OrelMag/marine-chronometer-model/README.md

# The Marine Chronometer

Browser-based working models of two marine chronometers, and an essay on how a
chronometer keeps time at sea:

- **The Hamilton Model 21**, a two-day fusee chronometer with a spring detent
  escapement, made for the U.S. Navy from 1941. It is built from the 1948
  overhaul manual (NAVSHIPS 250-624) and from photographs and videos of real
  ones. **Work in progress since 3.63.01 (31 October 2026):** Hamilton's own
  factory drawings (from the NAWCC) and the British Museum's measurements show
  the model was about 12 % too small throughout. Since 3.65.00 (1 November
  2026) it is rescaled by 1.117 (the plate 97.8 mm), the balance and escapement
  kept at their measured sizes, and its drawn parts are being rebuilt from the
  drawings (`PLAN-hamilton-drawings.md`) with the help of the NAWCC (special
  thanks to Thomas Stocker); its page says so.
- **The Wempe Einheits-Chronometer**, the German standard chronometer (spring
  detent, fusee, three pillars), built from Wempe's works drawings. It comes in
  several versions: as first drawn, the escapement of 1943, Wempe No. 3955 as
  photographed, and the Soviet 6MX (audited again against its photographs in
  3.82.03; its case, bezel, transit lock and smaller gimbal ring, which Wind
  turns over with the case, reviewed in 3.84.00; the bezel's white sight
  cone, measured on two 6MXs, added in 3.85.01).
- **The Marine Chronometer**, a long-form interactive essay shared by both
  models. Its text follows the Model 21; its 3D figures and dial are drawn
  from the Wempe's model.
- **The Beat Error Meter** (`/beat/`, since 3.78.00), a side tool for the phone:
  hold a mechanical wristwatch against the microphone and tap Listen; it finds
  the beat and gives the beat error, the rate and both intervals
  (`beat-error/`, its README).

The live site is <https://www.marinechronometermodel.com>. Since 21 October 2026
the Wempe has been the home page, with the Hamilton at `/hamilton/` and the
essay at `/essay/`.

Orel Magidish (assisted by Claude Opus 5.5) – September 2026  
[orelmag@gmail.com](mailto:orelmag@gmail.com). On every page, **Report a bug or
inaccuracy** (under About, on every part's card and at the essay's end) writes
the report into an email to this address. The email includes the version, the
model's settings, the browser and the page's last errors.

| File | What it is |
|---|---|
| [`chronometer-working-model.html`](chronometer-working-model.html) | The Hamilton's model as one file: the Model 21 running in real time in its gimballed case and mounting box. It has views (Exploded, Laid out and Contacts among them), an eight-step walkthrough, cross-sections, parts to fade, hide or isolate one at a time or as a selection (Ctrl-click, or a lasso by Alt-drag, or through to the parts behind by Shift+Alt-drag; Select, Lasso and Through on touch; Reset opacity brings every faded part back), winding, setting the hands, stopping and starting, the rate and timing weights, variants (dials, finishes, balances, and the balance stop: none by default, the manual's locking arm, or the Navy's Y-arm brake with its seal, plunger and lever), and the manual's overhaul operation by operation. Each part's card gives its Hamilton part numbers, its maker's sheet, its drawing and its STL. Its **Essay** tab links to the essay's page |
| [`marine-chronometer-source/wempe/dist/wempe-einheitschronometer.html`](marine-chronometer-source/wempe/dist/wempe-einheitschronometer.html) | The Wempe's model as one file: the same kind of page, with its own views (Train, Fusee, Balance, Laid out), its versions and variants (dials, cases, and the closing plate: the drawings' with its knob, or a slot on a stop peg as a Wempe's is photographed in *The Mariner's Chronometer*, Fig. 2.32; the key in brass, as that book's Fig. 2.35 has one taken apart, or black, as its drawing gives it), the 35-day trial, a banking screw to turn (Swing and isochronism: the depth of lock it sets, with the swing and whether the escapement still works shown live), Making it (maker's sheets; a CAD file (STEP) and an operation sheet on the card of each part made so far as a recipe: the frame, the train's arbors and wheels, the escape wheel, the bushes and studs, the fusee's wheels and ratchets, the barrel, the detent and its block, the balance and its settings, the motion work, the hands and the dial, the case, the fusee body with its groove, the hairspring's collet and stud, the keys, the transit lock and every version's detent block and the 6MX's contact, 187 in all, with 106 bought parts as lines saying what to buy (the chain among them): every line of the parts list; its build book of drawings was withdrawn on 29 October 2026) and Download (STL, Blender). It also has an essay of its own on its drawings (the **Its drawings** tab) |
| [`marine-chronometer-source/essay/dist/the-marine-chronometer.html`](marine-chronometer-source/essay/dist/the-marine-chronometer.html) | The essay: longitude, the balance and its spring, heat, the fusee, winding, the train, the detent, the gimbals, keeping the rate, navigating without radio and making the chronometer. The models' own code computes its live figures |
| [`marine-chronometer-source/hamilton-parts/index.html`](marine-chronometer-source/hamilton-parts/index.html) | The Hamilton's parts as Hamilton Watch Co. drew them (since 3.72.00, on the site at `/hamilton/parts/`): 23 parts from the NAWCC's factory drawings, built as exact solids apart from the model (`tools/hamilton_parts.py`), each in 3D with its drawn sizes, the readings still unsure, an operation sheet and a STEP file, and (since 3.73.00) audited against the sheets (`HAMILTON-PARTS-LEDGER.md`) and put together into subassemblies placed by the drawings' own numbers (the fourth wheel and pinion, the barrel, 42009 complete with pawls, the fusee with its maintaining work, a run of chain), taken apart by a slider; and the detent (since 3.74.00): its finished form reconstructed from Hamilton's blank and operation sheets, and the whole detent assembly with the 3D model's block, screws and trip spring as placeholders (since 3.74.01 sound solids, holed for their screws). Since 3.75.01 the finished detent stands the way the video shows it (its blade at the escape wheel's level), its cross-piece and jewel block cut to the sizes measured on video (the blank a ceiling; the foot keeps the blank's length), holed for its steady pins, wedge pin and bracket screw, with a notch for the adjusting screw (`tools/hamilton_detent_compare.py` draws it over the model's detent; `HAMILTON-PARTS-LEDGER.md`, "The detent assembly measured"). Since 3.74.01 `hamilton_parts.py --check` also fails a part that cuts itself, whose mesh on the page isn't closed or whose STEP file doesn't read back as the same solid (the second pass, `HAMILTON-PARTS-LEDGER.md`). Since 3.75.00 every part with a drawing and every subassembly of drawn parts only (a sixth: the barrel with the set-up ratchet on its arbor's square) has a still render from Blender's Cycles on its card and in a Renders gallery (`#renders`), made by `tools/hamilton_render.py` into `hamilton-parts/renders/` (not run by the build: rerun it after changing a recipe). Not yet in the model |

Both models' pages share one layout (since 3.52.00). The title, the model
switcher, the page tabs and a light/dark switch sit in one line over the model.
On the model are the tools as icons (Select, Lasso, Through, help, save a picture, copy a
link, reset the view, full screen), a row of views, and a play bar: stop and go
on, the speed (1/20×, ¼×, 1×, 60×, 3600× or any speed), the time, the power left
and Wind. The panel beside it (under it on a phone) has four tabs: **Explore**
(the walkthrough, the overhaul (the Hamilton's in its manual's order, the Wempe's in
the 1958 Soviet repair book's order for the MX), Take it apart: Exploded and Laid out,
the Wempe's Assembled with its assembled sheet (the movement photographed from three
sides and cut open, lettered) and its Laid out with its lettered sheet (each a thumbnail
of the sheet's top inside the panel that opens it large; the Laid out sheet: the
train in elevation, plan and isometric with numbered close-ups of the mainspring and
fusee, maintaining power, escapement and balance, lettered as a textbook's developed
drawing), the Wempe's Exploded view taking its fusee, barrel, balance, detent and motion
work apart beside the movement with Subassemblies (all, or each on its own, the
chain coiled, a Pieces slider for their spread), and Parts (the Wempe's under frame,
going train, balance, escapement, fusee and barrel, motion work and dial, and case and
box), where the Wempe's
Isolate row shows one subassembly alone, as right-clicking a part does), **Run** (time, winding, the rate and timing weights, and the
Hamilton's stopping and starting and rate book), **Look** (Metal, Tinted or Ink,
Colour by, the display's switches and ship motion) and **Advanced** (Contacts,
swing, the trial, the escapement's plan or bench, cross-sections, variants,
Making it, Download and Performance). A link that opens a section opens its tab.

Each is a single self-contained HTML file: download it and open it in any
modern browser. It works offline and needs no server, because three.js and the
fonts are built into the file. The pages link to each other, both on the site
and in the repository.

**In Blender:** each model's panel has **Blender (.glb)** (under Advanced: the Hamilton's in
Making it, the Wempe's in Download). It saves the whole instrument as a
glTF 2.0 file. Every part is a named object in its hierarchy, with its
materials, and every motion the model has is an action: running, a beat in
slow motion, run down, winding, setting the hands, stopping and starting,
exploded, laid out, lifting out, the lids, the latch, at sea. **Blender rig
(.py)** saves a script. Import the file in Blender 5 (File, Import, glTF 2.0),
then open the script in the Text Editor and run it. The chronometer then runs
on the timeline at its own ratios, with controls for the wind, the hands,
explode, laid out, lift, lids, latch, roll and pitch. The Hamilton's README,
"The model in Blender", has the details.

**Links keep the camera** (since 3.77.00): turn, zoom or pan the model and the
page's address gains `cam=` (where the camera looks from, how far, and at
what), so a copied link opens on exactly that view, on either model. A view
button, a walkthrough step or zooming to a part takes it out again.

**Drawn as an illustration:** `tools/penrender.py` draws any of the page's
views, links or cameras as an ink-and-watercolour illustration in Blender 5:
pen lines (Blender's Freestyle and Line Art) over a light wash on cream paper,
the parts the page shows see-through drawn as a faint cutaway. It opens the
page headless to read the camera, so each still is framed as the page frames
it. [Making illustrations](#making-illustrations) says how.

Contents:
[Repository layout](#repository-layout) ·
[Setting up](#setting-up) ·
[Building](#building) ·
[Changing things](#changing-things) ·
[Checking your changes](#checking-your-changes) ·
[Publishing the website](#publishing-the-website) ·
[Making illustrations](#making-illustrations) ·
[Licence](#licence)

## Repository layout

    build.py                     builds everything (see Building)
    inline.py                    inlines scripts, stylesheets, fonts and images into one HTML file (used by the builds)
    CHANGELOG.md                 the site's versions and what changed in each, newest first (read by the build; see Versions)
    changelog.py                 reads and checks CHANGELOG.md, puts the version and the list into the pages, adds a release
    deploy.py                    puts site/ live, only as a new version (wrangler.jsonc runs its check before every deploy)
    worker.js, wrangler.jsonc    the Cloudflare Worker that serves site/: its domains, and the redirects from old and other addresses
    ci.py, citrace/              the checks, run on this machine (no GitHub workflows), with their results cache and the machine's shared slots
    chronometer-working-model.html   the Hamilton's page as one file (generated by build.py: do not edit by hand)
    site-assets/                 files only the website needs: the link previews (social.png, social-wempe.png), social-movement.png (an image for posting the essay), _headers (host settings)
    site/                        the website, ready to upload (generated by build.py, committed)
    vendor/                      three.js r128 and the fonts, with their licences
    beat-error/                  the Beat Error Meter (site's /beat/): page.html, beatcore.js (the analysis), build.js (one file, run by build.py), test.js; its README
    docs/motion-3d/              the method behind the moving parts' 3D viewers (kinematics, the transmission in time, stress by finite elements)
    marine-chronometer-source/
      chronometer-working-model/ the Hamilton Model 21: index.html, css/, js/, tools/ (the verification and measuring tools, for both models),
                                 verification/ (its two reports and reference renders), blender/ (the rig), dist/ (its built file); its README has the details
      wempe/                     the Wempe Einheits-Chronometer: index.html, js/, css/, checks.py (its tables for the shared tools), bom.json, dials/ (its
                                 dials as SVG), verification/ (its report), dist/; its README has the details
      essay/                     the essay shared by both models: index.html (its text and figures' markup), js/essay.js (its figures),
                                 js/hamdata.js (the Model 21's figures it quotes, from tools/essay_hamdata.py), dist/
      shared/                    scripts both models use: escapement.js (the detent escapement's solver, makeEsc), escplan.js (its plan
                                 drawing), almanac.js (the essay's nautical almanac and sight reduction), hairspring.js (the hairspring's design),
                                 contacts.js (the Contacts view), select.js (selecting parts: Ctrl-click, the lasso), kit.js (the Wempe's part and screw builders), viewer.js (the Wempe's viewer),
                                 essaykit.js (the essays' machinery)
    References/                  source material: the 1948 manual, photographs, drawings (References/wempe/: the Wempe's works drawings and
                                 their transcriptions); its README lists each file; VIDEOS.md catalogues videos of real chronometers
    CLAUDE.md                    instructions for Claude Code: how the repository works, its rules, every tool and how long it takes
    RESOLVED.md                  bugs already found and fixed, from the commit history; check it before changing a part
    OPEN-QUESTIONS.md            readings no source has settled; REQUESTS.md is the post to send owners and the NAWCC for them
    PROVENANCE.md                the Hamilton's ledger: what each part's outline, sizes and place rest on
    WEMPE-PROVENANCE.md, WEMPE-DRAWING-LEDGER.md   the Wempe's: each part against its photographs and against its drawing
    WEMPE-PARTS-LEDGER.md        the Wempe's third, blind parts audit against its drawings (marine-chronometer-source/wempe/parts-audit/,
                                 FINDINGS-EXPLAINED.md): every difference, and the five corrected in 3.81.00 with why
    marine-chronometer-source/wempe/6mx-audit/   the Soviet 6MX audited again against its photographs (7 November 2026, 3.82.03):
                                 beta.md (frame, escapement), gamma.md (case, dial, contact), delta.md (its physics:
                                 gimbals, the escapement in time, the detent as a frame, the contact's drag), README.md the outcome
                                 case/: everything outside the 6MX's movement reviewed (8-9 November 2026, 3.84.00):
                                 README.md the ledger and what was fixed, blind-*.md the blind readings, caserender.py
    IDEAS.md, Review-results.md, PERFORMANCE.md    ideas, open review findings, frame-time measurements
    PLAN-*.md                    plans of work, each with what is done and what is left
    BOM.md                       the manual's parts list against the model, part by part (generated by the model's tools/bom.py --md)

## Setting up

You need:

- **Git**, to clone the repository.
- **Python 3.9 or later**, for the build. It uses only the standard library.
- **A browser.** Any current Chrome, Edge, Firefox or Safari works.

Clone and build:

    git clone git@github.com:OrelMag/marine-chronometer-model.git
    cd marine-chronometer-model
    python build.py --site-url https://www.marinechronometermodel.com

On macOS and Linux, use `python3` wherever these instructions say `python`.

The verification tools are optional; you need them only when you change a
model. They need more software:

- **Node.js**, for the physics tools (`escapement.js`, `dynamics.js` and the
  rest), the type check (`npx`) and deploying (`wrangler`).
- **Python packages**, and a Chromium for Playwright to drive:

      python -m pip install numpy scipy playwright opencv-python matplotlib pillow shapely manifold3d
      python -m playwright install chromium

  A few tools need more: torch for the mainspring's solve, pyamg for `fea.py`,
  skyfield for the almanac's references, yt-dlp and imageio-ffmpeg for videos,
  and trimesh and its helpers for the drawings. Each tool's docstring says what
  it needs.
- **Blender 5** (optional), for `blender_check.py`, which is skipped without it.

## Building

    python build.py --site-url https://www.marinechronometermodel.com

This one command:

1. Builds the Hamilton's model into `marine-chronometer-source/chronometer-working-model/dist/chronometer-working-model.html`, the Wempe's into `marine-chronometer-source/wempe/dist/wempe-einheitschronometer.html` and the essay into `marine-chronometer-source/essay/dist/the-marine-chronometer.html`.
2. Copies the Hamilton's to the repository root.
3. Assembles `site/`, the folder you upload to a web host:
   - `index.html` is the Wempe's model, so the site opens straight into it. `hamilton/index.html` is the Hamilton's, and `essay/index.html` the essay (`/essay/#detent` opens it at a section).
   - `social-wempe.png` is the home page's link-preview image and `social.png` the Hamilton's (the dial in its box). `social-movement.png` is an image of the mechanism titled for the essay, for posting and as the essay's preview.
   - `_headers` holds security and caching headers.
   - `navships-250-624-1948.pdf` is the 1948 manual itself, from `References/`, which the pages link to.
   - `hamilton/parts/` is the Hamilton's drawn parts page (`marine-chronometer-source/hamilton-parts/`, its three.js and font copied beside it); rerun `tools/hamilton_parts.py` before the build after changing `js/hdims.js` or a recipe.
   - `verification/build-verification/` and `verification/real-chronometers/` are the Hamilton's two reports (each check's method, results and what they mean). `wempe/verification/` is the Wempe's: *The Wempe Einheits-Chronometer: does the model hold to its drawings, and would it keep time?* (since 3.82.00 the 3D viewer beside its section 13 colours each part by its load against its load in running, with buttons to each run's moments and a table of every joint's load at the moment shown; since 3.43.00 its section 9 also takes the frame, train and escapement through heat and cold, `tools/wempe_thermal_frame.js`) Each is copied as its own `build_report.py` last wrote it, with its links into the repository pointed at GitHub. The pages' About and the essays link to them.
   - `sitemap.xml` (the pages and the reports) and `robots.txt`, for search engines, when `--site-url` is given (below).

`build.py` doesn't rebuild the reports. After changing what a report reports,
rebuild it with its `build_report.py`, then build. For the Wempe's, run
`node reportdata.js`, `python geometry.py` and `python build_report.py` in its
folder.

The build fails if a page still loads a script, stylesheet, font or image from
another server. That keeps the published files working offline and in
countries where common CDNs are blocked.

The build prints where each page's bytes go (three.js, fonts, images and the
rest) and how much a visitor downloads compressed. It sets no size limit.

`--site-url` gives the site's address. With it, the pages show a picture when
the link is shared, and search engines see the canonical address. A build
without it leaves out `robots.txt` and `sitemap.xml`, so always commit builds
made with the address.

Page addresses are written without `.html`, because Cloudflare redirects
`/page.html` to `/page`. On a host that serves the `.html` address directly
(Netlify, GitHub Pages, most plain web servers), add `--keep-html`.

The addresses changed on 21 October 2026: the Wempe moved from `/wempe/` to the home
page, the Hamilton from the home page to `/hamilton/`, and the essay from the
Hamilton's Essay tab (`/#essay`) to `/essay/` (it was once a page of its own too,
`/marine-chronometer`). On the live site, `worker.js` sends `/wempe/` to
`/?from=wempe` and `/marine-chronometer` to `/essay/`. A hash never reaches the
server, so the Wempe's page itself sends the Hamilton's old links on: `/#essay=detent`
to `/essay/#detent`, and `/#part=det` and the Hamilton's own settings to `/hamilton/`.
The reports and the manual keep their addresses. `tools/sitecheck.py` serves `site/`
through `worker.js` and follows every address, old and new. On another host, add
redirects of your own if old links matter.

### Versions

The site has a version, `M.mm.pp` (3.38.00, for example). The panel's last
section, Version … · what's new, shows it with the list of changes, and
About's byline shows it too. Both come from `CHANGELOG.md` at the root, newest
first. A plain build only reads the file, so building twice gives the same
files. To make a release, name the kind of change and what changed:

    python build.py --release patch -m "The camera turns further below the model" --site-url https://www.marinechronometermodel.com

`patch` is for fixes and small changes, `minor` for new features or parts (or
a merged branch), and `major` for a milestone. The build adds the next version,
dated today, with one line for each `-m` (written for visitors), then builds as
usual. Commit `CHANGELOG.md` with the built files, and bring this README up to date
with what the release changed. The build fails if the file
is malformed: a heading that isn't `## M.mm.pp · YYYY-MM-DD`, versions out of
order, or a version with no lines.

Rebuild after every change. Commit the regenerated root copy, the `dist/`
files and `site/` with your source changes, so that they stay identical.

## Changing things

### The models

Work on the unbuilt source. It loads the files directly, so a browser reload
shows each edit:

1. Open `marine-chronometer-source/chronometer-working-model/index.html` (the
   Hamilton) or `marine-chronometer-source/wempe/index.html` (the Wempe) in a
   browser. Double-clicking the file works.
2. Edit the files in `css/` and `js/`, then reload the page.
3. Keep the browser's developer console open (F12). Errors appear there, and so
   do warnings from the geometry builders, for example a hole that crosses a
   plate's outline.
4. When it looks right, run `python build.py` from the repository root.

Useful URL flags:

- `?snap` turns off camera and state easing, so views settle at once.
- `?qa` exposes the movement and camera helpers to the verification tools.

For example: `index.html?snap&qa`.

If you open a page from a local web server instead of the file, start the
server at the repository root. The pages read `../../vendor/`, so the server
must be able to reach it:

    python -m http.server 8000
    # then open http://localhost:8000/marine-chronometer-source/chronometer-working-model/

The Hamilton's [README](marine-chronometer-source/chronometer-working-model/README.md)
explains how its code is organised. Its "Modifying the model" section walks
through common changes: a part's shape, a new part, gear ratios, the dial, the
walkthrough, views and materials. The Wempe's
[README](marine-chronometer-source/wempe/README.md) says how each of its parts
was read off its drawings. Its dimensions are in `wempe/js/dims.js`, each with
its drawing's number. It loads the Hamilton's `core.js` and the shared
`kit.js` and `viewer.js`. Its section "The page's capabilities against the
Hamilton's" lists what was ported and what was left out.

Every outline, size and place is measured first, on a photograph, a video
frame, a manual figure or a works drawing, never drawn by eye. The code comment
beside it names its source. Each model's README has an "Estimated" section
listing what no source shows.

Some scripts in `marine-chronometer-source/shared/` are used by both models
and the tools, so a change to one reaches all of them:

- `escapement.js` holds the escapement's solver, `makeEsc`. The Wempe's is
  `makeEsc(settings, base)` against the Hamilton's settings. After changing it,
  `tools/escgolden.js` must still match: it holds the Hamilton's results bit
  for bit.
- `escplan.js` holds its plan drawing, `drawEscPlan`, used by the walkthrough's
  inset, the adjuster's bench and the essay.

The essay's sky sections (rating the chronometer by the Sun, longitude by
chronometer, the lunar distance, an almanac to print) compute with `ALM` in
`shared/almanac.js`. `tools/almanac.js` checks it against JPL Horizons and
skyfield; the Hamilton's README, "The almanac", says how and how well.

### The essay

The essay is shared by both models and has a page of its own,
`marine-chronometer-source/essay/`:

- Its text and figure markup are in its `index.html`, and its styles in the
  Hamilton's `css/essay.css`.
- Its figures are in `js/essay.js`. It builds the Wempe's movement from the
  Wempe's own scripts and lends it to each 3D figure as it draws: the dial, the
  balance and hairspring, the fusee, the maintaining work, the train, the
  escapement and the box. The figures use the models' Edges, off with
  `?edges=0`; the models' Essay tabs pass that on when their Edges are off.

Open `essay/index.html` to work on it; a reload shows each edit. Numbers come
from two places:

- The Wempe's numbers that a figure shows are `data-live` spans, filled in live.
- The Model 21's numbers that the text quotes are `data-ham` spans, from
  `js/hamdata.js`. `tools/essay_hamdata.py --write` works them out on the
  Hamilton's page. Run it after changing the Hamilton's escapement, train,
  balance or hairspring; `ci.py` checks it.

The Hamilton's README, "The essay", explains the rest. The Wempe's own essay
(its **Its drawings** tab) is `wempe/js/essay.js` and the `<article id="essay">`
in `wempe/index.html`. Its data that only Node can work out is in
`wempe/js/essaydata.js`, written by `tools/wempe_essaydata.js --write`.

### Tracing by hand

Outlines the model is built from can be traced by hand on a photograph or a
video frame, with the Edge Tracer:

- **On a computer**: open
  `marine-chronometer-source/chronometer-working-model/tools/tracer.html` in
  Chrome or Edge. Open the image, click along an edge, and press **?** for the
  keys. **Save** writes `NAME.trace.json`; keep it in `tools/traces/`.
- **On a phone or tablet**: open the private copy on claude.ai,
  <https://claude.ai/artifact/Ju3PQ8QErkH3fdRWZcSLjq> (only its owner can open
  it). Claude measures parts itself (below), so tracing is optional: when you
  offer to trace, Claude puts the frames there with a note on what to trace. To
  open one, choose **Panel**, then **From Claude**, then **Open**.
  - Tap to add a point.
  - To place one precisely, hold, then slide (a ring and the magnifier show
    where it goes), then lift.
  - Drag a point to move it. Pan with one finger and pinch with two.
  - **Fine** makes drags and aiming move a quarter as far as the finger.
  - The bar at the bottom has the keyboard's actions (Done, Insert, Delete
    point, Corner, Close curve).

  When done, tap **Send to Claude**. Claude reads the trace from there and
  saves it in `tools/traces/`.

The same file runs in both places. After changing `tracer.html`, Claude
rebuilds the phone copy with `tools/tracer_artifact.py` and publishes it to the
same link.

Claude measures parts itself with the `measure-trace` skill
(`.claude/skills/measure-trace/`), whose engine is `tools/mfgfit.py`. The skill
snaps a trace onto the image's edge and fits it as machined lines, arcs and
drilled holes.

## Checking your changes

The tools are in `marine-chronometer-source/chronometer-working-model/tools/`,
for both models: most take `--model wempe` for the Wempe. Run them from that
folder; they write their output files into it. [CLAUDE.md](CLAUDE.md) lists
every tool, what it checks and how long it takes. Before committing a change:

1. **Past fixes.** Look up the part, control or build step in
   [RESOLVED.md](RESOLVED.md), so an old bug doesn't come back.
2. **Build.** `python build.py --site-url https://www.marinechronometermodel.com`
   at the root must finish without errors. When a file the Wempe's page loads has
   changed, it first renders the Laid out sheet again (`laidout.py --model wempe
   --write`, a few minutes in a browser) into `wempe/renders/`; commit what it writes.
3. **Console and arithmetic.** Run these two; both print `ok`:
   - `python smoke.py` clicks through every control of the model, then opens
     the essay's page, scrolls it and works every control in it. It fails on
     any console error or warning.
   - `python invariants.py` checks the hands against the time, the wind
     indicator, and the fusee's and the balance's figures.
4. **Geometry**, if you changed any part:

       python isolate.py PART --ref IMAGE   # the part alone beside a photograph or frame of a real one: compare them before going on
       python fine.py       # collisions at 0.05 mm, through the escapement, round the train and over the wind, plus the barrel's margins (exit code 1 on anything new)
       python fine.py --hold    # the same with the balance locking arm locked and the train-blocking screw down
       python maintaining.py    # the fusee's maintaining work over run and wind cycles (exit code 1 on a failure)
       python views.py before   # (before the change) renders every view; after it: python views.py after, then python views.py --diff before after
       python beforeafter.py --model wempe --before OTHER/index.html SPEC.json   # each changed part alone, before (another worktree's page) and after, from the angle where they differ most, the change boxed and close up (tools/beforeafter/)
       python solids.py     # every part a closed solid, facing out (exit code 1 on a failure)
       python exploded.py   # no two parts meet in the Exploded view, at any spread (exit code 1 on a failure)
       python overhaul.py   # every operation of the manual's overhaul takes its parts off, or puts them on, clear of the rest
       python assembly.py --model wempe   # the Wempe's order of taking apart, clear of the rest, and its page's overhaul in the same order
       python holecheck.py  # every hole has something in it, or a reason it is empty on the real movement
       python seatcheck.py --model wempe  # every pin, screw, stud and pipe held in a hole of another part, not lying in a slot or buried in solid metal
       python wempe_fusee_check.py        # the Wempe fusee body as built against every written figure of its sheet 05 06 04-2 (no browser; after wempe_fusee_body.py)
       python placements.py dump before   # (before the change) every mesh's place in seven states; after it: dump after, then --diff before after
       python audit.py      # screws, pivots, loose parts in the movement (exit code 1 on anything not expected; --update after an intended change of coplanar faces)
       python audit.py box  # the same for the box and gimbals
       python bom.py        # every part against the parts list: counts, how each is held and runs, the gears, the jewels (--md rewrites BOM.md)
       python contacts.py --write   # after changing fine.py's tables: the Contacts view's data
       python gltf_check.py     # the export to Blender, written and read back
       python blender_check.py  # that file in Blender 5 headless (skipped without one): the rig against the export's own clips
       python penrender.py      # stills as an ink-and-watercolour illustration (any view, link or camera; not a check)
       npx -p typescript@5.9.3 tsc -p ../jsconfig.json   # the types of the files that start with // @ts-check

   What each should print:
   - `fine.py` prints `ok` on every line. Its table `EXPECTED` gives the
     reason for each intended contact.
   - The `views.py` diff shows changed pixels only on the parts you changed.
     The `placements.py` diff lists only the parts you rebuilt.
   - `solids.py` prints `0 not solid` twice. `exploded.py` and `overhaul.py`
     print `0 failing`.
   - `audit.py` ends with `OK: nothing new`. It compares its findings with the
     expected ones: the loose ends in its `LOOSE` table, each with its reason,
     and the coplanar faces, mostly faces in contact, in `audit-expected.json`.
   - `seatcheck.py` ends with `0 failing`; a piece held another way on the real
     chronometer too is printed `~~` with its reason (`SEAT_EXPECTED`).
   - `bom.py` prints `ok` (a press fit at most 0.02 mm open, a tapped hole 0.1;
     `MC_BOM_IN` tries other limits); a known deviation, with its reason, is printed with
     `~~`. After changing a part, run `python bom.py --md` and commit the
     regenerated `BOM.md`.
5. **Timing and physics**, if you changed the escapement, balance, springs,
   fusee or train. These are Node.js tools: `node escapement.js` (the
   escapement against the manual's figures), `node escgolden.js`,
   `node physics.js`, `node dynamics.js`, `node tripping.js` and
   `node gearing.js`. For the Wempe, run `node wempe_escapement.js` and the
   other `wempe_*.js` tools. Several write a golden JSON file with `--write`;
   without it, they fail if that file is stale. The reports then need
   rebuilding (see Building).
6. **Preview images.** If a model's appearance changed, re-render them with
   `python social.py` (`social.py wempe` for the Wempe's), then rebuild. If the
   Wempe's box, gimbals, fusee, escapement, train or balance changed, look over
   the essay's figures too: they are built from its model's code.
7. **Frame time**, if you changed the render loop, a rebuilt part, or what is
   drawn. `python perf.py` prints each view's frame cost, draw calls and
   triangles with the page's settings, with Shadows and without Edges, and how
   often the page draws when left alone. It runs on your GPU with vsync off;
   `--throttle 4` slows the CPU to about a phone's. Compare it with a run from
   before the change.
8. **All the checks at once.** `python ci.py` at the root runs them here and
   prints each step `ok` or `FAIL`, with its logs in `ci-logs/`. It runs about
   a hundred steps for both models, side by side (up to 12 at once, 3 with a
   browser), in about 20 minutes. Among them is the build with the live
   address, which fails if building changes a built copy (commit what it
   writes). The options:
   - `--quick` runs the steps without a browser.
   - `--full` adds the slow ones (`fine.py`, the Wempe's on each version and
     with the band, `bom.py`, the full physics runs, `fea.py`, the Blender
     export).
   - `--views` renders every view before and after the branch and prints the
     changed pixels.
   - `--only a,b` runs those steps.
   - `--plan` lists what would run, and the changed input behind each step.
   - `--no-cache` runs everything.
   - `--changed` runs only the steps that read a file the branch changed since
     `main`.
   - `--fail-fast` stops at the first failure.

   A step that passed is skipped (`cached`) while every file it read is
   unchanged, in this worktree or any other. `citrace/` traces each step's
   reads, and `.git/ci-cache/` keeps its pass. Runs in several worktrees share
   the machine's cores through `.git/ci-slots/` (`MC_CI_CPU`,
   `MC_CI_BROWSERS`), so a second run queues instead of slowing the first.
   Nothing runs on GitHub.

   Choose the checks by what the change can break:
   - Text no check reads (ledgers, plans, READMEs, comments) needs only the
     build.
   - A page's strings or controls need the build, the type check and
     `smoke.py` (and `sitecheck.py` if `site/` changed). A change to the
     layout or the CSS also needs `tools/uiprobe.py` (about 2 minutes), which
     opens the three pages at a desktop's, a phone's and a tablet's sizes, upright
     and sideways, light and dark, and fails on a control past the panel or the
     window, text cut off or under WCAG's contrast, a nameless button, a small
     touch target or a squeezed hint; `--jitter` fails on what moves by itself,
     a pressed choice shifting its neighbours, or the selection bar moving under
     its own slider. `--dialogs` opens a part's card, Help, About,
     Report and the right-click menu at each size and fails on one past the
     window, cut off without a scroll, without a reachable close, not closed
     by Escape, or not taking and giving back focus.
   - Timing or physics needs the tools that compute it and their golden files.
   - Geometry needs `python ci.py --full` (with `--views` if anything drawn
     changed).
   - A change to `ci.py`, the shared scripts or several areas needs
     `python ci.py`.
9. **Record fixes.** If the change fixes a bug, add it to
   [RESOLVED.md](RESOLVED.md) under the right heading, with the commit hash.
10. **Commit** the source and the regenerated built copies together. Work on a
    branch. Merge it into `main` with `git merge --no-ff` once its checks pass,
    and push every branch to GitHub.

## Publishing the website

The website is a folder of static files (`site/`): no server code, no
database. Any static host can serve it. The files are self-contained, so a
visitor's browser fetches only these few files, from the host alone.

### The live site

The site is live at https://www.marinechronometermodel.com, a Cloudflare Worker
that serves `site/` as static files. `wrangler.jsonc` at the root describes it,
with its custom domains; `worker.js` redirects every other address
(https://marinechronometermodel.com, https://marinechronometer.orelmac.workers.dev
and plain `http://`) to the main one, keeping the path, and marks every 404 `no-store`, so a file
asked for before a release finished going up isn't kept missing. To update it (Node.js provides `npx`; the first run opens a
browser window to log in to Cloudflare):

    python build.py --release patch -m "what changed" --site-url https://www.marinechronometermodel.com
    git commit -am "Release ..."      # CHANGELOG.md and the built files
    python deploy.py

Each deploy is a release with its own version (see [Versions](#versions)), and
this is enforced. `deploy.py` (and `wrangler.jsonc`, which runs `deploy.py
--check` before any `npx wrangler deploy`) rebuilds with the live address and
refuses when:

- the rebuild changes anything, or anything that goes live is uncommitted;
- the live page has the same version but different contents (make a release first), or a newer one;
- the version's git tag already marks another commit;
- the live page can't be read to compare.

The same version with the same page passes, so the Worker alone can be
redeployed. After a deploy, `deploy.py` tags the commit `vM.mm.pp`; push it
with `git push origin main --follow-tags`. Pushing to GitHub doesn't deploy it. The steps below are for setting up a new
site elsewhere.

### A new site: Cloudflare Pages

It's free, has unlimited bandwidth on the free plan, serves from hundreds of
cities worldwide, and works with a private GitHub repository. Cloudflare
occasionally renames dashboard items; the steps below describe what to look for.

**First upload (about ten minutes):**

1. Create a free account at https://dash.cloudflare.com/sign-up.
2. Choose a project name, for example `marine-chronometer`. The site's address
   will be `https://marine-chronometer.pages.dev` (if the name is taken, pick
   another and use it in the next step).
3. Build with that address:

       python build.py --site-url https://marine-chronometer.pages.dev

4. In the dashboard, open **Workers & Pages**, choose **Create**, then the
   **Pages** tab, then **Upload assets** (Direct Upload). If you're offered a
   Worker first, look for the Pages option.
5. Enter the project name from step 2 and create the project.
6. Drag the **`site` folder** (the folder itself, not the files inside it, and
   not the whole repository) onto the upload area, and click **Deploy site**.
7. Open `https://marine-chronometer.pages.dev`. The Wempe's model loads as the home
   page; the Hamilton's is at `/hamilton/` and the essay at `/essay/`.

**Later updates:** rebuild with the same `--site-url`, open the project in the
dashboard, choose **Create deployment**, and drag `site/` in again. Each
deployment is kept, so you can roll back from the project's Deployments list.

**Updating from the command line instead** (needs Node.js, which provides
`npx`):

    python build.py --site-url https://marine-chronometer.pages.dev
    npx wrangler pages deploy site --project-name marine-chronometer

The first run opens a browser window to log in to Cloudflare.

**Automatic deploys on every push (optional):**
1. In the project, choose to connect it to GitHub and authorise access to the
   repository.
2. Set the build command to
   `python build.py --site-url https://marine-chronometer.pages.dev`.
3. Set the build output directory to `site`.

If the build log says Python can't be found, add an environment variable
`PYTHON_VERSION` with the value `3.11`.

**Your own domain (optional):** buy one (Cloudflare Registrar sells them at
cost, from about US$10 a year), then add it under the project's **Custom
domains**. Rebuild with `--site-url https://your-domain` and upload again, so
link previews use the new address.

**Check the link preview:** paste the address into https://www.opengraph.xyz.
It should show the Wempe in its box, with the page's title and description.

### Alternatives

- **Netlify Drop:** open https://app.netlify.com/drop and drag the `site`
  folder onto the page. You get an address immediately; create a free account
  to keep it and to rename it (`https://<name>.netlify.app`). Then rebuild with
  that `--site-url` and drag the folder in again. The free plan includes
  100 GB of traffic a month.
- **GitHub Pages:** free only for public repositories (this one is private).
  If you make it public:
  1. Commit a copy of `site/` in a `docs/` folder.
  2. Under **Settings → Pages**, choose **Deploy from a branch**, then `main`,
     then `/docs`.
  3. The address will be `https://orelmag.github.io/marine-chronometer-model/`.
- **Anywhere else:** upload the contents of `site/` to the web root of any
  hosting that serves plain files, such as a university or museum web server,
  or Amazon S3 with CloudFront.

The single `chronometer-working-model.html` file also works on its own. You can
email it, put it on a USB stick or attach it to a course page; it runs from the
file with no connection.

## Making illustrations

The models can be drawn as pictures for their own sake: ink-and-watercolour
stills, a series of them compiled into a gallery, and the lettered Laid out
sheet. None of this is part of the build or the checks, and the pictures stay
out of the repository (`tools/r_*/` is ignored) unless you put them somewhere
on purpose.

### What you need

- Python with the packages in [Setting up](#setting-up) (Playwright with Chromium, numpy, scipy, Pillow).
- **Blender 5**, installed in the usual place (`C:\Program Files\Blender Foundation\Blender 5.x\blender.exe`),
  or its path in the `MC_BLENDER` environment variable.
- About 2 GB free for a model's export (`r_model21.glb` about 150 MB, `r_wempe.glb` about 180 MB) and the stills.

### Ink-and-watercolour stills (`penrender.py`)

Run it in `marine-chronometer-source/chronometer-working-model/tools`:

    python penrender.py --list                                   # the Hamilton's views
    python penrender.py --model wempe --list                     # the Wempe's
    python penrender.py --view dial,movement,exploded            # the default set, the Hamilton
    python penrender.py --model wempe --view plan,side,case      # any views, comma-separated
    python penrender.py --link "https://www.marinechronometermodel.com/hamilton/#view=train&cam=0.4,1.1,240,0,-13,9"
    python penrender.py --view escapement --cam 1.9,-0.75,80     # a view's camera turned: yaw, pitch (radians), distance (mm)[, target x,y,z]
    python penrender.py --model wempe --glb r_pen/r_wempe.glb    # reuse an export made earlier (saves about 3 minutes)

The first run without `--glb` exports the model through the page
(`gltf_check.py`, about 2½ minutes, 3½ for the Wempe) into the output folder;
pass that file to `--glb` next time, and export again after the model's
geometry changes. Each still then takes about 1-5 minutes (the Wempe's eleven
views took 10½ minutes together). Stills are written as
`pen_MODEL_VIEW.png` (`pen_MODEL_link.png` for a link) into `tools/r_pen/`,
or `--out DIR`; `--size 1600x1150` sets their size.

**Choosing the view on the page.** The easiest way to get a particular picture
is to set it up on the page: pick a view, turn, zoom and pan the model, pick a
part if you want the others faded, set the Exploded spread. Then use **copy a
link** (or the address bar) and pass that to `--link`. The link carries the
view, the explode spread, the picked part and, since 3.77.00, the camera
(`cam=`). The tool opens the page on that link in a headless browser at the
still's size, reads its camera, and draws the same camera in Blender, so the
still is framed as the page shows it (on a wider frame, the page's pull-back
for narrow screens is taken out).

**What the drawing is.**

- Lines: a heavy outer contour round each part and fine crease lines
  (Blender's Freestyle), and the contours where surfaces turn away (Line Art,
  which works out hidden lines exactly; Freestyle broke them into dashes on
  curved walls). `--lines freestyle` uses Freestyle alone: faster, but expect
  those dashes.
- Colour: each material painted as a wash, its own colour in the light and a
  warm or cool shade of itself in the shadow (brass into amber, steel into
  blue-grey), darker where a surface turns away, a white glint on metal, under
  a key and a rim light, on cream paper with a faint grain.
- See-through: the parts the page shows see-through (the plates in the train,
  fusee and escapement views, every part but the picked one) are drawn as a
  second layer alone and laid over at a third, a cutaway's ghost, so they hide
  no line behind them.
- Every line is the model's. Nothing is simplified or left out the way an
  illustrator would, which is the main difference from a hand-drawn picture.

**Limits.** The walkthrough's steps and the essay's sections aren't views and can't be drawn.
The model's parts are drawn as built; a part the page builds only when shown
(the mainspring, the hairspring) is drawn when the view shows it.

**If a still looks wrong.** Lines across flat plates or rings drawn as dashes
were both fixed in the tool (re-triangulated faces; Line Art contours); if they
come back, `penrender.py`'s comments say what caused them. A box drawn in dark
photographic wood means a wood material the tool didn't recognise (`PAL`,
`texwood` in the tool). A still framed wrongly usually means the export is
older than the page: export again.

### A series as a gallery

To compile a set of stills into one page to look through or share, as was done
for the Wempe's eleven plates (2 November 2026):

1. Draw the views into one folder:
   `python penrender.py --model wempe --view box,case,dial,movement,plan,side,exploded,train,fusee,escapement,balance --glb r_pen/r_wempe.glb --out r_pen/wempe_series`
2. Look at them together before going on (a contact sheet: Pillow, a few lines).
3. Convert them to WebP (Pillow, quality about 86: eleven plates came to 1.3 MB).
4. Make a page that shows them in order with each view's own one-line
   description (the page's `VIEW_DESC` in each model's `app.js`), each opening
   full size. Ask Claude for it: it publishes such a page as a private
   claude.ai artifact, which you share from its Share menu.

### The assembled sheet, photographed (`assembled.py`)

The Wempe put together, not laid out, rendered photographically in Blender's
Cycles and lettered: the train side, the dial side with the dial and hands
off, the side between the plates, and three sections cut through the arbors
(the barrel and fusee, the centre and seconds, the balance and escape wheel),
then eight close-ups of the mechanisms, some cut open, and the key. Every
element of the textbook's drawing keeps its letter, as on the Laid out sheet,
and the parts the drawing doesn't letter are numbered on from 10, each with
what it does (condensed from its card). Each cut face is hatched and outlined
in a thin line of its own, so parts cut side by side read apart. The Wempe page
shows it under Take it apart while neither Exploded nor Laid out is on.

    python assembled.py --only-checks          # the page's half alone: every letter placed and clicked (about 3 minutes)
    python assembled.py --scale 0.5 --samples 64   # a draft: the stills at half size (about 15 minutes)
    python assembled.py --scale 0.75 --samples 96 --write   # into the page: renders/assembled_sheet.webp and its stamp (about 15 minutes)
    python assembled.py --relayout             # the sheet again from the last stills, no browser or Blender
    python assembled.py --check                # exit 1 if the page changed since the sheet was written

Each letter is placed by the page's own pick on the page's camera: every mesh
drawn once in a colour of its own (in a section under the same clipping plane,
both sides, so a cut solid's inside counts as its cut face) and read back; the
anchor is the point deepest inside the part where the page's own ray names it.
Every element is then clicked on the page in a view that isn't cut. The stills
are `penrender.py --photo` (the export's own materials, a studio light; a
shot's `cut` plane cuts the solids crossing it with exact booleans). Being a
GPU render, the root build never renders it again: it only notes when the sheet
is older than the page. The image (about 2 MB) is served beside the page
(`site/renders/`), not inlined into it (`inline.py`'s `data-noinline`), so the
home page stays its size. Not run by `ci.py`.

### The lettered Laid out sheet (`laidout.py`)

The Laid out view, the train in one line as the textbooks draw it, rendered on
one sheet against a textbook's developed drawing ("Modern chronometer
movement", Figs. 83 and 84): elevation, plan and an isometric view with
close-ups, every element lettered as the drawing letters it, and a key saying
what each part does. It checks every lettered element is shown and opens its
own card when clicked.

    python laidout.py                          # the Hamilton: r_laidout_sheet.png in the current folder
    python laidout.py --model wempe            # the Wempe
    python laidout.py --model wempe --write    # into the Wempe's page (renders/laidout_sheet.webp), if its checks pass

The sheet is rendered by the page itself (not by Blender), so it has the page's
look, not the ink-and-wash one. About a minute.

**In ink and wash** (the Wempe; `--pen`): the same sheet with every view and
close-up drawn by `penrender.py`, lettered from the same anchors and checked the
same way.

    python laidout.py --model wempe --pen --glb r_wempe.glb r_lo_pen                    # r_lo_pen/r_laidout_sheet_pen.png
    python laidout.py --model wempe --pen --pen-scale 0.5 --glb r_wempe.glb r_lo_pen    # drawn at half size first, for a quicker look

The page is frozen as the export's rig stands at rest, each view's and
close-up's camera is read off it, and Blender draws that camera at the page
canvas's size (3600 x 2000), so each letter falls on its part as in the page's
sheet. The close-ups draw their own parts alone (the barrel faded so the
mainspring shows). The sheet goes on the drawings' paper with its grain laid
over the whole. Export the model first (`gltf_check.py --model wempe`) and again
after its geometry changes. At half size it took about 25 minutes, mostly
Blender.

`penrender.py --shots FILE` is how the sheet drives it: a JSON list of shots,
each a page camera (`page`), the rig's controls (`ctl`), and which parts to
draw (`show`), fade (`ghost`) or leave out (`hide`), by part key, parts-list
line (`hns`) or the stand-in plate's part (`devOf`). `--flat` leaves out the
paper's grain.

### The poster (`penposter.py`)

*What makes a marine chronometer precise*: the Wempe drawn in ink and wash and
lettered by hand (Caveat, `vendor/fonts`), A2 landscape at 300 dpi, for print.
In the middle the box open, the case in its gimbals and the movement raised dial
up above its bowl, its dial, plates, lower cock and ring drawn faded so what lies
under them shows; round it four callouts, each a heading, a few sentences and a
lettered drawing of the parts alone: the mainspring, chain and fusee; the spring
detent escapement; the balance and hairspring; the box rolled each way with the
case level.

    python penposter.py --glb r_wempe.glb --preview      # the layout with the page's own renders, a few minutes
    python penposter.py --glb r_wempe.glb --scale 0.5    # the drawings at half size first (about 25 minutes)
    python penposter.py --glb r_wempe.glb                # the poster: r_poster/penposter.png (about an hour, mostly Blender)
    python penposter.py --recompose                      # the last drawings laid out again after a change of text or layout

Each piece is set up on the page (the view, the parts alone or faded, the
movement raised, the box rolled), its camera read off the page's canvas and
drawn by `penrender.py` with that camera at the canvas's size. Every label and
leader ends on a point the page's own pick finds on the part it names, through
the faded parts only, and each drawing must lie on the page's own outline within
a pen stroke; the tool fails otherwise. The sentences and their sources are in
its `TEXT` table (the Wempe README, its drawings, and the essay where it speaks
of the Wempe). The finished poster is in `illustrations/`.

### The film (`wempe_movie.py`)

*How a marine chronometer keeps time at sea*: a film of just under three minutes
of the Wempe at work, for YouTube. Each shot plays the page's own clips (Running,
Beat (slow motion), Winding, Exploded, Run down, Lid, At sea) from the export to
Blender, through cameras fitted to what the shot frames, with the frame drawn
see-through where the parts inside matter. Over it go captions, the page's tick
on each tooth's fall and an English narration (Kokoro, offline; `pip install
kokoro soundfile`). The shots, captions and narration are tables in the tool,
each line with its source (the Wempe README, the essay).

    python wempe_movie.py export          # the glb with its clips (about 4 min)
    python wempe_movie.py plan            # each shot's cameras and ticks (Blender, about 5 min)
    python wempe_movie.py stills          # one frame a shot, to check framing
    python wempe_movie.py say             # the narration spoken, each line's length against its room
    python wempe_movie.py render --engine eevee --size 960x540 --tag draft                       # about 2 s a frame
    python wempe_movie.py render --engine cycles --size 1920x1080 --fps 24 --samples 64 --tag final   # 13-18 s a frame, about 16 h
    python wempe_movie.py compose --tag final --out E:/mc-video/movie/wempe_movie.mp4         # a few minutes

Rendering is resumable: frames already written are kept. The film, its frames and
its work folder stay outside the repository (`E:\mc-video\movie`).

## Licence

- **Code:** MIT; see [`LICENSE`](LICENSE).
- **Text, drawings, diagrams and the model's design:**
  [CC BY 4.0](https://creativecommons.org/licenses/by/4.0/). Anyone may share
  and adapt them with credit.
- **Third-party files in `vendor/`** keep their own licences: three.js is MIT,
  and the fonts are under the SIL Open Font License. See
  [`vendor/README.md`](vendor/README.md).
- **Source material:** the 1948 NAVSHIPS 250-624 manual is a U.S. government
  publication. The photographs and drawings in `References/` belong to their
  owners and are kept for reference; they are not covered by the licences above.
