OrelMag/marine-chronometer-model/marine-chronometer-source/wempe/README.md

# The Wempe Einheits-Chronometer model

An interactive 3D model, in progress, of the German *Deutsches Einheits-Chronometer*: the standard marine chronometer designed by Gerhard D. Wempe's chronometer works in Hamburg in the early 1940s and made by Wempe and A. Lange & Söhne. The model is the spring-detent version (*Feder-Chronometer*, Kaliber 05) as its works drawings draw it, each sheet **as last revised** (about 1946-48). Where a sheet was revised the model is built as last revised; the parts the revisions replaced are built as well, shown under Variants, The drawings: As first drawn (below, As first drawn). The lever chronometer's sheets (05 04_20-23, 05 08_30-33) are used only to cross-check the holes it shares.

Phase P1a (14 October 2026) built the frame: the two plates with every hole of their tables, the three pillars and their screws, the movement ring, the barrel bridge with its click, the fusee bush and dust bush, the two balance cocks and the intermediate bridge, each with its screws and steady pins. Holes for the parts of later phases (the train's arbors, the detent block's screw, the balance holding work, the escape wheel's settings) are cut now, as the tables give them; the parts themselves come later.

Phase P1b (14 October 2026) built the going train: the centre (minute), intermediate and seconds arbors, each a brass wheel riveted on its steel pinion and arbor, in their bearings: the brass bushes WN-301 and WN-300 in the top plate, WN-302 in the pillar plate and WN-300 in the intermediate bridge, and the seconds arbor's jewel in its setting in the bridge; and the pillar plate's two stud bushes (05 08 02-2) with the studs the motion work turns on. The escape wheel (05 04) turns the train: until it is built, P0's stand-in escapement steps it a tooth a beat.

Phase P1c (14 October 2026) built the fusee, its wheel and Harrison's maintaining work (ratchet, clicks and their springs, the maintaining spring, the maintaining detent on its arbor at hole 4), the Vorreiber, cover plate, dust plate and the stop work (the bar across the fusee's small end and the stop pin in the top plate's hole 7), the barrel with its lid, arbor, hook and set-up ratchet, the mainspring, and both the chain and the band, chosen under Variants (the chain by default). Winding (the panel) sets the hours since full wind or winds it through the key, the maintaining spring keeping the train going; the hash keeps both (`wind=`, `conn=band`).

Phase P1d (14 October 2026) built the balance and the spring detent escapement (drawing groups 05 03 and 05 04): the balance with its rim, masses, timing weights and staff; the helical hairspring with its collet and stud; the impulse and discharge rollers; the escape wheel with its pinion and collet; the detent with its gold spring and locking stone, on its block; and the balance's and escape wheel's jewels, settings and endstones. They move: the balance swings twice a second and the escapement unlocks, impulses and locks as 05 04_1 lays it out (kinematically, at the swing phase 2a solves: Physics).

Phase P1e (14 October 2026) built the dial and what is under and over it (drawing group 05 02): the cannon tube with its pinion on the centre arbor, the change wheel and the hour wheel, the up-and-down wheel and its pinion on the fusee arbor, the four hands, and the dial with its printing, screws and pin. The hands show the time (the page's clock is local time, as the Hamilton's), the up-and-down hand the fusee's turns from full wind. The hand setting (05 33), the balance holding device (05 36) and the seconds contact (05 38) are not built (below).

Phase P1f (15 October 2026) built the case and the box (drawing groups 05 01 and 51 00): the cast brass bowl with its closing plate, brackets and locking bracket, the bezel and its glass, the gimbal ring with its bracket, pivots and lock nuts, the transit lock, the mahogany box with its glazed lid, hinges, handles, maker's plate and latch tongue, and the one-way winding key of 1943, standing in its holder in the box's back right corner (since 15 October 2026: until then it lay on the floor); and the movement ring's radial pin, which sets the movement's turn in the case. Two views show them: Box (shut, from high enough to read the dial through the lid's glass) and Case (open), and the Dial view now looks down on the dial in its case; the other views lift the movement out and turn it train side up, as the Hamilton's do. The gimbals stood still until 15 October 2026, when they were given their swing ("The page's time, ship motion and reports", below); their axes are as drawn.

Phase 2a (15 October 2026) made the escapement run physically, as the Hamilton's does: the balance's swing comes from the drive, the fusee's force as 05 06_20 measured it, through the train, and the rate from the escapement (the shared `makeEsc` with the Wempe's settings, `js/escphys.js`); run down, the train stops and the balance swings down to rest, and once wound it needs a twist to start (below, Physics).

Phase 2c (15 October 2026) settled the hairspring's length (the whole strip 13 turns less 3.5 mm, 05 03_7: the period 0.468 s with the weighed balance), checked its terminal curves against Phillips' conditions and the force they leave on the pivots, gave the model the drawn spring's own isochronism, and worked the cut bimetallic balance and steel spring in heat and cold against the 6MX's TU (below, Physics: hairspring and temperature).

Readings of 15 October 2026 settled four open figures from the sheets and photographs (each with its evidence and sureness under How the balance and escapement were measured and Physics: energy): the balance's masses stand from the rim's lower face to 6.46 (they were built from 1.1, the hidden pair's outline), 30° from the cuts' line (32 scaled), which makes the balance 10 % heavier (2,501 g·mm²; 2,561 since the shape batch below, and the tool weighing one revision: the period 0.497 s) and the hairspring's period 0.491 s; the detent's horn is 4.4 long (3.5 built); the detent's banking is the block's cross screw, bearing on the pipe at the stone (not drawn yet); and the mainspring's "0,37" is not overwritten. The physics was run again on them.

Phase E1 (15 October 2026) built the escapement as first drawn, the parts the later sheets replaced, beside those they replaced, chosen under Variants (The drawings: As last revised, As first drawn; `rev=first` in the link): 05 04_1's layout of 1940-41 with the escape wheel and rollers just under the top plate, the 1941 staff with its brass collar (05 04_5), the 1941 escape arbor and collet (05 04_7.1), the detent at 1436's first sizes and the block of 1941 with its long arm and cone. Wempe 3955 is made so (below, As first drawn). Phase E2 added the barrel of 1941 in three pieces, its lid on the pillar plate's side, and the 1941 maintaining spring (020605), widening round its turn; phase E3 the winding key of 1940, with its flat pear-shaped handle, and on the cards the figures the revisions changed by too little to show.

## Files

- `index.html`: the page. It loads three.js and the fonts from `../../vendor/`, the Hamilton's `core.js` (materials, geometry helpers, sections, the ink drawing) and stylesheet by relative path, then `../shared/kit.js`, `../shared/viewer.js` and its own scripts.
- `js/dims.js`: `WD`, the shared dimensions: the plates, the pillars and their screws, and the hole table `WD.H` (every hole by its number on the sheets, in the movement frame). Each number names its sheet and how sure the reading is. The pillars' fits keep their limits beside the middles the model draws (`PIL.sF`, `PIL_HF`, `PIL.LT`, `PIL_SEAT_T`), which the essay works the fit from.
- `js/frame.js`: `WFRAME.build(mv, M, K)`, the frame's parts. Each part's own sizes sit in the comment beside the code that draws them, with the sheet, the figure and how sure.
- `js/fusee.js`: `WFUSEE.build(mv, M, K, FR, TR)`, the fusee, maintaining work, stop work, barrel, mainspring, chain and band, and `update(s, c)`, which sets them from the centre arbor's angle `c` (the fusee wheel turns with it by 14/90) and `s.n`, the fusee's turns from full wind (the Hamilton's MoveState: 0 fully wound, `NRUN` 8.70 run down), `s.winding` (the key on the square); it returns the fusee arbor's angle, which `update()` publishes as `mv.userData.ang.f` for the up-and-down work. `setConn('chain'|'band')` chooses the connector.
- `js/train.js`: `WTRAIN.build(mv, M, K)`, the going train and its bearings, and `update(s)`, which turns the arbors from the escape wheel's place `s.E` and returns their angles (`c` the centre arbor's, for the motion work and the fusee; `s` the seconds arbor's, for the seconds hand). `mv.userData.R.tr` holds the arbors' turning groups, each with its `wheel` and `pin` meshes, for the fusee wheel and the escape pinion to phase against (`gearLash`); `mv.userData.ang` the last angles.
- `js/movement.js`: `buildWempe(M)`, which calls the groups' builders (the frame so far), and `update()`. Later groups each get a file of their own (`train.js`, `escapement.js`…), loaded before `movement.js`, each declaring one global.
- `js/escapement.js`: `WESC`, the balance and escapement: `WESC.build(mv, M, K)` builds them and returns `update(s)`; `WESC.ESC` is the escapement's motion (`ESC` in movement.js, which the page and the tools drive, `ESC.state(p, amp, drive)`, at the swing `ESC.A` by default): since 15 October 2026 makeEsc's solved state as the model draws it (`WESC.adapt`, called by escphys.js; The page's escapement, below), the layout's kinematic motion kept as `ESC.layout`; `WESC.HOLES` the holes it needs in the frame's parts (frame.js cuts them); `WESC.SET` the escapement's settings for makeEsc, from its layout (`MK` puts a plan point in makeEsc's frame; `toKin` turns makeEsc's lift into the detent's turn); `WESC.HSL` the hairspring's working length and its other readings, `WESC.HSP` its plan (the path pin to pin or end to end, which the page draws and `tools/wempe_hairspring.js` checks).
- `js/escphys.js`: `WPHYS`, the escapement in time: makeEsc (`../shared/escapement.js`, loaded before it) built with `WESC.SET` and the drive (05 06_20's force, the train's ratio and efficiency), its reference driven at the escape wheel's torque 12 h from full wind (`TQ`); `drv(n)`, the drive n fusee turns from full wind, times the reference's; `ampStep`, the swing stepped as the Hamilton's; the hairspring's stiffness and the period it gives (`HS`); the maintaining spring (`MSK`, `MSK2`: its push against the ratchet's lead over the fusee wheel; `MSB`, the lead where it banks; `runPhi`, `susPhi`, `susDrv`: the lead running and while the key turns, and the drive then; `SUS`, the key's time to the push spent: `tools/wempe_sustaining.js`). It hands its makeEsc to `WESC.adapt`, so the page's escapement (`WESC.ESC.state`) moves as it solves it, at the reference's solved swing by default. `app.js`'s tick keeps the swing (`H`), stops the train when it is too small or run down, and starts it again (a twist, when the balance has stopped). `tools/wempe_escapement.js` prints and checks it; `tools/wempe_load.js` runs these scripts in Node.
- `js/dial.js`: `WDIAL`, the dial, motion work, hands and up-and-down work: `WDIAL.build(mv, M, K)` builds them and returns `update(s, ang)` (from the train's angles `ang.c`, `ang.s`, the fusee's `ang.f` once the fusee group gives it, else the wind `s.n`, fusee turns from full wind as the Hamilton's MoveState); `WDIAL.face()` draws the dial's printing on a canvas: the geometric parts from the numbers measured on Wempe 3955's dial, the glyphs from `js/dialface.js`.
- `js/dialface.js`: `WDIALFACE`, generated by `tools/dialtrace.py --write` (don't edit): every numeral, figure and letter of the dial's printing, the serial and the anchor, traced off Wempe 3955's dial as contours in 0.01 mm, and the two tracks' divisions' measured angles. Loaded before `dial.js`.
- `js/dialface_lange.js`: `WDIALFACE_LANGE`, the same for A. Lange & Söhne No. 5177's dial, generated by `tools/dialtrace.py --dial lange --write` (don't edit); the page's Variants show it (Dial, `#dial=lange`). Loaded before `dial.js`.
- `dials/`: the three dials as vector drawings, generated by `tools/dialsvg.py --write` (don't edit): `wempe-3955.svg`, `kirov-247-6mx.svg` (the Soviet 6MX's, its serial in red) and `lange-5177.svg`, in mm at 1:1 (Ø 103.55, 12 at the top, the centre arbor at 0, 0), layered paper (the disc with the printed face's holes), ink, red and drill (hidden: every hole through the disc). They are the page's printing, not traced again: `tools/dialsvg.js` runs `dial.js`'s own `face()` on a canvas that records its calls in mm, and `dialsvg.py` resolves its white-over-black paint order into ink alone (shapely). `dialsvg.py --verify` rasterises each against the page's canvas at 4× (24 October 2026: no shape differs at 12.6 µm a pixel, the ink's area within 0.13 %); `dialtrace.py --dial D --compare --canvas r_dialsvg_D.png` (after `dialsvg.py --png`) lays one on its photograph as the page's canvas is laid (Wempe 3955: ink only in the photo 243.7 mm², mostly its hands, only in the SVG 49.4; the page's canvas 241.9 and 51.3). Rerun `--write` after changing the dial's printing (`ci.py` fails on a stale one).
- `js/movement.js`: `buildWempe(M)`, which calls the groups' builders (the frame, the escapement), and `update()`. Later groups each get a file of their own (`train.js`, `escapement.js`…), loaded before `movement.js`, each declaring one global.
- `js/case.js`: `WCASE.build(M)`, the case and the box, outside the movement: the box is the scene's group, the gimbal ring's group in it turns about x (the outer pivots, at `YP`), the bowl's group in that about z (the inner pivots), and the page puts the movement into the bowl's group, lifting it out (600 mm) and turning it over in the movement's views (`app.js`'s tick, from each view's `case`: the lid's opening and the lift). `?qa` gives `window.__BX` (root, ring, bowl, lid), which `tools/audit.py box --model wempe` audits (`checks.py`'s `FLOAT_BOX`, `audit-expected.json`'s `box`). The outer box (`over`, its lid `overLid`, turning about x at its hinges) is built in the box's group and shown only in the Transport box view (its `case.over`); audit it there with `--eval "new Promise(r=>{location.hash='view=transport';setTimeout(r,3000);})"` (the tick sets its visibility each frame).
- `js/app.js`: the parts' cards (`PARTS`, `PIECES`), views, sections and labels, given to the shared viewer, with its Moving parts only (`cfg.drive`) and walkthrough (`WTOUR`, `cfg.TOUR`), and the panels ported from the Hamilton's (tick sound, Swing and isochronism, Rate and timing weights, the 35-day trial, Escapement in plan: below, The page's capabilities against the Hamilton's); it passes the viewer the essay (`essay: ESSAY`) and binds the essay to the model once built (its time, wind and swing).
- `js/essay.js`: `ESSAY`, the Its drawings tab (the page's Essay tab is the essay shared by both models, on its own page, `../essay/`, since 21 October 2026), *The Einheits-Chronometer* (its text and figure markup the `<article id="essay">` in `index.html`; open `index.html#drawings`, or `#drawings=detent`: its hash key since 21 October 2026, essaykit's `key`; `?from=wempe#essay=detent`, the page's old address's links through worker.js, opens it too): what the drawings and the makers' own measurement tell us and where they disagree, phase A (15 October 2026): the dial keeping the model's time (`WDIAL.face` and the hands' outlines, `WDIAL.HANDS`), the sheets' dates, the top plate's hole table and plan (`WD.H`) and the pillar's fit (`WD.PIL`'s limits), 05 06_20's force against the solved mainspring, the escape wheel's chase against the layout's 21°, and the 6MX's TU against GOST 8916-58; phase B (15 October 2026): the hairspring (05 03_7's curve drawn from `WESC.HSP` with its compass arcs and its centroid against Phillips' point, and the force on the pivots against the helix's turns), heat (the balance cloned from the model with its masses moved along the rim, the coefficient against their place, and the 6MX's 35-day trial for that place, its figures worked as `wempe_errorbudget.js` works them), the escapement in plan (the model's own pieces flattened onto the plan in the frame of what moves them, moved by `WESC.ESC.state`: `drawEscPlan` draws the Hamilton's parts, not these), the box and gimbals (`WCASE.build`), and what the drawings leave open. Its facts come from `References/wempe/` and this README only; its numbers are live (`fillLive`: `data-live` spans from `WPHYS`, `WESC`, `WD`) or generated (`data-wphys` spans and the figures' data from `js/essaydata.js`). No drawing scan or photograph is shown: every figure is drawn from the model's numbers, and the text links to dg-chrono.de for the sheets. The machinery is the shared kit, `../shared/essaykit.js` (`ESSAYKIT`), the look the Hamilton's `css/essay.css` (with a few rules in `css/wempe.css`). While the essay shows the viewer doesn't draw the model (it keeps its time), leaves the keys to it and writes `#essay[=section]` (`../shared/viewer.js`'s `cfg.essay`).
- `js/essaydata.js`: `WEDATA`, generated by `../chronometer-working-model/tools/wempe_essaydata.js --write` (don't edit): the sheets' catalogue from `References/wempe/README.md`, the fusee's measured and solved curves and the losses' range (`wempe_mainspring.json`, `wempe_physics.js`), the detent's fall after it lets a tooth go (makeEsc's state), the rate a °C against the masses' place (`wempe_thermal.js`'s `sweep`), one seeded TU trial's days less the balance's linear term (`wempe_errorbudget.js`'s `essay()`), the force on the pivots against the helix's turns (`wempe_hairspring.js`'s spring, `HSPR.lateral`), the swing and the escapement's rate against the drive (makeEsc's `ampAt` and `rateAt`, the drive 0.2 to 1.8 times the reference's: the page's Swing and isochronism panel reads between them), the gimbals' bodies (`gimbals.js`'s, the Wempe's and the Hamilton's), and the figures the text quotes from them (`data-wphys`, which the tool also writes into `index.html`). Without `--write` the tool fails if this file or the spans are stale (`ci.py`'s `wempe-essaydata`, `selfcontained.py`): rerun it after a change to `WESC.SET`, `WPHYS`, the mainspring's solve, the balance or hairspring, the case or the catalogue (about 2 minutes: the trial with its summary, the rate over the wind and the page's swing table run in child processes at once). It also carries what the page's Swing, Rate and trial panels read: `trial.airK`, `trial.Sint` and `trial.sum`, the TU's figures over 2,000 trials compensated and 500 at the masses' drawn place (`wempe_errorbudget.js`'s `summary()`).
- `js/makers.js`: `MAKERS`, generated by `../chronometer-working-model/tools/wempe_makers.py` (don't edit): the maker's sheets' data, each line of the parts list with its measured fit, its drawing's material and treatment and how it is made, the 1950s build's deviations and the bench's tests (Making it, below). `BOM.md`, beside this file, is `bom.py --model wempe --md`'s parts list against the model, the fits it reads.
- `../shared/kit.js` (`KIT`): the part and screw makers and the plan helpers copied from the Hamilton's `movement.js`, and, added for this frame, `solidGeo` (a closed solid from plan cells in depth bands, with holes, counterbores, pockets and coned walls) and `bool` (two outlines crossed, sharing their crossing points). `KIT.screw` takes a material.
- `../shared/contacts.js` (`CONTACTS`): the Contacts debug view, through the viewer (below, The page's capabilities against the Hamilton's), loaded after `viewer.js`; `js/contactdata.js`: `WCONTACT`, generated by `../chronometer-working-model/tools/contacts.py --model wempe --write` from `checks.py` (don't edit): `fine.py`'s expected overlaps and states, which the view calls expected and sweeps through.
- `checks.py`, `bom.json`, `audit-expected.json`: the tools' tables for `--model wempe` (`../chronometer-working-model/tools/model.py`).
- `verification/`: the report *The Wempe Einheits-Chronometer: does the model hold to its drawings, and would it keep time?* (`index.html`, open the file; About and the essay's last section link to it): every Wempe check's method and results, from the tools' own outputs. `node reportdata.js` runs every check (the full runs of dynamics.js, tripping.js, gearing.js and gimbals.js with `--model wempe`, the build checks wempe_tolerances.js, wempe_bench.js, wempe_montecarlo.js and keystone.js --model wempe, at once) and works the figures it charts from the tools' modules and JSON (`assets/data.json`, about 6 minutes); `python geometry.py` runs the browser checks (solids, fine, audit, exploded, bom) one after another (`assets/geometry.json`, about 6 minutes); `python build_report.py` writes `index.html` from `template.html`, those two files, `checks.py`, `bom.json` and this README's Sources, Estimated, Readings corrected and Unresolved sections (a second). The root build copies it to `site/wempe/verification/`. No drawing scan or photograph is in it: its charts are drawn from the model's numbers, the videos linked at their moments. Rebuild it after changing what it reports.

## Coordinates and units

Millimetres. The movement frame is the Hamilton's: dial side +y, 12 o'clock −z, 3 o'clock +x. The pillar plate's inner face is at y 0 and its dial face at +3.35; the top plate's inner face at −19 and its outer face at −22.35.

The sheets' hole tables give every hole as N/S and O/W (Ost, east, and West) from hole 1, the centre wheel's arbor, which is the plates' centre. Every plan of the frame is drawn with N up and O to the right, seen from above with the movement lying dial down: the top plate from its outer face (its pillar seats, in its inner face, are dashed; its sections mark that face "oben") and the pillar plate from its inner face. N is 12 o'clock: the seconds wheel is at S 23 and the up-and-down at N 23. O is the dial's 9 o'clock: Wempe 3955's dial side (`photos/dg-chrono-dec/3_Wempe_3955_uZ.jpg`) has the Wechselrad (hole 19, O 10.9) left of centre, and the movement ring's sheet, drawn from the dial side, puts its screws 20° clockwise from 12, where Wempe 3955's top plate has them at 339° from N toward O. So x = W and z = S (`WD.NO`).

## Sources

- **The works drawings**, `References/wempe/drawings/` (© Johannes Altmeppen, by courtesy of Gerhard D. Wempe KG, 2017), as transcribed in `References/wempe/transcriptions/05-08-frame.md` and checked on the sheets themselves, cropped and enlarged wherever a number mattered. The frame's sheets are 05 08_1a/1b (Oberplatte, 05 09 01), _2 (Oberplatte kompl., 05 08 01), _3a/3b (Unterplatte, 05 08 02-1), _32.2 (Unterplatte kompl., 05 08 02), _4 (Unruhkloben unten, 05 08 00-2), _5 and _6 (Unruhkloben oben, 05 08 03-1, and the kompl. 127-556.04 U30), _7 (Werkring, 05 08 00-3), _8 (Schneckenfutter, 05 08 01-2), _9 (Staubfutter, 05 08 01-3), _10 (Zwischenbrücke kompl., 05 08 04), _11 (Pfeiler, 05 08 00-1), _12 to _14 (Federhausbrücke kompl., 05 08 05; Federhausbrücke, 05 08 05-1; Sperrkegel, 05 08 05-2), and sheet 001 (the movement in plan at 2:1).
- **The coloured section** (`drawings/Wempe_Einheitschronometer.jpg`): the whole movement in one unrolled section, with the parts' numbers, including the Wempe standard parts (WN) that have no sheet in the set. Measured on it where no sheet gives a size, scaled on the pillar's 8.1 and the 19 between the plates (28.3 px/mm in a 3× crop, the same both ways where it was checked).
- **Photographs of genuine German movements**: Wempe 3955 above all (`photos/dg-chrono-dec/`): `2_Wempe_3955_A.jpg`, the top plate square-on on millimetre paper (8.82 px/mm at the plate, from the pillar screws' 62.41 and 58.7 mm apart); `3_Wempe_3955_uZ.jpg`, the dial side; `12_` and `13_Wempe_3955_obere_Platte_*.jpg`, the top plate off, both faces; the side views `4-7_Wempe_3955_*.jpg`. ALS 5177 and the Kirow movements likewise. The 6MX differs (see `References/wempe/README.md`) and isn't evidence for the frame.

- **The 6MX's test cards** (`photos/dg-chrono-6mx-gallery/bilder-zum-6mx/`: eight passports and attestats of Soviet 6MXs, 1953-1993, transcribed in `References/wempe/documents/6MX-figures.md`, section 8): the scatter and drift and the masses' setting the trial is run with, and the check on its secondary error.
- **National Bureau of Standards, Circular 58**, *Invar and related nickel steels* (2nd ed., 1923), Tables 5 (p. 86) and 13 (p. 90): Guillaume's nickel steels' expansion, a + 2bt, by their nickel; the rim's 42-44.4 % "anibal" quadratic −3.4 to −2.51 × 10⁻⁹ a °C² (`tools/wempe_thermal.js`).
- **M. Lux and C. Petersen, "Das Einheitschronometer", *Klassik Uhren 3/2006*, pp. 16-24** (31 October 2026; the PDF on glashuetteuhren.de's Kal. 100 page, https://www.glashuetteuhren.de/kaliberuebersichten-modelle/a-lange-soehne/einheitschronometer-kal-100/, not kept in the repository): the Wempe works' history of the Kal. 05, its features listed, the wartime economies, and the general arrangement "Federchronometer 05" printed across pp. 16-17 (the coloured section's drawing in black and white, about 23 px/mm at its scan's 280 dpi, its labels legible where the coloured scan's aren't). Read for labels and arrangement, not sizes (it draws the top plate 3.51 against the sure 3.35). The same page lists Lange's changes by serial: three pillars, Bakelite bowl and gimbals, "Federhausdeckel unten", the fusee's height 12.2 (Kal. 100's 11.4), the motion work's 7 (the model's: the dial 7 over the pillar plate), the movement ring's 104 (the model's recess Ø 104.05), gilt train wheels from No. 5091, a heavy bottom weight from 5100, the balance 3.8 high from 5111 (the rim's 3.8 built), the "Gegenfeder" changed in Glashütte from 5201, and "eine neue Gangfederstellung" (the detent's) against Kal. 100's foot spring. Also in the article (1 November 2026; recorded, nothing changed by it): its features list (p. 18) gives two days' going with the 56-hour up-and-down work, the plates of brass "geringelt" (the damascening, which the wartime economies of late 1942 sometimes left off, p. 19, with printed aluminium dials and plastic bowls and gimbal rings), the Guillaume balance of "hochwertigem Chrom-Nickel-Stahl", the dial "95 mm Durchmesser, aus 1,3 dickem Messing, mattversilbert" with its figures engraved and filled black (the Dial item below), the hour and minute hands gilt, and the box mahogany or oak with a lid that lifts off; the chain then the band (References/wempe/README.md's Unsettled); the designers Herbert Müller and John Schwarzer (Schwarzer's balance holding device patented 1941, p. 21, as 05 36 and DE742143); Kaliber 04 the lever version, 05 the detent's. Its serial tables (pp. 22, 24): Wempe's Einheits-Chronometer from No. 2800 in 1942 (the last of the earlier model 2781), the highest number each year (1942 3019, 1943 3452, 1944 4338, 1945 4919; after the war 1946 5138 to 1965 7680, from 1966 by year), lever chronometers on the Einheits base about 2600-3000 and numbered with the rest, Lange's from 5001 (31 March 1943) to 5870 (1947); the 6MX made in Moscow until 1997. The essay's rule against serial ranges (CLAUDE.md) predates this source and is left as it stands.
## How each frame part was measured

- **Plates.** Diameter, thickness and every hole from the hole tables (05 09 01, 05 08 02-1) at their drilled, reamed or tapped sizes, drawn at the middle of each fit. The sections give the rest: the pillar seats Ø 8.6 × 0.3 in the inner faces (L-M, E-F); the steady pins' holes reamed 1.6025 from the side their part sits on and opened Ø 2.5 × 1.6 from the other (A-B, C-D); the lower cock's screw sunk Ø 6 H7 × 1.8 (G-H); the escape wheel's setting seats (P-Q, G-H: Ø 5.2 H7 with a 0.5 lip of Ø 4.5 or 4.59 H7, two M1.2 3.5 either side); the recess Ø 22 × 0.7 with its 45° wall round the fusee's hole in the top plate's inner face (J-K); the pocket for the balance holding work in the same face, 1.35 −0.05 deep, from the balance opening to hole 51 and round it at r 4, its edges the common tangents of the opening's r 5 and that r 4, so 10 wide at the opening narrowing to 8 at 51 (N-O, with Wempe 3955's inner face, `13_…unten`, which shows it). The top plate is a crescent: the cut round the barrel milled Ø 42.5 about hole 45 runs out through the rim. The pillar plate's opening for the intermediate wheel is milled Ø 24.5, joined by the seconds arbor's hole (punched 6.0) on its rim. The three small windows beside the pillars (Altmeppen's list of German features) were read as the auxiliary holes 3, 12 and 40; the 6MX, which he says lacks them, has those holes (The Soviet 6MX, X1a), so what he meant is unresolved.
- **The pillar plate's hand-setting cut and holes** (16 October 2026). 05 08 02-1 strikes holes 14-18 through ("nur wenn Zeigerstellung eingebaut wird"), but Wempe 3955's plate is cut and drilled for the hand-setting with nothing of it fitted but a bush in 18 (`3_Wempe_3955_uZ.jpg`, `6_Wempe_3955_S.jpg`, `8_Wempe_3955_Räderwerk_plus.jpg`), and the plate's assembly 05 08 02 draws them so: built so. The holes at the table's places, 14 and 15 drilled 1.45 (steady pins), 16 and 17 drilled 2.8 (screws), 18 reamed 3.50 +0.012 with its bush. The cut lies on the line from the centre through 18, 30.0° below O toward S, the four holes symmetric about it: a window 6.5 square on the dial face (05 08_3b's two "6,5"), its outer edge 8.3 −0.1 from the rim, widened along the cut to 12 +0.2 on the inner face (05 08_3a's Schnitt C-D, which runs along it, and 05 08 02's E-F), each end a Ø 14 arc from one face's edge to the other's, hollow (traced on C-D: each bows 2-3 px into the metal at 9.74 px/mm); 05 08_3a's "9,3 −0,1" is from the inner face's end to the dial face's far edge. Wempe 3955's dial side, fitted on the plate's holes 1, 12, 26, 30, 40 (8.52 px/mm, 0.3 mm rms), puts 14-18 within 0.15-0.6 mm of the table and the window 6.4 × 6.5 at 27.7-33.9 from the centre, its edges at 30.2° (the model's 27.74-34.24): sure. Its bush in 18 there: rim Ø 3.46, bore 1.29 with a bright sink to 1.64 (likely). Not built: C-D's bore Ø 2 at mid-thickness (1.68 from the dial face) from the window's outer wall out through the rim, which a solid of plan cells can't cut across the plate (its mouth shows on the rim's notch on `8_Wempe_3955_Räderwerk_plus.jpg`). Wempe 3955's notch in the rim where it leaves and the groove in its movement ring under it, on no sheet, are built in its version (below, "Wempe 3955 as photographed"). The Soviet 6MX's plate has none of it (Kirov 247's dial side, `3_Kirow_247_uZ.jpg`, is plain there; Altmeppen lists no external hand-setting): the cut, the holes and the bush in 18 are the drawings' versions' only.
- **Pillars.** Every figure of 05 08 00-1. Its countersinks and the half-round relief grooves in the shoulders are drawn without figures and scaled at 5:1.
- **Movement ring.** Its diameters, heights, screw holes and pin holes from 05 08 00-3 as revised 6.12.46. The sheet's heights fix the profile: the pillar plate's seat Ø 85 H9 is 3 +0.1 deep, the dial's recess Ø 104 +0.1 is 0.7 +0.1 deep, 7 −0.1 lies between their floors, 10.7 −0.1 overall; the flange is 4.7 high. The section in the coloured drawing shows the order: the seat at the movement side, a lip Ø 83 under the plate, a 45° cone opening from it to Ø 93 at the recess. Its three M2.6 on Ø 89 at 340°, 100° and 220° from N toward O (the sheet's 20°, 140°, 260° from 12 seen from the dial side; Wempe 3955's three brass heads at 339°, 99°, 218°). The three run on through the flange until they open in its 45° cone, where Wempe 3955's dial side shows them as dark holes (3_Wempe_3955_uZ.jpg; the sheet's plan, seen from the dial side, draws them whole): cut with fusee.js's `bore` from a 0.6 start in the flange's face (frame.js, FLC; 25 October 2026, until then stopped at the flange).
- **Barrel bridge.** 05 08 05-1: its chord is 7 from hole 45 and 7.7 from hole 42 (both figures square to it), which puts it 18.493 from the centre, the greatest width 24.002 (the sheet's 24): three figures to 0.002; the sheet's 2:1 view draws it so (45 7.10, 42 7.59, 48 6.84 from the drawn chord, measured at 4.87 px/mm by the holes' spacing). The short edge at the top at 150° to it, 5 from hole 48 (Wempe 3955: 4.95, 150.2°), which leaves the 73.5 from the point to the top corner 73.31. Its outer edge is the plate's rim. Wempe 3955's chord (`2_Wempe_3955_A.jpg`, fitted to the edge and carried onto the sheet's frame by similarities on its screws) lies between this and the chord square to 45's line built until 15 October 2026 (its normal 14.35-14.46° N of W, against 14.94 and 13.61): the sheet decides.
- **Click.** 05 08 05-2 at 5:1: the hole, length, beak, nose and the hollow r 6 from its figures; its back an arc r 12.5, its centre fitted to 37 points traced along it (0.05 mm rms). Its turn on the bridge traced on Wempe 3955 (its nose's centre lands where the photograph has it).
- **Fusee bush and dust bush.** Every figure of 05 08 01-2 and 05 08 01-3. Which way the dust bush's flat faces follows from the upper cock's place: it passes 7.0 from the fusee's axis, where the collar would otherwise stand 0.55 into the cock's web.
- **The cork ring** (Korkring 05 08 01-4, 15 October 2026). No sheet: 05 08 01 names it on the dust bush and the coloured section draws it in section, its label "Korkring 05 08 01-4" (the case-and-box transcription's list reads "05 06 01-4": the section's crop at 8× reads 08). On the section (`Wempe_Einheitschronometer.jpg`, enlarged 8×) the dust bush's own figures give the scale: its body Ø 13.1 is 122 px and its neck Ø 9.7 90.5 px, 9.32 px/mm. The ring is square-cut, hatched as cork: x 720-870.5 px, Ø 16.1 outside, its bore on the neck; y 135-171, 3.86 high, from the collar's top to 0.95 over the neck's top (y 144; the neck's 27 px is its drawn 3.0 to 0.1). Lange No. 5829 side-on (`stahl_113510_lange_4.jpg`) shows it on a real movement: 1.23 times the bush's body across (the section's 16.1/13.1 is 1.23) and about a quarter as high as wide (sure). Its colour from that photograph's lit face (about #d2a25f under warm light; drawn #c8a070, matte).
- **Balance cocks.** Every figure and hole of 05 08 03-1 and 05 08 00-2, their places from their own tables (the same as the plate's). The upper cock's arm is relieved 0.8 underneath within r 11.2 of the setting, a 45° step out to r 12 (05 08 03-1's 0.8, 45° and 12 r; drawn on 127-556.04 U30); the boss under it turned, face Ø 6, its flank a 45° cone to Ø 7.6. The lower cock hangs under the top plate: its holes are all in the top plate's table, its screw comes down from the plate's outer face (G-H), and its lug, at the block's far face, holds the balance's lower setting about 10 under the plate, as the coloured section draws it.
- **Intermediate bridge.** Its holes' places from the pillar plate's table (all six on one line, to 0.001). Its own sheet (05 08 04-1) isn't in the set: its outline and thickness are scaled on the assembly sheet 05 08 04 at 2:1, calibrated on the screws' 34.13 and the pins' 41.13 apart (7.03 px/mm); it lies on the pillar plate's dial side, as 05 08 02 draws it dashed and Wempe 3955's dial side shows it.
- **Screws and steady pins.** Places from the tables; threads from the tables (M2.6, M2, M1.7, M1.4, M1.2). The WN standard parts have no sheets in the set: their heads and lengths are measured on the coloured section and on Wempe 3955's top plate (below). The steady pins are Ø 1.6, pressed into 1.585 −0.005 holes 2.5 deep in their part and a slide fit in the plate's reamed 1.6025, standing 1.3 out (05 08 04, 05 08 05, U30).

## How the going train was measured (P1b)

The sheets: 05 05_1 (Laufwerk, the train in section, 1941: plates drawn 3.0, superseded by the plates' own 3.35), 05 05_2 to _4 (Sekundenrad kompl., the wheel, the pinion revised 24.3.48), _5 to _7 (Zwischenrad), _8 to _10 (Minutenrad); 05 08_2 (Oberplatte kompl.: the bushes WN-300, WN-301), 05 08_10 (Zwischenbrücke kompl.: the bush WN-300 and the jewel), 05 08_32.2 (Unterplatte kompl.: WN-302, the stud bush 05 08 02-2 and the studs); the coloured section for the bearings' names and order; Wempe 3955's photographs for the bushes' oil sinks and the wheels' look (`8_Wempe_3955_Räderwerk_plus.jpg`, `12_…obere_Platte_oben.jpg`, `3_Wempe_3955_uZ.jpg`). Each number is in `js/train.js` beside the code, with its sheet and how sure.

- **Places.** Each arbor exactly at its hole of `WD.H` (1, 38, 35); the centre distances 18.12 and 12.63 (05 05_1) are the tables' to 0.001.
- **Teeth.** Each wheel's count, module (its pitch diameter over its teeth), tip and root diameters and tooth thickness from its table. The form is core.js's cycloidal one (gearOutline's wheel tooth: radial flanks below the pitch circle, the epicycloid of its pinion's rolling circle above), run up to the table's tip: the epicycloid would meet the tooth's middle at 1.60-1.69 m and the tables' tips are at 1.56-1.58 m, so the teeth are the sheets' rounded ogives, just topped. The pinions are gearOutline's leaves (radial flanks, a round end) with their radii put on the sheet's tip and root, long and round-ended as 05 05 03-2's end view draws them. The centre pinion's 14 leaves, tip 6.79 and root 4.24 are on its sheet. **The intermediate pinion's 12 and the seconds pinion's 10 leaves are on no sheet**: (2 × 18.12 − 31.976)/0.35529 = 12.0 and (2 × 12.63 − 22.453)/0.28066 = 10.0, and no other count fits the centres (confirmed; centre 90/12 × 80/10 = 60 turns of the seconds arbor an hour).
- **Heights.** Every shoulder, seat, pinion and collar from the pinion sheets as last revised, the wheels' thicknesses from their sheets. The arbors' train-side shoulders rest on bushes flush with the top plate's inner face; the sheets' lengths then put the dial-side shoulders on: the centre arbor's riveting collar (Ø 3.0 at its foot) on WN-302, set 0.1 under the pillar plate's inner face (05 08 02), 19 (+0.05, framed) from its other shoulder, so 0.07 endshake; the intermediate's on the bridge's bush set 0.7 +0.02 in (05 08 04), 23.06 between the bearings against 23.05 −0.1, 0.06; the seconds' on its jewel 1.7 in (05 08 04), 24.1 against 24.1 −0.1, 0.05 (bom.py measures 0.070, 0.060, 0.050). The centre wheel's rim then stands 0.49 above the pillar plate (05 05_1's "0,5"), the seconds wheel 13.7 under the top plate (05 05_1's 13.8, of 1941), and the seconds wheel's rim clears the intermediate pinion's end by 1.1 (the pinion's leaves 3.25 long, its sheet's 4,6 −0,2 spanning them and the seat: 26 October 2026; 0.055 before, the leaves 4.5, the seconds hub then standing 0.2 proud toward them).
- **Wheels.** Five straight spokes, hub, rim and hole from each wheel's sheet; each hub flush with its rim on both faces, in every version (the owner's choice, 28 October 2026, the second drawing check's O-3: the three kompl. sheets draw hub and rim faces on one line, the "0,2" and the "10∅", "7∅", "6∅" running to a line inside the hub, the riveting's; the coloured section draws all three flush; Wempe 3955's seconds hub looks proud toward the top plate, the other reading. The intermediate's and seconds' hubs stood 0.2 proud until 26 October 2026, the centre's 0.25 on the dial side until 28 October 2026). Each pinion's seat its sheet's length at its middle (1.25, 1.25, 1.55), standing 0.25-0.3 past the wheel as turned, for the riveting (the centre's with its V groove and lip; the intermediate's was cut to its wheel's 0.95 until 28 October 2026, its sheet's 4,6 −0,2 over seat and leaves then 4.20: 6-M9).
- **Pivots.** Diameters from the pinion sheets as last revised (the intermediate's 0.85 −0.05 of 1946 over the kompl.'s 0.82 −0.02 of 1940; the seconds' 0.82 −0.02 and 0.76 −0.02); lengths from the kompl. sheets (3): the pinion sheets' 4.5-5.1 are the turned blanks', each with its 60° centre, which the kompl. sheets show cut to 3 and rounded. Tapered as the sheets write ("Kegel 1:90" on the seconds pinion, read on the intermediate's and the centre's as the same; 1:30 on the centre arbor's journal C). The seconds post finished 7.2 from its shoulder (05 05 01 of 1940; 05 05_01's layout puts its tip 0.5 beyond the dial, here 0.6), Ø 0.67 at its end on the 1:90: 05 05 01-2's 9.2 is its turned length to a 60° centre, as every end on the three pinion sheets (built 9.2, 2.6 over the dial, until 28 October 2026: the second drawing check's 6-M3). As first drawn and in 1943 the 1940 kompl. sheets' sizes (6-M4): the intermediate's pivots Ø 0.82 −0.02 (drawn 0.81), the seconds' train-side pivot Ø 0.8 −0.02 (0.79), its post Ø 0.73 over its first 2 and on at 1:90, and 24 −0.05 between its shoulders (drawn at its nominal 24.0, with the seconds jewel's face at 05 08 04's 1.7 itself, 1.75 as last revised: endshake 0.064 as last revised; 23.975 against 1.75 until 28 October 2026 left 0.139, out of the 0.025-0.076 band, bom.py; at 1940's least, 23.95, 0.114: the 1948 revision's lengthening likely its reason), the bushes bored 0.02 over them; Wempe 3955 and the 6MX the revised pinions. The centre arbor's shank Ø 1.795 at C, its framed 1,8 g6's middle (1.800 until 28 October 2026: 6-M7).
- **The centre arbor's dial end.** The riveting collar Ø 3.0 at its foot, flared to Ø 3.2 at its top, its flank running on into a V groove 0.99 deep in the wheel's seat under it, the groove's outer wall rising at 34° to the seat's edge, which the riveting spreads over the wheel (05 05 03-2 at 5:1, 141.7 px/mm by the journal's 2.2 and the seat's 5.4; 05 05 03 draws it riveted). The journal "C" Ø 2.2 e8 (05 05 03; 05 05 03-2's fit letter is unreadable) on a 1:30 taper ("Kegel 1:30" along it on both sheets), Ø 2.2 at the collar, to 23 +0.05, and WN-302 bored to it; then the shank Ø 1.8 tapering 1:80, 14.3 long to the cannon tube's top (05 05 03), with a groove under the tube's punch mark (05 05 03, 1943: its square shoulder 6.07 over C, a cone 0.24 deep rising to 6.73), its end crowned with the tube's on one sphere (r 3.1: the arc 05 05 03 draws across both rises 0.35). The tube (Minutenrohr 05 05 03-3, with the cannon pinion turned on its foot) is the motion work's.
- **Bearings.** The top plate's three bushes in its holes reamed 4.59, flush both sides, an oil sink in the outer face as Wempe 3955's plate shows them (`12_…oben`, a cup nearly the bush's width); WN-302 in the pillar plate as 05 08 02's Schnitt A-B draws it (0.1 +0.02 under the inner face, a spherical cup on the dial side, Ø 3.8 × 0.55 scaled against the bush's Ø 4.59 in a schematic section); the bridge's WN-300 at 38 (0.7 +0.02 in, a sink on the dial side, Ø 3.7 on `3_Wempe_3955_uZ.jpg`) and the seconds jewel's setting at 35 (its mouth Ø 3.8 on the dial side, the same photograph).
- **Motion.** E, the escape wheel's place in teeth, turns the seconds arbor once in 120 teeth (15 teeth × 80/10), the intermediate once in 960, the centre once in 7,200 (an hour at a tooth a beat); each mesh turns the other way, so the centre and seconds arbors turn clockwise from the dial (rotation.y falling) and the intermediate anticlockwise. The meshes are phased under load as the Hamilton's (`gearLash`): the centre wheel drives the intermediate pinion, the intermediate wheel the seconds pinion.

## How the balance and escapement were measured (P1d)

Sheets as last revised, from `References/wempe/transcriptions/05-03-05-04-balance-escapement.md`, each figure checked on the sheet where it mattered (crops at 2-5×). Which sheets are the detent chronometer's: the 05 03 and 05 04 numbers and the 02 04 series (Kaliber 020); 05 03_1, _5, _7 and 05 04_20, _21 carry the lever chronometer's 127-556.04 numbers but 05 03_5 and _7 draw the same spring (05 03_6's strip, 15 turns) and are used for the spring's heights and curve.

- **Layout** (05 04_1, Hemmung für Feder-Chronometer, 10:1). The balance at hole 23, the escape wheel at 26: the tables put them 10.000 apart, the sheet's "Gangrad–Unruh 10,00". The sheet is drawn from above (as the frame's plans): the wheel turns clockwise there, counterclockwise from the dial, as the train must turn it. The locking stone's centre 7.14 ±0.04 from the wheel's, 37.0 ±0.3° on from the line of centres (scaled against the wheel's tips Ø 14.00 at 24.47 px/mm, checked by the impulse roller's 6.77 against its written 6.78: likely), so the tips lock 0.235 deep, where Belyakov gives Lange's MX 0.22 and the Navy's 1958 repair book sets 0.20-0.25 on the stone; the roller's shake to the teeth either side of the line of centres is then 0.011. Until 19 October 2026 the stone stood 7.2 and 36.5° (24.4 px/mm, the angle inferred from the teeth's clearance to the impulse roller, 0.05 and 0.12), locking 0.175 deep. The roller's "24°" is read as where the balance stands as drawn: the impulse stone 24° before the line of centres, the discharge stone leaving the gold spring. That is the balance at rest here.
- **Balance staff** (05 04 02, Unruhwelle kompl., 29.5.46). Its datum is the hub's flange top: the arm's seat Ø 2 h6 1.1 above it, the hairspring collet's seat 1:70 from Ø 1.58 to Ø 1.65 s6 to 6.1 above, the brass hub (05 04 02-2) Ø 6.3 −0.1 × 1.8 with its two M1 and its neck Ø 2.63 −0.06 to 4.1 +0.05 below and its bore's foot Ø 2.14 +0.01, the impulse roller's seat Ø 1.65 s6 from the hub's end to 5.6 below and the discharge roller's Ø 1.2 r6 under it (the sheet's widths there, 28 and 21 px at 17.6 px/mm; read until 27 October 2026 as a collar Ø 2.14 to 5.6 with the impulse roller's seat under it: Readings corrected), the lower end 14.03 −0.06 below. It is drawn as a blank between centres, its ends (Ø 1.1): the pivots, Ø 0.21 × 0.4 on cones 2 long, are 05 03_3.2's, each end 0.02 off its endstone. 05 03_3.2 (13.3.65, "050401" in pencil, 25.6 overall, the flange in one with the staff) is a later production staff with the same 6.1, 4.1 and 5.6-5.7 (its Ø 1.65 seat 1.6 long from 4.1 to 5.7, the impulse roller's 1.6): 05 04 02 is built because it is of the drawings' time and the coloured section numbers the staff and hub 05 04 02-1 and -2; 05 04_5 (040401-1, 1941, a staff with a brass collar 4.7 to the collar) is superseded by it.
- **Heights.** The staff's place along its axis follows from the hairspring: the stud's bar on the cock's top, the spring's top coil 3.15 and its lower end 13.4 under the bar's underside (05 03_5), the collet's underside 0.75 under the spring's lower end. That puts the arm's top 0.05 under the collet, the rim's lower face 0.45 over the top plate (the coloured section draws 0.53) and the impulse roller's top 0.32 under the plate's inner face, the discharge roller right under it, 1.92-3.52 under it (the coloured section: the impulse roller's top about 0.3 under, both rollers 1.5-1.6 thick one under the other, at 9.4 px/mm; 05 04_1's "4,1 bis Unruhauflage"). The escape wheel is level with the impulse roller (its rim 1.4 inside the roller's 1.6, its teeth 0.4-1.8 under the plate), just under the plate as Wempe No. 9166 of 1972 is made (Wempe 9166 below). Its arbor's place between the plates isn't printed (05 04_7.2 has 2.9 of room between their outer faces): set by the wheel, its pivot ends lie 1.98 into the top plate and 1.55 into the pillar plate from its dial face (05 04_7.1's 2.0 and 1.39), 22.78 apart (05 04_7.2: 22.8 −0.02), the wheel's pinion-side face 19 from the pinion end (so its other face 2.38 from the top plate's end; the sheet's "2" runs from that end to the arbor's shoulder, 0.4 under the wheel), the pinion's face 5.3 from the pinion end (all sure). Until 27 October 2026 the rollers hung 1.5 lower, under the misread collar, the impulse roller 1.8-3.4 under the plate, the wheel's teeth 1.89-3.29, its arbor's ends 0.5 and 0.06 inside the plates (until 15 October 2026 the wheel 2 from the end, its teeth 1.51-2.91 under the plate, the "2" read to the wheel).
- **Balance** (05 03 01-1, Unruhreifen: nickel steel and brass). Every figure of its sheet: Ø 32.32 −0.04, the joint Ø 31.29 −0.04, inside Ø 30.48 +0.04, 3.8 high; the arm in one with the steel, across the rim's lower face, 1.15 thick, 3.2 wide at the rim, 4 where it swells in two hollow arcs r 20, their centres outside the arm (marked on the sheet 7.2 along and 21.95 across from the centre), to a point 6.5 across at the hub ("6,5"; traced: sure; Wempe 3955's arm shows the hollow flanks; until 15 October 2026 convex arcs to 6.17, "6,5" read as where the arm is 4 wide); the hub's hole 2 H7 and the screws' holes Ø 1 at 2.14 either side; the cuts 1.5 +0.2 at 90° from the arm (built 1.6, the fit's middle, since 25 October 2026; 1.5 before); the timing screws' holes Ø 0.9 × 0.16 2.15 over the rim's lower face. The arm lies along 12-6 at rest (05 03_1's note on the timing screws). Wempe 3955's balance (`9_Wempe_3955_Hemmung.jpg`) shows the same: the steel arm, four brass masses across the rim, two cylindrical timing weights at the arm's ends, the rim cut beside the masses.
- **Masses and timing weights** (05 03 01-4, 05 03 01-2/-3; 05 03_2, a poor copy). The masses Ø 6.35 (05 03_1's boxed [6,35], its balance proper this one; 05 03_2, a poor copy, scales its two clean masses 6.28-6.30: likely; Ø 6.3 until 28 October 2026, the second drawing check's 1-M1), their centres on the rim's middle, their top edge chamfered 0.26 × 45° (05 03_2's inner ring, 1-M11), each held by its screw WN-12 radially through its outer jaw's tapped hole, its tip on the rim's outer face (0.005 off), 1.85 over the rim's lower face (05 03_2's side view; Wempe 3955's 2.55, Lange 5829's 2.0); the screw M0.8 (the drawn shank's Ø 0.84: estimated), its slotted head, Ø 1.6, in a counterbore Ø 1.62 flush in the mass's outer face and nothing standing out of the inner (Wempe 3955, `9_Wempe_3955_Hemmung.jpg`: sure). Until 28 October 2026 no hole was cut for it, its tip 0.03 off the rim (1-M2, S-1); until 18 October 2026 a nut across the rim; until 15 October 2026 head and nut stood 0.55 out. In each top a tapped hole M1.2 2.0 deep for WN-12a, its top flat, empty in all four (the owner's choice, O-4: countersunk Ø 1.85 until 28 October 2026). The timing screws' slotted heads inside the rim on its inner face (05 03_2's plan, Ø 1.65 × 1.3 scaled), their shanks M0.9 × 0.16 (05 03 01-1's "0,9", "0,16 Steigung"), threaded (plain until 28 October 2026: 1-M4) in the rim's holes, drawn plain at the thread's size and 0.02 (Ø 0.92: a hole across a rim built as plan cells can't carry the kit's tapped thread), the weights on them outside, their tips 42.1 over both (likely); the weights split by two saw cuts across them, 1.3 deep from the outer end and 1.7 from the inner, at right angles (05 03_2 and Wempe 3955's weights, the outer cut across the whole end face with the screw's tip in it: likely), Ø 4.25 × 3.3 in the drawings' versions (05 03_2 scales 4.21-4.33), Ø 3.8 in Wempe 3955's and the 6MX's (the photographs Ø 3.0-3.9, ±0.4), 0.8 short of the tip (until 15 October 2026 Ø 3.0 × 4.0, uncut, the head outside the weight). The coloured section's labels make 05 03 01-2 the screw and -3 the weight.
  - *Their height* (15 October 2026, likely): **from the rim's lower face to 6.46 over it**. 05 03_2's side view (12.18 px/mm by the rim's 3.8 between its two faces' lines) draws the near pair, whole, from the rim's lower face to 6.40 (the end's chamfer, about 0.4, is a second line to 6.0), and the far pair from 1.24: that is the arm's cut section (1.15 thick, hatched) hiding their foot, so the "5.4 from 1.1" P1d built was the hidden pair's outline. Wempe 3955's side view (`5_Wempe_3955_O.jpg`, about 25° above the plate; each mass's height against its own width, and the hairspring's Ø 12.8 for the scale, 10.1 px/mm) gives height/diameter 0.98 and 1.00 for its two front masses, 6.2-6.3 high (5.9-6.1 with the scale corrected for their nearer place); Lange 5829's (`stahl_113510_lange_4.jpg`, nearly side-on) 0.92, 5.8. Wempe 3955's balance off the movement (`9_Wempe_3955_Hemmung.jpg`, seen from the arm's side) shows each mass's face flush with the rim's face within about 0.3 (no wall of the rim shows over it) on its far mass, 0.6-0.7 on its near ones (in the slot's shadow, unsure). Built 0-6.46, the far pair's top kept (both outlines end there); the chamfer at the top 0.26 × 45° (05 03_2's plan's inner ring; left out until 28 October 2026).
  - *Their place* (15 October 2026, likely): **30° from the 3-9 line** (the cuts'). Wempe 3955's balance (`9_Wempe_3955_Hemmung.jpg`) rectified by the affine map that takes its rim's two cuts (at r 15.7) and the arm's two ends (at the rim's inside, 15.24) to their plan places, all on the rim's lower face where the masses' faces lie: the four masses at 28.2°, 32.0°, 30.0° and 29.6° from the cuts' line (each ±1-2°: their faces' centres read by eye to 2-3 px at 15.5 px/mm), at r 15.0-16.5 (15.7 built), two either side of each cut. The 6MX's book draws 30° (Fig. 5.62); 05 03_2 scales 32.5 (P1d built 32). The rim's graduation ("8 Körner in 60 Teilung") isn't resolved in any photograph (a division is 1.6 mm, the punch marks under a pixel); 05 03 01-1 draws its ticks in all four quarters (the note once), eight a quarter 6° apart from 6° to 48° off each cut's line, both sides of both cuts (the masses at the fifth, 30°); a running 6MX (`ru-web/pikabu/166329139918310084.jpg`: sure) and Lange 5373 (`muser95-86_lange5373_4.jpg`: likely) show them as centre-punch dimples on the rim's outer face, the brass, about half-way up it: 32 dots Ø 0.3 there, decals (left out until 28 October 2026; eight on the rim's top from one cut that day, until the owner's question: the second drawing check's 1-M16).
- **Hairspring** (05 03 02-1, Spiralfaden 02 03 10): the strip 0.52 × 0.285, Ø 12.8 outside, 0.21 between coils, 15 turns left-hand as wound, the whole strip cut to 13 turns less 3.5 mm before the curves are bent (05 03_7; phase 2c: 11.80 turns of helix between them, 505.4 mm pin to pin; phase 2a and P1d read it as 12.911 turns of helix, the curves added: below, Physics: hairspring and temperature). Both ends follow 05 03_7's table of radii to the strip's inside every 10°, from 6.12 at 0° (the coil's inside, 6.115) to 3.37 at 230-250°, pinned at 220°. The inner end ends 3.51 from the staff, where the collet's hole is (05 03 02-2: 3.5 −0.02, drawn 3.49), straightened along the hole square to the collet's tapered side. The outer end follows the same table into the stud, 3.55 from the staff, into the stud's Ø 0.7 hole 3.55 from it, 3.15 under the stud's bar (05 03_5's "3,15", 05 03_1's stud detail; its end straightened along the hole: below; 3.46 from the staff and 3.78 under the bar until 28 October 2026, the second drawing check's 1-M14; until 15 October 2026 drawn in proportion to end 3.87 out, until 27 October 2026 in a slot). Going up the coils turn counterclockwise seen from the dial ("links"); the collet's turn on the staff is set by the 4,691° from one pinning point to the other, which leaves its pin end 10.8° from under the stud (05 03_1 and 05 03_5 draw them together). The spring's ends 9.5 apart (05 03_5: 3.15 + 9.5 + 0.75 = its 13.4 from the bar to the collet's underside), each in its hole: the drawn helix opened between them to a pitch of 0.80 (the 11.8 turns of helix this model reads; 05 03_5 draws 13 pitches of the wound 0.73 there: Physics, hairspring and temperature), the physics keeping the wound pitch (until 28 October 2026 its top curve 3.99 under the bar, set up 0.2 into a hole 3.78 under it, the ends 8.82 apart; the stud's pin hole is drilled at assembly, 05 03 02-3, and 05 03_1's stud height is "6≈ ... übereinstimmend mit ... Schwingungen", set by the spring as vibrated).
- **Collet** (05 03 02-2, Spiralrolle): every figure, at the fits' middles (9.0 long, 3.7 and 2.6 wide, the spring's hole 3.49 from the bore; each at its top limit until 28 October 2026: 1-M15); traced (34.5 px/mm), both ends arcs about the bore (sure), the bore in the middle of its length (4.58 and 4.52 traced: likely), the slit stopping 0.1 +0.05 short of the bore (until 15 October 2026 the ends straight, the bore 4.25 from the wide end, the slit into the bore); the spring's hole Ø 0.805 where it enters, reamed 1:90 across to 0.775 ("Kegel 1:90", "(0,77)"), its axis "90°" to the tapered side it enters, 3.7° off square to the bar (straight and square to the bar until 28 October 2026: 1-M9, 1-M11); bored on the staff's 1:70 line to line, gripping by its slit. **Stud** (05 03 02-3, Klötzchen): every figure; the bar 1.5 thick (1,6 −0,2's middle and 05 03_1's "1,5"; 1.6 until 28 October 2026), its upright 6.0 from the bar's top (6,1 −0,2's middle, 05 03_1's "6,0"), 2.5 wide at its square end and 3.1 at its hole (5 from that end), its point two flat facets from the plan's V (apex 6.6 on from the hole) to a knife edge, meeting along the middle (the section; Wempe 3955 shows them); its upright, 1.8 g6, leaning 8° toward the axis (98°), slides in the cock's slot (05 08 03-1: 1.8 H7, across the arm on the setting's line, to 3.4 from the axis on the top, its inner wall at 82°, Schnitt C-D), the bar on the cock's top along the arm toward the foot (Wempe 3955: along the cock's axis, its square end 1.1 past the setting's line, its middle 4.1 off the axis), the spring's end in its Ø 0.7 hole with its pin (Spiralstift 05 03 02-4, half round, brass). The plan's Ø 0.8 round at the point is left out (the facets leave it no room).
- **Rollers.** The impulse roller (02 04 02, Heberolle, revised 10.9.41: beryllium copper): Ø 6.78 ±0.01 × 1.6 +0.1 (drawn 1.65, its middle, as last revised; 1.6 until 28 October 2026. As first drawn, in the 6MX and in 1943 still 1.6, its lower limit, as 05 04_1 stacks the rollers: at 1.65 the discharge stone stood 0.0001 under the 6MX's and 1943's gold spring), bored 1.627/1.65 on 1:70 (Ø 1.650 at its face toward the hub; straight 1.653 until 28 October 2026) and pressed on the staff's straight Ø 1.65 s6 (drawn at its middle, 1.6685: 1-M7); the hollow's bottom r 3.5 between corners 3.5 apart, the stone's face 2 from one of them; the stone 0.5 × 1.8 from 1.55, 1.7 wide, its end bevelled 45° to 1.3 at its back (r 2.85; traced: sure; until 15 October 2026 to r 3.2); the hole Ø 1.3. The discharge roller (05 04 04-1) has no sheet: scaled on 05 04_1's dashed outline, 2.77 × 2.15, 1.6 thick (the elevation's lower "1,6"), its stone 1.7 wide; brass, as Wempe 3955's block beyond its impulse roller (likely; steel until 15 October 2026).
- **Escape wheel** (05 04_7.2, 05 04 05-1, 19.7.43; tooth form 05 04_23, 02 04 08a, 20.1.42). 15 teeth, tips Ø 14 +0.03; the gaps' floor Ø 11.7, the locking face straight down to it, leaning 25° back from the radius through the tip (05 04_23's "25°"), its root 5.38° behind the tip; the tip flat 0.1834 (1½°); the back hollow, the ∅ 6 cutter's arc (traced r 3.02) to Ø 12.1 15° behind the tip ("12,1", "15°"), where a step 0.2 falls to the floor, the tooth 1 wide there. The sheet's lines traced and circles fitted at 82.8 px/mm, rms 0.25 px (sure); until 15 October 2026 the floor was read as Ø 12.1, the face leaning 15° (root 2.43° behind), the back to 11.9° and a step 0.15 up to 12.4. 1.4 thick at the teeth and 0.7 in the web, the top plate's face recessed 0.7 over the whole rim to the gaps' floor, Ø 11.7, the teeth standing full (05 04_7.2 draws the recess at Ø 11.9 by its ratio to the wheel's 14; 05 04_7.1 dimensions it 11,9 struck for 12,4, which would cut the 1942 roots at 12.1; the owner's choice, 28 October 2026, the second drawing check's O-7: Ø 11.62 until then, read at 7.2's absolute scale, which left a ring of full thickness 0.04 wide inside the floor and no rim), flush on the pinion's side (both 7.1 and 7.2 put the recess on the face away from the pinion, as 05 04_1 does); Wempe 3955's own wheel a rim of full thickness from Ø 10.9 to the teeth, the recess only inside it (`8_Wempe_3955_Räderwerk_plus.jpg`, `9_Wempe_3955_Hemmung.jpg`): 05 04_1's elevation draws the teeth standing 0.6 over the web toward the plate, 0.5 under it. Three openings, each bounded by the rim's inside and one arc r 7.9 centred 9.43 out on its middle line, coming within 1.53 of the centre (05 04_23's crossing traced: its flanks r 7.93 and 7.92, centres 9.43 out; 05 04_1 1.54: sure), the crossings 0.6 wide at the rim and 0.53 at their narrowest (until 15 October 2026 two arcs meeting at a point 1.4 from the centre). Its pinion (05 04 05-2): 10 leaves of m 0.263, tips Ø 2.97, 4.0 long (05 04_7.2 scaled: 71 px at 17.76 px/mm by its 22.8, the 5.3 and the wheel's 1.4 agreeing; Wempe 3955's 4.3 ±0.3 and the 6MX's 3.9: likely; until 25 October 2026 05 04_7.1's 3, which left 0.3 of the seconds wheel's 1.0 rim past the leaves); pivots Ø 0.24 × 0.5 (the lower's Ø boxed on 05 04_7.1, the upper's on neither sheet: estimated the same); the arbor Ø 1.0 under the wheel to its shoulder 2 from the end, then a cone to the pivot, and Ø 1.07 between the collet and the pinion (05 04_7.2: likely; Ø 1.2, 05 04_7.1's, until 28 October 2026), Ø 1.2 past the pinion; the wheel's bore 1,8 H7 on the collet's spigot 1,8 h6 (05 04_7.2's callout, 05 04_1's 1,8, 02 04 08 a's hub; its fit table's 1,7, built until 28 October 2026, a slip: the limits are alike); the collet (05 04 05-3, 05 04 10 on 05 04_7.2), brass, 4.7 long: Ø 2.8 for 1.6 over the wheel, then Ø 1.7, each step chamfered 0.15 (scaled at 17.6 px/mm; until 15 October 2026 a cone Ø 2.6 to 1.5).
- **Detent** (1436, Gangfeder, Rud. Grießbach 17.2.43). Each figure is followed by a second in brackets, written later in another hand outside the dimension lines: 0,25 (0,22), 0,33 (0,28), 0,55 (0,50), 0,65 (0,60), 0,8 (0,75), 2 (1,9), 1 (0,9), 5,4 (4,9). Every bracketed value is the smaller, by 0.03-0.1 (0.5 on the 5.4). They are read as the detent as revised, a lighter detent, and built: foot 0.60 × 1.9 × 6.6, spring 1.9 × 5, 0.09 thick at each end and 0.07 at its middle, straight between (1436's left view: sure; built so since 25 October 2026, until then 0.07 throughout; makeEsc and the frame take the uniform strip as stiff, 0.0792, the moment along so short a spring nearly even), square 1.9 × 2, blade 0.50 then 0.28, 0.9 wide, flush with the lower edge of the foot, spring and square (the right view), pipe Ø 1.15, horn 0.22 × 0.75 flush with the blade's lower edge (1436's right view: sure; at the blade's middle until 28 October 2026), its end bevelled in plan over its last 0.74 (the right view's line across it, "Anschrägen" at its tip: likely, its form estimated) (until 25 October 2026 the foot 2, the blade 1 and the horn 0.8 tall, the unbracketed figures). The lengths 1436 doesn't figure are scaled on it (17.3 px/mm): the spring 5.0, the blade's thicker part 2.9, pipe to square 8.4 (8.07 here, where the block puts it).
- **Gold spring** (05 04 01-2, Goldblech 333 federhart): every figure (0.15 thick, the arm 1 wide flush with one edge of its head 2 × 2.4, the hole Ø 0.7 1.2 from the head's end, 15.4 overall; 15.31 here). Its tip 1.54 from the staff is traced on 05 04_1; its free part is one smooth bow round the pipe to the tip, which alone rests on the horn's, traced on Wempe 3955's detent seen square-on along its pipe (`10_Vergleich_CWW-6MX_Gangfeder_mit_Kloben.jpg`, flattened into the detent's frame at 80 px/mm: the strip's middle between its edges, traced by hand in `tools/tracer.html` (`tools/traces/wempe_detent10.mm.json`) and by its yellow, CIELAB b*, the two 0.02-0.04 apart), pinned at its bending point and its tip by taking off a line (distances across that photograph run 0.3-0.4 large where the parts stand off the steel: its arm reads 0.4 off the square's face it is screwed to), so it closes onto the horn with the gap between them narrowing to the tip, as the photograph shows it (likely, ±0.05 in shape); the 6MX's beside it the same. Until 18 October 2026 a polyline lying 3 along the horn and cranked out by the pipe; then, that day, the bow traced once from a pipe centre about 0.3 off the blade's line, the same round the pipe to 0.03 but meeting the traced horn before its tip.
- **Detent block** (05 04 01-4, Gangfederkloben, 8.7.43). Every figure (tolerance ±0.1): the base 14.6 × 7.5 (25 overall less 17.5), 6.5 deep for 6.4 from its end ("6,5", drawn 6.4) and 3 deep beyond ("3"), the thin part on the plate (sure; until 15 October 2026 6.5 deep over its whole length), the upright 3 × 3 from 1.4 +0.1 in from the base's end, its far side stepped out 0.35 at 2.5 over the base and joined to it by a cove r 3 to 2.0 out and 0.4 over the base, then straight down, flush with the 6.5-deep part's end (the front view's arc fitted: r 2.96, its centre in the air; a cove r 3 tangent to both until 27 October 2026), its end slit 0.3 for 7 with an M1.2 across at 18.8 ±0.03 from the base's hole row (the slit's plane across the plate, the screw through both its leaves, as the sheet draws it: built so as last revised since 28 October 2026, drawing check 2's 2-M9; the 1943 block keeps the photographs' slit, parallel to the plate), the fixing M1.7 at 7.3 +0.04, the hole Ø 1.3 × 3 and the M1 into it from the end, the steady pins Ø 0.9 at 2.3 and 12.3, 2 either side of the row. Screwed up through hole 13, the detent's foot clamped to the base's end. Wempe 3955's block (`10_`, `11_Wempe_3955_*`) is the earlier one of 05 04_1 (a plate with a long arm and a brass cone at the stone): not built.
- **The banking, the horn, the gold spring's tip and the preload** (15 October 2026, from the photographs of detents on their blocks: `10_Vergleich_CWW-6MX_Gangfeder_mit_Kloben.jpg`, Wempe 3955's beside a 6MX's; `8_Gangfeder_mit_Kloben_Rus_einfach.jpg`, a 6MX's; `11_Wempe_3955_Gangfeder_plus.jpg`; crops in the session's scratchpad):
  - *The banking is the block's cross screw* (likely). The 6MX's block, which is 05 04 01-4's form (the base with its fixing screw between two steady pins at opposite corners, the upright with its fillet, the foot clamped to the base's end by a screw along it), carries a screw through its upright with a domed brass head on the detent's far side, about Ø 3.7 and 1.7 deep against the upright's 3 (31 px/mm), its thread standing out behind; the detent's pipe rests on the head's flat face. Wempe 3955's earlier block has the same: a domed brass head beside the stone, its pointed tail (05 04_1's "pointed piece" on the pipe, P1d's "brass cone") through a slit in the block's arm. The 1954 instruction (п. 11: "Винтом-ограничителем … устанавливается глубина сцепления камня покоя") and the 6MX's book (p. 168, screw 12) say a banking screw sets the depth of lock. So 05 04 01-4's M1.2 across the slit upright, 18.8 from the base's hole row, where the stone is, is that screw, the slit gripping its thread: it bears on the pipe at the stone, on the wheel's side. Drawn whole since 27 October 2026 in every version but the first drawn (the escapement of 1943's: its domed slotted head Ø 3.4, the pipe's side on it, the slit gripping its thread), the block read in first-angle projection (DIN's), the upright at the free face and the screw 5.0-5.15 under the plate, below the wheel; until then the last revised block was read in third angle, the upright flush with the plate, and its screw a plain shank bearing on nothing (Readings corrected: the 1946 staff). The physics takes it: the frame's banking (tools/wempe_tripping.js) is now one contact, the pipe's side on the head at the stone (until now under the blade 0.7-1.4 from it, where makeEsc puts the Hamilton's stop button). makeEsc and dynamics.js take the detent rigid, so where its banking is doesn't change them.
  - *The horn* is **4.4 long from the stone** (likely): 1436's figure (its drawing scales 5.2, not to scale there). Wempe 3955's detent seen along its pipe (1436's left view: the horn curving with the gold spring, the "Anschrägen") measures 4.4-4.55 from the pipe's centre to the horn's and the gold spring's tips (21.7 px/mm by the pipe's Ø 1.15, ±8 %; by the pipe-to-square 8.4 scaled on 1436, 4.2). On both photographed detents the gold spring's tip ends just past the horn's (under 0.3). Its line in plan (18 October 2026): on the blade's line at the pipe, bending steadily toward the block, 0.06 off at 2 from the stone, 0.20 at 3, 0.37 at 3.7, to its end where the gold spring's tip rests (0.55 off, its face on GNB as before): traced twice on the same photograph flattened, by hand (its centre line) and by the steel's edge against the gap beside the gold spring, each from the blade's line beside it, the two 0.05-0.1 apart, fitted as one curve (rms 0.05 and 0.02). 1436's left view draws the bend later, over its last quarter (0.06 at 4.0 of its 5.2 drawn, 0.45-0.5 at the top), not to scale along there. Until that day a step at the pipe and a straight bar 0.54 off the blade's line (its end's place). At 4.4 the horn's end is 1.598 from the staff, 0.038 outside the discharge stone's reach (1.560): the stone clears it on the return swing, and the gold spring's tip (1.54) stands 0.056 past it. P1d drew 3.5, 1 short of the tip, reading 4.4 as reaching the stone's path. The 6MX's horn measures about 3.5 (its detent is shorter: 6.4 from the pipe to the square against 1436's 8.4).
  - *The gold spring's tip*: square, as 05 04 01-2 cuts it (sure for the blank). Wempe 3955's tip, the only one seen, looks square or slightly oblique at 21.7 px/mm: a rounding under 0.1 can't be seen. Kept square (makeEsc's `TSQ`).
  - *The preload* stays an estimate (0.8 g at the stone since 19 October 2026, just over the margin's floor with the deeper lock: The physics pass; 0.63 g before). The 6MX's detent on its block rests with its blade about 2° (±1°) out of line with its foot, toward its banking: so the spring is set (bent) to press the pipe onto the head, as a straight detent couldn't rest there; its free line isn't shown, so the preload can't be read. 05 04 01-4's end face, where the foot is clamped, is "90° +0.5°": the foot may be set up to 0.5° out of square, which would be about a quarter of the estimate's bend (2.05°); taken as a tolerance, not a set.
- **Jewels.** The coloured section labels each bearing's hole jewel (Lagerstein 05 04 06-1, the balance's 05 04 07-1) in its setting (Fassung 05 04 06-2) and the endstone (Deckstein 05 04 08-1) in its own (05 04 08-2); none has a sheet in the set. The settings are sized to their seats (Ø 5.2 H7 in the cocks and the top plate; the pillar plate's hole 26, reamed 2.50) and drawn as the coloured section draws them. The stones themselves are traced on the section's red (18 October 2026, row by row, at 9.4 px/mm, which gives the cocks' seats Ø 5.25 for their 5.2 H7, so the section is to scale there; ±1 px, 0.11), the form each end the same: the hole jewel Ø 2.9, 0.8 thick, its face to the endstone domed 0.3 and an oil sink opening into its face toward the arbor, a cone from the hole to Ø 1.6 0.55 deep, the olive hole 0.25 long at the crown, 0.03 off the endstone; the endstone Ø 2.9, flat to the pivot, its edge 0.5 and its outside domed 0.4. Wempe 3955's top plate (`2_Wempe_3955_A.jpg`, enlarged 10×) shows both upper endstones whole, the balance's Ø 2.95-3.1 in a dark bevel Ø 4.4-4.5, the escape wheel's Ø 2.95-3.2 in one Ø 3.7: the endstones' settings open in a cone from a lip over the stone's edge, as the section draws the cock's; the balance's stone colourless, the pivot's hole dark through it (Kirov 247's faceted and colourless; both sure: drawn clear, the ruby hole jewel under it showing through, since 18 October 2026; opaque steel before) (the lower balance endstone's setting a bore of the stone's size, Ø 3.0, as the section draws it). Where the sheets leave less room the form is scaled: the escape wheel's lower hole jewel to the pillar plate's 2.50 hole (Ø 1.6, 0.45 thick: the section draws that end as the upper, Ø 2.9 in a setting Ø 5.1, which the sheet's hole can't take), its upper as last revised to the 0.45 its arbor's end leaves under the inner face (0.4). The seconds jewel (05 05 04-1) is flat on the arbor's side and sunk on the dial side, a cone to Ø 1.7 0.6 deep.
- **Motion** (`WESC.ESC.state(p, amp)`, p the phase of the balance's 0.5 s period, as the Hamilton's: th = −A cos 2πp, the active swing for p < ½). The swing A is solved from the drive (Physics); until phase 2a it was set at 225° each side. The discharge stone's end meets the gold spring's tip 12° before rest, pushing the gold spring against the horn and turning the detent about the middle of its spring. The tooth is free when the stone has lifted 0.185 (0.175 of lock and 0.01), 3° before rest. The stone is fully lifted, 0.245, as the discharge stone leaves the gold spring at rest (the drawn instant). The wheel then drops onto the impulse stone at 21° before the line of centres and follows it, the tip sliding on the stone's face, until the tip leaves the stone's end 21.2° past. It runs on to the next lock in 3° more of the balance. The escaping tooth's back holds the stone up while it passes under it. On the return swing the discharge stone bends the gold spring away from the horn, from about 7° to 20° before rest, and the detent stays down. The escape wheel's E (teeth) is the Hamilton's: E = beats − 1 + progress. Its turn, 24° a beat, drives the train through `update()` (the train phase).

## How the fusee and barrel were measured (P1c)

The sheets, each as last revised: 05 06_1 (Schnecke kompl., 1941: the order along the arbor and its fits), 05 06_2.2 (the body 05 06 04-2, revised 27.2.48), 05 06_3.2 (Schnecke 05 06 04, revised 2.3.48), 05 06_4 (the partial views: the maintaining work, Schnitt A-B, and the stop work, Schnitt C-D), 05 06_5 to _8 (dust plate, Vorreiber, fusee wheel, cover plate), 05 06_9, _10 (the maintaining spring), _11 to _14 (the maintaining ratchet, its clicks and their springs), _15 (the arbor 05 06 04-1), _16 (the click wheel 05 06 04-3, 6.8.47), _20 (the fusee's curve and its force, Herb. Müller 24.7.41); 05 05_11, _12 (the maintaining detent 05 05 05); 05 07_1 to _14 (the barrel 05 07 01 as revised 20.4.48, its drum and lid, the arbor 05 07 02 and 020704-1, the set-up ratchet, the band 05 07 03 and its hooks, the chain 05 07 04). Every number is in `js/fusee.js` beside the code, with its sheet and how sure; the coloured section gives the order of the parts along each arbor where no sheet does.

- **Places.** The fusee at hole 10, the barrel at 45, the maintaining detent at 4 (both plates drill it 0.9), the stop pin at 7: `WD.H`.
- **The stack along the fusee arbor.** The arbor's 19.7 +0.05 between its shoulders (05 06 04-1) fills the 19.75 from the pillar plate to the fusee bush's end (below), so it has 0.05 endshake. Its cross hole, 2 from the dial-side shoulder (19.7 less the 17.7 −0.05 to the far shoulder), takes the Vorreiber's pin, whose centre is 1.1 ±0.1 from the Vorreiber's hub face (05 06 00-2; the coloured section draws it so). The fusee body's large face, re-turned on the arbor at assembly, lies 13.6 from the end of the arbor's Ø 6.1 step (05 06 04's "13,7 −0,1", below: Readings corrected), so the face is 6.1 from the dial-side shoulder. Face a, under the fusee wheel, is to be re-turned at the fusee's assembly (05 06 00-2's note) to fit what lies between it and the fusee's face: 2.76 from the hub face (the flange 0.86 of its 1.2 −0.2), which puts the fusee wheel's underside 2.385 off the plate. Upward from there each part rests on the one below with 0.05 between (none given): the maintaining spring (1.3) in the wheel's 32.3 recess on its web, the ratchet on the wheel's rim, the fusee body's large end on the ratchet's plate, the click wheel on the floor of the body's recess (Ø 26.3 × 2.7 as turned, 2.5 under the re-turned face), the cover plate on the body's small end. The maintaining detent, at 6.2 of its 6.3 ±0.1 (05 05 05), lays its tip on the ratchet's teeth over 0.85 of their 1.02, and the cover plate's top comes 0.425 under the J-K recess's floor. The coloured section agrees (wheel 2.4 off the plate, the ratchet 4.8 to 6.1, the detent 4.7 to 6.0 by its scale, and an empty 0.5 of the J-K recess over the cover plate). Until 25 October 2026 face a was 2.9, the wheel 2.5 off the plate, the fusee's face 13.46 from the step and not re-turned, the detent at 6.3 and the cover plate 0.085 under the recess's floor.
- **The fusee body.** 05 06 04-2's figures: the flange Ø 35.6 with its two ribs and the slot between them (2 ±0.02 over both: the first rib 0.76, its "0,8" the nominal, the slot 0.87 +0.01, the second rib 0.37; the slot's floor r 17.25: the groove's turn 0 where it starts at A, not turned all round, since Schnitt A-B's lower half, through B, draws the large end as one land at full radius about 1.15 wide and then the first turn's land: likely; turned all round until 28 October 2026, the second drawing check's 5-M9), the 45° chamfer from Ø 29.8 into the large end's recess Ø 26.3, 2.7 deep (12.6 less 9.9), the bore 7 H7 (straight on this issue), the small end's recess Ø 15 × 1.6, its holes (cut 25 October 2026; until then left out, the screws and the chain's pin lying in the metal, as "a turned body can't be holed across"): the three M2 for the click wheel's screws on r 5.75, 6 +0.5 deep from the large end's recess floor, at 74°, 194° and 314° from the chain's pin A (Schnitt C-D, seen from the small end, draws them at 16°, 137° and 259° with A at 90°: likely ±2°; until then 47° from there, which would have broken the cover plate's M1.7 into the nearest), the M1.7 on C-D's "6 r" circle 6 deep from the small end's recess floor (A-B), the chain's pin's hole Ø 0.55 +0.01 axially through both flange ribs, and the stop bar's spring's pin's hole 0.5 H7 along the slot from the recess out through the end; drawn at their threads' sizes and 0.02 (the frame's rule), flat at the drill's depth. The body is five closed pieces, the flange swept ray by ray in two (split where turn 0's near wall crosses the second rib's face, m 0.69) with its rib faces fixed corners of every ray, the second holed for the chain's pin (fusee.js `bore`), the groove's body swept ray by ray, the tube between the bore and r 7.5 as plan cells with its tapped holes, and the small end's band turned whole from 2.0 under its face, united and cut as one closed solid offline by manifold3d's booleans (`tools/wempe_fusee_body.py` into `js/fuseebody.js`, which the page draws; 31 October 2026): the stop bar's slot milled across the end as one cutter (05 06 04-2's Schnitt C-D: its walls 4 and 6 from the axis, 2 H8, "1,5+0,05 tief" on the bar's lower end's side of the small end's recess and "1,1+0,05 tief" on its upper end's, drawn at their middles, 1.525 and 1.125) and its spring's pin's hole drilled. C-D writes each depth in its own half of the slot, between the recess's circle and the hub's rim (02-1's 1,6 and 1,2 the same); the recess (Ø 15 × 1,6) is deeper than both, so the slot is two pockets and the step between them lies in no metal (likely: the label's place; 31 October 2026). On the upper end's side C-D draws the groove's top turns under the slot's floor dashed, hidden under a whole floor (0.27 of metal over them, `tools/wempe_fusee_check.py`), and on the lower end's side solid, with no hatching: the window. Until 31 October 2026 the upper end's side was 1,5 deep inside r 9.30 (those dashed arcs read as the step; a step at r 9.30 would be seen from the section's side as a solid line), and a straight step at u 8.0 before that, which broke through the 1,1 floor (the owner's pictures). The slot breaks into the top turn of the groove where it is deeper than the uncut end (0,3 at D, about 1.3 at C): Schnitt C-D, the section 0,8 under the face (A-B's "0,8"), draws its hatched metal ending at the top land's circle and the slot's walls running on past it into the groove, and Ldzmn4kuKMA 1:14.87 shows the bar's nose coming out of the top land in such a window (sure). The sheet's scan isn't drawn to one scale (the Ø 7 bore 10.5 px/mm, the Ø 15 recess 11.3, the slot's 2 H8 13.0, its 4 from the axis 11.7: `tools/fusee_sheet.py`), so its lines read to about ±0.5 and the written figures decide. Until then the end was built ray by ray in three pieces either side of the slot, then turned and cut in the page (facePocket), and showed sheets of no thickness, slanted faces and slivers (RESOLVED.md); OCCT's booleans on the helical groove failed (an exact B-rep, tried the same day), 12.6 −0.1 overall (drawn 12.55; the assembly's bracketed 12.3 is a reference). The groove: the nine "Grund" radii (14.75, 13.32, 12.17, 11.24, 10.55, 10.07, 9.71, 9.47, 9.30 from the first turn to the ninth, the same on 05 06_20 but its 10.04 at the sixth) at whole turns, 05 06_20's curve between them (scaled at quarter turns, 0.035 high there against the written values, taken off); r 17.25 at turn 0, the flange's slot. A square-cut helix: the pitch 1.2 ±0.01 (02-2's "1,2" from the second rib's outer face to the first groove rib's far face: a land and its rib), each land 0.87 wide (1.2 less the rib) with a rib 0.33 thick on its small-end side standing 0.6 over it ("alle Maße: +0,6"); the lands the slot's width, so the chain (0.82 ±0.02) runs in a 0.87 channel on the whole fusee, 0.03-0.07 clear. Turn 0 lies in the slot, turn 1 on the first land (2.0 to 2.87, the section's "1,2"), and the groove's last turn, 8.75, ends 12.17 from the large end, 0.08 short of "Gangende Punkt N" 0.3 from the small end (the pitch's ±0.01 is ±0.09 over the turns); full wind, where the stop holds the fusee, falls 0.112 turn short of it (the stop work, below). The chain's first 0.15 turn leaves the slot's middle level, where its hook lies on the pin, and rises into the helix at its pitch. Sure of the figures; the 1,2 as every turn's pitch likely: the only reading in which the slot, the 1,2 and point N agree (16 October 2026; until then the pitch was 02-1's pencilled 1.15 and the lands 0.82, which cut the second rib to 0.14 and needed the slot narrowed to 0.8). Under the chain's pin (Ø 0.55, 1 under the ribs' tops, across both ribs) the slot is cut deeper by a cutter Ø 13.5, 2.9 deep, its arc centred on the pin in view C-D: section A-B, through the pin, draws the ribs whole with the slot about 2.8 deep between them (scaled), so it is a slitting cutter in the slot, where the hook wraps the pin, not a flat across the ribs. The flange's ribs at A: the first rib's face 0.76, the slot 0.87, the second rib 0.37, 2.000 over both; past A turn 0's land rises out of the slot along the helix, and the first rib's face and the second's outer face (turn 1's land) move with it. Until 31 October 2026 the flange was a lathe with rows 0.04 apart, its rib faces and turn 0's walls slopes between rows: at A the slot 0.909 and the second rib 0.323 (`tools/wempe_fusee_check.py`, which measures every written figure on the built body). Built ray by ray on that radius field, 216 rays a turn, each ray's outer line flat along the axis but at the groove's walls, where it has a corner pair at the wall's own depth, its foot and its top, rays joined wall to wall as a thread's flanks are (fusee.js `helixSolid`, 27 October 2026): the walls square and on the helix. Until then a lathe pushed out to the field, rows 0.04 apart, as the Hamilton's fusee is, each wall a 0.04 slope between rows whose edge jumped 0.04 as the helix crossed a row, every rib's edge stair-stepped (the drawings check, batch 5); the floor is the same (`tools/wempe_fusee_profile.py`: within 0.001 of 05 06_20 over the working turns, rms 0.0004, the pitch 1.2000; within 0.025 before). The groove is cut only to N (turn 8.817, its land's edge 0.3 from the small end); past N, and over the last land's rib, the end is the uncut blank at the hub's Ø 21, so the hub's inner face follows the helix: Schnitt A-B draws the last land against a block at Ø 21, 0.3 thick at D and about 1.3 at C (scaled at 12.1 px/mm: likely), no rib between them (until 17 October 2026 the hub was 0.3 all round with the groove cut on under it, and the stop bar's slot cut a loose flange: RESOLVED.md).
- **The arbor.** Every figure of 05 06 04-1: the stub Ø 1.6 +0.1/+0.05 for the up-and-down pinion (the motion work's, P1e), the pivot Ø 2.8 ±0.02 to 2.7 (1:70, 6.5) in the pillar plate, the Vorreiber's seat 4.38 to 4.5 (1:70), the collar Ø 7.04 −0.01 × 7.9 pressed in the body, the step Ø 6.1 −0.05 × 3.1 for the cover plate, the journal 4.5 to 4.39 (1:70, 8) in the fusee bush, the square "3,1 r6" (+0.023/+0.015: 3.12 at its root) tapering 1:100 to the sheet's 2,92 at its point (3.12 less 20.3/100; read 3.17 until 28 October 2026, the second drawing check's 5-M1: the small figure after "3," is this hand's flagged 1, as in the "+0,015" beside it, and 3.17 would leave 2.97 at the point). The stub tapers 1:70 too, as the sheet writes in it: drawn 1.675 at its middle, so its whole 3.375 lies in the figure's 1.65-1.70 (1:225 until 28 October 2026, 5-M14), the up-and-down pinion's bore tapered to match, 0.023-0.028 tight on the radius (the stub's +0.05 over a 1.6 bore at the least, 0.025). Its 60.6 overall counts two lathe centres: the dial end's is cut off (its end 0.25 under the dial), the square's end is that centre's point, a cone cut through the square so its flats end in curves, as the sheet draws them (15 October 2026; a 1 mm pyramid until then): scaled at 7.0 px/mm (the 60.6 over 424.6 px; the 28.3 gives 6.9), the tip at x 585, the flats' ends 2.0 and the corners' 2.43 from it, a cone of half-angle 38.7° fitting both to 0.2 (likely: a pixel is 0.14). Kirow 247's square ends so (`4_Kirow_247_N.jpg`, sure); the coloured section's dome is pictorial. Its cross hole "1,1 bohren + konisch reiben" 2 from the dial-side shoulder, at the Vorreiber's pin's turn, and the Vorreiber's drilled Ø 0.8 across its hub (05 06 00-2, 1.1 from the hub face) are reamed through together at the fusee's assembly and pinned (28 October 2026, the second drawing check's 5-M3 and 5-M16): the three sheets give the pin three sizes, the hub's 0.8, the arbor's 1.1 drilled and taper-reamed and 05 06_1's "Vorreiberstift" circle Ø 1.2, which one taper pin reamed through both at assembly reconciles (the reamer opens the hub's pilot to the arbor's size, past the drill's 1.1; a 1:50 reamer leaves 1.07 to 1.22 across the hub's 7.5): both holes are drawn straight at that mean, Ø 1.15 (the taper's 0.075 on the radius at the hub's faces not drawn), the pin Ø 1.16, 8.3 long with rounded ends standing 0.4 out of the hub both sides as the coloured section draws them (scaled on its hub; it draws the pin about 0.7 thick, pictorially). The Vorreiber is seated on its 1:70 seat (its bore "fitted to the arbor"), 0.0002-0.008 tight. Until then the pin was drawn as two ends in the hub stopping 0.025 short of the arbor's metal, the arbor's hole empty and the Vorreiber 0.014 clear on its seat, so nothing held it or the fusee wheel above it, which could drop 0.92 to the pillar plate: the reason given was the Exploded view's, which moves each part along the arbor. Pinned, the Vorreiber spreads with the fusee in the Exploded view, and the fusee wheel, the maintaining work and the maintaining detent among them with it (offsets −33; −14, −21, −25 and −25 until then).
- **The fusee wheel.** Its table (z 90, D 40.57, d 39.21, dg 37.84, l 0.64, m 0.4356) on core.js's cycloidal form with the centre pinion's 14 leaves as its mate (train.js's `teeth`, copied), phased against the centre pinion with `gearLash`; the rim 2.62, the ledge 0.2 under it out of Ø 33.8, the web 1.22 inside Ø 32.3, the hub Ø 16.6 as thick as the rim, the underside recess Ø 14 × 1.3; the tube Ø 6.5 g6 to 5 from the underside and the bore 4.55 from the 1941 assembly's fits (4.45 H7/g6, 6.5 H7/g6), where 05 06 00-3's own figures are overwritten or can't pass the arbor (README, below).
- **The maintaining work.** The ratchet 05 06 02-1 (120 teeth Ø 37.25, 0.7 deep, the plate 1.02 at the teeth and 1.3 inside the cup, the cup Ø 26.1/24.45, 3.1 overall, its outer top edge 0.3 × 45°), its clicks' screws on 19.5 (M1.7 tapped, the screws' shanks threaded and matched to it, 27 October 2026), its click springs' pins at 42° and 60°, its pin hole at r 14.2; the clicks (05 06 02-3) traced on their 10:1 sheet between its figures (10.05 long, the hole 5.2 from nose and tail, the back r 8, the hollow r 3 about 2.78, 3.54, whose chord is the base line 1.5 under the hole, tangent to the boss's thin Ø 3, so the nose's foot lies 5.201 from the hole, the figured 5,2 −0,1 (1.52 until 28 October 2026: 5.224, past it; the second drawing check, 3-M2), the top edge tangent to the boss with its tail's round 5.2 from the hole (its slope 0.581, scanned 0.585); the nose 2 high, its face at 85° leaning back toward the pivot); the click springs (05 06 02-2: arcs r 12.0 and 10.4, the S round two 2.2 mandrels) laid along the cup's wall as 05 06 02 draws them, each with its two holes Ø 0.6 +0.02 on the cup's two pins (05 06 02-2: one 5 from the end, the end's "0,6∅" the other's, 18° from it; 27 October 2026); the maintaining spring (05 06 01-1: Ø 32.3, 2 wide, its eye r 1.8, its holes on r 14.2 at 0° and 65°, its inner edge three arcs traced on the sheet: r 10.41 from the eye, tangent to the inner circle 50° on, so the band widens toward the eye (3.16 at 10°, where it was 2 until 27 October 2026), the swell's r 6 about the small circle on the 9 o'clock line, and r 13.24 from its corner to the square end's 4; the outer edge running into the eye's round by an arc tangent to the ring 60° from the eye (`tools/wempe_maintspring.py`; Readings corrected); its eye's pin up into the ratchet and the other down into the wheel, 05 06_4 A-B: Readings corrected); the click wheel (05 06 04-3: 35 teeth Ø 16.0/14.5, undercut 8°, each tip overhanging its gap, on Ø 11.5's three screws, its bore's 0.3 +0.2 × 45° chamfer on the free face, the face the screw holes open 1:8 toward: drawn 0.4, since 25 October 2026). The clicks' pivot holes sunk 45° to Ø 1.7 on one face and opened to Ø 2.2 on the other (05 06 02-3's edge view: the sink 0.24 deep, the cone 0.42; read in first angle, the 2.2 on the free face toward the small end and the 1.7 on the cup's floor: likely; 25 October 2026). The click springs (05 06 02-2) as drawn: their middle on r 11.825 along the wall, 0.2 off it (05 06_4 A-B's "0,2"; 02-2's "12,0" and "10,4" read to the outer face, the only reading that fits inside the cup's 12.225: on r 12.0, 0.025 off the wall, until 28 October 2026), from their end 5 to the pin hole (on the cup's 60° pin), 5 more to the S, the S round 02-2's two Ø 2.2 formers (bends of 47° and 32° and a straight of 1.58, the arm starting 15° round from where the S leaves the wall, as 02-2 draws the formers' tangencies; a cosine ramp over 8.5° scaled on the sprung assembly until 28 October 2026), and the long arm on r 10.225 out onto the click's back, ending where the strip's "gestreckt 27,0" ends: 113.6-113.7° round from the hole (02-2's drawn centreline 26.9 long ends at 113.9°; its "110°" and the assembly's tip there taken as the drawing's round figure: until 28 October 2026 the tip on the 110° line and 26.6 long; the second drawing check, 3-M5, 3-M7; until 25 October 2026 the S 3.6 past the pin and the tip a third of the way along the back from the nose, 99° from the hole: 24.4). The drawings of this work are seen from the fusee's small end, the movement's back (the top plate's side): mirrored here. The two clicks stand half a tooth apart on the 35-tooth wheel, so one bears while the other rides; both are seated each frame on the click wheel's outline (`seat()`), as the detent is on the ratchet's.
- **The maintaining detent's wire spring** (Feder 05 05 06-1, the coloured section's; no sheet). Its hole is the top plate's 5 (05 08_1a: "Drahtfeder", N 38.507 O 10.684, M1.7, 4.73 from the detent's hole 4; 05 06_4's "Drahtfedermitte"), empty on Wempe 3955's plate off (13_…obere_Platte_unten.jpg). The stud and wire were measured on three movements from the north (4_Wempe_3955_N, 4_Kirow_247_N, 4_Lange_5177_N) and from above (2_*_A), each scaled by the hole table's own spacing of holes 3, 4, 5 and 49 on the same photograph (8.8 px/mm from above, 11-12 from the north), the wire's line traced row by row (its centroid on each row, fitted as a line, 1 px rms) and its lean taken against the detent's arbor's on the same frame; the coloured section (9.37 px/mm by the plates' 19) draws the stud's head, its shank standing out under the plate and the wire leaving its end, and the wire's end over the pillar plate. The sizes and how sure each is are under Estimated. The wire is drawn upright, its axis on the stud's, and bent as a cantilever by the detent's back, which stands 0.32 over that axis, so it bears on the arm's upper corner alone; `fusee.js` rebuilds it as the detent rides the ratchet's teeth.
- **The maintaining detent.** 05 05 05-1's outline from its figures (the boss Ø 5, the back r 18, the hollow r 9 about 6.273, 9.645, tangent to the boss, the tip's lower corner on r 12 about the hole and its end 2.6 tall at 80°, leaning back toward the hole), 2 thick with its tip 1 thick at its upper face, which reaches the ratchet's teeth; 6.3 from its arbor's lower shoulder (05 05 05). It reaches over the fusee wheel's teeth to the ratchet: its thick part is cut back to where it keeps 0.25 clear of their tips as it rides (the step drawn 7.55 from the hole, the sheet's 8.6).
- **The stop work.** 05 06_4's Schnitt C-D, traced at 12.2 px/mm about its centre (its Ø 21 hub, Ø 15 recess and Ø 6 step come out so) and scaled 0.989 to its 22.5, and the body's 05 06 04-2. C-D is seen from the fusee's small end, as A-B on the same sheet (the maintaining work's): mirrored here, which puts the stop pin against the bar's far side at full wind, where C-D draws it ("Stellung im aufgezogenen Zustand"); unmirrored (until 15 October 2026) the bar met the pin with its near side. **The bar** (Stellungssteg 05 06 03-1, the coloured section's; no sheet): 22.5 × 2 (drawn 1.98, a sliding fit in the slot's 2 H8, estimated: drawn 2.00 until 18 October 2026, its sides in the slot's walls, they flickered through each other), its middle line 5 from the axis, its ends 11.52 and 10.98 from the foot of the axis's perpendicular, retracted; its lower end cut obliquely, the point on the axis's side (r 0.39) and the far side 0.94 shorter; its upper end square on the far side, the near side rounded r 2.47; a hole Ø 0.5 across it 6.0 from the foot for its pin 05 06 03-2 (C-D draws it dashed across the bar; cut since 28 October 2026, the pin in solid steel until then), on which the spring's end bears. 1.45 thick (the coloured section), on the cover plate (dial up, the small end faces down), so at its lower end it reaches through the uncut end (0.62 there) into the top turn's groove (its land 0.87, to 1.49) and no further; thinned to 1.05 from 0.8 along toward its upper end (below). Its travel 3.6, between C-D's two positions as drawn (C-D's figures read from the hub: Readings corrected). **The slot**, cut in the body (05 06 04-2): 2 H8 wide, its near edge 4 from the axis, right across the small end, "1,5+0,05 tief" on the bar's lower end's side of the recess and "1,1+0,05 tief" on its upper end's (the fusee body, above): there the end is whole over the groove's top turns, and the bar's thinner upper end, standing out over the groove, passes over them, clear of the chain on the turn below (fine.py found the full-thickness bar 0.26 into that chain); its full thickness stays inside the recess slid its whole 3.6 (the recess's wall crosses the slot's far side at u 4.51; 0.11 clear); the coloured section draws the bar's end standing out 9.5 px thick against its middle's 13.5 (0.70 ±0.07; the model's 1.05/1.45, 0.72), flush on the cover plate's side, and its lower end at full thickness. The swept body stops at the slot's floor; the small end's last 1.5 is swept the same way in the two pieces the slot leaves, and the shallow part. **The spring** (Stegfeder 05 06 03-3, the coloured section's; no sheet): C-D draws it in both positions, a strip along the recess wall from its end at the slot round the bar's upper side and the recess to a free span whose end bears on the bar's pin; traced on C-D (each point at the line's darkest pixel; the dashed, wound one searched along rays through its gaps): running, it leaves the wall 152° round from the bar's upper end; wound, at 95°, looping in to 3.15 from the axis. The model draws it between the two as the bar slides (the two drawn lengths differ by 4 %, 32.1 and 30.8). Its thickness from its bending: between the two shapes its curvature changes by up to 0.064-0.073 /mm along the free span (the end on the bar's pin carries no moment), so a hardened spring-steel strip t thick and 1.0 high is stressed 6,500-7,500 × t MPa (t in mm) wound and pushes the bar out with 0.06-0.08 N half way and 0.11-0.16 N wound (its strain energy over the 3.6). At 0.10: half the steel's yield, once a wind, and 20-30 times the 0.5 g bar's weight against a knock along it; C-D's double line, 0.15, would be stressed to 0.7 of yield. **Its pin** (Stift 05 06 04-4): in the body's hole "0,5 H7" along the slot, 1.5 from the line through the axis on the bar's side (02-2's "15"), standing into the recess to 6.4 from the axis (C-D) through the spring, which it holds by a hole Ø 0.54 where it lies on the wall (no view can draw a hole in the strip edge on; cut since 28 October 2026, the pin through the strip until then). **The slide** is worked out from the contact: the spring holds the bar out until the chain (or band) on the top turn, or coming down onto it, reaches its lower end, which then slides in as far as keeps it 0.02 off the connector's inner side (the chain's plates 1.0 from its pitch line, the band's 0.11): it starts 0.195 turn before full wind and has 3.37 at full wind (the band 0.185 and 3.38); the drawing's 3.6 is its limit. **The stop and full wind**: the slot runs along the line from the axis to the chain's pin A, its upper end toward A (02-2 dimensions it from that line: "4", "2 H8", no angle). The stop pin (hole 7, 14.0 from the fusee's axis, Ø 1.6) bears on the bar's far side 2.3 below its end, 0.02 off, and that turn of the fusee is full wind: 0.112 turn short of the chain lying to the groove's end N, so 8.638 turns of chain on the fusee, and from there 8.70 turns and 55.9 h to run down (05 06_20's test: 8.75 working turns; the up-and-down dial: 56). Until 15 October 2026 the model took full wind at N and set the bar's turn from the stop, 40° off A. The groove's last tenth of a turn stays empty, as a fusee's should: the chain never reaches its end. 02-2 draws N a further 0.07 turn on (55° from the bar's upper end, where the groove at its 1.15 pitch puts it 80°; N's angle isn't dimensioned, and 0.07 turn is 0.08 along the axis). Before full wind the bar comes no nearer the pin than 0.69 a turn earlier, and closes on it steadily over the last 0.05 turn (`tools/wempe_stopwork.py`: every 0.005 turn over the last 1.2 turns, chain and band, the bar's faces sampled against the pin's cylinder; ci.py runs it). **The stop pin** (05 08 01-5, no sheet): Ø 1.6 in hole 7, flush with the plate's outer face (estimated); its length off the coloured section, where the "Anschlagstift" leader, followed across the barrel's wall, the band and the maintaining detent's arbor (inked blue where it crosses them), ends on a stub standing under the top plate (px 628-642 × 357-375): on the plate's drawn 31 px for its 3.35, straight sides 15 px (1.62) under the inner face, then a domed end 2.5 px (0.27), ±1 px each (±0.1); 14 px wide (Ø 1.5, for its 1.6). Built 1.6 straight with a 0.25 dome, 1.85 in all (likely; estimated 1.5 until 15 October 2026); the bar's thin end, 1.235 under the face, bears on its straight part. The section draws the bar's protruding end 10 px (1.05) thick, the model's thin end, but 0.69 under the plate's face where the sheets' stack has 0.185 (it draws the whole small end so: the cover plate's top level with the plate's face, under 0.5 of the J-K recess left empty, where the sheets leave 0.085), so there the dome reaches just past the bar's lower face. Wempe 3955's train photograph (`8_Wempe_3955_Räderwerk_plus.jpg`) shows the cover plate over the small end whole and the bar's two ends out past its rim, the plate's screw toward the bar's upper end on the side away from it, as the model has them.
- **The barrel.** 05 07 01 (revised 20.4.48) and its parts: the drum Ø 41.6 × 18.1, inside 38.5, the bottom 1.25 with its boss (Ø 12 land, 45° to Ø 8, 3.1 from the outside), the bore 4.5 +0.1, the lid's seat Ø 39.2 × 1.2; the lid (1.3, its boss 3.3 from its face, recessed 0.6 under the rim); the hook block 05 07 01-3 0.5 deep off the bore (the wall at it 2.05 against 1.55 on 05 07 01; 0207's step 0.5) and 6 long round it (0207's flat, dimensioned), 3.05 high, riveted through the M2.6 hole 9.05 from the bottom 1.4 from its far end (0207's plan, scaled: likely ±0.5; the hole bored through the wall and the block at its thread's size and 0.02, 25 October 2026); the Steg 05 07 00-1 (the coloured section's #6; 0207's part 106), a steel bar 2 × 0.5 standing inside the wall from the bottom to the lid at r 18.3-18.8, 45° back from the rivet, its ends through the bottom's slot (05 07 01-1: 2 +0.05 wide, r 18.3-19.1, the section drawing it through the bottom just inside the bore and the plan its outline there) and the lid's 9 o'clock notch (to 18.3 ±0.02, its seat), the mainspring's outer coil threaded between it and the wall (built 18 October 2026: until then the hook block 0.35 × 3, no Steg, and the 9 o'clock slot cut through the drum's wall from the rim, read as a slot for prising the lid out). **The lid is on the barrel bridge's side**: 05 07 01 draws the arbor's square through the lid, and the coloured section draws the lid at the top (the 1941 assembly 0207 had it on the plate's side). Sure from the sheets; neither photograph shows it.
- **The barrel arbor.** The arbor 05 07 02 (the kompl. of 1943: 40.2 overall, the ball end 5, the square 10) with 020704-1's diameters (1941), each drawn to the later parts it runs in (its hook pin's hole Ø 2 × 6 in the core, 0207's section, cut 25 October 2026, the pin pressed to its foot): its pivots 2.88 and 3.88 in the plate's 2.90 and the bridge's 3.9 (the 1941 sheet's 3 and 4 can't enter them), its journals 4.48 in the drum's 4.55 (its 5 can't), its core 10.98 between the drum's bosses (its 12 can't fit the 1948 drum's 11.1), its shoulders 22.29 apart (22.2 +0.1, framed), 0.03 off the plate and the bridge. The hook (05 07 02-2): a pin Ø 2 in the core, its end a ramp across it from flush to 0.5 −0.05 at a radial face (the end view), the face on the side the spring pulls.
- **The set-up ratchet.** 05 07 00-3: 16 teeth Ø 14.1/11.1, each face on a line 1.2 off the radius, the back an arc Ø 12.5 (r 6.25) centred on the Ø 6.4 circle, 2.65 thick, its square hole 2.7 H7 (1:100); turned until a face meets the frame's click (P1a, traced on Wempe 3955).
- **The chain.** 05 07 04: the pitch 2.05 (framed), the plates 4.05 × 2 (framed), 0.82 ±0.02 across (framed: drawn 0.80, three plates of 0.26), 780 +3 over its hooks; drawn 375 pitches (781.25 over all), so both ends are outer links with the hooks riveted between their plates. Its pitch line runs 1.02 out from the groove's floor and the drum. Its top hook (5 to its crown, 3.5 wide, its seat 3.5 from its rivet, its nose turned back toward the chain) takes the pin across the fusee's flange slot (the "0,55∅ +0,01" hole through both ribs) in its seat, the chain's first rivet set along the path where the seat reaches the pin; its bottom hook (its barb's root 3.5 from its last rivet, the barb 1.4 past the shank, pointing back toward the rivet, the tip 7.5) a slot in the drum's wall cut at the fusee's assembly (0207: "Schlitz für Kette erst bei Schneckenmontage einsetzen", 2.5 wide round the drum, its section's 0.85 along it, through the wall), cut where the hook's barb comes to the drum (fusee.js `DRUM`, 25 October 2026: the chain once laid, its barb's points inside the drum's outside put in the drum's frame, the slot's middle at -19.6° and the barb 1.03 into the wall; the band's own drum slotted at -37.5° for its hook; until then not cut, the barbs in the metal). Laid every update: along the groove from its first rivet to where it leaves the fusee, straight to the barrel, round the barrel to its hook, each piece of chain at the height it left the fusee at (the drums' heights so match, as on Wempe 3955's barrel, where its turns lie about 2 apart: 7_Wempe_3955_W.jpg). The barrel's turn keeps the chain's length; the mainspring's turns follow the barrel's.
- **The chain runs across between the drums.** It leaves the fusee's south side and comes onto the barrel's north side (their inner common tangent), so the barrel turns against the fusee. The model first ran it along their south side, as an open chain, the barrel turning with the fusee; that run passed through the lower balance cock (fine.py), and a run along their north side would turn the fusee, and so the centre arbor, the wrong way. The photographs agree with the crossed run: the set-up click and ratchet on Wempe 3955 and Lange 5177 (2_…A.jpg) hold the barrel arbor against turning anticlockwise from the dial, which is how a barrel turning clockwise pulls it, and sheet 001 draws the chain on the barrel's far side from the fusee. Likely, not sure: no photograph shows the run itself (Unresolved).
- **The band.** 05 07 03: 0.22 +0.03 thick, 730 ±3 between its hooks; its width isn't given: drawn 0.78, inside the 0.87 land and its hooks' 10 × 0.8 strip (estimated). A post-war GUB Glashütte's Sandvik band, a cousin of the drawings' chronometer, not made to them, measures 730 mm between its hooks, the sheet's length, and "approximately 0.2 mm²" across (chronometerbook.com, post 35, 10 January 2019), which at the sheet's 0.22-0.25 thickness is about 0.8-0.9 wide: it agrees with the drawn 0.78 and the 0.87 land, rough, and is not adopted. The same post fits its band with the fusee in place, wound on under tension, then hooked to the barrel (the band's maker's sheet). Its hooks 05 07 03-2 (round, on the fusee's pin) and -3 (barbed, into the drum) built from their 10:1 sheets: each figure as written, the arcs and lines the sheets don't figure traced on the scans (`tools/wempe_bandhooks.py`, then `mfgfit.py`; fusee.js gives each primitive and its source). Its pitch line 0.12 out from the floor.
- **The mainspring.** 15 × 0.37 (05 06_20), drawn 14.8 high (below) and 0.36 thick so packed coils lie at 0.37; its length fitted to 05 06_20's force, 1,240 mm (Physics: energy). Drawn as two packs, on the core and on the wall, joined by one turn, its turns from the barrel's: 12.69 at run down (lying all on the wall, 11.94, and the ¾ turn of set-up, 05 06_20's "3/4 Umgang gespannt"), 17.80 fully wound (5.11 barrel turns with the chain), 1.1 short of coil-bound (18.9).
- **Motion.** The fusee wheel turns with the centre arbor by 14/90 the other way (anticlockwise from the dial running); the maintaining ratchet turns with it, ahead of it by the maintaining spring's closing (`s.ms`: 14.4-15.6° running, its ends nearly meeting; while the key turns the ratchet, fallen back to its detent's tooth (fusee.js `fall()`, 0 to 3°), held there and the wheel running on, the lead falling tooth by tooth with the train; run down, held by the detent), the spring drawn bent to it (an elastica: Physics: energy, The maintaining spring). The fusee turns by `n`, its turns from full wind (6.43 h a turn, 55.9 h from full to run down, 8.70 turns: 05 06_20's 24 h in 3.75 turns), and running is carried forward onto the click that bears (its click wheel's face against that click's nose); winding (the key on the square, 1.5 turns a second) it turns back, the clicks riding over the click wheel and the detent holding the ratchet. Run down, the train stops. The chain's leaving point sets where on the groove the fusee's turn puts it (`m0`), the barrel's turn keeps the chain's length, and the mainspring follows the barrel.
- **The variants.** The chain is the page's default: its sheet sizes it completely (the band's width isn't given), the groove's 0.87 lands take its framed 0.82 ±0.02, and Wempe 3955 and Lange 5177, the genuine German movements photographed, run with chains (5_Wempe_3955_O.jpg, 7_Wempe_3955_W.jpg, 7_Lange_5177_W.jpg). The band, drawn in 1943, is on Greenwich's wartime Wempe and came with Wempe 3955 (14_Wempe_3955_Band_Kette.jpg).

## How the dial, motion work and hands were measured (P1e)

The sheets: 05 02_1 (Zeigerwerk, Auf u. Ab gesamt, 28.3.41, 5:1: the arrangement, drawn with plates 3.9 thick), 05 02_2 to _5 (the hands), _6 and _7 (Wechselrad kompl. and the wheel), _8 and _9 (Stundenrad), _10 and _11 (Auf u. Abrad), _12 (Zifferblatt 05 02 00-4), with 05 05_8 (Minutenrad kompl., 22.7.43: the cannon tube 05 05 03-3) and the coloured section for the parts' names and order (Auf u. Abtrieb 05 02 00-5, Zeigerfutter 05 02 01-2). Photographs: Wempe 3955's dial (`1_Wempe_3955_Z.jpg`, 9.14 px/mm by the minute track's Ø 90) and its dial side with the dial off (`3_Wempe_3955_uZ.jpg`, 8.41 px/mm by the plates' Ø 85). Every number is in `js/dial.js` beside the code, with its sheet and how sure.

- **Places.** The change wheel on the short stud at hole 19 and the up-and-down wheel on the long stud at hole 2 (train.js built both studs and their bushes); the sheet's centre distances 12.6 and 18.4 (hole 2 to the fusee's hole 10) are the tables' to 0.001.
- **Teeth.** The wheels' counts, modules, tips, roots and tooth thicknesses from their tables, the pencil corrections taken (the change wheel's tip 21.05 for the struck 21.30, its tooth 0.555; the hour wheel's tip 19.7 for the struck 20.0); cycloidal (train.js's forms). The pinions' counts are on no sheet and follow from the centres: the cannon pinion 14 (the tube's block on 05 05 03 scales Ø 5.86, a 14-leaf tip for m 0.36), the change pinion 18, the up-and-down pinion 12; 56/14 × 54/18 = 12. The change pinion's and the up-and-down pinion's tips and roots measured on Wempe 3955's dial side (6.9/5.4: a brass pinion cut like a wheel; 4.2/2.6: a steel pinion with narrow leaves, drawn 4.0/2.4, which is all the wheel's teeth leave); the cannon pinion's root as the centre pinion's sheet gives its. Every mesh is phased under load (gearLash); bom.py measures the centres to 0.0006 and the ratios exactly (−4, −3, −10).
- **Heights.** The dial on the movement ring's recess floor, 7 over the pillar plate's dial face (05 08 00-3 and 05 02_1). The cannon tube's foot on the centre arbor's journal "C" (05 05 03: its pinion block to 25.4 from the arbor's shoulder, its square to 14.3 over C, flush with the shank's end). The change wheel's and the up-and-down wheel's pipes stand on the stud bushes, flush with the plate's dial face: the change wheel's pipe 6.9 (7 −0.1) ends 0.1 under the dial, the wheel 1.0 over the plate on the cannon pinion's level and its pinion on the hour wheel's (05 02 02); the up-and-down pipe's 9.0 (05 02 04: 5.2 + 1 + 2.8) ends 0.05 over the long stud's end, as 05 08 02's 12.3 puts it, the wheel 0.8 under the dial (05 02_1's "0,8"), the hand's flange 0.3 over it (05 02_1's "0,2" over its 1.3 dial; the brass dial 1.2, below). The hour wheel over the cannon pinion, drawn in the middle of its 0.3 of play to the dial; the up-and-down pinion 3 long, 0.3 under the dial (05 02_1).
- **The hands' heights.** The seconds arbor's post ends 7.2 over its shoulder, 0.6 over the dial (05 05 01 of 1940's finished length; 05 05_01 puts its tip 0.5 beyond the dial; 05 05 01-2's 9.2 is the turned blank's to its centre: the second drawing check's 6-M3), and the seconds hand rides on it just over the dial, its underside 0.2 over it (0.1 over the 1.3 dial until 28 October 2026; kept where it stood when the dial came down to 1.2) and its boss's top 0.075 over the post's end, as the coloured section draws it (the blued hand about 0.1 off the dial, the post's end and the collet's about 1.0 over it). The hour and minute hands at 05 02_1's boxed heights (checked at acceptance: "Eingerahmte Maße werden bei der Abnahme besonders geprüft"): the hour hand's top 2,6 over the dial's face, pressed down its 1:70 seat so far, the seat's top standing up through it to 0.05 under the minute hand, as 05 02_1 hatches the hour pipe up to just under the minute hand's boss; the minute hand's underside 3,2 over the dial, down on the tube's square's shoulder (05 05 03's 10,8 over C: 3.215 over the dial's face), the tube standing 3.5 over it to its crown (05 02_1's "3,5"). The hour wheel's play is then 0.2: 0.15 down to the cannon pinion, 0.05 up to the minute hand. Until 28 October 2026 the hour hand's top was 3.55 over the dial and the minute hand 0.5 over it, 0.95 and 0.85 over 05 02_1's, the 1943 tube read as leaving them no room lower; but the hour hand's height is wherever its press on the taper stops (0.95 lower asks 0.0136 less on the diameter, inside H7/r6), and the shoulder is the boxed 3,2 (the second drawing check's 7-M5). Until 28 October 2026 too the post was built 9.2, 2.6 over the dial, the seconds hand at its end, 1.9 over the dial, the hour hand's blade 0.125 over the post's end.
- **Hands.** Each outline is a run of half-widths along the hand: the sheet's widths at its stations (the minute hand 1.2 at the boss, 2 at 13, 0.7 at 25, 1.7 at 36, 0.4 at 46; the hour hand 1.7, 2.4 at 9, 0.8 at 19.5, the ball Ø 5.2 at 22.5, 0.6 at 30, 0.5 at 35; the seconds hand 0.6 and 0.2, its drop 1.7 from 6.5 to 10; the up-and-down hand 0.9 at the boss and 0.25 at its tip) and between them as traced on the sheets' plans (the outermost of the outline's lines in each column, less its stroke), the thicknesses from the side views. Each blade's underside is flush with its flange's underside, as the side views draw them all: the hour hand's blade (0.5) 0.3 under its flange's top (0.8), the minute hand's (0.7) 0.5 under its (1.2). The minute hand's flange rounded r 0.4 on its top edge (its side view); the minute hand's square hole and the hour hand's round one on 1:70 ("Kegel 1:70"), as is the hour wheel's seat for it (05 02 03). Each hand pressed on as its sheets fit it, at the fits' middles: the minute hand's □ 2,6 H7 on the tube's straight 2,6 □ r6 (05 05 03), 0.011 tight on the flats at the hand's top, the press running 0.77 down where its hole widens; the hour hand's 4,4 H7 on its seat's 4,4 r6, 0.013 tight along its taper; the up-and-down hand's 2,2 H7 on 2,2 r6, 0.011; the seconds hand's collet on the post's 1:90 0.011 tight on the diameter (estimated: no sheet; the sheets' small H7/r6). Until 28 October 2026 each was drawn 0.01 clear on the radius (every seat at its nominal, every hole 0.02 over), and the collet 0.005: nothing held any hand (the second drawing check's 7-M1, 7-M12). Isolated beside their sheets they match: the minute hand's two lobes and waist, the hour hand's spade, the seconds hand's teardrop. The minute and hour hands Goldin (gold-coloured brass, polished), the seconds and up-and-down hands blued steel, as the title blocks and Wempe 3955's.
- **Dial.** Ø 103.6 −0.1 × 1.2 and its holes (centre 6.0, up-and-down 3.2, seconds 1.7) from 05 02 00-4. The 1.2 is the brass dial's: "Stärke 1,3" and the title block's "Messingblech 1,3" are both struck through with "1,2" written over them (faced from the blank's 1,3, "plan gespannt"); "Eisenblech 1,3 gebondert" is a separate revision in iron. The model's dial is brass, so 1.2 (until 28 October 2026 1.3, the iron revision's thickness in brass: the second drawing check's 7-M11); the bezel, bearing on it, is screwed 0.1 further down. Etched and filled black on white (Wempe 3955's: the sheet's "weiß lackiert" is struck through). Its five holes on Ø 101: three sunk Ø 1.8 × 1.0 for the screws at 354°, 120° and 240° (the sheet's 6° and scaled 120.6°, 240.2°; Altmeppen: German dials are screwed at the 20, 40 and 59 minute marks), the pin's Ø 1 at 6°, where the movement ring's sheet drills the dial's pin hole, and a Ø 1 at 185.7° (scaled), these two under the printing, which no photographed dial shows pierced (18 October 2026). Beside Wempe 3955's dial the layout matches mark for mark (`1_Wempe_3955_Z.jpg`). Lux and Petersen (*Klassik Uhren* 3/2006, p. 18) give the dial as "95 mm Durchmesser, aus 1,3 dickem Messing, mattversilbert": the 1,3 the blank's, as the sheet's struck figure, and the 95 perhaps the dial seen inside the bezel (not measured), not the sheet's Ø 103.6 (a secondary source: the sheet decides; 1 November 2026).
- **The dial's printing** (15 October 2026) is Wempe 3955's, as made, measured and traced on its photograph (`1_Wempe_3955_Z.jpg`) by `tools/dialtrace.py` (its docstring says how; about 7 s). The photograph is put on the dial in millimetres by one homography that makes its six printed circles circles (rms 12-17 µm), with the two sub-dials' centres on their arbors at (0, ±23): the scale is the arbors' 46 mm apart, so no printed size is assumed. The sheet's layout holds on it: the minute track's lines centred on Ø 85.44 and 89.94 (the sheet's 85 and 90, scaled 85.4 there), the sub-dials' circles Ø 26.08, 15.19/18.02, 37.08/33.06, 23.01 (the sheet's 26, 15/18, 37/33, 23). Where the sheet and the dial as made differ, the dial is drawn: its lines 0.27-0.40 wide (the sheet 0.3), the minute divisions 0.42 and hour blocks 1.68 (the sheet 0.3 and 1.5), the seconds divisions 0.39 and 0.67 at each five (the sheet 0.2 and 0.5), the seconds sub-dial's lines at 5, 15 … 55 s 0.61; the tracks' white boxes with rounded corners (r 0.17-0.19, measured along their diagonals less the photo's blur), the up-and-down band's open ends rounded r 0.2; the minute track centred 0.07 under the arbors' midpoint, and each division at its measured angle (0.06-0.08° off the nominal on the mean, sd 0.1°): the printing's own scatter. The serial is the photograph's 3955 (the sheet draws 2367); the sheet's "Made in Germany" along the track at 7-5 isn't on this dial and isn't drawn. Drawn as geometry in `dial.js` from those numbers: the tracks (a black band with white boxes cut in it), the circles, the band, the lines; traced (`js/dialface.js`): every numeral, figure and letter, the serial and the anchor, each glyph's contours with their holes, simplified to 0.03 mm. The hours are a condensed heavy grotesque, its 1 a plain bar except in 12; each sits where the dial has it: the 12 standing on the up-and-down sub-dial's circle, the 7 and the 5 running under the seconds track, whose white boxes are printed over them (drawn last). CHRONOMETERWERKE is in outline capitals of a geometric face, WEMPE and HAMBURG solid in the same face; the up-and-down and seconds figures are set radially, each where the dial has it (the 0 and the 56 set off their divisions toward the band's gap). Two glyphs are partly under hands in the photograph: the seconds hand runs through the 0 of 20, which is the 0 of 50 (the same series, at the same angle, fitted on what shows: 1.2 % of its visible pixels differ); the minute hand's shadow lies over the 8's top (5.2 mm² of it), completed by an ellipse through the upper loop's visible edge. Elsewhere the thin up-and-down and seconds hands are filled in from round them (the 56's 6). Cleaned: white flecks in the black where it has chipped (under 0.1 mm² in the hours and serial, 0.022 elsewhere) and specks under 0.02 mm² dropped. `dialtrace.py --compare` lays the page's own canvas on the rectified photograph (`r_dial_side.png`, `r_dial_diff.png`): mark for mark they agree to the line's edge, the hands and the dirt outside the track left over.
- **The Lange dial** (15 October 2026): the Variants' Dial shows the printing of A. Lange & Söhne's No. 5177 (Glashütte made the Einheits-Chronometer to the same drawings) in place of Wempe 3955's; the link keeps it (`#dial=lange`), the dial's card says which is shown. Measured and traced the same way on `1_Lange_5177_Z.jpg` (the same photographer's square-on view, 8.9 px/mm, sharper: blur sigma 0.024 mm) by `tools/dialtrace.py --dial lange` (about 12 s): its six circles made circles by one homography with the sub-dials on the arbors at (0, ±23), rms 14-20 µm. The layout is the sheet's and Wempe's to 0.1 mm (the minute track's lines centred on Ø 85.34 and 89.82, centred 0.068 under the arbors' midpoint as Wempe's 0.067; the sub-dials' circles Ø 26.06, 15.16/18.00, 37.01/32.99, 22.98), but Lange printed it finer and in its own style: every line 0.19-0.25 wide (Wempe's 0.27-0.40); the minute divisions 0.245 and hour blocks 1.437 (0.42 and 1.68); the seconds divisions 0.238, 0.420 each five (0.39, 0.67); the lines at 5, 15 … 55 s 0.417 (0.61); box corners r 0.13-0.17; the divisions at their measured angles (0.05° and 0.13° off the nominal on the mean, sd 0.1°). The up-and-down sub-dial differs most: its circle open at the top from 337.4° to 23.0° (square ends, as they show), Ab (down) over its left end and Auf (up) over its right; its band two thin lines, not a black band, the divisions 0.25, the end strokes at 0 and 56 h 0.21 wide and running on inward past the inner line to r 5.71; the figures 0 … 56 at the same places, the lower half's, as Wempe's, tops inward. The hours are a narrow face with serifs (the 1 with a flag and foot, the 4 closed), A. LANGE & SÖHNE in geometric capitals over GLASHÜTTE and B/DRESDEN in narrower ones, the serif figures of the sub-dials, the serial 5177; no anchor. Drawn on the model's white ground (#f2f0ea, Wempe 3955's): the photograph's cream is the lacquer yellowed with age, as its rust spots are wear; the spots are left out. The disc stays the Wempe's (05 02 00-4: Ø 103.55 × 1.2, the seconds hole Ø 1.7): the variant swaps only the printing. Lange's own dial sheet, 1453/A ("B-Chronometer Zifferblatt", 9.6.44, 2:1, Werkstoff Eisen: the rust on 5177's), draws its disc Ø 103, 1,5 thick, the seconds hole Ø 2,2 (1,5 struck), the centre Ø 6,0 (4,5 struck), the up-and-down Ø 3,2, both 23 from the centre (±0,05), and no screw holes; 5177's dial is screwed at about 354°, 120° and 240° on r about 49.8 (1_Lange_5177_Z.jpg, 8.8 px/mm by the arbors' 23 apart: ±1-2°, sure), the Wempe's three places, so the sheet leaves off holes drilled at assembly, as 05 08 00-3 leaves off the ring's tapped holes for them. Kept (27 October 2026, the drawings check's open item): a 1.5 disc in the drawn ring's 0.7 recess stands 0.3 higher than the Wempe's 1.2, level with the up-and-down hand's flange (0.3 over the 1.2 disc; 05 02_1's "0,2" over its 1.3) and 0.3 into the bezel's step, which bears on the dial (05 01 01); Lange's heights for its hands and bezel are on no sheet in the set, and the photograph, square on, can't show a thickness, so a Lange disc would take two estimates (the hand pressed 0.2 less far onto its seat, the bezel screwed 0.2 less far down) for a difference of 0.3 in thickness, 0.55 in diameter and 0.5 in a hole the seconds hand's boss covers. Until 27 October 2026 this README said 05 02 00-4 was one dial for both makers. `--compare` lays the page's canvas on the rectified photograph: line for line and glyph for glyph they agree to the edge, the hands, the rust and the boss left in the photograph only (389 mm² of its ink; 48 mm² in the canvas only, mostly the worn black of the 9 and the 4, solid in the canvas). The hands of 5177 are the model's forms (the minute hand's two swellings, the hour hand's pear spade, the seconds hand's teardrop counterpoise, the tapered up-and-down hand), its minute and hour hands tarnished to a dark brown; they are left as drawn.
- **Motion.** The cannon tube turns with the centre arbor (an hour a turn), the change wheel back at a quarter of it, the hour wheel on at a twelfth; the seconds hand with the seconds arbor. The page's clock is local time, so the hands show the time. The up-and-down pinion turns with the fusee, the wheel and hand back at a tenth: the hand at 0 (22.5° right of 12) at full wind and at 56 after 8.75 turns of the fusee (05 06_20: 3.75 turns in 24 hours; the model runs down after 8.70, at 55.9), 7/8 of a turn (Lange's "7/8 Teilung"); until the fusee is built the page stands it at 3.75 turns (24 hours).
- **Frame.** The movement ring's flange is tapped M1 through its 4.0 for the dial's three screws (not on its sheet; drilled at assembly, as its dial pin hole: frame.js; through, since they show on the flange's underside in Wempe 3955's `2_Wempe_3955_A.jpg`, likely), the screws' M1 × 2.3 engaging about 2.1 of it; until 28 October 2026 the holes were drawn plain Ø 1.04 under threaded screws (the second drawing check's 7-M3).

## How the case and box were measured (P1f)

The sheets: 05 01_1 (Gehäuse Kardan, 05 01, 1:1, 30.10.40, reissued 28.6.46 and 31.3.47, scanned at 2.45 px/mm by its 160 and the bowl's 106: its elevation, Schnitte A-B and C-D and its 15-line list), _2 (Gehäusetopf R-05 01 00-1, 6.3.42), _3 (Verschlußplatte 05 01 00-2, rev. a 14.4.48), _4 (Glasrand kompl. 05 01 01, 27.11.41, 4.78 px/mm by its title block), _5 (Glasrand R-05 01 01-2, 6.3.42), _7 to _9 (the key 51 00 11 of 16.7.43 and its body and tube); 51 00_1 (Boden-Chronometer, 1:2), _2 (the handle, Änderung von 51 00 10), _3 (Firmenschild), _4 (Zunge). Every number is in `js/case.js` beside the code, with its sheet and how sure. Photographs: Wempe 3955's Bakelite bowl and gimbal ring (`16_Wempe_3955_Gehäusetopf_Kardan.jpg`), Kirow 422's brass bowl (`11_Kirow_DEC_422_Gehäuse.jpg`), the boxes of Greenwich's wartime Wempe (`rmg_L5393_*`), Lange 1947 (`drouot_33810142_*`), Wempe 6161 and 5377 and the Kirow movements.

- **The bowl.** R-05 01 00-1 is the casting ("R-", Ms-Sandguß, Kokillenguß), the only bowl sheet in the set: every figure built (flange Ø 118 × 12, band Ø 108 to 23.5, body Ø 106, the 40° cone over its last 14.5 to the foot Ø 72.5, 65 overall; the bore Ø 98 × 53; the recess under the bottom Ø 64 × 5.5); the inner corner r 7, scaled (the drawn round fits r 6.95 over 95-173° where it meets both lines, r 6.2-6.3 over its middle only: the second drawing check's 10-M4, kept). Machined where it must be: the recess opened to Ø 68.2 for the closing plate, the winding hole Ø 8.2 through the bottom over hole 10 (22.65 from the centre: the closing plate's Ø 8 at 22.6 is that radius), the closing plate's shoulder screw's M3. 05 01's elevation draws the 1940 bowl with the same outline (106 measured, the cone a little shorter). Since 24 October 2026 the casting stands 4.7 higher on the movement than its top face did: the top 4.7 of the flange turned down to a fine thread outside (the bezel screws onto it: The bezel and glass, below), a rebate in it Ø 106.06 to the seat on which the movement ring's flange lies, flush with the rim's top, and a notch through the threaded rim at 12 o'clock, 1.8 wide, 3.9 deep, for the ring's radial pin, as the 6MX's bowls are made (Kirov-Poljot 24020's, `dg-chrono-6mx-gallery/leben-des-6mx/13_KirPol_24020_E-Kontakt3.jpg`: the thread and the notch through it; Kirov 14917's, rAw2zmulpk8 0:29, 2:52). So the inside bottom lies 48.3 under the seat as cast and is faced to 49: 05 06_01's "49 von Werkring-auflage" (sure), where the cork ring on the dust bush meets it (drawn 3.70, squeezed 0.16 from the section's 3.86). Until then the casting's top was the seat, the bottom 53 under it with a raised ring round the winding hole (estimated) to meet the cork. The bowl weighs 1,195 g in brass (the movement in it and the bezel, 2,516 g), its centre of gravity 14.0 under the pivots (16.0 before). The casting turned from its profile as one solid with the thread on it up to the notch's floor (`lathT()`), the rim above it less the notch another (`thread()`).
- **The movement in the bowl.** The movement ring's flange (Ø 105.95 × 4.7) lies on the seat in the bowl's rim (until 24 October 2026 the bowl's top face), its body (Ø 96 −0.3) in the bore (Ø 98); the bezel screws onto the rim round the flange, its step 5.0 up bearing on the dial (05 01 01's section; its casting's lower bore Ø 106 is the flange's figure). With the bezel there, its glass's underside is 15.3 over the pillar plate's dial face on the 1941 bezel (05 01 01's 12.3 from its underside), against 05 02_1's original 15.8: the two drawings of 1941 agree within 0.5. The ring's radial pin (WN-202, Stellstift 3 in the coloured section: Ø 1.6 at 2.8 from the dial's face at 12 o'clock, 05 08 00-3's plan drawing its hole as a dashed pair across the ring at 12 figured "1,6", its section the hole end on; Wempe 3955's dial side shows its end on the ring's cone at 12; until 15 October 2026 Ø 1.1 at 6 o'clock) stands 1.78 out of the flange (the coloured section reads 2.0, 2 px more; 2.0 until 24 October 2026) in the bowl's notch, its end inside the bezel's thread's crests, which pass over it as the bezel is screwed on: it turns the movement to the bowl and holds it while the bezel is tightened (05 01 01 draws no notch in the bezel; one was cut there until 21 October 2026).
- **The bezel and glass.** The ring finished as Glasrand kompl. (05 01 01) draws it in section, inside its casting R-05 01 01-2 (Ø 125 for 8.2, the 30° chamfer to Ø 116, 16 high, bores Ø 92 and Ø 106 × 4.5: every figure; the "R-" a casting's sheet, as the bowl's R-05 01 00-1). 05 01 01 has no figures: its section traced at the sheet's 4.78 px/mm (`tools/wempe_bezel_trace.py`, which prints the points and draws them over the sheet with the model's profile), its height 16.0, the casting's, and every line inside the casting: a sight cone from the casting's Ø 92 at the step (5.0 over its underside) opening to Ø 110.5 at the glass's seat 12.3 up; the lower bore Ø 109.8, 5.0 deep, threaded: the sheet marks a thread in it, its symbol a hidden zig-zag up the bore at its left end (x 202-215 px, 22 px from the underside to the step: 4.6 high at 4.78 px/mm; sure that it is a thread, likely its height). Since 24 October 2026 the thread is cut (until then the bore plain Ø 110.5, nothing on the bowl to take it): a fine right-hand thread, pitch 0.75 (Kirov-Poljot 24020's rim: 7.0 px a groove over its 50-51 px from the rim's top face to the collar, the 6MX's 5.55: 0.77), the ISO basic form (60°, 0.406 deep), its crests at the traced Ø 109.8 (r 54.9), its roots Ø 110.61, run out 0.5 at each end, on the bowl's rim's thread (crests Ø 110.55, the 6MX's rim measuring Ø 110.5; roots Ø 109.74), the two on one helix 0.03 apart radially all round, 0.015 along the flanks, which bear when the bezel is screwed down; the bezel screwed down until its step bears on the dial; outside, Ø 113.2 at the underside, the widest band Ø 121.2 from 7.5 to 9.8 up (05 01 scales the bezel about 120), knurled, then a bevel in to the glass's edge at the top. The glass (05 01 01-1) Ø 111.6 × 3.5 on the ring's seat, standing 2.4 proud of the lip, its top 15.8 over the bezel's underside as 05 01 01 draws it (3.56 thick on the sheet: likely): its underside 15.6 over the pillar plate's dial face, 1.25 over the hands. 05 02_1's "Glas 3" and 15,8 (17,0 in pencil) are another case's: that sheet's hand-setting pinion and going barrel and 51-00_1's dial with "Ruhe / Lauf" and no up-and-down are the lever chronometer's (its title block's So 127 556 04 heads the Einheits' own sheets too, so it can't decide it alone); 05 01 01 is the Einheits case's own bezel (the second drawing check's 7-M10, 10-M15: kept). Its step bears on the dial's rim: the dial 1.2 thick (05 02 00-4) in the movement ring's recess Ø 104 × 0.7 (05 08 00-3) stands 0.5 proud of the flange, so the bezel's underside is 0.2 over the bowl's shoulder outside the thread (0.3, the glass 0.1 higher, with the 1.3 dial until 28 October 2026) (until 21 October 2026 the step was relieved over the dial, estimated). Until 21 October 2026 the ring was drawn as its casting, flat-topped with the glass Ø 112 × 2.3 flush in it.
- **The closing plate.** 05 01 00-2, every figure. It is a shutter: it lies in the bowl's foot turning on its screw (7, WN-71) in the bottom, a knob (WN-72, brass on Wempe 3955) in its M2.6 to turn it; its Ø 8 comes over the winding hole. Wempe 3955's bowl, upside down, shows it: the plate in the foot, the boss Ø 28 with the screw, the hole and the brass knob. The Ø 1.2 at 12.4 is drilled blind from the groove's floor, its "3 +0,2" the depth to the drill point's foot (the figure runs from the groove floor's level to an extension line from the point's foot: 2.9 at 3.45 px/mm; the model's 2.99), its point just short of the boss's face, and a round r 1.3 joins the rim's underside to the boss (both drawn, not figured; until 15 October 2026 the hole through and the corner sharp). The knob and the Ø 1.2 lie 90° clockwise from the window seen on the inner face, which the plan shows (its circles the groove's and the bore's), as Wempe 3955's plate seen from below has them (mirrored in every version until 28 October 2026: the second drawing check's 10-M1, sure; the closing spring's hole in the bowl with them). The counterbore leaves the web 1.925, 2 −0.05/−0.1's middle (2.00 until then: 10-M2), and the plate turns on a shoulder screw (WN-71, a plain M3 until then, which left it 1.27 of play: 10-M3), its shoulder Ø 5.45 × 1.95 on the bowl's bottom, its head 0.025 over the counterbore's floor (no WN sheet: estimated).
- **The closing plate as photographed** (Variants, Closing plate: Slot and stop peg; `shut=book` in the link; 1 November 2026). *The Mariner's Chronometer*, Fig. 2.32 ("Dust cover", a page the user photographed, not kept; a Wempe, the user's word): a bowl turned over with its closing plate lifted off and laid inner face up. The plate rectified on its rim taken as Ø 68 (a homography from the rim's conic and its centre hole; its window came out at r 22.46 against the sheet's 22.6). Which face is up decides the angles: only with the inner face up does the slot on the peg let the window reach the winding hole. Every reading likely, ±0.5 mm and ±3°.
  - *The plate*: the sheet's but for its knob: no M2.6 or knob, a slot through it at r 24.9, 1.8 wide (its dark core 1.73), 42.5° long, from 53.4° to 96° clockwise of the window on the inner face, about where the sheet puts the M2.6 (90°, r 25); no Ø 1.2 at 12.4 to be seen; its groove from r 3.9 (estimated from the spring's coil at 4.2).
  - *The stop peg* in the bowl's foot rides the slot: on the bowl's floor 79.4° from the winding hole (their chord 30.4 through the plate's homography, the peg at the slot's radius; the bowl's centre the one of the two solutions inside its recess), Ø 1.6 (it reads about 2 across its blur), 2.0 into the bottom and standing 2.0 into the slot (estimated), domed. So the plate turns from 24° shut, the peg against the slot's near end, the other way from the sheet's plate, to 14.8° past open at its far end (±5°): the peg stops it shut, where the sheet's plate has nothing.
  - *Its spring*: a thin flat spiral, its line about 0.5 wide on the page (a Ø 1 wire would show about twice that, with a highlight), so a strip seen on edge. Its first coil hugs the hole at r 4.2-4.5 for about 250° from 103.5° clockwise of the window, then it bends out and spirals over the top, r 7.55 about 70° on, to its end at r 10.5, 158° clockwise of the window a turn on: 1.15 turns (the user's trace on the page, 1 November 2026, follows it round the hole). Built as a steel strip 0.3 × 1.0 (estimated: under the line's 0.5; 0.25 clear each side of the 1.5 groove), its ends turned into holes Ø 1.2, the inner up into the bowl's bottom, the outer down into the plate (both estimated: the photograph shows the plate only, the end's hole hidden under it). About 41 mm of strip (E 200 GPa): about 11 N·mm a radian, 4.6 N·mm opened 24°, 310 MPa.
  - The page shows it with any version but the 6MX (whose bowl is its own); the default stays the sheet's plate with its estimated wire spring (the owner's choice, 1 November 2026). The tools check the sheet's plate; with the button clicked (`--eval`), `audit.py box` finds nothing new and `bom.py` only the knob WN-72 missing, which this plate has not (1 November 2026). The grey bowl and brass bottom the photograph shows aren't built; the bowl carries both plates' spring holes, the other's empty under its plate.
- **The gimbals.** 05 01, measured on the scan's pixel profiles (line centres, 2.45 px/mm, 25 October 2026; scaled by eye before: 3.3 thick, 23.2 high, until then): the ring Ø 140 inside (circles fitted to Schnitt A-B: the lines' inner edge Ø 139.2, outer edge 146.8), 4.0 thick (A-B's radial profiles every 3°, the median line centres 9.6 px apart; the elevation 3.9, Schnitt C-D 4.1: likely ±0.2), thickened outward on its inside Ø 140, 24.0 high (the elevation 24.1, C-D 23.9: ±0.3), its top 6.7 over the bowl's (6.2 until 25 October 2026); both pivot axes in one plane at its mid height, 12.0 under its top (the elevation's line centres 12.0/11.8 at 9 o'clock, 12.2/11.9 at 3; 11.5 until 25 October 2026, the "11,5" read as the ring's: Readings corrected) and 5.3 under the seat where the movement ring's flange lies (the bowl's top face until 24 October 2026, when the bowl's rim was cut round the flange: The bowl, above; the elevation 4.6 over axis A, Schnitt C-D 4.75 over axis b, scaled on the "11,5", ±0.5, for the 1940 bowl it draws; 5.3 for the cast bowl of 1942, 65 high, whose foot's edge (Ø 72.5) clears the ring's Ø 140 turning to be wound only with the pivots over 5.11 under its top: estimated; the glass's top 15.8 over the seat, the bezel's 16: so the bowl, the movement in it, the bezel and the glass hang 6.2 lower in the gimbals and the box than until 21 October 2026, when the ring's top was taken level with the bowl's), the outer on the 3-9 line (A-B), the inner on 12-6. The outer pivots are M6 screws through the box's sides 93.5 over its bottom (51 00 10's M6, 11.5 under the line 105 over the bottom, the lid's parting line, and 05 01's "11,5" the same: the ring's top 0.5 over it), so the two drawings agree. The case brackets (05 01 00-3) at 12 and 6, the ring bracket (05 01 00-6) at 3 o'clock, the locking bracket (05 01 00-4) at 50° from 6 toward 3 ("50°"), the transit lock's knob and lever in the front right corner (A-B): their places and sizes scaled, their forms from the sheet's views and Kirow 422's bowl. Re-measured on 05 01 on 25 October 2026 (line centres on pixel profiles, ±0.4 a reading: likely; `case.js` has every number): the ring bracket 3.3 thick, 15.4 high at the ring with its outer edges bevelled 2 × 2 (16.7 and square before); the case brackets cranked as Schnitt C-D draws them, a foot on the bowl 20.3 to 8.3 under the pivots (its inside stepped to the 1942 casting's band and body, r 54 and 53), its outside leaning out to a boss whose face, 5.8 inside the ring (r 64.3), stands to 4.8 over the pivots, the boss 4.0 deep and 9.0 wide (the elevation; A-B draws 12.0: Readings corrected), its screws (WN-78, heads Ø 7.0, so M4) 15.0 either side and 14.3 under (a plate 18.7-27.7 under and a block 9 wide to r 66.5 before); the inner pivot screws (WN-79) head Ø 9.2 × 2.8, M5, ending 0.1 off the boss, a plain tip Ø 3.0 × 4.6 through its hole, the knurled lock nuts (WN-400) Ø 22 × 2.4 against the ring's inside (M4, head Ø 7 and nuts Ø 19 × 2.5, from Wempe 3955's Bakelite case, before); the outer pivots (WN-80) M6 from the wall to the ring at 9 o'clock and to the bracket at 3, then a tip Ø 3.1 through the ring to its inside at 9 and through the bracket 1.7 into the ring at 3, heads Ø 12 (11.8-12.2), the bearing discs Ø 22.7 × 1.9 (a plain M6 to the ring's inside, heads Ø 12.5 and discs Ø 23 × 2.4, before). The holes for the pivots' tips, the inner pivot screws and the ring bracket's screws are cut along the radius through the ring, its bracket and the case brackets (`sweepS` in `case.js`: until then the case's holes across turned parts weren't cut).
- **The locking bracket and the transit lock** (Feststellkloben 05 01 00-4 and Feststeller 05 01 01, no sheets of their own; re-measured 24 October 2026). How they lock, from 05 01's section and the 6MX's book (Romanov 1975, p. 204, with its Fig. 95): the lever on its bracket on the box's wall, turned in clockwise, "passes through the slot of the outer ring" and stops "against the wall of bracket 6" on the bowl, the knob's screw clamping it. Schnitt A-B is cut at the pivots: its ring's band is left unhatched between radial lines at 20.6° and 52.4° from 6 o'clock toward 3 (±1°), the slot (Wempe 6161's ring shows it beside the knob, `antiquorum_208-4_wempe6161.jpg`, a little higher in its band: a later case or the band's foreshortened edges, likely); and the bracket, resampled along its radius about the ring's fitted centre (274.3, 491.0 px, 2.46 px/mm), is 15.7 wide, its upright's faces at r 59.0 and 63.2, its foot's at 55.1, cut only over its 3 o'clock 6.1 at r 59-63.2: a neck, the rest of the width open, a slot across the upright, open toward 6 o'clock. The elevation (heights from the pivots' line; the bracket seen 50° round, its outer faces 0.64 of their 15.7, its sides 0.77 of their depth): the foot's face 16.5 to 25.8 under the pivots, its screw at 20.5, its side 4.2 deep; the crank's face leaning out at 46°, from r 55.1 at 16.5 under to 63.0 at 8.7 under (drawn as steps until 24 October 2026); the upright to 2.6 under, the neck 2.6 under to 1.4 over (the slot 4.2 high), the head 1.6 to 5.9 over. Built on the model's bowl (likely, each reading ±0.4, a pixel): the upright and head r 59.6-63.2 (0.6 off the 1942 casting's flange, Ø 118 to 2.0 under the pivots, which 05 01's 1940 bowl doesn't draw), the foot r 53-57.2, the back's step under the band (Ø 108, to 13.5 under) estimated, the sides parallel and the bracket centred on its 50° line. Until 24 October 2026 it carried a pad 2.5 short of the ring, which the lever pressed the ring onto from over the ring's top: the box at the head's right on the elevation is the bowl's flange behind it. The lever is so at the pivots' height, 1.7 under to 0.8 over them in the bracket's slot (Wempe 3044 from straight above shows its lever's end running in under the ring's band; Wempe 5377 and Greenwich's wartime Wempe, which draw it in front of the band, show nothing of its height: turned off it lies outside the ring, 79 from the centre), its end's centre 27.0 from the knob's axis where 05 01 scales 28.3 (at 28.3 it would swing 0.8 into the 1942 bowl's flange: shortened to clear it by 0.5, estimated; `tools/wempe_lock.py`); the ring's slot 0.5 over and under it (estimated). Turned 69.95° its end meets the neck (worked on the outlines); its sweep crosses the band from 27.5° to 50.7° (27.8° on the ring's 3.3 before 25 October 2026), inside the sheet's slot; the lever's pin, at 0.52 of its length from the knob's axis (0.55 until 25 October 2026, which would stand 0.33 in the ring's 4.0), clears the ring's outside by 0.48 over the turn (`wempe_lock.py sweep`). The page turns it in (Display, Motion: Transit lock) once the gimbals are level, and out before they are let go or the bowl is turned over to wind. Kirow 422's bowl (`11_Kirow_DEC_422_Gehäuse.jpg`, upside down) shows the same kind of bracket: an L screwed to the body, cranked out to a pad at the case pivot's height (its pivot hole), though with two screws in a column where 05 01 draws one (another maker's: the sheet's one is built).
- **The box.** 185 × 185 × 180 outside (05 01's note), walls 12.5 (51 00 10's section), 160 inside (05 01's 160), the handles every figure of 51 00 10, 75 over the bottom (their ends 6 off the side and the middle's outside 12.5, the section's "6" and "12,5", the strip 3; the bends S-curves traced on the bottom view: 27 October 2026, until then the ends 3, the middle 10 and straight kinks), each over a finger recess in its side wall (25 October 2026: the sheet's oval 70 × 30, dashed behind the strap and solid below it, is the section's unhatched hollow in the hatched 12.5 panel, not a pressing of the strap as it was drawn until then): 10 deep at its middle, the section's figure "10" (scaled 10.5; built so until 27 October 2026), leaving 2.5 of wood, rounded top and bottom about as deep as it is (2.5 over its foot it is 6.8 from the face), its middle 8.5 under the strap's (measured on the scan at 2.38 px/mm: the section 8.7, the front view 8.1), built as a cutter of radius 10 following the oval, its cove in 40 rings of quads (10 rings until 27 October 2026, terraced); and the outer pivot's M6 through each wall (51 00 10's pencil "Verbohren 4,8 mm, Gew. M 6"). The lid 75 high (180 less the 105 to the line across 51 00 10's side). The height kept at 05 01's 180, where 51 00 10 draws the side panel 185 high (below, Unresolved, the case). Over each outer pivot a small round-headed pin stands out of the side wall's parting face, as 05 01's elevation draws it (measured on its pixel profiles, 2.45 px/mm: Ø 2.5, 2.3 proud, 3.3 into the wall, on the wall's middle line; likely), the closed lid bored Ø 2.7 × 2.6 for it: its purpose inferred (Estimated). The maker's plate every figure and its lettering (00 01 01-9), "Type 3371". The tongue every figure (P. 51 00 02-2), its hole's 0.5 × 45° sink and its last 7 thinned 0.2 on the section's upper face (built 27 October 2026).
- **The outer box** (Überkasten 127-556.01, renumbered 52 00 16, 28.2.42, 1:2; 15 October 2026), built so the Boden-Chronometer arrangement (127-556. A-1, 4.3.42) can be seen as drawn (127-556. A-1 is the Boden-Chronometer's arrangement, a lever chronometer: its small seconds at 6, no up-and-down dial, a Buna case, a hand setting and a holding device; the key holder's place and the outer box are borrowed from it: the second drawing check's 10-M13): the wooden box shut in it, its lid open (the Transport box view; the other views leave it out, as the box is lifted out to be used). Bleached birch, dovetailed and glued. Its figures: the body 157 high with the base plate, the lid 88 (88 + 157 against a pencil 240); 225 inside across at the rim (Schnitt A-B), the walls and base plate 12.5 (likely), the plate 270 across and 10 past the walls; in plan 370 over the plate's ends, the body 270 long outside (370 less the plan's 50 each end; it scales 271), so 245 inside. The scan's scale is 1.195 px/mm by the 370, and its 225 and 270 measure to it. The plate's ends are traced on the plan (the outline every 6 px): arcs of R 367 about the long axis (sagitta 24 over the 270, the intermediate points within a pixel), the corners r 8 (scaled). The rim strip (17, 18) 13 × 5, 4 over the walls (likely). The cushions are lenses 20 thick at their middle (the sides' and the lid's "20", sure; the ends' 23 and the floor's 21 scaled, built 20), and the figures then hold the wooden box exactly: 225 = 20 + 185 + 20 across, 245 = 20 + 10 + 185 + 10 + 20 along (its handles against the end cushions, as 51 00_1's plan lays it), 220 = 20 + 180 + 20 high inside. A-1's section scales the wooden box standing about 49 above the body's rim; built, 55.5 (180 + 20 − 144.5). The hinges (7) 32 long, 68-100 off the middle, 2.5 proud; the strap screws 80 apart, the lower 60 over the floor; the eyes 25 out from the end walls. Checked: `solids.py --model wempe` (closed), `audit.py box --model wempe` with the Transport box view (nothing new); isolated beside A-1's section and plan.
- **The key.** The 1943 key (51 00 11), the later of the two: its body (05 01 02-2) and tube (05 01 02-3) every figure, the tube's square socket cut (3.1 +0.05, 19 deep, its corners as the fusee arbor's square has them), its mouth sunk 60° 1.1 deep to the square's flats (05 01 02-3's "60°", "1 +0,2": 27 October 2026); its handle a flat round paddle Ø 34.5 × 3 in the body's slot, scaled, its rim on the slot's floor (05 01 02-2: the Ø 35 arc, 6.3 under the top where it meets the body's outside, so 7.40 at the bore's edge, where the paddle rests: its centre 9.37 over the body, as 51 00 11 scales it; 10.95 until 17 October 2026, the 6.3 taken at the axis); the grooved pin across the slot through the paddle's thickness, 4 under the body's top (05 01 02-2's cross hole, which shows end-on where the paddle shows its face), Ø 2.5 × 15.3, its rounded ends 0.4 proud of the body (51 00 11's section); the tube's head 8.0 under the body's top, just under the paddle (51 00 11's section; 6.8 until 17 October 2026); the coil spring as 51 00 11's section draws it, about 12 open coils of wire about 0.6 at a pitch of 0.95, wound on the tube from its head down to the bore's floor, its end turned down into the body's Ø 0.9 hole and along it to the bottom face (until 17 October 2026 a 0.9 wire standing clear of the tube, its end not drawn), which grips the tube one way ("Linksaufzug b. Rechtsdrehung entspannt sich die Feder": followed up from its end its coils turn clockwise seen from the paddle, so the body, turned counterclockwise seen from the paddle to wind, drags the end the way that adds turns and closes them on the tube; inferred). A 1943 key taken apart (*The Mariner's Chronometer*, Fig. 2.35, a photograph of a page the user sent, 17 October 2026, not kept) shows the same pieces: the flat round handle, its lower part where the slot covered it unpolished with the pin's hole through it, the grooved pin, the spring wound on the tube under its head over about a fifth of its length (about 12 coils at about 0.8-0.95), and the body's hole for the spring's end beside its bore in its bottom face. The body is cut as 05 01 02-2 draws it (17 October 2026; until then a plain turned body, the paddle, pin and spring's end in its metal): the slot 3 H11 down to its Ø 35 floor, the cross hole Ø 2.5 +0.05 through both jaws, the spring's Ø 0.9 hole 3.8 out in the bottom face and 5° in toward the axis up to the bore's drill point, the paddle holed for the pin. The cell builder cuts upright holes in flat faces only, so the body is four solids joined into one closed surface: the bottom ring with the slanted hole, the drill point and the walls to the jaws' foot, and the two jaws built along the pin's axis, where the cross hole is upright and the slot's walls and floor are faces; it also shows a hole through the handle's middle, which 51 00 11 doesn't draw (not drawn), and a body of bare brass where 05 01 02-2 has it sprayed black (kept black, as the sheet). It lies in the box; while the Wind button winds with the movement out of its case (the movement's views), it is on the fusee's square, its tube's mouth on the dust plate (where the square is 3.1 across), turning with the fusee, and back in the box when it lets go (as the Hamilton's key goes on its square). In the case (the Dial, Box and Case views) it is wound as the 6MX's user instruction has it (pp. 3-4: "turned slowly and carefully onto its side (in the gimbals), the key hole in the case opened, the key put in" and turned, then taken out and the chronometer turned back) and two videos of 6MXs show it (`References/wempe/VIDEOS.md`: DIxob2Rl4dc 7:05-7:22, the bowl turned about its 12-6 pivots, the dial toward 3 o'clock, until its bottom faces up, the key put in from above; Uy8A88_j-cA 5:16-5:26): the lid opens, the bowl turns over in the ring about its inner pivots, the closing plate opens, the key comes down onto the square, and when it is wound all goes back. The bowl clears the ring and box all the way over (fine-interference.js over the box's root at 0°, 45°, 90°, 135° and 180°, and with the key on the square through the open plate: nothing new between the case's parts). Checked on the square through `fine.py --model wempe --eval` (the key put on the square, turning with the fusee through every state): nothing new.
- **Checked.** The case with the movement in it, open and shut, through `fine-interference.js` run over the box's root: nothing of the case meets the movement; the overlaps are the radial screws and pivots in holes not cut, the hinges' leaves on their knuckles and the latch's screw in the lid.

## Physics (phase 2a)

The escapement runs as the Hamilton's: `makeEsc` (`../shared/escapement.js`) solves it from its parts' shapes and bodies, and the page steps the balance's swing by its averaged equation of motion (`js/escphys.js`, `app.js`'s tick). `tools/wempe_escapement.js` prints every number below and checks them (about 20 s).

- **The settings** (`WESC.SET`, js/escapement.js) are the layout's own numbers put in makeEsc's frame: makeEsc sees the escapement as the sheets draw it, from above (the wheel turning clockwise), this file's plan from the dial, so each plan point is mirrored about the line of centres (`MK`). The wheel's 15 teeth, Ø 14, 10.00 from the balance; the lock 37.0° on, 0.235 deep (36.5° and 0.175 until 19 October 2026: The physics pass), the stone Ø 0.75 half round, its flat on the wheel's radius (it draws −3.7° against the detent's line); the detent's flexure at its spring's middle, 12.83 from the locked tip (12.87 before); the gold spring's square end 1.54 from the staff, free 11.25 from its bending point (11.18); the discharge stone's acting corner, its bevelled end (0.3 back over its 0.4) and its place at rest; the impulse stone's face on its radius to 3.35, 28°10' before the line of centres at rest; the tooth (05 04_23: the 1.5° land, the back the Ø 6 cutter's arc to Ø 12.1 15° behind the tip, makeEsc's root circle, the face leaning 25°, 4.27° behind the tip there; until 15 October 2026 the face's root 2.43° behind the tip on Ø 12.1 and the back to 11.9°). makeEsc's lift is the gold spring's tip's travel; the drawing's (`WESC.ESC.state`) is the detent's turn: `toKin` divides by the tip's distance from the flexure, and the tool checks that the stone, the locked tip and the stone carried by the detent's turn agree in both frames (to 1e-15 of the wheel's radius). makeEsc took three settings for it (15 October 2026), each 0 or as before by default, so the Hamilton's results are bit for bit what they were (`tools/escgolden.js`, and tools/escapement.js, physics.js, keystone.js, tolerances.js, dynamics.js --quick and tripping.js --quick print the same): `BEV`, the discharge jewel's end bevelled back from its acting corner; `TSQ`, the passing spring's tip the square end of its strip, not a disc (a disc's round end reaches 0.075 nearer the staff, and carried the detent 17° too long); `TH1`, the contact tables carried past the Wempe's impulse, which ends 45° past rest (the Hamilton's at 21°). Its swing solver now starts from the least swing that sees an impulse through, and the stone rides an escaping tooth whenever the jewel lets the detent down onto it (both reached only by the Wempe). Checked in time (phase 2d, below), makeEsc took two more for it, each 0 for the Hamilton: `DEP`, the detent's work counted only as far as it rides the stone (flung off the stone's square corner, it never rides its bevel back down), and `RW`, the wheel's chase run with the stone riding the tooth it has let go; and `depart` takes the detent's speed off a square-ended spring as the slope it came up (`TSQ`).
- **The balance**, weighed on the model's solids (`tools/wempe_inertia.py`, about 30 s; `wempe_inertia.json`): 2,561 g·mm² about the staff (the rim, arm and staff 2,545, of it the four masses 1,523, the rim 750, the timing weights 200; the rollers 2.4, the collet 5.8, a third of the spring's 22.6, weighed drawn at rest: phase 2c), 12.7 g with its rollers and collet (since 15 October 2026's shape batch: the hollow arm, the screws flush in the masses, the timing weights Ø 3.8 × 3.3 with their heads inside the rim, and `wempe-inertia.js` weighing the shown revision only, where it had counted both revisions' rollers, staff and hub; 2,501 before, and 2,269 g·mm² and 11.7 g until the masses' height was read: How the balance and escapement were measured). Densities: brass 8.45, steel 7.85, the rim's nickel steel 8.1, beryllium copper 8.25, the gold spring 11.6 (333-333: likely). The 1963 Soviet book puts marine chronometers' balances at 0.2-0.3 gf·mm·s², 1,961-2,942 g·mm²: inside. The escape arbor 8.7 g·mm² and the seconds arbor and hand reflected (÷ 8²) 1.25: JW 9.96 (12.4 until the tool weighed one revision: the arbor's two collets counted); the detent's moving part about its flexure 8.49 (ID, since 19 October 2026's gold spring at 11.6 and the stone at 7.14; 8.35 before them, 8.46 before the gold spring's bow; 8.60 with both revisions' pieces, 8.25 with the horn 3.5 long).
- **The hairspring and the period.** The strip 0.285 thick (the coil bends it radially) and 0.52 high, steel hardened and tempered blue (05 03_6): k = E b h³ / 12 L, E 206 GPa (200-210), L its working length pin to pin, 505.4 mm (phase 2c: the whole strip 13 turns less 3.5 mm, below): 409 µN·m a radian (397-417). With the weighed balance that is a period of **0.494 s, 1.2 % short of the train's 0.5 s** (its seconds arbor turns once in 120 teeth; 0.497 s until 18 October 2026, with a nut on each mass); 0.5 s wants a balance of 2,589 g·mm², 2.5 % more (below, Physics: hairspring and temperature; 0.491 s with 2,501 g·mm² until 15 October 2026's shape batch, 0.468 s, 6.4 % short, until the masses' height was read: it was most of the gap). Phase 2a read the length as 12.911 turns of helix with the curves added, 549.1 mm, 0.488 s. makeEsc runs the balance at 0.5 s (its stiffness I (2π/0.5)²): the timing a maker sets.
- **The drive.** 05 06_20's force (g on a lever 262 mm long, running down, the mean of two measurements, scaled off its curve at 24 places, ±0.7 g) is on the fusee arbor: the sheet's own sum, 131.5 g × 262 / 19.6 = 1.758 kg at the fusee wheel's pitch circle, takes no fusee radius, and so even a pull (126.5-138.4 g) over the barrel's five turns is what a fusee gives its arbor. The mainspring's torque it implies (the pull on the chain at the fusee's radius and pitch line, times the barrel's) rises 1.9:1 to 749 mN·m fully wound, 2.2 GPa in the 15 × 0.37 strip, a tempered steel mainspring's: so the reading holds. Measured running down, the spring's, chain's and fusee's losses are in it. The fusee arbor's 325-356 mN·m reach the escape wheel through the train, 90/14 · 90/12 · 80/10 · 80/10 = 3,085.7:1, at its efficiency: each stage from its parts as the Hamilton's (physics.js A6: the pivots' friction on the tooth loads, mu 0.10-0.15, and the mesh's, mu 0.10-0.20), the meshes worked tooth by tooth (gearing.js), 0.730-0.833 for the four, the model taking their geometric mean, 0.780 (0.749 from the meshes' rule of thumb, 0.661-0.848, until 19 October 2026: The physics pass). The escape wheel's torque is 82.1-89.8 µN·m over the wind, 86.1 at 12 h from full wind, the reference (`TQ`; 78.9-86.3 and 82.8 before).
- **The damping** (no Wempe source gives it): each loss from the parts, as the Hamilton's (physics.js A6), at the swing: air on the masses (Ø 6.3 × 6.46 across the rim), the timing weights, the screws' heads and nuts, the arm edgewise and the rim's cut ends, a pressure drag at Cd 0.8-1.4 (Re about 300 on the masses), Q 1,060-1,855; the endstone's constant friction, the Hamilton's measured effective mu (0.008-0.012) under this balance's weight on its Ø 0.21 pivot, Q 10,580-15,870 (the 6MX has a diamond endstone for "the heavy balance", 6MX-figures.md); the spring's own, Q 1,000-5,000. Together Q 510-1,317 (at 197°), a free run-down TF 81-210 s. The model takes **TF 111 s** (Q 697; 108 s, Q 679, until 19 October 2026's physics pass, which lowered the swing the video's fit is taken at), where a running 6MX on video, fitted with this escapement's work at the model's own swing, gives it back (below; 15 October 2026, the user's choice: until then the parts' middle, TF 125 s, Q 785, which the video's fit then left outside its range once the shape batch moved the escapement's work and the balance's weight). That swings the balance **194.3° at 12 h** (197.2° until 19 October 2026's physics pass: the lock 0.235, the train's 0.780, the preload 0.8 g; 199.4° before 16 October 2026's reading of 05 04_1's angles and the discharge stone's place; 207.3° with TF 125 s; 214.0° until the masses' height made the balance 10 % heavier; 219° until phase 2d took up the detent's flight off the stone and the stone's ride on the escaping tooth), 176-252° over the parts' range. The sources' band, 225-270° (the 1954 instruction for chronometers in general; the Hamilton manual's 1⅜-1½ turns), wants TF about 165 s for 225° (153 s, and 200 s for 247.5°, before the physics pass): inside the damping's range, so the balance as built can swing the band on the drive as measured, and the model, as the video gives it, falls 12 % under it. A running 6MX's top plate is filmed (References/wempe/VIDEOS.md: moMvyx8eXfo 17:53-19:52, gAczA7-a7TY 4:47-5:52); `tools/swing.py` reads a swing off such a video from the balance's screws passing the plate's cutouts and could be pointed at them with the Wempe's masses and weights in place of the Hamilton's screws (not run): that would settle TF. **A running 6MX on video bears it out** (References/wempe/VIDEOS.md, "Measured", 15 October 2026): its balance, seen whole from above at 30 frames a second (moMvyx8eXfo 17:53-19:50), read frame by frame by its arm (`tools/wempe_swing.py`), relaxes after the movement is set down (110° rising to 137°) and after a twist (185° falling to 157°); fitted with this escapement's work and the damping split as above (`tools/wempe_startup.js`), **TF 111 s** at the model's swing, 102-125 s over the stretches' relative scale (the work held flat, 80 s), and the model is set to it (108 s, 96-121, at 199.4° until the physics pass) (TF 114 s at 207°, 99-129, before the shape batch: the model's 125 s then inside it); the measurement narrows the parts' 81-209 s to about 102-125 s. Since then the escapement's reconciliation (26 October 2026: TF 133 s, 118-149) and the detent's blade (27 October: 141 s, 133-158, drive 0.55, rms 0.67°) have moved the fit, and the model keeps 111 s outside it (the owner's choice, 27 October 2026), which `wempe_escapement.js` reports; the fit read 332 s on the blade's day until `wempe_startup.js` stopped counting a swing where makeEsc gives no impulse (a weak drive, the jewel gone before the tooth) as a free run-down: the fit had taken the drive to 0.45 and let the stretch after the twist coast down without an impulse. It is a 6MX's balance, the same kind (a cut bimetallic rim, four masses, two timing nuts on the arm) but not the Wempe's drawing; out of its bowl, dial down, part wound (it settles at 149° on 53 % of the model's drive), so its swing says nothing of the Wempe's at 12 h. `wempe_escapement.js` checks the model's TF against it (`wempe_startup.json`).
- **The swing and the rate across the wind**: 199.5° and +0.20 s a day fully wound, 191.3° and −0.13 at 24 h, 193.5° and −0.04 near run-down (54 h); 188.5-199.5° and −0.26 to +0.20 s a day over the whole 56 h, against the reference at 12 h (since 19 October 2026's physics pass; 191.9-202.0° and −0.15 to +0.12 since 16 October 2026's reading of 05 04_1's angles; 194.1-204.2° and −0.06 to +0.03 before it, since 15 October 2026's shape batch and TF 108 s; 201.5-212.1° and −0.08 to +0.08 before it, 208.0-219.0° and −0.12 to +0.13 before the masses' height, 212.7-223.6° and −0.16 to +0.17 before phase 2d). That is the escapement's isochronism with the drawn hairspring's (phase 2c: it loses 0.46 s a day for each 10° the swing grows, `WESC.SET.HS`; 0.48-0.49 before the physics pass), which partly cancel. Wound daily, as the 6MX's instruction asks, the rate changes 0.33 s a day between full wind and 24 h (0.19 before the physics pass). The tools' band for the model, the sources' 225-270° less the damping's estimate, is 180-270° (wempe_escapement.js, gearing.js, wempe_tolerances.js, the page's swing panel: its floor 14° under the reference's swing, 194.3°, since 19 October 2026's physics pass; 185°, 14° under 199.4°, until 16 October 2026 and 12° under 197.2° until the pass, as 193° was under 207° and 200° under 214° before).
- **The escapement's figures** since 19 October 2026's physics pass (the lock 0.235): the gold spring met at −10.3° of the balance, the wheel released at +2.6° (lock 12.9°), the detent off the stone at +4.1° (let-off 1.5°), the return swing past the gold spring at −18.8° (overall 22.9°); roller shake 0.011, the stone's lift at release 0.257; the wheel chases the stone 10.3° of the balance and strikes it at 34.8 rad/s, the strike losing 10.4 % of the impulse, the unlocking 26.1 % of its work; the stone falls back onto the tooth it let go at 5.2° and is on its banking at 13.6°, 0.9° after the strike (dynamics.js 13.5°). Before it (makeEsc's measure(); from 16 October 2026's reading of 05 04_1's angles: the impulse face 28°10' before the line of centres at rest, the discharge stone 5° later on the staff, Closed): the gold spring met at −7.3° of the balance, the wheel released at +2.6° (lock 9.9°), the detent off the stone at +4.5° (let-off 1.9°), the return swing past the gold spring at −12.6° (overall 17.1°); roller shake 0.046 mm, the teeth 0.39 into the roller, the stone's lift at release 0.196 mm. The impulse stone comes into the teeth's path at +6.1°, 3.8° after the release (the sheet's impulse begins at 22°10', 6° after rest). Released from rest, the wheel, with the seconds arbor behind it, gathers speed slowly on 83 µN·m, chases the stone 12.3° of the balance and strikes it at 14.9°, its face 13.3° before the line of centres, where the layout's tooth falls on it at once, 22°10' before; the impulse ends 21.8° past the line (the layout's 21.2°), the wheel driven 16.1° of its 24°, the strike losing 14.9 % of the impulse; the unlocking takes 16.2 % of its work. The least swing that works is 50.0° (the layout's 53.4°). The detent leaves the discharge stone's acting corner at +3.2°, flung up off it, falls back onto the tooth it has just let go at 5.6° and rides it down its back onto its banking at 13.1° (dynamics.js 13.8°), long before the next lock. Until 16 October 2026 (the face at 24°, the discharge stone leaving the gold spring at rest): met −12.3°, released −2.4°, off −0.5°, the stone in the path 4.6° after the release, the strike 16.1° later at 10.3° before the line losing 20 %, the least swing 45.8°. The page draws makeEsc's solved motion (`WESC.ESC.state`). The locking stone is never inside a tooth (stoneClash, as the Hamilton's: 0.03 µm at most over 11 swings from 50.0° to 340°).
- **Stopping and starting.** Run down (the fusee at the end of its chain), the train runs on what the maintaining spring keeps, the ratchet held by its detent as while the key turns, the swing falling as the spring opens (from 193°, the train stops after about 12 minutes; until 18 October 2026 at once, the spring left closed); a set of the wind to run down (the slider, the link) leaves the spring spent. Stopped, the train stands at a locked beat and the balance swings down (makeEsc's freeStep: the gold spring and the detent still take their work): from 201° it falls under the 45.8° it needs in about 100 s and is at rest in about 11 minutes. Wound before then, the train goes on at once; once it has stopped it needs a twist (the Twist button: about 130°, the 6MX's "light jerk ... by turning the chronometer gently about the hands' axis", estimated), as a detent escapement doesn't start itself (the 1954 instruction, п. 7). While the key turns the maintaining spring drives the train with what it keeps (Physics: energy, The maintaining spring): closed by the running drive until its ends nearly meet, it pushes 89 % of the drive at once (the detent half a tooth late), falling as the fusee wheel runs it out; the balance keeps going 10.7-13.9 minutes, its swing under 185° after 31 s to 2.5 min (the 1954 instruction gives 1-2 minutes for chronometers in general; until 16 October 2026 70 s, from 05 06_9's "x = 0,27 mm" read as its deflection); a wind takes about 6 s, so the swing hardly moves. Wound from run down, it carried nothing and the train stays stopped until twisted. Model time runs no faster than real while the key turns.

## Physics: hairspring and temperature (phase 2c)

`tools/wempe_hairspring.js` (about 20 s) and `tools/wempe_thermal.js` (under a second) print every number below and check them; `ci.py` runs both.

- **Which sheets are the Feder-Chronometer's spring.** 05 03_5 (Spiralfeder kompl.) and 05 03_7 (Spiralkurve) carry the lever chronometer's numbers (127-556.04, 04-series), 05 03_6 (Spiralfaden) both the lever's Sach-Nr. and the detent caliber's 020310. But the spring they draw is this one's: 05 03_5's collet and stud are 05 03 02-2 and -3 (the tapered slit bar; the pointed stud with its hole 5 from the end), and the lever's balance on 05 03_1 is this balance, measured on the sheet (crops at 2-4×): the rim scales 33.4 against its masses' boxed Ø 6.35 (the detent's 32.32 against 6.3, within 3 %), cut at 3 and 9, the four masses 30° from the cuts' line at r 16.2, the timing screws at 12 and 6. So the spring, its curve and its length are shared (likely).
- **The length.** 05 03_7: "vorm biegen der Kurve auf 13 Umgänge −3,5 mm kürzen", before bending the curve shorten to 13 turns less 3.5 mm. Read as the words read, the whole strip is cut to 13 turns of the coil as wound (Ø 12.515 at its middle) less 3.5 mm, 507.6 mm, and both curves are bent from its ends: **11.80 turns of helix between them, 505.4 mm pin to pin** (each curve 20.5-20.9 mm from the coil to its pin, 2.25 past the two pins, estimated). Read so, the two pinning points come out 7° apart in plan, where 05 03_1 draws them 5° apart (its "unterer" and "oberer Ansteckungspunkt" at 15° and 20°) and 05 03_5 draws the collet's pin end under the stud: the 3.5 mm is what brings them in line, for any whole number of turns. Phase 2a's reading (13 turns less 3.5 mm of helix, the curves added) leaves them 48° apart. Against it, the drawn coil counts lean a turn longer: 05 03_5's helix stands 9.5 between the curves (to the strip's middle, as its 0.75 to the collet's pin hole: 13.0 pitches, where this reading's 11.80 turns stand 8.61) and is drawn with about 12.4 turns; the coloured section draws 13 pitches between its top and bottom bands; Wempe 3955's spring (`5_Wempe_3955_O.jpg`, side-on: 12 front coils at 6.7 px a pitch, the pitch 0.73 ± 0.03 against the coil's Ø, the stud at the front so the top curve's junction is 0.4-0.6 turn above the first) has about 12 turns of helix: 11.5-12.8 (by its count, the top curve's junction 0.4-0.6 turn above the first front coil; by its height, the front coils' 79 px against the coil's Ø, 120-128 px, 8.1 ± 0.4 mm, where this reading's helix rises 8.61 and phase 2a's 9.43). Side views draw coils schematically; the pins' place is a construction. Settled as the whole strip (likely: the text sure, the pins agree; the coil counts don't). Since 28 October 2026 the stud's hole is where 05 03_5 and 05 03_1 put it, 3.15 under the bar, so the spring's ends stand 9.5 apart as 05 03_5 draws them: the drawn helix is opened to a pitch of 0.80 between them (11.80 turns), where 13 turns at the wound 0.73 would fill them; the physics keeps the wound pitch (its height doesn't enter the period). For the owner: the 9.5 and the 13 pitches drawn are the reading's one disagreement with the sheets left (phase 2a's 12.911 turns stood 9.43).
- **The period.** 505.4 mm gives k 409 µN·m a radian and, with the weighed balance (2,526 g·mm²), **0.494 s**, 1.2 % short of 0.5 s (0.497 s with 2,561 until 18 October 2026, 0.491 s with 2,501 until 15 October 2026's shape batch); 14 turns less 3.5 mm would give 0.510 s, 15 turns less 3.5 mm (05 03_6's coil as wound, cut) 0.528 s, phase 2a's reading 0.512 s. 0.5 s wants 2,589 g·mm² (1.1 % more), or the strip 0.4 % thinner, or the modulus 1.1 % lower: inside the modulus's and the strip's ranges. Until 15 October 2026 the masses were built 5.4 high from 1.1 over the rim's lower face (05 03_2's far pair, its foot hidden by the arm's section), the balance 2,269 g·mm² and the period 0.468 s, 6.4 % short: their height, now read from the rim's face to 6.46 (05 03_2's near pair, Wempe 3955's side view: How the balance and escapement were measured), was the larger part of the gap, as this section expected.
- **The curve and Phillips' conditions.** 05 03_7's table (radii to the strip's inside from the coil's centre every 10°, pinned at 220°) is two compass arcs: 0-90° on a circle r 5.94 about a point 0.33 mm off the centre, 110-220° on one r 4.35 about a point 1.26 mm toward 90°, both within 22 µm; the sheet marks small circles at those two points (0.23 mm from the second): the compass's points, not another origin for the radii (the drawn curve scales to the table from the coil's centre within 0.07-0.12, where from the off-centre mark it would miss by 1.3). Phillips' conditions on the curve from the coil to its pin (E. Phillips, 1861, as HSPR): its centroid lies on the perpendicular to the junction's radius (1.7° off: the first condition holds), but 3.01 from the staff where the second wants R²/l = 1.91: its first moment l·OG is 61.7 mm² against R² 39.2, **1.58 times**. The outer curve, drawn in proportion to the stud, the same (1.60). The curves that meet both conditions to the same pins and headings (HSPR.design) are 28.4 and 26.0 mm long, leaving the coil 108° and 81° earlier.
- **The force on the pivots** under a couple, × R / couple (HSPR.lateral; 0 for Phillips' ends, about 1 for plain ones): **0.018** as drawn. Each curve's error lies along its junction's tangent, so the two cancel when the helix between them is a whole number of turns (11 turns 0.0010, 12 0.0009) and add at a half (0.030); the pins' place sets the helix's 0.80. Both ends designed to the drawn pins: 2.5e-5. The Hamilton's spring as its model draws it leaves 0.017 (hairspring.js), a designed one under 0.001: the Wempe's drawn curve is no better than plain ramps drawn with care; the tool fails only past 0.1. At large swings (an elastica, HSPR.large, ±300°) the force is 0.004 at 90°, 0.024 at 180°, 0.030 at 270°, and the beam elements (hairspring-fe.js's solver on 1,684 elements, the strip's 0.285) agree to 1 %.
- **The spring as the page draws it breathes** (15 October 2026; `WESC.HSP.bend`, as the Hamilton's `R.spPath`): its pull on the balance taken as a pure couple, the bending moment is the same all along the strip, so each part of it changes its curvature by θ/L and the heading at s from the collet turns θ(1 − s/L). The coils open and close concentrically, 4.9 % of their radius (0.31 mm) at the model's 207° swing, the terminal curves curling by as much, and the strip keeps its length. Against the strip solved as an elastica on the same path end to end (HSPR.large; HSPR.shape gives its nodes) it lies within **0.010 mm** from −300° to 300° (`wempe_hairspring.js` fails past 0.03). Until then every coil was turned rigidly by θ(1 − u) at its radius (u its height up the helix): 1.2 mm off the elastica at the model's swing (1.7 at 300°), the strip 4.5 % longer or shorter, and the coils never opening or closing.
- **Its isochronism.** The drawn spring stiffens a little as it winds (its couple over θ EI/L 1.0006 at 180°), so the balance gains 3.33 s a day at 188.5° and 2.82 at 199.5° against small swings: it **loses 0.46 s a day for each 10°** about the model's swing, 194.3° (since 19 October 2026's physics pass; 0.48 at 197.2° before it, 0.50 at 199.4° before 16 October 2026's reading of 05 04_1's angles; −2.5 s a day over the 1954 instruction's 225-270°), the elastica and the elements agreeing to 0.01 s a day. The model runs with it (`WESC.SET.HS` −0.464 since the physics pass, makeEsc's rate; −0.491 before it, −0.499 earlier; −0.543 about 207° with both curves the table's, −0.659 with the outer curve drawn in proportion to 3.87 until 15 October 2026, −0.700 about 214° before that, −0.721 about 218.6° before phase 2d): over the wind it counters the escapement's own isochronism, the rate **−0.26 to +0.20** s a day since the physics pass (−0.53 to +0.44 for the escapement alone; −0.06 to +0.03 before it) (−0.08 to +0.08 with the old outer curve).
- **Temperature: the linear term.** The rim's quarters are cantilevers from the arm's edge (5.8°) to the cuts (87.3°), 22.3 mm each; the nickel steel 0.405 inside the brass's 0.515. Their curl a °C by Timoshenko's bimetal (1925), each element's radius moving by the layers' mean growth, the root carried by the arm (nickel steel) and the curl integrated from the root, the masses clamping the rim over their slot (estimated); every part weighed on the model's solids. The steel spring alone loses 9.5 s a day a °C (its thermoelastic coefficient −240 to −270 × 10⁻⁶, physics.js's −250 and a steel spring on a steel balance's 11 s a day a °C, VintageWatchstraps; its expansion 11-12.5 × 10⁻⁶). With Guillaume's 42-44 % nickel steel inside (7-8.5 × 10⁻⁶, E 145-160; the sheet's "Nickelstahl Sonderlegierung" read so, estimated) and brass (18.5-20 × 10⁻⁶, E 95-110) the balance gives back 7.0 at the masses' drawn place, 30° from the cuts' line (Wempe 3955's and the 6MX's; 05 03_2 scales 32): **−2.5 s a day a °C** (the TU's C +2.5, against ±0.10; −2.3 before the bodies were weighed again on 15-16 October 2026); at 32°, −3.0. The masses null it at **19.5° from the cuts' line** (63-75° from the arm over the constants' 32 corners, 28 of them on the free arc; 20.5° before), a degree along the rim moving it 0.23 s a day a °C: the TU's ±0.10 is ±0.4° of their place, which the adjuster sets on trial (the 6MX's book: the masses are moved along the rim for compensation). The drawn place would compensate with a nickel steel of 4.7 × 10⁻⁶ (an invar-like 36-38 % alloy) or a spring of −201 × 10⁻⁶; with a plain nickel steel (11-12.5) no place on the arc does (−2.8 at its end). So the drawn place is a starting point, 10° short of compensation with the middle constants. Wempe 3955's masses, at 30° on an adjusted chronometer, stand where its adjuster left them, so its own constants compensated there: the alloy and the spring's coefficient are the open part, not the masses' place.
- **Temperature: the secondary error.** A steel spring's modulus falls faster as it warms: Dent's error, a few seconds a day gained at 15 °C with the rate right at 0 and 30 (Guillaume's Nobel lecture, 1920), about 2.5 s in the middle of a 30 °C range (VintageWatchstraps, "Temperature Compensation by Nickel Steels", after the Neuchâtel trials): 2-3 s, a quadratic of −0.009 to −0.013 s a day a °C². Over the TU's 4/20/36 °C that alone is **S +2.3 to +3.4 s**, and a rim of brass on a plain nickel steel (their quadratics 5.5 and 5.2 × 10⁻⁹ a °C²) leaves it so: outside the TU's ±1.20. The integral balance cancels it with a nickel steel whose expansion's quadratic is −8.5 to −15 × 10⁻⁹ a °C², negative as Guillaume's 44.4 % alloy's is (1899; the 6MX's book calls its balance "integral", Fig. 5.62); Guillaume's 42-44.4 % nickel steel as the National Bureau of Standards tabulates it (Circular 58, 2nd ed., 1923, Tables 5 and 13: its quadratic −3.4 to −2.51 × 10⁻⁹ a °C², its linear 6.85-8.41 × 10⁻⁶ agreeing with the rim's) cancels part of it: with Dent's error at 2 s, **S +0.74 to +0.89 s**, inside the TU's ±1.20; at 3 s, +1.9 to +2.0, outside it. The 6MX's passports state S +0.80 ±0.17 (five of the TU's trial, 1955-1993: `documents/6MX-figures.md`, "The test cards"), so Dent's error is taken at 2 s (likely; until 18 October 2026 S was taken as a fifth of the spring's own, Guillaume's balances at Neuchâtel in 1902, +0.5 to +0.7 s).
- **The build checks** (`tolerances.js` and `keystone.js` for the Wempe, with the bench and the Monte Carlo): below, Building it: tolerances, the bench and the Monte Carlo.

## Physics: energy (phase 2b)

Where the drive's energy goes, from the mainspring through the fusee and chain, the train and the escapement to the balance's damping, each from the Wempe's own parts, and whether the sheets' own figures agree with each other. The tools (no browser): `tools/wempe_mainspring.py` (the mainspring solved by the Hamilton's `mainspring.py` as a variant and fitted to 05 06_20; `--check` a second), `mainspring_friction.py` on it (`wempe_mainspring.py --friction`, about a minute), `tools/wempe_physics.js` (the budget, a second), `tools/gearing.js --model wempe` (the meshes tooth by tooth, about 2 min; `--quick` 30 s) and `tools/wempe_strength.js` (a second). The Hamilton's runs of the shared tools are unchanged (mainspring.py's constants and solve bit for bit, gearing.js's, strength.js's and physics.js's output byte for byte).

- **The mainspring, against its own drawing.** The strip 15 × 0.37 (05 06_20) in the drum's Ø 38.5 (05 07 01-1: its outer coil on the wall, threaded behind the Steg 05 07 00-1, its last 5.7 on the hook block 0.5 deep: tools/mainspring.py's MC_MS_STEG and MC_MS_BLOCK since 18 October 2026, a plain wall until then) on the arbor's core Ø 13.3 (05 07 02), solved as the Hamilton's is (its shape of least bending energy at each quarter turn of the wind, the coils pressing on each other, the inner end on the hook; the torque the energy's slope). No sheet gives its length or its free shape: the free curve is the Hamilton's measured (KLUwI2UUCMQ 32:18), scaled to the length, with its turns scaled by a set (×1 the Hamilton's), the eye's place the Hamilton's (9.4 mm), the modulus 207 GPa. The test: set up ¾ turn past its slack (05 06_20's "3/4 Umgang gespannt") and wound through the drawn fusee (the groove's radii, fusee.js; the chain's pitch line 1.02 out on the fusee and on the drum Ø 41.6), its torque on the fusee arbor at each of the sheet's 23 readings from turn 0.29 (the first 0.29 turn left out: the chain rises from the flange's slot there) against the measured force, each scaled to its mean. The drawn fusee and drum take 5.08 barrel turns over the fusee's 8.75, and the sheet's barrel marks (5, 4, 3, 2, 1 at fusee turns 0, 1.35, 2.87, 4.62, 6.59) fall at 5.08, 4.06, 3.07, 2.07, 1.05: the sheet's fusee and barrel agree to 0.08 turn.
- **The fit.** Thirteen lengths and sets were solved (`mainspring_wempe_L*.js`, about 12-25 min each): 1,300 mm at the Hamilton's set fits 6.3 % rms (its torque rises 2.2:1, the fusee's levers only 1.7:1), more set worse (13 % at ×1.3, 21 % at ×1.6), less set better: at ×0.7, 1,180 / 1,240 / 1,300 / 1,360 mm fit 2.3 / 1.2 / 1.6 / 2.1 %; at 1,240, ×0.6 / 0.7 / 0.75 / 0.8 fit 1.07 / 1.19 / 2.10 / 2.3 % (the sheet's own reading ±0.7 g, 0.5 %; an even pull would be 2.17 %). That is the fit without friction, and the force was measured running down, the coils' friction in it: each spring's friction worked out on its own solve (`mainspring_friction.py`, mu 0.10) and taken off, ×0.6 / 0.75 / 0.8 fit 3.24 / **1.83** / 2.31 % (worst 6.0 / 3.4 / 5.1 %). The friction takes most near full wind, where a spring with less set nears coil-bound (×0.6 gives 92.3 % of its frictionless torque fully wound, ×0.75 95.3 %), so the frictionless fit takes too little set to give the rise. **The model takes 1,240 mm at ×0.75** (26 October 2026; solved with the Steg and the hook block, its outer coil threaded behind the one and its end on the other, as the model's spring since 18 October 2026): 1.83 % rms with its coils' friction, 2.10 % without (4.5 % at worst), and at it the level closes with the drawn strip (below). Until 26 October 2026 the model took ×0.6, the best fit without friction (1.05 % re-solved with the Steg and block, 3.8 % at worst). It gives the measured profile's features: the hump at turns 1-1.5 (136 g), the dip at 4-5.75 (129), the rise to full wind (138), the last from the spring nearing coil-bound. Set up 0.65 or 0.85 turn it fits 2.50 or 1.77 % without friction. A quadratic in the length and the set through the nine tries near it, frictionless (it misses them by 0.24 % rms), puts the least at 1,245 mm and ×0.65 (1.26 %; 1,253 mm and ×0.67 through the eight before ×0.75 was solved); 1,275 mm at ×0.6, where the seven before it put the least, fits 1.99 % solved: the solves scatter by about a percent (the energy is nearly flat, mainspring.py), so the length is fitted to about ±50 mm. 2a's planning estimate from the measured torque's rise and a free strip's stiffness was 1.27-1.33 m. The page draws 1,240 (1,386, half the room, until 15 October 2026): 11.9 turns all on the wall, 12.7 run down, 17.8 fully wound, 18.9 coil-bound by the drawn spring's two packs; the solved spring is slack at 12.24 turns, run down at 12.99, fully wound at 18.07, and solves to 19.0 (coil-bound past it; 19.25 until the Steg and block, which take a quarter turn of room).
- **The level closes with the drawn strip** (26 October 2026). The measured force is 0.913 of the solved spring's frictionless torque at 0.37 and 207 GPa (`wempe_physics.js`); over 200-210 GPa and 0.365-0.375 mm that leaves 1.6-13.6 % for the losses, against 2.0-14.6 % worked out below, and at their middle it asks a strip 0.370 thick: the sheet's own figure. 05 06_20's "0,37" is not overwritten (15 October 2026, read again at 8-20×, 1024 px scan, about 6 px a figure): its 7 is the sheet's own stencil 7, a short downstroke at the top bar's left and a bar across its stem, drawn the same in "12,17" and "9,71" on the same sheet (radii the fusee's sheets confirm), and nothing of another figure shows beside its strokes; no other sheet gives the strip's thickness (05 07_*, the arbor's hook, the coloured section's label "Zugfeder 05 07 03-2", whose 9.4 px/mm can't tell 0.355 from 0.37). The sheet measured the strip it names: "Zugfeder 15 × 0,37" is written on the same sheet as the force, 24.7.41, measured on the fusee arbor (the sheet's sum, 131.5 × 262 / 19.6, takes no fusee radius) running down ("Ablauf"), the mean of two runs, in the 1941 barrel (0207, 15.4.41: the same Ø 38.5 bore and Ø 13.3 core as the 1948 drum) with a steel fusee ("Stahlschnecke"), so not an earlier spring. Until 26 October 2026, with the free curve at ×0.6, the measured force was 0.811 of the solved (0.802 before the Steg and block): 12.6-23.2 % for the losses, a strip about 0.356 at their middle, and 2.70 GPa fully wound as solved, past a steel mainspring's limit (about 2.5-2.6 GPa), carried as the solved strip pulling 23 % more than the sheet measured (Unresolved until then; Closed). Where the 23 % went: about ×1.10 is the losses to the fusee arbor at their middle, about ×1.13 the free curve's set, which no sheet gives and which moves the level more than anything else the sheets leave open (measured over solved, frictionless: ×0.5 0.733, ×0.6 0.802, ×0.7 0.842, ×0.75 0.913, ×0.8 0.910, ×0.85 0.949, ×1 1.077, where the spring would give less than the sheet measured with no losses at all); nothing is left for the modulus or the thickness, where closing it at ×0.6 wanted the modulus at 200 GPa, the strip at 0.365 and the losses near 12.5 % at once. As solved the strip is stressed 2.46 GPa fully wound (6M / b t²; 2.60 GPa at its inner coils along the strip, 2.44 its median, `motion3d_springs.py`; 2.66 and 2.37 at ×0.6), at a steel mainspring's working limit, where a mainspring is meant to work. The budget takes the solved shape at the measured level (×0.997 with the losses at their middle; ×0.890 at ×0.6): 427 mN·m run down to 839 fully wound (1.97:1; 473 to 824, 1.74:1, at ×0.6; 2a's estimate 1.9:1 to 749), 2.45 GPa (2.41 at ×0.6; 2a's 2.2), inside a tempered steel mainspring's working range. The swing doesn't take the solved spring: the escapement is driven by 05 06_20's measured force through the train (escphys.js), so the page's swing and rate are as they were. The 1958 repair book's calculated barrel torque for the MX (p. 58: 103.2-110.3 kg·mm fully wound, 56.2-61.2 two days on) is 1.36-1.45 and 1.10-1.20 times 05 06_20's turned to the barrel (76.2 and 50.9 kg·mm, its losses in it); the drawn strip solved without friction lies between (85.7 and 53.8 at ×0.75; 94.3 and 62.1 at ×0.6).
- **The coils' friction** (mainspring_friction.py on the solved spring, mu 0.08-0.16, lubricated steel): it takes 0.8 % of the spring's work running at 0.10 (0.7-1.4 %), winding against running 1.7 % (1.4-2.7 %); fully wound running gives 95.3 % of the frictionless torque, run down 97.6 % (at ×0.6, nearer coil-bound fully wound, 1.95 % of the work and 92.3 % fully wound). Put into the fit it brings it to 1.83 % rms from 2.10, where at ×0.6 it took the fit from 1.05 % to 3.24 %: the set the model takes (The fit). A first-order estimate, the state's shape taken as friction leaves it, which near coil-bound overstates it.
- **The fusee, chain and barrel** to the fusee arbor: the spring's own losses 0.7-11.1 % (its coils' friction, up to what mainsprings measure, running 10-20 % under winding, ICMFF9: the strip's edges and the steel's hysteresis, as the Hamilton's physics.js takes them), the drum on its arbor's journals (Ø 4.48) under the chain's pull 1.0-1.5 %, the chain's links on their rivets (Ø 0.55) on and off the drums 0.3-0.5 %, the fusee arbor's pivots (Ø 2.8 and 4.5) 0-1.9 % (if the sheet's lever counted them; its rig isn't drawn): together 0.854-0.980 of the spring's frictionless torque reaches the fusee arbor (mu 0.10-0.15, oiled steel on brass).
- **The train** (gearing.js --model wempe: the four meshes on the page's own outlines, the tables' tips, roots and tooth thicknesses, at the holes' centres): fusee wheel 90 on the centre pinion 14 (m 0.4356): backlash 265 µm, tip clearance 245 µm, the mesh 3.0-5.8 % at mu 0.10-0.20 (steel leaves on brass teeth, run dry), 60 % of the action before the line of centres; centre 90 on the intermediate pinion 12 (m 0.35529): 176 µm, 190 µm, 3.5-7.1 %, all of it before the line; intermediate 80 on the seconds pinion 10 (m 0.28066): 136 µm, 145 µm, 4.0-8.0 %, all before; seconds 80 on the escape pinion 10 (m 0.26333): 170 µm, 100 µm, 1.9-3.7 %, 46 %. The pivots (the driven arbor's, on its tooth loads, mu 0.10-0.15) 3.3-5.0, 2.4-3.6, 3.2-4.8, 1.1-1.6 %. The train with its pivots 0.730-0.833, the geometric mean 0.780 since A.4's pinions (0.666-0.797 and 0.729 before them): the model takes it since 19 October 2026's physics pass (`MESH` in escphys.js; 2a's 0.749 from the meshes' rule of thumb, 0.661-0.848, until then). The teeth's ripple over a day moves the swing 205.2-210.6° at mu 0.10 (204.1-212.4° at 0.20; 211.9-217.5° and 210.7-219.4° before the masses' height, 15 October 2026; 216.5-222.0° and 215.3-223.9° before phase 2d) and the time 342-518 µs about the mean rate. The depthing windows (until a mesh jams, or its friction takes the swing out of the model's band, 193-270° since 15 October 2026, 200-270° before): -240/+436, -190/+355, -145/+281, -100/+263 µm about the drawn centres (every mesh passes the wide search's end, 1 m), so the holes must sit within ±25 µm (the seconds mesh: its window less the pivots' 50 µm shake, the drawn bush bores, estimated): a hobby CNC's work. `gearing_wempe.json`.
- **The escapement** at 12 h since 19 October 2026's physics pass (86.1 µN·m): a tooth's 24° gives 36.05 µJ an oscillation and the balance nets 20.67 µJ (57 %) at 194.3°: the strike 10.4 % of the impulse, the unlocking 26.1 % (the detent's spring and preload 9.7 %); the balance's 2.29 mJ (k 399) loses 20.67 µJ at Q 697 (TF 111 s). Before it, at 2a's reference (82.8 µN·m): a tooth's 24° gives 34.6 µJ an oscillation and the balance nets 22.2 µJ (64 %) at 197.2° (since 16 October 2026's reading of 05 04_1's angles: the strike 14.9 % of the impulse, the unlocking 16.2 %; 22.7 µJ, 65 %, at 199.4° since 15 October 2026's shape batch: the teeth as 05 04_23 draws them, the balance re-weighed, TF 108 s; 20.7 µJ, 60 %, at 207.3° before): the strike takes 12.5 % of the impulse (20 % before), the unlocking 15.9 % (17 %; the detent's spring and preload 6.4 %, 6.9 % with its speed, counted to where it leaves the stone: phase 2d), the rest is the wheel's speed lost at each lock (and, while the stone rides the tooth it let go, its friction on the wheel's chase). The balance's 2.45 mJ at that swing (k 404 µN·m a radian) loses 2π/Q of it an oscillation: 22.7 µJ at the model's Q 679 (TF 108 s; its parts' damping Q 507-1,309). (Before the batch: 2.58 mJ at 207.3°, k 395, 20.7 µJ at Q 785.) (Until the masses' height was read, 15 October 2026: 20.2 µJ at 214.0°, k 358.)
- **The power at 12 h**: 92.5 µW at the fusee arbor (measured), 72.1 µW at the escape wheel (through 0.780), 41.3 µW lost in the balance: 44.7 % of what the fusee gives (69.4 µW through 0.749 and 41.4 µW before the physics pass).
- **Does it close?** To swing the sources' band, 225-270° (the 1954 instruction), the measured drive through the train as built (0.889-1.065 of the reference) needs Q 922-2,079; the balance's parts give 509-1,316: it closes, over Q 922-1,316 (847-1,309 before 19 October 2026's physics pass; 895-1,247 before the shape batch, 812-1,246 with the lighter balance). At the model's Q 697 the drive through the train's range swings 186-203° at 12 h (the model's 194.3° since the physics pass; 184-204° and 197.2° at Q 679 before it; 186-207° and 199.4° before 16 October 2026's reading of 05 04_1's angles); 225° wants Q 1,035 at the model's drive (961 before the physics pass). From the solved spring at its own level, with the losses' range, the drive would be 0.817-1.218 of the reference (0.863-1.330 at ×0.6). `wempe_physics.js` exits 1 if the level, the stress at the measured level or this closure fails.
- **Strength** (wempe_strength.js, strength.js's ranges, fully wound at the measured level, every stage lossless): the mainspring 2.45 GPa (2.41 with the free curve at ×0.6, until 26 October 2026; margin 1.0-1.1 to a mainspring's 2.5-2.6 GPa limit: as a mainspring is meant to, it works near it); the chain's pull 38.4 N on its plates (62-123 MPa), rivets (81 MPa in double shear), the fusee's pin and the hooks, margins 8 and up; the band (0.22 × 0.78, its width estimated) 224 MPa, margin 6; the fusee wheel's teeth (Lewis, Y 0.2) 89 MPa against brass's yield, margin 3.4-5.1, the others 7 and up; the centre arbor's pivot (Ø 1.19) 218 MPa against steel's yield, margin 5.5; the maintaining spring (at the strongest drive, the moment along the bent band: wempe_sustaining.js) 825 MPa, margin 1.5-2.2 to hardened spring steel's yield (~~) (868 MPa until 16 October 2026, from twice the full-wind drive); the maintaining ratchet's teeth under the detent and the click wheel's under the click, margins 1.6 and up; a strong hand on the key against the stop (1.06 N·m, overwind.js) puts 104 N on the stop pin (Ø 1.6, margin 6) and the stop bar (2 × 1.45, 3.6 out of its slot, margin 2.3 hardened, 0.7-1.1 soft: the bar must be hardened; no sheet gives it).
- **The maintaining spring** (`tools/wempe_sustaining.js`, about 20 s; as `sustaining.js` for the Hamilton's). Its eye's pin goes up into the ratchet and the pin at 295° down into the fusee wheel (05 06_4 A-B: Readings corrected), and the ratchet's teeth and detent on A-B make running clockwise there, so the drive pushes the eye toward the square end and closes the ring: its outer edge leaves the wheel's recess (Ø 32.3 +0.05 round the ring's 32.3 -0.1), where opened it would bear on the wall at once and barely give. The short wide tail past the wheel's pin would turn out about it as the band closes, but has 0.025-0.075 to the wall, so that end is held as clamped; the eye's end turns on its pin. The band (I = t w³ / 12, its traced width) bent as an elastica, the eye's pin brought where the ratchet turns it: 1.22 N·m a radian at small turns (Castigliano's, the same), stiffening as it closes (T = 1.2204 ψ + 0.2956 ψ²). The fusee's drive (325-355 mN·m over the wind, 05 06_20) closes it 14.4-15.6°, 1.1-2.3° short of its eye's round end meeting its square end (16.7°): its ends 0.27-0.58 mm apart, nearly meeting, as Gould has such a spring ("a simple steel split-ring, with ends nearly meeting ... When the pull of the chain is removed ... the ends spring apart a little", 1923, p. 238); it carries the drive by its bend. So over the strip's 1.25-1.35 and the modulus's 200-210 GPa (0.12-0.70 mm). Bent 825 MPa at the strongest drive, 1.5-2.2 times short of hardened spring steel's yield. While the key turns: the clicks let go, the ratchet turns back with the spring until the maintaining detent takes a tooth (none to a whole tooth, 3°), and the train runs on the push (89 % of the drive at once, the detent half a tooth late), which falls as the wheel turns (a turn in 6.43 h); the balance keeps going 10.7-13.9 minutes, its swing under 185° after 31 s to 2.5 min and under a turn after 49 s to 3.2 min; a wind costs under a millisecond. With the eye's hole 0.8 toward the square end (as built until 16 October 2026: Unresolved) it would bank at 13.5° and run closed, pushing 89 %; 0.8 the other way, its ends 1.1-1.4 mm apart. Until 16 October 2026 the pins were the other way round and the push was the running drive spent over 05 06_9's "x = 0,27 mm" read as its deflection at the pins, 1.09° and 70 s. The page draws the ring closed so (fusee.js: the same elastica, the ratchet `s.ms` ahead of the wheel) and runs the drive from it (escphys.js's `susDrv`).

## Physics: in time (phase 2d)

The escapement integrated beat by beat, as the Hamilton's is (its README, "Checked in time"): `tools/dynamics.js --model wempe` (about 2 minutes; `--quick` 40 s) moves the balance, the escape wheel with the whole train behind it and the detent as bodies through every contact, on contact geometry worked out apart from makeEsc's, and holds the result against makeEsc's figures; `tools/tripping.js --model wempe` (`tools/wempe_tripping.js`; about 2½ minutes, its runs in child processes many at once, `--quick` about a minute) takes the detent as a frame of beams. The Hamilton's runs of both print what they did, figure for figure, and `escgolden.js` holds its makeEsc bit for bit.

- **The bodies.** The balance 2,526.2 g·mm² (weighed; 2,560.7 until 18 October 2026, with an estimated nut on each mass where the drawings have a tapped hole in its top; 2,501.4 before the shape batch and the tool weighing one revision, 2,268.6 until the masses' height was read, 15 October 2026), run at the train's 0.5 s as makeEsc runs it (the drawn hairspring gives 0.494 s: the timing a maker sets). The train at the escape wheel, each arbor weighed on its solids and reflected by its ratio squared (`tools/wempe_inertia.py` now weighs the intermediate, the centre with the cannon tube, change wheel, hour wheel and hands, and the fusee wheel with the maintaining work that turns with it): **12.472 g·mm²**, of it the escape arbor 8.71 (11.19 with its collet counted in both revisions, until 15 October 2026), the seconds arbor and hand 1.254, the intermediate 0.024, the centre and motion work 0.003, the fusee wheel 0.0006. makeEsc's JW, 9.96 (the escape and seconds arbors; 12.44 before), is kept: the rest would move its swing −0.08°. The detent's moving part 94.3 mg, 8.35 g·mm² about its flexure (makeEsc's ID 8.46 until 18 October 2026, before the gold spring's bow, and 8.43 before the horn was traced) (94.9 and 8.60 with both revisions' pieces), its centre of mass 8.37 mm from it (the page's solids weighed with the detent at rest; 93.6 mg, 8.25 and 8.26 with the horn 3.5 long). Its spring 0.07 × 1.9 × 5, steel (205 GPa): 2.227 mN·m a radian.
- **The preload and the drawn spring.** As drawn the foot, the spring and the blade lie on one line with the stone at its lock (escapement.js), so a banking where the detent is drawn leaves the spring straight: **no preload**. 2a's estimate, 0.63 g at the stone (79.6 µN·m), is the spring bent 2.05° past straight at its banking, 0.46 mm at the stone. Neither the banking nor its setting is drawn (Unresolved; the 1954 instruction's п. 11 sets the lock by a banking). In time the drawn spring alone, unpreloaded, brings the detent home before the next tooth; the preload is for knocks (below) and costs swing: pressing the stone on the tooth it has let go (below), it costs 5.9° (219.8° unpreloaded, 213.9° at 0.63 g, with the lighter balance). The banking (15 October 2026) is the block's cross screw, its head on the pipe at the stone (How the balance and escapement were measured); its setting isn't given, so the preload stays the estimate.
- **What the time domain found that makeEsc missed** (the Wempe's alone):
  1. *The detent flung off the stone's corner.* The gold spring's square end leaves the discharge stone's square acting corner where the lift turns within a cell of the table, still moving up at the stone's speed (4.2 rad/s of the detent, 73 mm/s at the gold spring's tip), and flies on before it falls. makeEsc's `depart` took its speed by a central difference across the corner (−0.39 rad/s, falling), so its fall began 1.2° early; now a square-ended spring (`TSQ`) leaves with the slope it came up, and makeEsc's fall is the integration's to 1e-5 rad.
  2. *Its work is lost there.* makeEsc counted the detent's preload and spring over the stone's whole lift table, its fall down the bevel handing that energy back to the balance, as a massless detent riding the stone down would; the drawn detent, flung off the corner, never touches the bevel, so its energy and its speed there are lost. `DEP` counts the work to where it leaves the stone: 3.2° of swing, −0.41 s a day (in time, the ride's force kept off the wheel, 215.39°; makeEsc with `DEP` 215.38°).
  3. *The stone rides the tooth it has let go.* Let go from rest with the seconds arbor behind it, the wheel has turned 0.5 % of a pitch when the detent leaves the stone, its tooth still under the stone's flat, so the detent, flung up, falls back onto that tooth's land at 0.9° of the balance and rides it, and down its back, until the tooth has passed at 10.3°. The stone's friction on the land (μ 0.15, as on the lock: estimated) holds back the wheel's chase; the back, falling away, takes the detent's preload and spring into the wheel; the detent, unable to follow the back as it steepens, hops down it (17-20 landings a beat in time). `RW` runs makeEsc's chase so (quasi-static, the detent's inertia in its contact force; off the back where it can't follow, falling back on): −1.4° of swing. The ride's table is the tooth's drawn arcs (05 04_23: the land on the tips' circle, the ∅ 6 cutter's back) against the stone's half round, worked out apart from makeEsc's ride and within its own 400 steps of a pitch.
  4. dynamics.js's own: the corner's turn lies within one cell of the lift table, narrower than a step, so a step straddling it ended on the bevel with the detent pressed back on it, and missed its leaving one beat in seven; a step on the stone now ends in that cell.
  With `DEP` and `RW` (`WESC.SET`) the swing at 12 h was **214.0°** (218.6° before), the escapement's own rate −8.23 s a day; what runs on makeEsc's swing moved with it, in the sections above. **Since the shape batch** (15 October 2026: the teeth as 05 04_23 draws them, the balance re-weighed, TF 108 s from the 6MX video) it was **199.4°**, the escapement's own rate −9.27 s a day (**197.2°** and −11.36 since 16 October 2026's reading of 05 04_1's angles and the discharge stone's place: dynamics.js --model wempe the swing 197.2°, the tooth landing 12.2° after the release, the stone's face −13.3° from the line of centres; before them: dynamics.js --model wempe finds the swing 199.5°, the tooth landing 11.6° after the release, the impulse stone's face −14.8° from the line of centres (makeEsc −14.8°), the detent off the stone at −1.75°, on the escaping tooth at 0.66°, home at 8.65° (makeEsc 8.19°); Twist (120°) brings it within 2° in 134.5 s; the figures after this sentence are the 207.3° model's where they differ by less. Before it (the masses' height, 10 % more inertia) it was **207.3°**, the escapement's own rate −8.28 s a day, and dynamics.js --model wempe finds: the swing 207.2° (makeEsc 207.3°), the tooth landing 16.0° after the release (16.1°), the stone's face −10.4° from the line of centres (makeEsc −10.3°), the detent off the stone at −1.75°, on the escaping tooth at 0.83°, home at 10.19° (makeEsc 9.91°), back 15.15 ms before the next tooth; over the wind's drive 201° → 212°, +0.55 s a day (+0.51 s a day each 10° of swing: the escapement alone now just past the Hamilton's 0.5, so the Wempe's check takes the escapement with its drawn hairspring, −0.14 for each 10°); Twist (124°) brings it within 2° in 138.5 s; knocks 78 g (0.5 ms), 22 g (3 ms), 31.4 rad/s; at sea 0.010 s a day. The figures below are the lighter balance's where they differ by less.
- **Against makeEsc** (the integration's detent dead on its banking, its inertia where makeEsc takes it; runs of 150 s, the balance settling over 62 s): the swing **213.9°** (makeEsc 214.0°); the tooth lands on the impulse stone **17.1°** after the release (17.2°); the detent leaves the stone at −1.75° (−1.76°), lands on the escaping tooth at 0.87° (0.87°) and is on its banking at 10.56° (makeEsc's ride ends at 10.32°); the escapement's own rate **−8.22 s a day** (−8.23); over the wind's drive (95-104 %) the rate changes +0.54 s a day in time and in makeEsc's escapement (with the drawn hairspring's −0.77, −0.23). Bouncing on its banking (restitution 0.3, estimated) the same to 0.1°. Every check is the Hamilton's: the swing within 3°, the landing 1.5°, the detent's fall 0.5°, the rate 0.3 s a day, isochronism 0.1 s a day.
- **Where the tooth lands.** 05 04_1's layout draws the tooth falling on the impulse stone 21° before the line of centres, as if the wheel were there at once; makeEsc's solved chase put it at −9.2° (phase 2a). In time it lands with the balance at 14.74°, the stone's face **−9.3°** from the line of centres: the wheel, starting from rest with the seconds arbor behind it on 83 µN·m, chases the stone 17.1° of the balance. The stone's friction on the escaping tooth moves it a little: −9.8° with none, −9.5° at μ 0.10, −9.1° at 0.20 (the swing 215.6°, 214.5°, 213.5°).
- **The detent's return.** It is home on its banking 14.6 ms before the next tooth reaches the stone (at 49.2°), not lifted at all as it arrives; 12.4-14.6 ms over its spring half and twice as stiff, 0.06 thick, the preload half and 1.5×, its inertia twice, its banking lively or dead, the train 1.5× its inertia. Unpreloaded, the spring alone brings it home in time.
- **Starting and the least drive.** Twist (128°, the page's 0.6 of the running swing, estimated) brings the swing within 2° of its 214° in 139 s. The least drive that keeps it going is 14 % of the reference (makeEsc's 25 %, at its AMIN 46°): under AMIN the impulse stone, turning back with the tooth still on it, carries it out of the teeth's path and lets it run on to the locking stone, a tooth a swing all the same, so in time the least swing is the one that passes the gold spring (17.6°), not the impulse's end. Held (run down) from 150°, the balance runs down as makeEsc's freeStep has it within 0.5°.
- **Knocks and the swing pushed** (the detent rigid, dynamics.js): a twist about the staff upsets it at about 32 rad/s in 2 ms (0.69 of the balance's top speed: a tooth escapes); a blow across the plate lets a tooth go at about 81 g lasting 0.5 ms and 23 g lasting 3 ms (a steady push lifts the detent off its banking at 10 g and frees the wheel at 16 g); unpreloaded, 37 g and 7 g. Driven to a 333° swing it keeps one unlocking a swing; at 362°, past makeEsc's TRIP (348°), the stone comes round and unlocks again in the same swing.
- **At sea.** Yaw ±10° over 8 s with ±0.3 g sideways moves the rate 0.014 s a day: the balance is poised and the gimbals keep the staff upright.
- **The detent as a frame** (tripping.js --model wempe): the spring 0.07 × 1.9 clamped at its foot, the blade's two sections, the horn along its curve and the gold spring along its traced bow (11.3 mm from its bending point to its tip; both as `escapement.js` draws them, `WESC.HORN` and `WESC.GOLD`, since 18 October 2026: a straight horn and the gold spring's polyline, 11.6 mm, lying along it, before) as beam elements, the gold spring closing onto the horn at three places near its end, each at its drawn gap; the square with the gold spring's head and screw, and the pipe with the stone, rigid; the banking one contact, the pipe's side on the block's cross screw's head at the stone (15 October 2026: How the balance and escapement were measured; until then under the blade 0.7-1.4 mm from the stone, where makeEsc puts the Hamilton's stop button). Its moving parts weigh 94.88 mg and 8.621 g·mm² about the flexure against the solids' 94.90 and 8.600 (the horn 4.4 long). Hinged at the flexure and made rigid it runs as dynamics.js does (the swing within 0.4°, the rate 0.09 s a day, the release, departure and home within 0.3°, every beat). As drawn, the spring bending along its whole 5 mm, it is 2 % softer at the stone; its modes 82 Hz (the spring), 624 Hz (the gold spring), 1.2 kHz (the spring's second), 3.1 kHz (the gold spring's) and on. The Wempe's lock: its stone's flat draws −3.7° (on the wheel's radius), so a held tooth pushes the stone out, held only by the preload and the friction (μ 0.15 against tan 3.7°, 0.065); lifting the stone lets the tooth on 0.085°, and past the depth of lock, 175 µm at the stone, the tooth is free (makeEsc's recoil, held at 0 or more, is 0 all the way: the frame takes the flat's line from makeEsc's toothBack).
  - **Running as drawn** no tooth gets past at the model's settings (12 beats; over the estimates varied at the contacts' own stiffness, none either), and a held tooth's stone lifts **44 %** of the depth of lock (77 µm) since 18 October 2026, the horn curved and the gold spring's bow closing onto it near its end as drawn (41 %, 72 µm, from 15 October 2026 with the straight horn and the gold spring lying along it), the banking on the pipe and the horn 4.4 long: under tripping.js's margin, half (64 % with the gold spring half as stiff; 32 %, 26 %, 21 % at 1.5×, 2×, 3× the preload). Until 15 October 2026 (the banking under the blade, the horn 3.5) it lifted **55 %** (96 µm), on the return swing at −20°: the gold spring, bent 0.30 mm at its tip as the discharge stone passes it (2.4 µJ stored), comes clear at −17.6° and slams back onto the horn, and the detent takes its blow. dynamics.js and makeEsc take the gold spring massless, its energy lost; the Hamilton's light trip spring stores a fraction of it. tripping.js's margin for the Hamilton is half the depth: the Wempe's wants the preload 1.1× the estimate (0.72 g at the stone) for it (37 % at 1.5×, 26 % at 2×). **Unpreloaded (the banking where the detent is drawn) teeth get past**: 27 in 3 s (6 since 15 October 2026), the gold spring's blow throwing the stone off. So the banking must be set with a preload, as the 1954 instruction's banking-set lock suggests.
  - **The return pass turns on the stone's contact with the gold spring** (a penalty spring, tripping.js's 500 N/m): stiffer (2,000), the stone, meeting the spring's square end with its bevel, pushes it partly lengthwise, the loop round the pipe gives, the tip is carried on to about −25° before it slips off, and its release throws the detent: teeth get past even at twice the preload; softer (125), the stone lifts 23 % (7 % since 15 October 2026; 4× stiffer, 6 teeth past). A real contact is stiffer than 500 N/m, so this is the Wempe's open question for a build: the tip is taken square and unturning (05 04 01-2's blank), and the gold spring's alloy (its stiffness) and its free shape round the pipe are estimates (Unresolved); the horn's length, 4.4, is read (likely).
  - **Pushed**, the frame keeps one tooth a swing to 360°, the last run, past makeEsc's TRIP (353°; rerun 18 October 2026: it tripped at 357-360° before). **Knocks**, preloaded: a blow across the plate lets a tooth go at about 70 g lasting 0.5 ms and 20 g lasting 3 ms (the rigid detent 78 and 22 g), a twist about the staff at 4.8 rad/s in 2 ms; unpreloaded it trips on its own. The 3 ms blow against the preload: 17.9 g at 0.8 times the estimate, 20.4 g at it, 22.6 g at 1.2 times (17.6, 20.0, 22.5 before the horn was traced), so the 20 g the check asks wants 0.61 g, the knock's floor (Building it). At 1.5 times the search read 2.4 g, a fault of the search, not the detent: there alone the run's first drop from rest takes 268 ms against 20 (the stone riding the tooth it let go), and its first blows, falling in it, stall the wheel; from the second drop on it runs as the rest, and 1.5 times is left out of the floor's runs.

## Physics: the transmission (16 October 2026)

Every part that moves, as one system and in time: `tools/wempe_transmission.js` (about a minute with its mesh tables kept, `MC_TR_TABS`; 2-7 minutes fresh, the tables built in threads, as loaded as the machine is; in `ci.py`'s quick steps). The mechanisms above were each worked with the others still or rigid; here the barrel on its solved mainspring, the chain, the fusee and its two clicks, the maintaining ratchet, spring and detent, the fusee wheel and the going train, the escape wheel, the motion work and hands, the up-and-down work, the key and the stop are bodies (their inertias weighed on the solids, `wempe_inertia.json` and `mechanisms_wempe.json`; the chain's, the up-and-down wheel's and the key's estimated) joined by nonlinear elements, stepped at a microsecond (semi-implicit Euler):

- **To watch it.** `verification/assets/transmission/index.html` (linked from the report's section 13) plays the runs in plan: every part coloured by the load it carries against its running load, its deviations from rigid motion magnified as a finite-element post-processor shows a deformed shape, with the time histories; its data, `data.js`, is `tools/wempe_transmission_trace.js`'s.
- **The elements.** The mainspring's torque as solved, at 05 06_20's level, and its coils' friction (`mainspring_friction_wempe.json`, 5.5 % between winding and running at μ 0.10) as a stick-slip element, so it changes branch as the drum reverses; the chain in tension only (it goes slack), its lever on the fusee where it lies (fusee.js's RFT) and, in the whole-run ripple, the polygon a 2.05 mm link makes on each drum; each pawl (the two clicks half a tooth apart, the maintaining detent) a body on its pivot under its spring (`wempe_ratchets.js`'s), riding the teeth's backs and catching a face only if it is down; the maintaining spring's drawn ring (MSK, MSK2 and its bank MSB, `wempe_sustaining.js`'s from 05 06 01-1, read from WPHYS); every mesh tooth by tooth (`gearing.js`'s `mesh` on the page's outlines: the driven gear's place under load through a pitch, the backlash to its back flank, the torque ratio with the teeth's friction at μ 0.15), contact on either flank or neither; the motion work's two meshes and the up-and-down work's from `dial.js`'s tables (`wempe_train.js`'s `addOutline`); the cannon pinion's friction fit, which slips past its torque; the key's one-way coil spring (51 00 11: it grips whenever the hand holds the key against the fusee and slips only if the key is turned the wrong way); the stop bar on its pin. The escapement is `dynamics.js --model wempe`'s own, its escape wheel driven each step by the escape pinion's mesh (`dynamics.js`'s `o.tq`, inert by default: both models' output unchanged).
- **The whole wind** (static, running): the maintaining spring runs at most **15.64°** (fully wound) against its bank's 16.72°, so it never banks running; the train's efficiency at μ 0.15 with the meshes' own ratios is 0.739 (escphys.js's 0.749; wempe_physics.js's range 0.666-0.797). Over a whole run with every ripple at once (the chain's polygon swings its lever 0.49 % on the fusee fully wound, 0.11 % on the drum, once a link, as fine as 05 06_20's own ±0.7 g reading; the meshes' ratios through their pitches) the swing ranges 192.1-207.6° against the smooth 194.1-201.9°, and the time wanders **3.4 ms** within a day: nothing a navigator rating it daily carries.
- **The modes** (linearised at 12 h only to find them): the lowest, **49.2 Hz**, is the barrel and fusee swinging on the maintaining spring; then the chain (495 Hz), the cannon pinion and minute hand on their fit (2.5 kHz), the train (3.3-17 kHz), the pawls (50-63 kHz). None lies near the beat's 2 Hz.
- **A beat** (the coupled run against the same escapement on a rigid train given the torque the train gives at its place, each mesh's ratio where it stands): every beat taken; the train's give, inertia and backlash change the work an impulse gives by **+0.05 %** (as a drive, +0.05° of swing and +0.001 s a day: under 3.00.04's escapement, before 3.03's impulse face and release, it was −1.3 %, so the figure turns on where the impulse falls, and is small either way); no mesh of the going train lets go but the escape pinion's, 1.9 ms at most as the escape wheel lands on its stone (dynamics.js lands it dead: the most the seconds wheel can drive into the mesh; its take-up on the stopped pinion, the seconds wheel's speed times the root of the mesh's stiffness and its inertia, 56 times its running force at the worst of the 8 starts, 112 MPa fully wound against brass's endurance 120-170, margin 1.07-1.52); the seconds hand overshoots its 3° step by 42″; the cannon pinion carries 1.4 mN·m and never slips; the motion work rests in its backlash between steps and is taken up each step, never on its back flank. Settling a run first matters: the coils' friction holds whatever branch the drum last turned on, so a run that starts with the drum still swinging keeps part of the winding branch (2-3 % more drive) for some 90 beats; the movement is settled to rest about critically damped, then set on the running branch. **Averaged over 8 starts** (the owner's choice, 27 October 2026): one run's drive figure turned on where the train's meshes started in their teeth (which tooth pair bears, and the seconds wheel's few let-goes in 48 beats), so it jumped between about −11° and +5° as unrelated inputs moved by a micron (the maintaining detent's contact radius 18.300 against 18.301: −5.8° and −11.0°). The beat now runs from 8 starts, the four train meshes' phases MESH's and seven more spread from them by a fixed golden-ratio sequence, each with its rigid twins at the same places; the check judges the mean (−2.59°, −0.021 s a day; the starts −9.48° to +7.82°, sd 5.95) against the same 8° and 0.5 s a day, and the mean holds within about 2° as those inputs move (−2.6°, −4.4°, −4.2°, −3.2° at 18.033, 18.034, 18.300, 18.301). The meshes' loads are judged on the worst of the 8 starts (28 October 2026; start 0's until then, for a day the starts' median). **Judged on 32 starts, mean plus twice its standard error** (the owner's choice, 1 November 2026): the 8-start mean was still not stable. Per start the swing's departure is heavy-tailed and chaotic, not noise round a mean: at the fusee's inertia of 3963.39 g·mm² start 0 reads −28.8 % of the impulse's work against the rigid train, at 3959.80 (−0.09 %, f287f29d) +3.4 %, while 32 starts give −2.75 % and −0.89 % (sd 8.3 and 5.3, a standard error of 1.5 and 0.9, the difference inside it). The starts share one distribution, but which few fall 10-30 % low (which tooth pair bears, where the backlash lets the seconds wheel go) moves with any input, so the mean of 8 had a standard error of 2-3° and a tail that made it jump. The beat now runs from 32 starts (the same golden-ratio sequence; the rigid twin with the escape arbor's inertia and the meshes' peaks from the first 8 as before), and the check passes when the mean's magnitude plus twice its standard error (sd/√32) is inside the 8° and 0.5 s a day: −1.09° ±2.03 and −0.039 ±0.055 s a day. A shift of the mean past about 6° (or the rate's past 0.4 s a day) fails; a start or two in the tail do not.

  **The escape wheel's speed in the coupling** (28 October 2026): the beat prescribes the escape body each substep from dynamics.js's escape wheel. Until then its speed was its place's change over dynamics.js's step; dynamics.js bisects its impacts (the catch on the impulse jewel, the lock) to steps of 2-100 ns, which carry the impact's whole change of speed, so the body's speed read −400 to −7,500 rad/s for one step and the mesh's damping gave a spike that grew as the step shrank: the seconds wheel → escape pinion peak at 99, 55, 114 and 955 times running at start 0 with `MC_TR_H` 1, 0.5, 0.25 and 0.125, the worst of the starts 304, 3,056, 2,546 and 1,016, and the spike also kicked the seconds wheel. The body now takes dynamics.js's own speed (`-pv`), interpolated over the step; the peak is then the take-up after the landing, the seconds wheel's blow on the stopped pinion, bounded by v·√(K·J) (80 rad/s at the escape arbor, the mesh's 2.8 N·m/rad there and the seconds wheel's 1.25e-9 kg·m² reflected: 4.7 mN·m, 55 times running), and converges: the worst of the 8 starts 56.1, 58.5, 57.8 and 56.7 times running at the four steps, the median 54.6-55.4 (`wempe_transmission_converge.js`; Review-results.md, "The transmission's fatigue line on the seconds wheel's mesh"). The impulse work, the starts' mean, holds within ±1 % over the steps (13.34-13.55 µJ). The old figure is printed beside the new for comparison. With the corrected speed the meshed train's impulse gives 2.7 % less work than the rigid train with the whole train's inertia at the escape wheel (−0.3 % before), and as a drive −3.74° of swing (−17.6 to +7.2 over the starts), −0.170 s a day.
- **Winding.** Put on at 24 h, the maintaining ratchet falls back 1.5° onto its detent (18 N on its face); the hand needs 370 mN·m. **Let go**, the fusee and barrel run up to half a click tooth free to the nearer click. Eased back (the hand's hold relaxed over 0.15 s) the click catches with **68 N** at most (138 MPa in the click wheel's tooth). Let go outright (the fingers off the paddle) it strikes with **297 N** (608 MPa: past brass's yield, as is the fusee wheel's teeth's 359 MPa), the maintaining spring is thrown 1.2° onto its bank and the blow reaches the locking stone (0.1 N against 0.011 running: the tooth's pressure draws the detent in), and the chain goes slack and snatches at 126 N (3.2 times under its rivets' strength). Over every estimate the blow rests on (the click's face 0.25-2 times, the contacts' damping 2-20 %, the bank 0.25-4 times, the chain 120-700 N/mm) it lies at 201-488 N: at or past the tooth's yield. The blows at the strokes' ends are few on each tooth (about 2,300 in 30 years: a wind's 3.7 turns in half-turn strokes over 35 teeth), so they are judged against yield (low-cycle), not against the endurance the running load is (`wempe_strength.js`). The tool reports the outright let-go as a warning (`~~`): a key is let back, not let go.
- **The stop.** Wound into it at a turn a second, the bar meets its pin with 35 N; held there by a strong hand (1.06 N·m), 49 N, the hand's torque less the spring's on the fusee. `wempe_strength.js` adds the two (104 N), on the safe side.
- **The motion work and up-and-down work.** The hour hand's play against the minute hand 1.1-1.3 minutes; the up-and-down hand's 0.46-0.51°, about 5 minutes of its 56-hour scale. The cannon pinion's fit must lie between 3.0 mN·m (a 45 g knock turning the hands on it: the minute hand's unbalance, 0.56 g 11.4 mm off its axis) and 94 mN·m (setting the hands forward fully wound until the balance swings to makeEsc's TRIP); the model takes the middle, 16.9.

## The physics pass (19 October 2026)

PLAN-wempe-estimates.md's "one physics pass", built in one go after the hook block and the mainspring's re-solve (3.17.00), each change the user's choice; every figure in the sections above that moved with it is updated, the old one kept beside it.

- **The lock re-laid (D).** 05 04_1 scaled again against the wheel's tips Ø 14.00 (24.47 px/mm, the impulse roller's 6.77 against its written 6.78) puts the locking stone 7.14 ±0.04 from the wheel's centre and 37.0 ±0.3° on from the line of centres (7.2 and 36.5° before, 24.4 px/mm): the tips lock **0.235 deep** (0.175), where Belyakov gives Lange's MX 0.22 and the Navy's 1958 repair book sets 0.20-0.25. The lock 12.9° of the balance (9.9°), let-off 1.5° (1.9°), overall 22.9° (17.1°), roller shake 0.011 mm (0.046); the discharge stone's reach follows (1.563 from the staff, lifting the stone 0.305: 0.07 past the lock). The deeper lock costs about 8° of swing. Isolated beside 05 04_1 the locked tip reaches about a third of the stone's width into it on both (moderately sure). The drawn detent's turn against makeEsc's lift is now judged as a lead in the balance's angle, under 0.25° (0.19° here, 0.10° at 0.175): where makeEsc meets the gold spring is 3° earlier, and the lead is largest there.
- **The train's efficiency (B.5): 0.780** (0.730-0.833), the pivots by the rule as before and each mesh's tooth-by-tooth torque ratio from gearing.js at mu 0.10 and 0.20 (`MESH` in escphys.js; `wempe_physics.js` fails if it is stale), against the rule of thumb's 0.749 (0.661-0.848): about +2° of swing.
- **The gold spring (B.4): 98 GPa and 11.6 g/cm³**, Au/Ag/Cu 333-333, the alloy Poljot 20027's passport gives the 6MX's (05 04 01-2 says only "Goldblech 333": likely; 90 GPa and 11.0 estimated before). The detent about its flexure weighs 8.49 g·mm² (8.35), the 6MX's 8.28 (8.13).
- **The preload: 0.8 g at the stone** (0.63 g, the Hamilton's after Op. 78, before). With the deeper lock the discharge stone's longer reach bends the gold spring 0.39 mm on the return, and at 0.63 g a held tooth's stone rang 132 µm, 56 % of the depth of lock, past the margin of half; it falls under half from 0.78 g (`wempe_tripping.js`). At 0.9 g (tried first) the stone, falling home, catches the escaping tooth's back during the impulse in 7 beats of 12 (from about 0.85 g), and dynamics.js's plastic landing passes that blow through the wheel into the balance (+0.47 µJ a beat), where makeEsc has no such term and the tripping frame's elastic stone, hopping on the tooth, never catches it: the three parted by 1.4° of swing. At 0.8 g it never happens and they agree (the swing within 0.1°). A held tooth's stone rings 116 µm, 49.3 % of the lock; a 3 ms blow of 25.6 g lets a tooth go; teeth get past at 0.2 times and under.
- **TF 111 s** (108 s): the deeper lock and the preload lowered the swing, and the 6MX video's fit (`wempe_startup.js`) at the model's own swing moved to 114 s; refitted to where they agree, as on 15 October 2026: 111 s (108-114) at 194.3°.
- **The result**: the swing **194.3° at 12 h**, **188.5-199.5° over the wind** (197.2° and 191.9-202.0° before), the rate −0.26 to +0.20 s a day against 12 h; the guard band 180-270°, 14° under the reference (185° under 199.4° before); the 6MX's own escapement 186.7-197.5° (`wempe_6mx.js`). The balance nets 20.67 µJ of the escape wheel's 36.05 an oscillation (57 %): the strike 10.4 % of the impulse, the unlocking 26.1 % (the detent's spring and preload 9.7 %). The sources' 225° wants Q 1,035 (TF 165 s) at the model's drive.
- **The lock's window, 0.232-0.247 mm** (0.154-0.188 before): it unlocks only to 0.247, and the margin's floor is twice the held tooth's 116 µm. The drawn 0.235 lies 3 µm over the floor, so the bench aims the banking at the window's middle, 0.239 (the drawn depth before), and sets it again until it reads inside (`wempe_bench.js`, `wempe_montecarlo.js`: 100 % work after the bench, 2.4 % as made). The preload's window 0.78-1.56 g (the margin's floor over the knock's 0.64 g).
- **Checks between the models, each widened by the user** (19 October 2026), with why: the tripping frame's detent home within 0.6° of dynamics.js's (0.5°; the frame's gold spring, flexible even as the check's rigid detent, slaps the horn as the stone lands and it hops 6.8 times on the tooth a beat, coming home 0.54° after dynamics.js's plastic, once-landed stone); dynamics.js's isochronism within 0.2 s a day of makeEsc's (0.1; 0.14 apart at TF 108 s, 0.00 at 111 s, from the last degree of the stone's ride overlapping the impulse); `wempe_transmission.js`'s coupled beat within 8° and 0.5 s a day as a drive (3° and 0.3): with the stone pressed harder on the tooth it let go through the chase, the train's meshes give back more than a rigid train would, an impulse's work +3.8 % (+2.1 % before), as a drive +4.6°, so **the rigid train makeEsc, dynamics.js and the page take reads the swing low by about that** (open: Unresolved). Two more, the owner's choice, 27 October 2026, when the detent's blade was built flush toward its block (Readings corrected): `dynamics.js --model wempe`'s isochronism within 0.3 s a day of makeEsc's (0.2; +0.29 since: makeEsc's swing at full wind held on a step of the stone's hops, 201° where in time 204°) and `wempe_tripping.js`'s frame's swing within 1.25° of dynamics.js's (1°; 1.07-1.22° over the estimates tried, 0.87° with the blade centred): the stone hops along the escaping tooth's back through the impulse, and whether a hop lands again flips with the swing, the work rough by about 3 % (`tools/wempe_cliff.js`).

## The build: a Wempe to navigate by (19 October 2026)

The user's objective: a working Wempe, made from the model, that a navigator could rely on: about 2 miles of longitude a month (8 s at 30 days). Each choice below was the user's, after a consultation on what it implies (PLAN-wempe-navigation.md). There are two builds, and the maker chooses: **the 1940s build** (`js/escapement.js`'s `BUILD40`; `MC_WREV=build40` for every Wempe tool) keeps to the Einheits-Chronometer's own decade, and **the 1950s build** (`BUILD`; `MC_WREV=build`) takes a mainspring alloy patented in 1948, as the Hamilton's build does (deviations.js). The drawn versions are unchanged.

- **What was wrong for a navigator, as drawn.** The balance swings 191-200° over the wind (Physics), under the sources' 225-270°: little margin as the oil ages. The depth of lock has a window of 15 µm (Building it), too fine to set and to keep as the stone and teeth wear. Set as the 6MX passports show adjusters set the masses (±0.45°), the chronometer carries 17 s (4.3 miles) after 30 days at sea, most of it the temperature's residual.
- **The gold spring, both builds: thinned to 0.06 over its first 3 mm from its bending point.** Belyakov (1957, Table 3) gives Lange's MX 0.06 at its bend; 05 04 01-2's 0.15 is taken as the blank (no photograph resolves the strip's thickness: every view of Wempe 3955's and the 6MX's detents shows part of its 1.0 height, at 21-31 px/mm). `tools/wempe_detent_study.js` worked the window against the gold spring, the preload (0.8, 1.0, 1.2 g) and the discharge stone's reach (as drawn, +0.03, +0.06) at both drives: the stiff strip, sprung back onto the horn after the discharge stone passes on the return, sets the held tooth's stone ringing (113-116 µm); thinned at its root it rings 44 µm and the window opens to 196 µm at the 1950s build's drive (0.089-0.285), 151 µm thinned over 1 mm, 219 µm over 4. A longer reach always narrows it (the spring bent further); more preload widens it a little, but past about 0.85 g the stone catches the escaping tooth's back (the physics pass), so the preload stays 0.8 g. makeEsc takes the thinned strip as the uniform one of the same tip stiffness, 0.0702; the tripping frame draws it thinned (`tsBend`, `WESC.GBEND`). The one detent seen being made on video (a GUB's, Ldzmn4kuKMA 3:09-3:29, "Grinding the spring of the detent") thins the detent spring just past the foot, not the gold spring, so no video measures this thinning: it stays an estimate (the video review, 27 October 2026).
- **The drive.** The 1950s build: 1.26 times 05 06_20's (the Soviet Navy's 1958 MX repair book's mainspring, 1.01-1.08 N·m fully wound against the model's 0.83), from **Nivaflex 45/5, 0.393 × 15 × 1,240 mm, its free curve set ×0.8** (`wempe_mainspring.py --t 0.393 --set 0.8`: 536-1,074 mN·m, 1.257 times the drawn strip's solved at the fusee arbor, where 1.26 times the measured asks 1.256: the measured level is 0.997 of the drawn strip's solved since 26 October 2026, its free curve at ×0.75; 1.119 against 1.122 with it at ×0.6 until then). Its inner coils carry 2.88-2.96 GPa fully wound on its 3.0 (along the strip: `motion3d_springs.py`, the 3D viewer's reading, and `wempe_build_spring.py`, which smooth and take full wind a little differently). Until 19 October 2026 the build took 0.377 at set ×0.6, which gave the same drive and an even one (7.6 % over the wind against the drawn 7.4 %), but the 3D analysis found its inner coils at 3.25 GPa, past the alloy: its 2.94 GPa had been the strip's mean, 6M / b t² (`docs/motion-3d/`). No set of the 0.377 strip gives both the drive and the stress (×0.8: 0.99 of the drive; ×1.0: 0.84), so the strip is thicker. Its drive is less even than the drawn strip's frictionless solve (12.2 %): strong fully wound, weaker run down. The escapement takes it turn by turn against 05 06_20's measured drive (`tools/wempe_build_drive.json`, `wempe_load.js`: the strip over the drawn strip's solved at the measured level, 1.253-1.281 since 26 October 2026, the two solved at nearly the same set, against 1.13-1.31 with the drawn at ×0.6), and the swing runs 226.0-237.2° over the wind (214.8-239.5° until 26 October 2026; 227-236° with the even 0.377 strip), with the 30-day error unchanged (5.8 s). Fully wound it gives 1.6 % over the drive (3.5 % until 26 October 2026), inside the ±3.8 % its own thickness tolerance (±0.005 mm) moves its torque; `wempe_physics.js` allows 4 %. Its room past full wind to coil-bound is 0.48 turn (the even strip's 0.93). No carbon strip gives the drive: 0.385 gives the torque at 2.89 GPa, past steel's 2.5-2.6, and the drawn 0.37 as solved is at it already, 2.46 GPa (Physics: energy). The 1940s build keeps the drawings' drive and strip. At 12 h the 1950s build swings 230.3° (231.6° until 26 October 2026), the 1940s build 202.9° (the gold spring's lost work on the return mostly saved).
- **The maintaining spring, banked** (the 1950s build): from 1.07 times the drawings' drive its ring closes onto its banking while running, as the Hamilton's does by design; while the key turns it pushes 381 mN·m and keeps the train going 11.4 min (`wempe_sustaining.js`), stressed 884 MPa (margin 1.4-2.0).
- **Winding: let the key back**, both builds (the user's choice, 19 October 2026). Let go outright at the end of a stroke, the fusee runs forward onto its click; the blow dents the click's nose and the click wheel's tooth where they meet, and the maintaining detent's blow on the maintaining ratchet bends the ratchet's brass teeth (about 500 MPa by `wempe_ratchets.js`'s beam, past brass's 300-450). Let back, as a key is meant to be, every part stays within its limit (the 3D analysis, `docs/motion-3d/`; the Wempe report's section 13). No fix a maker could make keeps every part within its material let go outright (`wempe_letgo_fix.js`: more clicks, a brake, a cushioned face), so the builds keep the drawn brass ratchet and the instruction: turn the key to the end of each stroke, hold it, and let it back.
- **Endshake**, both builds and the bench: the 1958 repair book's figures (Building it).
- **The temperature adjustment**, both builds: the masses set to ±0.1° on further rounds of the trial (27 µm along the rim): 6.2 s (1.5 miles) after 30 days (`wempe_errorbudget.js`).
- **Checked** (`tools/wempe_build.js`, both builds: the swing over the wind, the lock's window, running in time, pushed, knocked, the energy, strength, the maintaining spring and the voyage). makeEsc, `dynamics.js` and the tripping frame agree on every build's swing within 0.3°. Three of the drawn version's cross-checks fail on the thinned gold spring, each on detail of the detent's motion they calibrate on the drawn detent: makeEsc's turn leads the drawn layout's by 1.49° of the balance (`wempe_escapement.js`), the detent's ride down the tooth's back is home 1.4° earlier in time than makeEsc has it (`dynamics.js`), and the hinged frame's first mode is 78.4 Hz against 81.8 (`tripping.js`, the floppy gold spring left flexible); the builds are judged by `wempe_build.js` instead.

## Navigating by it (25 October 2026)

`tools/wempe_navigation.js` follows the whole chain from a made chronometer to the ship's position: the verification report's section 21.

- **The made chronometer.** 2,000 a version, as `wempe_montecarlo.js` makes them after the bench: each one's swing is drawn from its file's 5-50-95 % after the bench, and it sets how much the oil's thickening moves that chronometer's rate (makeEsc's rate at its own swing). Each version is adjusted as the trial would adjust it. As last revised, the masses are set within ±0.45° of their compensating place (`wempe_errorbudget.js`: the 6MX passports' spread of C). The two builds are set within ±0.1° on further rounds of the trial (`wempe_bench.js`).
- **The voyage and the navigator.** Each one is rated over ten days in port and carried sixty days to sea, through `wempe_errorbudget.js`'s own voyage. The voyage runs from a winter port into the tropics over twenty days, with the scatter and drift calibrated on the 6MX's test cards, the barometer, the oil, and heavy weather one day in five. The navigator carries the rated rate, as `rating.py`'s backtest does. `wempe_errorbudget.js` exports that voyage (`nav()`), and its own output is unchanged.
- **The position.** 4 s of time are 1′ of longitude, cos(latitude) nautical miles. The route is estimated, from 45° N to 15° N by day 20. The fix's own error is Bowditch's probable error of a celestial fix, ±2 miles (*The American Practical Navigator*, Pub. No. 9, 2019, Vol. 2, Ch. 3, "Navigational Errors"), taken as a circular normal.
- **The criterion,** stated before the results: after 30 days, the chronometer's longitude error at the equator is under 2 miles in the median (the fix's probable error, and the user's aim of about two miles a month) and under the fix's own 95 % radius, 4.16 miles, in 19 voyages of 20. Each figure is a sample of 2,000 voyages, so each half is judged with its sampling error (the user's choice, 25 October 2026): 1,000 bootstrap resamples of the voyages (seeded) give each figure's 95 % interval, and a half fails only if that whole interval is over its limit; a figure over its limit whose interval still reaches it passes within sampling, and one whose interval misses it by under 1 % of the limit is on the line (`~~`, reported, not failed: the owner's choice, 26 October 2026). The limits are unchanged. The 1950s build must not fail; the tool exits 1 if it does, or if `tools/navigation_wempe.json` is stale.
- **An independent pass** (26 October 2026, the report's section 22): every build and navigation analysis read again against the per-part audit's changes, its criteria against their sources and what it assumes of a maker. Stale copies fixed: the bench's detent ring test and the Monte Carlo took the tapered detent spring as 0.07 mm, not its uniform equivalent 0.0792 (the bench's band 69-137 Hz, not 83-164); `wempe_train.js`'s escape pinion face 3, now 4.0; the video's damping refitted on today's escapement, TF 114.4 s (111-118), the model keeping 111 s (the owner's choice), its check then within the fit's range (the fit has since moved to 141 s: above, "A running 6MX on video"). The TU trial's limits and the 1958 book's endshake bands match their sources; the swing's guard band (180°) is looser than the sources' 225°, and says so; Bowditch's 2 miles is read as the fix's median radius, the lenient reading: read as its 95 % radius or along the parallel alone, every version fails (reported beside the verdict, the owner's choice). **Verdict:** every version can be made and put together; as drawn it fails as a navigator's clock (4.2 miles a month), mostly on its masses' setting; the 1950s build passes within sampling and the 1940s build is on the line at 95 % (since the error budget's calibration was steadied and makeEsc counts the stone's blow, 26 October 2026), both resting on the masses holding ±0.1° and on drift that a ten-day rating can't see.
- **Results** (2,000 voyages, the tool's seed; since 26 October 2026 the error budget's scatter and drift calibrated on common random numbers, 4,000 trials, the drift 11.6-11.95 ms a day over seeds: before, each bisection step drew fresh trials and the drift landed anywhere in 10.7-12.3, the 10.85 the figures below replaced being near its bottom), the longitude error at the equator after 30 days, median and 95 %:
  - as last revised: 4.12 (interval 3.96-4.33) and 8.91 (8.69-9.11) miles. It fails: the masses' setting on the trial leaves too much temperature error.
  - the 1940s build: 1.53 (1.47-1.61) and 4.330 (4.162-4.424) miles: on the line, its interval missing the limit by 0.004 mile.
  - the 1950s build: 1.55 (1.48-1.63) and 4.325 (4.155-4.441) miles: passes within sampling (on the line at 4.343, 4.160-4.447, before makeEsc counted the stone's blow on the escaping tooth's back, RWD, 26 October 2026; it passed at 4.150 and 4.159 on the error budget's old calibration's luckier draws; the drawings check's heavier balance itself moved neither figure).
  - as last revised with the builds' setting of the masses (±0.1°; reported, 26 October 2026): 1.56 (1.48-1.63) and 4.33 (4.17-4.49) miles, on the line: the median passes, the 95 % fails. So the drawn version fails mostly on its masses' setting, not its swing; the swing (193°) leaves the last 0.3 mile at 95 %.

  Both builds are well inside the median and on the line at 95 %: the 1950s build's interval reaches the limit (4.155 against 4.158), the 1940s build's misses it by 0.004 mile, under the 1 % the owner allows as on the line; neither has a margin there, both resting on the masses holding ±0.1° and on drift a ten-day rating can't see.
  With the fix's error added, the 1950s build's position a month out is within 2.54 miles in the median and 5.69 in 19 of 20; after 60 days the clock alone is 4.70 and 13.06.
  The two builds' figures nearly coincide: they differ in the drive and the swing, which the rating takes out, not in what moves the rate at sea (temperature, scatter, drift).

## The page's escapement (15 October 2026)

Until 15 October 2026 the 3D model moved its escapement as the layout draws it (`ESC.layout`, kinematic, timed from 05 04_1: the tooth on the impulse stone at once, 21° before the line of centres, the detent let fall the moment the gold spring slipped off). Now the page moves it as makeEsc solves it (`WPHYS.ESC`, the Physics sections above), as the Hamilton's page moves its own: `app.js` asks `ESC.state(phase, swing, drive)` each frame with the live swing (`H.amp`) and drive (`drv`: the fusee's torque at that wind, or the maintaining spring's while the key turns), and `WESC.adapt` (js/escapement.js) turns makeEsc's state into the drawing's terms:

- **The escape wheel** follows makeEsc's progress: locked until the release (+2.6° of the balance at 12 h; −2.4° before 16 October 2026's reading of 05 04_1's angles), let go from rest and chasing the impulse stone (12.3° of swing), striking it at 14.9° (the stone's face 13.3° before the line of centres, not the layout's 22°10'), driving it to 50.0°, then running on to the next tooth's lock at 49.2°.
- **The detent** turns about its spring's bending point, 05 04_1's mark 12.52 from the stone (the spring's middle, 12.88, until 28 October 2026), by makeEsc's lift (`toKin`: its gold spring's tip's travel over its length from the flexure; `tools/wempe_escapement.js` checks the frames to 1e-9): lifted by the discharge stone from −12.3°, flung up off the stone's square corner at −1.8°, falling back onto the tooth it has just let go at 0.8° and riding its land and back (the stone's least lift over the tooth, makeEsc's `ride`) until it is home on its banking at 9.9°.
- **The gold spring** is bent on the return swing by makeEsc's travel at its tip, turned about its bending point (its square end 11.2 from it; the stone reaches 0.02 past its tip, so it meets it there), from −5.9° to −17.6°.
- **The balance** swings through the beat as the solved work drives it: each push makeEsc solves (`pushes`: the strike and the drive, the stone's draw, the detent's springs and blows, the gold spring on the return) changes its energy where it acts, the air's and pivots' loss spread as a viscous one, scaled so the beat closes on itself. That scale comes out 1.003 times the free run-down's (makeEsc's swing is where its work and its losses balance, which it solves), the swing at the turn before the impulse 206.76° and after it 207.27°: the impulse raises the swing about 0.5 % (about 1°), its speed with it, and the balance departs from a sine by 0.5° at most. Every state is makeEsc's at the balance's angle (the sine's phase that gives it), so the parts stand exactly where makeEsc puts them for the balance as drawn; the chase's and the detent's fall's time is counted on that sine, 0.01 % from the beat's own length (0.50005 s).
- **Held** (run down, or a swing under makeEsc's AMIN, 45.8°): the wheel stays locked, the balance swings as a sine, the discharge stone still lifts the detent (which falls as makeEsc's) and bends the gold spring on the return.

Drawn, makeEsc's contacts are kept 0.01 apart as the layout kept them, for the tools: the wheel stands 0.01 behind makeEsc's at the tooth's tip (its locked tooth 0.01 short of the stone's flat, as built), the detent 0.01 higher (at the gold spring's tip) while the discharge stone carries it or the stone rides a tooth, the gold spring 0.01 further bent. The ride is taken where the tooth is drawn: makeEsc's own ride, with the wheel 0.01 behind, would put the stone 6.6 µm into the escaping tooth's back. `tools/wempe_escapement.js` checks all of it (the beat, the frames, the drawn detent against the layout's own geometry within 2 µm at the stone, the drawn stone never inside the drawn tooth over eight swings and drives, the train held); `fine.py --model wempe` checks the parts in 3D at the solved phases (`checks.py`'s `PH`: the unlocking, the release, the detent's fall and ride, the chase, the strike, the drive, the run on, the lock, the return pass) and, with `--dense`, at 101 more.

The case and its gimbals weighed and run in a seaway, and the chronometer as the model's numbers make it run through the 6MX's TU trial and carried to sea. The tools: `massprops.py --model wempe` (the browser, about 15 s; `--write` writes `tools/gimbals_wempe.json`), `gimbals.js --model wempe` (about 4 minutes; `--quick` 12 s: its report is `tools/wempe_gimbals.js`'s) and `tools/wempe_errorbudget.js` (about 10 s). The Hamilton's runs are unchanged (massprops.py finds its `gimbals.json` up to date, which isn't rewritten; gimbals.js --quick prints the same).

- **The bodies**, every closed solid at its material's density (as `wempe_inertia.py`'s: brass Ms 58 8.45, steel 7.85, the rim's nickel steel 8.1, the impulse roller's beryllium copper 8.25, the gold spring 11.6; the dial Messingblech, 05 02 00-4), with the movement in the bowl (the Case view): the bowl with the movement in it **2,516 g** (the bowl, brass as R-05 01 00-1's "Ms-Sandguß", 1,195 g; the bezel and glass 327; the closing plate 79; the movement with its ring and dial 916), the gimbal ring with its bracket, pivot screws and nuts **334 g**: 2.85 kg in the gimbals (the 6MX's TU allows its chronometer 2.2 kg). Figures of 24 October 2026, the bowl's rim threaded and cut round the movement ring's flange (How the case and box were measured, The bowl).
- **The sheet's "Gewicht 350 gr."** The bowl's drawn solid is 141.5 cm³: 1,195 g in brass; 350 g is 2.47 g/cm³, no brass (aluminium would weigh 382 g, Bakelite 194, hard Buna rubber 167). The drawn pivots don't decide the material: a light bowl hangs on them too, the case's centre of gravity 6.82 mm under the pivots with a Bakelite bowl (1,514 g, a period of 0.86 s), 6.49 with Buna (1,488 g, 0.87 s), 8.81 with aluminium (1,703 g, 0.78 s), 8.50 at the sheet's 350 g (1,671 g, 0.79 s). The model's bowl is brass, as the sheet's material says. (Until 21 October 2026, the pivots 11.5 under the bowl's top, a light bowl's centre of gravity came over them and it turned over.)
- **Levelled as 05 01 says.** As drawn the case's centre of gravity lies 13.99 mm under the gimbal centre and 0.93 mm across its pivots' line (it would hang 3.8° out of level), the ring and case together 0.49 mm along the ring's (2.3°). 05 01: "Kloben verstellen bis Gleichgewicht erreicht ist": the brackets are moved in their slots by those amounts until it hangs level, and the tool does so (the Hamilton's drawn pivots are 7.8 mm off theirs, levelled the same way by its manual).
- **The periods.** Levelled, the case swings on its pivots (12-6) with a period of **0.67 s** and the ring, carrying it, on its own (3-9) **0.75 s** (the Hamilton's 0.58 and 0.65, its centre of gravity 14.7 mm under its pivots against the Wempe's 14.0; 0.65, 0.75 and 10.4 until its pivots were raised, 25 October 2026); the case's radius of gyration about its pivots 40 mm. Both far below a ship's roll (10-30 s) and 34 % clear of the balance's beat. Driven by a regular roll the case leans from the apparent vertical 0.003 of the roll at 20 s, 0.008 at 8 s, 0.02 at 4 s, 0.6 at its own period, 0.10 at 0.5 s; the balance's beat, out of poise by 2 µm (estimated), swings the case 0.24 seconds of arc.
- **The stops.** The box stops neither gimbal within 60° either way: the ring and case reach 76.9 mm from the ring's axis in the box's 160 inside (76.2 until the ring was thickened to 05 01's 4.0, 25 October 2026), and the transit lock's lever, drawn turned off along the front wall, is clear (the stops' test confirms a point in an obstacle's bounding box inside the solid itself, `__mpExact`: the lever lies diagonally in its box, which the bounding box alone took for a stop at 3.5°). In its ring the case turns to any angle: no point of the bowl's own parts comes within the ring's band (the 1942 casting's foot passes 0.16 inside it, the case brackets' bosses end at r 64.3; the slot through the band isn't counted). From 24 to 25 October 2026 it met the band at 55.5° either way: the case brackets' blocks, scaled by eye to 27.7 under the pivots at r 66.5, swung into it, so the bowl couldn't be turned over to be wound (the locking bracket's pad, 2.5 short of the ring, until 24 October 2026). Until the locking bracket was measured (above, How the case and box were measured) its estimated pad, hanging 12.5 under the pivots' line, met the ring at 8.5° one way, which a moderate sea reached.
- **At sea** (gimbals.js's seas, periods and NORDFORSK's 0.12 g limit; in its installation, the case's pivots fore and aft so the case takes the roll, and turned a quarter): in the seas a ship works the case keeps within 0.40° of the apparent vertical (9.8° of the true) and meets neither its ring nor the box (at the NORDFORSK limit it turns up to 24.6° in its ring, 13.1° with the box turned); the escapement feels at most 9.4 mg across its staff (169 mg in a small vessel's rough sea). In a storm (rolls to 35-45°) the case turns to 57.4° in its ring and swings onto the locking bracket's pad once in the ten minutes (23.6° with the box turned a quarter); a case swung onto the pad passes nothing measurable to the balance. Every gimbals.js criterion holds, and ci.py runs the full run with --full.
- **What reaches the escapement**, through makeEsc's rate response alone (the Wempe has no escapement in time yet: phase 2d part 1, claude/wempe-dynamics, isn't merged): the specific force across the staff loads the balance's pivots (Ø 0.21, mu 0.15: estimated), 0.05 g steadily costing 5.1° of swing and 0.24 s a day; the case's turn about the staff sets the balance's centre of swing off its spring's rest by −a/ω² (a beat error: +0.32 s a day a degree, makeEsc with the rollers turned), averaging out to the first order. In the working seas the rate moves at most 0.006 s a day. The detent's trip: its preload (0.63 g at the stone, 12.87 mm from the flexure: the Hamilton's, estimated) against its own weight (94.9 mg, 8.37 mm from the flexure since 15 October 2026; 93.6 mg, 8.26 before) wants 10.5 g across it (static, the draw left out: a lower bound), 24 times what the roughest sea passes on.
- **The TU's trial** (wempe_errorbudget.js: 35 days at 36/20/4/20/36 °C, the first two days of each period not counted, wound daily to "8" and to "0" at each period's end, rates read to 0.01 s; the TU's E, R, D, C, S, each period's mean and N = 42E + 4.5R + 60C + 2.4S). Each day's rate: the temperature curve (wempe_thermal.js: the masses set by the adjuster at their compensating place, 20.5° from the cuts' line, to ±0.45°, so C within ±0.10, its spread the 6MX passports' adjusted C, sd 0.060; the integral balance's S +0.74 to +0.89 s), the air's density with temperature (it takes 57 % of the damping: 5.8 % denser at 4 °C, −0.12 s a day; the masses null its linear part with the rest), the swing over the wind (wound to "8" the spring runs 8 to 32 h down, 208.6-204.7°, −0.02 to +0.03 s a day: the same every day, and the full winds fall on uncounted days), the scatter and drift (calibrated on eight 6MX test cards, 1953-1993, `documents/6MX-figures.md`: the trial's median E made theirs, 0.225, and its median |R|, 0.26: 0.31 s a day and ±12 ms a day each day; the Hamilton's No. 3390 card's 0.042 and ±2.7 until 18 October 2026; the trial's median D 0.92, N 16 and largest period mean 1.79 then fall within the cards', 0.58-1.29, 12-25 and 0.81-1.90), the barometer and the oil (the Hamilton's estimates through makeEsc: −0.020 s a day for 1 % denser air, +0.035 for 1 % of the drive lost), the regulation at 20 °C ±0.5 s a day (estimated). **As adjusted it passes 95.3 % of its trials** (18 October 2026, with the 6MX cards' scatter: median E 0.224, R +0.01, D 0.92, C −0.003 (0.099 at 95 %), S +0.83, the largest period mean 1.79 s, N 16.0 (20.5 at 95 %), against ±0.35, ±2.00, ±2.30, ±0.10, ±1.20, ±3.50 and 30, as the cards' figures fall; its scatter and drift could be 1.5 times the cards' before it passed only half its trials. With the Hamilton's card it passed every trial, N 4.8: a fifth of the 6MX passports' 12-16). **At the masses' drawn place** (30° from the cuts' line, Wempe 3955's) it loses 2.3 s a day a °C: C +2.33, N 143, every trial failed (32° and 3.0 until 15 October 2026); the adjuster moves them 10° along the rim toward the cuts, about one and a half of the rim's 6° divisions ("8 Körner in 60 Teilung", read as eight punch marks of a 60-division).
- **At sea** (errorbudget.js's voyage: 60 days from a port at 12.8 °C into the tropics at 29.4 °C, rated over 10 days in port; heavy weather one day in five as the gimbals pass it on, a sea beyond NORDFORSK's limit: 2.3 mg across the staff, −0.011 s a day): as adjusted it carries **2.2 s after 10 days, 17.2 s (4.3 miles of longitude) after 30, 44.5 s (11.1 miles) after 60** (median; 95 % 6.0, 37.8, 101.7 s; 1.1, 9.5, 24.5 s with the Hamilton's scatter and the masses to ±0.25°, before 18 October 2026). Most of it is the masses' setting (±0.45°: the residual C over the voyage's 17 °C); ±0.1° would leave two fifths of it. The masses at their drawn place would carry 13 minutes in a month. **The build** (the user's aim, 19 October 2026: about 2 miles of longitude a month) sets the masses to ±0.1° on further 4 °C and 36 °C rounds after the trial (`wempe_bench.js`'s trial test: 27 µm along the rim at r 15.70, both of a pair alike; a round measures C to about ±0.005 s a day a °C, ±0.02° of the masses): it carries **6.2 s (1.5 miles) after 30 days, 19.4 s (4.9 miles) after 60** (median; 95 % 17.8 and 55.0 s), the temperature curve's share falling from 15.8 to 3.7 s at 30 days; drift (5.0 s) and scatter (2.3 s), the 6MX cards', are then the larger part, and only workmanship moves them. `wempe_errorbudget.js` fails if the build carries more than 8 s at 30 days.

## The page's time, ship motion and reports (15 October 2026)

For the full release (3.00.00) the page gained what the Hamilton's has for keeping and showing time at sea, each reusing the Hamilton's code where it applies:

- **Time** (`js/app.js`): Set the hands, Now, and Keep GMT or local time. GMT is the default, as a ship's chronometers are kept for navigation (until now the page kept local time). Setting never turns the train (RESOLVED.md, "Setting the time turned the train"): the hour and minute hands go to the minute by the cannon pinion's slip on the centre arbor (`slip`, seconds of time; `dial.js`'s `update` turns the motion work and both hands by it, not the centre arbor, the fusee or the train), leaving the dial fast by under a minute; the balance is then stopped and the train held until the time the hands should read comes round to the dial's, and a twist (the Twist button's) starts it. Run down, only the minutes are set. The link keeps `tz=local` and `t=HH:MM:SS` (a time in the link puts the train there before the model shows, as the Hamilton's does: the fusee and dial are stateless in the centre's angle). The Hamilton's With the key and Stop to set follow its manual's Sec. III; no Wempe source in the set gives its procedure, so the Wempe has the simpler setting alone.
- **Ship motion** (Display, Motion: Ship motion, Transit lock, Roll period): the ship rolls and pitches, the case hanging in its gimbals leans toward the apparent vertical. Drawn with the apparent vertical up (18 October 2026, as the Hamilton's), as a plumb line hung beside the box would show down (`gwStep`'s `ap`, `ar`): the bowl, hanging along it, stays put and the box rolls and pitches round it; locked, the bowl goes with the box. The export's At sea clip is drawn the same way. Until 16 October the box rolled in the true vertical's frame and the bowl leaned in it, so both seemed to move; then until 18 October the box stood still, the camera riding with the ship, and the movement swung in it. The equations are box.js's `GIM.sea` and `gimStep`, copied into app.js (`GW`, `gwStep`) with the Wempe's own figures from `tools/gimbals.js --model wempe` (the weighed bowl and ring, levelled): the bowl on its 12-6 pivots 0.654 s, the ring on its 3-9 pivots 0.721 s (0.958 and 1.046 until 21 October 2026, when the bowl hung 6.2 higher), and no stop within 60°. The transit lock turned in holds both gimbals level with the box, its lever turning in through the ring's slot into the bowl's bracket once they are level (since 24 October 2026; not turned until then); turned over to wind, the bowl is held the same way, the lever first turned out. The Hamilton's Jolt the box, which shows its detent setting or tripping, has no counterpart: `tripping.js --model wempe` gives the Wempe's figures in the report, not on the page.
- **Report a bug or inaccuracy**: the Hamilton's `report.js` and dialog, its subject and its Inaccuracy hint given by `REPORT.bind({name, inacc})` (the drawings first, then photographs and videos of real ones); from the panel, a part's card and the essay's end.
- **Link preview**: `site-assets/social-wempe.png` (`tools/social.py wempe`: the Case view at 10:09:36), the Wempe page's `og:image` (build.py).

## The page's capabilities against the Hamilton's (16 October 2026)

The Hamilton's page has controls the Wempe's lacked; these were ported, each from the Hamilton's `app.js`, the generic parts into `../shared/viewer.js` (which only the Wempe's page uses: the Hamilton keeps its own copy) and the Wempe's own figures into `js/app.js`:

- **Moving parts only** (View; `drive=1` in the link): the viewer's `cfg.drive` hides the frame (the plates, pillars, ring, cocks, bridges and bushes, the jewels' settings and endstones), the dial and the case, draws the barrel see-through so the mainspring shows, and shows the motion work and hands only with **Include motion work and hands**; the views in the case (Dial, Box, Case, Transport box) give way to Movement, as the Hamilton's Box and Dial do. See-through now ghosts the pillars, cocks, bridges and ring with the plates, as the Hamilton's ghosts its bridges and cock.
- **The Train, Fusee and Balance views**, the Hamilton's, aimed at the Wempe's arbors (`WD.H`, `WESC.B`).
- **Winding as the Hamilton's** (26 October 2026; the owner's request, both pages winding alike, the Hamilton's Wind now turning its case over as this page's does): under Winding, **Wind with the key** lifts the movement out (the Movement view), its plates see-through and the parts that wind picked out, and turns the key half a turn at a time (0.7 s, a 0.3 s pause to change grip), 17½ half turns from run down (**From run down**, on), the camera closing in on the fusee's small end as the stop bar meets its pin, the key kept on 3 s; **Load path in colour** tints the parts carrying the train's load while winding (the maintaining spring driving, rose; the maintaining ratchet and its detent holding, teal) and for 2 s after the key lets go (the mainspring's path: barrel, chain, fusee, click wheel, clicks, ratchet, spring, fusee wheel), through the viewer's `cfg.tint`; **Close-up of the maintaining spring** (the Hamilton's sustaining spring's close-up, `#cu`, drawn after each frame through the viewer's `cfg.overlay` on its own camera): the fusee wheel's maintaining work seen from the top plate's side, the ratchet see-through, with the time the spring has left (the ratchet's lead `H.ms` at the wheel's turn, `WPHYS.WFW`; about 16 minutes from the running lead), zoom, pan, enlarge, slow motion, keep open (**Open the close-up**) and how the spring takes the load in its three phases (`?`). The Hamilton's ×20 exaggeration of the spring is left out: the Wempe's opens 16.7° at most, drawn as it is.
- **Tick sound** (Time, Sound; on by default, as the Hamilton's): a click each time the escape wheel's place passes a half tooth, its tooth on the impulse stone, so once a beat, 0.5 s, at up to real time and none while the train is held; the audio starts with the first click, tap or key, as browsers ask.
- **Exploded: Movement or All** (25 October 2026; `exp=all` in the link): the Hamilton's Take apart switch, in `../shared/viewer.js` (`st.all`, its eased share `st.allK` for `cfg.tick`, a view's `all` camera): All takes the case apart too under the movement, up the bowl's axis (`case.js`'s `explode(e)`: the gimbal ring, the closing plate, the bowl with its brackets, the bezel with its glass; the transit lock and the key out to the right, the lid open and back off its hinges), the movement brought down to just over it. The outer transport box stays out (its own view). Its offsets are a view's layout, not measurements.
- **Exploded: Subassemblies, Together, Apart or each on its own, Pieces, and Isolate subassembly** (31 October 2026, the owner's; `subs=apart` or `subs=fusee,detent` in the link, `pcs=150` the Pieces slider; not the Hamilton's): the units the 1958 Soviet repair book takes out whole (`checks.py`'s `ASSEMBLY`, pp. 59-60: the fusee with its wheel, maintaining work, Vorreiber, stop work and cover plate; the barrel with its arbor, mainspring and set-up ratchet; the balance with its hairspring, stud and rollers; the detent with its block; the motion work), `movement.js`'s `ASM` (`mv.userData.asm`). Each chosen (or all, Apart) is taken apart beside the movement (the motion work and barrel to the left, the fusee, balance and detent to the right, the view standing back to its `sub` camera), its pieces spread along its arbor about 15 mm apart at the Pieces slider's 100 % (0-200 %) in the order they come off (`asmx(S, e, P)`, run by the viewer after `explode` and `develop`; the tools never run it, so the checks see the movement as before). With the fusee or the barrel apart, the chain comes off too, coiled flat on edge under the barrel, its turns 2.6 apart from r 8 (`fusee.js`'s `lay(s)`: each joint eased from where `update()` last laid it, the hooks kept on their end links). Isolate subassembly: the right-click (long-press) menu's *Isolate the fusee* on any of its parts or pieces, or the Parts list's Isolate row, shows one alone and closes the camera in on it. The places and spreads are a view's layout, not measurements.
- **Swing and isochronism** (its own panel; `mset=` in the link): the Hamilton's three charts, the swing over the last minute, the escapement's rate against the swing at a steady drive and the swing over a wind, from makeEsc with the Wempe's settings: a solve takes about 0.3 s in the page, so `tools/wempe_essaydata.js` solves 81 drives in Node (`WEDATA.swing`) and the page reads between them; the drive over the wind is 05 06_20's measured force through the train (`WPHYS.drv`), less the mainspring's set (the Hamilton's slider: the model's drive scaled). Its band is the sources' 225-270° (the 1954 instruction for chronometers in general), the tools' guard band's floor 185° dashed; it gives the swing's and the rate's range over the wind (194.1-204.2°, −0.06 to +0.03 s a day) and the rate's change between full wind and 24 h, the daily wind the 6MX's instruction asks for. Left out of it: the Hamilton's going-barrel comparison (a what-if: it would need the solved spring's torque taken through a train the Wempe hasn't, left for later), its isochronism check (the U.S. Navy's, Sec. IX: the TU has no such figure) and its sustaining spring's minutes (here 05 06_9's maintaining spring, about 70 s, which a 6 s wind hardly feels). **The banking screw** (27 October 2026, `bank=239` in the link, µm): a slider turns the screw that sets the depth of lock (the M1.2 across the block's upright, 0.25 mm a turn, its head where the detent's pipe rests), 0.150 to 0.250 mm, and the screw turns on the model in every version (the detent itself isn't moved: the depth changes by microns). The escapement is rebuilt at each depth by `tools/wempe_banking.js` (makeEsc with `dL`, the drawings' and the 6MX's, 33 depths at 11 drives, into `js/bankdata.js`, WBANK; about a minute), and the page reads between them as an offset on the drawn escapement's swing, least swing and rate: the swing the balance settles at follows it live (and the chart over a wind, the drawn banking dashed), the lock and let-off are measure()'s, and the readout judges the depth against the bench's window (`tolerances_wempe.json`: 0.2317 to 0.2437, its middle the bench's aim): shallower, a held tooth's stone rings over half the depth; deeper, the swing falls away over the wind; from 0.247 it won't unlock and the train stops.
- **Rate and timing weights** (`bal=tw:8,pl:19.5,T:4` in the link): the timing weights, in eighths of a turn in (a turn of both 44.2 s a day; as drawn against their screws' heads, so only in, to 1.875 turns: Building it), drawn moving along their screws (0.16 a turn); the masses' place along the rim (as drawn, 30°, or Compensated, where their coefficient nulls the air's linear part, as `wempe_errorbudget.js`'s adjusted chronometer has it), which isn't drawn (the rim is drilled for them at their drawn place only); and the temperature, 0-40 °C. The rate against temperature is the tool's day's rate without its scatter: the cut bimetallic balance's coefficient at that place (`WEDATA.heat`, `wempe_thermal.js`), the integral balance's secondary error at the middle of its range (estimated) and the air's density against 20 °C (`WEDATA.trial.airK`), with the TU's C and S for the curve. The model's clock runs at the escapement's rate and these, as the Hamilton's runs at its weights' and screws'. The Hamilton's balance screws and washers, verniers and Table IV have no Wempe counterpart (its masses are moved along the rim instead).
- **35-day trial** (the Hamilton's 30-day performance test): the 6MX's TU's trial, 36/20/4/20/36 °C, as `wempe_errorbudget.js` runs it, on its seeded trial's days (`WEDATA.trial.days`) with the masses' place and the weights' regulation put back, each period's daily rates and mean and the TU's E, R, D, C, S, largest period mean and N against its limits; beside them the tool's medians over 2,000 trials compensated and 500 at the drawn place (`WEDATA.trial.sum`, `summary()`), and how many pass. The page opens with the masses at their drawn place, where the trial fails on C (and so on the period means and N); under the result it says so and why (the model's estimated materials compensate at 19.5°, where an adjuster would move them on this trial), with a button that moves the masses to their compensating place and the timing weights back as drawn, so that it passes, and one back to the drawn place.
- **Escapement in plan** (the Hamilton's adjuster's bench's plan): `shared/escplan.js`'s `drawEscPlan` draws the Hamilton's parts (its detent, trip spring and rollers' shapes), not the Wempe's, so the panel draws the Wempe's as the essay's escapement figure does: the model's own pieces flattened onto the plan in the frame of what moves them, moved by the state the model shows (running, held or stepping fast), seen as 05 04_1 draws it, with a caption of what the escapement is doing; under it makeEsc's measure() at the model's settings (`tools/wempe_escapement.js`'s figures) beside 05 04_1's where the README gives them. Left out: the **adjuster's bench** itself. Its sliders rebuild the Hamilton's detent, jewels and roller from makeEsc's settings; the Wempe's parts are built from 05 04_1's layout and the parts' sheets (`js/escapement.js`), and `WESC.SET` is taken from them, so a setting moved would leave the drawn parts where the sheets put them, and the model would no longer be the drawings'.
- **The walkthrough** (How it works; `tour=N` in the link): the viewer's `cfg.TOUR` (the Hamilton's tour, lifted into `../shared/viewer.js` as the drive mode was), eight steps from the case to the dial: the case and gimbals (the ship's motion on), the frame, the going train (its ratios' table), the fusee and chain (05 06_20's pull over the fusee's turns, the chain's place marked), winding without stopping (a Wind button), the balance and hairspring, the spring detent escapement (the plan above, moving with the model) and the motion work and dial; each a view, a camera, the parts it singles out (the rest see-through), Moving parts only or not and a speed. Its text is from this README and the essay. The Hamilton's overhaul is the next item.
- **Overhaul** (3 November 2026; its own card under How it works; `ovh=d5` or `ovh=r12` in the link): the Hamilton's overhaul (its `js/overhaul.js`) on this page, `js/overhaul.js`, in the order the Soviet Navy's 1958 repair book gives for the MX (*Эксплуатация и ремонт измерителей времени*, pp. 59-60, "Порядок разборки и сборки": `References/wempe/documents/Ekspluatatsiya-i-remont-izmeritelei-vremeni-1958/p059.png`, `p060.png`), 20 steps taking it down and 18 putting it back, each part coming off or going on in its turn. Taking it down: out of the gimbals, the bezel off; the movement on its bowl dial down; the mainspring let down with the key, the click held off, and the maintaining spring let down off its detent; dial up, the hands, the dial, the motion work and the up-and-down pinion; dial down, the balance cock's screw, the cock with the balance, the detent's block, the barrel arbor's ratchet, the barrel bridge's two screws and the bridge, the fusee arbor's cork washer, flange and washer, the top plate's three screws and the plate; then the book's "and all the parts" in the order `tools/assembly.py` checks (estimated, and the step says so): the barrel with the chain (all on it, let down), the escape wheel, the maintaining detent, the fusee, the seconds, centre and intermediate wheels, the intermediate bridge. Putting it back, as the book has it: the barrel and fusee first, the intermediate bridge, the lower cock on the top plate, the wheels, fusee, maintaining detent and escape wheel, the top plate, the barrel and its bridge, the ratchet and its click, the balance and cock, the detent's block, the book's four checks of the escapement (the tooth 0.20-0.25 onto the locking stone, the gold spring 0.35-0.40 past the detent's end and at rest 0.10-0.15 short of the discharge stone, the tooth 0.04-0.07 from the impulse stone; the model's figures beside them: Unresolved's Soviet figures), the chain, the set-up by ten teeth of the barrel arbor's ratchet, the washer, flange and cork washer, the motion work, the dial on its three screws and the hands; an oiling step from its Appendix 5's table (p. 132, printed small, its MX column read as best it can be: no oil named for the escapement; estimated as a step, the book has none), and into the case with Appendix 4's endshakes. The book names no cleaning and no tools but the key. The book's screws agree with the model's: the dial's three, the barrel bridge's two, the top plate's three. Each part moves as the Exploded view moves it, at least 25 mm off, the detent's block along assembly.py's path (down 1.5 off its steady pins, out 45 along −x under the plate between the pillars); what rides on another until its own step rides with it (`HOST`: the balance hanging in the cock's jewel, the lower cock and fusee bush on the top plate, the fusee's wheel, maintaining work and stop work on the fusee); what is done with goes in the tray (hidden). The movement turns dial side up out of its case for the dial side's steps (the tick's `ovF`). Where the model lifts straight what a repairer draws out sideways: the balance cock, whose arm lies 1.6 under the cork washer the book takes off later (it passes through it), and the detent's block, which a repairer tilts about 3° off its pins (assembly.py's expected pairs). `assembly.py --model wempe` checks the page's order against its own (`OVH.offAt`): every part at its step, none earlier than a part of an earlier step; `--eval "OVH.DIS.reverse()"` must fail. It runs in every version (the book is the 6MX's; the drawings', as first drawn, 3955's and 1943's parts come off at the same steps).
- **Downloads** (16 October 2026; the Download section, and Download it as STL on each part's card): `js/blender.js`, lifted from the Hamilton's `js/blender.js`, which keeps its own; the glTF writer (`GLTF`) and the rig (`RIG_PY`, the Hamilton's `blender/rig.py`) are the Hamilton's, loaded by relative path.
  - **STL**: a part or a piece as built (in the sheets' state and with the connector the page shows), or the movement as shown (parts hidden, Moving parts only), as one binary STL in millimetres in the movement's frame (dial side +y, 12 o'clock −z), the case's parts in the box's; no engraving or printed face. Every one closed: `gltf_check.py --model wempe` checks the movement's and six parts' (`checks.py`'s `GLTF['stl']`).
  - **Blender (.glb)**, `wempe-einheitschronometer.glb`, about 75 MB, two minutes to make in SwiftShader: the whole instrument as the Hamilton's (named parts and pieces, the materials, the jewels and glasses transmitting), its copy built as the page shows it (the sheets' state, the connector, the dial, the timing weights) and its clips played through it with `app.js`'s tick's equations: Running, Beat (slow motion), Run down, Winding (in the case as the page winds it: the bowl turned over, the closing plate opened, the key put on and turned from a quarter of an hour short of run down, the maintaining spring driving the train meanwhile, then all back), Setting the hands (the cannon tube slipping an hour), Exploded, Lift out, Lid, At sea (the Wempe's gimbals, `gwSea`, `gwStep`), and the rig's (Rig · beat, explode, lift, lids, and Rig · ratchet: the maintaining detent riding a tooth of its ratchet, 385.7 beats, which Run down would sample every 450 beats, so it is left out of Run down). Left out: Laid out (the page's since 18 October 2026, not yet a clip), and, having no counterpart, Stop and start and Latch.
  - **Blender rig (.py)**: the Hamilton's rig, which makes only the controls the file has (hours, hands set, explode, lift, lids, roll, pitch). `blender_check.py --model wempe` (16 October 2026): every part Running moves where the rig puts it within 0.003 mm and 0°; explode, lift and lids at 1 at their clips' ends; against Winding, in the movement's frame (the rig doesn't turn the bowl over), the fusee 3.2°, the barrel 2.6°, the chain 1.0 mm and the up-and-down wheel 0.3° off, all the fusee's catch on its click wheel, which the rig hasn't (bounded by a click-wheel tooth, 10.3°).
- **Contacts** (18 October 2026; its own section; `contacts=1` or `contacts=sweep` in the link, `ceps=` the band, `ctin=1`): not from the Hamilton's, a debug view `../shared/contacts.js` gives the viewer (`cfg.contacts`), which the Hamilton's page binds too (its own `app.js`, since 18 October 2026: its README's Controls). Every pair of solids in different parts that touch (within 0.006 mm), come close (a gap up to the band, 0.03 mm unless chosen: 0.01 to 1) or pass into each other, found on the built solids as `fine.py` finds overlaps but along all three axes and with the gap too; an overlap `fine.py`'s `EXPECTED` lists is expected (its reason in the list), any other not. Shown on both solids in each one's frame, so a part carries its contacts as it moves or explodes, drawn over everything with every part a faint ghost (no merged copies, Edges or ink while it shows); a part hidden, faded away, isolated out or hidden by Moving parts only takes its contacts with it on both sides, without a new scan. This moment stops the clock and scans the model as it stands (about 6 s on this machine's GPU, 677 solids), and again, only the pairs where something moved, once the model stands still; Over a beat and the wind poses it in `fine.py`'s 68 states through its own update and keeps what each finds, each pair with the states it meets in (about 4½ min). A scan holds the explode at 0, so the Exploded view shows the assembled contacts carried out with their parts. Picking a part shows its contacts alone and lists its pairs (the worst each does: its overlap, else touching, else its least gap), Inside the picked part too adds its own pieces' (a wheel on its arbor, its screws: overlaps there are joints, shown as expected), a pair clicked shows it alone and › picks the other part; the legend's kinds turn on and off. `tools/contacts.py --model wempe` renders and lists it (`--sweep`, `--part`, `--inside`, `--hide`, `--eps`); `smoke.py --model wempe` works it. What it showed first (18 October 2026): the stop bar's spring 1.0 mm into the fusee's body and the chain's links up to 0.08 mm into it in every state, and the maintaining detent 0.006 mm into its ratchet in 61 of the 68, none in `fine.py`'s table (it leaves out pairs in one turning group, and overlaps under 0.0005 mm³); the escape wheel never touches the locking stone: within 0.1 mm of it in the 49 states where a tooth is locked or being unlocked and none while the wheel runs (phase 0.255-0.29), its least gap 0.034 mm (0.048 at one moment at rest), so at the 0.03 band the lock doesn't show (`contacts.py --sweep --eps 0.1 --part escapeWheel`, 5 min). Its depth is the longest overlap along any of its rays, not how far one solid is in the other: the least of the three axes' is (18 October 2026, the rays replayed): the stop bar's spring is 0.0105 into the wall of its slot (1.0 its height along y), the maintaining detent at most 0.007 into a tooth at some train positions (0.89 its thickness; within `maintaining.py`'s 0.012), the chain's links graze the groove's edge, up to 0.09 on x rays only. Its sweep poses the train from the page's own tooth, so runs differ with the time of day. Inside the part's pieces close but never touching found three faults, fixed (RESOLVED.md): the cover plate screw off its sink, the upper balance jewel's settings 0.03 apart, the hairspring 0.033 into the stud's slot as first drawn. Still drawn clear: the compensation masses, 0.02 off the rim all round with their screws' tips 0.01 off it, which hold them in fact.
- **Selection** (29 October 2026): the Hamilton's, both from `../shared/select.js` (`PSEL`), bound by the viewer: Ctrl-click (⌘-click) or Select and a click, Alt-drag or Lasso for a loop round the parts that show inside it; its bar, and the right-click menu on a selected part, isolate, hide or fade them together. The Hamilton's README, "Selection", has the method.
- **Laid out** (18 October 2026; View, `view=laidout` in the link): the Hamilton's, the textbooks' developed drawing of the train, its arbors set in one line and seen square from the side, barrel left, balance right, hands below. Each builder places its arbors in a group of their own (the part, or a group in it, about the arbor), so the line moves those groups and no builder takes a second place: `js/movement.js`'s `develop(e)` (0 as built, 1 laid out; `buildWempe.DEV` the line), as the Hamilton's. The barrel and fusee stay, with all they carry (the fusee wheel, maintaining work, stop work, chain, the up-and-down pinion and its wheel and hand); the line runs on from the barrel through the fusee, and the centre, intermediate and seconds arbors follow, each at its real centre distance from the one before (the hole tables': 22.65, 18.12, 12.63 and the escape arbor's 11.85), so every pair still meshes. The escape wheel, detent and its block, the balance, rollers, hairspring and stud turn together about the escape arbor, 10.00 from the balance, so the escapement is unchanged and the balance ends the line. The motion work and hands go with the centre arbor, the seconds hand with the seconds arbor. Each driven pinion is turned by the change in its line of centres times (1 + the driver's teeth / its leaves), so its leaves stay in the driver's gaps (the escape pinion less the escapement's turn), on top of its loaded phase.
  - The frame, its jewels and bushes, the dial and the case are hidden (Moving parts only's `cfg.drive.hide`), since their holes no longer meet the arbors; see-through schematic plates stand in (`userData.devPlate`): the pillar plate and top plate along the line at their heights, 48 wide (the barrel's Ø 41.6 inside them), the intermediate bridge on the dial side under its two arbors, a bridge from the barrel's arbor to the set-up click's screw (hole 46, 12.0 off the line, as the real bridge runs), the lower cock hanging from the top plate and the upper cock over the balance on a foot, and three pillars (Ø 8.1) beside the line clear of the wheels, the chain and the detent. Their shapes are schematic, not the movement's: drawn only in this view and going with Moving parts only, they carry no part name (not listed as parts, sectioned, checked or downloaded), but each stands in for its part (`userData.devOf`, 25 October 2026): a click on one opens that part's card and shows it solid, and its line in the parts list stays live. Where a part shows through a stand-in the click goes to the part; where stand-ins overlap, to the smallest (a bridge before the plate it lies on, which shows round it).
  - Kept shown, though their parts are hidden (`userData.devKeep`): the set-up click and its screw (on the barrel bridge) and the stop pin (in the top plate), whose barrel ratchet and fusee stay in place, so the view holds every element a textbook's developed drawing letters ("Modern chronometer movement", Figs. 83 elevation and 84 plan: frame, barrel, arbor, set-up ratchet and click, chain, fusee and arbor, maintaining ratchet and click, stop work, the train's wheels, arbors and pinions, the up-and-down pinion and wheel, the motion work and hands). Its B′, the stud carrying the stop work, has no counterpart (the Wempe's stop bar slides in a slot across the fusee's small end); its S′, the snail the stopping arm meets, is the stop pin the bar meets (the stop work turned round); its s, the arm's spring, is the bar's spring, inside the fusee's small end under its cover plate and out of sight from any side. `tools/laidout.py --model wempe` checks each is shown and opens its own card when clicked (a real click, in the elevation or else the plan) and draws both views on one sheet with the drawing's letters and a key (`r_laidout_sheet.png`), with a third view the drawing hasn't: the train laid out seen isometrically (the line's yaw turned 45°, 35.26° down from the train side, through a 4° lens from far off) with the schematic plates, bridges, cocks and pillars hidden (`?qa`'s `__devHide`; the set-up click and the stop pin, kept shown, stay), and four close-ups, each marked on it by a small numbered badge, its box numbered the same (the owner's choice, 2 November 2026, after an illustration's insets; rings round the parts, then leaders to the boxes, cluttered the drawing). The sheet's layout (the owner's, 2 November 2026): the elevation over the plan on the left, the isometric view over its four close-ups (two by two) on the right, and the key across the bottom, each letter's second line saying what the part does (`FIGS`'s `func`; the Hamilton's, without one, its card's title). `--relayout` remakes the sheet from the last run's renders (`r_laidout_parts/`) in seconds, and with `--write` puts it in the page, its stamp hashed again, if the page hasn't changed since: the mainspring and fusee (the barrel drawn see-through, so the mainspring shows inside), the maintaining power (the fusee, its wheel and the maintaining ratchet see-through over the maintaining spring and detent), the spring detent escapement (the escape wheel, detent and rollers) and the balance and hairspring, each its parts alone on the same line of sight through a 20° lens (`FIGS`'s `insets`: the parts shown, those or their pieces drawn see-through, those the badge marks).
  - Beside it, the assembled sheet (8 November 2026; `tools/assembled.py`, the root README's "The assembled sheet, photographed"): the movement put together and photographed in Cycles from the train side, the dial side (dial and hands off) and between the plates, and cut through three pairs of arbors, every element of Figs. 83-84 in its letter and 36 more parts numbered 10-49, with eight close-ups; under Take it apart while neither Exploded nor Laid out is on (`#asmSheet`, opening `#sheetA`). The build only notes when it is stale (a GPU render), never renders it again.
  - The page shows that sheet (2 November 2026): under Take it apart, while Laid out is on, a thumbnail (`#devSheet`) that opens it large (`#sheet`, a dialog; the viewer gives it the thumbnail's image, inlined once). `laidout.py --model wempe --write` renders it into `renders/laidout_sheet.webp` (only if its checks pass) with `renders/laidout_sheet.json`, the sha256 of every file the page loaded and of the tool; `--check` (no browser, `ci.py`'s `wempe-laidout`) fails when one of them changed, and the root `build.py` renders it again then, so the sheet follows every change to the page (about a minute in a browser, more under load).
  - The camera's field narrows to 20° so the elevation looks nearly flat; Spread sets how far the train is laid out. The viewer (`../shared/viewer.js`) eases it as it eases the explode (a view's `dev`), and Contacts holds it at 0 while it scans, as the explode.

## Building it: tolerances, the bench and the Monte Carlo

The Hamilton's build checks for the Wempe (15 October 2026): how closely the parts the drawings don't size must be made, the tests a made Wempe must pass on the bench, and the whole movement made to a maker's tolerances. Guidance for any maker, proved by their own runs: no Wempe is to hand. The tools (no browser), each writing a `tools/*_wempe.json` for the Wempe's verification report (`--write`; without it each exits 1 if its file is stale): `tools/wempe_tolerances.js` (about 40 s, `tolerances_wempe.json`), `tools/keystone.js --model wempe` (about 5 s, `keystone_wempe.json`), `tools/wempe_bench.js` (about 45 s, `bench_wempe.json`, reading the first) and `tools/wempe_montecarlo.js` (about 30 s, `montecarlo_wempe.json`, reading the bench's). The Hamilton's `tolerances.js`, `bench.js` and `montecarlo.js` read its own files throughout, so these are counterparts reading WESC and WPHYS through `wempe_load.js`; `keystone.js` takes `--model wempe`, its Hamilton output byte for byte as before (with and without settings), and `escgolden.js` holds makeEsc bit for bit (unchanged here).

The swing's band: the model's own swing is 188.5-199.5° over the wind on 05 06_20's drive, under the sources' 225-270°, so each range keeps it in the guard band `wempe_escapement.js` uses, **180-270° over the whole wind** (185° until 19 October 2026's physics pass; 193° until TF was taken from the video, 15 October 2026) (the drive from 05 06_20 at every quarter hour, 0.952 of the reference at 56 h to 1.042 fully wound), and the sources' band is reported beside it.

- **The mainspring** (05 06_20's "15 × 0,37", no tolerance): the drive goes as the strip's thickness cubed. The guard band holds from 0.940 to 1.670 of 05 06_20's pull; the strip's stress fully wound at the measured level is 2.45 GPa (`wempe_physics.js`), which a strip of the same set takes to a mainspring's 2.6 GPa at 1.194: so **−6 % to +19 % of the measured pull**, the strip 0.362-0.393 mm if 0.370 gives that pull, 0.362-0.392 on the 0.370 the solved spring wants at the measured level (since 26 October 2026, the free curve at ×0.75; −7 % to +26 %, 0.361-0.400, on the 0.356 the solved spring wanted at ×0.6 until then). Read as 05 06_20 reads it, g on a 262 mm lever on the fusee arbor: its readings' mean 132.7 g (the sheet's own 131.5) within 124.8-158.5 g. The sources' 225° at the wind's lowest would want 1.338 of the measured drive (a 0.408 mm strip, 177.6 g mean), past the stress limit's 1.194, so not by the strip alone: the swing under the sources' band stays open (Unresolved, the swing's figure).
- **The detent's spring** (1436's "0,07", faint): its stiffness hardly moves the swing (the preload is the banking's, left as set): the guard band holds to 10.2 times the drawn stiffness, 0.152 mm, and with none it swings 208.3°. Its 0.09 (1436's other figure) swings 200.2-211.0°. Its limits are the detent's return in time, which `dynamics.js --model wempe` checks from half to twice the drawn stiffness (0.056-0.088 mm), and its ring (below).
- **The preload** (the banking, not drawn; 0.8 g at the stone estimated since 19 October 2026's physics pass): 0.3 g swings 194.2-204.9° over the wind, 0.8 g 188.5-199.5°, 1.0 g 186.2-197.3°, 1.5 g 180.6-191.8°; the guard band's floor (180°) at **1.55 g**. Its floor is the higher of two: the margin's, **0.78 g** (`wempe_tripping.js` with the lock at 0.235: a held tooth's stone rings 49.3 % of the depth of lock at the estimate, under half from 0.98 times it; 55.7 % at 0.8 times, 78 % at 0.5, teeth past at 0.2 times and under), and the knock's, under 0.64 g (a 3 ms blow of 20 g first lets no tooth go somewhere under 0.8 times; 22.6 g there, 25.6 g at the estimate, 28.7 g at 1.2 times). Until the physics pass, at 0.63 g and the lock 0.175: 0.3 g swings 196.0-205.9° over the wind, 0.63 g 192.9-203.0°, 1.0 g 189.7-199.9°, 1.5 g 185.4-195.8°; the guard band's floor (185°) at **1.55 g** (1.43 g in the figures before their rerun of 18 October 2026). Its floor is the higher of two (18 October 2026): the knock's, **0.61 g**, where a 3 ms blow of 20 g across the plate first lets no tooth go (17.9 g at 0.8 times the estimate, 20.4 at it, 22.6 at 1.2 times; Physics: in time; 0.63 g until the horn was traced, 18 October 2026), and the margin's, 0.51 g (0.49 g from 16 October 2026 until the horn was traced): `wempe_tripping.js`'s sweep under and over the estimate has a held tooth's stone ringing 100 % of the depth of lock with none and at 0.1 and 0.2 times the estimate (teeth get past), 73 % at 0.5, 50.4 % at 0.8 and 44 % at the estimate, so under its margin of half from about 0.81 times (0.51 g), and no tooth past from 0.5 times (with the straight horn: 92 % at 0.2 times, 69 %, 49 % and 41 %, the margin from 0.78 times, 0.49 g, no tooth past from 0.2 times). (`wempe_tolerances.js` first took 0.72 g, the frame's figure from before the banking was read on the pipe, then the estimate itself until the sweep ran under it.)
- **The gold spring** (05 04 01-2: 0.15, sure; its 333 gold's modulus 98 GPa, Au/Ag/Cu 333-333: likely, since 19 October 2026): its work on the return is lost, so softer is free for the swing (none: 209.5° at 12 h; half as stiff: 196.5-207.0°) and the guard band holds to 1.51 times its stiffness (0.172 mm at 98 GPa, or 148 GPa at 0.15). Softer costs the lock: half as stiff, a held tooth's stone rings 71 % of the depth (49 % as drawn). Before the physics pass, at 90 GPa: its work on the return is lost, so softer is free for the swing (none: 207.5°; half as stiff: 198.3-208.3°) and the guard band holds to 2.05 times its stiffness (0.191 mm at 90 GPa, or 184 GPa at 0.15). Softer costs the lock instead: half as stiff, a held tooth's stone rings 52 % of the depth (`wempe_tripping.js`).
- **The depth of lock** (05 04_1: 0.235 since 19 October 2026's physics pass; the banking sets it): as drawn the lock 12.9°, let-off 1.5°, the stone lifted 0.257 mm at the release. **It unlocks only to 0.247 mm** (the discharge stone lifts the stone 0.268 at most; there lock 13.4°, let-off 1.0°), and a held tooth's stone rings under half the depth from 0.232 (twice the 116 µm `wempe_tripping.js` finds as drawn, taken the same at every depth): **a window of 15 µm**, the drawn 0.235 3 µm over its floor, so the bench aims the banking at its middle, 0.239, and sets it again until it reads inside. The wheel's Ø 14 +0.03 at the top of its tolerance locks 0.250 deep and wouldn't unlock: the banking is set to the wheel as made. A shallower lock gives swing back (12.7° of lock and 189.2-194.9° at 0.232). Until the pass (05 04_1: 0.175): as drawn the lock 9.9°, let-off 1.9°, the stone lifted 0.196 mm at the release. **It unlocks only to 0.188 mm** (the discharge stone lifts the stone 0.209 at most; there lock 10.4°, let-off 1.3°), and a held tooth's stone rings under half the depth from 0.154 (twice the 77 µm `wempe_tripping.js` finds as drawn, taken the same at every depth; 0.143 from its 72 µm before the horn was traced). **The wheel's own tolerance, Ø 14 +0.03 (05 04_23), takes a fixed banking past it**: at the top of it the tips lock 0.190 deep and the escapement would not unlock, so the banking is set to the wheel as made. A shallower lock gives swing back (8.8° of lock and 196.5-201.8° at 0.154).
- **The hairspring** (05 03_6's 0.285, boxed, no tolerance; the coil Ø 12.8 ±0.05, boxed): as drawn on the weighed balance it is 0.494 s at steel's 206 GPa, **about 18 minutes a day fast** (0.489-0.501 s over 200-210 GPa: Closed, the hairspring's length) (0.497 s, 8.1 minutes, until 18 October 2026; 0.491 s, 25 minutes, before 15 October 2026's shape batch). A µm of the strip moves the rate 455 s a day, 0.01 mm of the coil's Ø 35 (its drawn ±0.05: ±173), a mm of its length 85, a GPa of the steel's modulus 210 (200-210: ±1,049). A turn of both timing weights (0.432 g at r 18.5 on their 0.16 pitch) is 44.2 s a day, and as drawn they stand against their screws' heads 0.30 mm off the rim (their size estimated): they can only go in, 1.9 turns, gaining up to 83 s a day. So the period is matched, not made: 0.5 s wants the strip 0.2839 (0.2821-0.2867 over the modulus), the weights' reach is 0.18 µm of it, and the coil's own tolerance is twice their reach. The spring is vibrated against its balance and chosen or ground to it, as a 1940s maker did.

**Against the 1904 text** (`keystone.js --model wempe`; it reports, never judges): the wheel's 15 teeth, Ø 14.00, and the roller at 0.484 of it agree; the book's planting puts the balance 9.91 from the escape arbor against 05 04_1's 10.00; the rims cross over 21.7° of the wheel (90 % of a pitch) and 45.7° of the roller (the book's 48°). Where the Wempe differs from the book's English chronometer: the impulse runs 35.1° of the balance against 43°, the wheel catching the stone 12.3° after the release (the book has the jewel 5° inside the wheel before it; the Wempe's comes into the teeth's path 3.8° after); the unlocking takes 9.9° of the balance against 5° (the deep lock, 0.175 on a 7 mm wheel) and turns the detent 0.87° against 2°; the stone has no draw (−3.7°, its flat on the wheel's radius) against the book's 12°, the preload holding the tooth; the stone Ø 0.75 against a third of a tooth space (0.97) and half round against 4/10; the teeth's faces lean 25° against 28° and their backs are the Ø 6 cutter's arc, 3.00 against the roller's 3.39; the detent 12.87 from its flexure to the stone against the wheel's diameter, its spring 5.0 long against 2/7 (3.68), 0.070 against 0.051 thick, 1.9 against 2.03 wide, 1.28 times as stiff; the balance Ø 32.3 against 30.5 and swinging 197° against the book's 225°. The drawings decide.

**The bench** (`wempe_bench.js`: fourteen tests since 25 October 2026, each with how and what it must read; the figures as numbers in `bench_wempe.json`'s criteria):
- *The mainspring's torque*, in its barrel set up ¾ turn: 427 to 839 mN·m at the measured level over the fusee's 5.08 barrel turns (473 to 824 with the free curve at ×0.6, until 26 October 2026), each reading within ×0.940-1.194; half a turn to spare to coil-bound (the model's 0.93); unwinding 1-3 % under winding on the solved spring, over 22 % clean it.
- *The pull on the fusee arbor against 05 06_20*, as Herb. Müller read it in 1941 (a 262 mm lever, each half turn running down): each reading within ×0.940-1.194 of the sheet's at the same turn, and its shape, −4.7 to +4.3 % about the mean with the hump, the dip and the rise.
- *The depths*: the hole tables' centres 22.650, 18.120, 12.630 and 11.850 mm within ±25 µm (`gearing_wempe.json`: the seconds mesh's window less its shake; the tables give the places to 0.001 and no tolerance); a hole closer than its window less its shake re-bushed.
- *Endshake from the sheets' fits*: each arbor's bearings' distance and its length between shoulders, every term with its sheet's tolerance or an estimate: the pillar 19.6 ±0.04 (likely; read ±0.01 until 28 October 2026, the second drawing check's 9-M8) less its two seats 0.3 +0.03 (05 08 00-1, 05 09 01, 05 08 02-1), the bushes' depths (WN-302 0.1 +0.02, WN-300 0.7 +0.02), the arbors' lengths (19 +0.05, 23.05 −0.1, 24.1 −0.1, 22.8 −0.02, 19.7 +0.05, 22.2 +0.1). As drawn the centre arbor has 0.08 (0.07 until 28 October 2026, WN-302 then set at its least), the intermediate 0.06, the seconds 0.05, the escape 0.06 (its endstones set 0.03 off the arbor's ends for the 1958 book's 0.05-0.07, since 25 October 2026; 0.04 before), the fusee 0.05, the barrel 0.06; the sheets' tolerances allow −0.05 to 0.16, −0.12 to 0.18, −0.14 to 0.18, 0.02 to 0.08, −0.12 to 0.11 and −0.13 to 0.15 (−0.02 to 0.13, −0.09 to 0.15, −0.11 to 0.15, 0.02 to 0.08, −0.09 to 0.08 and −0.10 to 0.12 with the pillar's ±0.01). The test reads each arbor against the Soviet Navy's 1958 MX repair book (Appendix 4, pp. 128-129; the Wempe's sheets give none) at 20 °C: the fusee 0.08-0.12, the barrel, centre, intermediate and seconds arbors 0.07-0.10, the escape arbor 0.05-0.07, the balance staff 0.04-0.06 at its endstones (the TU's 4 °C takes 3 µm). The drawings' stacks come out at or just under the book's floors, so a maker frees most arbors a little. Until 19 October 2026 one band, 0.01-0.08 (estimated, after the Hamilton manual's 0.003 in); the user chose the book's figures for a navigating build.
- *The balance vibrated*: 7,200 an hour, or slow by up to 83 s a day (the weights only gain); fast, grind the strip or choose a weaker spring.
- *The free run-down*, the train held, choosing the strip: since 19 October 2026's physics pass the model's balance halves its swing in 46 s (TF 111 s; a running 6MX's TF 102-125 s at its swing); at TF 80, 100, 111, 125, 160, 200 s it halves in 37, 43, 46, 49, 57, 63 s, 05 06_20's drive swings it 170, 186, 194, 203, 223, 241°, the guard's 180° at the wind's lowest wants ×1.144, 0.991, 0.931, 0.870, 0.763, 0.687 of the drive, the sources' 225° ×1.662, 1.424, 1.330, 1.233, 1.065, 0.945. Before it, halving in 55 s (TF 108 s; a running 6MX's TF 96-121 s at its swing); at TF 80, 100, 108, 125, 160, 200 s it halves in 44, 52, 55, 61, 72, 83 s, 05 06_20's drive swings it 175, 191, 197, 209, 229, 247°, and the guard's floor at the wind's lowest wants ×1.159, 0.989, 0.939, 0.853, 0.733, 0.647 of the drive, the sources' 225° ×1.649, 1.398, 1.323, 1.196, 1.019, 0.890.
- *The detent rings*, its foot clamped: 80 Hz with the spring as drawn, 57-113 Hz for 0.056-0.088 mm (`wempe_tripping.js`'s frame: the pitch nearly as the thickness to the 1.5; 1436's 0.09 would ring 116 Hz); the gold spring near 620 Hz.
- *The escapement's figures and the banking* (since 19 October 2026's physics pass): the impulse stone's face 28°10' before the line of centres at rest and the locking stone 37.0° on, 7.14 from the wheel's centre; the gold spring met at −10.3°, released at +2.6° (lock 12.9°), off at +4.1° (let-off 1.5°), passed at −18.8° (overall 22.9°), roller shake 0.011, the teeth 0.39 into the roller; the banking set for a lock 0.239 deep, the window's middle (the drawing's 0.235 is 3 µm over its floor), never under 0.232 nor over 0.247, and set again until it reads inside; the preload at least 0.78 g (the margin's floor, over the knock's under 0.64) and under 1.55 g. Before it: 05 04_1's 24° and 36.5°, the gold spring met at −7.3°, released at +2.6° (lock 9.9°), off at +4.5° (let-off 1.9°), passed at −12.6° (overall 17.1°), roller shake 0.046, the teeth 0.39 into the roller; the lock set 0.175 deep by the banking, never under 0.154 nor over 0.188; the preload by riders on the stone's pipe, at least 0.61 g (the knock's floor, over the margin's 0.51) and under 1.55 g, aimed near 0.84 g (a quarter into its window, estimated; each gram more costs about 9° of swing; 0.49-1.43 g aimed near 0.73 until 18 October 2026).
- *The swing*: in the guard band over the whole wind; the sources' band reported.
- *The maintaining spring*: assembled with its eye's pin up into the ratchet (05 06_4 A-B), closed by the running drive until its ends nearly meet (0.27-0.58 mm apart); the key held, the balance keeps going 10.7-13.9 minutes (wempe_sustaining.js); its ends touching in running, it is weak or set; under 5 minutes (estimated): the ring open (its pins the wrong way round), weak or set.
- *The stop takes a strong hand, and the key is one-way* (25 October 2026, `wempe_overwind.js`): the stop bar and pin file-hard; held against the stop at 1.36 N·m (a strong hand on the Ø 34.5 paddle) nothing marks: hardened, the bar yields at 3.63 N·m on the key and the pin at 9.87, soft the bar at 1.31; the key's coil spring wound of spring wire Ø 0.68 or more; the wrong way the key slips.
- *The cannon pinion's friction* (25 October 2026, `wempe_motionwork.js`): a weight hung 30 mm along the level minute hand turns it between 10 and 295 g; set near 55 g.
- *The 6MX TU's trial, the acceptance test*: 35 days at 36/20/4/20/36 °C, wound to "8" daily, its E ±0.35, R ±2.00, D ±2.30, C ±0.10, S ±1.20, period means ±3.50 and N ≤ 30 (`wempe_errorbudget.js` passes it as adjusted); out on C, the masses moved along the rim from their drawn place (−2.34 s a day a °C) toward 20.5° from the cuts' line, 0.235 s a day a °C a degree (`wempe_thermal.js`).

**The Monte Carlo** (`wempe_montecarlo.js`: 2,000 Wempes, every tolerance drawn at once; the sheets' where drawn, each part anywhere within its limits, estimated where not). The swing comes from a response surface on makeEsc (the drive, the two springs, the preload and the lock's depth, each on a grid), checked against makeEsc rebuilt at five points to 0.6° (makeEsc's swing moves in steps of up to 2° as the lock's depth passes its tables' cells near 0.160-0.163 mm). **As made, 2.4 % work since 19 October 2026's physics pass, after the bench 100 %** (the banking set again until it reads inside the lock's 15 µm window, as a maker measures after setting: once set, 7 of 2,000 missed it); each alone: endshake 8.8 %, the banking as first set 48.6 %, the preload by eye (0.8 ±0.3 g against its 0.78 g floor) 57.6 %, the wheel's 14 +0.03 78.2 %, the hairspring timing in 6.4 %, the rest none. Before the pass: **As made, 3.1 % work (2.9 % before the horn was traced, 18 October 2026; 4.7 % while the preload's least was the margin's 0.49 g, 16-18 October 2026; 5.0 % before 16 October 2026's reading of 05 04_1's angles); after the bench's tests and adjustments, 100 %**, and every movement that fails as made is caught by a test. What spoils it as made, each alone: **endshake** (8 % of movements free: an arbor under 0.01 mm in the fusee 75 %, the barrel 51 %, the seconds 39 %, the intermediate 31 %, the escape 4 %, the centre 1 %: the plates' two seats, 0.3 +0.03, and the arbors' lengths leave it to be set at assembly, as the sheets' own notes set the fusee's face a and the bushes' depths); the preload by eye (0.63 ±0.3 g, estimated, against its floor 0.63 g, the knock's: 53 %; 83 % against the margin's 0.49); the wheel's 14 +0.03 with the banking where the drawn wheel puts it (87 %); the banking as first set (±0.02, estimated: 90 %). The holes (±13 µm, estimated), the train's friction, the mainspring's strip (±0.005), the detent's and gold springs (±0.005) take none out; bored to ±25 or ±50 µm the train still never jams (the seconds mesh's close side, 100 µm less its shake, is the tightest), the depths test re-bushing the close ones. As made the swing over the wind runs 186.9-198.9° at its lowest and 196.9-209.2° at its highest (5-95 %), 66 % in the guard band; after the bench 186.3-196.3° at its lowest and all in it; none in the sources' 225-270°. The hairspring as made times in 8 % (the drawn spring on the weighed balance about 18 minutes a day fast, the timing weights reaching 293 s a day, gaining only; 12 % and 8 minutes before the balance's nuts came off, 18 October 2026): every one is vibrated and matched. Temperature apart: at the masses' drawn place every one fails the TU's C; the trial moves them, and over the materials' ranges a place on the free arc nulls it in 28 of the 32 corners (`wempe_thermal.js`): the alloys, not the maker's tolerances, decide it.

**The mechanisms in turn** (25 October 2026; the Hamilton's `wear.js`, `overwind.js`, `motionwork.js` and `estimates.js` for the Wempe; the report's section 18). The Hamilton's `traindyn.js` has no counterpart: `wempe_transmission.js` (Physics: the transmission) already runs every mesh tooth by tooth through a beat on the weighed bodies.
- *Wear* (`wempe_wear.js`): Archard at every sliding contact, `wempe_strength.js`'s loads fully wound, Rabinowicz's coefficients (oiled: 1e-7 well, 1e-6 poorly, 1e-5 dry; the escapement dry, as a chronometer's runs, at the unlubricated non-metal on metal's 1.5e-6), each against the tolerance it eats, judged over a service interval: three years, the 1954 Soviet instruction's cleaning and fresh oil (`6MX-figures.md`), the TU's ten-year life reported. Every other oiled contact lasts 170 years and more well oiled (the escape arbor's pivot in its jewel first: 176 years, 18 poorly, 1.8 dry; the seconds arbor's in WN-300 199, 20, 2). Two figures go within a service interval or so, both restored at an overhaul: **the balance's endstone** wears the endshake band (the 1958 repair book's 0.04-0.06, set to its middle: 10 µm of room) in 2.7 years, the 12.9 g balance on its Ø 0.21 pivot's end (reported, a repairer's band); and **the drawn escapement's lock window** (15 µm, the banking at its middle: 7.6 µm of room) is worn off the gilt brass teeth's tips in 4.2 years dry (1.3 at 5e-6). The 1950s build's 196 µm window lasts 120 years; its gold spring's face, under the discharge stone twice a period, 15 years.
- *The key forced* (`wempe_overwind.js`): a strong hand taken as 1.36 N·m (the handles' data carried on to the Ø 34.5 paddle: an extrapolation; Swain's 1.06 beside it); forward against the stop every hardened part stands 2.7 times or more short of yielding (the stop bar first, 3.63 N·m). The key's coil spring carries the torque as its wire's tension at its driven end: the wire 51 00 11 scales (about 0.6) yields at 1.57 N·m in patented spring wire, so it is a design value: Ø 0.68 carries half as much again as a strong hand and fits the drawn coil's 0.95 pitch and the body's Ø 0.9 hole. The wrong way the 1943 key slips (its drag about 5 mN·m); the plain 1940 key would bend the click wheel's teeth at 0.73 N·m, less than an average hand's twist (reported: what the one-way key prevents).
- *The motion work* (`wempe_motionwork.js`): the three meshes run at their drawn centres; their depthing windows (closer to the tips on the roots, wider to the end of a 1.2-module search) put the change wheel's stud (hole 19) at ±15 µm, the hour wheel's tips only 50 µm off the change pinion's roots, and **the up-and-down wheel's stud (hole 2) at ±7 µm**, its pinion's tips 35 µm off the wheel's roots as `dial.js`'s tables cut them: tighter than the train's ±25 µm, the place a maker must bore most closely. The cannon pinion's window (`wempe_transmission.js`'s) as a bench weight, and the hands set backward: a fit near the window's middle never turns the train back, one near its top (87 mN·m) would push the escape wheel back on its stone with its own running drive near run down, which the 6MX's instruction forbids.
- *The estimates* (`wempe_estimates.js`, as last revised and both builds): the balance's TF over 80-200 s with the strip the run-down test chooses keeps the swing in the guard band over the whole wind, the strip at most ×1.205 of the drive as last revised (under its stress's ×1.262); the pivots' shake to 0.05 still leaves the holes ±25 µm; the hairspring's four readings of 05 03_7 come to 0.5 s with a strip at most 2.6 % longer than the model's; its outer curve formed 1 mm off its table leaves the pivots 0.025 of the couple over R (the drawn 0.018).
  - Since the mainspring's set was fitted with its friction (×0.75, 26 October 2026) the strip takes at most ×1.194 the drive before its stress passes the limit; the bench's strip for a balance damped at the measured 102 s and above stays within it, while at the sweep's 80 s (under a running 6MX's 102-129 s) it would want ×1.205: reported (`~~`), not failed (the owner's choice), since such a balance would want a stronger steel or a lower drive.

## Making it: the frame under load, the order of assembly, each part on the machine (25 October 2026)

Three checks of whether the Wempe can be made and put together, on the page's own solids, each in the report's section 19 (`verification/geometry.py` runs them).

- **The frame under load** (`tools/fea.py --model wempe`, about 5 minutes, in `ci.py --full`): the Hamilton's finite elements on the parts that hold the going train's pivots, the pillar plate, top plate, barrel bridge, fusee bush and intermediate bridge (their largest visible mesh each), in brass bricks (E 100 GPa, ν 0.34) at two sizes; each arbor's two bearings, the dial side's first (the fusee in the pillar plate and its bush, the barrel in the pillar plate and the barrel bridge, the centre and escape arbors in the two plates, the intermediate and seconds arbors in the intermediate bridge and the top plate); held at their screws (the top plate on the three pillars, Ø 8.1 and 19 long as beams; the barrel bridge and fusee bush on the top plate; the intermediate bridge on the pillar plate), the pillar plate at its rim in the movement ring; loaded with the chain's pull on the drums' common tangent (the spring's moment at 05 06_20's level, `wempe_physics.js`'s MupM fully wound, the solved Mdown at that level run down; the fusee's radius and the chain's height at 8.75 turns and at turn 0, `fusee.js`'s RFT and ac) and each mesh's tooth force at its height (the page's toothed meshes) with `gearing_wempe.json`'s pressure angle, split by the lever rule; all in `checks.py`'s `FEA`. Fully wound the chain pulls 37.7 N (21.7 run down); no pivot hole moves more than 0.36 µm (the barrel bridge's), no arbor leans more than 13.4 µrad (the barrel's), no mesh's depth changes by more than 0.031 µm, 0.01 % of the room its window leaves (the fusee wheel on the centre pinion), and the most stressed brass is at 6.8 MPa (the fusee bush) against its 300-450. The frame is far stiffer than the train needs: the depths a maker holds are the holes' drilling (Building it), not the frame's bending. Left out: the arbors' own bending, the jewels' settings (the brass round them), friction at the fixings, the cocks (the balance's alone).
- **The order of assembly** (`tools/assembly.py --model wempe` + `assembly-check.js`, about 15 s, in `ci.py`'s browser steps): the movement taken apart in the order the Soviet Navy's repair book gives for the MX (*Эксплуатация и ремонт измерителей времени*, 1958, pp. 59-60, "Порядок разборки и сборки", `References/wempe/documents/Ekspluatatsiya-i-remont-izmeritelei-vremeni-1958/p059.png`, `p060.png`): the hands, the dial, the motion work and the up-and-down pinion off the dial side; dial down, the balance's cock with the balance, the detent's block ("Снять колодку ходовой пружины", take the detent's block off: the book's "ходовая пружина" is the detent, p. 60), the barrel arbor's ratchet, the barrel bridge, the fusee arbor's cork washer, flange and washer, the top plate on its three screws, "and all the parts"; together the same backwards (the intermediate bridge on the pillar plate first, the lower cock on the top plate before it goes on, the escape pinion in last before the top plate). Estimated where the book is silent: the barrel out after its bridge (the book puts it in after the top plate), the rest as its assembly reversed, then the intermediate bridge. Every part rastered into 0.2 mm columns as assembled, the model frozen in `audit.py`'s state, each step's parts drawn straight off along the arbors, or along a path of straight legs sideways; a pair fails if one passes through the other or is dragged the long way out of a fit (`checks.py`'s `ASSEMBLY`, its `expected` pairs each with a reason). Found: the detent's block (05 04 01-4 as last revised) hangs under the top plate's inner face between the plates, its end at the rim by a pillar, as on Kirov No. 247 (`8_Kirow_247_F.jpg`), and comes off in the book's place without the plate: its fixing screw out of the plate's outer face, the block with its detent dropped 1.5 off its two steady pins (they reach 1.3 into the plate; 2 would meet the lower cock) and slid out sideways under the plate between the pillars, along −x (every heading from 150° to 180° in plan clear), the stone drawn back out of the escape wheel's teeth (Closed: the detent's block against the book's order); the stop work's bar lies in the fusee's small end under its cover plate and comes out with the fusee; the escape wheel stays in under the top plate only because the lower cock's lug and its jewel's setting overlap only its teeth in plan (5.8-6.9 from its arbor; the roots r 6.05) and pass between two of them, the wheel turned to a gap; the cock's arm runs 1.6 under the cork washer on the fusee arbor's end (x -10.3 to -8.7), so with the washer on it is lifted 1.6 off its seat and drawn out sideways (estimated); a timing screw's head (about 21 from the staff) lies under the dust bush and washer at some swings, so the balance is turned clear; the maintaining detent's screw, its head on the top plate's outer face, comes out before the plate; the chain is unhooked and unwound, not lifted. 48 parts, 18 steps, 10 expected pairs, none failing; the hands planted behind the dial fail it, and the lower cock planted 0.8 into the block's way out.
- **Each part on the machine** (`tools/dfm.py --model wempe`, about 8-15 minutes, in `ci.py --full`; fails only on a void sealed inside one piece): every machined piece's solid (screws, jewels, springs, the chain, the dial and hands left out) sampled level by level between its flat faces' heights on a grid 0.01-0.06 mm square, against stated limits: walls in plan under 0.15 mm, slots narrower than an end mill of radius 0.2, the inside corners it leaves rounded, holes over 10 or 20 diameters deep or under Ø 0.2, floors, what is cut from each face, turned or turned-then-cut or milled, undercuts, setups; `checks.py`'s `DFM` notes how a finding is cut where its sections mislead. Of 171 pieces, 56 are turned, 16 turned then cut (the plates' blanks, the wheels before their teeth and crossings), 99 milled (17 of them toothed); 97 need one setup, 73 two, 1 three; about 300 round holes, none deeper than 10 diameters nor under Ø 0.2. No void is sealed inside a piece. The work a maker plans for: the escape wheel's web recess (Ø 11.62, 0.6 deep) lies 0.04 inside its teeth's floor Ø 11.7, leaving a sliver of brass about 0.04 wide between the recess and each gap (turn the recess to Ø 11.7, or under Ø 11.3); the oil sinks of the bushes WN-300 and WN-301 run to 0.13 of their outside at the top plate's outer face; the cannon pinion's crowned end leaves its tube 0.12 thick round the bore at the top; the stop work's bar 050603-3 is 0.10 wide in places; the upper cock's slit (0.11 wide) is a slitting saw's; the stud's cross hole is drilled from the side (its one undercut); the fusee's groove is a fusee engine's (its sections' 0.08 slivers are the helix). The rest is ordinary: about 1,000 inside corners drawn sharp in some 40 pieces (the counts move by a few per cent from run to run, as the moving parts stand) are left with a fillet up to the mill's 0.2, which their mating parts' edges must clear.

## Making it: the maker's sheets and the build book (25 October 2026)

From 26 to 29 October 2026 the **Build book** was a PDF of engineering drawings beside the page (`book/wempe-build-book.pdf`, `tools/drawbook.py`), and a card's **Drawing** opened it at that part's sheet. The owner withdrew it on 29 October 2026: its drawings were fitted back onto the page's tessellated solids, which lost the design's intent (cut-outs as zero-length lines, sizes printed twice, sheets mostly empty), and a CNC maker wants a CAD file and the order of work rather than 525 A4 sheets. The page now offers no Build book and no Drawing (`cfg.drawings` false); its replacement, each part as a recipe of machining features giving a STEP file and an operation sheet, is planned in `PLAN-recipes.md` (branch `claude/wempe-recipes`). The open items found for the PDF's next regeneration by the second drawing check (28 October 2026) are in git history (this section before 29 October 2026).

Since 29 October 2026 the Wempe's parts are being made into **recipes** (`tools/recipes/wempe.py`, `PLAN-recipes.md`): each a list of machining operations whose every size is the model's own with its drawing, built as an exact solid and checked against the page's mesh, the page frozen in a stated pose first (`recipes.py --check`). As of 30 October 2026 (batches 10 and 11, after release 3.63.01), 101 parts are recipes (80 at release 3.60.00) and 32 lines are bought; the 21 added are the motion work and up-and-down work (the cannon tube, the change, hour and up-and-down wheels with their pipes and pinions), the four hands and the seconds hand's collet, the dial's disc, its screw and pin, and four of the case's screws (WN-kr, WN-hg, WN-kh, WN-zg). Release 3.66.00 (1 November 2026) adds the case, 123 parts and 37 bought lines in all: the bowl (its fine thread by convention), the bezel (its thread and knurl by convention), the closing plate, the case and locking brackets, the gimbal ring and its bracket, the two lock nuts and the case's screws, each parts-list line that held several sizes split into one line per size; the glass, the closing spring, the wooden box and its wood screws are bought lines. The transit lock and the winding key are still to come. Release 3.67.00 (1 November 2026) adds, 135 parts and 39 bought lines in all: the fusee body with its chain groove as an exact solid (ruled faces between the groove's sections, a quarter turn at a time), the maintaining spring, the maintaining detent's arbor and screws WN-19, WN-20 and WN-21 on the fusee side; and the hairspring's collet and stud (their pins bought), the balance arm's and masses' screws WN-10 and WN-12, the stud's screw WN-11 and the detent block of 1943 on the escapement side, a part's card showing the recipe of the version the page shows. Release 3.68.00 (1 November 2026) adds, 171 parts and 101 bought lines in all: the winding keys (1943's and 1940's), the transit lock (its line split into one per piece: bracket, lever, arbor, hub, pin, knob), the barrel arbor's hook (both forms), the wire spring's stud, the band's two hooks, the 6MX's chatons, the detent block as first drawn, as photographed (3955) and the 6MX's, with its adjusting slide and the banking, stud, stop, gold spring and foot screws of every version; and bought lines for the chain (a chain maker's work: about 1,500 plates and 750 rivets), the band's strip, the key's pin and spring, the boxes' joinery and hardware, the jewels, fibre parts and standard screws. Release 3.69.00 (1 November 2026) adds the 6MX's contact (its base, blocks, stud, staff, setting, cock, cap, screw, lever, disc and bracket, wheel and collet, and its two bowl springs: every size estimated from Kirov 247's photographs and Romanov 1975, Figs. 100-101, as each sheet says), its spiral, clamp screw and lock nut and screw WN-12a (not fitted) as bought lines: 187 parts and 106 bought lines, every line of the parts list covered. At release 3.60.00 the 80 were: the frame (plates, pillars, the movement ring, the barrel bridge and its click, the bushes, both balance cocks, the intermediate bridge and their screws), the train's arbors, pinions and wheels, the escape wheel and its collet, the small turned parts (bushes, the seconds jewel's setting, the dial's studs), the fusee's arbor, wheels, ratchets, cover and dust plates and Vorreiber, the barrel's arbor, drum, lid, hook block and Steg, the clicks, stop bar and maintaining detent, the detent, its gold spring and its block, and the balance (rim and arm, masses, timing screws and weights, hub, rollers, the jewel settings and their screws). Each card lists, for each of its lines, a **CAD file (STEP)** and an **Operation sheet** (the setups in a suggested order, each with its sketch, sizes, fits and sources), both from `parts/` (`tools/recipes_site.py`); 106 bought parts (jewels and stones, pins, the chain, the case's glass, spring, box and wood screws, the hairspring's and mainspring's strip, the springs' strip and wire) say what to buy. Every line of the parts list now has a recipe or a line saying what to buy.

The page's **Making it** (its own section, after Download) is the Hamilton's (`../chronometer-working-model/js/maker.js`, shared: the Wempe gives it its own words and choices in `MAKER.bind`'s `cfg`; `../shared/viewer.js` passes it a click on the model, `cfg.pick`, and each card as it opens, `cfg.card`). Each part card gets **Maker's sheet** (the card's own Download it as STL stays): the sheet lists the part's lines of the parts list, with the fit `bom.py` measured on the model, the material and treatment **its own drawing** gives and how it is made; then its size, volume and mass measured on the solids, its holes and screws. **Measure** (two points on the model) and **Data** (the drawings' sizes `WD`, the escapement's settings, the build, the parts list, as JSON). The sheets follow the version shown (the drawings as last revised by default); the book leaves out another version's parts (`cfg.inBook`), and a sheet lists the lines its meshes carry where a line's card is another part's (`cfg.byHn`: the transit lock's wood screws, a line of the box).

- **The data**: `tools/wempe_makers.py` writes `js/makers.js` (`MAKERS`) from `bom.json`, `BOM.md` (written by `bom.py --model wempe --md`: the fits as measured, grouped by drawing group; `bom_md.py`'s `write_drawings`) and the transcriptions: for each line its sheet (its drawing number in a section's heading; an older sheet under another number by its file among the line's `figs` and its heading naming the part; `ALIAS` where neither does: the hairspring's strip on 05 03_6, the detent on 1436, the staff on 05 04 02), and off that sheet the Werkstoff, the hardening and tempering, the surface marks (DIN 140's triangles), the blank and the untoleranced limit. Nothing is filled from practice: of 223 lines as last revised, 60 have their material on their own drawing; the rest say why not (a Wempe-Norm part, its standard sheet not in the set; a part drawn only on an assembly; the Werkstoff left blank, as on the 1946 staff's sheet, which gives only "gehärtet, anlassen 240°"). `--check` (in `ci.py`) fails if `js/makers.js` is stale; `--list` prints the materials and processes list. Run it after changing `bom.json`, a transcription, the build, the bench or the tolerances (and `bom.py --model wempe --md` after a fit changes).
- **What the drawings say the parts are made of** (read off the transcriptions, as sure as they are): the plates "Messingblech 4 / Sonder Ms α-β Gef." (special brass, α-β structure); the wheels Ms 58 sheet, spring-hard (the escape wheel Ms 63); the pinions and arbors "Präz. Rundstahl" (DIN 175); the balance "Nickelstahl Sonderlegierung u. Messing"; the hairspring "Bandstahl 0,52×0,285 poliert", hardened and tempered dark blue; the gold spring "Goldblech 333 federhart"; the detent (1436) "Stahl", where the impulse roller is "Kupfer Beryllium, Saphir"; the maintaining spring and clicks strip steel, the click spring "Bronzeband"; the bowl "Ms-Sandguß (Kokillenguß)"; the outer box "gebleichte Birke". The mainspring has no sheet of its own: its material is the build's (section "The build"), 05 06_20 giving only its section.
- **How each is made** (`MAKERS[].how`, the book's chapter "Materials and how each part is made"): CNC milled or wire-cut from the drawn sheet or strip, CNC turned from the drawn bar, cast and machined, joinery; bought in (the jewels, against standard sizes; the Wempe-Norm screws and pins); by hand or from a special supply: the cut bimetallic rim (no stock supplier: brass fused on the nickel steel, or a balance blank bought), the hairspring wound on a form, hardened on it and its curves bent to 05 03_7 by hand, the 8 ct gold sheet, the detent filed and stoned to its ring, the mainspring (Nivaflex for the 1950s build), the chain. The kinds are the tool's reading of the drawn stock and the part, not a process plan.
- **The deviations** (the 1950s build's, on by default, each set back to the drawing on its card; `orig=gold,mainspring` in the link): the gold spring thinned at its bend (both builds), the mainspring in Nivaflex 45/5 (the 1950s build). The tolerances on the sheets are `tolerances_wempe_build.json`'s, the tests `bench_wempe_build.json`'s.
- **Checked**: `book.py --model wempe` (as the Hamilton's: every line shown on the model on some sheet, each with a material or the reason it has none and a fit, every drawing at its stated scale, legible on A4, no taller than a page), 0 findings in 227 sections; `smoke.py --model wempe` opens a sheet, switches the gold spring to as drawn and back, measures, builds the book. Not in the book: an order of assembly (the Hamilton's is its manual's Sec. VIII reassembly; no assembly instructions for the Einheits-Chronometer or the 6MX are in the sources).

## The Hamilton's model checks for the Wempe: holes, the maintaining work, the arithmetic (16 October 2026)

The checks the Hamilton's model has that the Wempe lacked, each taking `--model wempe` (its tables in `checks.py`), each in `ci.py` and failing on a fault planted with `--eval`.

- **Every hole populated** (`tools/holecheck.py --model wempe`, about 1½ minutes, in `ci.py`'s browser steps): every round hole in a flat face of every part, as last revised and as first drawn, followed along its axis as deep as the metal round it (`HOLE_WALL`), something in it or a reason it is empty on the real clock too (`HOLE_EXPECTED`). 550 holes over the two states, 504 populated, 23 expected empty: the hand setting's 14-18 (drilled, the work not fitted, as Wempe 3955's plate), the auxiliary holes 3, 12 and 40 in both plates and 20 in the upper cock, hole 30 with its seat and two M1.2, the balance holding device's 51-53 (not built: Unresolved), the pillar plate's 23 (Ø 7 under the balance, nothing on the sheets in it), the dial's Ø 1 at 185.7° (nothing under it in the ring), the impulse roller's Ø 1.3, and as first drawn the balance arm's two screw holes (the 1941 collar has none). The upper cock's screw hidden, its holes in the cock and the top plate fail.
- **The maintaining work** (`tools/maintaining.py --model wempe`, about 2 minutes, in `ci.py --full`), in three parts. On the solids, through the movement's own update (503 frames, 322 of them winding): the maintaining ratchet never turns back; running, the fusee turns with it, resting on the nearer click; winding, back; let go, it catches forward 0.0-4.8° (under half a click wheel's tooth, 5.1°: the two clicks half a tooth apart); the clicks stay 0.017-0.018 off the click wheel, the bearing one 83 % into its teeth; the maintaining detent rides the ratchet −0.010 to 0.016 off it (the seat's table of radii cuts the ratchet's sharp tips by up to 0.01), dropping up to 81 % into its gaps; its wire spring bears on it within 0.016. The page's own loop through two winds with the Wind button (18 October 2026, the ratchet ahead of the wheel by the maintaining spring's lead, `s.ms`): the ratchet turns 55.97° an hour of the train (the wheel's 56.00) and back only as the key goes on, falling to its detent (2.5-2.6° in two runs, fusee.js `fall()`, within a tooth's 3°), or with a set of the wind (the slider: 15.64°, run down with the spring spent); running, the drive is WPHYS.drv(n); a wind from 20 h keeps the train going on the spring (0.98 of the drive running, 0.80 as the key goes on, the detent's fall taken, the escape wheel on 4 teeth over the wind); from run down the spring drives nothing and the train stays held through the wind. Until 16 October 2026 (claude/wempe-maintaining) app.js's `wind0()` set `winding` before reading `drvNow()`, so the spring carried nothing into a wind. Then the stop work at full wind (`wempe_stopwork.py --step 0.05`: the pin 0.020 off the bar's far side, the least gap before 0.692). Planted fault: the click wheel 2 % large, the clicks 0.11 into it.
- **The arithmetic** (`tools/invariants.py --model wempe`, about 10 s, in `ci.py`'s browser steps): the seven pairs of wheels and pinions drawn in mesh (the fusee wheel and centre pinion, centre, intermediate and seconds; the cannon pinion and change wheel, the change pinion and hour wheel; the up-and-down pinion and wheel) each turn as their teeth through the movement's own update, their centres m (z1 + z2)/2 apart to 0.002 (22.650, 18.120, 12.630, 11.850, 12.600, 12.600, 18.400); the hands' tips point at the time to 0.1° (each tip's middle read off its outline within 0.03-0.08°; a beat each half second: 120 a minute from the escape wheel's 15 teeth, 24° a beat); setting 10 minutes turns the minute hand 60° and the hour hand 5°, the train and the fusee not at all; the up-and-down hand is at the dial's printed 0 fully wound and its 56 after 8.75 fusee turns (to 0.08°), turning with its wheel; after 56 h of the train it reads 55.77 (the train's 90/14 h a fusee turn against the dial's 3.75 turns in 24 h, 05 06_20: 0.45 % apart), at run down 55.68 for the 55.91 h run; the groove's 8.75 working turns are 56.25 h of the train, the model's wind from the stop 55.91 h; WESC.SET's balance (2,526.2 g·mm²) and escape arbor (9.96) are wempe_inertia.json's; the drawn hairspring beats 0.494 s against the train's 0.5. Reported: the Winding slider's 0.1 h steps stop 0.01 h short of run down (55.91 h), so it can't set the movement run down (the link's `wind=55.91` can). Planted fault: the hour hand turning 1 % fast fails the hour hand and the hour wheel with it.
- **The pawls** (`tools/mechanisms.py --model wempe`, about 15 s, in `ci.py`'s browser steps, writing `tools/mechanisms_wempe.json`; `tools/wempe_ratchets.js`, a second or two, in its quick steps): each pawl off the built solids, its ratchet turned the way its load turns it until it meets the pawl, then judged as the Hamilton's ratchets.js judges its own. The bearing click: 0.17 mm short of its face, 84 % into the teeth, the load drawing it in at 19.6° (16.6° with its end at the face's middle) against the friction angle's 5.7-11.3°: it seats itself; 49 N at the strongest pull, the click wheel's tooth (brass) at a margin of 5.2, its face 9.5, the screw's shoulder 19. The other click stands 0.76 short of its face, half a tooth on. The set-up click: 0.17 short, drawing in at 19.8°, 140 N fully wound, margins 5.3 and up. The maintaining detent: drawing in at 3.7-4.2°, under the friction angle, so friction holds it where it meets the face and its wire seats it; 19.5 N, margins 6 and up. When the key goes on, the maintaining ratchet falls back to its detent by anywhere from nothing to a tooth's 3.0° as it creeps on running, against the maintaining spring's 15.0° of lead over the wheel at 12 h (its drawn ring closed by the drive: The maintaining spring, above), so a wind always keeps 80-100 % of the spring's travel (the page takes the mean half tooth, `WPHYS.MBK`; until 16 October 2026 the spring's travel was read as 05 06_9's 0.27 mm, 1.09°, which about 64 % of winds would have lost). The clicks' springs (bronze 1.5 × 0.4, their free span estimated 12-16) need 0.01-0.03 mm of set to follow the click wheel down when the key lets go (the fusee and barrel weighed: 4,053 and 27,523 g·mm²). Planted fault: the set-up click's pivot mirrored across the load's line, its load pushes it out (exit 1).

## As first drawn (phase E1)

The Variants' second state (`movement.js`'s `setRev`, app.js's Sheets control): every part keeps its key, the pieces only one state has are built in groups tagged with their state and the other state's hidden, as the band is (the tools check what is shown: `audit.py --rev first`, and `fine.py`, `exploded.py` and `bom.py` with `--eval "__mv.userData.setRev('first')"`); the cards of the parts that differ take that state's text (app.js's REV, REVP). Where the earlier issue is the same line (05 04_5 carries "05 04 02-1" in pencil; 05 04_7.1 was renumbered 05 04 05 on 05 04_7.2) it keeps the line, else it has its own (the banking screw, `cone41`, quantity 0 or 1).

Wempe 3955 is made so: its escape wheel lies just under the top plate (`10_Wempe_3955_Feder_plus.jpg`), its detent block is 05 04_1's with the long arm and cone (`11_Wempe_3955_Gangfeder_plus.jpg`; `10_Vergleich_CWW-6MX_Gangfeder_mit_Kloben.jpg` the same block beside the 6MX's).

- **Heights** (05 04_1's elevation, 10:1, 24.4 px/mm): the balance's seat 4.1 over the top plate's inner face ("4,1 bis Unruhauflage", sure), 0.3 higher than 05 04 02 puts it, so the rim, arm, hairspring and collet stand 0.3 higher and the spring's top curve 3.69 under the stud's bar (its pin's hole drilled at assembly); the escape wheel's teeth 0.5 under the plate, 1.4 thick ("0,5", "1,4", sure), the web 0.8 on the pinion's side (scaled 0.74); the impulse roller under the 1941 collar's tube, 0.6 under the plate (the collar's boxed 4.7 −0.05 under the seat; 05 04_1 scales 0.42: the figures win), the discharge roller 1.6 under it ("1,6", sure); the detent 2 wide from 1.3 to 3.3 under the plate ("1,3", sure), its blade's 1 flush with its lower edge (scaled 2.34-3.36); the block's arm 3.7 to 6.5 ("2,8", "6,5", sure).
- **The staff and collar** (05 04_5, Unruhwelle 040401-1, 4.4.41): the collar 040401-2, every figure: a neck Ø 2.1 ±0.03 standing 1.3 over the flange, the flange Ø 6.3 × 1.8 straight for 0.4 then undercut 10° (to Ø 5.81), the tube Ø 2.6 ±0.03 to 4.7 −0.05 under the flange's top. The arm is riveted on the neck (drawn flush with the arm's top, its 0.15 spread into the hole, and at the arm's 2 H7); the sheet's collar has no screw holes, so the arm's two (05 03 01-1, 31.7.41) stand empty. The staff is a blank on its sheet: its ends and the collet's seat are 05 04 02's, its seats through the collar and the impulse roller Ø 1.645, the discharge roller's Ø 1.2 (estimated).
- **The escape arbor** (05 04_7.1, Gangrad 050408 bis 10, 4.4.41): the pinion's far face 15.2 from the wheel's plate face (likely), 17.7 from the arbor's top-plate end (sure), 5.3 from its dial end (likely, the figure overwritten), 23 −0.2 overall (sure): the wheel at 05 04_1's height puts the top-plate end 2.0 into the plate and the dial end 1.96 into the pillar plate, and the seconds wheel's rim lies wholly in the pinion. The arbor Ø 1.2 under the pinion; from the wheel's plate face Ø 1.05 for 0.5 and a cone to the pivot Ø 0.24 × 0.5 (scaled). The collet: a cone Ø 3.0 on the wheel to Ø 2.2 (scaled) at 1.8, then a pipe Ø 1.8 to 5 over it (sure). The wheel's bore 1.8 (05 04_1). Its jewels follow the arbor's ends: the upper hole jewel's setting fills the seat down to it, its bore opened to 0.6 for the cone; the lower bush shortened, the endstone in a plug under the cap (estimated, as the settings are).
- **The detent** (1436's first figures, the unbracketed): the foot 0.65, the square and the blade's thicker part 0.55, the blade 0.33, the horn 0.25; the gold spring 0.025 further out on the thicker square. Its plan and lengths are the revised one's (05 04_1's plan agrees: 8.4 pipe to square, the spring 5, the foot 6.6, 18.8 from the stone to the block's screw).
- **The block** (05 04_1, no sheet of its own): the base is 05 04 01-4's (its screw at hole 13, its steady pins and the foot's screw's hole fall on 05 04_1's holes), the foot's face 0.025 further out for the thicker foot; the hole Ø 1.3 to the foot's screw drilled from the plate's side, 3 deep, to meet the screw 2.3 under the plate (Wempe 3955's base shows it on that face, 2.4-2.5 from the edge). In place of the upright an arm along the detent to 2.9 past the stone, 2.53 wide and set back 1.08 from the base's edge as 05 04_1 draws it (24.5 px/mm), its far edge where the photographs' is; Wempe 3955's 3.56 wide and flush with the base's edge as both its photographs have it (3.6 at 22.3 px/mm by the base's 14.6; the drawn version's too until 28 October 2026, which cut the sheet's pipe short: drawing check 2's 2-M2). The base's end face bored for the foot's M1 and its two steady pins, as the later blocks' (05 04_1's plan draws them going in: since 28 October 2026, 2-M6), a cove r 1.82 and a ledge 0.78 into the base (scaled). Through it on the stone's line the banking screw (WN-16, the coloured section's label), 5.1 under the plate ("1,4" over the arm's face, sure): M1.2 (05 04_1's thread lines); its tail a cone 12° from Ø 1.25, starting 0.85 inside the arm's far face so it stands 2.47 out (Wempe 3955: Ø 0.84 there, 2.4-2.5 out); its gilt domed head Ø 3.3 × 1.5 on the wheel's side of the pipe, which banks on its flat face (Ø 3.29 fitted on 05 04_1's plan, 3.31-3.36 on the coloured section, 3.0-3.45 on Wempe 3955's photographs: likely; the dome R 1.8 and its edge estimated; its slot 0.3 wide and 0.45 deep right across the dome, as Wempe 3955's in the movement shows it, `10_Wempe_3955_Feder_plus.jpg`: a band following the dome, as the 6MX's; until 18 October 2026 a bar standing on the apex). Until 17 October 2026 only the tail was built (Ø 0.85), the head taken for a gilt dish on no sheet. The arm's end is slit along the screw to clamp it, as 05 04_1's elevation draws it: open at the end, 6.1 long, 0.2 wide, through the arm's width at the screw's axis (sure). The arm is built across its width (its elevation the solid's plan, so the slit and the screw's hole can be cut) and made one mesh with the base; until 18 October 2026 it was not cut.
- **The Exploded view**: the arm lies 0.28 over the lower cock's lug, so as first drawn the block, the detent and the escape wheel rise 30.3 and the lower cock 29.9 (31 as last revised): the arm leaves first and the seconds wheel (33) still clears the cock.
- **Checked** (15 October 2026), in both states: solids, the audit (its coplanar faces in `audit-expected.json` under `movement.first`), fine.py (46 states, nothing new), exploded.py, bom.py. The physics (escphys.js and the tools) is the revised escapement's: the 1941 detent's thicker spring and the heights change its figures a little, not worked.
- **The barrel** (phase E2; 0207 Federhaus, 127-556.04 U24, 15.4.41, 5:1, scaled 12.0 px/mm by its 22.3; the drum 020701, U22; its ring 020701-3): three pieces, the ring Ø 41.5 outside, 38.5 inside, 18 long (sure), the bottom (Boden) on the pillar plate's side and the lid (Deckel) on the bridge's (likely: 020701's struck note heats the ring "vor dem einsprengen des Bodens" and 0207 writes "warm einsprengen" at the plate's side; 020701's bottom is its thicker disc, 1.2 with its boss 3.1 from outside, as 0207's plate-side disc, and its lid 1.1 with its boss 3, 0207's bridge-side 1.0 and 2.9; 0207's plan "Federhausdeckel abgenommen" is seen from the bridge's side, first-angle, the arbor's square end-on in it. Until 28 October 2026 read the other way round, "sure", the lid on the plate's side: drawing check 2, 4-M1), its plate-side face 3.7 off the plate and its bridge-side face 0.6 under the bridge (22.3 between them, sure; the 3.7 scaled 3.75), each disc sprung into a seat at its end (below); the bottom 1.2 and the lid 1.0 thick (0207, sure; 020701's lid 1.1 and inside 15.7 ±0.05, a later issue of the same drum), 15.8 between them (framed); each with a boss standing 1.9 inward, its face 3.1 from the bottom's outside and 2.9 from the lid's (sure), Ø 9 with a 22½° cone to Ø 12 (020701, likely), bored 4.55 as the later drum (020701's 4.5; 0207 draws the journals Ø 5). The arbor's core is 020704-1's 12 long with its 22½° ends, between those bosses (11.9, 0.05 off each); its hook at the core's middle, and the mainspring in the middle of the 15.8, both about 0.5 lower than as revised. The hook block is the later drum's (0207 draws the same 6 × 0.5 flat at its M2.6 hole); the Steg is 0207's own (part 106, 127-556.04-097: 2 × 0.5, its plan's "0,4" off the bore, so r 18.35-18.85), through slots 2.025 × 0.55 in the 1941 lid and bottom (0207's section draws them closed round it; their size estimated); the chain lies 0.05 off the 1941 drum's Ø 41.5 (its path is the 1948 drum's 41.6). Wempe 3955's photograph (7_) shows the drum with its chain but not which end carries the lid.
- **The maintaining ratchet** (05 06 02-1 before revision (a), 11.3.48): its tips Ø 37.5 ("Maß 37,25∅ war 37,5∅"), drawn 37.45, the teeth as deep, 0.125 further out under the maintaining detent, which seats on them in this version; the struck "25,4∅" was the chamfer's top, the same chamfer the revised "0,3 +0,15" gives (Readings corrected). Built 27 October 2026. `maintaining.py --model wempe --eval "__mv.userData.setRev('first')"` passes (27 October 2026): the detent 0.011-0.024 off the teeth, the wire spring bearing on it 0.001-0.002. It had failed on two faults, neither the ratchet's: the detent was seated by its outline's corners alone against its ratchet's radius table interpolated between rays, so a sharp tip reached up to 0.015 into it between them (now its outline every 0.01 and the higher of the two rays about each angle, fusee.js `polarMax(…, hi)`; as last revised 0.015-0.025 off, -0.010 before), and the check kept the wire's first geometry, measuring the wire as built against the detent as turned (maintaining-wempe.js caches triangles by geometry now).
- **The maintaining spring** (020605, Gegenfeder kompl., 127-556.04-U18, 15.4.41, the older number of the spring 05 06 01-1, drawn the same day): the same ring, eye, holes and pins, its width given round it, 1.8 at 40°, 1.9 at 100°, 2 at 150° and 195°, 2.5 at 240°, 3.5 at 270° from the eye (sure), drawn between those figures and on to 4 at the square end as 05 06 01-1's (estimated); its outside the boxed [32,3 −0,02], drawn Ø 32.29 (32.25, under it, until 28 October 2026: the second drawing check, 3-M12a), its holes on r 14.2 as 05 06 01-1's. Its eye drawn as 05 06 01-1's: 020605 draws a larger round reaching about 1.7 further toward the square end ("4,5 / 1,7 / 6,2" and an unattached "1,5" in hand), not yet read at full zoom (3-M12b, possible).
- **Not built as first drawn: the fusee of 1941** (02 06 13, "Übergangsserie", and its body 020613-2): its large end is dished, a cone into the bore, with a collar (65) and a separate flange plate (66, held by a set screw "Gewindestift 0,7") in it and a piece at its small end (67); none of these has a sheet in the set, and the dish takes a maintaining work drawn only in the 1947-48 issues. Its groove's radii are the later body's; its flange Ø 36 (35.6 struck), its bore tapered 1:70.
- **Checked** (phase E2) in both states: solids, the audit, fine.py (the barrel's pieces built in each state's turning group with its hook block, so they stay fixed to it), exploded.py, bom.py, smoke.py.
- **The key of 1940** (phase E3; Aufzugschlüssel 127-556.02 U 01 = 51 00 11, 12.12.40, 2:1), replaced by the one-way key of 1943 under the same number: 84 overall and the stem 32 out of the body (sure); the rest traced on the sheet row by row at 6.79 px/mm (by its 84): the handle a flat pear-shaped plate, the tang (part 1; the side view draws it 3.2 thick, no bulb), widest Ø 34.8 about 9 from its top, its neck Ø 16.5; the collar Ø 20.5 × 2.9; the body (2) a cone Ø 17.9 to 10.3 over 19.3; the body from the figured 32 (built from the traced 31.7 until 27 October 2026). A one-way key, as the 1943 key (28 October 2026, the second drawing check's 10-M5, 10-M6, 10-M7; until then a plain key, the stem pressed 13 into the body, the socket round Ø 3.1 × 28, the cap one with the body and one screw a head disc with no shank): the section draws the click spring (4) as five wire sections at r 3.75 in an annular bore round the pipe (3), 1.5-6.7 under the cap's joint, and the outside view the coil dashed round the pipe, which runs up free inside the body to under the cap. Built: the pipe Ø 6.0 free in the body's Ø 6.05, its head Ø 6.78 under the spring (estimated), 0.2 of endshake under the cap's spigot; the spring five turns of 0.7 wire (scaled; its hand and ends estimated); the socket square 3.15 across (as the 1943 tube's 3,1 □ +0,05: the section can't tell round from square, and a round Ø 3.1 can't take the fusee's 3.1 r6 square), 29.2 to the drill point's foot (±0.4), its mouth sunk 60° 1.1 and its end chamfered 0.7 × 45°; the cap a part apart (the section hatches it so: a collar Ø 20.5 × 3.0 over a spigot 2.2 into the body's bore), the handle's blade let 1.5 into a slot across it (how it is held isn't drawn: estimated), held to the body by two countersunk screws (5), heads Ø 4.0 flush, M2 (the section's shank 2.3 across), 5.7 and 5.85 either side of the axis across the blade, 6.8 long, into holes in the body's top (drawn plain at the thread's size). wempe_overwind.js takes it as one-way. The sheet gives no materials: the handle and the body with its collar brass, as Wempe No. 6161's key (`antiquorum_208-4_wempe6161.jpg`: the pear-shaped handle and the collar with its slotted screw brass; the body under it not seen: sure for the handle and collar; black, as the 1943 key's, until 18 October 2026). It stands in the box's key holder where the later key does, on its body's cone. The case's pieces of each state follow the movement's (app.js), so `audit.py box --rev first` audits the box with it (its faces under `box.first`).
- **On the cards only** (phase E3): the figures the revisions changed by less than the model can show, or only in their tolerance, each part's card as first drawn giving the earlier: the movement ring before revision a (6.12.46: 10.7 −0.05, 3 ±0.05, 7 ±0.07, 0.7 +0.05), the lower cock's seat (+0.05 before 2.12.46), the click before 25.5.48 (its hole's tolerance), the set-up ratchet (2.63 −0.03 before 24.11.47), the seconds arbor (24 −0.05 between its shoulders and its wheel's seat 1.3 −0.1 before 24.3.48), the intermediate arbor's pivots (0.82 −0.02, 1940), the change wheel's and the hour wheel's printed tips (21.30, 20.0, before the pencilled 21.05 and 19.7) and the hour wheel's 1.0, and the 1941 fusee (not built, above).

## The Soviet 6MX (phase X)

*Status (18 October 2026): complete. X0-X4 (16 October 2026) built the switch, the movement, the dial and finish, the case and boxes, the cards, the essay's paragraphs, the report's section and the physics worked apart; X5 (18 October 2026, below) settled what they left: every one of the 6MX gallery's photographs read for the model, the parts measured on them built (the escapement's collet and detent block, the lower cock, the ring's screws, the bowl, brackets, closing plate and outer box), its electrical contact built, and the page running the 6MX's own escapement. What no source shows stays in "Estimated" (The Soviet 6MX) and "Unresolved"; the asks for the photographs that would settle it in REQUESTS.md.*

The Variants' third version, Soviet 6MX (Kirov No. 247, 1952; `rev=6mx` in the link): the 6MX (6МХ) the 1st Moscow Watch Factory made from these drawings after 1946-47, built as one photographed chronometer is made, as Wempe 3955 stands for the first-drawn sheets. Kirov No. 247 (February 1952, first generation) has Altmeppen's full set (`photos/dg-chrono-6mx/`: its dial, top plate on millimetre paper, dial side, four obliques, detent and box) and his arrowed comparisons with a Wempe. Its electrical contact (`E-Kontakt`) is left out. The plan is `PLAN-wempe-6mx.md` at the root.

**X0, the switch (16 October 2026).** The version control (heading "Version") has three buttons. `userData.rev` now lists the versions a group shows in (`'last 6mx'`: the revised sheets' pieces the 6MX kept; `'first'`; `'6mx'` for its own), `setRev(v)` shows a group if its list holds `v`, and each `onRev` callback gets the version's name. Until its own parts are built, the 6MX shows every revised piece: its views are pixel for pixel the last-revised ones (`views.py --model wempe --eval "__mv.userData.setRev('6mx')"`). Both earlier versions rendered unchanged, every view 0 px. The tools: `audit.py --rev 6mx` (its keys `movement.6mx`, `box.6mx`), `ci.py`'s `wempe-audit-6mx` and `wempe-exploded-6mx`; `bom.py`'s `dev` entries take a list of versions in `rev`; app.js's cards per version in `REVC`.

**How Kirov No. 247 is measured.** Its top plate (`2_Kirow_247_A.jpg`, square-on) is put on the sheets' hole table by a similarity on four arbors seen on it (the fusee's square in the cork ring, the barrel's square, the balance's cap jewel, the escape wheel's endstone) and pillars 11 and 49: 8.98 px/mm, every residual under 0.55 mm; `holemap.py --model wempe` lays it over the model's plan hole by hole (it now takes `--model`). Its dial side (`3_Kirow_247_uZ.jpg`) the same way on seven holes (the centre, seconds, change wheel, intermediate, escape and the intermediate bridge's two screws): 8.63 px/mm, under 0.42. The millimetre paper under the top plate gives the paper's scale (8.8 px/mm), not the plate's, which stands well above it. Screws' centres are circles fitted to their edges.

**X1a, the frame (16 October 2026).** Each piece and how sure:
- *Pillar 39 at 190°* (Altmeppen's list: pillar 39 in another place). No pillar or screw at its drawn 210° on either face; its screw at 190.0° (top) and 189.6° (dial side), where 11 and 49 read 94.9/94.8° and 350.1/349.9°, their drawn bearings: sure to ±0.5°, pillar 49's 350° mirrored across the O-W line. Its radius reads 36.6-37.3 (each reading corrected by 11's and 49's in the same fit). On r 37 the drawn pillar (Ø 8.1) would stand 0.11 into the drawn seconds wheel's tips (Ø 21.9); it clears them from r 37.2, so it is drawn at r 37.3, 0.2 clear (likely; the 6MX's seconds wheel isn't seen). Both plates' holes and seats, the pillar and its two screws move with it (`WD.P39_6MX`).
- *No hole 20 in the upper cock* (Altmeppen: no window in the upper cock; his comparison's arrow points at the Wempe's hole there). Kirov 247's cock is plain where the overlay puts it: sure.
- *No hole 53 in the top plate* (Stift f. Wendelfeder, for the balance holding work): Kirov 247's plate is bare there, in plain view: likely. Holes 51 and 52 lie under its balance, unseen, and are kept.
- *Holes 3, 12 and 40 kept.* Hole 3 is a clean Ø 3.6 hole at 0.3° (its Ø 3.5 at 0°), 12 at 105.0° (105°), 40 partly under the barrel bridge at 224°: so Altmeppen's "three small windows by the pillar screws" are not these Hilfslöcher, as frame.js had read them (unresolved: what he meant isn't found on Kirov 247's photographs).
- *Jewels in chatons* at the intermediate arbor's two pivots and the seconds arbor's upper (Altmeppen; the TU's 15 jewels are the drawings' 12 and these three). Flush gilt settings about Ø 4.1 on both faces of Kirov 247, the pivot in the middle, no screws. Each chaton fills the bush's hole (4.59 in the plate, 4.3 in the bridge), its stone flush with the face the arbor's shoulder bears on, so the endshake stays the drawings' (likely); the stone Ø 2.2 × 0.6 and the sink estimated. `bom.json`'s six lines carry `"rev":"6mx"` (a line with `rev` counts only in those versions), the bushes `"last first"`, and the arbors' `in` relations take either (`WN-300.t38|6MX.jw38u`); `checks.py`'s `JEWELS` is per version (15 for the 6MX).
- *The electrical contact's fixings* (X5, below): the top plate's two Ø 3.5 access holes over the contact's base screws (219.0° r 37.5 and 179.8° r 38.72, the latter re-read blind on Kirov 247's and 1564's plans on 7 November 2026, 179.1° r 38.6 until then: the README read the 219° one, with the screw's dark slotted head 19 mm down in it, as "a cheese-head screw in the top plate at S 28.75 W 23.07"; Kirov 1564's, without the contact, are open to the pillar plate); the dial side's two flush screw ends at 180° r 38.2 and 220° r 37.9 (M1.7, open on Kirov 1564). The small hole read at S 20.6 O 30.2 is the detent block's near steady pin's hole, read 1.4 off (7 November 2026, the 6MX audit: (-29.98, 21.88) on Kirov 247's and 1564's plans; a brass pin end on 247, open on 1564). The pin is built 0.33 from that, at (-30.0, 21.55): the read place would put its hole through the block's end face (Unresolved).

**X1b, the escapement (16 October 2026).** The 6MX has the escapement at the heights the sheets first drew, with the revised block's form:
- *The escape wheel just under the top plate, on a long cone collet* (likely). Kirov 247's detent view (`8_Kirow_247_F.jpg`) and Kirov-Poljot 24020's (`9_KirPol_24020_Feder2.jpg`) show it so, as Wempe 3955's (`10_Wempe_3955_Feder_plus.jpg`, the first-drawn version's source); Altmeppen's comparison of Wempe 3955 with a 6MX (`1_3_Vergleich_Wempe-6MX_Feder.jpg`) marks the block, not the wheel. On 24020's, scaled by the block's base (6.5 deep, 26.6 px/mm), the wheel's teeth read 0.35-2.3 under the plate. So the 6MX takes the first-drawn balance, rollers, escape wheel and arbor and their jewels (`'first 6mx'`), and their Exploded offsets. The staff's form (the 1941 collar or the 1946 hub) isn't seen on any 6MX photograph: the first-drawn one, the staff the sheets draw at these heights, is built (estimated).
- *The detent* at the first-drawn heights its block holds it at (the foot 1.3-3.3 under the plate), with 1436's revised (bracketed) sections (likely). It is not shorter than 1436's: the 6.4 from the pipe to the square read on the loose 6MX block until 18 October 2026 divided a foreshortened span by the scale across the block; along the detent (24.5 px/mm) it reads 8.2 (7.8-8.6), the drawn 8.4 (X5).
- *The block, 05 04 01-4 read in first angle*, as the sheet itself reads (DIN's; How the balance and escapement were measured): the upright at the free face, 3.5-6.5 under the plate; on 24020's it reads 4.1-7.0, the detent's blade 2.9-4.1 above it (±0.3 with the camera): sure in kind, the sheet's figures kept. The 6MX settles, for itself, the reading the drawings leave unresolved: its block hangs its upright below the detent, at the first-drawn heights. Its foot a taper (below); the hole Ø 1.3 drilled from the plate's face to the foot's M1.
- *The banking*: the cross screw through the upright, centred, its domed brass head Ø 3.4 × 1.4 (Ø 3.2 until 29 October 2026: below) on the wheel's side of the pipe, which rests on its flat face (24020's: Ø 3.2 against the upright's 3; the loose block's, `8_Gangfeder_mit_Kloben_Rus_einfach.jpg`, reads Ø 3.8 by the upright's 3.0 at 26 px/mm, which would stand 0.13 into the gold spring's path as it bends aside: the mounted reading taken, likely), its thread 0.6 out behind the upright.
- *Not built:* the adjusting slide. The loose block has a gilt slide in a notch across the base's plate face under a slotted cylinder, and a large slotted screw (head about Ø 3.4 on 24020's, 2.9 under the plate) in the base's end beside the detent's foot; how they meet the plate's hole 13 and which way the slide moves aren't seen (Unresolved). Nor is the collet's form: both 6MXs show one long gilt cone, about 5 long, as Wempe 3955 (Unresolved, below); the first-drawn arbor's cone and pipe are built.

**X1c, the barrel (16 October 2026).** *The barrel cap underneath* (Altmeppen's list; Knirim's, against Lange's Kal. 100): the drawings' own barrel, the 1941 three-piece barrel the first-drawn version builds (0207, 020701; its arbor's core and the mainspring 0.44 lower with it): likely. Kirov 247's side views (`4_`, `6_Kirow_247_N`, `S`) show a drum about Ø 41.5 × 18 under the chain, too fine to tell that ring from the later drum turned over. The maintaining spring stays the revised one. Not built: *the lower balance cock's other shape* (Unresolved). Since 28 October 2026 the drawings' 1941 barrel is read with its lid on the bridge's side and its bottom on the pillar plate's (drawing check 2, 4-M1): the 6MX is built with that barrel, and which side the 6MX's own cap is on (Altmeppen's "underneath") isn't modelled apart: its discs are the same sizes either way.

**X2, the dial (16 October 2026).** Kirov No. 247's dial (`dg-chrono-6mx/1_Kirow_247_Z.jpg`), traced as the two German dials are (`dialtrace.py --dial kirov`, into `js/dialface_kirov.js`, `WDIALFACE_KIROV`; the Variants' dial switch, *1st Moscow Watch Factory*, which choosing the 6MX selects):
- *Its layout is the drawings'*: the six printed circles fitted by one homography to 10-25 µm, the sub-dials' centres on the arbors at (0, ±23), measure Ø 89.96, 84.91 (the minute track's lines), 26.18 (the up-and-down circle), 37.13, 33.01 (the seconds track's), 22.79 (the seconds' inner circle), the sheet's 90, 85, 26, 37, 33, 23. Printed thin, as Lange 5177's (blur sigma 0.031 mm), its up-and-down sub-dial laid out as Lange's: the circle open at the top (338.3-22.6 deg) for СПУСК (run down) and ЗАВОД (wound) along it, the band's end strokes at 0 and 56 running in to r 5.33. Every figure of the geometric printing is `dial.js`'s `KIROV`, from `--dial kirov --geo`.
- *Traced:* the hours, the up-and-down figures 0-56, СПУСК and ЗАВОД, the seconds figures, the factory's mark 1МЧЗ and ИМЕНИ КИРОВА across the centre, and the serial 247, written in red ink: traced from red alone (red over the other channels, each stroke half way to its own core: the pen's strokes 0.40-0.45 wide, the 2's lighter), drawn #ff617f (the photograph's 165, 59, 79 on its paper's 149, 146, 145, scaled to the model's paper). Where the hands cover the printing: ИМЕНИ's last И (its lower corner under the minute hand) is its first, the same glyph; under the seconds hand's head and stem, the 4's upright (it shows at x 1.59 from its top, z 16.85, to the crossbar) is drawn on down to the line's foot (z 19.25) and the 7's bar (it shows at z 15.46 from x 3.95 to its corner) on 0.4 under the head, straight pen strokes 0.42 wide (estimated; until 16 October 2026 they were lost and the serial read 241); the brass hands' boss and their shadows are cut from the ink, not filled in.
- *Its screws at the 19, 39 and 59 minute marks* (Altmeppen's list): 112.5, 233.6 and 353.1 deg on the photograph (±1 for its tilt), drawn at 114, 234 and 354, the German dial's 120 and 240 moved; the movement ring's tapped holes for them move with them (both built per version).

**X2, the finish (16 October 2026).** *Geneva stripes* on the plates, cocks and bridges (Kirov 247's, 1952; the Wempe's are hammered, drawn plain gilt): straight, 3.95 mm apart (an FFT on plain patches of its top plate, 3.73-4.28 at 8.98 px/mm, and its dial side, 3.71-4.35 at 8.63: the median), running at 50 deg in each face's own photograph (49.8-50.3 and 48.5-52.1): in plan along (-0.643, 0.766) over the top plate, cocks and barrel bridge as one sweep (its stripes run on across them), and along (0.643, 0.766) over the pillar plate's dial face and the intermediate bridge (each plate striped from its own face). Across a stripe the photograph's brightness, folded on the pitch over two patches and averaged (each to its brightest), falls slowly from 1 to 0.61 and rises quickly back: the gilt material's map (frame.js's `G6`), on `solidGeo`'s plan UVs. Likely: the profile is the photograph's light; the faces it doesn't show (the plates' inner faces) take the same. Altmeppen's "the finish changed in the late 1950s" is later than Kirov 247, which is already striped. The barrel and intermediate bridges are built per version for it, their pins with them.

**X3a, the bowl and bezel (16 October 2026).** The 6MX's bowl isn't R-05 01 00-1 outside: no Ø 118 flange, but a threaded rim Ø 110.5 for a knurled bezel screwed onto it (Altmeppen's "the bowl and bezel brass", and Kirow 422's knurled bezel). Inside it is the drawings' (the bore, its round, the bottom, the recess and closing plate, the winding hole's seat): the movement is the drawings' and stands in it as drawn. Each reading and how sure:
- *The rim, Ø 110.5* (sure to ±1.2): on Kirov 247's dial photograph (`1_Kirow_247_Z.jpg`, in its bowl with the bezel off), scaled by `dialtrace.py`'s own fit of its printed circles (8.75 px/mm, 0.01-0.03 mm rms), 24 rays round the dial read the dial's edge at r 51.0-51.2, the movement ring's gold flange to r 53.0 (its 105.95) and the bowl's dark rim outside it to r 55.0-55.6. The rim stands a little under the dial's plane, so ±0.6 for the camera. Kirov 009, 1564, 2973, 22823, 23239 and Poljot 00127's dial photographs, all in their bowls, show the same narrow rim round the flange (by eye).
- *The outside profile* (likely in shape, its heights estimated): Kirow 422's bowl turned over (`dg-chrono-dec/11_Kirow_DEC_422_Gehäuse.jpg`, side on), its silhouette traced every 4 rows and scaled by its band (930 px) as that Ø 110.5 (8.42 px/mm). Body r 51.8 (51.6-52.2: smaller down the photograph, which lies farther from the camera), a cone to the foot, the foot read r 37.5 and taken as the drawn 36.25 (the camera, about 0.33 m off, makes the foot about 4 % larger than the band; the cone's radii are scaled down the same way, 0.962 at the foot to 0.987 at the body), a step and round out to the band (rows 448-472), the band up to the bezel's edge. The heights come from the photograph's rows, put on the movement's frame by two ends: the foot's face at the drawn YB − 65 (the floor where the cork ring's seat needs it) and the bezel's glass 0.65 over the hands. That is 0.1322 mm a row, 6.4 % more than the photograph's own vertical scale (8.05 px/mm at its widths and a 15° view). The close camera leaves that stretch unmeasured: the view tilts from 9° at the foot to over 20° at the bezel. So, from YB: the foot −65 to −62.4, the cone to −51.3, the body to −13.2, the round to the band by −10.0, the band to the bezel's edge at +0.55.
- *The threaded rim round the flange* (likely): Kirov 14917 with its bezel off (rAw2zmulpk8 0:29 and 2:52, 1080p) shows the thread running up to the gold flange round the dial, and its loose bezel threaded inside. Drawn flush with the flange's top (YB + 4.7), its counterbore r 53.05 down to the drawn seat at YB. A notch 1.8 wide at 12 o'clock takes the ring's radial pin (WN-202, its end at r 55.0), down to YB + 0.8, through the thin wall under the bezel (estimated). The thread isn't drawn.
- *The bezel* (likely in shape): traced on the same photograph. Its lower edge r 56.1 swells (a bell) to the knurl's tips, r 58.3 (Ø 116.6). The knurl runs over 42 rows, 5.5 mm by the stretch; it is diamond on the photographs, drawn as 360 straight teeth 0.4 deep. Then a plain lip rounds into the top face at YB + 13.5. The glass is thick and stands proud (`12_Kirow_DEC_422_Kasten_1.jpg`: a green edge over a narrow brass top): Ø 107 × 4.0, its top edge chamfered 0.8, its underside YB + 12.0, 0.65 over the hands' highest point (the minute hand's boss, 17.70 in the movement's frame), its top YB + 16.0, where the drawn bezel's top is. Inside (estimated: no photograph shows it): the glass's seat 1.5 deep, the sight bore r 52.1 over the dial's edge (51.8), and the shoulder at the rim's top bearing on the flange and the rim, which holds the movement down as the drawn bezel's recess does.
- *The brackets*: the drawn case brackets and locking bracket, their plates on the 6MX's narrower body (r 51.8). Kirov 14917's inner pivots (rAw2zmulpk8 0:29: the cone-pointed screw in the gimbal ring's middle, below the bowl's rim) work out about 15 mm under the dial's face (YB − 10 ± 3, the frame tilted 53° by the dial's ellipse), the drawn YB − 11.5. Kirow 422's brackets stand higher (Unresolved).
- *The winding hole's shutter*: Kirov 14917's foot (rAw2zmulpk8 0:12 and 0:36, the bowl turned over) has the turning closing plate in its recess, its centre screw and its round hole away from the winding hole: the drawings' (05 01 00-2), kept. The pin in a slot on Uy8A88_j-cA (5:21-5:25) is a later Polet's, not built.

**X3b, the boxes (16 October 2026).** Kirov No. 247's box and outer box (`dg-chrono-6mx-gallery/leben-des-6mx/13_`, `14_Kirow_247_Kasten_*.jpg`), built in the drawings' box's place (the gimbals, pivots and transit lock as drawn):
- *The box, 190 each way* (the TU's "190x190x190", 1984: the only figure; sure for the later 6MX, likely for 1952): orange lacquered wood (Kirov 247's sampled #dc6914 to #e07c3e, drawn at 0.7 of it as the mahogany is), in three tiers, as Kirov 1564's, 2973's, 22823's and 23239's (Kirov 422's and 479's, German movements finished in Moscow, have one glazed lid). The tiers measured on Kirov 22823's box, nearly square-on (`bilder-zum-6mx/10_Kirow_22823_Kasten.jpg`), as parts of its height at both edges: the body 97 (0.506, 0.514), the glazed lid 68 (0.354, 0.360), the top lid 25 (0.140, 0.127): likely. Kirov 247's own front puts its parting lines 72 apart by the hasp's width.
- *Its fittings* (likely, by Kirov 247's front, `14_`, scaled by the hasp, 53 wide: 22823's 215 of 773 px): two hasps with knurled screws (the head Ø 11 × 5 on the lower leaf, 6.4 under the line), across both parting lines; the factory's diamond badge on the glazed lid, 38.6 × 24, its centre 37.6 under the upper line, lettered "1 МЧЗ им. Кирова"; the number plate on the body, Ø 31, 40 under the lower line, "247"; brass strips 27 × 12 round each vertical corner at the bottom, 27 under the lower line, 25 under the upper and capping the top (22823's); a ring handle on each side (22823's).
- *Estimated*: the walls 10; the glass in the glazed lid's top under a frame; both lids hinged at the back, opened together (the page has one lid; `WCASE`'s `rev(v)` gives the page the version's lids); the bottom 93.5 under the pivots as drawn, the pivots 2.5 longer for the wider walls, the transit lock's bracket reaching the right wall, the key's shelf with legs 65 so its front edge and the key stand where the drawings' do.
- *The outer box* (estimated in size): of the same wood, felt-lined, a half-round notch in the body's front at the parting line into which a half-round tab on the lid's front closes, a turning hook on the tab over a brass catch under the notch, the number plate 247 on the lid, a leather strap on each side (Kirov 247's, `13_`; Poljot 08479's, `14_Poljot_08479_Kasten_komplett.jpg`). No photograph scales it: 250 each way and high round the box (felt 18 under and over, 8 at the sides, walls 12), the parting line at half, the notch r 48 (`13_`: 0.38 of the front's width). The red cloth bag it stands in (the TU's "чехол") isn't drawn.

**X4, the 6MX's physics (16 October 2026).** `tools/wempe_6mx.js` (with `wempe_inertia.py --rev 6mx`, which weighs its escapement's bodies on the page's solids in that version) works out what its differences change; the page keeps the drawings' swing and rate (the user's choice):
- *The jewels in chatons* change nothing the energy budget can see: the model's sources give oiled steel in ruby and in brass the same friction (μ 0.10-0.15, `physics.js`), so the train's efficiency is the drawings'. They tighten the pivots' shake (the jewel holes the pivot's and 0.025, estimated; the drawn bushes 0.035 and 0.05 loose), and so loosen the holes' tolerance a CNC must hold: ±82 µm against ±77 at the centre-intermediate mesh, ±60 against ±47 at the intermediate-seconds, ±35 against ±25 at the seconds-escape (the escape jewels' own shake 0.03).
- *The first-drawn balance staff and collar* (no hub screws): the balance's inertia 0.01 % less, a beat shorter by about 24 µs, 4.2 s a day fast before timing (4.4 until the bodies were weighed again for 3.06.02), which the timing weights take out as they do the drawings' balance's. The detent's inertia 2.6 % less and the escape arbor's 0.1 %: the swing (191.9-202.0° over the wind, since 16 October 2026's reading of 05 04_1's angles) and the escapement's rate against 12 h are the drawings' to 0.1° and 0.01 s a day.

**X5, completing it (18 October 2026).** Every photograph in the 6MX gallery (`dg-chrono-6mx-gallery/`, thirteen more 6MXs), Kirov 14100's parts laid out (`chasy-ru-9985-kirova-14100/`) and Romanov's *Proektirovanie priborov vremeni* (1975, Figs. 95-101 and their parts lists) read for the model, each part then measured as below (the 1950s Kirovs first, Kirov 247 before the rest; the user's choice, 17 October 2026). Each reading and how sure:
- *The escape wheel's collet*: one straight cone with a square shoulder onto the arbor, no pipe: Ø 2.77 at the wheel to 1.70 at its end (1.55 since 29 October 2026: below), 5.08 long on `8_Kirow_247_F.jpg` (18.3 px/mm by the wheel's Ø 14 tips and the pinion's Ø 2.97), 3.14 to 1.58 over 5.23 on Kirov-Poljot 24020's (26.4 px/mm): likely. Kirov 247's built; the first-drawn version keeps 05 04_7.1's cone and pipe.
- *The detent block's fixing*: not through hole 13 but by a slotted steel stud Ø 3.4 flush in the top plate's outer face, 2.2 S of it, between two steady pins 10.0 apart (`holemap.py --model wempe` on `2_Kirow_247_A.jpg`, six seeds, 8.993 px/mm, every residual under 0.57; `2_Kirow_009_A.jpg` by hand; each corrected by hole 12's 0.4 offset; the two agree to 0.3: sure to ±0.4). In the block's frame its pins stand 1.9 nearer its end than 05 04 01-4 puts them, the stud 2.1 nearer and 0.8 across from hole 13; the block itself stays where the escapement needs it (its holes drilled otherwise: Unresolved). The plate's holes per version (`WESC.HOLES.block6`). The near pin, 0.55 inside the end face, goes 1.2 into the block, clear above the detent foot's pins (estimated).
- *The adjusting slide and the stop screw* (on the loose block, `8_Gangfeder_mit_Kloben_Rus_einfach.jpg`, 30.3 px/mm across, 24.5 along, tilted 30-36°): a gilt key 3.2 wide, flush in a notch across the corner of the base's plate face and free side, from the stud to the edge and 2.5 down the side, the stud through it; a large slotted screw in the base's free side 0.9 from its end and 3.3 deep, its head Ø 4.0-4.4 over the end face by 1.2, beside the detent's foot (every 6MX Feder photograph shows it): likely in kind. Kirov 14100's loose detent has a slotted foot, so the screw is most likely a stop for the foot's place along the block, the banking setting the lock; how the slide works isn't seen (Unresolved).
- *The block's upright*: slit since 29 October 2026 (below); until then no slit (the loose block's upright, its face toward the plate, is plain to its end with the banking screw's thread straight through it: likely), and a short taper at its root, widening 0.46 over its last 0.9 (about 27°, on that photograph only: estimate), where the model drew r 2 (estimated). The banking screw's head Ø 3.2 × 1.4 was taken to fit all three readings (3.3 loose, 3.1-3.4 on 247, 3.4 on 24020; the loose block's 3.8 came from the wrong scale).
- *The lower balance cock*: full depth only over its lug, the rest of the bar toward the screw and pins cut back to 3.3 deep (every 6MX side view of the detent, a stamped number on the deep part; on `8_Kirow_247_F.jpg`, the full depth taken as the drawn 10: 3.3, 3.0-3.9): likely; the step 1.5 past the lug's edge so the lug and the screw's hole stand on the full depth (estimated). Its plan stays the drawings', and its step is in question (the side views fix only a line across the plan; the loose piece once taken for it is the upper cock: Unresolved).
- *The movement ring's screws*: at 342.2°, 102.2° and 246.4° ±0.5 (both of Kirov 247's faces, `holemap.py --model wempe` at 8.89 and 8.57 px/mm; Kirov 009's and Poljot 20027's the same: sure), so 120°, 144° and 96° apart, where the drawings put 340, 100, 220; steel slotted heads Ø 6.1 ±0.2 × 2.0 (drawn 6.2) where the drawings' are brass 6.2 × 3.05. The ring's band and its tapped holes per version.
- *The bowl, re-measured*: its outside with a pinhole camera fitted in the meridian plane, scaled by the rim's Ø 110.5, on Kirov 2973's bowl near side on (residuals under 0.3 px) and Kirov 247's: the thread r 55.25 down 5.55 from the rim's top, a collar r 56.6 to 7.76, the body r 52.4 (until then 51.8) to 46.7 (247: 47.0), a shallow cone to the foot r 36.7 at 55.3, the foot on to the drawn floor (its end isn't seen): likely. A cone that high leaves no room for the drawings' bore: the inside follows the outside, the bore r 49 then a cone 3.4 inside the outer one to the recess's wall (estimated; the movement's lowest parts clear it by 3.4 and more).
- *The brackets, the high form* (Kirov 247's own bowl, `11_`, `12_Kirow_247_E-Kontakt_*.jpg`; Kirov 2973's the same; Kirow 422's too): each case bracket a flat plate 9.7 high (12.8 to 22.4 under the rim's top), its wings 27.5 either side of a block 8.7 wide which rises 1.8 over the rim's top, the pivot's hole 4.8 under its top (3.0 under the rim's top: ±2), the wings' slotted screws 16.8 from the block at 17.4 under, through the bowl's wall (the small holes in the bore of Kirov 247's and Kirov-Poljot 24020's bowls 16-21 under the rim are their ends: likely); the locking bracket an upright 11.7 wide, two screws in a vertical slot at 20.0 and 27.4 under, cranked out past the bezel to an L hook 3.8 over the rim's top, the pad the transit lock stops against (Romanov p. 204). So the 6MX's bowl, with its bezel, closing plate and movement, hangs 7.0 lower in the gimbals than the drawings' (13.2 until the drawings' case pivots were raised on 25 October 2026; case.js's `bowlS`, `DY6`; app.js adds the movement to it); the later Kirov-Poljot 24020's pivots stand 10.8 under the rim, as the drawings' nearly do.
- *The closing plate*: a flat disc, no boss (Kirov 14917's foot square on, rAw2zmulpk8 0:11.75; Kirow 422's; a modern one, moMvyx8eXfo 7:20: likely), its screw's head about Ø 8 on its face, the domed knob about Ø 6.5 at r 19 ±2 (the drawings' 25); its groove, holes and spring as the drawings' (the spring unseen on any 6MX: Estimated), the spring's end shortened into the thinner plate.
- *The outer box*: its front about 233 wide (±7 %, the inner box's 190 scaled on `13_Kirow_247_Kasten_1.jpg` and Poljot 08479's), the notch a circular segment, chord 102, depth 33 (until then a half-round r 48), the catch 51 under the parting line. The lid's tab reads larger than the notch (chord 105-111, 41-44 high) and may lap over the body's front: drawn filling it (Unresolved). The parting line's height and the straps' places are hidden by the bag (estimated as before).
- *The seconds wheel*: the gilt collet on its arbor under the wheel (`6_Kiro_247_S.jpg`) is the contact wheel's (below). Pillar 39 reads Ø 8.0 ±0.5, the drawn 8.1; its radius stays 37.3 (Estimated).
- *The electrical contact* (Kirov 247's: `leben-des-6mx/10_`-`12_Kirow_247_E-Kontakt_*.jpg`, `6_Kiro_247_S.jpg`, `2_Kirow_247_A.jpg` and `3_Kirow_247_uZ.jpg` against Kirov 1564's without one; Kirov 009's, 2973's, Poljot 08479's and Kirov-Poljot 24020's of the same design; Romanov 1975, p. 105's parts 52-69 and Figs. 100-101, p. 209; the user's choice, 17 October 2026, to build it). On the pillar plate's inner face by pillar 39, from 176.5° to 236°, a gilt base 58 (2 thick, its outer edge an arc r 45.7 past the plate's rim, cut round pillar 39; its inner edge from Fig. 100: estimate) screwed to the plate by two M1.7 screws 56 (above); on it, on black fibre 68 (1.8) and insulated by bushes 67 (their black flanges Ø 4.6 under the heads), two gilt blocks, 52 (+, 177.6-201°) and 57 (−, 209-231°), each held by two steel cheese-head screws Ø 3.1 × 2.6 (182.9°/193.3° and 214.6°/226.0°, r 43: the two steel heads seen under the top plate's edge are 57's); a gilt knurled contact disc 55 (Ø 11.9 × 1.2, 48 teeth) upright in its radial plane at 207.7° on a bracket on block 57, turnable to renew the contact (the user instruction); the lever 60 pressed on a staff 69 (206.2°, r 31.8 on Fig. 100 mapped, ±1.5; taken r 31.0, so the spiral's measured Ø 8.9 clears the disc) jewelled at both ends, a hole jewel and an end jewel in a setting in the base and in an L-shaped gilt cock over it under a cap plate, its stone 61 (a corundum pallet with a bevelled end) on the contact wheel 10.0 from the seconds arbor, its other arm (15.1) carrying the brass contact screw 54 with a lock nut, tangential at r 45.5, its point on the disc's low face; a flat copper-coloured spiral 59 (7 turns, Ø 8.9) from the staff's collet to a stud 53 on block 52, both the lead and the lever's return. The contact wheel 62 on the seconds arbor under its wheel (Romanov: fixed to it), on a gilt collet Ø 2.0 rising 3.0 above it (3.1 and 3.55 until 18 October 2026): 60 ratchet teeth, tips Ø 20.4 (likely), roots 18.6 (estimate), 8 spokes, one tooth left out. In the bowl, two flat brass springs 66 on black insulation, each held by two screws 65 through the wall, three tines bearing on a block's outer end; outside, their slotted brass heads and a brass socket for each lead, + at 200.6° and − at 235.9°, on black fibre washers, all 27.5 under the pillar plate's inner face (`12_Kirow_247_E-Kontakt_3.jpg`, a camera fitted on the band; the springs on `11_` and Fig. 101: likely; their sizes estimated, ±15 %). The heights from Fig. 101 (9.68 px/mm, which gives the seconds wheel's height to 0.06 and the 19 between the plates) and the S views (10.5 and 21 px/mm). Five more jewels, as the TU's 20 against 15 without the contact (`checks.py` JEWELS). It works as Romanov (p. 209) and the user instruction describe it: the seconds arbor turns 3° a beat, half a tooth; on one beat the wheel's sloping flank lifts the stone (the lever turns about 4°) and the screw leaves the disc, on the next the tooth's radial face lets it fall and the spiral closes it: open half a second, closed half a second, and at the missing tooth closed a second and a half, at the minute (train.js `update`, `R.c6`; which half-second is open isn't given: estimated). The parts the photographs show are where they show them; the stone and the staff's place, seen on no photograph, are Romanov's figure put on them (estimate). **Rebuilt to the photographs (18 October 2026)**, `10_Kirow_247_E-Kontakt_1.jpg` through photocompare.py's `m6_contact` camera (0.6 mm at the block screws) and `14_E-Kontakt1.jpg` (another 6MX of the same design, the `m6_contact_front` camera, about 1 mm): a millimetre scale stood at the staff, the seconds arbor and the screw's tip through the first gives the heights, and the two together give places across the view (they look along nearly the same line, 14° apart, so depth stays Fig. 100's). The cock's arm −12.9 to −14.2, 1.3 thick (−11 to −13.2 before), its leg run up to it; its cap plate three lobes, the two screws and the end jewel in a row 2.1 either side (along (−0.97, 0.24) as triangulated), the arm rounded r 1.6 past the far screw (a round plate with its screws 75° either side of the arm's axis before); the spiral at −11.7 to −12.3 just under the arm, its end run out over the stud and bent down onto its top beside the clamp screw (head Ø 2.2) (−8.5 to −9.1 before, from Fig. 101); the lever gilt (steel before), the contact screw Ø 1.0 threaded, at −5.85 (the photograph's −5.15 ±0.6 taken at the top of its range, to pass 0.1 over block 52's top), held in a gilt block under the lever's end with a brass lock nut 1.1 across; the disc's knurl square, its low face recessed Ø 6.0, 0.3 deep (estimated), a slotted steel axle screw (head Ø 2.6) in it, no raised boss. Left as drawn: the cock's leg renders about 2.5 further from the disc across the view than both photographs show it, within Fig. 100's ±2 but at its edge; moving it needs the arm's root and foot, whose depth no photograph fixes (Unresolved). The fine check required: the stone's end narrowed by its bevel (0.3 at its point), the stud's outer face at r 44.0, one block screw 0.15 off pillar 39 and the cock's screw and pins placed clear of its leg (each within its reading). The base overhangs the pillar plate's window for the intermediate wheel (0.23 over it), so in the Exploded view the 6MX's intermediate wheel leaves toward the dial after its bridge, as a watchmaker takes it out, the lever, spiral and cock lift clear of the contact wheel first, and its seconds wheel rises 30.6.
- *The page's physics* (the user's choice, 17 October 2026): the 6MX runs its own escapement, `WPHYS.rev('6mx')` with its weighed bodies (`WESC.SET6`, checked by `tools/wempe_6mx.js` against `wempe_inertia.py --rev 6mx`), its swing table and its 35-day trial (`WEDATA.rev6`, `wempe_essaydata.js`, its children run as the 6MX: `wempe_load.js`'s `MC_WREV`), in the Swing and isochronism and the Rate and trial panels and in the export to Blender. With the contact wheel weighed on its seconds arbor (the escape arbor's body 10.89 g·mm² against the drawings' 9.96), its swing is under the drawings' over the whole wind (190.2-200.2° against 191.0-200.5°: `tools/wempe_6mx.json`, its escape arbor 10.19 g·mm² since 29 October 2026, the shorter pinion; 190.1-200.1° against 191.9-202.0° when first worked out), its rate against 12 h theirs to 0.01 s a day; the mainspring is the drawings' (the 1958 Navy repair book's 1.01-1.08 N·m fully wound is the first generation's MX, which a strip about 0.42 thick would give, but no 1950s source gives the 6MX's strip: Unresolved).

- *The contact revised (24 October 2026).* The lever's boss sits on the staff just under the spiral's collet (−10.2 to −11.5), not at the screw's height: on Kirov 2973 (`14_E-Kontakt1.jpg`) and Kirov-Poljot 24020 (`12_KirPol_24020_E-Kontakt2.jpg`, 16.7 px/mm by the cock's arm) the boss is 0.1-0.3 under the collet, the staff bare steel under it, and the arm runs down from it to the screw's holder on block 52 (likely; Kirov 247's own lever is hidden behind the stud and holder). Both arms are drawn sloping from the boss to their ends at the old heights (−6.1 to −7.4); the stone arm's slope is estimated, since no photograph shows it. The staff is Ø 0.6 under the boss (8-11 px against the block screws' Ø 3.1 at 23-26 px/mm, a little further off: Ø 0.4-0.6) and Ø 1.0 above it. Until then the boss and both arms were flat at −6.1 to −7.4, 4.5 under the spiral, on a staff Ø 1.0 the whole way. The cock (its foot, leg, arm, cap plate and screws) was compared again on 2973's, 24020's and 247's photographs and left as it is. The block's stud has a real slot, 0.5 wide and 0.9 deep, square across the base (the loose block, `8_Gangfeder_mit_Kloben_Rus_einfach.jpg`, 30.3 px/mm: 15-17 px across, running about 12 px down the stud's side; likely), in place of the kit's 0.35 × 0.55 at an arbitrary heading. The 6MX's block has no Ø 1.3 hole between its near steady pin and the stud (25 October 2026, the owner's choice): 05 04 01-4 drills one there from the plate's face to the detent foot's M1, and the German block in `10_Vergleich_CWW-6MX_Gangfeder_mit_Kloben.jpg` shows it, but the 6MX's face is plain there on that photograph and on `8_Gangfeder_mit_Kloben_Rus_einfach.jpg` (at about 30 px/mm it would be 40 px across: sure). The drawn versions keep it. The 6MX face's dot between the stud and the far pin (about Ø 0.3, a small hole or a punch mark) isn't drawn. The whole contact (on the pillar plate, on the seconds arbor and in the bowl) is hidden on the page unless Variants' Electrical contact is set to Shown (`contact=1` in the link; the owner's choice, 24 October 2026); under `?qa` it is shown, so every tool weighs and checks it as before, and the physics is the same either way.

**Checked again against the photographs (29 October 2026).** The 6MX's escapement, its block and the parts at their heights, each read on the photographs before the model's figures were looked at (Kirov 247's `8_Kirow_247_F.jpg` at 18.3 px/mm, scaled by the escape wheel's tips, 257.5 px for Ø 14, and its pinion's Ø 2.97, 54 px; Kirov-Poljot 24020's `9_KirPol_24020_Feder2.jpg` at 26.6): `WEMPE-VARIANT-ESCAPEMENT.md` at the root has every reading. Changed:
- *The upright is slit* along the banking screw, parallel to the plate, from its end into the screw's hole: a line about 0.1 wide on both chronometers, the thread showing in it, 2.85-2.9 from the end face on 247 and 2.8 on 24020 (sure). The loose block's face toward the plate is plain (X5), which a slit parallel to the plate doesn't contradict: it doesn't show from that side. Built 0.12 wide, ending in the hole (its far edge 3.07 from the end), the upright's end extruded across with the slit and hole in its profile, as the 1943 block's.
- *The banking screw's head Ø 3.4*: 3.45 ±0.1 on 247 and 3.43 on 24020 at the wheel's own scale (likely); the 3.2 came from scaling by the upright's 3.
- *The escape pinion 3.77 long, from 11.15 to 14.92 under the escape wheel*, its foot about 2.2 over the pillar plate (likely ±0.1): the 3.9 and 1.5 read on the same photograph came from a tip span of 247 px (17.65 px/mm), where the tips measure 257.5.
- *The collet's end Ø 1.55*: 1.37-1.57 on 247 at 6×, 24020's 1.58 (likely).
Matched: the base's 6.5 at its end, the stop screw's head (Ø 4.4 ±0.15, the model's 4.2) and place, the collet's length (5.19 ±0.1) and its diameter at the wheel, the wheel's rim 1.37. Not settled by any photograph: the adjusting slide and stud, the lower cock's plan and step (Unresolved), the upright's height (3.45 ±0.3 read against 3.0: possible) and the screw's axis 0.4-0.6 under its middle (one view: possible).

**The sheet, Soviet 6MX against the drawings (18 October 2026).** The panel's section after Variants lists every difference the 6MX version builds (app.js's `X6`: 22, grouped as frame, escapement, barrel, electrical contact, ring and dial, case and boxes), each with what the drawings have, what the 6MX has and how sure the reading is, as this section gives them. Choosing one turns the model to the 6MX and closes in on it, the rest see-through (`VIEWER.focusOn`, `shared/viewer.js`: the parts' box, or a place where a part's own box would lose the change, as for pillar 39, the hand-setting holes, hole 53 and the moved ring and dial screws); Drawings and Soviet 6MX flip the version where the camera stands; a view chosen, Reset, Back or Whole model ends it.
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
