OrelMag/marine-chronometer-model/marine-chronometer-source/chronometer-working-model/README.md

# The Marine Chronometer, working

**Work in progress (31 October 2026).** The Hamilton model is built about 12 % too small: every millimetre measured on photographs and videos came from one sale listing's pillar plate (87.57 mm), where the British Museum's example measures 97.8 and Hamilton's factory drawings (`References/Hamilton-original-drawings/`) agree. It is being rescaled and its drawn parts rebuilt from the drawings (`PLAN-hamilton-drawings.md`, `RESCALE-CLASSIFICATION.md`); until Hamilton's drawings of every part are in hand, its sizes and the figures worked from them are provisional. The page says so in its header and About.

Interactive 3D model of a two-day fusee marine chronometer with a spring detent
escapement, running in real time inside its gimballed case and mounting box.
Built with three.js r128. There is no bundler and no package manager: the page
is plain HTML, CSS and JavaScript.

## Run

Open `index.html` in a browser. It loads `css/`, `js/`, and three.js and the
fonts from `../../vendor/`, all from local files, so it works offline.

`dist/chronometer-working-model.html` is the same thing as one self-contained
file. `python build.py` here regenerates it. Normally you run `python build.py`
at the repository root instead: it also refreshes the root copy and assembles
the website (see the root README).

## Files

| File | Contents |
|---|---|
| `index.html` | Page markup: the stage with its 3D model / Essay tabs, walkthrough card, controls (View, Time, Winding and Display, open by default, and Parts, Rate and timing weights, Stopping and starting, Cross-section and Variants, closed; every section folds, and each viewer's open ones are remembered in `localStorage` as `cm-open`), the About dialog with sources and method, and the essay (`<article id="essay">`: its text and its figures' markup) |
| `css/style.css` | Layout, theme tokens (light and dark), controls, labels |
| `css/essay.css` | The essay's styles (its page, `../essay/`; this page's Essay tab until 21 October 2026): a reading page in the model's tokens; its classes start `e-` |
| `js/core.js` | Math helpers, materials and procedural textures (plate striping, wood grain, engraving), gear / hairspring / hand / mainspring geometry, dial artwork, cross-section shader patch, the tinted and ink drawings (`drawOf`, `makeInk`) |
| `js/mainspring.js`, `tools/mainspring.py` | The mainspring's shape in its barrel over the wind, `MSHAPE`: the strip's equilibrium from its measured free curve, solved by `tools/mainspring.py` (torch, about 30 min; `--write` from its last solution) and drawn by `mainspringGeo` in `core.js` ("The mainspring, solved" below) |
| `jsconfig.json`, `js/globals.d.ts` | Type checking without npm: the scripts in load order, and the globals TypeScript can't see; `core.js`, `movement.js`, `box.js` and the shared scripts start with `// @ts-check` (`ci.py` runs `tsc`) |
| `../shared/escapement.js` | The detent escapement's solver, `makeEsc(settings)`, shared with the essay's detent figure and `tools/escapement.js`; `makeEsc(settings, base)` solves another chronometer's (its teeth, radius, lock, detent, tooth form, drive), counted from its own reference |
| `../shared/escplan.js` | Its plan, `drawEscPlan(ctx, w, h, state, E, o)`, drawn from the solver's outlines, as Fig. 90 has it: the walkthrough's inset and the adjuster's bench (three names, the stage written under it) and the essay's detent figure (every part named, a dial for the balance's angle); `escStage(state)` names what the escapement is doing |
| `../shared/almanac.js` | A nautical almanac and the navigator's arithmetic, `ALM`: the Sun, Moon and 58 stars, sidereal time, the altitude corrections, sight reduction, the time sight, equal altitudes, clearing a lunar distance, and sights made from the almanac for the essay's worked examples (see "The almanac" below); shared with `tools/almanac.js` |
| `../shared/hairspring.js` | The hairspring's design, `HSPR`: terminal curves solved to Phillips' conditions, the whole spring's path, the force it leaves on the pivots, the strip's section from the stiffness ("The hairspring, designed"); shared with `tools/hairspring.js` |
| `js/makers.js`, `js/maker.js` | The maker's tools ("What the model gives a maker" below): `MAKERS`, each parts-list line's measured fit, material and treatment (written by `tools/makers.py`); `MAKER`, each card's maker's sheet, drawing (SVG) and STL, Measure, the build book, the model's data as JSON, the movement as STL |
| `js/overhaul.js` | The overhaul ("The overhaul" below): `OVH`, the manual's 58 operations to take the movement down (Sec. V) and 105 to put it back (Sec. VIII), each with its tools (Sec. XIII's numbers), figures, oil and the parts it moves by their parts-list lines; the parts moved one operation at a time, as the Exploded view moves them. One IIFE; app.js calls `OVH.bind()` |
| `js/gltf.js`, `js/blender.js` | The export to Blender ("The model in Blender" below): `GLTF`, a binary glTF 2.0 writer (nodes, meshes, materials, textures, morph targets, animations; one IIFE); `BLENDER`, the export itself: its own copy of the model, every motion played through it and read back |
| `blender/rig.py`, `js/rigpy.js` | The rig, run in Blender's Text Editor after the import (Blender 5.x); `js/rigpy.js` is its text for the panel's Blender rig button, written by `tools/rigpy.py` (`--check`: up to date) |
| `js/movement.js` | The movement: layout constants, the escapement (`ESC=makeEsc(...)`, with the centre distance from `L`), screw positions and holes, pillar plate and bridges, going train with tooth phasing, fusee wheel and maintaining work, fusee, chain (instanced links) and barrel, balance, hairspring, detent, train-blocking screw and balance locking arm, motion work, and the per-frame `update()` |
| `js/box.js` | Mounting box, lids, gimbal ring, chronometer case (bowl, bezel, crystal, shield plate that turns to admit the winding key), winding key |
| `js/report.js` | Report a bug or inaccuracy (under Controls below): the dialog, and a log of the page's last 30 errors and warnings, kept from the first script on. Loaded first; one IIFE that declares only `REPORT` |
| `../essay/js/essay.js` | The essay (see "The essay" below), on its own page since 21 October 2026: its figures, drawn from the Wempe's model, its sections and hash. One IIFE that declares only `ESSAY` |
| `js/app.js` | The parts registry (`PARTS`: every part's name, description, part numbers, group, colour and flags; `PIECES`: the pieces of the parts that are several things), renderer and shadows, camera and gestures, visibility/focus system, cross-sections, part picking and descriptions, labels, the eight-step walkthrough with its live diagrams, stopping and starting (the balance's amplitude, the locking arm, the train-blocking screw, the twist), and the animation loop |
| `build.py` | Inlines the CSS, JS, three.js and fonts into `dist/` (through `inline.py` at the repository root), with the version and the list of changes from the root `CHANGELOG.md` (`changelog.py`) |
| `dist/chronometer-working-model.html` | The built single file (committed) |
| `tools/bundle.py`, `tools/fit.py`, `tools/unproj.py` | Photo fitting: camera fits to the Fig. 2 and top-view photographs, triangulation of the balance, fusee and barrel axes, photo points projected onto the movement (see "How the layout was measured") |
| `tools/almanac.js`, `tools/almanac-ref.json`, `tools/almanac_ref.py` | The almanac's check (Node, about 1 s): Meeus's worked examples, the Sun, Moon, stars and sidereal time against JPL Horizons and skyfield (`almanac-ref.json`, made by `almanac_ref.py` with the network: SIMBAD's catalogue, Horizons' DE441 places, skyfield 1.55 with de440s), and round trips of every reduction; the essay's stated accuracy (`data-bound` spans) must cover the worst found |
| `tools/physics.js` | Phase A's physics derived (Node, under a second): the energy budget from the mainspring to the balance, the escape wheel's chase onto the impulse jewel (its inertia measured on the solid), the balance's Q the budget needs (which sets `TF`), the detent spring's preload from Op. 78 and its share of the work, temperature from the materials; the essay's `data-phys` figures must be what it finds |
| `tools/makers.py`, `tools/selfcontained.py` | `js/makers.js` from `bom.json` and `BOM.md` (`--check`: up to date); the check that the page alone is enough to make the chronometer and navigate with it (no network, the manual shipped, every card's sheet, the essay's checked figures, the tools in the page) |
| `tools/solve.py` | Reads `L` and `TRAIN` from `movement.js`: solves the escape arbor against `L.E`, gives the modules and wheel tips, checks the arbors clear the wheels in plan (no browser) |
| `tools/p3map.json`, `tools/cock_outline.json`, `tools/engr.json` | Traced from the top-view photograph: its mapping into the model, the balance cock's outline, the engraving columns |
| `tools/dyn.py`, `tools/interference-check.js` | Voxel collision check through a full escapement cycle |
| `tools/views.py` | Before/after renders of every view (frozen, labels hidden), a pixel diff between two runs (`--md` as a table), and close-ups of chosen parts; `--page` renders another copy of the page, as `ci.py --views` does for where a branch left `main` |
| `tools/isolate.py` | Renders chosen parts alone, everything else hidden, each view beside a reference image (a photograph, a video frame, a figure): the check after any change to a part's geometry |
| `tools/maintaining.py` | The maintaining work over run and wind cycles: the sustaining ratchet never turns back, the sustaining spring is loaded in running and only relaxes while winding, the fusee catches forward when the key lets go, the pawls sit on their teeth, the stop-bar meets the winding stop at full wind, and, the fusee swept from full wind to run down, it passes the stop more than the fusee's widest endshake clear (0.1 mm) |
| `tools/fine.py`, `tools/fine-interference.js`, `tools/barrel-clearance.js` | Fine (0.05 mm) collision check through the escapement cycle, round the train and over the wind, against a table of expected contacts; the barrel's margins and the mainspring |
| `tools/audit.py`, `tools/geometry-audit.js`, `tools/geometry-audit-box.js` | Geometry audit of the movement (and, with `audit.py box`, the box and gimbals): overlapping or unsupported screws, loose arbor ends, coplanar faces, isolated parts, among the parts shown, in one frozen state; anything not expected (the loose ends in its `LOOSE` table, the coplanar faces in `tools/audit-expected.json`) fails, `--update` rewrites the coplanar faces (`--eval JS` after loading, e.g. to fit a variant or plant a fault) |
| `tools/exploded.py`, `tools/exploded-check.js` | Exploded-view clearance: every part and screw, taken as it stands assembled, against every other, at every spread from 0 to 100 % (none may meet at full spread, or pass through another on the way), over escapement phases, train positions and the wind |
| `tools/overhaul.py`, `tools/overhaul-check.js` | The overhaul's clearance (about 12 s): every operation of both sequences followed as the page moves its parts, every pair of bodies against each other (exploded.py's columns); none may pass through another, but those in its `EXPECTED` table, each with its reason (a part a real movement takes out sideways or tilted, or a reading still open) |
| `tools/solids.py`, `tools/solids-check.js` | Solid geometry check: every mesh closed (no open edge), consistently wound and not inside out, but the decals and surfaces flagged as such; loaded as it is and with Moving parts only and a section on |
| `tools/placements.py` | Every mesh's position and bounding box in seven model states (escapement phases, train and wind positions), and a diff between two runs or two copies of the page: proves a change moved only the parts it meant to, and that the mechanism moves as before |
| `tools/escapement.js` | Measures the escapement against the manual's adjustment figures (Node.js, no browser) |
| `tools/escgolden.js` | The escapement's fingerprint: every result `makeEsc` gives the Hamilton hashed bit for bit against `tools/escgolden.json` (Node.js, no browser) |
| `tools/keystone.js` | Measures the escapement against a period text's rules for the chronometer escapement (*Watch and Clock Escapements*, 1904); reports, never fails (Node.js, no browser) |
| `tools/invariants.py` | Checks the model's arithmetic: hands against the time, the wind indicator's scale, the fusee's 56¼ h and 17½ half turns, the balance's moment of inertia and the rate for a turn of the weights (exit code 1 on a failure) |
| `tools/smoke.py` | Loads the model and clicks through every control (views, walkthrough, the overhaul, variants, sections, time zone, keys, a URL-hash link), then opens the essay's own page (`../essay/`), scrolls it and works every control in it (the model not drawn under it, at most two WebGL contexts, a link into the model and Back, `#essay=detent`); fails on any console error or warning (`--model`, `--essay`: one half) |
| `tools/p3fit.py` | Renders the model from the top-view photograph's camera |
| `tools/gltf_check.py`, `tools/blender_check.py` | The export to Blender checked: the page's own export written to `r_model21.glb` and read back (structure, accessors, the tree, names, every clip), then that file imported into Blender headless (`MC_BLENDER`, else the usual install; skipped without one), the rig run and set against the export's own clips, and two renders (`r_blender_*.png`) |
| `verification/lower-bridge-comparison.png` | The balance lower bridge against its sources: the restoration video's face-on frame (13:49.5) beside the model seen from the same camera (`tools/framecam.py`), the model's outline drawn on the frame, the measured and model plans (`tools/lower_bridge.py`), the two levels side-on (36:45), Figs. 110, 29 and 30, and the model from below, in place and from above |
| `tools/lower_bridge.py` | Lays out the balance lower bridge after the restoration video's (13:49.5, measured with `tools/framecam.py`; formerly 36:01, measured through a camera fitted to the train bridge's rim; Figs. 29, 30, 110) round the model's arbors and what it must clear, reports the clearances, prints `LB_UP`, `LB_WALL` and `LB_LO` for `movement.js` and draws the plan beside the video's outline (no browser) |
| `tools/rimfit.py`, `tools/rimfit_36-01.json` | A plate or bridge lying on the blue mat in a video frame, put in millimetres through a perspective camera fitted to its rim (and to round settings traced on it, made to come out circular): picked points at their heights above the face, turned onto the model by named arbors (no browser). The specs: the restoration video's upturned train bridge with the balance lower bridge (36:01), the dial side (40:08) and the bare plate from the train side (34:30, its rim traced beforehand: `rim_pts`) |
| `tools/framecam.py`, `tools/anchors/lower_bridge_13-49.5.json`, `photo_lower_bridge.json`, `photo_lower_bridge_cam.json` | A video frame's (or a photograph's) camera recovered from the homography `video.py anchor` fitted on it (the focal length where the face's axes come out orthonormal): picks put back on planes at their heights off the anchored face, the `--look` for `isolate.py` that sees the model from that camera, and a render warped onto the frame beside it (no browser for the picks). The specs: the balance lower bridge on the train bridge's underside at 13:49.5, and on a phone photograph (`References/photo-lower-bridge-underside.jpg`, f about 970) |
| `tools/train_bridge.py` | Builds the upper train bridge's notch, horn and mouth from their edges measured on two frames of a restoration video (`tools/anchors/`), prints `TB_NOTCH` and `TB_EDGE` for `movement.js` and the metal left round each hole; with the frames, draws the outline back on them (no browser) |
| `tools/video.py` | Teeth and parts from videos of real Model 21s (`References/README.md`, "Videos consulted"): fetches a video (yt-dlp) and takes contact sheets and frames from it, into a folder outside the repository; counts a wheel's teeth one by one on a frame, unrolling its rim along a fitted ellipse, and writes strips for checking the count by eye (no browser) |
| `tools/topview.py` | Renders the model from above and warps it onto `References/photo-top-view.jpg` through five screws on the barrel bridge: `verification/topview-comparison.png` (photo, model, the two blended); `--hide PARTS` or `--eval JS` (a variant fitted: `"__mv.userData.stop('navy')"`) write `r_topview.png` instead |
| `tools/social.py` | Renders the 1200 × 630 link-preview images into `site-assets/`, the model on a dark background beside a title column: `social.png` (the page's preview: the dial in its box, hands at 10:10) and `social-movement.png` (the moving parts, titled for the essay, for posting) |
| `verification/` | Reference results: the top-view comparison, the Fig. 2 overlay and its camera fit |

## Controls

Speed: the presets, or any value from 0.01× to 10,000× on the Custom slider or typed in; the space bar stops and restarts. Up to 5× (`REAL_X` in `app.js`) the balance is drawn swinging as it really does; faster, a real swing would be a blur, so it is drawn swinging at 0.9 Hz with the detent and trip spring still, and the HUD adds "balance swing shown slowed". At every speed the train goes by the balance's real phase, so the escape wheel steps a tooth a beat, stops and starts on whole beats, and a change of speed moves nothing. While winding, model time runs at most 10× (`WIND_X`), so a wind takes at most about 3 minutes of it, inside the 5 to 10 minutes the sustaining spring drives the train (Sec. IV); the HUD says so. Right-click a part to fade, hide or isolate it (Isolate shows that part alone, box and floor shadow gone; picking a part from the parts list, or ticking its box, adds it to the isolated ones); right-click empty space to bring hidden parts back or leave isolation. On touch screens a long press (half a second, barely moving) does the same; Android's own long-press `contextmenu` and the page's timer open the menu once between them, and the press never picks.

- The **?** button on the model (or the **?** key) opens a card listing every control, for a mouse and for touch, with this device's first; the header and the hint word the gestures for the device too (`.m-only` / `.t-only`, switched by `@media (hover:none)`). A tap in the model, × or Esc closes it; dragging doesn't, so the gestures can be tried with it open.
- Keys 1–9 pick the views, in the order of their buttons. Exploded has a Spread slider and a Take apart switch (25 October 2026; `exp=all` in the link): Movement, the movement alone as before, or All, the box and case taken apart too under it, up the bowl's axis (`box.js`'s `explode(e)`: the gimbal ring with its pivot screws, the case, its shield plate, the bezel and the crystal; the latch and the key out to the right, the lids back off their hinges), the camera stood back to see it all. Its offsets are a view's layout, not measurements; Spread sets both.
- **Overhaul** (the card under the walkthrough's): **Take it down** and **Put it back** step through the manual's operations ("The overhaul" below); Back and Next move one operation's parts, the slider goes straight to any operation, Play goes on by itself, End overhaul gives back the view, speed and balance stop it found. The model stands still meanwhile.
- Double-click a part (double-tap on touch) to zoom to it: the camera closes in to fit the part's shown meshes (centring without backing away when the part is larger than the view) and then turns about it, following it as the movement lifts or spreads (`focusPart` in `app.js`); double-click empty space, 0 or Reset for the whole view again. A second click within 0.4 s and 24 px of the first makes the double, on any pointer (`lastTap`).
- Back and Forward (↶ ↷ under the tabs, Backspace and Shift-Backspace): the places the view has been, up to 30. Each jump made with a view button or key, Reset or 0, a double-click, a panel's Show button or winding keeps the place it left (`jump(f)`), unless it didn't move the camera; the walkthrough keeps its own steps, and links and the opening view aren't kept. The buttons show once there is somewhere to go back to.
- The panel's width (wider than 960 px): drag the line in the gap between the model and the panel, or the arrow keys on it (Home and End for the narrowest and widest); double-click it for 350 px. 320 to 640 px, leaving the model at least 600 px; on a wide screen the page grows with the panel, so the model keeps its width. Remembered in `cm-set` (`pw`) with Remember settings.
- Hide panel: the tab on the stage's right edge (or the **P** key) hides the panel and gives the stage its width, remembered in `cm-set` (`nopanel`) with Remember settings; the walkthrough and a link opening a panel section (`open=`) bring it back. It is offered only where the panel sits beside the stage (wider than 960 px, or a landscape phone) and not in full screen; with the panel below the stage (portrait) the tab is hidden and the class does nothing.
- Fusee (`#view=fusee`) looks across the line from the barrel to the fusee, plates see-through, so the chain runs from one to the other. Balance (`#view=balance`) is the balance close up under its cock, with the timing weights; Rate and timing weights' Show the balance goes there too.
- Laid out in a line (`#view=laidout`) is the textbooks' developed drawing of the train: the arbors set in one
  line and seen square from the side, hands below. The barrel and fusee stay where they are, and the line runs
  on from the barrel through the fusee; the centre, third, fourth and escape arbors follow, each at its real
  centre distance from the one before, so every pair still meshes. The escape wheel, detent and balance turn
  together about the escape arbor, so the escapement is unchanged and the balance ends the line.
  - Each driven pinion is turned by the change in its line of centres times (1 + driver teeth / pinion teeth), so its leaves stay in the driver's gaps.
  - The real plates and bridges are hidden, since their holes no longer meet the arbors, and so are the box and case.
  - See-through schematic plates stand in for them: pillar plate, train bridge, barrel bridge, a cock over the balance, and pillars. They are drawn only in this view and go with Moving parts only; they carry no part name (not listed as parts, sectioned, checked or exported as the movement's), but each stands in for its part (`userData.devOf`, 25 October 2026): a click on one opens that part's card and shows it solid. Where a part shows through a stand-in the click goes to the part; where stand-ins overlap, to the smallest. Until then they took the case's part name (`bowl`, the group the movement hangs in), so a click on one would have opened the case's card had it not passed through.
  - Kept shown, though its part is hidden (`userData.devKeep`): the winding stop (42099) in the barrel bridge's underside, which the fusee's stop-bar meets at full wind (the export's laid-out state keeps it too). With it the view holds every element a textbook's developed drawing letters ("Modern chronometer movement", Figs. 83 elevation and 84 plan). Its top plate (A′) is the Model 21's two bridges, the upper train bridge and the barrel bridge; its B′, the stud carrying the stop work, has no counterpart (the stop-bar slides in a slot across the fusee's top); its S′, the snail the stopping arm meets, is the winding stop (the stop work turned round); its s, the arm's spring, is the stop-bar's spring (42025), in the recess round the hub under the fusee's top plate and out of sight from any side. `tools/laidout.py` checks each is shown and opens its own card when clicked (`--model wempe` the Wempe's) and draws both views on one sheet with the drawing's letters and a key (`r_laidout_sheet.png`).
  - The camera's field of view narrows from 32° to 20° so the elevation looks nearly flat.
  - The Spread slider sets how far the train is laid out (`mv.userData.develop(e)` in `movement.js`, 0 as built, 1 laid out).
- Time: set the hands to any time of day, or to now. The model keeps Greenwich Mean Time by default, as U.S. Navy chronometers were kept (the HUD says GMT); Keep: Local time switches to the viewer's time zone, moving the hands by the difference. The HUD shows the time the hands show and, once it is a quarter second or more, the dial error against the master time (below): `+` fast, `−` slow, to the half second as a navigator records it. Now sets the master time to the viewer's clock and the hands to it; Set the hands moves the hands only, so it makes a dial error. Neither turns the train: the hour and minute hands go round by the cannon pinion's slip, as the key turns them, and the second hand, which is on the train, is put right as Stop to set does it (the locking arm stops the balance, then a twist starts it as the time comes round to the hands), so the dial is never more than a minute fast while it waits (`setHands` in `app.js`; until 11 October 2026 they moved the model's clock and the whole train, backward as often as forward). A time in the page's address is set directly as it loads. Local time moves the master and the hands by the zone's difference through the slip alone. Tick sound is under Time too.
- Setting, With the key: sets the hour and minute hands as the manual does while the chronometer runs (Sec. III, "Setting While Running"). The gimbals are latched, the bezel and crystal come off, and the winding key goes on the hand-setting square, turned by its shank, forward only: the minute hand goes on its marker half a minute behind the master, and to the next marker as the master's second hand passes 60. The second hand is never touched, so the dial can still be up to 30 s out, as the manual says; the Time section reports it. A dial that is fast has its hands turned nearly round the dial. The hands turn on the centre arbor as the cannon pinion slips (`slip`, passed to `update()`), which leaves the train and the second hand alone. How fast the key turns is illustrative. Another view, or the walkthrough, ends the setting.
- Adjuster's bench (its own section): the escapement's six settings on sliders (trip-spring tip `rT`, discharge-jewel reach `rd`, depth of lock `dL`, locking-jewel draw `DRAW`, and the discharge and impulse jewels' angles `aD`, `aI`). Each change rebuilds `ESC` with `makeEsc` and takes it over in place (`Object.assign`, so everything reading `ESC` follows), rebuilds the detent pieces, trip spring screw, roller and jewels (`mv.userData.escSet()`), and measures lock, let-off, overall, drop, roller shake, the teeth's dip, horn clearance and the jewels' angle against the manual (`ESC.checks()`, as `tools/escapement.js`), with the plan view live beside them. The model runs with the settings: they set the balance's running amplitude `ESC.A` (which the balance eases to) and the escapement's rate `ESC.run.rate`, s a day against the model's settings, which multiplies into the model's rate as `escK` ("The escapement's amplitude and rate", below); the Rate panel says how much of the rate is the escapement's, and the rate book notes "escapement adjusted". A setting at which the escapement would not run (`ESC.measure().runs`), or at which the balance would swing too little to keep it going (`ESC.A` under `ESC.AMIN`), is refused, with the reason, and the last working one kept. The least amplitude that runs (`ESC.AMIN`) follows the settings: past it the train stops, and a twist starts it again. The hash carries the changed settings (`esc=rT:0.29,aI:185`). The model's settings are one button away; the geometry checks (`fine.py` and the rest) cover only those.
- Rate book (its own section): the navigator's record of Sec. IX, Table I. The dial is compared with the master at noon each day, master time, and on Compare now; the error is read to the nearest half second, as the hands step. The daily rate is the change in error per day, taken against the latest comparison at least half a day back with no break (started, stopped, set, not wound) since, since over a shorter time the half-second reading swamps it. Below the table, the mean daily rate and mean deviation over the last ten rates since a break, and live for the current dial error, what it does to a position: 4 s of time is 1′ of longitude, that many nautical miles times cos(latitude) (Latitude input), uncorrected and after the navigator's correction with the last error and the mean rate. The remarks are recorded automatically. The rate is steady in the model (only the weights, screws and escapement's settings change it), so the mean deviation shows the reading's half-second steps.
- Setting, Stop to set: the manual's other way (Sec. III, "Setting When Stopped"), to the second. The button is the next step: Stop to set locks the balance with the locking arm (the manual stops the balance by hand, the movement out of its case), Unlock arm takes the arm off with the balance at rest, and Twist to start gives the twist. Meanwhile the Time section counts down: to the moment the master overtakes a fast dial, or to when the second hands agree on a slow one, after which the minutes are set forward with the key. The wheel stands locked, so the second hand is on a half second, and what is left after the start is the moment of the twist (and the fraction of a second the balance takes to pick up).
- Winding: Since winding and Wind, and Wind with the key. Wind with the movement in its case (the Box and Dial views) winds it as the Wempe's page does and the manual has it (Sec. III, Winding; 26 October 2026): both lids open and the latch's lever comes out, the case turns over in the gimbal ring about its 6-12 pivots, the shield plate turns to uncover the key hole, the key leaves its corner block and comes 60 mm along the square onto it, the fusee is wound, and it all goes back (`cw` in `app.js`, 0.8 s a stage, estimated, the Wempe's); with the movement out of its case, or Moving parts only, the key goes straight onto the square as before. Wind with the key which turns the fusee half a turn at a time, 17½ half turns from run down (the fusee's 8¾ turns, 56¼ h of chain), with the plates see-through and the winding stop kept solid. For the last turn the camera closes in on the fusee's top: the chain winds over the stop-bar's nose, and the bar's far end comes round to the winding stop.
  Three options under it act whenever the model winds (the key, Wind, or the walkthrough's Wind it now). **Load path in colour** (on) tints the parts carrying the train's load (`lpCol`, `tintOf` in `app.js`, from the `lp` tags `movement.js` sets): while winding the sustaining spring, which drives (rose), and the sustaining ratchet and pawl, which hold (teal); for 2 s after the key lets go, the mainspring's whole path in rose (barrel, chain, fusee, winding ratchet and pawls, sustaining ratchet, spring, fusee wheel). **Close-up of the sustaining spring** (on) draws the fusee wheel's maintaining work again in a box at the stage's lower left (`cuDraw`): the same renderer and canvas (a scissored viewport, layer 1 for its parts and the lights, so the page keeps to two WebGL contexts), seen from the train bridge's side in the movement's own frame, the sustaining ratchet drawn at 45% so the spring under it shows; under it, the spring's drive left, 10 min less `R.ssD` of `R.SMAX`. **Exaggerate the spring's motion** (off) draws the spring relaxing 20 times as far (`ssX` in `update()`, up to `SMAX`) and eases it back over 0.4 s at the catch; the working end's pin moves round the ratchet with it, while the ratchet, the pawls and the time left stay the real ones. At 1× a wind from run down takes about 17 s of model time, about 3% of the spring's travel, too little to see without it. The close-up has its own tools in a row under its title (`cuBind`): the mouse wheel, a pinch or + and − zoom about the pointer (to 16×), a drag moves the view, a double-click resets it; ⤢ enlarges the box (to 600 × 470 px); the speed button gives slow motion, ¼×, ⅒× and 1/25×, which acts only while the close-up shows and slows the key, the model's time, the 2 s after the key lets go and the spring's easing together (`mClk`, the clock `kwStep` and the load path's phase run on; the HUD says Slow motion); ⊙ keeps it open after the key lets go, as **Open the close-up** under Winding does, to watch the spring under load in running (tinted as the mainspring's path, its gauge then how hard the spring pushes); and ? opens **How the sustaining spring takes the load** beside it (`cuHelpBuild`, `cuHelpSet`): the band, its two pins and why the whole drive passes through it, then running, winding and the key let go, the phase under way opened and picked out with its figures of the moment (the fusee's drive and the spring's push as shares of the 12-hour drive, the spring's gap from `R.SSG`, the swing, the drive left, and what letting go now would cost, from `R.release()`), its links zooming the close-up onto the spring's working end and gap, the sustaining pawl or a winding pawl and following it. Under `?qa`, `__lp()` gives the phase (`ph` 'w' winding, 'r' the 2 s after, '' otherwise; `now`, its clock `mClk`) and whether the close-up shows, and `__cu()` the close-up's zoom, pan, part followed, enlarged, kept open, explanation and slow motion.
- Rate and timing weights: turn the timing or vernier weight pair in or out by eighth turns, up to 3 turns either way from mid-travel. `R.timing(nt, nv)` in `movement.js` moves them and returns the balance's moment of inertia, computed from the balance's geometry and the parts list's masses (1,140 g·mm², Table II's). The weights' thread pitch (`R.pitch`) is set so that a full turn gives the manual's figures (p. 70): about 40 s a day for the timing pair and 2.8 s for the vernier pair, which makes the pitches 0.178 and 0.142 mm. Below them, a screw pair stands in a hole (3–12, numbered round each half from the arm's end as the numbered balance block of Fig. 99 numbers them) and takes any of Table II's five head heights (0.040–0.100 in) and the washers of Table III (0.002–0.010 in) under its heads, as Op. 3 changes them; it can be moved to another empty hole (Op. 8), taken out, or another pair put in (up to all ten holes): `R.screws(pairs)` sets them and `R.timing` counts their masses. The panel puts the manual's figure for the change (Tables II and III, for pairs) beside the model's, and for a pair moved along the rim Table IV's change in the rate at 90 °F against 55 °F (`R.T4`); a temperature slider (40–100 °F) runs the clock with that change, linear about 72.5 °F, the standard set taken as compensated, and the balance's own curvature on top (`MTE` in `core.js`: the Model 21's from the factory test card of No. 3390, the split balance's illustrative); a chart below it plots the rate from 40 to 100 °F for the balance shown, the other dashed, and gives the Navy test's three temperature compensation figures against their limits. With the split balance shown, its rim curls with the temperature, drawn 20 times as far (`R.balCurl`). Zero puts back the weights' mid-travel, the standard screws and 72.5 °F. The panel's state is kept in the link (`bal=`, as `esc=` keeps the bench's). The model clock `tSim` then runs `rateW`·`escK` as fast as real time (`rateW`: √(I₀/I) and the temperature; `escK`, the escapement's share at the balance's swing now and the drive's torque, `ESC.rateAt`: 1 at the model's settings and 255°), so the hands gain or lose; the panel shows the daily rate, the escapement's share of it when there is one, and what the hands have gained since the weights, screws or escapement were changed or the hands set.
- Mainspring, Let down and set up (under Winding): the manual's let-down and set-up, on the wall clock (`ldStart` in `app.js`, about 25 s). From run down, the let-down key on the barrel arbor's square: the set-up click held out of its ratchet (Op. 8), the arbor let back slowly by the set-up's 1.26 turns (`R.fs.MS.setup`; the manual's "wind barrel about one turn", Op. 53) until the spring is slack, its inner end going round with the arbor's hook while the barrel holds its outer end; then the click let go and the arbor turned forward again, the click riding up each tooth's back and dropping in (`seatPawl` on the ratchet's profile), 53 teeth. `update()` takes `ld` (turns let down) and `clk` (the click held out, 0 to 1); the set-up cover is faded meanwhile and the barrel drawn see-through round the spring. The chronometer is left run down. The let-down key itself (Tool No. 18) isn't drawn.
- Stopping and starting (and Twist to start under Winding): the balance locking arm (Fig. 9) and the train-blocking screw (Sec. II), and the twist that starts a stopped chronometer. See "Stopping and starting" under How the timing works. Jolt the box knocks it about the balance staff: depending on where the balance is in its swing it sets (stops), trips (the hands jump half a second) or is upset and settles (illustrative; "The balance's dynamics").
- 30-day performance test: the Navy's test (Sec. IX) run on the model as it stands: six periods of five days at 90, 72½, 55, 55, 72½ and 90 °F, wound at each daily reading, read to 0.01 s; the daily rates per period, and regulation, rating, largest difference, the three temperature compensation figures, recovery and isochronism against the Bureau of Ships' limits, beside the factory card of No. 3390. It is computed again whenever a setting changes (`testCalc` in `app.js`; `__test` with `?qa`).
- Swing and isochronism: a Mainspring set slider (0–30%, Op. 13, kept in the link as `mset=`) weakens the spring's pull all through its run; and a chart of the balance's swing over the last minute, the rate against the swing at a steady torque, or the swing over a wind with the fusee and, ticked, a going barrel; the swing and the escapement's rate now, the rate's spread over a wind and the manual's isochronism check (Sec. IX). See "The balance's dynamics".
- Parts: every named part by group, to single out (as a tap does) or hide. A part that is several things (the balance, the fusee, the barrel, the detent, the cock, the setup ratchet, the plates and bridges with their jewels and screws, the motion work, the hands…) lists its pieces under it, folded until it or one of them is picked. A tap on the model picks the piece: its card says what it is part of, with a link up, and the part's card lists its pieces. A piece hides, fades and isolates on its own (the right-click menu, or its box), its part's box half ticked meanwhile; with a part or piece picked, the ghosted rest still takes a tap. Display adds a slow turn and an Auto/Light/Dark theme, and Reset display puts every Display box back to its default (See-through to the view's own) and shows faded and hidden parts again, leaving the theme. Save writes the view as a PNG; Link copies the page's address with the state in its hash (without clipboard access it is put in the address bar instead).
- Selection (29 October 2026; `../shared/select.js`, `PSEL`, which the Wempe's viewer binds too): parts or pieces gathered to fade, hide or isolate together. Ctrl-click (⌘-click on a Mac) adds the part or piece a click picks, or takes it away; with **Select** on (beside the tools) a plain click or tap does, and opens no card. Alt-drag draws a lasso (Ctrl+Alt-drag adds to the selection, Alt-drag alone replaces it), and **Lasso** arms one loop for touch, added: it takes every part or piece that shows inside the loop, found by drawing what a click could pick (not what is faded under half, glass or see-through) once off screen, each in a flat colour of its own on layer 5 (the merged copies left out, the pieces they stand for drawn), and reading the colours inside the loop. **Through** (Shift+Alt-drag, or the button after Lasso) lassos through: every part shown, faded ones too, with a vertex inside the loop (in front of the camera and not cut away by a section), or, with none there but its box over the loop, drawn alone in its colour (a plate the loop lies inside). The selected parts are tinted blue (`tintOf`'s `s`); the bar over the tools isolates, hides (the hidden leave the selection) or fades them, or clears it, as Esc does, and whenever any part is faded shows **Reset opacity**, which brings every part back to full opacity (the right-click menu's Reset all also shows the hidden ones); the right-click menu opened on a selected part acts on the whole selection. The selection isn't kept in the link, as hidden and faded parts aren't. `?qa`: `__sel` (`keys()`, `set(keys, add)`, `idsIn(points, through)`).
- Ship motion (Display) is drawn with the apparent vertical up (18 October 2026), as a plumb line hung beside the box would show down (`gimStep`'s `ap`, `ar`): the case, hanging along it in its gimbals, stays put, and the box rolls and pitches round it (about 20° each way at the 7 s roll: the ship's 14° and the apparent vertical's 5.4° the other way); latched, the case goes with the box. The export's At sea clip is drawn the same way. Until 16 October the box rolled in the true vertical's frame and the case leaned in it toward the apparent vertical, so both seemed to move; then until 18 October the camera rode with the ship, the box standing still and the movement swinging in it. The jolt and the twist that starts it move the box, being done by hand.
- Roll period (Display, under Ship motion): how long the ship takes to roll, 0.4–12 s (7 s by default). The case hangs in the gimbals as a pendulum with its own period of about 0.7 s (estimated), so at a ship's period it hangs along the apparent vertical (leaning a few degrees against the roll at its ends, the ship's axes being 5 m below, estimated) and near its own it swings with the box ("The balance's dynamics").
- Gimbals latched (Display) swings the latch lever in through the slot in the gimbal ring to the keeper on the case, bringing ring and case level with the box first; latched, they go with the box and stand still with it, as Ship motion then shows. Unticked, the lever swings back along the wall and the gimbals are free. A walkthrough step with ship motion releases them.
- Tick sound (Time) is on by default: a click at each beat, while the model runs at up to 1×. Browsers start audio only from a user gesture, so the page makes or resumes its audio context on the first click, tap or key press, and it is silent until then.
- Tinted drawing and Ink drawing (Display; `draw=1` and `draw=ink` in the hash; one at a time) draw the live model as a pen-and-wash drawing, tinted or in ink alone; the tint is laid light (pigment density `INK.wash` 0.75), so the live model reads through it. (The numbers were first those of an overview drawing rendered from the model, the Illustration tab, which the Essay tab replaced.)
  - `drawOf(m)` in `core.js` gives each shown material a Phong copy whose output is the tint. It is the albedo lifted toward the paper, the lit value in soft bands, white where metal catches the light. `look()` applies it to whatever a part shows, so it combines with Colour by part, fading and sections. In ink (`INK.ink`) the copy is paper, inked only where its albedo falls under 55 % of the material's median (`inkRef`: the colour times a 48 × 48 sample of the map), which is the printing: the dial's figures. The engravings (`userData.inkDecal`) are ink under their own alpha; a faded part is paper at its opacity.
  - `makeInk(r)` draws the frame. Three scene passes: normals, part ids and 24-bit depth for the solids, then the same for the ghosts, then the tint (with the shadows when Shadows is on). Two full-screen passes follow: the lines, then the sheet. The sheet lays the tint on paper, true to the lines, and inks with a varying pressure.
  - The tint was once a pen-and-wash wash, laid up to 1.4 px off the lines by a noise field, mottled, pooled at edges, with hatching in deep shade. The offset read as the parts being distorted, so both drawings now keep to the lines and none of these effects is left.
  - Lines fall where depth jumps (0.6 mm + 1.2 % of the distance) or the drawing ends, with lighter ones at creases and between parts.
  - Parts under half opaque (see-through plates, the glass, faded parts) are ghosts, drawn in outline only and lighter.
  - The stage is paper in either theme, the floor shadow is left out, and the plates' damascening is muted.
  - A moving model costs three scene renders a frame instead of one. The shadow map, with Shadows on, is still drawn once. With the option off, nothing is drawn differently.
  - Known limits:
    - Cost: frames with nothing moving are still skipped, as in the normal rendering. It was measured only in headless Chromium's software renderer (SwiftShader), not on a phone's GPU. The tint's render target is sized when a drawing is turned on and dropped when it is turned off (the others serve Edges too); the pen-pressure noise texture is made the first time it draws.
    - The plates' damascening is kept at 30 % in the tint (`uTex` in `drawOf`). At full strength it read as hatching. The shade is taken before that mix, so a darker stripe never changes a band.
    - The lines are found in screen space, one or two device pixels apart depending on the pixel ratio. Very thin parts far away (screws, pins in the Box view) can be only a line or two wide.
- Edges (Display; on by default, phones included; `edges=0` in the hash when it is off) outlines the movement's parts over the normal rendering, so that parts of one finish lying on each other stay apart: the steel winding pawls on the steel sustaining ratchet, for one. It is the drawings' line pass (`makeInk(r).lines()` in `core.js`) laid over the ordinary frame instead of the wash.
  - The thresholds are the drawings': depth jumps, creases, and ghosts in lighter lines. Two things differ. The ids are per mesh, not per part, because a pawl is the same part as the wheel it lies on and less than the depth threshold above it. And the box, case, gimbals and glass (id 0) draw no lines, including where they meet the movement or stand in front of it. The engravings and the floor shadow are left out of the id passes, so an engraving doesn't outline itself on its plate.
  - Cost: the two id passes plus the normal render, three scene renders for a moving frame, as with the drawings; the id passes' shader is trivial. Measured with `tools/perf.py` (1440 × 900, Shadows off): on a desktop GPU a frame takes 0.7–2 ms longer (Dial 1.5 → 2.5 ms, Movement 1.9 → 2.6 ms), mostly the JavaScript of the extra draw calls (470 → 940 in the Dial view); with the CPU throttled 4× (about a phone's) the Dial view went from 6.9 to 12.2 ms. It stays on for phones, where Shadows being off pays for it.
  - Memory: `makeInk`'s render targets are the drawing's size only while in use, else 1 px. Edges keeps the normals and ids (4 bytes a pixel, plus 4 of depth) and the lines (4): 12 bytes a pixel, about 23 MB for a 1600 × 1200 drawing. See-through parts add the ghosts' 8, and a drawing the tint's 8 (dropped again when it goes off).
  - With the option off, nothing is drawn differently.
  - The drawings ink their own lines. While one is on, Edges is greyed out and kept, and it comes back when the drawing goes off.
- Remember settings (Display, off by default; `cm-remember`): only with it on does this browser keep anything (`localStorage`, each in a `try`): the theme (`cm-theme`), the open panel sections (`cm-open`), in `cm-set` the plate finish, dial style, balance, the last view, the cards' units, whether the panel is hidden and its width, and in `cm-state` the hash's settings without what belongs to a moment (`tour`, `part`, `t`, `open`, `arm`, `block`), written with the hash. A page opened without a hash takes `cm-state` as its hash; the remembered view opens the page when its link names no view or walkthrough step. Off, nothing is stored, and the keys are removed when it is turned off and at every load without it, so each visit opens as new.
- Parts: a search box above the list finds parts and pieces by name, Hamilton part number (`42087` finds the detent, `42263` the impulse roller, shown under its part) or words in the source note, every word; `fig 90` finds the parts the manual's Fig. 90 shows (from `figs`, ranges included). Sizes in: mm or inches, the manual's unit, for the sizes on the part cards (remembered in `cm-set`).
- Colour by source (Display) colours each part by where its shape and size mainly come from (`src` in `PARTS`, `SRC`): the manual (green: its figures, parts list or specifications), measured (blue: on photographs, or a real part), solved (amber: placed or sized to fit the rest) or estimated (grey: the manual shows it, not its size or shape). A key under the tabs names the colours; the part's card says what came from where (a piece's card gives its part's, said so, unless the piece has its own). It and Colour by part exclude each other; `colr=part` or `colr=src` in the hash.
- Labels are off by default (Display turns them on, and the choice isn't remembered). The walkthrough shows the labels of each step's parts regardless.
- The walkthrough sets its own view, speed, Moving parts only, ship motion and gimbal latch for each step. Ending it (Finish, Exit, or anything that leaves it) gives back the viewer's own: the view, See-through, Ship motion, Gimbals latched, the speed, Moving parts only and the motion work, as they were when it started.
- Shadows (Display; off by default; `shadows=1` in the hash when on): the key light casts shadows through a shadow map (`PCFSoftShadowMap`, 2048 px, 1024 on phones). With it off, the light casts none: no shadow pass, simpler shaders to compile (two programs fewer at start), and the map is freed. The floor's soft shadow under the box is a texture (`shadowTex`) and is always drawn. The tinted and ink drawings follow the switch. Cost with it on, measured with `tools/perf.py`: about 230–380 more draw calls and every caster's triangles again; 0.4–1.1 ms a frame on a desktop GPU, 22 % (Edges on) to 47 % (Edges off) on the Dial view with the CPU throttled 4×, 14–22 % in the software renderer. `social.py`, `topview.py` and `p3fit.py` turn it on, as their images were made.
- Performance mode (Display; on by default; `merge=0` in the hash when off): the parts that don't move against each other are drawn merged, about 40% fewer draw calls with the same picture ("Static pieces drawn merged", under Modifying the model). Off, every piece draws itself, as before the merge: the way out if a display mode ever shows something wrong with it on. Reset display turns it back on.
- **Contacts** (its own section; `contacts=1` or `contacts=sweep` in the link, `ceps=` the band, `ctin=1`; 18 October 2026, the Wempe's view from `../shared/contacts.js`, which `app.js` binds as the Wempe's viewer does): a debug view of where the parts touch (within 0.006 mm), come close (a gap up to the band, 0.03 mm unless chosen) or pass into each other, found on the built solids as `fine.py` finds overlaps but along all three axes and with the gap too (the barrel's wall tested as the drum it encloses, as `fine.py` tests it); an overlap `fine.py`'s `EXPECTED` lists is expected (its reason in the list; `js/contactdata.js`, written from `fine.py` by `tools/contacts.py --write`), any other not. Drawn on both solids in each one's frame over every part (and the box) as a faint ghost, plainly (no merged copies, Edges or ink); a scan holds the explode and the laid-out train at 0, so Exploded and Laid out carry the assembled contacts out with their parts. This moment stops the clock and scans the model as it stands (under 2 s), again where something moved once it stands still; Over a beat and the wind poses it in `fine.py`'s 42 states through its update. A part picked shows its contacts alone and lists its pairs, with its own pieces' (Inside the picked part too); a part hidden, faded away, isolated out, hidden by Moving parts only or taken off by the overhaul takes its contacts with it on both sides (`userData.ctOff`, set in `look()`). `tools/contacts.py` renders and lists it; `smoke.py` works it. What it showed first (18 October 2026, the sweep in 35 s): 64 pairs, no overlap `fine.py` doesn't expect; the trip spring on the unlocking jewel in 1 of the 42 states and the escape wheel at the impulse jewel (0.014 mm) in 3; the locked tooth never within 0.03 mm of the locking stone (the lock drawn with more room), so the lock shows only with a wider band.
- Screen readers: the model's `aria-label` says what the stage shows, the view (`VIEW_DESC` in `app.js`) or the walkthrough step, and Moving parts only, and is updated with it.
- Keyboard and reduced motion: Space stops and restarts, 1 to 9 pick the views (the key for a view that is off, Box or Dial with Moving parts only, flashes its button and says why in the HUD); with the model focused (click it or Tab to it) the arrow keys turn the view, + and − zoom and 0 resets it. With reduced motion set in the system, camera and state moves are instant (as with `?snap`), the walkthrough leaves ship motion off and scrolls without animation, and the page's fades are off.
- Report a bug or inaccuracy (`js/report.js`): the panel's button under About, a link on every part's card (about that part, as an inaccuracy), one in About's byline and one at the essay's end (about the section being read). The dialog asks what kind (broken, inaccurate, something else), where, what's wrong and, for an inaccuracy, what shows it (a photograph, a video's time, the manual's page or figure). Ticked by default, technical details go with it: the version, the page's address (the model's state is its hash; a local copy gives the file's name, never its folders), the tab, the balance's swing, whether the train is held or winding, the hours since winding, the speed, the frames drawn, the browser, screen and pointer, the WebGL renderer, and the page's last 30 errors and warnings (`console.error`, `console.warn`, uncaught errors and rejections, failed loads, the WebGL context lost or restored, each at its second since load, URLs cut to their file). Nothing is sent from the page (no `fetch`: `tools/selfcontained.py`): "Write it in my email" is a `mailto:` link to the author with the report filled in, "In Gmail" Gmail's compose page, and "Copy it" the clipboard (or, without one, the report selected under "What will be sent", which shows every word that goes). A `mailto:` longer than 1,900 characters, which some mail programs cut short, is shortened from its end, the log first, and the whole report put on the clipboard as it opens. `smoke.py` reads the links it writes without following them.
- Phones: below 600 px wide the part card is a sheet along the bottom of the stage; on touch screens buttons and checkboxes are finger-sized; in landscape with the height under 560 px the stage fills the height and the panel scrolls beside it. On a phone (coarse pointer, screen under 600 px on its short side) the pixel ratio is capped at 1.5 and the shadow map at 1024 px, against 2 and 2048 px elsewhere. A part casts a shadow only when its radius spans 6 texels of the shadow map, which follows the view: far views drop the screws and pins, close-ups keep them. The knurled nuts and the balance rim's holes are each one merged mesh (`mergeGeo` in `core.js`).

## The essay

*The Marine Chronometer*, an essay on how the chronometer keeps time at sea, in the manner of Bartosz Ciechanowski's *Mechanical Watch*, was this
page's second tab until 21 October 2026. It is now shared by both models and has a page of its own, `../essay/` (`/essay/` on the site), and its 3D
figures and dial are the Wempe Einheits-Chronometer's (the owner's choice, 21 October 2026). It replaced, before that, a separate essay page
(`marine-chronometer.html`, which predated the manual and had drifted from the model) and the Illustration tab, an overview drawing.

- **Where it is.** Its text and figure markup are `../essay/index.html` (the `<article id="essay">`), its styles this folder's `css/essay.css` (classes
  `e-…`), its code `../essay/js/essay.js`. The page loads the Wempe's model's scripts (`../wempe/js/`, `../shared/kit.js`, this folder's `core.js`) and
  builds the Wempe's movement once after its first frame; the Hamilton's `movement.js` can't load beside them (both declare `ESC`). This page's Essay
  tab is a link to it (`?edges=0` added when Edges are off here), and `#essay` or `#essay=detent` here goes there (`../essay/index.html#detent`).
- **Sections** (each heading's id is its link: `#detent`; the old `#essay=detent` works too): time is a position, an oscillator that ignores the sea, the
  spring that breathes, heat, constant force, winding, counting, the detent, level on a moving ship, keeping the rate, Greenwich time from the sky (equal
  altitudes ashore), longitude by chronometer (the time sight), the lunar distance, an almanac to print (with the hand rules and the workbook), what the
  model gives a maker (the Hamilton's, with the manual's tolerances), oil and where it goes, adjusting the escapement, the order of work, materials,
  hardening and tools, and the Hamilton Model 21.
- **Figures, and what each takes from the Wempe's model** (the movement lent to each 3D figure as it draws: `lend()` puts it in the figure's scene, shows
  the parts it names, poses it by its own `update(s)`, swaps colours, then puts everything back):

  | Figure | Drawn with |
  |---|---|
  | The dial at the top | `WDIAL.face(1)` and `WDIAL.HANDS` at Greenwich time, wound daily at 08:00 GMT |
  | Longitude, clock error | 2D; 4 s of time is 1′ of longitude |
  | Balance and hairspring | The Wempe's balance, hairspring, rollers and stud, swinging `WPHYS.ESC.A`; the masses swollen and the strip thickened (`R.spPath`, `ribbonGeo`) by the sliders |
  | Terminal curves | The Wempe's hairspring (05 03_7's curves) and, for plain ends, a coil of its size led straight in (essay-only, its drift exaggerated) |
  | Heat | A copy of the Wempe's cut bimetallic balance, its quarters curled in by bending the rim's vertices (exaggerated), a plain brass rim its size, and the Model 21's simplified (`HAMDATA.BAL_R`); the curves illustrative, the Model 21's its Navy test card's |
  | Constant force | The Wempe's fusee, chain and barrel posed at each hour (`n`); the lever from `R.fu.rf`; the force on the train 05 06_20's measured (`WPHYS.fusT`), the spring's pull its solved torque (`WEDATA.fusee.tq`) over the lever |
  | Maintaining power | The Wempe's maintaining ratchet, spring and detent, and the fusee wheel, posed by `update()` with the spring's lead (`WPHYS.runPhi`, `susPhi`) |
  | Winding | The Wempe's up-and-down sub-dial and hand; 3.21 h a half turn (`WPHYS.HPT`) |
  | Counting | The Wempe's centre, intermediate, seconds and escape wheels, turned by the train from the escape wheel's teeth |
  | The detent | The Wempe's escapement flattened into the wheel's plane (as its own essay draws it), moved by `WESC.ESC.state` |
  | Gimbals | `WCASE.build` with the Wempe's dial at Greenwich time |
  | Keeping the rate | 2D; a simulated chronometer's rate book in the form of Table I |
  | Equal altitudes, the time sight, the lunar distance | 2D, `ALM` (`shared/almanac.js`): fixed days and places, each sight made by `ALM.sextant` / `sextantLunar` at the true time and place and worked from the readings alone |
  | The almanac's pages, the workbook | HTML tables from `ALM` for any days (Print lays them out alone); the workbook reduces one's own sights |

- **Numbers in the text.** What a Wempe figure shows is a `data-live` span, filled by `fillLive()` from `WESC`, `WPHYS` and the built movement. What the
  text quotes of the Model 21 is a `data-ham` span, from `../essay/js/hamdata.js` (`HAMDATA`), which `tools/essay_hamdata.py --write` works out on this
  page by the expressions the Essay tab's `fillLive()` used (`ESC.measure()`, `TRAIN`, `ESC_PER`, `RUN_H`, `R.timing`, `R.hsDesign`, `ESC.ampAt`/`rateAt`);
  without `--write` it fails if the file is stale (`ci.py`'s essay-hamdata step). The Model 21's facts come from the manual and this README; the Wempe's
  only from `References/wempe/` and the Wempe's README. The sky sections also use published literature (PLAN-self-contained.md, decision D1); their stated
  accuracy is in `data-bound` spans, which `tools/almanac.js` checks; `data-phys` and `data-hs` spans are checked by `tools/physics.js` and
  `tools/hairspring.js` (all three read `../essay/index.html`).
- **Building and drawing.** A figure is built the first time it comes within 300 px of the view, once the fonts are loaded and, for those that show the
  movement, once it is built. A figure is drawn only when something in it changed. The 3D figures share one `WebGLRenderer` on a canvas off the page:
  each renders into the bottom-left corner of that canvas and is copied onto its own 2D canvas, so the page has one WebGL context. They are drawn with the
  models' Edges (`makeInk(r).lines`, `core.js`, told the corner's size and pixel ratio by `r.inkBS` and `r.inkPR`), unless `?edges=0`.
- **Hash and history.** `#detent`, the section in view as the reader scrolls (a heading within 150 px of the top). Links to the models are ordinary links
  (`../wempe/index.html#view=train`, `../chronometer-working-model/index.html#tour=3`), so Back returns to the essay where it was left; `sessionStorage`
  (`cm-essay-y`) keeps the place. On the site, `worker.js` sends the essay's first address (`/marine-chronometer`) to `/essay/`, and the Wempe's page at
  `/` sends the Hamilton's old `/#essay=…` there.

## The hairspring, designed

`HSPR` (`shared/hairspring.js`, checked by `tools/hairspring.js` and `invariants.py`) designs the spring a maker would wind, and the model draws it
(`R.hsDesign`, `R.spPath`, `ribbonGeo` in `core.js`), from what the model measures: the coil (r 5.1, 12 turns, 6.4 tall: the stud bar and its clamp measured at 6:50.0), the stud's clamp (its step
3.03 from the staff, the stud's bar 54.8° off the clamp's radius) and the collet's end (3.2).

- **The stiffness** the balance needs: k = I (2π/T)², with Table II's I (578.5 g·mm²) and T 0.5 s: 91.4 µN·m a radian.
- **The strip.** Its width along the axis measured on the restoration video side-on (6:49.5): each turn's section at the coil's edge 9–11 px at 45 px/mm,
  and its share of the 0.56 mm pitch down the stack 0.38–0.50: 0.20–0.28 mm, 0.23 drawn (`HS_B`). From k = E b t³ / 12 L over the spring's free length,
  414 mm, its thickness 0.221 mm for an Elinvar-type alloy at 180 GPa (`HS_T`; 0.213–0.226 over 165–195 GPa and the width's range), 0.211 for spring
  steel (207 GPa): the section about square, a wire more than a ribbon. Its bending stress at the 255° swing about 217 MPa. Hamilton's patent
  US 2,379,780 ("a change in length of five one-hundred-thousandths of an inch in the usual chronometer hairspring will cause a change of rate of
  one-tenth second per day") implies 549 mm for its usual spring, 25 % more: a general figure, not the Model 21's. Here 1 µm of length is 0.104 s a day.
- **Phillips' conditions** (Phillips, 1861): each terminal curve's centroid on the perpendicular through the staff to the radius at its junction with the
  coil, at R²/l from the staff, on the side the curve goes; with both, the spring's centroid stays on the staff as the coil winds and unwinds, and its
  pull on the balance is a pure couple. Each curve is solved from its curvature (the coil's at the junction, a cubic after) for its end's place and
  heading and the two conditions, at build time from a stored first guess (searched afresh if a re-measured end defeats it). The check
  (`HSPR.lateral`, Castigliano's theorem on the whole spring as a slender beam): the force the pivots carry under a couple, over couple / R.
- **The outer curve** runs from the coil to the stud's clamp at its step, along the bar toward its end (along it the other way no curve meets the
  conditions inside the coil): 14.6 mm, an S that swings in to r 1.46 (0.7 mm clear of the staff) and back out into the clamp, its ends' tangents 87° apart, and on
  along the bar into the clamp to 0.2 short of its end. Since 14 October 2026 the clamp is 4.34 mm from the staff, where the stud's holes measure (6:29 through the camera
  fitted on 6:49.0); there four curves meet the conditions, and this is much the smoothest (its tightest bend r 1.24 mm, the others' 0.30-0.39), so it is drawn: the
  curve's path is a design, no frame showing it (6:52.5 looks down the coil at the collet's end). With the clamp at 2.65 (the holes read through the old scale) it was a
  14.8 mm curve turning 330°.
- **The inner curve** runs from the coil to the collet's end, held there along the collet's end face: 21.8 mm, turning 308°, and `HS_LEAD` on into the
  collet's clamp. Where the collet takes it: KLUwI2UUCMQ 6:53.25 and 6:53.5, the balance held with the arm to the camera, show the collet's block and its
  brass wedge pin by the hub's cap, the pin 2.8–3.9 mm from the staff against the coil's near end (Hough circles, 229–235 px for its 5.26 mm outer edge).
  A short curve meets the conditions only for an end at 2.9–3.3 (at 2.8 and from 3.4 to 3.62 the shortest is a 1.9-turn spiral, 49–54 mm), so the end is
  drawn at 3.2 (`HS_RI`) and the collet scaled from it (`CKC`, Fig. 6's proportions kept; until 4 October 2026 it was scaled by the coil, its end at 3.62).
- **The force on the pivots:** as designed, 1.7e-5 of couple / R; with the ends the model drew before (`springGeo`'s ramps, round wire), 0.017.
- **At large swings** (`HSPR.large`, `HSPR.period`): small-deflection theory, Phillips' and Castigliano's, holds only near the rest. Solved as a planar elastica (an
  inextensible strip with its designed curvature unstressed, the stud's end clamped, the collet's end turned with the balance; the end loads by Newton's method, to
  4e-13 mm at the stud, the couple from them and dU/dθ agreeing to 2e-8), the couple stiffens by one part in 129,000 at 270° and the force on the pivots grows to
  1.1e-3 of couple / R at 90° and 1.5e-3 at 270°. The balance's period at each swing from the energy (the integration checked on a linear and a Duffing spring): the
  spring gains 0.182 s a day at 247.5° and 0.298 at 270° against small swings, **0.12 s a day over the manual's 1⅜ to 1½ turns, +0.05 for each 10°**, the same
  way as the escapement's error, so the adjuster's setting (`HS`, the bench) is about -0.18 for the designed spring where the model's -0.13 assumes an isochronous one.
  The model keeps `HS` 0 (the spring as adjusted, as the performance card shows it); the essay quotes the figures (`data-hs`, checked by `tools/hairspring.js`).
- **It breathes** (`R.spPath`, since 11 October 2026; before, each point turned rigidly by θ(1 − s/L) about the staff, the coils
  keeping their radii). With the ends meeting Phillips' conditions the collet's pull is a pure couple, so the bending moment is the
  same all along the strip and every part of the free length changes its curvature by θ/L: the heading at s turns θ(1 − s/L). The
  coils close as the balance turns one way and open the other, each by θ/(2πN) of its radius (r 4.83 to 5.40 over the 255° swing,
  5.10 at rest; 4.74 to 5.51 at 347°, the most a jolt gives), concentric to 0.04 mm, the terminal curves curling by as much, the
  length kept. Drawn from the stud's end back, each 0.3 mm segment turned at its middle; the second-order miss at the collet's end
  (0.024 mm at 255°) is taken out along the free length. Against the elastica (`HSPR.large`, the strip as drawn compared point
  for point with its solved shape) it is within 0.025 mm at 255° and 0.039 at 345°; the rigid turn was 0.28-0.46 off. The turns
  stay 0.2 mm or more apart (a helix: each turn 0.56 above the last). No photograph or video shows a Model 21's spring breathing.
  **Against the collet:** curling inward by θs²/2L near its clamp (0.39 mm 7 mm from it at 347°), the inner curve ran into the corner of
  the collet's body, whose hidden side was taken back to the plate's corner (0.02 mm off the strip at rest). No inner curve meeting Phillips'
  conditions from the collet's end clears that corner (the farthest out passes it at r 3.64; it would need 4.0), so the body's hidden side,
  which no source shows, now stops short of it: the strip clears the collet by 0.063 mm at the widest swing the model allows (347° wound),
  0.14 at 255° and 0.35 at rest, beyond the clamp's edge (the "Estimated" section, the collet).
- **Isochronism.** In small-deflection theory, with the force on the pivots gone, the spring's own isochronism error is what its curves' departure from the
  conditions leaves (residuals under 1e-11 mm) and the material's; the escapement's is `tools/escapement.js`'s. At the balance's real swing the strip's large
  deflection adds +0.05 s a day for each 10° (above). The model keeps the hairspring term at 0 (`HS`): the spring as an adjuster leaves it, set against the
  escapement, which the performance card shows.

## The mainspring, solved

The mainspring's shape in its barrel is the strip's equilibrium, not a drawing (`tools/mainspring.py` writes `js/mainspring.js`, `MSHAPE`; `mainspringGeo` in
`core.js` draws it). A spring in a barrel lies where its bending energy is least: each free stretch is bent from its natural curve by the moment it carries
(k - k0 = M / EI), and where the strip would want to pass through itself the coils press on each other instead.

- **The strip and the core** (12 October 2026, the owner's decision: follow the videos). The strip 0.394 mm thick by 1,064 long and 13.55 wide: the coils'
  pitch on KLUwI2UUCMQ's let-down spring, read round the whole turn, is 1/41.0-1/41.8 of the measured barrel's inside radius (15:54, 33:06), at most 0.394 mm
  inside r 16.3, and the length over the thickness, the pack's area over the pitch squared, about 2,700 with no scale needed (`References/VIDEOS.md`,
  Measurements). On the arbor's core r 4.9, the low end of three readings on two 1941 movements (r 4.8-5.7). The parts list's 0.0165 in (0.419) and the British
  Museum's late example's 0.44 disagree with it (OPEN-QUESTIONS.md 1: on this core in this barrel neither winds the fusee's turns). Until then the parts list's
  strip on an estimated core of r 1.8.
- **Its natural curve.** Out of the barrel (KLUwI2UUCMQ 32:18 and 32:30) the spring is a spiral of about 7½ turns, all bent one way (a spiral set, not the
  reverse curve of a modern alloy spring): its turns' radii, read along the line through its centre and scaled so the turns add up to the 1,064 mm strip,
  about 5, 10, 13, 18, 22, 27, 34 and 40 mm (two frames within 3 % of each other; oblique, so about 15 %; `References/VIDEOS.md`).
- **The solve.** The strip as r(θ) about the arbor, 48 samples a turn: least  ∫ (k − k0(s))² ds  for its length, its coils at least the strip apart (no film:
  the videos' pitch is the strip at most; 0.01 of grease until 12 October 2026), between the core and the brace, its inner end on the core over the eye where the hook holds it, its outer end along the brace. An augmented
  Lagrangian over L-BFGS (torch), each state from an even spiral and again from its neighbours' solutions, the least energy kept: states every quarter turn
  from 12.75 to 19.25 turns (about 20 minutes on 14 processes; 68 KB in the page), the states past coil-bound on the core (19.5 on) left out. Below its slack the energy climbs steeply (the coils on the wall can't open, so the inner ones
  must unbend), so no state is carried up from one below it alone.
- **In the page.** `msShape(T)` blends the two states either side, each piece of steel (the same distance along the strip) moving between its places in
  them, so the shape changes smoothly as the barrel turns. A blend a quarter turn from both has the energy of the state solved there to 0.4 % and its coils
  at least the strip's thickness apart (the energy is nearly flat, so shapes of about equal energy may lie up to 4 mm apart in places; states half a turn
  apart blend 3 mm out and let the coils touch). θ is rebuilt from r, to 0.04 mm along the coil.
- **What it shows.** Fully wound, the coils draw in round the arbor and fill the middle of the barrel, a gap at the wall; as it runs they spread out toward
  the wall, still half a turn past the slack at run down. Let right down, most lie packed against the wall with loose turns inside. Let down with the arbor out (`--letdown`), as C Spinner's 15:54 shows it, it
  gives 13.4 turns, 11.2 packed on the wall along a ray (11-12) and the rest loose (mean radii 5.1, 9.4, 11.6), where the frame
  shows 12 ± 1 packed (10.4, up to 11, with the coils 0.01 apart packed, until 12 October 2026: below) and one loose turn of about r 8 (the parts list's strip on r 1.8 until 12 October 2026: 13.6 turns, about 10½ packed). In the r 17.6 barrel it gave 14.3 turns, 11.9 packed (with the wall 0.2 thick, until 5 October 2026,
  9½ packed and 2½ loose); in the measured r 18.3 the pack is a turn or so thinner than the frame's, which the grease's friction, left out, may hold.
- **Its pull** (`MSHAPE.pull`, the energy's slope, smoothed by a quartic from half a turn past the slack, against its most, `MSHAPE.M1`, 1.01 N·m: EI/2 times
  the slope a radian; `physics.js` takes the torque from it, 0.96 N·m fully wound): nothing at the slack (13.25 turns), rising
  steeply over the first turn, then about evenly. **The set-up comes from it:** a fusee is cut for its spring, so the spring is set up where its pull falls
  over the 4.62 barrel turns the chain takes to leave the fusee as the chain's lever there grows, 8.03 to 15.25 mm on its pitch line (0.526; `fs.MS` in
  `movement.js`, read off the page by `tools/fusee_table.py`): 1.14 turns past the slack (run down at 14.39 turns, fully wound at 19.11, 0.24 turn short of coil-bound on the core, past 19.35,
  `mainspring.py --bound`): Op. 53's "wind barrel about one turn". Until the chain was drawn at its measured size (20 October 2026) the chain took 4.51 turns on a lever of 7.51 to 14.72 (0.510), set up 0.89 turn, run down at 14.14, fully wound at 18.75, 0.60 turn short of coil-bound. **The coils pack at the pitch the videos measure** (the strip 0.394, no film between
  them: the pitch is the strip at most, and no source gives a film); until 12 October 2026 the solver kept them 0.01 apart, so the model packed at 1/40.3 of
  the inside radius, coarser than every source (1/41.0-1/43.7), and was set up 1.01 turns, fully wound at 18.87, 0.33 turn short of coil-bound (19.20). The parts list's strip on the r 1.8 core, until 12 October 2026, 1.26; 0.99 on the groove's floor's
  0.473 until 11 October 2026, 0.47 in the r 17.6 barrel before 5 October, 1.62 in the thin-walled one, and 0.37 estimated before that). **The drive is
  taken from it** too ("How the timing works", the drive): until 11 October 2026 the timing had an illustrative pull of its own.
  **The arbor against the strip** (14 October 2026): the core is 9.8 mm across, 24.9 times the strip, where Daniels (*Watchmaking*, 1981, p. 254) wants 28 or
  more for a carbon-steel spring's life. No carbon-steel strip at 28:1 gives the fusee's turns in the measured barrel at this torque: kept as stiff, 0.36 × 812 mm
  on r 5.04 has 3.4 turns from slack to coil-bound where the set-up and the fusee want about 5.9; 0.385 × 1,064 mm and 14.3 wide (the barrel's 14.5 inside) on
  r 5.39 (`mainspring.py`'s variant `d28w`) leaves 0.10 turn past full wind, its coils' friction 8 % and the fusee's pull uneven past the bench's band. So the
  arbor stays the videos' and the build's spring is Nivaflex (`deviations.js`), which doesn't take a set; a carbon-steel spring is tested again after a month
  (the bench's mainspring test).

## What the model gives a maker

Phases B–D of `PLAN-self-contained.md`, in the page:

- **Tolerances for what the sources don't size** (`tools/tolerances.js`, `tools/tolerances.json`; OPEN-QUESTIONS.md): the mainspring's, the detent spring's and the trip spring's sections are known to no source, so their sheets say how closely each must be made, from the model's escapement (`ESC.atK`: the swing and rate with the drive and the two springs' stiffness scaled). The balance keeps the manual's 1⅜–1½ turns (247.5–270°) for a mainspring within −5 % to +11 % of the drawn stiffness (0.387–0.408 mm thick at the drawn width and length, 0.74–0.86 N·m fully wound), a detent spring up to 5.27 times the drawn stiffness (0.137 mm), where Op. 78's 0.005 in leaves it no preload (set up by the test, a stiffer spring takes a little less of the impulse, so the swing doesn't bound it: 6.9 times and 0.150 mm until 14 October 2026, the whole 0.770 g then taken as the preload), a trip spring up to about 2.4 times (0.081 mm). The parts list's 0.0165 in (0.419 mm), the same length, would swing it 282°; the other movement's pitch, 0.374, 234°.
- **The maker's sheet** of each part card (`MAKER.card`): its lines of the parts list (`js/makers.js`, from `bom.json`), each with the fit `bom.py` measured
  on the model (from `BOM.md`), its material, finish and heat treatment (the manual's where it names them: the Elinvar hairspring and trip spring, the
  beryllium-copper detent, the stainless rim on its Invar arm, the mahogany box; else watchmaking practice, marked as such), and the part's size, volume and
  mass measured on its closed solids (densities by the model's material), and its **holes** (`MAKER.holes`, as `tools/holes.py` reads them: the round inner
  loops of each mesh's faces square to the arbors, both faces, so a counterbore or countersink shows as two diameters; centres from the movement's centre).
  Its **drawing**: the solids' creases over 30° projected to a plan (from the dial side, 12 o'clock up) and an elevation, in millimetres, with the overall
  sizes and every hole marked and numbered as the sheet's table lists them (centres and diameters there), printed at a standard scale its title states
  (20:1 to 1:4, the largest that fits A4's column and page), its lines and text sized for paper. A line no relation measures shows what other parts it
  takes (the other side of their fits), or says it isn't measured. `tools/book.py` checks the book as printed. The screws on a card are listed
  with their heads, threads and lengths as drawn and, since Hamilton's threads are in none of the sources, the ISO 261 coarse metric thread nearest each (M1 × 0.25
  and so on) for a maker to cut. Its **STL**: its triangles in the movement's frame, mm.
- **Making it** (the panel): **Measure** (two points on the model, their distance and its components), **Oil** (each part coloured by the oil or grease it takes, after Ops. 18–71: red oil the jewelled pivots, argon oil the bushed ones, grease the mainspring and maintaining work), **Build book** (every card's sheet and drawing,
  printed alone: `#bookPrint`, `html.book-print`; the box and gimbals' parts with the movement's; a part with pieces as an assembly, its card and its drawing as assembled, then each piece to make on its own sheet, so each parts-list line is on one sheet; the split balance and the key on the hands' square, a variant and a copy, left out), **Data** (the train, `MOD`, `L`, the fusee's profile, the escapement's settings, figures and cycle,
  the hairspring's design and centreline, the balance's moment and pitches, the parts list), **STL** (every part shown), **Blender (.glb)** and **Blender rig (.py)** ("The model in Blender" below).
- **The essay's workshop**: the tolerances the manual gives (end-shakes, roller fit and shake, horn and stop-button clearances, the detent spring's 0.770 g,
  the escapement's angles, the wedge pins, the mainspring's let-down, the rate before the weights); the oiling chart (Ops. 43–71, the three lubricants);
  adjusting the escapement (Ops. 77–97 beside the model's live figures); the order of work (Sec. VIII's reassembly, the mainspring made safe first);
  materials, hardening and tools, and the chronometer that can be made without Elinvar and Invar (a steel spring on a split bimetallic balance).
- **Phase A's physics** (`tools/physics.js`): the fusee asks the mainspring (0.394 mm, the videos' coils' pitch; 13.55 wide, KLUwI2UUCMQ 15:54; 1,064 long, their L/t) for 0.96 N·m fully wound,
  solved coil by coil (`mainspring.py`'s `M1`: its packed coils don't bend, so it is stiffer than the linear strip's E b t³/12 L, which gave 0.78 until 16 October 2026;
  0.93 with the parts list's 0.419 until 12 October 2026), 2.75 GPa reckoned from its set curve: under a set strip's limit, 1.5 times hardened carbon steel's elastic
  limit, about 2.55–2.85 GPa (a rectangle's plastic moment over its elastic one; the strip is formed past its elastic limit, ICMFF9, so its free curve is a set one).
  Any strip at the measured proportions works at 2.60–2.77 GPa (0.365–0.394 mm solved, 16 October 2026): the thickness sets the torque, not the stress.
  Through the train (2,893:1, each stage 0.85–0.95) 66–103 µN·m at the escape wheel. Released from rest, the wheel (4.80e-9 kg·m², measured on its
  solid; `invariants.py` checks the two agree) and the fourth wheel behind it chase the impulse jewel, already running away from them, and catch it about 19° of the
  balance after the release, striking it at more than twice its speed (the escapement, `makeEsc`, counts the chase and the strike; `tools/dynamics.js` checks it beat by
  beat). The balance holds 255° if its Q is 212–390. **From the parts** (A6): each stage's efficiency from its measured pivots (μ 0.10–0.15 on the tooth loads) and its teeth's friction (μ 0.10–0.20,
  run dry), 0.91–0.97, at the top of the range assumed; the balance's damping from the air on its screws, nuts and arm (Cd 0.8–1.4 at Re about 180, Q 761–909, the timing nuts at mid-travel), the
  constant friction of its staff on the endstone, **measured** (12 October 2026: BunnSpecial's No. 2182, `Jd2c3x8VKsE` 14:04.3–14:12.5 and 16:10.4–16:17.1, the balance
  swinging freely from 2.2° and 2.0°, too little to meet the trip spring, its swing falling in a straight line at 0.238 and 0.231° a second, 0.16–0.22 with a viscous
  term free beside it, period 0.498 s: a constant torque Mc = k c T / 4, k from Table II's balance, 32–47 nN·m, Q 6,760–10,050 at 255°, 4–6 % of the model's loss
  there; the flat end worked out before, μ 0.10–0.15 across its whole face, gave Q 378–793, ten to twenty times the friction measured, which is that of μ
  0.008–0.012 on it; a domed end would give Q 22,000), the spring's residual side force and its own internal damping (Q 1,000–5,000): Q 405–710, a free decay of
  64–113 s (202–390, 32–62 s, with the flat end worked out). With the train's efficiency from its parts the budget needs 195–266, 199–313 with the mainspring's
  own coil friction and set (1.6–11 %): **the two don't meet** (16 October 2026, the solved spring's torque; with the linear strip's 0.78 they met, 262–423). At the
  model's `TF` the budget swings the balance about 312° (265–359°), above the manual's 1½ turns, as the one running Model 21 measured on video swings about 300°
  (We1dLNXiBj0: `startup.js`, `acoustic.py`). The page keeps the manual's 255° (the owner's decision, 16 October 2026): `physics.js` reports the gap (`~~`, not a
  failure) and OPEN-QUESTIONS.md records it; a made chronometer's spring is sized to its balance by the bench's run-down test. `TF` (the free swing's decay) is
  67 s (Q 421), inside the parts' range: the torque the model is calibrated at, 62.4 µN·m, is within 0.4 % of the linear strip's through the same train and losses as the old calibration took (0.611 of the fusee's torque reaching the escape
  wheel: 75.0 µN·m of the parts list's spring with `TF` 52 s, Q 327, until 12 October 2026; 68 s, Q 427, until 14 October 2026, when Op. 78's preload lost its
  0.005 in bend: the escapement then takes less work unlocking, and at 68 s the calibrated torque fell 1.3 % under the spring's and Q past the budget's 423). It was 34 s (Q 214) until 11 October 2026, when the escapement still left out the chase and the detent's whole lift.
  A real start (`tools/startup.js`, "Checked against real chronometers") wants 120 s or more. Op. 78 sets the detent
  spring's preload: a 0.770 g weight on the locking jewel should part it from its stop button by approximately 0.005 in (pp. 60-61, Fig. 88's "(.005 in. clearance)"),
  so the preload is the weight's moment less the spring's stiffness over that bend (`W78`, `G78`): 0.63 g at the jewel with the drawn spring (0.079 mm), and none
  left at 0.139 mm, an upper bound on the spring's thickness from the manual alone (until 14 October 2026 the whole 0.770 g, p. 61's clause missed). The discharge
  jewel carries the detent on past the release to 1.55 times the release lift, so the detent takes about 8 % of the impulse
  (`fD`, 5.7 %, was fitted to the lift at release until 11 October 2026). The escapement's own error is −3.0 s a day, absorbed by the timing, and the
  hairspring isochronism term that cancels its isochronism at 90 % of the torque −0.20 (`invariants.py`; −0.22 until 12 October 2026). Temperature: a steel spring on a steel balance
  loses 10.3 s a day a °C; the Model 21's Elinvar spring must be treated to -22 to 10 × 10⁻⁶ a °C to cancel its balance; the split variant's rim gives back
  7.0 s a day a °C.
- **Still estimated** (README "Estimated"): pivot and jewel-hole diameters (the balance staff's lower end, the escape jewel's hole and the third's and fourth's lower jewels now measured) and the screws' threads (the videos don't resolve them; the model's are its own,
  each fit's clearance on the sheets, with the ISO thread to cut beside each), the train's efficiencies (0.85–0.95 a stage), the trip spring's section, the materials where the manual names none.

## The overhaul

The manual is an overhaul manual, and its order is how a Model 21 comes apart and goes back together: Sec. V's 58 operations take the movement down,
Sec. VIII's 105 put it back (Ops. 16-34, the fusee, and 35-39, the barrel, usually done first, set where those parts go in, as the manual sets them),
read from the manual's text and transcribed in `js/overhaul.js` (`DIS`, `RE`). Each operation has the manual's instruction, cautions and notes; its
tools by Sec. XIII's numbers and names (`TOOLS`); its figures; its oil (red oil, argon oil, grease, and the points it goes on); and the parts it takes
off, puts on or loosens, named by their lines of the parts list (`bom.json`'s ids, which every piece of the model carries as `userData.hn`), or by a
part of the page (`@name`) where the line is a whole part. The card shows them with each line's number and name (`MAKERS`), and the build book's
"Putting it together" chapter prints the reassembly from the same data.

**How the parts move.** Only along the arbors, as the Exploded view moves them: a part comes off to where that view puts it (its rise measured on
the page: `explode(1)` against `explode(0)`, so a part turned over inside another goes the right way), a screw out of its hole by its own lift. A part
rides on what carries it until its own operation (`HOST`): the fusee wheel, the sustaining ratchet and spring and the chain on the fusee until Ops.
39-41, the setup pawl's spring and pivot screw on the barrel bridge until Op. 32, the balance lower bridge on the upper train bridge until Op. 50. Each
comes off its host by its offset in the Exploded view, so a part and its host moving in one operation go in straight lines. A piece the Exploded view
doesn't move from what carries it (a cap on its bridge, a post in its plate) comes off away from the side facing up, by half the least lift of the
screws coming out with it (so it never rises past their heads), else 6 mm; where the sources say otherwise, `UP` gives the way and the distance: the
winding stop unscrews from under the barrel bridge (KLUwI2UUCMQ 12:58-13:04); the barrel's cap is on its dial side, and its screws, arbor, mainspring
and brace come out that way (Ops. 34-37); the winding ratchet wheel comes off the fusee arbor's lower end, past the pinion, its two screws ahead of it
(Op. 43); the seal ring and its spring stand on the barrel bridge, which carries them as the dust seal lifts (KLUwI2UUCMQ 12:34-12:38.5); the balance
lower endstone cap comes off the lower bridge's underside; the fusee goes 90 mm clear, so what comes off it on the bench (Ops. 39-45) lands above the movement. A part done with goes in the
cleaning tray: once its operation is over it is hidden, unless a later operation works on it or on what it rides on. Every part in one operation moves
by the same share, the path `tools/overhaul.py` checks; Back and Next move one operation's parts, the slider goes straight to another operation.

**What it shows as the manual has it.** The manual's balance locking arm (Fig. 9), which rides on the upper train bridge: the Navy's Y-arm balance stop
(a variant, as on 2E11795) isn't in its operations. On the restoration video's 2E8489 it comes off before the cock, unscrewed at its seal's
flange and lifted off with the seal (6:15-6:24), which Op. 10's text says. The train-blocking screw goes down at Op. 5 and up at Op. 46 (and in the
reassembly at Ops. 45 and 75); Op. 7 and the reassembly's Op. 54 wind the fusee. The bezel is off from the first operation until the reassembly's Op.
103; the box is hidden while the movement is on the work ring or in the dialing ring.

**The check** (`tools/overhaul.py`, `overhaul-check.js`, about 12 s; `ci.py` runs it). Every body (each part, screw and loose piece the operations
move, and what they leave of their parts) is rastered as assembled into vertical columns 0.2 mm apart, as `exploded.py` does, giving for every pair the
relative rises at which they meet. Each operation is followed along its path (41 points); a pair fails if it passes into a meeting it didn't start or end
in, or leaves (or enters) an overlap as assembled the long way round. What the operation leaves in the tray is out of the way. It found the movement's
order sound and the model's own placement rules wrong in a dozen places, all fixed; what remains is in its `EXPECTED` table, each with its reason:

- what a real movement does other than straight along the arbors: the detent is drawn out sideways from under the upper train bridge (KLUwI2UUCMQ
  10:51-11:06); the fusee comes out tilted, its wheel's edge from under the upper train bridge, the wheel's teeth reaching under it to the centre pinion
  (the video lifts it out with the bridge still on, 13:06-13:33, as the manual's order has it), the sustaining pawl held aside; the chain is unwound from
  the fusee's groove and unhooked from the barrel (Op. 8); the taper pin goes in across the arbor; the brace slides along the barrel's wall; the second
  hand goes on with the minute hand at 12 (Op. 64), where the model's hands show the time.

Three readings the check found the model drawing wrong were fixed on 15 October 2026 (Review-results.md, "The overhaul's order against the model"): the
fusee's and barrel's bushings and the arbors in them, the winding ratchet's way off the fusee, and the dust seal's ring and spring.

## The model in Blender

**Blender (.glb)** in Making it writes the whole instrument as a glTF 2.0 file (`model21.glb`, about 95 MB, a minute or so to make), and **Blender rig
(.py)** the script that drives it. In Blender (5.x): File, Import, glTF 2.0; then open the rig in the Text Editor and press Run Script. Set the scene's
frame rate before importing: the clips come in at it.

- **What comes across.** Every part a named object in the model's own hierarchy: the root (millimetres scaled to metres), the box, ring, case, movement,
  each part (named as its card, with its key: "Escape wheel (escW)"), each arbor and pivot group (by its name in the code: `esc`, `staff`, `fz`), each
  piece (by its line of the parts list: "42173 Screw - Balance, 200-205 mg, …", else its part and material). Custom properties keep the part key, the
  parts-list line (`hn`) and, for the rig, the rest pose and the drives. The materials as the page has them (colour, metal, roughness, the damascening's
  stripes and normal map through `KHR_texture_transform`, the wood, the engravings and the dial as textures, drawn again for the file finer than the page's: twice as fine, the engravings' lettering four
  times (each texture's `redraw` in `core.js`, the same drawing at a size)), but the jewels and the crystal as what they
  are, not the page's stand-ins: transmitting, with the published refractive indices of ruby (1.77) and glass (1.52). Only the variants chosen on the page
  (dial, balance, stop, plate finish, the timing weights' places and the screws) are in it. The page's own lighting is not: give Blender a world (an HDRI).
- **The clips**, each an action: Running (a minute, the second hand once round), Beat (slow motion, one beat 20 times slower), Run down (56¼ hours in 30 s;
  the escape, fourth and third wheels and the seconds hand left out, as a blur), Winding (from a quarter of an hour short of run down to the stop, the
  sustaining spring driving the train), Setting the hands, Stop and start (the locking arm, a twist, the train-blocking screw), Exploded, Laid out, Lift
  out, Lids, Latch and At sea (the box rolling, the case swinging in its gimbals; six rolls, which loop, the case's swing settled first); and the rig's own, one parameter each (Rig · beat, Rig · explode, …).
  They are played through the export's own copy of the model with the equations of `app.js`'s loop (the stopping and starting, the balance's amplitude,
  the gimbals' pendulum), each from the rest pose (the page's state of wind, the escape wheel at the start of a beat, the lids open), and read back off its
  nodes: a node that moves gets keys where it changes, as few as put it back within 0.0005 mm and about 0.006°.
- **What deforms.** The hairspring is keyed by the balance's angle: shape keys 0.15 rad apart over the widest swing, each moment a blend of the two either
  side (within about 0.015 mm). The mainspring, whose vertices change with its wind, is a flipbook of 24 shapes over the whole wind, the nearest shown; the
  trip spring a flipbook of its shapes through a beat (the first 128, then the nearest); the stop-bar spring, the sustaining spring and the winding pawls'
  springs shape keys; the chain one object a link, a link the chain doesn't reach at scale 0. Hidden is scale 0 throughout (glTF has no visibility).
- **The rig** (`blender/rig.py`) runs the chronometer on the timeline for as long as it plays: the escape wheel, train, hands, motion work and fusee by
  drivers in step with the escape wheel's place (the beats run, plus how far the wheel is ahead of that even run, read off the export's helper "Rig ·
  escape wheel teeth", 0 at each end of a beat so its loop has no seam; each such part was found turning about one axis in step with it, `extras.rig`), the balance, detent, trip spring and hairspring by Rig · beat on a loop, and the
  rest by Action constraints whose time its controls drive ("Chronometer controls": hours since full wind, the hands set on, explode, laid out, lift, lids,
  latch, roll and pitch). The constraints' actions are made over into changes from each part's rest, so two can move one part, and in Euler: Blender 5.2's
  Action constraint reads an object's rotation channels only so. No Python runs in the drivers. `PLAY = 'Winding'` (any clip) at its top plays that clip
  on every part instead. Against the clips (`tools/blender_check.py`), the rig puts every part where Running has it within 0.02 mm and 0.1°, but the chain's
  links (0.05 mm: Run down's moments are 1.9 hours of wind apart), and explode, laid out, lift and lids at 1 where their clips end.
  The rig is shared with the Wempe's export (`wempe/js/blender.js`, the Wempe README's "Downloads"): it makes only the controls whose rig clip the file has,
  and drives a part that repeats with the escape wheel's place by a clip whose `rig.p` is `E`, over its `b − a` beats (the Wempe's maintaining detent riding
  its ratchet). The export takes its start hours in single precision (`Math.fround`), as Blender's driver variables hold them: until 16 October 2026 an
  export made between round hours left the rig's hours up to 2e-6 h off its own, the escape wheel up to 0.3° off its clips at 30 h.
- **Checked against the page** (`tools/blender_check.py --looks`): close-ups of the engraving, the serial, the damascening, the dial and the box, rendered by
  the page and by Blender (Cycles) from the same cameras, agree in place, orientation and scale: the engraving reads as on the page, the stripes run the same
  way at the same pitch and the bridges' undersides are plain, the dial is the page's. Blender's plates look more mirror-like: the same nickel (metal,
  roughness 0.2), but path-traced, reflecting the parts round them; give it an HDRI, or raise the plates' roughness, for the page's satin look.
- **Not carried across**: the escapement's settings as a bench to adjust (the export is at the page's), the jolt, the oiling and drawing modes, sections.

## The almanac

The essay's sky sections carry their own almanac, `ALM` in `shared/almanac.js`, so the page alone (or its single-file copy, offline) is enough to rate
the chronometer by the Sun, find longitude with it, and check it at sea by the Moon, with no radio signal. Angles are degrees, the corrections arcminutes,
times JavaScript's milliseconds of UT.

- **The places.** The Sun: the abridged VSOP87 series (Meeus, Appendix III) with the FK5 correction, nutation and aberration. The Moon: Meeus ch. 47 (the
  main ELP-2000/82 terms) with nutation. The stars: the Nautical Almanac's 57 and Polaris, SIMBAD's ICRS J2000 places and proper motions, carried by
  precession (ch. 21), nutation (23.1) and annual aberration (23.3). Sidereal time: Meeus 12.4 and the equation of the equinoxes. Nutation: the short
  series (0.5″). `tools/almanac.js` finds, against JPL Horizons (DE441) over 1950–2149: the Sun within 0.5″, the Moon within 6.5″ (its distance to
  42 km, 0.4″ of parallax); against skyfield, the stars within 2.1″ to 2120. Left out: the annual parallax (under 0.8″), light's bending, proper motion's
  second order (α Cen's 3.7″ a year carried linearly gives the 2.1″).
- **ΔT** (TT − UT1): Espenak and Meeus's polynomials to 2000, the IERS's measured values (each 1 January) from 2000 to October 2026 (69.09 s), then a
  forecast: that value held to 2050, then growing as their long-term parabola. It only matters to the Moon against the stars: a second of ΔT moves a
  lunar distance's Greenwich time by a second. The almanac's pages take a value instead.
- **The sight.** Dip 1.76′ √h; refraction by Bennett's formula with temperature and pressure (run backwards, by iteration, to make a sight); the
  semi-diameter (the Moon's augmented by 1 + sin HP sin h) and parallax HP cos h (the Moon's HP reduced for the latitude). The time sight, the intercept,
  a least-squares fix, the latitude by a meridian altitude (the noon sight) or by the pole star (the triangle solved for the latitude, at any hour angle), the daily rate from two errors, and equal altitudes (the chronometer's error that makes the two altitudes equal; the old rule, the middle of the readings, and the
  equation of equal altitudes for the difference). Round trips from sights the almanac makes give the longitude back within 0.001 nm, the error by
  equal altitudes within 0.01 s, the latitude by noon sights within 0.001′ and by the pole star within 0.33′ (with the DR longitude 30′ out).
- **The lunar distance** is cleared exactly on a sphere (the angle at the zenith from the apparent altitudes and distance, then the true distance from the
  true altitudes); the Earth's figure (up to 0.2′, 24 s of time) is taken off by clearing a sight the almanac makes from the place by dead reckoning, which
  brings the Greenwich time back within 1 s with the DR 30′ out. A distance changing under 15′ an hour is reported too slow. Refraction's flattening of the
  discs is left out (under 0.3′ above 10°, and the same in the almanac's own sight).
- **Venus and Mars** (`ALM.planet`): JPL's approximate Keplerian elements (Standish, Table 1, 1800–2050), the Earth from the Earth–Moon barycentre less
  the Moon's share, light-time, then precession, nutation and aberration: within 36″ and 102″ of Horizons from 1950 to 2049 (the essay states 1′ and 2′),
  for sights, not lunars.
- **Jupiter and Saturn** (`ALM.planet`, `PF` in `shared/almanac.js`): those elements err 400″ and 600″ for them (the two pull on each other), so their
  heliocentric longitude, latitude and radius are short series fitted by least squares to JPL's DE440 (`tools/planets_fit.py`, from DE440s through skyfield,
  every 4 days over 1850-2150): polynomials in T and 35-56 sine and cosine terms each in k1 λJ + k2 λS + k3 λU, chosen one at a time (the strongest left,
  none within one cycle a span of another's frequency, so no two cancel), a factor T on the strongest. Within 8.1″ and 4.0″ of DE440 seen from the Earth at
  worst, on the fit's dates and between them; against Horizons' apparent places at the 90 reference epochs, 6.6″ and 2.6″ (`tools/almanac.js`; the essay
  states 10″ and 5″). Good for lunars, but only from 1850 to 2150: fitted to 1850-2100 alone, the series errs 108″ and 183″ by 2149. Semi-diameters at 1 au
  98.44″ and 82.73″ (Meeus, Ch. 55; Saturn's globe).
- **By hand.** `sunHand` is the Astronomical Almanac's short formulas, as the essay prints them: within 0.6′ of the full series from 1950 to 2049, enough
  for a time sight, not for a lunar (the Moon needs the series, so its pages print).

## Testing

The page's state is kept in the URL hash, so a link opens the model as it
was: `#view=escapement&speed=0.05&part=det` (a view, speed and picked part, or piece: `part=bal.staff`; `view=laidout` is the laid-out train), `arm=1` (the balance locked, at rest), `block=1` (the train-blocking screw down), `cam=yaw,pitch,dist,x,y,z` (a camera turned, zoomed or panned by hand: where it was going, its distance without the narrow screen's pull-back and its target in the movement's frame, so the link frames the same on any screen; a view button, a walkthrough step or a zoom to a part drops it; both pages, 2 November 2026, so that `tools/penrender.py --link` can draw any view the page shows),
`#tour=6` (a walkthrough step), `#ovh=d12` or `#ovh=r46` (the overhaul at Op. 12 of the disassembly, Op. 46 of the reassembly), `#essay` or `#essay=detent` (the essay, sent on to its own page at that section, `../essay/index.html#detent`), `open=bookDet` (in a link: open that panel section), `drive=1` (Moving parts only), `draw=1` / `draw=ink` (Tinted / Ink drawing), `edges=0` (Edges off), `shadows=1` (Shadows on), `merge=0` (Performance mode off), `sec=x:-3.5`, `esc=rT:0.29,aI:185` (the adjuster's bench, where it differs)
(a cross-section; `:f` shows the other half, `:o` draws the Edges of the faces inside the cut parts across their cut faces: the panel's Outlines through the cut ticked; plain, unticked, is the default since 3.26.04, and `:p` from 3.26.03's links still reads as it), `tz=local`, and `t=10:09:30`
once the hands have been set. It is read at load and when edited, and
rewritten (without adding to the history) 0.3 s after any change.

Two URL flags help with testing:

- `?snap` switches off camera and state easing, so views settle immediately
  (useful for screenshots), and draws every frame (see below).
- `?qa` exposes the movement (`__mv`), the photo-projection helpers (`__proj`,
  `__unproj`) and camera controls (`__cam`, `__look`, `__camInfo()`) for the
  tools, plus the parts registry (`__parts`), the renderer (`__r`), a count
  of frames drawn (`__renders()`) and the stopping-and-starting state
  (`__H()`: amplitude, whether the train is held, the arm and screw), and the export to Blender (`__glb(clips)`: the file saved as a download,
  the named clips only if given; `tools/gltf_check.py`).

The stage is drawn only when something shown has changed: the camera, the
lids and lift, the wheels and balance, the wind, ship motion or a section, or
any input in the last 0.6 s. Otherwise it is redrawn once a second, and not at
all while scrolled off screen. A stopped model with a still camera draws once a
second instead of every frame. The balance's swing counts only while the
balance can be seen: with the movement in its case under the dial (the Dial and
Box views, nothing see-through, hidden, faded or cut), the hands' steps alone
draw a frame, about 4 a second at 1×, unless the walkthrough's inset or the
adjuster's bench shows the escapement. Without input a frame comes at most
every 10 ms, so a 120 or 144 Hz display draws the running model at 60 or 72 Hz;
input draws at the display's rate. Each frame is compared with the last one
drawn. Code that changes the scene without input or a `look()` call should call
`wake()`.

Every piece of the model is tagged with its line in the manual's parts list
(`userData.hn`, set by `hn()` in `core.js`; `bom.json` is the list, `tools/bom.py`
checks the model against it and writes `BOM.md` at the repository root).

The browser tools in `tools/` open `index.html?snap&qa` themselves. They need
Python with numpy, scipy and Playwright's Chromium, and write their output into
the folder they're run from. `escapement.js`, `almanac.js`, `solve.py` and the checks of the physics (`physics.js`, `dynamics.js`, `strength.js`, `errorbudget.js`: "Checked in time" below) need no browser. The
root README's "Checking your changes" lists which to run and what they should
report.

## Coordinates and units

Millimetres. Movement frame: dial side is +y, 12 o’clock is −z, 3 o’clock is +x.
Arbor positions are in `L` at the top of `movement.js`. The main levels are the
constants beside it:

| Constant | Level | Height above the pillar plate |
|---|---|---|
| `TB_U`, `TB_T` | Train bridge underside and top | 16.8 and 19.9 mm |
| `BB_T` | Barrel bridge top | 23.3 mm |
| `CK_T` | Cock top | 34.1 mm |
| `EY` | Escape wheel | 15.1 mm |
| `LB_T` | Balance lower bridge's top face | 10.9 mm |
| `BAL_Y` | Balance rim | 22.4 mm |

Below the plate (+y, on its dial side): the mounting ring's flange from `MR_FL` (2.14 mm) to `MR_Y` (6.54 mm), the dial's seat. The dial and all above it (`DD`, 3.24 mm) stand that much higher than when the dial stood on 3.3 mm feet on the plate.

## How the timing works

Everything is driven from one model clock `tSim`, in seconds of the time kept (GMT by default, or local time).

Beside it runs the master time `tM`: a perfect clock, standing for the time signal the chronometer is compared with. It runs at the model's speed, also while the chronometer stands, and doesn't follow the weights. The dial error is what the hands show (`dialRead()` in `app.js`: the second hand's time, continuous as a comparator reads it, with the minutes from the minute hand) less `tM`; it grows with the rate, with the time the chronometer stood, and with setting the hands.

- The balance's phase is `y = tSim / 0.5 + bOff + PL`, one oscillation per half-second, counted
  from its far turn before the unlocking; `p = frac(y)`.
- `ESC.state(p)` returns the balance angle, detent lift, trip-spring deflection
  and the escape wheel’s progress through its current tooth. `p` 0 is the active
  swing's start, the wheel locked (progress 0). The progress dips a little under
  0 while the stone is drawn out against the locked tooth (the recoil, at most
  0.18° of the wheel, from −27.8° to −22.6° of the balance), and after the impulse
  the tooth runs on from where the jewel lets it go (0.96 of a pitch, +20.7°) to
  the stone at the speed it had and more, locking at +22.1° (at 255°).
- Escape wheel position is `E = floor(y) − 1 + progress + eOff`, counted in
  teeth (`eOff` whole). Every other arbor is a fixed ratio of `E`. The hands therefore advance
  in half-second steps, as the manual states (Sec. IX, p. 66). `PL` (0.263 of an
  oscillation at 255°) is where the next tooth locks and the second hand comes to rest, so
  with `bOff` and `eOff` 0 the hand lands on the mark k/2 s at `tSim` = k/2, as on a
  chronometer set to a time signal; `dialRead()` gives the time the hands show,
  `tSim + (bOff + eOff)/2` (with `slip`, the hour and minute hands' turn on the cannon pinion). The train goes by this phase
  at every speed (above `REAL_X` only the drawn balance is slowed), and the wheel never turns
  back (the progress at a phase changes with the swing).
- The fusee and chain follow the hours since winding (`hrs`, which runs with the
  train's own time, `tSim`, so a fast chronometer runs down sooner by the master's
  clock): one fusee turn per 90/14 = 6.43 hours. The model runs down after 56¼ h (`RUN_H`, the fusee's 8¾ turns,
  the manual's 17½ half turns from completely run down); the dial's UP–DOWN scale
  covers the rated 56 h. The run down is the chain's own: its last turn leaves the
  fusee at 55.1 h, and its end pin (`ME`, 8.54 turns down the groove, 0.21 turn
  short of the groove's end) then swings on past the tangent toward the barrel, the
  chain running straight from it, so the chain's lever on the fusee (the arbor's
  distance from that line, `fs.lever`) falls from 14.7 mm to nothing over 1.2 h,
  where the line passes through the arbor (`geo` in `makeFusee`). The pin is placed
  so that is at `RUN_H`: the chain's end on the fusee isn't seen in any source, and
  the manual's 17½ half turns are the fusee's turns from that rest. The drive falls
  with the lever, and the train stops about 5 minutes before `RUN_H`, its drive
  under the 0.14 that keeps the balance above `ESC.AMIN`. Until 11 October 2026
  the chain ran to the groove's end and the drive stopped at `RUN_H` from full,
  with 0.03 turn of chain still on the fusee.
- The chain lies in the fusee's helical groove, locked to it: `setWind(n, eps)`
  places its joints 1.7 mm apart along a pitch line wound on the fusee from its
  end pin (`ME`) to where it leaves (`md`, the fusee's turn plus the common
  tangent's drift), then along the drums' common tangent and round the barrel
  (the barrel taking up what that straight run gains, so the chain keeps its length)
  to its hook. The stop-bar's travel comes from the same place: the bar's
  chain end, which stands out over the groove's top turn 0.14 turn from where
  the chain leaves at full wind and reaches down into the links' upper plates,
  is kept just outside the drawn chain (`barTravel`: each corner of its end
  inside the incoming run's inner face, then inside the wound turn's), so the
  links press it in as they arrive, until the end's outer corner is at the
  chain's inner face, 1.98 mm, so the stop end stands out past the rim for the last
  0.4 turn of a wind and meets the winding stop at full wind. Full wind is
  where the stop end's leading corner first touches the stud (the bar's turn
  `al` is solved for it from the stud's measured place), 0.47 mm into the
  stud's path; on every earlier turn both ends pass it 0.6 mm or more clear
  (`tools/maintaining.py`).
- Maintaining work (`update()` in `movement.js`): when running, the fusee's
  winding ratchet drives the sustaining ratchet through the two winding pawls,
  and a pin on that ratchet drives the fusee wheel through the sustaining
  spring, which carries the whole drive (the manual: "through the sustaining
  spring, under load during the entire running cycle"). It is a split ring
  weaker than the drive (Gould, 1923; Glasgow, 1885), so in running the drive
  closes it on its banking (`SSB`, its lobes 0.5° apart). `R.ssD` is how far it
  has relaxed from banked; it pushes with `SPU` (0.28, what its section traced on the
  video gives: `tools/sustaining.js`; 0.33 from the automated trace and 0.22 with the 12.5° gap first read, 18 October 2026; 0.82 designed until 17 October 2026) times 1 − `R.ssD`/`SMAX` of the 12-hour drive (`R.ssF`,
  `SMAX` 16.9°, its 17.4° gap measured less the banking; 12° until 18 October 2026, 19.5° until 17 October), so running it stays
  banked while the fusee's drive is over its push (`R.drvN`, the mainspring's
  set included), all the run but its last taper, then relaxes as the drive
  tapers to run down (a taper of 1.2 h, far slower than the spring, so it
  follows it and the sustaining pawl never holds). Until 14 October 2026 it
  was an unbanked spring carrying the whole drive, `SMAX` 9.3°, the fusee
  wheel's turn in 10 minutes. The fusee turns with the sustaining ratchet, its faces on
  the winding pawls, so it sits `eps` (`R.eps`, within a tooth) past its `n`
  turns. Should the fusee's drive fall faster than the train relaxes the spring
  (the slider set to run down, a set taken), the spring turns the ratchet back
  until the sustaining pawl holds it (`holdBack`: the next place a face meets
  it, every tooth from `phaseAgainst`'s) and drives the train alone, the fusee
  standing. When winding starts, the spring pushes the ratchet back with the
  fusee, the winding pawls still on their faces, until the sustaining pawl
  catches it; only then do the winding pawls ride over the winding ratchet's
  teeth, and the spring relaxes as it drives the train; `eps` runs down with
  `n`, so the stop-bar meets the winding stop at full wind. When the key lets
  go (`catchAt`), the fusee turns forward to the first place its ratchet meets
  the pawls (none if it is on them), then on with the ratchet until the spring
  is loaded to the drive again; `R.release` gives those turns and `app.js`
  (`windEnd`) takes their hours off the mainspring, so `eps` stays within a
  tooth over any number of partial winds. A set of the hands moves the ratchet
  with the train (the spring as it was; the loop can say so with `reset`), a
  jump of the slider the fusee to its new turns on the nearest tooth. Nothing
  turns back but as said; `tools/maintaining.py` checks it all. Every pawl is rested on its ratchet's teeth each frame
  (`seatPawl`: turned in from outside to its first touch, the teeth's tips kept out of its outline too), so it rides over them or bears on a steep face. The winding
  pawls' flat springs are rebuilt with them (`wpsGeo`), their ends kept on the
  arm as the pawls swing out over the teeth while winding.
- The mainspring (`mainspringGeo` in `core.js`) is rebuilt from the barrel's turns `Ib(n, eps)`: its turns from the inner end to the outer fall from `Tup` at full wind by the barrel's turns (`fs.MS`), and its shape at each is the solved one ("The mainspring, solved" below): wound, its coils drawn in round the arbor, a gap at the wall; running, they open out toward the wall (let right down, as for service, most would lie in a pack against it with loose turns inside). Its inner end is held by the arbor's hook in an eye, and its outer end turns with the barrel, its anchor pin on the brace. The arbor never turns, and the setup click faces the spring's pull.
- What turns while winding: the fusee wheel follows the train (`gA`), not the
  fusee, so it keeps turning forward, driven by the sustaining spring, while
  the key turns the fusee and its winding ratchet back and the sustaining
  pawl holds the sustaining ratchet. The setup ratchet never turns in running
  or winding: its angle is set once when the movement is built (`srw.rotation.y`,
  a steep face on the click), and `update()` turns it only by `ld`, when the
  page lets the mainspring down and sets it up (Mainspring, under Winding). The barrel arbor turns only when
  the watchmaker lets the mainspring down or sets it up with a let-down key
  (Sec. II, p. 4: "the only time that the mainspring arbor turns is when
  manipulated during assembly, disassembly or adjustment"; Ops. 8, 53).

### Stopping and starting

A detent chronometer does not start by itself (Sec. III), so the balance's
amplitude is kept as state (`H.amp` in `app.js`; running, it comes to `ESC.A`, 255° each way at the model's settings)
and `ESC.state(p, amp)` gives the escapement at that amplitude.

- **What keeps it going.** A swing must carry the discharge jewel past the trip
  spring on the return (it comes clear of the jewel's end at −40.2°), unlock the wheel (−21.3°) and
  see the impulse through (the tooth leaves the jewel at +20.7°). `makeEsc` works out that least amplitude
  from its own tables: `ESC.AMIN`, 40.6°, the trip spring's the one that binds. Exactly so: the 2° it
  was given to spare until 11 October 2026 had the train held between 40.2° and 42.3° while
  `ESC.state` drew the detent unlocking it.
- **When the train stops.** It stops at a locked beat when there is no power
  (run down: a frame runs the train no further than the chain has left, and only the
  beat under way then finishes), when the swing falls below `AMIN`, or when the locking arm brakes
  the balance. With the train-blocking screw's dog point down between the fourth
  wheel's spokes it goes on until the next unlocking lets the escape wheel go and a
  spoke meets the point (`R.blockRoom(E)`, the beats left), a fraction of a tooth past
  the lock, as the manual's Op. 6 has it ("allow the escapement to function until the
  train is stopped by the blocking screw bearing against one of the arms of the fourth
  wheel"). The detent is back on its stop with no tooth on it, and the tooth the spoke
  holds stands in the impulse jewel's path (unless it stopped within 0.04 of a tooth of
  either lock): the jewel strikes it on each return swing (`bankAt`, `bankState` in
  `box.js`, the angle where `ESC.PA` meets the wheel's place), so the balance swings
  only on its own side of the tooth and is stopped as quickly as by the arm (`TAU_ARM`,
  estimated). Raised, the screw lets the wheel run on to the next tooth's lock, a
  whole beat again.
- **While it is stopped** `tSim` and the hands stand, so they lose the time it
  stood, as a real one does. The balance keeps its own phase (`H.bph`) and runs
  down. With the train held it runs down free of the impulse (the air and pivots, 1/e in 67 s, `TAU_FREE`, from
  `ESC.settings.TF`, derived from the energy budget: "What the model gives a maker"), but while the swing still carries the discharge jewel back
  past the trip spring's tip (above 40.6°) the jewel still bends the trip spring on the return and lifts the
  detent on the next swing, and the wheel can't turn: the springs take `ESC.EHd`, 0.027 of k
  an oscillation (19 % of the air and pivots' loss at 255°, more than theirs below about 109°: the drawn detent leaves the jewel still
  moving and loses its springs' and its own kinetic energy there, about 9 % more than a massless one's 0.025, `ESC.EH`), so from
  255° it comes down to 40.6° in 59 s, not 125 (`ESC.freeStep`, in closed form a second at a time; `tools/dynamics.js`
  integrates the same run-down within 0.7°). Against the locking arm it stops at once, within a swing or two
  (`TAU_ARM`, 0.2 s). A smaller swing leaves the jewel on the near side of the tip: the
  trip spring stays bent against it and follows it back, and the detent stays on
  its stop (`ESC.state`).
- **When it goes again.** The train runs again when there is power, the arm is
  off, the screw is up (or leaves a spoke's room) and the swing is above `AMIN`, the
  wheel on its stone and the balance where its swing doesn't unlock it. That happens at once if
  the balance is still swinging: the screw raised before a spoke stopped the train (or
  after, if the tooth it held was clear of the jewel), or the chronometer wound,
  before the balance has run down. Otherwise it takes Twist to start. The twist
  turns the box sharply 35° about the vertical and back a quarter of a second
  later (`TWIST` in `box.js`, illustrative); the balance, free on its pivots but for
  the hairspring, stays where it is in space while the box turns under it, so
  relative to the movement θ″ = −ω²θ − α″, and turning back half its period later
  doubles what the first turn gave: from rest it is left swinging about 67° (a real
  start by hand, `We1dLNXiBj0` 0:55, was 62-66°), worked out from where the balance is
  (`TWIST.path`, which the page also draws the balance along while the box turns, then
  leaves it with the swing and phase it ends with; with reduced motion the box doesn't
  turn and the end state is eased in over 0.15 s; with the train going, a twist is a
  knock, as a jolt is), and the
  impulses bring it up to the swing the train's torque gives (`ESC.ampAt`, 255°
  at the calibrated torque), settling over a minute or so (A² relaxes as exp(−2t/TF), 34 s; below, The balance's
  dynamics).
- **Nothing jumps on restarting.** `H.bOff` and `H.eOff` carry the balance's
  phase and the beat count across, so neither the balance nor the hands jump.
- **Moving the controls.** The arm and screw move on frame time, not model
  time, whatever the speed: the arm turns in 0.8 s, and the screw takes 2.5 s
  over its 32 turns. The screw can't
  come down on a spoke (`R.blockClear(E)`), so it waits just above the wheel
  until a gap comes round.

### The rate panel

`R.timing(nt, nv)` returns the balance's moment of inertia `I` with the timing
and vernier pairs turned `nt` and `nv` turns out, and `tSim` runs √(I₀/I) as
fast as real time. The rate for a turn is the manual's; the moment of inertia
and the thread pitches are the model's. Things to know before changing it:

- **"One full turn" is read as the pair.** The manual says "One full turn of
  timing weight equals about 40 seconds. One full turn of vernier timing
  weight equals about 2.8 seconds" (p. 70, under Table II, which is for pairs
  of screws). The model takes this as both weights of a pair turned a turn
  each, as they are in practice to keep the balance in poise. If it means one
  weight, the pitches double, to 0.29 and 0.18 mm. The rates the panel shows
  would not change, because the pitches are fitted to the manual's figures.
- **The moment of inertia is Table II's.** Table II (p. 70) gives the rate a
  pair of screws of one head height makes against another: 0.100 in to 0.080
  in, about 16 minutes a day; 0.100 to 0.050, about 43; and eight more. The
  parts list's masses (the screws' 125–130 mg and so on, the timing weights'
  93 mg, the verniers' 10.5 mg, the washers') are read as a matched pair's, half
  each (`PM` in `movement.js`; inferred, likely: "Estimated" below). With them at
  their heads' radii, those changes fit a balance of 578 g·mm² (least squares
  over the ten, `I_T2`; each within 2.6 minutes a day of the table). The balance
  is drawn as the restoration video measures it: the rim 3.5 mm tall and 0.6
  thick, the screw heads 3.1 mm across, each screw through the rim to a point
  inside it. Drawn so, it makes 534 g·mm²; `I_REST` (44 g·mm², 8 %) adds the
  difference, so a screw change makes Table II's rate. Read as each one's mass,
  the same table would need 1,157 against a drawing of 731: 37 % that nothing
  measured carries (it was `I_REST`'s 410 until 4 October 2026).
  The hairspring's stiffness follows: I (4π)², about 91 µN·m a radian.
- **Changing the balance changes the pitches, not the rates.** A heavier rim
  or larger screws raise `I₀`; `R.pitch` follows, and a turn stays 40 s and
  2.8 s a day.
- **Check clearances after any change to the balance.** The balance runs in
  the barrel bridge's 17.7 mm cutout, at the bridge's own level. The weights'
  screw tips reach 17.35 mm from the balance axis, and the 0.101 in screws
  17.07 mm. `dyn.py` tests only mid-travel, so also run it with the weights at
  both ends of their travel: call `__mv.userData.R.timing(3,3)`, then
  `(-3,-3)`, after the page loads (`python fine.py --eval "__mv.userData.R.timing(3,3)"` does this). `dyn.py` ignores balance–cock overlaps
  (`IGN`). The cock's body is 22.6 mm from the balance axis (`CK_RP`, measured on 44:02; 17.7, the barrel bridge's circle, until 15 October 2026).
- **`audit.py` lists the weights' screw tips as loose ends.** They stand
  beyond the nuts, as in Fig. 3, and are expected (its `LOOSE` table).
- **The holes.** The rim has 24 tapped holes, 15° apart, numbered 1–13 round
  each half from an arm's end (Fig. 99's numbered block; Table IV): hole 1 is
  the arm's end, where the timing weight's screw goes through the rim into the
  arm, 2 the vernier weight's, inside the rim, 7 the quarter, and 3–12 take the
  balance screws, a pair in the same hole of each half (`R.holeA(h, n)`). Table IV's moves are
  symmetric about hole 7 (3 to 4 as 11 to 10), which puts it at 90° from the
  arm's end; the restoration video (KLUwI2UUCMQ 6:47.5, 6:52.5, the rim fitted
  as an ellipse) shows every hole and screw within 1.5° of a 15° place. Its
  balance carries four pairs, in holes 3, 5, 9 and 12, the model's standard set.
- **Table IV, as data.** `R.T4(hh, n)` gives the change in the temperature
  compensation for a pair at hole n against hole 7, hh its head's height and
  washer in inches, from Table IV's "7 to n" figures, each column fitted to its
  30 printed rows (`invariants.py` checks them to 0.04 s a day; two printed
  figures disagree with their rows, see the comment in `movement.js`). Moving a
  pair keeps the moment of inertia, so only the rate in heat changes. The table
  has no figure for a pair taken out or put in, nor for a head changed where it
  stands, and the panel says so.

### The escapement's amplitude and rate

`makeEsc` works out how far the balance swings and what the escapement does to
the rate from its own geometry, so the Adjuster's bench changes both (`ESC.A`,
`ESC.run`).

- **Amplitude, from the work done each oscillation.** Work is counted in units
  of the hairspring's stiffness k. Released from rest, the escape wheel and the
  train behind it (`JW`, 6.05 g·mm²: every arbor weighed on its drawn solids,
  mechanisms.json, the escape wheel with its pinion and arbor 5.22 and the
  fourth wheel's 0.81 reflected through its pinion; 5.9 until 14 October 2026,
  the fourth wheel estimated) gather speed under the torque w k and chase the
  impulse jewel, already running away from them: at the model's settings the
  tooth lands on it at −2.1°, 19.2° of the balance after the release, running
  at 2.6 times the jewel's speed. The
  strike gives the balance J v_j (v_w − v_j) (29 % of the impulse); then the
  tooth drives the jewel through 12.1° of the wheel, w times that turn less what
  speeding the wheel up with the jewel takes (lost when the next tooth locks).
  Unlocking takes back three things: the locking jewel drawn back against the
  tooth and rubbing on it, dL(tan DRAW + μ)/(1 − μ tan DRAW) of the wheel's
  turn; the detent, lifted against Op. 78's preload and its spring's stiffness
  (`W78`, `hD`, `EB`) all the way the discharge jewel carries it, 1.5 times the
  lift at release (lost as it falls back); and the trip spring (`tsH`, `ET`),
  bent on the return round the jewel's end, its radiused back and then its square acting corner (lost as it flies back). The swing
  loses πA²/Q, Q = πTF/T from the balance's free run-down, so πA²/Q = Wn(A).
  Only w is fitted, so the model's settings give 255°; unlocking then takes
  14 % of the impulse's work, the detent 8 %. Until 11 October 2026 the wheel
  moved as a kinematic gear (`G`, landing 0.6° after release) and the
  springs' shares were fitted (`fD`, `fP`); `tools/dynamics.js`, integrating
  the escapement beat by beat, found both wrong, and now agrees with it.
- **Rate, by Airy's result.** A push at balance angle θ moves the phase by
  −(τ|dθ|/k)·θ/(A²√(A²−θ²)) an oscillation: a push before the dead point gains
  and one after it loses, a resistance the reverse. Summed over the impulse
  and the unlocking, and taken against the model's settings, this is the rate
  in s a day. The escapement's own error at the model's settings (−3.0 s a day:
  impulse −2.5, draw −0.3, detent spring −0.9, trip spring +0.6) is taken up in
  the timing, so it shows as 0.
- **What the settings do.**

  | Setting | Amplitude | Rate | Why |
  |---|---|---|---|
  | Impulse jewel at 184° | 246° | +0.5 s a day | The impulse ends sooner after the dead point (18.0°) |
  | Impulse jewel at 178° | 266° | −0.5 s a day | |
  | Depth of lock 0.17 mm (0.025) | 244° | −1.5 s a day | More resistance before the dead point |
  | Depth of lock 0.20 mm (0.03) | 237° | −2.7 s a day | |
  | Discharge jewel at 262° | 225° | −4.2 s a day | |

  One slider alone keeps the balance above `AMIN`. Several together can bring
  it under, and the bench then refuses the setting.
- **The model's settings are the reference.** There `ESC.A` is exactly 255°
  and the rate exactly 0. Every tool that calls `ESC.state(p)` with the default
  amplitude sees no change. The reference's constants are cached on
  `makeEsc.refs`, by the calibration settings (`EX`, `A`, `TF`, `MU` and the
  bodies' and springs' `I`, `JW`, `W78`, `hD`, `EB`, `ET`, `tsH`).
- **While the train is held,** the balance swings free: it has no escapement
  error and keeps the weights' rate alone.
- **Isochronism** is the escapement's, its rate at another swing
  (`ESC.rateAt`, below), plus the hairspring's own, `HS` s a day for each 10°
  more swing: 0 by default (the spring taken as isochronous), set on the
  Adjuster's bench's last slider. At −0.20 the spring all but cancels the
  escapement's loss at a smaller swing (0.003 s a day at 90% of the torque).
  `tools/escapement.js HS=-0.20` prints it.
- **Not modelled:** friction at the impulse and, in the work, the detent's own
  inertia and bounce (`tools/dynamics.js`: they change the swing by about 1° and the
  rate by about 0.1 s a day). The recoil is drawn (`ESC.state`, since 11 October
  2026) and counts in the work as before.

### The balance's dynamics

The balance's equation of motion, averaged over a swing. The model's clock
still sets the phase (`frac(tSim/0.5)`, so the hands step in half seconds at
every speed); the equation gives the amplitude and the rate.

- **Amplitude.** The escape wheel's torque is `s` times the one the escapement
  is calibrated at. The impulse's work and the locking jewel's draw scale with
  it; the detent and trip springs' work doesn't. In ½A², in units of the
  hairspring's stiffness, a swing gains that work and loses πA²/Q. So A²
  relaxes to `ESC.ampAt(s)²` as exp(−2t/TF), exactly for a steady torque.
  `ampStep` steps it so, at any speed. A² settles as exp(−2t/TF), 34 s.
  Free, with no impulse (the train held), d(A²)/dt = −2A²/TF − 2·EHd(A)/T while the swing still
  passes the trip spring (the detent's and trip spring's work, `ESC.EHd`, lost as each flies
  back: the detent's from where it leaves the jewel, `depart`, its springs' energy and its own kinetic energy), −2A²/TF below it:
  `ESC.freeStep`, in closed form a second at a time. Until 11 October 2026 it fell as
  exp(−t/TF) at every swing.
- **The drive** (`driveNow` in `app.js`). Running, the mainspring through the
  fusee: `R.fs.torque`, 1 at 12 h from full wind, the middle of a day's
  running, falling to nothing over the last 1.2 h as the chain's end pin swings
  round (the train stops about 5 minutes before `RUN_H`, under 0.14 of it).
  The sustaining spring carries it, closed on its banking, so while the key
  turns it drives alone with its banked push, 0.28 of the 12-hour drive,
  falling linearly to nothing as it relaxes over its 16.9° (`R.ssF`; about 18
  minutes at the train's pace, but the swing falls with the push: it falls under
  a turn within the first minute and the train stops after about 6, `tools/sustaining.js`): a wind of half a minute takes the swing from 255° to about 180°
  and it comes back when the key lets go. The
  same push drives the train when the fusee's drive falls faster than the
  spring relaxes (`canDrive` holds the train only when neither drives). Until
  11 October 2026 the drive dropped to 0.8 the moment the key turned, as if
  the spring were weaker than the drive it had been carrying.
- **The spring's pull** (`makeFusee`'s `pull`, `lever`, `torque`). The solved
  spring's pull (`msPull`) at the barrel's turns, times the chain's lever on
  the fusee (its pitch line where it leaves the fusee): with the set-up the
  profile asks for, the torque on the fusee wheel keeps within about 2 % of its
  mean (0.986–1.021) while the chain leaves the fusee, the residual of the solved
  spring's curve against the profile. A going barrel with the same spring
  (`pullB`, its pull falling evenly with time, geared to match at 28 h) would
  vary about 2:1. Until 11 October 2026 the drive took an illustrative pull,
  the profile's even fall made 3 % steeper at each end, on the groove's floor.
- **Rate against swing** (`ESC.rateAt(a, s)`): Airy's sum over the impulse,
  the unlocking and the springs at amplitude a, against the reference.
  A smaller swing feels the escapement's pushes more:

  | Swing | Torque | Rate |
  |---|---|---|
  | 247.5° (1⅜ turns) | 95% | −0.15 s a day |
  | 255° | 100% | 0 |
  | 270° (1½ turns) | 111% | +0.28 s a day |

  Each frame, `escK = 1 + ESC.rateAt(H.amp, drive)/86400` while the train
  runs, so the dip while winding and a jolt show in the rate book.
- **Over a wind.** With the fusee the rate stays within −0.01 to +0.08 s a day
  while the chain leaves the fusee (to 55.1 h; then it falls with the drive);
  with a going barrel, −1.47 to +0.71. The manual's
  isochronism check (Sec. IX: the 12-hour rate against half the 24-hour rate
  at 72½ °F, wound at the start; tolerance 0.50 s, the factory test card of
  No. 3390 reads 0.00) comes to +0.01 s with the fusee and +0.07 s with a
  going barrel. `tools/escapement.js` prints the rate at 1⅜ and 1½ turns.
- **The mainspring's set** (`MSET`; Op. 13, "Check condition and set of
  mainspring"). A spring that has taken a set pulls less all through its run;
  the drive is scaled by 1 − set, so the fusee keeps it level but lower. At
  20% the balance swings 224° and the chronometer loses about 0.7 s a day.
- **The 30-day performance test** (`testCalc`). Each day's rate is the
  model's at the period's temperature: √(I₀/I) from the weights and screws,
  the balance's temperature curve, and the escapement's and hairspring's rate
  averaged over the 24 hours after winding (wound at each daily reading). The
  errors are rounded to the comparator's 0.01 s and the rates read from them,
  as on the card. At the model's settings it passes: regulation 0.06,
  temperature 0.07, 0.07 and 0.00 (the card of No. 3390: 0.08, 0.06, 0.02),
  isochronism 0.01; the split balance fails 90 against 72½ °F (1.46, limit
  0.75), and an eighth of a turn on the timing weights fails regulation. The
  model has no day-to-day scatter, so rating and recovery come out 0.00 (the
  card's real chronometer: 0.03 and 0.06).
- **A jolt** (`jolt` in `app.js`; illustrative). A knock about the staff jerks
  the balance's speed by 0.6 to 1 of its running top speed, either way at
  random. From θ and θ′ the balance goes on at A = √(θ² + (θ′/ω)²). Checked
  under `AMIN`, it sets (stops). Carried past `ESC.TRIP` (a full turn plus the
  angle where the discharge jewel meets the trip spring, 333.2°), the jewel
  comes round and unlocks a second time, so the wheel trips: one extra tooth,
  and the hands jump half a second. The knock also moves the balance's phase,
  to the one θ and θ′/ω give (`knock` in `app.js`): the escape wheel stays on its
  stone, so the next unlocking comes sooner or later, and the dial error shows the
  knock's time error (a few hundredths of a second, more when it nearly sets).
- **Gimbals with inertia** (`gimStep` and `GIM` in `box.js`, the page's and the
  export's; illustrative). The case, with the ring about the ring's pivots, hangs as
  a pendulum below each axis: ψ″ = −ω0²((1 + av/g) sin ψ − (ah/g) cos ψ) − 2ζω0(ψ′ − φ′),
  φ the box's angle. At sea the box rolls and pitches about the ship's axes, taken
  5 m below it (`GIM.RD`, estimated: a chart room above the centre of roll; the U.S. Naval
  Institute's rules of 1882 have the case screwed down amidships, and no source found gives its
  height above the roll axis), so the
  pivots move with it, ah = RD(φ″ cos φ − φ′² sin φ) and av = −RD(φ″ sin φ + φ′² cos φ),
  and the case hangs along the apparent vertical, gravity less the pivots'
  acceleration, not the true one: at the default 7 s and 14° it leans 5.4° against the
  roll at its ends (1.9° at 12 s), within 0.2° of the apparent vertical. A box rolled
  faster than a ship rolls (under 4 s, the distance falling to 0 at 2 s) stands for one
  rocked about its own pivots. The case's own period is 0.7 s (estimated: its weight
  some 15 mm below the pivots, radius of gyration about 45 mm) and ζ is 0.05; near
  0.7 s (the Roll period slider) it swings with the box, stopping 25° off it against
  the ring. A jolt kicks it. `?snap` and reduced motion keep it exactly level, as
  before.
- **Temperature** (`MTE` in `core.js`). The balance's own curvature, on top of
  Table IV's line. The Model 21's balance: the second difference of the
  factory test card of No. 3390 (Sec. IX, p. 68; period means 90 °F −0.02,
  72½ +0.06, 55 0.00 s a day), a gain in the middle of 0.07 s a day against
  both ends. A second card, No. 5580's (Bennett, *NAWCC Bulletin* 356, 2005, Fig. 5:
  90 °F −0.015, 72½ +0.01, 55 −0.18), gains 0.11 in the middle: the same sign
  and size (not used to change `MTE`). The split balance: the essay's illustrative middle temperature
  error, compensated near 45 and 90 °F and gaining up to 1.5 s a day between.
  The rate panel's chart gives the Navy test's three temperature compensation
  figures against their limits (0.75, 0.75, 1.20 s a day). The split rim curls
  (`R.balCurl`): a two-layer strip's curvature changes by 1.5 Δα ΔT / h,
  about 3.9 × 10⁻⁶ /mm a °F for brass on steel 1.6 mm thick. A point φ from the
  fixed end then comes in by R²Δκ(1 − cos φ), 0.05 mm at the free end for
  27½ °F, drawn 20 times as far (`R.CURLX`).

### Checked in time: the escapement, strength and an error budget

Three Node tools (no browser) check the averaged physics above against a model
that doesn't average, and ask the questions it can't: would it work, would it
fall apart, would it keep time. They fail on a disagreement with the model and
on what would stop the chronometer.

- **`tools/dynamics.js`, the escapement in time.** The balance, the escape
  wheel (the fourth wheel's inertia reflected onto it) and the detent as
  bodies, integrated through every contact (RK4, each contact found by
  bisection), on the contact geometry worked out apart from makeEsc's (the two
  agree to 0.01 µm). The integrator is checked against a damped oscillator kicked
  at its dead point (−ζ²/2). Against makeEsc, with its springs and a massless
  detent: the swing 255.5° (255°), the tooth landing 18.7° after the release
  (18.9°; 16.2° and 16.3° at the old spring's torque, until 12 October 2026), the detent falling back at −12.6° (−12.6°), the escapement's own rate
  within 0.1 s a day, its isochronism within 0.01 s a day over the manual's
  swing. With the detent's own inertia (2.609 g·mm², from the drawn pieces) and
  its bounce on the stop button, the swing 1.3° less and the rate 0.1 s a day.
  - *What it found* (11 October 2026), now in makeEsc: the wheel, released from
    rest, catches the impulse jewel well after the release (it was taken as a
    kinematic gear landing 0.6° after it), and strikes it; the discharge jewel's
    square end held both springs' tips across its whole width (overall about
    38°, past Op. 87: the end was then stoned to a half round and the jewel's
    settings re-chosen to the manual's figures; since 12 October 2026 only its
    back is radiused, as the British Museum's Model 21 is described, `rB`); the detent's work is Op. 78's preload (the weight less the spring's bend over 0.005 in, since 14 October 2026)
    over its whole lift, not a fitted share; and 255° with those wants a balance
    running down in 52 s (Q 327), as the energy budget and the balance's parts
    allowed (`TF` was 34); 68 s (Q 427) from 12 October 2026, with the videos' thinner mainspring and the endstone's friction measured; 67 s (Q 421) since 14 October 2026, with Op. 78's preload less the spring's bend.
  - *The detent's return* (OPEN-QUESTIONS.md 2): makeEsc draws its fall as dynamics.js
    integrates it (off the square acting corner at about −18°, falling back onto the
    jewel's end and carried on it; leaving it for the last time at −13.06°, first on its stop
    at −10.26°; dynamics.js the same). The detent is back on its stop
    about 10 ms before the next tooth reaches the stone, from half to twice the
    drawn spring's stiffness, at half or 1.5 times Op. 78's preload, with a dead
    or a bouncy stop, and even with no preload at all.
  - *Starting and stopping.* Twisted to 67° (the page's twist from rest, box.js `TWIST`), the balance comes within 2° of its
    swing in about a minute and a half (93.5 s; the averaged model 124 s); the least drive that keeps it going is about 12 % of
    the calibrated torque, the balance swinging about 41° (makeEsc: 13 %, at its `AMIN`, 40.6°).
  - *Run down with the train held* (no torque): from 150°, 117.4° after 10 s and 85.0° after 20
    (makeEsc's `freeStep` 117.1° and 84.7°; the air and pivots alone would leave 129.5° and 111.8°), 48.8° after 30 s (48.4°): within 0.7° at 5, 10, 20, 30 and 45 s
    (dynamics.js's check, within 2°). Until 12 October 2026 `freeStep` took a massless detent's loss (`ESC.EH`, the springs' energy where the jewel releases it), and ran
    2.8° behind the integration at 30 s: the drawn detent (then 2.67 g·mm²) leaves the jewel earlier, still moving, and loses about 9 % more (`ESC.EHd`).
  - *Knocks and the sea.* A twist about the staff upsets the beat at about
    29 rad/s in 2 ms (it gains a beat); a blow across the plate frees the wheel
    at about 40 g over 3 ms, 112 g over 0.5 ms (the detent isn't poised about
    its flexure: a steady 18 g lifts it off its stop and 34 g frees the wheel; 55 g, 140 g and 47 g
    before the detent was rebuilt to its measured lengths, 20 October 2026: shorter and lighter, and Op. 78's
    preload, 0.56 g at the jewel, less). Yaw of ±10° and ±0.3 g
    sideways at the period of a roll move the rate by under 0.01 s a day.
- **`tools/strength.js`, would it fall apart.** Every loaded part fully wound,
  against its material's published range (the margin at both ends): the train's
  teeth by Lewis (each stage lossless), the escape wheel's tooth struck at the
  jewel's speed, the pivots and the fusee's bushing, the chain and its end
  fittings at the chain's 48 N, the mainspring, hairspring, detent spring (by
  Goodman, preload and whole lift) and trip spring, and the knocks that bend a
  pivot (the balance staff's at about 700–1,400 g). Nothing fails. The thinnest
  margins: the fusee wheel's teeth (1.5–2.2), the fusee bushing's pressure
  (1.0–3.6) and the mainspring, which works near its limit, as a mainspring does
  (it fails by taking a set).
- **`tools/errorbudget.js`, would it keep time.** As made: makeEsc with a
  maker's tolerances on every escapement setting (Monte Carlo, estimated
  tolerances): about 81 % run as made and 64 % swing inside the manual's band (70 % with the parts list's spring and `TF` 52 s),
  about a fifth meet every adjustment figure before adjusting (overall, drop
  and let-off are the usual misses: the adjuster's work, Ops. 84–97). At sea:
  60 days from a winter port into the tropics, rated over 10 days in port, each
  day's rate the sum of the test card's temperature curve, scatter and drift
  (calibrated so the simulated Navy test reads as No. 3390's card), the
  barometer through the air's share of the damping and the time-domain
  isochronism, the oil thickening (estimated) and heavy weather from
  dynamics.js. A chronometer like No. 3390 carries about 1.4 s after a month (a
  third of a mile of longitude on the equator), 4 s after two; one that passes
  the Navy's test only half the time, about 15 s and 38 s. Drift and the
  temperature curve dominate. The empirical terms are the card's, not physics:
  the model has no other source for a chronometer's day-to-day scatter.
- **`tools/gearing.js`, would the train run, made on a CNC.** The four meshes of
  the going train worked tooth by tooth on the outlines the model draws (core.js
  `gearOutline`, BS 978's cycloidal teeth, sampled finer): the wheel turned
  through a pitch, the pinion turned back against its load until the outlines
  touch (found to well under a micrometre), and from the contact's normal and
  slip the torque the pinion receives, with the teeth's friction at 0.10 and
  0.20. At the drawn centres every mesh runs without a drop, about a fifth of
  the action before the line of centres, 95–98 % on average and 89–91 % at the
  worst instant at 0.20. Then the train in time: the four stages' ratios
  multiplied as their wheels turn, the swing following them through the
  escapement's own equation (A² towards `ampAt(drive)²`, `TF`): 250–259° at
  0.20, inside the manual's band, and the time wanders under 0.1 ms about the
  mean rate (the ripple repeats daily, so a navigator's rate takes it in).
  Last, each mesh's depthing window (it jams on the close side when the wheel's
  tips reach the pinion's root, 37–58 µm; on the wide side the ripple takes the
  swing out of the band, or nothing does to a module wider), and from it the
  hole positions a CNC must hold aimed at the drawn centres: ±13 µm (the
  fourth wheel's mesh, the pivots' 10 µm shake taken off), bored, not drilled.
  `--write` writes `tools/gearing.json`, which `thermal.js` reads.
- **`tools/thermal.js`, does it still fit at 40 and 100 °F.** Brass holds
  (plates, bridges, pillars, wheels), steel turns and locks (pinions, arbors,
  escape wheel, roller, detent), and brass grows 6–10 × 10⁻⁶ a °C more. The
  depths change by the pinion's radius times that (under 0.5 µm: the wheels and
  their holes are both brass); the endshake over the train's 16.8 mm span
  −2.6 and +3.0 µm (set it at 28–73 µm at 20 °C to stay in Ops. 15, 69 and
  74's 25–76 µm); the escapement's centre distance and depth of lock under
  2 µm, which moves lock and drop a tenth of a degree and its rate a few
  hundredths of a second a day. The temperature error is the balance's and its
  spring's alone, which is measured on the bench, not worked out.
- **`tools/fea.py`, do the plates and bridges hold the arbors.** Finite
  elements on the six parts that hold pivots (the pillar plate, the train,
  barrel, escape and lower bridges, and the bridge on the plate's dial side
  that carries the third's and fourth's lower jewels): each part's solid cut
  into voxel bricks (trilinear, about 0.25–0.55 mm), brass at 100 GPa, solved
  by multigrid; the solver comes within 1.4 % of a cantilever's textbook
  deflection. Loaded fully wound (the chain's 41 N along its drums' tangent at
  the fusee's top turn, three quarters of it on the barrel bridge) and run down
  (21 N on its bottom turn), with every mesh's tooth force; each part held at
  its screws, the parts put together by superposition. No pivot hole moves
  more than 0.4 µm, no arbor leans more than 13 µrad, and no mesh's depth
  changes by more than 0.02 µm, a thousandth of the ±13 µm the holes are given;
  the most stress is 13 MPa, at a voxel's corner on the barrel bridge, against
  brass's 300. The plates and bridges are many times stiffer than they need to
  be: the hole positions and the depthing are what the maker must hold.
- **`tools/hairspring-fe.js`, the hairspring by another method.** The designed
  spring (hairspring.js) solved again as 1,359 co-rotational beam elements
  (Crisfield; the strip extensible, 0.221 mm thick), the stud clamped and the
  collet turned to ±300° in steps by Newton's method, against the shooting
  elastica it was designed with: the couple's departure from linear agrees to
  4 in 10⁷, the force on the pivots at 270° (1.5 × 10⁻³ of couple / R) to two
  figures, and the spring's own isochronism, 0.12 s a day over the manual's
  band, to 0.003 s a day.
- **`tools/estimates.js`, the estimates swept** (14 October 2026). The design
  values no source settles, each over the range its sources allow, the bench's
  correction applied: with the strip the run-down test chooses, a balance
  running down in 40-200 s swings 255° and stays isochronous to 0.35 s a day
  over the band (unadjusted, the drawn strip would swing it 232-401°); every
  detent spring the ring test passes (0.072-0.110 mm, mapped every 0.005 mm:
  outside it a held tooth's stone rings past half the lock, and at 0.15 a
  tooth gets past) runs in the band with the set-up turned; every back radius
  of the discharge jewel from 0.066 to 0.158 mm is brought to the manual's
  figures by the screws and the trip spring's tip; the sustaining spring's band
  ±0.02, lobes ±15° and gap 18-22° keep the balance over a turn 6-11 minutes;
  and the hairspring's upper curve formed 0.3 mm off its drawing leaves the
  pivots less force than plain ramps did. The report's section 12.
- **`tools/bench.js` and `tools/rating.py`, a made chronometer tested.** The
  analysis can't say a chronometer made to the model keeps time; the bench
  can. bench.js writes the tests (the build book's last chapter, and each on
  its part's sheet) with what each must read from the model's own figures: the
  balance's free run-down, the train held (since 14 October 2026: the time its
  swing takes to halve, 35 s for the model's `TF` 67 s, chooses the strip from a
  table makeEsc works out, 23-71 s wanting 1.06-0.78 times the drawn, since the
  swing goes as drive times damping and no source gives the damping within a
  factor of two; benchcheck.py scales the strip's and torque's bands with it), the
  mainspring 0.74–0.86 N·m fully wound for the model's balance (tolerances.js), the fusee's torque
  within −5 to +11 % at every half turn (the swing's band through `ampAt`), the
  centres to ±13 µm (gearing.js), endshake 28–73 µm at 20 °C (thermal.js), the
  balance 7,200 an hour, the escapement's and the swing's figures (the
  manual's), and the Navy's test. rating.py works the maker's log of daily
  comparisons with a time signal as the test card does, fits its rate against
  time and temperature, backtests a ten-day rate carried on, and projects what
  a navigator would be out after 10, 30 and 60 days; acoustic.py takes a
  recording of the made movement for its swing.
  benchcheck.py judges the measurements themselves (a JSON file it makes to
  fill in): each against bench.js's figures, and where one fails, what to do:
  the set-up turns that bring the mainspring into its band or even the fusee
  (from the curve's slope and the fusee's 1.96:1 profile), the timing weights
  or the millimetres to take at the stud, the manual's operation that sets an
  escapement figure.

- **`tools/deviations.js`, the build's two changes.** Nothing the checks
  found needs changing for the chronometer to work; two changes, with 1950s
  materials, make it easier to make and steadier to keep, each on its part's
  card as the build's with the Model 21's original beside it and a button back
  (the link keeps `orig=mainspring,hairspring` for those set back; the 3D model
  stays the Model 21). The mainspring in Nivaflex 45/5 (Straumann, patented
  1948): the same torque from a strip 0.386 mm thick (E 220 GPa against carbon
  steel's 207), stressed 2,309 MPa fully wound, a margin of 1.30 on its
  3,000 N/mm² against carbon steel's 1.13–1.17, and it doesn't set, rust or
  magnetize. The hairspring in Nivarox (Straumann, 1933), graded for a
  monometallic balance, in place of Elinvar heat-treated to the balance; the
  balance kept as the Model 21's, a stainless rim on an Invar arm, so Table
  IV's screw moves (Op. 8) still trim the temperature error.
- **The balance's temperature compensation, from Table IV.** Table IV's forty
  figures (a pair moved from the quarter, hole 7, to holes 8–12 under each
  head) read as the rim's bending: the rim grows as stainless, the arm's ends
  hold it to Invar's growth, so it is pulled in at the arm and bulges at the
  quarter, as a thin ring under two opposite forces does (its Fourier series,
  which gives Roark's 0.1366/0.1488 for its two diameters). One constant
  fitted reproduces all forty within 0.20 s a day rms, the quarter bulging
  0.48 µm a °C past the arm's ends: the rim growing 17.4 × 10⁻⁶ a °C more
  than the arm, against 14.4–16.3 for austenitic stainless on Invar. The
  manual's table, made on real balances, so agrees with the model's stainless
  rim and Invar arm. Read so, the balance with its standard screws expands as
  a 15.1–17.0 × 10⁻⁶ a °C metal would, and the spring's thermoelastic
  coefficient must be +0.1 to +13.0 × 10⁻⁶ a °C (Nivarox's own expansion,
  7–10, estimated, makes most of the spread); a beryllium-bronze balance needs
  +4 to +14, so Nivarox's grade for monometallic balances suits it. Moving the
  standard pairs among holes 3–12 reaches −6.45 to +4.61 s a day between 55
  and 90 °F, in steps of 0.42 s or less, taking up a spring −5.5 to
  +7.7 × 10⁻⁶ a °C off its mark. A one-piece Glucydur balance (the build's
  until 13 October 2026) has nothing to trim and would need the spring held to
  ±1.43, a seventh of the ±10 a bought spring holds (EP3502288A1); the bench's
  temperature test (`bench.js`, the rate) says which pairs to move.
- **Every mechanism, each in turn (13 October 2026).** Seven analyses take the
  rest of the movement (the build-verification report's section 11), on the
  geometry `tools/mechanisms.py` reads off the built model (each pawl's contact
  on its ratchet, the arbors' inertias from their solids). `overwind.js`: a
  strong hand on the key's paddle (1.06 N·m, from finger-torque studies) wound
  against the stop breaks nothing once the stop-bar and stud are hardened (soft,
  the bar bends at 1.59 N·m, about half as much again as a strong hand's: a gloved
  hand or a longer bow); turned the wrong way, its torque goes into
  the train the escapement holds still, and 0.20 N·m bends the fusee wheel's
  teeth (their face where they overlap the centre pinion's leaves, 1.40 mm; 0.11 on
  the 1.2 mm teeth drawn until 18 October 2026): so the build's winding key has a ratchet in its pipe (deviation 3).
  `ratchets.js`: the winding pawls are drawn in by their load (12.5°, past the
  friction angle), the setup click at 4.5° (friction and its spring hold it;
  its ratchet's faces drawn undercut 4.5°, as measured, since 14 October 2026: 8.7°),
  the sustaining pawl as traced meets a tooth's tip corner with its side and is
  drawn in at 32.8° once its end is fitted to the face; every part at least 1.9
  times short of its material's weak end; the winding pawls' springs need at
  least 0.07 mm of set to follow the fusee down when the key lets go (0.08 until
  15 October 2026, when the springs' feet moved to the screws' measured places
  and the longer spring came out 17.9 mm long, not 18.4).
  `sustaining.js`: the split ring, weaker than the drive and banked in running
  (since 14 October 2026), pushes 0.28 of the drive from its band as traced on the
  video, 0.96 mm high and 1.3-1.9 wide, over its 17.4° gap (0.33 from the automated trace, 0.22 over the 12.5° first read, 18 October 2026; 0.82 from a designed 1.45 mm band until 17 October 2026, 0.88 from 1.25 until 16 October), keeps the
  chronometer running 10.5 minutes (the manual's five to ten read as the least it gives: over ten is reported), its swing under a turn within the first, and a wind costs microseconds. `motionwork.js`: the motion
  work and wind indicator meshes run, the hour hand stands up to 3.8 minutes
  off in their backlash, and the cannon pinion's friction belongs between 1.4
  and 37 mN·m (about 18 g hung 40 mm out on the minute hand). `wear.js`: well
  oiled every contact keeps its tolerance 26 years and more; the balance
  staff's pivot ends and the escape arbor's pivots go first, a few years poorly
  oiled, so the oil's life sets the overhaul. `traindyn.js`: the train's inertia
  at the escape wheel from the solids is 6.05 g·mm², which dynamics.js and
  makeEsc take since 14 October 2026 (5.88 before, the fourth wheel estimated;
  the escape wheel's calibrated torque 62.4 → 62.8 µN·m), its
  modes lie in the kilohertz, and the strike on the jewel rebounds the escape
  mesh inside its backlash. `montecarlo.js`: made to a maker's tolerances, all
  at once, 98.8 % work as made (1.1 % swing out of the band, 0.1 % have a
  winding pawl's spring under its 0.07 mm); the bench's tests, applied as a
  maker would by bench.json's figures, catch them all: the swing test has the
  set-up turned (Op. 13), the pawls' test bends a short spring back to the aim
  (it catches 5 of 2,000, 2 of which would have failed), the depths test
  re-bushes a mesh too close (5, none of which would have jammed), and every
  movement works after the bench. A movement still failing that no test
  catches fails the check. `bench.js` carries four tests from them.
- **`tools/tripping.js`, does a tooth ever get past the stone.** The classic
  failure of a detent escapement at sea is tripping: the wheel lets a tooth go
  that the balance didn't unlock, and the chronometer gains. dynamics.js takes
  the detent as one rigid body on a hinge; this takes it as a plane frame of
  37 beam elements from the drawn pieces (the two-strip spring, the blade, the
  arm to the horn and the trip spring bending and stretching, the cross-piece,
  block and horn rigid; mass and inertia within 1 % of dynamics.js's), its
  modes carried in time with the balance and the wheel through elastic
  contacts (the jewel's own outline on the trip spring's tip, the trip spring
  on the horn, the blade on its button, the tooth on the stone and on the
  impulse jewel), Op. 78's preload (the weight lifting the button's middle
  0.005 in, since 14 October 2026). Made rigid and hinged at Ft it runs as
  dynamics.js does (swing 0.4°, rate 0.1 s a day, release, fall and landing
  within 0.1°). As drawn: the spring bends about its middle, so the detent is
  38 % stiffer at the stone than the hinge (first mode 148 Hz, not 122, with
  the spring at its measured 3.30 mm; 137 and 112 at 3.82); a held
  tooth's stone lifts at most 14.5 % of the depth of lock (127 µm at the stone,
  where makeEsc's recoil peaks: past it the tooth's pressure on the stone's
  rounded edge throws the stone off; the tip is free at 131 µm, makeEsc's
  release keeping 157 as room to spare), at most 47 % over the estimates varied (every contact four times stiffer)
  (the detent's damping, every contact's restitution and stiffness, the blade
  half as stiff); no tooth gets past until the swing reaches 337°, where the
  discharge jewel comes round and unlocks again in the same swing (makeEsc's
  TRIP, 333°, is where it first touches); a blow across the plate of 42 g over
  3 ms or 113 g over 0.5 ms, or a twist of 19 rad/s, lets a tooth go, within
  7 % of the rigid detent's (50 g and 125 g with the detent as drawn before 20 October 2026, its lighter measured
  detent less preloaded; 61 g and 138 g until 14 October 2026, with the
  whole 0.770 g as the preload). The estimates are the contacts' restitution
  (0.3, 0 at the jewels) and the detent's damping (Q 100). For the bench
  (`--write`, `tools/tripping.json`): run at shallower locks, the stone's
  largest lift while held stays at 25-50 µm whatever the depth, so the lock's
  floor is 5.58° (the margin under two below it; the drop gone at 3.95°, a tooth
  past at 3.5°; 5°, 3.4° and 2.9° before 20 October 2026), and the blow that trips it hardly changes with
  the lock: against knocks it is Op. 78's preload that holds. Clamped by its
  foot and flicked, the detent rings at 148 Hz as drawn, the pitch rising
  nearly as its spring's thickness to the 1.5 (75-194 Hz for 0.05-0.095 mm;
  131 Hz and 120-222 Hz for 0.072-0.110 at the 3.82 mm drawn before 20 October 2026;
  thinner springs ring more after each lock, and from 0.12 mm, Op. 78's
  0.005 in leaving little preload, the stone's ringing uses over half the
  depth of lock), which makes a phone's recording
  a measure of the spring's section no source gives: bench.js's test
  "The detent rings", benchcheck.py `--ring`. dynamics.js now counts a second
  unlocking in one swing as a trip (it was booked as a beat).
- **`tools/gimbals.js` and `tools/massprops.py`, the box and gimbals in a
  seaway.** The case with the movement weighs 1,250 g on the model (every solid
  at its material's density) and the gimbal ring 151 g; as drawn the case's
  centre of gravity lies 9.9 mm under its pivots and 0.1 mm to one side, so
  the drawn pivots are nearly level (it would hang 1° out of level), and the
  manual levels a chronometer by its case brackets and straps (p. 13), as the
  analysis does. Levelled, the case swings in 0.67 s on its pivots and 0.77 s
  with the ring (the page's estimate, 0.7 s, holds), far from a ship's roll
  (10-30 s) and 34 % clear of the balance's 0.5 s beat, which can't set it
  swinging (a balance 2 µm out of poise moves it a fraction of a second of
  arc). In a merchant ship's seas, up to NORDFORSK's operability limit (0.12 g
  athwartships), the case leans up to 10° from the true vertical but stays
  within 0.4° of the apparent, and the rate moves 0.006 s a day. Since the
  gimbal pivots were measured (20 October 2026: 92.9 over the box's bottom,
  12.9 higher than drawn before) nothing in the drawn box stops the case, which
  the manual has turned over in the ring to wind a run-down chronometer (Sec.
  III, "Slowly invert the instrument"), and the ring meets the box only at 63.5°
  and 73.5°: in none of the seas, a small vessel's quick roll and a storm among
  them, does the case reach a stop (the rate moves 0.17 s a day at most while
  the small vessel's roll lasts). Before then the case's bottom met the felt at
  29.5°, and beyond NORDFORSK's limit each blow nudged the balance's phase by
  0.04-0.16 ms; the ring weighed 140 g, with smaller nuts. Until 18
  October 2026 the case was weighed with the Laid out view's schematic plates
  in it (1,662 g, its centre of gravity 7.8 mm off the pivots' line: 0.72 and
  0.68 s, 35° out of level as drawn); `massprops-check.js` leaves them out.
- **`tools/mainspring_friction.py`, the mainspring's coil friction.** On the
  solved spring, the coils' slip followed from state to state and the packed
  coils' pressure by the ring equations of a packed spiral: over the fusee's
  turns (14.39 to 19.11) the coils take 2.6 % of the spring's work running (2.1-4.2 % at
  friction 0.08-0.16), winding 5.2 % more than running gives (2.0 % and 4.0 % until the chain
  was drawn at its measured size, 20 October 2026); under 1 % in
  the middle of the wind, steep in the last half turn before coil-bound.
  Mainsprings measure running 10-20 % under winding (ICMFF9; the strip's edges
  and its steel too): physics.js now takes the spring's losses between the two
  (it had a published 5-15 %). The model's spring, fully wound, is 0.24 turn
  from coil-bound (0.60 until the chain was drawn at its measured size, 20 October 2026) (`mainspring.py --bound` solves it to 0.05 turn), so
  running the fusee wheel gets 83.1 % of its frictionless torque at full wind, and set up as
  the page sets it 6 % of the wind (about 3.2 of its 56 hours) drives outside the bench's band
  (`mainspring_friction.py`, 25 October 2026); with 0.60 turn of room, until 20 October 2026,
  it got 95.3 % and the swing started at 248°, in the manual's band all through the wind.
  Packed 0.01 apart (until 12 October 2026) it had 0.33 turn (0.13 by the
  quarter-turn table), 78.5 %, the swing from 225° and under the band for
  about 6 hours after winding, which no set-up mended. A spring wants half a
  turn of room (Britten; bench.js's mainspring test counts it). The build's
  Nivaflex strip, 0.386 mm (`--nivaflex`: solved by mainspring.py beside the
  model's spring, set up by the page's fusee rule), has 0.79 turn: 97.1 %
  fully wound, the swing from 251° (the report's section 10). The
  sources' proportions solved in the model's barrel (variants:
  `MC_MS_T`/`_L`/`_RA`/`_GAP`/`_TAG`, `mainspring_friction.py --variants`):
  the model packed its coils at 1/40.3 of the inside radius, coarser than the
  videos' 1/41.0-1/43.7 (their pitch taken as the bare strip and a 0.01 film
  added: corrected 12 October 2026); at the videos' pitch it has 0.60 turn,
  but on the core's mean reading (r 5.2) 0.20, and in the British Museum's
  proportions 0.30 (OPEN-QUESTIONS.md 1).
- **The report**, `verification/build-verification/index.html` (open the
  file; `build_report.py` rebuilds it): the process, figures, sources and
  scripts of these checks, the earlier ones' output beside them. The site
  carries it at `/verification/build-verification/` (the root `build.py` copies
  it), linked from About and the essay.

### The whole transmission in time

`tools/hamilton_transmission.js` (19 October 2026) runs every part that moves,
from the mainspring to the escape wheel and the hands, as one system in time:
the Wempe's `wempe_transmission.js` (its README's "Physics: the transmission")
on the Model 21's own parts. Each part is a body, its inertia weighed on the
model's solids (`mechanisms.json`), joined by the element a real movement has,
none linearised: the mainspring through the fusee (`mainspring_friction.json`'s
fusee table: the drum's turns and the torque on the fusee arbor, frictionless
and running, every quarter turn; the chain's lever on the fusee is the drum's
radius times the drum's turn for the fusee's, 7.50 mm fully wound to 14.53 at
8.5 turns), its coils' friction a stick-slip element (winding takes as much
more as running gives less); the chain in tension only, going slack, its
polygon on both drums; the two winding pawls and the sustaining pawl as bodies
on their pivots under their springs (`ratchets.js`), riding the teeth and
catching a face only when down; the sustaining spring (`sustaining.js`'s
stiffness, 0.36 N·m a radian over 16.9°) **banked in running**, where the
Wempe's maintaining spring runs open; every mesh tooth by tooth on the model's
own outlines (`gearing.js`'s `mesh`: the train, the motion work and the wind
indicator); the cannon pinion's friction fit (`motionwork.js`'s window); the
Model 21's plain key on the fusee's square (no one-way key: that is the
build's deviation); the stop-bar on its stud (`overwind.js`). The escapement is
`dynamics.js`'s own, its escape wheel driven by the train's last mesh each step.

The drive: makeEsc is calibrated at 255° on the page's 12-hour drive, and the
solved spring through the train gives the escape wheel 1.62 times that
(`physics.js`'s budget gap, kept open by the owner's choice). The runs that
drive the escapement take the mainspring at the page's level (×0.607); the
winds and the stop take its own torque, and a beat's peaks are judged as their
factor over running times `strength.js`'s fully wound load.

What it finds:

- **Statically** the spring stays on its bank from full wind to run down (at
  least 1.04° closed past it), and the train passes 0.80 of the fusee's torque
  to the escape wheel (`physics.js`'s parts give 0.69-0.87). The chain's
  polygon and the meshes' ripple move the swing over a run between 249° and
  269° (smooth 253-265°), and the time wanders 0.2 ms within a day.
- **The modes**: the lowest, 192 Hz, is the barrel and fusee on the chain; the
  train's run from 2.9 to 21 kHz: nothing near the beat.
- **A beat** at 12 h, the train on its meshes against the same escapement on a
  rigid train: every beat taken; an impulse gives the balance 2.6 % more work
  (the meshes give back some of the wheel's landing and start), worth +3.6° of
  swing and +0.05 s a day: the rigid train `dynamics.js` and makeEsc take reads
  the swing low by about that (the check holds it within 8° and 0.5 s a day,
  the Wempe's tolerance). The escape pinion's mesh takes 27 times its running
  load as the wheel lands on its stone (1.4 N; 2.9 N on the fully wound drive,
  margin 2.2 on brass's endurance) and lets go 1.4 % of the time; the other
  meshes never let go. The seconds hand overshoots 19″ of arc; the cannon
  pinion doesn't slip; the sustaining spring never leaves its bank.
- **Winding**: the key put on, the sustaining ratchet falls 1.5° back onto its
  pawl; the hand needs 0.41 N·m. Eased back, the pawls catch with at most
  73 N each (margin 4.4 on the hardened ratchet), the chain at most 59 N. **Let
  go outright** (the fingers off the plain key, the fusee and barrel flung
  forward up to a tooth, 10°) the blow closes the sustaining spring 5° past its
  bank: the pawls catch with 273 N, the fusee wheel's teeth take 80 N (728 MPa:
  past brass's yield), the chain snatches to 107 N (past its weakest part, the
  hook's bearing on the barrel's brass wall, 76-113 N), the sustaining ratchet
  is thrown back onto its pawl with 60 N. Judged as a misuse, as the Wempe's
  outright let-go is: the key should be eased back to the pawls. The result
  rests on the estimated bank stiffness (×0.25 to ×4: the fusee wheel's teeth
  55-137 N) and the chain's (37-253 N/mm: 66-83 N).
- **The stop**: wound into it at a turn a second and forced by a strong hand
  (1.06 N·m), 57 N on the stud (the stop-bar's end 193 MPa), the chain 54 N.
- **The motion work**: the hour hand's play 3.9 minutes of time; the wind
  indicator's 0.66° (7 minutes of its 56 hours).

Estimated (no source gives them): the sustaining spring's bank stiffness (40
times its own), the chain's stiffness (from its plates' sections and rivets
over its span and lead-in), the pawls' faces (10 and 5 kN/mm), the winding
pawls' springs' set (0.2 mm), the cannon pinion's grip, the key's inertia and
its square's stiffness, the wind indicator's inertia, the motion work's faces
and bores, the contacts' damping. `hamilton_transmission_trace.js` traces the
beat, the two let-gos and the stop in the Wempe trace's format for the
motion-3d pipeline (`tools/r_motion3d/hamilton/trace_last.js`, ignored).
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
