OrelMag/marine-chronometer-model/References/wempe/README.md

# The Wempe Einheits-Chronometer: source material

Sources for the second model: the German *Deutsches Einheits-Chronometer*, the standard marine chronometer designed by Gerhard D. Wempe's chronometer works in Hamburg in the early 1940s. It was built by Wempe and A. Lange & Söhne in the war, by Wempe after it, and, from the same drawings, by the 1st Moscow Watch Factory as the Soviet 6MX. The model is the spring-detent version (*Feder-Chronometer*, Kaliber 05; the escapement sheet calls it Kaliber 020) as drawn. The 6MX and the post-war Wempes are supporting evidence only: where they differ from the drawings, the drawings decide.

## The works drawings (`drawings/`)

124 scans of Wempe's works drawings, about 1024 px each (the coloured overall section 2048 px), as published on dg-chrono.de (the Deutsche Gesellschaft für Chronometrie's site, its section on Russian watches) at
<https://www.dg-chrono.de/uhrenwissen/russische-uhren/schiffe-und-uhren/1945-2000/wempe-einheitschronometer/>
(downloaded 14 October 2026). Each carries the notice **"© Johannes Altmeppen (by courtesy of Gerhard D. Wempe KG) 2017"**. They're kept here at the user's decision, knowing that notice; they're other people's work, cited and not ours to relicense.

What the page says about them:
- The *geistige Väter* (intellectual fathers) were Ernst William Meier and Friedrich Leutert. The chief designers were John Schwarzer and Herbert Müller, whose names are in the title blocks. Several hundred drawings were made, and the wartime ones were revised from experience in series production (the balance staff and escape wheel among them; the revision dates run to 1948, and one balance staff sheet is dated 1965).
- The set comes from Wempe and private sources, and from the Deutsches Uhrenmuseum Glashütte: copies stamped "KOPIE" of the drawings Wempe supplied to A. Lange & Söhne in the war.
- The page shows 116 components, each by one of the several drawings that exist for it, with five exceptions.
- The escapement sheet, "Hemmung für Feder-Chronometer, Kaliber 020" (05 04_1), is dated 03.02.40, which the page takes for 03.02.41, since Wempe had no spring chronometer in 1940.
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
