OrelMag/marine-chronometer-model/docs/motion-3d/img/contact_hamilton.png

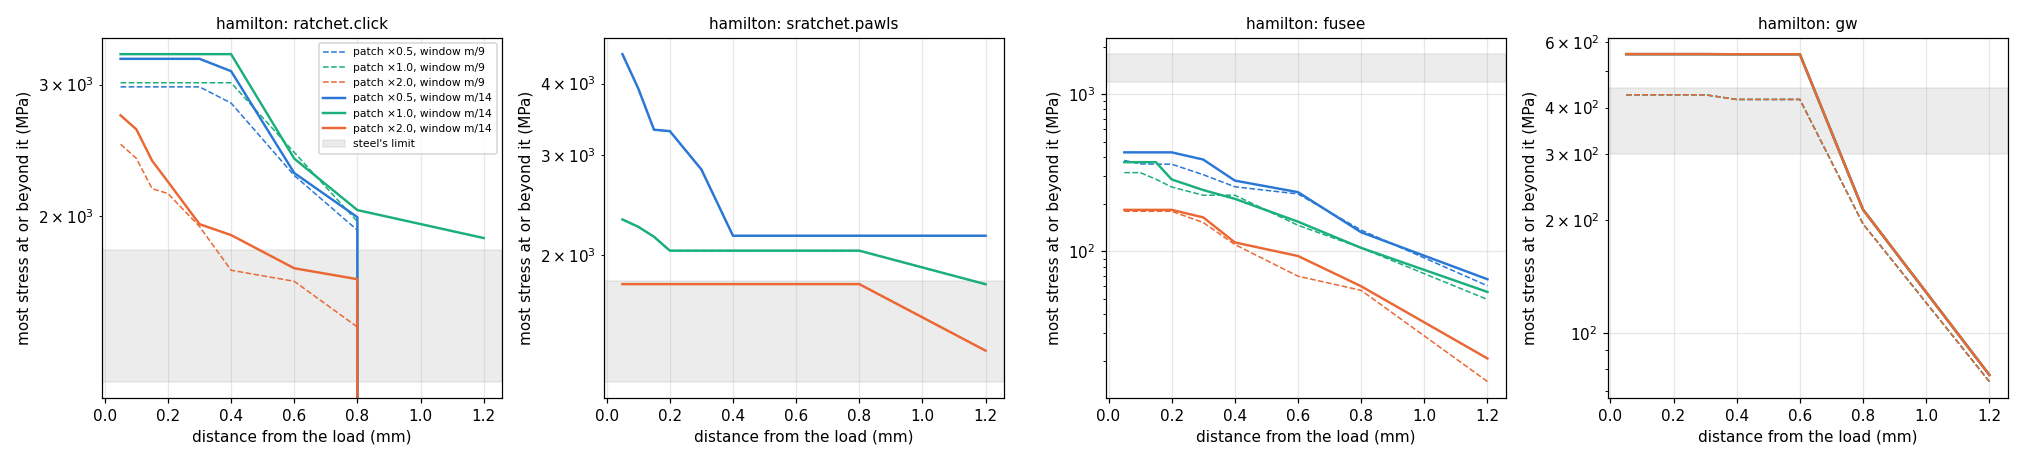
docs/motion-3d/img/contact_hamilton.png
