OrelMag/marine-chronometer-model/docs/motion-3d/img/fe_hamilton_barrel.png

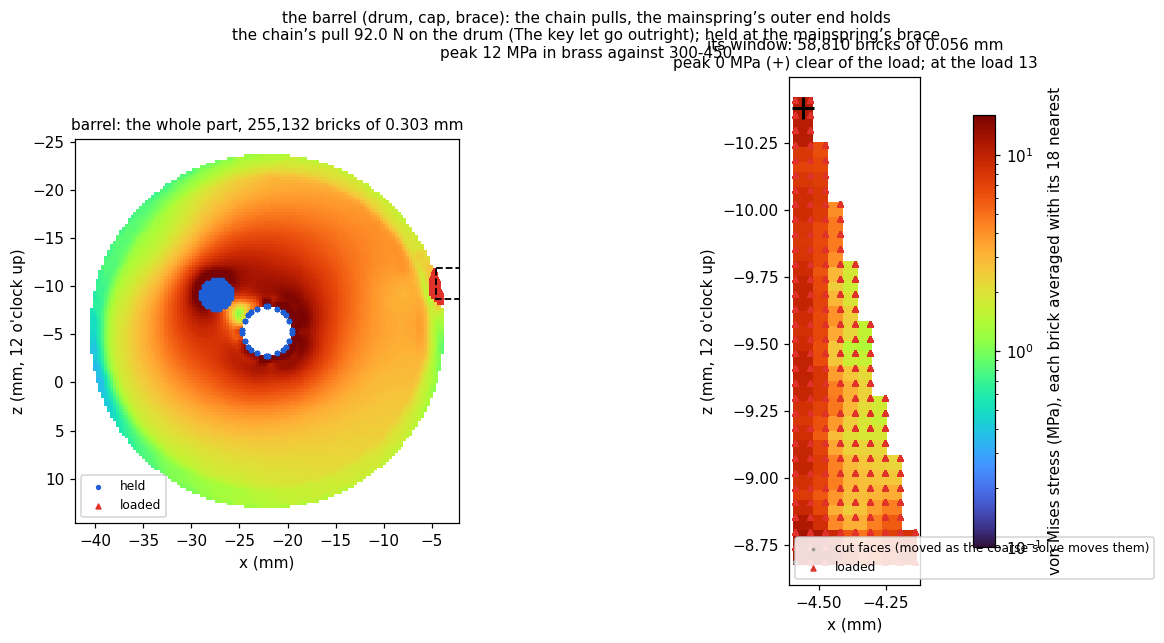
docs/motion-3d/img/fe_hamilton_barrel.png
