OrelMag/marine-chronometer-model/docs/motion-3d/img/fe_hamilton_gw.png

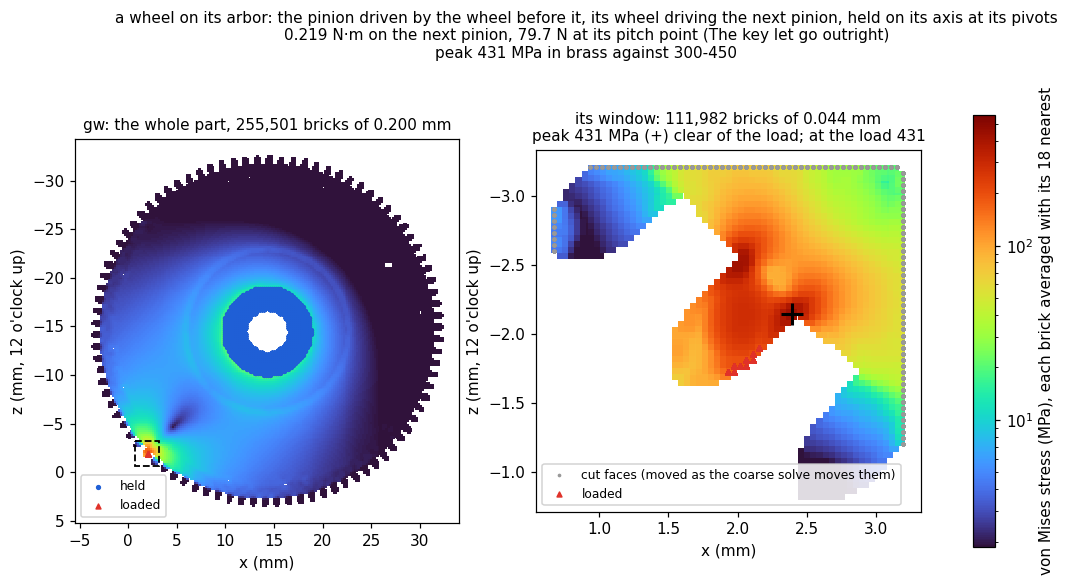
docs/motion-3d/img/fe_hamilton_gw.png
