OrelMag/marine-chronometer-model/docs/motion-3d/img/fe_hamilton_sratchet_pawls.png

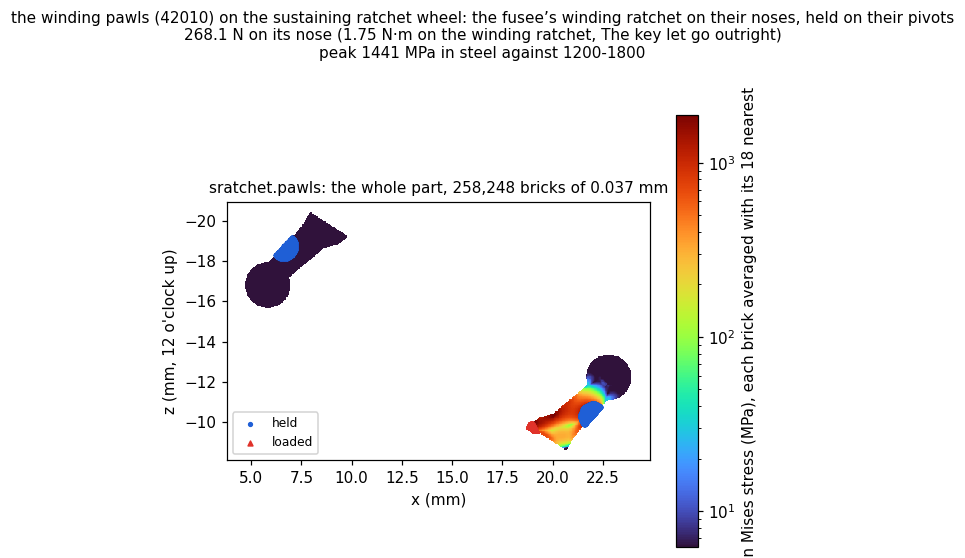
docs/motion-3d/img/fe_hamilton_sratchet_pawls.png
