OrelMag/marine-chronometer-model/docs/motion-3d/img/fe_wempe_fuseeWheel.png

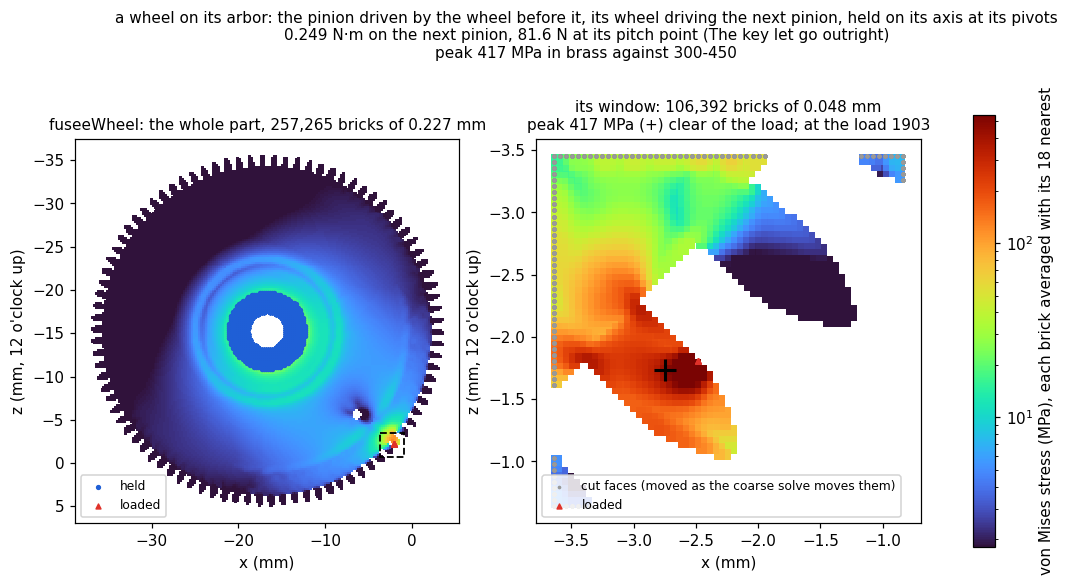
docs/motion-3d/img/fe_wempe_fuseeWheel.png
