OrelMag/marine-chronometer-model/docs/motion-3d/img/hamilton/2_letgo_winding.png

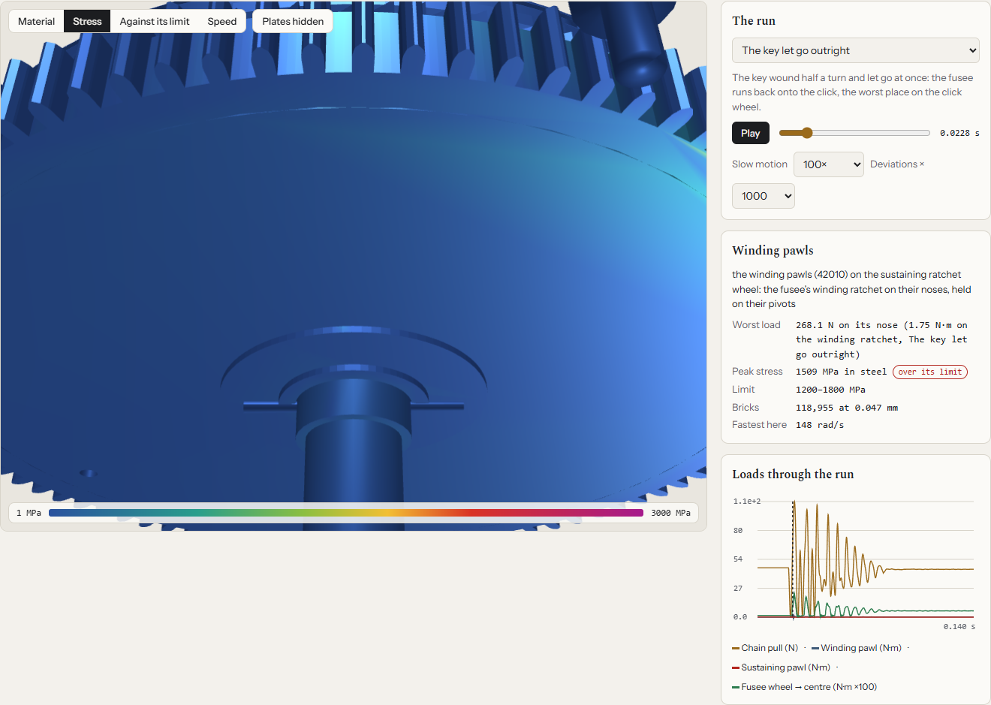
docs/motion-3d/img/hamilton/2_letgo_winding.png
