OrelMag/marine-chronometer-model/docs/motion-3d/img/hamilton/report_section14.png

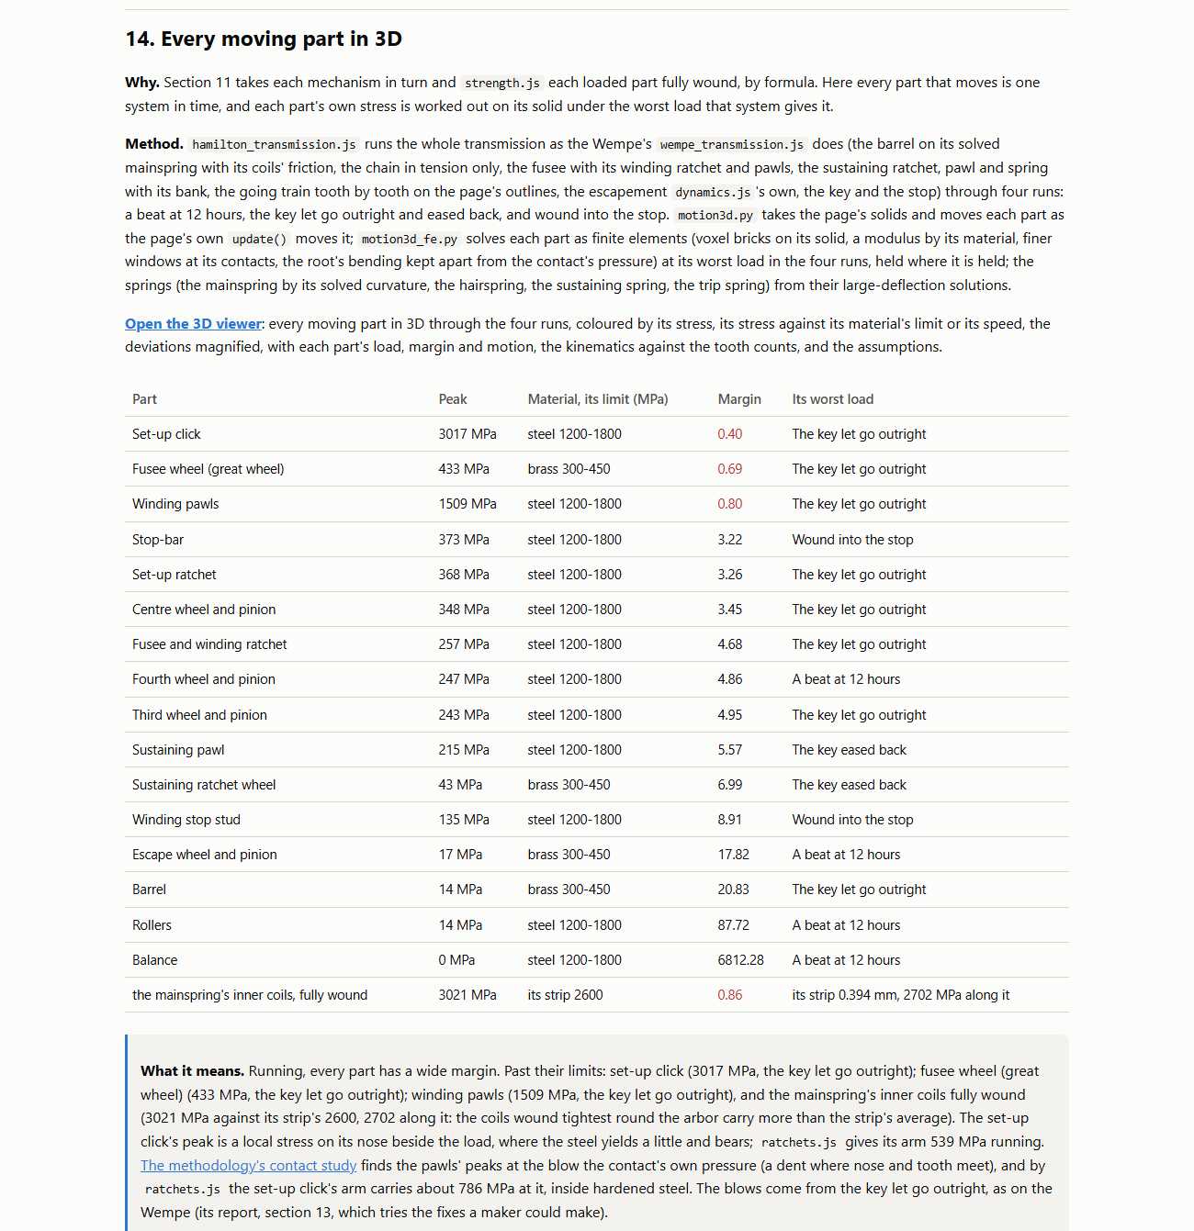
docs/motion-3d/img/hamilton/report_section14.png
