OrelMag/marine-chronometer-model/docs/motion-3d/img/wempe/1_whole_letgo.png

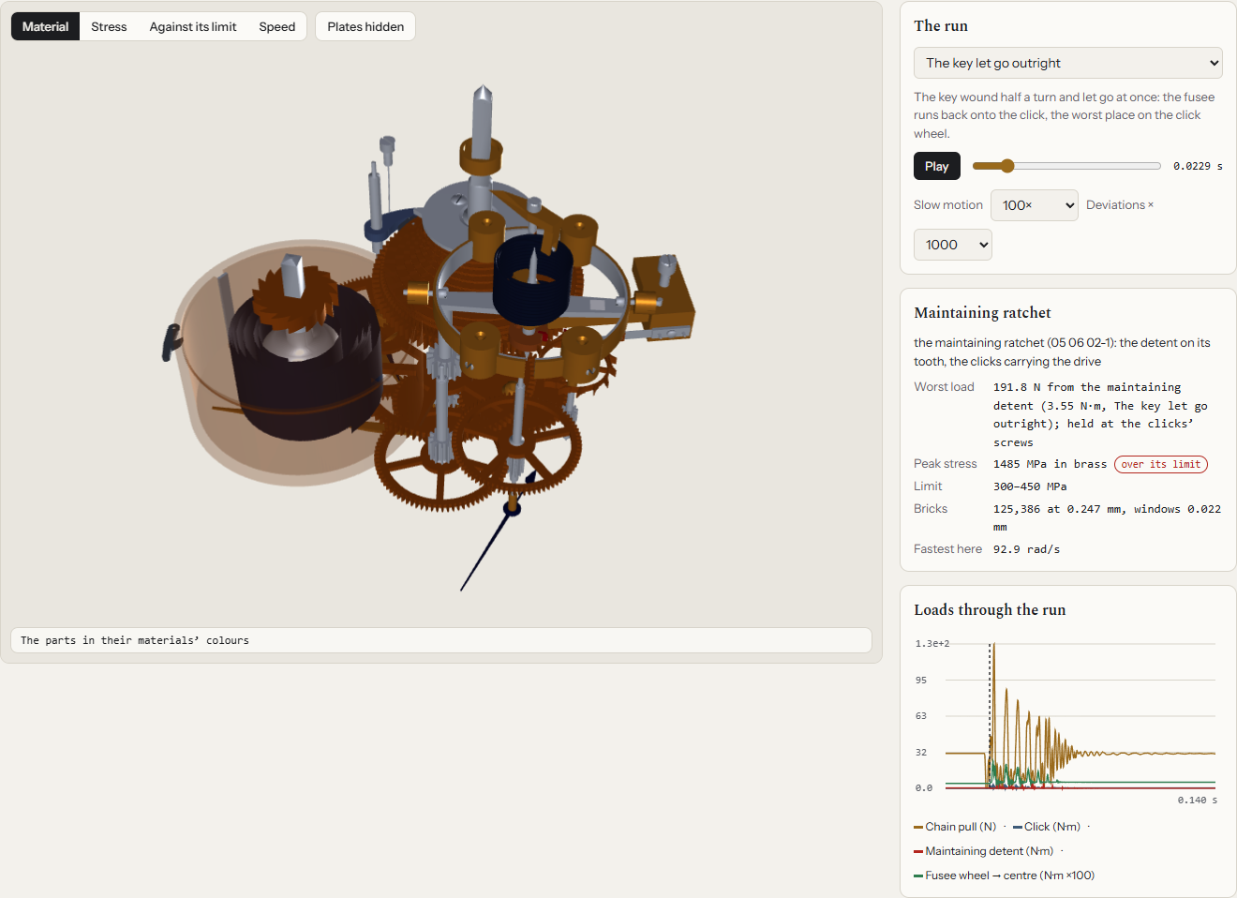
docs/motion-3d/img/wempe/1_whole_letgo.png
