OrelMag/marine-chronometer-model/docs/motion-3d/img/wempe/4_beat_drawn_speed.png

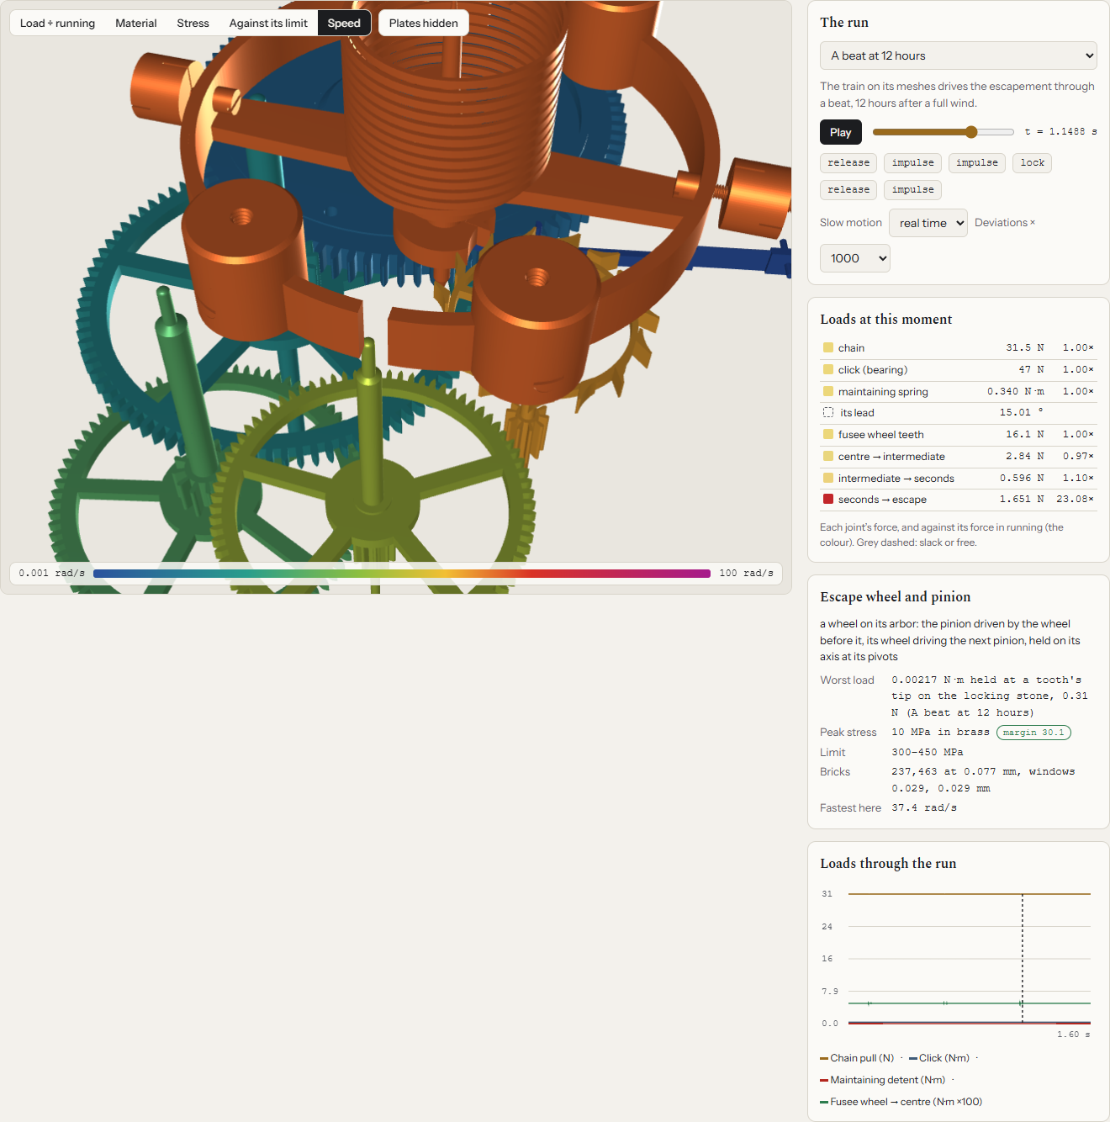
docs/motion-3d/img/wempe/4_beat_drawn_speed.png
