OrelMag/marine-chronometer-model/docs/motion-3d/img/wempe/6_letgo_drawn_train.png

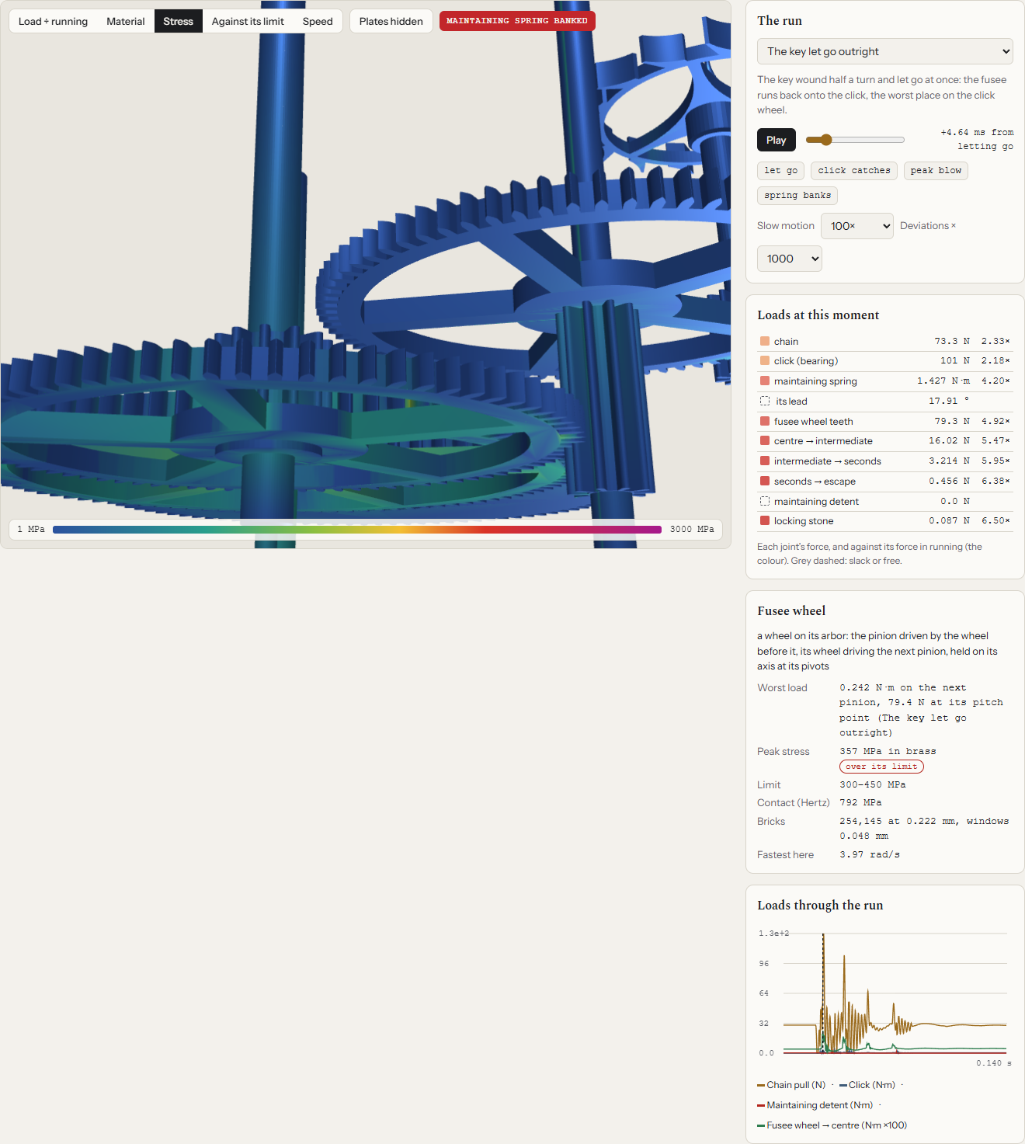
docs/motion-3d/img/wempe/6_letgo_drawn_train.png
