OrelMag/marine-chronometer-model/docs/motion-3d/img/wempe/7_letgo_drawn_limit.png

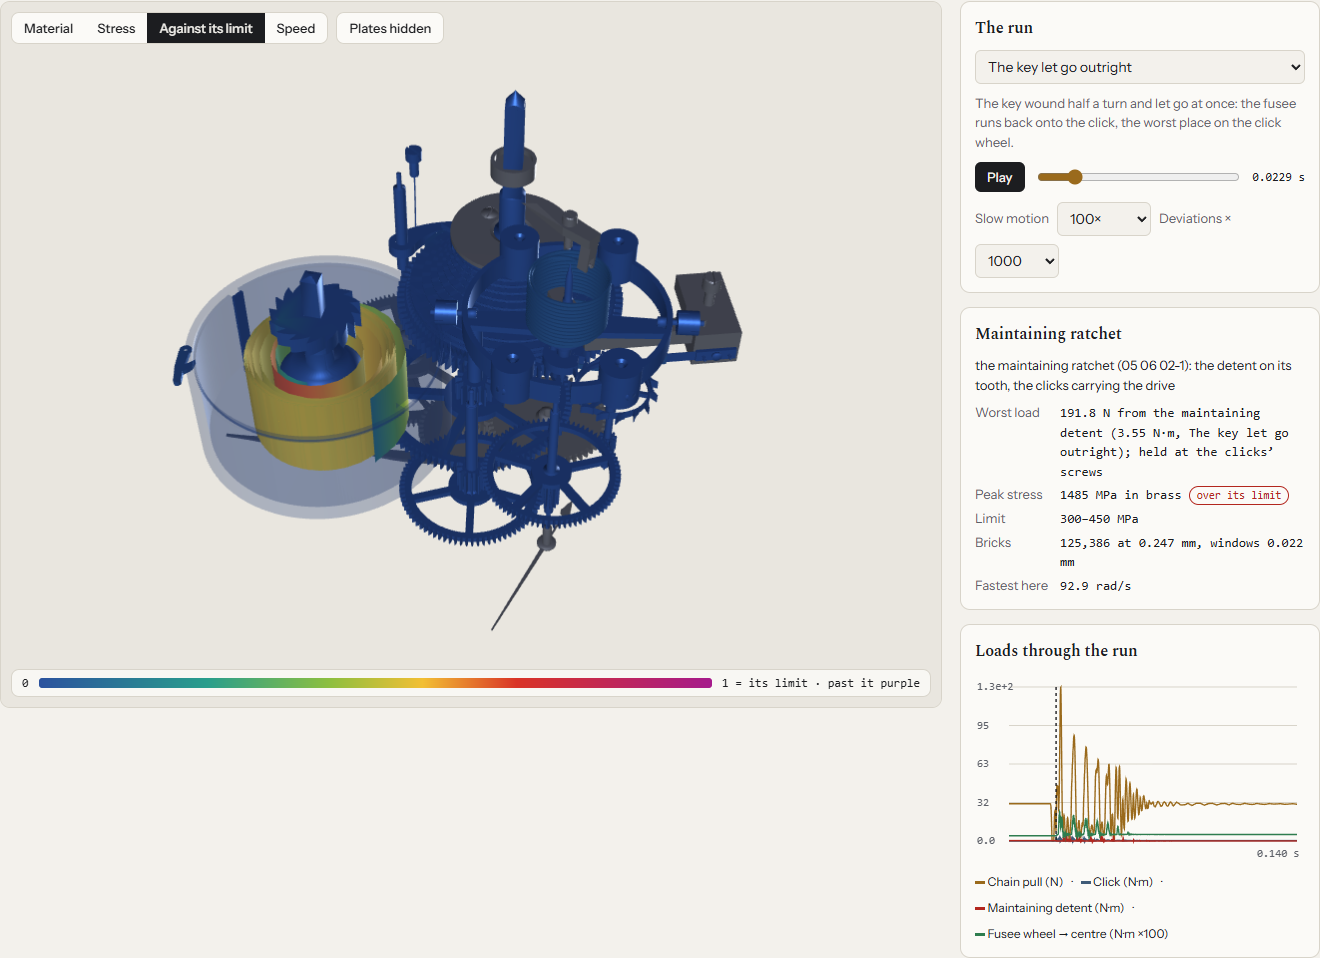
docs/motion-3d/img/wempe/7_letgo_drawn_limit.png
