OrelMag/marine-chronometer-model/docs/motion-3d/img/wempe/8_letgo_drawn_load.png

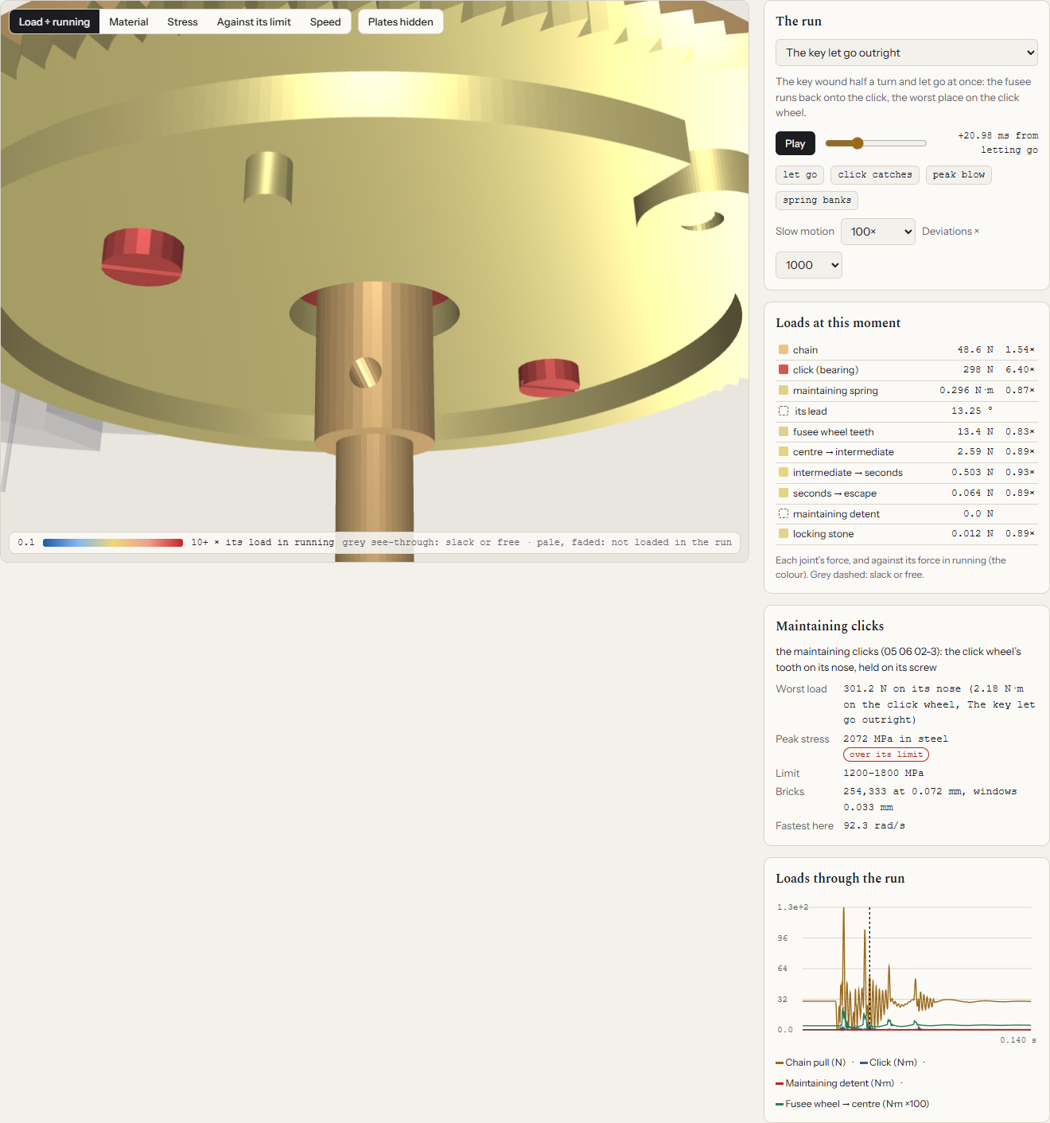
docs/motion-3d/img/wempe/8_letgo_drawn_load.png
