OrelMag/marine-chronometer-model/docs/motion-3d/img/wempe/findings_last.png

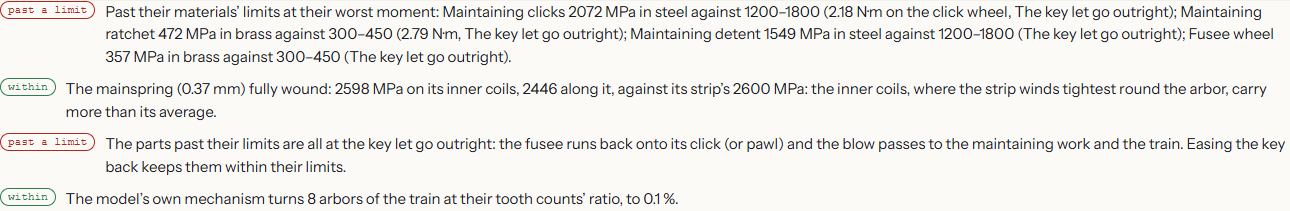
docs/motion-3d/img/wempe/findings_last.png
