OrelMag/marine-chronometer-model/docs/motion-3d/img/wempe/report_section13.png

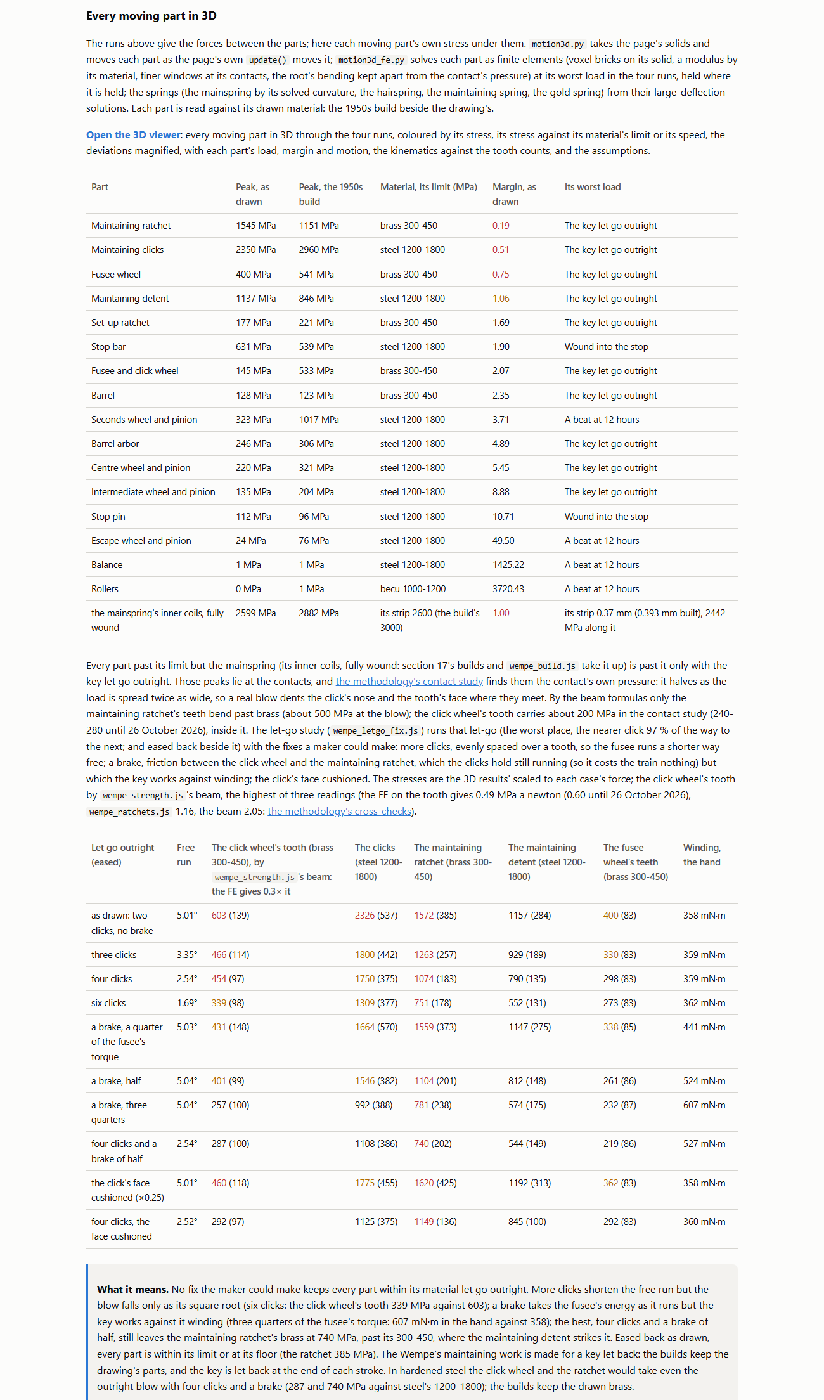
docs/motion-3d/img/wempe/report_section13.png
