OrelMag/marine-chronometer-model/marine-chronometer-source/wempe/renders/bowl_high.webp

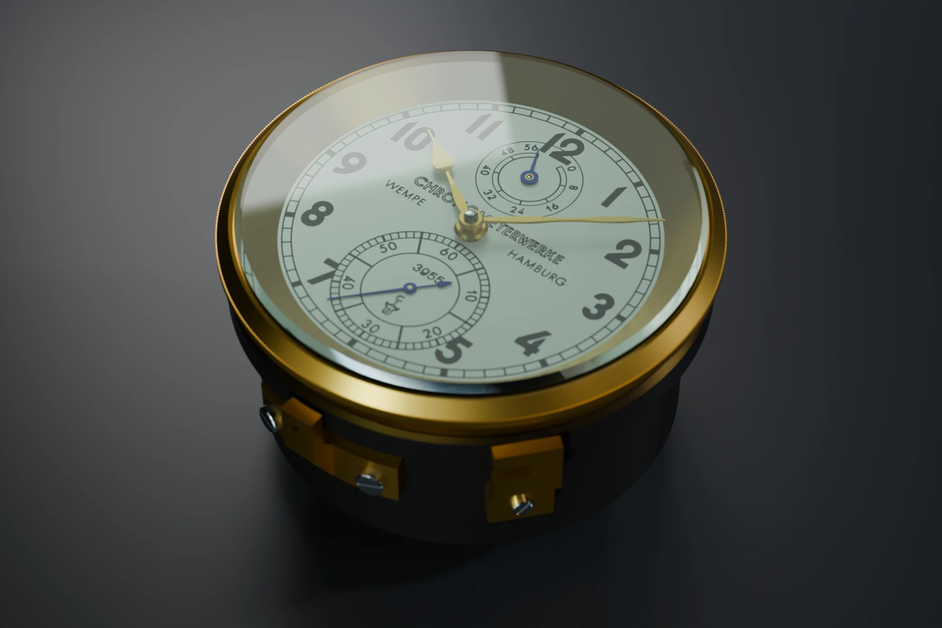
marine-chronometer-source/wempe/renders/bowl_high.webp
