OrelMag/marine-chronometer-model/marine-chronometer-source/wempe/renders/bowl_three_quarter.webp

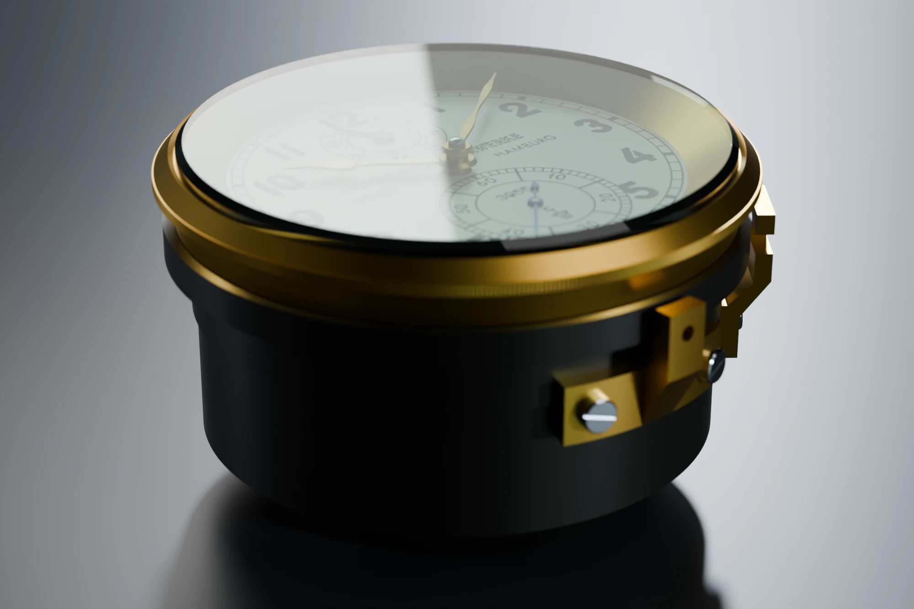
marine-chronometer-source/wempe/renders/bowl_three_quarter.webp
