OrelMag/marine-chronometer-model/marine-chronometer-source/wempe/renders/box_front.webp

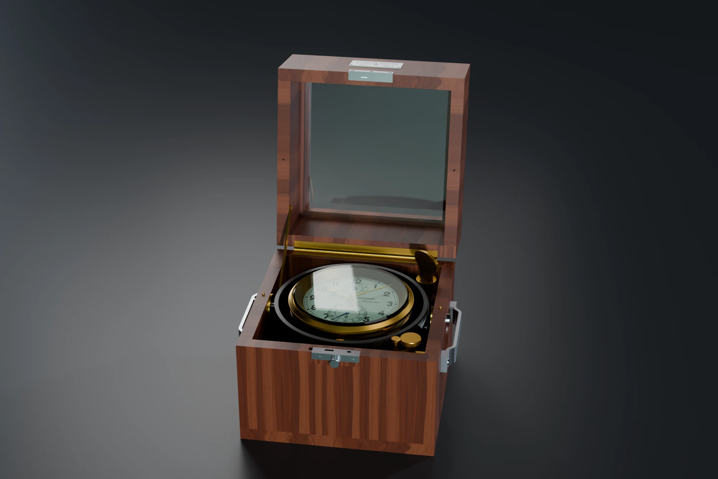
marine-chronometer-source/wempe/renders/box_front.webp
