OrelMag/marine-chronometer-model/marine-chronometer-source/wempe/renders/laidout_sheet.webp

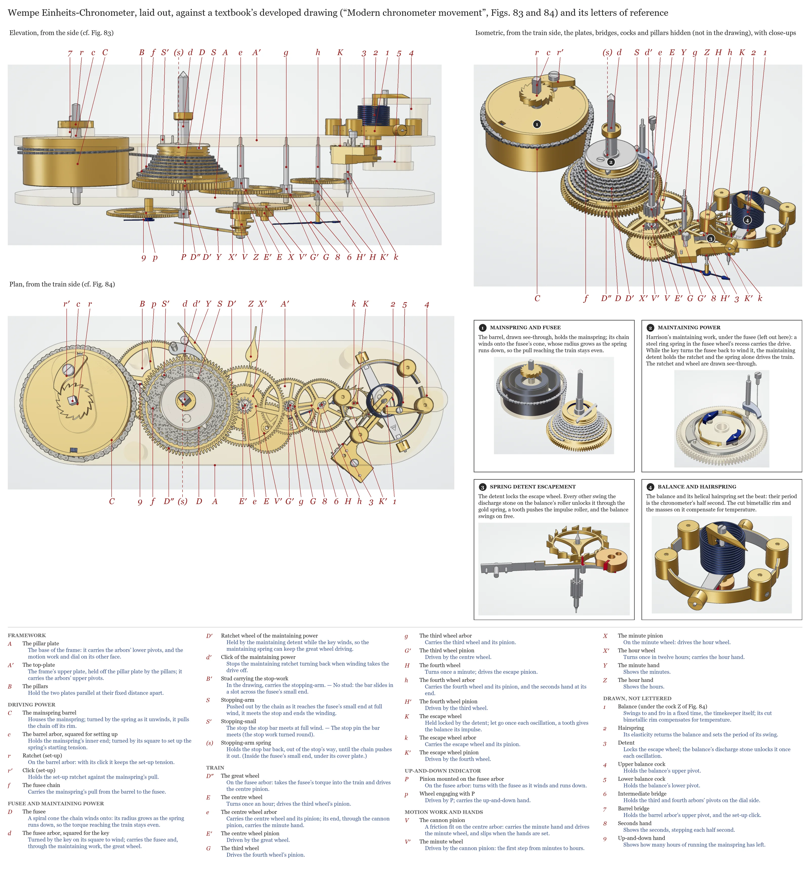
marine-chronometer-source/wempe/renders/laidout_sheet.webp
