OrelMag/marine-chronometer-model/marine-chronometer-source/wempe/renders/low_1_0deg.webp

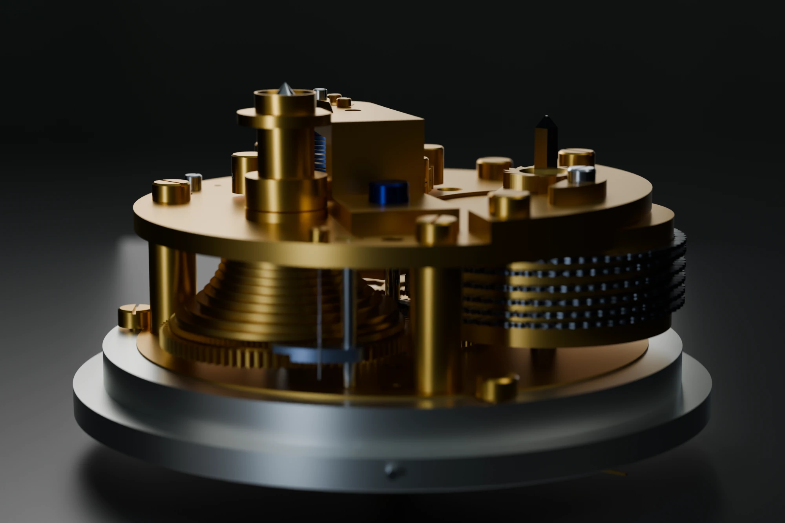
marine-chronometer-source/wempe/renders/low_1_0deg.webp
