OrelMag/marine-chronometer-model/marine-chronometer-source/wempe/renders/low_2_51deg.webp

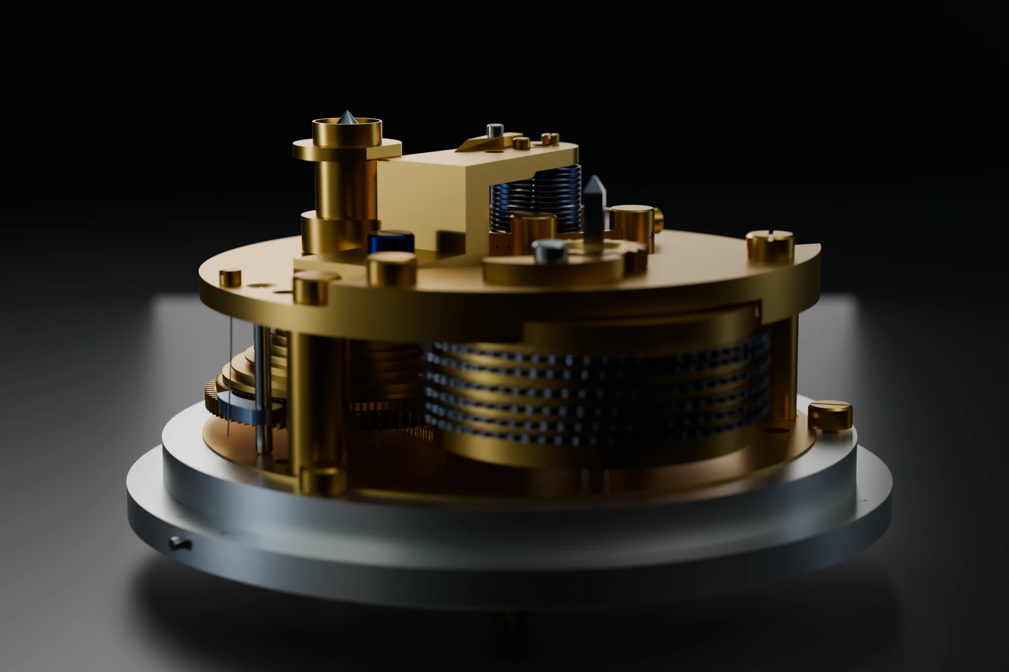
marine-chronometer-source/wempe/renders/low_2_51deg.webp
