OrelMag/marine-chronometer-model/marine-chronometer-source/wempe/renders/low_4_154deg.webp

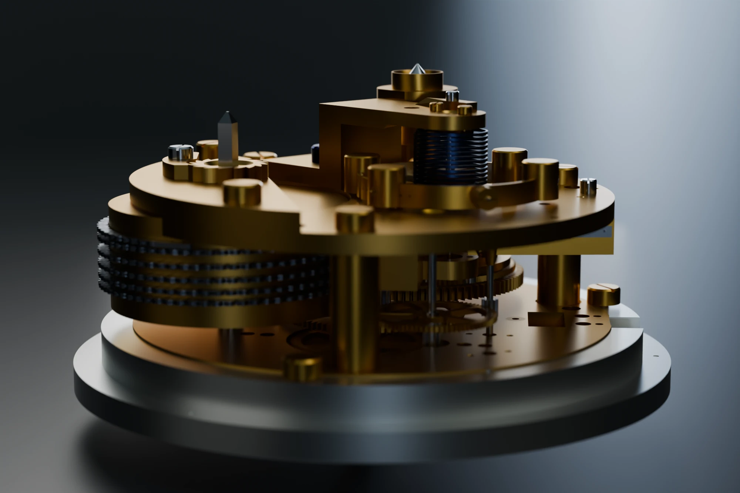
marine-chronometer-source/wempe/renders/low_4_154deg.webp
