OrelMag/marine-chronometer-model/marine-chronometer-source/wempe/renders/low_7_309deg.webp

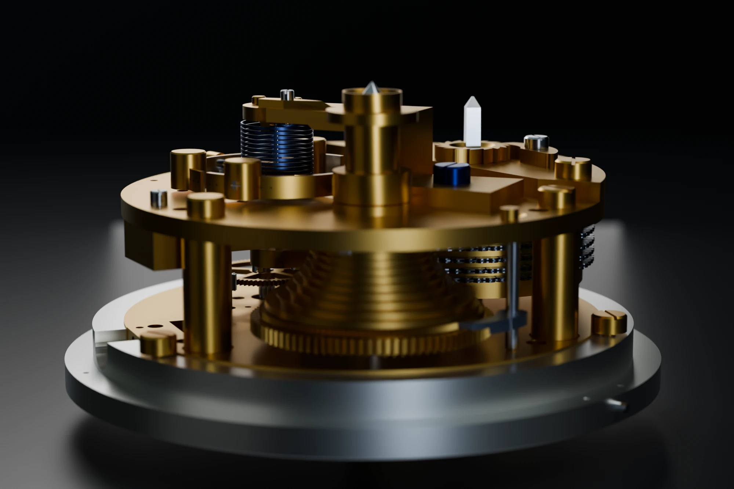
marine-chronometer-source/wempe/renders/low_7_309deg.webp
