OrelMag/marine-chronometer-model/marine-chronometer-source/wempe/renders/movement_side_3.webp

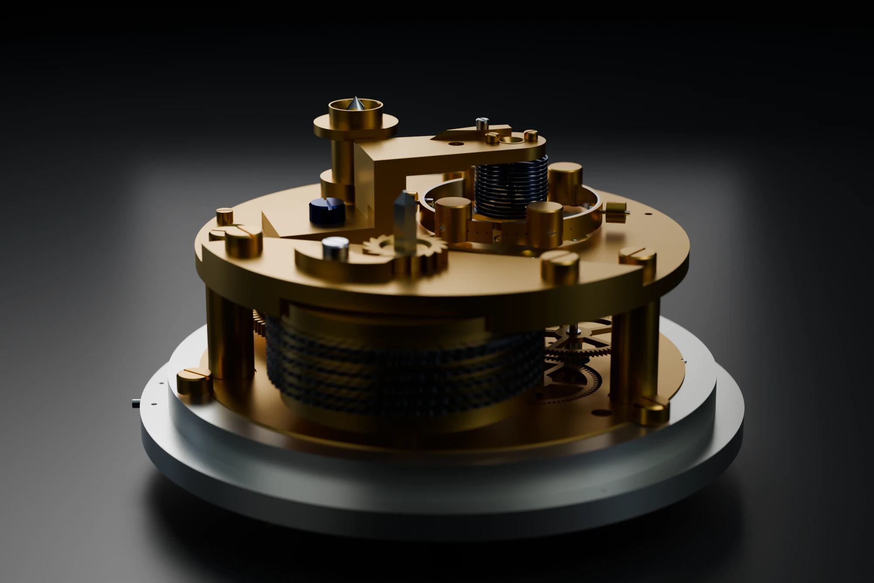
marine-chronometer-source/wempe/renders/movement_side_3.webp
