OrelMag/marine-chronometer-model/marine-chronometer-source/wempe/renders/movement_side_6.webp

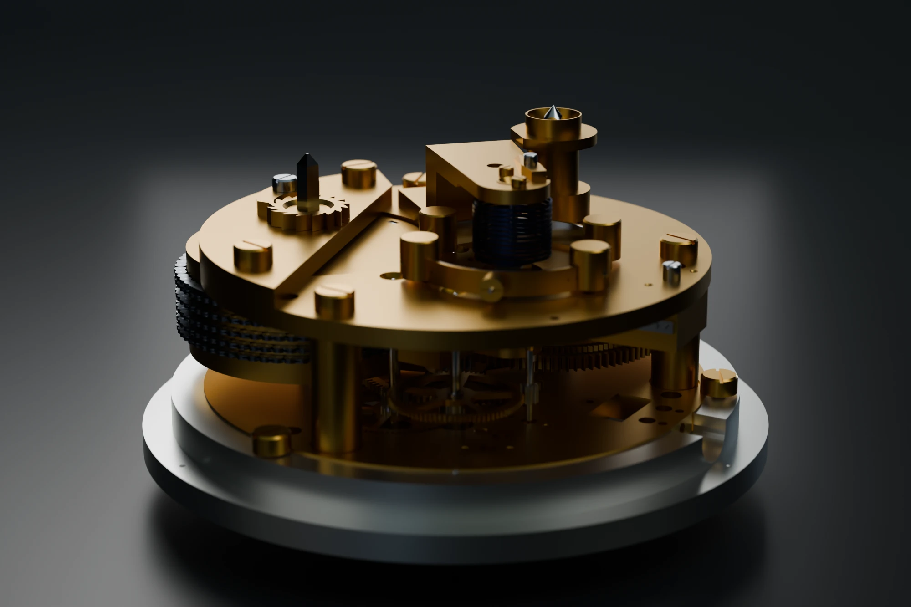
marine-chronometer-source/wempe/renders/movement_side_6.webp
