OrelMag/marine-chronometer-model/marine-chronometer-source/wempe/renders/movement_side_9.webp

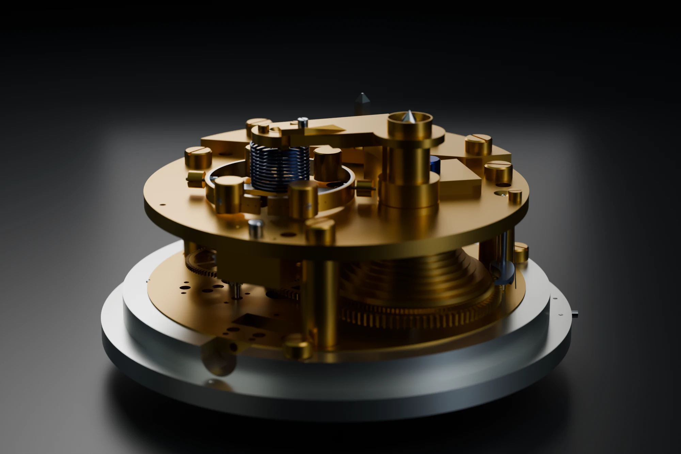
marine-chronometer-source/wempe/renders/movement_side_9.webp
