OrelMag/marine-chronometer-model/marine-chronometer-source/wempe/renders/movement_three_quarter.webp

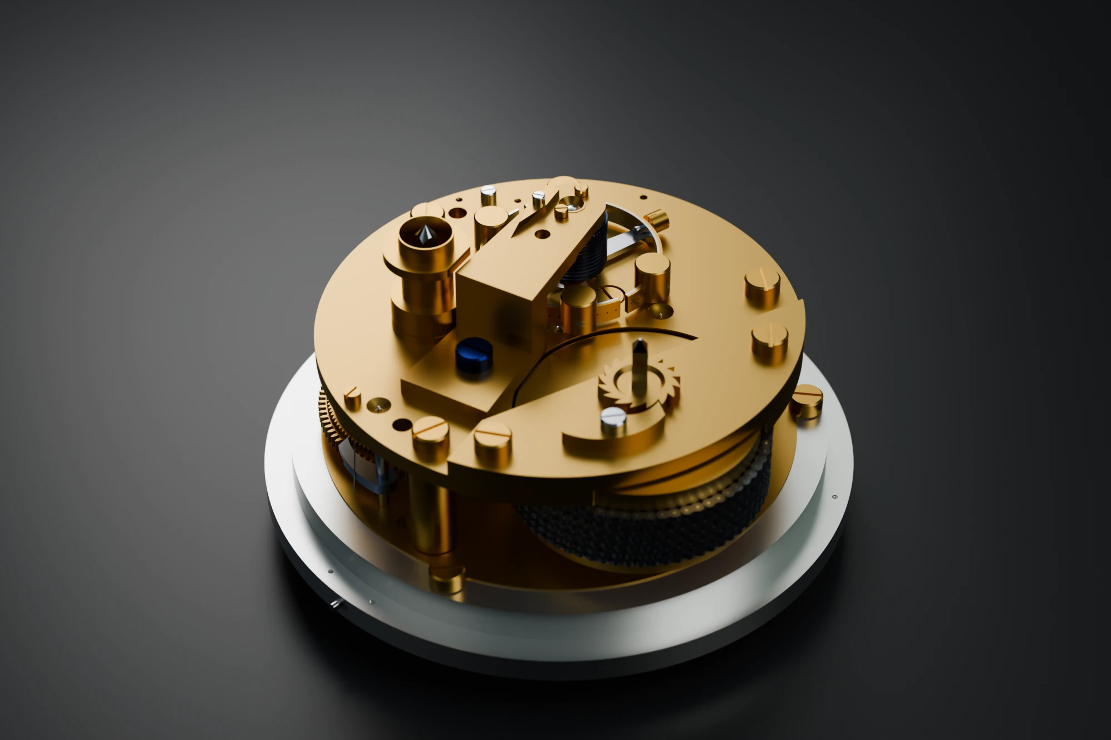
marine-chronometer-source/wempe/renders/movement_three_quarter.webp
