OrelMag/marine-chronometer-model/marine-chronometer-source/wempe/renders/movement_top.webp

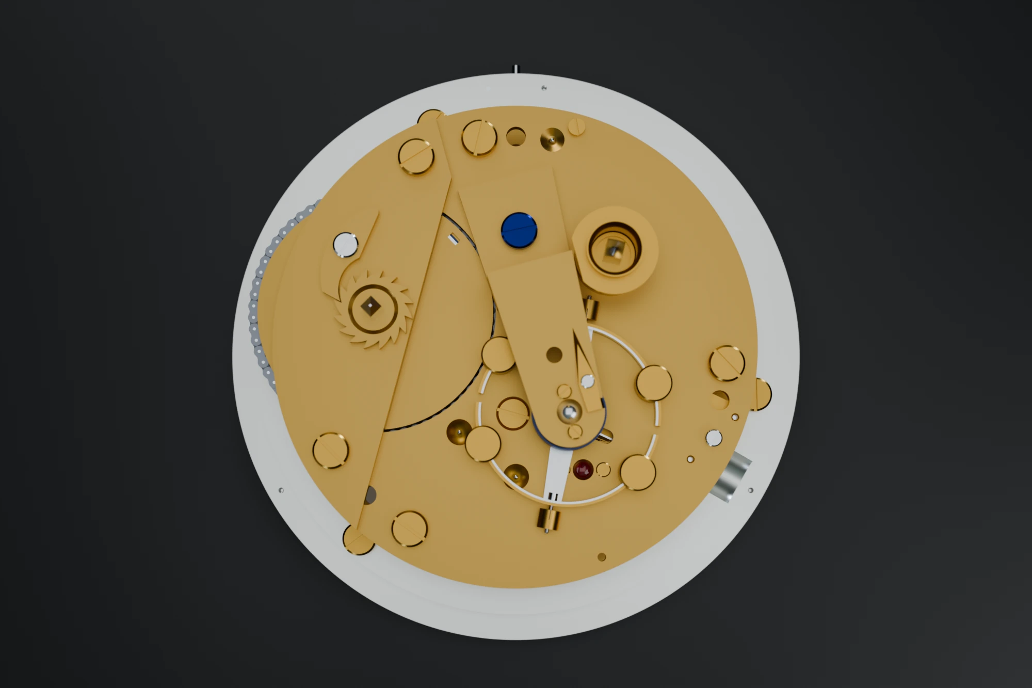
marine-chronometer-source/wempe/renders/movement_top.webp
