OrelMag/marine-chronometer-model/marine-chronometer-source/wempe/renders/showcase_balance.webp

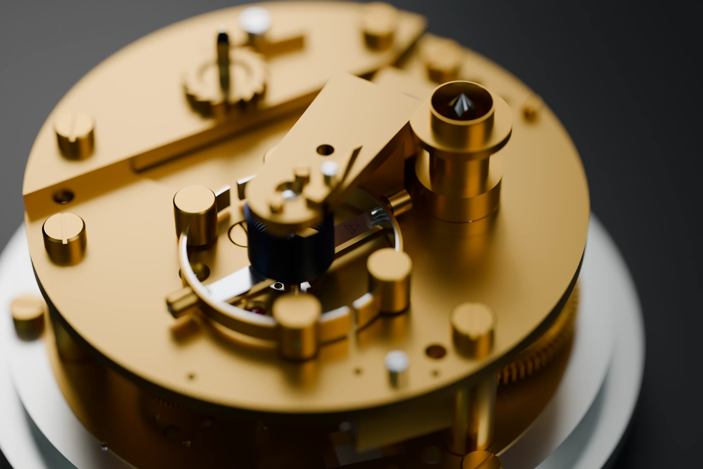
marine-chronometer-source/wempe/renders/showcase_balance.webp
