OrelMag/marine-chronometer-model/marine-chronometer-source/wempe/renders/showcase_box.webp

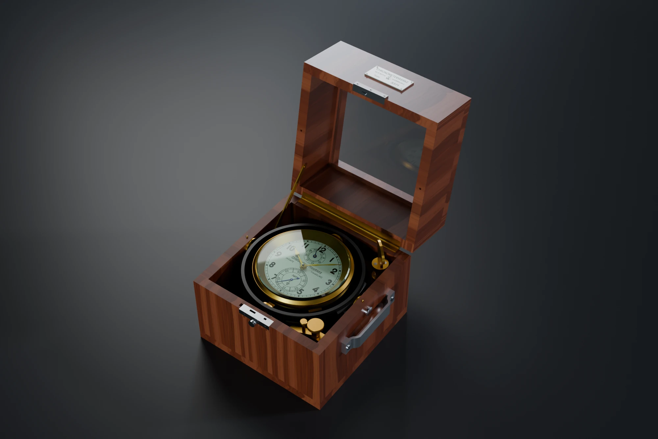
marine-chronometer-source/wempe/renders/showcase_box.webp
