OrelMag/marine-chronometer-model/marine-chronometer-source/wempe/renders/w3955_A.webp

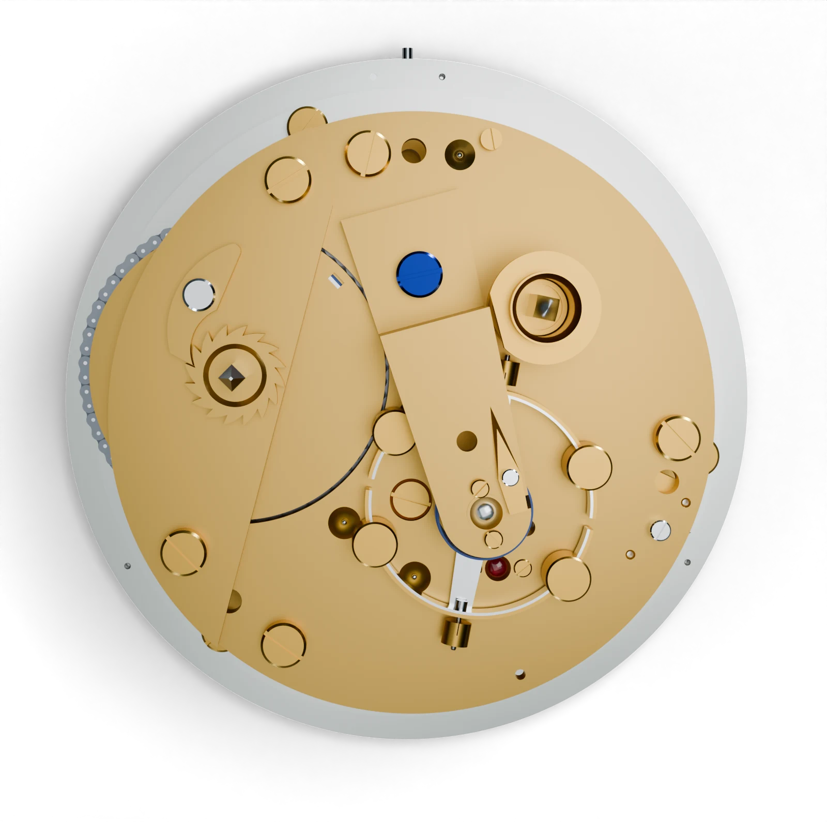
marine-chronometer-source/wempe/renders/w3955_A.webp
