OrelMag/marine-chronometer-model/marine-chronometer-source/wempe/renders/w3955_uZ.webp

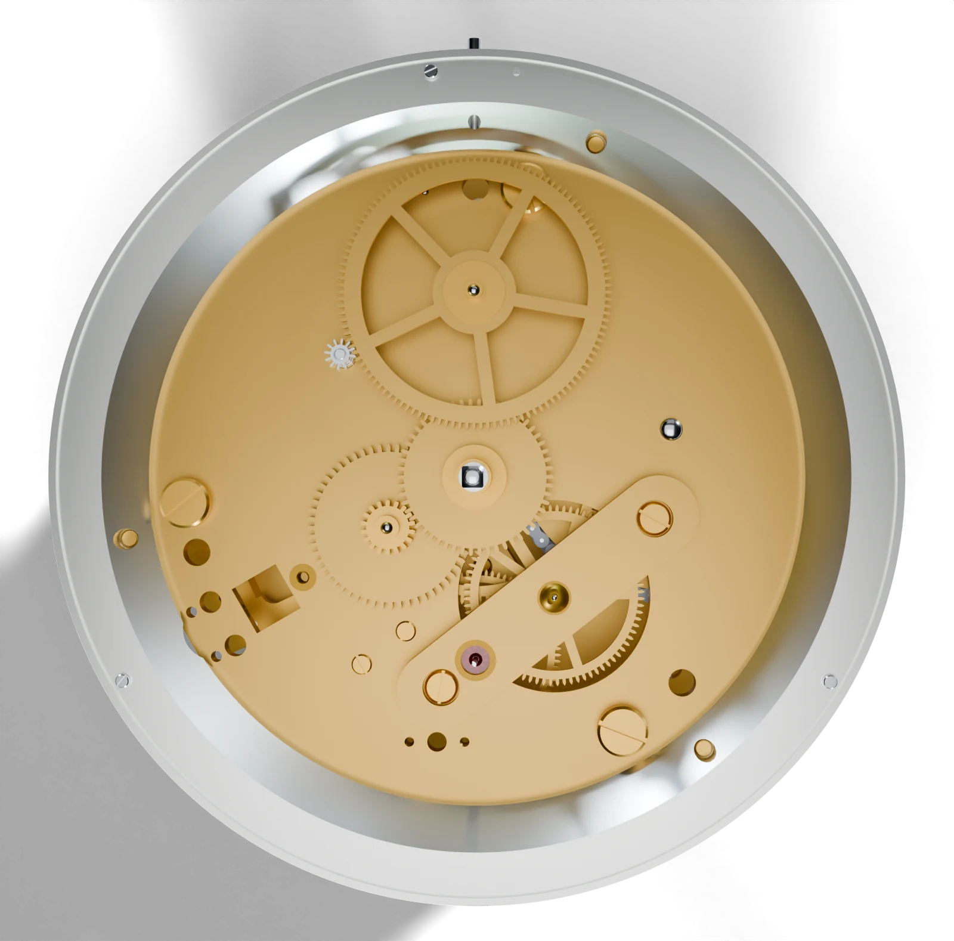
marine-chronometer-source/wempe/renders/w3955_uZ.webp
