OrelMag/marine-chronometer-model/marine-chronometer-source/wempe/renders/w3955_W.webp

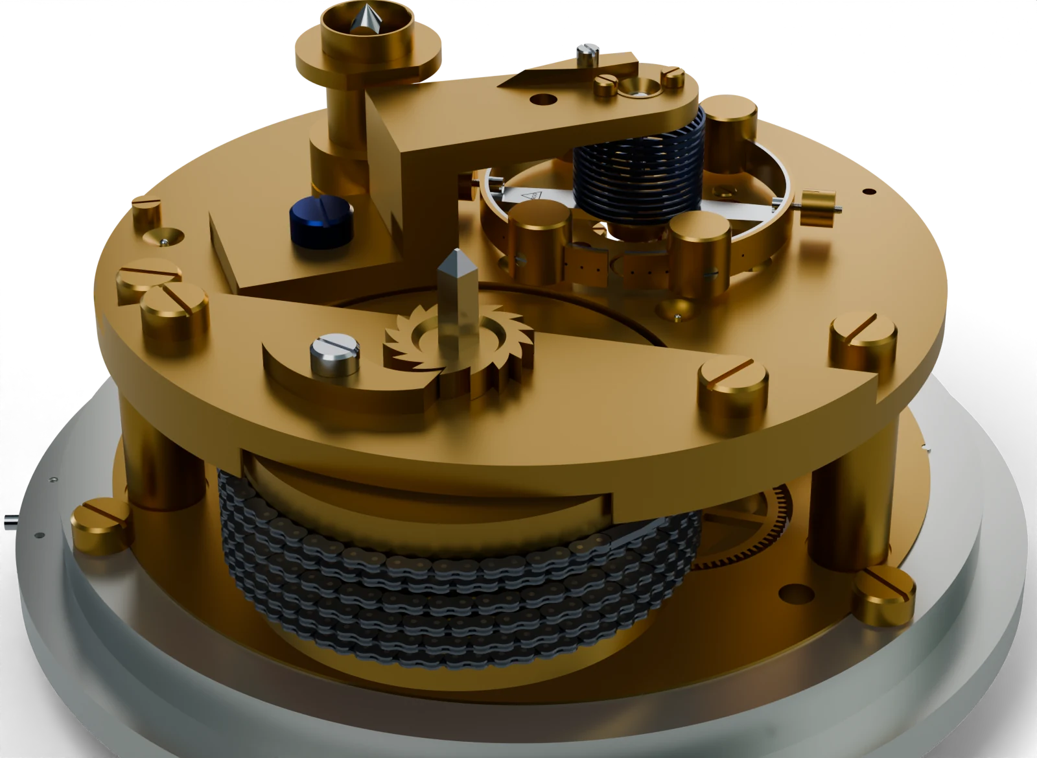
marine-chronometer-source/wempe/renders/w3955_W.webp
