OrelMag/marine-chronometer-model/References/patent-US2356911-balance-wheel-sheet1.png

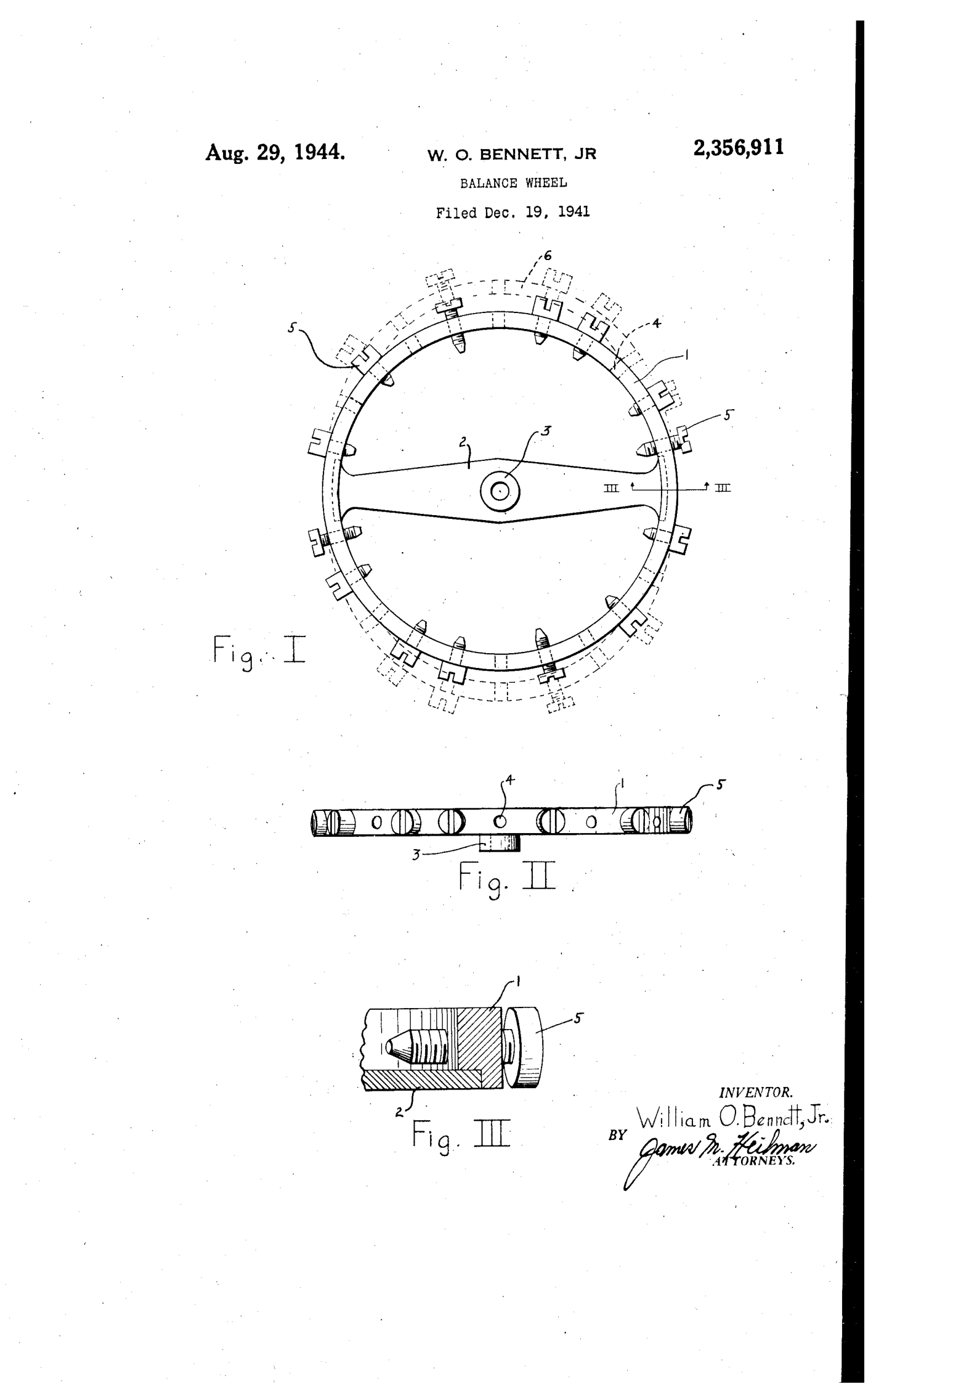
References/patent-US2356911-balance-wheel-sheet1.png
