OrelMag/marine-chronometer-model/References/patent-US2379780-hairspring-mounting-sheet1.png

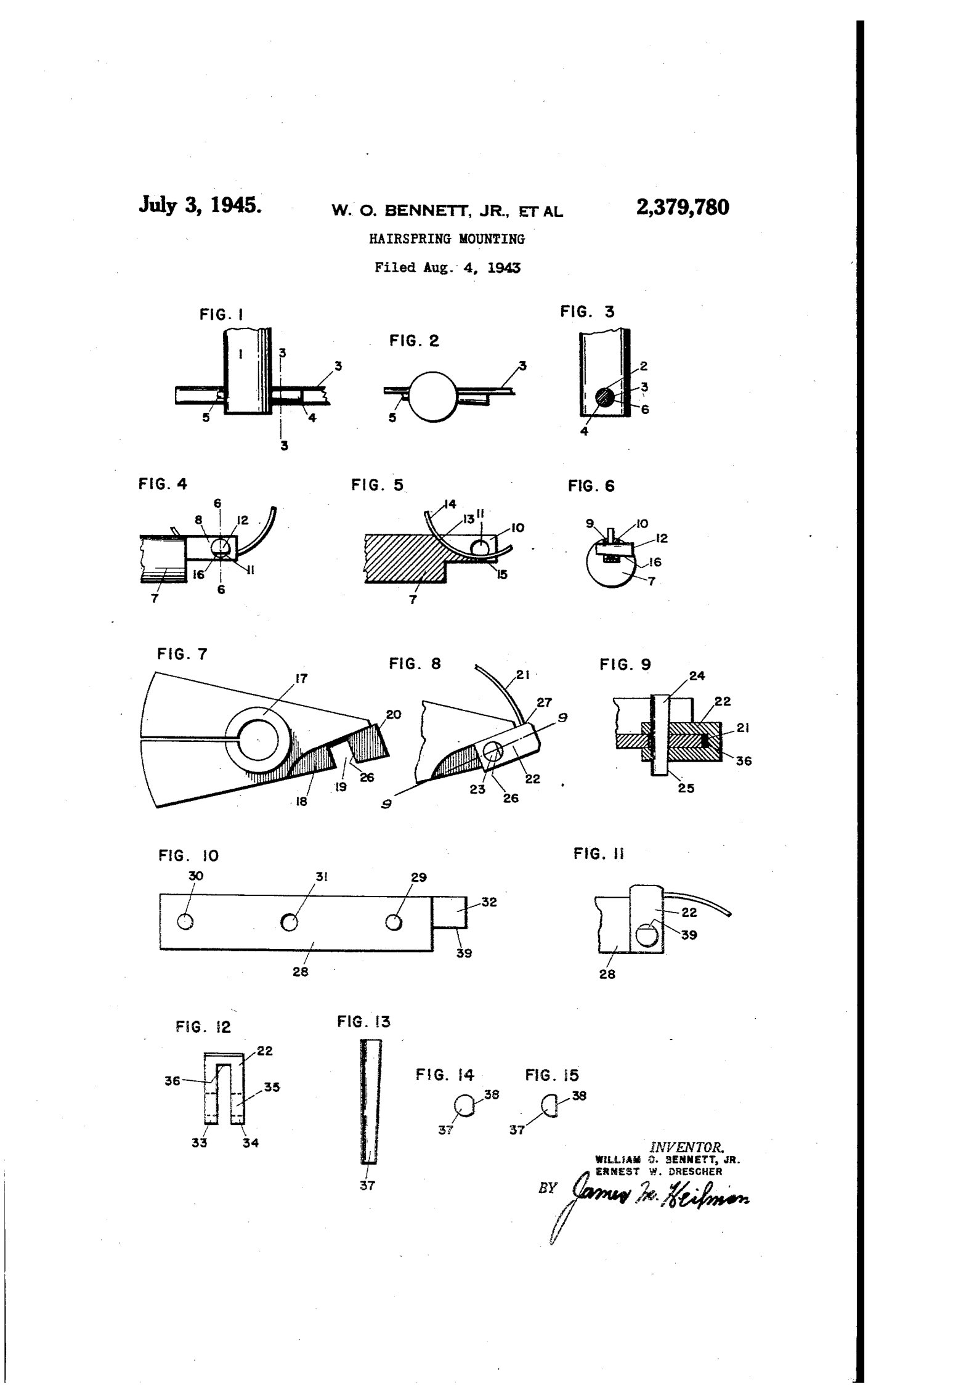
References/patent-US2379780-hairspring-mounting-sheet1.png
