OrelMag/marine-chronometer-model/References/patent-US2391816-hairspring-collet-sheet1.png

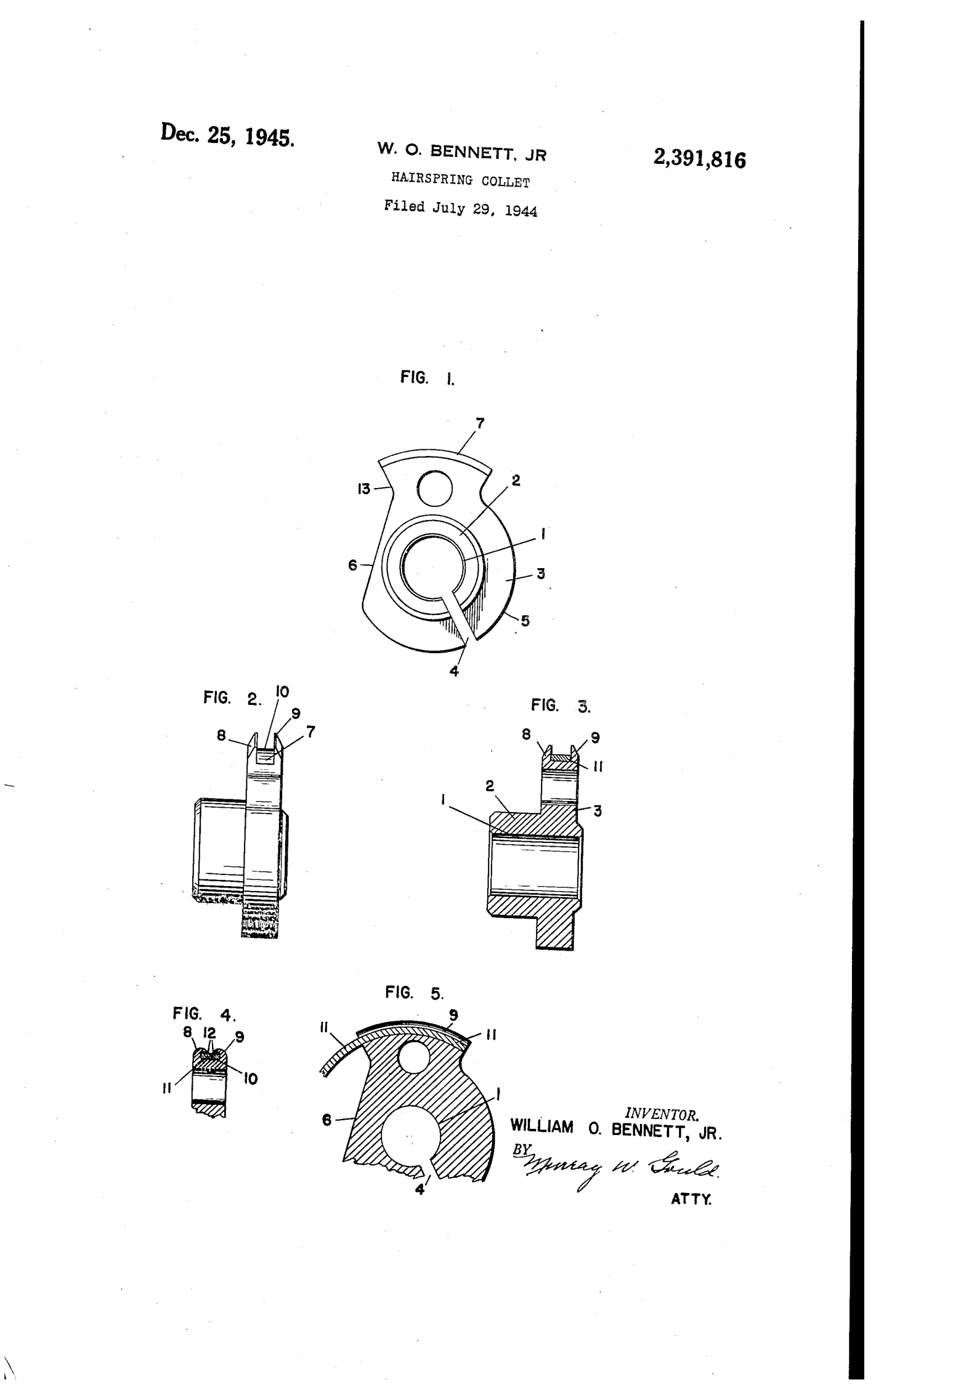
References/patent-US2391816-hairspring-collet-sheet1.png
