OrelMag/marine-chronometer-model/References/patent-US2457631-cylindrical-hairspring-form-sheet1.png

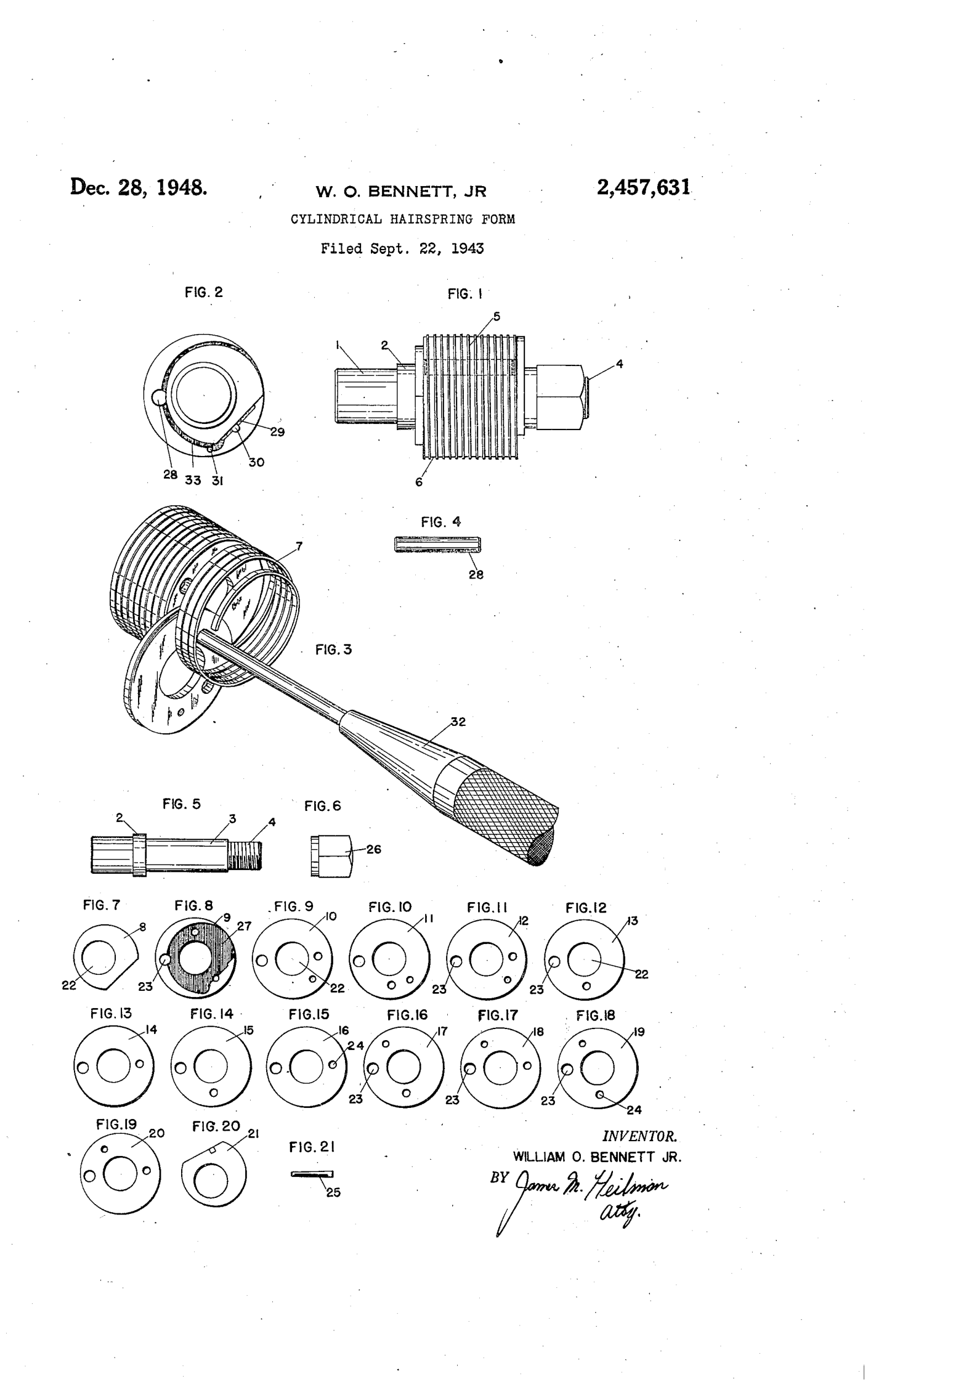
References/patent-US2457631-cylindrical-hairspring-form-sheet1.png
