OrelMag/marine-chronometer-model/References/photo-cock-top.png

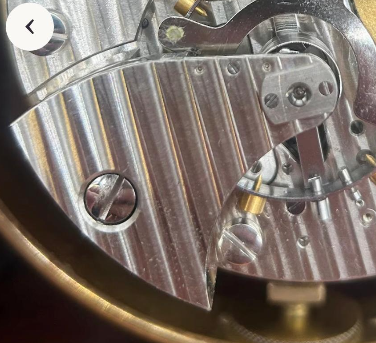
References/photo-cock-top.png
