OrelMag/marine-chronometer-model/References/photo-dial-side-lower-train-bridge.png

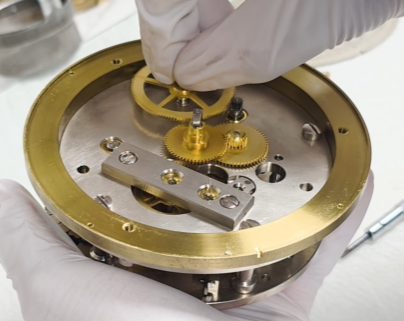
References/photo-dial-side-lower-train-bridge.png
