OrelMag/marine-chronometer-model/References/photo-dial-soviet-kirov.png

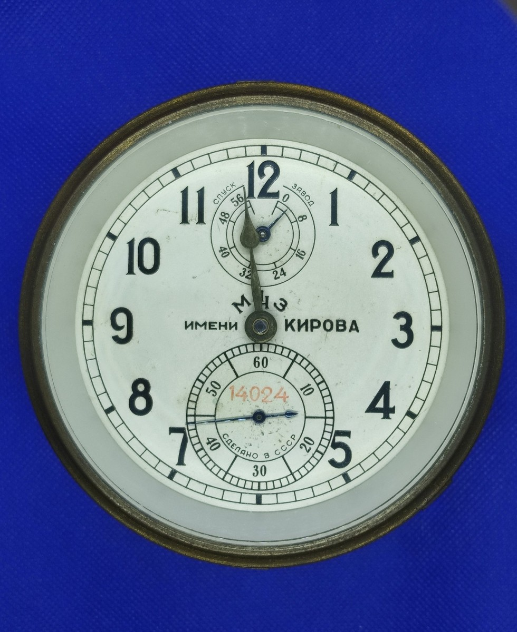
References/photo-dial-soviet-kirov.png
