OrelMag/marine-chronometer-model/References/photo-dial-ulysse-nardin-noaa.jpg

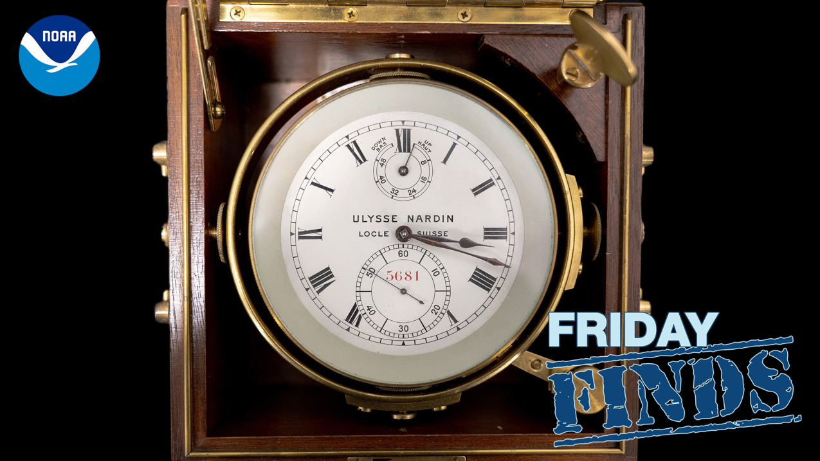
References/photo-dial-ulysse-nardin-noaa.jpg
