OrelMag/marine-chronometer-model/References/photo-lower-bridge-underside.jpg

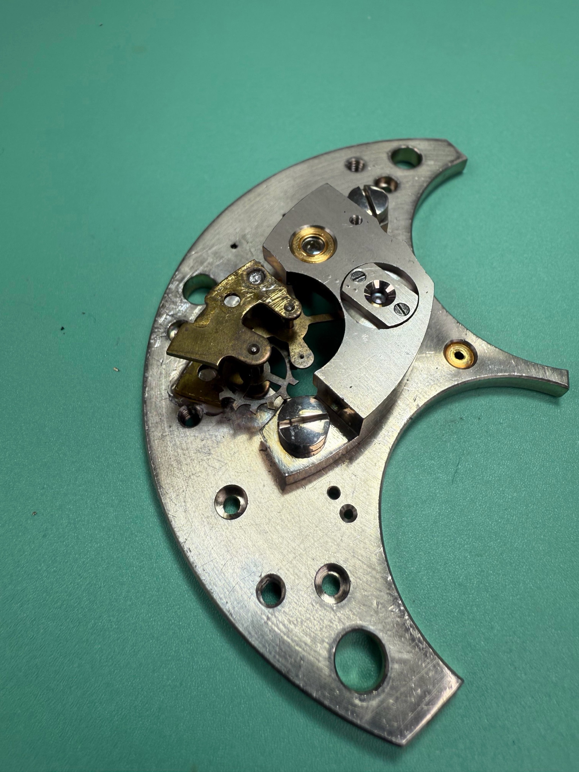
References/photo-lower-bridge-underside.jpg
