OrelMag/marine-chronometer-model/References/photo-movement-2E12055.jpg

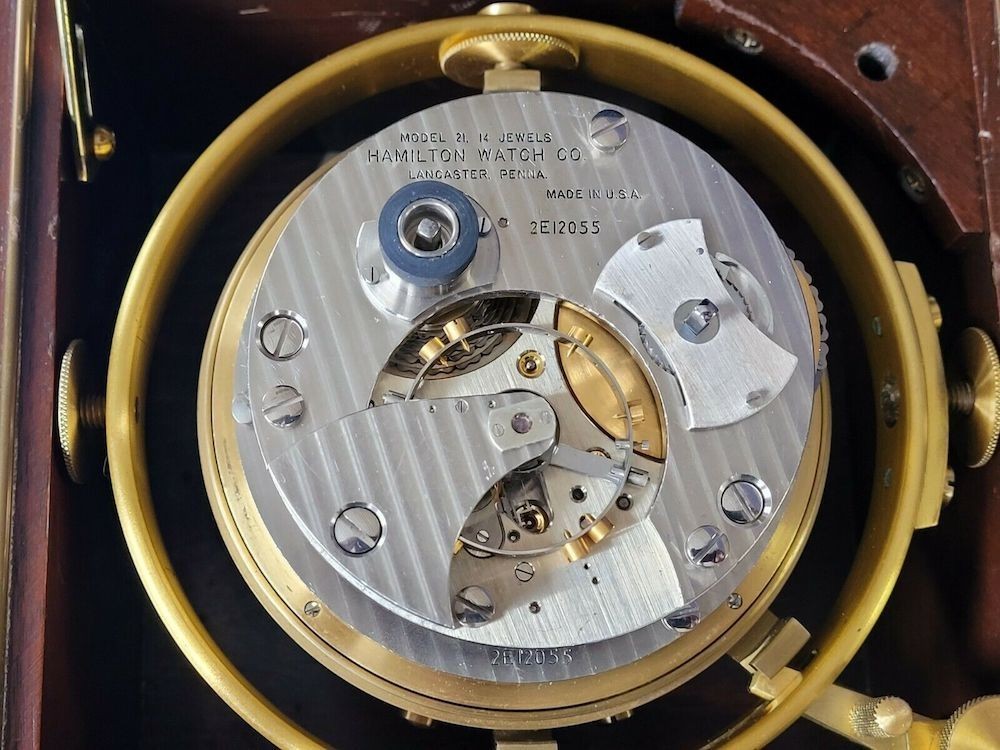
References/photo-movement-2E12055.jpg
