OrelMag/marine-chronometer-model/References/photo-oblique-balance-side.jpg

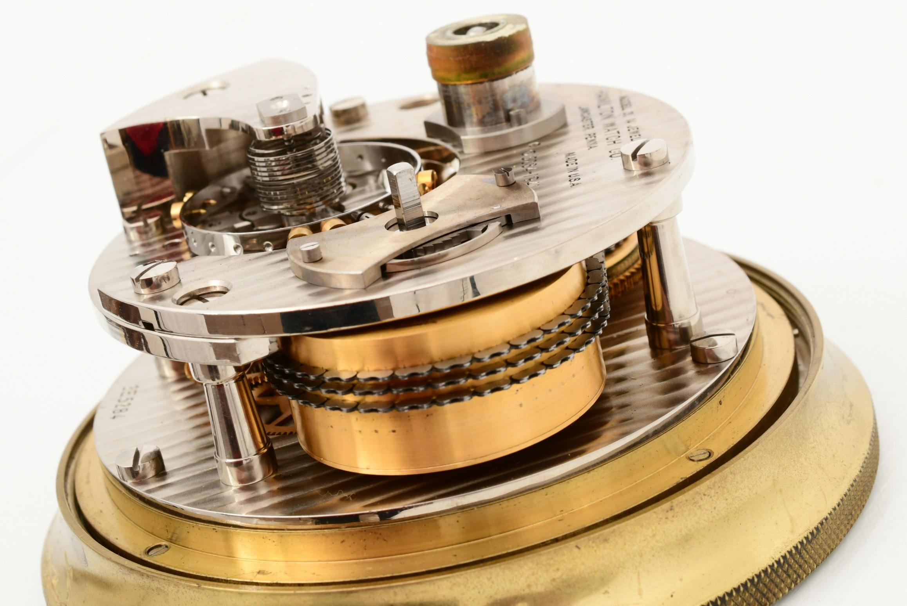
References/photo-oblique-balance-side.jpg
