OrelMag/marine-chronometer-model/References/photo-plate-cork-as-shown.jpg

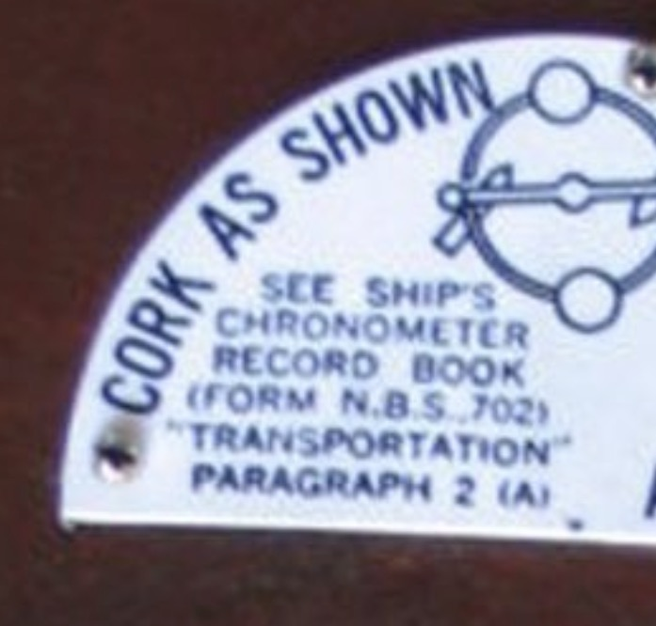
References/photo-plate-cork-as-shown.jpg
