OrelMag/marine-chronometer-model/References/photo-side-view.jpg

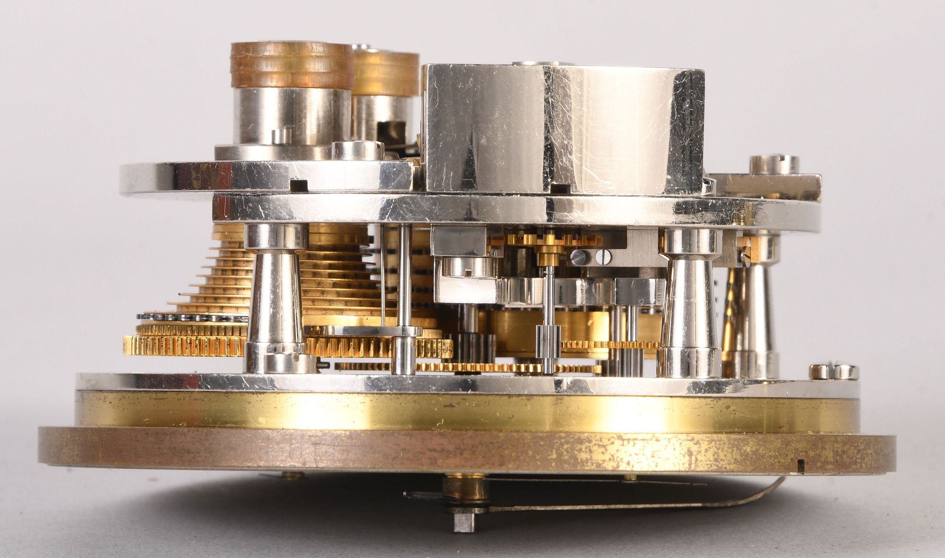
References/photo-side-view.jpg
