OrelMag/marine-chronometer-model/References/photo-top-view.jpg

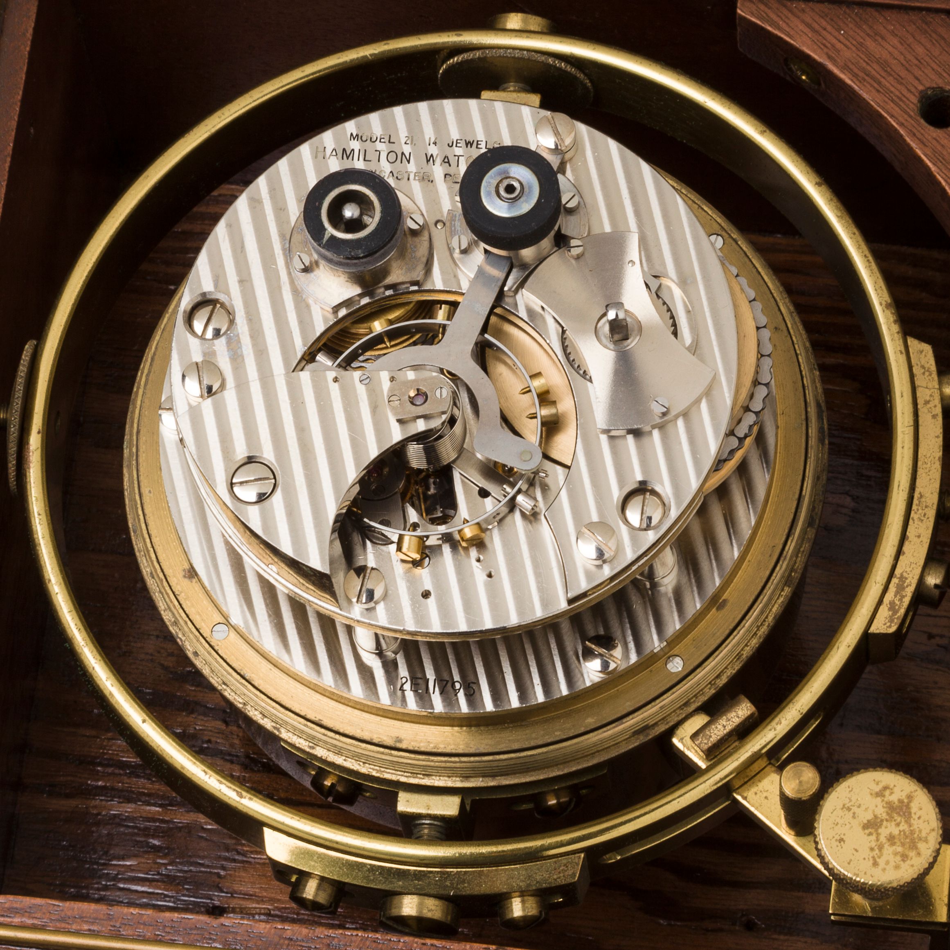
References/photo-top-view.jpg
