OrelMag/marine-chronometer-model/References/screenshot-model-exploded-view.jpg

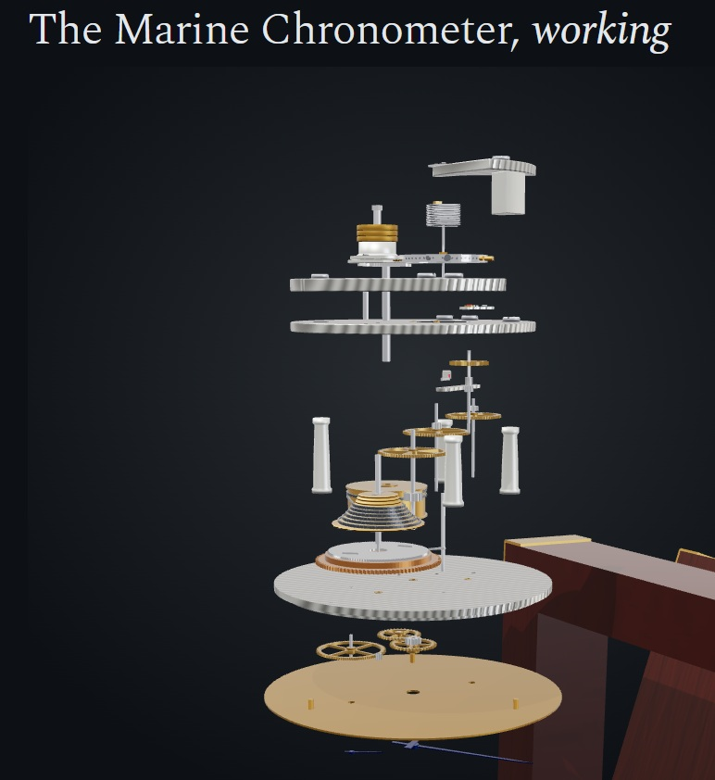
References/screenshot-model-exploded-view.jpg
