OrelMag/marine-chronometer-model/References/third-model/photos/seikosha-No1001-seiko-museum-tnw/Seiko_Museum_TNW_73.jpg

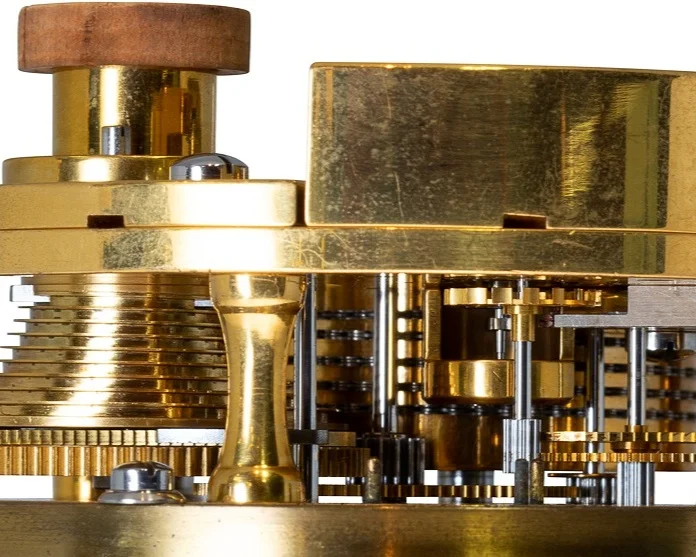
References/third-model/photos/seikosha-No1001-seiko-museum-tnw/Seiko_Museum_TNW_73.jpg
