OrelMag/marine-chronometer-model/References/third-model/photos/seikosha-V031-sundialfarm/g157h.jpg

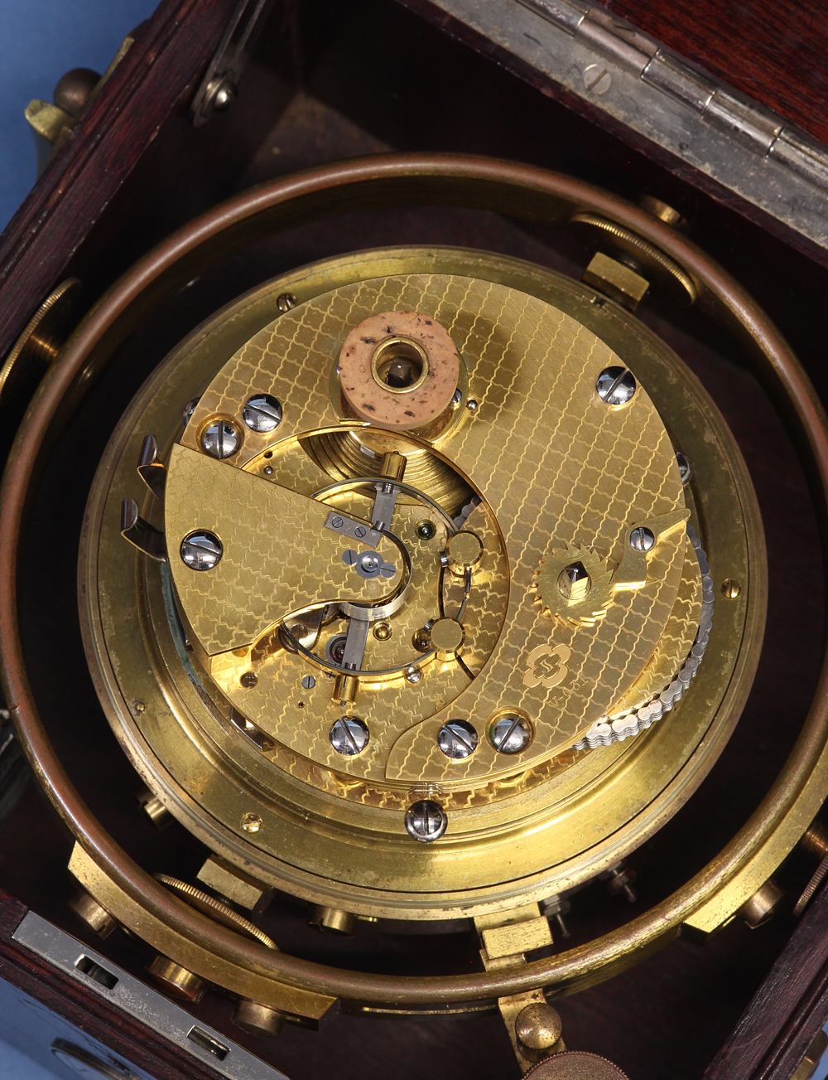
References/third-model/photos/seikosha-V031-sundialfarm/g157h.jpg
