OrelMag/marine-chronometer-model/References/third-model/photos/seikosha-V844-yahoo-s1228688298/2.jpg

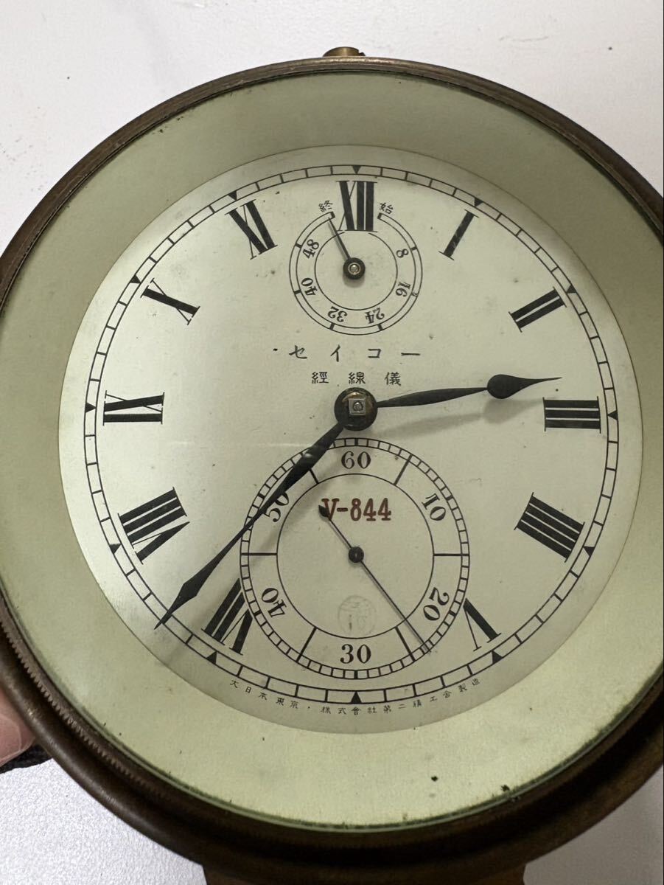
References/third-model/photos/seikosha-V844-yahoo-s1228688298/2.jpg
