OrelMag/marine-chronometer-model/References/third-model/photos/yokosuka-navy-yahoo-u1231304991/1.jpg

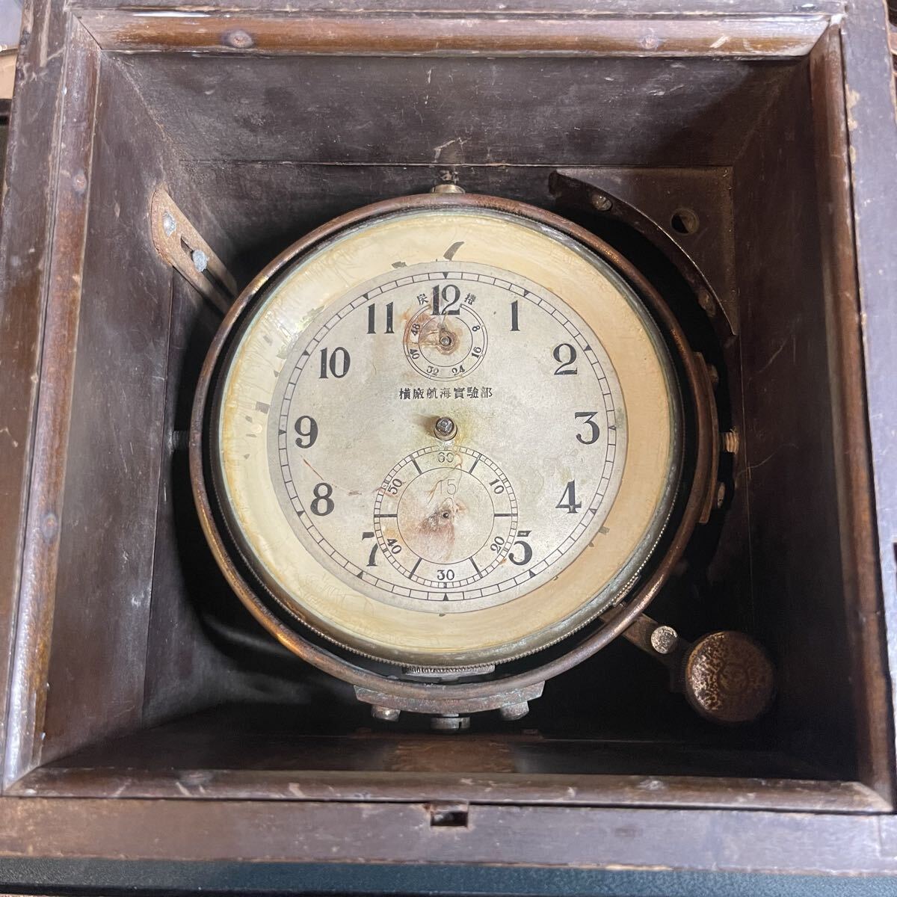
References/third-model/photos/yokosuka-navy-yahoo-u1231304991/1.jpg
