OrelMag/marine-chronometer-model/References/ulysse-nardin-7400/un7400-03-box-closed.jpg

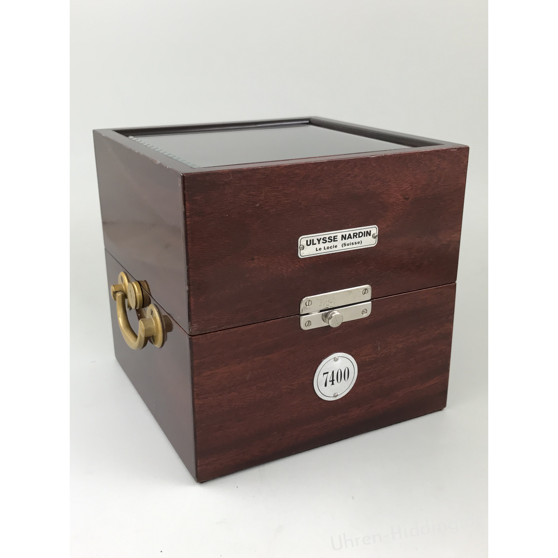
References/ulysse-nardin-7400/un7400-03-box-closed.jpg
