OrelMag/marine-chronometer-model/References/ulysse-nardin-7400/un7400-07-movement-in-box.jpg

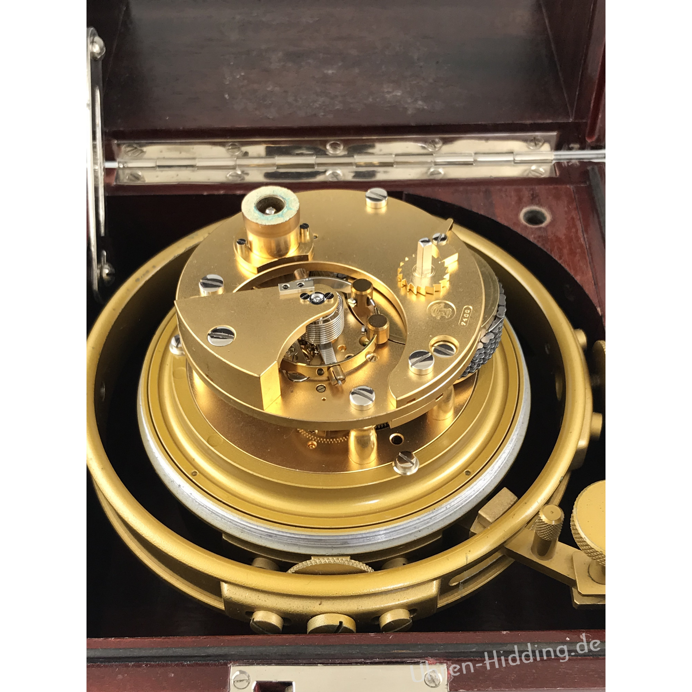
References/ulysse-nardin-7400/un7400-07-movement-in-box.jpg
