OrelMag/marine-chronometer-model/References/wempe/documents/6MX-Hemmung_4.jpg

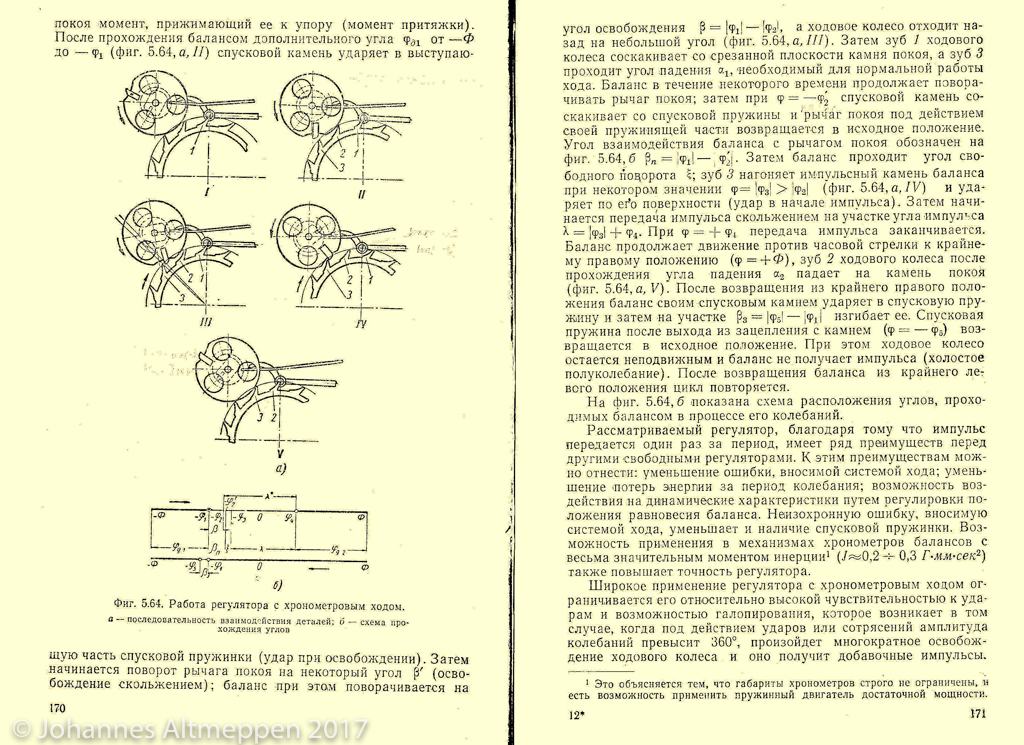
References/wempe/documents/6MX-Hemmung_4.jpg
