OrelMag/marine-chronometer-model/References/wempe/documents/Ekspluatatsiya-i-remont-izmeritelei-vremeni-1958/p063.png

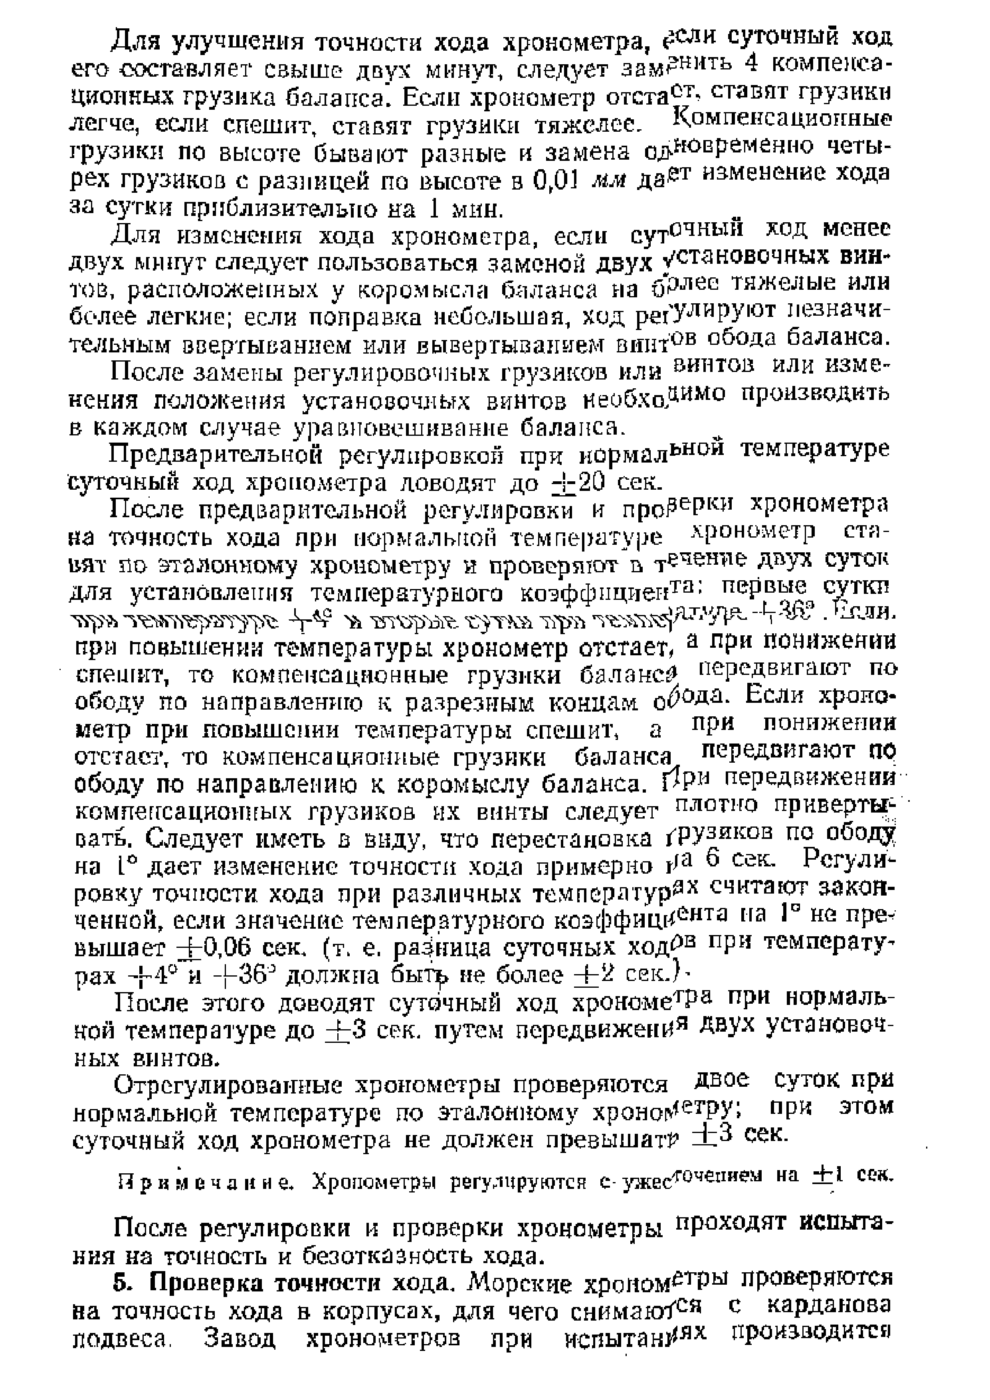
References/wempe/documents/Ekspluatatsiya-i-remont-izmeritelei-vremeni-1958/p063.png
