OrelMag/marine-chronometer-model/References/wempe/documents/Romanov-1975-Proektirovanie-priborov-vremeni/p104.jpg

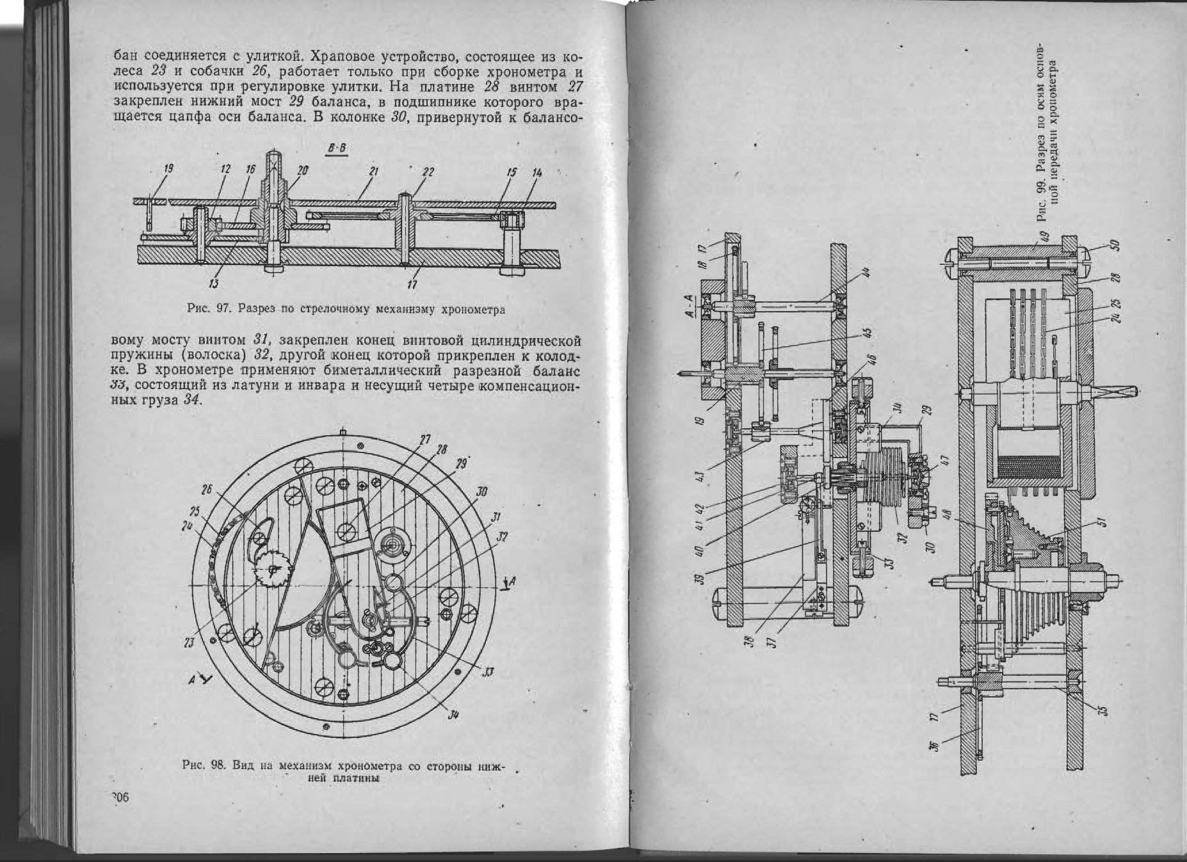
References/wempe/documents/Romanov-1975-Proektirovanie-priborov-vremeni/p104.jpg
