OrelMag/marine-chronometer-model/References/wempe/documents/Tarasov-1976-Pribory-vremeni/p129.png

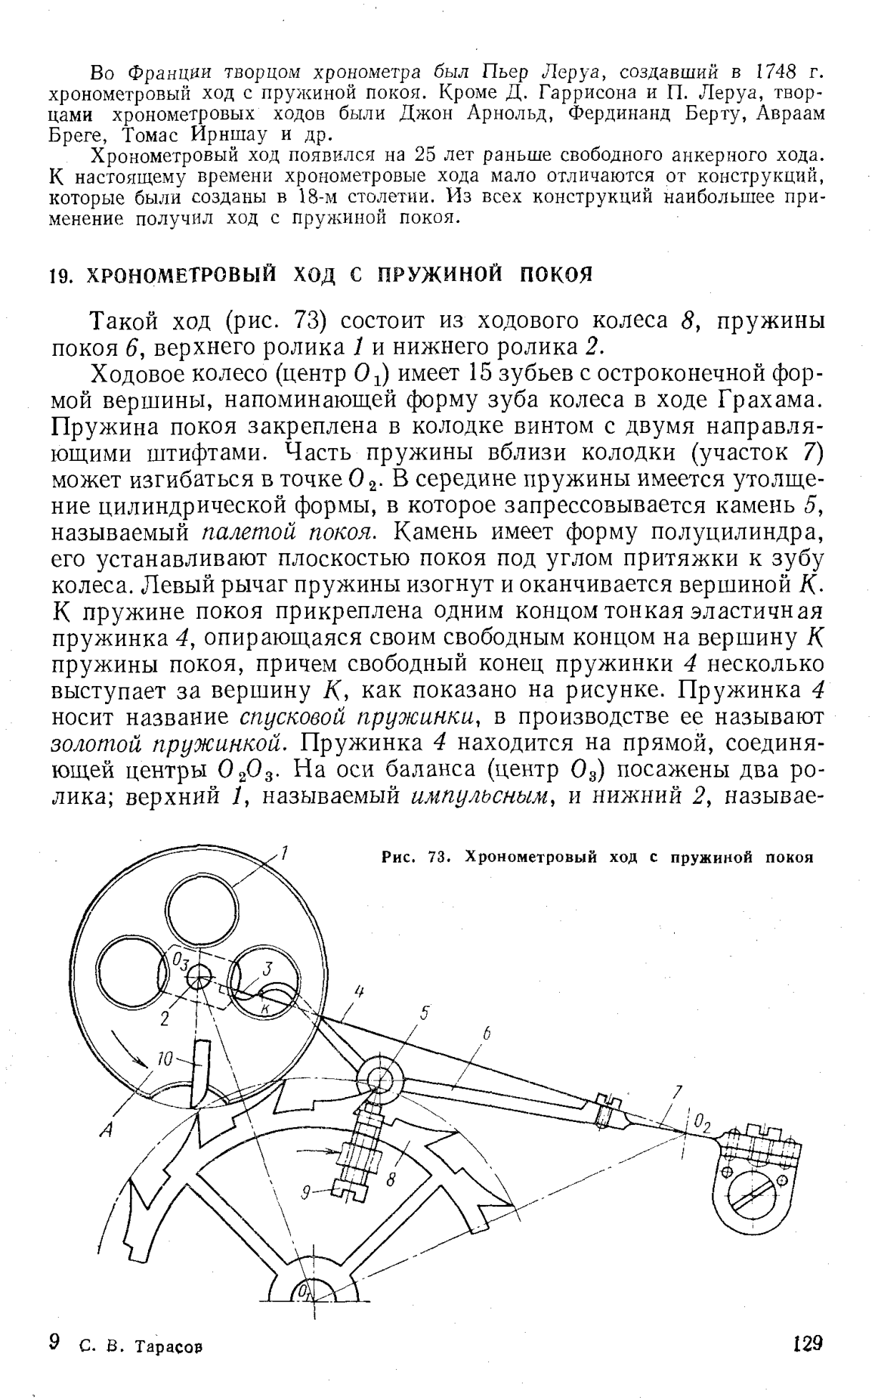
References/wempe/documents/Tarasov-1976-Pribory-vremeni/p129.png
