OrelMag/marine-chronometer-model/References/wempe/drawings/001-002/Wempe_001.jpg

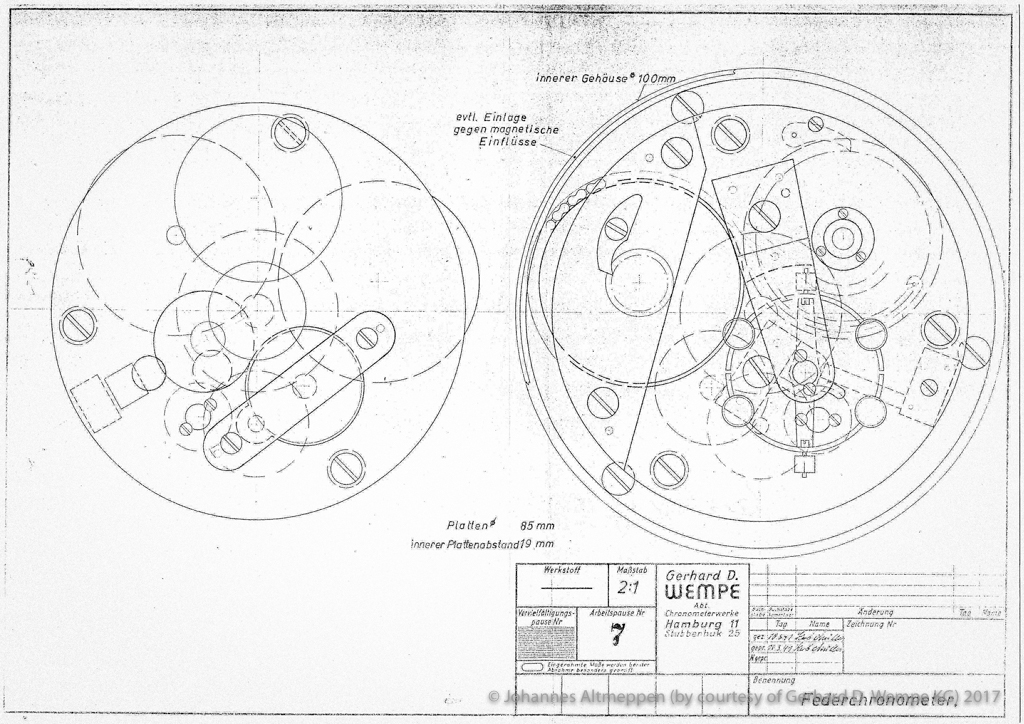
References/wempe/drawings/001-002/Wempe_001.jpg
