OrelMag/marine-chronometer-model/References/wempe/drawings/05-01/Wempe_05-01_4.jpg

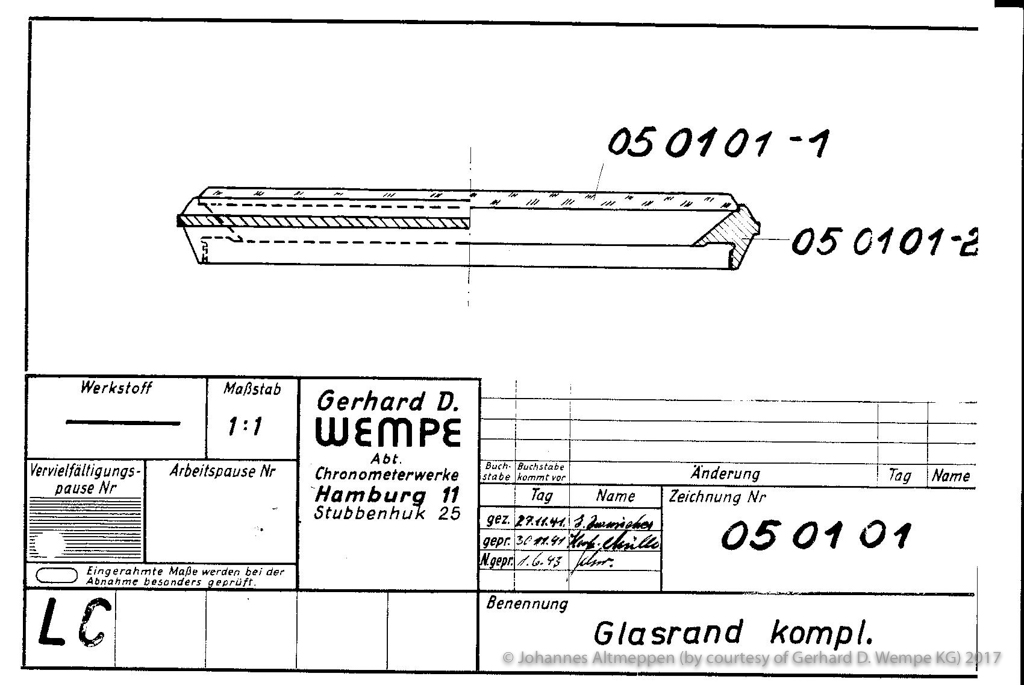
References/wempe/drawings/05-01/Wempe_05-01_4.jpg
