OrelMag/marine-chronometer-model/References/wempe/drawings/05-01/Wempe_05-01_7.jpg

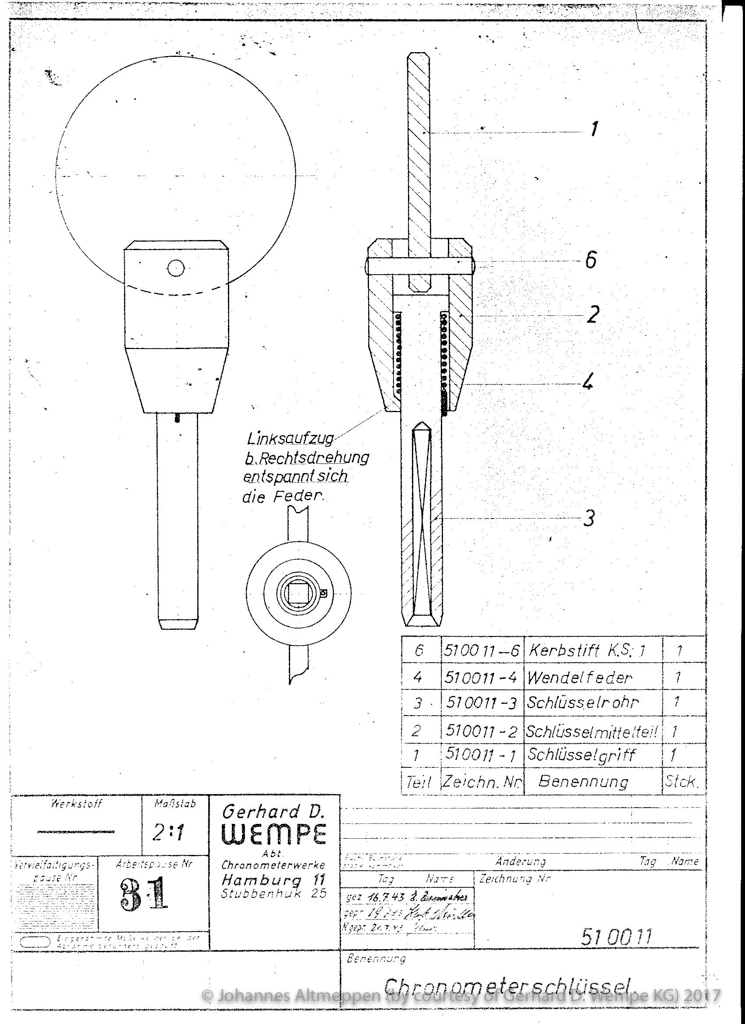
References/wempe/drawings/05-01/Wempe_05-01_7.jpg
