OrelMag/marine-chronometer-model/References/wempe/drawings/05-02/Wempe_05-02_05.jpg

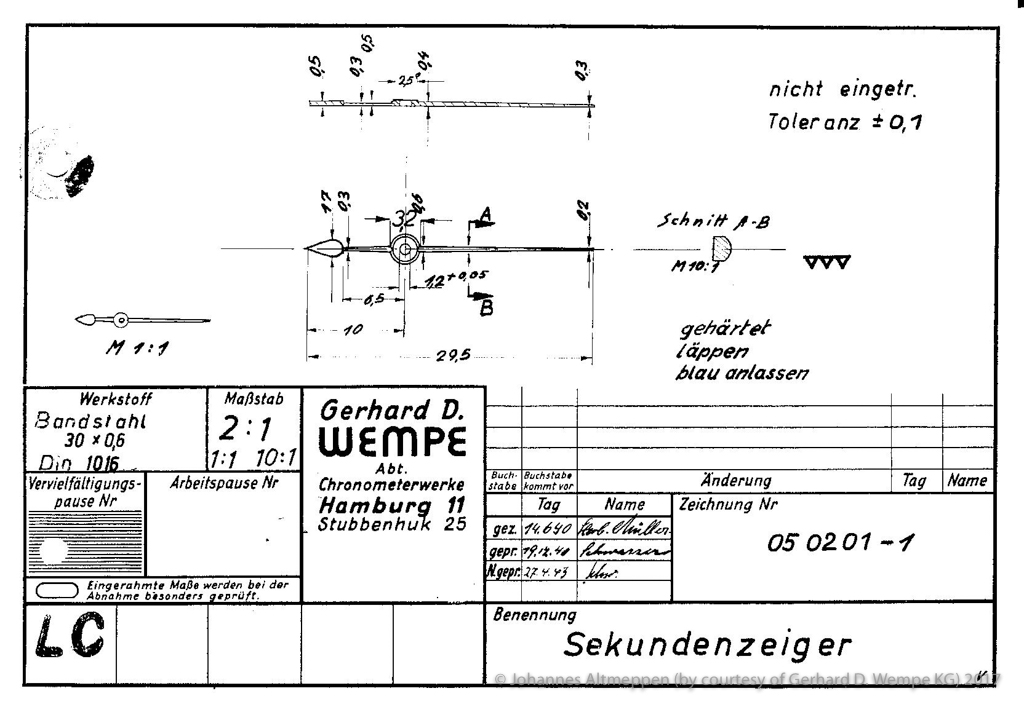
References/wempe/drawings/05-02/Wempe_05-02_05.jpg
