OrelMag/marine-chronometer-model/References/wempe/drawings/05-03/Wempe_05-03_7.jpg

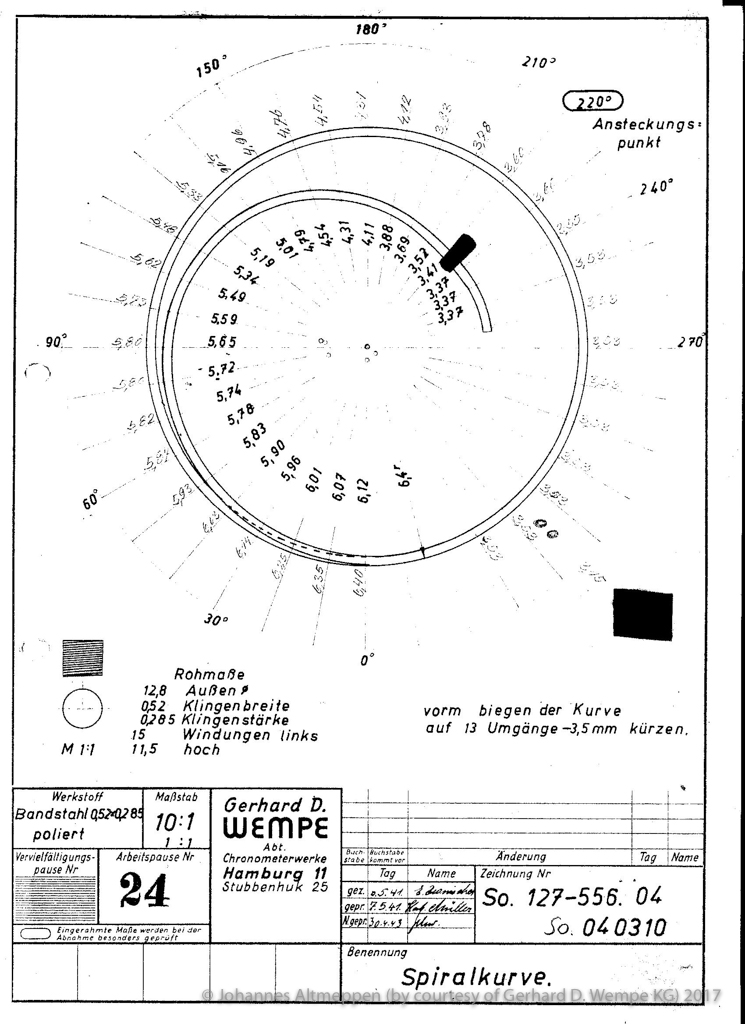
References/wempe/drawings/05-03/Wempe_05-03_7.jpg
