OrelMag/marine-chronometer-model/References/wempe/drawings/05-03/Wempe_05-03_9.jpg

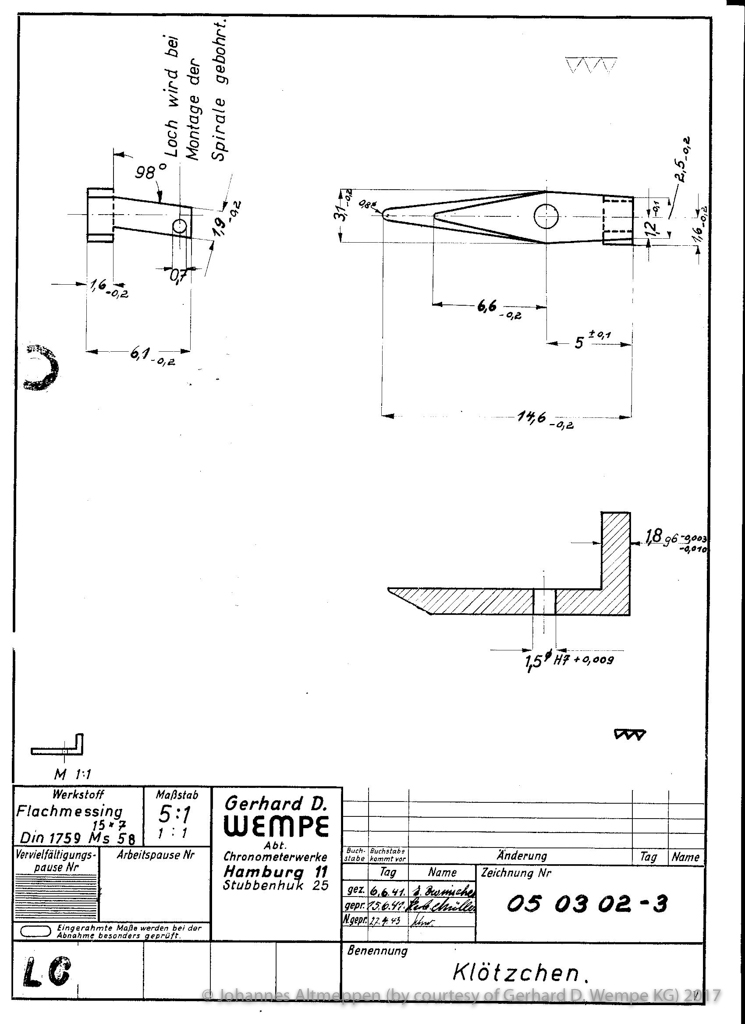
References/wempe/drawings/05-03/Wempe_05-03_9.jpg
