OrelMag/marine-chronometer-model/References/wempe/drawings/05-04/Wempe_05-04_03.jpg

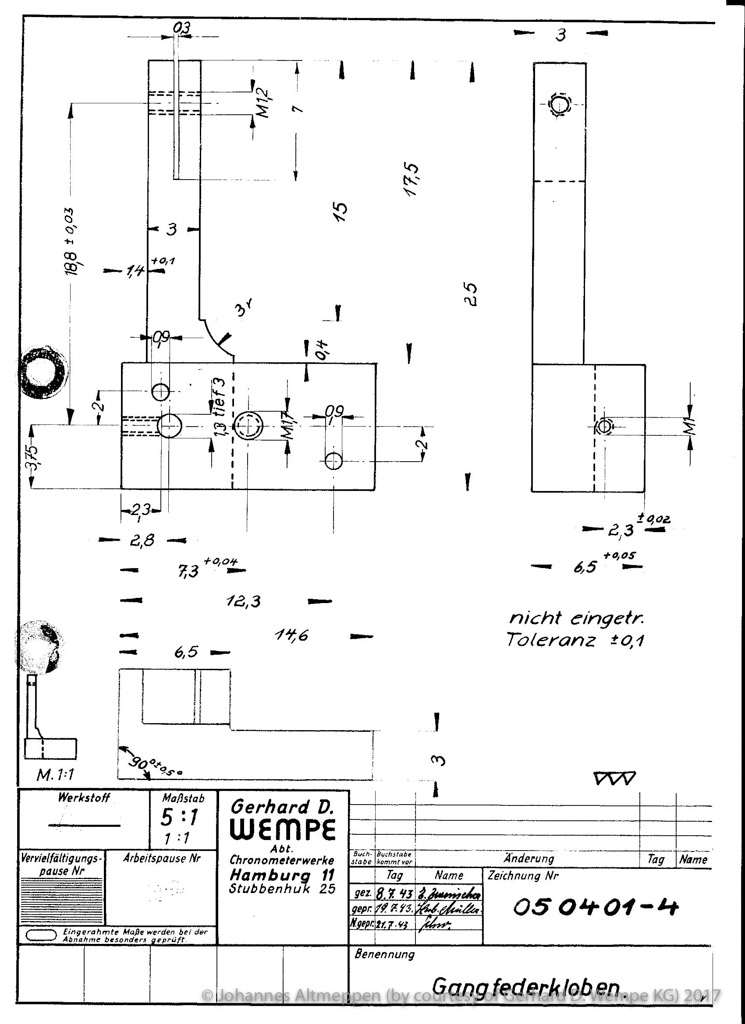
References/wempe/drawings/05-04/Wempe_05-04_03.jpg
