OrelMag/marine-chronometer-model/References/wempe/drawings/05-05/Wempe_05-05_10.jpg

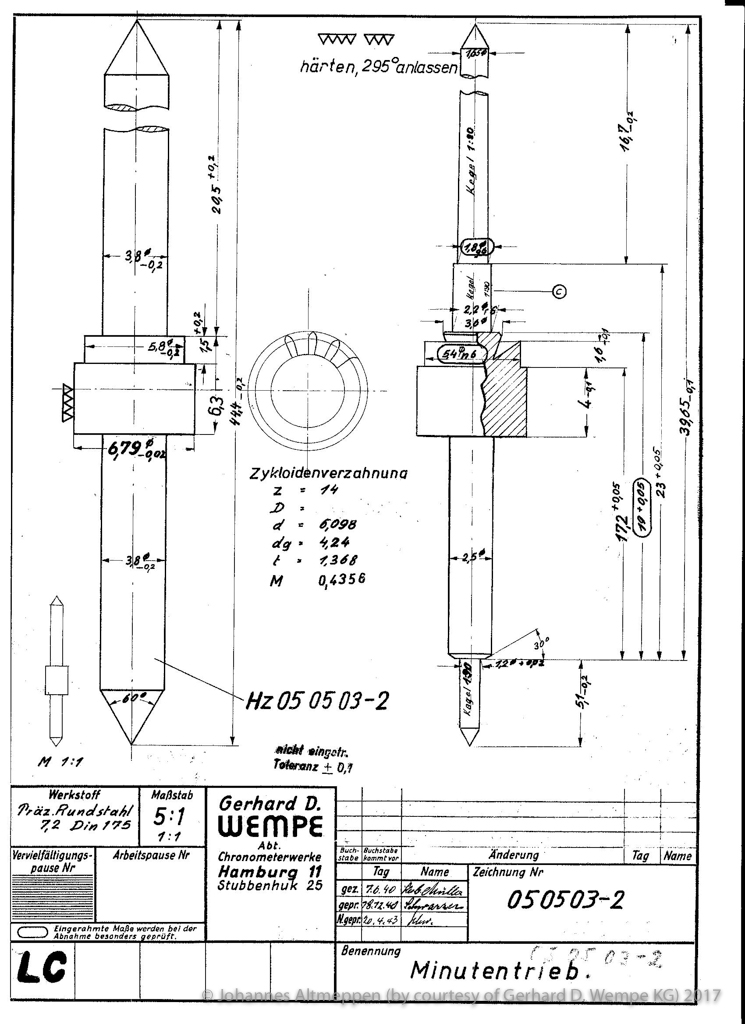
References/wempe/drawings/05-05/Wempe_05-05_10.jpg
