OrelMag/marine-chronometer-model/References/wempe/drawings/05-06/Wempe_05-06_04.jpg

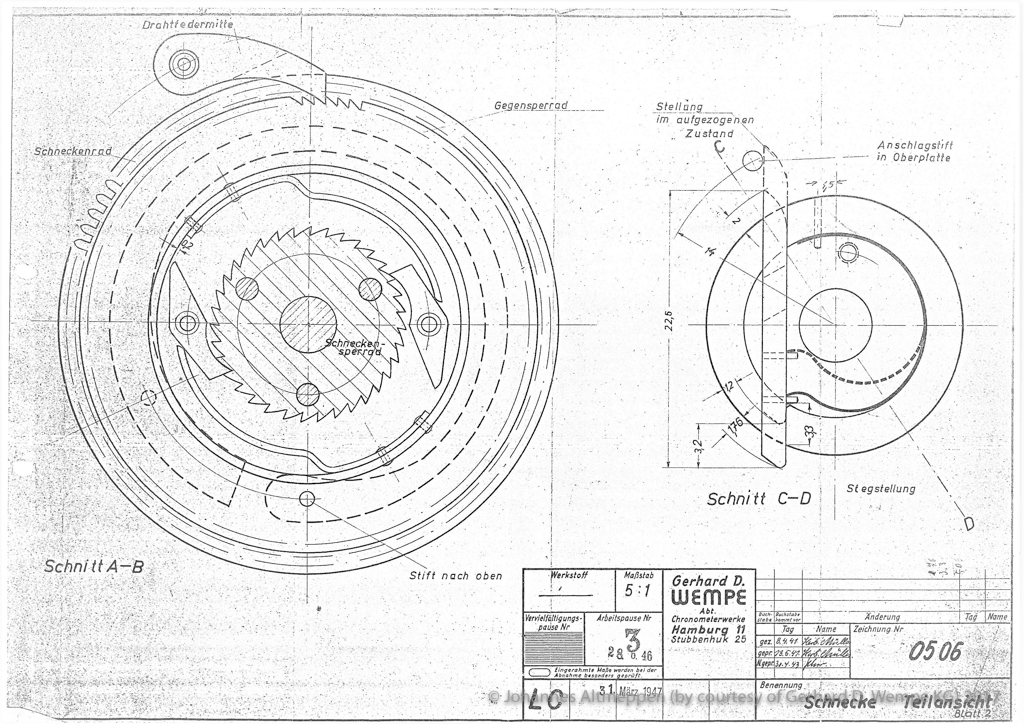
References/wempe/drawings/05-06/Wempe_05-06_04.jpg
