OrelMag/marine-chronometer-model/References/wempe/drawings/05-07/Wempe_05-07_04.jpg

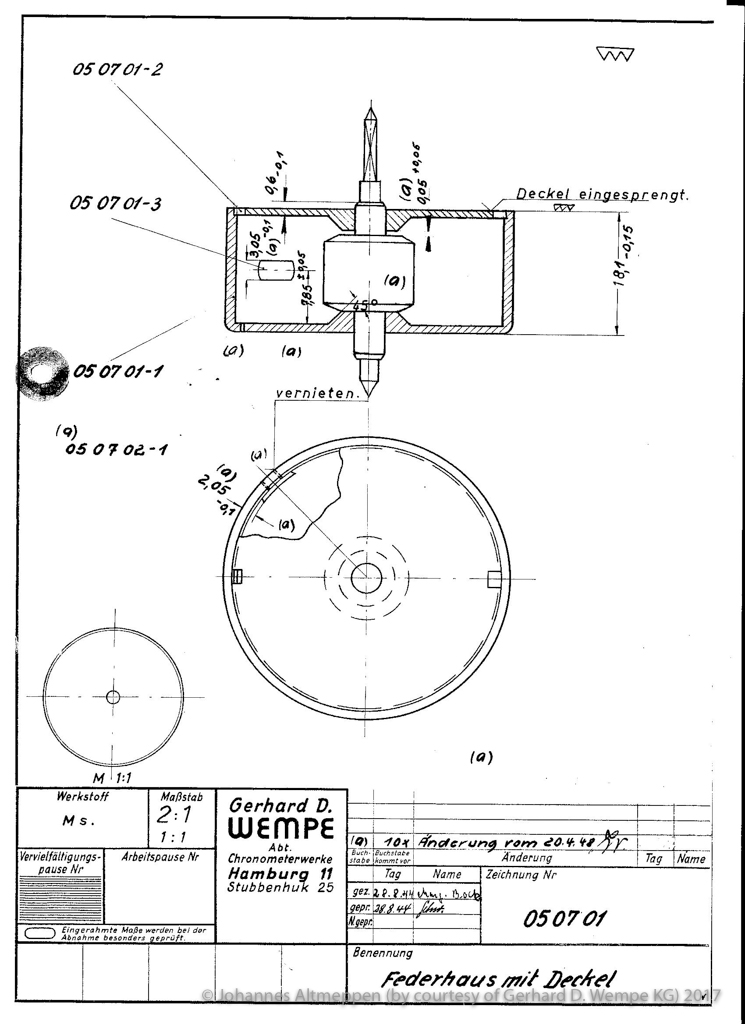
References/wempe/drawings/05-07/Wempe_05-07_04.jpg
