OrelMag/marine-chronometer-model/References/wempe/drawings/05-07/Wempe_05-07_05.jpg

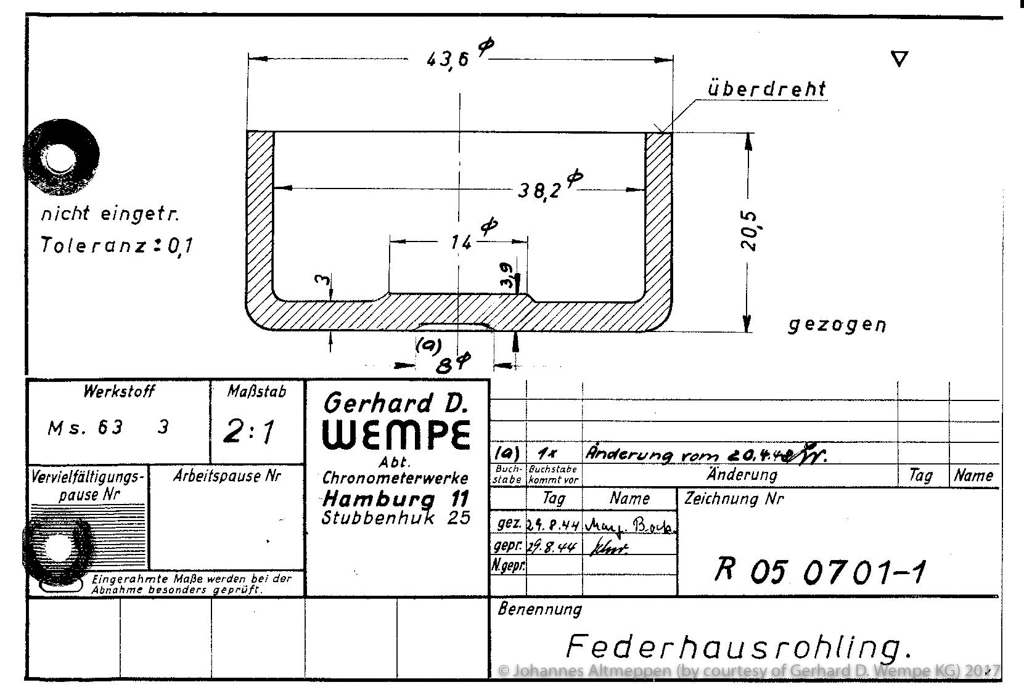
References/wempe/drawings/05-07/Wempe_05-07_05.jpg
