OrelMag/marine-chronometer-model/References/wempe/drawings/05-08/Wempe_05-08_30.jpg

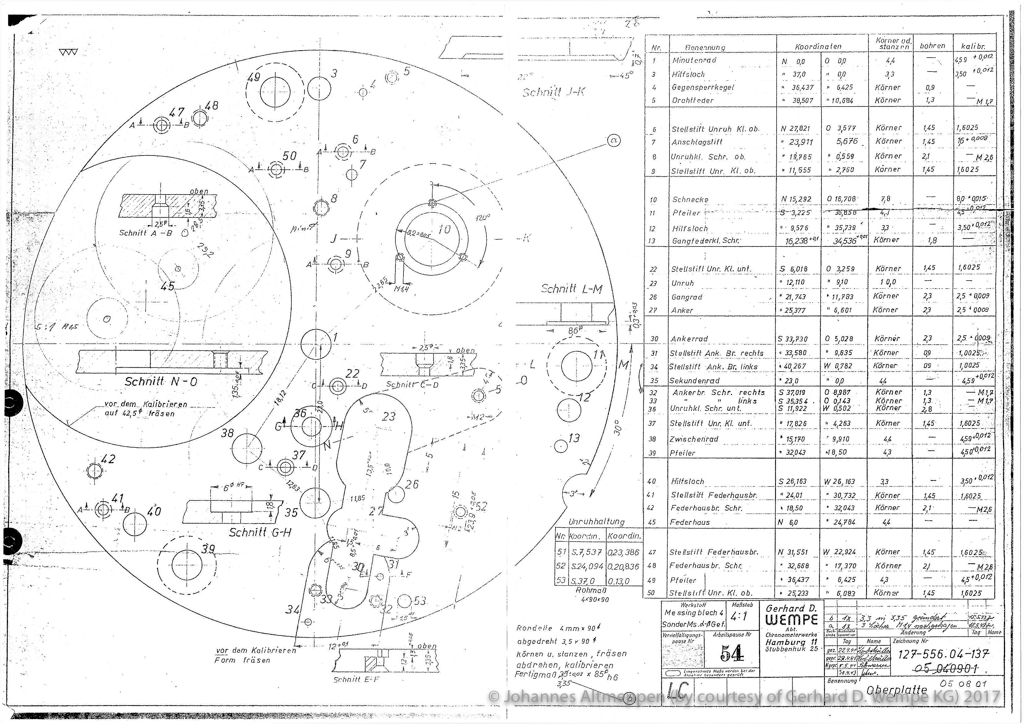
References/wempe/drawings/05-08/Wempe_05-08_30.jpg
