OrelMag/marine-chronometer-model/References/wempe/drawings/05-36/Wempe_05-36.jpg

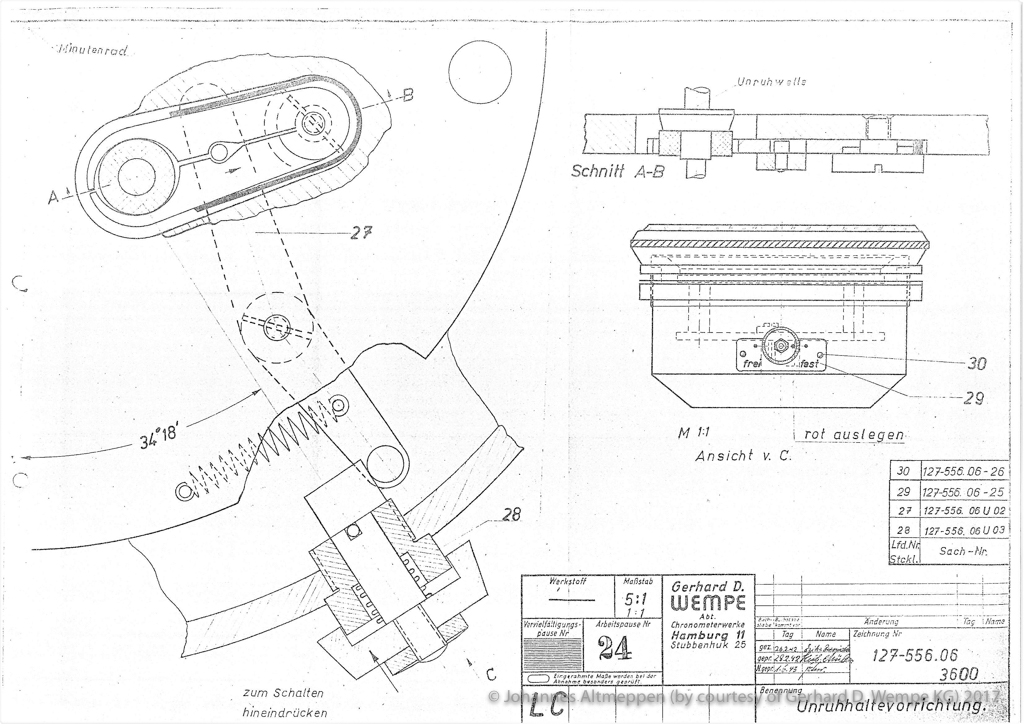
References/wempe/drawings/05-36/Wempe_05-36.jpg
