OrelMag/marine-chronometer-model/References/wempe/drawings/05-36/Wempe_05-36_2.jpg

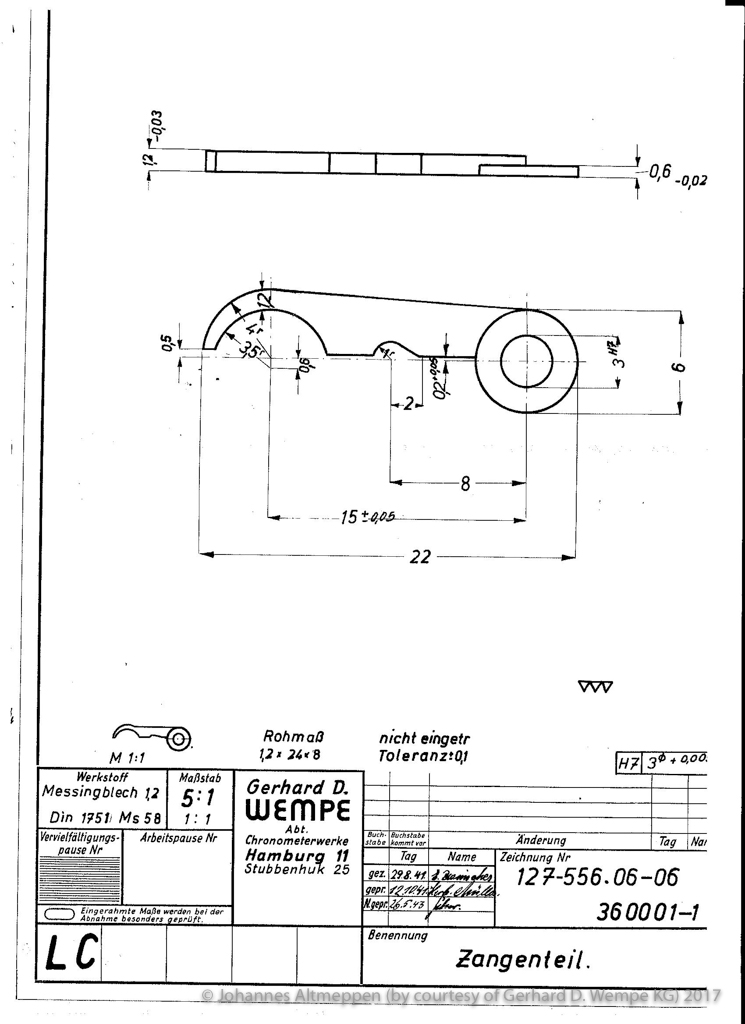
References/wempe/drawings/05-36/Wempe_05-36_2.jpg
