OrelMag/marine-chronometer-model/References/wempe/drawings/51-00/Wempe_51-00_3.jpg

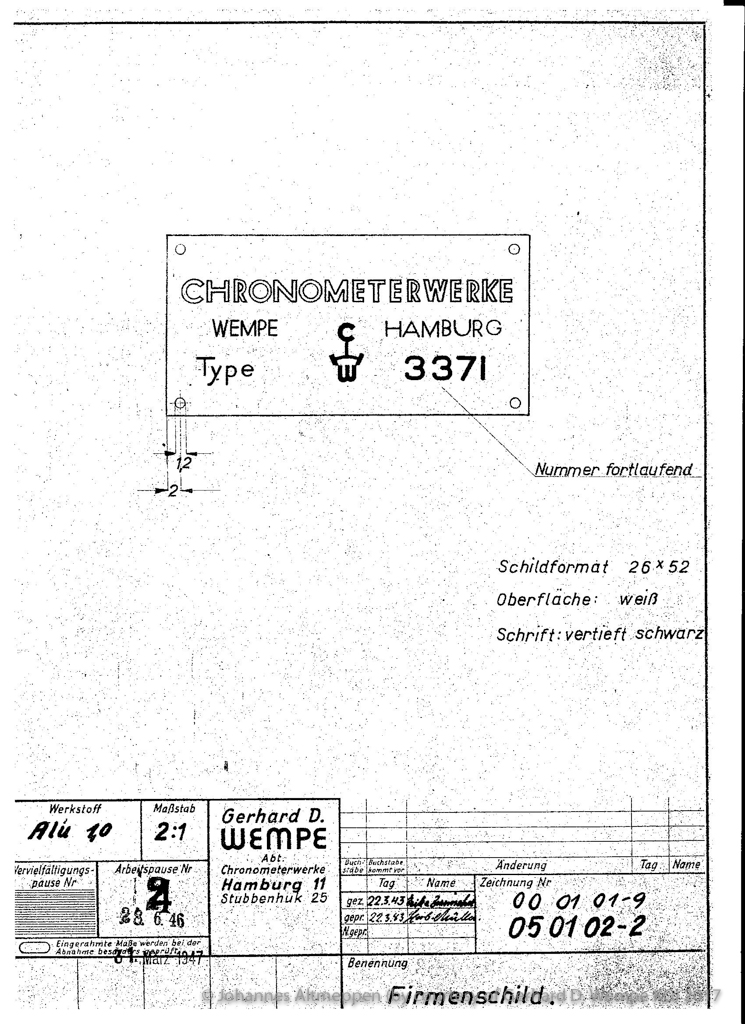
References/wempe/drawings/51-00/Wempe_51-00_3.jpg
