OrelMag/marine-chronometer-model/References/wempe/photos/auctions-museums/angerland_576_lange5591.jpg

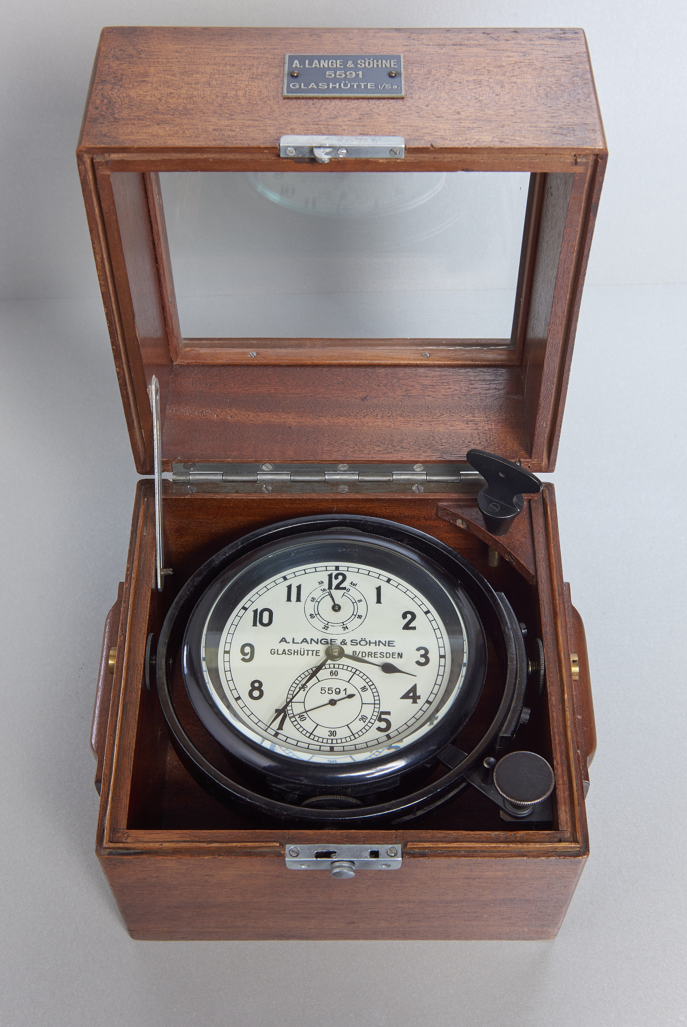
References/wempe/photos/auctions-museums/angerland_576_lange5591.jpg
