OrelMag/marine-chronometer-model/References/wempe/photos/auctions-museums/breker_306_lange5395_1.jpg

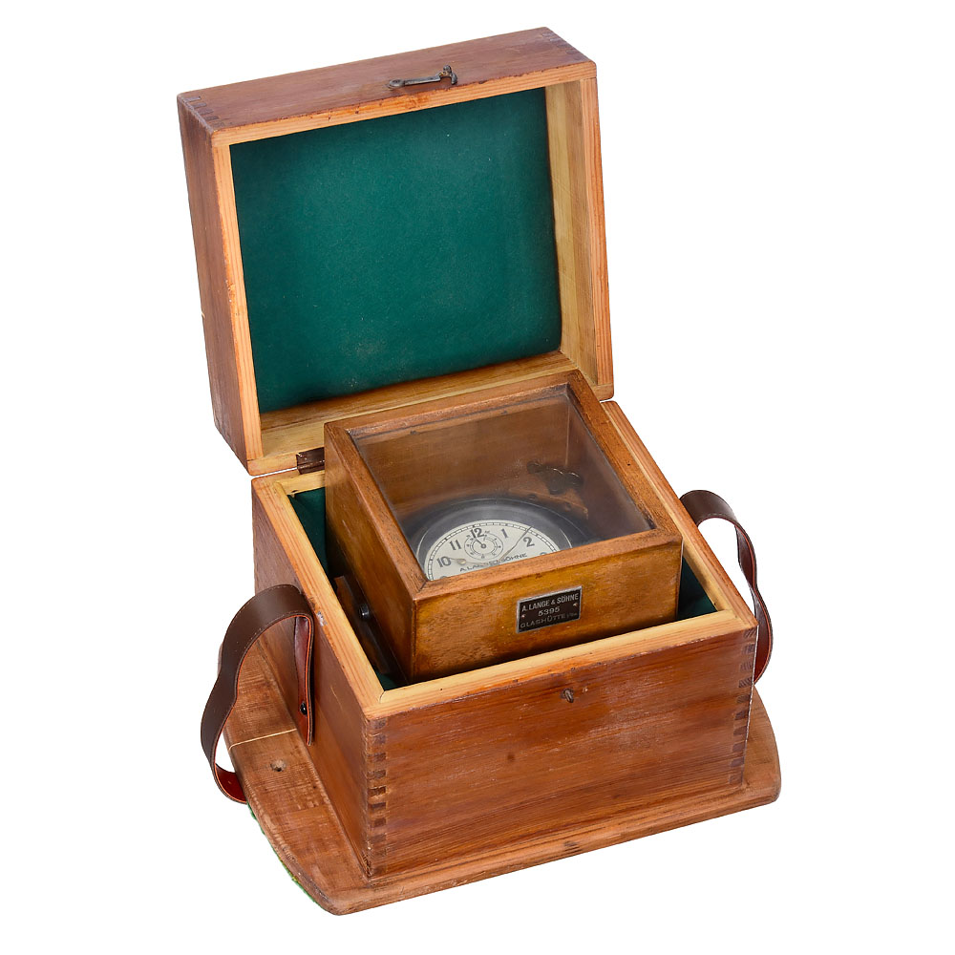
References/wempe/photos/auctions-museums/breker_306_lange5395_1.jpg
