OrelMag/marine-chronometer-model/References/wempe/photos/auctions-museums/drouot_33246921_langeVEB2285_5.jpg

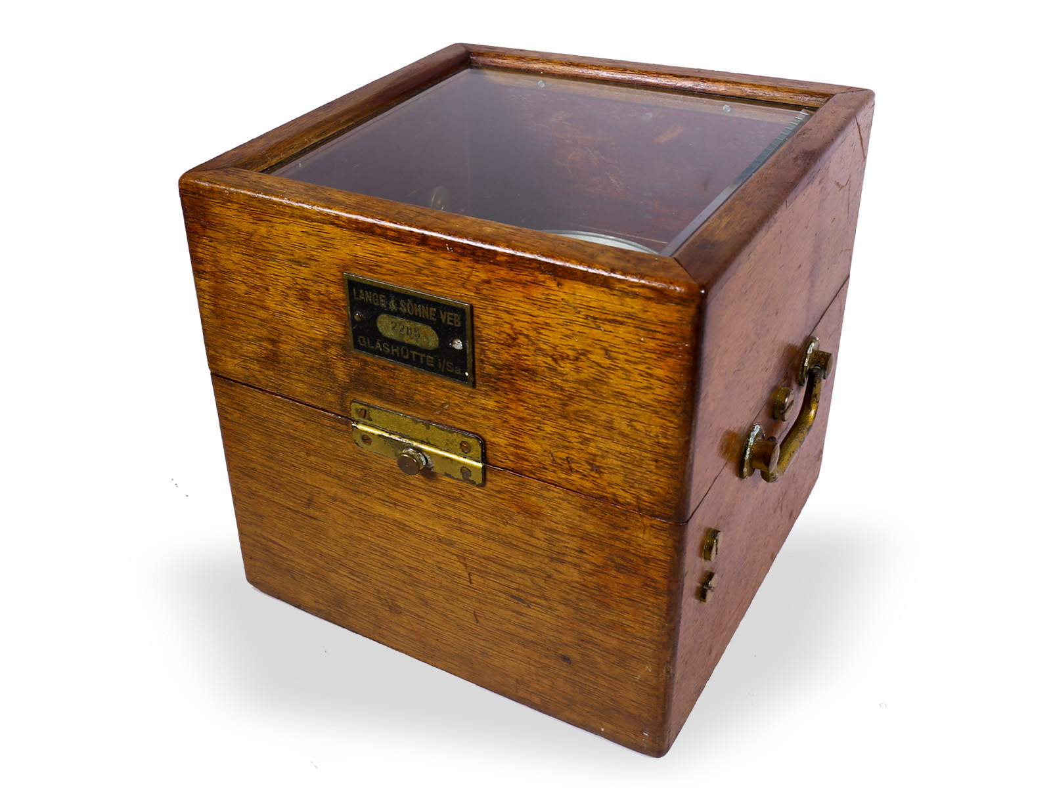
References/wempe/photos/auctions-museums/drouot_33246921_langeVEB2285_5.jpg
