OrelMag/marine-chronometer-model/References/wempe/photos/auctions-museums/drouot_33810142_lange1947_3.jpg

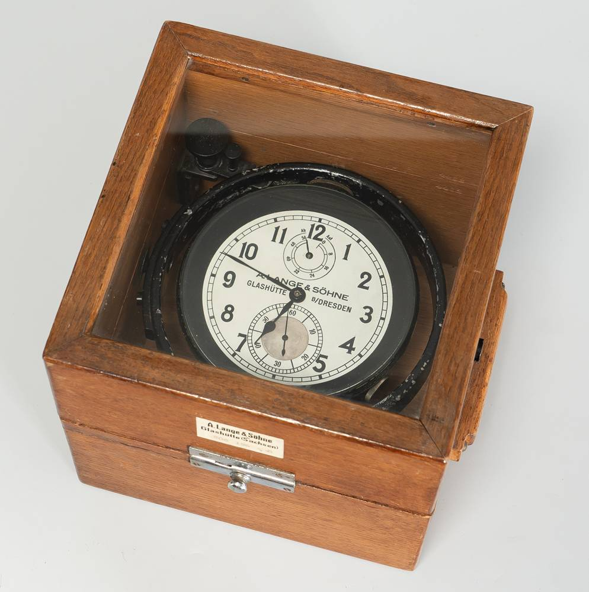
References/wempe/photos/auctions-museums/drouot_33810142_lange1947_3.jpg
