OrelMag/marine-chronometer-model/References/wempe/photos/auctions-museums/muser95-86_lange5373_2.jpg

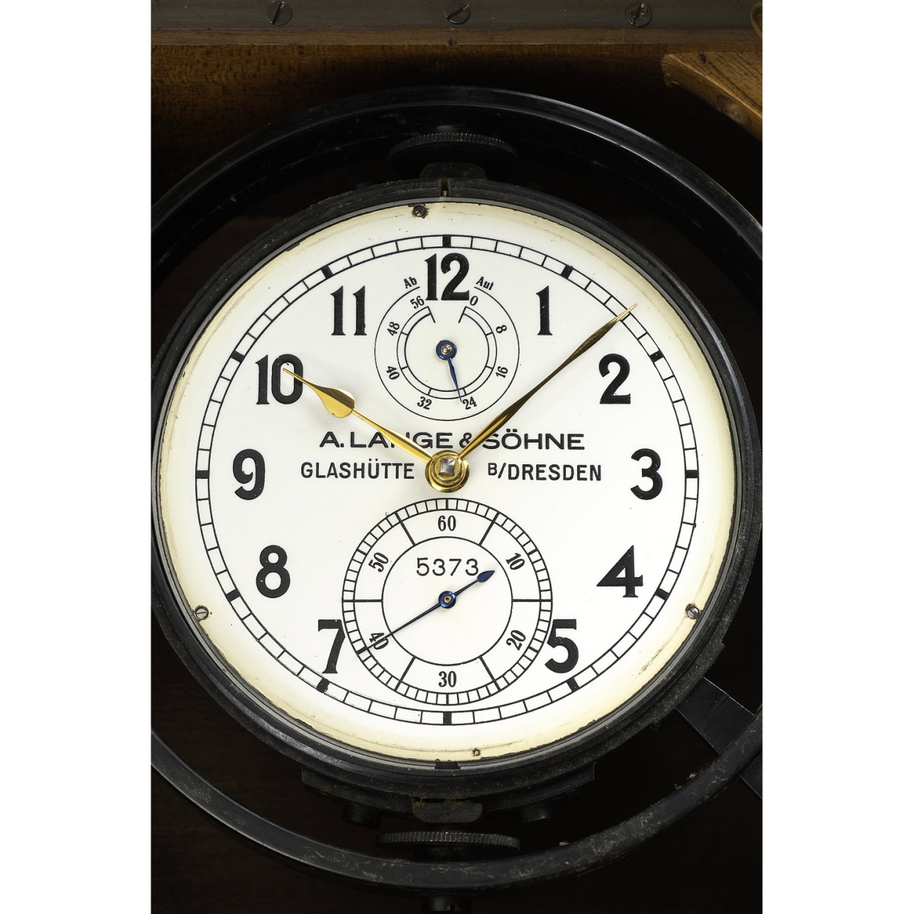
References/wempe/photos/auctions-museums/muser95-86_lange5373_2.jpg
