OrelMag/marine-chronometer-model/References/wempe/photos/auctions-museums/muser95-375_wempe2493_4.jpg

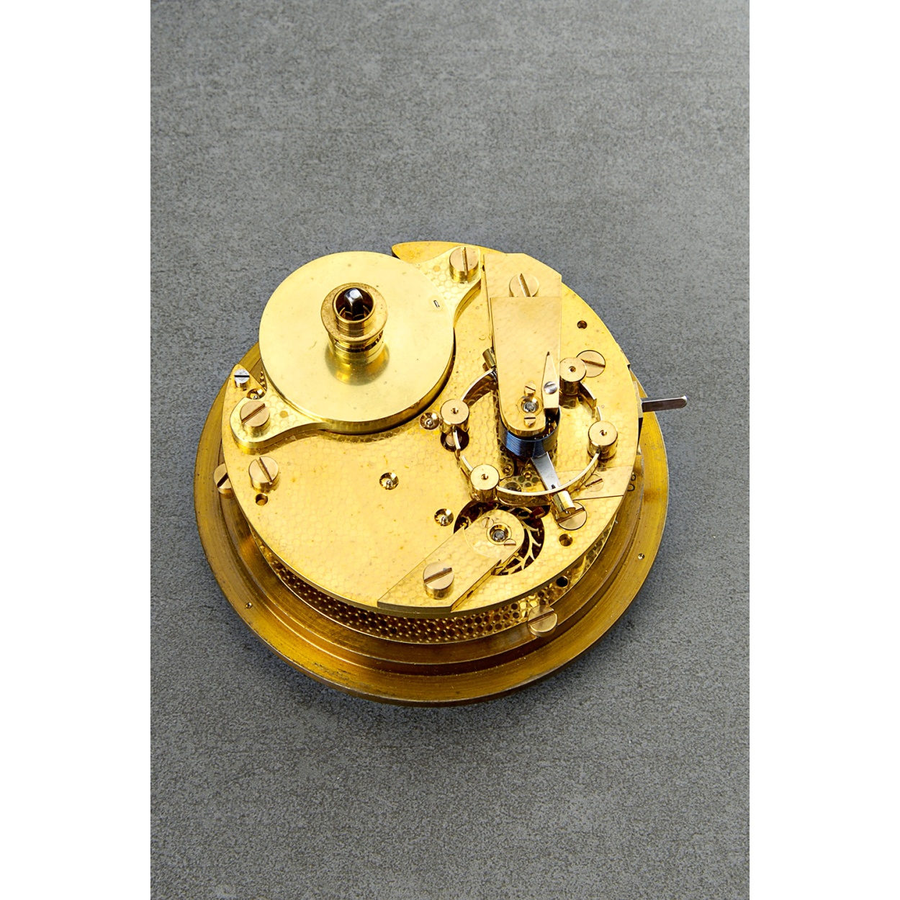
References/wempe/photos/auctions-museums/muser95-375_wempe2493_4.jpg
