OrelMag/marine-chronometer-model/References/wempe/photos/auctions-museums/muser96-250_lange5499_1.jpg

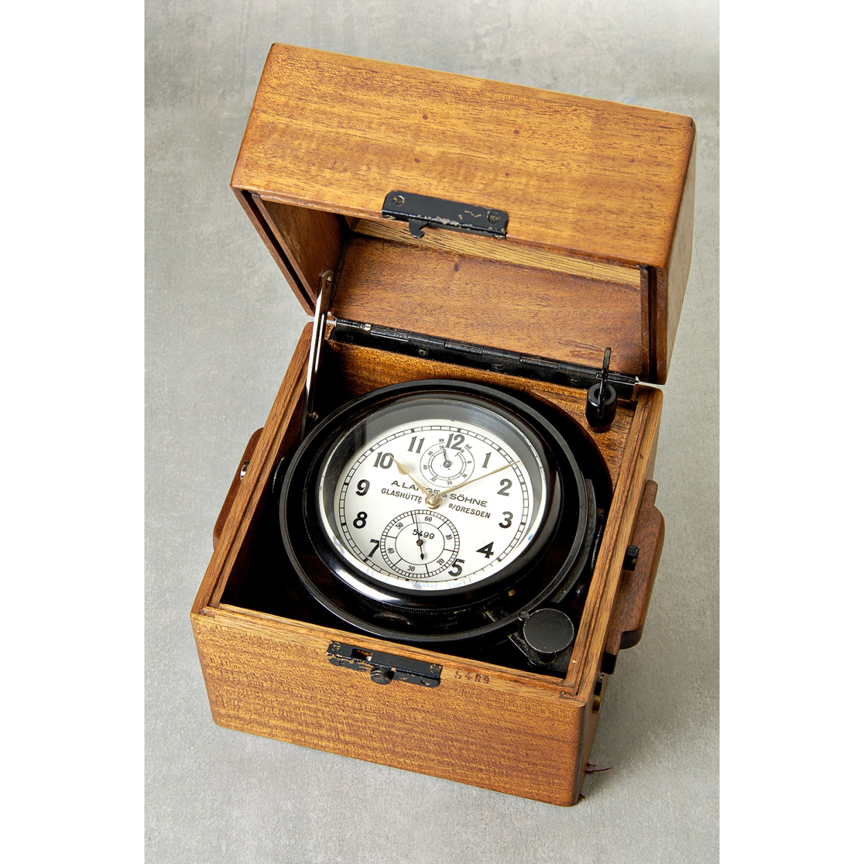
References/wempe/photos/auctions-museums/muser96-250_lange5499_1.jpg
