OrelMag/marine-chronometer-model/References/wempe/photos/auctions-museums/stahl_113507_lange_3.jpg

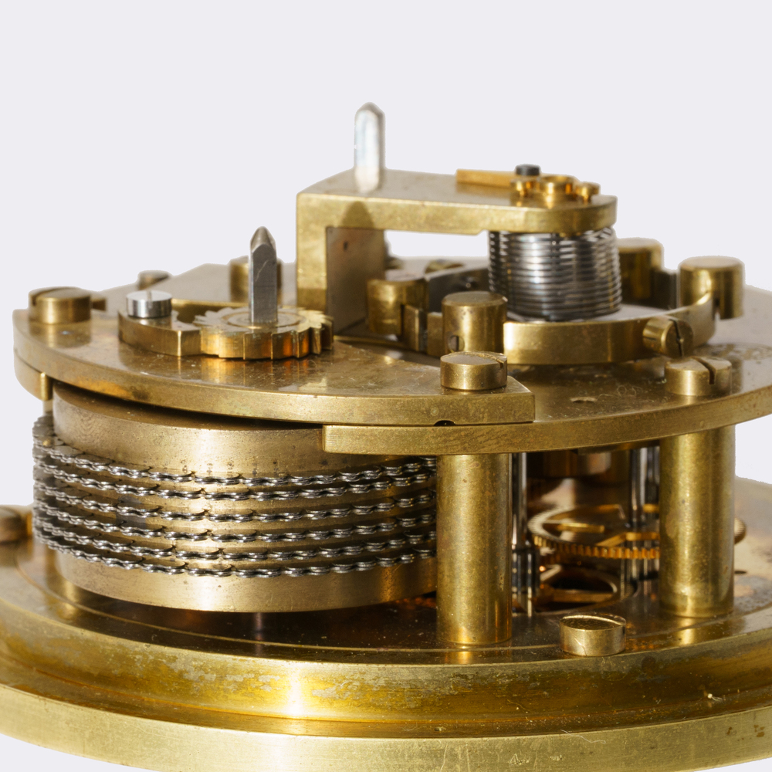
References/wempe/photos/auctions-museums/stahl_113507_lange_3.jpg
