OrelMag/marine-chronometer-model/References/wempe/photos/auctions-museums/uhrforum48468_lange5510.jpg

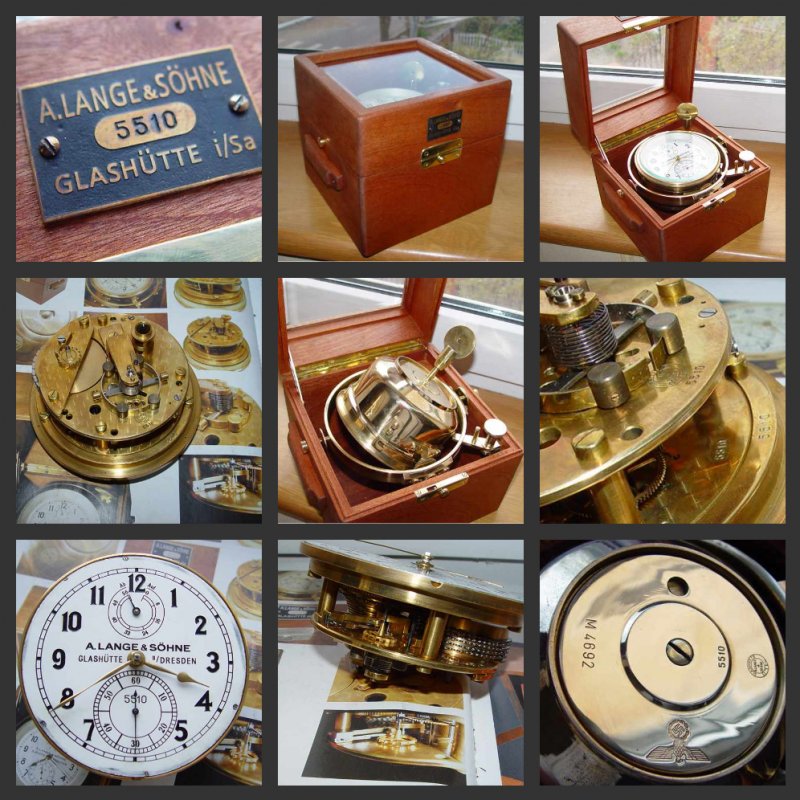
References/wempe/photos/auctions-museums/uhrforum48468_lange5510.jpg
