OrelMag/marine-chronometer-model/References/wempe/photos/auctions-museums/yahoo-c1247014958_lange567_1.jpg

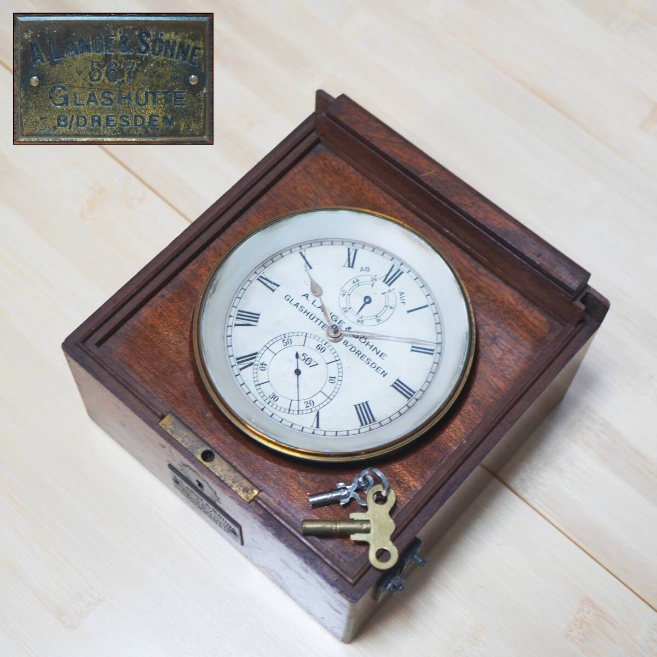
References/wempe/photos/auctions-museums/yahoo-c1247014958_lange567_1.jpg
