OrelMag/marine-chronometer-model/References/wempe/photos/auctions-museums/yahoo-n1232456864_wempe3053_3.jpg

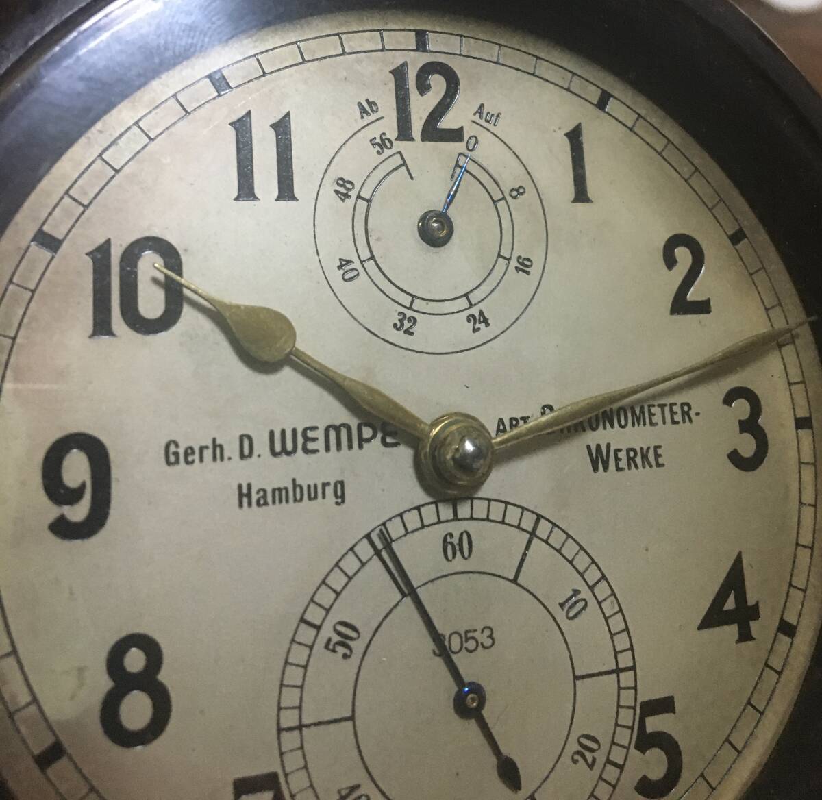
References/wempe/photos/auctions-museums/yahoo-n1232456864_wempe3053_3.jpg
