OrelMag/marine-chronometer-model/References/wempe/photos/chasy-ru-9985-kirova-14100/9D7A58D6-993E-4550-A561-86DF62ECFBD3.jpeg

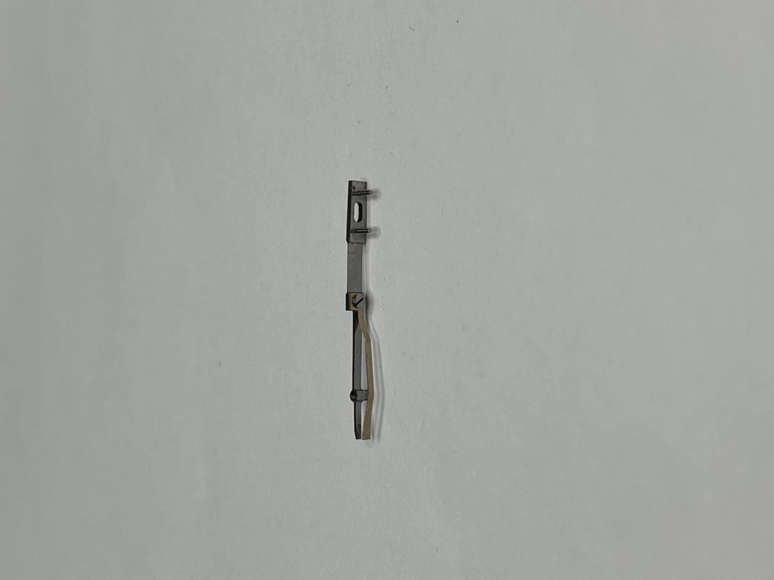
References/wempe/photos/chasy-ru-9985-kirova-14100/9D7A58D6-993E-4550-A561-86DF62ECFBD3.jpeg
