OrelMag/marine-chronometer-model/References/wempe/photos/chasy-ru-9985-kirova-14100/56956DF5-2DB4-4D37-8064-04B1474BEE1C.jpeg

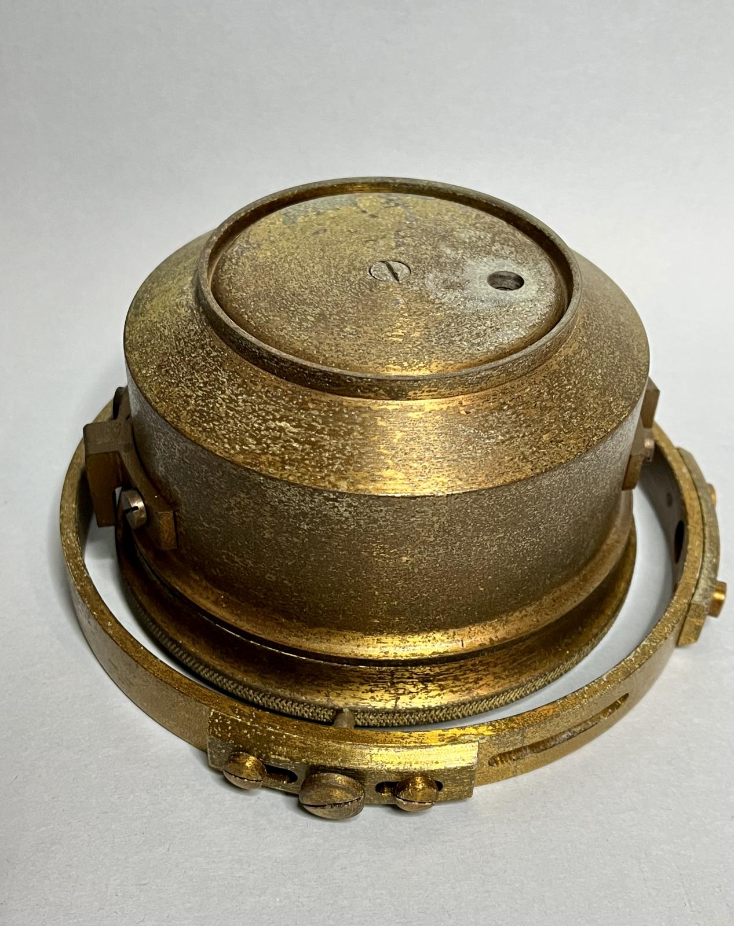
References/wempe/photos/chasy-ru-9985-kirova-14100/56956DF5-2DB4-4D37-8064-04B1474BEE1C.jpeg
