OrelMag/marine-chronometer-model/References/wempe/photos/chasy-ru-9985-kirova-14100/96890BF4-8EE4-45CE-B24B-BEBDDEC8872A.jpeg

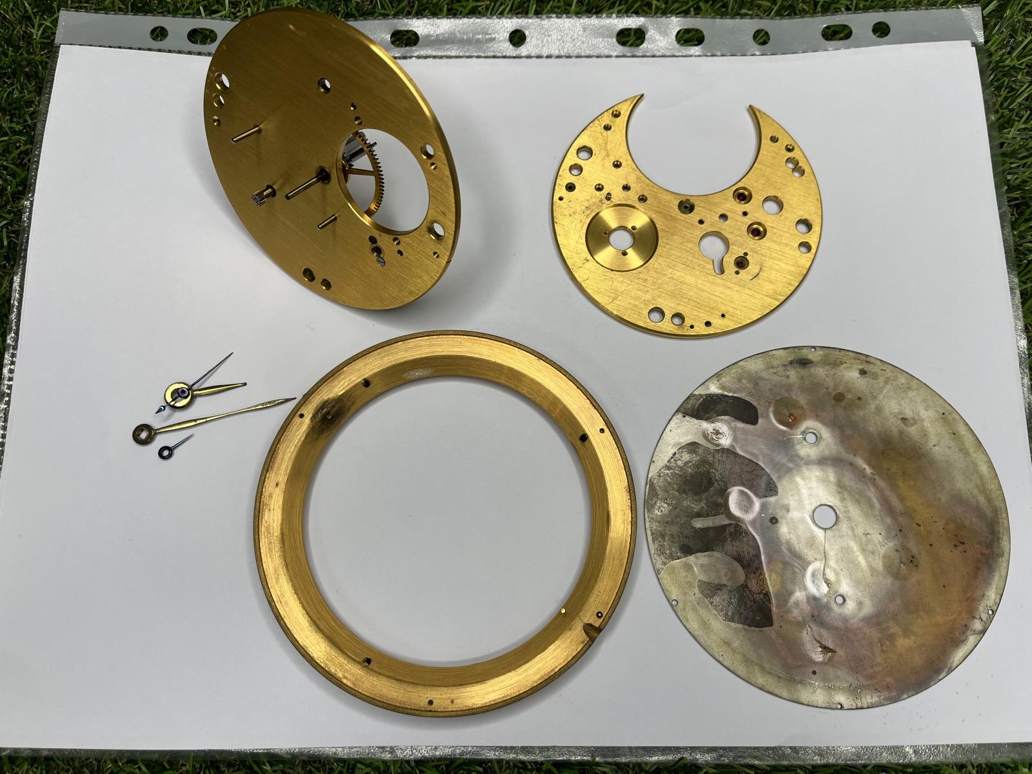
References/wempe/photos/chasy-ru-9985-kirova-14100/96890BF4-8EE4-45CE-B24B-BEBDDEC8872A.jpeg
