OrelMag/marine-chronometer-model/References/wempe/photos/dg-chrono-6mx-gallery/bilder-zum-6mx/1_Kirow_009_Z.jpg

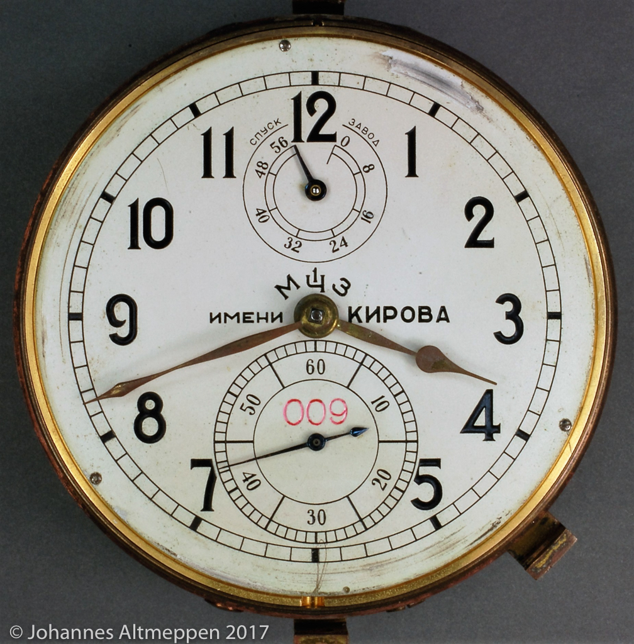
References/wempe/photos/dg-chrono-6mx-gallery/bilder-zum-6mx/1_Kirow_009_Z.jpg
