OrelMag/marine-chronometer-model/References/wempe/photos/dg-chrono-6mx-gallery/bilder-zum-6mx/1_Poljot_20027_Z.jpg

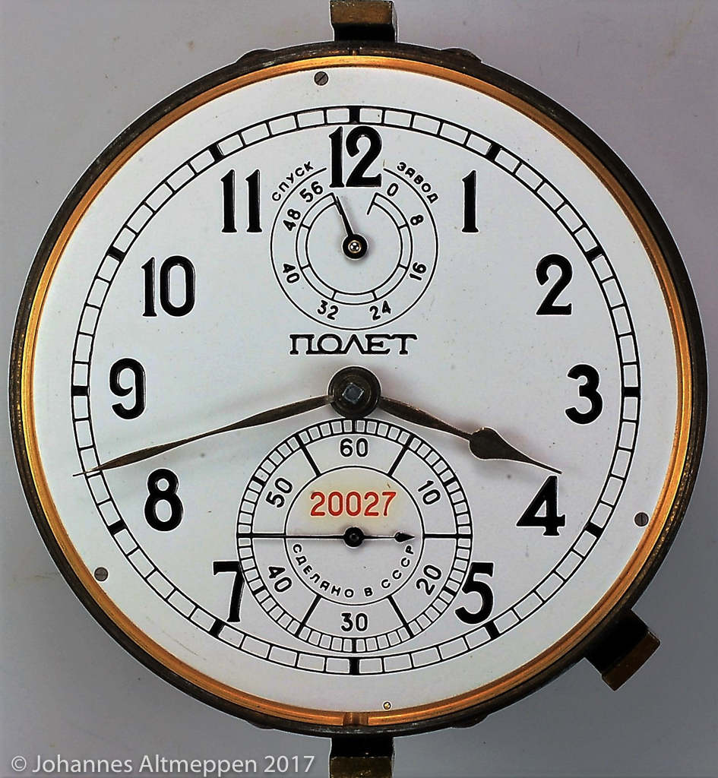
References/wempe/photos/dg-chrono-6mx-gallery/bilder-zum-6mx/1_Poljot_20027_Z.jpg
