OrelMag/marine-chronometer-model/References/wempe/photos/dg-chrono-6mx-gallery/bilder-zum-6mx/2_3_Kirow_707.jpg

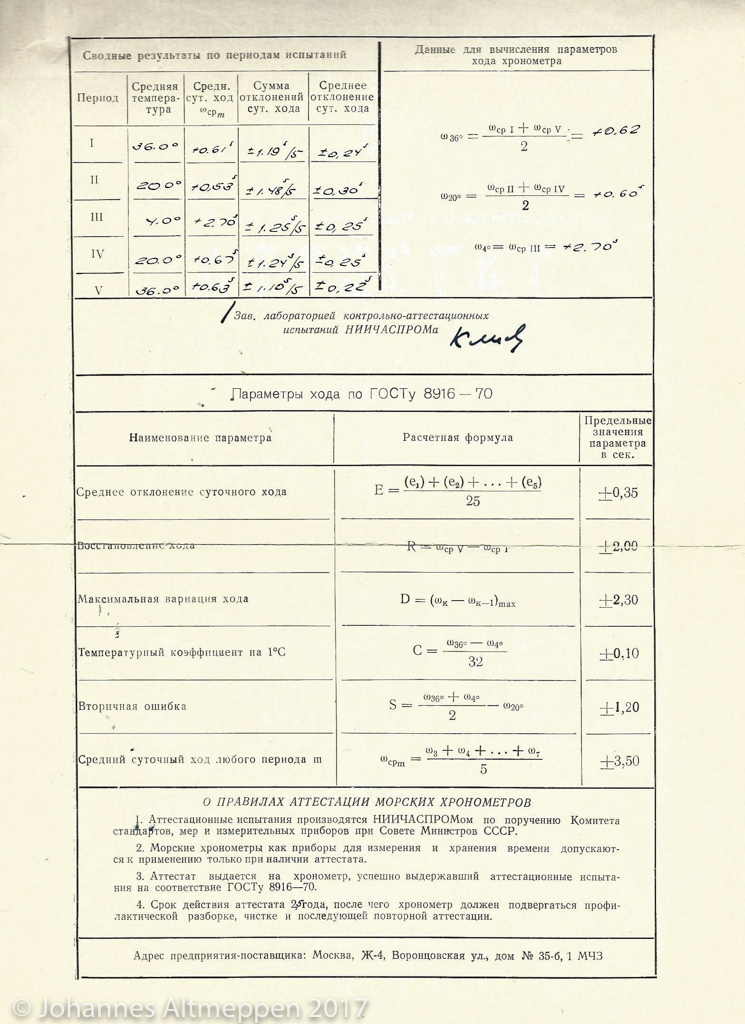
References/wempe/photos/dg-chrono-6mx-gallery/bilder-zum-6mx/2_3_Kirow_707.jpg
