OrelMag/marine-chronometer-model/References/wempe/photos/dg-chrono-6mx-gallery/bilder-zum-6mx/2_Kirow_91_Z_2.jpg

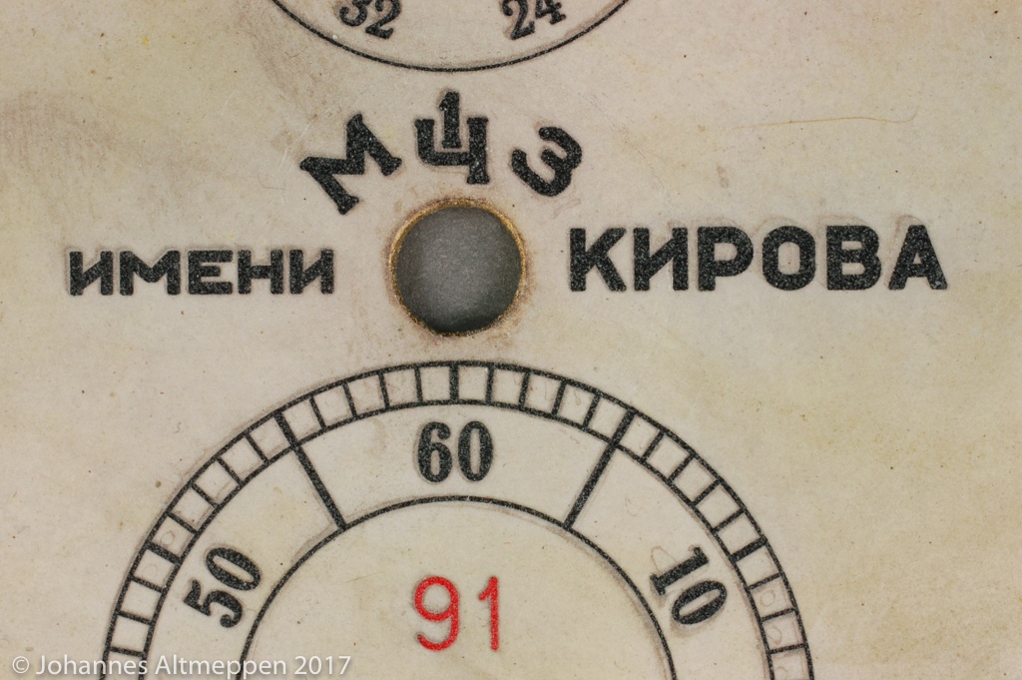
References/wempe/photos/dg-chrono-6mx-gallery/bilder-zum-6mx/2_Kirow_91_Z_2.jpg
