OrelMag/marine-chronometer-model/References/wempe/photos/dg-chrono-6mx-gallery/bilder-zum-6mx/2_Poljot_09218_A.jpg

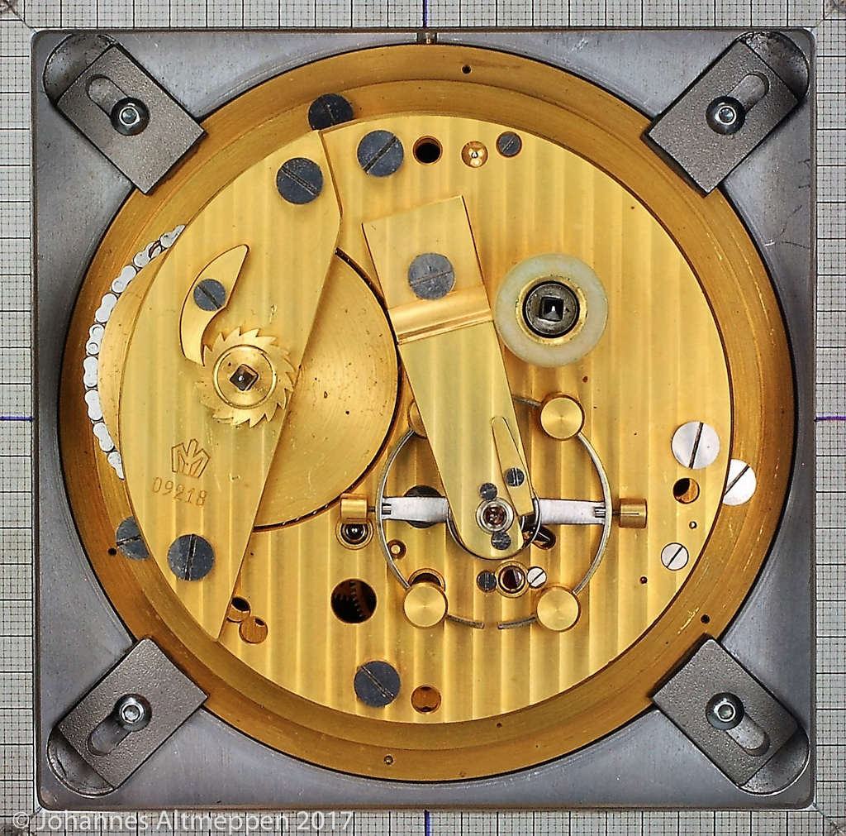
References/wempe/photos/dg-chrono-6mx-gallery/bilder-zum-6mx/2_Poljot_09218_A.jpg
