OrelMag/marine-chronometer-model/References/wempe/photos/dg-chrono-6mx-gallery/bilder-zum-6mx/2_Poljot_20027_A.jpg

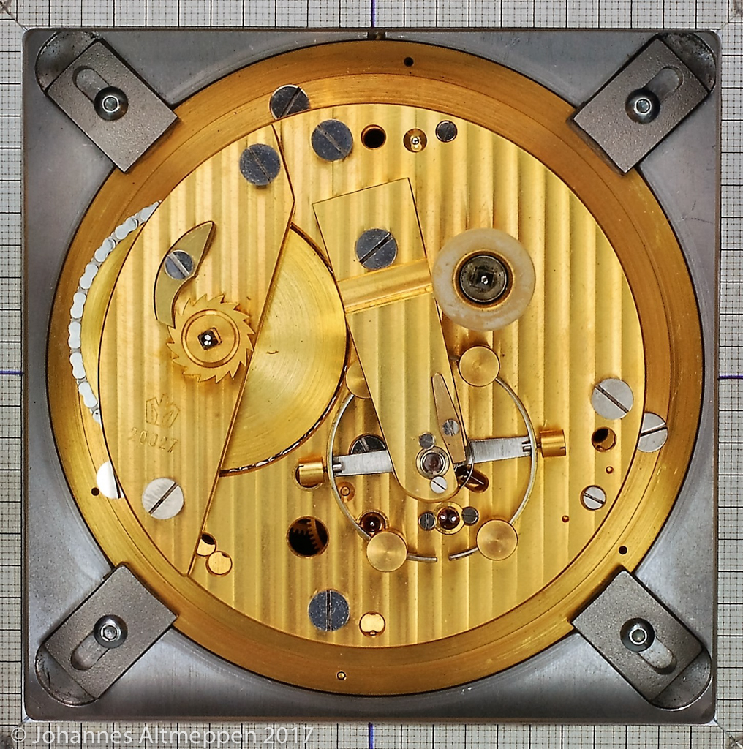
References/wempe/photos/dg-chrono-6mx-gallery/bilder-zum-6mx/2_Poljot_20027_A.jpg
