OrelMag/marine-chronometer-model/References/wempe/photos/dg-chrono-6mx-gallery/bilder-zum-6mx/3_3_Kirow_1564.jpg

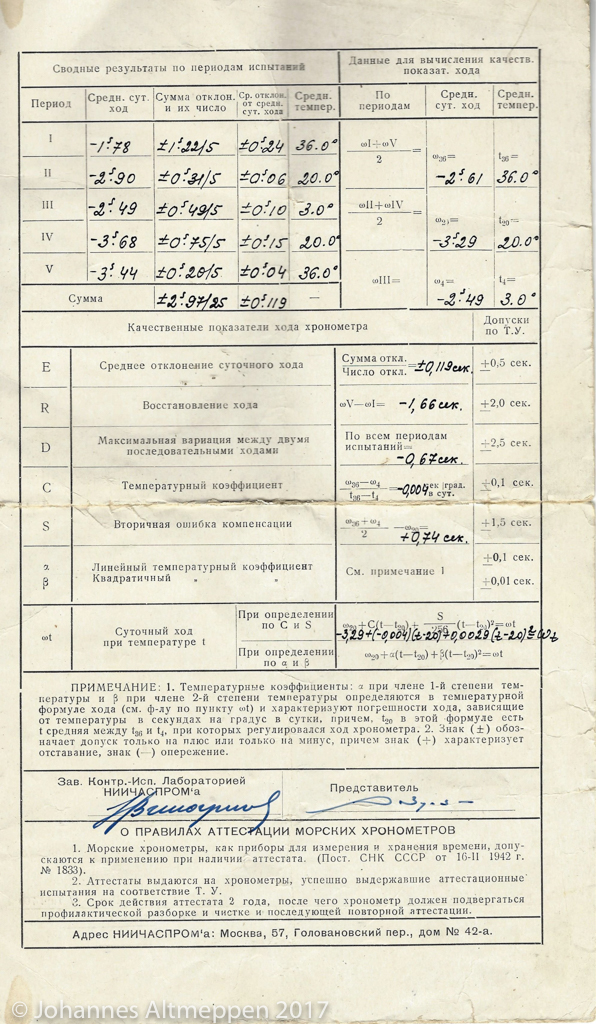
References/wempe/photos/dg-chrono-6mx-gallery/bilder-zum-6mx/3_3_Kirow_1564.jpg
