OrelMag/marine-chronometer-model/References/wempe/photos/dg-chrono-6mx-gallery/bilder-zum-6mx/3_Kirow_23239_uZ.jpg

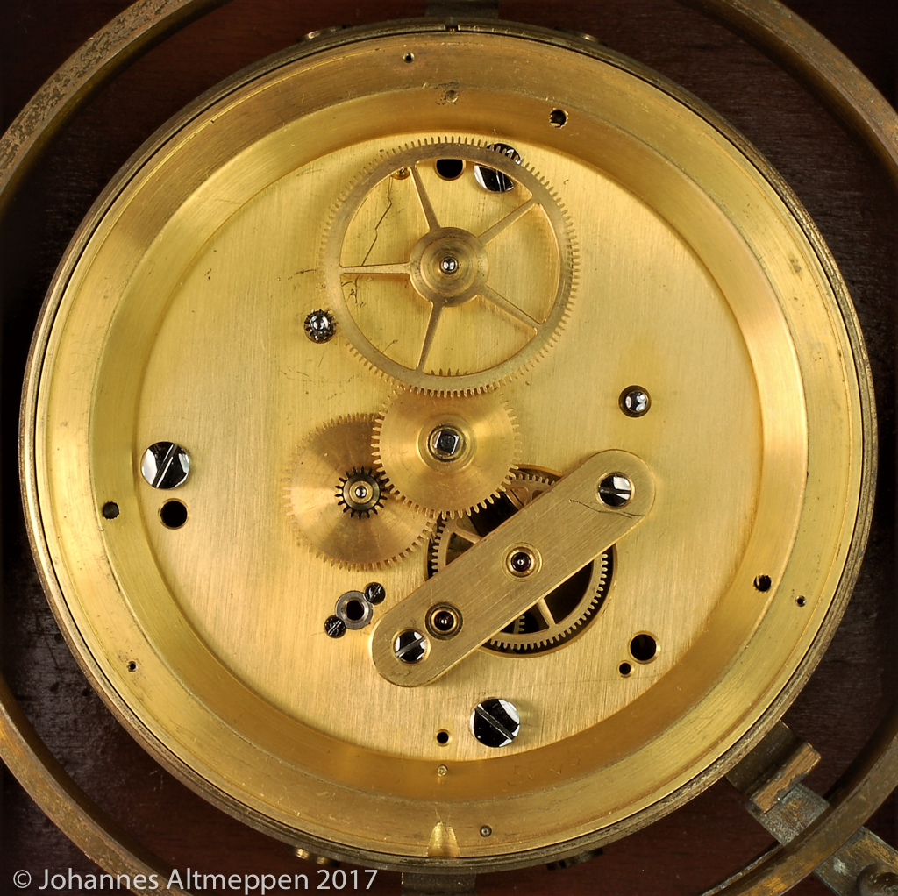
References/wempe/photos/dg-chrono-6mx-gallery/bilder-zum-6mx/3_Kirow_23239_uZ.jpg
