OrelMag/marine-chronometer-model/References/wempe/photos/dg-chrono-6mx-gallery/bilder-zum-6mx/3_Plojot_20027_uZ.jpg

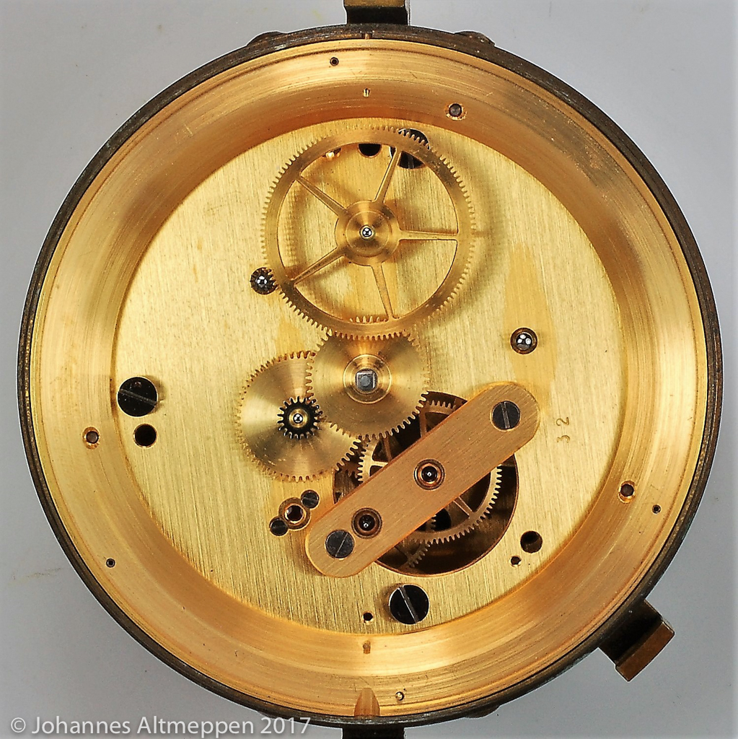
References/wempe/photos/dg-chrono-6mx-gallery/bilder-zum-6mx/3_Plojot_20027_uZ.jpg
