OrelMag/marine-chronometer-model/References/wempe/photos/dg-chrono-6mx-gallery/bilder-zum-6mx/3_Poljot_09218_uZ.jpg

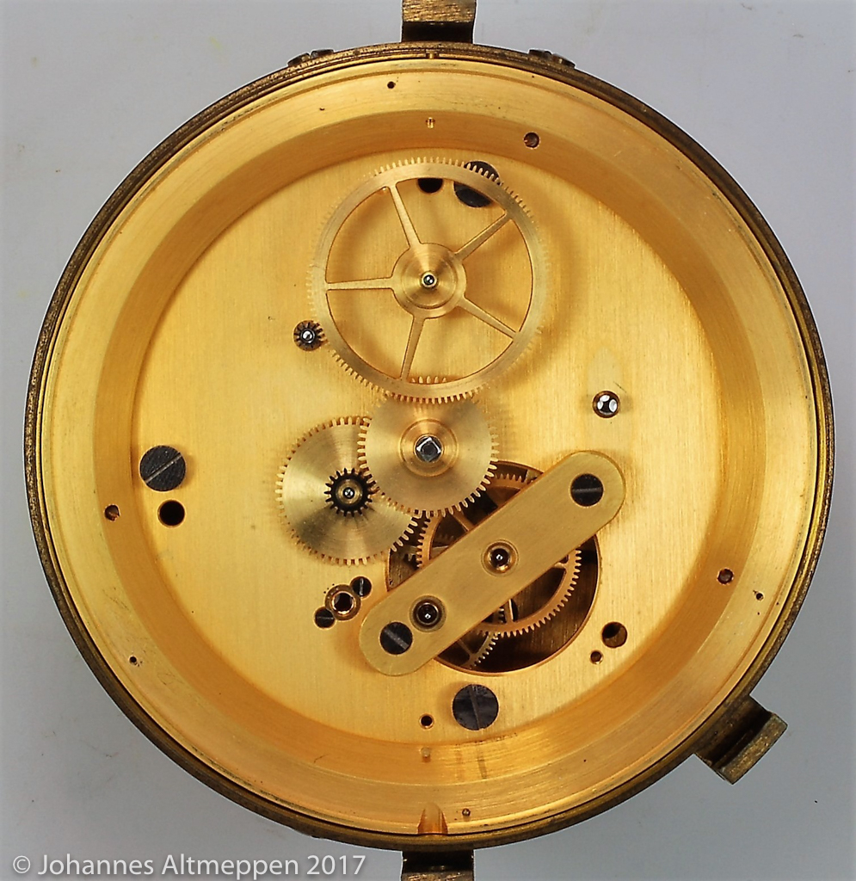
References/wempe/photos/dg-chrono-6mx-gallery/bilder-zum-6mx/3_Poljot_09218_uZ.jpg
