OrelMag/marine-chronometer-model/References/wempe/photos/dg-chrono-6mx-gallery/bilder-zum-6mx/4_2_Kirow_22823.jpg

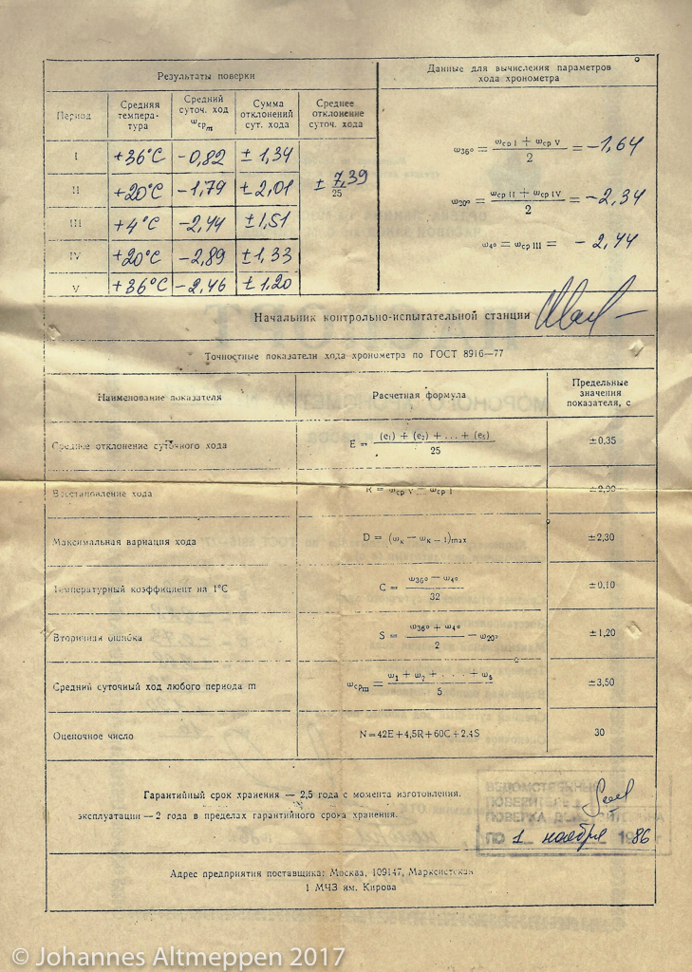
References/wempe/photos/dg-chrono-6mx-gallery/bilder-zum-6mx/4_2_Kirow_22823.jpg
