OrelMag/marine-chronometer-model/References/wempe/photos/dg-chrono-6mx-gallery/bilder-zum-6mx/4_Kirow_92-N(1).jpg

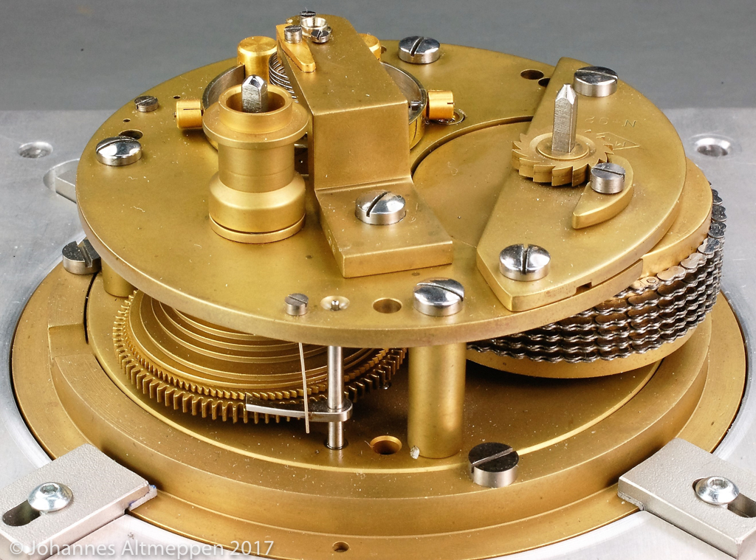
References/wempe/photos/dg-chrono-6mx-gallery/bilder-zum-6mx/4_Kirow_92-N(1).jpg
