OrelMag/marine-chronometer-model/References/wempe/photos/dg-chrono-6mx-gallery/bilder-zum-6mx/4_Kirow_2973_N.jpg

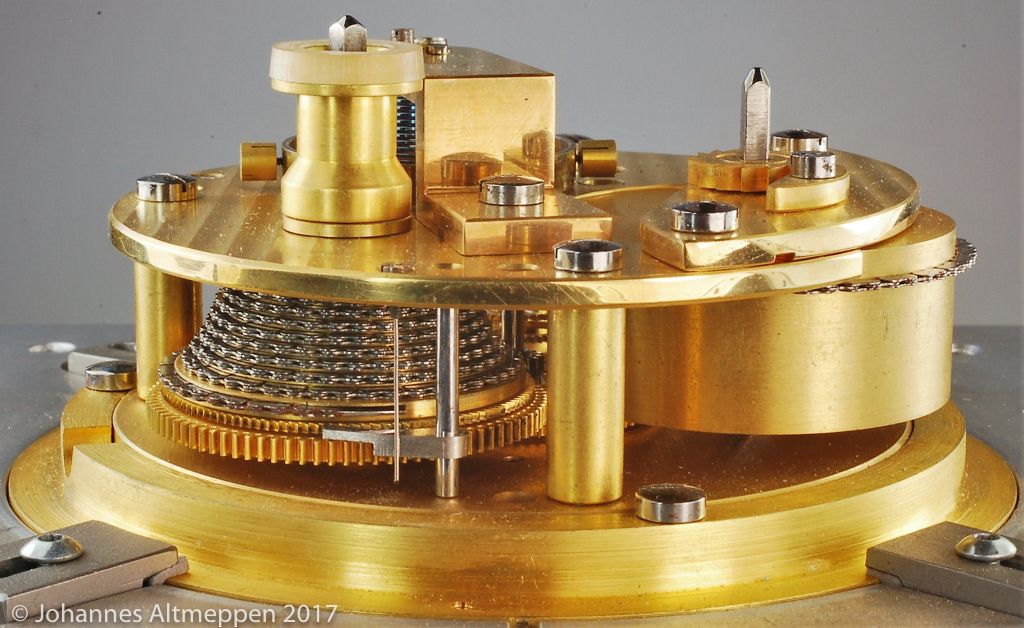
References/wempe/photos/dg-chrono-6mx-gallery/bilder-zum-6mx/4_Kirow_2973_N.jpg
