OrelMag/marine-chronometer-model/References/wempe/photos/dg-chrono-6mx-gallery/bilder-zum-6mx/4_Poljot_09218_N.jpg

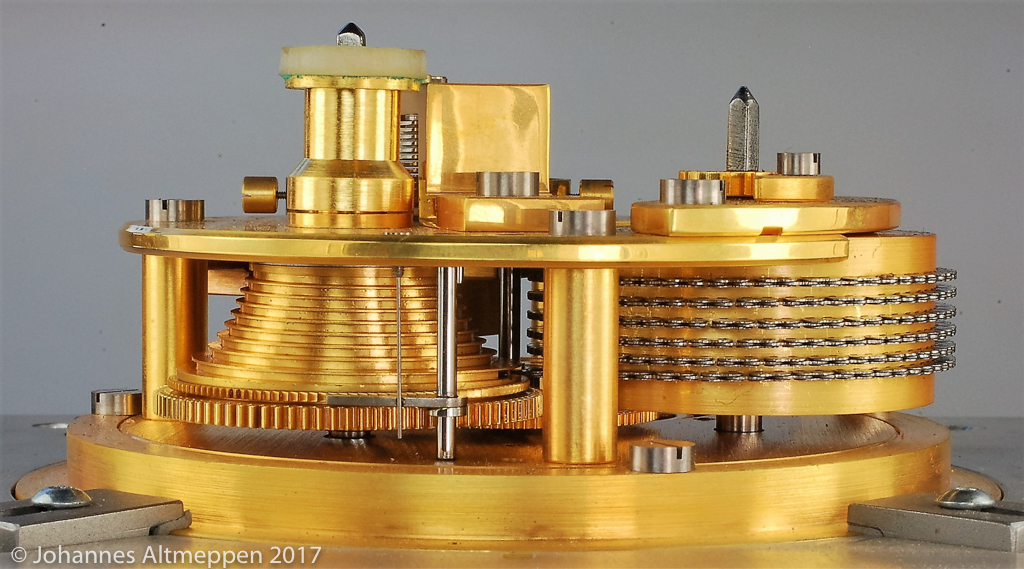
References/wempe/photos/dg-chrono-6mx-gallery/bilder-zum-6mx/4_Poljot_09218_N.jpg
