OrelMag/marine-chronometer-model/References/wempe/photos/dg-chrono-6mx-gallery/bilder-zum-6mx/5_2_Poljot_09218.jpg

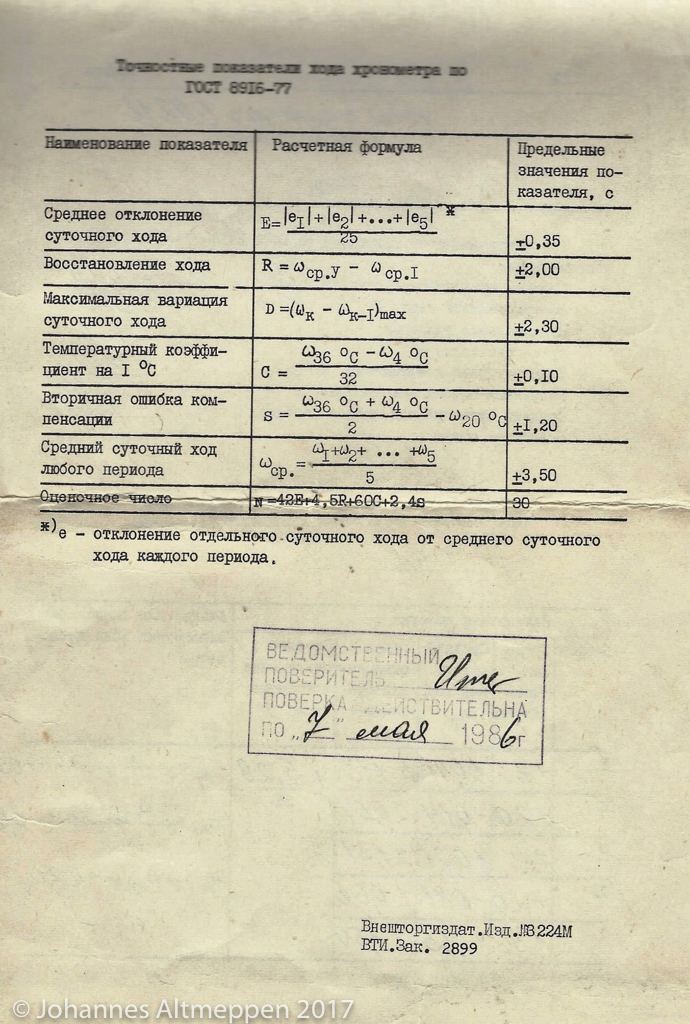
References/wempe/photos/dg-chrono-6mx-gallery/bilder-zum-6mx/5_2_Poljot_09218.jpg
