OrelMag/marine-chronometer-model/References/wempe/photos/dg-chrono-6mx-gallery/bilder-zum-6mx/5_Kirow_22823_O.jpg

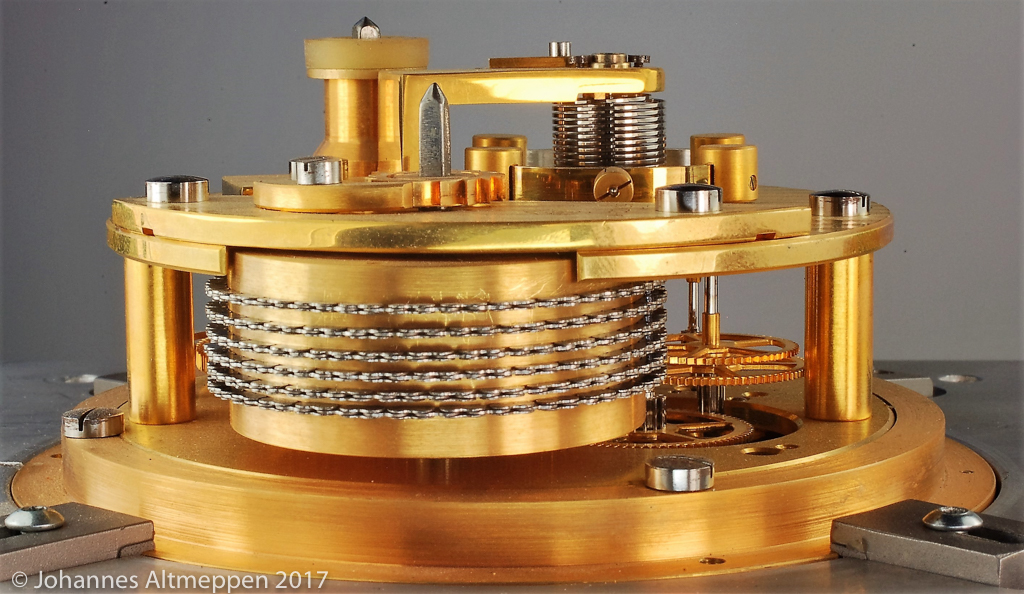
References/wempe/photos/dg-chrono-6mx-gallery/bilder-zum-6mx/5_Kirow_22823_O.jpg
