OrelMag/marine-chronometer-model/References/wempe/photos/dg-chrono-6mx-gallery/bilder-zum-6mx/6_2_Poljot_20027.jpg

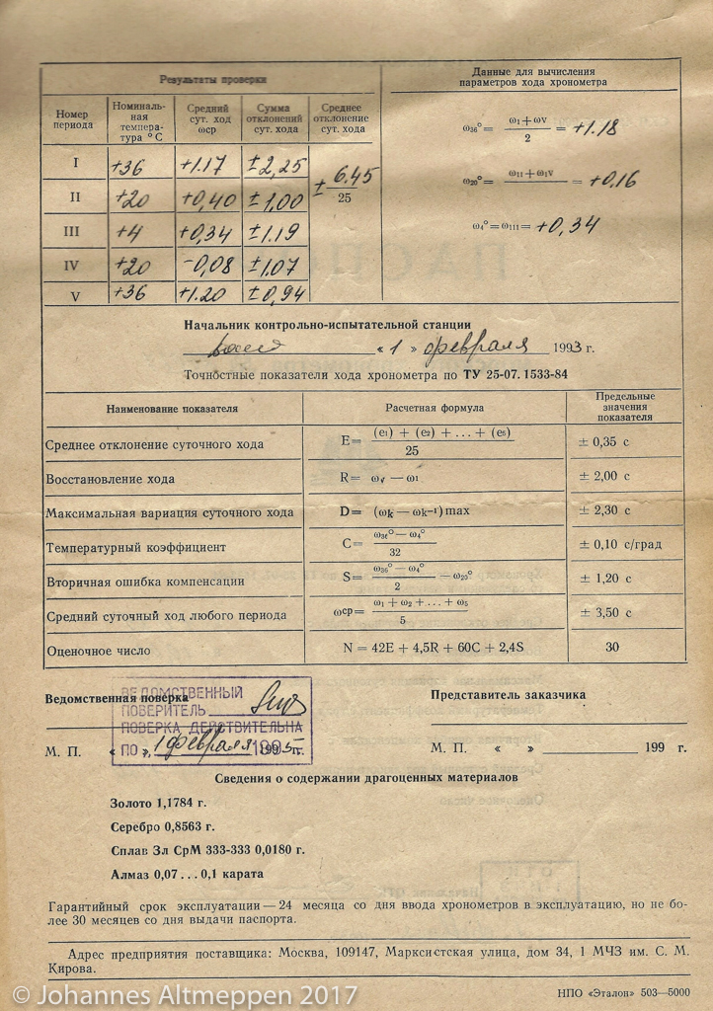
References/wempe/photos/dg-chrono-6mx-gallery/bilder-zum-6mx/6_2_Poljot_20027.jpg
