OrelMag/marine-chronometer-model/References/wempe/photos/dg-chrono-6mx-gallery/bilder-zum-6mx/6_Kirow_92-S(1).jpg

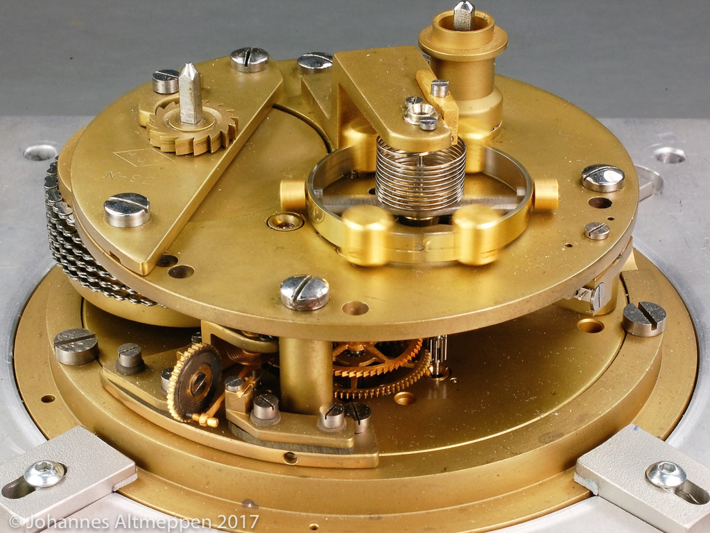
References/wempe/photos/dg-chrono-6mx-gallery/bilder-zum-6mx/6_Kirow_92-S(1).jpg
