OrelMag/marine-chronometer-model/References/wempe/photos/dg-chrono-6mx-gallery/bilder-zum-6mx/6_Kirow_23239_S.jpg

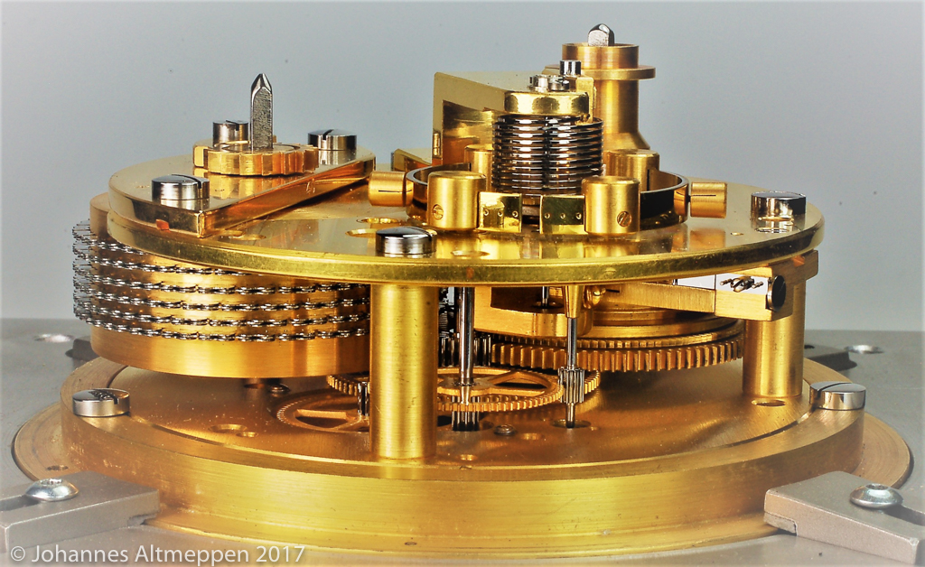
References/wempe/photos/dg-chrono-6mx-gallery/bilder-zum-6mx/6_Kirow_23239_S.jpg
