OrelMag/marine-chronometer-model/References/wempe/photos/dg-chrono-6mx-gallery/bilder-zum-6mx/6_Poljot_00127_S.jpg

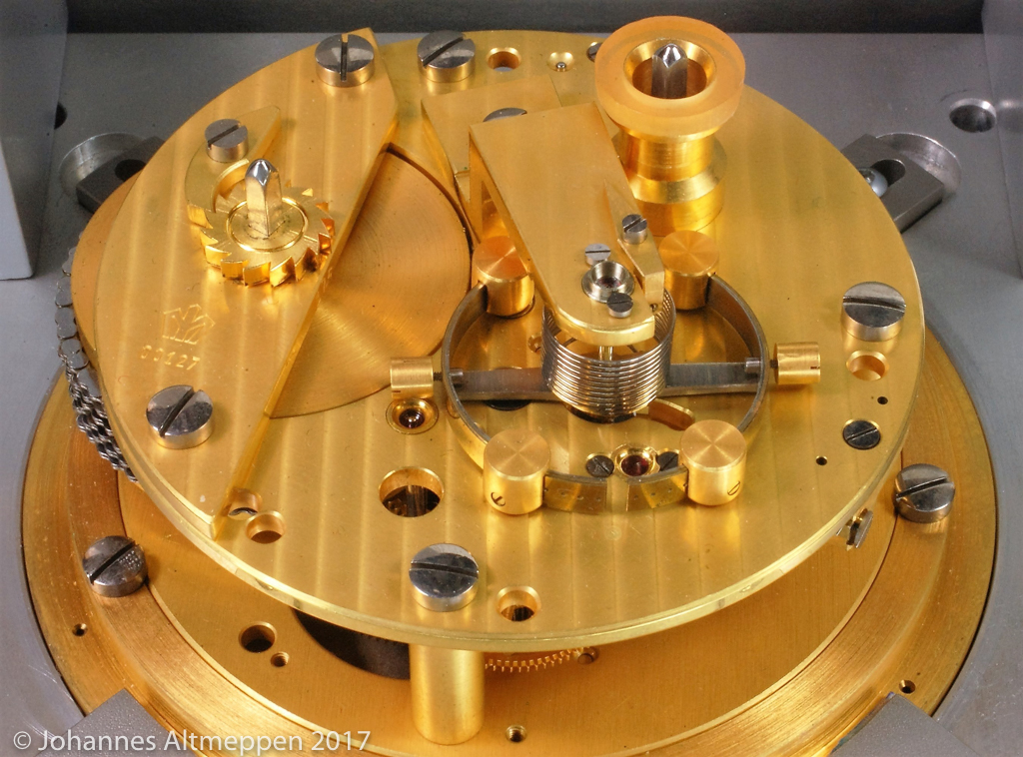
References/wempe/photos/dg-chrono-6mx-gallery/bilder-zum-6mx/6_Poljot_00127_S.jpg
