OrelMag/marine-chronometer-model/References/wempe/photos/dg-chrono-6mx-gallery/bilder-zum-6mx/7_Kirow_91_S.jpg

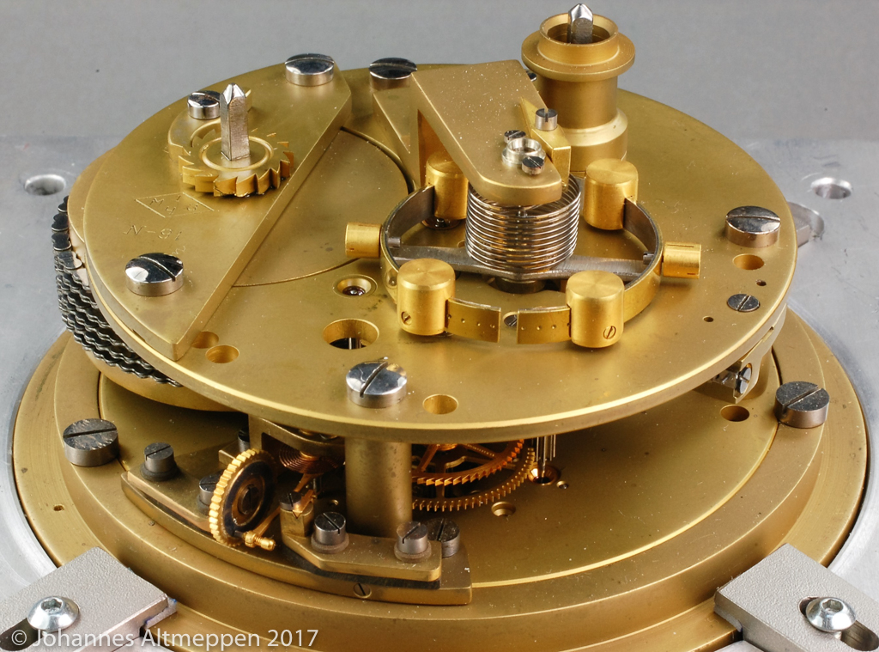
References/wempe/photos/dg-chrono-6mx-gallery/bilder-zum-6mx/7_Kirow_91_S.jpg
