OrelMag/marine-chronometer-model/References/wempe/photos/dg-chrono-6mx-gallery/bilder-zum-6mx/7_Poljot_08479_W.jpg

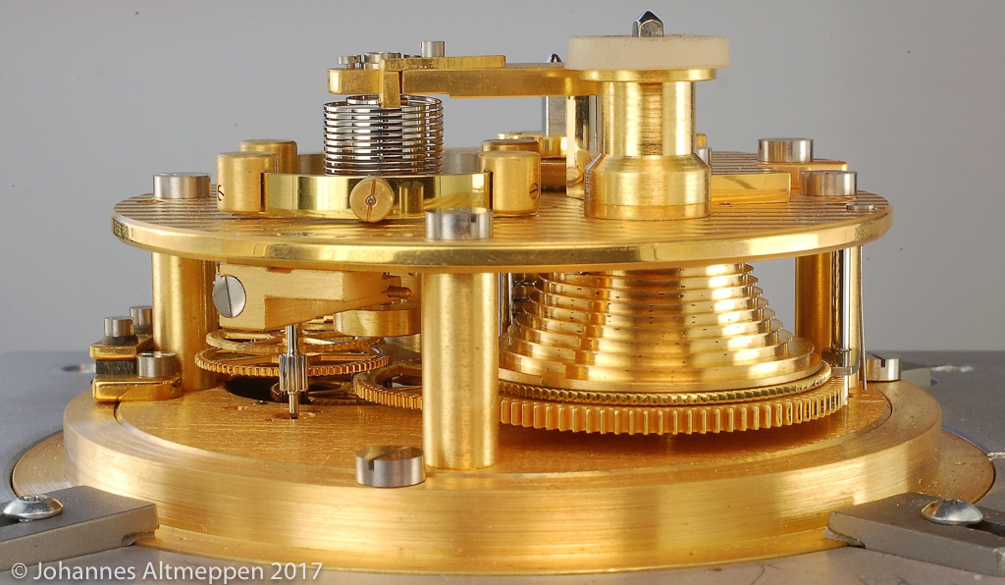
References/wempe/photos/dg-chrono-6mx-gallery/bilder-zum-6mx/7_Poljot_08479_W.jpg
