OrelMag/marine-chronometer-model/References/wempe/photos/dg-chrono-6mx-gallery/bilder-zum-6mx/8_2_Kirow_92.jpg

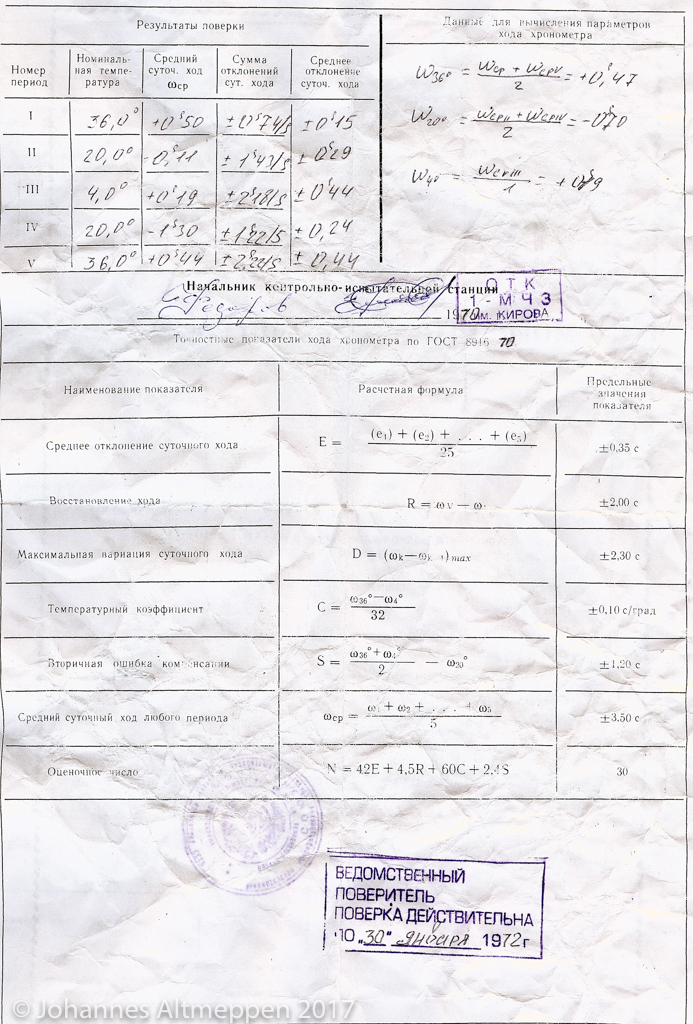
References/wempe/photos/dg-chrono-6mx-gallery/bilder-zum-6mx/8_2_Kirow_92.jpg
