OrelMag/marine-chronometer-model/References/wempe/photos/dg-chrono-6mx-gallery/bilder-zum-6mx/8_Kirow_22823_Feder.jpg

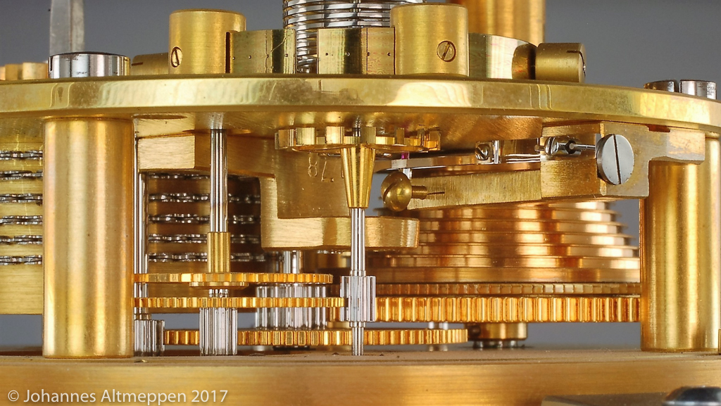
References/wempe/photos/dg-chrono-6mx-gallery/bilder-zum-6mx/8_Kirow_22823_Feder.jpg
