OrelMag/marine-chronometer-model/References/wempe/photos/dg-chrono-6mx-gallery/bilder-zum-6mx/8_Poljot_00127_Feder.jpg

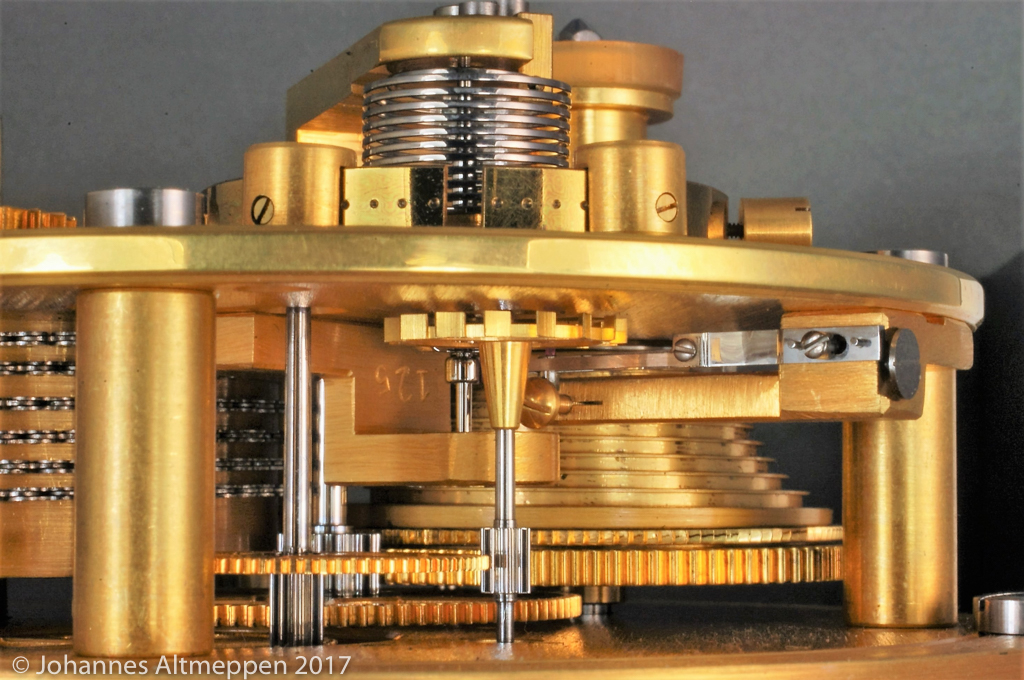
References/wempe/photos/dg-chrono-6mx-gallery/bilder-zum-6mx/8_Poljot_00127_Feder.jpg
