OrelMag/marine-chronometer-model/References/wempe/photos/dg-chrono-6mx-gallery/bilder-zum-6mx/10_Kirow_92-Pasport1(1).jpg

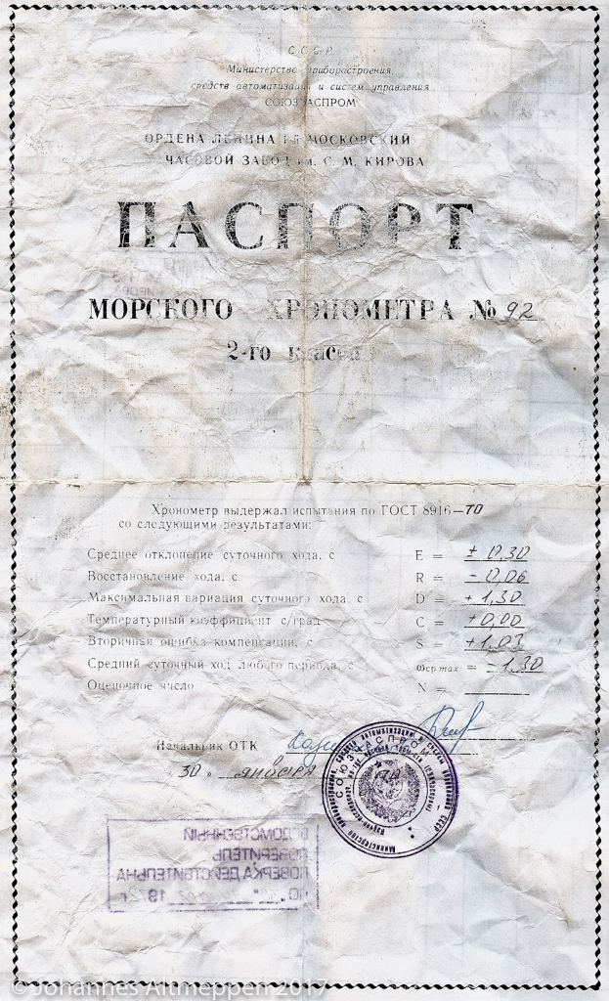
References/wempe/photos/dg-chrono-6mx-gallery/bilder-zum-6mx/10_Kirow_92-Pasport1(1).jpg
