OrelMag/marine-chronometer-model/References/wempe/photos/dg-chrono-6mx-gallery/bilder-zum-6mx/11_Poljot_09218_Pasport_1.jpg

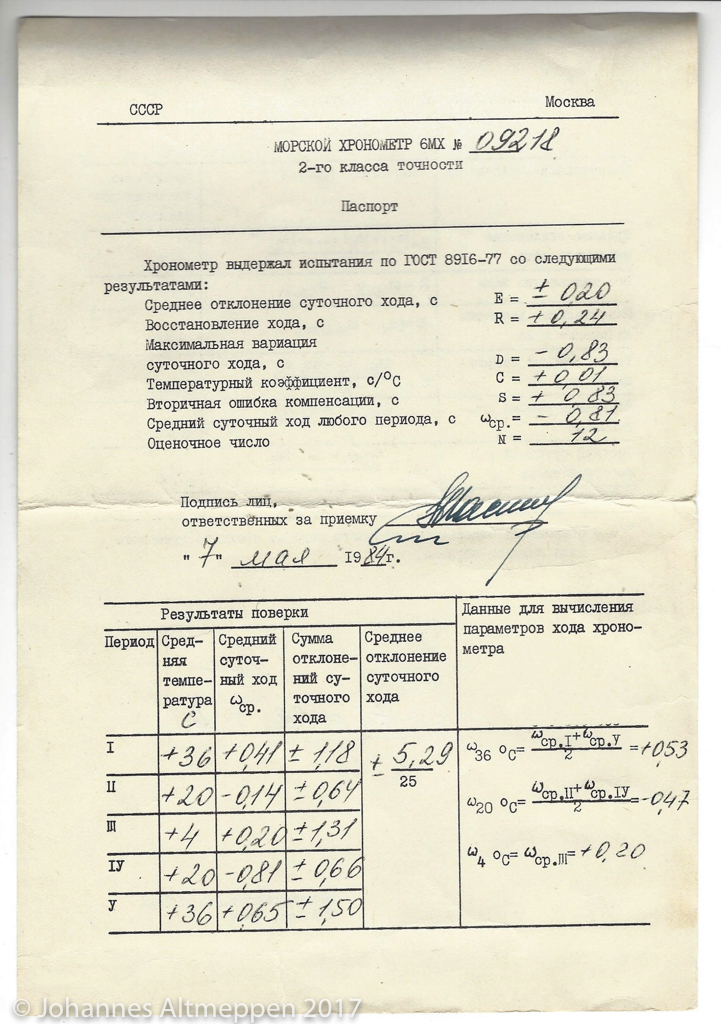
References/wempe/photos/dg-chrono-6mx-gallery/bilder-zum-6mx/11_Poljot_09218_Pasport_1.jpg
