OrelMag/marine-chronometer-model/References/wempe/photos/dg-chrono-6mx-gallery/bilder-zum-6mx/12_Kirow_91_Pasport2.jpg

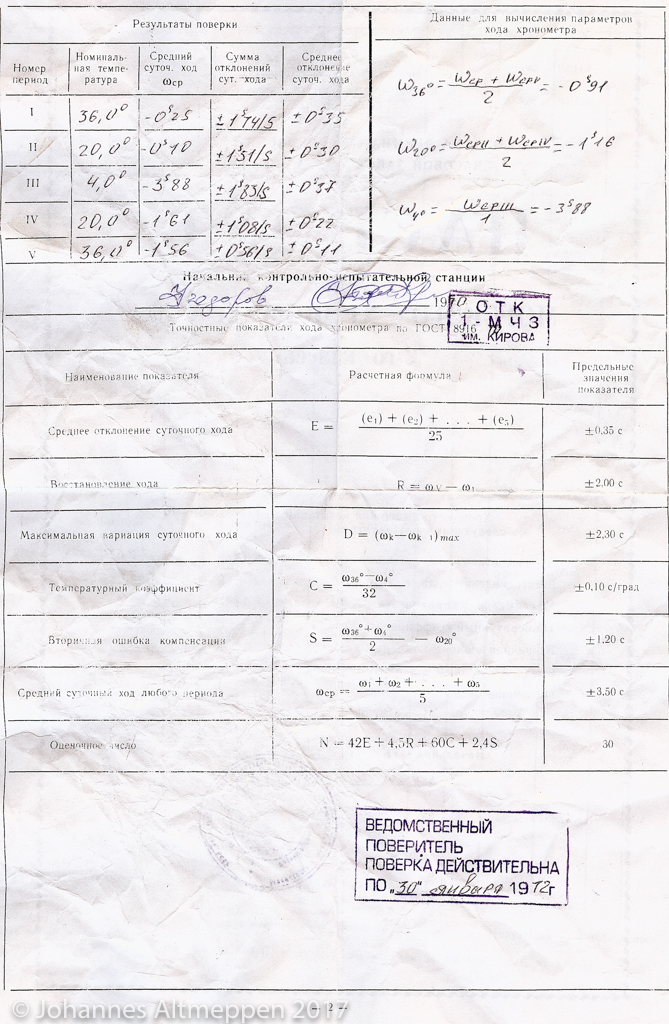
References/wempe/photos/dg-chrono-6mx-gallery/bilder-zum-6mx/12_Kirow_91_Pasport2.jpg
