OrelMag/marine-chronometer-model/References/wempe/photos/dg-chrono-6mx-gallery/bilder-zum-6mx/12_Kirow_22823_Pasport_1_Gost_8916-77.jpg

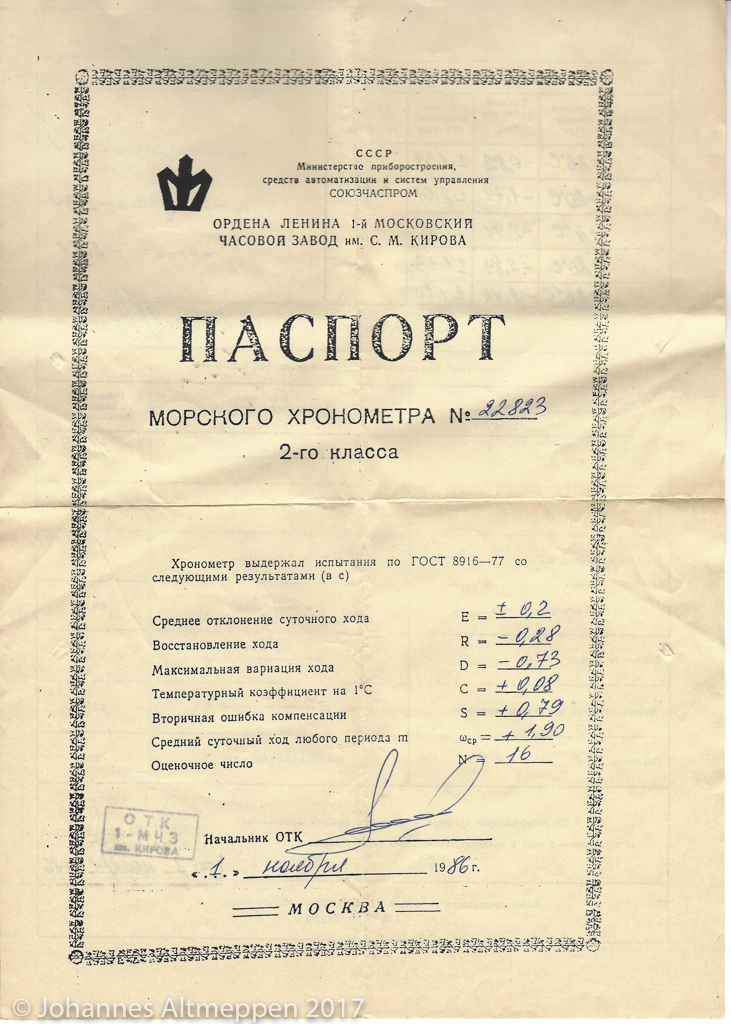
References/wempe/photos/dg-chrono-6mx-gallery/bilder-zum-6mx/12_Kirow_22823_Pasport_1_Gost_8916-77.jpg
