OrelMag/marine-chronometer-model/References/wempe/photos/dg-chrono-6mx-gallery/bilder-zum-6mx/12_Poljot_08479_E-Kontakt2.jpg

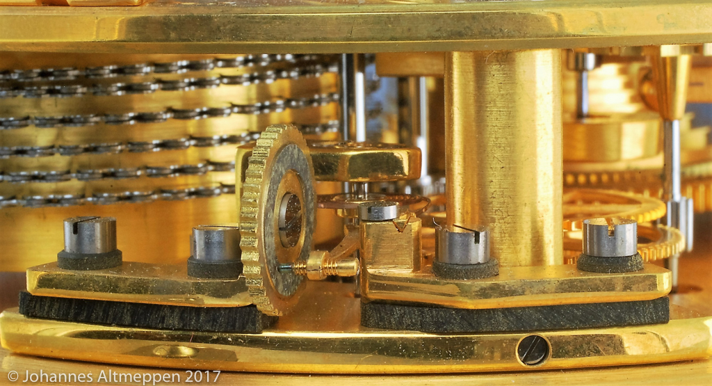
References/wempe/photos/dg-chrono-6mx-gallery/bilder-zum-6mx/12_Poljot_08479_E-Kontakt2.jpg
