OrelMag/marine-chronometer-model/References/wempe/photos/dg-chrono-6mx-gallery/bilder-zum-6mx/12_Poljot_09218_Pasport_2.jpg

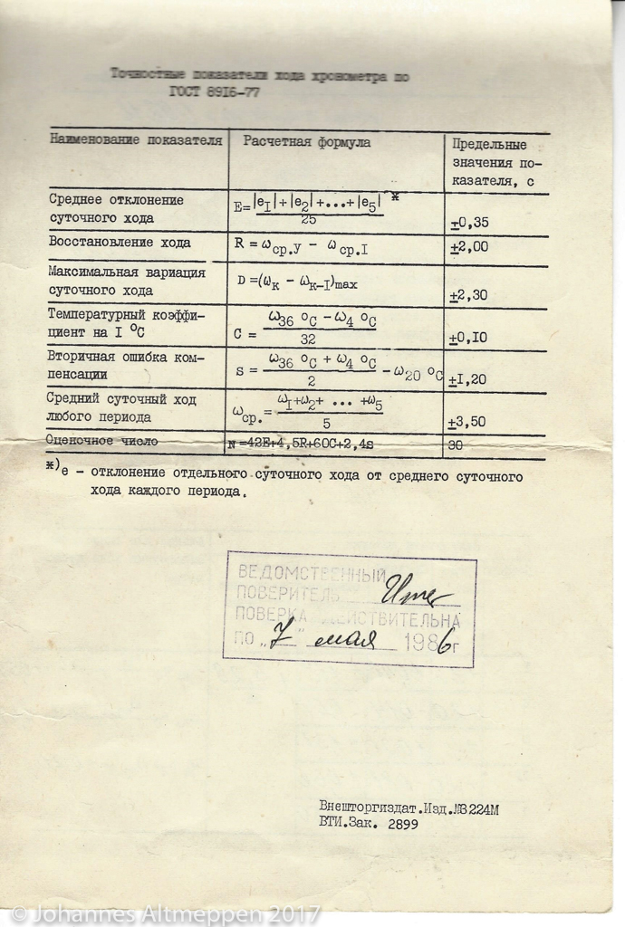
References/wempe/photos/dg-chrono-6mx-gallery/bilder-zum-6mx/12_Poljot_09218_Pasport_2.jpg
