OrelMag/marine-chronometer-model/References/wempe/photos/dg-chrono-6mx-gallery/bilder-zum-6mx/13_Poljot_08479_E-Kontakt3.jpg

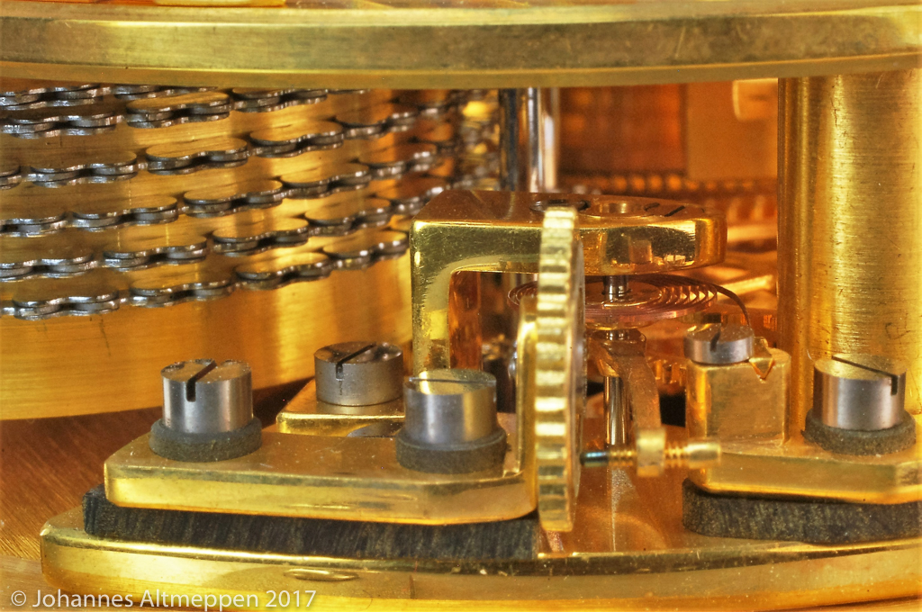
References/wempe/photos/dg-chrono-6mx-gallery/bilder-zum-6mx/13_Poljot_08479_E-Kontakt3.jpg
