OrelMag/marine-chronometer-model/References/wempe/photos/dg-chrono-6mx-gallery/bilder-zum-6mx/S_1.jpg

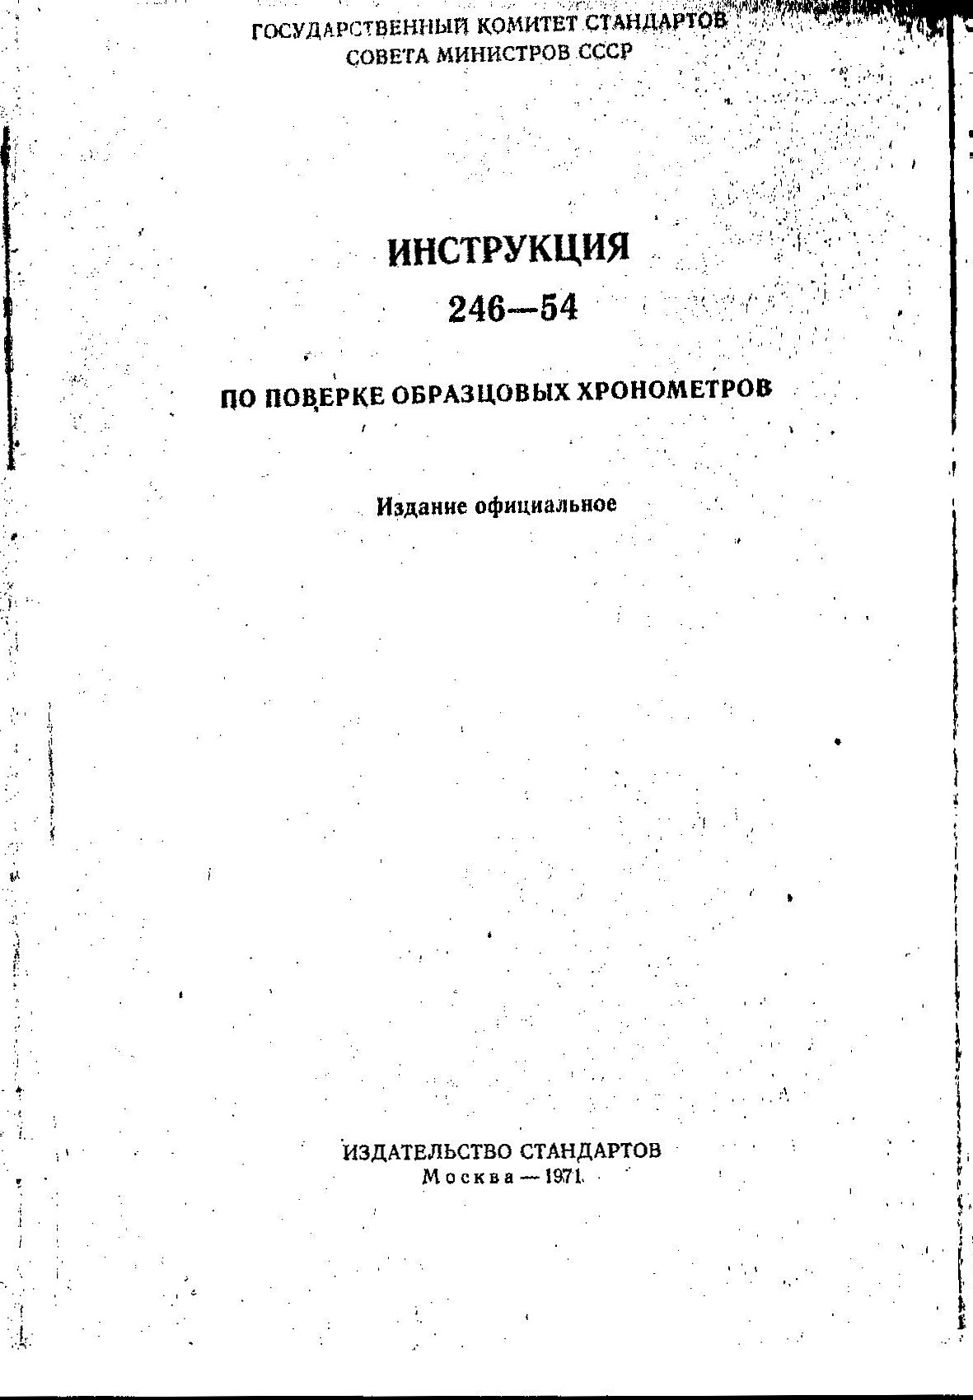
References/wempe/photos/dg-chrono-6mx-gallery/bilder-zum-6mx/S_1.jpg
