OrelMag/marine-chronometer-model/References/wempe/photos/dg-chrono-6mx-gallery/leben-des-6mx/1_1_Kirow_91_92.jpg

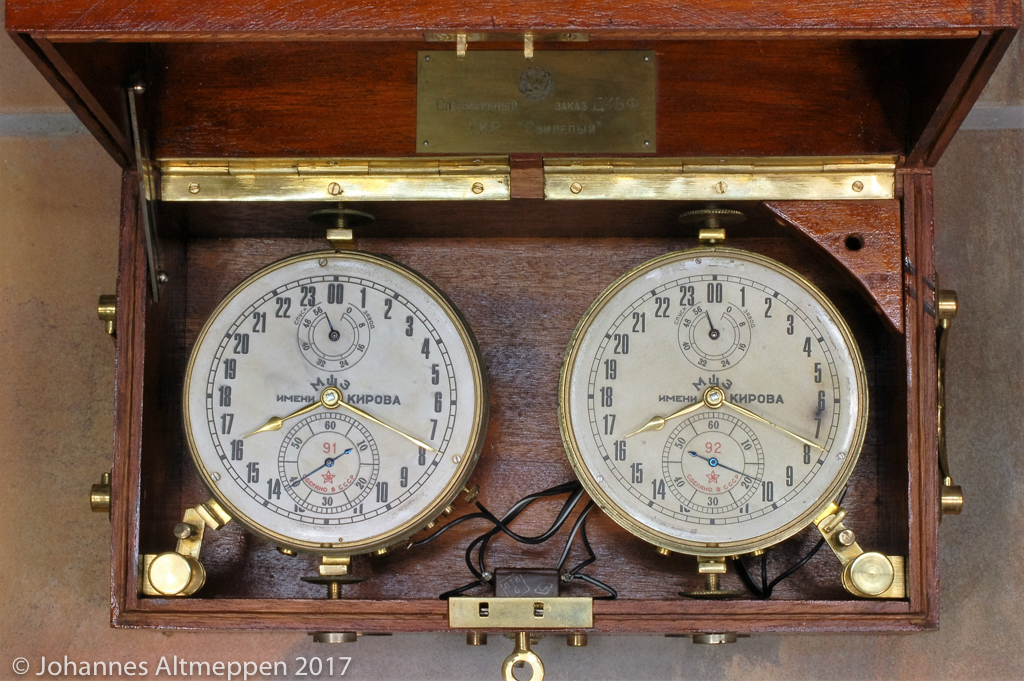
References/wempe/photos/dg-chrono-6mx-gallery/leben-des-6mx/1_1_Kirow_91_92.jpg
