OrelMag/marine-chronometer-model/References/wempe/photos/dg-chrono-6mx-gallery/leben-des-6mx/2_2_Kirow_91_A.jpg

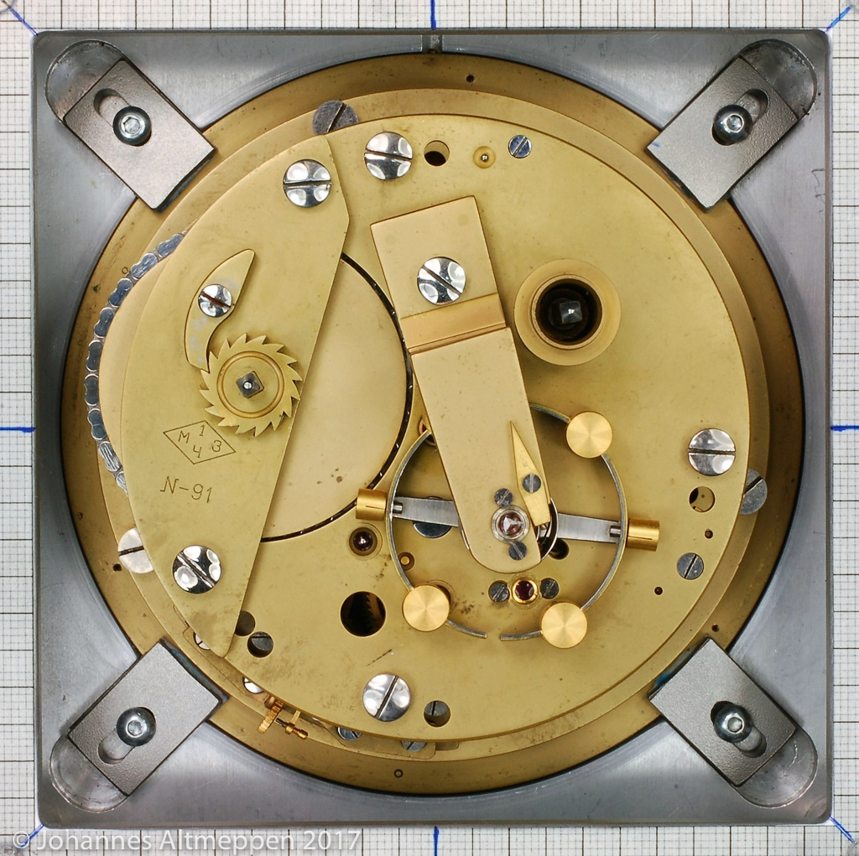
References/wempe/photos/dg-chrono-6mx-gallery/leben-des-6mx/2_2_Kirow_91_A.jpg
