OrelMag/marine-chronometer-model/References/wempe/photos/dg-chrono-6mx-gallery/leben-des-6mx/5_Poljot_00127_Gost_8916-77.jpg

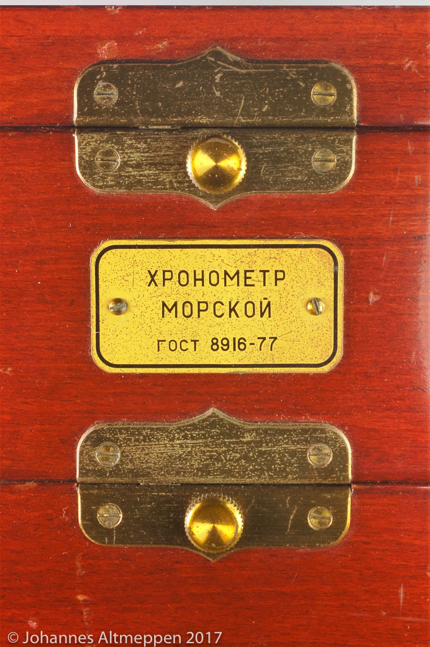
References/wempe/photos/dg-chrono-6mx-gallery/leben-des-6mx/5_Poljot_00127_Gost_8916-77.jpg
