OrelMag/marine-chronometer-model/References/wempe/photos/dg-chrono-6mx-gallery/leben-des-6mx/7_KirPol_24020_W.jpg

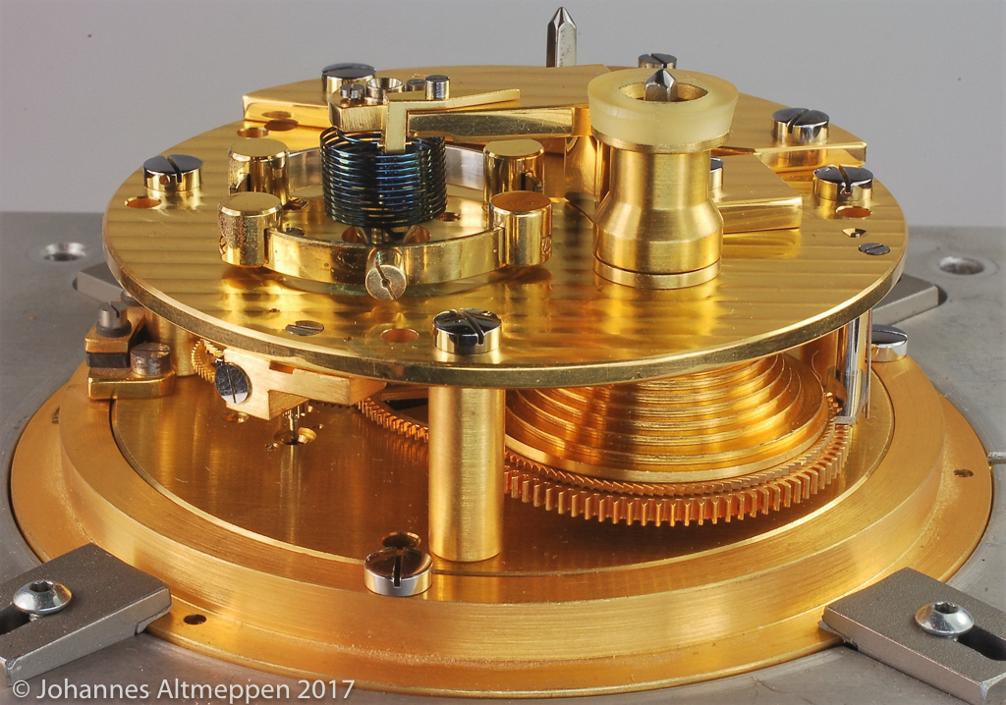
References/wempe/photos/dg-chrono-6mx-gallery/leben-des-6mx/7_KirPol_24020_W.jpg
