OrelMag/marine-chronometer-model/References/wempe/photos/dg-chrono-6mx-gallery/leben-des-6mx/9_KirPol_24020_Feder2.jpg

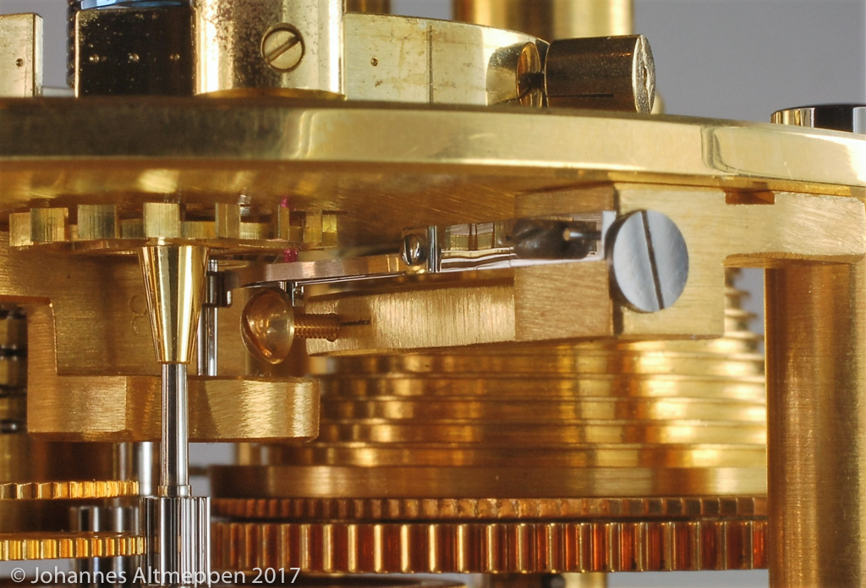
References/wempe/photos/dg-chrono-6mx-gallery/leben-des-6mx/9_KirPol_24020_Feder2.jpg
