OrelMag/marine-chronometer-model/References/wempe/photos/dg-chrono-6mx-gallery/leben-des-6mx/10_Kirow_247_E-Kontakt_1.jpg

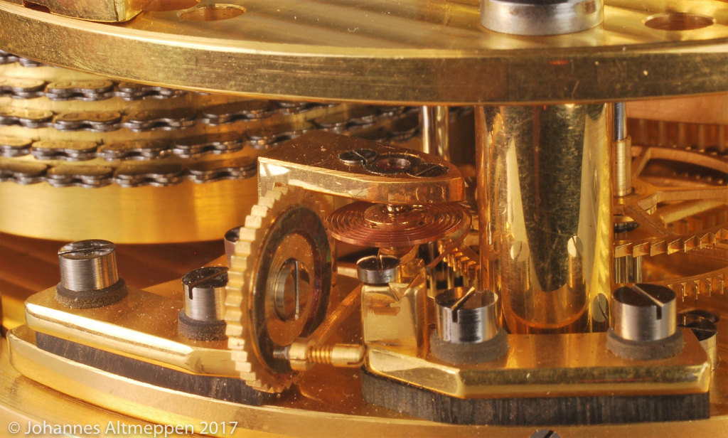
References/wempe/photos/dg-chrono-6mx-gallery/leben-des-6mx/10_Kirow_247_E-Kontakt_1.jpg
