OrelMag/marine-chronometer-model/References/wempe/photos/dg-chrono-6mx-gallery/leben-des-6mx/11_KirPol_24020_E-Kontakt1.jpg

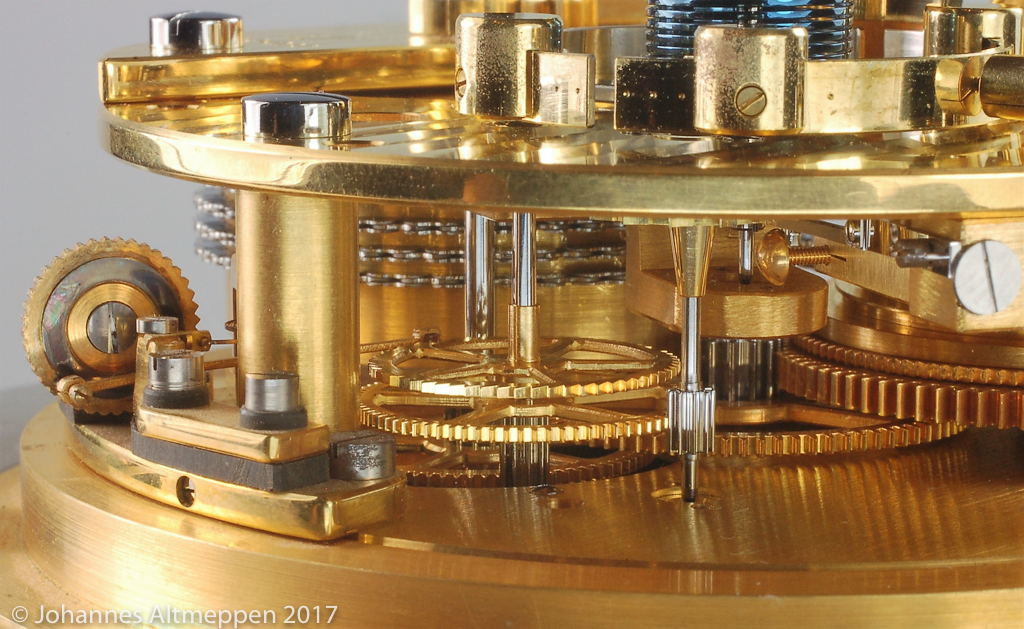
References/wempe/photos/dg-chrono-6mx-gallery/leben-des-6mx/11_KirPol_24020_E-Kontakt1.jpg
