OrelMag/marine-chronometer-model/References/wempe/photos/dg-chrono-6mx-gallery/leben-des-6mx/17_6_MX.jpg

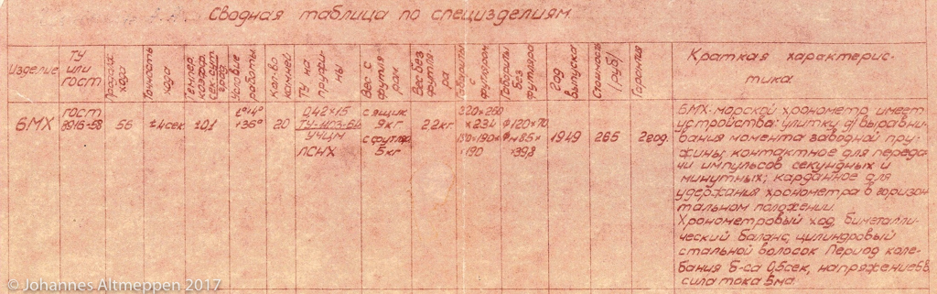
References/wempe/photos/dg-chrono-6mx-gallery/leben-des-6mx/17_6_MX.jpg
