OrelMag/marine-chronometer-model/References/wempe/photos/dg-chrono-6mx-gallery/leben-des-6mx/18_NII-Siegel.jpg

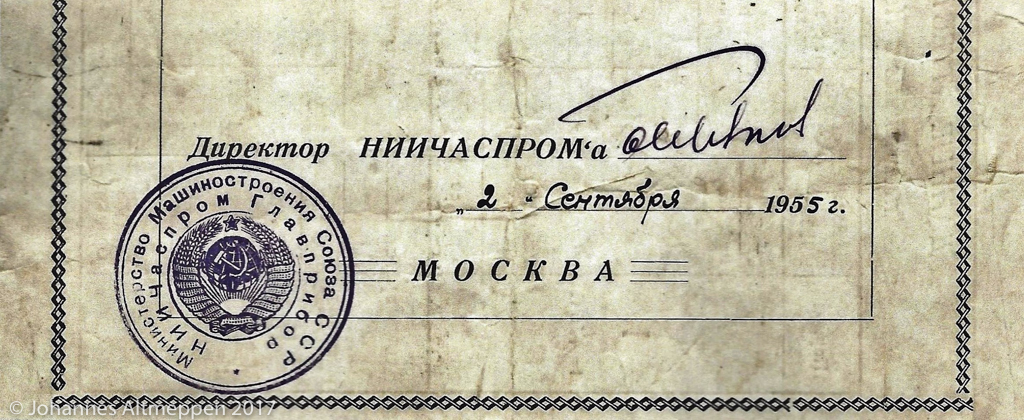
References/wempe/photos/dg-chrono-6mx-gallery/leben-des-6mx/18_NII-Siegel.jpg
