OrelMag/marine-chronometer-model/References/wempe/photos/dg-chrono-6mx-gallery/leben-des-6mx/26_6MX_for_China.jpg

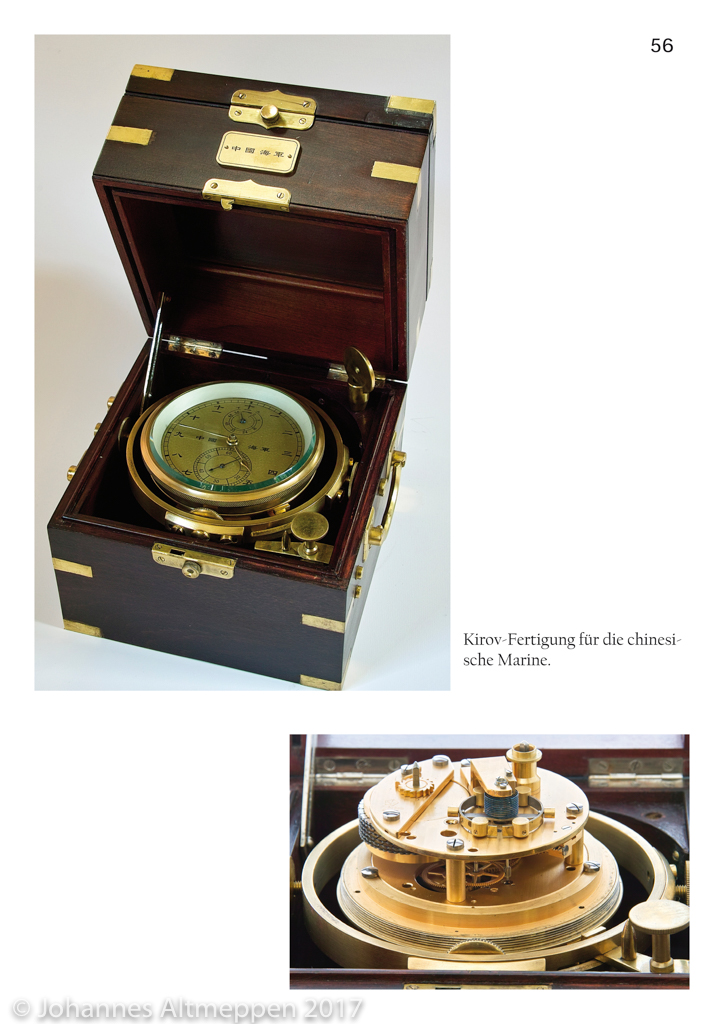
References/wempe/photos/dg-chrono-6mx-gallery/leben-des-6mx/26_6MX_for_China.jpg
