OrelMag/marine-chronometer-model/References/wempe/photos/dg-chrono-6mx/1_2_Vergleich_Wempe-6MX_uZ.jpg

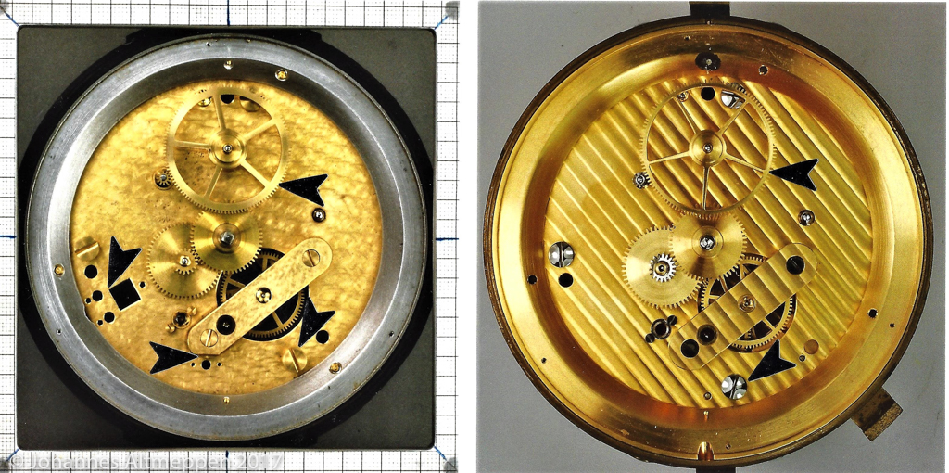
References/wempe/photos/dg-chrono-6mx/1_2_Vergleich_Wempe-6MX_uZ.jpg
