OrelMag/marine-chronometer-model/References/wempe/photos/dg-chrono-6mx/2_Kirow_247_A.jpg

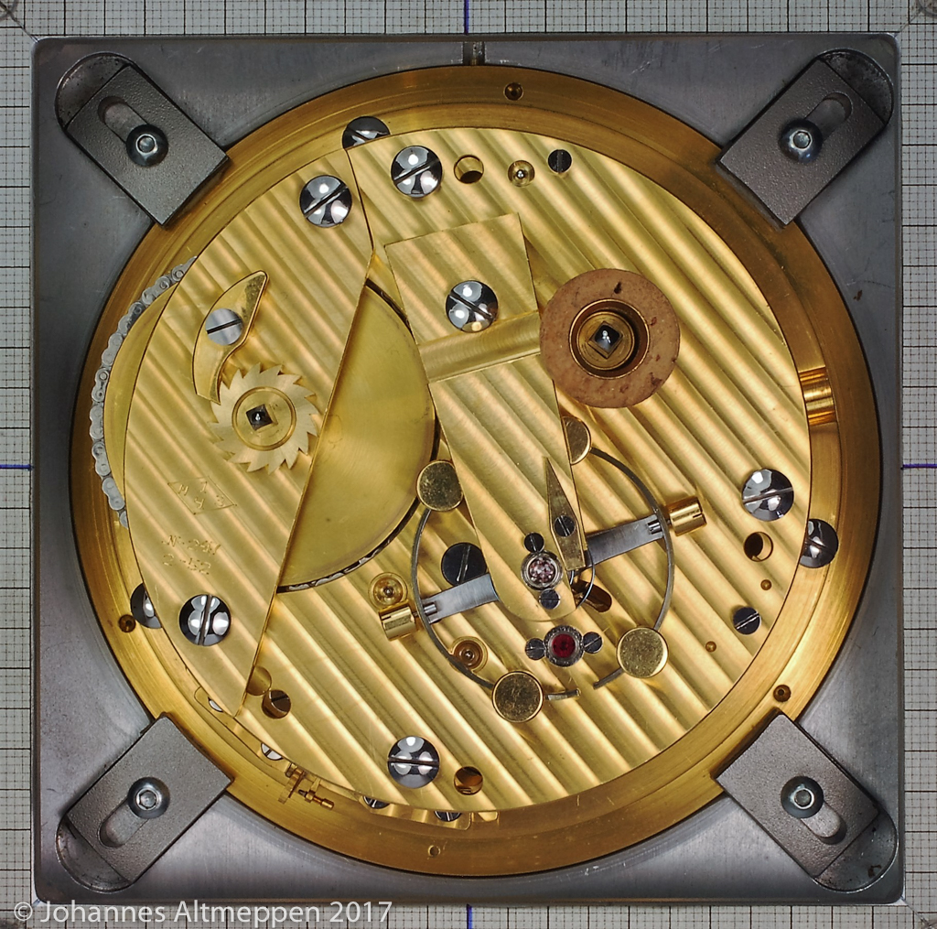
References/wempe/photos/dg-chrono-6mx/2_Kirow_247_A.jpg
