OrelMag/marine-chronometer-model/References/wempe/photos/dg-chrono-6mx/3_Kirow_247_uZ.jpg

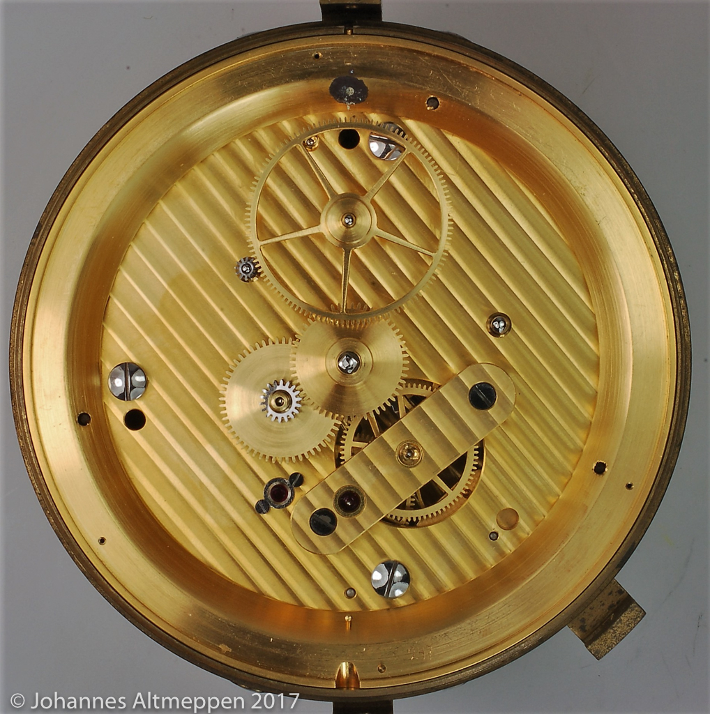
References/wempe/photos/dg-chrono-6mx/3_Kirow_247_uZ.jpg
