OrelMag/marine-chronometer-model/References/wempe/photos/dg-chrono-6mx/4_Kirow_247_N.jpg

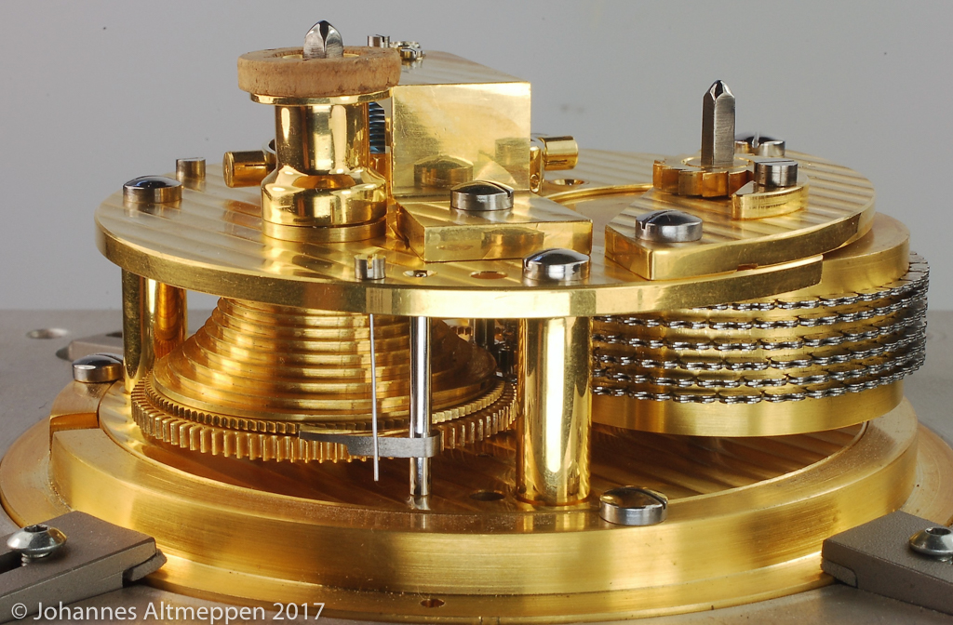
References/wempe/photos/dg-chrono-6mx/4_Kirow_247_N.jpg
