OrelMag/marine-chronometer-model/References/wempe/photos/dg-chrono-6mx/5_Kirow_247_O.jpg

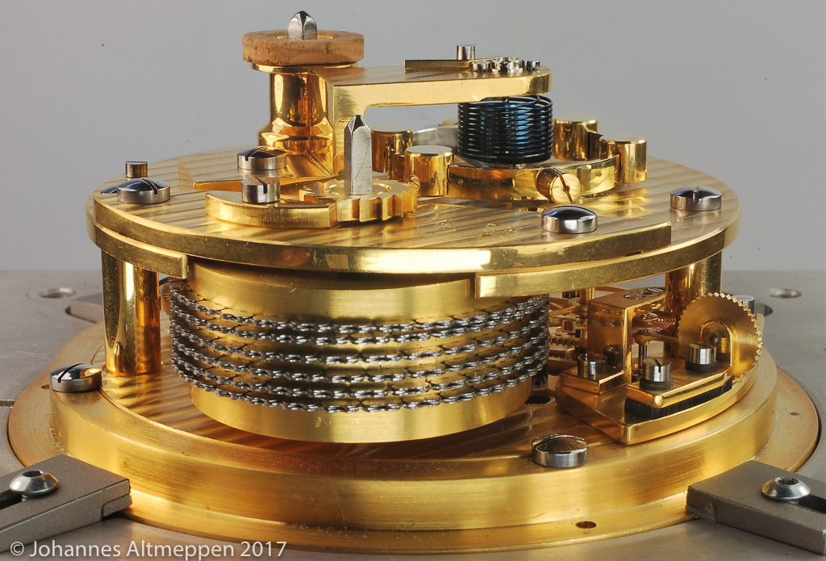
References/wempe/photos/dg-chrono-6mx/5_Kirow_247_O.jpg
