OrelMag/marine-chronometer-model/References/wempe/photos/dg-chrono-dec/1_Kirow_DEC_422_Z.jpg

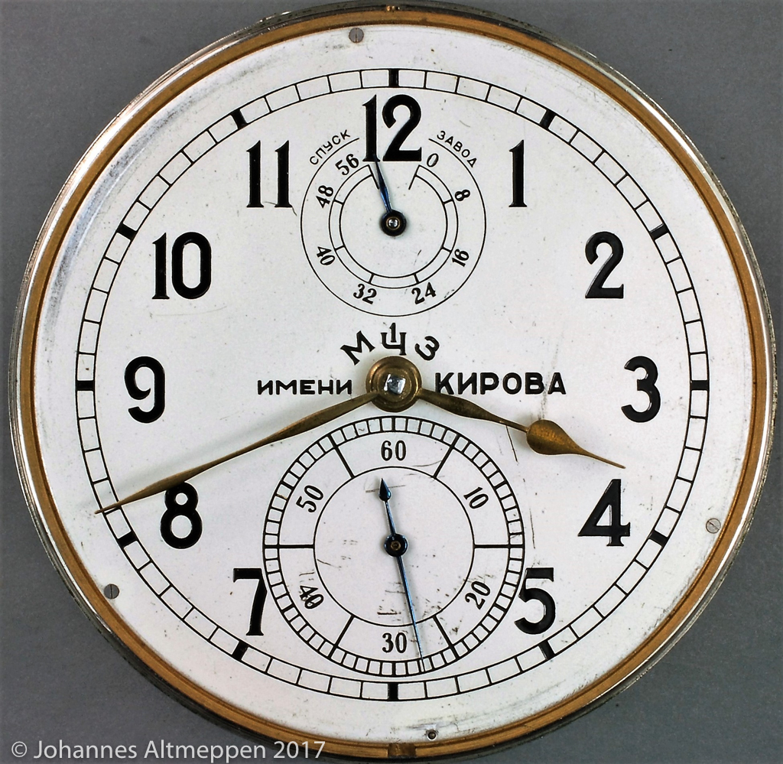
References/wempe/photos/dg-chrono-dec/1_Kirow_DEC_422_Z.jpg
