OrelMag/marine-chronometer-model/References/wempe/photos/dg-chrono-dec/2_Kirow_DEC_479_A.jpg

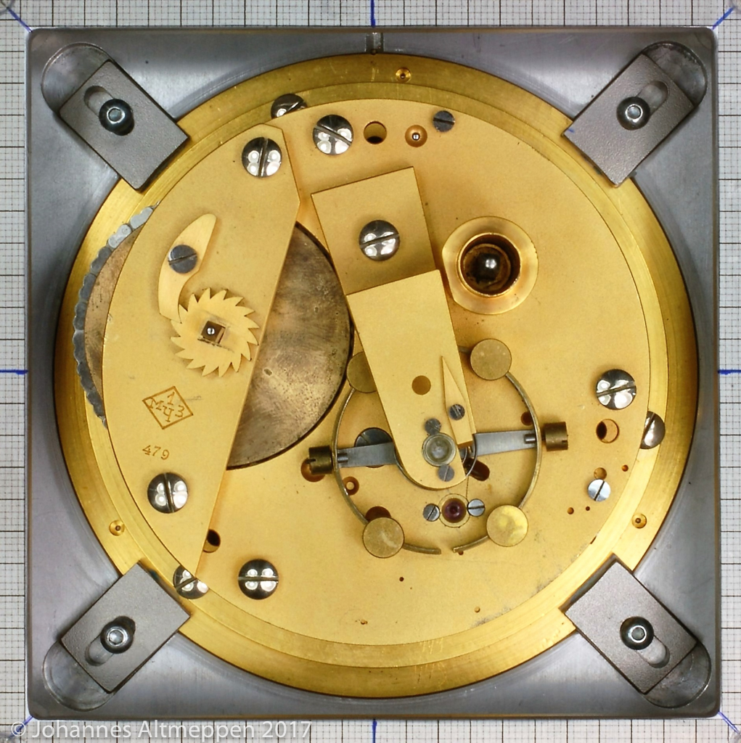
References/wempe/photos/dg-chrono-dec/2_Kirow_DEC_479_A.jpg
