OrelMag/marine-chronometer-model/References/wempe/photos/dg-chrono-dec/2_zu-2_ALS_5177_16_07_45.jpg

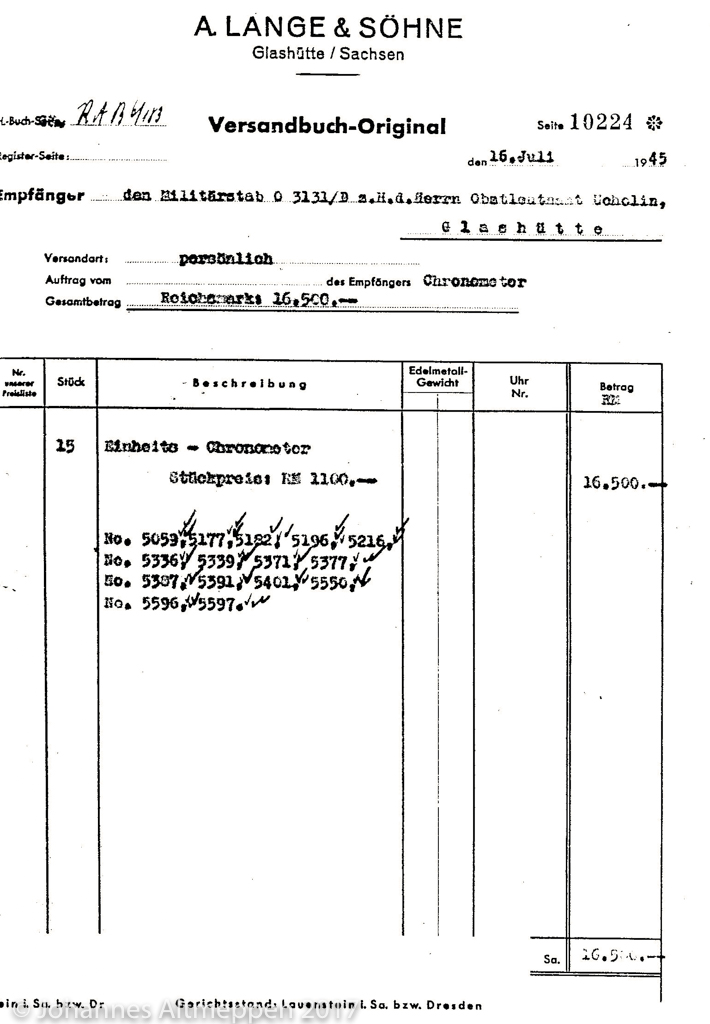
References/wempe/photos/dg-chrono-dec/2_zu-2_ALS_5177_16_07_45.jpg
