OrelMag/marine-chronometer-model/References/wempe/photos/dg-chrono-dec/3_3_Auf-_und_Ab_rus.jpg

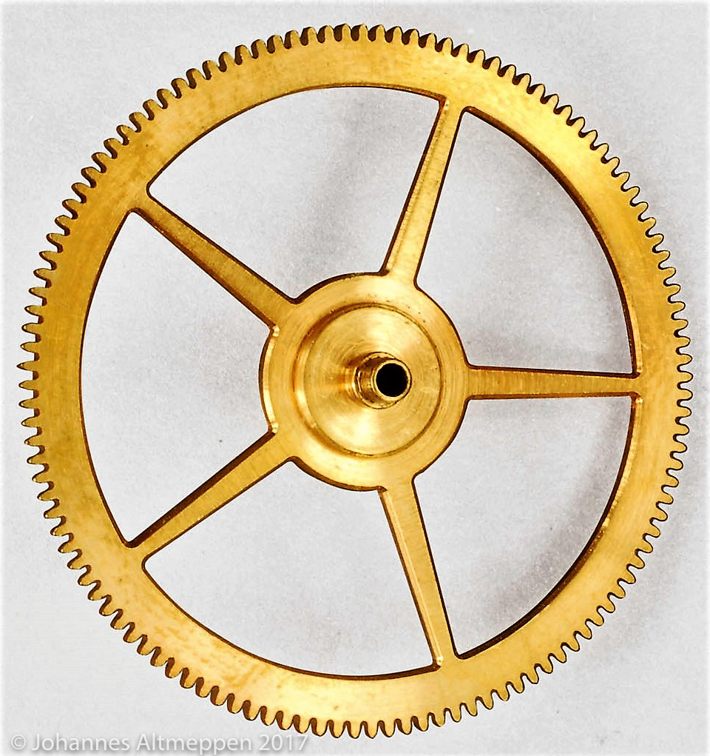
References/wempe/photos/dg-chrono-dec/3_3_Auf-_und_Ab_rus.jpg
