OrelMag/marine-chronometer-model/References/wempe/photos/dg-chrono-dec/4_Kirow_DEC_422_N.jpg

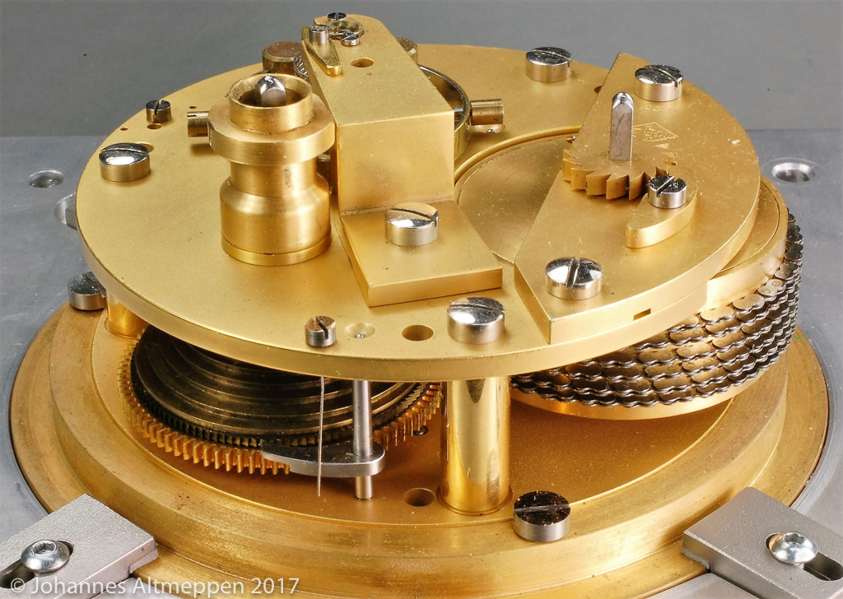
References/wempe/photos/dg-chrono-dec/4_Kirow_DEC_422_N.jpg
