OrelMag/marine-chronometer-model/References/wempe/photos/dg-chrono-dec/5_Grießbach-Unruh-mit_Ecke.jpg

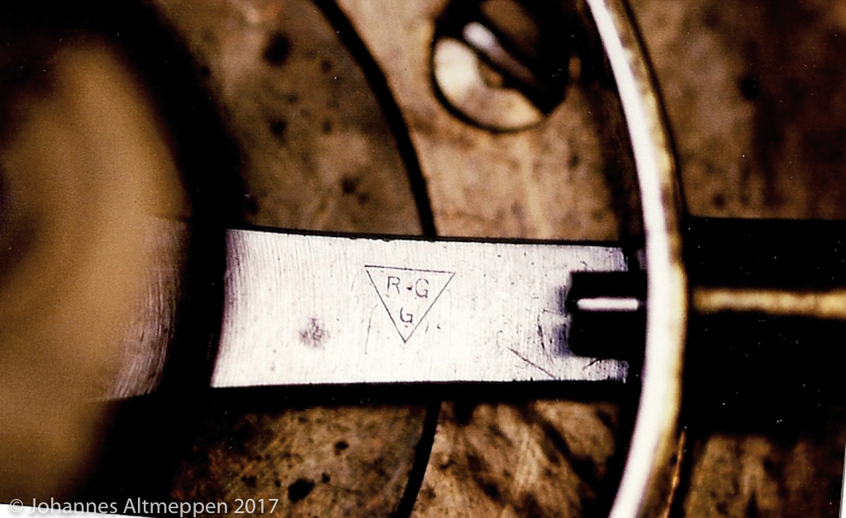
References/wempe/photos/dg-chrono-dec/5_Grießbach-Unruh-mit_Ecke.jpg
