OrelMag/marine-chronometer-model/References/wempe/photos/dg-chrono-dec/5_Lange_5177_O.jpg

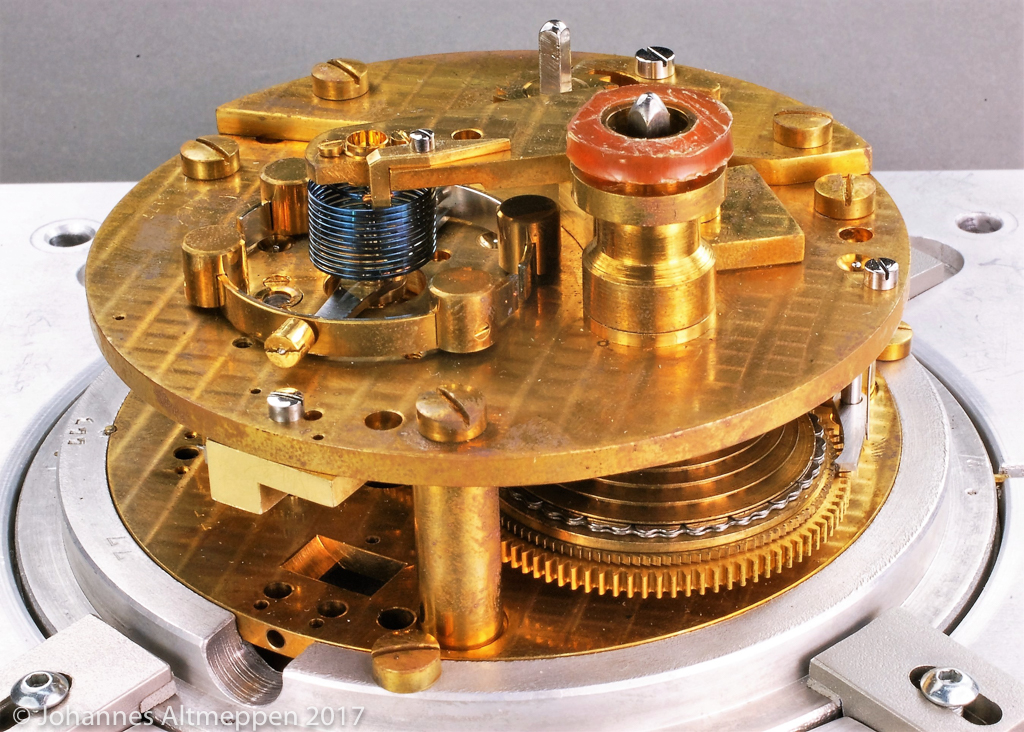
References/wempe/photos/dg-chrono-dec/5_Lange_5177_O.jpg
