OrelMag/marine-chronometer-model/References/wempe/photos/dg-chrono-dec/6_Lange_5177_S.jpg

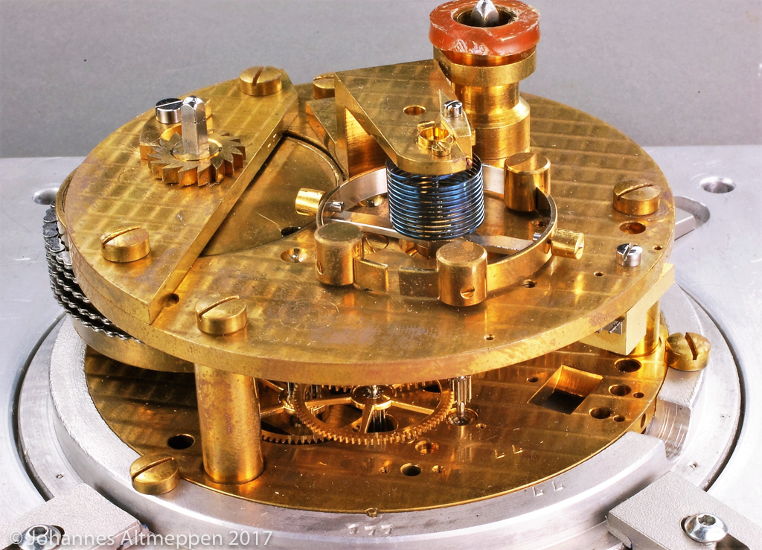
References/wempe/photos/dg-chrono-dec/6_Lange_5177_S.jpg
