OrelMag/marine-chronometer-model/References/wempe/photos/dg-chrono-dec/7_Kirow_DEC_422_W.jpg

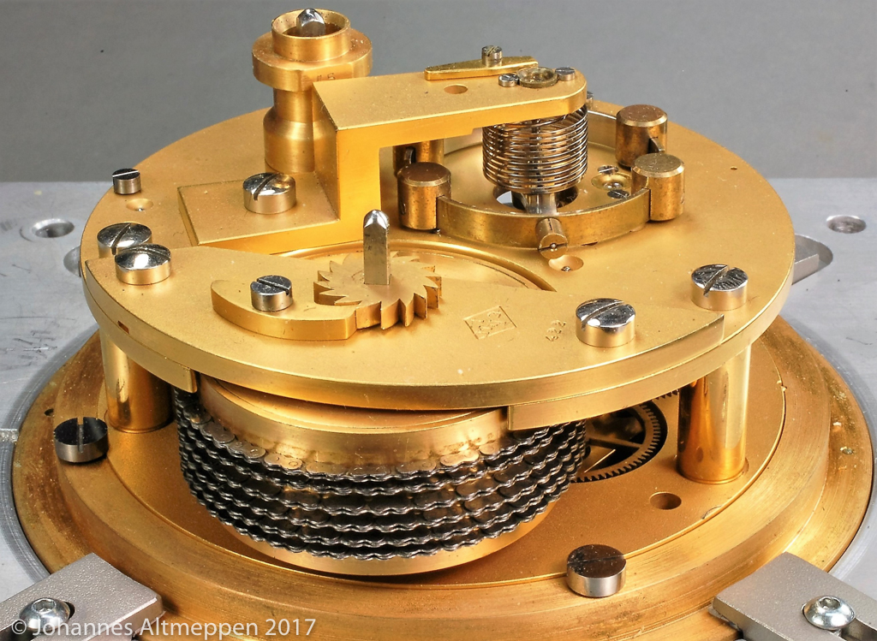
References/wempe/photos/dg-chrono-dec/7_Kirow_DEC_422_W.jpg
