OrelMag/marine-chronometer-model/References/wempe/photos/dg-chrono-dec/8_Gangfeder_mit_Kloben_Rus_einfach.jpg

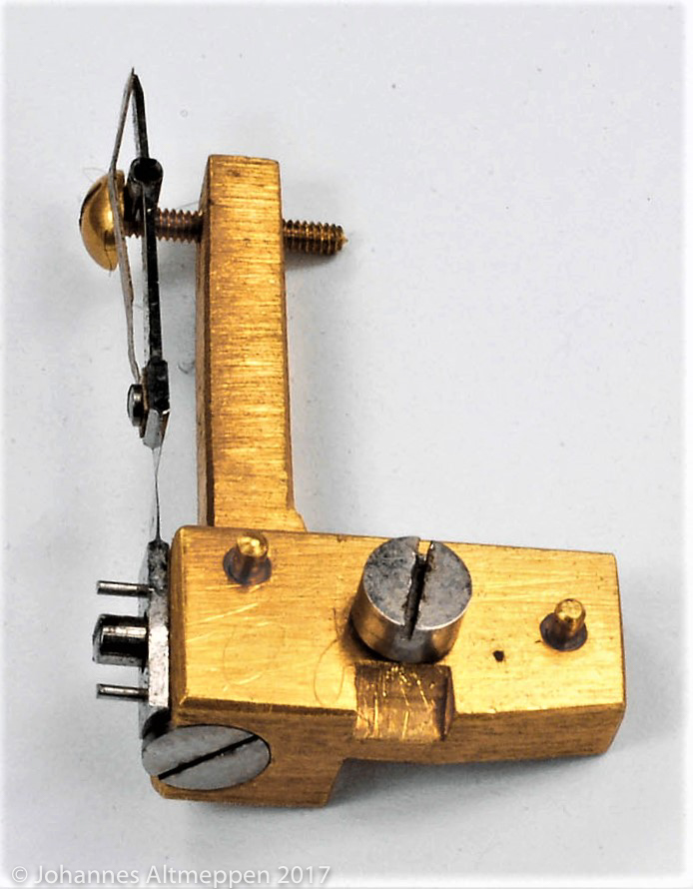
References/wempe/photos/dg-chrono-dec/8_Gangfeder_mit_Kloben_Rus_einfach.jpg
