OrelMag/marine-chronometer-model/References/wempe/photos/dg-chrono-dec/10_Vergleich_CWW-6MX_Gangfeder_mit_Kloben.jpg

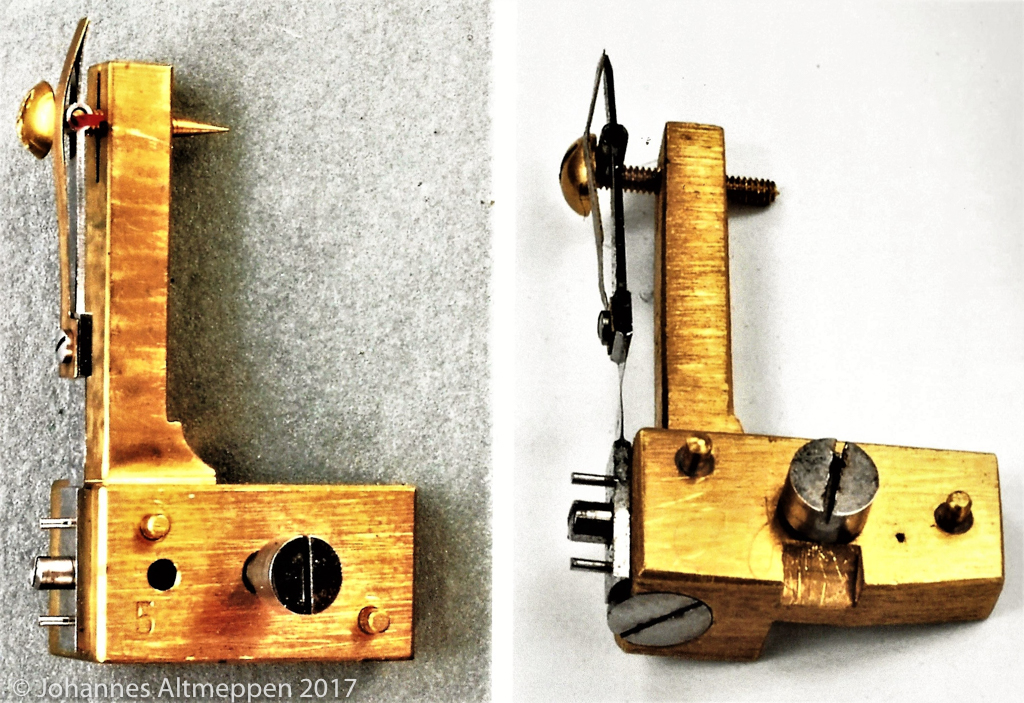
References/wempe/photos/dg-chrono-dec/10_Vergleich_CWW-6MX_Gangfeder_mit_Kloben.jpg
