OrelMag/marine-chronometer-model/References/wempe/photos/dg-chrono-dec/11_Kirow_DEC_479_Kasten_2.jpg

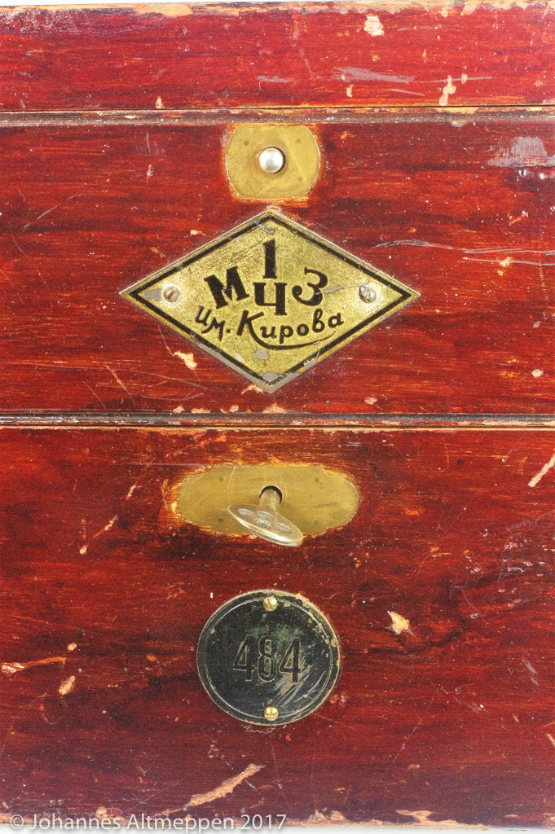
References/wempe/photos/dg-chrono-dec/11_Kirow_DEC_479_Kasten_2.jpg
