OrelMag/marine-chronometer-model/References/wempe/photos/dg-chrono-dec/11_Russen_bei_Wempe.jpg

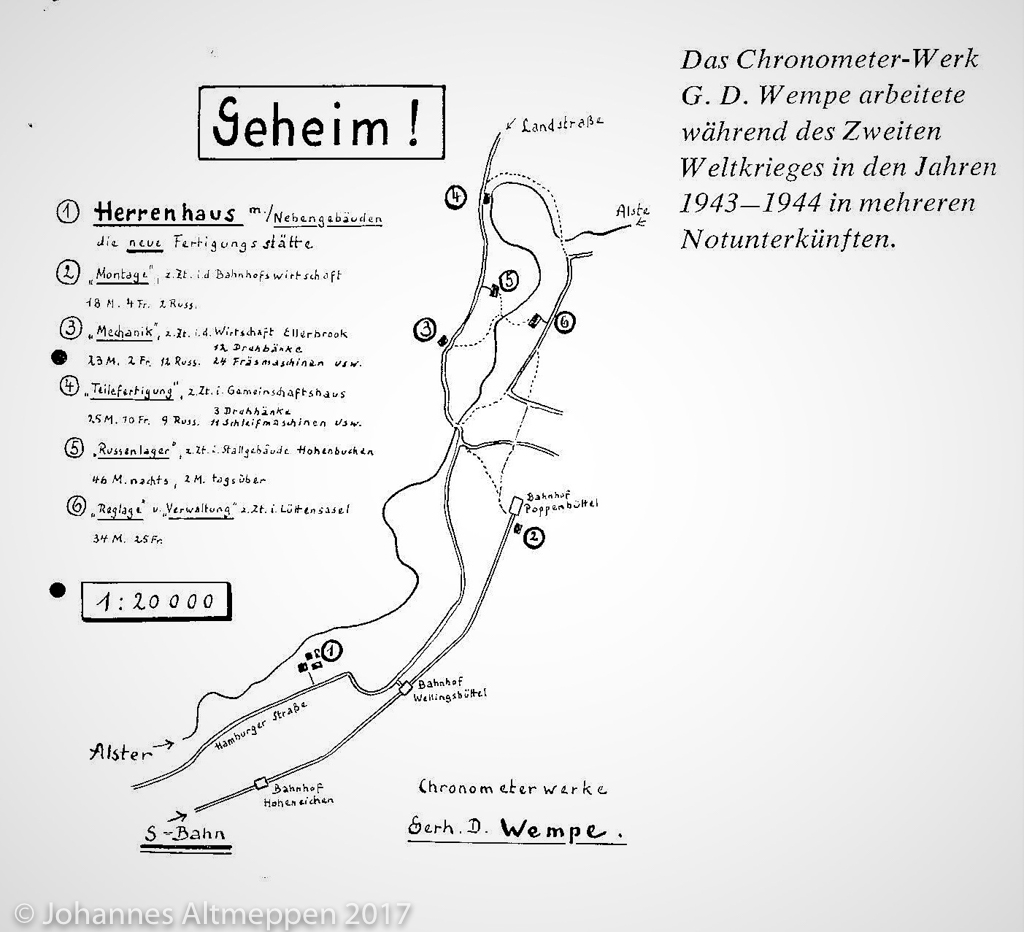
References/wempe/photos/dg-chrono-dec/11_Russen_bei_Wempe.jpg
