OrelMag/marine-chronometer-model/References/wempe/photos/dg-chrono-dec/12_Kirow_DEC_422_Kasten_1.jpg

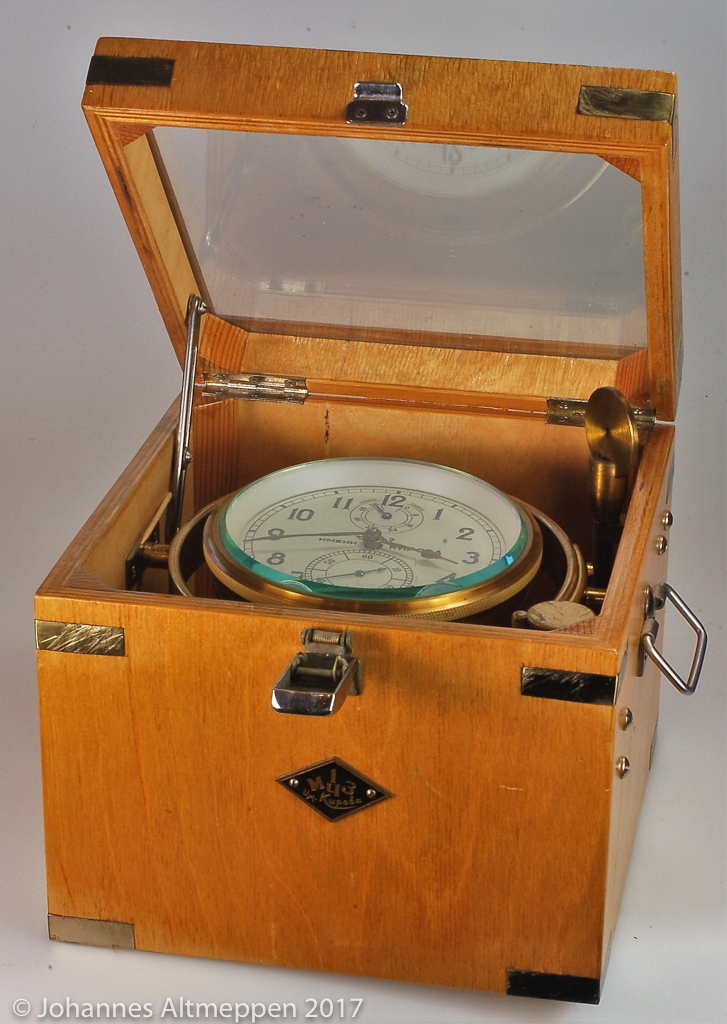
References/wempe/photos/dg-chrono-dec/12_Kirow_DEC_422_Kasten_1.jpg
