OrelMag/marine-chronometer-model/References/wempe/photos/dg-chrono-dec/14_Wempe_3955_Band_Kette.jpg

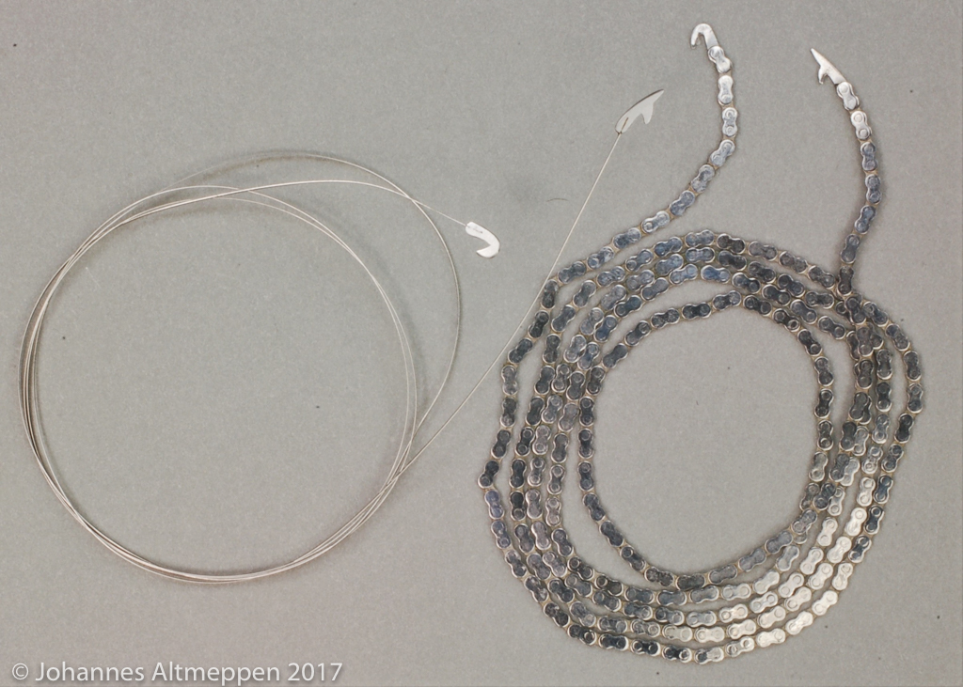
References/wempe/photos/dg-chrono-dec/14_Wempe_3955_Band_Kette.jpg
