OrelMag/marine-chronometer-model/References/wempe/photos/dg-chrono-dec/16_Wempe_3955_Gehäusetopf_Kardan.jpg

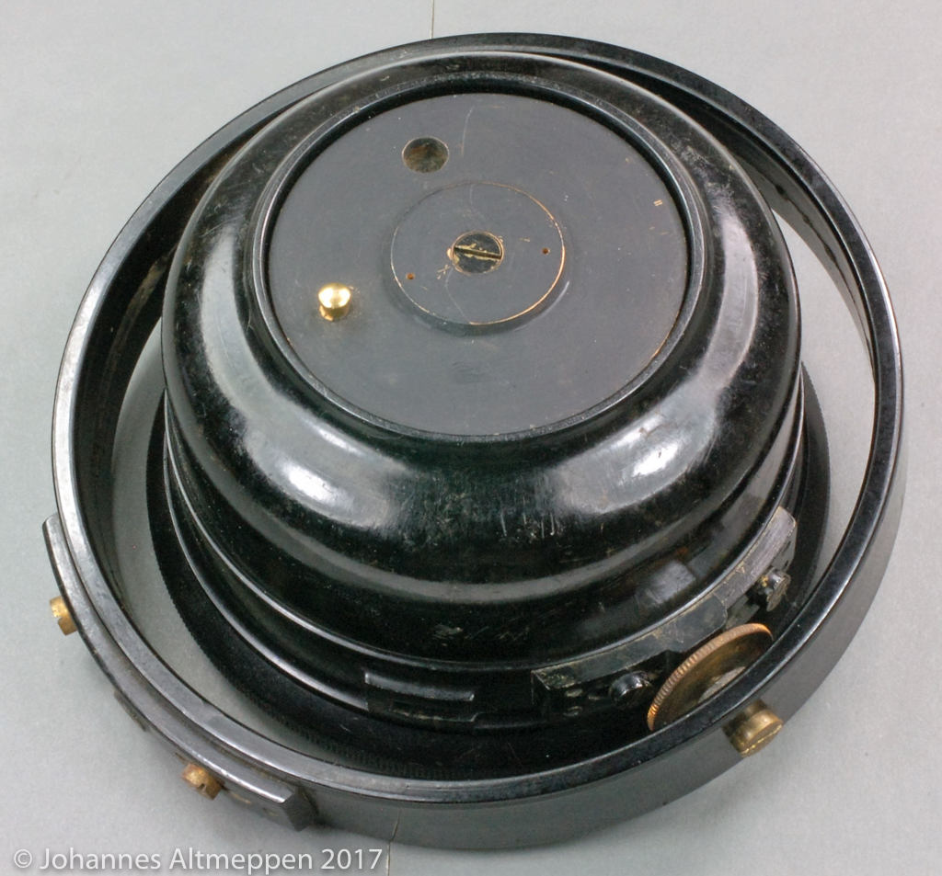
References/wempe/photos/dg-chrono-dec/16_Wempe_3955_Gehäusetopf_Kardan.jpg
