OrelMag/marine-chronometer-model/References/wempe/photos/ru-web/6mh.ru/6hm_front_prest.jpg

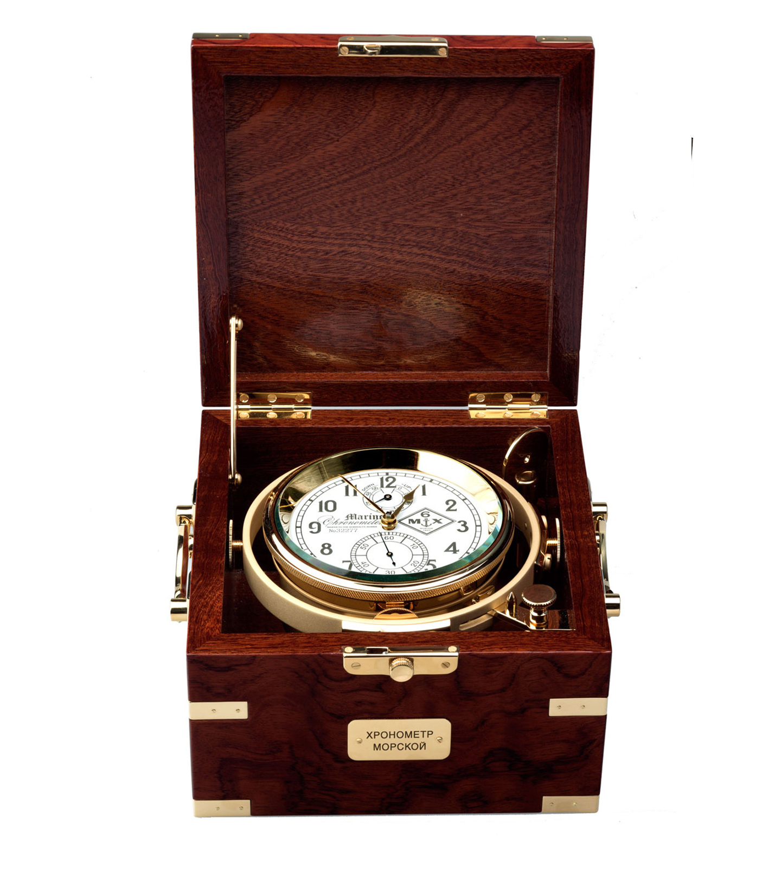
References/wempe/photos/ru-web/6mh.ru/6hm_front_prest.jpg
