OrelMag/marine-chronometer-model/References/wempe/photos/ru-web/6mh.ru/Chronometr_3.jpg

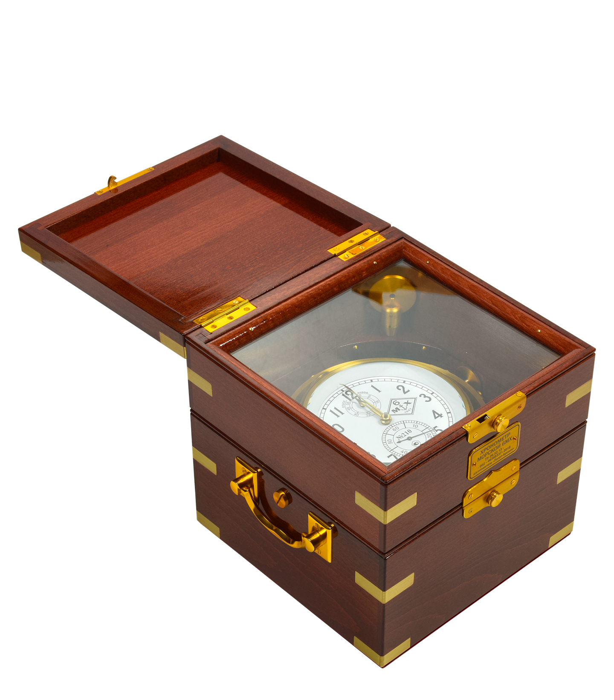
References/wempe/photos/ru-web/6mh.ru/Chronometr_3.jpg
