OrelMag/marine-chronometer-model/References/wempe/photos/ru-web/poljot-watches24/pw24_ib1d5e9724c7b40de.jpg

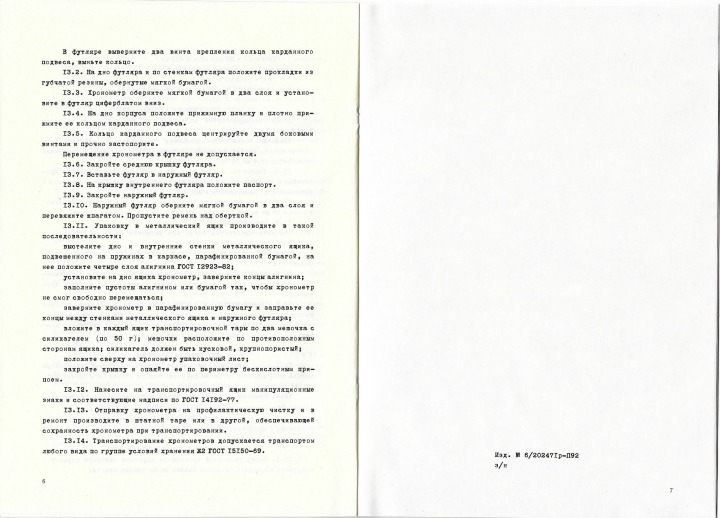
References/wempe/photos/ru-web/poljot-watches24/pw24_ib1d5e9724c7b40de.jpg
