OrelMag/marine-chronometer-model/screenshots/1-dial-in-box.jpg

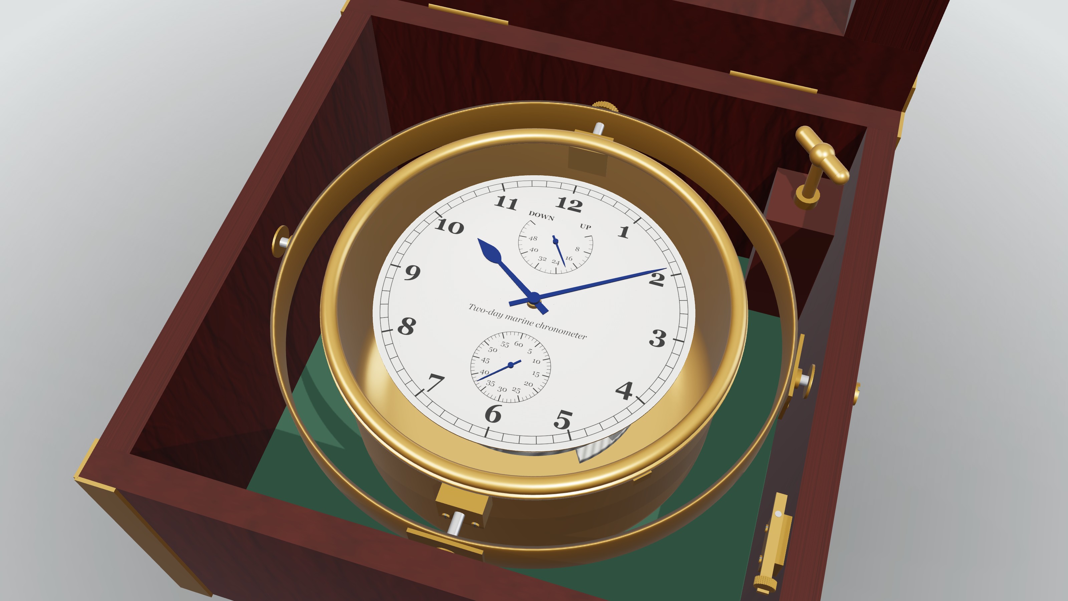
screenshots/1-dial-in-box.jpg
