OrelMag/marine-chronometer-model/screenshots/2-movement.jpg

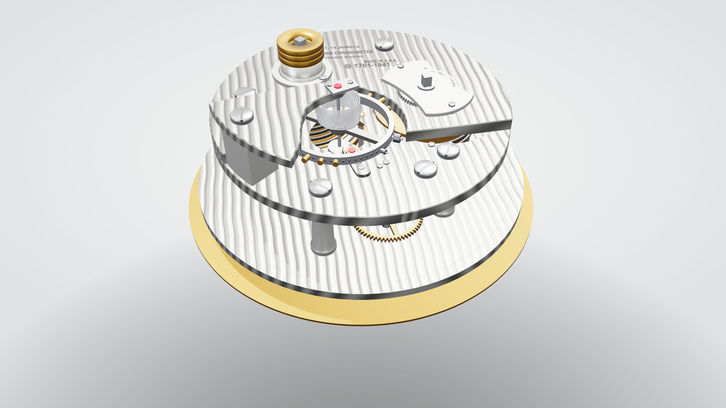
screenshots/2-movement.jpg
