OrelMag/marine-chronometer-model/screenshots/3-exploded.jpg

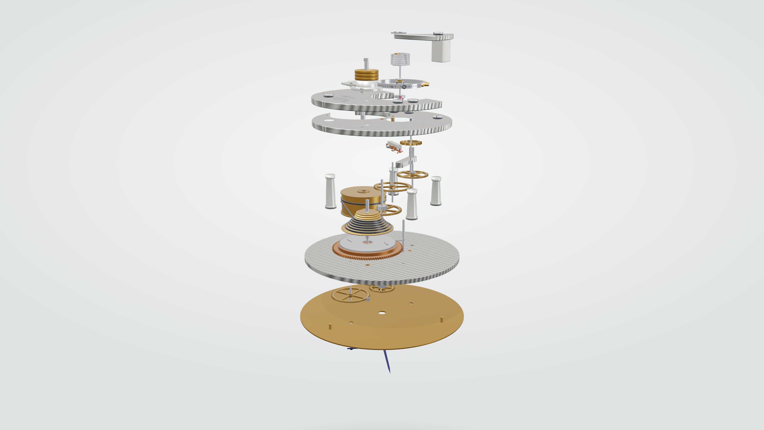
screenshots/3-exploded.jpg
