OrelMag/marine-chronometer-model/site-assets/social-movement.png

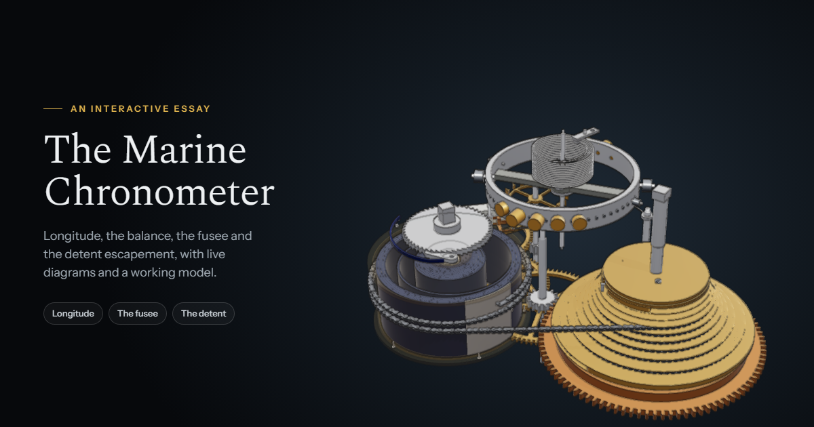
site-assets/social-movement.png
