OrelMag/marine-chronometer-model/site-assets/social.png

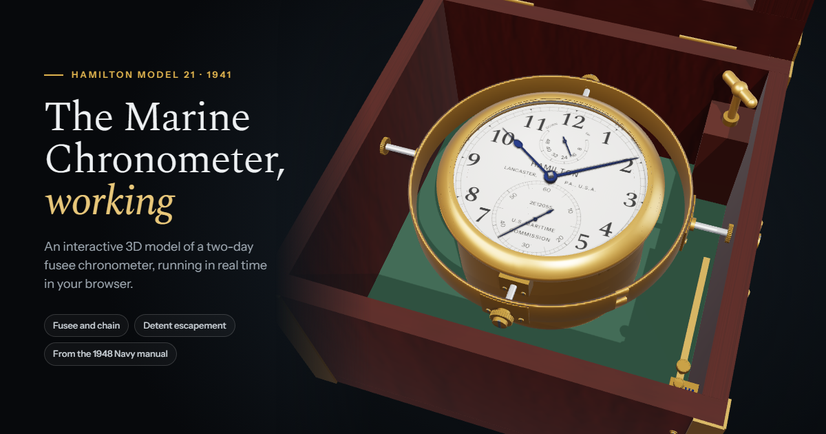
site-assets/social.png
