OrelMag/marine-chronometer-model/site/social-wempe.png

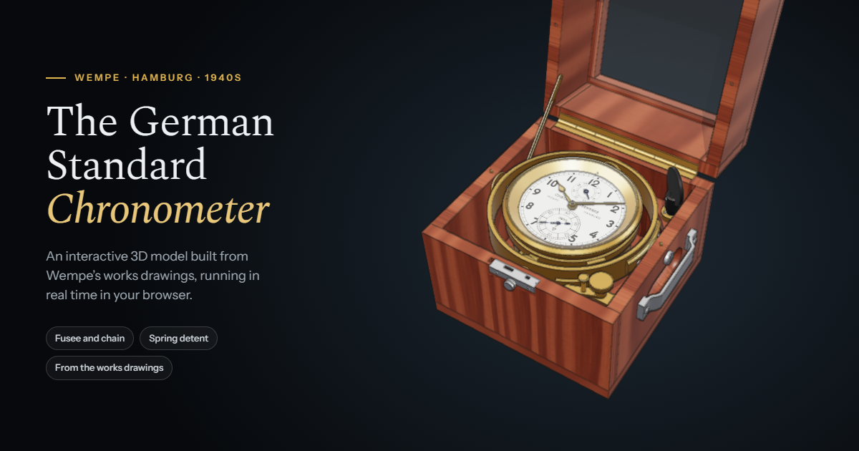
site/social-wempe.png
