OrelMag/marine-chronometer-model/BOM.md

# The parts list against the model

Generated by `marine-chronometer-source/chronometer-working-model/tools/bom.py --md` from `bom.json` (the manual's Sec. XI Maintenance Parts Catalog, Figs. 106-110, pp. 78-88, its totals checked against the Sec. XII numerical list, p. 89) and measurements of the built model. Do not edit by hand.

**Status:** 187 lines counted, 319 relations measured, 14 jewels; no failures, 1 known deviation(s).

Columns: the manual's index and Hamilton number, its units per chronometer, the pieces in the model, the part card it belongs to, what the part does (with its source), and how it goes into the mechanism as measured: `in` a thread, pivot, pin or setting inside the named part (tap, clear, run, free, press, or embed where a hole across an extrusion or turned part is not cut), `round` a bore round the named part, `on` the least distance to the part it rests on, `meshes` the gear check, `endshake` the axial play (0.001-0.003 in, Ops. 15, 69, 74). The last column is the check's verdict.

## Fig. 106: mounting box and gimbals

| Idx | No. | Name | Manual | Model | Card | Function | Fit and drive (measured) | |
|---|---|---|---|---|---|---|---|---|
| 106-3 | 42201 | Box - Mounting, complete | 1 | 1 | box | Mahogany box with two hinged covers; carries the gimbals and the key (Sec. II). |  | ✓ |
| 106-5 | 42044 | Key - Winding, complete | 1 | 1 | key | Winds the fusee counterclockwise and sets the hands on the centre square (Sec. III, Figs. 7, 8). |  | ✓ |
| 106-6 | 42106 | Ring - Gimbal, complete with bushing | 1 | 1 | ring | Brass ring pivoted in the box at two points; the case pivots in it 90 deg away (Sec. II). |  | ✓ |
| 106-7 | 42214 | Bushing - Pivot screw (in the gimbal ring) | 1 | 1 | ring | Bearing in the ring for a gimbal ring pivot screw. | in 42106 (press): 2.4 mm, least gap -0.0 | ✓ |
| 106-8 | 42107 | Strap - Gimbal support, complete with bushing | 1 | 1 | ring | Slotted strap on the ring carrying the other gimbal pivot bushing; its slots set the level (Sec. II). | on 42106: 0 mm | ✓ |
| 106-9 | 42116 | Screw - Gimbal support strap | 2 | 2 | ring | Hold the gimbal support strap to the ring. | in 42107 (embed): 1.188 mm, least gap -1.638<br>in 42106 (embed): 2.029 mm, least gap -1.638 | ✓ |
| 106-7 | 42214 | Bushing - Pivot screw (in the gimbal support strap) | 1 | 1 | ring | Bearing in the strap for the other gimbal ring pivot screw. | in 42107 (press): 1.999 mm, least gap 0 | ✓ |
| 106-10 | 42108 | Strap - Case support | 1 | 1 | ring | Slotted strap on the ring for the case front pivot; sets the level (Sec. II). | on 42106: 0 mm | ✓ |
| 106-9 | 42116 | Screw - Case support strap | 2 | 2 | ring | Hold the case support strap to the ring. | in 42108 (embed): 1.188 mm, least gap -1.8614<br>in 42106 (embed): 2.001 mm, least gap -1.8614 | ✓ |
| 106-11 | 42118 | Screw - Case rear pivot | 1 | 1 | ring | Rear pivot of the case in the ring, running in a case bracket's bushing. | in 42214.c (run): 1.948 mm, least gap 0.0254 | ✓ |
| 106-12 | 42121 | Nut - Pivot screw lock (case rear) | 1 | 1 | ring | Locks the case rear pivot screw, inside the ring (the top-view photograph). | on 42106: 0 mm | ✓ |
| 106-13 | 42119 | Screw - Case front pivot | 1 | 1 | ring | Front pivot of the case, through the case support strap, running in a case bracket's bushing. | in 42214.c (run): 1.935 mm, least gap 0.0254 | ✓ |
| 106-12 | 42121 | Nut - Pivot screw lock (case front) | 1 | 1 | ring | Locks the case front pivot screw, inside the ring (the top-view photograph shows the rear's so; no nut outside the strap at 6). | on 42106: 0 mm | ✓ |
| 106-14 | 42120 | Screw - Gimbal ring pivot | 2 | 2 | ring | Through the box sides into the bushings of the ring and its support strap: the ring's two pivots (Sec. II). | in 42201 (embed): 20.936 mm, least gap None<br>in 42214.r/42214.s (run): 1.726 mm, least gap 0.0254 | ✓ |
| 106-15 | 42122 | Washer - Gimbal ring pivot screw | 2 | 2 | ring | Under the head of the gimbal ring pivot screw, outside the box (Fig. 106); its thickness sets how far the screw reaches into the ring's bushing, and so the ring's freedom (Op. 104). | on 42201: 0 mm | ✓ |
| 106-12 | 42121 | Nut - Pivot screw lock (gimbal ring) | 2 | 2 | ring | Locks each gimbal ring pivot screw, inside the box against its wall (Fig. 106). | on 42201: 0 mm | ✓ |
| 106-16 | 42109 | Bracket - Latch support | 1 | 1 | latch | Screwed into the corner of the box from outside (Fig. 106); the latch lever turns on the clamping screw threaded into it. | on 42201: 0 mm | ✓ |
| 106-17 | 42110 | Bracket - Latch clamping | 1 | 1 | latch | Lies on the lever's boss under the clamping screw's head, its leg on the support bracket: tightening the screw clamps the lever (Fig. 106). | on 42111: 0 mm<br>on 42109: 0 mm | ✓ |
| 106-18 | 42123 | Washer - Latch support bracket screw | 2 | 2 | latch | Under the heads of the support bracket screws, outside the box. | on 42201: 0 mm | ✓ |
| 106-19 | 42115 | Screw - Latch support bracket | 2 | 2 | latch | Hold the latch support bracket, from outside the box. | in 42201 (embed): 21.002 mm, least gap -1.4891<br>in 42109 (embed): 2.352 mm, least gap -1.4891 | ✓ |
| 106-20 | 42111 | Lever - Latch | 1 | 1 | latch | Swings in through the ring's slot to the keeper on the case, locking ring and case (Sec. II). | round 42114 (free): 2.314 mm, least gap 0.0629<br>on 42277: 0 mm | ✓ |
| 106-21 | 42277 | Spring - Latch lever take-up | 1 | 1 | latch | Flat spring on the support bracket pressing up on the collar under the lever, taking up its play on the clamping screw (Fig. 106). | on 42109: 0 mm<br>on 42111: 0 mm | ✓ |
| 106-22 | 42276 | Screw - Latch lever take-up spring | 2 | 2 | latch | Hold the take-up spring. | in 42277 (clear): 0.293 mm, least gap 0.0418<br>in 42109 (tap): 1.516 mm, least gap 0.0218 | ✓ |
| 106-23 | 42114 | Screw - Latch clamping | 1 | 1 | latch | Knurled thumb screw: the lever's pivot, through the clamping bracket into the support bracket; tightened, it clamps the lever (Fig. 106). | in 42110 (clear): 0.604 mm, least gap 0.1312<br>in 42109 (tap): 2.515 mm, least gap 0.0332 | ✓ |
| 106-24 | 42112 | Handle - Latch lever | 1 | 1 | latch | Knurled handle by which the lever is turned. | on 42111: 0 mm | ✓ |

## Fig. 107: case, dial and motion work

| Idx | No. | Name | Manual | Model | Card | Function | Fit and drive (measured) | |
|---|---|---|---|---|---|---|---|---|
| 107-1 | 42101 | Case - Chronometer | 1 | 1 | bowl | Brass bowl holding the movement; the key hole in its bottom (Sec. II). |  | ✓ |
| 107-2 | 42102 | Bezel - Complete with crystal | 1 | 1 | bowl | Bezel carrying the crystal; taken off to set the hands (Sec. III). | on 42101: 0 mm | ✓ |
| 107-3 | 42103 | Crystal | 1 | 1 | bowl | Glass over the dial. | on 42102: 0 mm | ✓ |
| 107-4 | 42105 | Bracket - Case support, complete with bushing | 2 | 2 | bowl | On the case at front and rear; the case pivots in them (Sec. II). | on 42101: 0 mm | ✓ |
| 107-5 | 42117 | Screw - Case support bracket | 4 | 4 | bowl | Two hold each bracket to the case. | in 42105 (clear): 1.304 mm, least gap 0.7096<br>in 42101 (embed): 1.192 mm, least gap -1.7373 | ✓ |
| 107-6 | 42214 | Bushing - Pivot screw (in a case support bracket) | 2 | 2 | bowl | Bearing in each bracket for a case pivot screw. | in 42105 (press): 1.491 mm, least gap 0.0005 | ✓ |
| 107-7 | 42113 | Keeper - Latch, complete with steady pins | 1 | 1 | bowl | On the case, facing the ring's slot; the latch lever's tip goes into its window (KLUwI2UUCMQ 1:21.5-1:24.5). | on 42128: 0 mm | ✓ |
| 107-8 | 42116 | Screw - Latch keeper | 1 | 1 | bowl | Holds the keeper to the case, from outside through its plate into the case's wall. | in 42113 (clear): 1.528 mm, least gap 0.1256<br>in 42128 (clear): 0.296 mm, least gap 0.1267<br>in 42101 (embed): 1.922 mm, least gap -0.9928 | ✓ |
| 107-9 | 42128 | Washer - Separating | 1 | 1 | bowl | Between keeper and case. | on 42101: 0.0083 mm | ✓ |
| 107-10 | 42104 | Plate - Shield | 1 | 1 | bowl | Covers the winding hole; turned clockwise to admit the key, sprung back when it is removed (Sec. II). | round 42124 (free): 0.776 mm, least gap 0.072<br>also: bom.py fn: shield plate | ✓ |
| 107-11 | 42124 | Screw - Shield plate shoulder | 1 | 1 | bowl | The shield plate turns on its shoulder. | in 42101 (tap): 1.018 mm, least gap 0.0269 | ✓ |
| 107-12 | 42125 | Screw - Shield plate stop | 1 | 1 | bowl | Screwed into the plate, turning with it (KLUwI2UUCMQ 47:24, 47:36.5); its end in the gap carries the return spring's hook. | in 42104 (tap): 0.811 mm, least gap 0.0206 | ✓ |
| 107-13 | 42126 | Spring - Shield plate return | 1 | 1 | bowl | Turns the shield plate back over the hole when the key is removed (Sec. II). |  | ✓ |
| 107-15 | 42033 | Hand - Minute | 1 | 1 | hands | Broached square, on the cannon pinion's square below its end (Op. 64). | round 42077 (press): 1.147 mm, least gap 0.0215 | ✓ |
| 107-16 | 42032 | Hand - Hour | 1 | 1 | hands | Pressed on the hour wheel's pipe (Op. 64). | round 42080 (press): 0.596 mm, least gap 0.03 | ✓ |
| 107-17 | 42034 | Hand - Second, complete with pin | 1 | 1 | hands | On the fourth wheel's arbor; turns once a minute in half-second steps. | round 42073 (press): 0.623 mm, least gap 0.0043<br>also: invariants.py: second hand | ✓ |
| 107-18 | 42035 | Hand - Wind indicator | 1 | 1 | hands | On the wind indicator wheel's pipe; shows the hours run since winding (UP-DOWN). | round 42081 (press): 0.394 mm, least gap 0.0169<br>also: invariants.py: wind indicator | ✓ |
| 107-19 | 42030 | Dial - Modern arabic numeral style | 1 | 1 | dial | Hours, minutes, seconds and UP-DOWN scales (Sec. II); it lies on the mounting ring's flange. | on 42057: 0 mm | ✓ |
| 107-20 | 35756 | Screw - Dial | 4 | 4 | dial | Hold the dial by its feet, from the train side of the mounting ring's flange. | in 42057 (clear): 1.369 mm, least gap 0.2521<br>in 42030 (tap): 1.809 mm, least gap 0.0168 | ✓ |
| 107-21 | 42081 | Wheel - Wind indicator, complete with hub | 1 | 1 | motion | Driven by the pinion on the fusee arbor; turns on its post and carries the wind indicator hand (Sec. II). | round 42084 (free): 3.162 mm, least gap 0.0508<br>meshes 42022: centres 16.5802 (m(z1+z2)/2 16.5802), 120/12 teeth, faces overlap 0.5, ratio -10 | ✓ |
| 107-22 | 42080 | Wheel - Hour, complete with hub | 1 | 1 | motion | Driven by the minute pinion; turns free on the cannon pinion's pipe (Op. 59), once in 12 h. | round 42077 (free): 2.911 mm, least gap 0.0497<br>meshes 42078: centres 11.3 (m(z1+z2)/2 11.3), 54/18 teeth, faces overlap 0.8, ratio -3<br>also: invariants.py: hour hand | ✓ |
| 107-23 | 42078 | Wheel - Minute, complete with pinion | 1 | 1 | motion | Driven by the cannon pinion, drives the hour wheel; turns on its post. | round 42085 (free): 5.609 mm, least gap 0.0409<br>meshes 42077: centres 11.3 (m(z1+z2)/2 11.3), 56/14 teeth, faces overlap 0.8, ratio -4 | ✓ |
| 107-24 | 42077 | Pinion - Cannon | 1 | 1 | motion | A friction fit on the centre arbor (Op. 58), slipping when the hands are set; carries the minute hand. | round 42068 (press): 8.29 mm, least gap 0.0007 | ✓ |

## Fig. 108: balance, cock, setup and barrel bridge

| Idx | No. | Name | Manual | Model | Card | Function | Fit and drive (measured) | |
|---|---|---|---|---|---|---|---|---|
| 108-1 | 42066 | Cock - Balance, complete with pins | 1 | 1 | cock | Carries the balance upper setting and endstone cap and the hairspring stud; stands on the train bridge (Sec. II). | on 42062: 0 mm | ✓ |
| 108-2 | 42192 | Screw - Balance cock | 1 | 1 | cock | Holds the cock (Op. 74). | in 42066 (clear): 13.014 mm, least gap 0.1595<br>in 42062 (tap): 2.506 mm, least gap 0.0252 | ✓ |
| 108-3 | 42160 | Cap - Balance upper endstone, with jewel | 1 | 1 | cock | Holds the upper endstone over the olive-hole jewel. | on 42066: 0 mm | ✓ |
| 108-4 | 20762 | Screw - Balance upper endstone cap | 2 | 2 | cock | Hold the upper endstone cap. | in 42160 (clear): 0.728 mm, least gap 0.0509<br>in 42066 (tap): 1.794 mm, least gap 0.0152 | ✓ |
| 108-5 | 42155 | Setting - Balance upper endstone, with jewel | 1 | 1 | cock | Holds the balance upper endstone (cap jewel) in the cap. | in 42160 (press): 0.701 mm, least gap 0.0039 | ✓ |
|  |  | Jewel - Balance upper endstone (cap jewel) | 1 | 1 | cock | Stops the balance staff's upper pivot end; endshake 0.001-0.003 in (Op. 74). A diamond, the one jewel of the fourteen not a ruby: the balance runs on it dial up (Sinclair, NAWCC Bulletin 365, 2006). |  | ✓ |
| 108-6 | 42162 | Setting - Balance (upper), complete with jewel | 1 | 1 | cock | Olive-hole jewel for the balance staff's upper pivot, pressed into the cock. | in 42066 (press): 2.608 mm, least gap 0.0012 | ✓ |
|  |  | Jewel - Balance upper hole (olive-hole) | 1 | 1 | cock | The balance staff's upper pivot runs in it (Sec. II, Jeweling). |  | ✓ |
| 108-8 | 27760 | Screw - Hairspring stud | 1 | 1 | cock | Holds the stud under the cock, from the cock's top (Figs. 19, 84). | in 42066 (clear): 2.63 mm, least gap 0.0421<br>in 42189 (tap): 0.438 mm, least gap 0.0221 | ✓ |
| 108-9 | 42188 | Hairspring | 1 | 1 | spr | Cylindrical Elinvar spring: its restoring force times the balance (Sec. II). |  | ✓ |
| 108-10 | 42189 | Stud - Hairspring, complete with pins | 1 | 1 | spr | Holds the hairspring's upper end under the cock, by its clamp and wedge pin (Sec. II, Fig. 5). | on 42066: 0 mm | ✓ |
| 108-11 | 42147 | Pin - Hairspring stud clamp wedge | 1 | 1 | spr | Wedges the stud clamp on the spring's end without bending it (Fig. 6). |  | ✓ |
| 108-12 | 42191 | Clamp - Hairspring stud | 1 | 1 | spr | Holds the spring's upper end in the stud. | on 42189: 0 mm | ✓ |
| 108-13 | 42190 | Collet - Hairspring | 1 | 1 | bal | Slotted to grip the balance staff; carries the spring's inner end (Sec. II, Fig. 5). | round 42186 (press): 2.718 mm, least gap 0.0121 | ✓ |
| 108-11 | 42147 | Pin - Hairspring collet clamp wedge | 1 | 1 | bal | Wedges the collet clamp on the spring's inner end (Fig. 6). |  | ✓ |
| 108-12 | 42191 | Clamp - Hairspring collet | 1 | 1 | bal | Holds the spring's inner end on the collet's tongue. | on 42190: 0.02 mm | ✓ |
| 108-14 | 42178 | Wheel - Balance, complete with spoke | 1 | 1 | bal | Solid stainless rim silver-soldered to an Invar arm; tapped holes all round for the screws and weights (Sec. II). | on 42186: 0 mm | ✓ |
| 108-15 | 42177 | Screw - Timing weight | 2 | 2 | bal | The timing weights turn on them (Fig. 3). | in 42178 (embed): 0.635 mm, least gap -0.3971 | ✓ |
| 108-16 | 42176 | Weight - Timing, 93 +/- 1 mg | 2 | 2 | bal | A full turn of the pair changes the rate about 40 s a day (p. 70). | round 42177 (tap): 2.2 mm, least gap 0.0227<br>also: invariants.py: timing weights 40 s/day | ✓ |
| 108-17 | 42197 | Screw - Vernier timing weight | 2 | 2 | bal | The vernier weights turn on them. | in 42178 (embed): 0.64 mm, least gap -0.2482 | ✓ |
| 108-18 | 37115 | Weight - Vernier timing, 10.5 +/- 0.3 mg | 2 | 2 | bal | A full turn of the pair changes the rate about 2.8 s a day (p. 70). | round 42197 (tap): 1.476 mm, least gap 0.0217<br>also: invariants.py: vernier weights 2.8 s/day | ✓ |
| 108-19 | 42171 | Screw - Balance, 125-130 mg, 0.049 in head height | 4-6 | 4 | bal | Balance screws for rate and temperature adjustment (Secs. II, IX). | in 42178 (embed): 0.592 mm, least gap -0.533<br>also: invariants.py: moment of inertia | ✓ |
| 108-20 | 42173 | Screw - Balance, 200-205 mg, 0.080 in head height | 2 | 2 | bal | Balance screws, heavier. | in 42178 (embed): 0.59 mm, least gap -0.3475 | ✓ |
| 108-21 | 42174 | Screw - Balance, 250-255 mg, 0.101 in head height | 2 | 2 | bal | Balance screws, heaviest. | in 42178 (embed): 0.589 mm, least gap -0.3475 | ✓ |
| 108-23 | 42252 | Roller - Unlocking, complete with jewel | 1 | 1 | bal | Carries the unlocking (discharge) jewel that lifts the detent through the trip spring (Sec. IV). | round 42186 (press): 3.038 mm, least gap 0.005<br>also: escapement.js | ✓ |
| 108-24 | 287 | Jewel - Unlocking | 1 | 1 | bal | Unlocks the escape wheel through the trip spring, on one swing only (Sec. IV). | also: escapement.js: overall, let-off | ✓ |
| 108-25 | 42263 | Roller - Impulse, complete with jewel (Identity No. 3; O.D. .249) | 1 | 1 | bal | Carries the impulse jewel; its 0.249 in O.D. sets the roller shake (Op. 84). | round 42186 (press): 1.439 mm, least gap 0.0096<br>also: escapement.js: roller shake | ✓ |
| 108-26 | 286 | Jewel - Impulse | 1 | 1 | bal | Receives the escape wheel's impulse (Sec. IV). | also: escapement.js: drop | ✓ |
| 108-28 | 42248 | Cap - Balance wheel | 1 | 1 | bal | Over the arm on the hub's boss, under the hold-down screws (Fig. 4). | on 42178: 0 mm | ✓ |
| 108-29 | 42249 | Screw - Balance wheel hold-down | 2 | 2 | bal | Through cap and arm into the hub's flange (Fig. 4). | in 42248 (clear): 0.871 mm, least gap 0.0514<br>in 42186 (tap): 0.484 mm, least gap 0.0246 | ✓ |
| 108-30 | 42186 | Hub - Balance wheel, complete with staff | 1 | 1 | bal | The staff with its pivots; its hub carries the arm clear of the staff (Fig. 4). | in J.bu (run): 0.48 mm, least gap 0.0118<br>in J.bl (run): 0.48 mm, least gap 0.0118<br>endshake 0.050 mm (J.ble / J.bue) | ✓ |
| 108-31 | 42299 | Arm - Balance wheel locking | 1 | 1 | lockArm | Turned so the finger at its end stands beside a timing weight, to hold the balance in transit (Sec. III, Fig. 9; Sec. X). | round 37204 (free): 0.44 mm, least gap 0.0591<br>also: bom.py fn: locking arm | ✓ |
| 108-32 | 37204 | Screw - Flat head fillister (NAVOBSY 4618) | 1 | 1 | lockArm | The locking arm turns on it and is clamped by it. | in 42299 (clear): 0.44 mm, least gap 0.0591<br>in 42062 (tap): 2.494 mm, least gap 0.0225 | ✓ |
| 108-33 | 42251 | Washer (NAVOBSY 55-3) | 1 | 1 | lockArm | Under the locking arm's screw. | on 42299: 0 mm | ✓ |
| 108-34 | 42300 | Pin - Balance wheel locking arm stop | 1 | 1 | lockArm | Stops the arm when unlocked, clear of the balance (Fig. 9). | in 42062 (press): 0.801 mm, least gap 0.0044 | ✓ |
| 108-35 | 42029 | Plate - Setup cover | 1 | 1 | ratchet | Covers the setup ratchet and click; holds the click's pivot screw (Sec. II). |  | ✓ |
| 108-36 | 42056 | Screw - Setup cover plate | 2 | 2 | ratchet | Hold the cover plate on its feet to the barrel bridge. | in 42029 (clear): 2.465 mm, least gap 0.0665<br>in 42061 (tap): 2.218 mm, least gap 0.0223 | ✓ |
| 108-37 | 42026 | Wheel - Setup ratchet | 1 | 1 | ratchet | On the barrel arbor's square above the barrel bridge (its hole square, KLUwI2UUCMQ 23:30, 11:58); held by the click so the arbor never turns in winding or running (Sec. II). | round 42170 (press): 1.085 mm, least gap 0.0102<br>also: bom.py fn: setup click | ✓ |
| 108-38 | 42027 | Pawl - Setup | 1 | 1 | ratchet | The click: bears on the setup ratchet's steep faces against the mainspring's pull (Sec. II). | round 42036 (free): 0.84 mm, least gap 0.0276<br>on 42026: 0.003 mm | ✓ |
| 108-39 | 42051 | Seal - Dust | 1 | 1 | post | Seals where the fusee arbor rises through the barrel bridge (Fig. 24). | on 42061: 0.02 mm | ✓ |
| 108-36 | 42056 | Screw - Dust seal | 2 | 2 | post | Hold the dust seal's flange to the barrel bridge. | in 42051 (clear): 0.98 mm, least gap 0.0658<br>in 42061 (tap): 1.96 mm, least gap 0.0237 | ✓ |
| 108-40 | 42054 | Ring - Packing | 3 | 3 | post | Stacked in the seal round the arbor's square. | on 42051/42054: 0 mm | ✓ |
| 108-41 | 42052 | Ring - Seal | 1 | 1 | post | Bears on the fusee arbor inside the dust seal. | on 42053: 0.0008 mm | ✓ |
| 108-42 | 42053 | Spring - Helical seal | 1 | 1 | post | Stands on the barrel bridge round the fusee's bushing, under the dust seal, and presses the seal ring against the seal's roof (KLUwI2UUCMQ 12:34-12:38.5). | on 42061: 0 mm | ✓ |
| 108-43 | 42061 | Bridge - Barrel, complete with pins | 1 | 1 | barrelBridge | Holds the upper pivots of the barrel and fusee; the winding stop is screwed into its underside (Sec. II). | on 42062/42058: 0 mm | ✓ |
| 108-44 | 42055 | Screw - Barrel bridge pillar | 1 | 1 | barrelBridge | Holds the barrel bridge to its pillar. | in 42061 (clear): 3.399 mm, least gap 0.1814<br>in 42058 (tap): 2.981 mm, least gap 0.0203 | ✓ |
| 108-44 | 42055 | Screw - Barrel bridge | 2 | 2 | barrelBridge | Hold the barrel bridge to the train bridge. | in 42061 (clear): 3.386 mm, least gap 0.1814<br>in 42062/42059 (tap): 2.59 mm, least gap 0.0352 | ✓ |
| 108-45 | 42164 | Bushing - Barrel upper | 1 | 1 | barrelBridge | Bearing for the barrel arbor's upper end. | in 42061 (press): 3.402 mm, least gap 0.0012 | ✓ |
| 108-45 | 42164 | Bushing - Fusee upper | 1 | 1 | barrelBridge | Bearing for the fusee arbor's upper end. | in 42061 (press): 3.402 mm, least gap 0.0012 | ✓ |
| 108-46 | 42028 | Spring - Setup pawl, complete with pins | 1 | 1 | ratchet | Holds the click in the setup ratchet's teeth. | on 42027: 0.0149 mm | ✓ |
| 108-47 | 42036 | Screw - Setup pawl pivot | 1 | 1 | ratchet | The click turns on it; through the cover into the barrel bridge. | in 42029 (clear): 1.037 mm, least gap 0.1048<br>in 42061 (tap): 3.359 mm, least gap 0.0212 | ✓ |
| 108-48 | 42099 | Stop - Fusee winding stop-bar | 1 | 1 | barrelBridge | Stud under the barrel bridge (left-hand thread, Op. 42) that the stop-bar meets at full wind (Sec. II). | in 42061 (tap): 2.021 mm, least gap 0.0317<br>also: maintaining.py: stop-bar meets the stop | ✓ |

## Fig. 109: barrel and fusee

| Idx | No. | Name | Manual | Model | Card | Function | Fit and drive (measured) | |
|---|---|---|---|---|---|---|---|---|
| 109-1 | 42169 | Cap - Barrel | 1 | 1 | barrel | Closes the barrel on the pillar-plate end, held by five screws (Figs. 26, 109). | on 42168: 0 mm | ✓ |
| 109-2 | 37023 | Screw - Barrel cap | 5 | 5 | barrel | Hold the barrel cap. | in 42169 (clear): 0.572 mm, least gap 0.0284<br>in 42168 (tap): 0.811 mm, least gap 0.0232 | ✓ |
| 109-3 | 42170 | Arbor - Barrel | 1 | 1 | ratchet | Carries the mainspring's inner end on its hook; held still by the setup ratchet and click (Sec. II). | in 42164.bu (run): 3.256 mm, least gap 0.0319<br>in 42164.bl (run): 3.039 mm, least gap 0.0301 | ✓ |
| 109-4 | 42038 | Mainspring - Complete with anchor pin, 0.0165 in thick | 1 | 1 | mainspring | The power: inner end on the arbor's hook, outer end by its pin at the brace (Sec. II). | also: fine.py: barrel-clearance.js coils inside the barrel | ✓ |
| 109-5 | 42037 | Brace - Mainspring | 1 | 1 | barrel | Lines the wall where the mainspring's outer end hooks. | on 42168: 0 mm | ✓ |
| 109-6 | 42168 | Barrel - Mainspring, complete with anchor pin | 1 | 1 | barrel | Turns clockwise in running, drawing the chain off the fusee (Sec. IV). | round 42170 (run): 1.085 mm, least gap 0.033 | ✓ |
| 109-7 | 42020 | Pin - Taper, fusee assembly | 1 | 1 | fusee | Through the arbor under the end plate: holds the stack on (Figs. 28, 70). | in 42022 (embed): 4.387 mm, least gap -0.2136 | ✓ |
| 109-8 | 42019 | Plate - Fusee end | 1 | 1 | fusee | Under the fusee wheel, held by the taper pin. | round 42022 (free): 0.511 mm, least gap 0.0557 | ✓ |
| 109-9 | 42015 | Wheel - Fusee | 1 | 1 | gw | First wheel of the train, free on the fusee arbor; drives the centre pinion (Secs. II, IV). | round 42022 (free): 3.324 mm, least gap 0.043<br>meshes 42068: centres 20.3829 (m(z1+z2)/2 20.3829), 90/14 teeth, faces overlap 1.4, ratio -6.428571 | ✓ |
| 109-10 | 42016 | Spring - Sustaining, complete with pins | 1 | 1 | sspring | Under load in running; drives the train alone for 5-10 minutes while winding (Sec. IV). | also: maintaining.py: spring loaded in running, relaxes in winding | ✓ |
| 109-11 | 42009 | Wheel - Sustaining ratchet, complete with pawls | 1 | 1 | sratchet | Free on the fusee wheel's hub (Op. 20, Fig. 71); its pawls take the winding ratchet's drive in running; the sustaining pawl holds it in winding (Sec. IV). | round 42015 (free): 1.118 mm, least gap 0.0477<br>also: maintaining.py: never turns back | ✓ |
| 109-12 | 42007 | Spring - Winding pawl, complete with pins | 2 | 2 | sratchet | Hold the winding pawls in the winding ratchet's teeth. | on 42009: 0 mm<br>also: maintaining.py: pawls on their teeth | ✓ |
| 109-13 | 42012 | Screw - Winding pawl spring | 4 | 4 | sratchet | Hold the winding pawl springs: put in from the ratchet's underside, through it into the springs' feet (restoration video 28:35; Fig. 28). | in 42009 (clear): 0.956 mm, least gap 0.0341<br>in 42007 (tap): 0.621 mm, least gap 0.0215 | ✓ |
| 109-14 | 42013 | Wheel - Winding ratchet | 1 | 1 | fusee | Screwed to the fusee's large end; its teeth drive the winding pawls in running, slip under them in winding (Sec. IV). | on 42021: 0 mm<br>also: maintaining.py: fusee catches forward | ✓ |
| 109-15 | 42014 | Screw - Winding ratchet wheel | 2 | 2 | fusee | Hold the winding ratchet to the fusee. | in 42013 (clear): 0.477 mm, least gap 0.1509<br>in 42021 (tap): 1.192 mm, least gap 0.0236 | ✓ |
| 109-16 | 42008 | Plate - Fusee top | 1 | 1 | fusee | Covers the stop-bar and its spring in the fusee's top. | on 42021: 0 mm | ✓ |
| 109-17 | 27760 | Screw - Fusee top plate | 2 | 2 | fusee | Hold the top plate. | in 42008 (clear): 0.568 mm, least gap 0.0437<br>in 42021 (tap): 0.52 mm, least gap 0.0207 | ✓ |
| 109-18 | 42025 | Spring - Winding stop-bar | 1 | 1 | fusee | Draws the stop-bar back when the chain runs off its last turn. | on 42024: 0 mm | ✓ |
| 109-19 | 42024 | Stop-bar - Winding | 1 | 1 | fusee | Pushed out by the chain at full wind to meet the winding stop (Secs. II, IV). | also: maintaining.py: stop-bar meets the stop | ✓ |
| 109-20 | 42021 | Fusee - Complete with arbor | 1 | 1 | fusee | Its spiral groove evens the mainspring's pull on the train (Sec. II). |  | ✓ |
| 109-21 | 42022 | Arbor - Fusee, complete with wind indicator pinion | 1 | 1 | fusee | Squared for the key; its pinion drives the wind indicator wheel (Sec. II). | in 42164.fu (run): 3.58 mm, least gap 0.0347<br>in 42164.fl (run): 3.58 mm, least gap 0.0329<br>meshes 42081: centres 16.5802 (m(z1+z2)/2 16.5802), 12/120 teeth, faces overlap 0.5, ratio -0.1<br>also: invariants.py: wind indicator | ✓ |
| 109-22 | 42001 | Fusee Chain Assembly | 1 | 1 | chain | Links barrel to fusee; hooked to the barrel, pinned to the fusee (Sec. II, Figs. 26, 28). | also: fine.py: links on the fusee | ✓ |

## Fig. 110: escapement, train, bridges and pillar plate

| Idx | No. | Name | Manual | Model | Card | Function | Fit and drive (measured) | |
|---|---|---|---|---|---|---|---|---|
| 110-1 | 20762 | Screw - Escape upper bridge | 2 | 2 | escBridge | Hold the escape upper bridge (Op. 69). | in 42064 (clear): 1.023 mm, least gap 0.0535<br>in 42062 (tap): 1.997 mm, least gap 0.0234 | ✓ |
| 110-2 | 42064 | Bridge - Escape upper, complete with pins | 1 | 1 | escBridge | Holds the escape wheel's upper setting and endstone cap. | on 42062: 0 mm | ✓ |
| 110-3 | 42162 | Setting - Escape upper, complete with jewel | 1 | 1 | escBridge | Olive-hole jewel for the escape arbor's upper pivot. | in 42064 (press): 0.901 mm, least gap 0.0005 | ✓ |
|  |  | Jewel - Escape upper hole (olive-hole) | 1 | 1 | escBridge | The escape arbor's upper pivot runs in it. |  | ✓ |
| 110-4 | 42159 | Cap - Escape upper endstone, complete with jewel | 1 | 1 | escBridge | Holds the escape arbor's upper endstone; milled or changed to set the endshake (Op. 69). | on 42064: 0 mm | ✓ |
|  |  | Jewel - Escape upper endstone (cap jewel) | 1 | 1 | escBridge | Stops the escape arbor's upper pivot end. |  | ✓ |
| 110-1 | 20762 | Screw - Escape upper endstone cap | 2 | 2 | escBridge | Hold the escape upper endstone cap. | in 42159.eu (clear): 0.966 mm, least gap 0.0379<br>in 42064 (tap): 1.014 mm, least gap 0.021 | ✓ |
| 110-6 | 42056 | Screw - Detent support block | 1 | 1 | trainBridge | Holds the support block under the train bridge, with two positioning pins (Sec. II). From above, through the train bridge into a tapped hole in the block, as the manual and the video have it. | in 42086 (tap): 2.416 mm, least gap 0.0185<br>in 42062 (clear): 3.106 mm, least gap 0.0656 | ✓ |
| 110-7 | 42087 | Detent - Complete with jewel (beryllium copper) | 1 | 1 | det | Its locking jewel holds the escape wheel; lifted by the unlocking jewel through the trip spring (Sec. IV). | on 42086: 0 mm<br>also: escapement.js: lock, let-off, overall | ✓ |
| 110-8 | 42089 | Pin - Locking jewel wedge | 1 | 1 | det | Wedges the locking jewel in its hole (Figs. 57-59). | on 285: 0.0033 mm | ✓ |
| 110-9 | 285 | Jewel - Locking | 1 | 1 | det | Locks each tooth of the escape wheel until the detent is lifted (Sec. IV). | also: escapement.js: lock | ✓ |
| 110-10 | 42092 | Bracket - Detent trip spring support angle | 1 | 1 | det | Carries the trip spring on the detent (Sec. IV). | on 42087: 0 mm | ✓ |
| 110-11 | 1770 | Screw - Detent trip spring support bracket | 1 | 1 | det | Holds the angle bracket to the detent: across the bracket's leg on the detent into the blade (KLUwI2UUCMQ 11:10-11:33: that leg holds the screw). | in 42092 (embed): 0.32 mm, least gap -0.0784<br>in 42087 (embed): 0.137 mm, least gap -0.0784 | ✓ (deviation) |
| 110-12 | 42088 | Spring - Detent trip (Hamilton Elinvar) | 1 | 1 | det | Passes the unlocking jewel on the return swing; lifts the detent on the unlocking swing (Sec. IV). | on 42092: 0.0013 mm<br>also: escapement.js: overall | ✓ |
| 110-11 | 1770 | Screw - Detent trip spring | 1 | 1 | det | Holds the trip spring on the bracket: through the hole in the spring's foot into the bracket's upright leg (Figs. 14, 54). | in 42092 (embed): 0.363 mm, least gap -0.0684<br>on 42088: 0 mm | ✓ |
| 110-13 | 42086 | Block - Detent support, complete with button and pins | 1 | 1 | det | Fixed under the train bridge by one screw and two positioning pins; carries the detent, the stop button and the adjusting screws (Secs. II, IV). | on 42062: 0 mm | ✓ |
| 110-14 | 42091 | Screw - Detent lock adjusting clamp | 1 | 1 | det | Clamps the lock-adjusting screw. | in 42086 (embed): 1.206 mm, least gap -0.197 | ✓ |
| 110-14 | 42091 | Screw - Detent lock adjusting | 1 | 1 | det | Sets the depth of lock through the stop button (Op. 85). | in 42086 (embed): 0.954 mm, least gap -0.197<br>also: escapement.js: lock | ✓ |
| 110-15 | 20756 | Screw - Detent adjusting | 1 | 1 | det | Sets the detent lengthwise (Ops. 84, 93): threaded into the block's end, its head in a slot in the detent's foot (Fig. 90). | in 42086 (embed): 0.681 mm, least gap -0.3448<br>on 42087: 0 mm | ✓ |
| 110-16 | 37024 | Screw - Detent clamp | 1 | 1 | det | Clamps the detent's foot to the block, with a washer and two steady pins (Sec. IV). | in 42087 (embed): 1.085 mm, least gap -0.6426<br>in 42086 (embed): 2.021 mm, least gap -0.6426 | ✓ |
| 110-17 | 42251 | Washer - Detent clamp screw | 1 | 1 | det | Under the detent clamp screw. | on 42087: 0 mm | ✓ |
| 110-18 | 42076 | Wheel - Escape, complete with pinion | 1 | 1 | escW | Released one tooth a beat; impulses the balance (Sec. IV). | in J.eu (run): 0.436 mm, least gap 0.006<br>in J.el (run): 0.436 mm, least gap 0.006<br>endshake 0.035 mm (42087 / J.eue)<br>meshes 42073: centres 10.4437 (m(z1+z2)/2 10.4437), 10/75 teeth, faces overlap 0.9, ratio -0.133333<br>also: escapement.js | ✓ |
| 110-19 | 42062 | Bridge - Upper train | 1 | 1 | trainBridge | Carries the centre and third upper bushings; the cock, balance lower bridge, escape upper bridge and detent block are mounted to it (Sec. II). | on 42059: 0 mm | ✓ |
| 110-20 | 42055 | Screw - Pillar upper train bridge | 3 | 3 | trainBridge | Hold the upper train bridge to its three pillars (Op. 14). | in 42062 (clear): 3.125 mm, least gap 0.1814<br>in 42059 (tap): 2.974 mm, least gap 0.0197 | ✓ |
| 110-21 | 42166 | Bushing - Center wheel upper | 1 | 1 | trainBridge | Bearing for the centre arbor's upper pivot. | in 42062 (press): 3.104 mm, least gap 0.0025 | ✓ |
| 110-22 | 42167 | Bushing - Third wheel upper | 1 | 1 | trainBridge | Bearing for the third arbor's upper pivot. | in 42062 (press): 3.104 mm, least gap 0.0024 | ✓ |
| 110-23 | 42073 | Wheel - Fourth, complete with pinion | 1 | 1 | fw | Turns once a minute; its arbor carries the second hand (Sec. II). | in J.fu (run): 0.373 mm, least gap 0.0219<br>in J.fl (run): 0.373 mm, least gap 0.0127<br>endshake 0.050 mm (J.fl / J.fu)<br>meshes 42071: centres 11.2972 (m(z1+z2)/2 11.2972), 10/80 teeth, faces overlap 0.65, ratio -0.125<br>also: invariants.py: second hand | ✓ |
| 110-24 | 42068 | Wheel - Center, complete with pinion | 1 | 1 | cw | Turns once an hour; its long arbor carries the cannon pinion and hour wheel (Sec. II). | in 42166 (run): 2.629 mm, least gap 0.0206<br>in 42165 (run): 4.044 mm, least gap 0.0211<br>endshake 0.050 mm (42165 / 42166)<br>also: invariants.py: minute hand | ✓ |
| 110-25 | 42071 | Wheel - Third, complete with pinion | 1 | 1 | tw | Drives the fourth pinion. | in 42167 (run): 2.488 mm, least gap 0.0208<br>in J.tl (run): 0.332 mm, least gap 0.0098<br>endshake 0.050 mm (J.tl / 42167)<br>meshes 42068: centres 16.55 (m(z1+z2)/2 16.55), 12/90 teeth, faces overlap 0.7, ratio -0.133333 | ✓ |
| 110-26 | 42096 | Pawl - Sustaining, complete with arbor and springs | 1 | 1 | spawl | Holds the sustaining ratchet from turning back while winding (Sec. IV). | in 42062 (run): 0.616 mm, least gap 0.0271<br>in 42060 (run): 1.97 mm, least gap 0.0274<br>on 42009: 0 mm<br>also: maintaining.py: pawl on its teeth | ✓ |
| 110-27 | 42065 | Bridge - Balance lower, complete with pins | 1 | 1 | lowerBridge | Holds the balance lower setting and cap and the fourth upper setting; carries the train-blocking screw (Sec. II). | on 42062: 0 mm | ✓ |
| 110-20 | 42055 | Screw - Balance lower bridge | 2 | 2 | lowerBridge | Hold the balance lower bridge to the train bridge (Ops. 12, 50). | in 42065 (clear): 3.486 mm, least gap 0.1814<br>in 42062 (tap): 2.49 mm, least gap 0.0352 | ✓ |
| 110-28 | 42161 | Setting - Fourth wheel upper, complete with jewel | 1 | 1 | lowerBridge | Bar-hole jewel for the fourth arbor's upper pivot. | in 42065 (press): 2.608 mm, least gap 0.0008 | ✓ |
|  |  | Jewel - Fourth upper hole (bar-hole) | 1 | 1 | lowerBridge | The fourth arbor's upper pivot runs in it. |  | ✓ |
| 110-3 | 42162 | Setting - Balance wheel lower, complete with jewel | 1 | 1 | lowerBridge | Olive-hole jewel for the balance staff's lower pivot. | in 42065 (press): 2.602 mm, least gap 0.0009 | ✓ |
|  |  | Jewel - Balance lower hole (olive-hole) | 1 | 1 | lowerBridge | The balance staff's lower pivot runs in it. |  | ✓ |
| 110-4 | 42159 | Cap - Balance lower endstone, complete with jewel | 1 | 1 | lowerBridge | Holds the balance staff's lower endstone. | on 42065: 0 mm | ✓ |
|  |  | Jewel - Balance lower endstone (cap jewel) | 1 | 1 | lowerBridge | Stops the balance staff's lower pivot end. |  | ✓ |
| 110-1 | 20762 | Screw - Balance lower endstone cap | 2 | 2 | lowerBridge | Hold the balance lower endstone cap. | in 42159.bl (clear): 0.436 mm, least gap 0.0379<br>in 42065 (tap): 1.989 mm, least gap 0.0214 | ✓ |
| 110-29 | 42247 | Screw - Train blocking (from serial 4003) | 1 | 1 | tblock | Screwed down, its dog point stands between the fourth wheel's spokes and holds the train (Sec. II). | in 42065 (tap): 2.694 mm, least gap 0.0272<br>also: bom.py fn: train-blocking screw | ✓ |
| 110-30 | 42059 | Pillar - Train bridge | 3 | 3 | pillars | Hold the upper train bridge off the pillar plate (Sec. II). | on 42060: 0 mm | ✓ |
| 110-20 | 42055 | Screw - Pillar train bridge | 3 | 3 | pillar | Hold the train bridge pillars, from the dial side of the pillar plate. | in 42060 (clear): 3.881 mm, least gap 0.1815<br>in 42059 (tap): 3.18 mm, least gap 0.0192 | ✓ |
| 110-31 | 42058 | Pillar - Barrel bridge | 1 | 1 | pillars | Holds the barrel bridge off the pillar plate. | on 42060: 0 mm | ✓ |
| 110-20 | 42055 | Screw - Pillar barrel bridge | 1 | 1 | pillar | Holds the barrel bridge pillar, from the dial side. | in 42060 (clear): 3.881 mm, least gap 0.1815<br>in 42058 (tap): 3.18 mm, least gap 0.0192 | ✓ |
| 110-32 | 42063 | Bridge - Lower train, complete with pins | 1 | 1 | ltb | On the dial side of the pillar plate: the third and fourth lower settings (Sec. II). | on 42060: 0 mm | ✓ |
| 110-33 | 42163 | Screw - Lower train bridge | 2 | 2 | ltb | Hold the lower train bridge (Ops. 7, 53). | in 42063 (clear): 4.414 mm, least gap 0.0967<br>in 42060 (tap): 3.472 mm, least gap 0.0231 | ✓ |
| 110-28 | 42161 | Setting - Third lower, complete with jewel | 1 | 1 | ltb | Bar-hole jewel for the third arbor's dial end. | in 42063 (press): 3.599 mm, least gap 0.0032 | ✓ |
|  |  | Jewel - Third lower hole (bar-hole) | 1 | 1 | ltb | The third arbor's lower pivot runs in it. |  | ✓ |
| 110-28 | 42161 | Setting - Fourth lower, complete with jewel | 1 | 1 | ltb | Bar-hole jewel for the fourth arbor's dial end. | in 42063 (press): 3.599 mm, least gap 0.0032 | ✓ |
|  |  | Jewel - Fourth lower hole (bar-hole) | 1 | 1 | ltb | The fourth arbor runs in it. |  | ✓ |
| 110-34 | 42060 | Plate - Pillar, complete with pins | 1 | 1 | pillar | Foundation of the movement (Sec. II). |  | ✓ |
| 110-4 | 42159 | Cap - Escape lower endstone, complete with jewel | 1 | 1 | pillar | Holds the escape arbor's lower endstone, on the dial side. | on 42060: 0 mm | ✓ |
|  |  | Jewel - Escape lower endstone (cap jewel) | 1 | 1 | pillar | Stops the escape arbor's lower pivot end. |  | ✓ |
| 110-1 | 20762 | Screw - Escape lower endstone cap | 2 | 2 | pillar | Hold the escape lower endstone cap. | in 42159.el (clear): 0.344 mm, least gap 0.0379<br>in 42060 (tap): 3.437 mm, least gap 0.0209 | ✓ |
| 110-3 | 42162 | Setting - Escape wheel lower, complete with jewel | 1 | 1 | pillar | Olive-hole jewel for the escape arbor's lower pivot, in the pillar plate. | in 42060 (press): 3.863 mm, least gap 0.0006 | ✓ |
|  |  | Jewel - Escape lower hole (olive-hole) | 1 | 1 | pillar | The escape arbor's lower pivot runs in it. |  | ✓ |
| 110-35 | 42084 | Post - Wind indicator wheel | 1 | 1 | pillar | The wind indicator wheel turns on it (Fig. 110). | on 42060: 0 mm | ✓ |
| 110-36 | 35779 | Screw - Wind indicator wheel post | 1 | 1 | pillar | Holds the post, from the train side of the plate. | in 42060 (clear): 3.903 mm, least gap 0.0596<br>in 42084 (tap): 1.778 mm, least gap 0.0226 | ✓ |
| 110-37 | 42085 | Post - Minute wheel | 1 | 1 | pillar | The minute wheel turns on it. | on 42060: 0 mm | ✓ |
| 110-36 | 35779 | Screw - Minute wheel post | 1 | 1 | pillar | Holds the post, from the train side of the plate. | in 42060 (clear): 3.903 mm, least gap 0.0596<br>in 42085 (tap): 1.778 mm, least gap 0.0226 | ✓ |
| 110-38 | 42165 | Bushing - Center wheel lower | 1 | 1 | pillar | Bearing for the centre arbor in the pillar plate. | in 42060 (press): 3.863 mm, least gap 0.0007 | ✓ |
| 110-39 | 42164 | Bushing - Barrel lower | 1 | 1 | pillar | Bearing for the barrel arbor's lower end. | in 42060 (press): 3.863 mm, least gap 0.0047 | ✓ |
| 110-39 | 42164 | Bushing - Fusee lower | 1 | 1 | pillar | Bearing for the fusee arbor's lower end. | in 42060 (press): 3.863 mm, least gap 0.0047 | ✓ |
| 110-40 | 42057 | Ring - Mounting | 1 | 1 | pillar | Under the plate's dial side: carries the dial, and holds the movement in the case, its alignment pin in the case's slot (Sec. III). | on 42060: 0.01 mm<br>on 42101: 0 mm | ✓ |
| 110-20 | 42055 | Screw - Mounting ring | 3 | 3 | pillar | Hold the pillar plate to the mounting ring, from the train side (reassembly Op. 1; Fig. 29). | in 42060 (clear): 3.882 mm, least gap 0.1815<br>in 42057 (tap): 4.529 mm, least gap 0.0265 | ✓ |

## The fourteen jewels (Sec. II, Jeweling)

| Jewel | Kind | Arbor, end | Set in | Least gap |
|---|---|---|---|---|
| Jewel - Balance upper endstone (cap jewel) | end | 42186 upper | 42155 (0.3 mm) | -0.0022 |
| Jewel - Balance upper hole (olive-hole) | hole | 42186 upper | 42162.bu (0.6 mm) | 0.0031 |
| Jewel - Unlocking | pallet | | 42252 (0.7 mm) | -0.0 |
| Jewel - Impulse | pallet | | 42263 (1.47 mm) | 0.0002 |
| Jewel - Escape upper hole (olive-hole) | hole | 42076 upper | 42162.eu (0.5 mm) | 0.0041 |
| Jewel - Escape upper endstone (cap jewel) | end | 42076 upper | 42159.eu (0.26 mm) | 0.0154 |
| Jewel - Locking | pallet | | 42076 (1.33 mm), 42087 (1.23 mm) | -0.0011 |
| Jewel - Fourth upper hole (bar-hole) | hole | 42073 upper | 42161.fu (0.4 mm) | 0.0039 |
| Jewel - Balance lower hole (olive-hole) | hole | 42186 lower | 42162.bl (0.6 mm) | 0.0039 |
| Jewel - Balance lower endstone (cap jewel) | end | 42186 lower | 42159.bl (0.26 mm) | 0.0064 |
| Jewel - Third lower hole (bar-hole) | hole | 42071 lower | 42161.tl (0.4 mm) | 0.0038 |
| Jewel - Fourth lower hole (bar-hole) | hole | 42073 lower | 42161.fl (0.4 mm) | 0.0038 |
| Jewel - Escape lower endstone (cap jewel) | end | 42076 lower | 42159.el (0.26 mm) | 0.0017 |
| Jewel - Escape lower hole (olive-hole) | hole | 42076 lower | 42162.el (0.5 mm) | 0.0041 |

## The gears as meshed

| Driver | Driven | Teeth | Modules | Centres | m(z1+z2)/2 | Faces overlap | Ratio | Want |
|---|---|---|---|---|---|---|---|---|
| 42081 | 42022 | 120/12 | 0.2512150441216073/0.2512150441216073 | 16.5802 | 16.5802 | 0.5 | -10 | -10 |
| 42080 | 42078 | 54/18 | 0.3138888888888889/0.3138888888888889 | 11.3 | 11.3 | 0.8 | -3 | -3 |
| 42078 | 42077 | 56/14 | 0.3228571428571429/0.3228571428571429 | 11.3 | 11.3 | 0.8 | -4 | -4 |
| 42015 | 42068 | 90/14 | 0.39197902757944864/0.39197902757944864 | 20.3829 | 20.3829 | 1.4 | -6.428571 | -6.428571 |
| 42022 | 42081 | 12/120 | 0.2512150441216073/0.2512150441216073 | 16.5802 | 16.5802 | 0.5 | -0.1 | -0.1 |
| 42076 | 42073 | 10/75 | 0.24573489527196837/0.24573489527196837 | 10.4437 | 10.4437 | 0.9 | -0.133333 | -0.133333 |
| 42073 | 42071 | 10/80 | 0.25104814549807913/0.25104814549807913 | 11.2972 | 11.2972 | 0.65 | -0.125 | -0.125 |
| 42071 | 42068 | 12/90 | 0.3245090172373617/0.3245090172373617 | 16.55 | 16.55 | 0.7 | -0.133333 | -0.133333 |

## Not modelled, and why

| No. | Name | Why |
|---|---|---|
| 42213 | Ship Chronometer Assembly (serials 338-1941) | superseded or reference only (p. 88) |
| 42212 | Ship Chronometer Assembly (serials 1-337) | superseded or reference only (p. 88) |
| 42202 | Case - Carrying, complete | superseded or reference only (p. 88) |
| 42130 | Case - Carrying, complete | superseded or reference only (p. 88) |
| 42129 | Box - Mounting, complete (with lock) | superseded or reference only (p. 88) |
| 42181 | Washer - Timing, 4.0-5.0 mg, 0.002 in thick | Fitted only as the rate requires: none on the standard balance (its weights cover the 2 minutes a day of Op. 5); the rate panel puts these and the other thicknesses under a pair's heads (R.screws). |
| 42180 | Roller - One piece | superseded or reference only (p. 88) |
| 42271 | Screw - Balance, 100-105 mg, 0.039 in head height | an alternative size (p. 88) |
| 42172 | Screw - Balance, 150-155 mg, 0.060 in head height | an alternative size (p. 88) |
| 42175 | Screw - Balance, 300-305 mg, 0.121 in head height | an alternative size (p. 88) |
| 42182 | Washer - Timing, 6.0-7.0 mg, 0.003 in thick | an alternative size (p. 88) |
| 42183 | Washer - Timing, 8.0-9.0 mg, 0.004 in thick | an alternative size (p. 88) |
| 42184 | Washer - Timing, 12.0-13.0 mg, 0.006 in thick | an alternative size (p. 88) |
| 42185 | Washer - Timing, 16.0-17.0 mg, 0.008 in thick | an alternative size (p. 88) |
| 42256 | Washer - Timing, 20.0-21.0 mg, 0.010 in thick | an alternative size (p. 88) |
| 42264 | Roller - Impulse, O.D. .250 (Identity No. 4) | an alternative size (p. 88) |
| 42265 | Roller - Impulse, O.D. .251 (Identity No. 5) | an alternative size (p. 88) |
| 42266 | Roller - Impulse, O.D. .252 (Identity No. 6) | an alternative size (p. 88) |
| 42267 | Roller - Impulse, O.D. .253 (Identity No. 7) | an alternative size (p. 88) |

## Known deviations

- in 1770.br#0 -> 42087 (embed): its thread in the blade only as far as the blade is wide, 0.20 mm (Fig. 90's width, estimated; the frames read it 0.3-0.5 across, rough): the bracket's leg measured on the blade past the cross-piece, where it went along the leg into the cross-piece until 20 October 2026
