OrelMag/marine-chronometer-model/marine-chronometer-source/wempe/BOM.md

# The Wempe's parts list against the model

Generated by `marine-chronometer-source/chronometer-working-model/tools/bom.py --model wempe --md` from `bom.json` beside the page (the works drawings' parts, by drawing number) and measurements of the built model. Do not edit by hand.

**Status:** 266 lines counted, 302 relations measured, 12 jewels; no failures, 2 known deviation(s).

Columns: the line's id, its drawing, its units per chronometer, the pieces in the model, its part card, what it does, and how it goes into the mechanism as measured (as the Hamilton's BOM.md: `in`, `round`, `on`, `mesh`, `endshake`).

## Group 05 08

| Id | Drawing | Name | Units | Model | Card | Function | Fit and drive (measured) | |
|---|---|---|---|---|---|---|---|---|
| 050802-1 | 05 08 02-1 | Unterplatte (pillar plate) | 1 | 1 | pillarPlate | The lower plate, under the dial: the foundation of the movement (its assembly, Unterplatte kompl., is 05 08 02). |  | ✓ |
| 050800-1 | 05 08 00-1 | Pfeiler (pillar) | 3 | 3 | pillars | Hold the plates 19 mm apart, their shoulders in seats in the plates, their spigots in the plates' reamed holes. | in 050802-1 (run): 2.191 mm, least gap 0.0109<br>in 050901 (run): 2.191 mm, least gap 0.0109<br>on 050802-1: 0 mm<br>on 050901: 0 mm | ✓ |
| 050800-3 | 05 08 00-3 | Werkring (movement ring) | 1 | 1 | ring | The ring the pillar plate sits in, which carries the dial and hangs in the case. | on 050802-1: 0 mm | ✓ |
| 050805-1 | 05 08 05-1 | Federhausbrücke (barrel bridge) | 1 | 1 | barrelBridge | Holds the barrel arbor's upper pivot over the top plate's cut (its assembly is 05 08 05). | on 050901: 0 mm | ✓ |
| 050805-2 | 05 08 05-2 | Sperrkegel (click) | 1 | 1 | barrelBridge | The click on the barrel's ratchet, spring-hard brass, its own spring. | on 050805-1: 0 mm<br>round WN-22 (free): 2.519 mm, least gap 0.0183 | ✓ |
| 050801-2 | 05 08 01-2 | Schneckenfutter (fusee bush) | 1 | 1 | fuseeBush | Its spigot slides into the top plate's hole (8 g6 in 8.0 +0.015) and its flange is screwed to it: the fusee arbor's winding end turns in it. | in 050901 (free): 2.579 mm, least gap 0.009<br>on 050901: 0 mm | ✓ |
| 050801-3 | 05 08 01-3 | Staubfutter (dust bush) | 1 | 1 | dustBush | Pressed on the fusee bush's tapered top (8 H7 on 8 r6, both 1:70), up to the case's winding hole. | round 050801-2 (press): 2.728 mm, least gap -0.0106<br>on 050801-2: 0 mm | ✓ |
| 050801-4 | 05 08 01-4 | Korkring (cork ring) | 1 | 1 | corkRing | Pressed on the dust bush's neck, on its collar, standing 0.95 over it: the case's closing plate meets it round the winding hole, keeping dust out (no sheet; scaled on the coloured section). | round 050801-3 (press): 3.035 mm, least gap 0.01<br>on 050801-3: 0 mm | ✓ |
| 050803-1 | 05 08 03-1 | Unruhkloben oben (upper balance cock) | 1 | 1 | upperCock | Holds the balance staff's upper jewel setting over the top plate. | on 050901: 0 mm | ✓ |
| 050800-2 | 05 08 00-2 | Unruhkloben unten (lower balance cock) | 1 | 1 | lowerCock | Hangs under the top plate and holds the balance staff's lower jewel setting. | on 050901: 0 mm | ✓ |
| 050804-1 | 05 08 04-1 | Zwischenbrücke (intermediate bridge; its sheet not in the set, the assembly 05 08 04) | 1 | 1 | intermediateBridge | On the pillar plate's dial side: the intermediate wheel's lower jewel and the seconds wheel's lower setting. | on 050802-1: 0 mm | ✓ |
| 050802-2 | 05 08 02-2 | Futter (stud bush) | 2 | 2 | pillarPlate | Pressed into the pillar plate from its inner face at holes 2 and 19, holding the motion work's studs (the one at 19 drawn dashed on 05 08 02, its Schnitt A-B hatching it: likely, the second drawing check's 9-M12; estimated until 28 October 2026). | in 050802-1 (press): 3.352 mm, least gap -0.0031 | ✓ |
| 050801-5 | 05 08 01-5 | Anschlagstift (stop pin) | 1 | 1 | topPlate | Pressed in the top plate's hole 7, standing out under it: the stop bar meets it at full wind. | in 050901 (press): 3.339 mm, least gap -0.0039 | ✓ |

## Group 05 09

| Id | Drawing | Name | Units | Model | Card | Function | Fit and drive (measured) | |
|---|---|---|---|---|---|---|---|---|
| 050901 | 05 09 01 | Oberplatte (top plate) | 1 | 1 | topPlate | The upper plate, on the train side (its sheet's title block numbers it 05 09 01; its assembly, Oberplatte kompl., is 05 08 01). |  | ✓ |

## Standard parts (WN) and others

| Id | Drawing | Name | Units | Model | Card | Function | Fit and drive (measured) | |
|---|---|---|---|---|---|---|---|---|
| WN-ps |  | Pillar screw, dial side (WN number not read: the section labels none; WN-56 until 31 October 2026, a misreading of the coloured section's leader) | 3 | 3 | pillarPlate | Hold each pillar to the pillar plate, from the dial side. | in 050800-1 (tap): 7.382 mm, least gap 0.0193<br>on 050802-1: 0 mm | ✓ |
| WN-57 |  | Pillar screw, train side (WN-57, by the coloured section's label) | 3 | 3 | topPlate | Hold the top plate to each pillar, from its outer face. | in 050800-1 (tap): 7.382 mm, least gap 0.0285<br>on 050901: 0 mm | ✓ |
| WN-56 |  | Movement ring screw (WN-56, by the general arrangement's label: Klassik Uhren 3/2006's print) | 3 | 3 | ring | Its head bears on the pillar plate's rim and holds it in the ring's seat. | in 050800-3 (tap): 5.636 mm, least gap 0.0161<br>on 050802-1: 0 mm | ✓ |
| WN-201 |  | Stellstift (WN-201): the plate's pin in the movement ring | 1 | 1 | ring | Drilled across the joint of the pillar plate and the ring at assembly, it sets the movement's turn in the ring. | in 050800-3 (press): 1.98 mm, least gap -0.0027<br>on 050802-1: 0 mm | ✓ |
| WN-22 |  | Click screw, shouldered (WN-22) | 1 | 1 | barrelBridge | The click turns on its shoulder. | in 050805-1 (tap): 2.964 mm, least gap 0.0289 | ✓ |
| WN-55 |  | Barrel bridge screw (WN-55, by the coloured section's label) | 2 | 2 | barrelBridge | Hold the barrel bridge to the top plate. | in 050805-1 (clear): 3.255 mm, least gap 0.1289<br>in 050901 (tap): 2.798 mm, least gap 0.0244 | ✓ |
| WN-203.bb |  | Stellstift (WN-203), barrel bridge | 2 | 2 | barrelBridge | Place the barrel bridge on the top plate. | in 050805-1 (press): 1.378 mm, least gap -0.0061<br>in 050901 (clear): 1.279 mm, least gap 0.0036 | ✓ |
| WN-34 |  | Fusee bush screw (WN-34) | 3 | 3 | fuseeBush | Hold the fusee bush's flange to the top plate. | in 050801-2 (clear): 1.461 mm, least gap 0.0535<br>in 050901 (tap): 2.192 mm, least gap 0.0105 | ✓ |
| WN-ucs | WN-55 | Upper balance cock screw (hole 8; WN-55 by the coloured section's label) | 1 | 1 | upperCock | Holds the upper cock to the top plate. | in 050803-1 (clear): 3.14 mm, least gap 0.1248<br>in 050901 (tap): 2.912 mm, least gap 0.0208 | ✓ |
| WN-203.uc |  | Stellstift, upper balance cock (holes 6, 9, 50; WN not given, as WN-203) | 3 | 3 | upperCock | Place the upper cock on the top plate. | in 050803-1 (press): 1.476 mm, least gap -0.0062<br>in 050901 (clear): 1.279 mm, least gap 0.0036 | ✓ |
| WN-53 |  | Lower balance cock screw (WN-53, by the coloured section's label) | 1 | 1 | lowerCock | From the top plate's outer face, its head sunk in the plate, into the cock. | in 050901 (clear): 3.254 mm, least gap 0.1073<br>in 050800-2 (tap): 3.352 mm, least gap 0.0282 | ✓ |
| WN-203.lc |  | Stellstift, lower balance cock (holes 22, 37; WN not given, as WN-203) | 2 | 2 | lowerCock | Place the lower cock under the top plate. | in 050800-2 (press): 1.673 mm, least gap -0.0064<br>in 050901 (clear): 1.279 mm, least gap 0.0036 | ✓ |
| WN-52 |  | Intermediate bridge screw (WN-52) | 2 | 2 | intermediateBridge | Hold the intermediate bridge to the pillar plate, from the dial side. | in 050804-1 (clear): 3.72 mm, least gap 0.1224<br>in 050802-1 (tap): 2.778 mm, least gap 0.0189 | ✓ |
| WN-203.zb |  | Stellstift (WN-203), intermediate bridge | 2 | 2 | intermediateBridge | Place the intermediate bridge on the pillar plate. | in 050804-1 (press): 1.597 mm, least gap -0.0064<br>in 050802-1 (clear): 1.307 mm, least gap 0.0036 | ✓ |
| WN-301 |  | Messinglager WN-301 (brass bush, centre arbor's upper pivot) | 1 | 1 | topPlate | The centre arbor's upper bearing, pressed into the top plate's hole 1. | in 050901 (press): 3.353 mm, least gap -0.0021 | ✓ |
| WN-300.t38 |  | Messinglager WN-300 (brass bush, intermediate arbor's upper pivot) | 1 | 1 | topPlate | The intermediate arbor's upper bearing, pressed into the top plate's hole 38. | in 050901 (press): 3.353 mm, least gap -0.0021 | ✓ |
| WN-300.t35 |  | Messinglager WN-300 (brass bush, seconds arbor's upper pivot) | 1 | 1 | topPlate | The seconds arbor's upper bearing, pressed into the top plate's hole 35. | in 050901 (press): 3.353 mm, least gap -0.0021 | ✓ |
| WN-302 |  | Messinglager WN-302 (brass bush, centre arbor's journal) | 1 | 1 | pillarPlate | The centre arbor's lower bearing, pressed into the pillar plate's hole 1, 0.1 under its inner face. | in 050802-1 (press): 3.241 mm, least gap -0.0021 | ✓ |
| WN-300.zb |  | Messinglager WN-300 (brass bush, intermediate arbor's lower pivot) | 1 | 1 | intermediateBridge | The intermediate arbor's lower bearing, pressed into the intermediate bridge, 0.7 in from its plate side. | in 050804-1 (press): 3.087 mm, least gap -0.0021 | ✓ |
| 6MX.ch38u |  | Chaton (6MX), intermediate arbor's upper jewel | 1 | 0 | topPlate | Holds the intermediate arbor's upper jewel in the top plate's hole 38, where the drawings press the bush WN-300. No sheet: the Soviet 6MX's (Altmeppen; Kirov No. 247's photographs), its sizes estimated. |  | ✓ |
| 6MX.jw38u |  | Hole jewel (6MX), intermediate arbor, upper | 1 | 0 | topPlate | The intermediate arbor's upper pivot runs in it; its face takes the arbor's shoulder. No sheet: the Soviet 6MX's (Altmeppen; Kirov No. 247's photographs), its sizes estimated. |  | ✓ |
| 6MX.ch35u |  | Chaton (6MX), seconds arbor's upper jewel | 1 | 0 | topPlate | Holds the seconds arbor's upper jewel in the top plate's hole 35, where the drawings press the bush WN-300. No sheet: the Soviet 6MX's (Altmeppen; Kirov No. 247's photographs), its sizes estimated. |  | ✓ |
| 6MX.jw35u |  | Hole jewel (6MX), seconds arbor, upper | 1 | 0 | topPlate | The seconds arbor's upper pivot runs in it; its face takes the arbor's shoulder. No sheet: the Soviet 6MX's (Altmeppen; Kirov No. 247's photographs), its sizes estimated. |  | ✓ |
| 6MX.ch38l |  | Chaton (6MX), intermediate arbor's lower jewel | 1 | 0 | intermediateBridge | Holds the intermediate arbor's lower jewel in the intermediate bridge, where the drawings press the bush WN-300. No sheet: the Soviet 6MX's (Altmeppen; Kirov No. 247's photographs), its sizes estimated. |  | ✓ |
| 6MX.jw38l |  | Hole jewel (6MX), intermediate arbor, lower | 1 | 0 | intermediateBridge | The intermediate arbor's lower pivot runs in it; its face takes the arbor's shoulder. No sheet: the Soviet 6MX's (Altmeppen; Kirov No. 247's photographs), its sizes estimated. |  | ✓ |
| WN-hs |  | Bush in hole 18, the hand-setting pinion's (not named on 05 08 02) | 1 | 1 | pillarPlate | The bearing of the hand-setting work's pinion (Zeigerstelltrieb), pressed into the pillar plate's hole 18; on Wempe 3955 the only part of that work fitted, empty. | in 050802-1 (press): 3.352 mm, least gap -0.0031 | ✓ |
| WN-12 |  | Schraube (WN-12), the mass screw | 4 | 4 | balance | Holds a mass on the rim: M0.8 (estimated) radially through its outer jaw's tapped hole, its head in a counterbore in the mass's round side, its tip on the rim's outer face (05 03_2; the 6MX's book, Fig. 5.62). | in 050301-4 (tap): 2.259 mm, least gap 0.0108 | ✓ |
| WN-12a |  | Schraube (WN-12a), for the tapped hole in a mass's top (not fitted) | 0-4 | 0 | balance | For the tapped hole M1.2 in the middle of a mass's top, its top flat (not fitted: holes in all four, empty, the owner's choice, 28 October 2026): the coloured section draws one, a cheese head on one mass; Wempe's lever 2965 and the earlier 2493 show such holes empty; the Einheits examples photographed (Wempe 3955, the Langes) have plain tops (a poising screw fitted where needed). |  | ✓ |
| WN-10 |  | Schraube (WN-10), the hub's screws | 0-2 | 2 | balance | From the arm's top, their countersunk heads flush in it, through the arm's Ø 1 into the hub's flange, tapped M1 (05 04 02, the coloured section). Only on the 1946 hub: the 1941 collar has no holes for them. | in 050402-2 (tap): 1.652 mm, least gap 0.0117<br>in 050301-1 (clear): 1.118 mm, least gap 0.0048 | ✓ |
| WN-11 |  | Schraube (WN-11), the stud's screw | 1 | 1 | stud | Holds the stud to the cock. | in 050302-3 (clear): 1.476 mm, least gap 0.0728<br>in 050803-1 (tap): 2.411 mm, least gap 0.0151 | ✓ |
| WN-14 |  | Schraube (WN-14), the gold spring's screw | 1 | 1 | detent | Holds the gold spring to the detent's square. | in 050401-1 (tap): 0.431 mm, least gap 0.0015 | ✓ (deviation) |
| WN-gf | WN-13 | Detent foot screw, M1 (WN-13 by the coloured section's label, likely) | 1 | 1 | detent | Clamps the detent's foot to the block's end. | in 050401-1 (clear): 0.593 mm, least gap 0.05<br>in 050401-4 (embed): 2.322 mm, least gap -0.1301 | ✓ |
| WN-205.d | WN-205 | Stellstift (WN-205 by the coloured section's label), the detent's foot pins | 2 | 2 | detent | Place the detent's foot on the block. | in 050401-1 (press): 0.586 mm, least gap -0.0164<br>in 050401-4 (press): 1.61 mm, least gap 0.0042 | ✓ |
| WN-gk | WN-15 | Detent block screw, M1.7 (WN-15 by the coloured section's label, likely) | 1 | 1 | detentBlock | From the top plate's outer face through hole 13 into the block. The Soviet 6MX's: a slotted stud flush in the plate's outer face, 2.2 from hole 13 (Kirov No. 247), through the adjusting slide into the block. | in 050901 (clear): 3.367 mm, least gap 0.0741<br>in 050401-4 (tap): 2.769 mm, least gap 0.0202 | ✓ |
| WN-gkA |  | Screw across the block's slit upright, M1.2 (its WN number not read) | 0-1 | 0 | detentBlock | The Soviet 6MX's banking screw across its upright, in its tapped hole (cut 28 October 2026; as last revised until 27 October 2026, a plain shank across the slit end, bearing on nothing). |  | ✓ |
| WN-gkA43 |  | Banking screw M1.2 along the 1943 block's slit upright, its domed slotted head (the escapement of 1943; its WN number not read) | 1 | 1 | detentBlock | Along the upright's slit end, the slit gripping its thread; its head's underside bears on the detent's pipe and sets the depth of lock. The thread from the block's sheet (M1.2), its head measured on Kirow DEC 422's, DEC 479's and Lange No. 5177's photographs, its length the 6MX's loose block's. As last revised too since 27 October 2026 (Wempe 9166; the 1946 staff read again). | in 050401-4 (tap): 2.781 mm, least gap 0.0235 | ✓ |
| cone41 | WN-16 | Anschlagschraube 1941 (the 1941 block's banking screw, domed head and pointed tail; WN-16 by the coloured section's label) | 0-1 | 0 | detentBlock | Through the 1941 block's arm on the stone's line, held by its slit end; the detent's pipe banks on its head's face, and turning it sets the depth of lock (the page's Variants, As first drawn). |  | ✓ |
| WN-201.gk | WN-201 | Stellstift (WN-201, "Stellstift 2" by the coloured section's label), the detent block's steady pins Ø 0.9 | 2 | 2 | detentBlock | Place the block on the top plate. | in 050401-4 (press): 6.521 mm, least gap 0.0045<br>in 050901 (clear): 1.284 mm, least gap 0.0185 | ✓ |
| 6MX.gks |  | Adjusting slide (6MX), the detent block's | 1 | 0 | detentBlock | A gilt key flush in a notch across the corner of the block's plate face and free side, the fixing stud through it. No sheet: the Soviet 6MX's (a loose 6MX block photographed by Altmeppen, Kirov No. 247's in place), its sizes measured on the loose block, how it works not seen. |  | ✓ |
| 6MX.gke |  | Detent foot's stop screw (6MX), in the block's side | 1 | 0 | detentBlock | A large slotted screw in the block's free side beside the detent's foot, its head over the end face: a stop for the foot along the block. No sheet: the Soviet 6MX's (every 6MX detent photograph), its thread estimated. |  | ✓ |
| WN-55.ck |  | Schraube (WN-55 by the coloured section), the upper endstone's screws, M1.2 | 2 | 2 | balanceJewelsUp | Hold the endstone's setting, their heads over its edge. | in 050803-1 (tap): 2.021 mm, least gap 0.0158<br>on 050408-2.bu: 0 mm | ✓ |
| WN-18 | WN-18 | Schraube (WN-18, by the general arrangement's label: Klassik Uhren 3/2006's print; read WN-10 until 31 October 2026), the lower settings' screws, M1.2 | 2 | 2 | balanceJewelsLow | Hold the lower settings in the lug. | in 050800-2 (tap): 2.021 mm, least gap 0.0137<br>on 050408-2.bl: 0 mm | ✓ |
| WN-es |  | Escape endstone screws, upper, M1.2 (their WN number not read) | 2 | 2 | escEndstoneUp | Put in from outside: hold the upper endstone's setting, their heads over its spigot's edge (Wempe 3955). | in 050901 (tap): 3.263 mm, least gap 0.0112<br>on 050901: 0 mm | ✓ |
| WN-ec |  | Escape endstone screws, lower, M1.2 (their WN number not read) | 2 | 2 | escEndstoneLow | Hold the lower endstone's setting in its seat, their heads over its rim (Wempe 3955). | in 050802-1 (tap): 2.517 mm, least gap 0.0111<br>on 050802-1: 0 mm | ✓ |
| WN-19 |  | Schraube WN-19 (click wheel screw) | 3 | 3 | fusee | Holds the click wheel to the body; its head flush in the wheel's 1:8 hole, its thread in the body's M2, 6 +0.5 deep from the large end's recess floor (05 06 04-2). | in 050604-3 (press): 1.627 mm, least gap 0.0023<br>in 050604-2 (tap): 3.747 mm, least gap 0.0193 | ✓ |
| WN-20 |  | Schraube WN-20 (cover plate screw) | 1 | 1 | coverPlate | Countersunk in the cover plate, into the body's M1.7, 6 deep from the small end's recess floor (05 06 04-2). | in 050600-4 (press): 0.197 mm, least gap 0.0136<br>in 050604-2 (tap): 3.5 mm, least gap 0.0123 | ✓ |
| WN-21 |  | Schraube WN-21 (click screw) | 2 | 2 | maintaining | Put in from under the ratchet, threaded in its M1.7; the click turns on its shoulder. | in 050602-1 (tap): 1.078 mm, least gap 0.0124 | ✓ |
| wireStud | WN-27 | Schraube (WN-27 by the coloured section's label, likely: the maintaining detent's wire spring's stud) | 1 | 1 | maintDetent | A slotted cheese-head stud screwed into the top plate's hole 5 ("Drahtfeder", M1.7) from its outer face; the wire spring is held in its end under the plate (no sheet; the coloured section draws it, the north-side photographs show it). | in 050901 (tap): 3.323 mm, least gap 0.0103 | ✓ |
| WN-10.d | WN-10 | Schraube (dial screw) | 3 | 3 | dial | M1 through the dial's sunk holes into the ring's flange (WN-10 by the coloured section's label, likely). | in 050800-3 (tap): 2.116 mm, least gap 0.0084<br>in 050200-4 (clear): 0.984 mm, least gap 0.0464 | ✓ |
| dialPin |  | Stellstift WN-201 (the dial pin) | 1 | 1 | dial | In the ring's pin hole at 6 deg past 12 (05 08 00-3), stepped into the dial's (no number read) (the coloured section labels it Stellstift WN-201, with the ring's pin: the second drawing check's 11-M7). | in 050800-3 (press): 3.713 mm, least gap -0.0052<br>in 050200-4 (press): 1.089 mm, least gap 0.0099 | ✓ |
| WN-202 |  | Stellstift 3 (WN-202): the movement ring’s radial pin to the case | 1 | 1 | ring | Stands 1.78 out of the ring's flange at 12 o'clock into the notch in the bowl's threaded rim: it sets the movement's turn in the case and holds it while the bezel is screwed down. | in 050800-3 (press): 7.631 mm, least gap -0.0035 | ✓ |
| 050100-1 | R-05 01 00-1 | Gehäusetopf (bowl) | 1 | 1 | bowl | The cast brass bowl: the movement ring's flange in a rebate in its rim, the rim threaded outside for the bezel and notched for the ring's pin; the winding hole in its bottom over the fusee's square. |  | ✓ |
| WN-78 |  | Schraube WN-78 (13 on 05 01): the brackets’ screws | 5 | 5 | bowl | Hold the case brackets and the locking bracket to the bowl, M4 (the case brackets', heads Ø 7) and M2.5, 3.3 into its 4 wall (length estimated); through clearance holes in the brackets' feet (Ø 4.5 and Ø 2.9, round: estimated; cut since 28 October 2026, 10-M10); their tapped holes across the turned bowl not cut (embed: the thread measured inside the bowl's metal). | in 050100-1 (embed): 3.991 mm, least gap -1.9517 | ✓ |
| 6MX.bks |  | Bracket screws (6MX) | 6 | 0 | bowl | Hold the Soviet 6MX's high case brackets (two each, in slots) and its locking bracket (two, in its vertical slot) to the bowl, their holes across the turned bowl not cut. No sheet: Kirov No. 247's bowl (12_Kirow_247_E-Kontakt_3.jpg). |  | ✓ |
| WN-71 |  | Schraube WN-71 (7 on 05 01, the number unsure): the closing plate’s screw | 1 | 1 | closingPlate | A shoulder screw in the bowl's bottom: the closing plate turns on its shoulder (Ø 5.45 × 1.95 in the plate's Ø 5.5 +0.1, through its web 1.925), which bears on the bottom, the head 0.025 over the counterbore's floor (no WN sheet: estimated; a plain M3 until 28 October 2026, the second drawing check's 10-M3). | in 050100-1 (tap): 4.82 mm, least gap 0.0546 | ✓ |
| WN-72 |  | Schraube WN-72: the closing plate’s knob | 1 | 1 | closingPlate | The knob in the closing plate's M2.6, to turn it. | in 050100-2 (tap): 1.614 mm, least gap 0.0483 | ✓ |
| 050101-2 | R-05 01 01-2 | Glasrand (bezel) | 1 | 1 | bezel | Screws onto the bowl's threaded rim round the movement ring's flange, its step on the dial holding the movement down; the glass in its top. | on 050100-1: 0.0124 mm | ✓ |
| WN-kr |  | Schraube (the ring bracket’s screws, no number) | 2 | 2 | gimbalRing | Hold the ring bracket to the ring: through its holes, tapped through the ring to its inside, as 05 01 Schnitt A-B draws them (cut along the radius; 2.75 into it until 27 October 2026). |  | ✓ |
| WN-79 |  | Schraube WN-79 (12 on 05 01): the inner pivots | 2 | 2 | gimbalRing | Through the ring at 12 and 6 o'clock (M5, tapped in it), their plain tips the inner pivots in the case brackets' holes (05 01 Schnitt C-D). |  | ✓ |
| WN-400 |  | Kontermutter WN-400 (10 on 05 01), knurled brass | 2 | 2 | gimbalRing | Lock the inner pivot screws where they are set: inside the ring, against its inner face (05 01 Schnitt C-D: Ø 22 × 2.4). | on 050100-5: 0 mm | ✓ |
| Holzkasten | 127-556.02 | Holzkasten (wooden box) | 1 | 1 | box | 185 x 185 x 180 outside: the gimbals hang in it (no sheet in the set). |  | ✓ |
| WN-80 |  | Schraube WN-80 (11 on 05 01): the outer pivots, M6 | 2 | 2 | box | Through the box's side walls, their tips the gimbal ring's pivots: through the ring at 9 o'clock, through its bracket into the ring at 3 (05 01's elevation). |  | ✓ |
| WN-400.w |  | Kontermutter WN-400 (10 on 05 01) at the outer pivots, knurled brass | 2 | 2 | box | Lock the outer pivot screws (WN-80) where they are set: against each side wall's inside round the M6 (05 01's disc at a, Ø 23 × 2: the parts list's one lock-nut line, 10, and nothing else stops WN-80 turning; its thread not drawn, the bore plain: estimated). Named a bearing disc with no number until 28 October 2026 (the second drawing check's 10-M12). | on Holzkasten/Kasten6: 0 mm | ✓ |
| WN-hg |  | Schraube (the handles’ screws, estimated) | 4 | 4 | box | Through the handles' ends into the side walls. |  | ✓ |
| Scharnier |  | Scharnier (piano hinge, estimated) | 1 | 1 | box | Join the lid to the box at the back: one hinge 148 long, its leaves let into the parting faces (as every photographed box). |  | ✓ |
| Deckelstuetze |  | Deckelstütze (lid stay, estimated) | 1 | 1 | box | Holds the lid open: a slotted brass bar pivoted on the lid's left wall, riding on a pin in the box's (Wempe 6161). |  | ✓ |
| Schluesselhalter |  | Schlüsselhalter (key holder, estimated) | 1 | 1 | box | A shelf across the box's back right corner, its front edge curved round the gimbal ring (Wempe 6161, 3044; 51-00_1 draws a triangle), the winding key standing in a round fitting on it, its tube down through the shelf. | on Holzkasten/Kasten6: 0 mm | ✓ |
| Schluesselhalter.F |  | Fassung (the key holder's round fitting, estimated) | 1 | 1 | box | A round brass cup standing on the shelf (51-00_1's circle; Lange VEB 2285's, on its shelf): the key's cone seats on its bore. | on Schluesselhalter: 0 mm | ✓ |
| WN-kh |  | Schraube (the key holder's fitting's screws, estimated) | 2 | 2 | box | Through the fitting into the shelf, either side of the key (51-00_1's two dots). |  | ✓ |
| DIN96 |  | Holzschraube DIN 96, 3 × 15 (the transit lock's bracket's wood screws, estimated) | 2 | 2 | box | Round-headed wood screws through the bracket's wall leg into the box's right wall (the owner's case design, CAD Model Case.md §10: 2 × 3 × 15 DIN 96). |  | ✓ |
| Schliessblech |  | Schließblech (the box's latch plate: Lange 5591's, its sizes not seen estimated) | 1 | 1 | box | An angle on the box's front, its top let into the front wall's top, slotted for the lid's hook; the knob through its face. | on Holzkasten: 0 mm | ✓ |
| Hakenblech |  | Hakenblech (the lid's hook plate: Lange 5591's, its sizes not seen estimated) | 1 | 1 | lid | An angle on the lid's front, its top let into the front wall's underside; its hook drops through the latch plate's slot over the bolt. | on Holzkasten.D: 0 mm | ✓ |
| Kastenstift |  | Pin over the outer pivot (no number; inferred a lid-locating pin) | 2 | 2 | box | Standing 2.3 out of each side wall's parting face over its outer pivot, into a hole in the closed lid's wall (05 01's elevation draws it; its purpose inferred). | in Holzkasten (embed): 3.291 mm, least gap -1.2458 | ✓ |
| Holzkasten.D | 127-556.02 | Deckel (the box’s lid) | 1 | 1 | lid | The glazed lid, hinged at the back. |  | ✓ |
| Deckelglas |  | Deckelglas (the lid’s glass, estimated) | 1 | 1 | lid | In the lid's top, under its frame. | on Holzkasten.D/Kasten6.D: 0 mm | ✓ |
| P510002-2 | P. 51 00 02-2 | Zunge (latch tongue) | 1 | 1 | box | The latch's bolt, out of view in a mortise in the box's front wall behind the latch plate, turning on its screw (its arrangement unknown). |  | ✓ |
| WN-zg |  | Schraube (the tongue’s pivot screw, estimated) | 1 | 1 | box | The screw the tongue turns on, put in from inside the box (estimated). |  | ✓ |
| WN-zk |  | Knopf (the latch's knob, Lange 5591's, in the tongue's M3.5) | 1 | 1 | box | In the tongue's M3.5, out through the latch plate's face. | on P510002-2: 0.0199 mm | ✓ |
| Ueberkasten | 127-556.01 (52 00 16) | Überkasten (outer box): body and base plate, bleached birch | 1 | 1 | overBox | Carries the wooden box for transport, cushioned all round. |  | ✓ |
| Randleiste | 127-556.01-13, -14 | Leiste (rim strip, 17, 18) | 1 | 1 | overBox | Inside the rim, 4 over the walls: the lid closes over it. |  | ✓ |
| Polster.S |  | Polster (front and back cushions) | 2 | 2 | overBox | Against the wooden box's front and back. |  | ✓ |
| Polster.E |  | Polster (end cushions) | 2 | 2 | overBox | Against the wooden box's handles. |  | ✓ |
| Polster.B |  | Polster (floor cushion) | 1 | 1 | overBox | The wooden box stands on it. |  | ✓ |
| Riemen | 127-556.01-07 | Riemen (strap, 10): its ends on the end walls | 2 | 2 | overBox | Over the lid to its buckle (its loose ends and buckle not drawn). |  | ✓ |
| WN-ur |  | Schraube f. Riemenbef. (the strap's screws) | 4 | 4 | overBox | Two on each end wall, 80 apart. |  | ✓ |
| Riemenoese | 127-556.01-08 | Öse (eye, 12) | 2 | 2 | overBox | On each end of the base plate. |  | ✓ |
| WN-ro | DIN 96 | Schraube 3 x 15 DIN 96 (11) | 2 | 2 | overBox | The eyes' screws. |  | ✓ |
| Scharnier.U | 127-556.01-05 | Scharnier (outer box hinge, 7) | 2 | 2 | overBox | Join the lid to the body at the back. |  | ✓ |
| Hakenoese |  | Öse (the hook's eye, 9: commercial) | 1 | 1 | overBox | On the front, under the rim. |  | ✓ |
| Ueberkasten.D | 127-556.01 | Deckel (the outer box's lid) | 1 | 1 | overLid | Hinged at the back, cushioned inside. |  | ✓ |
| Polster.D | 127-556.01-12 | Polster (lid cushion, 16) | 1 | 1 | overLid | Bears on the wooden box's lid. |  | ✓ |
| Haken |  | Haken (hook, 9: commercial) | 1 | 1 | overLid | On the lid's front, caught in the eye. |  | ✓ |
| Kasten6 |  | Ящик (the 6MX’s box, Kirov No. 247’s): its body | 1 | 0 | box | 190 x 190 x 190 outside (the TU's): the gimbals hang in it. No sheet: Kirov 247's photographs, its tiers on Kirov 22823's. |  | ✓ |
| Scharnier6 |  | Hinges (6MX, estimated) | 2 | 0 | box | Join the glazed lid to the box at the back, and the top lid to it (not seen on Kirov 247's photographs). |  | ✓ |
| Griff6 |  | Ring handle (6MX) | 2 | 0 | box | One on each side, under the lower parting line. |  | ✓ |
| Beschlag6 |  | Corner strips (6MX) | 1 | 0 | box | Brass strips round the box's corners (the lids' with them). |  | ✓ |
| Ueberfall6 |  | Hasp leaf (6MX) | 4 | 0 | box | Two hasps across the parting lines, a knurled screw on each lower leaf. |  | ✓ |
| Nummernschild |  | Number plate 247 (6MX) | 2 | 0 | box | On the box's front and the outer box's lid. |  | ✓ |
| Kasten6.D |  | Glazed lid and top lid (6MX) | 1 | 0 | lid | Hinged at the back, opened together here. |  | ✓ |
| Firmenschild6 |  | Factory badge, 1 МЧЗ им. Кирова (6MX) | 1 | 0 | lid | On the glazed lid's front. |  | ✓ |
| Ueberkasten6 |  | Outer box (6MX): its body | 1 | 0 | overBox | Carries the box for transport, felt-lined; its sizes estimated. |  | ✓ |
| Polster6 |  | Felt (6MX) | 6 | 0 | overBox | Under, round and over the box. |  | ✓ |
| Ueberkasten6.D |  | Outer box lid (6MX) | 1 | 0 | overLid | Hinged at the back, its tab closing into the notch. |  | ✓ |
| 127556.02-02 | 127-556.02-02 | Körper (the 1940 key's body) | 0-1 | 0 | key | The conical body of the key of 1940 (Aufzugschlüssel 127-556.02 U 01, the page's Variants, As first drawn). |  | ✓ |
| 127556.02-01 | 127-556.02-01 | Griff (the 1940 key's flat pear-shaped handle, its blade let into the cap) | 0-1 | 0 | key | The handle, a flat plate, its blade let into the cap (05-01_6: hatched apart from the body), which the two screws hold to the body. |  | ✓ |
| 127556.02-03 | 127-556.02-03 | Schaft (the 1940 key's pipe, with the square socket for the fusee's square) | 0-1 | 0 | key | Free in the body's Ø 6.05 bore, its head under the cap; the spring 127-556.02-04 grips its head one way (a one-way key); its square socket takes the fusee's winding square (28 October 2026: pressed into the body, a plain key, until then). |  | ✓ |
| 127556.02-04 | 127-556.02-04 | Feder (the 1940 key's click spring) | 0-1 | 0 | key | Round the pipe's head in the body's bore, five turns of 0.7 wire (05-01_6: drawn; its wire, hand and ends scaled or estimated): it grips the pipe one way and slips the other. |  | ✓ |
| 127556.02-05 | 127-556.02-05 | Schraube (the 1940 key's two countersunk screws in the cap) | 0-2 | 0 | key | Two countersunk M2 screws, flush in the cap's top either side of the blade, into holes in the body's top: they hold the cap with the handle's blade to the body (05-01_6's section; one head disc and no shank until 28 October 2026). |  | ✓ |
| 6MX.ct |  | Contact base (6MX, Romanov's 58) | 1 | 0 | pillarPlate | The gilt base of the seconds contact on the pillar plate's inner face, along its rim by pillar 39; carries the blocks, the lever's lower jewels and the cock. No sheet: the Soviet 6MX's electrical contact (Kirov No. 247's photographs by Johannes Altmeppen; Romanov 1975, Figs. 100-101 and p. 105's parts list), its sizes estimated where the photographs don't give them. |  | ✓ |
| 6MX.ctm |  | Contact base screw (6MX, 56) | 2 | 0 | pillarPlate | Hold the contact's base to the pillar plate, their ends flush on the dial side; reached through the top plate's two access holes. No sheet: the Soviet 6MX's electrical contact (Kirov No. 247's photographs by Johannes Altmeppen; Romanov 1975, Figs. 100-101 and p. 105's parts list), its sizes estimated where the photographs don't give them. |  | ✓ |
| 6MX.ctf |  | Insulation (6MX, 68) | 2 | 0 | pillarPlate | Black fibre under each contact block, insulating it from the base. No sheet: the Soviet 6MX's electrical contact (Kirov No. 247's photographs by Johannes Altmeppen; Romanov 1975, Figs. 100-101 and p. 105's parts list), its sizes estimated where the photographs don't give them. |  | ✓ |
| 6MX.ctbp |  | Contact block + (6MX, 52) | 1 | 0 | pillarPlate | The positive block: the spiral's stud on it, the bowl's spring A bears on its outer end. No sheet: the Soviet 6MX's electrical contact (Kirov No. 247's photographs by Johannes Altmeppen; Romanov 1975, Figs. 100-101 and p. 105's parts list), its sizes estimated where the photographs don't give them. |  | ✓ |
| 6MX.ctbm |  | Contact block − (6MX, 57) | 1 | 0 | pillarPlate | The negative block: the contact disc on it, the bowl's spring B bears on its outer end. No sheet: the Soviet 6MX's electrical contact (Kirov No. 247's photographs by Johannes Altmeppen; Romanov 1975, Figs. 100-101 and p. 105's parts list), its sizes estimated where the photographs don't give them. |  | ✓ |
| 6MX.ctu |  | Insulating bush (6MX, 67) | 4 | 0 | pillarPlate | Insulates each block screw from its block, its black flange under the head. No sheet: the Soviet 6MX's electrical contact (Kirov No. 247's photographs by Johannes Altmeppen; Romanov 1975, Figs. 100-101 and p. 105's parts list), its sizes estimated where the photographs don't give them. |  | ✓ |
| 6MX.cts |  | Contact block screw (6MX) | 4 | 0 | pillarPlate | Hold the blocks and their insulation to the base: steel cheese heads Ø 3.1. No sheet: the Soviet 6MX's electrical contact (Kirov No. 247's photographs by Johannes Altmeppen; Romanov 1975, Figs. 100-101 and p. 105's parts list), its sizes estimated where the photographs don't give them. |  | ✓ |
| 6MX.ctd |  | Contact disc (6MX, 55) | 1 | 0 | pillarPlate | The knurled gilt disc the contact screw meets, upright on its bracket on block 57; it may be turned to renew a burnt contact (the 6MX's instruction). No sheet: the Soviet 6MX's electrical contact (Kirov No. 247's photographs by Johannes Altmeppen; Romanov 1975, Figs. 100-101 and p. 105's parts list), its sizes estimated where the photographs don't give them. |  | ✓ |
| 6MX.ctst |  | Contact lever staff (6MX, 69) | 1 | 0 | pillarPlate | The lever's staff, jewelled at both ends; the spiral's collet on it. No sheet: the Soviet 6MX's electrical contact (Kirov No. 247's photographs by Johannes Altmeppen; Romanov 1975, Figs. 100-101 and p. 105's parts list), its sizes estimated where the photographs don't give them. |  | ✓ |
| 6MX.ctjs |  | Contact staff's upper jewel setting (6MX) | 1 | 0 | pillarPlate | Holds the staff's upper hole jewel and end jewel in the base. No sheet: the Soviet 6MX's electrical contact (Kirov No. 247's photographs by Johannes Altmeppen; Romanov 1975, Figs. 100-101 and p. 105's parts list), its sizes estimated where the photographs don't give them. |  | ✓ |
| 6MX.ctju |  | Hole jewel (6MX), contact staff, upper | 1 | 0 | pillarPlate | The staff's upper pivot runs in it. No sheet: the Soviet 6MX's electrical contact (Kirov No. 247's photographs by Johannes Altmeppen; Romanov 1975, Figs. 100-101 and p. 105's parts list), its sizes estimated where the photographs don't give them. |  | ✓ |
| 6MX.ctjeu |  | End jewel (6MX), contact staff, upper | 1 | 0 | pillarPlate | The staff's upper end stone. No sheet: the Soviet 6MX's electrical contact (Kirov No. 247's photographs by Johannes Altmeppen; Romanov 1975, Figs. 100-101 and p. 105's parts list), its sizes estimated where the photographs don't give them. |  | ✓ |
| 6MX.ctc |  | Contact cock (6MX) | 1 | 0 | pillarPlate | The L-shaped gilt cock over the spiral, holding the staff's lower jewels. No sheet: the Soviet 6MX's electrical contact (Kirov No. 247's photographs by Johannes Altmeppen; Romanov 1975, Figs. 100-101 and p. 105's parts list), its sizes estimated where the photographs don't give them. |  | ✓ |
| 6MX.ctcs |  | Contact cock screw (6MX) | 1 | 0 | pillarPlate | Holds the cock's foot to the base. No sheet: the Soviet 6MX's electrical contact (Kirov No. 247's photographs by Johannes Altmeppen; Romanov 1975, Figs. 100-101 and p. 105's parts list), its sizes estimated where the photographs don't give them. |  | ✓ |
| 6MX.ctcp |  | Contact cock steady pin (6MX) | 2 | 0 | pillarPlate | Place the cock's foot on the base. No sheet: the Soviet 6MX's electrical contact (Kirov No. 247's photographs by Johannes Altmeppen; Romanov 1975, Figs. 100-101 and p. 105's parts list), its sizes estimated where the photographs don't give them. |  | ✓ |
| 6MX.ctjl |  | Hole jewel (6MX), contact staff, lower | 1 | 0 | pillarPlate | The staff's lower pivot runs in it, in the cock's arm. No sheet: the Soviet 6MX's electrical contact (Kirov No. 247's photographs by Johannes Altmeppen; Romanov 1975, Figs. 100-101 and p. 105's parts list), its sizes estimated where the photographs don't give them. |  | ✓ |
| 6MX.ctcc |  | Contact cock's cap plate (6MX) | 1 | 0 | pillarPlate | Holds the staff's lower end jewel on the cock's arm. No sheet: the Soviet 6MX's electrical contact (Kirov No. 247's photographs by Johannes Altmeppen; Romanov 1975, Figs. 100-101 and p. 105's parts list), its sizes estimated where the photographs don't give them. |  | ✓ |
| 6MX.ctjel |  | End jewel (6MX), contact staff, lower | 1 | 0 | pillarPlate | The staff's lower end stone, under the cap plate. No sheet: the Soviet 6MX's electrical contact (Kirov No. 247's photographs by Johannes Altmeppen; Romanov 1975, Figs. 100-101 and p. 105's parts list), its sizes estimated where the photographs don't give them. |  | ✓ |
| 6MX.ctccs |  | Cap plate screw (6MX) | 2 | 0 | pillarPlate | Hold the cap plate to the cock's arm. No sheet: the Soviet 6MX's electrical contact (Kirov No. 247's photographs by Johannes Altmeppen; Romanov 1975, Figs. 100-101 and p. 105's parts list), its sizes estimated where the photographs don't give them. |  | ✓ |
| 6MX.ctl |  | Contact lever (6MX, 60) | 1 | 0 | pillarPlate | Pressed on its staff: the stone at one end rides the contact wheel, the contact screw at the other meets the disc. No sheet: the Soviet 6MX's electrical contact (Kirov No. 247's photographs by Johannes Altmeppen; Romanov 1975, Figs. 100-101 and p. 105's parts list), its sizes estimated where the photographs don't give them. |  | ✓ |
| 6MX.ctp |  | Contact lever's stone (6MX, 61) | 1 | 0 | pillarPlate | A corundum pallet with a bevelled end, lifted by the contact wheel's teeth. No sheet: the Soviet 6MX's electrical contact (Kirov No. 247's photographs by Johannes Altmeppen; Romanov 1975, Figs. 100-101 and p. 105's parts list), its sizes estimated where the photographs don't give them. |  | ✓ |
| 6MX.ctk |  | Contact screw (6MX, 54) | 1 | 0 | pillarPlate | Threaded through the lever's end, its point on the disc: the contact itself. No sheet: the Soviet 6MX's electrical contact (Kirov No. 247's photographs by Johannes Altmeppen; Romanov 1975, Figs. 100-101 and p. 105's parts list), its sizes estimated where the photographs don't give them. |  | ✓ |
| 6MX.ctn |  | Contact screw's lock nut (6MX) | 1 | 0 | pillarPlate | Locks the contact screw in the lever. No sheet: the Soviet 6MX's electrical contact (Kirov No. 247's photographs by Johannes Altmeppen; Romanov 1975, Figs. 100-101 and p. 105's parts list), its sizes estimated where the photographs don't give them. |  | ✓ |
| 6MX.cth |  | Contact spiral (6MX, 59) | 1 | 0 | pillarPlate | A flat copper-coloured spiral from the staff's collet to the stud: the lead from block 52 to the lever, and its return spring. No sheet: the Soviet 6MX's electrical contact (Kirov No. 247's photographs by Johannes Altmeppen; Romanov 1975, Figs. 100-101 and p. 105's parts list), its sizes estimated where the photographs don't give them. |  | ✓ |
| 6MX.ctq |  | Spiral stud (6MX, 53) | 1 | 0 | pillarPlate | Holds the spiral's outer end on block 52. No sheet: the Soviet 6MX's electrical contact (Kirov No. 247's photographs by Johannes Altmeppen; Romanov 1975, Figs. 100-101 and p. 105's parts list), its sizes estimated where the photographs don't give them. |  | ✓ |
| 6MX.ctqs |  | Spiral stud's clamp screw (6MX) | 1 | 0 | pillarPlate | Clamps the spiral's end in the stud. No sheet: the Soviet 6MX's electrical contact (Kirov No. 247's photographs by Johannes Altmeppen; Romanov 1975, Figs. 100-101 and p. 105's parts list), its sizes estimated where the photographs don't give them. |  | ✓ |
| 6MX.cw |  | Contact wheel (6MX, 62) | 1 | 0 | secondsWheel | Fixed on the seconds arbor under its wheel, on a gilt collet: 60 ratchet teeth less one, which lift the contact lever's stone every other beat and leave it closed at the minute. No sheet: the Soviet 6MX's electrical contact (Kirov No. 247's photographs by Johannes Altmeppen; Romanov 1975, Figs. 100-101 and p. 105's parts list), its sizes estimated where the photographs don't give them. |  | ✓ |
| 6MX.cf |  | Contact spring in the bowl (6MX, 66) | 2 | 0 | bowl | A flat brass spring screwed inside the bowl, its three tines bearing on a contact block's outer end: the circuit from the terminal into the movement. No sheet: the Soviet 6MX's electrical contact (Kirov No. 247's photographs by Johannes Altmeppen; Romanov 1975, Figs. 100-101 and p. 105's parts list), its sizes estimated where the photographs don't give them. |  | ✓ |
| 6MX.cfi |  | Contact spring's insulation (6MX, 64) | 2 | 0 | bowl | A black insulating strip between each spring's foot and the bowl's bore. No sheet: the Soviet 6MX's electrical contact (Kirov No. 247's photographs by Johannes Altmeppen; Romanov 1975, Figs. 100-101 and p. 105's parts list), its sizes estimated where the photographs don't give them. |  | ✓ |
| 6MX.cfs |  | Contact spring screw (6MX, 65) | 4 | 0 | bowl | Hold the springs' feet through the bowl's wall, slotted brass heads outside (their holes across the turned bowl not cut). No sheet: the Soviet 6MX's electrical contact (Kirov No. 247's photographs by Johannes Altmeppen; Romanov 1975, Figs. 100-101 and p. 105's parts list), its sizes estimated where the photographs don't give them. |  | ✓ |
| 6MX.cfk |  | Contact terminal (6MX) | 2 | 0 | bowl | A brass socket outside the bowl for each lead, marked + and − on the bowl. No sheet: the Soviet 6MX's electrical contact (Kirov No. 247's photographs by Johannes Altmeppen; Romanov 1975, Figs. 100-101 and p. 105's parts list), its sizes estimated where the photographs don't give them. |  | ✓ |
| 6MX.cfw |  | Terminal washer (6MX, 63) | 6 | 0 | bowl | Black fibre washers under the springs' screws and the terminals outside the bowl. No sheet: the Soviet 6MX's electrical contact (Kirov No. 247's photographs by Johannes Altmeppen; Romanov 1975, Figs. 100-101 and p. 105's parts list), its sizes estimated where the photographs don't give them. |  | ✓ |

## Group 05 05

| Id | Drawing | Name | Units | Model | Card | Function | Fit and drive (measured) | |
|---|---|---|---|---|---|---|---|---|
| 050503-2 | 05 05 03-2 | Minutentrieb (centre pinion and arbor) | 1 | 1 | centreWheel | Driven by the fusee wheel; turns once an hour; runs in the top plate's bush WN-301 and, by its journal, in the pillar plate's WN-302, and carries the cannon tube (05 05 03-3) on its shank. | in WN-301 (run): 2.255 mm, least gap 0.0102<br>in WN-302 (run): 3.006 mm, least gap 0.012<br>endshake 0.094 mm (WN-302 / WN-301) | ✓ (deviation) |
| 050503-1 | 05 05 03-1 | Minutenrad (centre wheel) | 1 | 1 | centreWheel | Riveted on the pinion's seat; drives the intermediate pinion. | round 050503-2 (press): 0.501 mm, least gap 0.0002<br>meshes 050502-2: centres 18.1201 (m(z1+z2)/2 18.1197), 90/12 teeth, faces overlap 1.25, ratio -7.5 | ✓ |
| 050502-2 | 05 05 02-2 | Zwischentrieb (intermediate pinion and arbor) | 1 | 1 | intermediateWheel | Driven by the centre wheel; runs in the top plate's bush WN-300 and the intermediate bridge's. In the Soviet 6MX (the page's Variants) it runs in jewels in chatons at both ends. | in WN-300.t38/6MX.jw38u (run): 2.154 mm, least gap 0.0107<br>in WN-300.zb/6MX.jw38l (run): 2.154 mm, least gap 0.0107<br>endshake 0.074 mm (WN-300.zb / WN-300.t38) | ✓ (deviation) |
| 050502-1 | 05 05 02-1 | Zwischenrad (intermediate wheel) | 1 | 1 | intermediateWheel | Riveted on the pinion's seat; drives the seconds pinion. | round 050502-2 (press): 1.077 mm, least gap 0.0009<br>meshes 050501-2: centres 12.63 (m(z1+z2)/2 12.6298), 80/10 teeth, faces overlap 0.95, ratio -8 | ✓ |
| 050501-2 | 05 05 01-2 | Sekundentrieb (seconds pinion and arbor) | 1 | 1 | secondsWheel | Driven by the intermediate wheel; turns once a minute; runs in the top plate's bush WN-300 and the jewel 05 05 04-1 in the intermediate bridge; its lower pivot goes on as the seconds hand's post. In the Soviet 6MX its upper pivot runs in a jewel in a chaton. | in WN-300.t35/6MX.jw35u (run): 2.127 mm, least gap 0.0104<br>in 050504-1 (run): 0.638 mm, least gap 0.0154<br>endshake 0.065 mm (050504-1 / WN-300.t35) | ✓ (deviation) |
| 050501-1 | 05 05 01-1 | Sekundenrad (seconds wheel) | 1 | 1 | secondsWheel | Riveted on the pinion's seat; drives the escape pinion (05 04 05-2). | round 050501-2 (press): 1.063 mm, least gap 0.0002<br>meshes 050405-2: centres 11.8499 (m(z1+z2)/2 11.8496), 80/10 teeth, faces overlap 1, ratio -8 | ✓ |
| 050504-2 | 05 05 04-2 | Fassung (the seconds jewel's setting) | 1 | 1 | intermediateBridge | Holds the seconds arbor's lower jewel in the intermediate bridge (its sheet isn't in the set; the coloured section names it). | in 050804-1 (press): 3.596 mm, least gap -0.0016 | ✓ |
| 050504-1 | 05 05 04-1 | Lagerstein f. Sek. (the seconds arbor's lower jewel) | 1 | 1 | intermediateBridge | The seconds arbor's lower pivot runs in it; its face takes the arbor's endshake (its sheet isn't in the set; the coloured section names it). |  | ✓ |
| 050505-1 | 05 05 05-1 | Gegensperrkegel (maintaining detent) | 1 | 1 | maintDetent | Rides on the maintaining ratchet's teeth; holds it while the chronometer is wound. | round 050505-2 (press): 2.031 mm, least gap 0.0048 | ✓ |
| 050505-2 | 05 05 05-2 | Gegensperrwelle (its arbor) | 1 | 1 | maintDetent | Runs in the plates' holes 4 (drilled 0.9). | in 050802-1 (run): 2.968 mm, least gap 0.009<br>in 050901 (run): 2.499 mm, least gap 0.0111<br>endshake 0.050 mm (050802-1 / 050901) | ✓ |
| 050506-1 | 05 05 06-1 | Feder (the maintaining detent's wire spring) | 1 | 1 | maintDetent | A straight steel wire hanging from its stud past the detent's back: bent out by the detent, it presses the detent onto the maintaining ratchet's teeth (no sheet in the set; the coloured section names it, 05 06_4 marks its "Drahtfedermitte"). | on wireStud: 0 mm<br>on 050505-1: 0.0014 mm | ✓ |
| 050503-3 | 05 05 03-3 | Minutenrohr (cannon tube) | 1 | 1 | cannon | Pressed on the centre arbor's 1:80 shank, held by three punched dents in its groove pressed into the shank's groove under it (05 05 03's "Körner": the dents estimated): its foot is the cannon pinion (14 leaves, m 0.36), which drives the change wheel; its square carries the minute hand (no sheet of its own: 05 05 03 gives it). | round 050503-2 (press): 13.026 mm, least gap 0.0098 | ✓ |

## Group 05 02

| Id | Drawing | Name | Units | Model | Card | Function | Fit and drive (measured) | |
|---|---|---|---|---|---|---|---|---|
| 050200-6 | 05 02 00-6 | Anrichtstift lg (long stud) | 1 | 1 | pillarPlate | The up-and-down wheel's stud, at hole 2, 12.3 long from the plate's inner face. | in 050802-2 (press): 3.056 mm, least gap -0.0036 | ✓ |
| 050200-7 | 05 02 00-7 | Anrichtstift kurz (short stud) | 1 | 1 | pillarPlate | The motion work's change wheel's stud, at hole 19, 6.8 out of the plate's dial face. | in 050802-2 (press): 3.087 mm, least gap -0.0036 | ✓ |
| 050202-1 | 05 02 02-1 | Wechselrad (change wheel) | 1 | 1 | changeWheel | Riveted on its pipe; the cannon pinion drives it. | round 050202-2 (press): 1.035 mm, least gap 0.0004<br>meshes 050503-3: centres 12.6001 (m(z1+z2)/2 12.6), 56/14 teeth, faces overlap 1, ratio -4 | ✓ |
| 050202-2 | 05 02 02-2 | Wechselbutzen (change wheel pipe) | 1 | 1 | changeWheel | Runs on the short stud (Laufsitz auf Anrichtstift), its foot on the stud bush. | round 050200-7 (run): 6.552 mm, least gap 0.0109<br>on 050802-2: 0 mm | ✓ |
| 050202-3 | 05 02 02-3 | Wechseltrieb (change pinion) | 1 | 1 | changeWheel | Knocked on the pipe to a press fit; drives the hour wheel (no sheet in the set). | round 050202-2 (press): 2.465 mm, least gap -0.0 | ✓ |
| 050203-1 | 05 02 03-1 | Stundenrad (hour wheel) | 1 | 1 | hourWheel | Riveted on its pipe; the change pinion drives it. | round 050203-2 (press): 1.018 mm, least gap -0.0004<br>meshes 050202-3: centres 12.6001 (m(z1+z2)/2 12.6), 54/18 teeth, faces overlap 1, ratio -3 | ✓ |
| 050203-2 | 05 02 03-2 | Stundenbutzen (hour wheel pipe) | 1 | 1 | hourWheel | Runs on the cannon tube, over the cannon pinion; carries the hour hand on its tapered seat (no sheet of its own: 05 02 03 gives it). | round 050503-3 (run): 7.4 mm, least gap 0.0096 | ✓ |
| 050204-1 | 05 02 04-1 | Auf u. Abrad (up-and-down wheel) | 1 | 1 | udWheel | Riveted on its pipe; the up-and-down pinion on the fusee arbor drives it. | round 050204-2 (press): 1.006 mm, least gap -0.0005<br>meshes 050200-5: centres 18.4003 (m(z1+z2)/2 18.3997), 120/12 teeth, faces overlap 1, ratio -10 | ✓ |
| 050204-2 | 05 02 04-2 | Auf u. Abrad-Butzen (up-and-down wheel pipe) | 1 | 1 | udWheel | Runs on the long stud (Laufsitz auf Anrichtstift), its foot on the stud bush; carries the up-and-down hand. | round 050200-6 (run): 8.71 mm, least gap 0.0122<br>on 050802-2: 0 mm | ✓ |
| 050200-5 | 05 02 00-5 | Auf u. Abtrieb (up-and-down pinion) | 1 | 1 | udPinion | Pressed on the fusee arbor's dial-side end (the fusee group's): drives the up-and-down wheel (no sheet in the set; numbered by the coloured section's label). | round 050604-1 (press): 2.527 mm, least gap -0.0246 | ✓ |
| 050200-1 | 05 02 00-1 | Minutenzeiger (minute hand) | 1 | 1 | hands | Pressed on the cannon tube's square, its square hole (2,6 H7, Kegel 1:70) on the square's 2,6 r6 (05 05 03), down on the square's shoulder. | round 050503-3 (press): 1.938 mm, least gap -0.0055 | ✓ |
| 050200-2 | 05 02 00-2 | Stundenzeiger (hour hand) | 1 | 1 | hands | On the hour wheel's pipe's tapered seat. | round 050203-2 (press): 3.105 mm, least gap -0.0054 | ✓ |
| 050200-3 | 05 02 00-3 | Auf u. Abzeiger (up-and-down hand) | 1 | 1 | hands | On the up-and-down wheel's pipe's seat, down on its shoulder. | round 050204-2 (press): 1.397 mm, least gap -0.0066<br>on 050204-2: 0 mm | ✓ |
| 050201-1 | 05 02 01-1 | Sekundenzeiger (seconds hand) | 1 | 1 | hands | On its collet. | round 050201-2 (press): 0.587 mm, least gap 0.0016 | ✓ |
| 050201-2 | 05 02 01-2 | Zeigerfutter (seconds hand collet) | 1 | 1 | hands | Pressed on the seconds arbor's post through the dial; the hand riveted on its end (no sheet in the set; numbered by the coloured section's label). | round 050501-2 (press): 4.467 mm, least gap -0.0069 | ✓ |
| 050200-4 | 05 02 00-4 | Zifferblatt (dial) | 1 | 1 | dial | In the movement ring's recess, placed by its pin, held by three screws. | on 050800-3: 0 mm | ✓ |

## Group 05 03

| Id | Drawing | Name | Units | Model | Card | Function | Fit and drive (measured) | |
|---|---|---|---|---|---|---|---|---|
| 050301-1 | 05 03 01-1 | Unruhreifen (balance rim with arm, nickel steel and brass) | 1 | 1 | balance | The cut bimetallic rim and its arm, on the hub of the staff. | round 050402-1 (press): 1.112 mm, least gap 0.0086<br>on 050402-2: 0 mm | ✓ (deviation) |
| 050301-4 | 05 03 01-4 | Masse (compensation mass) | 4 | 4 | balance | Round brass masses across the rim, which the rim carries in as it warms. | on 050301-1: 0.0199 mm | ✓ |
| 050301-2 | 05 03 01-2 | Zeitschraube (timing screw) | 2 | 2 | balance | Across the rim at the arm's end in its tapped hole Ø 0.9 × 0.16, carrying the timing weight. | in 050301-1 (tap): 0.893 mm, least gap 0.0186 | ✓ |
| 050301-3 | 05 03 01-3 | Zeitmasse (timing weight) | 2 | 2 | balance | On the timing screw: turned in or out, sets the rate. | round 050301-2 (tap): 3.323 mm, least gap 0.0146 | ✓ |
| 050302-1 | 05 03 02-1 | Spiralfeder (helical hairspring) | 1 | 1 | hairspring | The balance spring: 13 turns between its two terminal curves. |  | ✓ |
| 050302-2 | 05 03 02-2 | Spiralrolle (hairspring collet) | 1 | 1 | hairspring | On the staff's 1:70 seat; the spring's inner end pinned in the hole across its end. | round 050402-1 (press): 3.337 mm, least gap 0.0033 | ✓ |
| 050302-4.c | 05 03 02-4 | Spiralstift (hairspring pin, at the collet) | 1 | 1 | hairspring | Wedges the spring's inner end in the collet's hole (Ø 0.8, Kegel 1:90): half round, brass, its flat on the strip, as the stud's pin holds the outer end (its form estimated from the stud's). | in 050302-2 (press): 2.75 mm, least gap 0.0039 | ✓ |
| 050302-3 | 05 03 02-3 | Klötzchen (hairspring stud) | 1 | 1 | stud | On the cock, its upright through the cock's slot, holding the spring's outer end. | on 050803-1: 0 mm | ✓ |
| 050302-4.s | 05 03 02-4 | Stift (hairspring pin, at the stud) | 1 | 1 | stud | Wedges the spring's outer end in the stud's hole (Ø 0.7, drilled at assembly, 3.15 under the bar), as the collet's pin holds the inner end. | in 050302-3 (press): 1.753 mm, least gap 0.0011 | ✓ |

## Group 05 04

| Id | Drawing | Name | Units | Model | Card | Function | Fit and drive (measured) | |
|---|---|---|---|---|---|---|---|---|
| 050402-1 | 05 04 02-1 | Unruhwelle (balance staff) | 1 | 1 | balance | The balance staff, its pivots in the jewels of the two cocks. As last revised 05 04 02 (29.5.46); as first drawn (the page's Variants) 05 04_5's staff of 4.4.41, which carries this number in pencil. | in 050407-1.bu (run): 0.318 mm, least gap 0.0166<br>in 050407-1.bl (run): 0.318 mm, least gap 0.0166<br>endshake 0.040 mm (050408-1.bl / 050408-1.bu) | ✓ |
| 050402-2 | 05 04 02-2 | Unruhbutzen (balance hub, brass) | 1 | 1 | balance | Pressed on the staff, its flange carries the arm. As first drawn (the page's Variants) 05 04_5's brass collar (040401-2), the arm riveted on its neck, with no screws. | round 050402-1 (press): 3.973 mm, least gap 0.0028 | ✓ |
| 050403-2 | 05 04 03-2 | Hebestein (impulse stone, sapphire) | 1 | 1 | rollers | Receives the escape wheel's impulse. |  | ✓ |
| 050404-1 | 05 04 04-1 | Auslöserolle (discharge roller) | 1 | 1 | rollers | Carries the discharge stone. | round 050402-1 (press): 1.589 mm, least gap -0.0036 | ✓ |
| 050404-2 | 05 04 04-2 | Auslösestein (discharge stone) | 1 | 1 | rollers | Lifts the detent through the gold spring on one swing; passes it on the other. |  | ✓ |
| 050405-1 | 05 04 05-1 | Gangrad (escape wheel, 15 teeth) | 1 | 1 | escapeWheel | Locked on the detent's stone between impulses, it gives the balance its impulse. | round 050405-3 (press): 0.693 mm, least gap 0.0081 | ✓ |
| 050405-2 | 05 04 05-2 | Gangtrieb (escape pinion, z 10, m 0.263, and arbor) | 1 | 1 | escapeWheel | The arbor and pinion; driven by the seconds wheel. As first drawn (the page's Variants) 05 04_7.1's arbor of 4.4.41 (050408 bis 10, renumbered 05 04 05 on 05 04_7.2), the wheel 1.4 nearer the top plate. | in 050406-1.eu (run): 0.283 mm, least gap 0.015<br>in 050406-1.el (run): 0.566 mm, least gap 0.0122<br>endshake 0.060 mm (050408-1.el / 050408-1.eu) | ✓ |
| 050405-3 | 05 04 05-3 | Gangradbutzen (escape wheel collet; 05 04 10 on 05 04_7.2) | 1 | 1 | escapeWheel | The brass collet the wheel is pressed on. As first drawn 05 04_7.1's: a cone Ø 3.0, then a pipe Ø 1.8 to 5 over the wheel. | round 050405-2 (press): 5.377 mm, least gap 0.0048 | ✓ |
| 050401-1 | 05 04 01-1 | Gangfeder (spring detent, drawing 1436) | 1 | 1 | detent | Holds the escape wheel on its locking stone; lifted on one swing by the discharge stone through the gold spring. | on 050401-4: 0 mm | ✓ |
| 050401-3 | 05 04 01-3 | Ruhestein (locking stone) | 1 | 1 | detent | Locks each tooth of the escape wheel: Ø 0.75 in the detent's pipe, ground half away below it. | in 050401-1 (press): 1.907 mm, least gap 0.002 | ✓ |
| 050401-2 | 05 04 01-2 | Goldfeder (gold passing spring) | 1 | 1 | detent | Screwed to the detent, resting on its horn: the discharge stone lifts the detent through it on one swing and bends it aside on the other. | on 050401-1: 0 mm | ✓ |
| 050401-4 | 05 04 01-4 | Gangfederkloben (detent block) | 1 | 1 | detentBlock | Under the top plate, carries the detent. As first drawn (05 04_1, Wempe 3955), a base with a long arm and its banking screw in place of the upright. | on 050901: 0 mm | ✓ |
| 050408-2.bu | 05 04 08-2 | Fassung (endstone setting), balance, upper | 1 | 1 | balanceJewelsUp | Holds the upper endstone in the cock, over the hole jewel's setting in the Ø 5.2 H7 seat, 0.006 clear, held by its two M1.2 screws over its edge (U30; the coloured section). | in 050803-1 (clear): 1.533 mm, least gap 0.0064 | ✓ |
| 050408-1.bu | 05 04 08-1 | Deckstein (endstone), balance, upper | 1 | 1 | balanceJewelsUp | Stops the staff's upper pivot end. |  | ✓ |
| 050406-2.bu | 05 04 06-2 | Fassung (jewel setting), balance, upper | 1 | 1 | balanceJewelsUp | Holds the upper hole jewel in the cock: in its Ø 5.2 H7 seat on the 0.5 lip, 0.006 clear (a located seat, not a press), held down with the endstone's setting over it by the two M1.2 setting screws over its edge (U30's 129-131; the coloured section). | in 050803-1 (clear): 1.17 mm, least gap 0.0064 | ✓ |
| 050407-1.bu | 05 04 07-1 | Lagerstein (hole jewel), balance, upper | 1 | 1 | balanceJewelsUp | The staff's upper pivot runs in it. |  | ✓ |
| 050406-2.bl | 05 04 06-2 | Fassung (jewel setting), balance, lower | 1 | 1 | balanceJewelsLow | Holds the lower hole jewel in the lug of the lower cock: in the Ø 5.2 H7 seat on the 0.5 lip, 0.006 clear, held with the endstone's setting by the two M1.2 screws over its edge. | in 050800-2 (clear): 1.53 mm, least gap 0.0064 | ✓ |
| 050407-1.bl | 05 04 07-1 | Lagerstein (hole jewel), balance, lower | 1 | 1 | balanceJewelsLow | The staff's lower pivot runs in it. |  | ✓ |
| 050408-2.bl | 05 04 08-2 | Fassung (endstone setting), balance, lower | 1 | 1 | balanceJewelsLow | Holds the lower endstone, in the lug's Ø 5.2 H7 seat, 0.006 clear, held by its two M1.2 screws. | in 050800-2 (clear): 1.19 mm, least gap 0.0064 | ✓ |
| 050408-1.bl | 05 04 08-1 | Deckstein (endstone), balance, lower | 1 | 1 | balanceJewelsLow | Stops the staff's lower pivot end. |  | ✓ |
| 050408-2.eu | 05 04 08-2 | Fassung (endstone setting), escape wheel, upper | 1 | 1 | escEndstoneUp | Holds the upper endstone in the top plate's seat. | in 050901 (press): 1.341 mm, least gap 0.0058 | ✓ |
| 050408-1.eu | 05 04 08-1 | Deckstein (endstone), escape wheel, upper | 1 | 1 | escEndstoneUp | Stops the escape arbor's upper pivot end. |  | ✓ |
| 050406-2.eu | 05 04 06-2 | Fassung (jewel setting), escape wheel, upper | 1 | 1 | escJewelUp | Holds the upper hole jewel, flush with the top plate's inner face. | in 050901 (press): 1.94 mm, least gap 0.0064 | ✓ |
| 050406-1.eu | 05 04 06-1 | Lagerstein (hole jewel), escape wheel, upper | 1 | 1 | escJewelUp | The escape arbor's upper pivot (Ø 0.24) runs in it. |  | ✓ |
| 050406-2.el | 05 04 06-2 | Fassung (jewel bush), escape wheel, lower | 1 | 1 | escJewelLow | Pressed into the pillar plate's hole 26, holding the lower hole jewel. | in 050802-1 (press): 0.989 mm, least gap 0.0009 | ✓ |
| 050406-1.el | 05 04 06-1 | Lagerstein (hole jewel), escape wheel, lower | 1 | 1 | escJewelLow | The escape arbor's lower pivot runs in it. |  | ✓ |
| 050408-2.el | 05 04 08-2 | Fassung (endstone cap), escape wheel, lower | 1 | 1 | escEndstoneLow | On the pillar plate's dial side, holding the lower endstone. | on 050802-1: 0 mm | ✓ |
| 050408-1.el | 05 04 08-1 | Deckstein (endstone), escape wheel, lower | 1 | 1 | escEndstoneLow | Stops the escape arbor's lower pivot end. |  | ✓ |

## Group 02 04

| Id | Drawing | Name | Units | Model | Card | Function | Fit and drive (measured) | |
|---|---|---|---|---|---|---|---|---|
| 050403-1 | 02 04 02 | Heberolle (impulse roller, beryllium copper; 05 04 03-1 in the coloured section) | 1 | 1 | rollers | Carries the impulse stone, which the escape wheel pushes. | round 050402-1 (press): 1.43 mm, least gap -0.0158 | ✓ |

## Group 05 06

| Id | Drawing | Name | Units | Model | Card | Function | Fit and drive (measured) | |
|---|---|---|---|---|---|---|---|---|
| 050604-2 | 05 06 04-2 | Schneckenkörper (fusee body) | 1 | 1 | fusee | The cone with its nine-turn groove, pressed on the arbor's collar. | round 050604-1 (press): 7.942 mm, least gap -0.0107 | ✓ |
| 050604-1 | 05 06 04-1 | Schneckenwelle (fusee arbor) | 1 | 1 | fusee | Runs in the pillar plate (its dial-side pivot) and the fusee bush (its journal); its square takes the key. | in 050802-1 (run): 3.249 mm, least gap 0.0131<br>in 050801-2 (run): 5.776 mm, least gap 0.0159 | ✓ |
| 050604-3 | 05 06 04-3 | Schneckensperrrad (click wheel) | 1 | 1 | fusee | On the body's large end, in its recess: drives the maintaining clicks. | on 050604-2: 0 mm | ✓ |
| 050600-6 | 05 06 00-6 | Kettenstift (chain pin) | 1 | 1 | fusee | Across the flange's slot in its hole through both ribs ("0,55∅ +0,01", 05 06 04-2): the chain's (or band's) top hook takes it. | in 050604-2 (press): 0.826 mm, least gap -0.0061 | ✓ |
| 050600-4 | 05 06 00-4 | Deckplatte (cover plate) | 1 | 1 | coverPlate | On the arbor's step against the body's small end, over the stop bar. | round 050604-1 (run): 0.361 mm, least gap 0.0086<br>on 050604-2: 0 mm | ✓ |
| 050600-2 | 05 06 00-2 | Vorreiber | 1 | 1 | vorreiber | Pinned on the arbor's taper under the fusee wheel, its flange in the wheel's underside recess. | round 050604-1 (press): 2.166 mm, least gap -0.004 | ✓ |
| 050600-5 | 05 06 00-5 | Vorreiberstift (Vorreiber pin) | 1 | 1 | vorreiber | One taper pin through the Vorreiber's hub and the arbor's cross hole, reamed through both together at the fusee's assembly (05 06 04-1: "1,1 bohren + konisch reiben"; the Vorreiber's drilled Ø 0.8, 05 06 00-2; 05 06_1 draws it Ø 1.2): drawn Ø 1.16 in the two holes' Ø 1.15, its rounded ends standing 0.4 out of the hub, as the coloured section draws it. | in 050600-2 (press): 3.075 mm, least gap -0.0043<br>in 050604-1 (press): 4.244 mm, least gap -0.0043 | ✓ |
| 050600-1 | 05 06 00-1 | Staubplatte (dust plate) | 1 | 1 | dustPlate | On the winding square, inside the dust bush. | round 050604-1 (press): 1.805 mm, least gap -0.0016 | ✓ |
| 050600-3 | 05 06 00-3 | Schneckenrad (fusee wheel) | 1 | 1 | fuseeWheel | Loose on the arbor's seat, driven by the maintaining spring; drives the centre pinion. | round 050604-1 (free): 3.61 mm, least gap 0.0399<br>meshes 050503-2: centres 22.6496 (m(z1+z2)/2 22.6512), 90/14 teeth, faces overlap 2.42, ratio -6.428571 | ✓ |
| 050602-1 | 05 06 02-1 | Gegensperrrad (maintaining ratchet) | 1 | 1 | maintaining | Turns on the fusee wheel's tube; the maintaining detent rides on its teeth. | round 050600-3 (free): 1.323 mm, least gap 0.0088 | ✓ |
| 050602-3 | 05 06 02-3 | Sperrkegel (click) | 2 | 2 | maintaining | In the ratchet's cup, on its screw's shoulder; the click wheel drives it. | round WN-21 (free): 1.519 mm, least gap 0.0093 | ✓ |
| 050602-2 | 05 06 02-2 | Sperrfeder (click spring) | 2 | 2 | maintaining | Pinned inside the cup's wall, pressing its click onto the click wheel. |  | ✓ |
| 050602-4 | 05 06 02-4 | Stift (click spring pin) | 4 | 4 | maintaining | A rivet (the coloured section's "Niet"): through the cup's wall and the spring's hole (its Ø 0.6 holes cut through the cup, 26 October 2026), headed both sides (05 06 02: domed, about 0.2 high). | in 050602-1 (press): 0.19 mm, least gap 0.0061 | ✓ |
| 050601-1 | 05 06 01-1 | Gegenfeder (maintaining spring) | 1 | 1 | maintaining | An open ring between the fusee wheel and the ratchet, in the wheel's recess on its web: carries the drive. | on 050600-3: 0 mm | ✓ |
| 050600-8 | 05 06 00-8 | Stellstift f. Gegenfeder (maintaining spring's pin) | 2 | 2 | maintaining | Pressed in the spring's holes: one into the fusee wheel, one into the ratchet. | in 050601-1 (press): 1.312 mm, least gap 0.0031<br>in 050600-3/050602-1 (run): 1.021 mm, least gap 0.0066 | ✓ |
| 050603-1 | 05 06 03-1 | Stellungssteg (stop bar) | 1 | 1 | stopWork | Slides in the slot across the fusee's small end (cut in the body: 1.5 deep, 1.1 toward its upper end, which is thinner), on the cover plate; its spring holds it out, the chain on the top turn presses it in, and its upper end meets the stop pin at full wind. | on 050600-4: 0 mm | ✓ |
| 050604-4 | 05 06 04-4 | Stift (05 06 04-4: the coloured section's label and 05 06 04's parts list, likely), the stop bar's spring's pin | 1 | 1 | stopWork | Along the slot in the body's hole 0.5 H7 (05 06 04-2), from the recess out through the end, standing into the recess through the spring's hole, which it holds. | in 050604-2 (press): 2.946 mm, least gap -0.0061 | ✓ |
| 050603-2 | 05 06 03-2 | Stift (05 06 03-2, the coloured section's label), the stop bar's pin, on which its spring's end bears | 1 | 1 | stopWork | Pressed across the bar near its lower end in its Ø 0.5 hole (05 06_4's C-D, dashed across the bar), standing 0.9 out of its near side, where the bar's spring's end bears. | in 050603-1 (press): 0.417 mm, least gap 0.0054 | ✓ |
| 050603-3 | 05 06 03-3 | Stegfeder (the stop bar's spring) | 1 | 1 | stopWork | A strip in the small end's recess, held on its pin 05 06 04-4 through a hole in it where it lies on the wall, round the wall and the bar's upper side to a free span whose end bears on the bar's pin 05 06 03-2 near the bar's lower end: holds the bar out toward that end (no sheet: drawn as 05 06_4's C-D draws it). | on 050600-4: 0 mm | ✓ |

## Group 05 07

| Id | Drawing | Name | Units | Model | Card | Function | Fit and drive (measured) | |
|---|---|---|---|---|---|---|---|---|
| 050701-1 | 05 07 01-1 | Federhaustrommel (barrel drum) | 1 | 1 | barrel | Turns on the arbor's journals; the chain winds onto it. | round 050702-1 (free): 3.246 mm, least gap 0.039 | ✓ |
| 050701-2 | 05 07 01-2 | Federhausdeckel (barrel lid) | 1 | 1 | barrel | Sprung into the drum's seat on the bridge's side; turns on the arbor's upper journal. | round 050702-1 (free): 3.246 mm, least gap 0.039 | ✓ |
| 050701-3 | 05 07 01-3 | Federhaushaken (spring hook block) | 1 | 1 | barrel | Riveted inside the drum's wall: takes the mainspring's outer end. | on 050701-1: 0 mm | ✓ |
| 050700-1 | 05 07 00-1 | Steg (spring brace) | 1 | 1 | barrel | Stands inside the drum's wall from its bottom to its lid, its ends through the bottom's slot and the lid's notch: the mainspring's outer coil threaded between it and the wall. | on 050701-2: 0 mm<br>on 050701-1: 0 mm | ✓ |
| 050702-1 | 05 07 02-1 | Federkern (barrel arbor) | 1 | 1 | barrelArbor | Runs in the pillar plate and the barrel bridge; held by the set-up ratchet and click. | in 050802-1 (run): 3.496 mm, least gap 0.012<br>in 050805-1 (run): 2.996 mm, least gap 0.013<br>endshake 0.060 mm (050802-1 / 050805-1) | ✓ |
| 050702-2 | 05 07 02-2 | Federhaken (arbor hook) | 1 | 1 | barrelArbor | Pressed in the core's hole (Ø 2 × 6, 0207): takes the mainspring's inner end. | in 050702-1 (press): 5.92 mm, least gap 0.0058 | ✓ |
| 050700-3 | 05 07 00-3 | Sperrad (set-up ratchet) | 1 | 1 | setupRatchet | On the arbor's square above the barrel bridge; the bridge's click holds it. | round 050702-1 (press): 2.497 mm, least gap 0.001 | ✓ |
| 050700-6 | 05 07 00-6 | Zugfeder (mainspring) | 1 | 1 | mainspring | In the drum: inner end on the arbor's hook, outer end on the drum's block. Its length isn't drawn: estimated. |  | ✓ |
| 050704 | 05 07 04 | Kette (fusee chain) | 0-1 | 1 | chain | Between the barrel and the fusee: its top hook on the fusee's pin, its bottom hook in the drum's slot (the page's default; the band under Variants). |  | ✓ |
| 050703-1 | 05 07 03-1 | Band (fusee band) | 0-1 | 0 | band | The strip, 0.22 thick, between the barrel and the fusee. |  | ✓ |
| 050703-2 | 05 07 03-2 | Bandhaken rund (band's round hook) | 0-1 | 0 | band | On the fusee's pin. |  | ✓ |
| 050703-3 | 05 07 03-3 | Bandhaken f. Trommel (band's drum hook) | 0-1 | 0 | band | In the drum's slot. |  | ✓ |

## Group 05 01

| Id | Drawing | Name | Units | Model | Card | Function | Fit and drive (measured) | |
|---|---|---|---|---|---|---|---|---|
| 050100-3 | 05 01 00-3 | Gehäusekloben (case bracket) | 2 | 2 | bowl | On the bowl at 12 and 6 o'clock, carrying the inner pivots; slid along its slots to level the bowl. | on 050100-1: 0 mm | ✓ |
| 050100-4 | 05 01 00-4 | Feststellkloben (locking bracket) | 1 | 1 | bowl | On the bowl at 50 deg from 6 o'clock: the transit lock presses the ring onto it. | on 050100-1: 0 mm | ✓ |
| 050100-2 | 05 01 00-2 | Verschlußplatte (closing plate) | 1 | 1 | closingPlate | In the bowl's foot, turning on its screw to open and shut the winding hole. | on 050100-1: 0 mm | ✓ |
| 050100-7 | 05 01 00-7 | Verschlußfeder (closing spring) | 1 | 1 | closingPlate | Holds the closing plate shut over the winding hole and turns it back when the key is out: a wire spiral in the plate's groove, one end in the plate's Ø 1.2, the other in the bowl's bottom (no sheet: estimated from the plate's; its ends sit free in their holes, so no relation is measured). |  | ✓ |
| 050101-1 | 05 01 01-1 | Glas (glass) | 1 | 1 | bezel | On the bezel's seat inside its lip, 3.5 thick, standing 2.4 proud of the lip, its top 15.8 over the bezel's underside (05 01 01). | on 050101-2: 0 mm | ✓ |
| 050100-5 | 05 01 00-5 | Kardanring (gimbal ring) | 1 | 1 | gimbalRing | Between the bowl and the box: its outer pivots in the box's walls, its inner pivots in the bowl's brackets. |  | ✓ |
| 050100-6 | 05 01 00-6 | Kardanringkloben (ring bracket) | 1 | 1 | gimbalRing | On the ring at 3 o'clock, carrying that outer pivot; slid along its slots to level the bowl. | on 050100-5: 0 mm | ✓ |
| 050101.F | 05 01 01 (05 01’s list) | Feststeller (transit lock) | 1 | 1 | caseLock | A knob and lever in the box's front right corner: turned in, the lever presses the ring onto the locking bracket. |  | ✓ |
| 050102-2 | 05 01 02-2 | Schlüsselmittelteil (key body) | 0-1 | 1 | key | The key's black steel body. |  | ✓ |
| 050102-3 | 05 01 02-3 | Schlüsselrohr (key tube) | 0-1 | 1 | key | The brass tube with the square socket. | in 050102-2 (free): 4.979 mm, least gap 0.0549 | ✓ |

## Group 51 00

| Id | Drawing | Name | Units | Model | Card | Function | Fit and drive (measured) | |
|---|---|---|---|---|---|---|---|---|
| 510010 | 51 00 10 | Griff f. Chronometerkasten (handle) | 2 | 2 | box | On each side, under the pivot, over the wall's finger recess (an oval 70 × 30, 10 deep in the 12.5 wall). | on Holzkasten: 0 mm | ✓ |
| 510011-1 | 51 00 11-1 | Schlüsselgriff (key handle) | 0-1 | 1 | key | The key's round flat paddle. |  | ✓ |
| 510011-4 | 51 00 11-4 | Wendelfeder (the key’s coil spring) | 0-1 | 1 | key | Round the tube in the body's bore: it grips the tube one way and slips the other. |  | ✓ |
| 510011-6 | 51 00 11-6 | Kerbstift K.S. 1 (the key’s grooved pin) | 0-1 | 1 | key | Through the body and the paddle. |  | ✓ |

## Group 00 01

| Id | Drawing | Name | Units | Model | Card | Function | Fit and drive (measured) | |
|---|---|---|---|---|---|---|---|---|
| 000101-9 | 00 01 01-9 | Firmenschild (maker’s plate), Type 3371 | 1 | 1 | lid | On the lid's front, held by four pins Ø 1.2 in its holes 2 from its edges, driven into the lid's wood (their heads and depth estimated). | on Holzkasten.D: 0 mm | ✓ |

## The jewels

| Jewel | Kind | Arbor, end | Set in | Least gap |
|---|---|---|---|---|
| Lagerstein f. Sek. (the seconds arbor's lower jewel) | hole | 050501-2 lower | 050504-2 (1.1 mm) | 0.006 |
| Hebestein (impulse stone, sapphire) | pallet | | 050403-1 (1.61 mm), 050402-1 (0.05 mm) | 0.0031 |
| Auslösestein (discharge stone) | pallet | | 050404-1 (1.55 mm), 050402-1 (0.15 mm) | 0.0031 |
| Ruhestein (locking stone) | pallet | | 050401-1 (1.91 mm), 050405-1 (1.42 mm) | 0.002 |
| Deckstein (endstone), balance, upper | end | 050402-1 upper | 050408-2.bu (0.9 mm) | 0.0078 |
| Lagerstein (hole jewel), balance, upper | hole | 050402-1 upper | 050406-2.bu (0.8 mm) | 0.0078 |
| Lagerstein (hole jewel), balance, lower | hole | 050402-1 lower | 050406-2.bl (0.8 mm) | 0.0078 |
| Deckstein (endstone), balance, lower | end | 050402-1 lower | 050408-2.bl (0.9 mm) | 0.0078 |
| Deckstein (endstone), escape wheel, upper | end | 050405-2 upper | 050408-2.eu (0.9 mm) | 0.0078 |
| Lagerstein (hole jewel), escape wheel, upper | hole | 050405-2 upper | 050406-2.eu (0.8 mm) | 0.0078 |
| Lagerstein (hole jewel), escape wheel, lower | hole | 050405-2 lower | 050406-2.el (0.79 mm) | 0.0057 |
| Deckstein (endstone), escape wheel, lower | end | 050405-2 lower | 050408-2.el (0.75 mm) | 0.0067 |

## The gears as meshed

| Driver | Driven | Teeth | Modules | Centres | m(z1+z2)/2 | Faces overlap | Ratio | Want |
|---|---|---|---|---|---|---|---|---|
| 050503-1 | 050502-2 | 90/12 | 0.3552888888888889/0.35533333333333333 | 18.1201 | 18.1197 | 1.25 | -7.5 | -7.5 |
| 050502-1 | 050501-2 | 80/10 | 0.2806625/0.2807 | 12.63 | 12.6298 | 0.95 | -8 | -8 |
| 050501-1 | 050405-2 | 80/10 | 0.263325/0.263 | 11.8499 | 11.8496 | 1 | -8 | -8 |
| 050600-3 | 050503-2 | 90/14 | 0.4356/0.43557142857142855 | 22.6496 | 22.6512 | 2.42 | -6.428571 | -6.428571 |
| 050202-1 | 050503-3 | 56/14 | 0.36/0.36 | 12.6001 | 12.6 | 1 | -4 | -4 |
| 050203-1 | 050202-3 | 54/18 | 0.35/0.35 | 12.6001 | 12.6 | 1 | -3 | -3 |
| 050204-1 | 050200-5 | 120/12 | 0.2787833333333333/0.2787833333333333 | 18.4003 | 18.3997 | 1 | -10 | -10 |

## Known deviations

- endshake 050503-2#0 -> WN-301 (WN-302): the train-side shoulder is one 30° cone from the pivot's root (05 05 03-2), so it bears on the jewel at its hole's edge, 0.014 up the cone from where a flat shoulder bore (26 October 2026): 0.084 in all, inside the Wempe's own band for the centre arbor, the 1958 Soviet MX repair book's 0.07-0.10 (Appendix 4; wempe_bench.js), over the Hamilton manual's 0.003 in this check takes
- in WN-14#0 -> 050401-1 (tap): the detent's square is 0.50 thick across (0.55 as first drawn: 05 04 01-1), so the gold spring's M0.7 screw engages 0.39 of its tapped hole, 0.42 deep (the sheet gives no depth), under this check's 0.4: all the square has
