OrelMag/marine-chronometer-model/marine-chronometer-source/wempe/parts-audit/FINDINGS-EXPLAINED.md

# The Wempe model against the works drawings: the findings explained

For the owner, 3 November 2026. Nothing in the model was changed. This only explains `WEMPE-PARTS-LEDGER.md`. No scan or crop of a sheet is in it, only figures and words. It was written from the ledger, the readers' and verifiers' reports, `earlier-passes.md` and the Wempe README, without re-reading the sheets. Where a reason is not recorded, it says so.

## 0. What this covers and how to read it

- The audit compared 187 parts of the model, as last revised, with 111 works sheets (1,670 items). The agents ended with 150 mismatch, 22 not built and 12 extra. Counting each reader/verifier pair once, and the gold spring's bending point as a match (the ledger's own override), about 184 items remain. This text groups them into **45 findings**, plus a list of what is not a difference (section 9).
- **Drawn** is what the sheet prints, with its tolerance where printed. **Built** is what the exact solid of the model measures.
- "Match" in the ledger means inside the sheet's tolerance. Where none is printed, it means inside the sheet's general tolerance, or the fallback: ±0.05 to 6 mm, ±0.1 to 30, ±0.15 to 120.
- A sheet's date is its latest revision date. Certainty words (sure, likely, unsure) are the readers' and verifiers'. The scans are about 1,024 px across, so scaled figures carry ±0.1 to 0.3 mm.
- Counts: A timing 10, B train 7, C fusee 7, D barrel 5, E motion work, hands, dial 5, F frame 9, G case, keys, box 2.

### The owner's rules as applied

1. **Two sheets disagree: the later-dated sheet decides.** A revision date counts as the sheet's date.
2. **The later sheet's size clashes with a mating part whose sheet is older or absent, and no later assembly sheet or photograph settles the pair: "your decision".**
   - Options: (a) the later sheet's size, changing the neighbour as little as possible; (b) keep the present fit and record the departure.
   - Each case says whether an assembly sheet or photograph bears on it. The model keeps its present fit meanwhile.
3. **A sheet dated after war-time production counts as "later" only after a check that it revises this chronometer.**
   - 05 05_4, 05 05_7 (6.6.46), 05 05_9, 05 05_10 and the 1948 barrel and fusee revisions carry the same drawing numbers as the parts lists of the 1940/43 assemblies (05 05 01-2, 05 05 02-2, 05 07 01-1, 05 06 04-2). They revise this chronometer and count as later.
   - 05 04_4 (staff kompl., "29.5.", year read as 1946, likely) carries the number 05 04 02 that the older 05 04_5 (4.4.41) only has by hand. It counts as later than 05 04_5.
   - **05 03_3.2 (staff, "Unruhwelle Kpl.", number 050401, tempered 210°, 12.3.65): needs the version check.**
     - The number 05 04 01 is the Wempe family's number for the staff, but this chronometer's staff kompl. is 05 04 02 (05 04_4), tempered 240°.
     - A neighbouring sheet, 05 03_3.1 (17 04 01, 7.6.43), is another calibre's staff.
     - The title block does not say which chronometer it belongs to, so it can't be settled here.
     - The model already takes its lengths (25.6 total, 12.6 lower pivot) from it. Nothing should be changed on its authority until the check is done.

---

## A. Timing: the escapement, balance and hairspring (10 findings)

### A1. The escape wheel's place against the detent (06-1-7, 06-1-12, 06-1-13, 06-1-14)
- **Sheet:** the layout 05 04_1, Hemmung für Feder-Chronometer (3.2.40). The 23.8 is sure; the 0 and 53.6 are likely (scaled).
- **Drawn:**
  - the wheel's centre lies directly under the locking stone's pipe, the line to it square to the detent (0 ±0.1 along the detent);
  - the angle at the pipe between the detent axis and the balance-to-wheel line is 53.6° (scaled ±1);
  - wheel centre to the M1.7 block-screw hole is 23.8.
- **Built:**
  - the wheel stands 0.447 mm along the detent from the pipe;
  - the angle is 49.4°;
  - the distance to the hole is 23.41;
  - balance to wheel is 10.00, as drawn.
  - The verifier measured the detent as turned 3.6–4° about its pipe; a rougher estimate from the detent's box gives about 5°, in the same direction.
  - The layout's chain (18.8 along, 14.6 across) closes on 23.75 with the wheel under the pipe, and on 23.41 with the built offset.
- **Affects:** timing (lock, let-off, drop), because the detent's turn moves where the stone meets the teeth.
- **Why:** the top plate's table (05 08_1, 15.6.43, later than the layout) puts hole 13 at 23.41 from the wheel.
  - README, Kept: "the block screw on the plate table's hole 13 (23.41, Wempe 3955 23.36) against 05 04_1's 23,8".
  - Wempe 3955's photograph measures 23.36 ±0.15. So a photograph agrees with the plate.
  - Nobody had noted the 0.447 offset and the turn; they follow from taking 23.41.
- **Under the rule:** the later plate table decides the 23.41, and the model follows it. No later sheet places the wheel itself (05 04_2, _3 and _10 give block and detent sizes only). The layout's other lines (wheel under the pipe, 53.6°) cannot all be kept with 23.41.
- **Action: your decision.**
  - (a) Keep 23.41, the wheel 0.447 off the pipe line, the detent turned about 4°. The escapement tools were solved on this geometry.
  - (b) Put the wheel under the pipe at 53.6° and move plate hole 13 by 0.39 to 23.8. That departs from the plate's table, and every escapement tool must be rerun.
  - Recommended: (a).
- 06-1-14 (15° label, built 15.8°): the number fits a drawn line; unsure what it attaches to; skip.

### A2. The hairspring's pitch and heights (08-2-5, 08-1-2, 08-1-3, 08-1-4, 08-1-v1)
- **Sheets:** 05 03_6 (26.6.41) and 51 03_5 (29.10.41). They agree with each other. The pitch is sure (three readings 0.73–0.74, none 0.80); the heights are likely.
- **Drawn:** strip 0.52 + gap 0.21 = pitch 0.73; 15 turns over 11.5. On the assembly: stud arm's inner face to spring top 3.15; collet face to the spring 0.75; spring overall 9.5; 3.15 + 9.5 + 0.75 = 13.4.
- **Built:** pitch 0.8003 (gap 0.280), so the helix is 9.97 tall; 2.89 + 9.97 + 0.49 = 13.35. The strip stands about 0.25 past the drawn ends.
- **Affects:** appearance and the ends in stud and collet. The period is not affected: the physics keeps the wound pitch.
- **Why:** README: "the drawn helix opened between them to a pitch of 0.80 (the 11.8 turns of helix this model reads; 05 03_5 draws 13 pitches of the wound 0.73), the physics keeping the wound pitch". The ends were put in their holes and the helix opened to fill the gap.
- **Under the rule:** both sheets say 0.73 and 9.5; no later sheet disagrees. The model should be 0.73 and 9.5.
- **Action: correct.** Use pitch 0.73, height 9.5 and the ends 3.15 and 0.75. Fifteen turns at 0.73 would be 10.95 tall, so the turn count must also be settled (the drawn counts run 11.5–13). Rerun `hairspring.js` and `wempe_hairspring.js`.

### A3. The collet's bore and cross hole (08-4-5, 08-4-7, 08-4-11, 08-4-14, 08-4-v2)
- **Sheet:** 05 03_8 Spiralrolle (24.2.43).
- **Drawn:** bore 1.6 H7 (+0.009), taper 1:70, (1.55) at the other face (bracketed reference). Cross hole 0.8 +0.01 at the entry, (0.77) at the other end, taper 1:90, drilled 0.7 first. A centre-punch mark.
- **Built:** bore 1.6029 at the first face (inside the limit), 1.65 at the other. Cross hole 0.805 straight. No punch mark.
- **Affects:** fit only.
- **Why:** pass 1 opened the bore on purpose: "the sheet's 1,6 would stand 3.15 over the arm, against 05 03_5's 13,4 and 0,75". The hole's taper was left out (pass 2, open).
- **Under the rule:** 05 03_8 (1943) is later than the assembly 51 03_5 (1941), and its bore clashes with the assembly's heights. No later assembly or photograph settles it. Rule 2 applies.
- **Action: your decision (small).**
  - (a) Taper 1.6 to 1.55 and accept the collet standing 0.10 higher.
  - (b) Keep.
  - Recommended: (b). The 1:90 hole taper and the punch mark are optional.

### A4. The hairspring stud (08-5-13, 08-5-15, 08-5-v2)
- **Sheet:** 05 03_9 Klötzchen (6.6.41).
- **Drawn:** spring hole about 0.68 from the leg's end (scaled, unsure; "drilled at assembly"). A rounded point (a 0.8 mark; the arc is plain on the crop). The notch apex rounded.
- **Built:** hole 1.35 from the end; sharp point; apex not rounded.
- **Why:** README: the round point is the blank's, and the facets ground to the knife edge leave no metal for it, so it is kept. The built hole is where the page's strip passes.
- **Affects:** appearance, and where the strip is clamped.
- **Action:** keep the point. The hole is your decision; recommended keep, since the sheet says it is drilled at assembly.

### A5. The detent spring's tail tip (06-5-4)
- **Sheet:** 05 04_10.1 Gangfeder 1436 (Rud. Grießbach, 12.2.43). Likely.
- **Drawn:** tail width at the tip 0.25 (0.22), the same as at the pipe. The callout meets the blank's straight edges.
- **Built:** 0.22 at the pipe, narrowing to a 0.054 sliver at the tip.
- **Affects:** a little stiffness, and appearance.
- **Why:** not recorded; neither earlier pass found it.
- **Action: correct** to a constant 0.22 to the tip, unless the taper was meant. Rerun `tripping.js`.

### A6. The detent block (06-3-13, 06-3-28)
- **Sheet:** 05 04_3 Gangfederkloben (8.7.43).
- **Drawn:** the M1.2 cross hole centred on the 3 mm (z 5.0, scaled ±0.06). The two Ø 0.45 steady-pin holes are not on the sheet.
- **Built:** hole at 5.15 (+0.15; general tolerance ±0.1). Both pin holes present.
- **Why:** pass 2 (2-M6, 2-M8): no pin holes drawn, the Ø 0.45 an estimate, open.
- **Action:** correct the M1.2 hole to 5.0. Keep the pin holes as an estimate.

### A7. Layout items the later block sheet replaced (06-1-17, 06-1-20, 06-1-25, 06-2-9, 06-4-15)
- **Sheets:** 05 04_1 (3.2.40) against 05 04_3 (8.7.43), 05 04_2 Goldfeder (16.9.42) and 51 04_6 Heberolle (11.2.41).
- **Differences:**
  - stud circle from the M1.7 centre: drawn about 3.8, built 4.50;
  - the 45° chamfer of about 3.8 × 3.8 on the arm-side corner: not built;
  - arm thickness: layout section 2.8, built 3.0;
  - the gold spring blank is drawn straight on 05 04_2, and the built spring is bent in plan;
  - the Heberolle cut centre 5.927 is not printed: extra.
- **Under the rule:** the block sheet (1943) is later, so 4.50, 3.0 and no chamfer are right. The straight blank is a blank. **Keep all.** The gold spring's bending point (06-1-15) is a **match**: the sheet marks it about 6.2 from the stone's pipe with a dashed line, and the model has 6.15.

### A8. The balance staff (07-1-4, 07-1-16, 07-2-2, 07-2-3, 07-2-5, 07-2-7, 07-2-8, 07-3-1, 07-3-3, 07-3-5, 07-3-6, 07-3-10, 07-3-13, 07-3-14, 07-3-19) — NEEDS THE VERSION CHECK
- **Sheets, oldest first:** 05 04_5 (4.4.41, rechecked 1943), 05 04_4 (29.5.46, likely), 05 03_3.2 (12.3.65, see rule 3).
- **The model mixes them:** lengths from the 1965 sheet, fits and the straight flange from the 1946 sheet.
- **Against 05 03_3.2 (all likely):**
  - upper pivot 1.25 −0.02 (1.23–1.25), built 1.2 (−0.03);
  - lower pivot shaft 1.25 −0.02, built 1.2155 (−0.0145 under);
  - lower collar 1.65 −0.02 (1.63–1.65), built 1.6685 (+0.0185 over);
  - collar above the hub 2.10 −0.02 (digit unsure; 2.40 or 2.10), built 2.0;
  - lower collar length 1.6, built 1.5; hub top to collar end 5.7, built 5.6;
  - lower pivot collar to tip 6.9, built 6.99 (the split is wrong, the sum 12.6 is right);
  - a 10° taper on the hub flange (wide at the top), built vertical.
- **Against 05 04_4 (1946):** the 1.65 s6 shaft at the hub end of the taper should be 1.665–1.672, built 1.6514 (−0.0136). The sheet's own taper does not reach 1.665 either.
- **Against 05 04_5 (1941):** collar 2.1 ±0.03 (built 2.0), its length 1.3 (built 1.1), flange top to sleeve end 4.7 (built 4.1), flange top to lower tip 14 / 14.03 (built 12.59), and the 10° flange taper.
- **Affects:** the pivots and collars set the jewel fit and the seats for the collet and roller. The inertia changes only at about 0.001 mm.
- **Why:** README: 14.03 runs to the lower centre's apex on the stock. A finished staff that long would put the pivot 0.23 past the lower cock. The pivot's 6.9 + 6.1 top lengths come from the 1965 sheet.
- **Under the rule:** the 1941 figures (14, 4.7) lose to the later sheets, so the model is right on those. For 1.25, 1.65, 2.10, 1.6 and 5.7 the 1965 sheet would win, but it needs the version check.
- **Action: your decision, after the check.**
  - (a) If the sheet is confirmed for this chronometer: pivots 1.25 −0.02, collars 1.65 −0.02 and 2.10 −0.02, 1.6/5.7, the 10° taper. The jewel holes must then be widened to keep 0.02 clearance.
  - (b) Keep the 1946 sizes.
  - Recommended: wait for the check. The 1.2155 and 1.6685 are real misses of the limits that apply today; fix them whatever the answer.

### A9. The balance rim and hub (07-5-11, 07-6-2, 07-6-10, 07-6-17)
- **Sheets:** 05 03_2 (23.6.41) and 05 03_4 (31.7.41).
- **Differences:**
  - the nickel-steel / brass boundary at Ø 31.29 −0.04 (sure) is not built: the rim is one solid;
  - the hub hole 1.8 H7 × 0.4 is a flat counterbore at one hole on the sheet, and a countersink at both holes in the model (unsure which hole);
  - the eight "Körner in 60 Teilung" punch marks are not built;
  - an unclear "39" on 05 03_2; read as a diameter, the sheet and model differ by about 1.2.
- **Affects:** the boundary is a material split, not a shape. The physics already treats the rim as a cut bimetal. The rest is appearance.
- **Note:** the ledger's own comparison with the earlier passes thinks the new pass is wrong to count 07-6-2.
- **Action:** keep the boundary and the marks. Correct the counterbore if you want it exact. The 39 is unread: leave.

### A10. The balance's jewel stacks and the cocks (03-3-13, 03-3-18, 03-8-2, 03-8-4, 03-8-6, 03-8-8)
- **Sheets:** 05 08_6 (U 30, 1941), 05 08_33 (U 31, 1941, a copy), 05 08_4 (19.4.41, rev. 2.12.46).
- **Jewel stacks:** printed 1.4 + 1.4 (likely). Built 1.63 + 1.17 (upper) and 1.53 + 1.19 (lower). The lower stack is printed 0.1 proud, built flush.
- **Upper cock:** pin hole along the arm: 5 printed; built 4.1 to the axis (the verifier found the drawn pin 5.1 from the axis).
- **Lower cock:** width in Ansicht A drawn 19.75, built 20.0 (+0.25, over 0.15); arm thickness 3.3 printed, built 3.22.
- **Affects:** the stacks set the endshake and oil gap of the balance's pivots (checked in `bom.py`); the pin hole sets the stud's pin.
- **Why:** README, Estimated: every jewel and setting has "no sheet"; the sizes are scaled on the coloured section (pictorial, ±0.1). Pass 1: "split differs, recorded estimate".
- **Action: your decision.**
  - Stack: keep, unless the printed 1.4 + 1.4 can still give the endshake band.
  - Lower cock's width: correct to 19.75.
  - Arm 3.3: correct (0.08 over the fallback).
  - Pin hole: unsure, leave.
- Note: 05 08_33 draws an earlier lower cock of another shape; the model follows 05 08_4, which matches.

**Small items in A**

| id | Part | Drawn | Built | Action |
|---|---|---|---|---|
| 08-4-14 | collet | punch mark | none | optional |
| 08-5-15 | stud point | round 0.8 | sharp | keep (README) |
| 08-5-v2 | stud notch | rounded apex | sharp | appearance |
| 07-1-4 | staff shaft | 1.665–1.672 | 1.6514 | A8 |
| 06-3-28 | block | no pin holes | two Ø 0.45 | keep, estimate |
| 06-4-15 | Heberolle | cut not printed | 5.927 | keep |
| 06-1-14 | layout | 15° | 15.8° | skip |

---

## B. The going train (7 findings)
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
