OrelMag/marine-chronometer-model/docs/motion-3d/img/wempe/parts_build.png

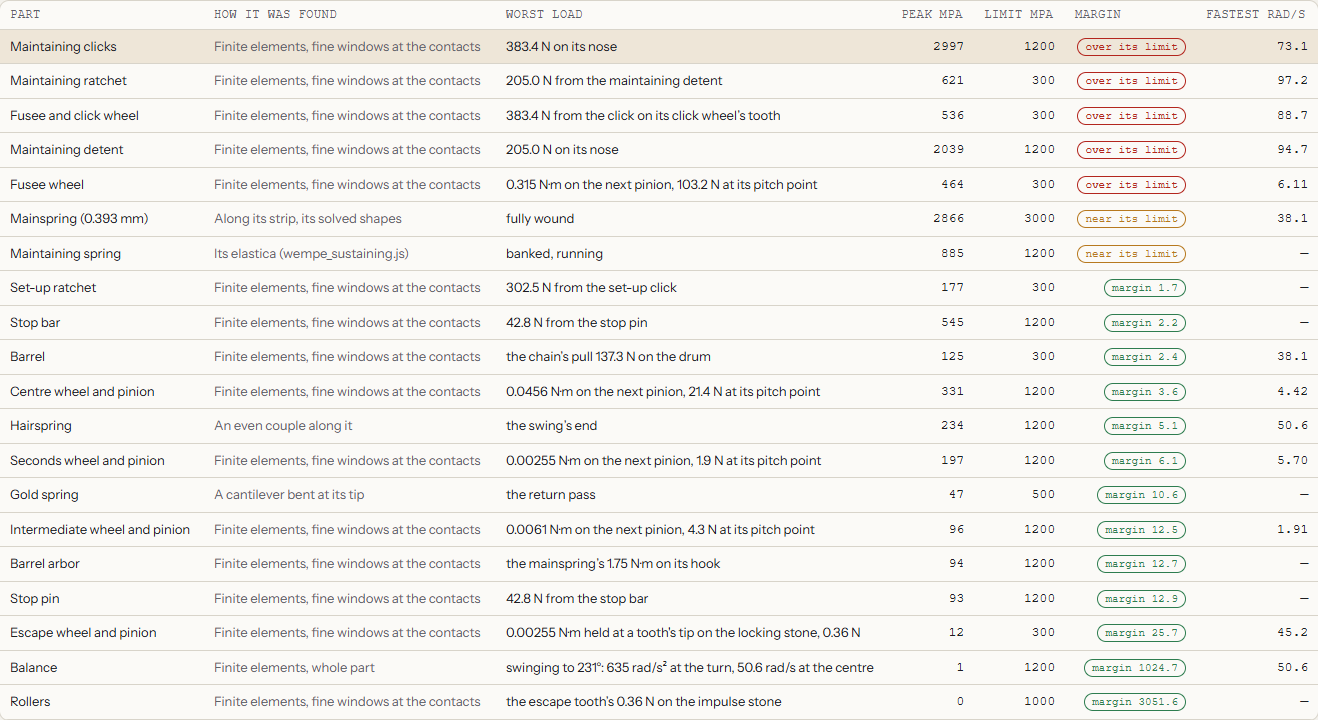
docs/motion-3d/img/wempe/parts_build.png
