OrelMag/marine-chronometer-model/docs/motion-3d/img/wempe/parts_last.png

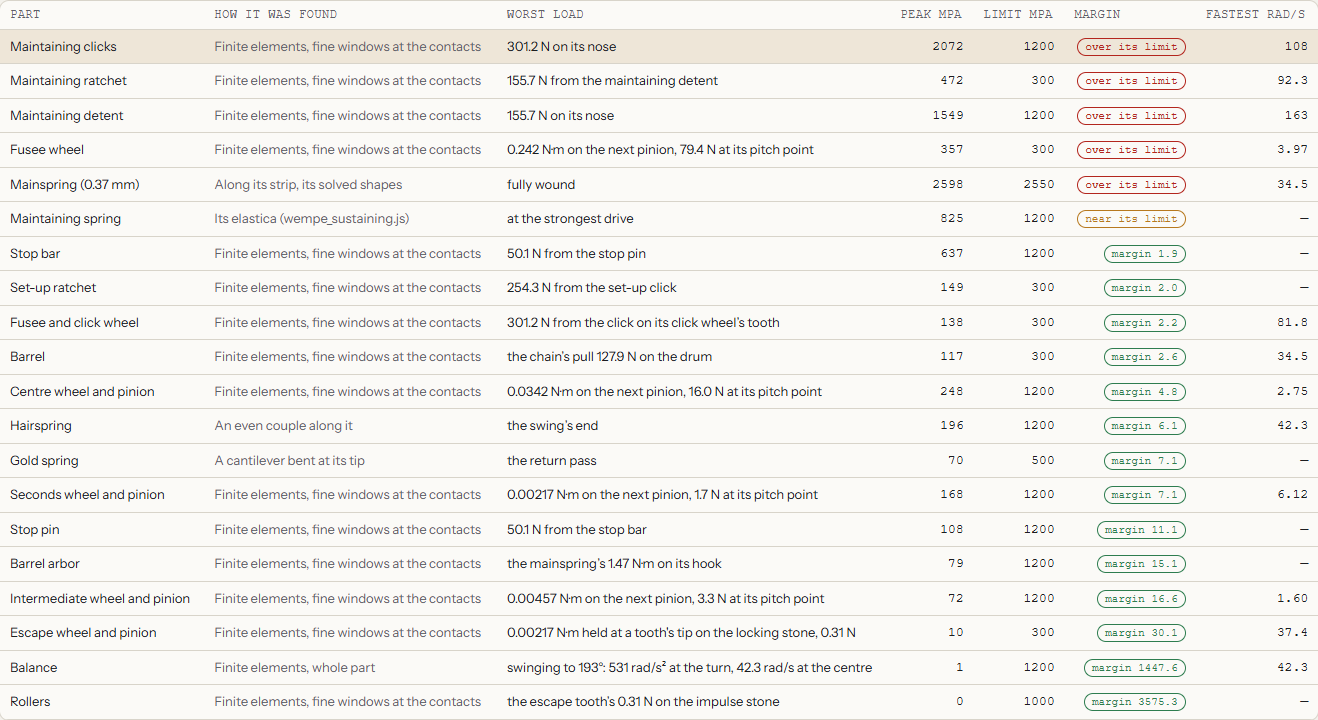
docs/motion-3d/img/wempe/parts_last.png
