OrelMag/marine-chronometer-model/marine-chronometer-source/hamilton-parts/renders/detentBlank.webp

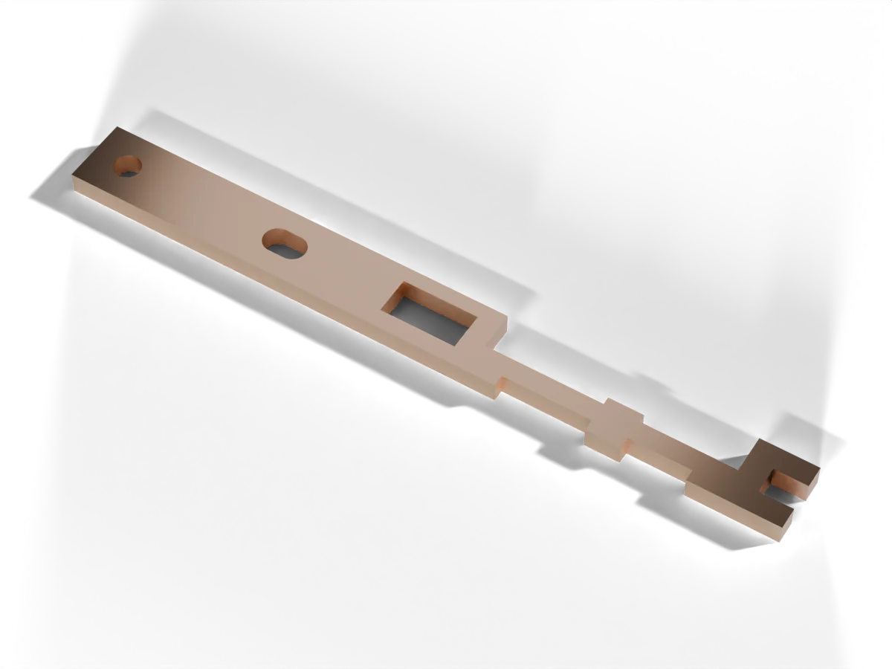
marine-chronometer-source/hamilton-parts/renders/detentBlank.webp
