OrelMag/marine-chronometer-model/marine-chronometer-source/hamilton-parts/renders/fourthWheel.webp

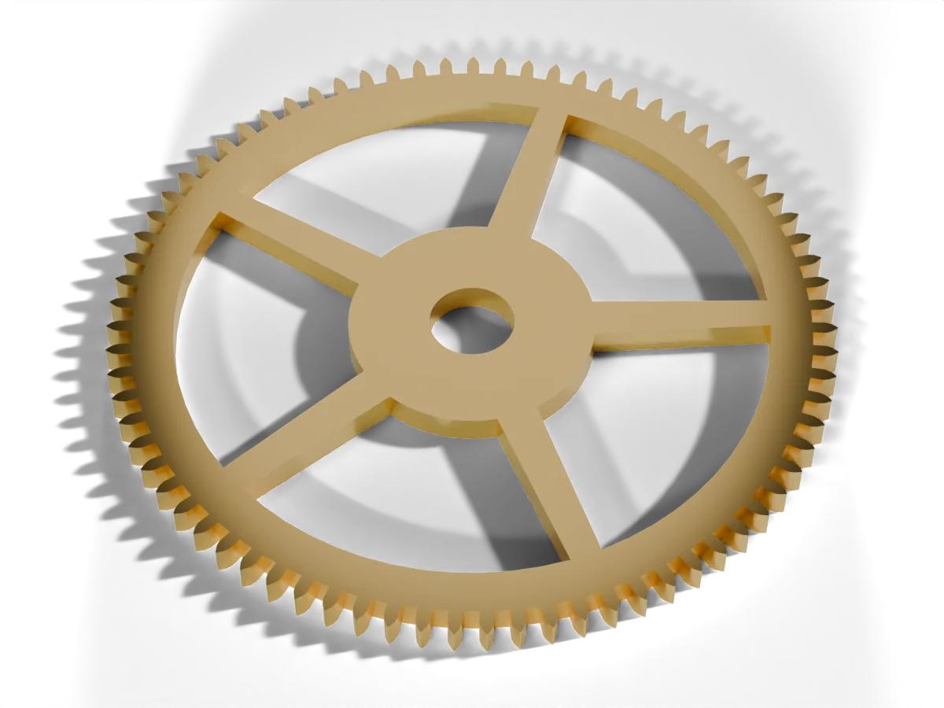
marine-chronometer-source/hamilton-parts/renders/fourthWheel.webp
