OrelMag/marine-chronometer-model/marine-chronometer-source/hamilton-parts/renders/fuseeWheel.webp

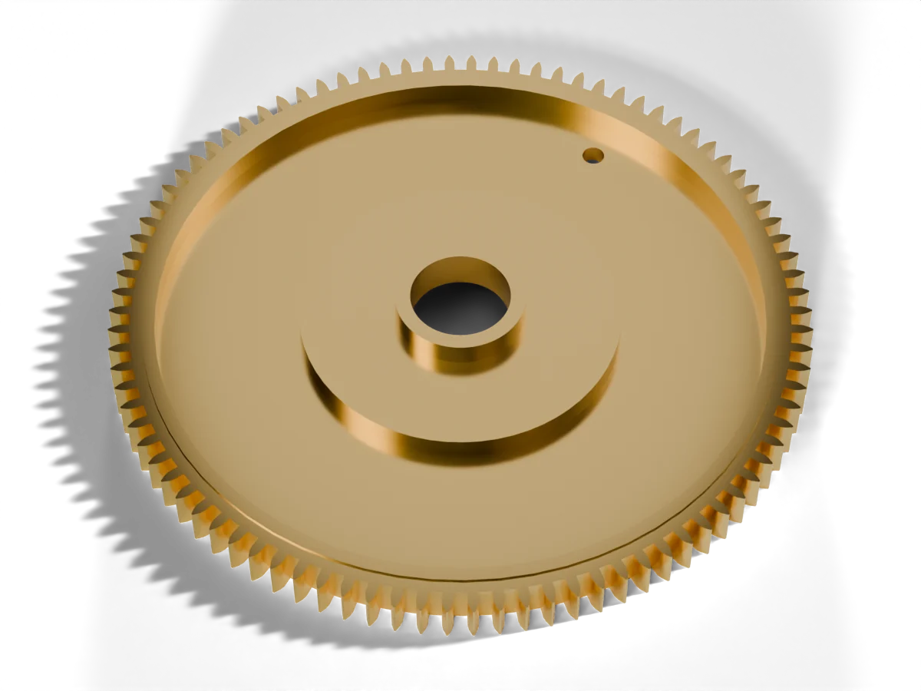
marine-chronometer-source/hamilton-parts/renders/fuseeWheel.webp
