OrelMag/marine-chronometer-model/marine-chronometer-source/hamilton-parts/renders/windingPawlSpring.webp

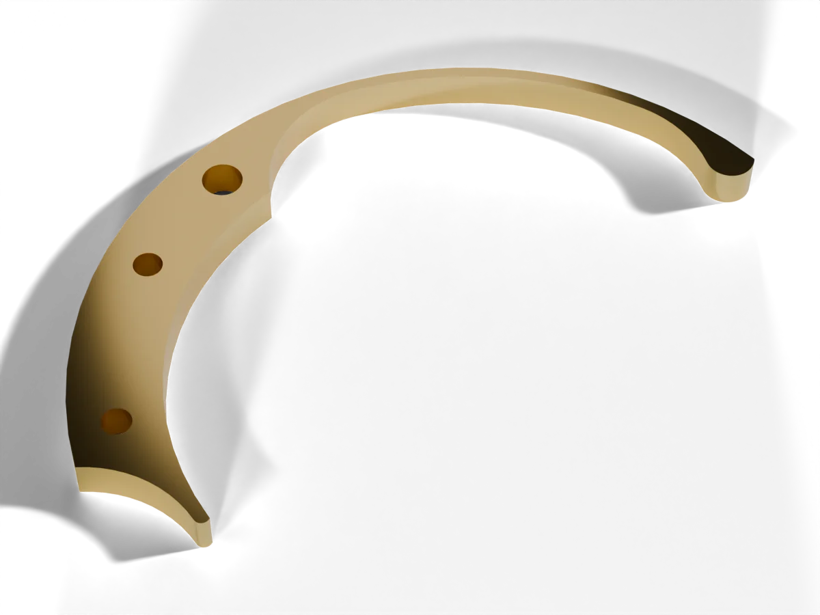
marine-chronometer-source/hamilton-parts/renders/windingPawlSpring.webp
