OrelMag/marine-chronometer-model/screenshots/4-moving-parts.jpg

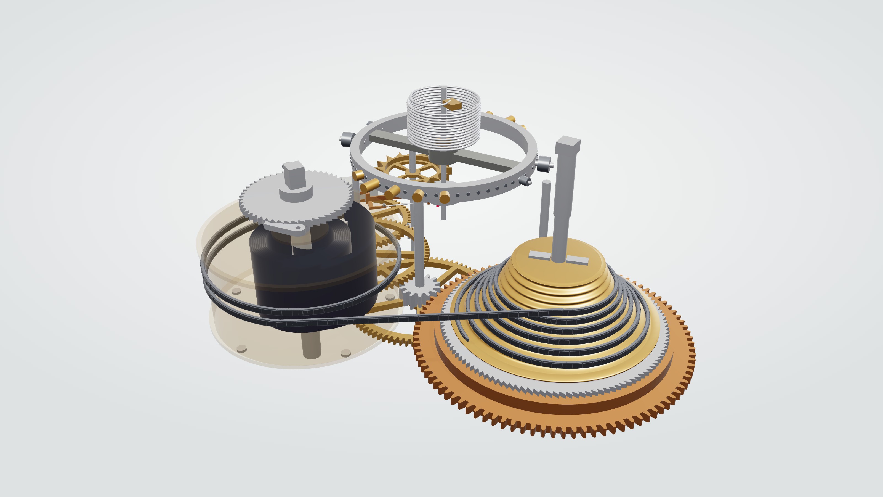
screenshots/4-moving-parts.jpg
