OrelMag/marine-chronometer-model/site/hamilton/parts/renders/asmBarrel-exploded.webp

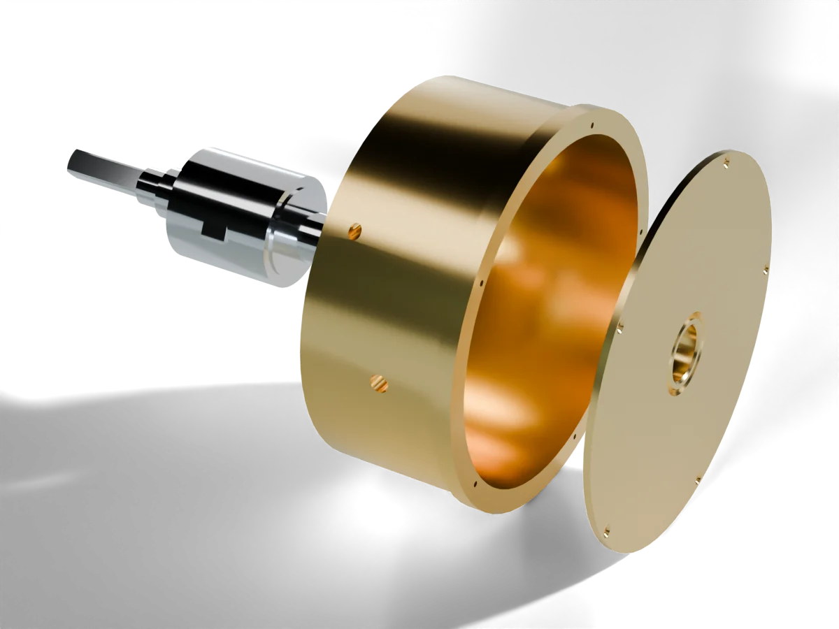
site/hamilton/parts/renders/asmBarrel-exploded.webp
