OrelMag/marine-chronometer-model/site/hamilton/parts/renders/asmChain-exploded.webp

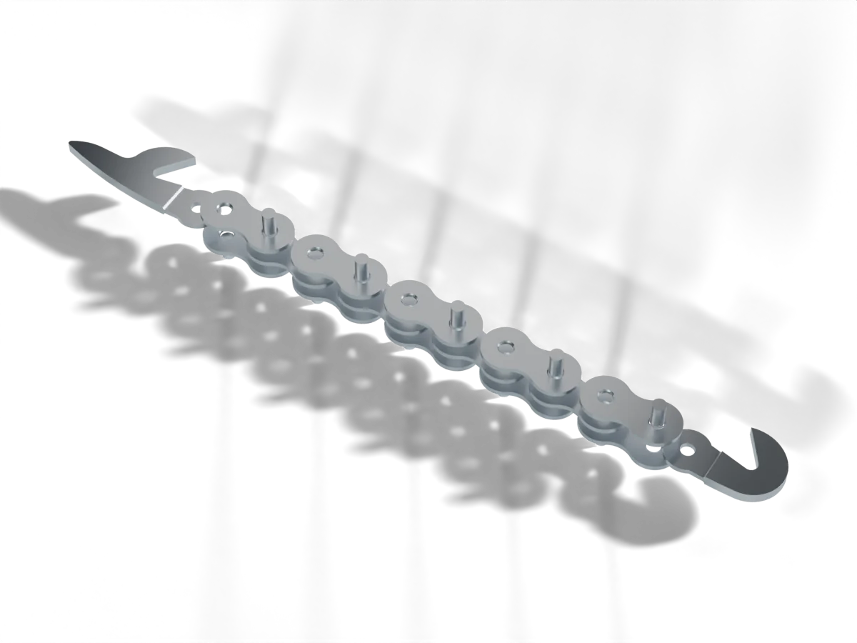
site/hamilton/parts/renders/asmChain-exploded.webp
