OrelMag/marine-chronometer-model/site/hamilton/parts/renders/asmChain.webp

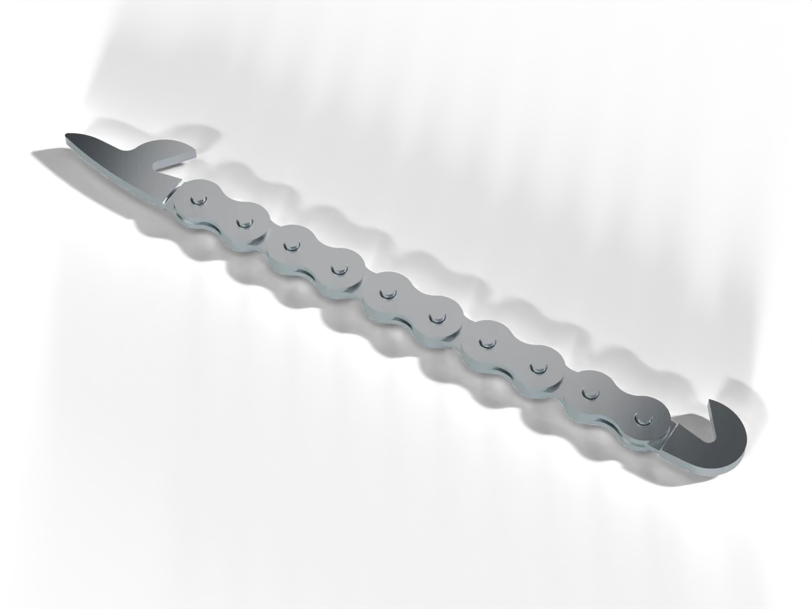
site/hamilton/parts/renders/asmChain.webp
