OrelMag/marine-chronometer-model/site/hamilton/parts/renders/asmFourth-exploded.webp

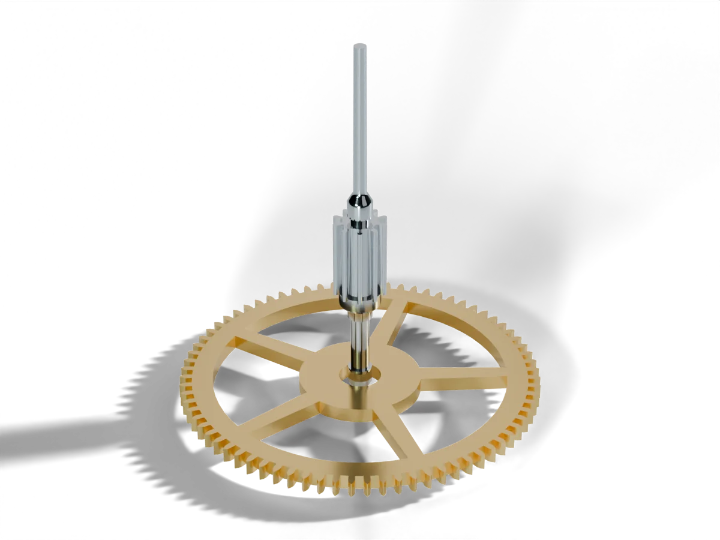
site/hamilton/parts/renders/asmFourth-exploded.webp
