OrelMag/marine-chronometer-model/site/hamilton/parts/renders/asmFourth.webp

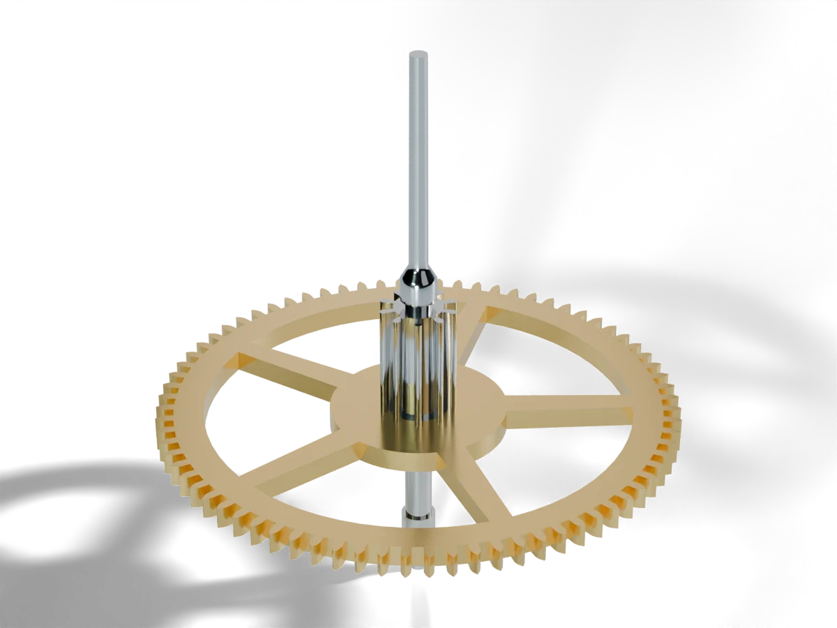
site/hamilton/parts/renders/asmFourth.webp
