OrelMag/marine-chronometer-model/site/hamilton/parts/renders/asmFusee-exploded.webp

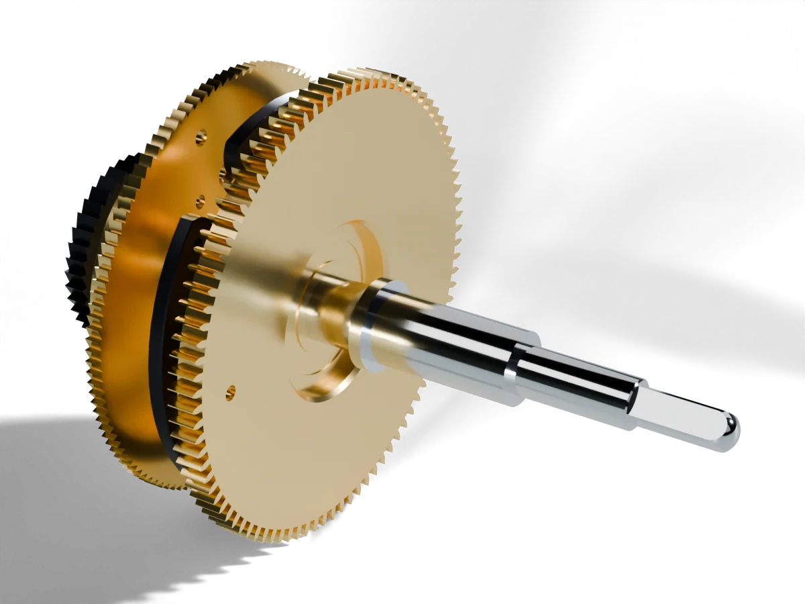
site/hamilton/parts/renders/asmFusee-exploded.webp
