OrelMag/marine-chronometer-model/site/hamilton/parts/renders/barrel.webp

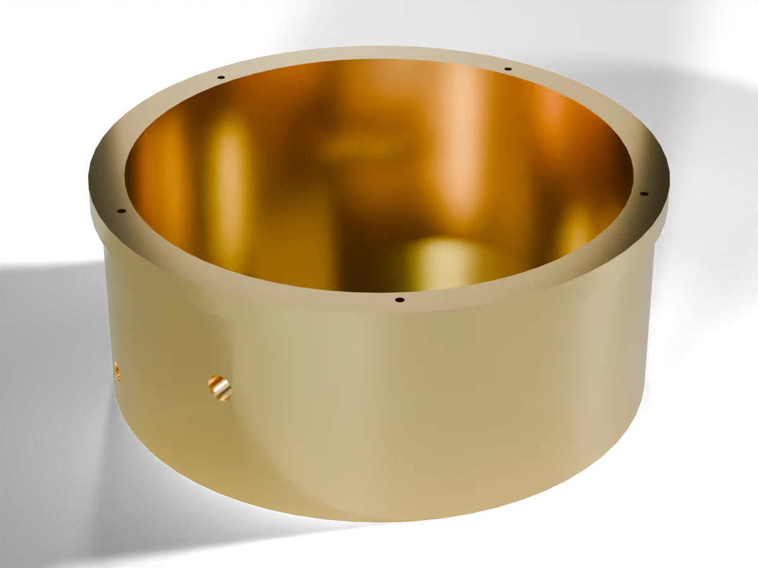
site/hamilton/parts/renders/barrel.webp
