OrelMag/marine-chronometer-model/site/hamilton/parts/renders/barrelCap.webp

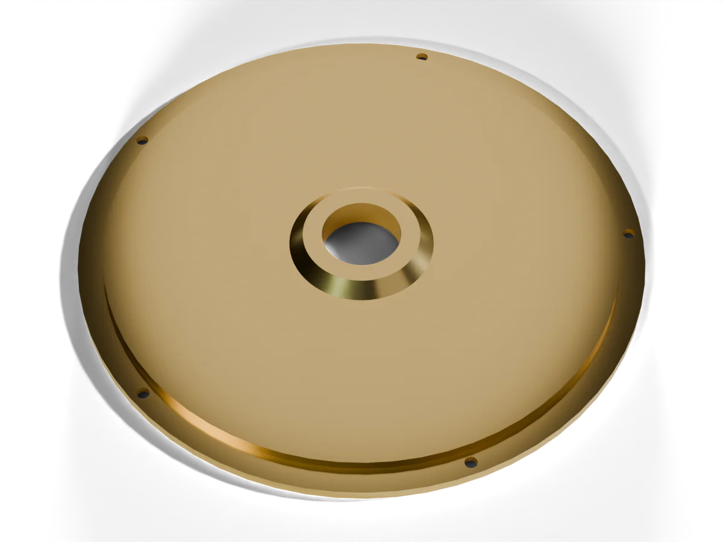
site/hamilton/parts/renders/barrelCap.webp
