OrelMag/marine-chronometer-model/site/hamilton/parts/renders/barrelHook.webp

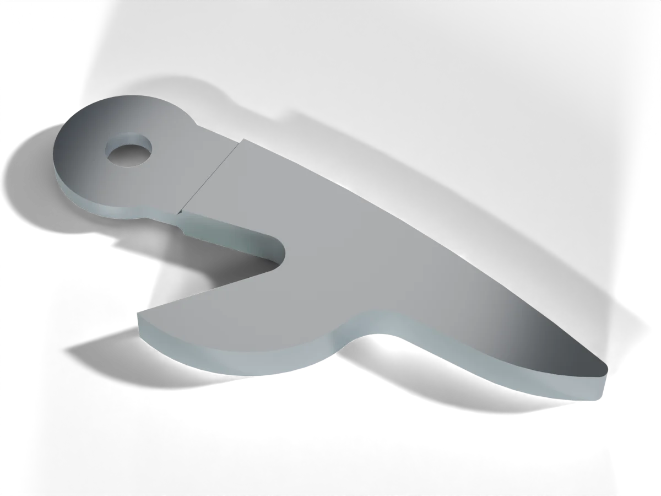
site/hamilton/parts/renders/barrelHook.webp
