OrelMag/marine-chronometer-model/site/hamilton/parts/renders/detentFinished.webp

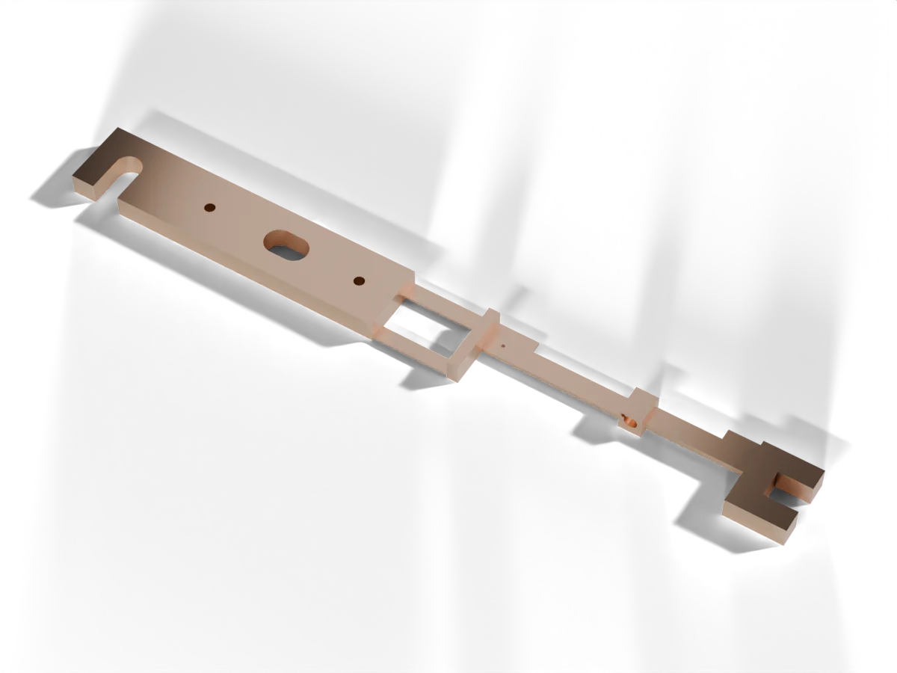
site/hamilton/parts/renders/detentFinished.webp
