OrelMag/marine-chronometer-model/site/hamilton/parts/renders/fuseeArbor.webp

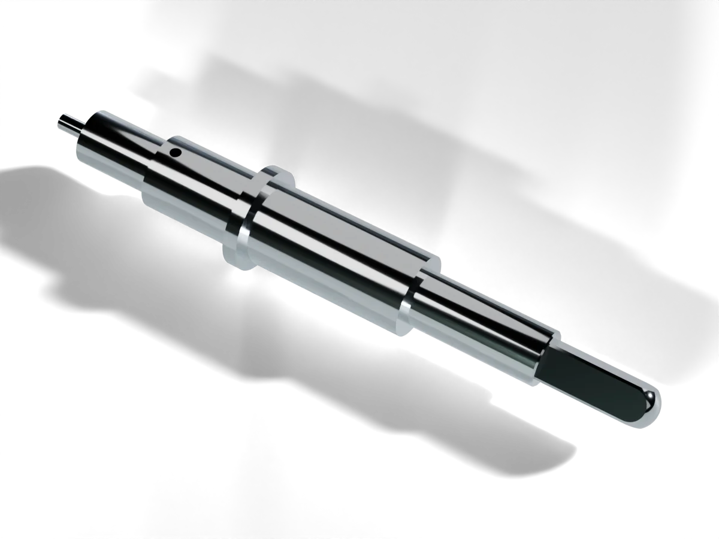
site/hamilton/parts/renders/fuseeArbor.webp
