OrelMag/marine-chronometer-model/site/hamilton/parts/renders/outerLink.webp

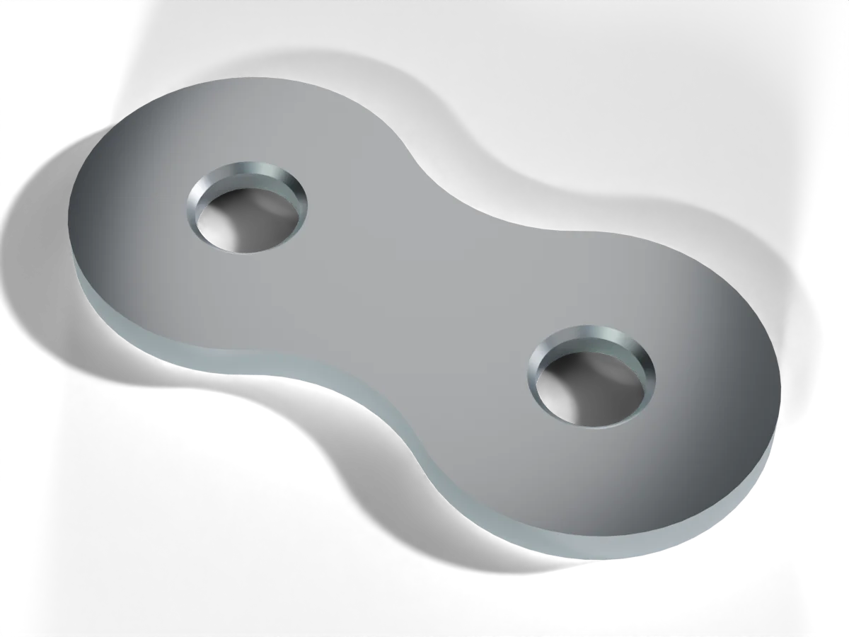
site/hamilton/parts/renders/outerLink.webp
