OrelMag/marine-chronometer-model/site/hamilton/parts/renders/sustainingSpring.webp

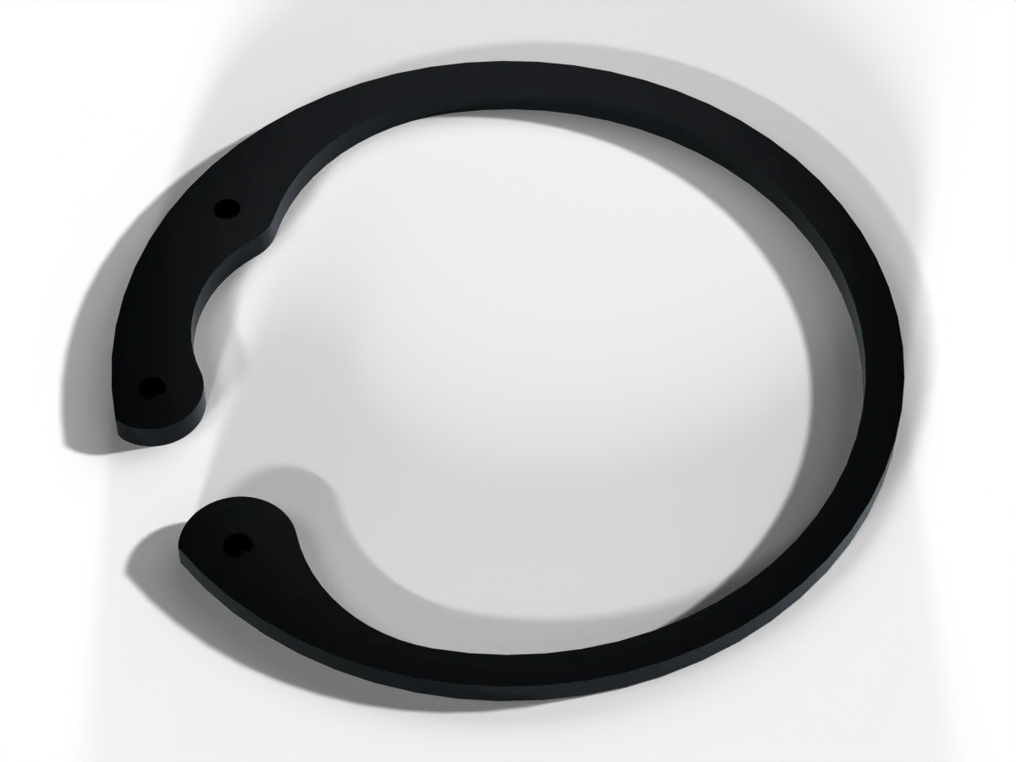
site/hamilton/parts/renders/sustainingSpring.webp
