OrelMag/marine-chronometer-model/site/hamilton/parts/renders/sustainingWheel.webp

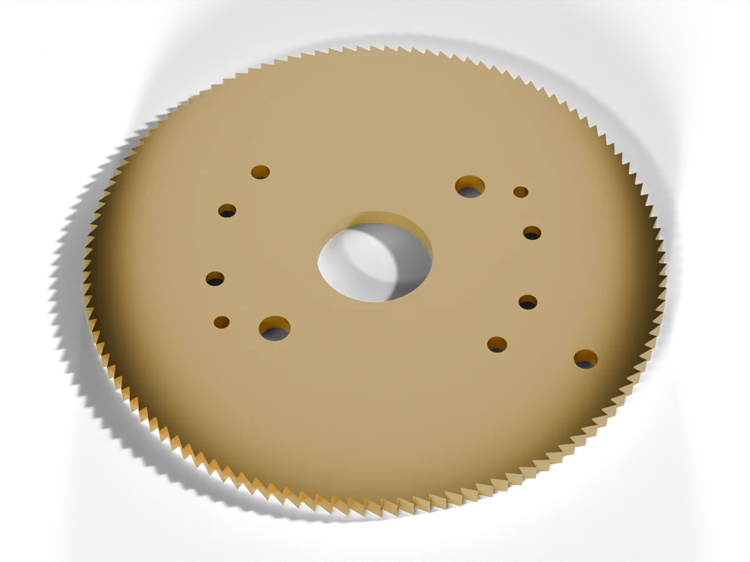
site/hamilton/parts/renders/sustainingWheel.webp
