OrelMag/marine-chronometer-model/site/hamilton/parts/renders/windingRatchet.webp

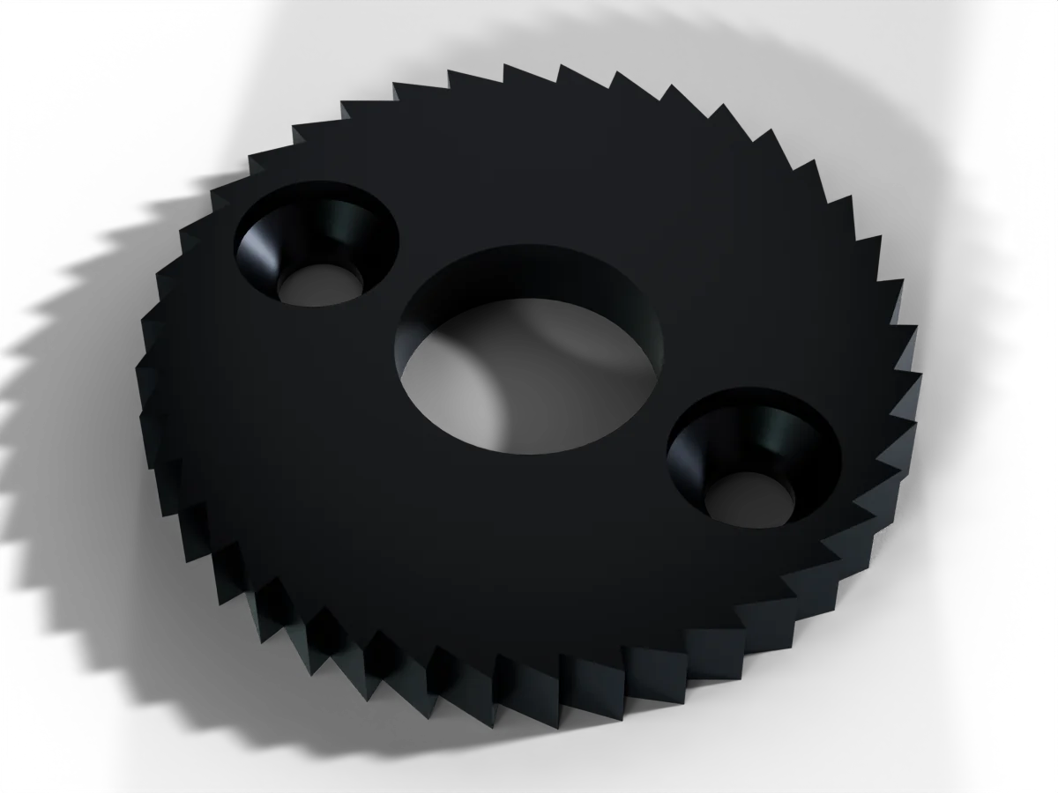
site/hamilton/parts/renders/windingRatchet.webp
