OrelMag/marine-chronometer-model/site/hamilton/parts/step/mainspringEnd.step

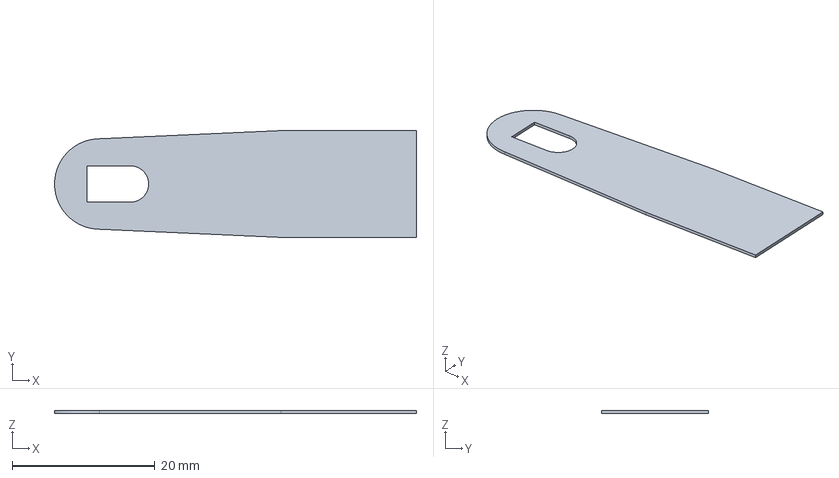
[picture p239: CAD file, 2026-11-02]
site/hamilton/parts/step/mainspringEnd.step
50.8 x 15.0 x 0.419 mm
