OrelMag/marine-chronometer-model/marine-chronometer-source/hamilton-parts/step/det_20756.step

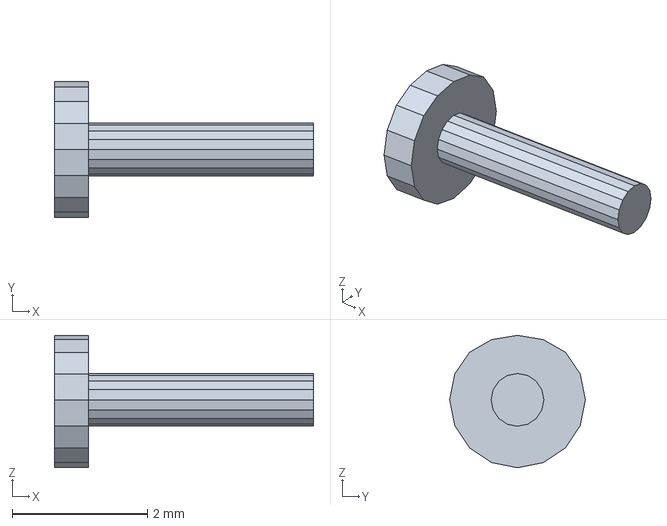
[picture p240: CAD file, 2026-11-02]
marine-chronometer-source/hamilton-parts/step/det_20756.step
3.84 x 2.01 x 1.96 mm
