OrelMag/marine-chronometer-model/marine-chronometer-source/wempe/parts/lowerCock.step

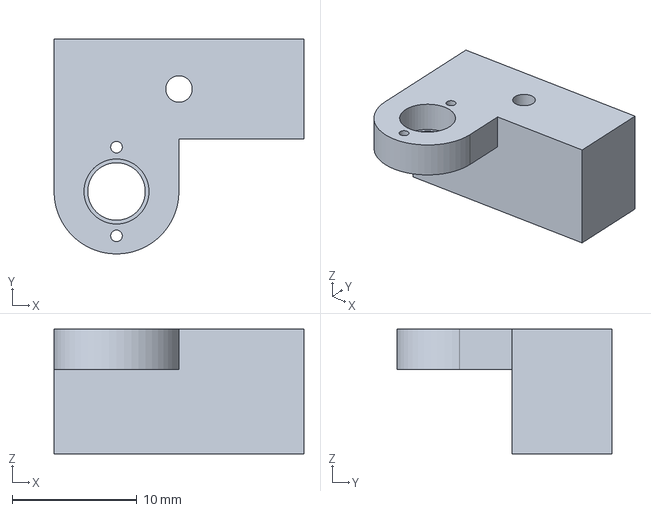
[picture p241: CAD file, 2026-11-01]
marine-chronometer-source/wempe/parts/lowerCock.step
20.0 x 17.2 x 10.0 mm
