OrelMag/marine-chronometer-model/site/hamilton/parts/step/det_42086.step

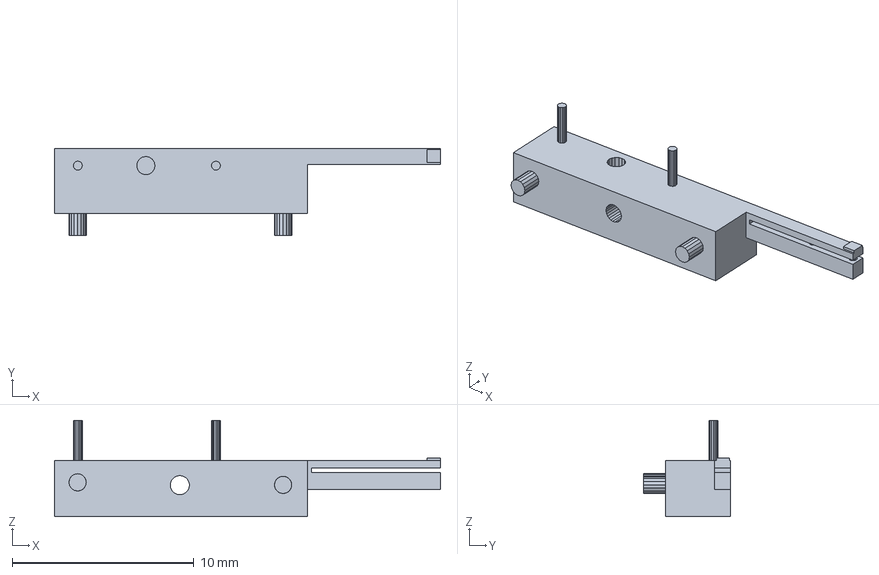
[picture p242: CAD file, 2026-11-02]
site/hamilton/parts/step/det_42086.step
21.2 x 4.80 x 5.29 mm
