OrelMag/marine-chronometer-model/marine-chronometer-source/hamilton-parts/step/lockingStone.step

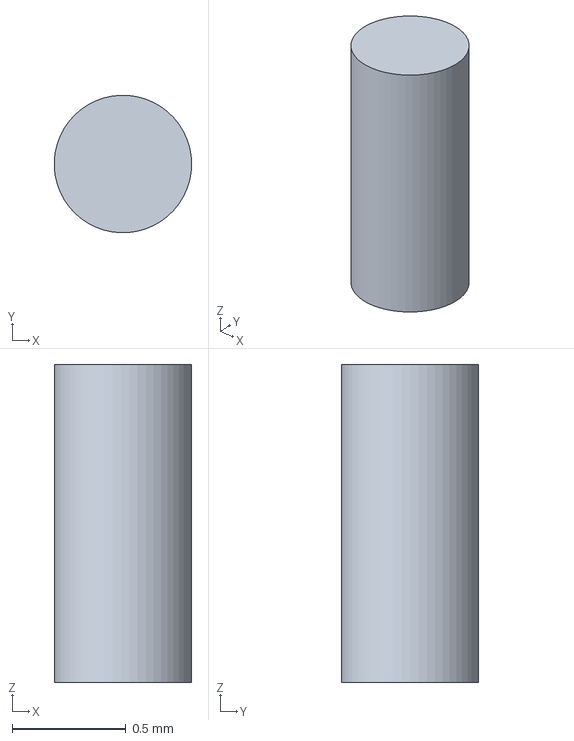
[picture p243: CAD file, 2026-11-02]
marine-chronometer-source/hamilton-parts/step/lockingStone.step
0.605 x 0.605 x 1.40 mm
