OrelMag/marine-chronometer-model/marine-chronometer-source/wempe/parts/upperCock.step

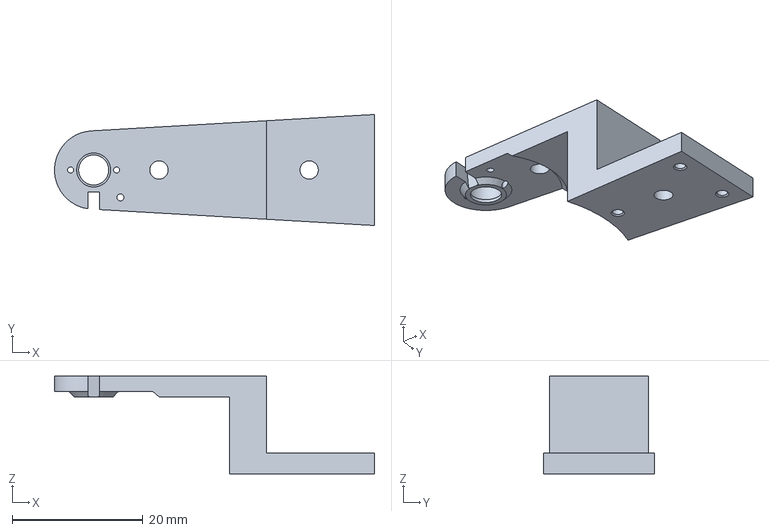
[picture p244: CAD file, 2026-11-01]
marine-chronometer-source/wempe/parts/upperCock.step
49.0 x 17.0 x 15.0 mm
