OrelMag/marine-chronometer-model/site/hamilton/parts/step/detentFinished.step

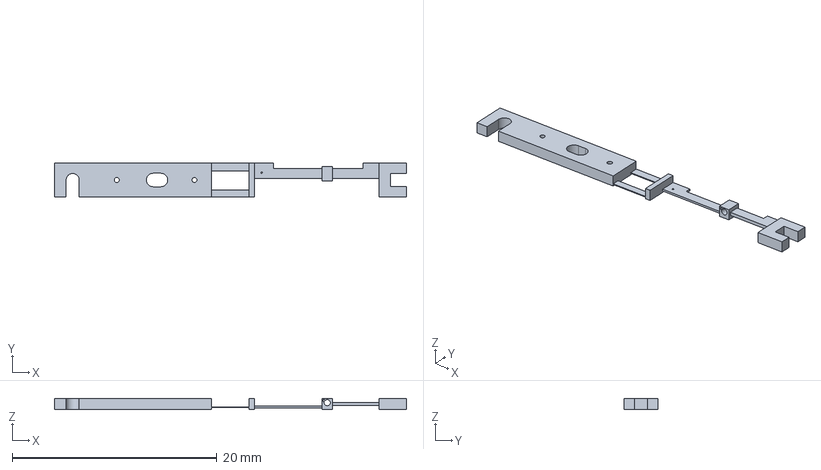
[picture p245: CAD file, 2026-11-02]
site/hamilton/parts/step/detentFinished.step
34.4 x 3.33 x 1.04 mm
