OrelMag/marine-chronometer-model/marine-chronometer-source/wempe/parts/ct6BlockP.step

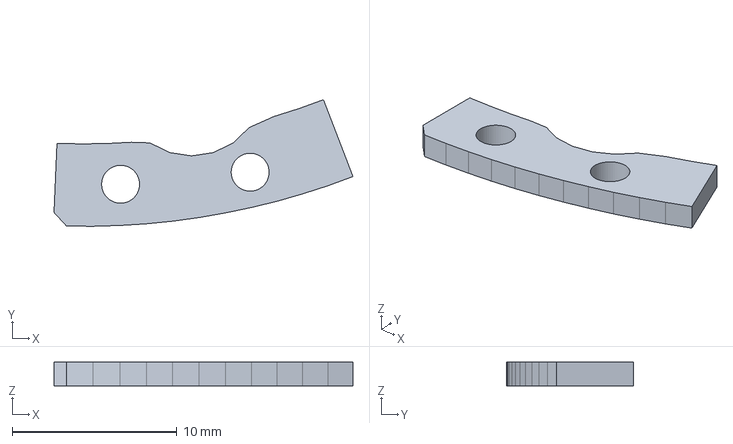
[picture p246: CAD file, 2026-11-01]
marine-chronometer-source/wempe/parts/ct6BlockP.step
18.1 x 7.68 x 1.45 mm
