OrelMag/marine-chronometer-model/site/hamilton/parts/step/det_42089.step

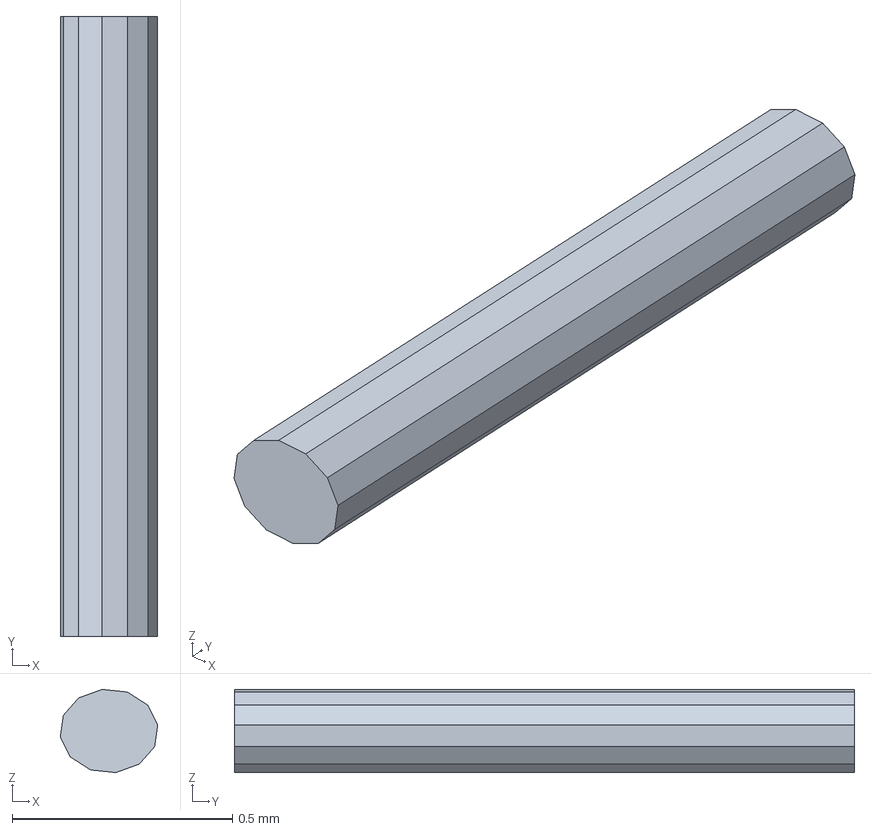
[picture p247: CAD file, 2026-11-02]
site/hamilton/parts/step/det_42089.step
0.221 x 1.41 x 0.189 mm
