OrelMag/marine-chronometer-model/site/parts/detentBlock.1943.step

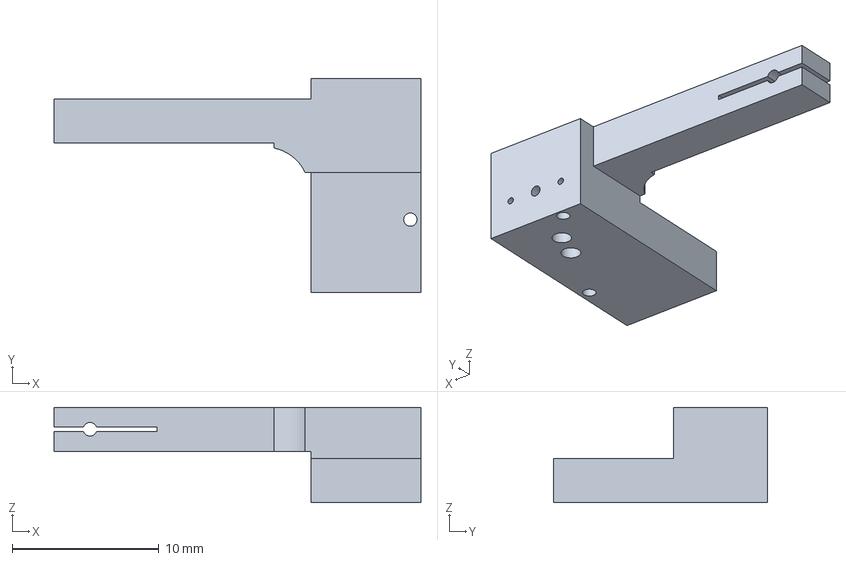
[picture p248: CAD file, 2026-11-03]
site/parts/detentBlock.1943.step
25.0 x 14.6 x 6.50 mm
