OrelMag/marine-chronometer-model/marine-chronometer-source/hamilton-parts/step/det_1770_ts.step

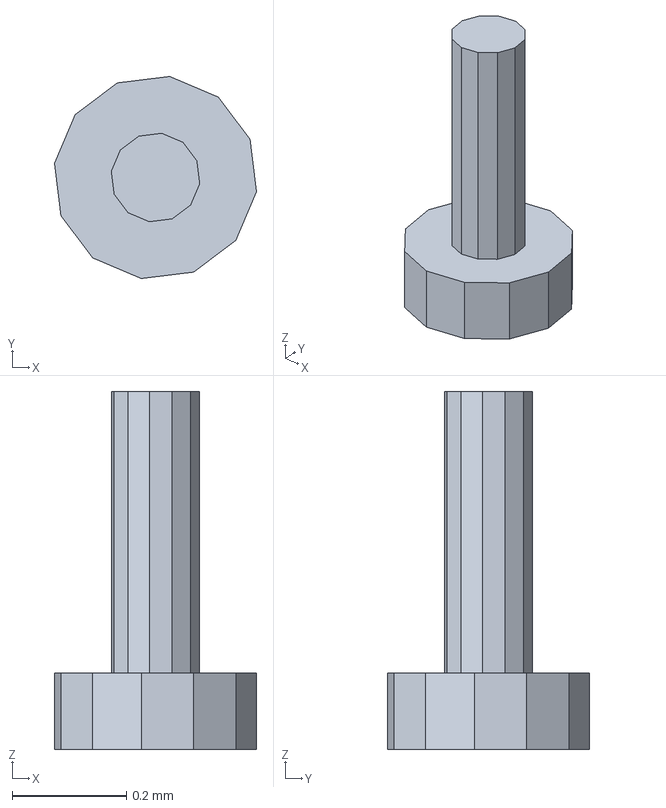
[picture p249: CAD file, 2026-11-02]
marine-chronometer-source/hamilton-parts/step/det_1770_ts.step
0.354 x 0.354 x 0.627 mm
