OrelMag/marine-chronometer-model/marine-chronometer-source/wempe/parts/ct6Setting.step

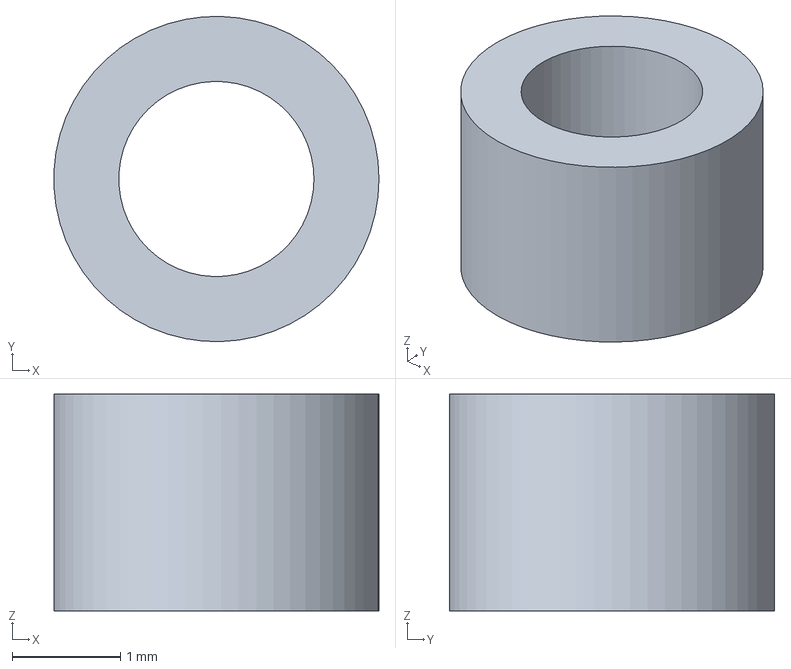
[picture p250: CAD file, 2026-11-01]
marine-chronometer-source/wempe/parts/ct6Setting.step
3.00 x 3.00 x 2.00 mm
