OrelMag/marine-chronometer-model/site/hamilton/parts/step/helicalSpring.step

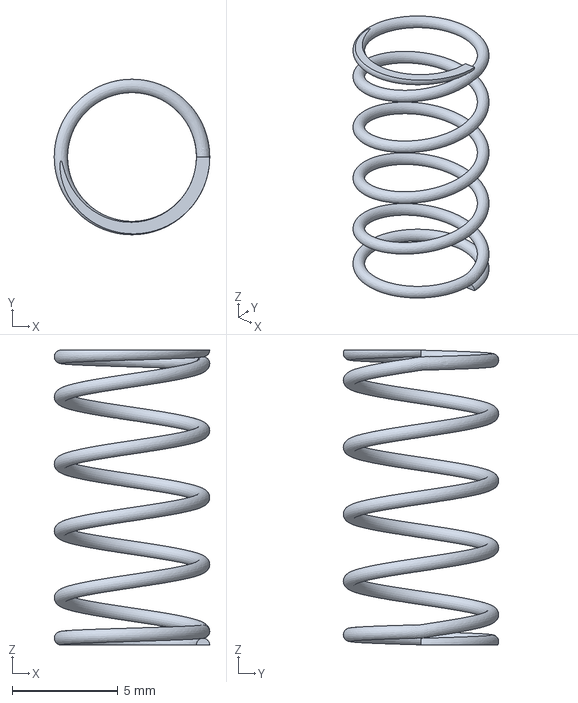
[picture p251: CAD file, 2026-11-02]
site/hamilton/parts/step/helicalSpring.step
7.37 x 7.37 x 14.0 mm
