OrelMag/marine-chronometer-model/marine-chronometer-source/hamilton-parts/step/det_42088.step

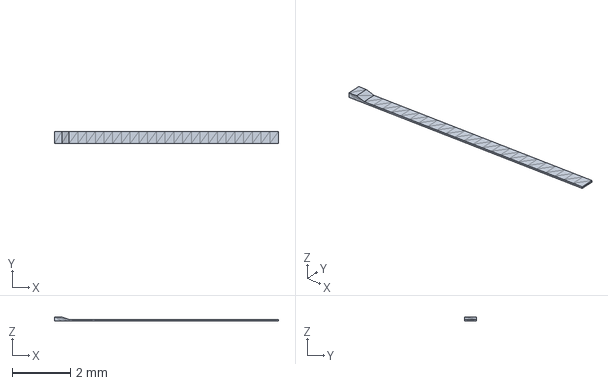
[picture p252: CAD file, 2026-11-02]
marine-chronometer-source/hamilton-parts/step/det_42088.step
7.71 x 0.413 x 0.137 mm
