OrelMag/marine-chronometer-model/marine-chronometer-source/wempe/parts/chaton38u.step

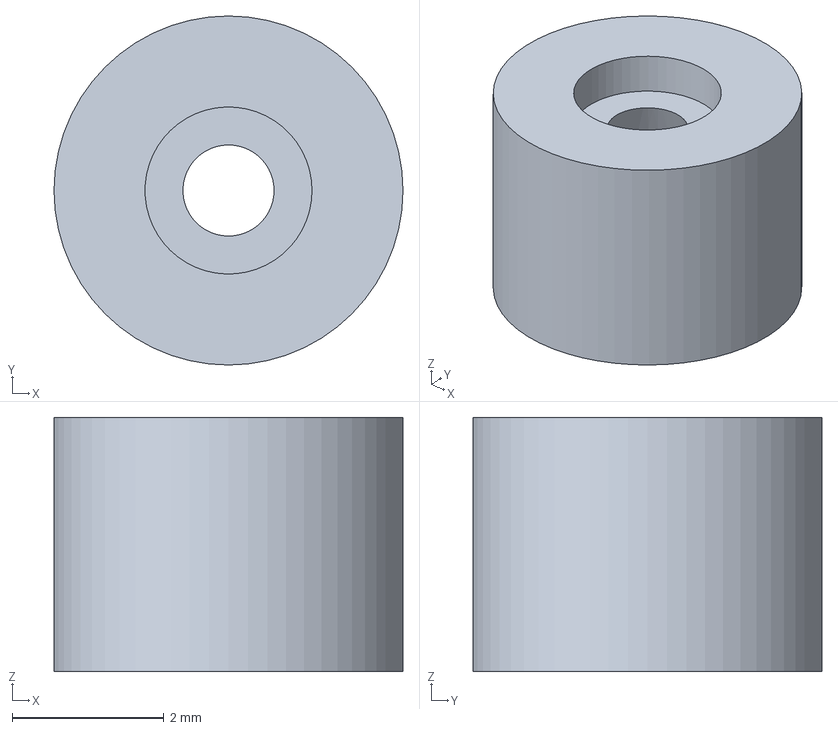
[picture p253: CAD file, 2026-11-01]
marine-chronometer-source/wempe/parts/chaton38u.step
4.60 x 4.60 x 3.35 mm
