OrelMag/marine-chronometer-model/site/hamilton/parts/step/det_1770_br.step

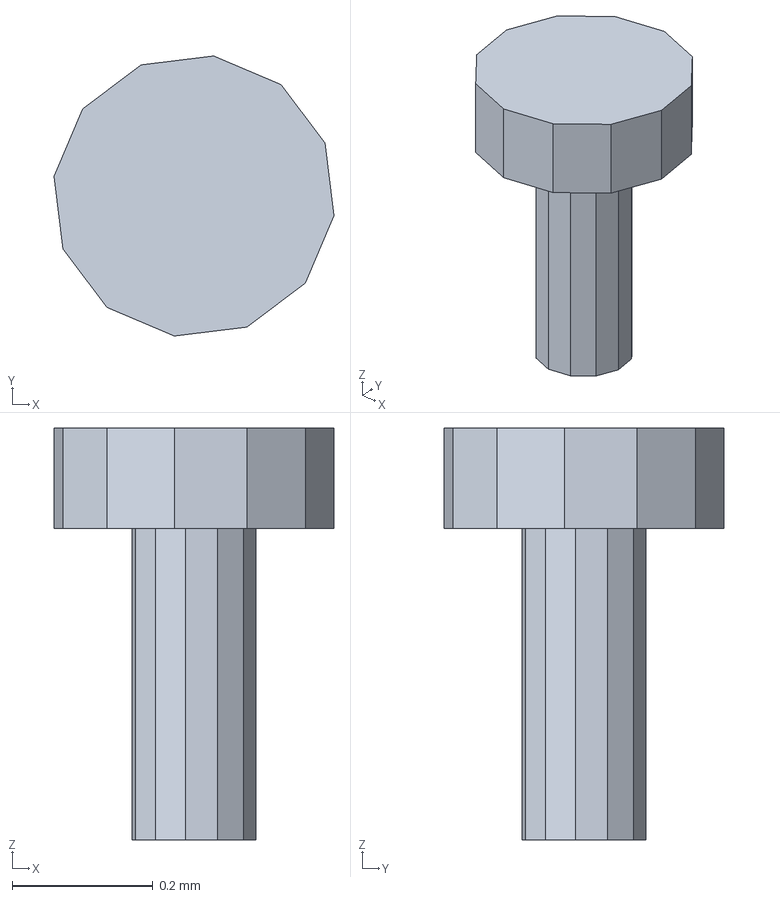
[picture p254: CAD file, 2026-11-02]
site/hamilton/parts/step/det_1770_br.step
0.398 x 0.398 x 0.586 mm
