OrelMag/marine-chronometer-model/site/parts/setupRatchet.step

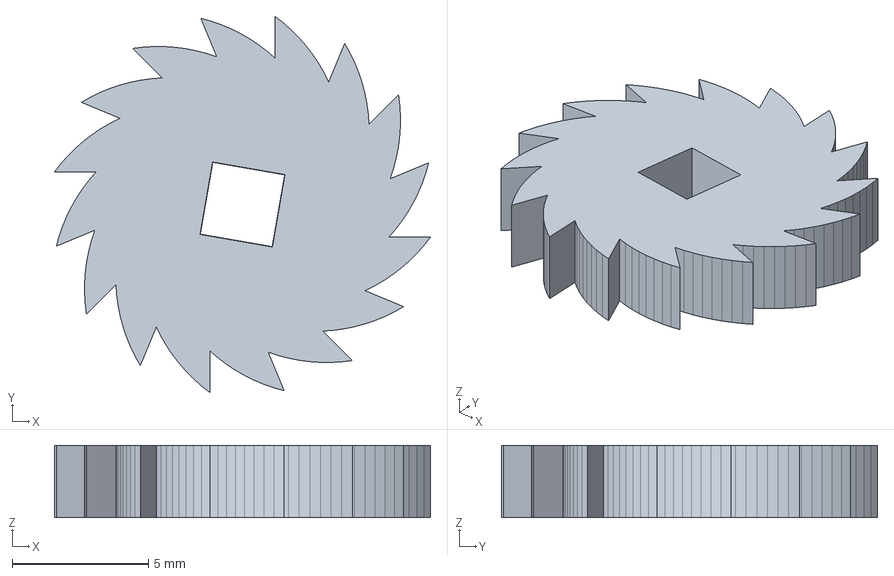
[picture p255: CAD file, 2026-11-03]
site/parts/setupRatchet.step
13.8 x 13.8 x 2.65 mm
