OrelMag/marine-chronometer-model/marine-chronometer-source/hamilton-parts/step/det_37024.step

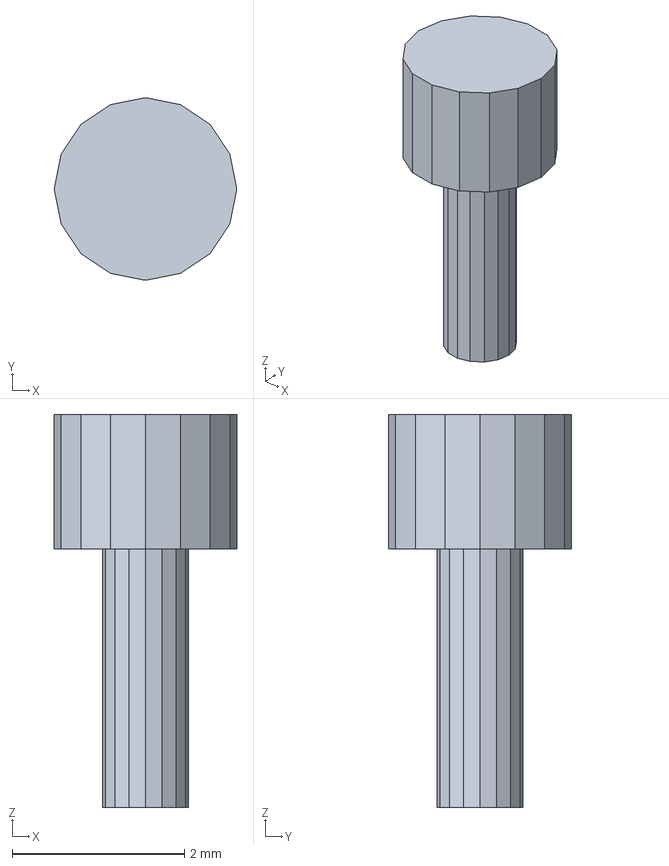
[picture p256: CAD file, 2026-11-02]
marine-chronometer-source/hamilton-parts/step/det_37024.step
2.12 x 2.12 x 4.57 mm
