OrelMag/marine-chronometer-model/site/hamilton/parts/step/det_42251_det.step

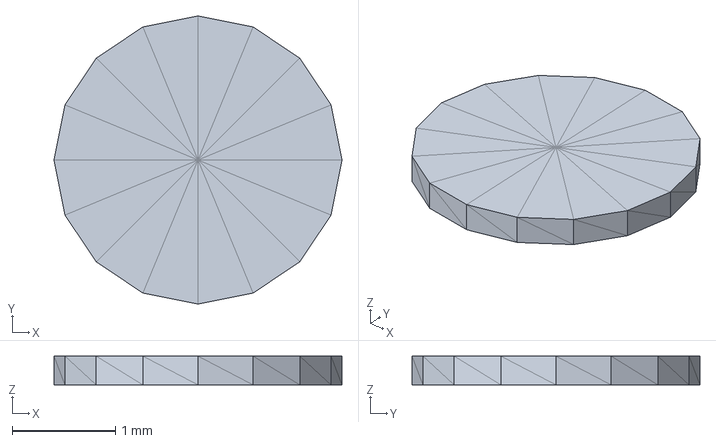
[picture p257: CAD file, 2026-11-02]
site/hamilton/parts/step/det_42251_det.step
2.79 x 2.79 x 0.279 mm
