OrelMag/marine-chronometer-model/site/parts/w19.step

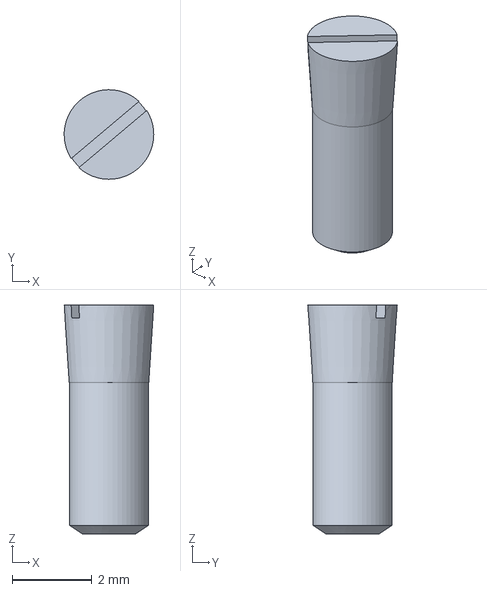
[picture p258: CAD file, 2026-11-01]
site/parts/w19.step
2.25 x 2.25 x 5.75 mm
