OrelMag/marine-chronometer-model/marine-chronometer-source/hamilton-parts/step/fourthPinion.step

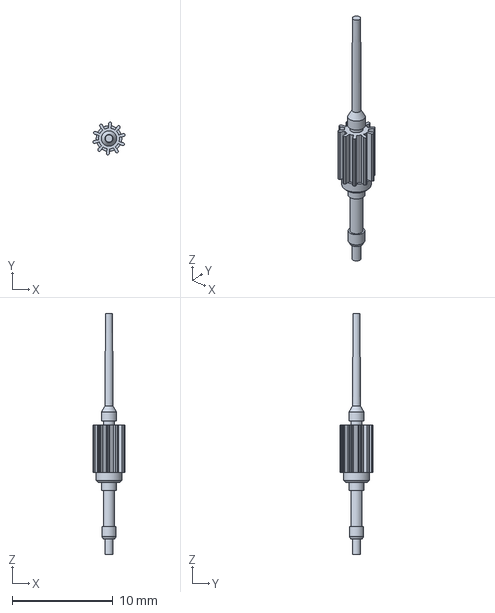
[picture p259: CAD file, 2026-11-02]
marine-chronometer-source/hamilton-parts/step/fourthPinion.step
3.19 x 3.27 x 23.9 mm
