OrelMag/marine-chronometer-model/marine-chronometer-source/wempe/parts/lockBr6.step

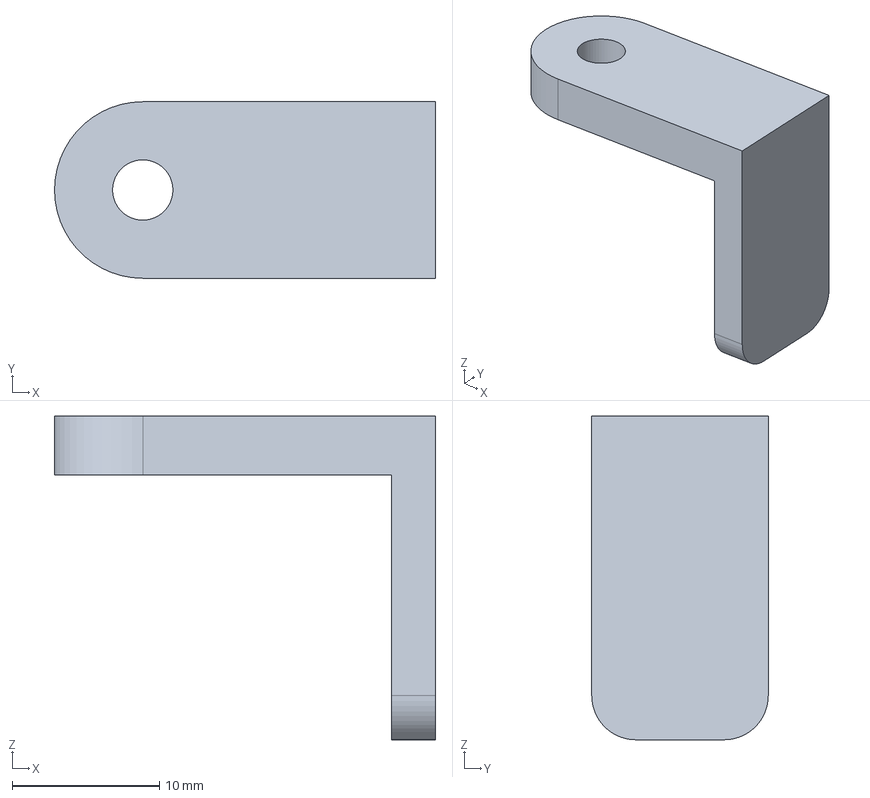
[picture p260: CAD file, 2026-11-01]
marine-chronometer-source/wempe/parts/lockBr6.step
25.9 x 12.0 x 22.0 mm
