OrelMag/marine-chronometer-model/site/parts/lockPin.step

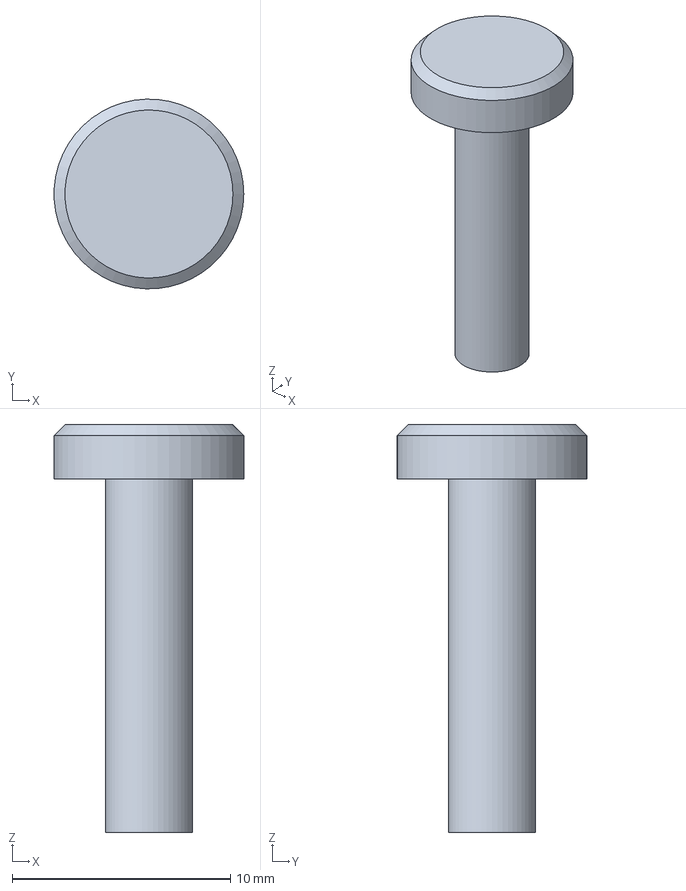
[picture p261: CAD file, 2026-11-01]
site/parts/lockPin.step
8.69 x 8.70 x 18.7 mm
