OrelMag/marine-chronometer-model/marine-chronometer-source/hamilton-parts/step/fuseeArbor.step

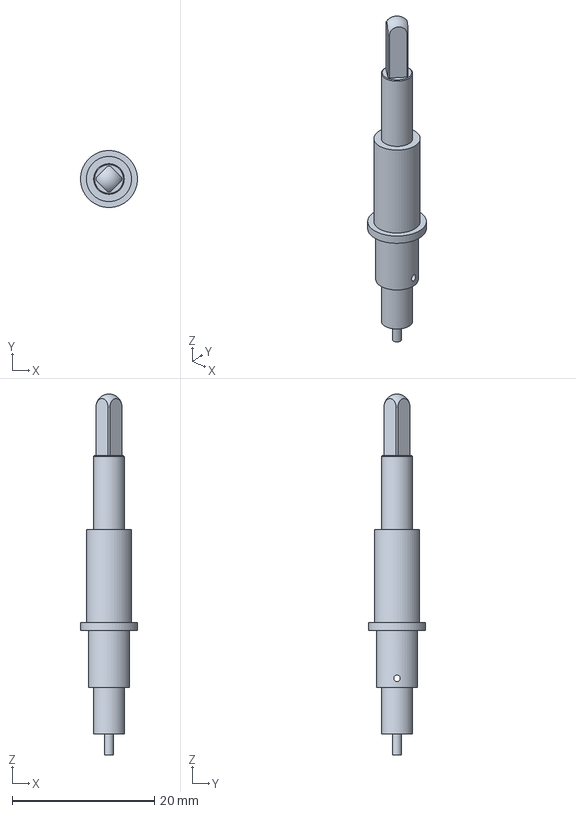
[picture p262: CAD file, 2026-11-02]
marine-chronometer-source/hamilton-parts/step/fuseeArbor.step
8.02 x 8.02 x 50.8 mm
