OrelMag/marine-chronometer-model/marine-chronometer-source/wempe/parts/lockLever6.step

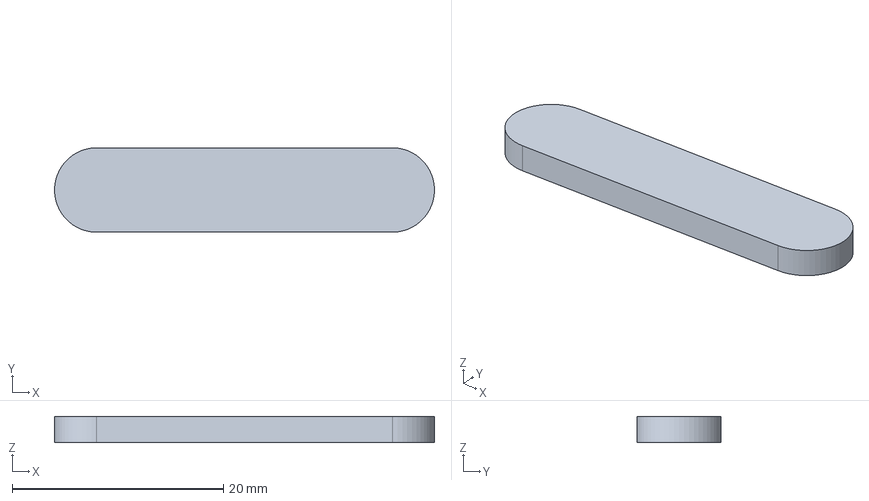
[picture p263: CAD file, 2026-11-01]
marine-chronometer-source/wempe/parts/lockLever6.step
36.0 x 8.00 x 2.50 mm
