OrelMag/marine-chronometer-model/site/hamilton/parts/step/windingPawlSpring.step

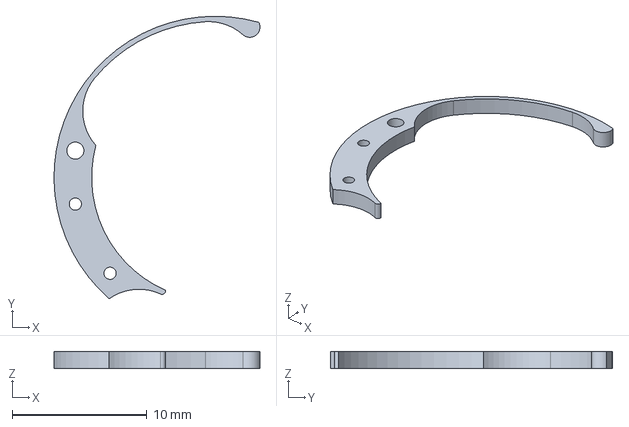
[picture p264: CAD file, 2026-11-02]
site/hamilton/parts/step/windingPawlSpring.step
15.3 x 20.9 x 1.27 mm
