OrelMag/marine-chronometer-model/site/parts/detentBlock.3955.step

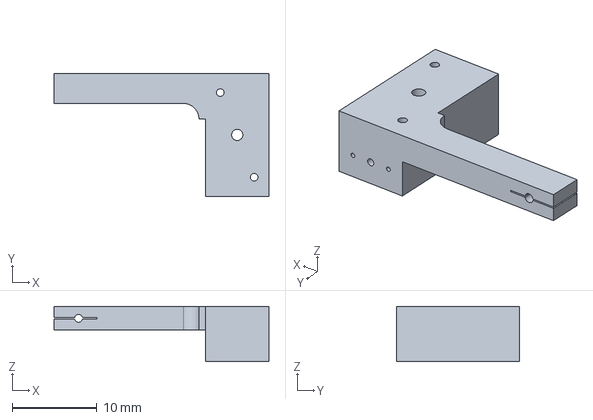
[picture p265: CAD file, 2026-11-01]
site/parts/detentBlock.3955.step
25.4 x 14.6 x 6.50 mm
