OrelMag/marine-chronometer-model/marine-chronometer-source/hamilton-parts/step/fuseeWheel.step

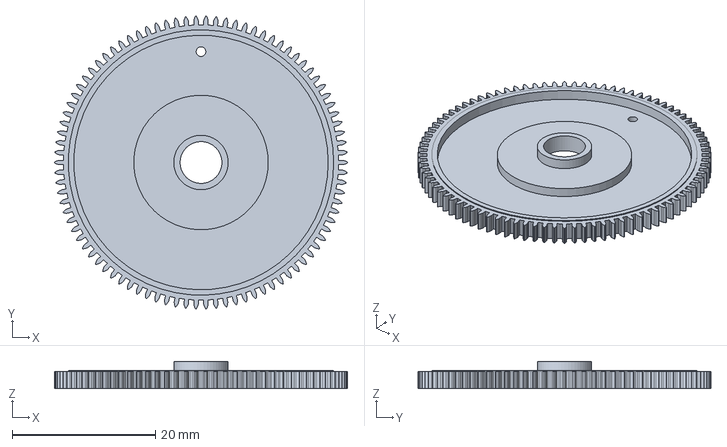
[picture p266: CAD file, 2026-11-02]
marine-chronometer-source/hamilton-parts/step/fuseeWheel.step
41.0 x 40.9 x 3.81 mm
