OrelMag/marine-chronometer-model/marine-chronometer-source/wempe/parts/cone41.step

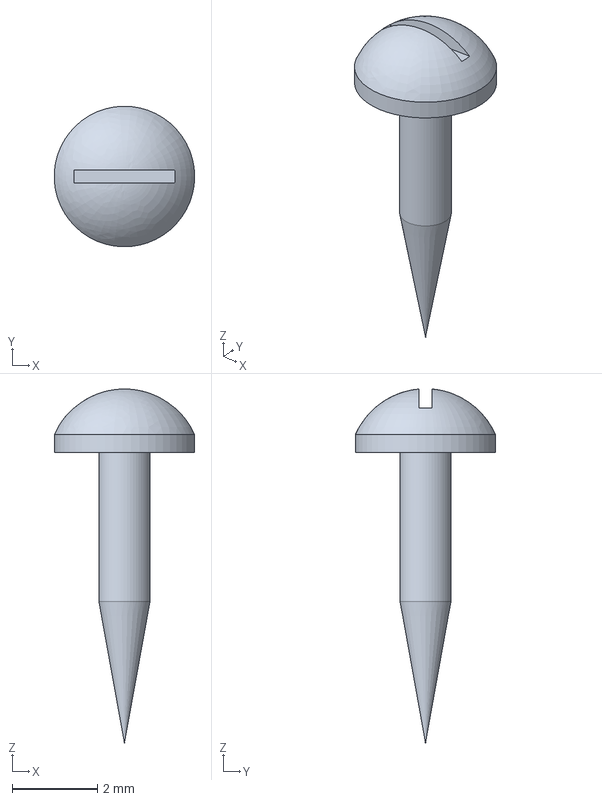
[picture p267: CAD file, 2026-11-01]
marine-chronometer-source/wempe/parts/cone41.step
3.30 x 3.30 x 8.31 mm
