OrelMag/marine-chronometer-model/site/hamilton/parts/step/setupPawl.step

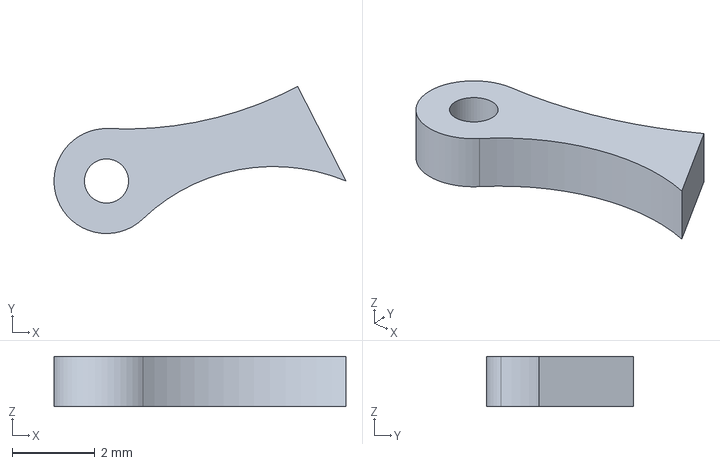
[picture p268: CAD file, 2026-11-02]
site/hamilton/parts/step/setupPawl.step
7.06 x 3.56 x 1.22 mm
