OrelMag/marine-chronometer-model/marine-chronometer-source/wempe/parts/lockBr.step

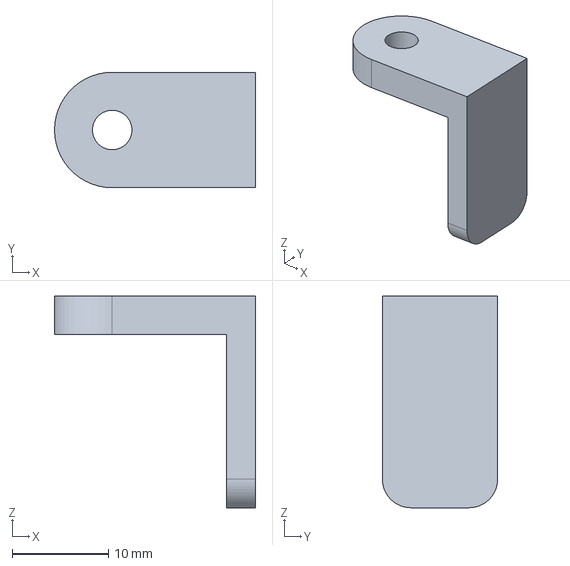
[picture p269: CAD file, 2026-11-01]
marine-chronometer-source/wempe/parts/lockBr.step
20.9 x 12.0 x 22.0 mm
