OrelMag/marine-chronometer-model/site/hamilton/parts/step/windingRatchet.step

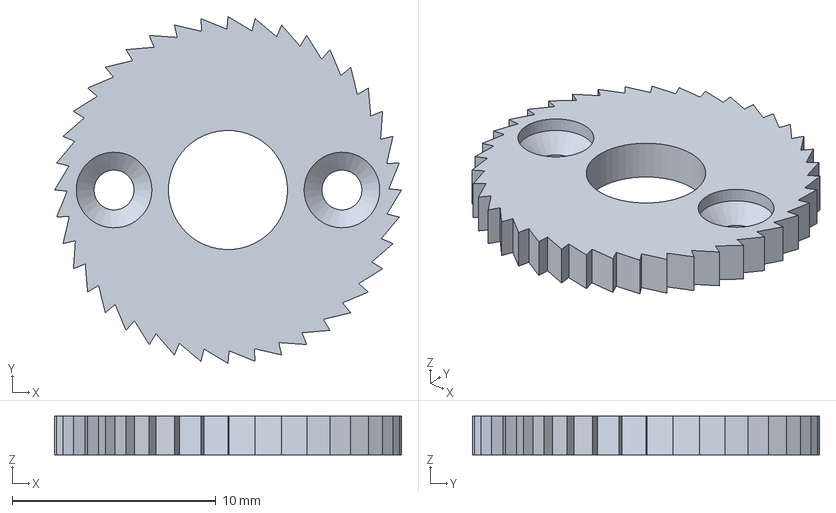
[picture p270: CAD file, 2026-11-02]
site/hamilton/parts/step/windingRatchet.step
17.0 x 17.0 x 1.91 mm
