OrelMag/marine-chronometer-model/site/parts/key40Pipe.step

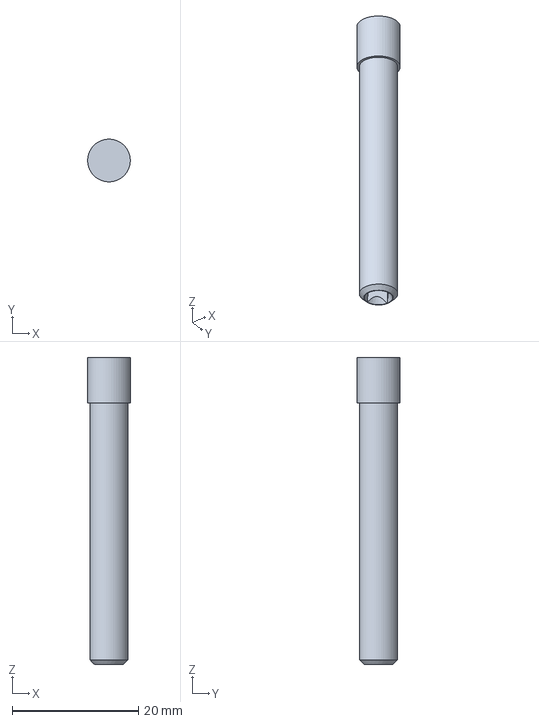
[picture p271: CAD file, 2026-11-01]
site/parts/key40Pipe.step
6.77 x 6.78 x 48.7 mm
