OrelMag/marine-chronometer-model/marine-chronometer-source/hamilton-parts/step/detentBlank.step

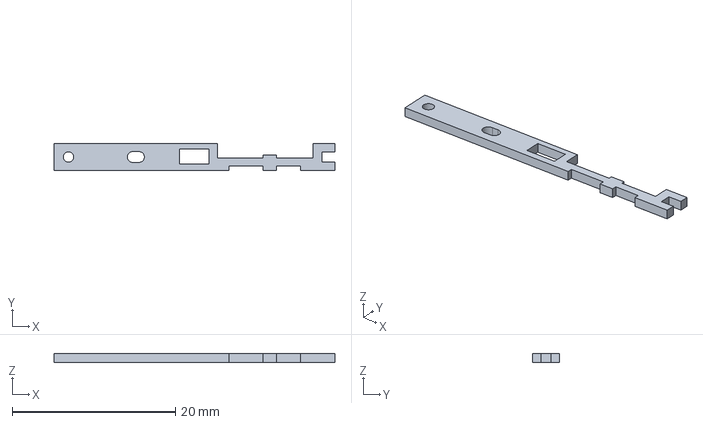
[picture p272: CAD file, 2026-11-02]
marine-chronometer-source/hamilton-parts/step/detentBlank.step
34.4 x 3.33 x 1.04 mm
