OrelMag/marine-chronometer-model/marine-chronometer-source/wempe/parts/keyBody.step

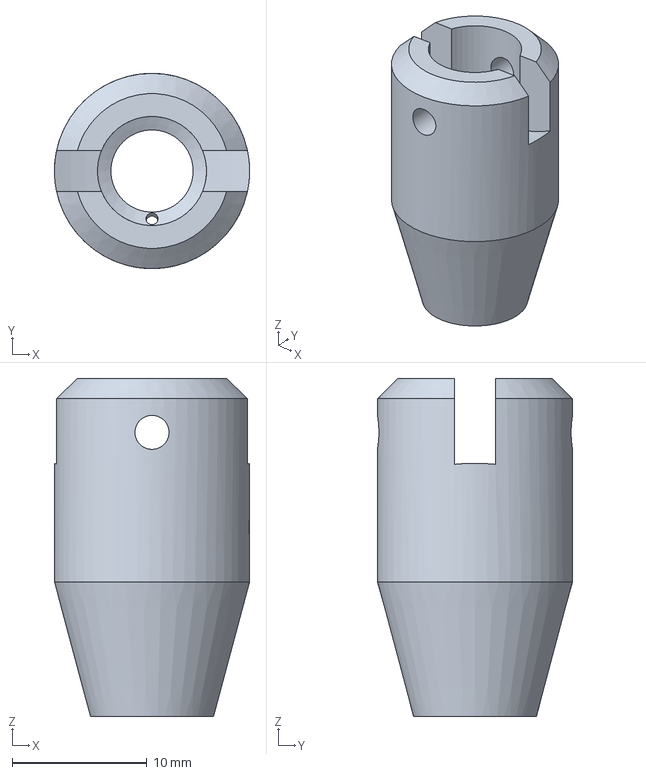
[picture p273: CAD file, 2026-11-01]
marine-chronometer-source/wempe/parts/keyBody.step
14.5 x 14.5 x 25.1 mm
