OrelMag/marine-chronometer-model/site/hamilton/parts/step/barrelArbor.step

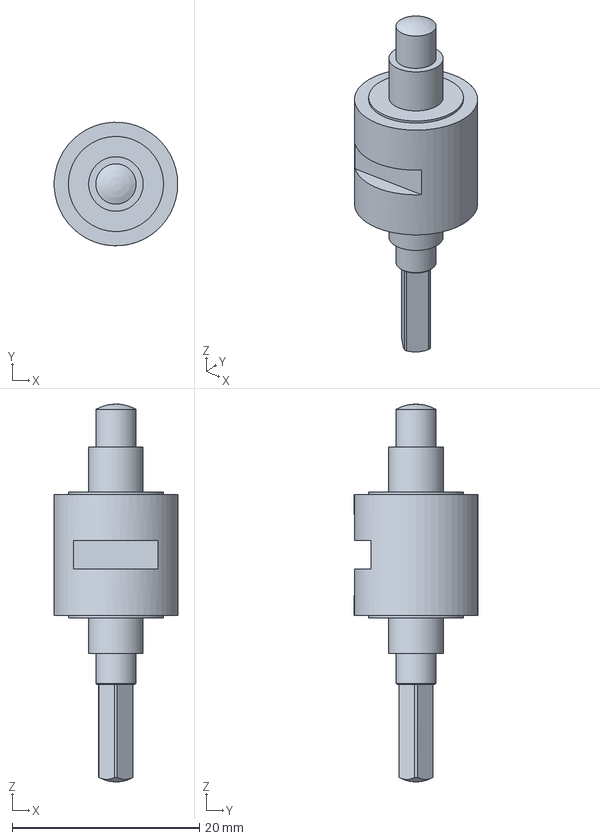
[picture p274: CAD file, 2026-11-02]
site/hamilton/parts/step/barrelArbor.step
13.2 x 13.2 x 40.4 mm
