OrelMag/marine-chronometer-model/site/parts/dtArbor.step

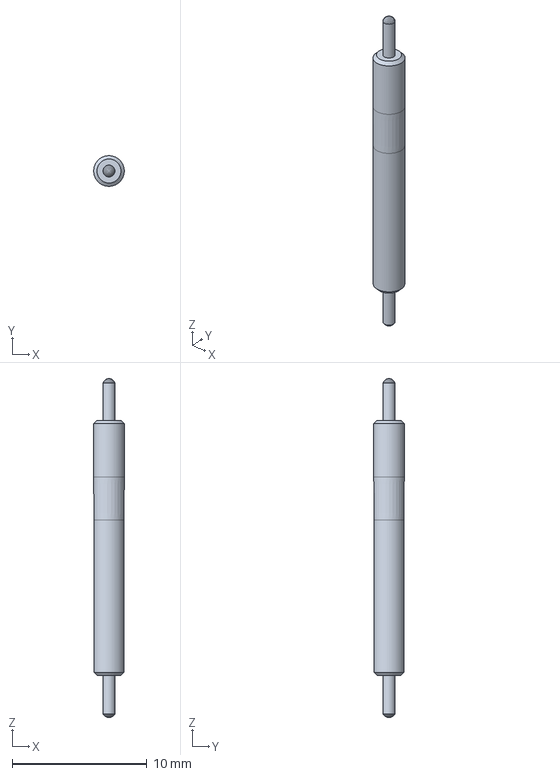
[picture p275: CAD file, 2026-11-01]
site/parts/dtArbor.step
2.28 x 2.28 x 25.1 mm
