OrelMag/marine-chronometer-model/marine-chronometer-source/hamilton-parts/step/fourthWheel.step

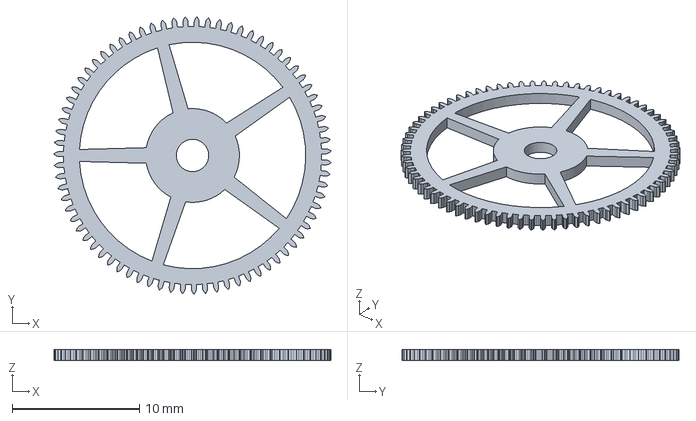
[picture p276: CAD file, 2026-11-02]
marine-chronometer-source/hamilton-parts/step/fourthWheel.step
21.8 x 21.8 x 0.889 mm
