OrelMag/marine-chronometer-model/marine-chronometer-source/wempe/parts/bandHookDrum.step

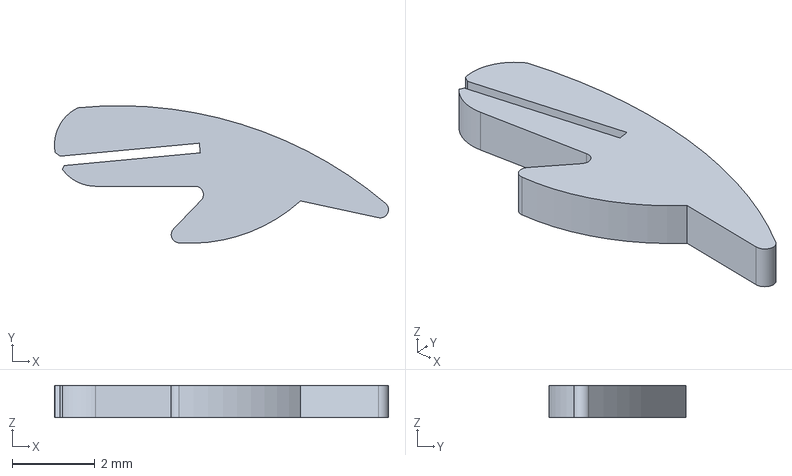
[picture p277: CAD file, 2026-11-01]
marine-chronometer-source/wempe/parts/bandHookDrum.step
8.09 x 3.33 x 0.78 mm
