OrelMag/marine-chronometer-model/site/hamilton/parts/step/barrelCap.step

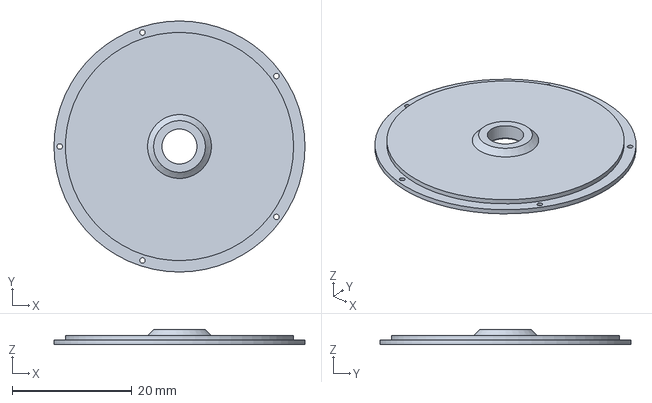
[picture p278: CAD file, 2026-11-02]
site/hamilton/parts/step/barrelCap.step
41.9 x 41.9 x 2.54 mm
