OrelMag/marine-chronometer-model/site/parts/w20.step

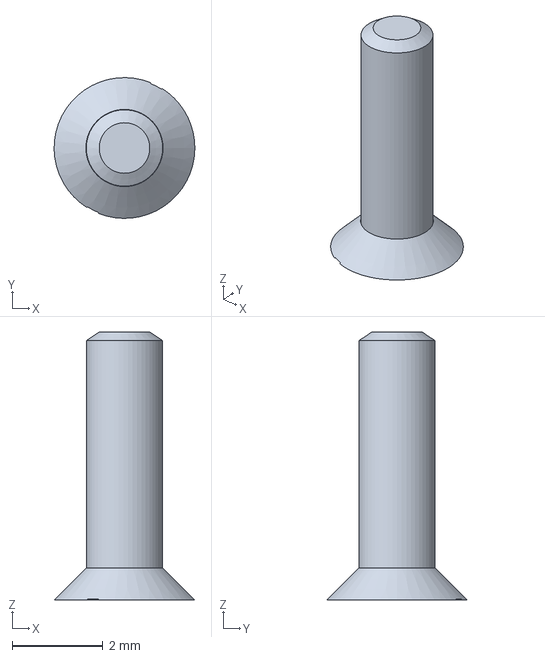
[picture p279: CAD file, 2026-11-01]
site/parts/w20.step
3.10 x 3.10 x 5.90 mm
