OrelMag/marine-chronometer-model/marine-chronometer-source/hamilton-parts/step/barrelHook.step

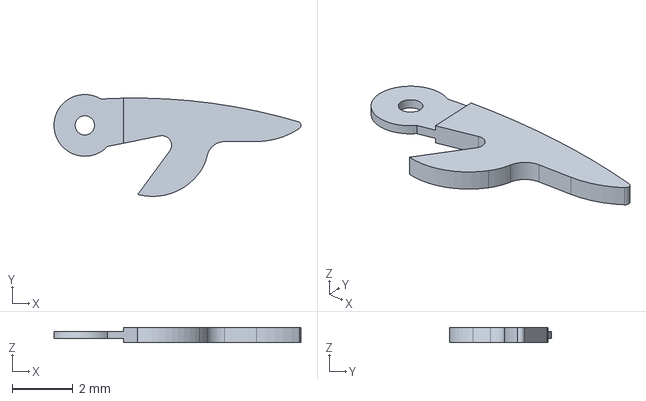
[picture p280: CAD file, 2026-11-02]
marine-chronometer-source/hamilton-parts/step/barrelHook.step
8.13 x 3.35 x 0.508 mm
