OrelMag/marine-chronometer-model/marine-chronometer-source/hamilton-parts/step/centreLink.step

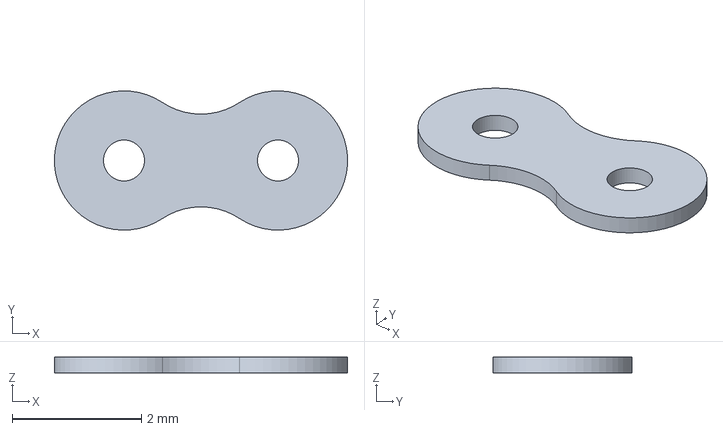
[picture p281: CAD file, 2026-11-02]
marine-chronometer-source/hamilton-parts/step/centreLink.step
4.54 x 2.16 x 0.241 mm
