OrelMag/marine-chronometer-model/marine-chronometer-source/wempe/parts/hsCollet.step

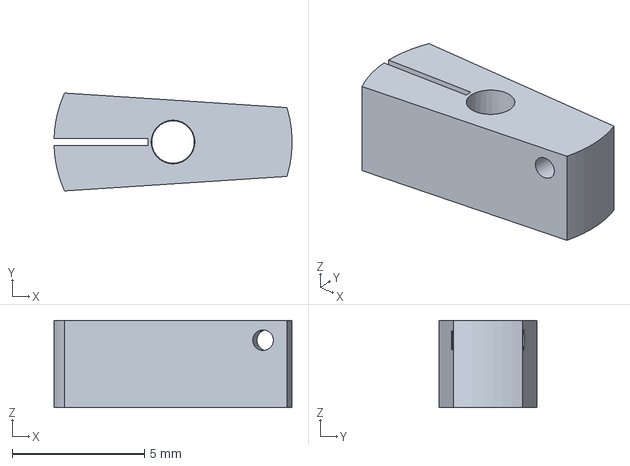
[picture p282: CAD file, 2026-11-01]
marine-chronometer-source/wempe/parts/hsCollet.step
8.99 x 3.70 x 3.30 mm
