OrelMag/marine-chronometer-model/site/hamilton/parts/step/barrel.step

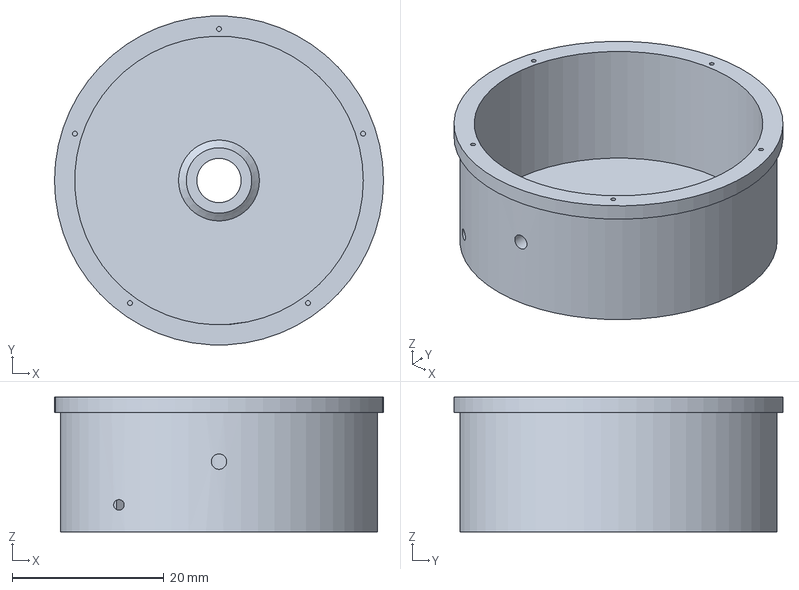
[picture p283: CAD file, 2026-11-02]
site/hamilton/parts/step/barrel.step
43.4 x 43.4 x 17.8 mm
