OrelMag/marine-chronometer-model/marine-chronometer-source/wempe/parts/hsStud.step

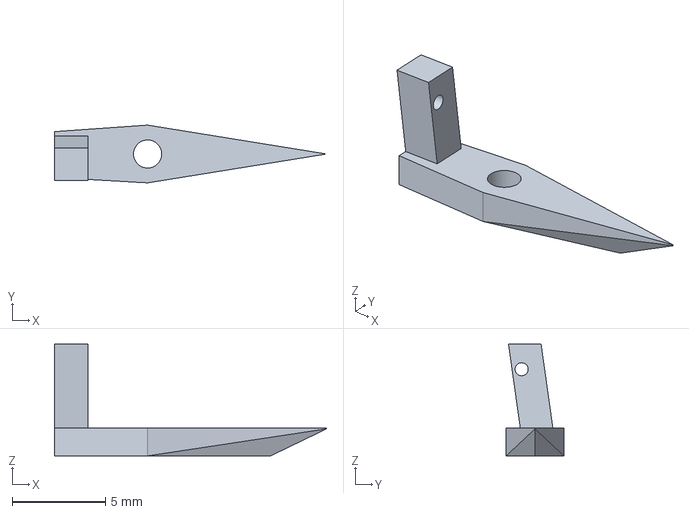
[picture p284: CAD file, 2026-11-01]
marine-chronometer-source/wempe/parts/hsStud.step
14.6 x 3.10 x 6.00 mm
