OrelMag/marine-chronometer-model/site/parts/settingEU.step

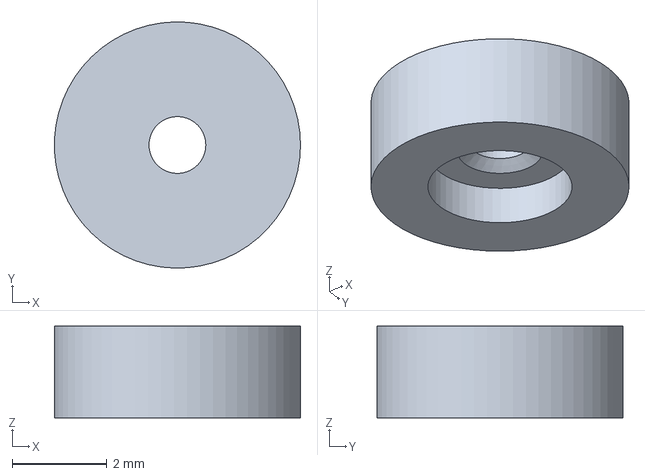
[picture p285: CAD file, 2026-10-29]
site/parts/settingEU.step
5.20 x 5.20 x 1.94 mm
