OrelMag/marine-chronometer-model/site/parts/settingCU.step

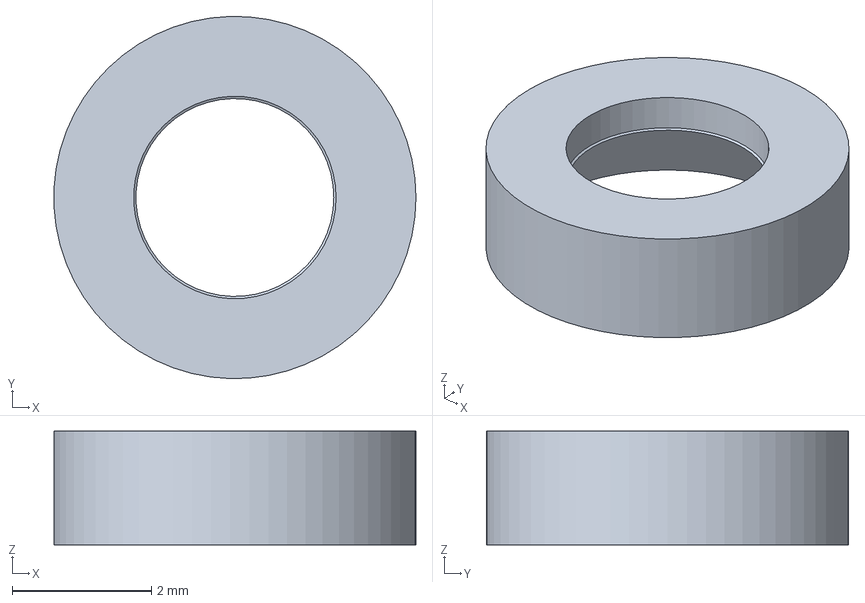
[picture p286: CAD file, 2026-10-29]
site/parts/settingCU.step
5.20 x 5.20 x 1.63 mm
