OrelMag/marine-chronometer-model/marine-chronometer-source/wempe/parts/caseBracket.step

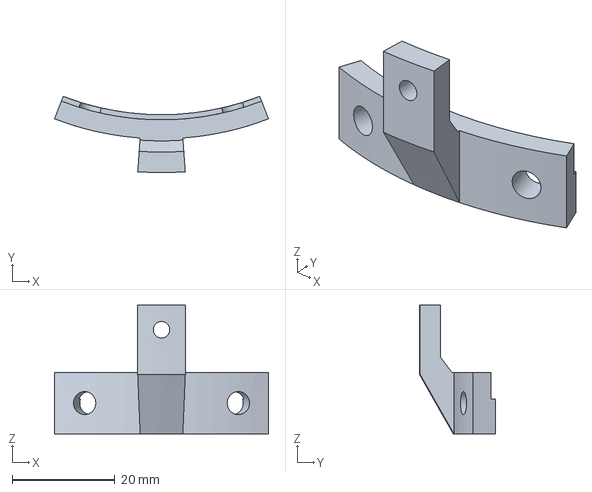
[picture p287: CAD file, 2026-11-01]
marine-chronometer-source/wempe/parts/caseBracket.step
41.7 x 14.9 x 25.1 mm
