OrelMag/marine-chronometer-model/site/parts/dustPlate.step

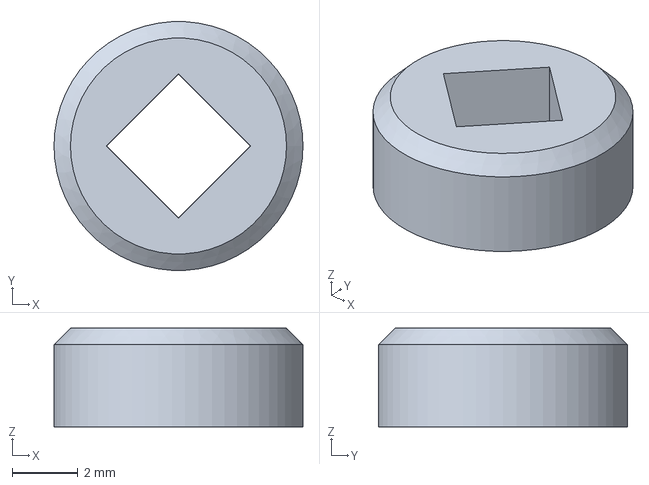
[picture p288: CAD file, 2026-10-29]
site/parts/dustPlate.step
7.55 x 7.54 x 3.00 mm
