OrelMag/marine-chronometer-model/marine-chronometer-source/wempe/parts/lockBracket.step

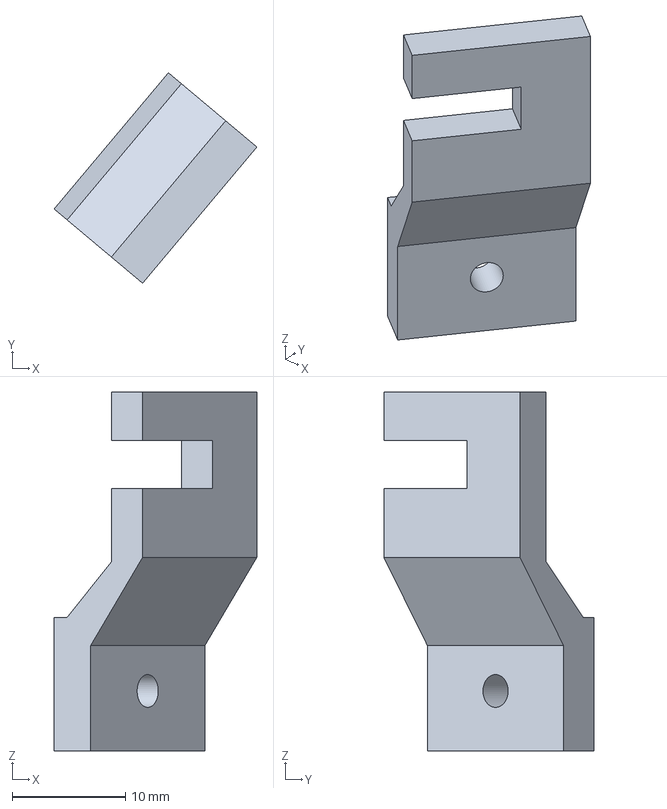
[picture p289: CAD file, 2026-11-01]
marine-chronometer-source/wempe/parts/lockBracket.step
17.9 x 18.6 x 31.7 mm
