OrelMag/marine-chronometer-model/site/parts/clickWheel.step

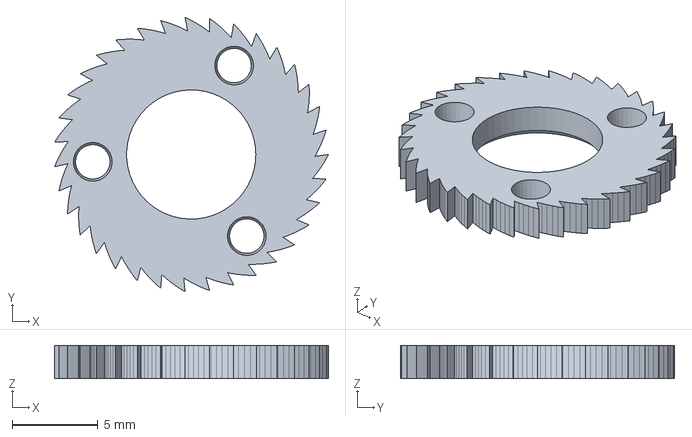
[picture p290: CAD file, 2026-10-29]
site/parts/clickWheel.step
16.0 x 16.0 x 1.95 mm
