OrelMag/marine-chronometer-model/site/hamilton/parts/step/fuseeHook.step

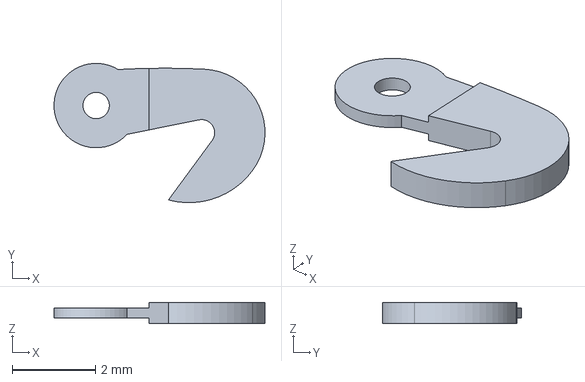
[picture p291: CAD file, 2026-11-02]
site/hamilton/parts/step/fuseeHook.step
5.08 x 3.35 x 0.508 mm
