OrelMag/marine-chronometer-model/site/parts/clicks.step

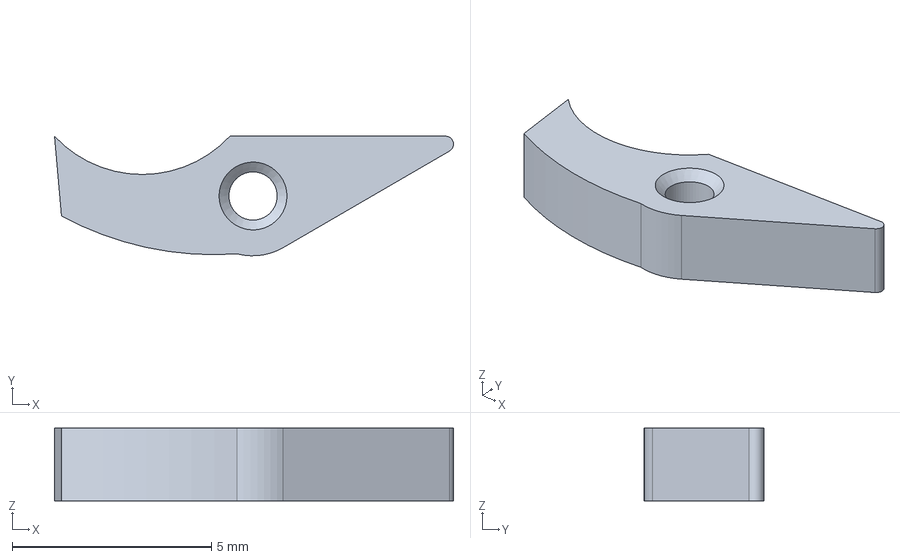
[picture p292: CAD file, 2026-10-29]
site/parts/clicks.step
10.0 x 3.00 x 1.82 mm
