OrelMag/marine-chronometer-model/marine-chronometer-source/wempe/parts/udHub.step

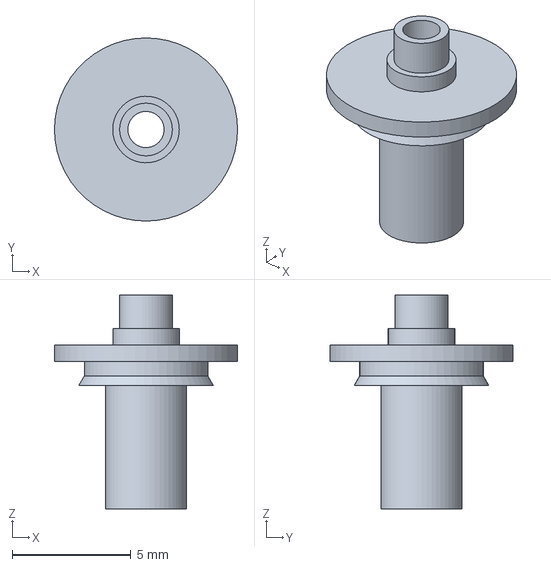
[picture p293: CAD file, 2026-10-31]
marine-chronometer-source/wempe/parts/udHub.step
7.70 x 7.70 x 9.00 mm
