OrelMag/marine-chronometer-model/site/parts/bushHs.step

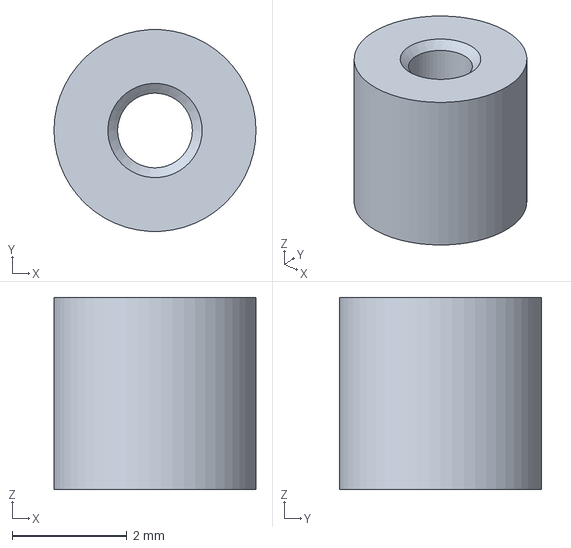
[picture p294: CAD file, 2026-10-29]
site/parts/bushHs.step
3.52 x 3.51 x 3.35 mm
