OrelMag/marine-chronometer-model/marine-chronometer-source/wempe/parts/dial.step

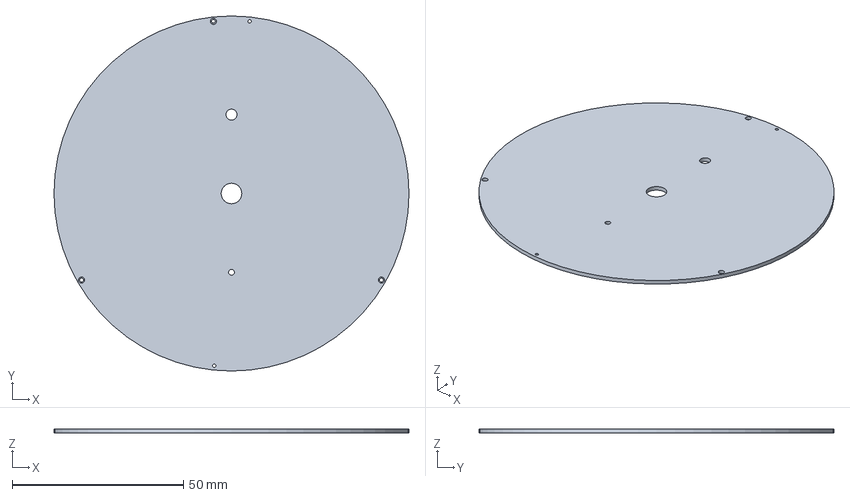
[picture p295: CAD file, 2026-10-31]
marine-chronometer-source/wempe/parts/dial.step
103.5 x 103.5 x 1.20 mm
