OrelMag/marine-chronometer-model/site/parts/studShort.step

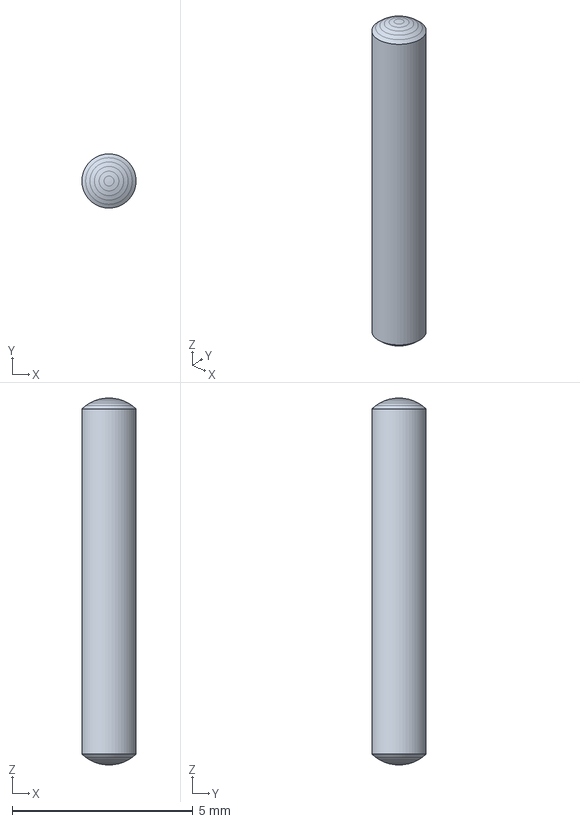
[picture p296: CAD file, 2026-10-29]
site/parts/studShort.step
1.50 x 1.50 x 10.2 mm
