OrelMag/marine-chronometer-model/marine-chronometer-source/wempe/parts/cannon.step

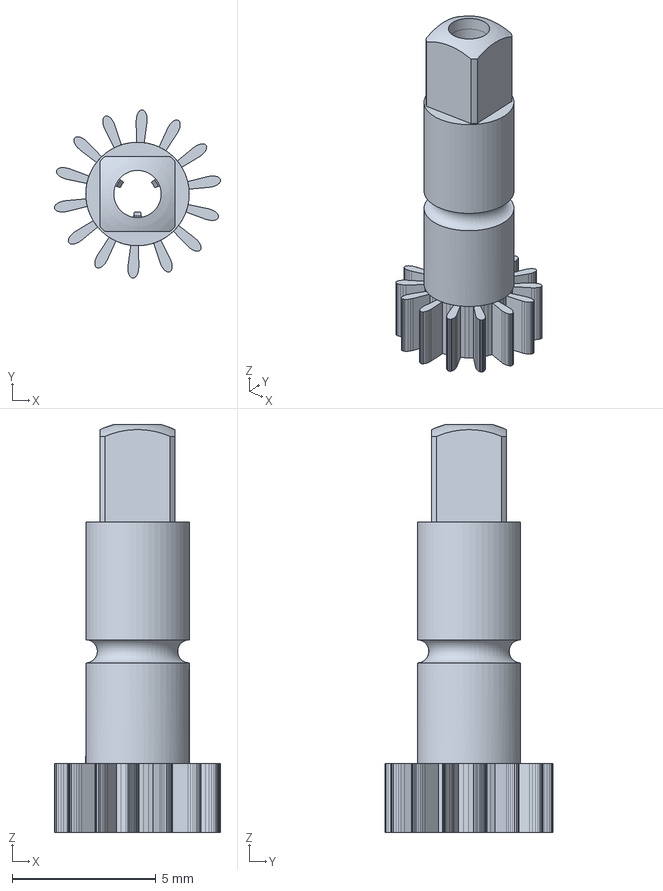
[picture p297: CAD file, 2026-10-31]
marine-chronometer-source/wempe/parts/cannon.step
5.78 x 5.85 x 14.2 mm
