OrelMag/marine-chronometer-model/marine-chronometer-source/wempe/parts/changeWheel.step

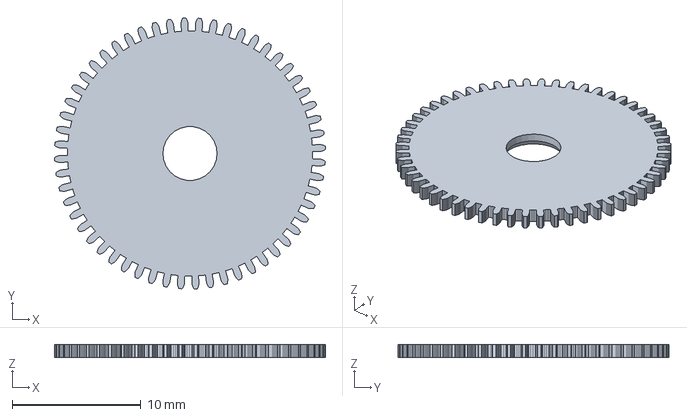
[picture p298: CAD file, 2026-10-31]
marine-chronometer-source/wempe/parts/changeWheel.step
21.0 x 21.0 x 1.00 mm
