OrelMag/marine-chronometer-model/site/parts/escapeWheel.step

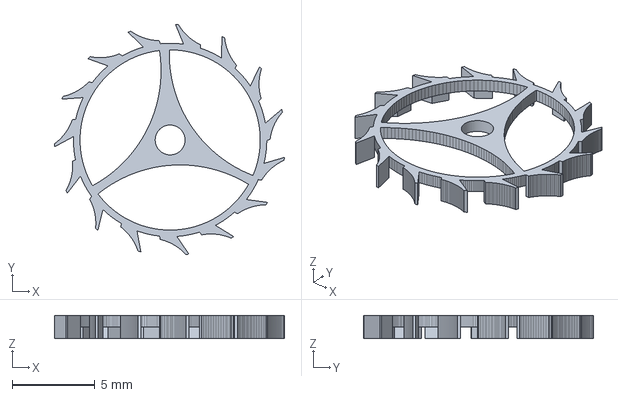
[picture p299: CAD file, 2026-10-29]
site/parts/escapeWheel.step
13.9 x 13.9 x 1.40 mm
