OrelMag/marine-chronometer-model/marine-chronometer-source/wempe/parts/rim.step

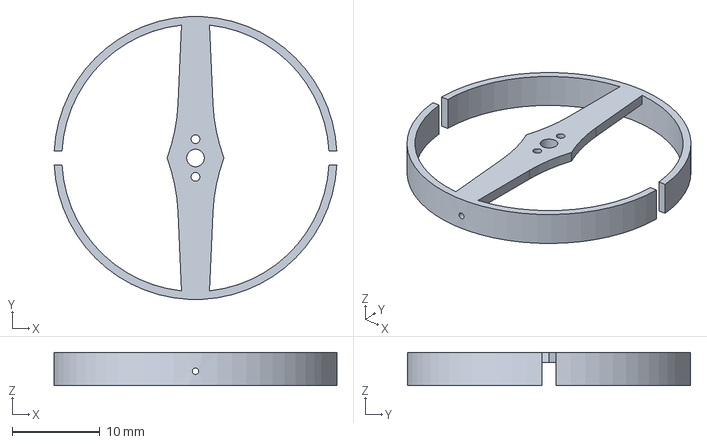
[picture p300: CAD file, 2026-10-29]
marine-chronometer-source/wempe/parts/rim.step
32.3 x 32.3 x 3.80 mm
