OrelMag/marine-chronometer-model/marine-chronometer-source/wempe/parts/detentBlock.step

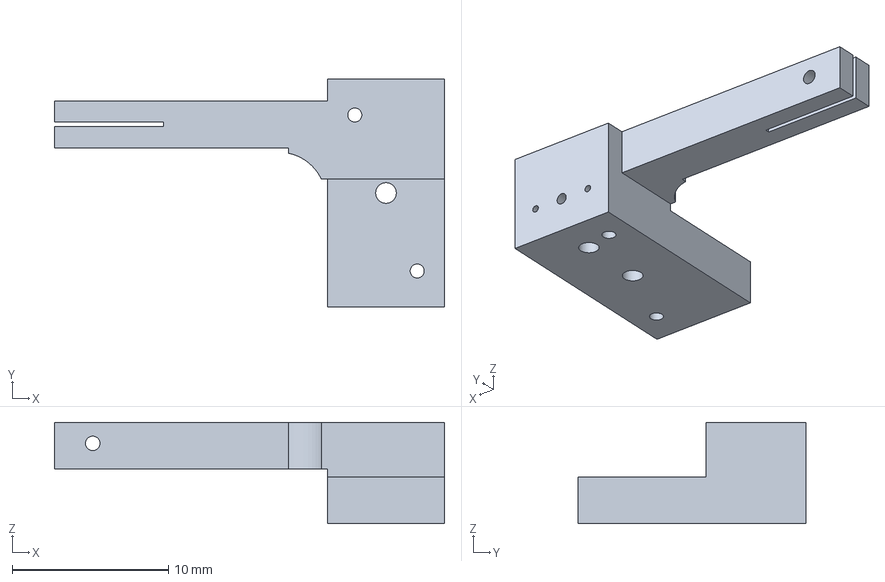
[picture p301: CAD file, 2026-10-29]
marine-chronometer-source/wempe/parts/detentBlock.step
25.0 x 14.6 x 6.50 mm
