OrelMag/marine-chronometer-model/site/parts/topPlate.step

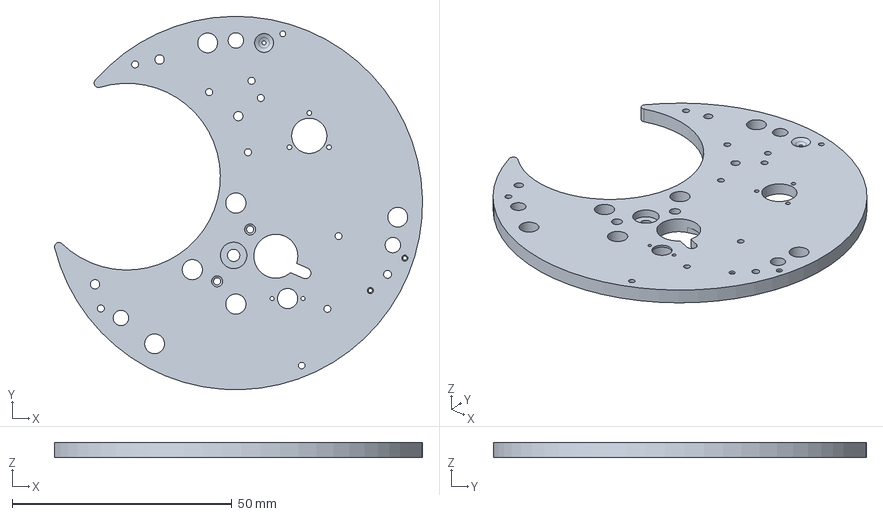
[picture p302: CAD file, 2026-10-29]
site/parts/topPlate.step
83.8 x 85.0 x 3.35 mm
