OrelMag/marine-chronometer-model/marine-chronometer-source/wempe/parts/settingCEU.step

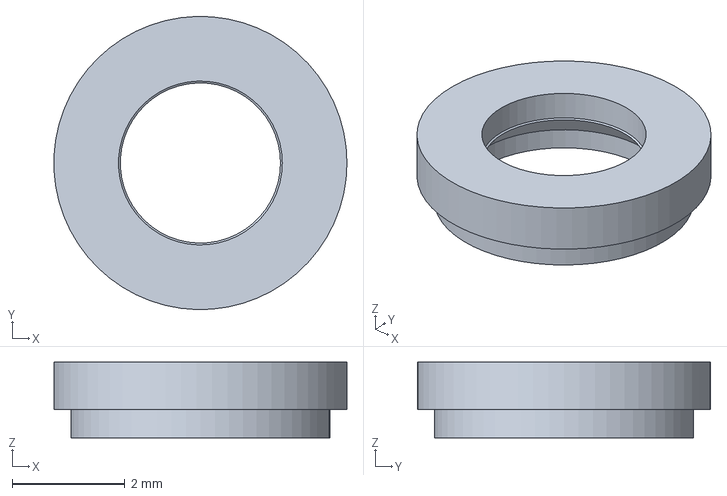
[picture p303: CAD file, 2026-10-29]
marine-chronometer-source/wempe/parts/settingCEU.step
5.20 x 5.20 x 1.34 mm
