OrelMag/marine-chronometer-model/site/parts/pillars.step

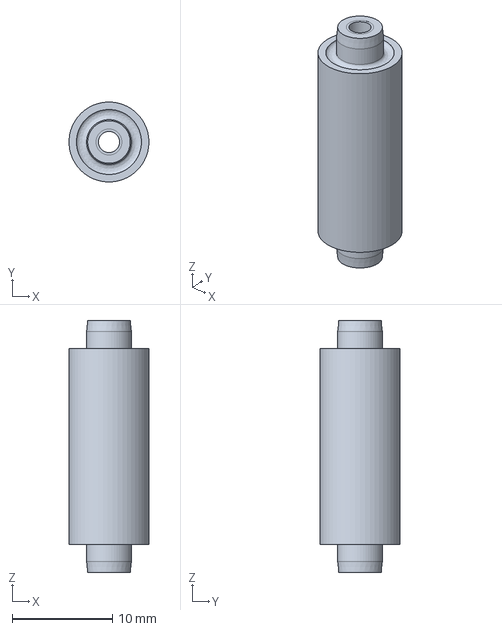
[picture p304: CAD file, 2026-10-29]
site/parts/pillars.step
7.99 x 8.00 x 25.2 mm
