OrelMag/marine-chronometer-model/marine-chronometer-source/wempe/parts/detent.step

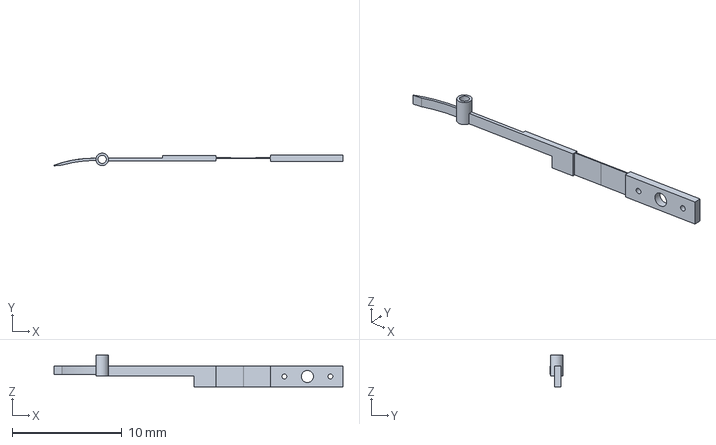
[picture p305: CAD file, 2026-10-29]
marine-chronometer-source/wempe/parts/detent.step
26.4 x 1.17 x 2.90 mm
