OrelMag/marine-chronometer-model/marine-chronometer-source/wempe/parts/hookBlock.step

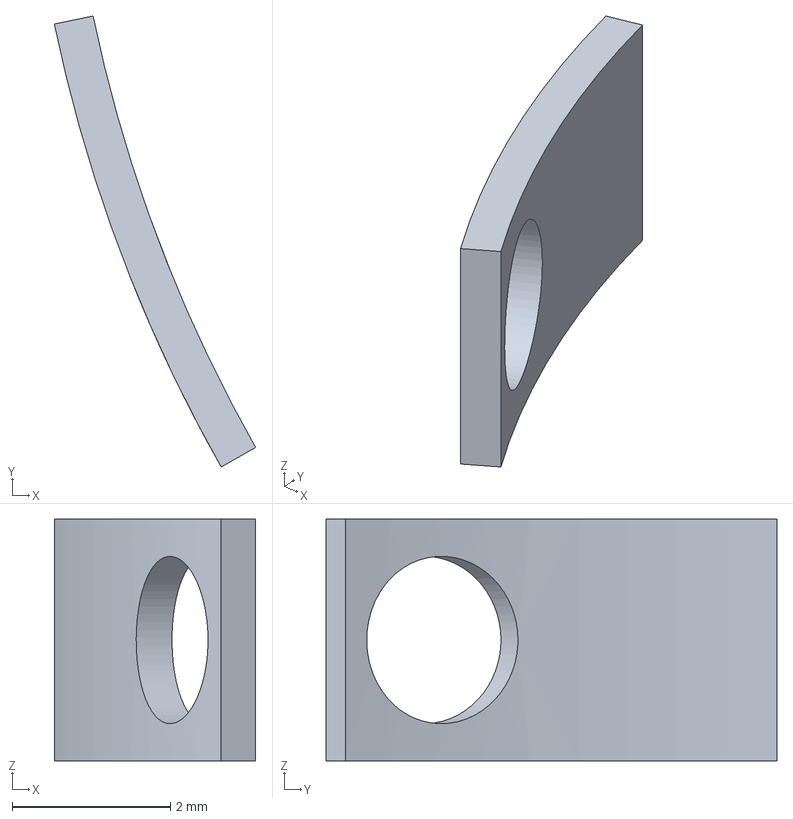
[picture p306: CAD file, 2026-10-29]
marine-chronometer-source/wempe/parts/hookBlock.step
2.54 x 5.69 x 3.05 mm
