OrelMag/marine-chronometer-model/marine-chronometer-source/wempe/parts/vorreiber.step

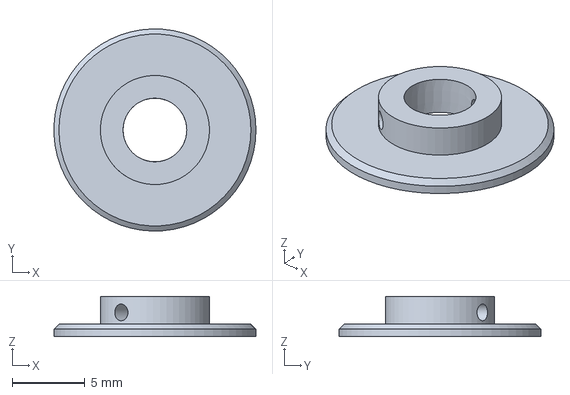
[picture p307: CAD file, 2026-10-29]
marine-chronometer-source/wempe/parts/vorreiber.step
13.9 x 13.9 x 2.76 mm
