OrelMag/marine-chronometer-model/marine-chronometer-source/wempe/parts/fuseeArbor.step

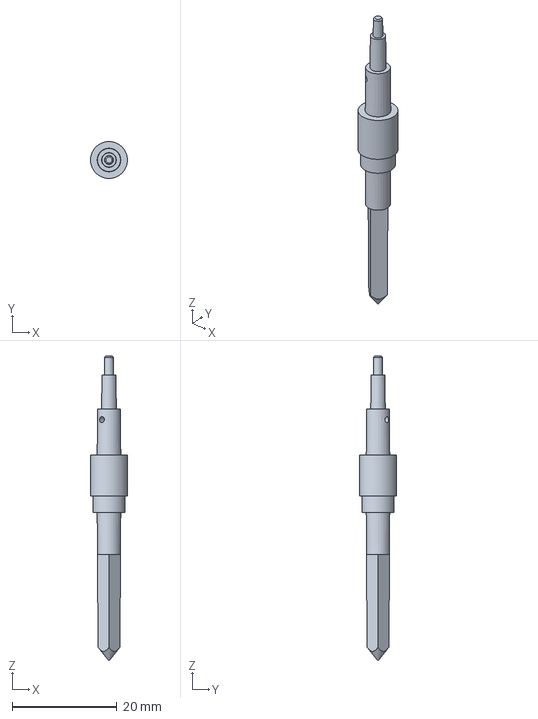
[picture p308: CAD file, 2026-10-29]
marine-chronometer-source/wempe/parts/fuseeArbor.step
7.03 x 7.04 x 58.1 mm
