OrelMag/marine-chronometer-model/marine-chronometer-source/wempe/parts/studBush.step

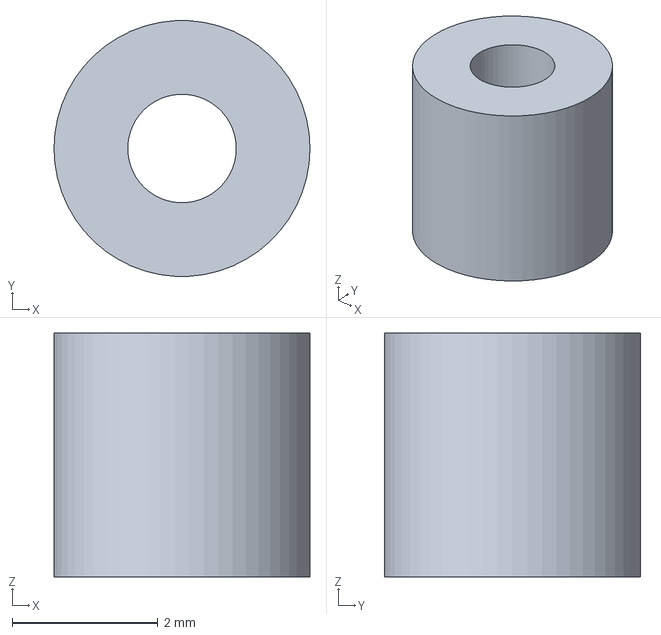
[picture p309: CAD file, 2026-10-29]
marine-chronometer-source/wempe/parts/studBush.step
3.52 x 3.51 x 3.35 mm
