OrelMag/marine-chronometer-model/marine-chronometer-source/wempe/parts/escapeCollet.step

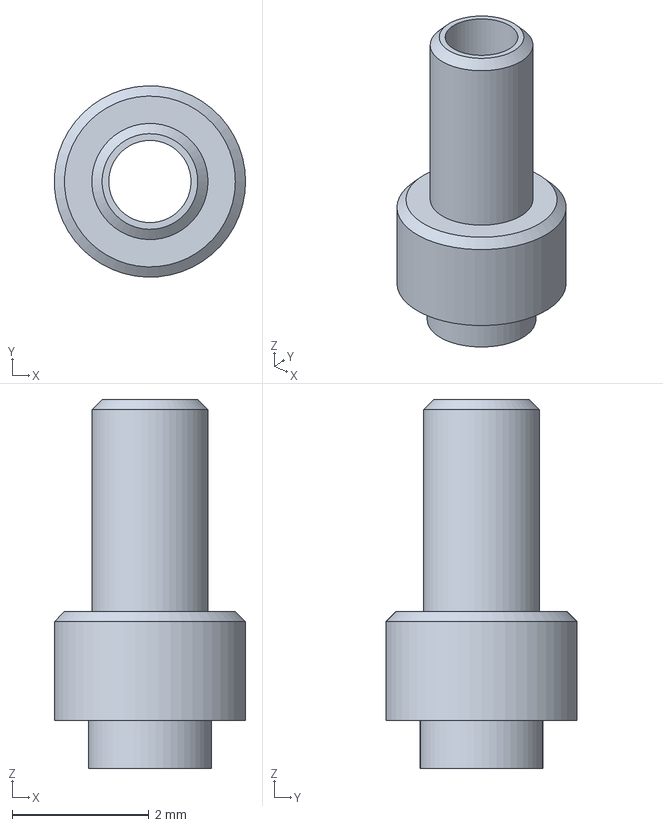
[picture p310: CAD file, 2026-10-29]
marine-chronometer-source/wempe/parts/escapeCollet.step
2.80 x 2.80 x 5.40 mm
