OrelMag/marine-chronometer-model/marine-chronometer-source/wempe/parts/bush302.step

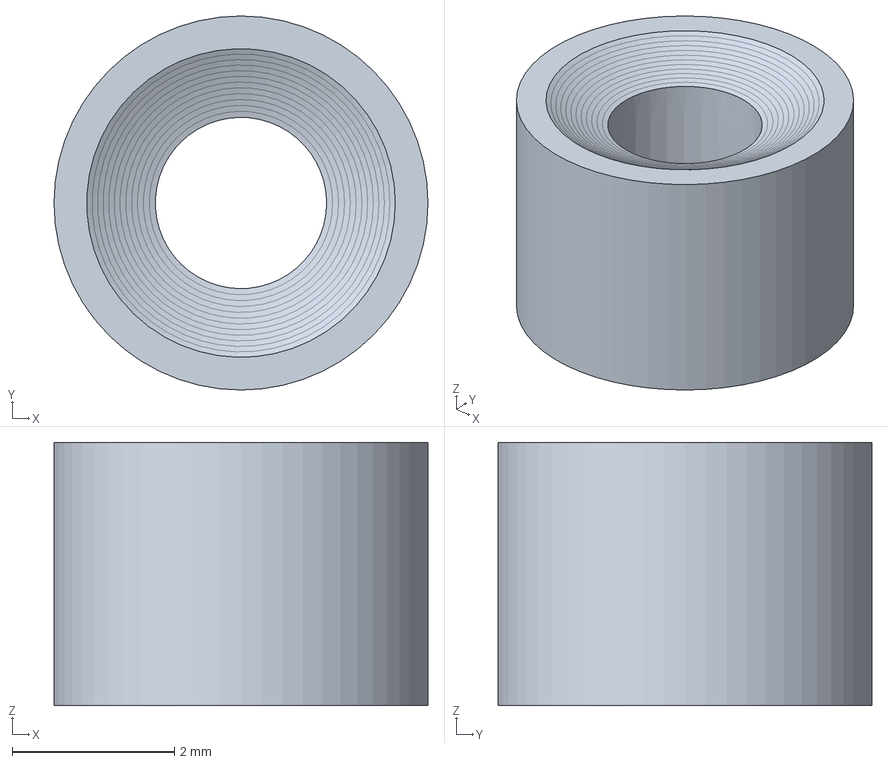
[picture p311: CAD file, 2026-10-29]
marine-chronometer-source/wempe/parts/bush302.step
4.61 x 4.61 x 3.24 mm
