OrelMag/marine-chronometer-model/marine-chronometer-source/wempe/parts/intermediateArbor.step

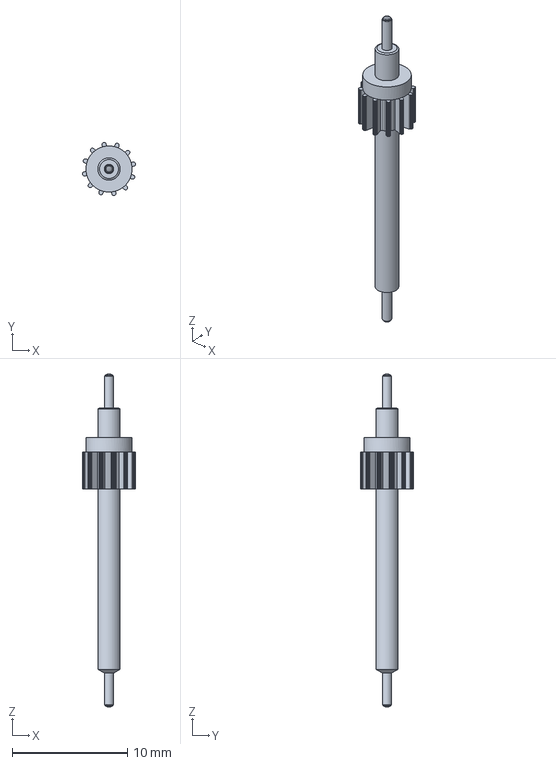
[picture p312: CAD file, 2026-10-29]
marine-chronometer-source/wempe/parts/intermediateArbor.step
4.63 x 4.63 x 28.9 mm
