OrelMag/marine-chronometer-model/marine-chronometer-source/wempe/parts/secondsArbor.step

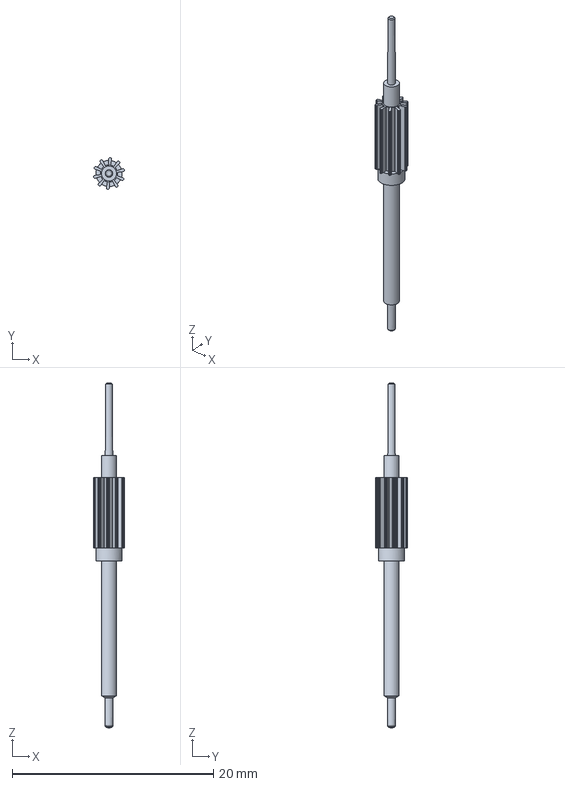
[picture p313: CAD file, 2026-10-29]
marine-chronometer-source/wempe/parts/secondsArbor.step
3.09 x 3.16 x 34.2 mm
