OrelMag/marine-chronometer-model/marine-chronometer-source/wempe/parts/centreArbor.step

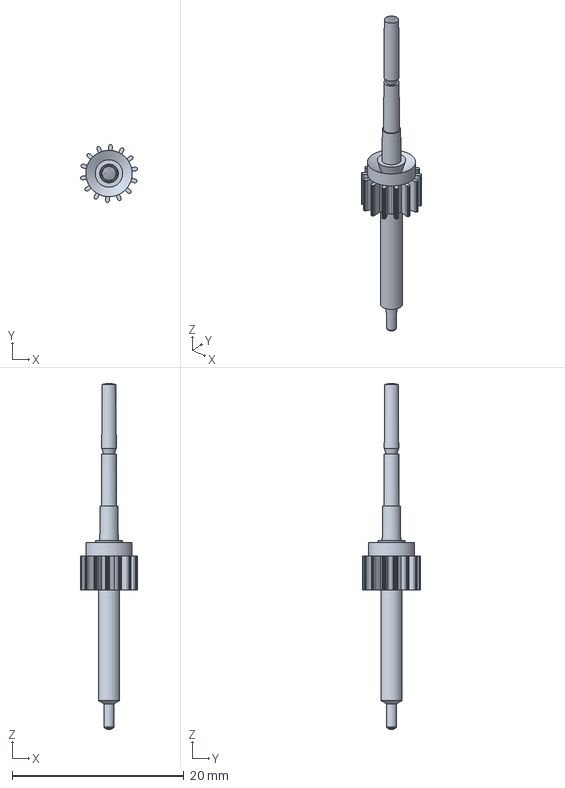
[picture p314: CAD file, 2026-10-29]
marine-chronometer-source/wempe/parts/centreArbor.step
6.68 x 6.77 x 40.3 mm
