OrelMag/marine-chronometer-model/marine-chronometer-source/wempe/parts/ring.step

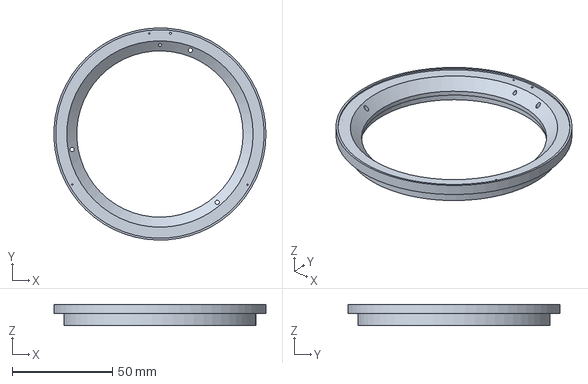
[picture p315: CAD file, 2026-10-29]
marine-chronometer-source/wempe/parts/ring.step
105.8 x 105.9 x 10.7 mm
