OrelMag/marine-chronometer-model/marine-chronometer-source/wempe/parts/pillarPlate.step

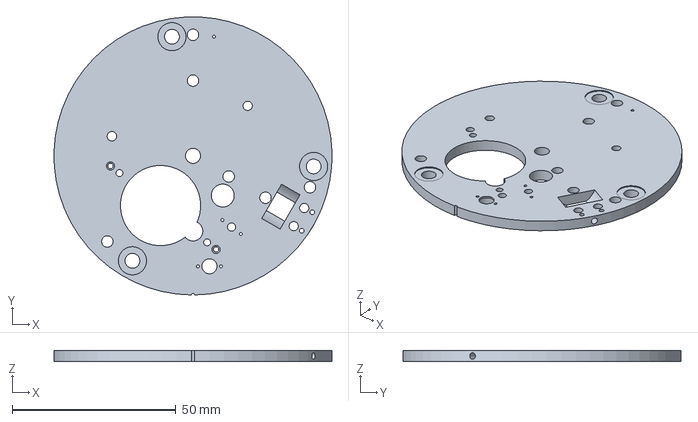
[picture p316: CAD file, 2026-10-29]
marine-chronometer-source/wempe/parts/pillarPlate.step
84.9 x 84.9 x 3.35 mm
