OrelMag/marine-chronometer-model/marine-chronometer-source/wempe/parts/fuseeBush.step

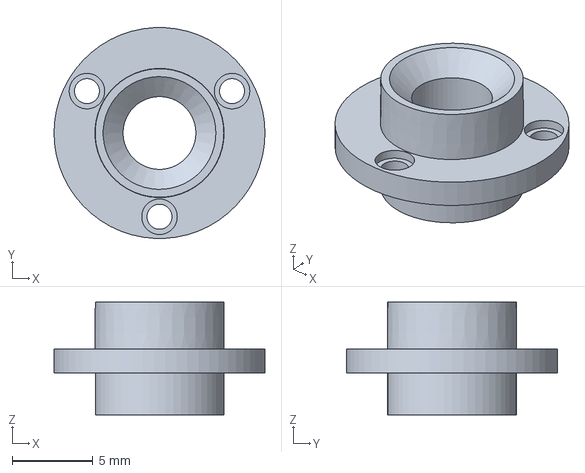
[picture p317: CAD file, 2026-10-29]
marine-chronometer-source/wempe/parts/fuseeBush.step
13.1 x 13.1 x 7.00 mm
