OrelMag/marine-chronometer-model/marine-chronometer-source/wempe/parts/click.step

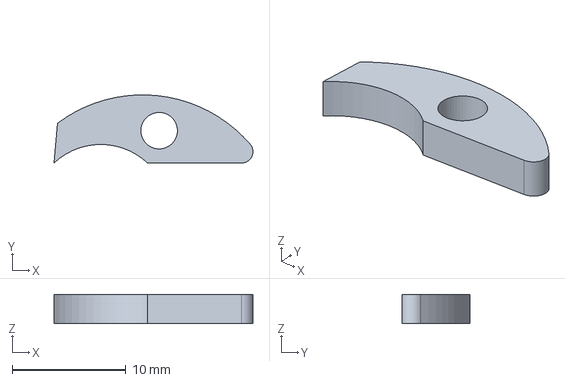
[picture p318: CAD file, 2026-10-29]
marine-chronometer-source/wempe/parts/click.step
17.5 x 6.00 x 2.56 mm
