OrelMag/marine-chronometer-model/(list of files, cad)

Other CAD files:
marine-chronometer-source/hamilton-parts/step/detentFinished.step
site/hamilton/parts/step/det_1770_ts.step
site/parts/detentBlock.6mx.step
marine-chronometer-source/hamilton-parts/step/setupPawlSpring.step
site/hamilton/parts/step/barrelHook.step
site/hamilton/parts/step/centreLink.step
site/hamilton/parts/step/fourthPinion.step
site/hamilton/parts/step/setupPawlSpring.step
site/parts/secondsWheel.step
marine-chronometer-source/wempe/parts/footScrew.step
marine-chronometer-source/wempe/parts/fuseeBushScrew.step
marine-chronometer-source/wempe/parts/screw72f.step
marine-chronometer-source/wempe/parts/settingScrewL.step
marine-chronometer-source/wempe/parts/settingScrewU.step
marine-chronometer-source/wempe/parts/studScrew.step
site/parts/bridgeScrew.step
site/parts/intermediateBridgeScrew.step
site/parts/screw71f.step
site/parts/screw72.step
site/parts/screw80_3m.step
site/parts/screw80_9m.step
site/parts/screwUr.step
site/parts/upperCockScrew.step
