OrelMag/marine-chronometer-model/marine-chronometer-source/wempe/book/wempe-build-book.pdf

# The Wempe Einheits-Chronometer: a build book

Generated from the working model of Gerhard D. Wempe's Einheits-Chronometer, as its works drawings were last revised:

every part card's lines of its parts list (by drawing number), each line's fit as measured on the model, its material and

treatment as its own drawing gives them (the title block's Werkstoff, the notes' hardening and tempering, the surface

marks; nothing from practice: where a sheet gives none, or the part has no sheet in the set, it says so), how it is made (CNC

milled or turned, by hand, or bought in), and the part's drawing from the model's solids, in millimetres. The works drawings

themselves are Johannes Altmeppen's photographs (dg-chrono.de), not reproduced here; the transcriptions in the

repository give what is read off each. What the model estimates is listed in the Wempe README's "Estimated, not from

the drawings".

Two builds are worked out to navigate by (the README's "The build"): the 1940s build keeps the drawings' carbon-steel

mainspring, the 1950s build takes a Nivaflex strip; both thin the gold spring at its bend. This book shows the 1950s build.

Wind it as both builds are judged: turn the key to the end of each stroke, hold it and let it back; let go outright, the fusee's

blow dents its click and bends the maintaining ratchet's teeth (tools/wempe_letgo_fix.js).

The gold spring thinned at its bend: the 1950s build's, a deviation from the drawings (the drawn part is beside it on its

sheet); Mainspring in Nivaflex 45/5: the 1950s build's, a deviation from the drawings (the drawn part is beside it on its

sheet). Each part card switches between the two.

Each part has its drawing, laid out as the Wempe's own works drawings are (first-angle projection, sizes in mm), drawn

from the working model's solids by tools/drawbook.py, with a second sheet of its parts-list lines, holes and contour; each

assembly a sheet with its pieces ballooned and listed. The works drawings themselves are not reproduced.

## Contents

1. Pillar plate (Unterplatte)
2. Pillar plate
3. Pillar screws, dial side
4. Centre arbor’s bush (Messinglager WN-302)
5. Stud bushes (Futter)
6. Hand-setting pinion’s bush
7. Studs (Anrichtstifte)
8. Top plate (Oberplatte)
9. Top plate
10. Pillar screws, train side
11. Stop pin (Anschlagstift)
12. Train bushes (Messinglager WN-300, WN-301)
13. Pillars (Pfeiler)
14. Movement ring (Werkring)
15. Movement ring
16. Movement ring screws
17. Ring’s pin to the case (Stellstift 3)
18. Plate’s pin
19. Barrel bridge (Federhausbrücke)
20. Barrel bridge
21. Click (Sperrkegel)
22. Click screw
23. Barrel bridge screws
24. Barrel bridge steady pins
25. Fusee bush (Schneckenfutter)
26. Fusee bush
27. Fusee bush screws
28. Dust bush (Staubfutter)
29. Cork ring (Korkring)
30. Upper balance cock (Unruhkloben oben)
31. Upper balance cock
32. Upper cock screw
33. Upper cock steady pins
34. Lower balance cock (Unruhkloben unten)
35. Lower balance cock
36. Lower cock screw
37. Lower cock steady pins
38. Intermediate bridge (Zwischenbrücke)
39. Intermediate bridge
40. Intermediate bridge screws
41. Intermediate bridge steady pins
42. Intermediate wheel’s lower bush (Messinglager WN-300)
43. Seconds jewel’s setting (Fassung)
44. Seconds jewel (Lagerstein f. Sek.)
45. Centre wheel (Minutenrad)
46. Centre pinion and arbor (Minutentrieb)
47. Centre wheel (Minutenrad)
48. Intermediate wheel (Zwischenrad)
49. Intermediate pinion and arbor (Zwischentrieb)
50. Intermediate wheel (Zwischenrad)
51. Seconds wheel (Sekundenrad)
52. Seconds pinion and arbor (Sekundentrieb)
53. Seconds wheel (Sekundenrad)
54. Balance (Unruh)
55. Balance rim and arm
56. Compensation masses
57. Timing screws and weights
58. Balance staff
59. Balance hub (Unruhbutzen)
60. Hub screws
61. Hairspring (Spiralfeder)
62. Hairspring
63. Hairspring collet (Spiralrolle)
64. Hairspring stud (Klötzchen)
65. Stud
66. Stud screw
67. Impulse and discharge rollers (Heberolle, Auslöserolle)
68. Impulse roller and stone
69. Discharge roller and stone
70. Escape wheel (Gangrad)
71. Escape wheel
72. Escape pinion and arbor

73. Escape wheel collet (Gangradbutzen)
74. Spring detent (Gangfeder) and gold spring
75. Detent with its locking stone
76. Gold spring (Goldfeder)
77. Detent foot screw and pins
78. Detent block (Gangfederkloben)
79. Detent block
80. Block screws and pins
81. Balance jewels, upper
82. Upper hole jewel
83. Upper endstone
84. Setting screws
85. Balance jewels, lower
86. Lower hole jewel
87. Lower endstone
88. Setting screws
89. Escape wheel endstone, upper
90. Endstone and setting
91. Setting screws
92. Escape wheel jewel, upper
93. Escape wheel jewel, lower
94. Escape wheel endstone, lower
95. Endstone and setting
96. Setting screws
97. Fusee (Schnecke)
98. Fusee body (Schneckenkörper)
99. Fusee arbor (Schneckenwelle)
100. Click wheel (Schneckensperrrad)
101. Click wheel screws (WN-19)
102. Chain pin (Kettenstift)
103. Cover plate (Deckplatte)
104. Cover plate
105. Cover plate screw (WN-20)
106. Vorreiber
107. Vorreiber
108. Vorreiber pin (Vorreiberstift)
109. Dust plate (Staubplatte)
110. Fusee wheel (Schneckenrad)
111. Maintaining work (Gegensperrrad, Gegenfeder)
112. Maintaining ratchet (Gegensperrrad)
113. Clicks (Sperrkegel)
114. Click screws (WN-21)
115. Click springs (Sperrfeder)
116. Click spring pins
117. Maintaining spring (Gegenfeder)
118. Maintaining spring’s pins (Stellstifte)
119. Maintaining detent (Gegensperrkegel)
120. Detent click
121. Detent arbor
122. Detent spring (Feder) and its stud
123. Stop work (Stellungssteg)
124. Stop bar (Stellungssteg)
125. Stop bar spring (Stegfeder)
126. Stop bar’s pin (Stift)
127. Stop bar spring’s pin (Stift)
128. Barrel (Federhaus)
129. Barrel drum (Federhaustrommel)
130. Barrel lid (Federhausdeckel)
131. Spring hook block (Federhaushaken)
132. Steg (spring brace)
133. Barrel arbor (Federkern)
134. Barrel arbor (Federkern)
135. Arbor hook (Federhaken)
136. Set-up ratchet (Sperrad)
137. Mainspring (Zugfeder)
138. Fusee chain (Kette)
139. Chain links
140. Fusee band (Schneckenband)
141. Band (Schneckenband)
142. Band’s round hook (Bandhaken rund)
143. Band’s drum hook (Bandhaken f. Trommel)
144. Cannon tube (Minutenrohr)
145. Change wheel (Wechselrad)
146. Change wheel
147. Change wheel pipe (Wechselbutzen)
148. Change pinion (Wechseltrieb)
149. Hour wheel (Stundenrad)
150. Hour wheel
151. Hour wheel pipe (Stundenbutzen)
152. Up-and-down wheel (Auf- und Abrad)
153. Up-and-down wheel
154. Up-and-down wheel pipe
155. Up-and-down pinion (Auf- und Abtrieb)
156. Hands
157. Minute hand (Minutenzeiger)
158. Hour hand (Stundenzeiger)
159. Up-and-down hand (Auf- und Abzeiger)
160. Seconds hand (Sekundenzeiger) and collet
161. Dial (Zifferblatt)
162. Dial
163. Dial screws
164. Dial pin
165. Bowl (Gehäusetopf)
166. Bowl
167. Case brackets (Gehäusekloben)
168. Locking bracket (Feststellkloben)
169. Bracket screws (WN-78)
170. Closing plate (Verschlußplatte)
171. Closing plate
172. Closing plate screw
173. Closing plate knob
174. Closing spring (Verschlußfeder)
175. Bezel and glass (Glasrand)
176. Bezel (Glasrand)
177. Glass
178. Gimbal ring (Kardanring)
179. Gimbal ring
180. Ring bracket (Kardanringkloben)
181. Ring bracket screws
182. Inner pivot screws (WN-79)
183. Lock nuts (WN-400)
184. Wooden box (Holzkasten)
185. Box
186. Outer pivot screws (WN-80)
187. Bearing discs
188. Lid stay
189. Handles (Griff f. Chronometerkasten)
190. Handle screws
191. Hinge
192. Pins over the pivots
193. Keeper
194. Key holder
195. Key holder’s fitting
196. Key holder’s screws
197. Lid (Deckel)
198. Lid
199. Lid glass
200. Hinge
201. Lid stay
202. Maker’s plate (Firmenschild)
203. Latch tongue (Zunge)
204. Tongue screw
205. Tongue knob
206. Outer box (Überkasten)
207. Outer box
208. Rim strip
209. Front and back cushions
210. End cushions
211. Floor cushion
212. Strap
213. Strap screws
214. Eyes
215. Eye screws
216. Hinges
217. Hook eye
218. Outer box lid

2
1
9. O
u

t

e

r

b

o

x lid

2

2

0. Lid
c

u

s

hio

n

2

2
1. Hin

g

e le

a

v

e

s

2

2

2. H
o

o

k

2

2

3. Tr
a

n

sit lo

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
elle

r)

2

2
4. Win

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
5. K

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
6. K
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
elmit

t

elt

eil)

2

2
7. K

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
8. C
oil s

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
9. Gr
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
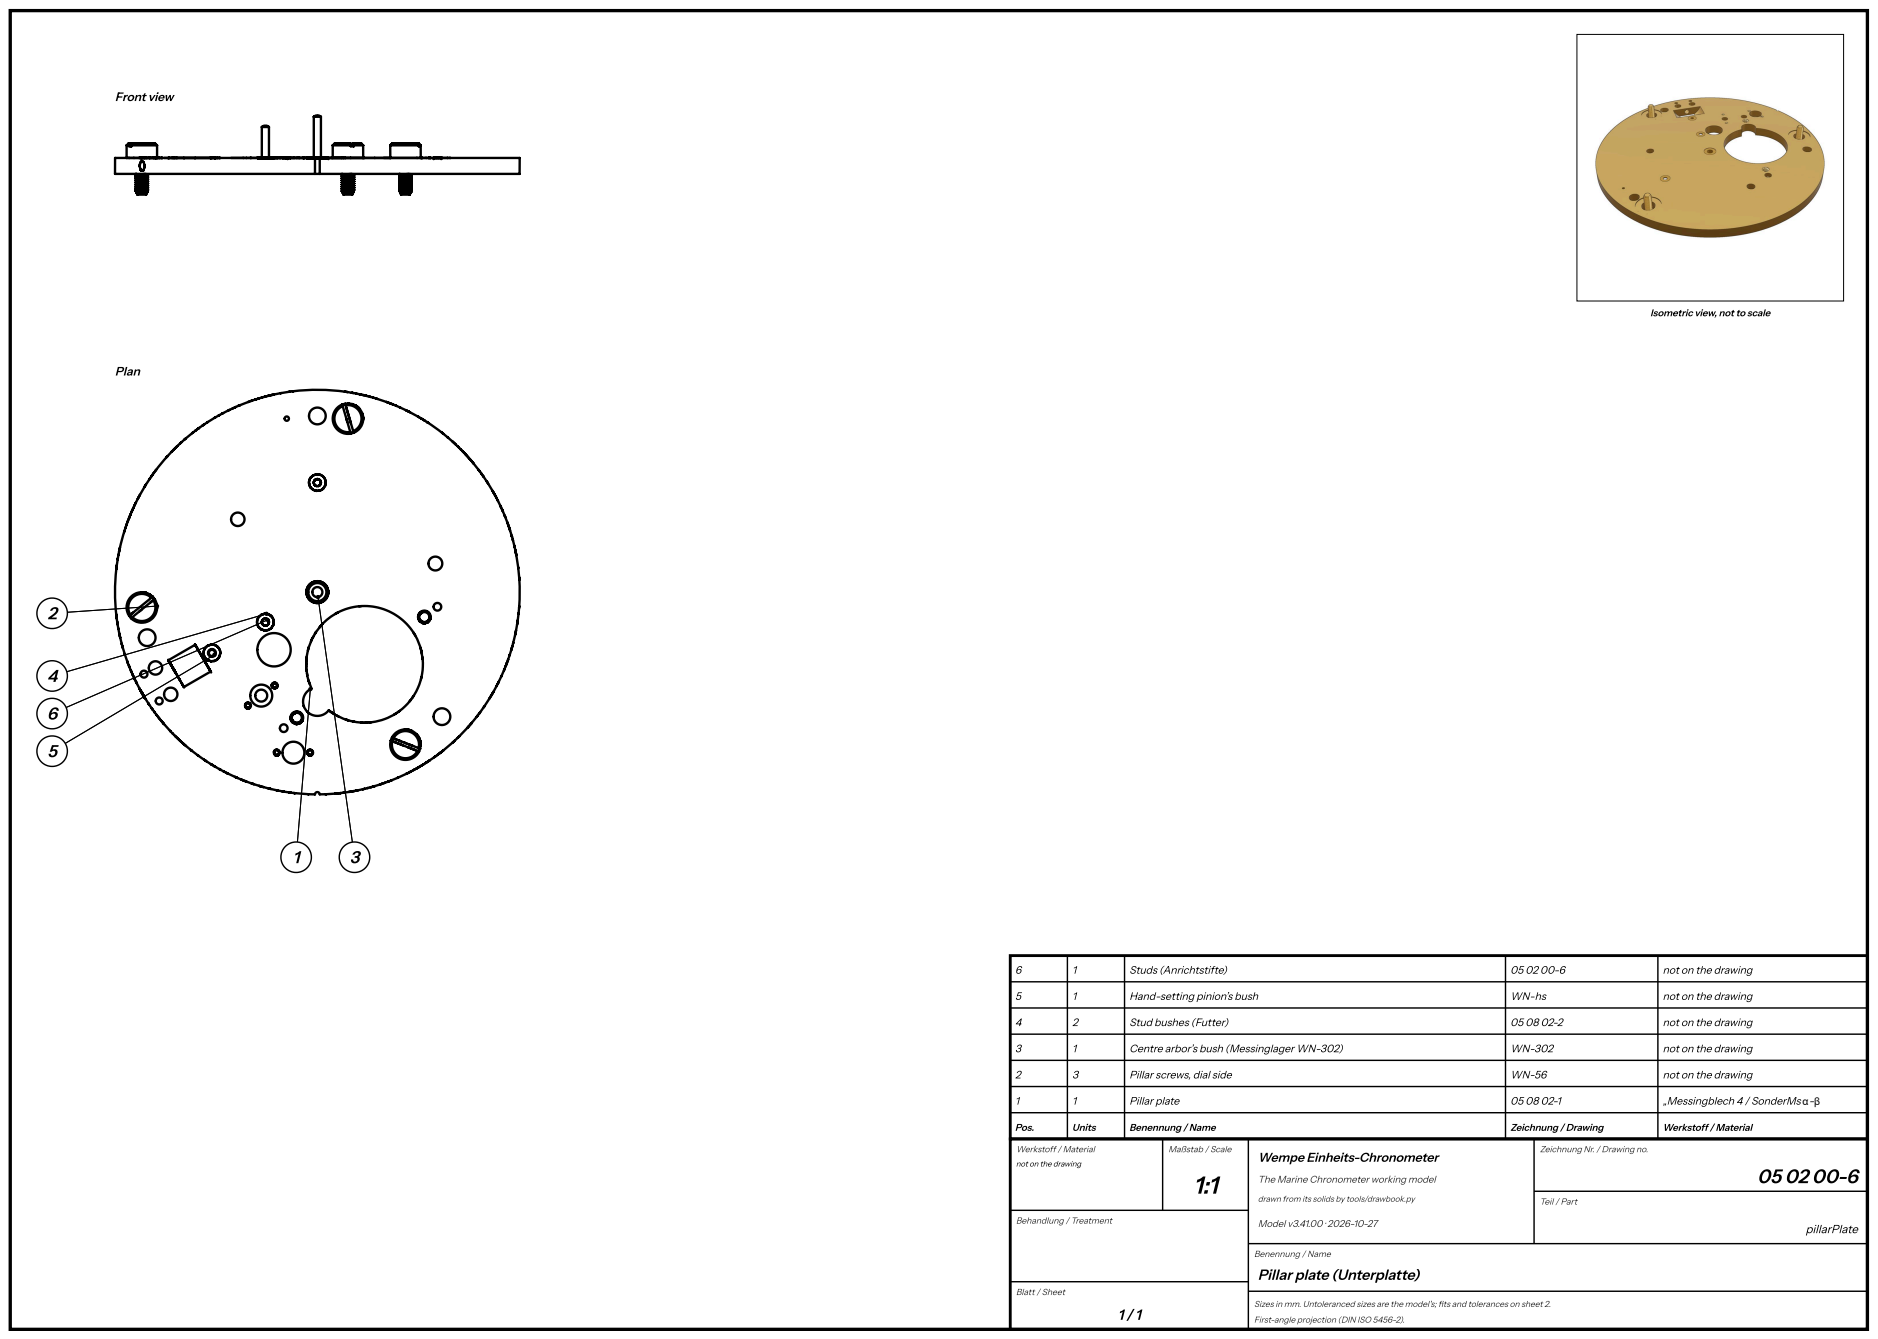
[picture p319: page 4]
Front view; Plan; Pos.; Units; Benennung / Name; Zeichnung / Drawing; Werkstoff / Material; Pillar plate; „Messingblech 4 / SonderMs α-β; Pillar screws, dial side; not on the drawing; Centre arbor’s bush (Messinglager WN-302); Stud bushes (Futter); Hand-setting pinion’s bush; Studs (Anrichtstifte); Maßstab / Scale; Behandlung / Treatment; Blatt / Sheet; Model v3.41.00 · 2026-10-27; Teil / Part; pillarPlate

Isometric view, not to scale

Zeichnung Nr. / Drawing no.

not on the drawing

Wempe Einheits-Chronometer

The Marine Chronometer working model

drawn from its solids by tools/drawbook.py

Benennung / Name
Pillar plate (Unterplatte)

Sizes in mm. Untoleranced sizes are the model's; fits and tolerances on sheet 2.

First-angle projection (DIN ISO 5456-2).

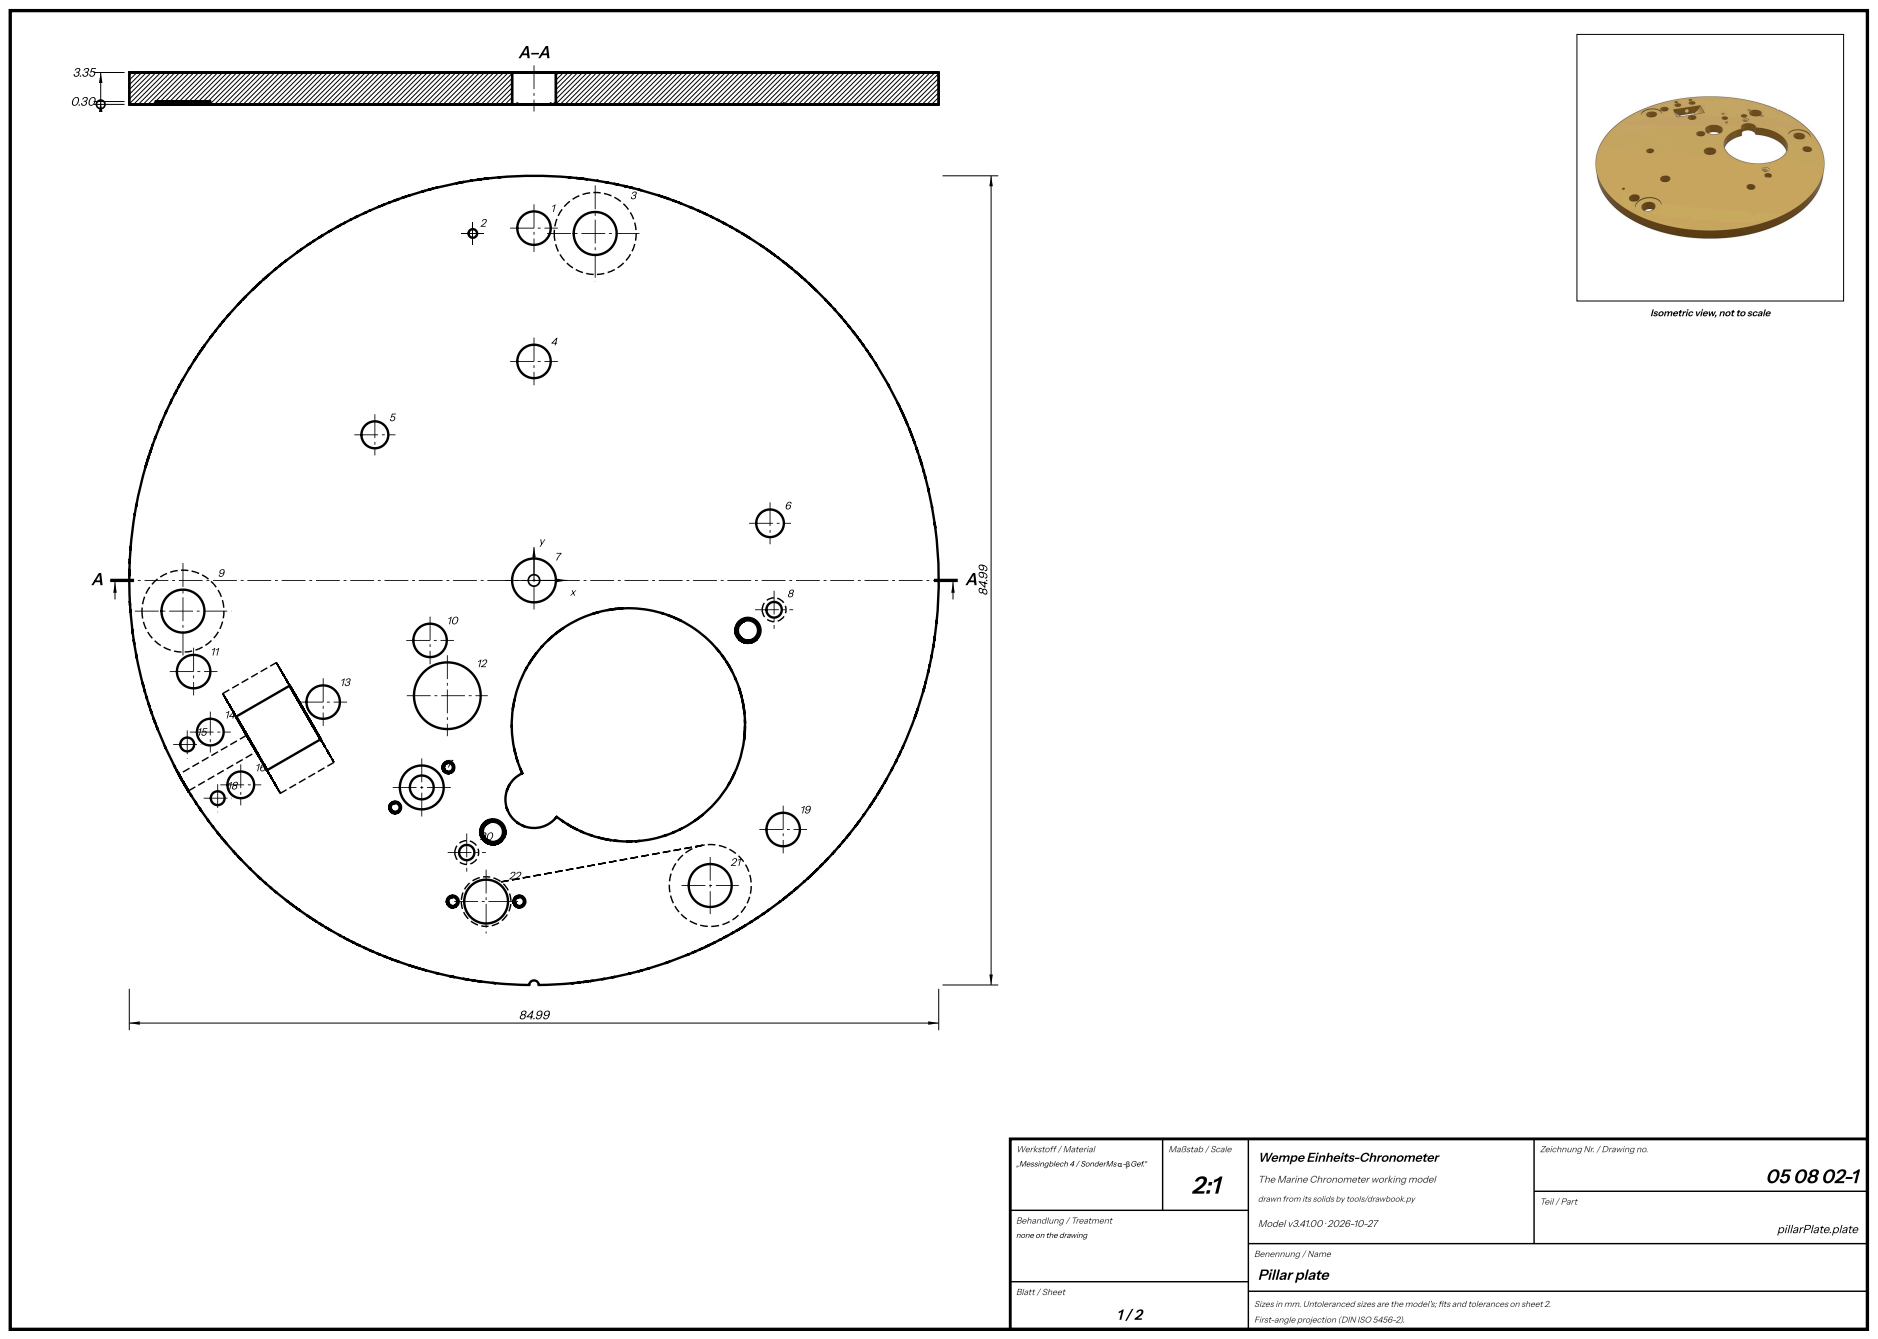
[picture p320: page 5]
Werkstoff / Material; Maßstab / Scale; Behandlung / Treatment; Model v3.41.00 · 2026-10-27; Teil / Part; pillarPlate.plate; Pillar plate

Isometric view, not to scale

Zeichnung Nr. / Drawing no.

„Messingblech 4 / SonderMs α-βGef.“

Wempe Einheits-Chronometer

The Marine Chronometer working model

drawn from its solids by tools/drawbook.py

none on the drawing

## Pillar plate — sheet 2

The lower plate, under the dial: the foundation of the movement. The three pillars stand in seats turned in its inner face,

each held by a screw from the dial side; it sits in the movement ring. It carries the train’s lower pivots, the intermediate

bridge on its dial side across the opening for the intermediate wheel, and the motion work under the dial. Every hole of its

table is cut but the seconds contact’s (“only when needed”). Near its rim at 4 o’clock seen from the dial, the window and

four holes for the hand-setting work, which set the hands from outside the case: its sheet strikes the holes through (“only

when the hand-setting is fitted”), but Wempe 3955’s plate is cut and drilled for it with nothing fitted but the bush in its

pinion’s hole, and so it is drawn. The drawings are the sheets as last revised (about 1946-48).

Parts list

Drawing | Name | Units | Material | Finish, heat treatment | Fit, as measured on the model
05 08 02-1 | Unterplatte (pillar plate) | 1 | „Messingblech 4 / SonderMs α-βGef.“ | none on the drawing | takes Pfeiler (pillar): in it (run): 2.339 mm, least gap 0.0109; Pfeiler (pillar): on it: 0 mm; Werkring (movement ring): on it: 0 mm; Zwischenbrücke (intermediate bridge; its sheet not in the set, the assembly 05 08 04): on it: 0 mm; Futter (stud bush): in it (press): 3.352 mm, least gap 0.0019; Pillar screw, dial side (WN-56, by the coloured section's label): on it: 0 mm; and 12 more

Test on the bench (05 08 02-1). The train's depths, the plates bored and reamed, before the bushes and jewels go in:

Centres 22.650, 18.120, 12.630, 11.850 mm (fusee-centre, centre-intermediate, intermediate-seconds, seconds-escape: the hole tables' coordinates), each within ±25 µm (gearing.js --model wempe: the seconds mesh's window less its pivots'

shake; the tables give the places to 0.001 and no tolerance). A hole that errs should err wide: each mesh takes far more wide than close (-240/+436, -136/+355, -112/+281, -100/+263 µm). Closer than its window less the pivots' shake (220, 101, 62,

50 µm close): re-bush the hole, bored on the drawn centre.

What it does (05 08 02-1). The lower plate, under the dial: the foundation of the movement (its assembly, Unterplatte

kompl., is 05 08 02).

Coordinates from the datum, the movement's centre (marked on the plan), x to the right and y up the plan as drawn;

depths from the face seen in the plan (the top). Thickness 3.35.

Holes

Hole | x | y | Size
1 | 0.00 | 37.00 | Ø 3.51 through
2 | -6.42 | 36.44 | Ø 0.90 through
3 | 6.43 | 36.44 | Ø 4.51 through (3.05 thick at 0.30-3.35); sink Ø 8.60 × 0.30 from the bottom
4 | 0.00 | 23.00 | Ø 3.51 through
5 | -16.71 | 15.29 | Ø 2.82 through
6 | 24.78 | 6.00 | Ø 2.90 through
7 | 0.00 | 0.00 | Ø 4.60 through
8 | 25.21 | -3.08 | Ø 1.60 through (1.49 thick at 1.86-3.35); sink Ø 2.50 × 1.61 from the bottom
9 | -36.86 | -3.23 | Ø 4.51 through (3.05 thick at 0.30-3.35); sink Ø 8.60 × 0.30 from the bottom
10 | -10.91 | -6.30 | Ø 3.51 through
11 | -35.74 | -9.58 | Ø 3.51 through
12 | -9.10 | -12.11 | Ø 7.00 through
13 | -22.14 | -12.78 | Ø 3.51 through
14 | -33.99 | -15.93 | Ø 2.80 through
15 | -36.41 | -17.23 | Ø 1.45 through
16 | -30.79 | -21.47 | Ø 2.80 through
17 | -11.78 | -21.74 | Ø 2.50 through (3.10 thick at 0.00-3.10); sink Ø 4.60 × 0.25 from the top
18 | -33.21 | -22.87 | Ø 1.45 through

19 | 26.16 | -26.16 | Ø 3.51 through
20 | -7.06 | -28.58 | Ø 1.60 through (1.49 thick at 1.86-3.35); sink Ø 2.50 × 1.61 from the bottom
21 | 18.50 | -32.04 | Ø 4.51 through (3.05 thick at 0.30-3.35)
22 | -5.03 | -33.73 | Ø 4.60 through (0.50 thick at 2.85-3.35); sink Ø 5.21 × 2.85 from the bottom

Contourin the plan

The outline and cut-outs as a CNC program runs them: each element from its start to its end, an arc with its centre and

radius.

Contour | # | Element | From x, y | To x, y | Centre x, y | R
Outline | 1 | arc clockwise | -39.80, -14.88 | 0.50, -42.49 | 0.00, 0.00 | 42.49
Outline | 2 | arc anticlockwise | 0.50, -42.49 | -0.50, -42.49 | 0.00, -42.49 | 0.50
Outline | 3 | arc clockwise | -0.50, -42.49 | -36.25, -22.18 | 0.00, 0.00 | 42.49
Outline | 4 | line | -36.25, -22.18 | -36.84, -21.18
Outline | 5 | line | -36.84, -21.18 | -37.34, -20.28
Outline | 6 | arc clockwise | -37.34, -20.28 | -39.80, -14.88 | 0.00, 0.00 | 42.49
Cut-out 5 | 7 | arc anticlockwise | 0.80, -6.98 | -1.23, -20.26 | 9.91, -15.17 | 12.25
Cut-out 5 | 8 | arc anticlockwise | -1.23, -20.26 | 2.38, -24.83 | 0.00, -23.00 | 3.00
Cut-out 5 | 9 | arc anticlockwise | 2.38, -24.83 | 0.80, -6.98 | 9.91, -15.17 | 12.25
Cut-out 24 | 10 | line | -31.28, -14.31 | -28.03, -19.94
Cut-out 24 | 11 | line | -28.03, -19.94 | -22.40, -16.69
Cut-out 24 | 12 | line | -22.40, -16.69 | -25.65, -11.06
Cut-out 24 | 13 | line | -25.65, -11.06 | -31.28, -14.31

Levels

Faces in section A-A, from the bottom face: 0.30, 3.35.

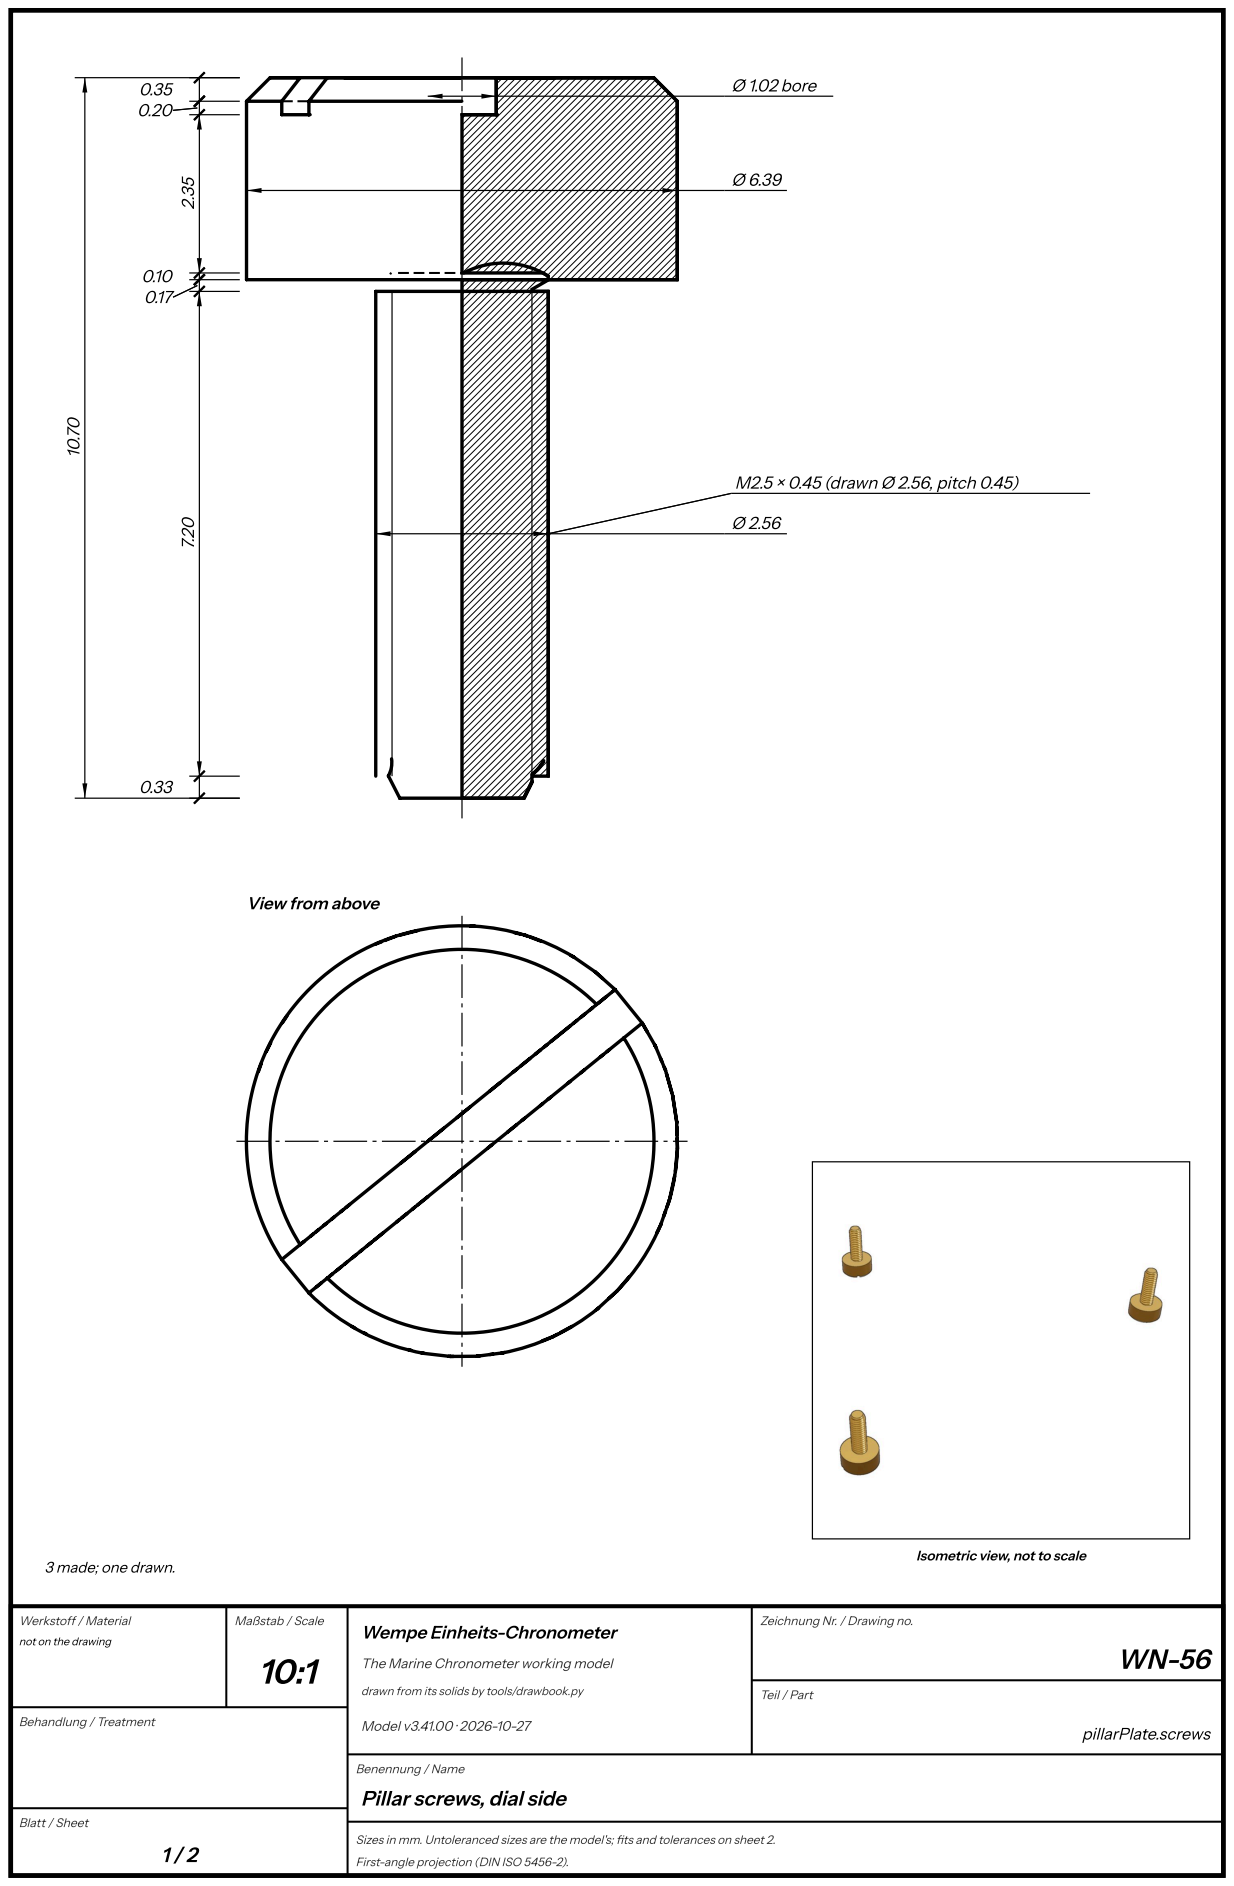
[picture p321: page 8]
Ø 1.02 bore; M2.5 × 0.45 (drawn Ø 2.56, pitch 0.45); Werkstoff / Material; Maßstab / Scale; Behandlung / Treatment; Model v3.41.00 · 2026-10-27; Teil / Part; pillarPlate.screws

View from above

3 made; one drawn.

Isometric view, not to scale

Zeichnung Nr. / Drawing no.

not on the drawing

Wempe Einheits-Chronometer

The Marine Chronometer working model

drawn from its solids by tools/drawbook.py

Pillar screws, dial side

## Pillar screws, dial side — sheet 2

Three pillar screws (WN-56) from the dial side into the pillars’ tapped ends, brass as Wempe 3955’s.

3 made, all alike; the drawing shows one, in its own frame (the holes' and contour's coordinates are that one's).

Parts list

Drawing | Name | Units | Material | Finish, heat treatment | Fit, as measured on the model
WN-56 | Pillar screw, dial side (WN-56, by the coloured section's label) | 3 | not on the drawing | | in 050800-1 (tap): 7.382 mm, least gap 0.0193; on 050802-1: 0 mm

What it does (WN-56). Hold each pillar to the pillar plate, from the dial side.

Turned about its axis; length 10.70, largest Ø 6.40. Diameters: Ø 2.56, Ø 6.39; bores Ø 1.02. Shoulders from the lower end:

0.00, 0.33, 7.53, 7.70, 7.80, 10.15, 10.35, 10.70.

Thread

Outside thread 0.33-7.53 from the lower end, 7.20 long: drawn Ø 2.56 over its crests, 2.08 at its roots, pitch 0.45. Cut the ISO

261 coarse thread nearest it, M2.5 × 0.45, where the part's own sheet gives none (the Wempe-Norm screws' sheets aren't

in the set).

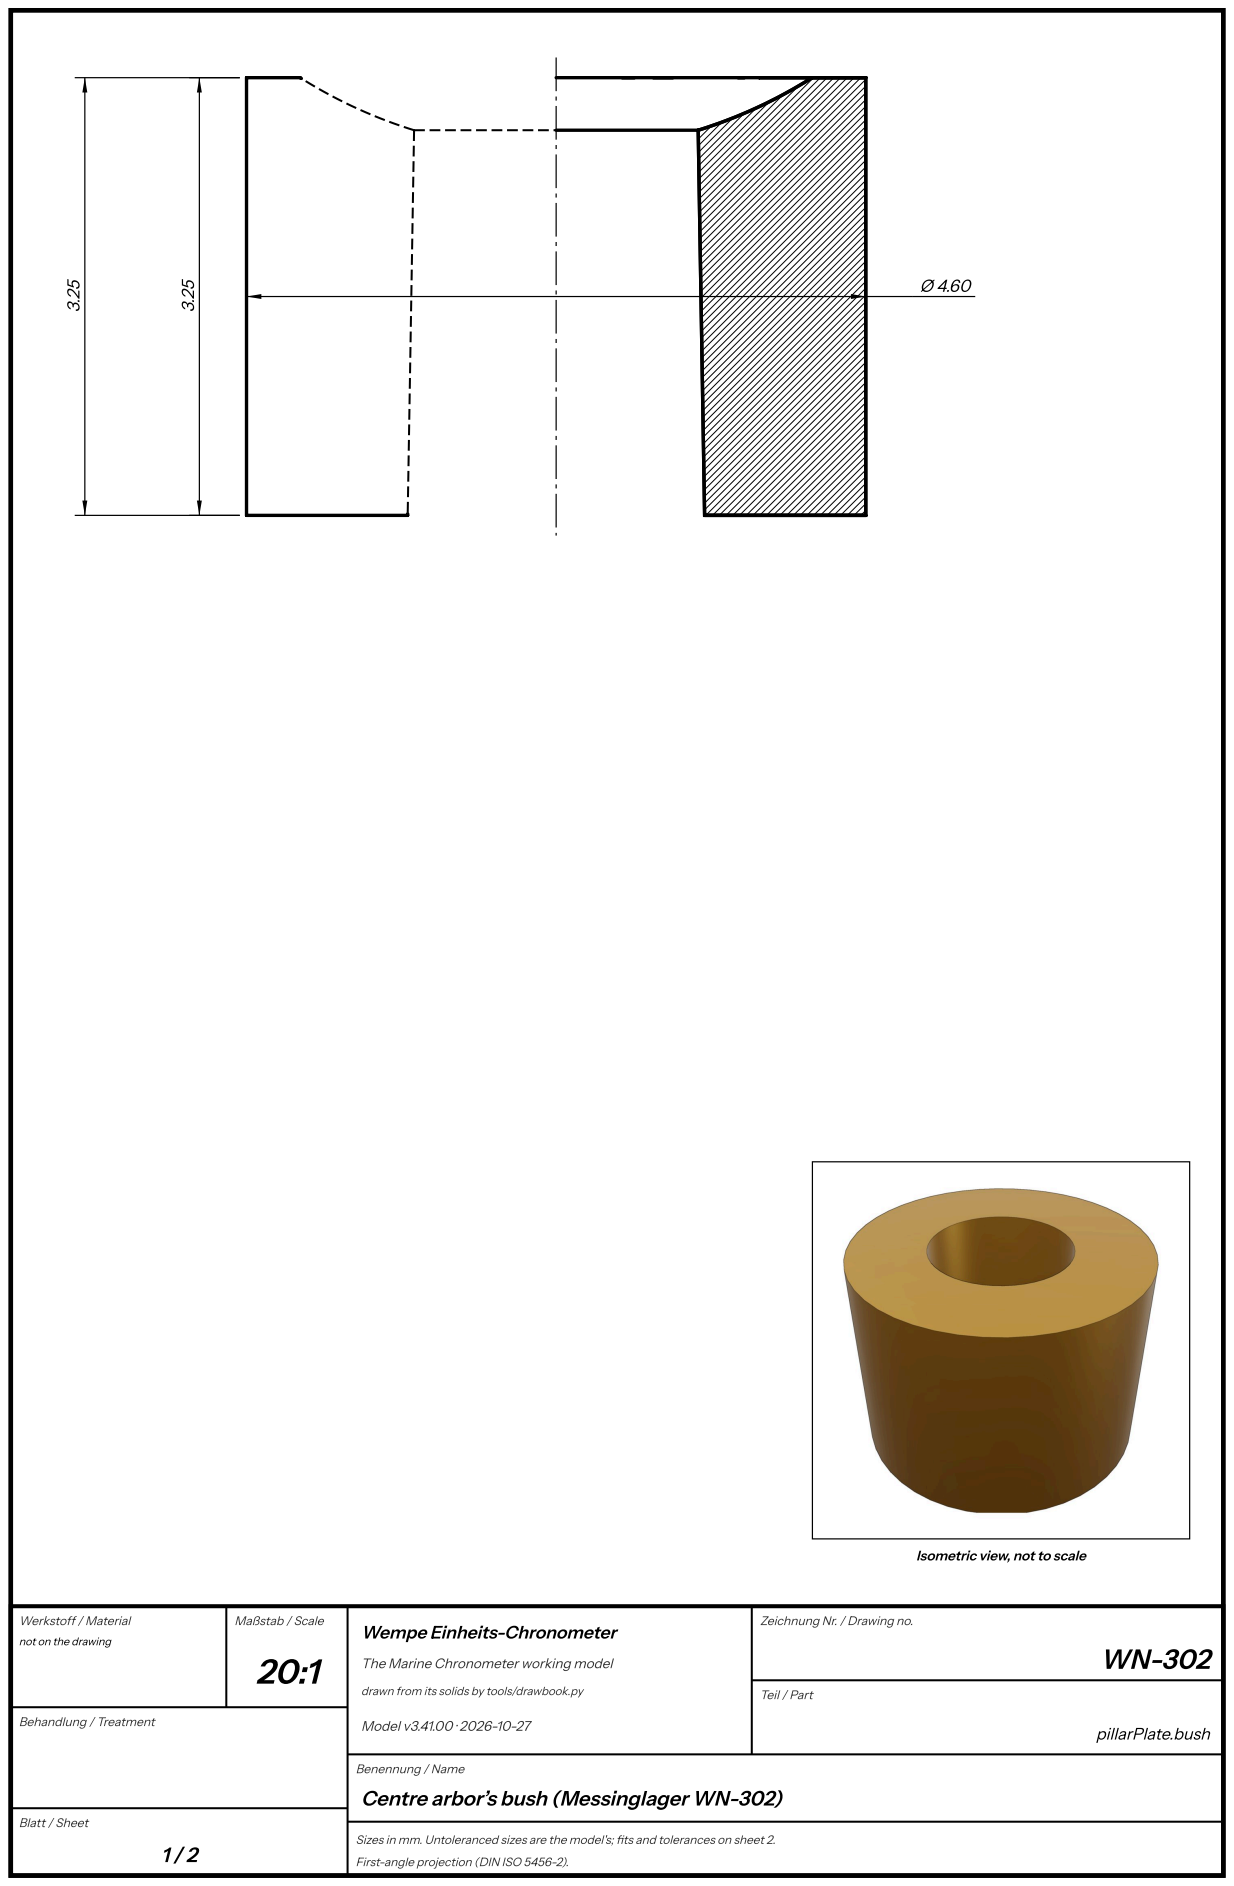
[picture p322: page 10]
Werkstoff / Material; Maßstab / Scale; Behandlung / Treatment; Model v3.41.00 · 2026-10-27; Teil / Part; pillarPlate.bush

Isometric view, not to scale

Zeichnung Nr. / Drawing no.

not on the drawing

Wempe Einheits-Chronometer

The Marine Chronometer working model

drawn from its solids by tools/drawbook.py

Centre arbor’s bush (Messinglager WN-302)

## Centre arbor’s bush (Messinglager WN-302) — sheet 2

A brass bush pressed into the pillar plate, in which the centre arbor’s long journal turns; its inner face is set 0.1 under the

plate’s, and the collar at the end of the centre wheel’s seat bears on it.

Parts list

Drawing | Name | Units | Material | Finish, heat treatment | Fit, as measured on the model
WN-302 | Messinglager WN-302 (brass bush, centre arbor's journal) | 1 | not on the drawing | | in 050802-1 (press): 3.247 mm, least gap 0.0028

What it does (WN-302). The centre arbor's lower bearing, pressed into the pillar plate's hole 1, 0.1 under its inner face.

Turned about its axis; length 3.25, largest Ø 4.60. Diameters: Ø 4.60. Shoulders from the lower end: 0.00, 3.25.

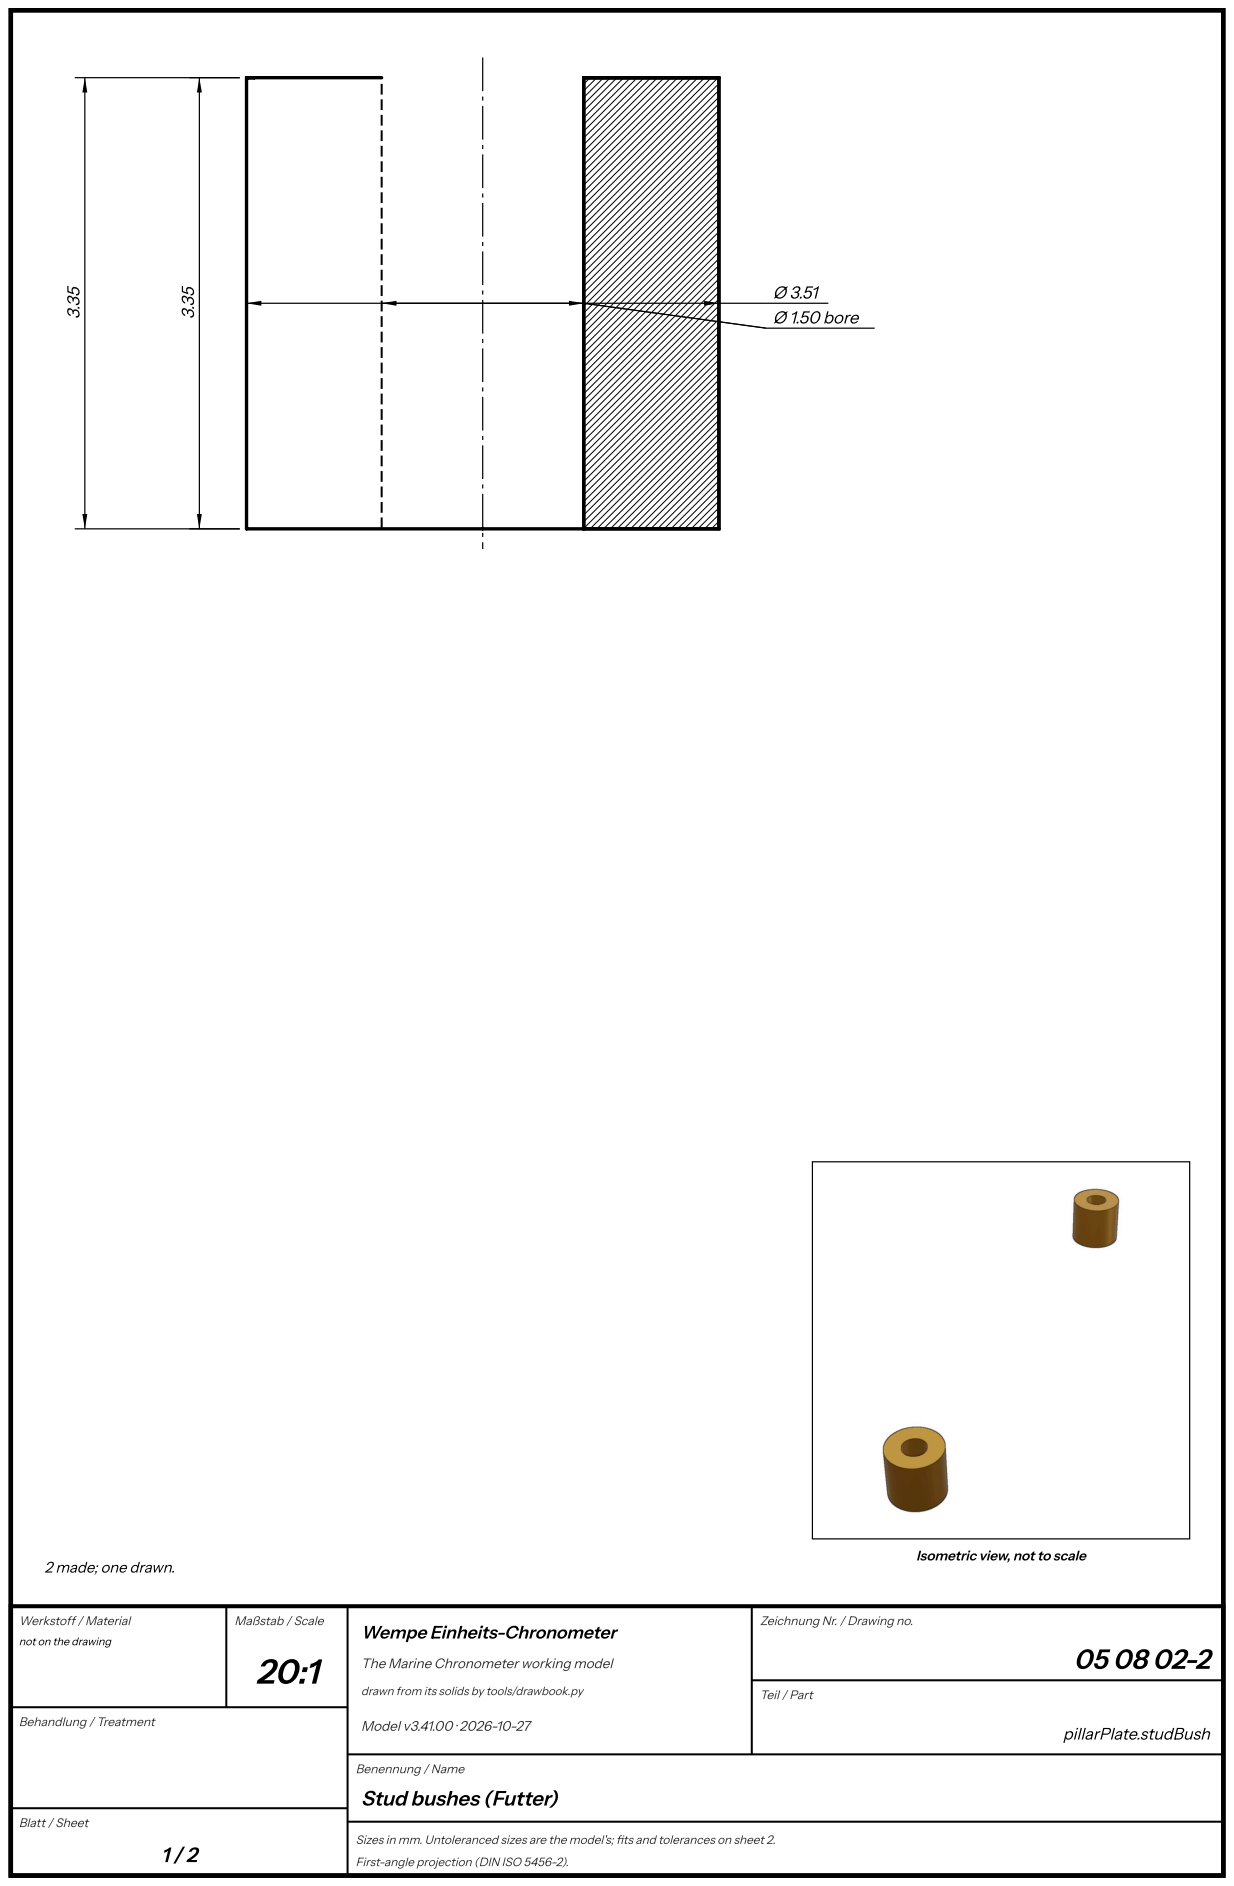
[picture p323: page 12]
Ø 1.50 bore; Werkstoff / Material; Maßstab / Scale; Behandlung / Treatment; Model v3.41.00 · 2026-10-27; Teil / Part; pillarPlate.studBush

2 made; one drawn.

Isometric view, not to scale

Zeichnung Nr. / Drawing no.

not on the drawing

Wempe Einheits-Chronometer

The Marine Chronometer working model

drawn from its solids by tools/drawbook.py

Stud bushes (Futter)

## Stud bushes (Futter) — sheet 2

Two brass bushes pressed into the pillar plate from its inner face, holding the studs on which the up-and-down wheel and

the motion work’s change wheel turn on the dial side.

2 made, all alike; the drawing shows one, in its own frame (the holes' and contour's coordinates are that one's).

Parts list

Drawing | Name | Units | Material | Finish, heat treatment | Fit, as measured on the model
05 08 02-2 | Futter (stud bush) | 2 | not on the drawing | | in 050802-1 (press): 3.352 mm, least gap 0.0019

What it does (05 08 02-2). Pressed into the pillar plate from its inner face at holes 2 and 19, holding the motion work's

studs (the one at 19 drawn dashed on 05 08 02: estimated).

Turned about its axis; length 3.35, largest Ø 3.51. Diameters: Ø 3.51; bores Ø 1.50. Shoulders from the lower end: 0.00, 3.35.

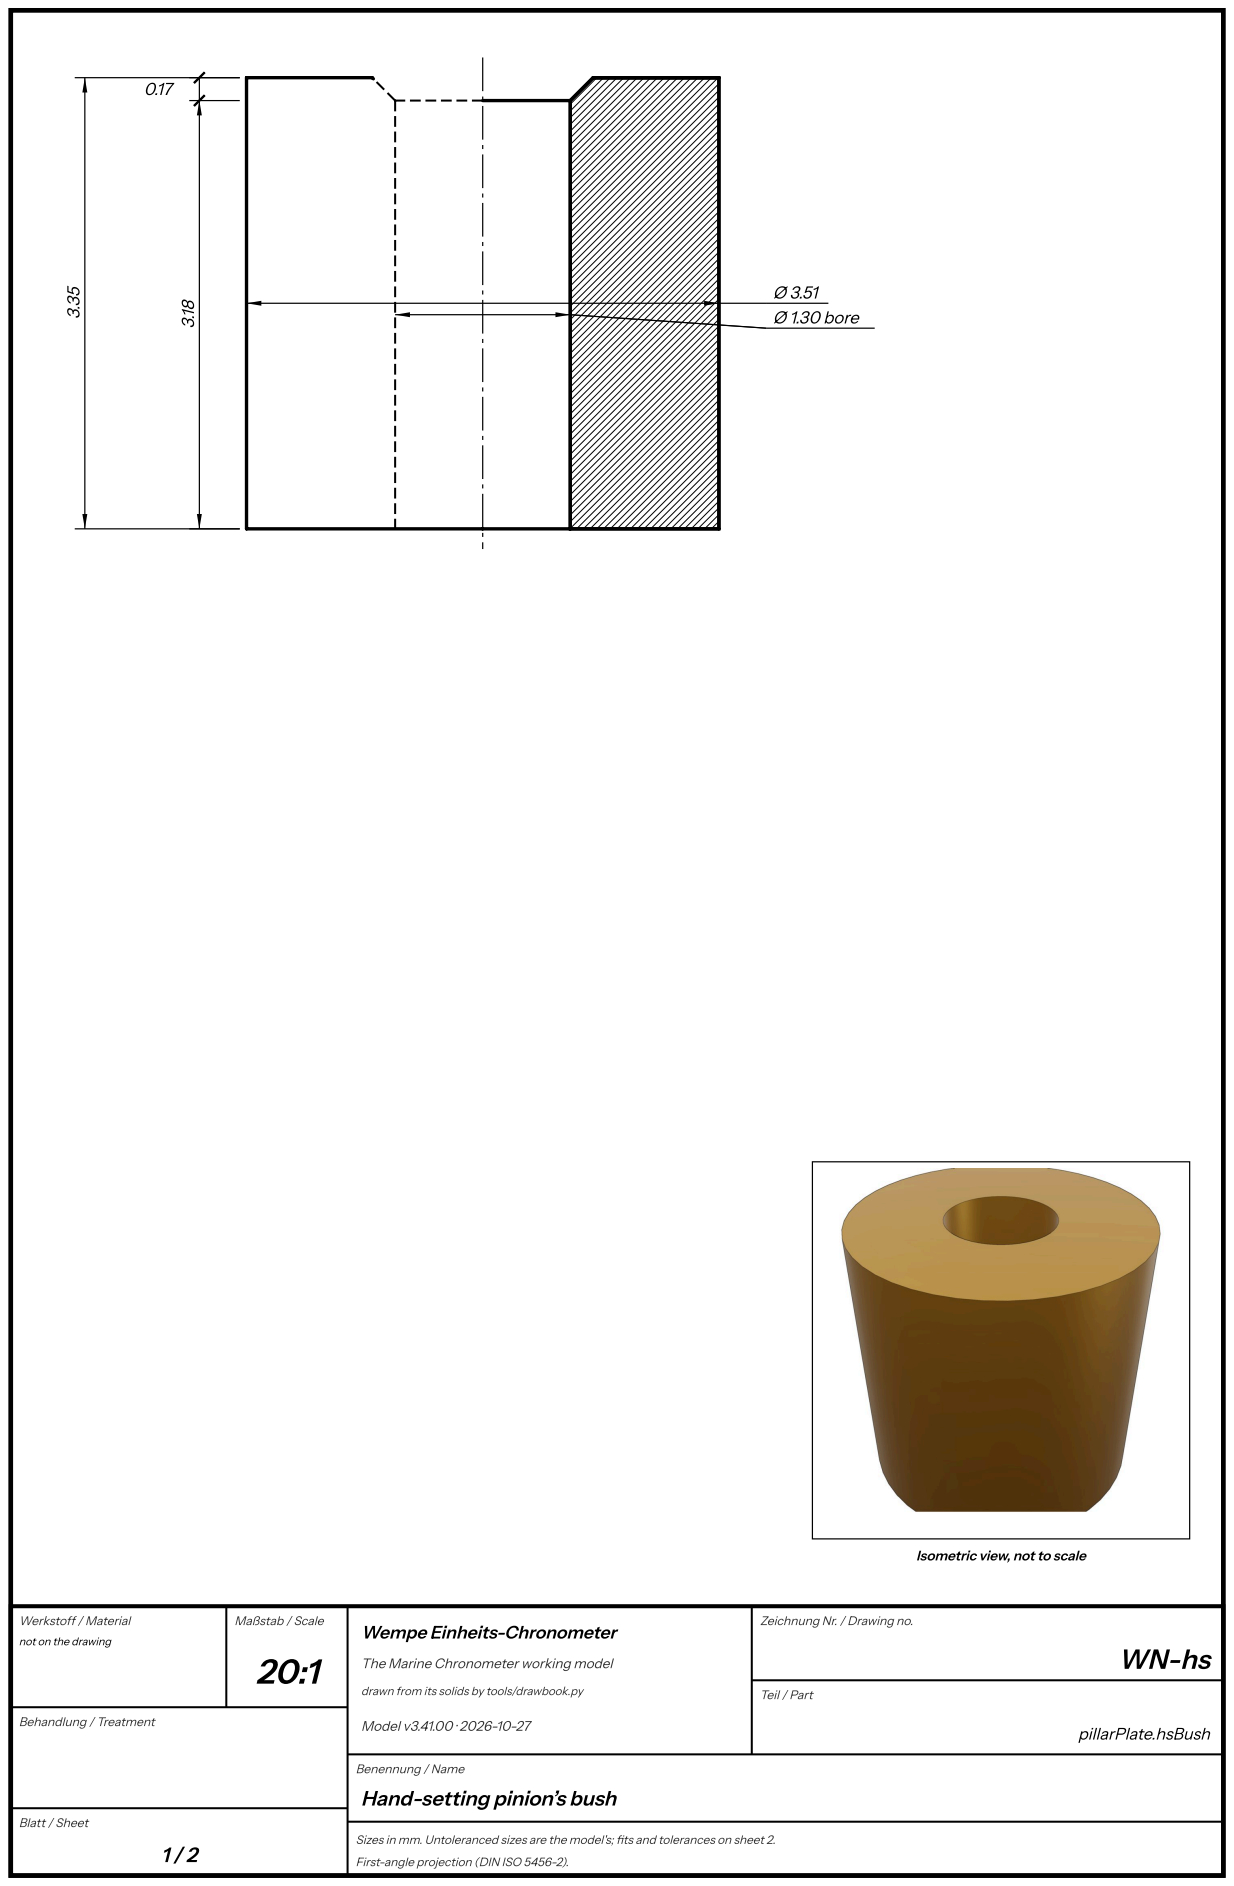
[picture p324: page 14]
Ø 3.51 Ø 1.30 bore 3.18; Werkstoff / Material; Maßstab / Scale; Behandlung / Treatment; Model v3.41.00 · 2026-10-27; Teil / Part; pillarPlate.hsBush

Isometric view, not to scale

Zeichnung Nr. / Drawing no.

not on the drawing

Wempe Einheits-Chronometer

The Marine Chronometer working model

drawn from its solids by tools/drawbook.py

Hand-setting pinion’s bush

## Hand-setting pinion’s bush — sheet 2

A brass bush pressed into the pillar plate’s hole 18, beside the hand-setting window: the bearing of the hand-setting work’s

pinion. On Wempe 3955 it is the only part of that work fitted, and it is empty.

Parts list

Drawing | Name | Units | Material | Finish, heat treatment | Fit, as measured on the model
WN-hs | Bush in hole 18, the hand-setting pinion's (not named on 05 08 02) | 1 | not on the drawing | | in 050802-1 (press): 3.352 mm, least gap 0.0019

What it does (WN-hs). The bearing of the hand-setting work's pinion (Zeigerstelltrieb), pressed into the pillar plate's hole

18; on Wempe 3955 the only part of that work fitted, empty.

Turned about its axis; length 3.35, largest Ø 3.51. Diameters: Ø 3.51; bores Ø 1.30. Shoulders from the lower end: 0.00, 3.18,

3.35.

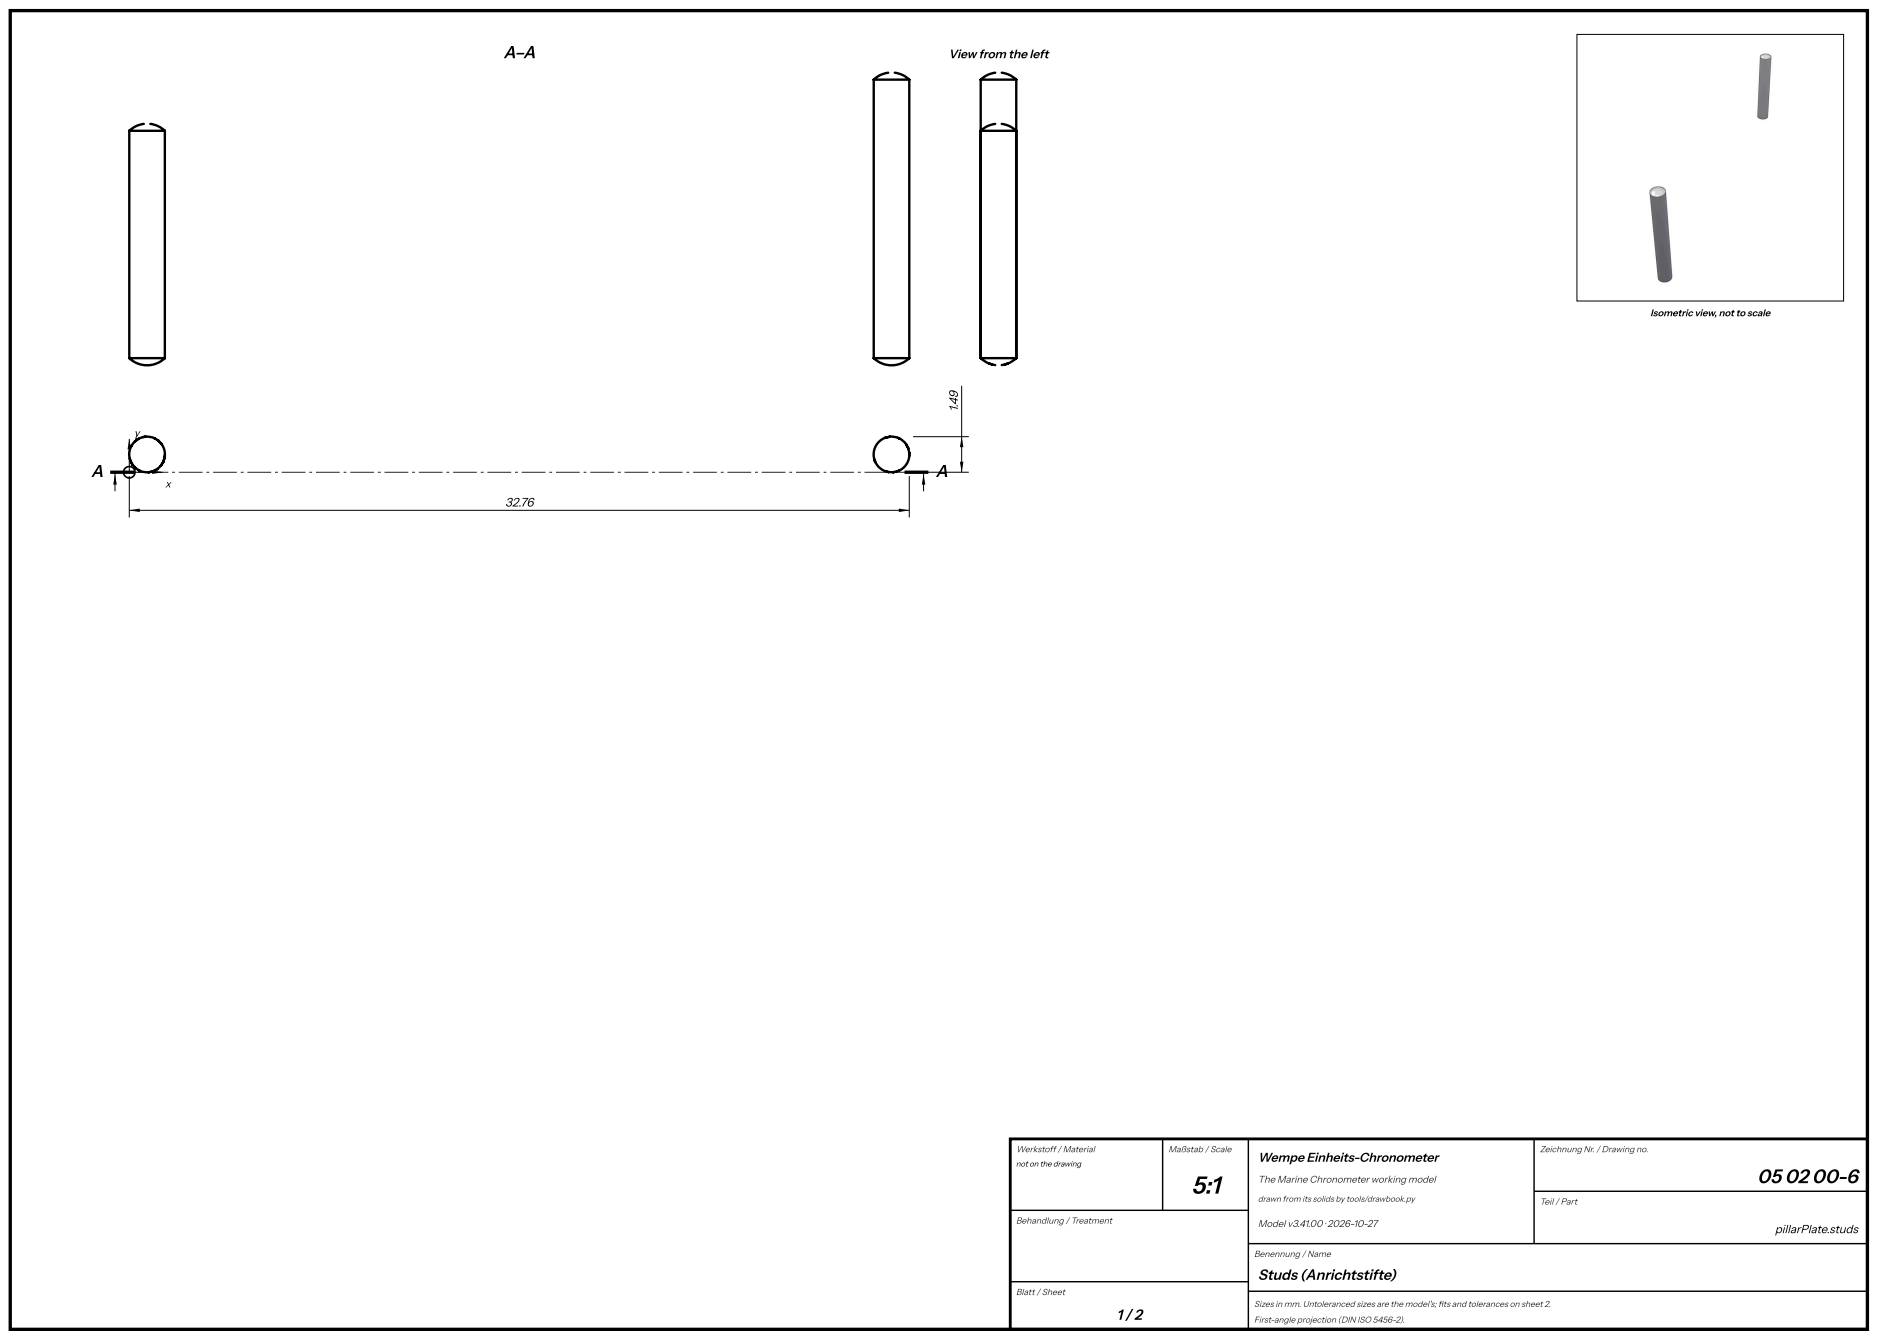
[picture p325: page 16]
Werkstoff / Material; Maßstab / Scale; Behandlung / Treatment; Model v3.41.00 · 2026-10-27; Teil / Part; pillarPlate.studs; Studs (Anrichtstifte)

View from the left

Isometric view, not to scale

Zeichnung Nr. / Drawing no.

not on the drawing

Wempe Einheits-Chronometer

The Marine Chronometer working model

drawn from its solids by tools/drawbook.py

## Studs (Anrichtstifte) — sheet 2

Two steel studs pressed into the bushes: the long one, at 12 o’clock, carries the up-and-down wheel; the short one the

change wheel of the motion work.

Parts list

Drawing | Name | Units | Material | Finish, heat treatment | Fit, as measured on the model
05 02 00-6 | Anrichtstift lg (long stud) | 1 | not on the drawing | | in 050802-2 (press): 3.132 mm, least gap 0.0014
05 02 00-7 | Anrichtstift kurz (short stud) | 1 | not on the drawing | | in 050802-2 (press): 3.087 mm, least gap 0.0014

What it does (05 02 00-6). The up-and-down wheel's stud, at hole 2, 12.3 long from the plate's inner face.

What it does (05 02 00-7). The motion work's change wheel's stud, at hole 19, 6.8 out of the plate's dial face.

Coordinates from the datum, the corner of its bounding box (marked on the plan), x to the right and y up the plan as

drawn; depths from the face seen in the plan (the top). Thickness 12.30.

Contourin the plan

The outline and cut-outs as a CNC program runs them: each element from its start to its end, an arc with its centre and

radius.

Contour | # | Element | From x, y | To x, y | Centre x, y | R
Outline | 1 | circle | | | 32.01, 0.75 | 0.75
Outline | 2 | circle | | | 0.75, 0.75 | 0.75

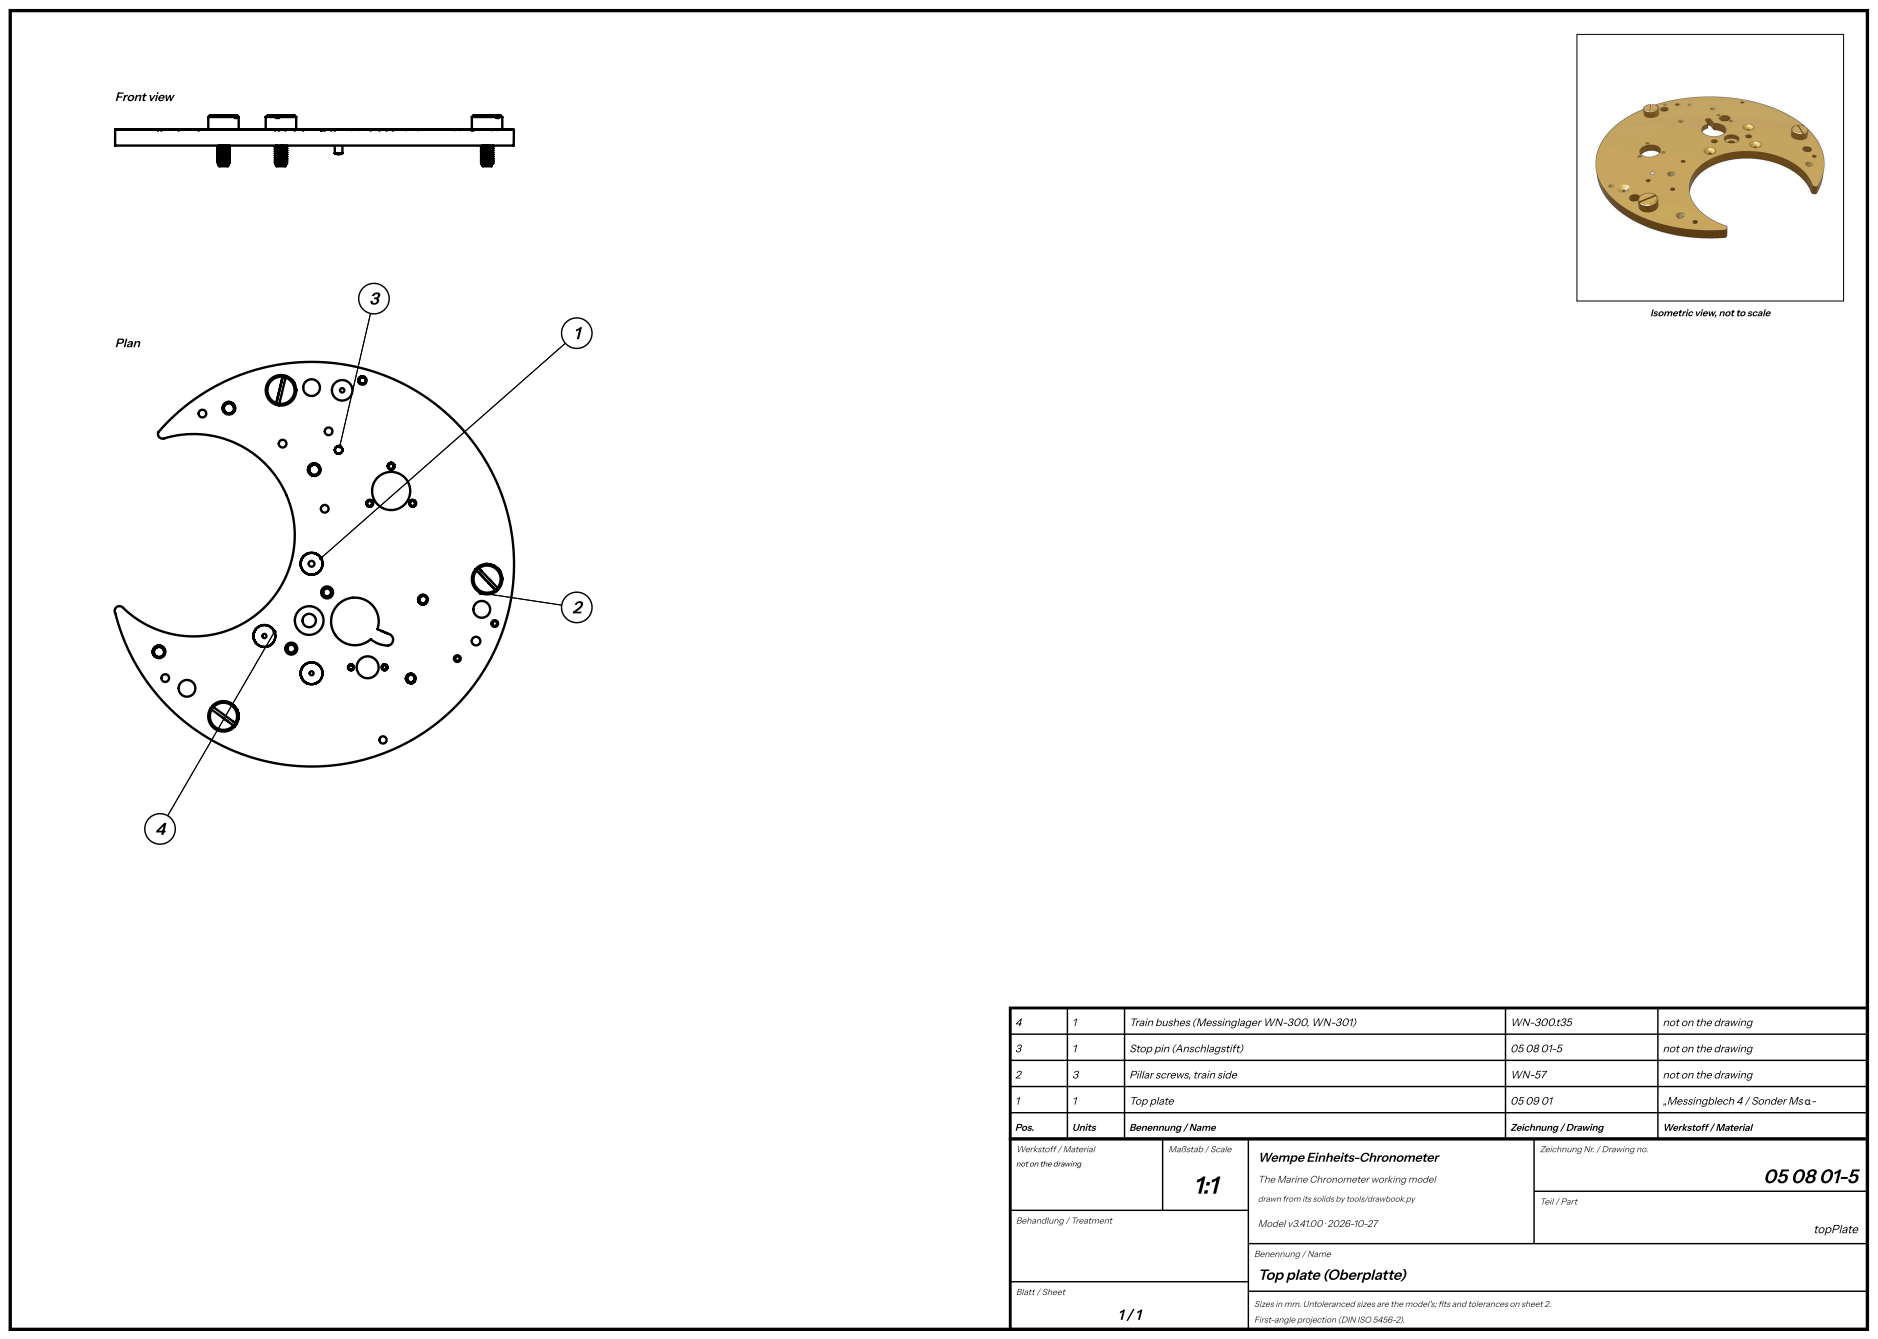
[picture p326: page 18]
Front view; Plan; Pos.; Units; Benennung / Name; Zeichnung / Drawing; Werkstoff / Material; Top plate; „Messingblech 4 / Sonder Ms α-; Pillar screws, train side; not on the drawing; Stop pin (Anschlagstift); Train bushes (Messinglager WN-300, WN-301); Maßstab / Scale; Behandlung / Treatment; Model v3.41.00 · 2026-10-27; Teil / Part; topPlate

Isometric view, not to scale

Zeichnung Nr. / Drawing no.

not on the drawing

Wempe Einheits-Chronometer

The Marine Chronometer working model

drawn from its solids by tools/drawbook.py

Top plate (Oberplatte)

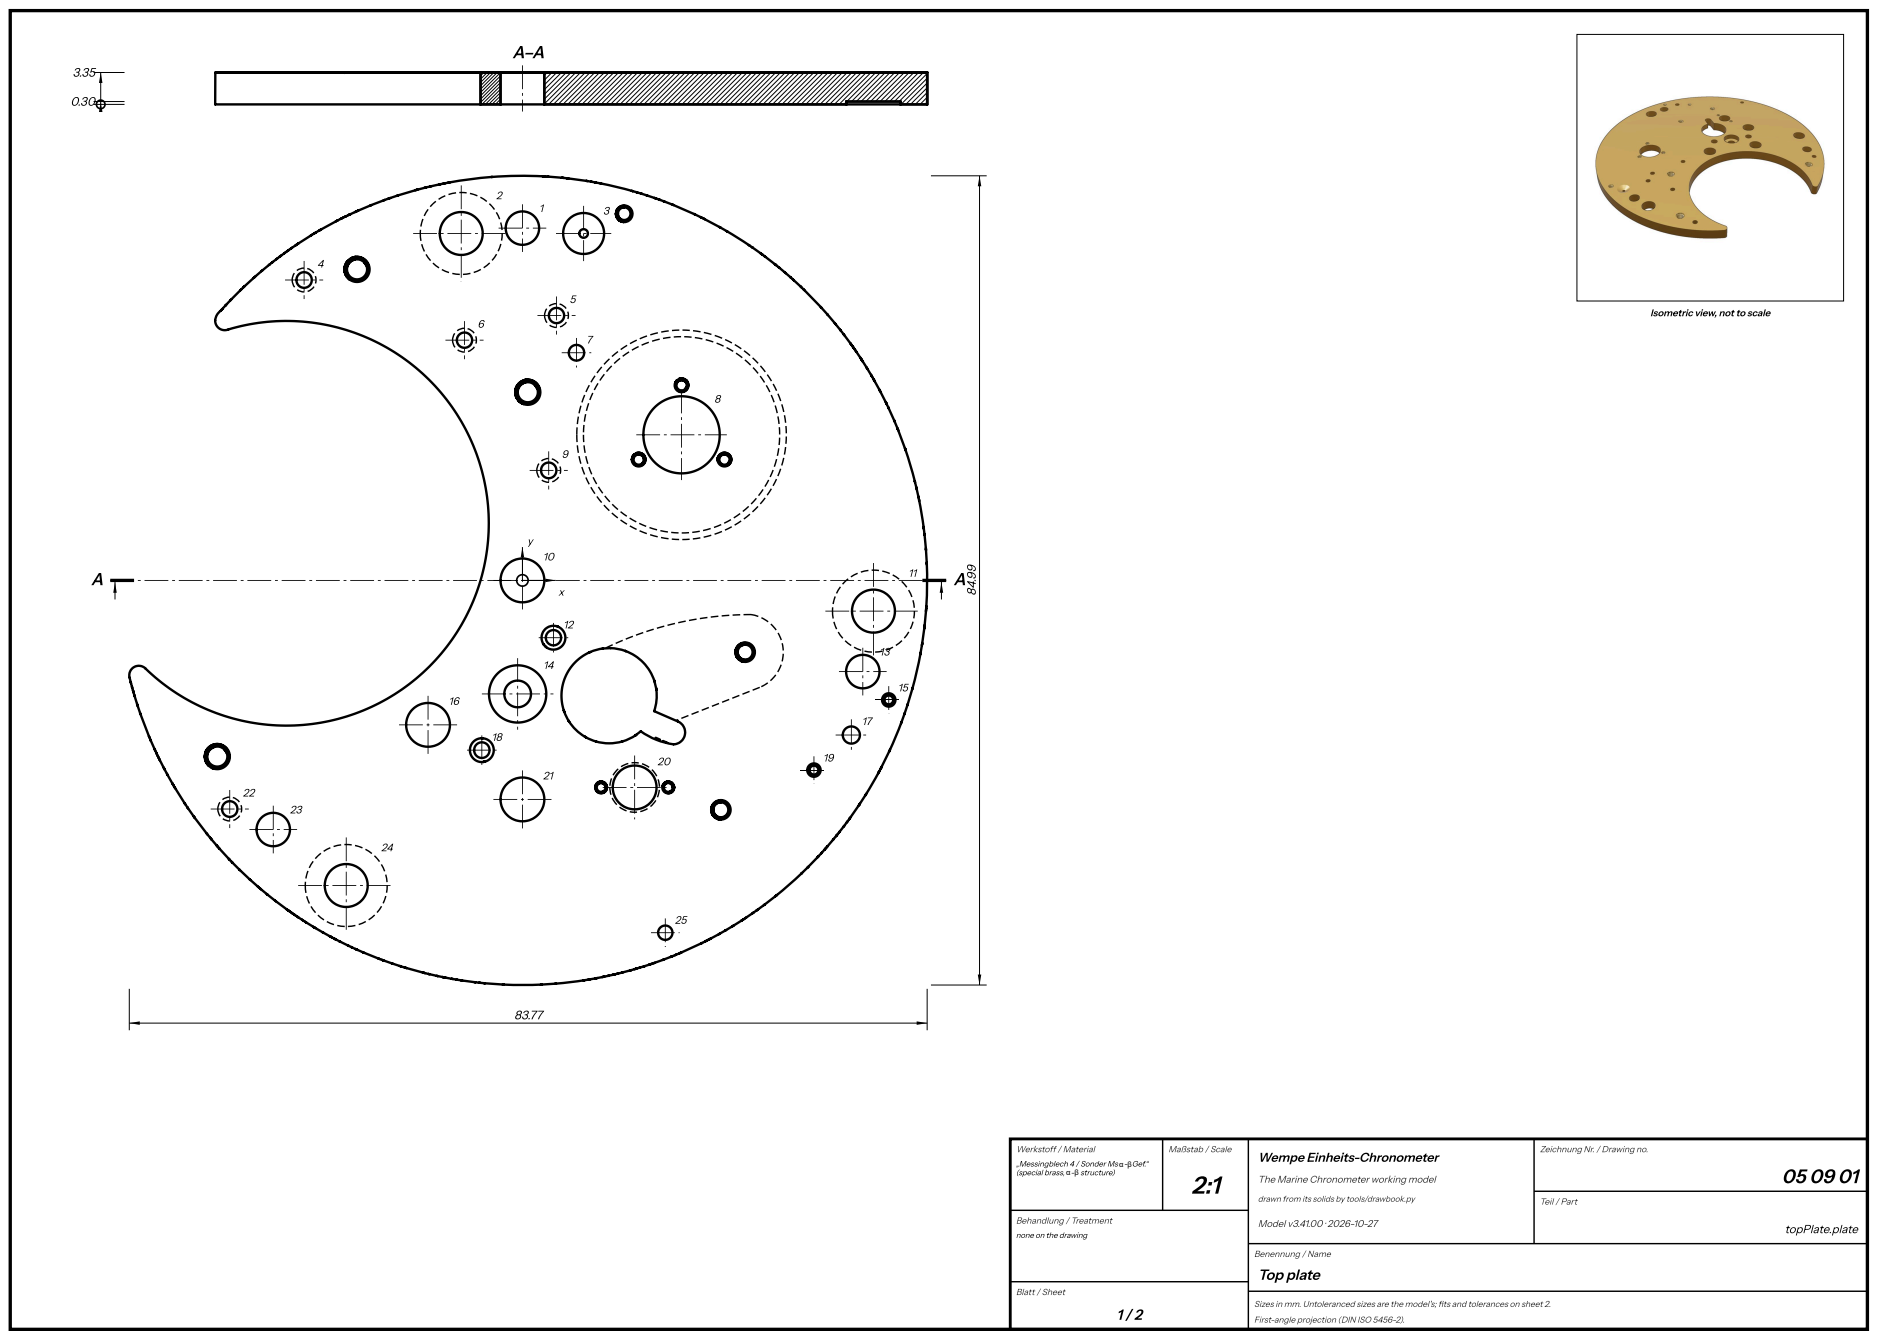
[picture p327: page 19]
Werkstoff / Material; Maßstab / Scale; Behandlung / Treatment; Model v3.41.00 · 2026-10-27; Teil / Part; topPlate.plate; Top plate

Isometric view, not to scale

Zeichnung Nr. / Drawing no.

„Messingblech 4 / Sonder Ms α-βGef.“
(special brass, α-β structure)

Wempe Einheits-Chronometer

The Marine Chronometer working model

drawn from its solids by tools/drawbook.py

none on the drawing

## Top plate — sheet 2

The upper plate, on the train side, a crescent: it is cut away round the barrel, which the barrel bridge holds. It carries the

train’s upper pivots, the fusee’s bush, the two balance cocks (the lower one hangs under it) and the balance holding work in

a pocket in its inner face. Its auxiliary holes 3, 12 and 40 stand beside the pillars. The drawings are the sheets as last revised

(about 1946-48).

Parts list

Drawing | Name | Units | Material | Finish, heat treatment | Fit, as measured on the model
05 09 01 | Oberplatte (top plate) | 1 | „Messingblech 4 / Sonder Ms α-βGef.“ (special brass, α-β structure) | none on the drawing | takes Pfeiler (pillar): in it (run): 2.339 mm, least gap 0.0109; Pfeiler (pillar): on it: 0 mm; Federhausbrücke (barrel bridge): on it: 0 mm; Schneckenfutter (fusee bush): in it (free): 2.579 mm, least gap 0.009; Schneckenfutter (fusee bush): on it: 0 mm; Unruhkloben oben (upper balance cock): on it: 0 mm; and 22 more

Test on the bench (05 09 01). The train's depths, the plates bored and reamed, before the bushes and jewels go in:

Centres 22.650, 18.120, 12.630, 11.850 mm (fusee-centre, centre-intermediate, intermediate-seconds, seconds-escape: the hole tables' coordinates), each within ±25 µm (gearing.js --model wempe: the seconds mesh's window less its pivots'

shake; the tables give the places to 0.001 and no tolerance). A hole that errs should err wide: each mesh takes far more wide than close (-240/+436, -136/+355, -112/+281, -100/+263 µm). Closer than its window less the pivots' shake (220, 101, 62,

50 µm close): re-bush the hole, bored on the drawn centre.

What it does (05 09 01). The upper plate, on the train side (its sheet's title block numbers it 05 09 01; its assembly,

Oberplatte kompl., is 05 08 01).

Coordinates from the datum, the movement's centre (marked on the plan), x to the right and y up the plan as drawn;

depths from the face seen in the plan (the top). Thickness 3.35.

Holes

Hole | x | y | Size
1 | 0.00 | 37.00 | Ø 3.51 through
2 | -6.43 | 36.44 | Ø 4.51 through (3.05 thick at 0.30-3.35); sink Ø 8.60 × 0.30 from the bottom
3 | 6.43 | 36.44 | Ø 0.90 through (2.41 thick at 0.00-2.41); countersunk to Ø 4.30
4 | -22.92 | 31.55 | Ø 1.60 through (1.49 thick at 1.86-3.35); sink Ø 2.50 × 1.61 from the bottom
5 | 3.58 | 27.82 | Ø 1.60 through (1.49 thick at 1.86-3.35); sink Ø 2.50 × 1.61 from the bottom
6 | -6.08 | 25.23 | Ø 1.60 through (1.49 thick at 1.86-3.35); sink Ø 2.50 × 1.61 from the bottom
7 | 5.68 | 23.91 | Ø 1.60 through
8 | 16.71 | 15.29 | Ø 8.01 through (2.65 thick at 0.70-3.35)
9 | 2.76 | 11.56 | Ø 1.60 through (1.49 thick at 1.86-3.35); sink Ø 2.50 × 1.61 from the bottom
10 | 0.00 | 0.00 | Ø 4.60 through
11 | 36.86 | -3.22 | Ø 4.51 through (3.05 thick at 0.30-3.35); sink Ø 8.60 × 0.30 from the bottom
12 | 3.26 | -6.02 | Ø 1.60 through (1.49 thick at 0.00-1.49)
13 | 35.74 | -9.58 | Ø 3.51 through
14 | -0.50 | -11.92 | Ø 2.80 through (1.55 thick at 0.00-1.55); sink Ø 6.01 × 1.80 from the top
15 | 38.46 | -12.55 | Ø 0.93 through (3.13 thick at 0.00-3.13); countersunk to Ø 1.40
16 | -9.91 | -15.17 | Ø 4.60 through
17 | 34.54 | -16.24 | Ø 1.80 through
18 | -4.26 | -17.83 | Ø 1.60 through (1.49 thick at 0.00-1.49)
19 | 30.61 | -19.92 | Ø 0.92 through (3.13 thick at 0.00-3.13); countersunk to Ø 1.40
20 | 11.78 | -21.74 | Ø 4.60 through (0.50 thick at 2.85-3.35); sink Ø 5.21 × 2.85 from the bottom
21 | 0.00 | -23.00 | Ø 4.60 through

22 | -30.73 | -24.01 | Ø 1.60 through (1.49 thick at 1.86-3.35); sink Ø 2.50 × 1.61 from the bottom
23 | -26.16 | -26.16 | Ø 3.51 through
24 | -18.50 | -32.04 | Ø 4.51 through (3.05 thick at 0.30-3.35); sink Ø 8.60 × 0.30 from the bottom
25 | 15.00 | -37.00 | Ø 1.50 through

Contourin the plan

The outline and cut-outs as a CNC program runs them: each element from its start to its end, an arc with its centre and

radius.

Contour | # | Element | From x, y | To x, y | Centre x, y | R
Outline | 1 | arc clockwise | -35.18, -23.84 | -41.28, -10.06 | -0.08, -0.04 | 42.40
Outline | 2 | arc clockwise | -41.28, -10.06 | -39.58, -9.25 | -40.28, -9.97 | 1.00
Outline | 3 | arc anticlockwise | -39.58, -9.25 | -30.97, 26.33 | -24.78, 6.00 | 21.25
Outline | 4 | arc clockwise | -30.97, 26.33 | -32.01, 27.94 | -31.26, 27.29 | 1.00
Outline | 5 | arc clockwise | -32.01, 27.94 | -35.18, -23.84 | 0.00, 0.00 | 42.49
Cut-out 6 | 6 | line | 24.39, -7.39 | 24.39, -7.39
Cut-out 6 | 7 | line | 24.39, -7.39 | 24.39, -7.39
Cut-out 6 | 8 | line | 24.39, -7.39 | 24.39, -7.39
Cut-out 6 | 9 | line | 24.39, -7.39 | 24.39, -7.39
Cut-out 7 | 10 | line | 24.39, -7.59 | 24.39, -7.59
Cut-out 7 | 11 | line | 24.39, -7.59 | 24.39, -7.59
Cut-out 7 | 12 | line | 24.39, -7.59 | 24.39, -7.59
Cut-out 7 | 13 | line | 24.39, -7.59 | 24.39, -7.59
Cut-out 9 | 14 | line | 23.83, -6.63 | 23.83, -6.63
Cut-out 9 | 15 | line | 23.83, -6.63 | 23.83, -6.63
Cut-out 9 | 16 | line | 23.83, -6.63 | 23.83, -6.63
Cut-out 9 | 17 | line | 23.83, -6.63 | 23.83, -6.63
Cut-out 10 | 18 | arc anticlockwise | 23.65, -6.56 | 23.65, -6.56 | 12.09, -3.42 | 11.99
Cut-out 10 | 19 | arc anticlockwise | 23.65, -6.56 | 23.65, -6.56 | 12.08, -3.42 | 11.99
Cut-out 11 | 20 | arc anticlockwise | 23.64, -8.52 | 23.64, -8.52 | 12.12, -4.26 | 12.29
Cut-out 11 | 21 | arc anticlockwise | 23.64, -8.52 | 23.64, -8.52 | 12.12, -4.26 | 12.29
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
Cut-out 36 | 79 | arc anticlockwise | 13.83, -13.73 | 9.41, -7.12 | 9.10, -12.11 | 5.00
Cut-out 37 | 80 | arc anticlockwise | 17.02, 19.56 | 17.02, 19.56 | 8.81, 9.77 | 12.77
Cut-out 37 | 81 | arc anticlockwise | 17.02, 19.56 | 17.02, 19.56 | 8.81, 9.77 | 12.77
Cut-out 38 | 82 | arc anticlockwise | 17.01, 19.56 | 17.01, 19.56 | 8.81, 9.78 | 12.77
Cut-out 38 | 83 | arc anticlockwise | 17.01, 19.56 | 17.01, 19.56 | 8.81, 9.78 | 12.77

Levels

Faces in section A-A, from the bottom face: 0.30, 3.35.

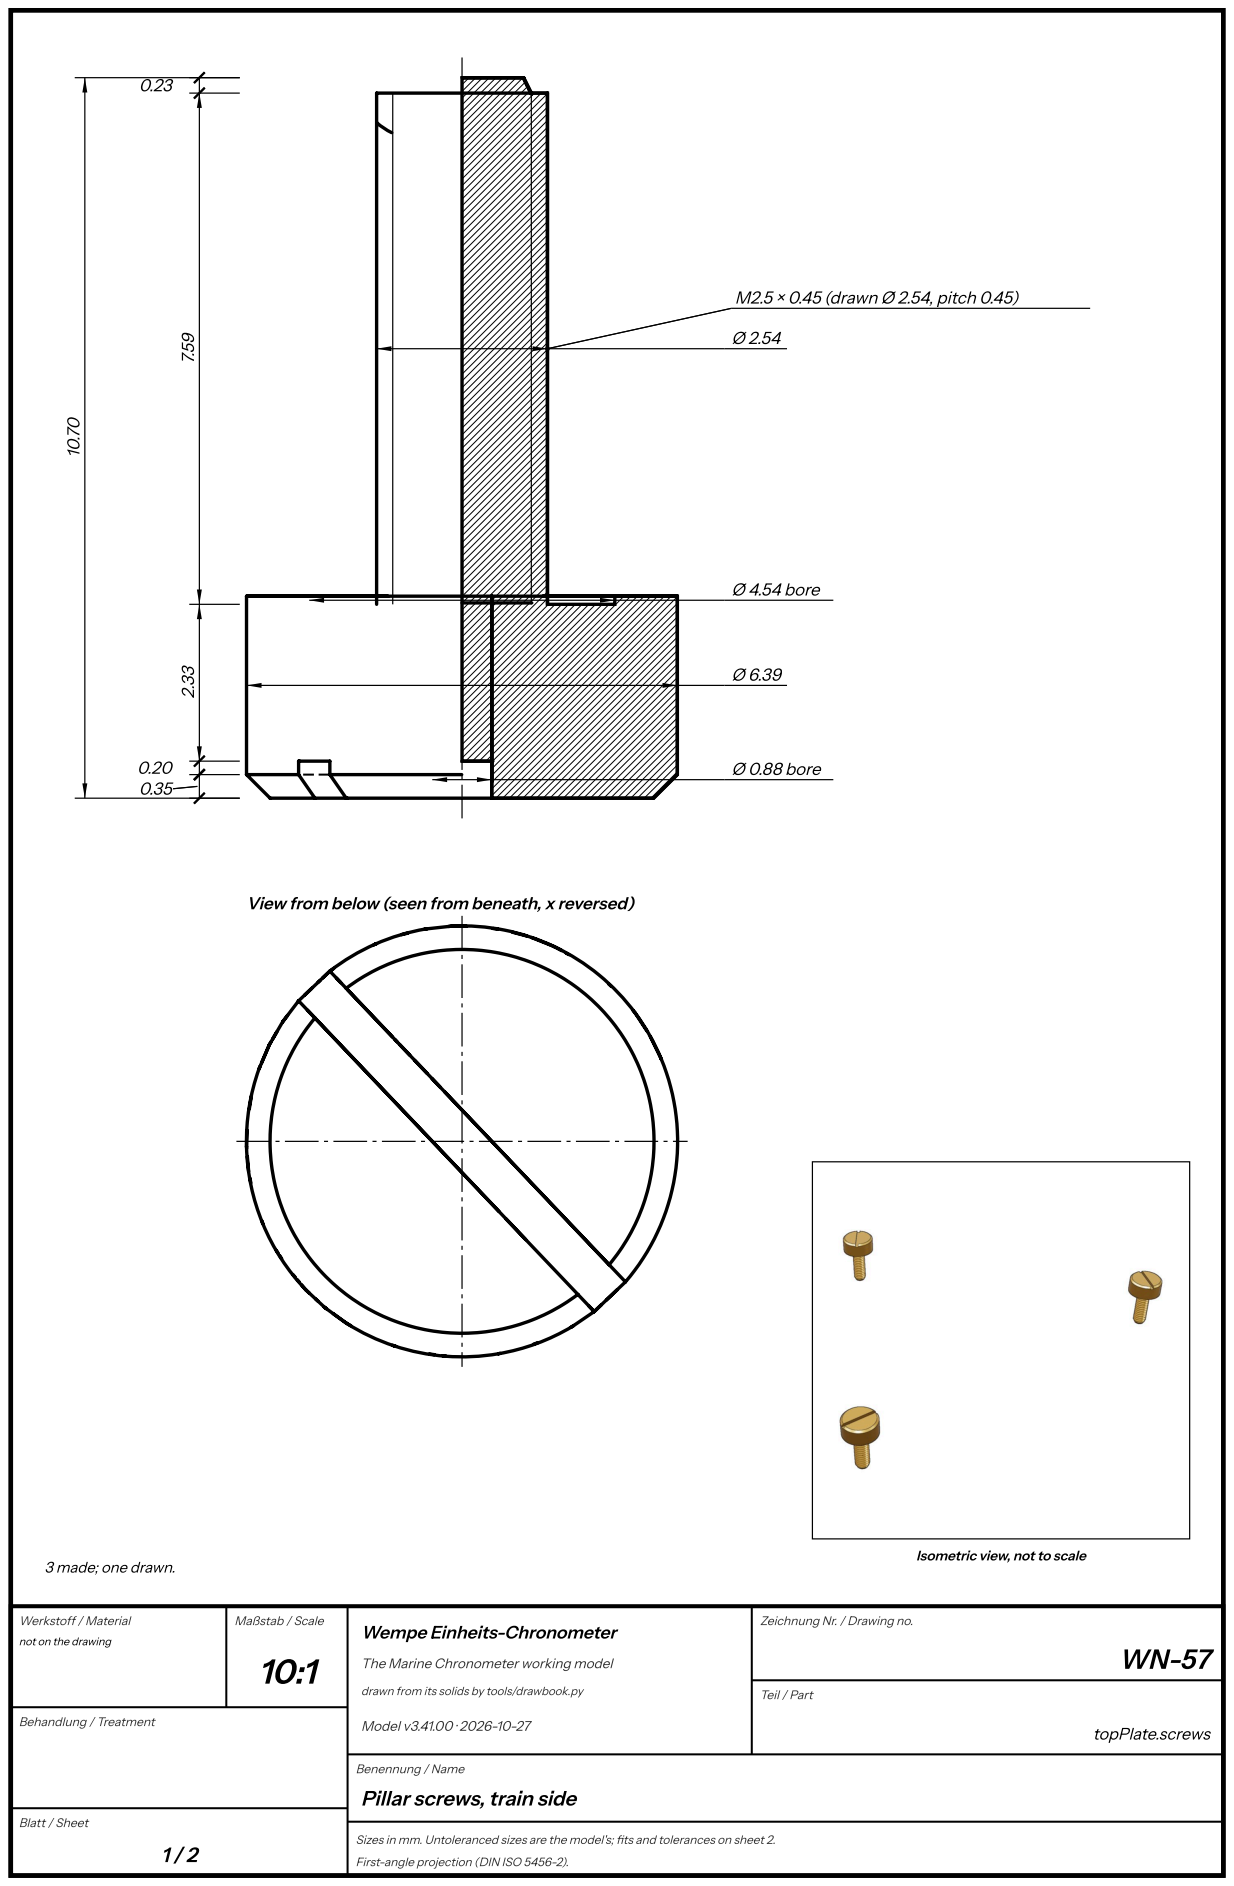
[picture p328: page 24]
Ø 4.54 bore; Ø 0.88 bore; M2.5 × 0.45 (drawn Ø 2.54, pitch 0.45); Werkstoff / Material; Maßstab / Scale; Behandlung / Treatment; Model v3.41.00 · 2026-10-27; Teil / Part; topPlate.screws

View from below (seen from beneath, x reversed)

3 made; one drawn.

Isometric view, not to scale

Zeichnung Nr. / Drawing no.

not on the drawing

Wempe Einheits-Chronometer

The Marine Chronometer working model

drawn from its solids by tools/drawbook.py

Pillar screws, train side

## Pillar screws, train side — sheet 2

Three pillar screws (WN-57) from the top plate’s outer face into the pillars’ tapped ends, brass as Wempe 3955’s.

3 made, all alike; the drawing shows one, in its own frame (the holes' and contour's coordinates are that one's).

Parts list

Drawing | Name | Units | Material | Finish, heat treatment | Fit, as measured on the model
WN-57 | Pillar screw, train side (WN-57, by the coloured section's label) | 3 | not on the drawing | | in 050800-1 (tap): 7.382 mm, least gap 0.0285; on 050901: 0 mm

What it does (WN-57). Hold the top plate to each pillar, from its outer face.

Turned about its axis; length 10.70, largest Ø 6.40. Diameters: Ø 2.54, Ø 6.39; bores Ø 0.88, Ø 4.54. Shoulders from the

lower end: 0.00, 0.35, 0.55, 2.88, 10.47, 10.70.

Thread

Outside thread 2.88-10.47 from the lower end, 7.59 long: drawn Ø 2.54 over its crests, 2.06 at its roots, pitch 0.45. Cut the

ISO 261 coarse thread nearest it, M2.5 × 0.45, where the part's own sheet gives none (the Wempe-Norm screws' sheets

aren't in the set).

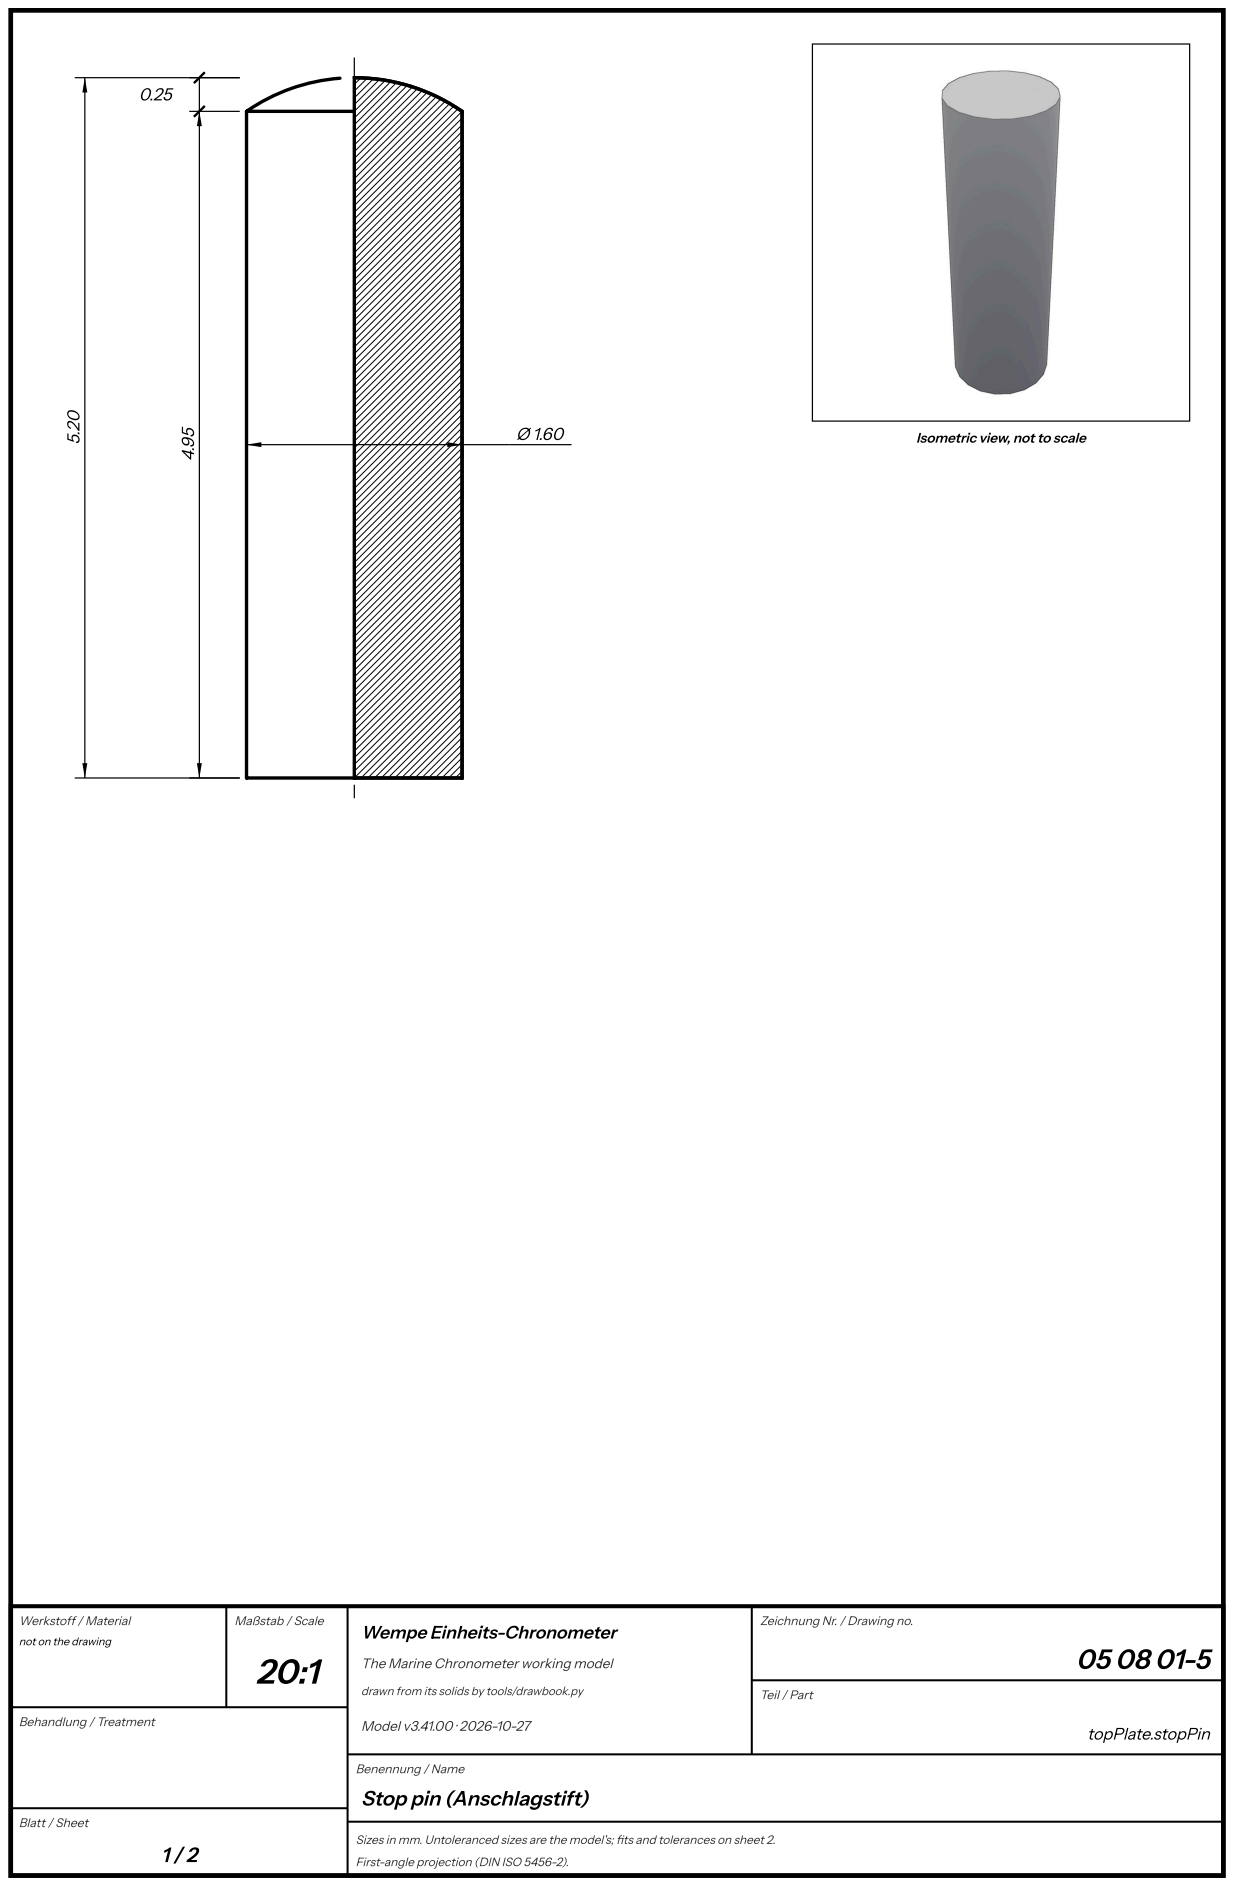
[picture p329: page 26]
Werkstoff / Material; Maßstab / Scale; Behandlung / Treatment; Model v3.41.00 · 2026-10-27; Teil / Part; topPlate.stopPin

Isometric view, not to scale

Zeichnung Nr. / Drawing no.

not on the drawing

Wempe Einheits-Chronometer

The Marine Chronometer working model

drawn from its solids by tools/drawbook.py

Stop pin (Anschlagstift)

## Stop pin (Anschlagstift) — sheet 2

A steel pin in the top plate’s hole 7, standing out under the plate (“unten vorstehend”): the fusee’s stop bar meets it at full

wind.

Parts list

Drawing | Name | Units | Material | Finish, heat treatment | Fit, as measured on the model
05 08 01-5 | Anschlagstift (stop pin) | 1 | not on the drawing | | in 050901 (press): 3.339 mm, least gap 0.0036

What it does (05 08 01-5). Pressed in the top plate's hole 7, standing out under it: the stop bar meets it at full wind.

Turned about its axis; length 5.20, largest Ø 1.60. Diameters: Ø 1.60. Shoulders from the lower end: 0.00, 4.95, 5.20.

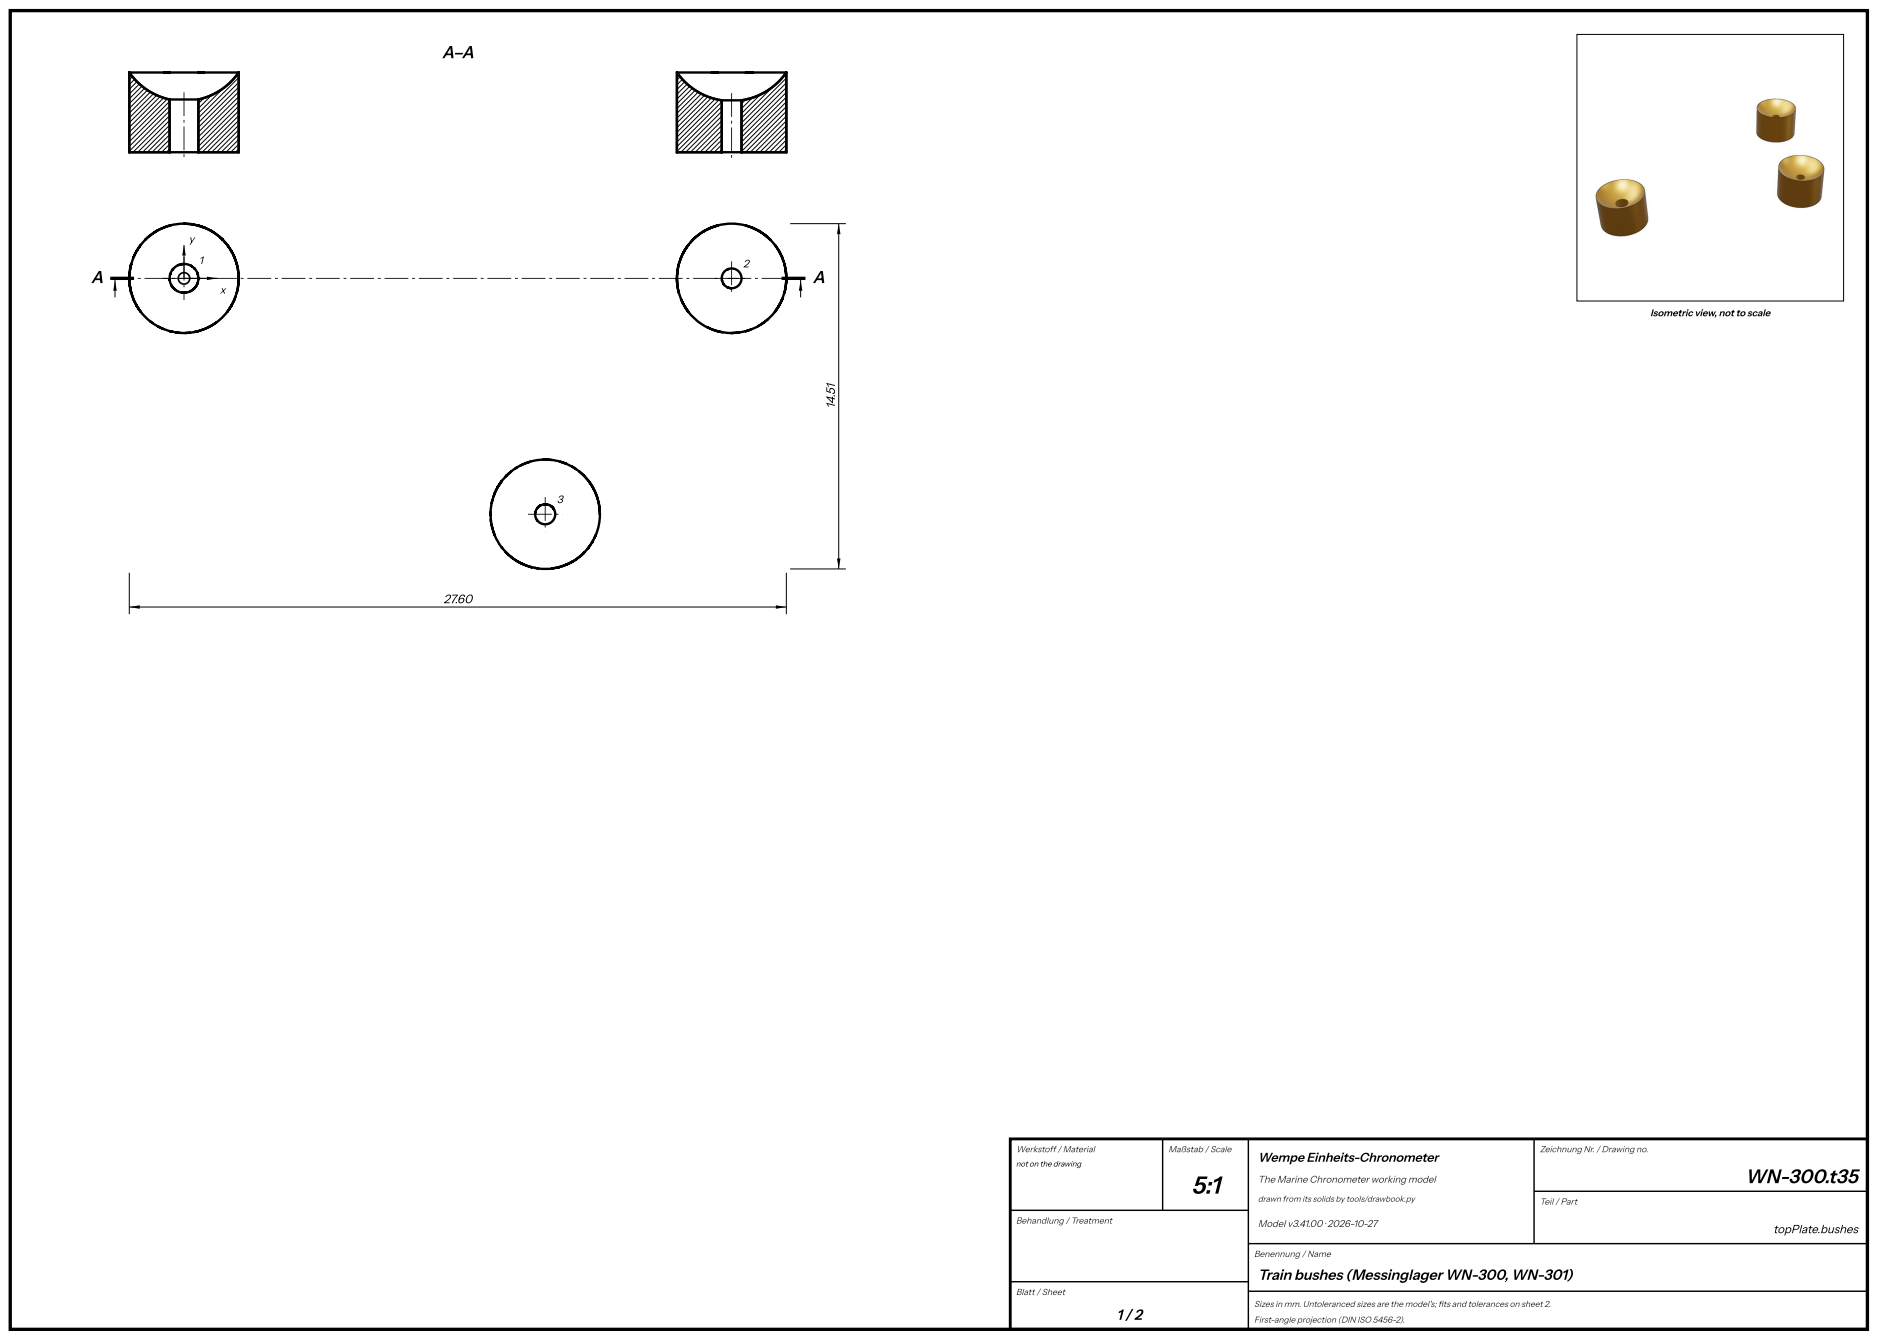
[picture p330: page 28]
Werkstoff / Material; Maßstab / Scale; Behandlung / Treatment; Model v3.41.00 · 2026-10-27; Teil / Part; topPlate.bushes

Isometric view, not to scale

Zeichnung Nr. / Drawing no.

not on the drawing

Wempe Einheits-Chronometer

The Marine Chronometer working model

drawn from its solids by tools/drawbook.py

Train bushes (Messinglager WN-300, WN-301)

## Train bushes (Messinglager WN-300, WN-301) — sheet 2

Three brass bushes pressed into the top plate, flush with both faces, in which the centre, intermediate and seconds arbors’

upper pivots run, each with an oil sink in its outer face (the 6MX ran the seconds and intermediate wheels in jewels in

chatons instead).

Parts list

Drawing | Name | Units | Material | Finish, heat treatment | Fit, as measured on the model
WN-300.t35 | Messinglager WN-300 (brass bush, seconds arbor's upper pivot) | 1 | not on the drawing | | in 050901 (press): 3.353 mm, least gap 0.0028
WN-300.t38 | Messinglager WN-300 (brass bush, intermediate arbor's upper pivot) | 1 | not on the drawing | | in 050901 (press): 3.353 mm, least gap 0.0028
WN-301 | Messinglager WN-301 (brass bush, centre arbor's upper pivot) | 1 | not on the drawing | | in 050901 (press): 3.353 mm, least gap 0.0028

What it does (WN-300.t35). The seconds arbor's upper bearing, pressed into the top plate's hole 35.

What it does (WN-300.t38). The intermediate arbor's upper bearing, pressed into the top plate's hole 38.

What it does (WN-301). The centre arbor's upper bearing, pressed into the top plate's hole 1.

Coordinates from the datum, the movement's centre (marked on the plan), x to the right and y up the plan as drawn;

depths from the face seen in the plan (the top). Thickness 3.35.

Holes

Hole | x | y | Size
1 | 0.00 | 0.00 | Ø 1.21 through (2.22 thick at 0.00-2.22)
2 | 23.00 | 0.00 | Ø 0.83 through (2.18 thick at 0.00-2.18)
3 | 15.17 | -9.91 | Ø 0.85 through (2.19 thick at 0.00-2.19)

Contourin the plan

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

radius.

Contour | # | Element | From x, y | To x, y | Centre x, y | R
Outline | 1 | circle | | | 23.00, 0.00 | 2.30
Cut-out 2 | 2 | line | 23.21, 1.56 | 23.21, 1.56
Cut-out 2 | 3 | line | 23.21, 1.56 | 23.21, 1.56
Cut-out 2 | 4 | line | 23.21, 1.56 | 23.21, 1.56
Cut-out 3 | 5 | line | 22.78, -1.65 | 22.78, -1.65
Cut-out 3 | 6 | line | 22.78, -1.65 | 22.78, -1.65
Cut-out 3 | 7 | line | 22.78, -1.65 | 22.78, -1.65
Cut-out 3 | 8 | line | 22.78, -1.65 | 22.78, -1.65
Outline | 9 | circle | | | 15.17, -9.91 | 2.30
Cut-out 1 | 10 | line | 16.51, -10.94 | 16.51, -10.94
Cut-out 1 | 11 | line | 16.51, -10.94 | 16.51, -10.94
Cut-out 1 | 12 | line | 16.51, -10.94 | 16.51, -10.94
Cut-out 2 | 13 | line | 16.45, -9.38 | 16.45, -9.38
Cut-out 2 | 14 | line | 16.45, -9.38 | 16.45, -9.38
Cut-out 2 | 15 | line | 16.45, -9.38 | 16.45, -9.38
Cut-out 2 | 16 | line | 16.45, -9.38 | 16.45, -9.38
Cut-out 3 | 17 | line | 16.04, -9.68 | 16.04, -9.68

Cut-out 3 | 18 | line | 16.04, -9.68 | 16.04, -9.68
Cut-out 3 | 19 | line | 16.04, -9.68 | 16.04, -9.68
Cut-out 3 | 20 | line | 16.04, -9.68 | 16.04, -9.68
Cut-out 4 | 21 | line | 15.98, -8.47 | 15.98, -8.47
Cut-out 4 | 22 | line | 15.98, -8.47 | 15.98, -8.47
Cut-out 4 | 23 | line | 15.98, -8.47 | 15.98, -8.47
Cut-out 4 | 24 | line | 15.98, -8.47 | 15.98, -8.47
Cut-out 6 | 25 | line | 14.94, -11.65 | 14.94, -11.65
Cut-out 6 | 26 | line | 14.94, -11.65 | 14.94, -11.65
Cut-out 6 | 27 | line | 14.94, -11.65 | 14.94, -11.65
Cut-out 6 | 28 | line | 14.94, -11.65 | 14.94, -11.65
Cut-out 7 | 29 | line | 14.75, -8.33 | 14.75, -8.33
Cut-out 7 | 30 | line | 14.75, -8.33 | 14.75, -8.33
Cut-out 7 | 31 | line | 14.75, -8.33 | 14.75, -8.33
Cut-out 7 | 32 | line | 14.75, -8.33 | 14.75, -8.33
Cut-out 8 | 33 | line | 13.39, -10.16 | 13.39, -10.16
Cut-out 8 | 34 | line | 13.39, -10.16 | 13.39, -10.16
Cut-out 8 | 35 | line | 13.39, -10.16 | 13.39, -10.16
Cut-out 8 | 36 | line | 13.39, -10.16 | 13.39, -10.16
Outline | 37 | circle | | | 0.00, 0.00 | 2.30
Cut-out 1 | 38 | line | 1.90, -0.51 | 1.90, -0.51
Cut-out 1 | 39 | line | 1.90, -0.51 | 1.90, -0.51
Cut-out 2 | 40 | line | 1.90, 0.51 | 1.90, 0.51
Cut-out 2 | 41 | line | 1.90, 0.51 | 1.90, 0.51
Cut-out 3 | 42 | line | 1.70, -0.46 | 1.70, -0.46
Cut-out 3 | 43 | line | 1.70, -0.46 | 1.70, -0.46
Cut-out 4 | 44 | line | 0.84, 0.71 | 0.84, 0.71
Cut-out 4 | 45 | line | 0.84, 0.71 | 0.84, 0.71
Cut-out 4 | 46 | line | 0.84, 0.71 | 0.84, 0.71

Levels

Faces in section A-A, from the bottom face: .

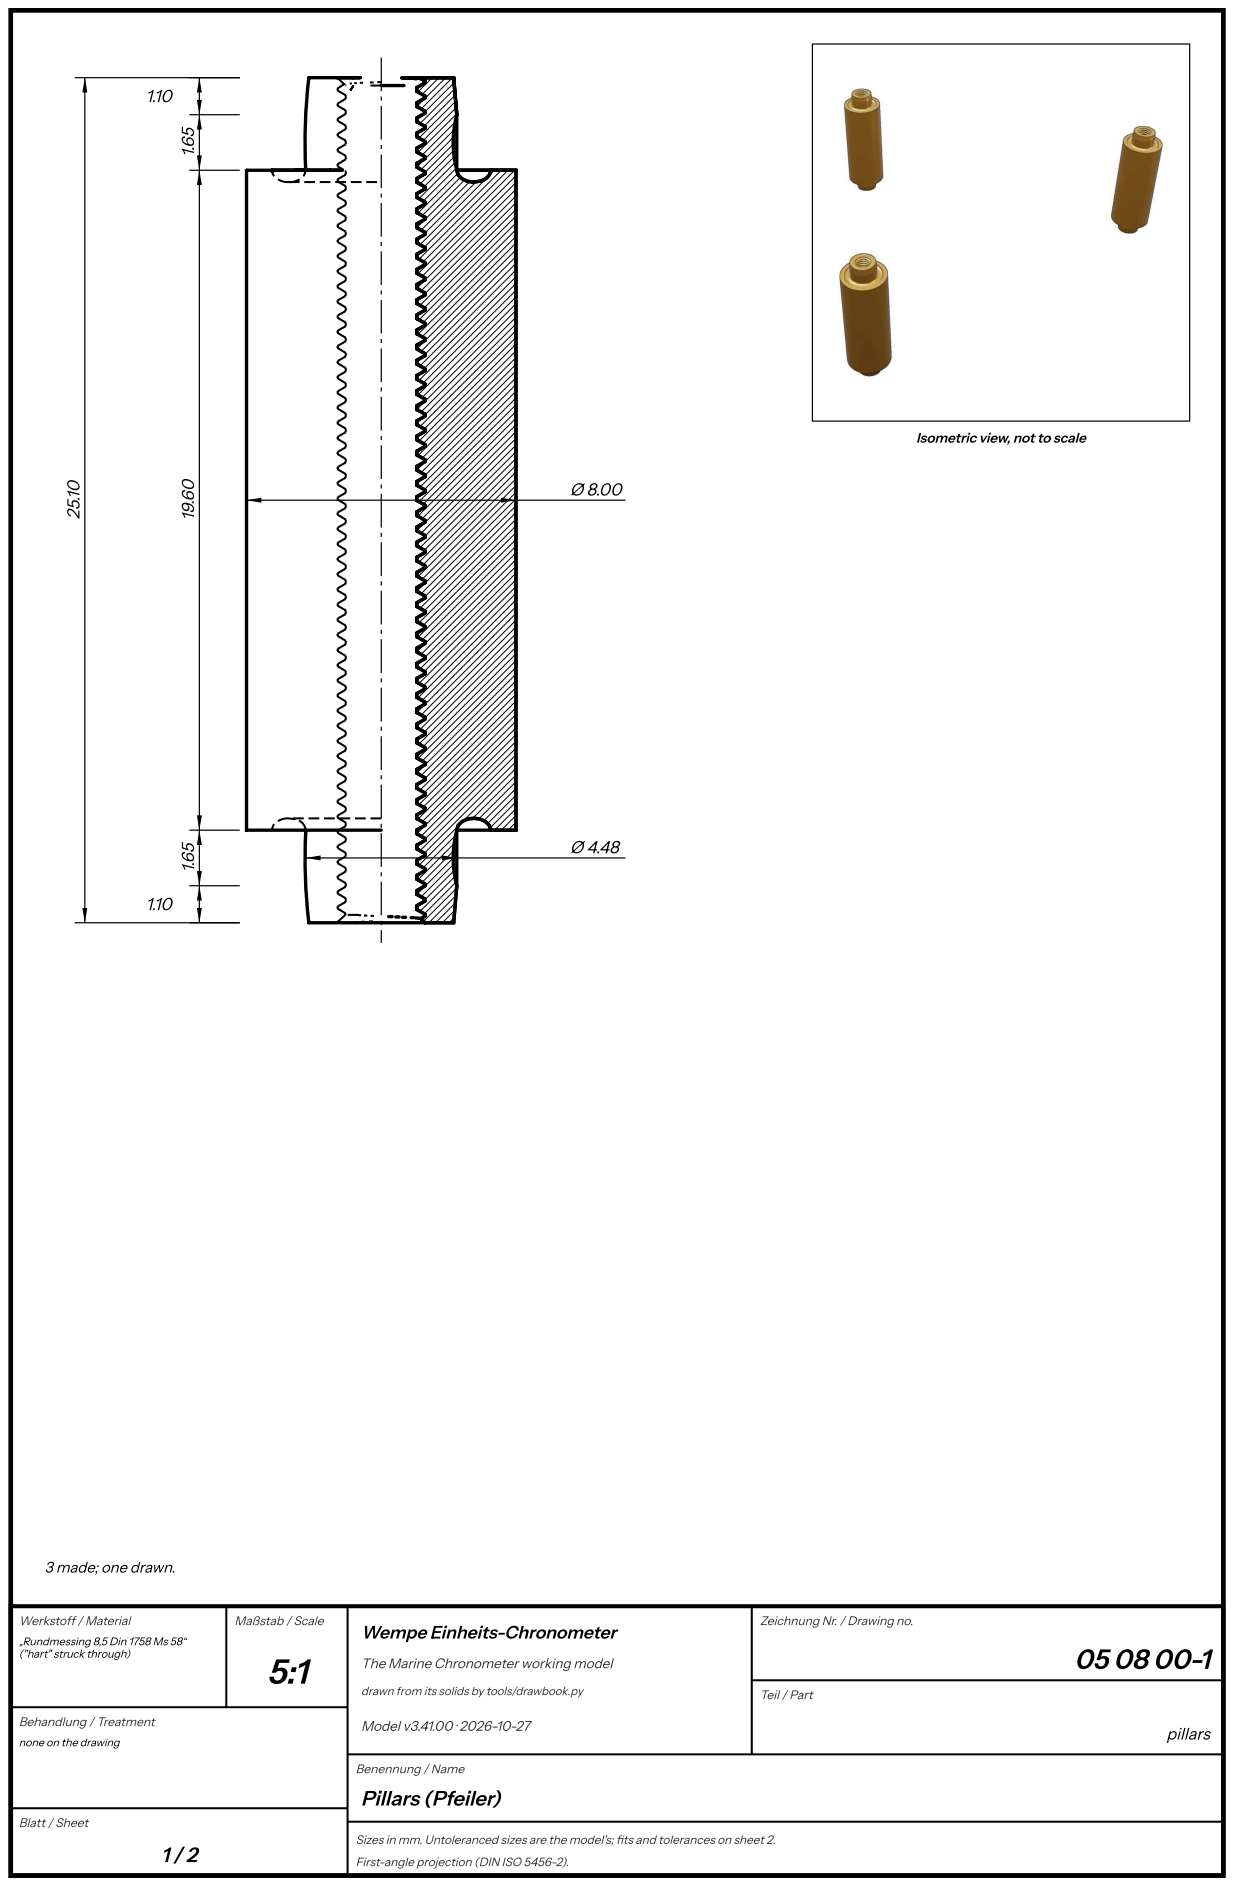
[picture p331: page 31]
Werkstoff / Material; Maßstab / Scale; Behandlung / Treatment; Model v3.41.00 · 2026-10-27; Teil / Part; pillars; Pillars (Pfeiler)

Isometric view, not to scale

3 made; one drawn.

Zeichnung Nr. / Drawing no.

„Rundmessing 8,5 Din 1758 Ms 58“
("hart" struck through)

Wempe Einheits-Chronometer

The Marine Chronometer working model

drawn from its solids by tools/drawbook.py

none on the drawing

## Pillars (Pfeiler) — sheet 2

Three turned brass pillars hold the plates 19 mm apart. Each sits by its shoulders in a seat in each plate, its spigots in the

plates’ reamed holes, a screw from each plate’s outer face in its tapped ends.

3 made, all alike; the drawing shows one, in its own frame (the holes' and contour's coordinates are that one's).

Parts list

Drawing | Name | Units | Material | Finish, heat treatment | Fit, as measured on the model
05 08 00-1 | Pfeiler (pillar) | 3 | „Rundmessing 8,5 Din 1758 Ms 58“ ("hart" struck through) | none on the drawing | in 050802-1 (run): 2.339 mm, least gap 0.0109; in 050901 (run): 2.339 mm, least gap 0.0109; on 050802-1: 0 mm; on 050901: 0 mm

What it does (05 08 00-1). Hold the plates 19 mm apart, their shoulders in seats in the plates, their spigots in the plates'

reamed holes.

Turned about its axis; length 25.10, largest Ø 8.00. Diameters: Ø 4.48, Ø 8.00. Shoulders from the lower end: 0.00, 1.10, 2.75,

22.35, 24.00, 25.10.

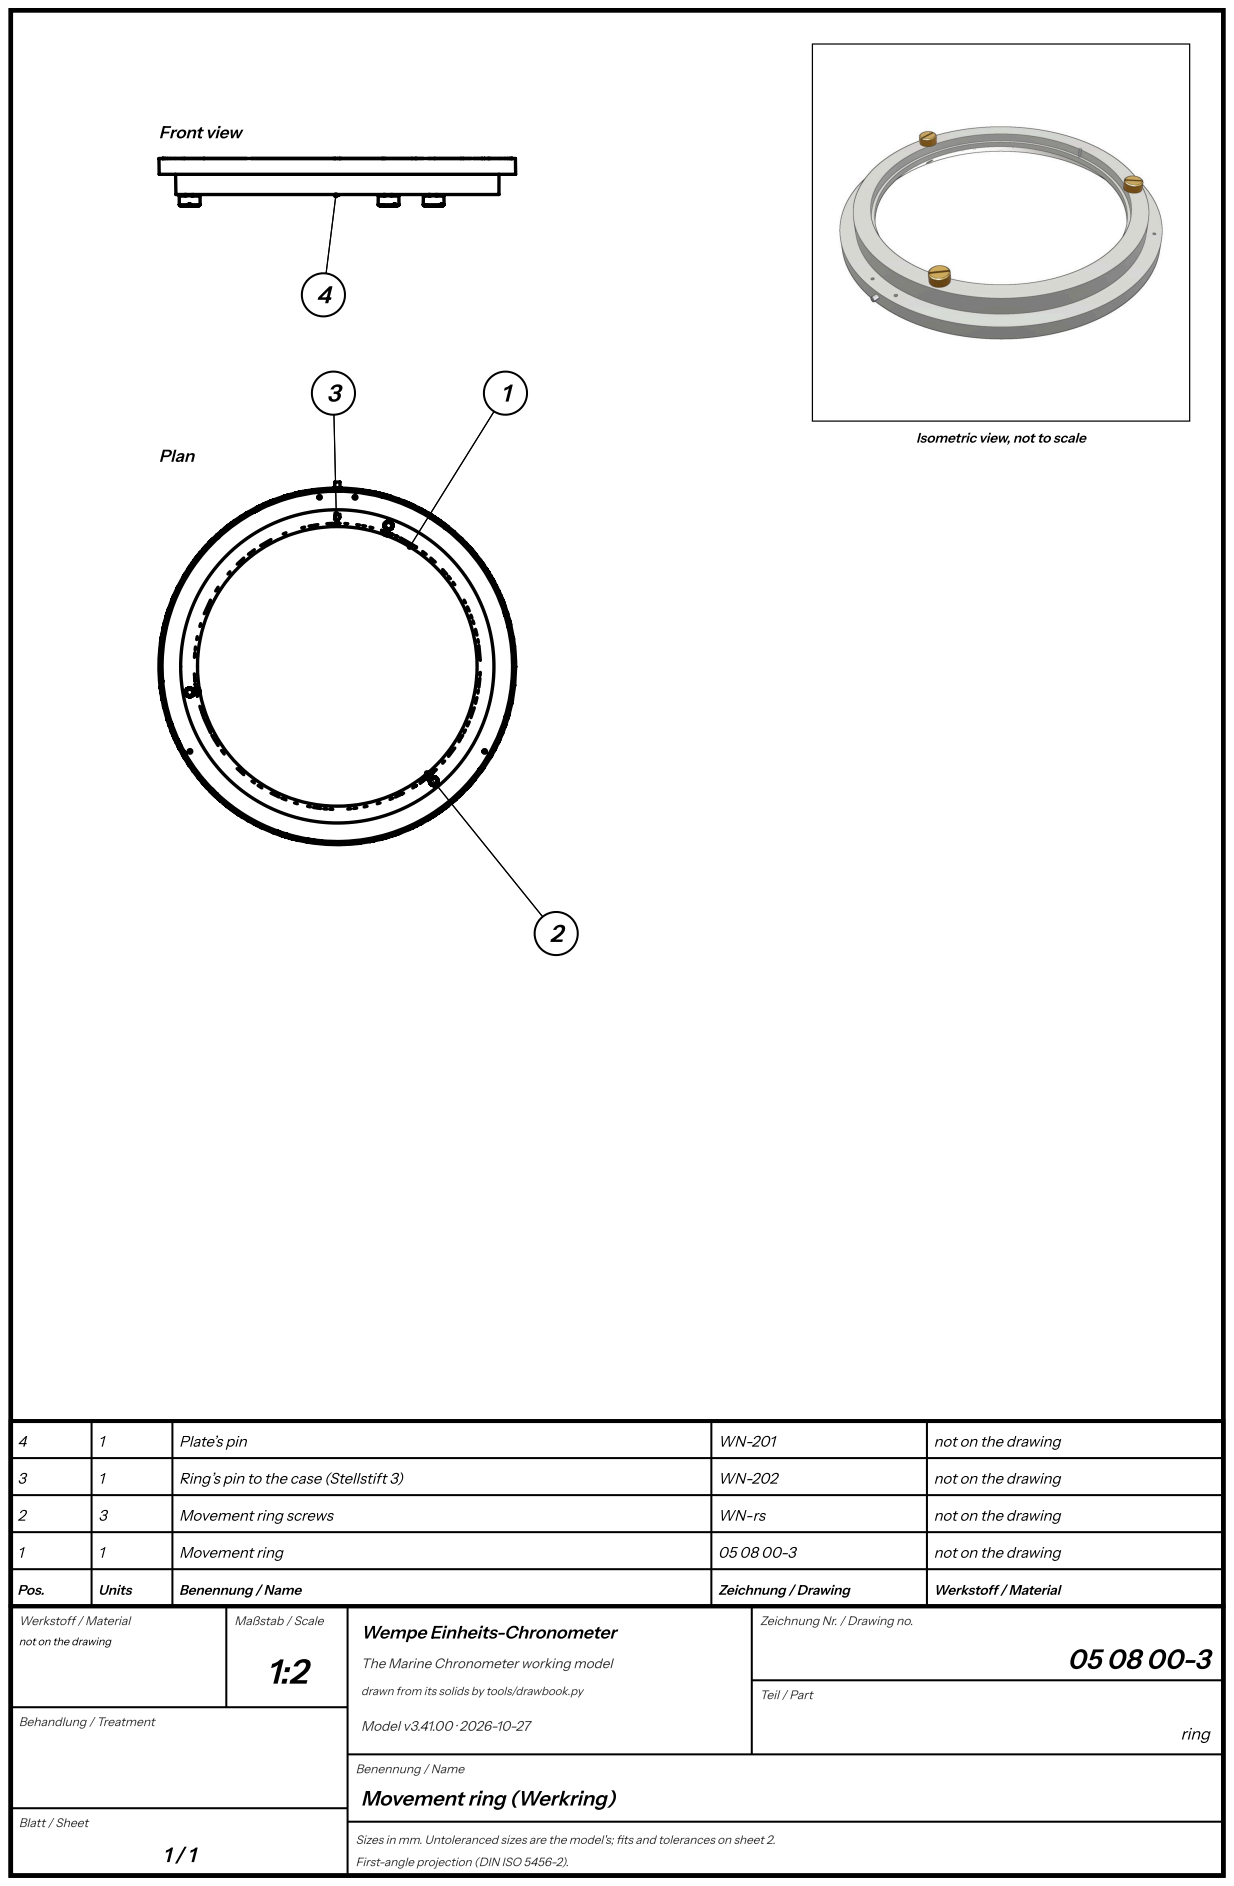
[picture p332: page 33]
Front view; Plan; Pos.; Units; Benennung / Name; Zeichnung / Drawing; Werkstoff / Material; Movement ring; not on the drawing; Movement ring screws; Ring’s pin to the case (Stellstift 3); Plate’s pin; Maßstab / Scale; Behandlung / Treatment; Model v3.41.00 · 2026-10-27; Teil / Part; ring

Isometric view, not to scale

Zeichnung Nr. / Drawing no.

not on the drawing

Wempe Einheits-Chronometer

The Marine Chronometer working model

drawn from its solids by tools/drawbook.py

Movement ring (Werkring)

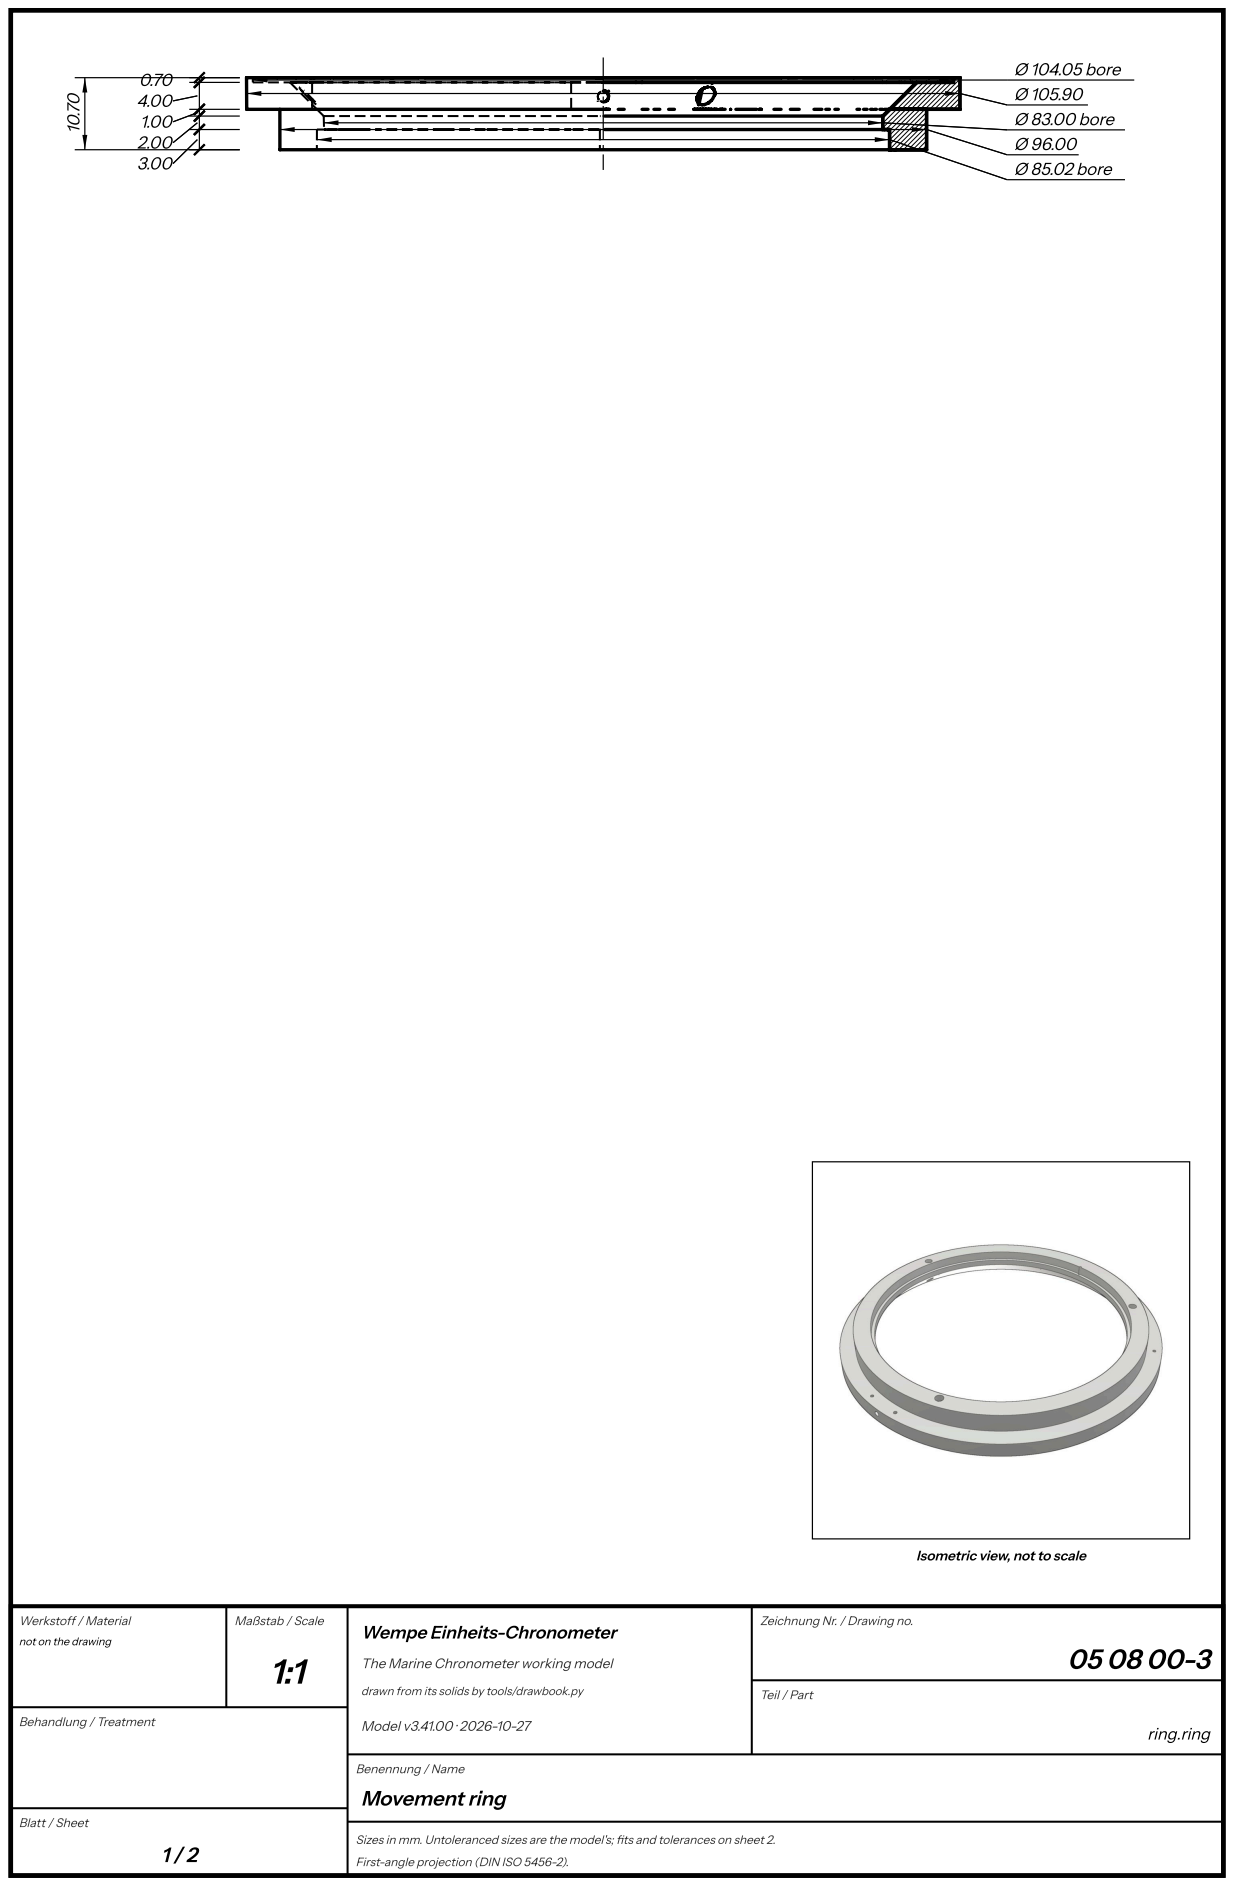
[picture p333: page 34]
Ø 104.05 bore; Ø 83.00 bore; Ø 85.02 bore; Werkstoff / Material; Maßstab / Scale; Behandlung / Treatment; Model v3.41.00 · 2026-10-27; Teil / Part; ring.ring; Movement ring

Isometric view, not to scale

Zeichnung Nr. / Drawing no.

not on the drawing

Wempe Einheits-Chronometer

The Marine Chronometer working model

drawn from its solids by tools/drawbook.py

## Movement ring — sheet 2

The ring the movement hangs in, in the case: the pillar plate sits in its seat on a lip, held by three screws whose heads bear

on the plate’s rim, and the dial lies in a recess in its flange. Below the lip the ring opens out at 45° toward the dial.

Parts list

Drawing | Name | Units | Material | Finish, heat treatment | Fit, as measured on the model
05 08 00-3 | Werkring (movement ring) | 1 | not on the drawing | | on 050802-1: 0 mm

What it does (05 08 00-3). The ring the pillar plate sits in, which carries the dial and hangs in the case.

Turned about its axis; length 10.70, largest Ø 105.90. Diameters: Ø 96.00, Ø 105.90; bores Ø 83.00, Ø 85.02, Ø 104.05.

Shoulders from the lower end: 0.00, 3.00, 5.00, 6.00, 10.00, 10.70.

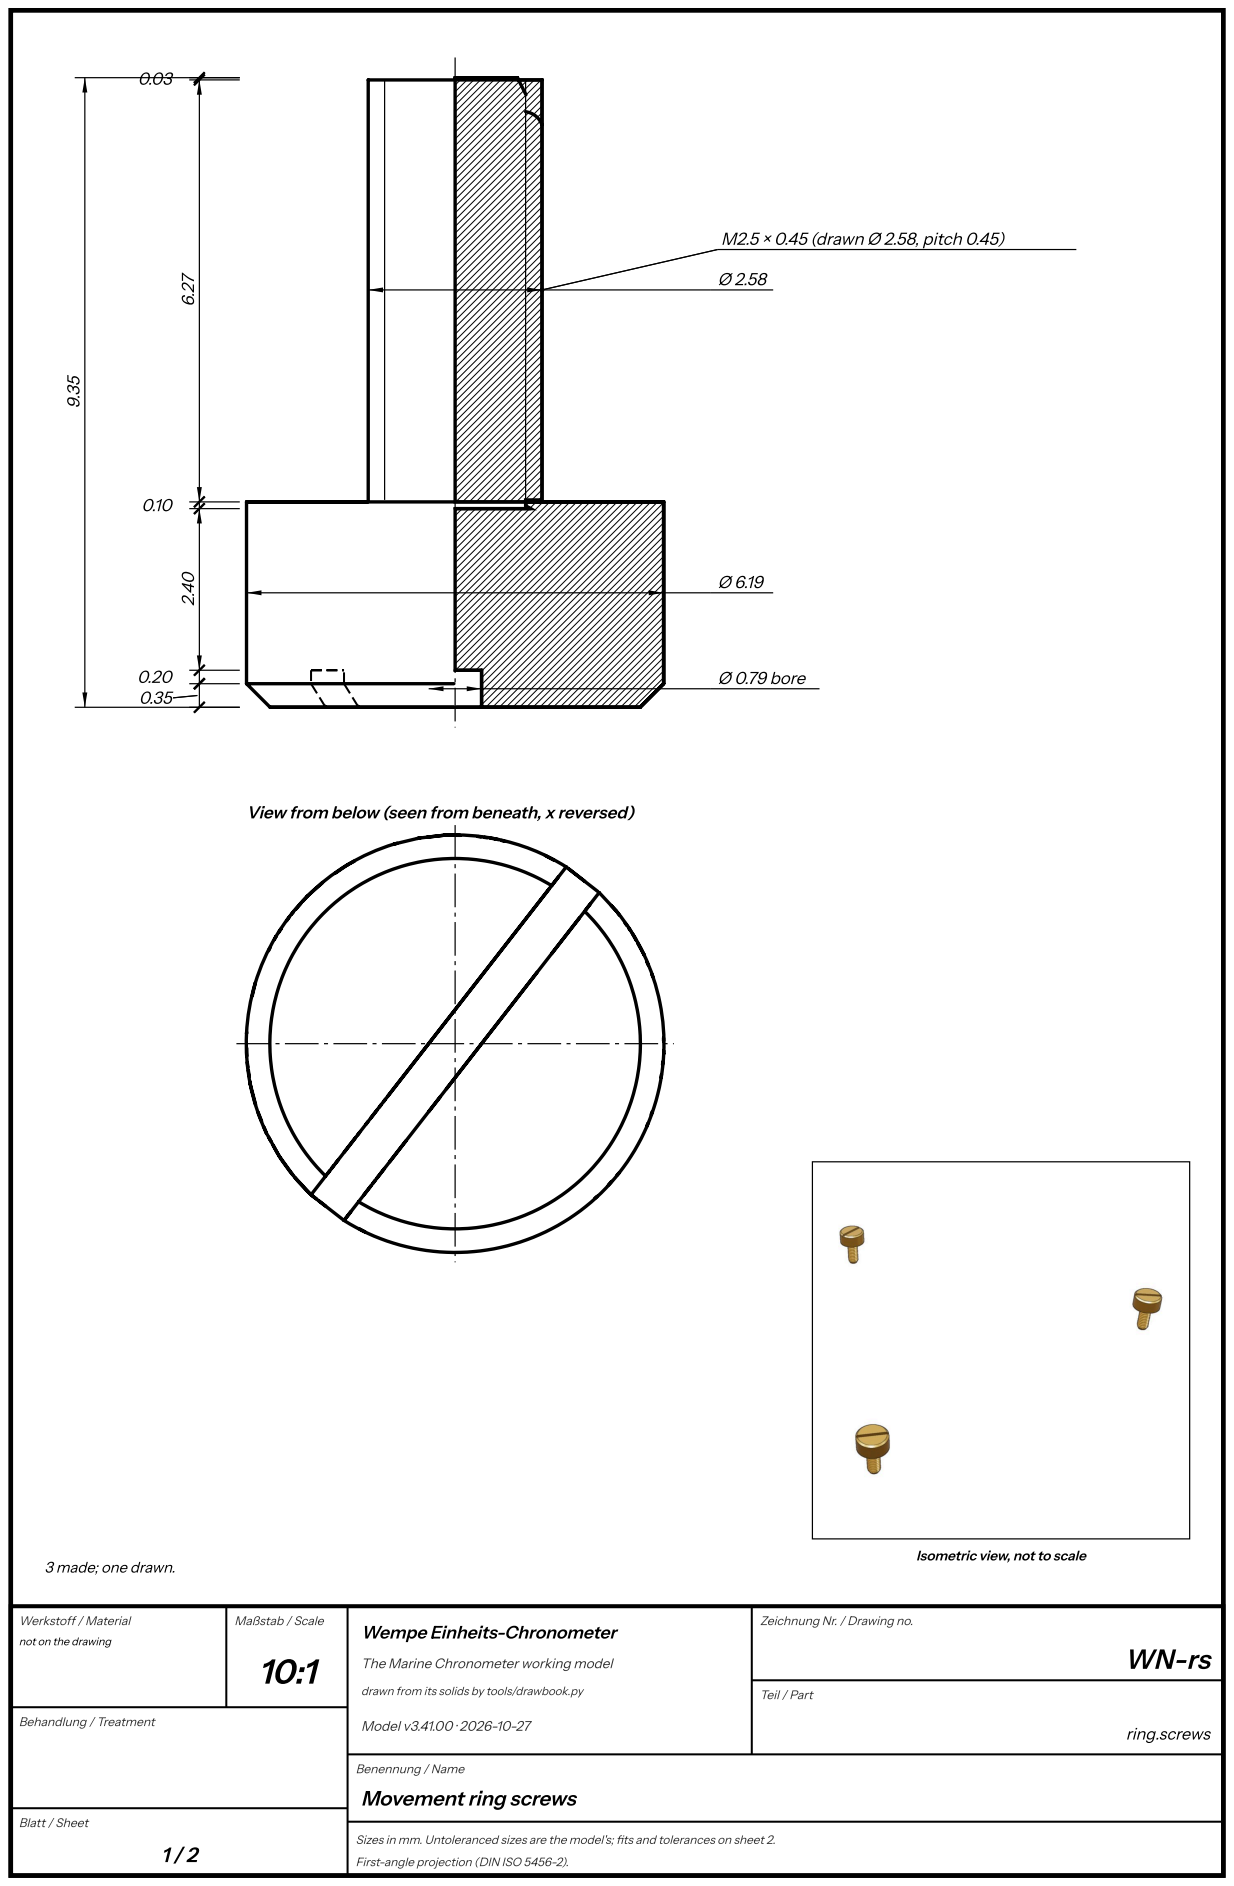
[picture p334: page 36]
Ø 0.79 bore; M2.5 × 0.45 (drawn Ø 2.58, pitch 0.45); Werkstoff / Material; Maßstab / Scale; Behandlung / Treatment; Model v3.41.00 · 2026-10-27; Teil / Part; ring.screws

View from below (seen from beneath, x reversed)

3 made; one drawn.

Isometric view, not to scale

Zeichnung Nr. / Drawing no.

not on the drawing

Wempe Einheits-Chronometer

The Marine Chronometer working model

drawn from its solids by tools/drawbook.py

Movement ring screws

## Movement ring screws — sheet 2

Three screws in the ring whose heads bear on the pillar plate’s rim, holding it in its seat (their WN number not read).

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

Parts list

Drawing | Name | Units | Material | Finish, heat treatment | Fit, as measured on the model
WN-rs | Movement ring screw (WN number not read) | 3 | not on the drawing | | in 050800-3 (tap): 5.81 mm, least gap 0.0497; on 050802-1: 0 mm

What it does (WN-rs). Its head bears on the pillar plate's rim and holds it in the ring's seat.

Turned about its axis; length 9.35, largest Ø 6.19. Diameters: Ø 2.58, Ø 6.19; bores Ø 0.79. Shoulders from the lower end:

0.00, 0.35, 0.55, 2.95, 3.05, 9.32, 9.35.

Thread

Outside thread 3.08-9.32 from the lower end, 6.24 long: drawn Ø 2.58 over its crests, 2.09 at its roots, pitch 0.45. Cut the

ISO 261 coarse thread nearest it, M2.5 × 0.45, where the part's own sheet gives none (the Wempe-Norm screws' sheets

aren't in the set).

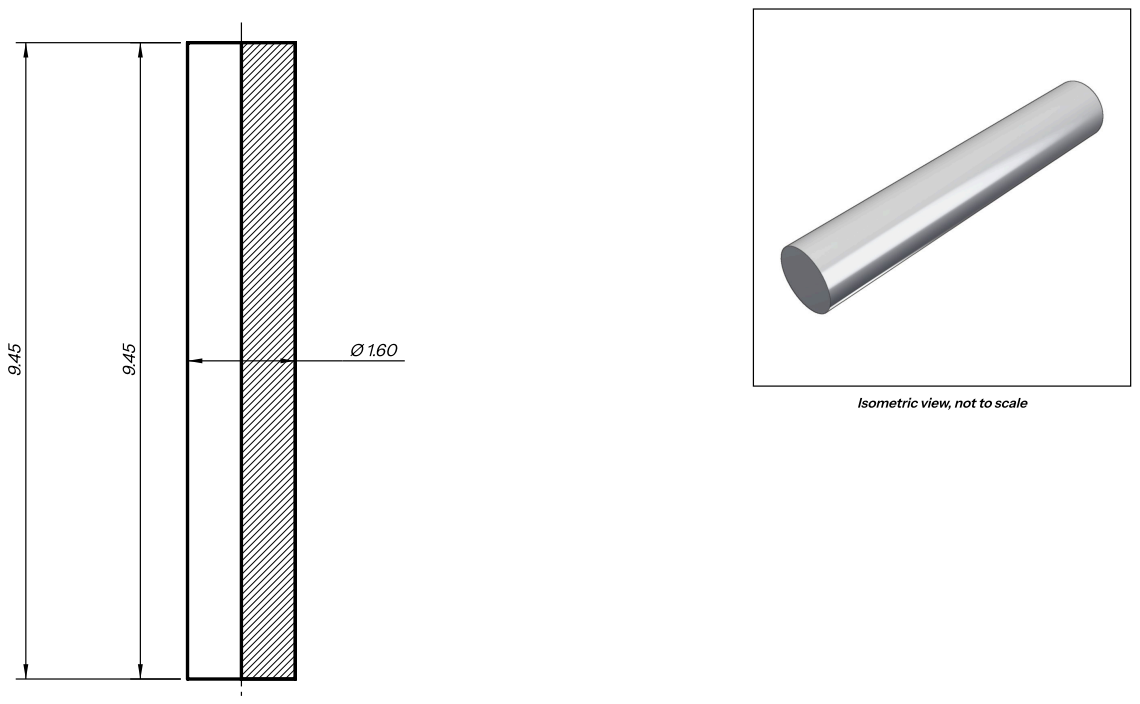
[picture p335: page 38]
Werkstoff / Material; Maßstab / Scale; Behandlung / Treatment; Model v3.41.00 · 2026-10-27; Teil / Part; ring.casePin

Isometric view, not to scale

Zeichnung Nr. / Drawing no.

not on the drawing

Wempe Einheits-Chronometer

The Marine Chronometer working model

drawn from its solids by tools/drawbook.py

Ring’s pin to the case (Stellstift 3)

## Ring’s pin to the case (Stellstift 3) — sheet 2

A pin Ø 1.6 standing 1.8 mm out of the ring’s flange at 12 o’clock into a notch cut through the bowl’s threaded rim: it sets the

movement’s turn in the case, so the winding hole is over the fusee’s square, and holds it while the bezel is screwed down

(the notch isn’t on the casting’s sheet: the 6MX’s bowls have it).

Parts list

Drawing | Name | Units | Material | Finish, heat treatment | Fit, as measured on the model
WN-202 | Stellstift 3 (WN-202): the movement ring’s radial pin to the case | 1 | not on the drawing | | in 050800-3 (press): 7.631 mm, least gap 0.0015

What it does (WN-202). Stands 1.78 out of the ring's flange at 12 o'clock into the notch in the bowl's threaded rim: it sets

the movement's turn in the case and holds it while the bezel is screwed down.

Turned about its axis; length 9.45, largest Ø 1.60. Diameters: Ø 1.60. Shoulders from the lower end: 0.00, 9.45.

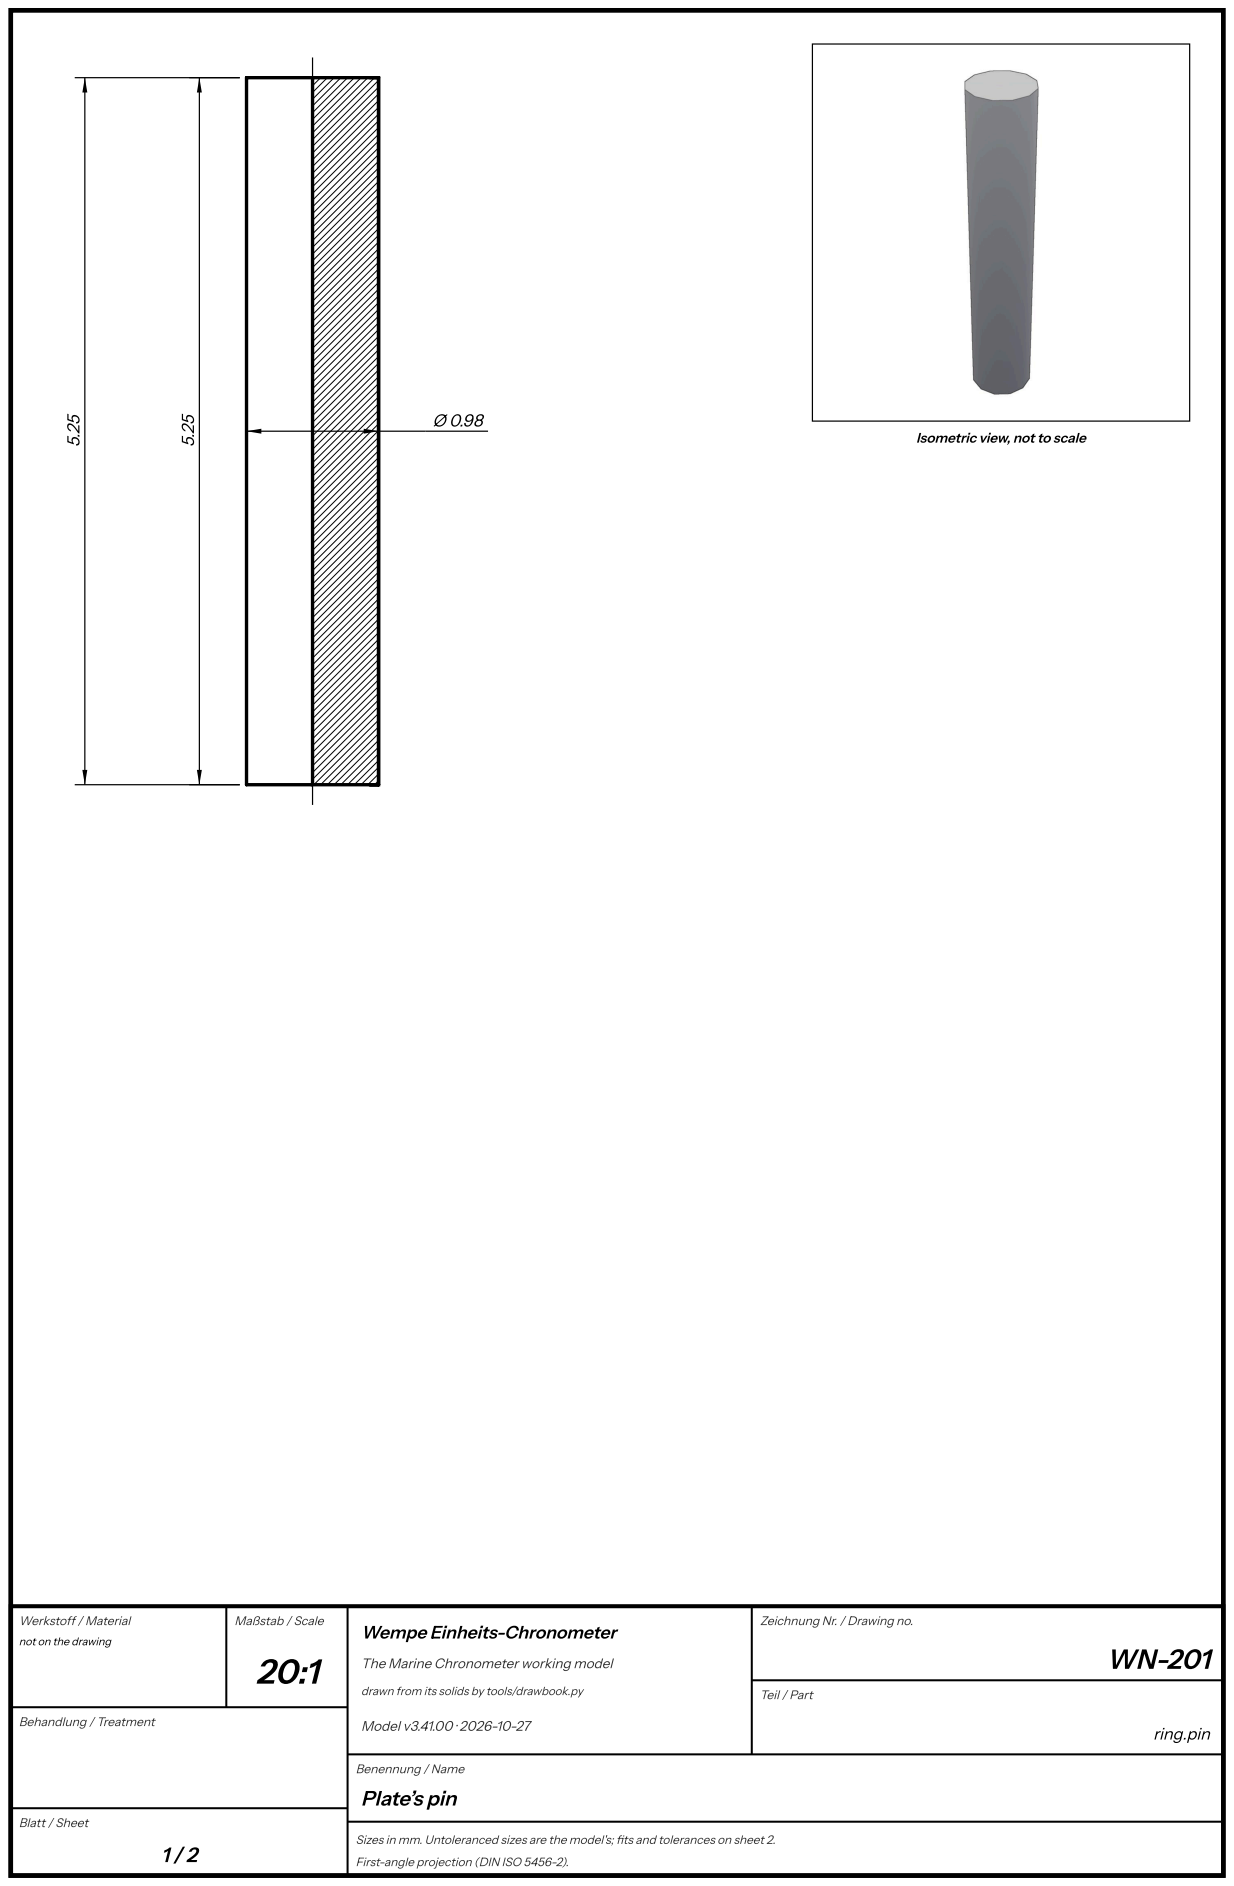
[picture p336: page 40]
Werkstoff / Material; Maßstab / Scale; Behandlung / Treatment; Model v3.41.00 · 2026-10-27; Teil / Part; ring.pin; Plate’s pin

Isometric view, not to scale

Zeichnung Nr. / Drawing no.

not on the drawing

Wempe Einheits-Chronometer

The Marine Chronometer working model

drawn from its solids by tools/drawbook.py

## Plate’s pin — sheet 2

A pin (WN-201) Ø 1 drilled in across the joint of the plate and the ring at assembly, which sets the movement’s turn in the

ring.

Parts list

Drawing | Name | Units | Material | Finish, heat treatment | Fit, as measured on the model
WN-201 | Stellstift (WN-201): the plate's pin in the movement ring | 1 | not on the drawing | | in 050800-3 (press): 1.98 mm, least gap 0.0121

What it does (WN-201). Drilled across the joint of the pillar plate and the ring at assembly, it sets the movement's turn in

the ring.

Turned about its axis; length 5.25, largest Ø 0.98. Diameters: Ø 0.98. Shoulders from the lower end: 0.00, 5.25.

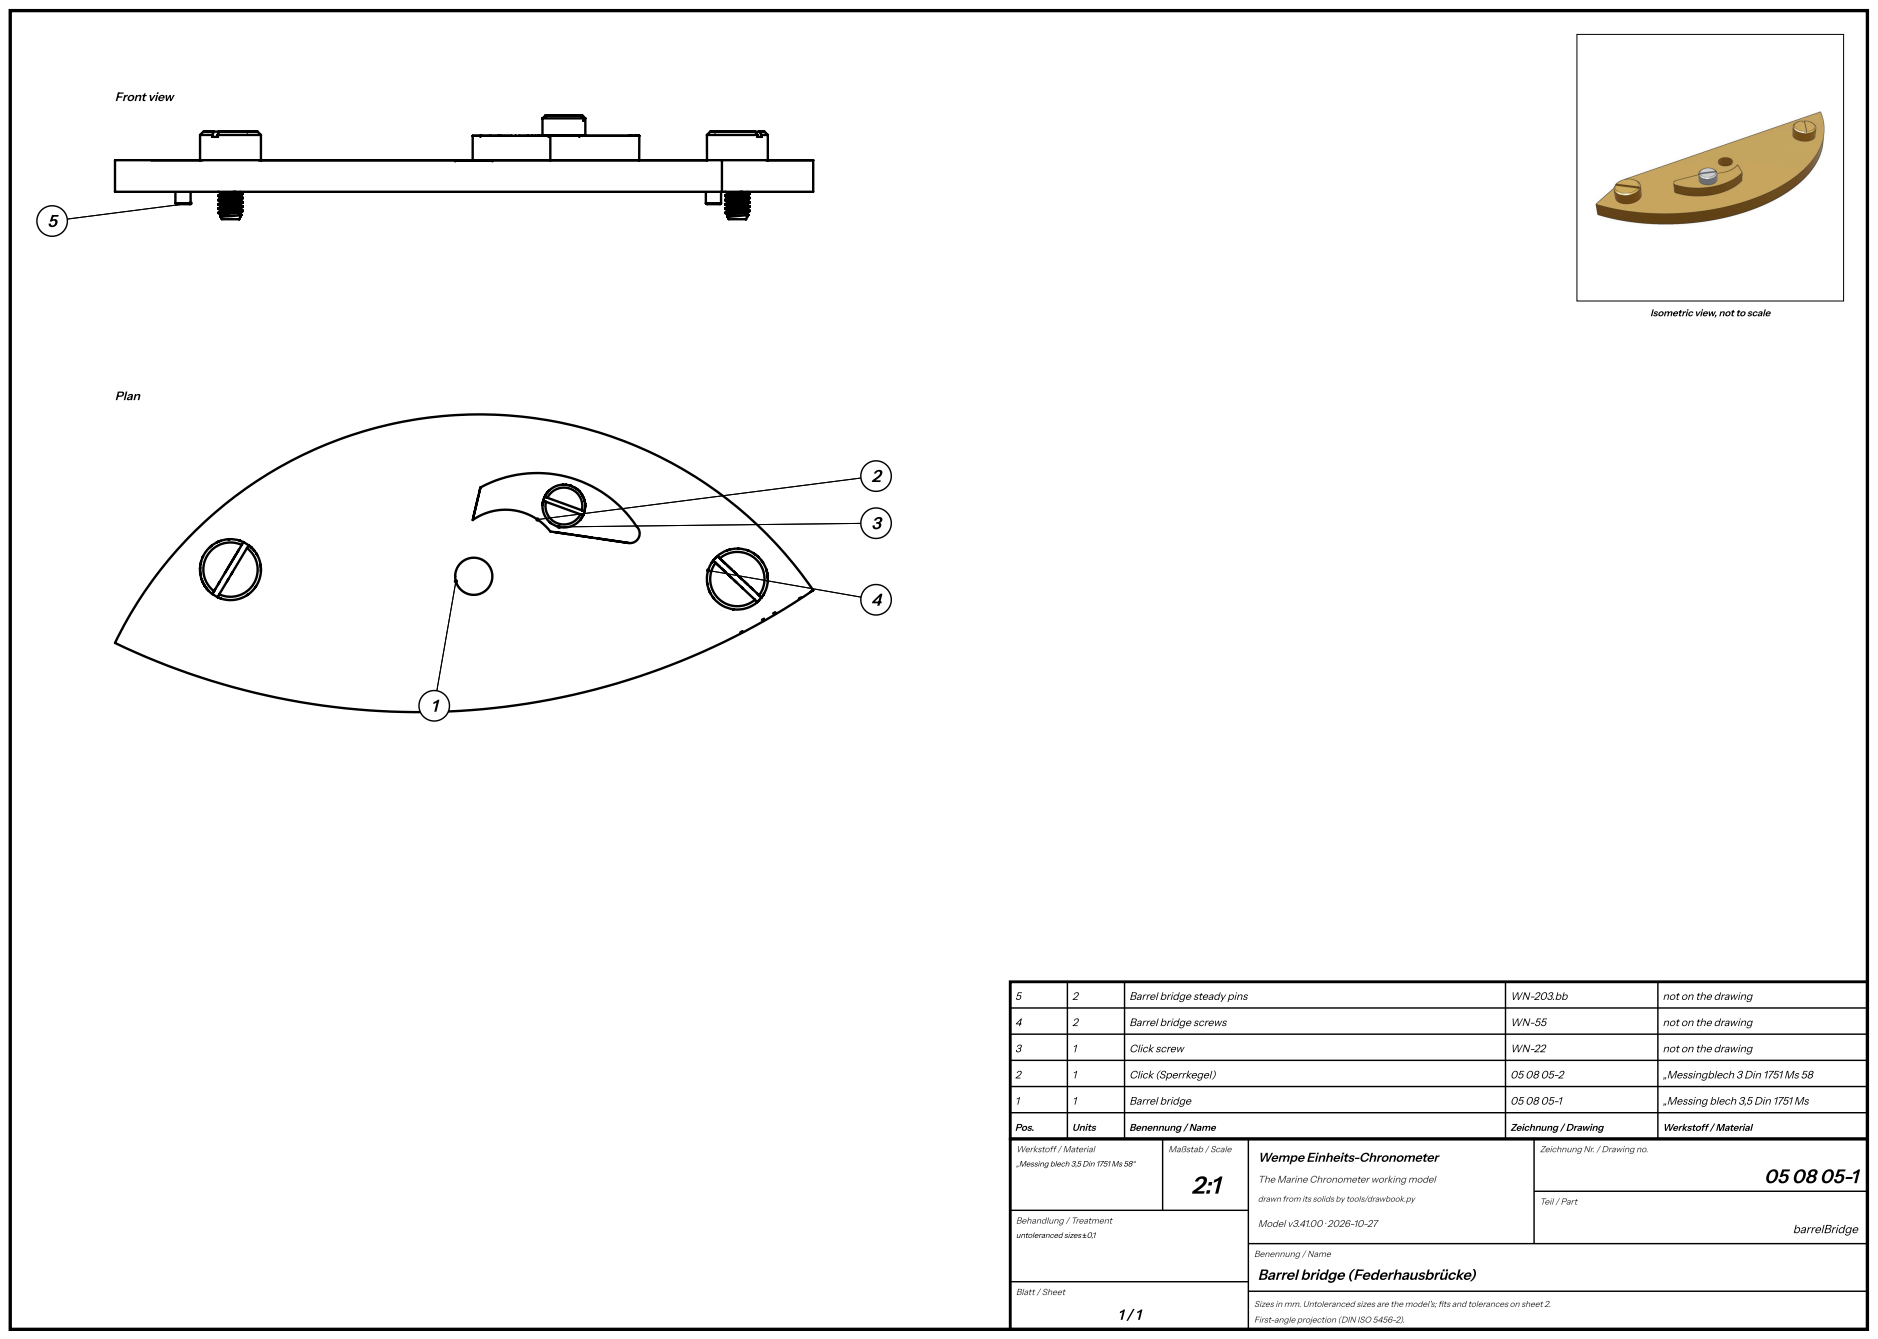
[picture p337: page 42]
Front view; Plan; Pos.; Units; Benennung / Name; Zeichnung / Drawing; Werkstoff / Material; Barrel bridge; „Messing blech 3,5 Din 1751 Ms; Click (Sperrkegel); „Messingblech 3 Din 1751 Ms 58; Click screw; not on the drawing; Barrel bridge screws; Barrel bridge steady pins; Maßstab / Scale; Behandlung / Treatment; untoleranced sizes ±0,1; Model v3.41.00 · 2026-10-27; Teil / Part; barrelBridge

Isometric view, not to scale

Zeichnung Nr. / Drawing no.

„Messing blech 3,5 Din 1751 Ms 58“

Wempe Einheits-Chronometer

The Marine Chronometer working model

drawn from its solids by tools/drawbook.py

Barrel bridge (Federhausbrücke)

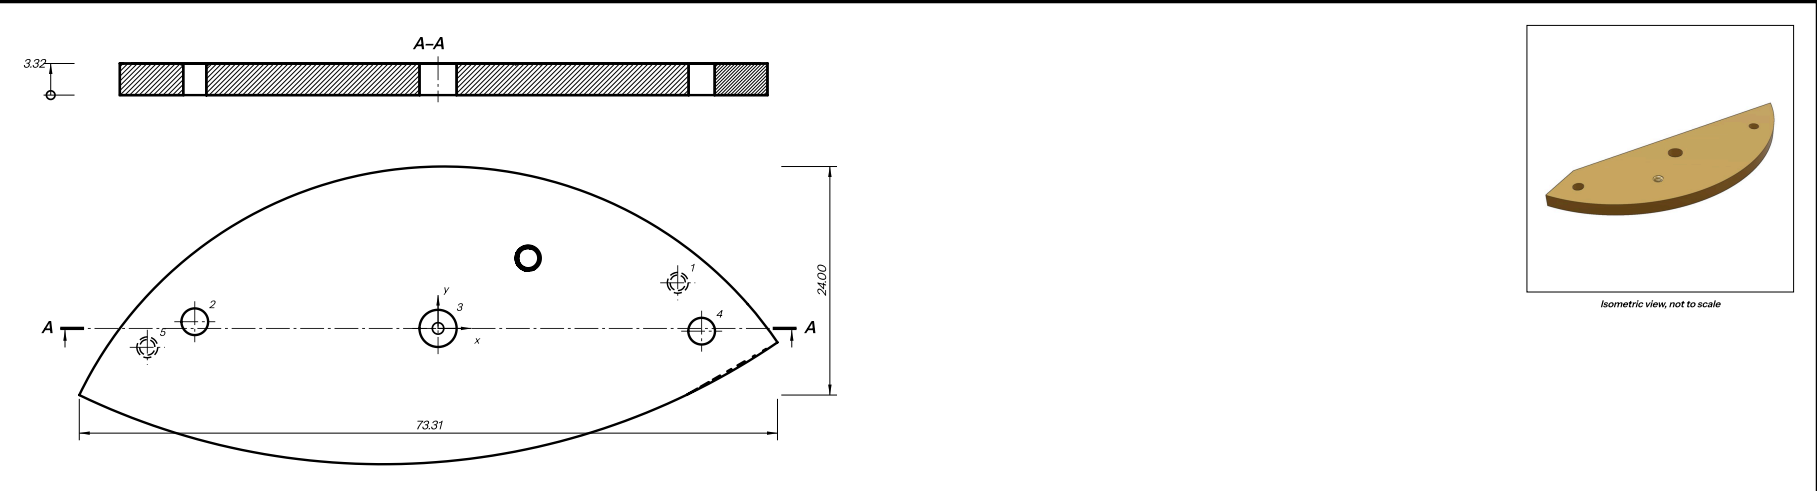
[picture p338: page 43]
Werkstoff / Material; Maßstab / Scale; Behandlung / Treatment; untoleranced sizes ±0,1; Model v3.41.00 · 2026-10-27; Teil / Part; barrelBridge.bridge; Barrel bridge

Isometric view, not to scale

Zeichnung Nr. / Drawing no.

„Messing blech 3,5 Din 1751 Ms 58“

Wempe Einheits-Chronometer

The Marine Chronometer working model

drawn from its solids by tools/drawbook.py

## Barrel bridge — sheet 2

A crescent bridge on the top plate over the barrel, its outer edge turned with the plate’s rim, carrying the barrel arbor’s

upper pivot and the click that holds the mainspring’s set-up.

Parts list

Drawing | Name | Units | Material | Finish, heat treatment | Fit, as measured on the model
05 08 05-1 | Federhausbrücke (barrel bridge) | 1 | „Messing blech 3,5 Din 1751 Ms 58“ | untoleranced sizes ±0,1 | on 050901: 0 mm

What it does (05 08 05-1). Holds the barrel arbor's upper pivot over the top plate's cut (its assembly is 05 08 05).

Coordinates from the datum, hole 3's centre (marked on the plan), x to the right and y up the plan as drawn; depths from

the face seen in the plan (the top). Thickness 3.32.

Holes

Hole | x | y | Size
1 | 25.17 | 4.79 | Ø 1.58 × 2.22 deep from the face at 0.28; countersunk to Ø 2.18
2 | -25.54 | 0.70 | Ø 2.80 through
3 | 0.00 | 0.00 | Ø 3.90 through
4 | 27.68 | -0.29 | Ø 2.80 through
5 | -30.53 | -1.99 | Ø 1.58 × 2.22 deep from the face at 0.28; countersunk to Ø 2.18

Contourin the plan

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

radius.

Contour | # | Element | From x, y | To x, y | Centre x, y | R
Outline | 1 | arc clockwise | -37.32, -6.28 | 35.64, -1.47 | 0.59, -25.49 | 42.49
Outline | 2 | arc clockwise | 35.64, -1.47 | -37.67, -7.00 | -5.81, 59.25 | 73.52
Outline | 3 | line | -37.67, -7.00 | -37.32, -6.28
Cut-out 3 | 4 | line | 10.29, 6.36 | 10.29, 6.36
Cut-out 3 | 5 | line | 10.29, 6.36 | 10.29, 6.36
Cut-out 3 | 6 | line | 10.29, 6.36 | 10.29, 6.36
Cut-out 4 | 7 | line | 10.21, 6.30 | 10.21, 6.30
Cut-out 4 | 8 | line | 10.21, 6.30 | 10.21, 6.30
Cut-out 4 | 9 | line | 10.21, 6.30 | 10.21, 6.30
Cut-out 4 | 10 | line | 10.21, 6.30 | 10.21, 6.30
Cut-out 5 | 11 | line | 9.56, 6.06 | 9.56, 6.06
Cut-out 5 | 12 | line | 9.56, 6.06 | 9.56, 6.06
Cut-out 5 | 13 | line | 9.56, 6.06 | 9.56, 6.06
Cut-out 6 | 14 | line | 9.16, 6.10 | 9.16, 6.10
Cut-out 6 | 15 | line | 9.16, 6.10 | 9.16, 6.10
Cut-out 6 | 16 | line | 9.16, 6.10 | 9.16, 6.10
Cut-out 7 | 17 | arc anticlockwise | 8.97, 6.16 | 8.97, 6.16 | 0.99, 9.35 | 8.60
Cut-out 7 | 18 | arc anticlockwise | 8.97, 6.16 | 8.97, 6.16 | 0.99, 9.35 | 8.60
Cut-out 8 | 19 | line | 8.85, 6.21 | 8.85, 6.21
Cut-out 8 | 20 | arc anticlockwise | 8.85, 6.21 | 8.85, 6.21 | 3.14, 3.86 | 6.17
Cut-out 8 | 21 | line | 8.85, 6.21 | 8.85, 6.21

Cut-out 9 | 22 | line | 8.64, 6.36 | 8.64, 6.36
Cut-out 9 | 23 | arc anticlockwise | 8.64, 6.36 | 8.64, 6.36 | 4.45, 0.68 | 7.06
Cut-out 9 | 24 | line | 8.64, 6.36 | 8.64, 6.36
Cut-out 10 | 25 | arc anticlockwise | 8.36, 6.66 | 8.36, 6.66 | 3.26, 3.32 | 6.10
Cut-out 10 | 26 | arc anticlockwise | 8.36, 6.66 | 8.36, 6.66 | 3.23, 3.38 | 6.09
Cut-out 11 | 27 | arc anticlockwise | 8.33, 6.71 | 8.33, 6.71 | 2.89, 4.10 | 6.04
Cut-out 11 | 28 | arc anticlockwise | 8.33, 6.71 | 8.33, 6.71 | 3.48, 2.86 | 6.19
Cut-out 12 | 29 | line | 8.25, 7.90 | 8.25, 7.90
Cut-out 12 | 30 | arc anticlockwise | 8.25, 7.90 | 8.25, 7.90 | 2.84, 4.70 | 6.28
Cut-out 12 | 31 | line | 8.25, 7.90 | 8.25, 7.90
Cut-out 13 | 32 | line | 8.25, 7.90 | 8.25, 7.90
Cut-out 13 | 33 | arc anticlockwise | 8.25, 7.90 | 8.25, 7.90 | 2.84, 4.70 | 6.28
Cut-out 13 | 34 | line | 8.25, 7.90 | 8.25, 7.90
Cut-out 16 | 35 | arc anticlockwise | -25.13, 2.06 | -25.13, 2.06 | -13.83, 1.78 | 11.30
Cut-out 16 | 36 | arc anticlockwise | -25.13, 2.06 | -25.13, 2.06 | -13.83, 1.78 | 11.30
Cut-out 17 | 37 | line | -29.43, 0.39 | -29.43, 0.39
Cut-out 17 | 38 | line | -29.43, 0.39 | -29.43, 0.39
Cut-out 17 | 39 | line | -29.43, 0.39 | -29.43, 0.39
Cut-out 17 | 40 | line | -29.43, 0.39 | -29.43, 0.39
Cut-out 18 | 41 | line | -29.55, 0.27 | -29.55, 0.27
Cut-out 18 | 42 | line | -29.55, 0.27 | -29.55, 0.27
Cut-out 18 | 43 | line | -29.55, 0.27 | -29.55, 0.27
Cut-out 18 | 44 | line | -29.55, 0.27 | -29.55, 0.27

Levels

Faces in section A-A, from the bottom face: 3.32.

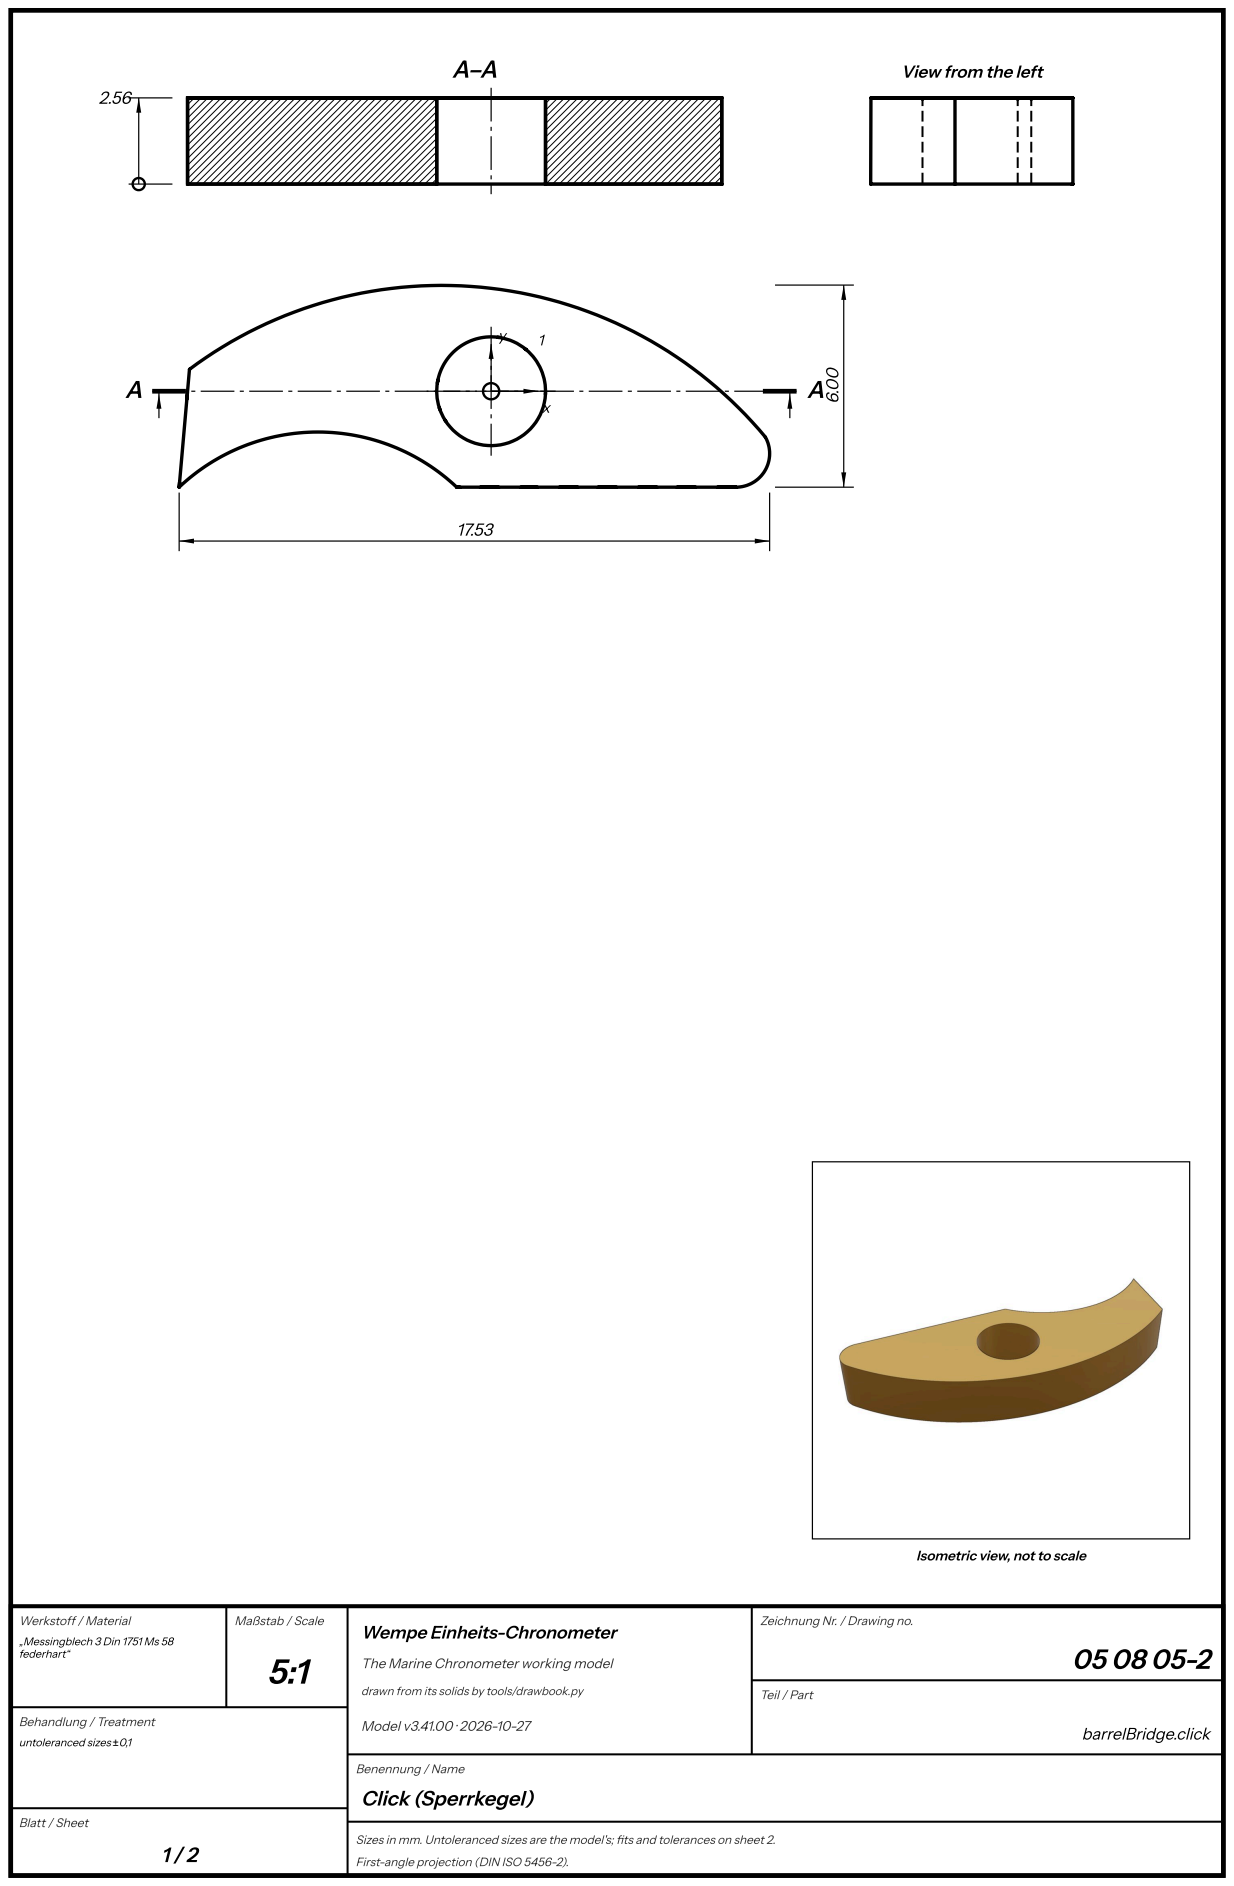
[picture p339: page 46]
Werkstoff / Material; Maßstab / Scale; Behandlung / Treatment; untoleranced sizes ±0,1; Model v3.41.00 · 2026-10-27; Teil / Part; barrelBridge.click; Click (Sperrkegel)

View from the left

Isometric view, not to scale

Zeichnung Nr. / Drawing no.

„Messingblech 3 Din 1751 Ms 58
federhart“

Wempe Einheits-Chronometer

The Marine Chronometer working model

drawn from its solids by tools/drawbook.py

## Click (Sperrkegel) — sheet 2

The click on the barrel’s ratchet, which holds the mainspring’s set-up. It is cut from spring-hard brass, so it is its own

spring: no separate spring is drawn.

Parts list

Drawing | Name | Units | Material | Finish, heat treatment | Fit, as measured on the model
05 08 05-2 | Sperrkegel (click) | 1 | „Messingblech 3 Din 1751 Ms 58 federhart“ | untoleranced sizes ±0,1 | on 050805-1: 0 mm; round WN-22 (free): 2.519 mm, least gap 0.0706

What it does (05 08 05-2). The click on the barrel's ratchet, spring-hard brass, its own spring.

Coordinates from the datum, hole 1's centre (marked on the plan), x to the right and y up the plan as drawn; depths from

the face seen in the plan (the top). Thickness 2.56.

Holes

Hole | x | y | Size
1 | 0.00 | 0.00 | Ø 3.23 through

Contourin the plan

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

radius.

Contour | # | Element | From x, y | To x, y | Centre x, y | R
Outline | 1 | arc anticlockwise | -8.85, -2.49 | -9.26, -2.85 | -5.14, -7.21 | 6.00
Outline | 2 | line | -9.26, -2.85 | -8.96, 0.65
Outline | 3 | arc clockwise | -8.96, 0.65 | 8.11, -1.32 | -1.45, -9.35 | 12.50
Outline | 4 | arc clockwise | 8.11, -1.32 | 7.27, -2.85 | 7.27, -1.85 | 1.00
Outline | 5 | line | 7.27, -2.85 | -1.02, -2.85
Outline | 6 | arc anticlockwise | -1.02, -2.85 | -8.85, -2.49 | -5.14, -7.21 | 6.00

Levels

Faces in section A-A, from the bottom face: 2.56.

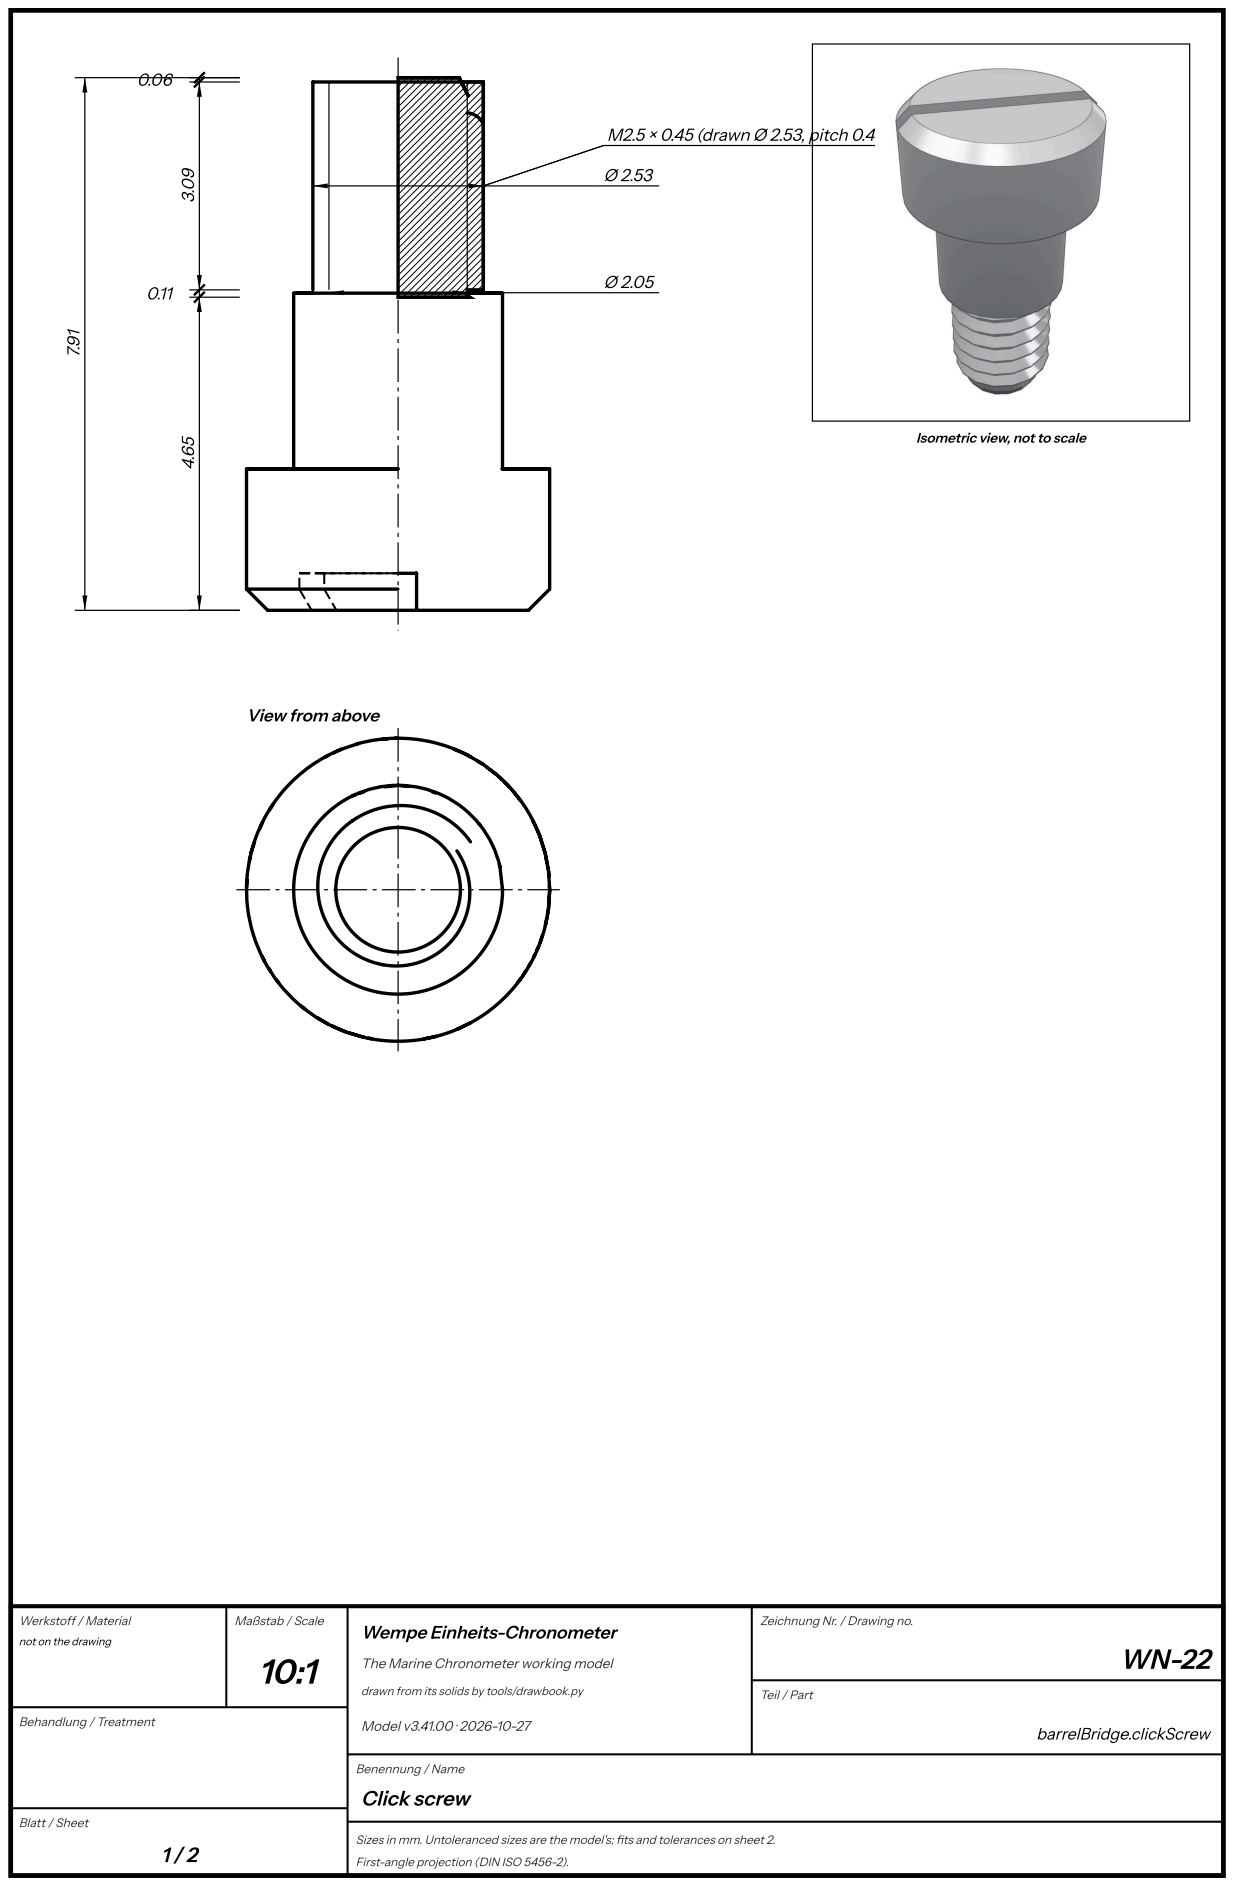
[picture p340: page 48]
M2.5 × 0.45 (drawn Ø 2.53, pitch 0.44); Werkstoff / Material; Maßstab / Scale; Behandlung / Treatment; Model v3.41.00 · 2026-10-27; Teil / Part; barrelBridge.clickScrew; Click screw

Isometric view, not to scale

View from above

Zeichnung Nr. / Drawing no.

not on the drawing

Wempe Einheits-Chronometer

The Marine Chronometer working model

drawn from its solids by tools/drawbook.py

## Click screw — sheet 2

The shouldered screw the click turns on.

Parts list

Drawing | Name | Units | Material | Finish, heat treatment | Fit, as measured on the model
WN-22 | Click screw, shouldered (WN-22) | 1 | not on the drawing | | in 050805-1 (tap): 3.211 mm, least gap 0.0237

What it does (WN-22). The click turns on its shoulder.

Turned about its axis; length 7.91, largest Ø 4.50. Diameters: Ø 2.05, Ø 2.53. Shoulders from the lower end: 0.00, 4.65, 4.76,

7.85, 7.91.

Thread

Outside thread 4.76-7.85 from the lower end, 3.09 long: drawn Ø 2.53 over its crests, 2.05 at its roots, pitch 0.44. Cut the

ISO 261 coarse thread nearest it, M2.5 × 0.45, where the part's own sheet gives none (the Wempe-Norm screws' sheets

aren't in the set).

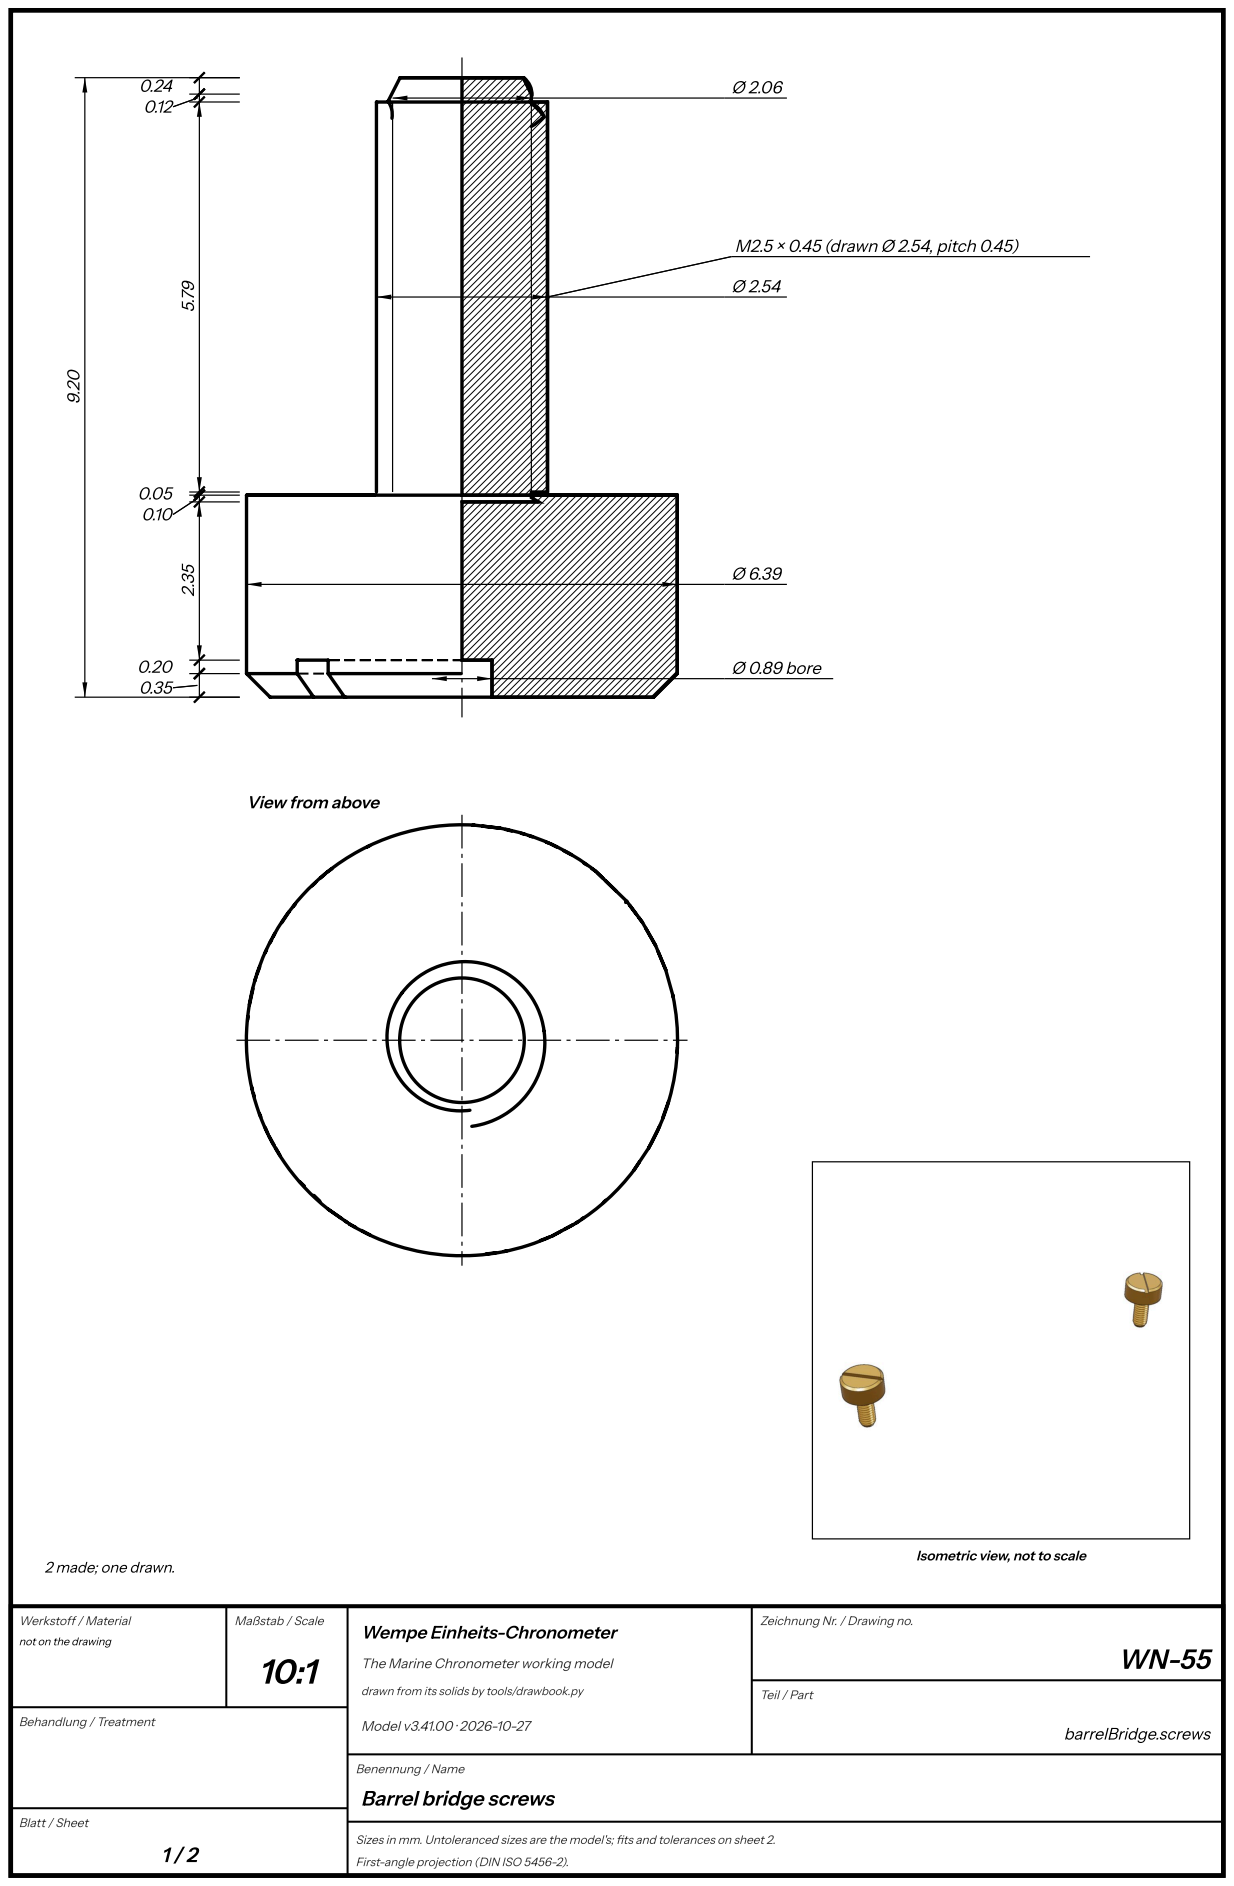
[picture p341: page 50]
Ø 0.89 bore; M2.5 × 0.45 (drawn Ø 2.54, pitch 0.45); Werkstoff / Material; Maßstab / Scale; Behandlung / Treatment; Model v3.41.00 · 2026-10-27; Teil / Part; barrelBridge.screws

View from above

2 made; one drawn.

Isometric view, not to scale

Zeichnung Nr. / Drawing no.

not on the drawing

Wempe Einheits-Chronometer

The Marine Chronometer working model

drawn from its solids by tools/drawbook.py

Barrel bridge screws

## Barrel bridge screws — sheet 2

Two screws holding the bridge to the top plate.

2 made, all alike; the drawing shows one, in its own frame (the holes' and contour's coordinates are that one's).

Parts list

Drawing | Name | Units | Material | Finish, heat treatment | Fit, as measured on the model
WN-55 | Barrel bridge screw (WN-55, by the coloured section's label) | 2 | not on the drawing | | in 050805-1 (clear): 3.369 mm, least gap 0.1343; in 050901 (tap): 2.855 mm, least gap 0.0289

What it does (WN-55). Hold the barrel bridge to the top plate.

Turned about its axis; length 9.20, largest Ø 6.40. Diameters: Ø 2.06, Ø 2.54, Ø 6.39; bores Ø 0.89. Shoulders from the lower

end: 0.00, 0.35, 0.55, 2.90, 3.00, 3.05, 8.84, 8.96, 9.20.

Thread

Outside thread 3.05-8.84 from the lower end, 5.79 long: drawn Ø 2.54 over its crests, 2.06 at its roots, pitch 0.45. Cut the

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

aren't in the set).

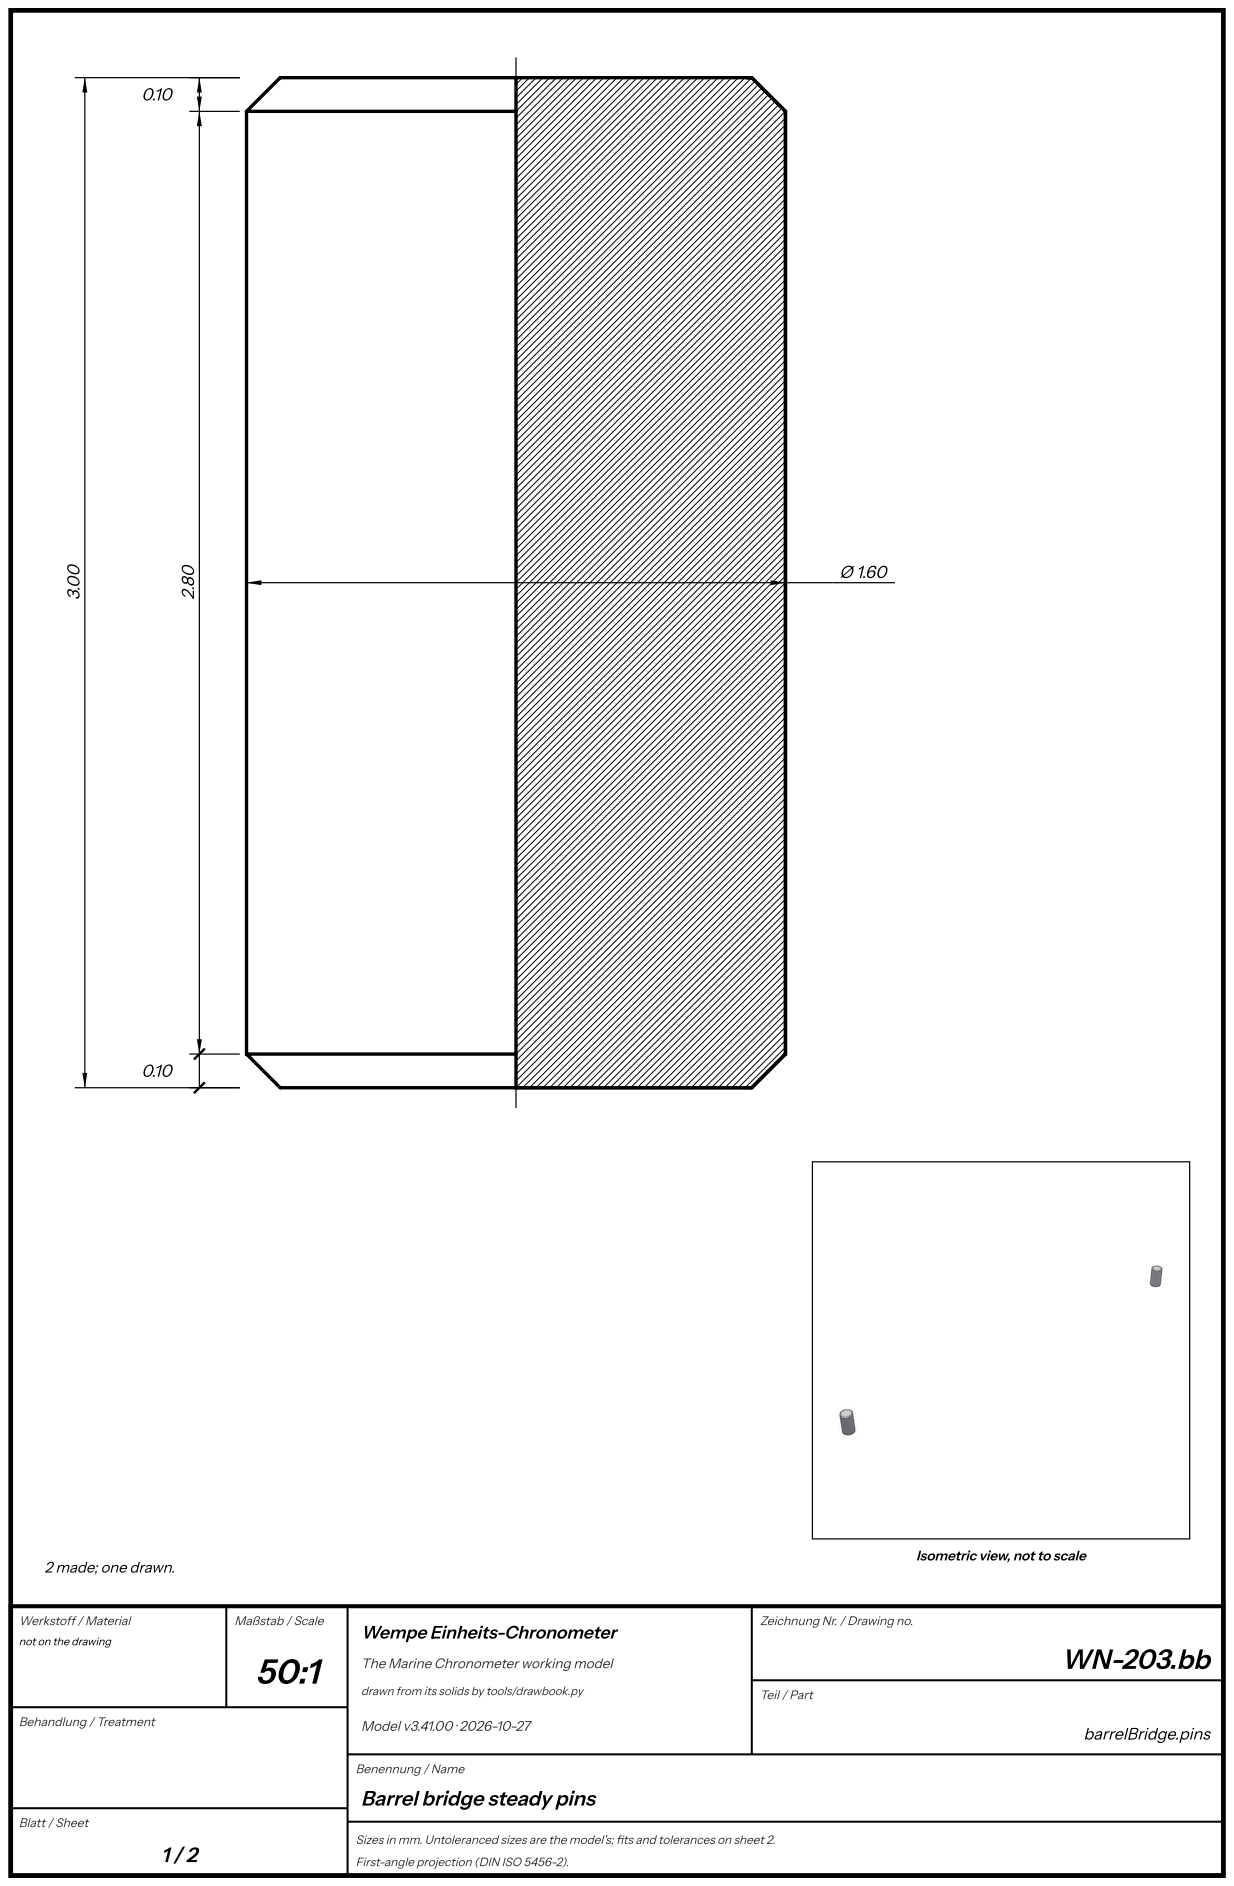
[picture p342: page 52]
Werkstoff / Material; Maßstab / Scale; Behandlung / Treatment; Model v3.41.00 · 2026-10-27; Teil / Part; barrelBridge.pins

2 made; one drawn.

Isometric view, not to scale

Zeichnung Nr. / Drawing no.

not on the drawing

Wempe Einheits-Chronometer

The Marine Chronometer working model

drawn from its solids by tools/drawbook.py

Barrel bridge steady pins

## Barrel bridge steady pins — sheet 2

A steady pin (Stellstift), Ø 1.6, pressed into the part and standing 1.3 out of it into a reamed hole in the plate, which places

the part. WN-203.

2 made, all alike; the drawing shows one, in its own frame (the holes' and contour's coordinates are that one's).

Parts list

Drawing | Name | Units | Material | Finish, heat treatment | Fit, as measured on the model
WN-203.bb | Stellstift (WN-203), barrel bridge | 2 | not on the drawing | | in 050805-1 (press): 1.427 mm, least gap -0.0061; in 050901 (clear): 1.279 mm, least gap 0.0036

What it does (WN-203.bb). Place the barrel bridge on the top plate.

Turned about its axis; length 3.00, largest Ø 1.60. Diameters: Ø 1.60. Shoulders from the lower end: 0.00, 0.10, 2.90, 3.00.

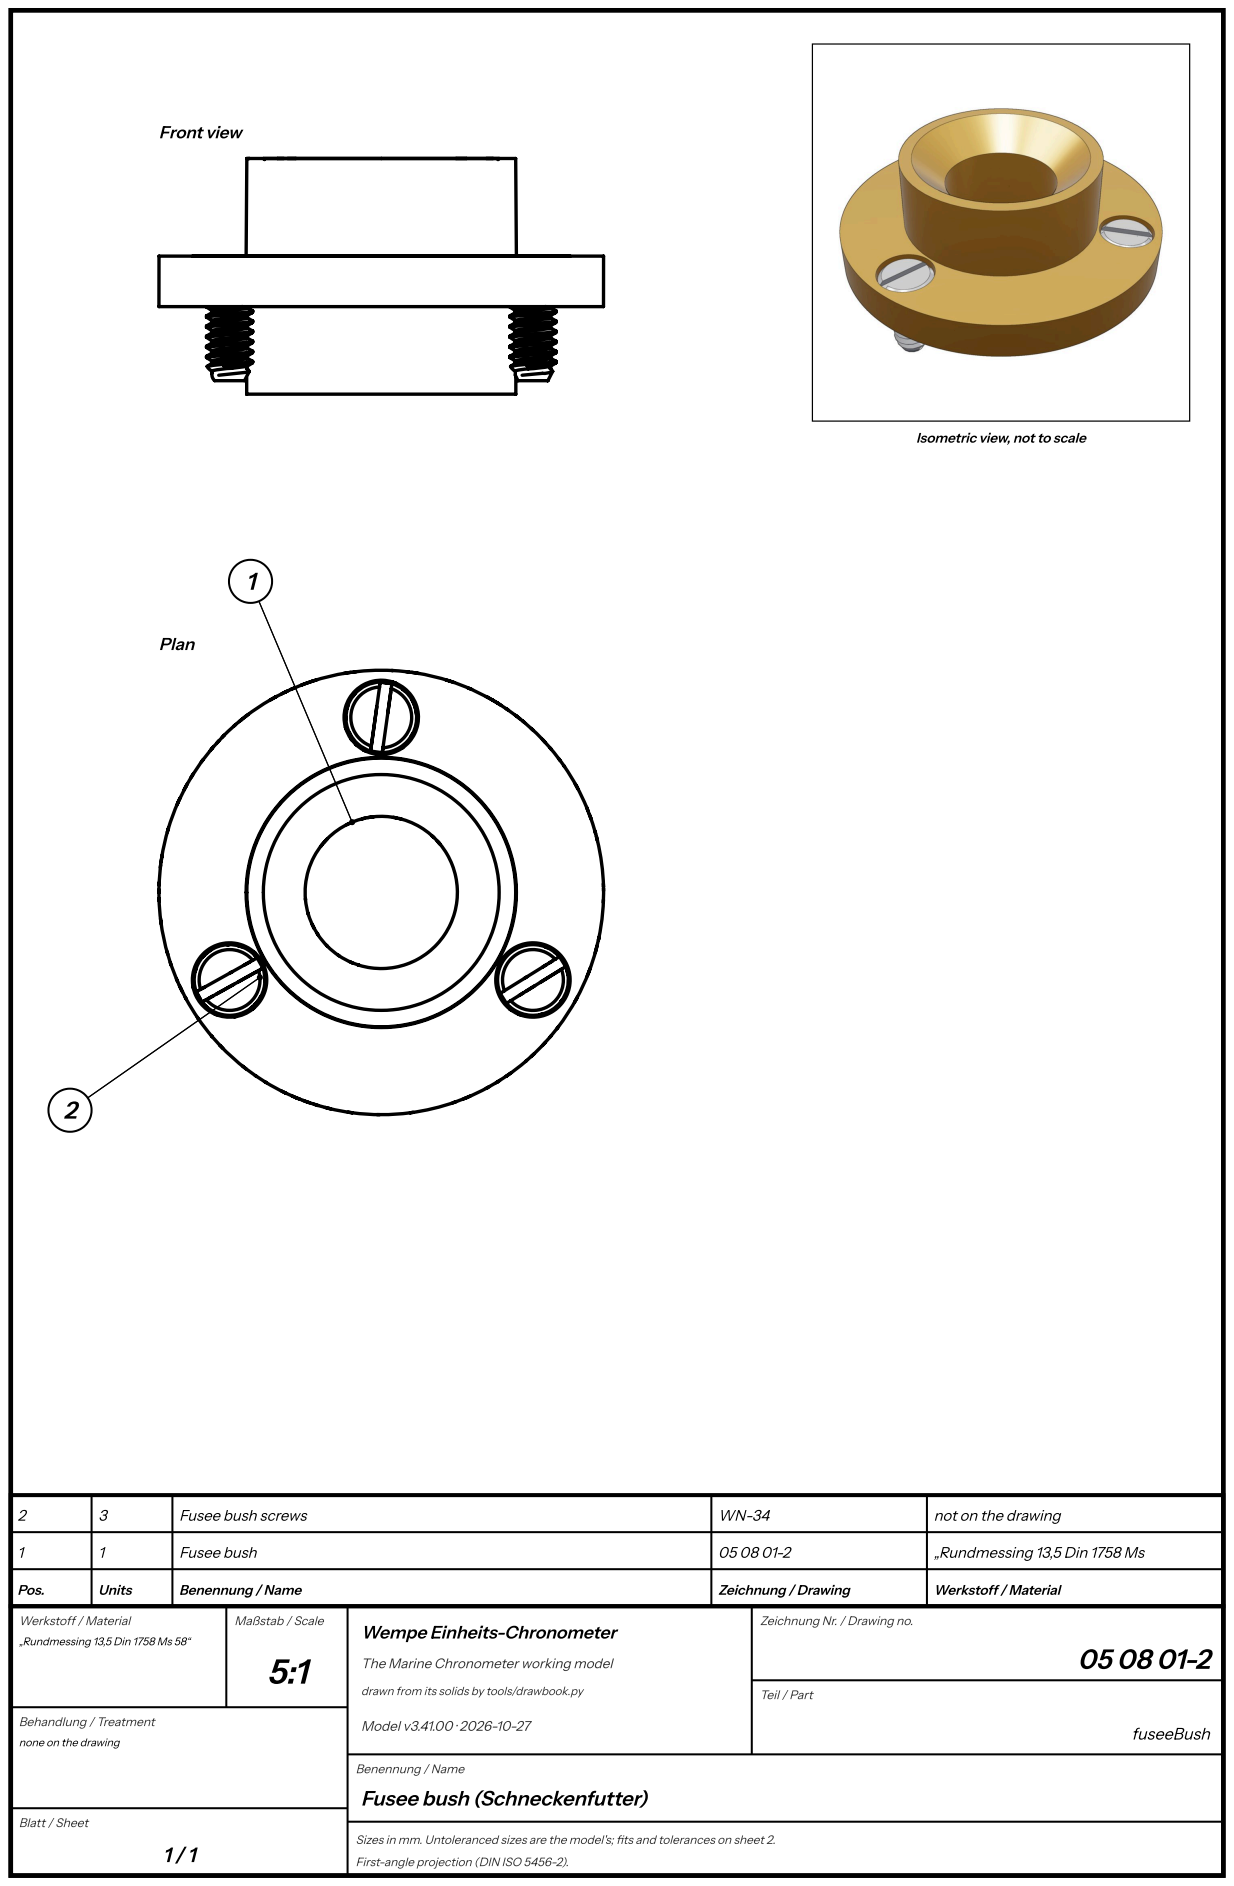
[picture p343: page 54]
Front view; Plan; Pos.; Units; Benennung / Name; Zeichnung / Drawing; Werkstoff / Material; Fusee bush; „Rundmessing 13,5 Din 1758 Ms; Fusee bush screws; not on the drawing; Maßstab / Scale; Behandlung / Treatment; Model v3.41.00 · 2026-10-27; Teil / Part; fuseeBush

Isometric view, not to scale

Zeichnung Nr. / Drawing no.

„Rundmessing 13,5 Din 1758 Ms 58“

Wempe Einheits-Chronometer

The Marine Chronometer working model

drawn from its solids by tools/drawbook.py

none on the drawing

Fusee bush (Schneckenfutter)

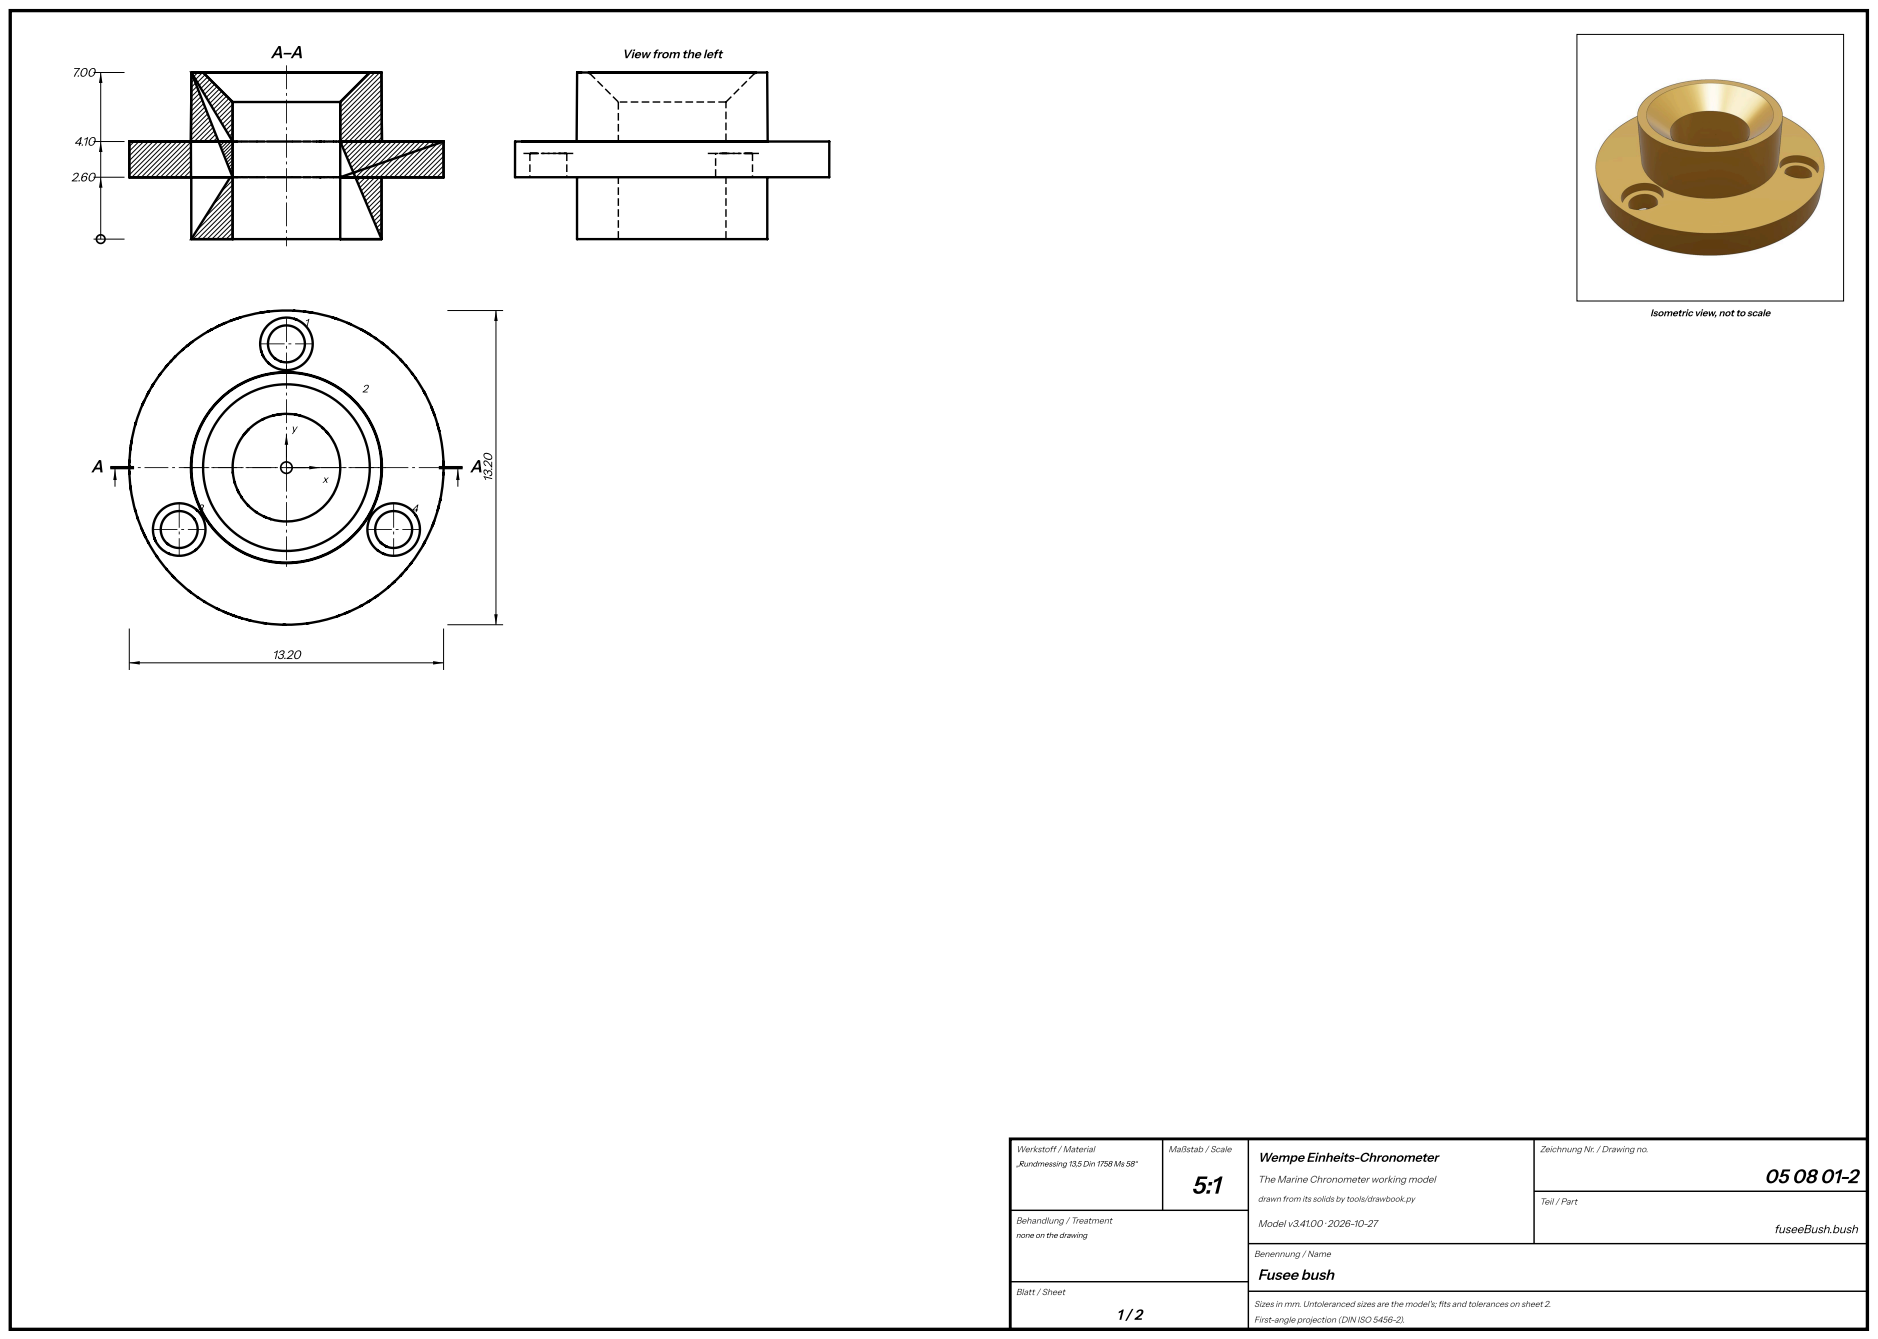
[picture p344: page 55]
Werkstoff / Material; Maßstab / Scale; Behandlung / Treatment; Model v3.41.00 · 2026-10-27; Teil / Part; fuseeBush.bush; Fusee bush

View from the left

Isometric view, not to scale

Zeichnung Nr. / Drawing no.

„Rundmessing 13,5 Din 1758 Ms 58“

Wempe Einheits-Chronometer

The Marine Chronometer working model

drawn from its solids by tools/drawbook.py

none on the drawing

## Fusee bush — sheet 2

A flanged brass bush pressed into the top plate and screwed to it, in which the fusee arbor’s winding end turns.

Parts list

Drawing | Name | Units | Material | Finish, heat treatment | Fit, as measured on the model
05 08 01-2 | Schneckenfutter (fusee bush) | 1 | „Rundmessing 13,5 Din 1758 Ms 58“ | none on the drawing | in 050901 (free): 2.579 mm, least gap 0.009; on 050901: 0 mm

What it does (05 08 01-2). Its spigot slides into the top plate's hole (8 g6 in 8.0 +0.015) and its flange is screwed to it: the

fusee arbor's winding end turns in it.

Coordinates from the datum, hole 2's centre (marked on the plan), x to the right and y up the plan as drawn; depths from

the face seen in the plan (the top). Thickness 7.00.

Holes

Hole | x | y | Size
1 | 0.00 | 5.20 | Ø 1.55 through (1.00 thick at 2.60-3.60)
2 | 0.00 | 0.00 | Ø 4.52 through (1.68 thick at 4.10-5.78); sink Ø 4.52 × 2.60 from the face at 2.60; countersunk to Ø 7.00; sink Ø 8.02 × 1.50 from the face at 4.10
3 | -4.50 | -2.60 | Ø 1.55 through (1.00 thick at 2.60-3.60)
4 | 4.50 | -2.60 | Ø 1.55 through (1.00 thick at 2.60-3.60)

Contourin the plan

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

radius.

Contour | # | Element | From x, y | To x, y | Centre x, y | R
Outline | 1 | circle | | | 0.00, 0.00 | 6.60

Levels

Faces in section A-A, from the bottom face: 2.60, 4.10, 7.00.

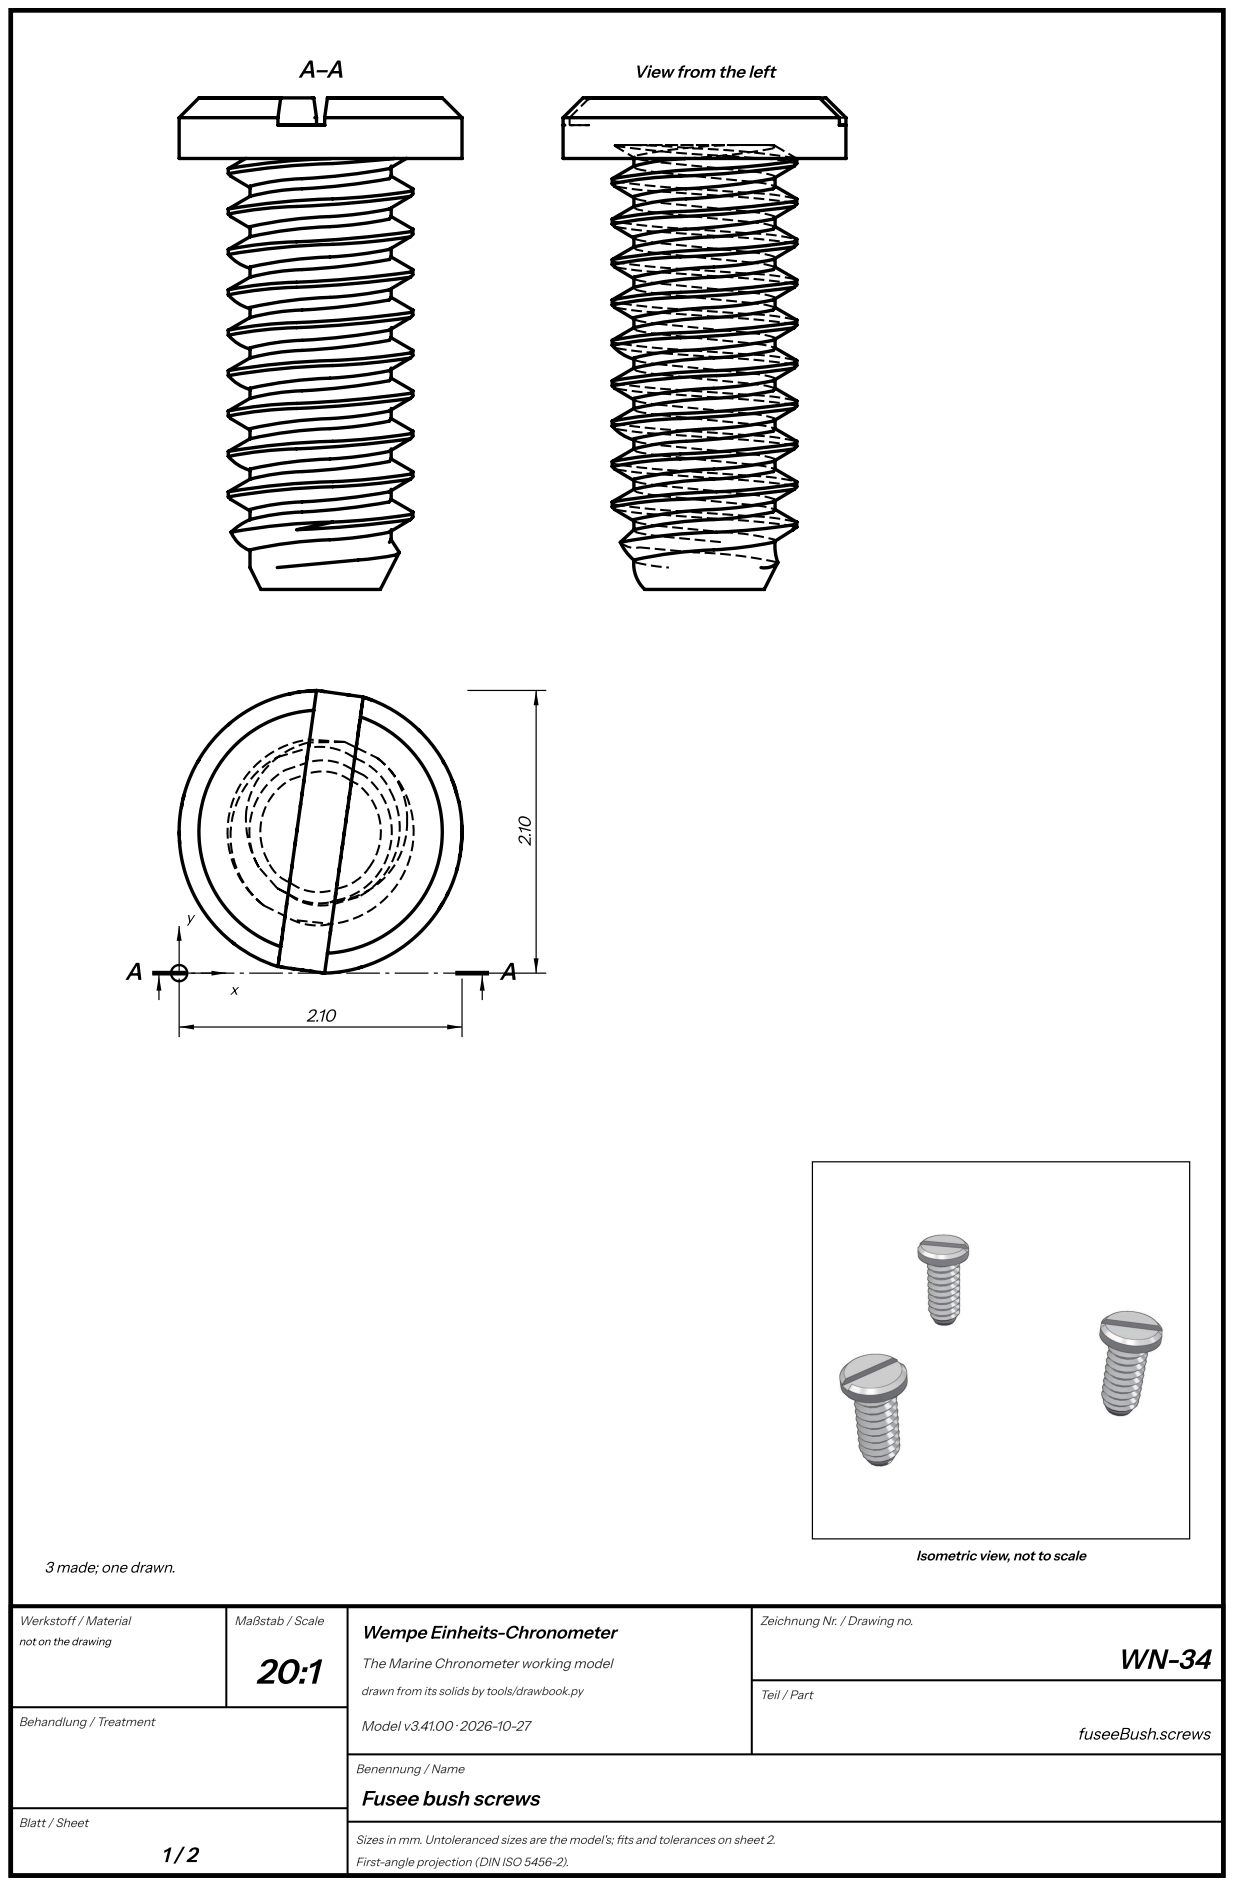
[picture p345: page 57]
Werkstoff / Material; Maßstab / Scale; Behandlung / Treatment; Model v3.41.00 · 2026-10-27; Teil / Part; fuseeBush.screws

View from the left

3 made; one drawn.

Isometric view, not to scale

Zeichnung Nr. / Drawing no.

not on the drawing

Wempe Einheits-Chronometer

The Marine Chronometer working model

drawn from its solids by tools/drawbook.py

Fusee bush screws

## Fusee bush screws — sheet 2

Three small screws holding the bush’s flange to the top plate.

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

Parts list

Drawing | Name | Units | Material | Finish, heat treatment | Fit, as measured on the model
WN-34 | Fusee bush screw (WN-34) | 3 | not on the drawing | | in 050801-2 (clear): 1.461 mm, least gap 0.0535; in 050901 (tap): 2.192 mm, least gap 0.0105

What it does (WN-34). Hold the fusee bush's flange to the top plate.

Coordinates from the datum, the corner of its bounding box (marked on the plan), x to the right and y up the plan as

drawn; depths from the face seen in the plan (the top). Thickness 3.65.

Contourin the plan

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

radius.

Contour | # | Element | From x, y | To x, y | Centre x, y | R
Outline | 1 | circle | | | 1.05, 1.05 | 1.05
Cut-out 1 | 2 | line | 1.08, 0.00 | 1.06, 0.37
Cut-out 1 | 3 | line | 1.06, 0.37 | 1.08, 0.00
Cut-out 2 | 4 | line | 2.07, 1.15 | 2.07, 1.15
Cut-out 2 | 5 | line | 2.07, 1.15 | 2.07, 1.15
Cut-out 2 | 6 | line | 2.07, 1.15 | 2.07, 1.15
Cut-out 2 | 7 | line | 2.07, 1.15 | 2.07, 1.15
Cut-out 3 | 8 | line | 1.73, 1.07 | 1.91, 1.33
Cut-out 3 | 9 | line | 1.91, 1.33 | 1.73, 1.07
Cut-out 4 | 10 | line | 1.60, 1.45 | 1.69, 1.68
Cut-out 4 | 11 | line | 1.69, 1.68 | 1.60, 1.45
Cut-out 5 | 12 | line | 1.10, 0.15 | 1.28, 0.41
Cut-out 5 | 13 | line | 1.28, 0.41 | 1.10, 0.15
Cut-out 6 | 14 | line | 1.10, 0.15 | 1.14, 0.37
Cut-out 6 | 15 | line | 1.14, 0.37 | 1.10, 0.15
Cut-out 7 | 16 | line | 0.82, 1.69 | 1.00, 1.95
Cut-out 7 | 17 | line | 1.00, 1.95 | 0.82, 1.69

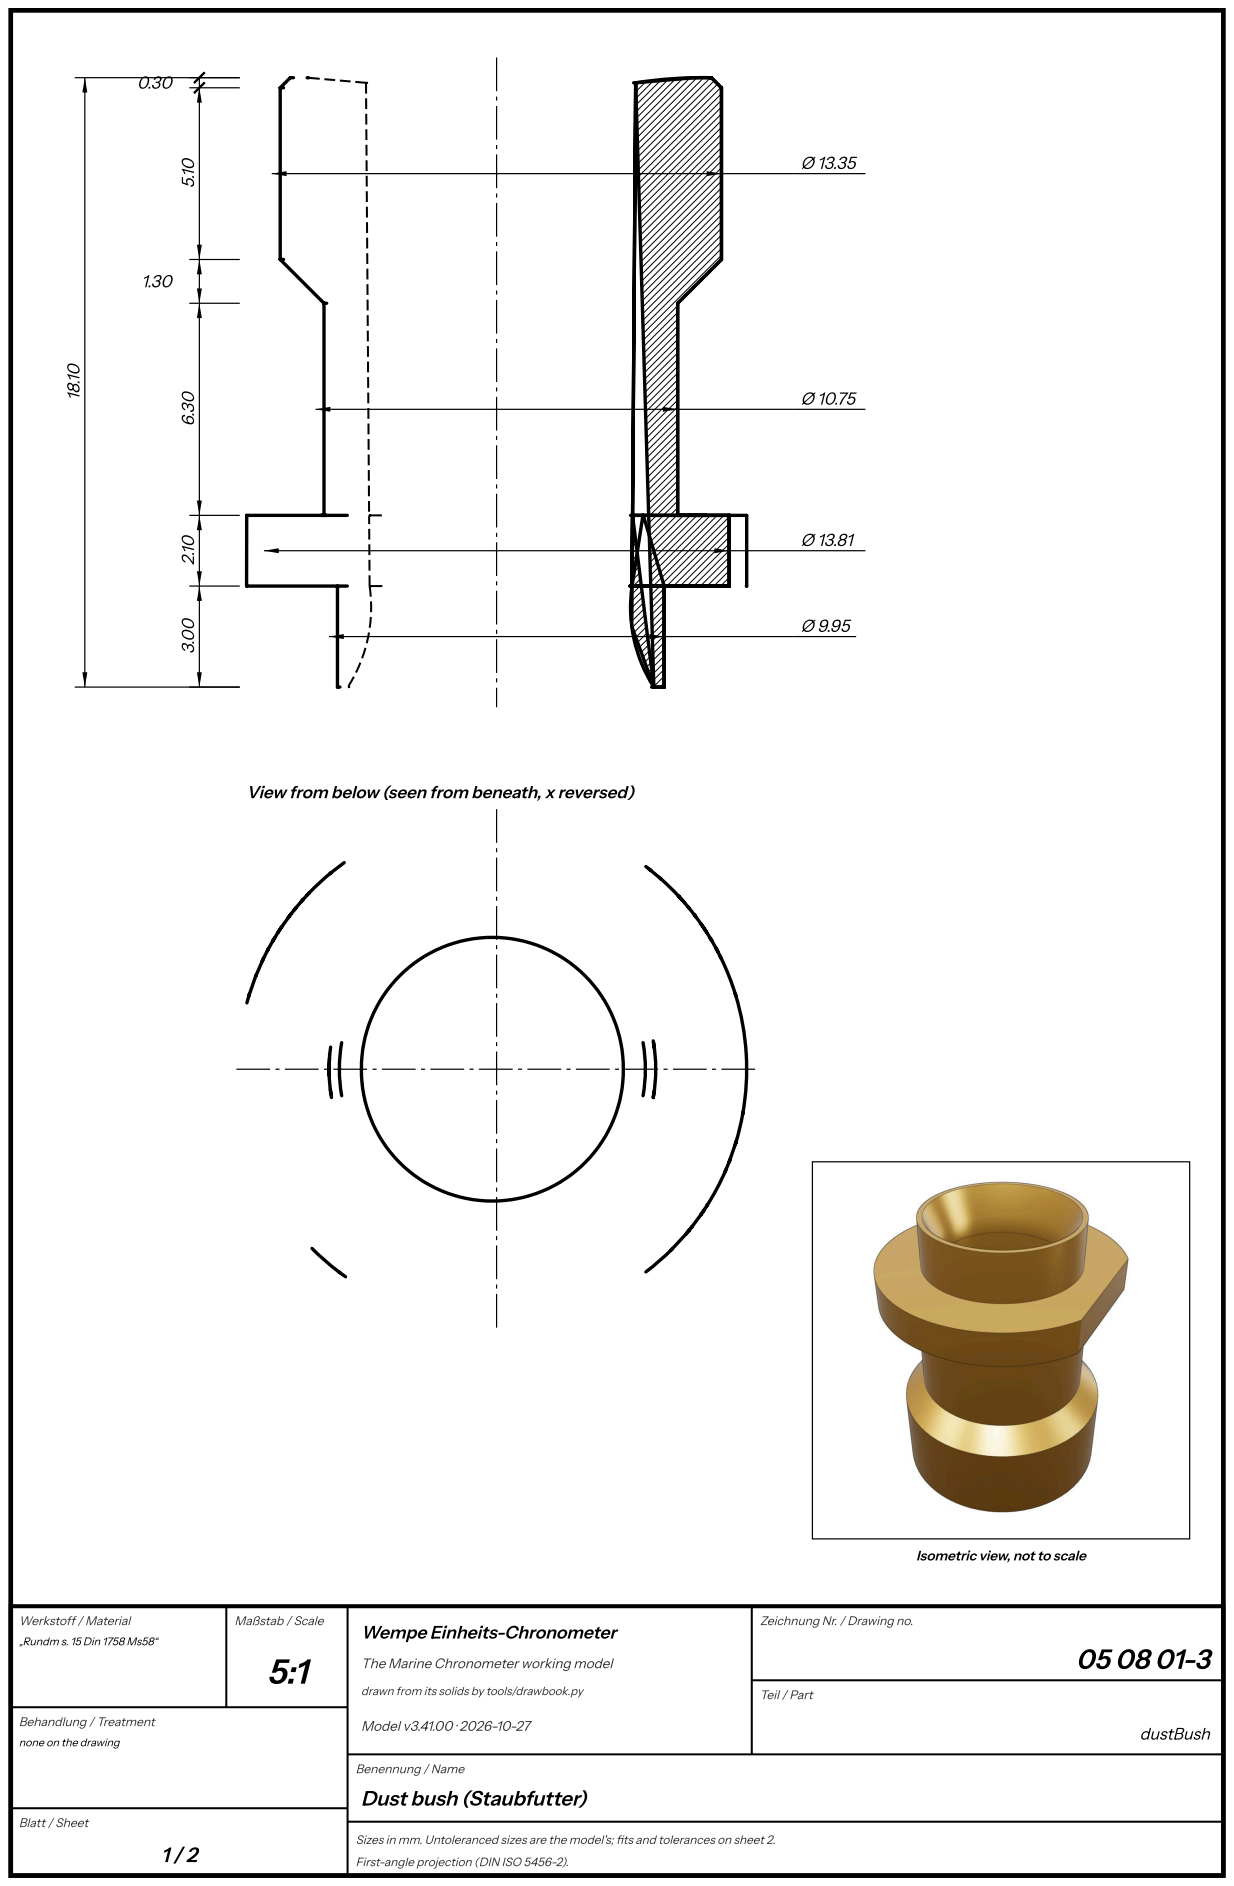
[picture p346: page 59]
Werkstoff / Material; „Rundm s.15 Din 1758 Ms58“; Maßstab / Scale; Behandlung / Treatment; Model v3.41.00 · 2026-10-27; Teil / Part; dustBush

View from below (seen from beneath, x reversed)

Isometric view, not to scale

Zeichnung Nr. / Drawing no.

Wempe Einheits-Chronometer

The Marine Chronometer working model

drawn from its solids by tools/drawbook.py

none on the drawing

Dust bush (Staubfutter)

## Dust bush (Staubfutter) — sheet 2

A tall brass bush on the fusee bush round the winding square, up to the case’s winding hole, keeping dust out of the

movement. A flat on its collar clears the balance cock.

Parts list

Drawing | Name | Units | Material | Finish, heat treatment | Fit, as measured on the model
05 08 01-3 | Staubfutter (dust bush) | 1 | „Rundm s. 15 Din 1758 Ms58“ | none on the drawing | round 050801-2 (press): 2.728 mm, least gap -0.0106; on 050801-2: 0 mm

What it does (05 08 01-3). Pressed on the fusee bush's tapered top (8 H7 on 8 T6, both 1:70), up to the case's winding hole.

Turned about its axis; length 18.10, largest Ø 14.85. Diameters: Ø 9.95, Ø 10.75, Ø 13.35, Ø 13.81. Shoulders from the lower

end: 0.00, 3.00, 5.10, 11.40, 12.70, 17.80, 18.10.

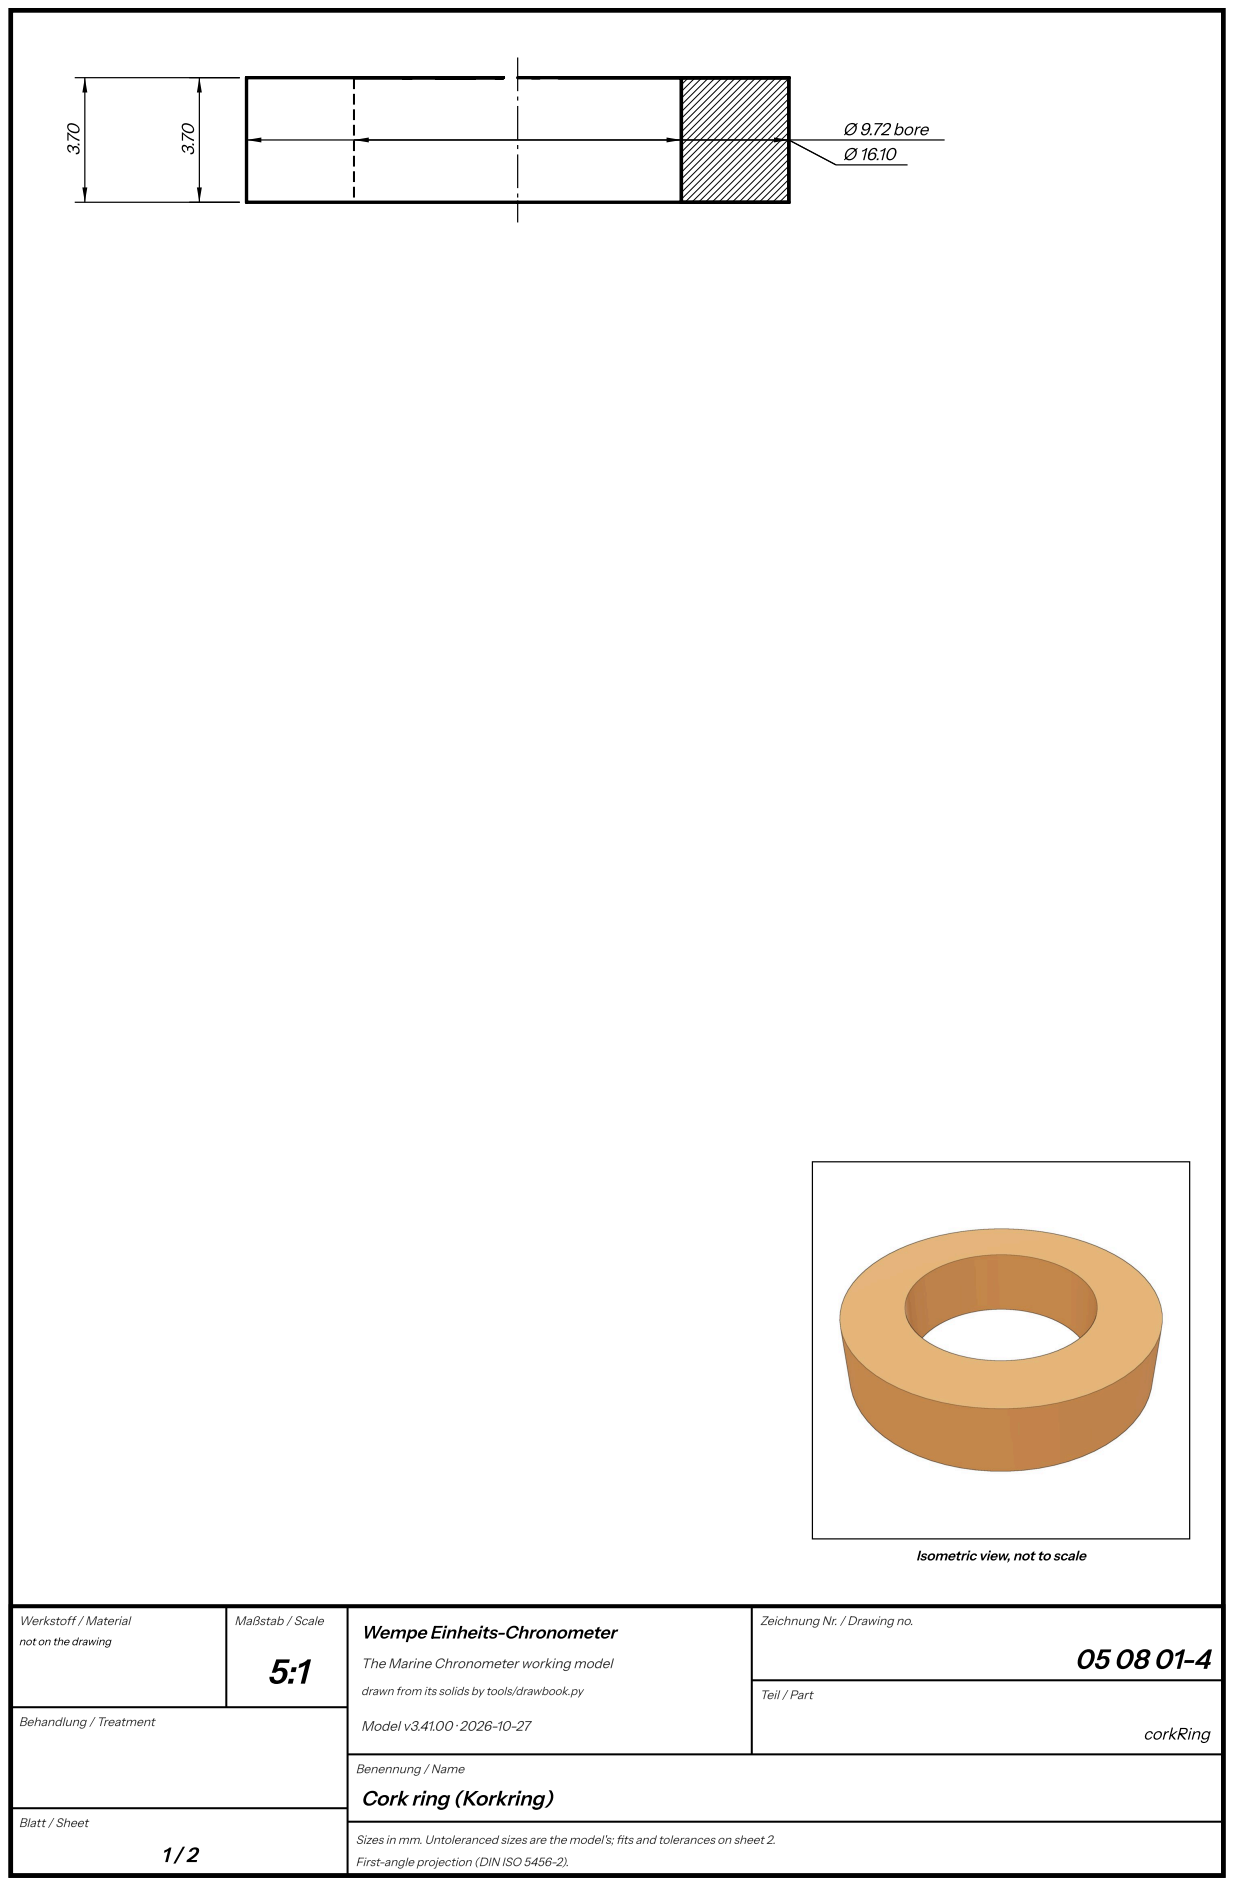
[picture p347: page 61]
Ø 9.72 bore; Werkstoff / Material; Maßstab / Scale; Behandlung / Treatment; Model v3.41.00 · 2026-10-27; Teil / Part; corkRing

Isometric view, not to scale

Zeichnung Nr. / Drawing no.

not on the drawing

Wempe Einheits-Chronometer

The Marine Chronometer working model

drawn from its solids by tools/drawbook.py

Cork ring (Korkring)

## Cork ring (Korkring) — sheet 2

A cork ring on the dust bush’s top, standing a little over it round the winding square. In the case it meets a raised seat

round the winding hole on the bowl’s bottom, so dust that comes in through the hole can’t reach the movement: it goes

only down the bush to the winding square.

Parts list

Drawing | Name | Units | Material | Finish, heat treatment | Fit, as measured on the model
05 08 01-4 | Korkring (cork ring) | 1 | not on the drawing | | round 050801-3 (press): 3.035 mm, least gap 0.01; on 050801-3: 0 mm

What it does (05 08 01-4). Pressed on the dust bush's neck, on its collar, standing 0.95 over it: the case's closing plate

meets it round the winding hole, keeping dust out (no sheet; scaled on the coloured section).

Turned about its axis; length 3.70, largest Ø 16.10. Diameters: Ø 16.10; bores Ø 9.72. Shoulders from the lower end: 0.00,

3.70.

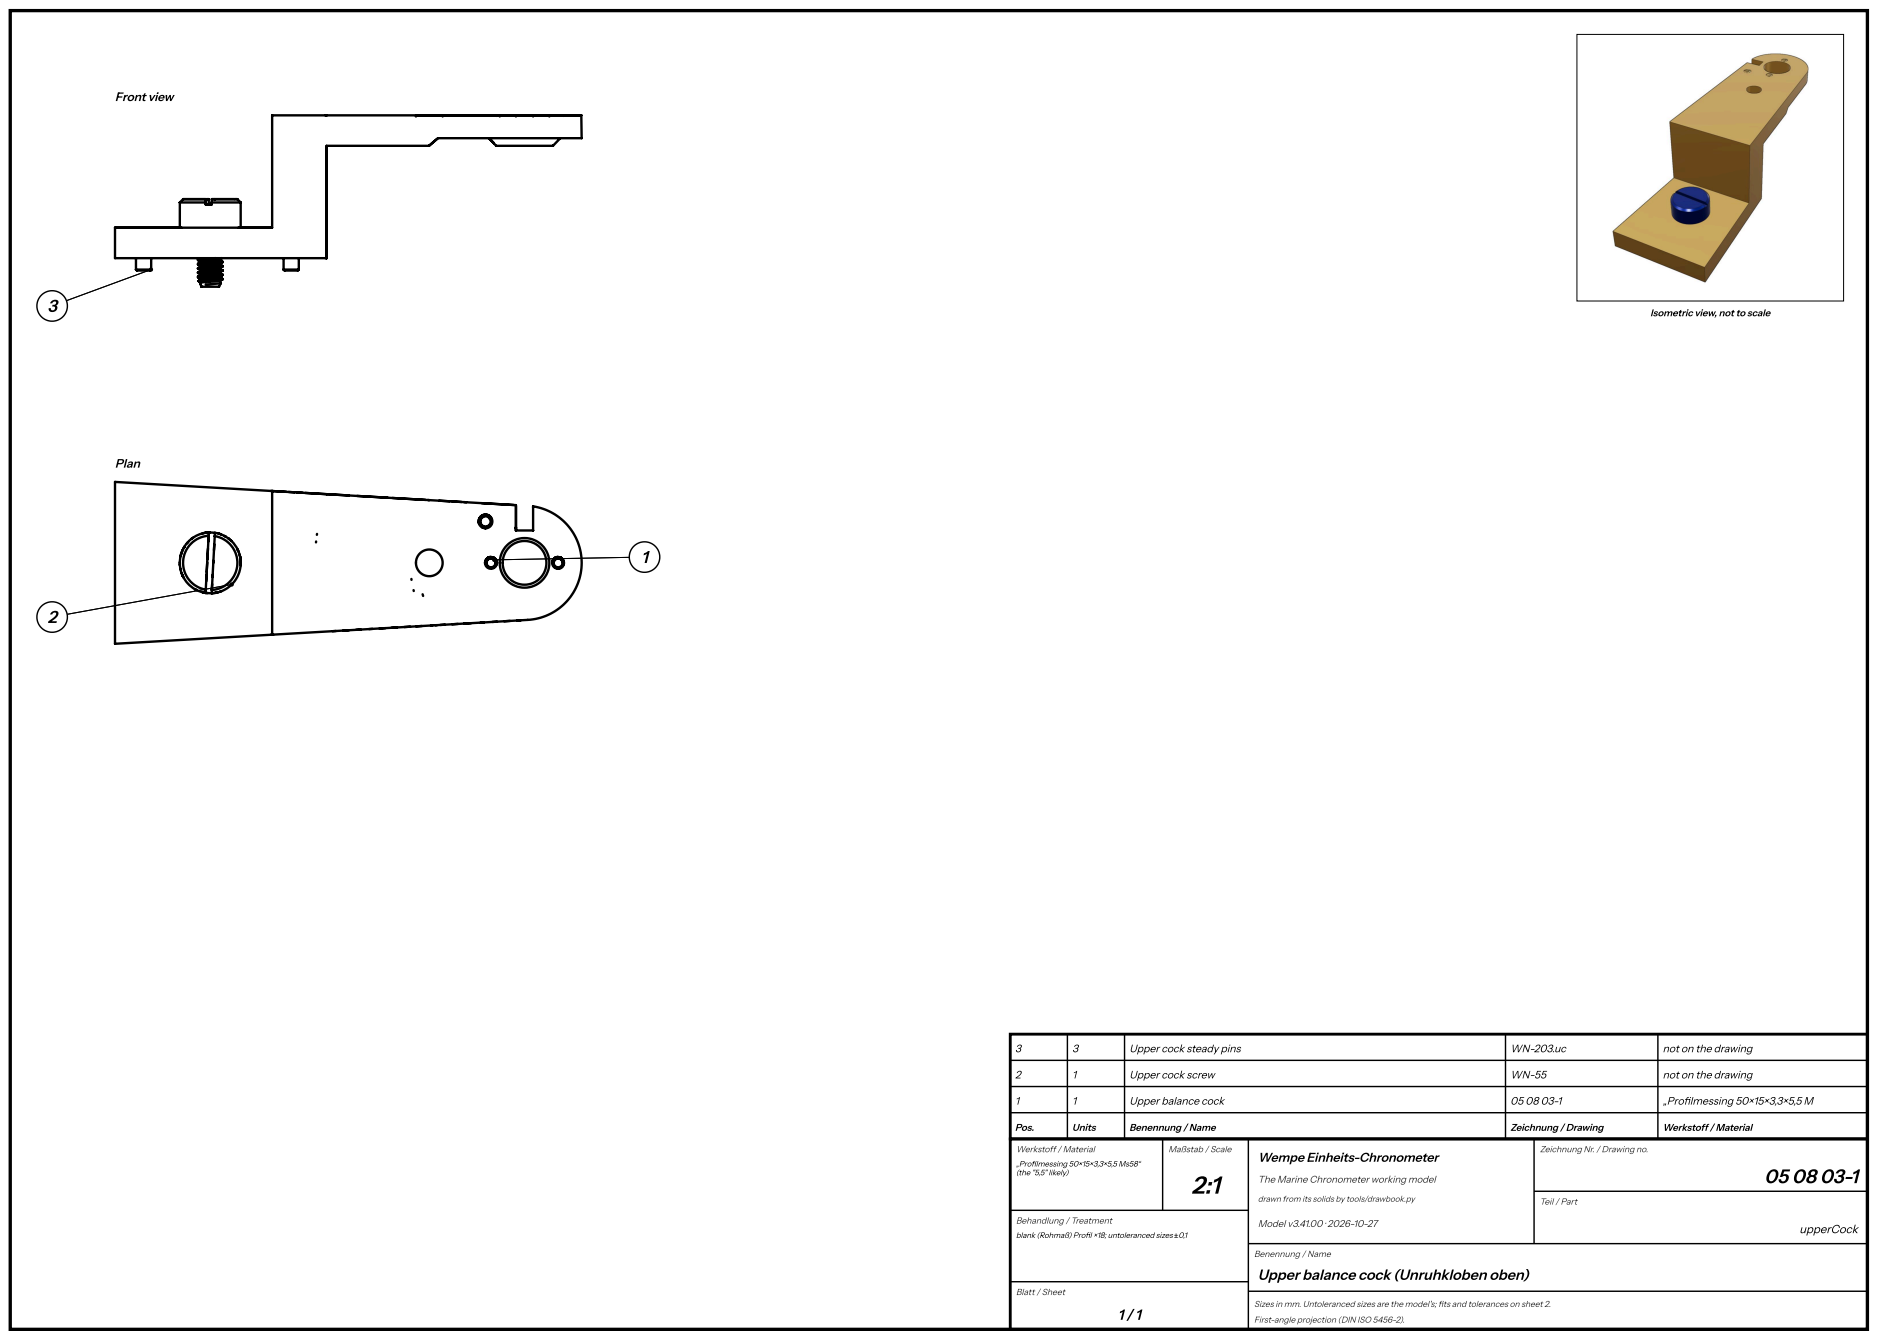
[picture p348: page 63]
Front view; Plan; Pos.; Units; Benennung / Name; Zeichnung / Drawing; Werkstoff / Material; Upper balance cock; „Profilmessing 50×15×3,3×5,5 M; Upper cock screw; not on the drawing; Upper cock steady pins; „Profilmessing 50×15×3,3×5,5 Ms58“ (the "5,5" likely); Maßstab / Scale; Behandlung / Treatment; Model v3.41.00 · 2026-10-27; Teil / Part; upperCock

Isometric view, not to scale

Zeichnung Nr. / Drawing no.

Wempe Einheits-Chronometer

The Marine Chronometer working model

drawn from its solids by tools/drawbook.py

blank (Rohmaß) Profil ×18; untoleranced sizes ±0,1

Upper balance cock (Unruhkloben oben)

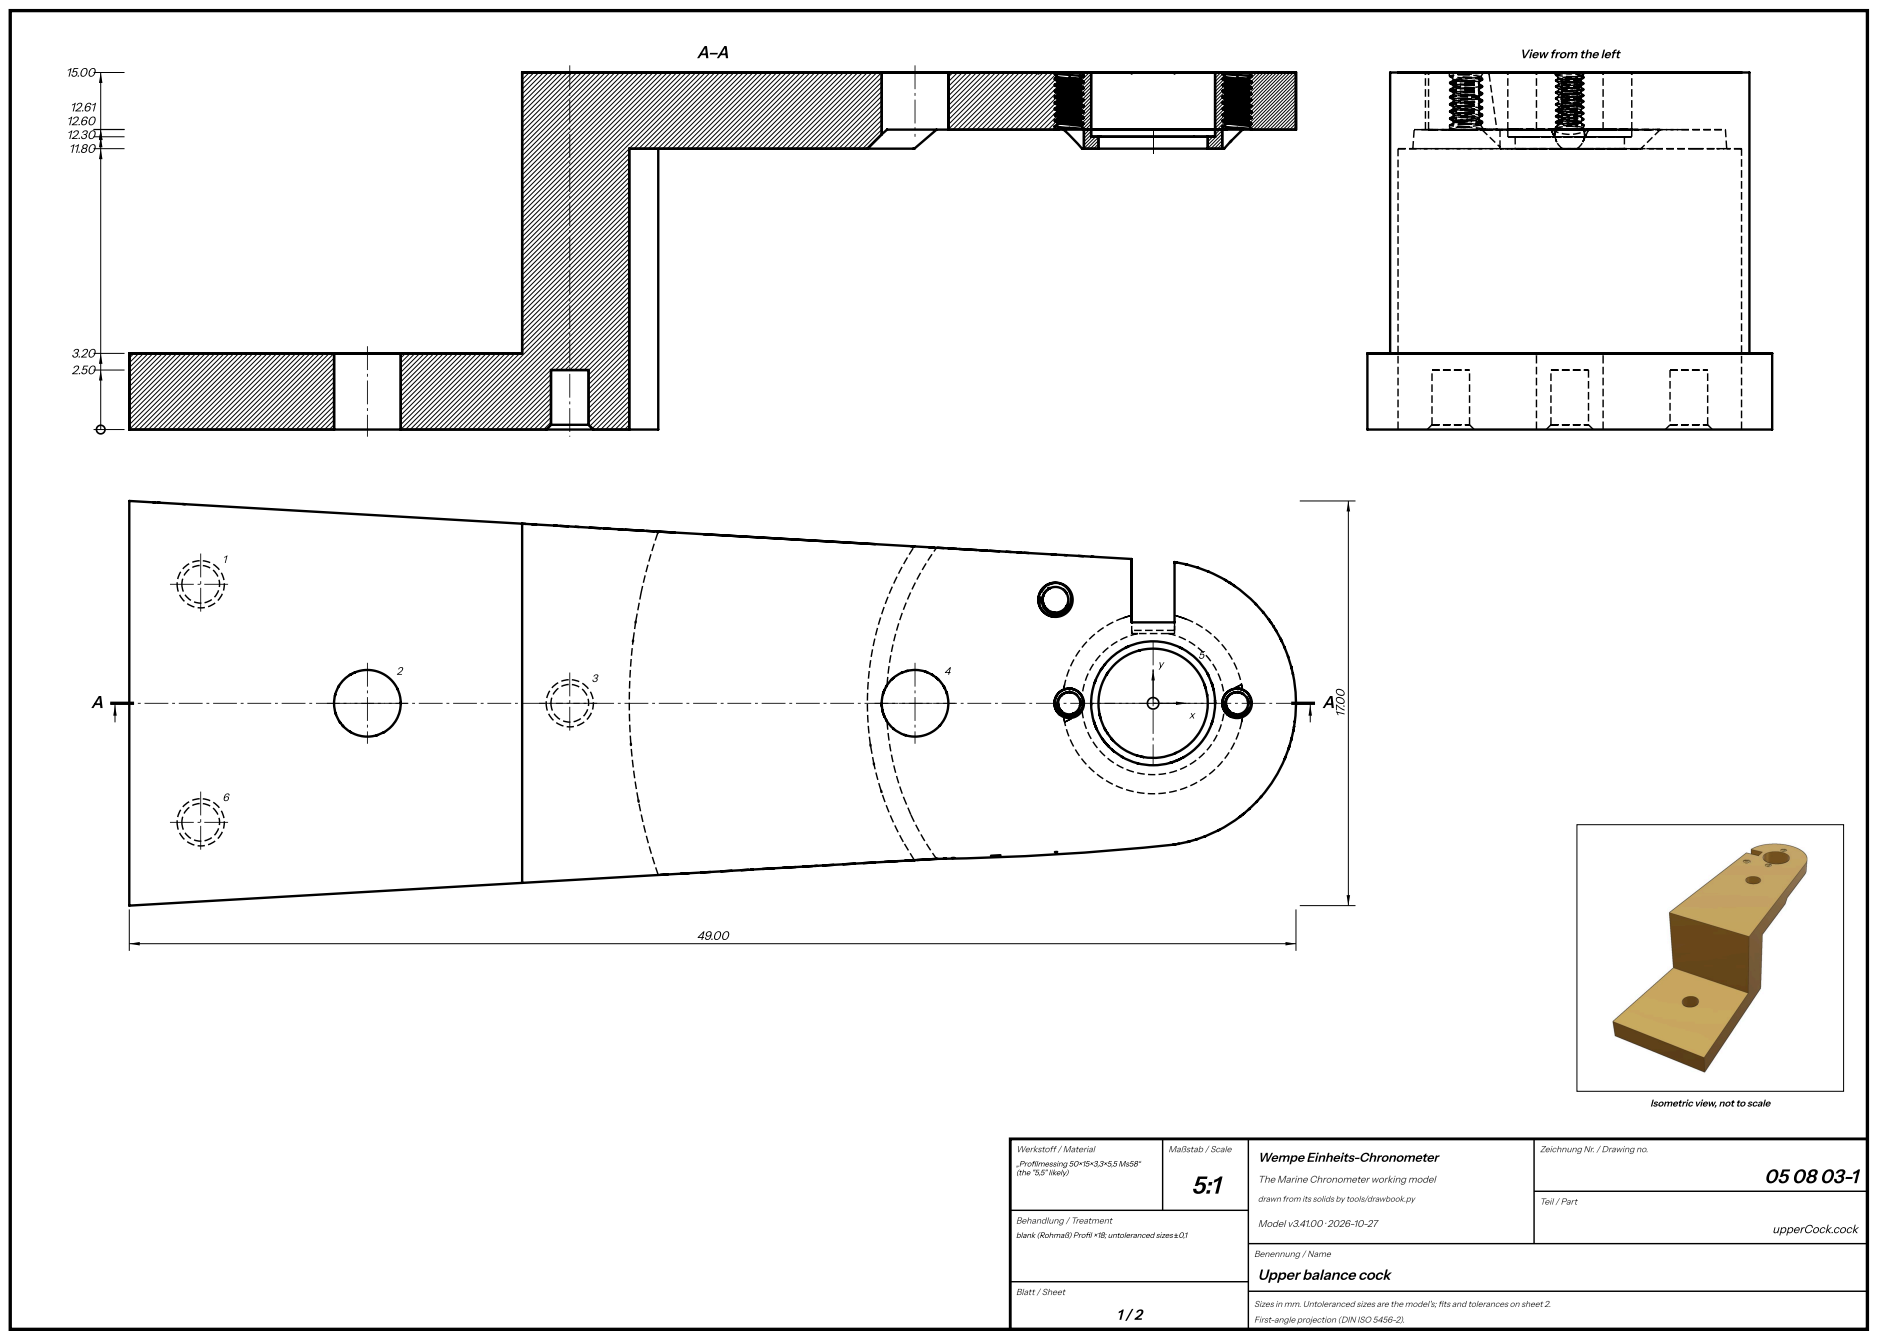
[picture p349: page 64]
Werkstoff / Material; „Profilmessing 50×15×3,3×5,5 Ms58“ (the "5,5" likely); Maßstab / Scale; Behandlung / Treatment; Model v3.41.00 · 2026-10-27; Teil / Part; upperCock.cock

View from the left

Isometric view, not to scale

Zeichnung Nr. / Drawing no.

Wempe Einheits-Chronometer

The Marine Chronometer working model

drawn from its solids by tools/drawbook.py

blank (Rohmaß) Profil ×18; untoleranced sizes ±0,1

Upper balance cock

## Upper balance cock — sheet 2

The cranked cock over the balance, screwed and pinned to the top plate, holding the balance staff’s upper jewel setting

over the opening in the plate.

Parts list

Drawing | Name | Units | Material | Finish, heat treatment | Fit, as measured on the model
05 08 03-1 | Unruhkloben oben (upper balance cock) | 1 | „Profilmessing 50×15×3,3×5,5 Ms58“ (the "5,5" likely) | blank (Rohmaß) Profil ×18; untoleranced sizes ±0,1 | on 050901: 0 mm

What it does (05 08 03-1). Holds the balance staff's upper jewel setting over the top plate.

Coordinates from the datum, hole 5's centre (marked on the plan), x to the right and y up the plan as drawn; depths from

the face seen in the plan (the top). Thickness 15.00.

Holes

Hole | x | y | Size
1 | -40.00 | 5.00 | Ø 1.58 × 2.31 deep from the face at 0.19; countersunk to Ø 1.98
2 | -33.00 | 0.00 | Ø 2.80 through (3.20 thick at 0.00-3.20)
3 | -24.50 | 0.00 | Ø 1.58 × 2.31 deep from the face at 0.19; countersunk to Ø 1.98
4 | -10.00 | 0.00 | Ø 2.80 through (2.40 thick at 12.60-15.00)
5 | 0.00 | 0.00 | Ø 4.59 through (0.50 thick at 11.80-12.30)
6 | -40.00 | -5.00 | Ø 1.58 × 2.31 deep from the face at 0.19; countersunk to Ø 1.98

Contourin the plan

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

radius.

Contour | # | Element | From x, y | To x, y | Centre x, y | R
Outline | 1 | line | -10.03, 6.59 | -0.90, 6.06
Outline | 2 | line | -0.90, 6.06 | -0.90, 3.40
Outline | 3 | line | -0.90, 3.40 | 0.90, 3.40
Outline | 4 | line | 0.90, 3.40 | 0.90, 5.93
Outline | 5 | arc clockwise | 0.90, 5.93 | 0.35, -5.99 | 0.00, 0.00 | 6.00
Outline | 6 | line | 0.35, -5.99 | -43.00, -8.50
Outline | 7 | line | -43.00, -8.50 | -43.00, 8.50
Outline | 8 | line | -43.00, 8.50 | -10.03, 6.59
Cut-out 1 | 9 | line | 5.50, -2.41 | 2.87, -2.49
Cut-out 1 | 10 | line | 2.87, -2.49 | 5.50, -2.41
Cut-out 4 | 11 | line | -0.10, -2.60 | -0.10, -2.60
Cut-out 4 | 12 | line | -0.10, -2.60 | -0.10, -2.60
Cut-out 4 | 13 | line | -0.10, -2.60 | -0.10, -2.60
Cut-out 4 | 14 | line | -0.10, -2.60 | -0.10, -2.60
Cut-out 6 | 15 | line | -3.10, 0.45 | -3.07, 0.42
Cut-out 6 | 16 | line | -3.07, 0.42 | -3.10, 0.45
Cut-out 7 | 17 | line | -3.22, 0.54 | -3.15, 0.49
Cut-out 7 | 18 | line | -3.15, 0.49 | -3.22, 0.54
Cut-out 8 | 19 | line | -3.58, -0.62 | -3.53, -0.62
Cut-out 8 | 20 | line | -3.53, -0.62 | -3.58, -0.62

Cut-out 10 | 21 | line | -3.69, -0.60 | -3.78, -0.57
Cut-out 10 | 22 | line | -3.78, -0.57 | -3.69, -0.60
Cut-out 11 | 23 | line | -3.71, 0.59 | -3.80, 0.55
Cut-out 11 | 24 | line | -3.80, 0.55 | -3.71, 0.59
Cut-out 12 | 25 | line | -3.80, 0.55 | -3.80, 0.55
Cut-out 12 | 26 | arc anticlockwise | -3.80, 0.55 | -3.80, 0.55 | -11.52, -3.30 | 8.62
Cut-out 12 | 27 | line | -3.80, 0.55 | -3.80, 0.55
Cut-out 13 | 28 | arc clockwise | -3.88, 0.50 | -3.88, 0.50 | -11.37, -4.88 | 9.22
Cut-out 13 | 29 | arc anticlockwise | -3.88, 0.50 | -3.88, 0.50 | -11.36, -4.89 | 9.22
Cut-out 14 | 30 | line | -3.89, 0.49 | -3.89, 0.49
Cut-out 14 | 31 | line | -3.89, 0.49 | -3.89, 0.49
Cut-out 14 | 32 | line | -3.89, 0.49 | -3.89, 0.49
Cut-out 15 | 33 | line | -3.92, 5.03 | -3.92, 5.03
Cut-out 15 | 34 | line | -3.92, 5.03 | -3.92, 5.03
Cut-out 16 | 35 | line | -3.93, 4.99 | -3.95, 4.90
Cut-out 16 | 36 | line | -3.95, 4.90 | -3.93, 4.99
Cut-out 17 | 37 | line | -3.96, 0.43 | -3.96, 0.43
Cut-out 17 | 38 | arc anticlockwise | -3.96, 0.43 | -3.96, 0.43 | -11.18, -6.79 | 10.22
Cut-out 17 | 39 | line | -3.96, 0.43 | -3.96, 0.43
Cut-out 18 | 40 | line | -4.47, 3.73 | -4.47, 3.73
Cut-out 18 | 41 | arc anticlockwise | -4.47, 3.73 | -4.47, 3.73 | -15.31, 10.16 | 12.60
Cut-out 18 | 42 | line | -4.47, 3.73 | -4.47, 3.73

Levels

Faces in section A-A, from the bottom face: 2.50, 3.20, 11.80, 12.30, 12.60, 12.61, 15.00.

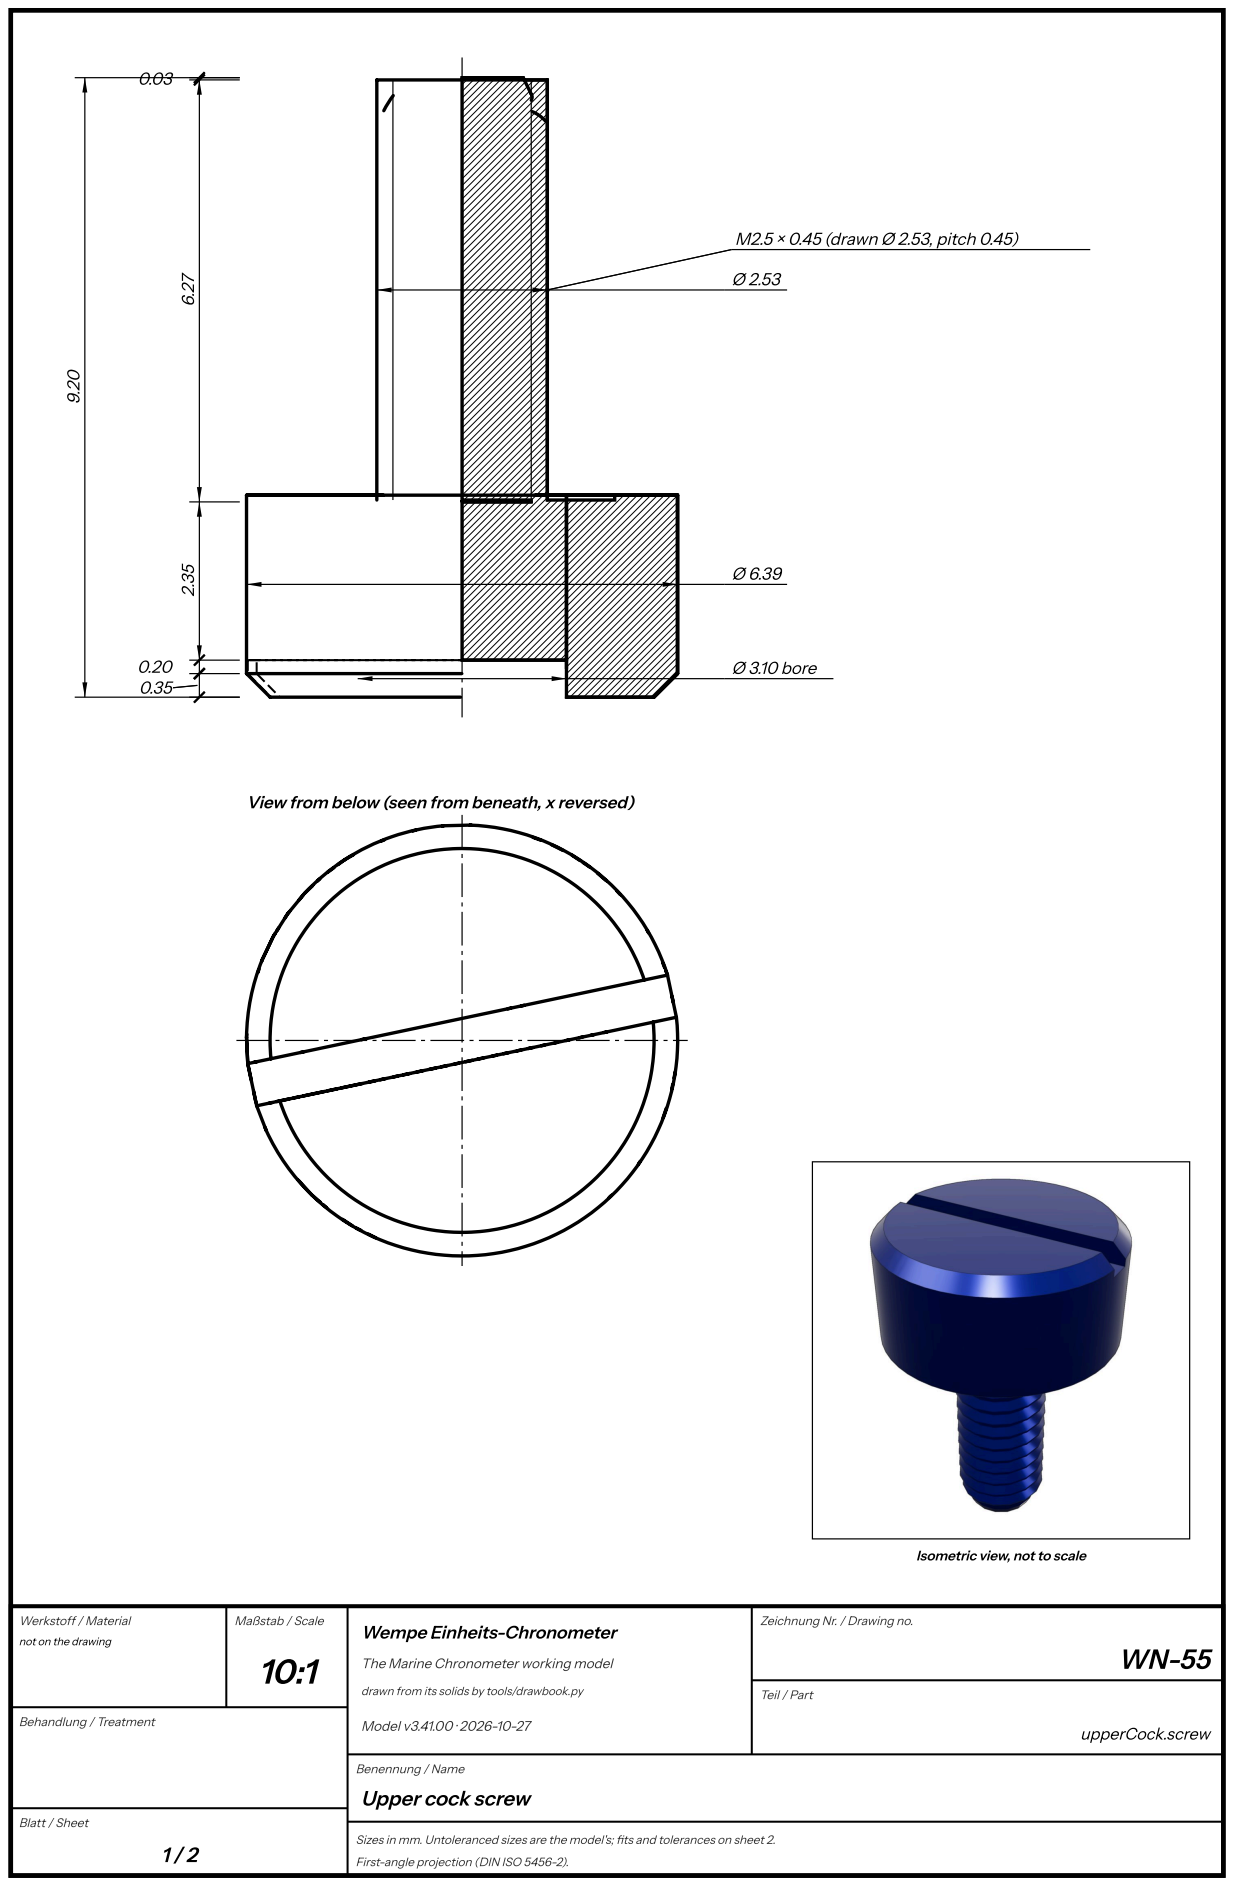
[picture p350: page 67]
Ø 3.10 bore; M2.5 × 0.45 (drawn Ø 2.53, pitch 0.45); Werkstoff / Material; Maßstab / Scale; Behandlung / Treatment; Model v3.41.00 · 2026-10-27; Teil / Part; upperCock.screw

View from below (seen from beneath, x reversed)

Isometric view, not to scale

Zeichnung Nr. / Drawing no.

not on the drawing

Wempe Einheits-Chronometer

The Marine Chronometer working model

drawn from its solids by tools/drawbook.py

Upper cock screw

## Upper cock screw — sheet 2

The blued screw holding the cock to the top plate.

Parts list

Drawing | Name | Units | Material | Finish, heat treatment | Fit, as measured on the model
WN-55 | Upper balance cock screw (hole 8; WN-55 by the coloured section's label) | 1 | not on the drawing | | in 050803-1 (clear): 3.14 mm, least gap 0.1248; in 050901 (tap): 3.026 mm, least gap 0.0208

What it does (WN-55). Holds the upper cock to the top plate.

Turned about its axis; length 9.20, largest Ø 6.40. Diameters: Ø 2.53, Ø 6.39; bores Ø 3.10. Shoulders from the lower end:

0.00, 0.35, 0.55, 2.90, 9.17, 9.20.

Thread

Outside thread 2.93-9.17 from the lower end, 6.24 long: drawn Ø 2.53 over its crests, 2.05 at its roots, pitch 0.45. Cut the ISO

261 coarse thread nearest it, M2.5 × 0.45, where the part's own sheet gives none (the Wempe-Norm screws' sheets aren't

in the set).

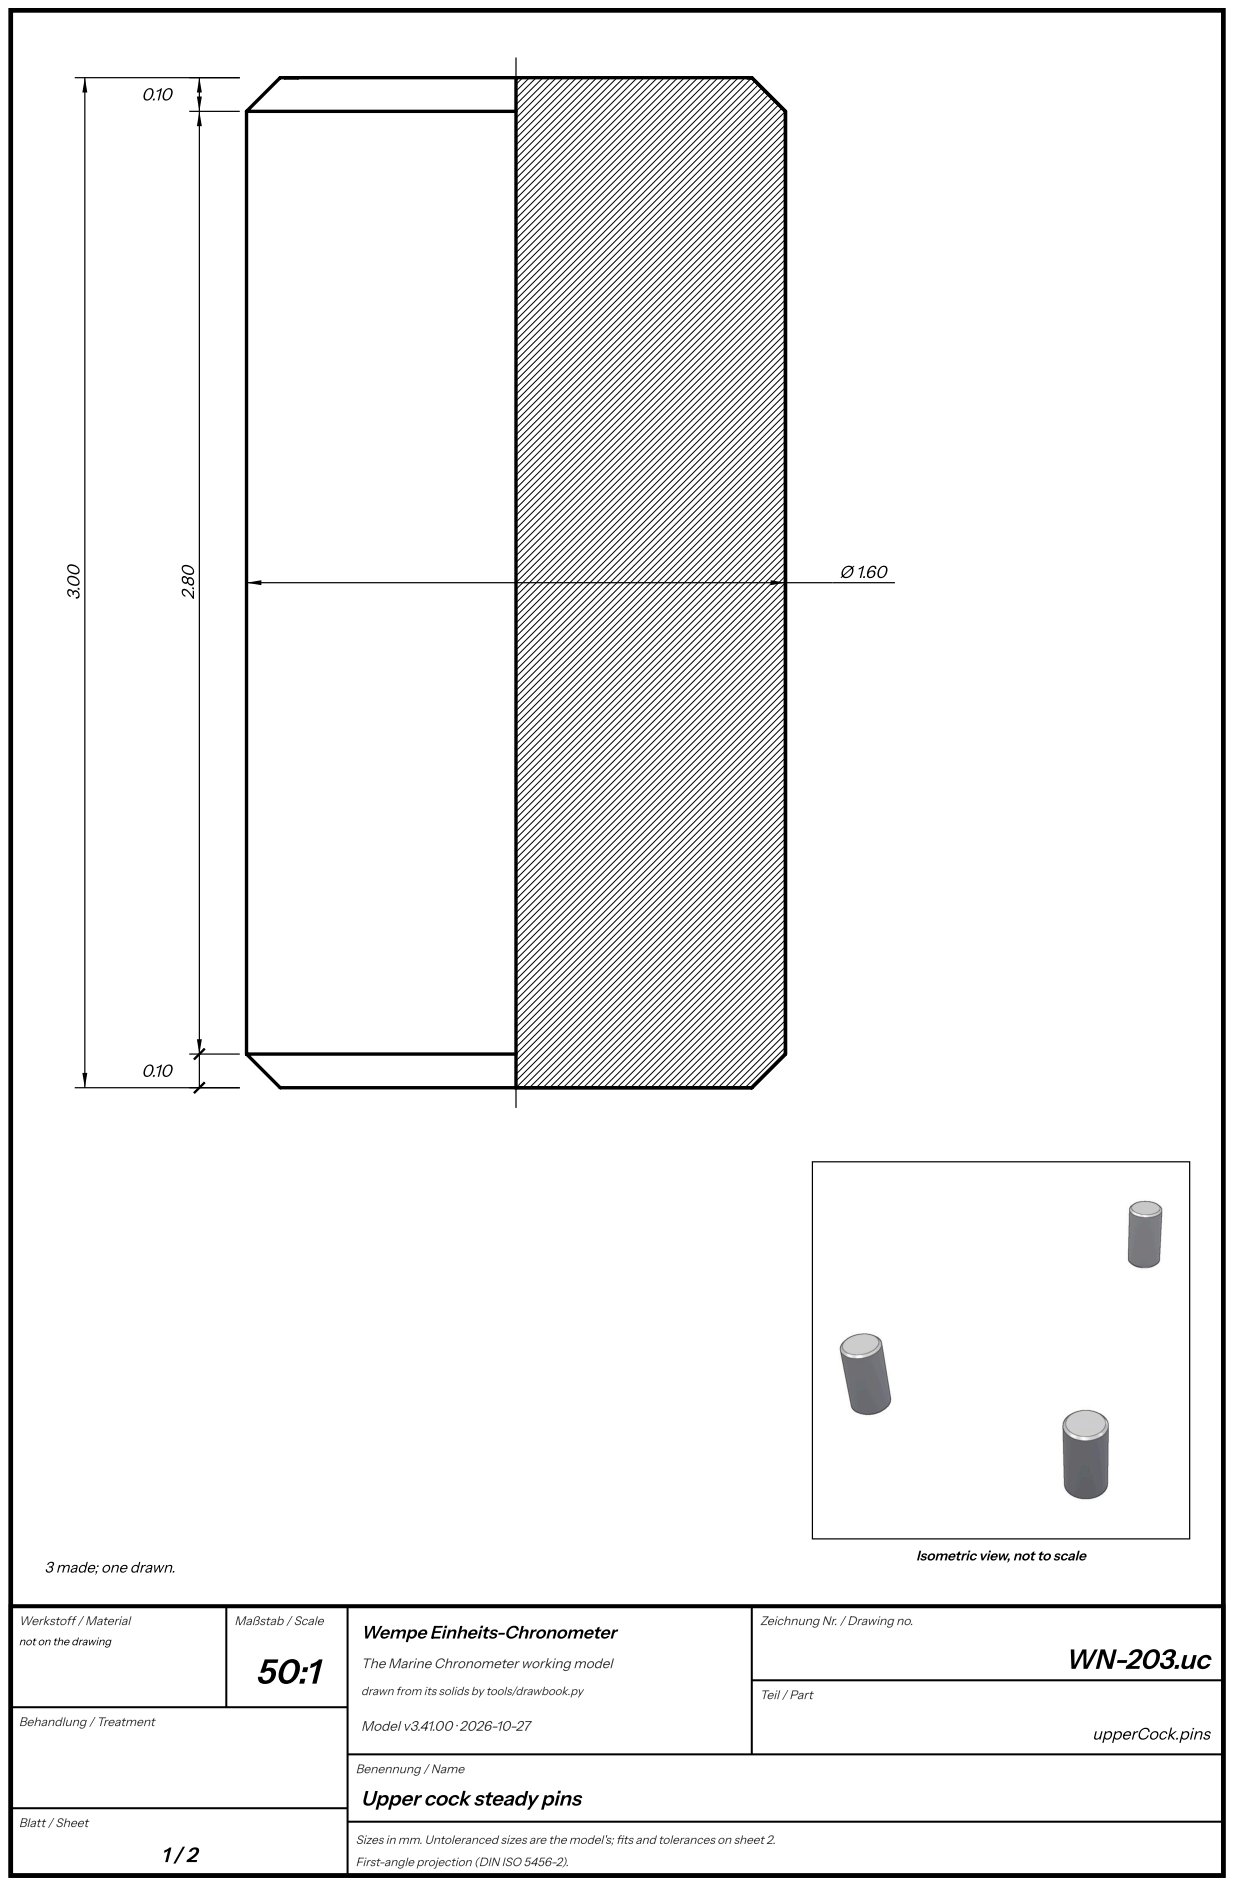
[picture p351: page 69]
Werkstoff / Material; Maßstab / Scale; Behandlung / Treatment; Model v3.41.00 · 2026-10-27; Teil / Part; upperCock.pins

3 made; one drawn.

Isometric view, not to scale

Zeichnung Nr. / Drawing no.

not on the drawing

Wempe Einheits-Chronometer

The Marine Chronometer working model

drawn from its solids by tools/drawbook.py

Upper cock steady pins

## Upper cock steady pins — sheet 2

A steady pin (Stellstift), Ø 1.6, pressed into the part and standing 1.3 out of it into a reamed hole in the plate, which places

the part.

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

Parts list

Drawing | Name | Units | Material | Finish, heat treatment | Fit, as measured on the model
WN-203.uc | Stellstift, upper balance cock (holes 6, 9, 50; WN not given, as WN-203) | 3 | not on the drawing | | in 050803-1 (press): 1.525 mm, least gap -0.0062; in 050901 (clear): 1.279 mm, least gap 0.0036

What it does (WN-203.uc). Place the upper cock on the top plate.

Turned about its axis; length 3.00, largest Ø 1.60. Diameters: Ø 1.60. Shoulders from the lower end: 0.00, 0.10, 2.90, 3.00.

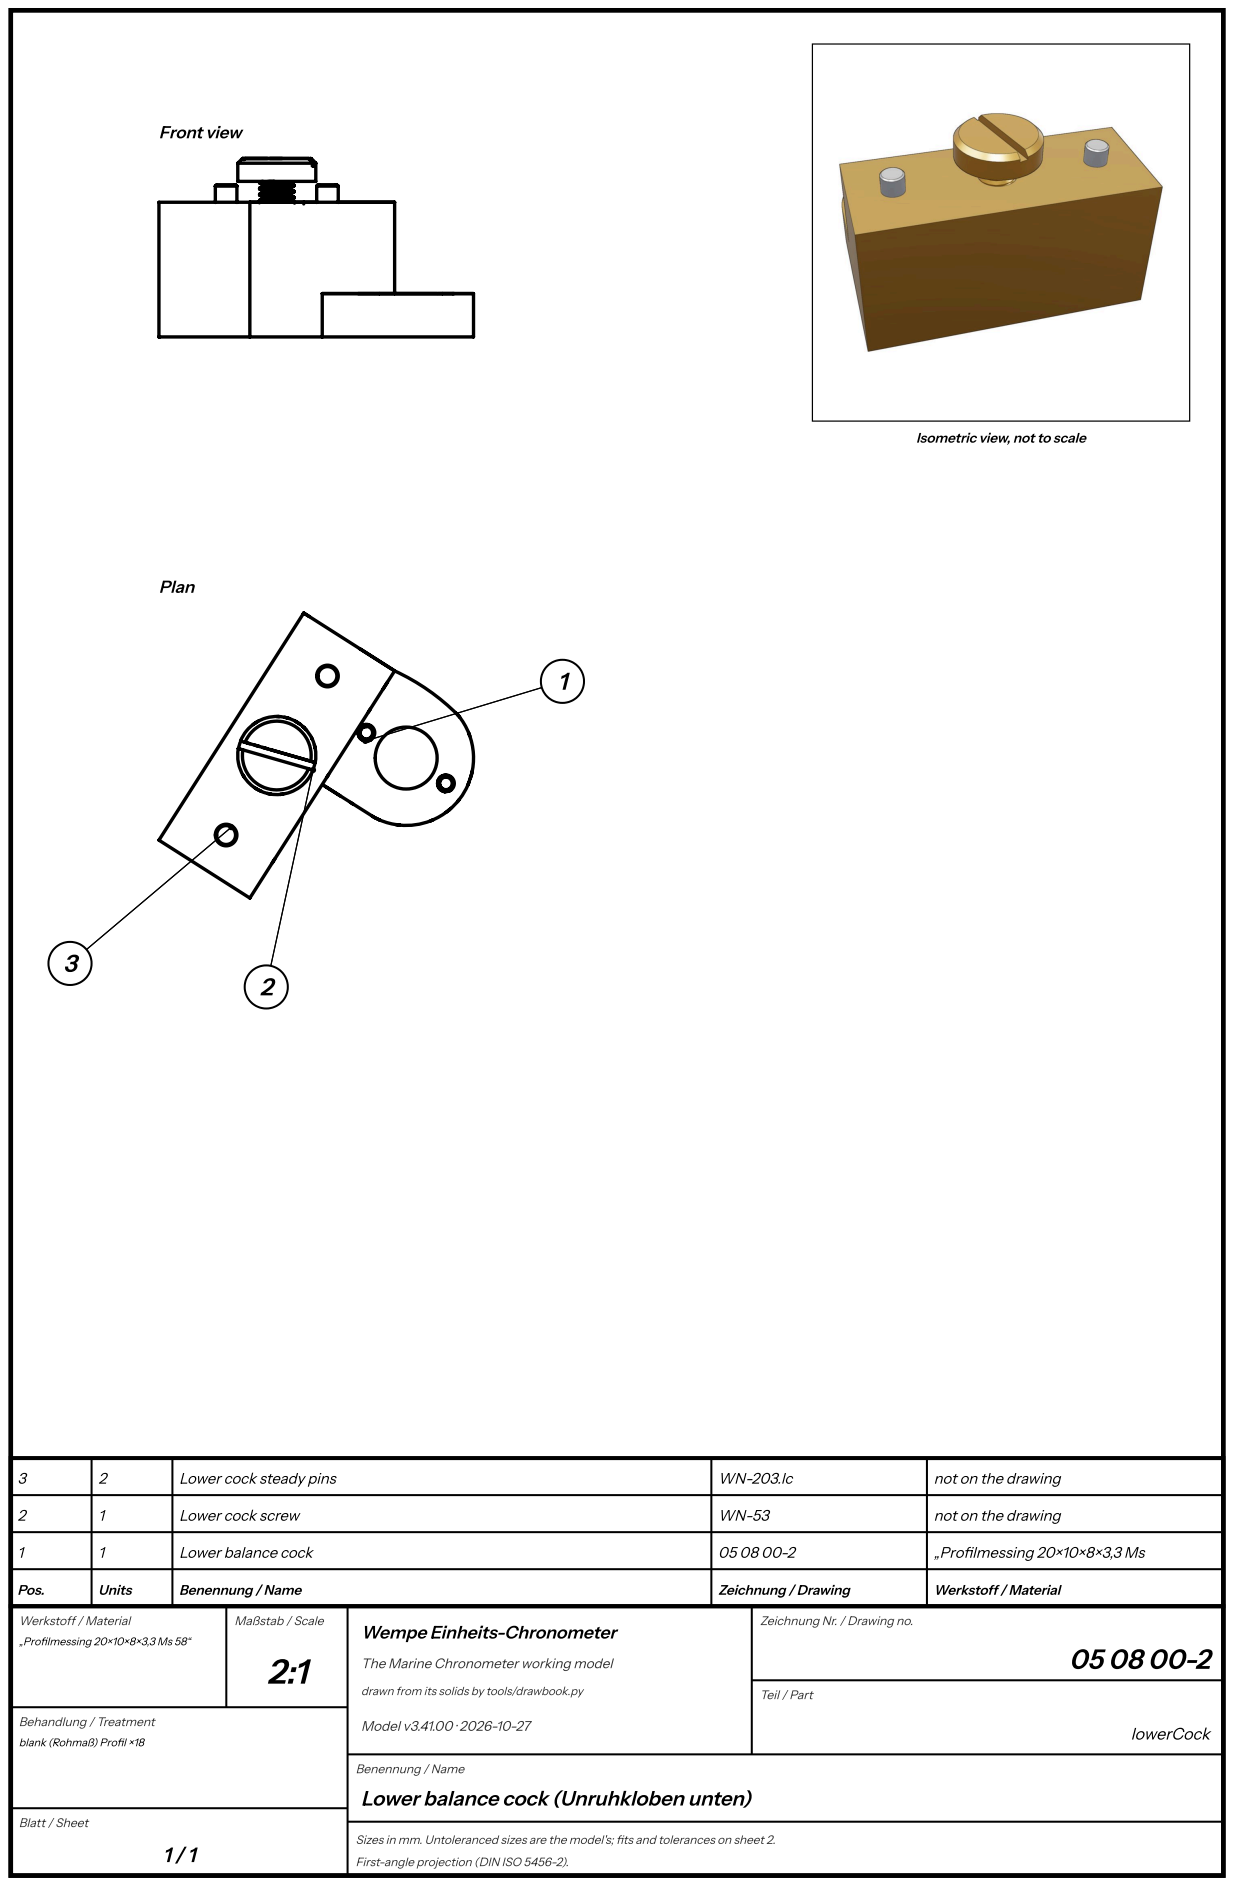
[picture p352: page 71]
Front view; Plan; Pos.; Units; Benennung / Name; Zeichnung / Drawing; Werkstoff / Material; Lower balance cock; „Profilmessing 20×10×8×3,3 Ms; Lower cock screw; not on the drawing; Lower cock steady pins; „Profilmessing 20×10×8×3,3 Ms 58“; Maßstab / Scale; Behandlung / Treatment; Model v3.41.00 · 2026-10-27; Teil / Part; lowerCock

Isometric view, not to scale

Zeichnung Nr. / Drawing no.

Wempe Einheits-Chronometer

The Marine Chronometer working model

drawn from its solids by tools/drawbook.py

blank (Rohmaß) Profil ×18

Lower balance cock (Unruhkloben unten)

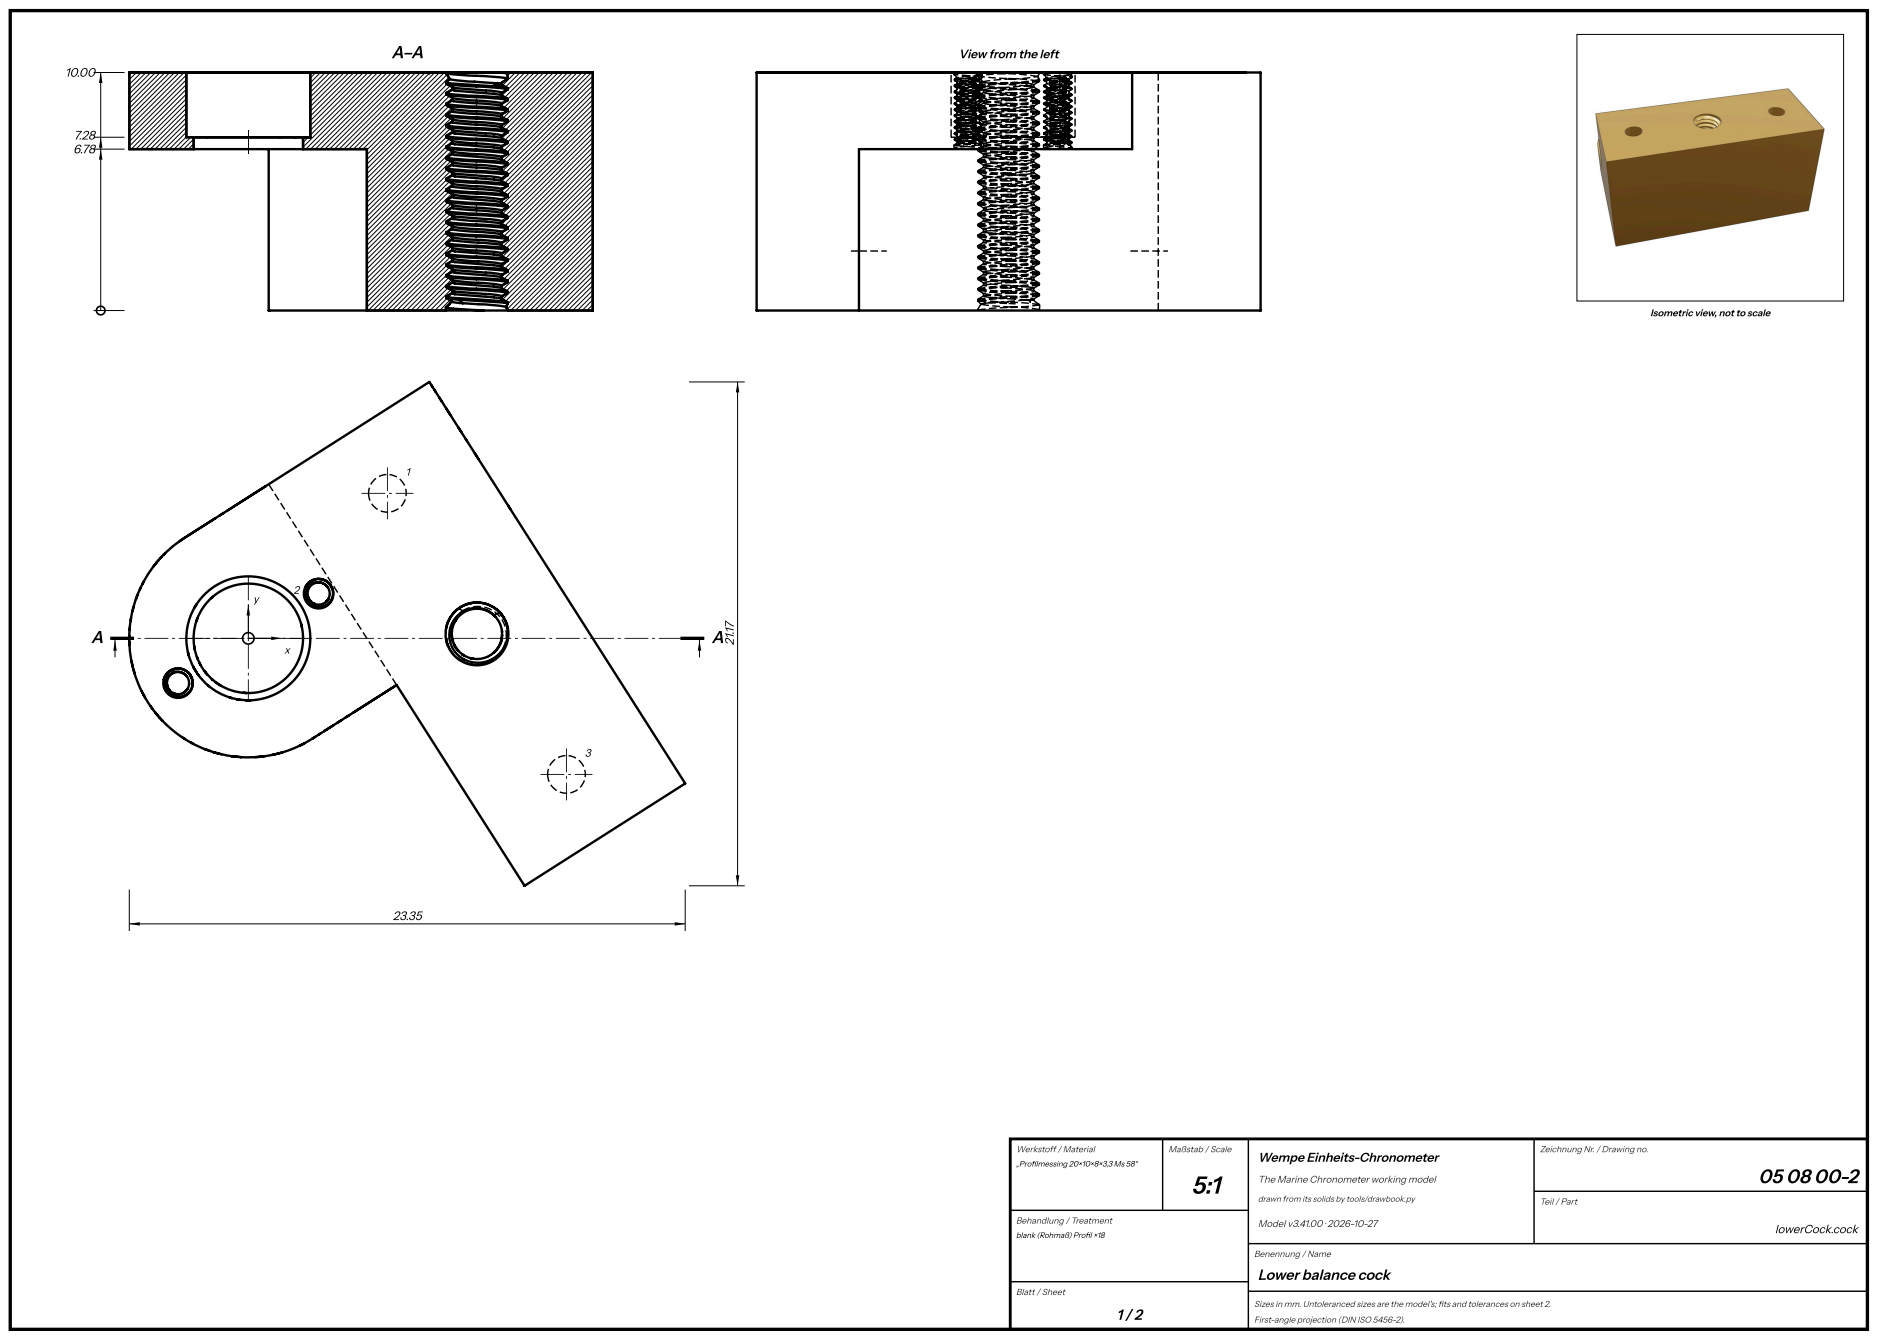
[picture p353: page 72]
Werkstoff / Material; „Profilmessing 20×10×8×3,3 Ms 58“; Maßstab / Scale; Behandlung / Treatment; Model v3.41.00 · 2026-10-27; Teil / Part; lowerCock.cock

View from the left

Isometric view, not to scale

Zeichnung Nr. / Drawing no.

Wempe Einheits-Chronometer

The Marine Chronometer working model

drawn from its solids by tools/drawbook.py

blank (Rohmaß) Profil ×18

Lower balance cock

## Lower balance cock — sheet 2

A block screwed and pinned under the top plate, inside the frame, whose lug holds the balance staff’s lower jewel setting

about 10 mm under the plate: the balance swings above the plate, its escapement under it.

Parts list

Drawing | Name | Units | Material | Finish, heat treatment | Fit, as measured on the model
05 08 00-2 | Unruhkloben unten (lower balance cock) | 1 | „Profilmessing 20×10×8×3,3 Ms 58“ | blank (Rohmaß) Profil ×18 | on 050901: 0 mm

What it does (05 08 00-2). Hangs under the top plate and holds the balance staff's lower jewel setting.

Coordinates from the datum, hole 2's centre (marked on the plan), x to the right and y up the plan as drawn; depths from

the face seen in the plan (the top). Thickness 10.00.

Holes

Hole | x | y | Size
1 | 5.84 | 6.09 | Ø 1.58 × 2.50 deep from the bottom
2 | 0.00 | 0.00 | Ø 4.60 through (0.50 thick at 6.78-7.28)
3 | 13.36 | -5.72 | Ø 1.58 × 2.50 deep from the bottom

Contourin the plan

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

radius.

Contour | # | Element | From x, y | To x, y | Centre x, y | R
Outline | 1 | arc clockwise | -4.84, -1.25 | -2.69, 4.22 | 0.00, 0.00 | 5.00
Outline | 2 | line | -2.69, 4.22 | 7.60, 10.77
Outline | 3 | line | 7.60, 10.77 | 18.35, -6.10
Outline | 4 | line | 18.35, -6.10 | 11.60, -10.40
Outline | 5 | line | 11.60, -10.40 | 6.23, -1.96
Outline | 6 | arc clockwise | 6.23, -1.96 | 1.99, -4.59 | -11.12, 21.27 | 28.99
Outline | 7 | arc clockwise | 1.99, -4.59 | -4.84, -1.25 | 0.00, 0.00 | 5.00
Cut-out 2 | 8 | line | 10.56, 1.09 | 10.56, 1.09
Cut-out 2 | 9 | arc anticlockwise | 10.56, 1.09 | 10.56, 1.09 | 7.92, 3.88 | 3.83
Cut-out 2 | 10 | line | 10.56, 1.09 | 10.56, 1.09
Cut-out 3 | 11 | line | 10.40, 1.23 | 10.40, 1.23
Cut-out 3 | 12 | arc anticlockwise | 10.40, 1.23 | 10.40, 1.23 | 8.51, 0.70 | 1.97
Cut-out 3 | 13 | line | 10.40, 1.23 | 10.40, 1.23
Cut-out 4 | 14 | line | 10.13, -1.56 | 10.13, -1.56
Cut-out 4 | 15 | arc anticlockwise | 10.13, -1.56 | 10.13, -1.56 | 8.38, -0.67 | 1.97
Cut-out 4 | 16 | line | 10.13, -1.56 | 10.13, -1.56
Cut-out 5 | 17 | line | 9.28, 1.46 | 9.28, 1.46
Cut-out 5 | 18 | line | 9.28, 1.46 | 9.28, 1.46
Cut-out 5 | 19 | line | 9.28, 1.46 | 9.28, 1.46
Cut-out 6 | 20 | line | 9.19, 1.43 | 9.19, 1.43
Cut-out 6 | 21 | line | 9.19, 1.43 | 9.19, 1.43
Cut-out 6 | 22 | line | 9.19, 1.43 | 9.19, 1.43
Cut-out 6 | 23 | line | 9.19, 1.43 | 9.19, 1.43

Cut-out 7 | 24 | arc anticlockwise | 8.83, 1.26 | 8.83, 1.26 | 7.80, 0.52 | 1.27
Cut-out 7 | 25 | arc anticlockwise | 8.83, 1.26 | 8.83, 1.26 | 7.80, 0.52 | 1.27
Cut-out 8 | 26 | line | 8.61, -0.67 | 8.61, -0.67
Cut-out 8 | 27 | arc anticlockwise | 8.61, -0.67 | 8.61, -0.67 | 7.59, -0.22 | 1.11
Cut-out 8 | 28 | line | 8.61, -0.67 | 8.61, -0.67

Levels

Faces in section A-A, from the bottom face: 6.78, 7.28, 10.00.

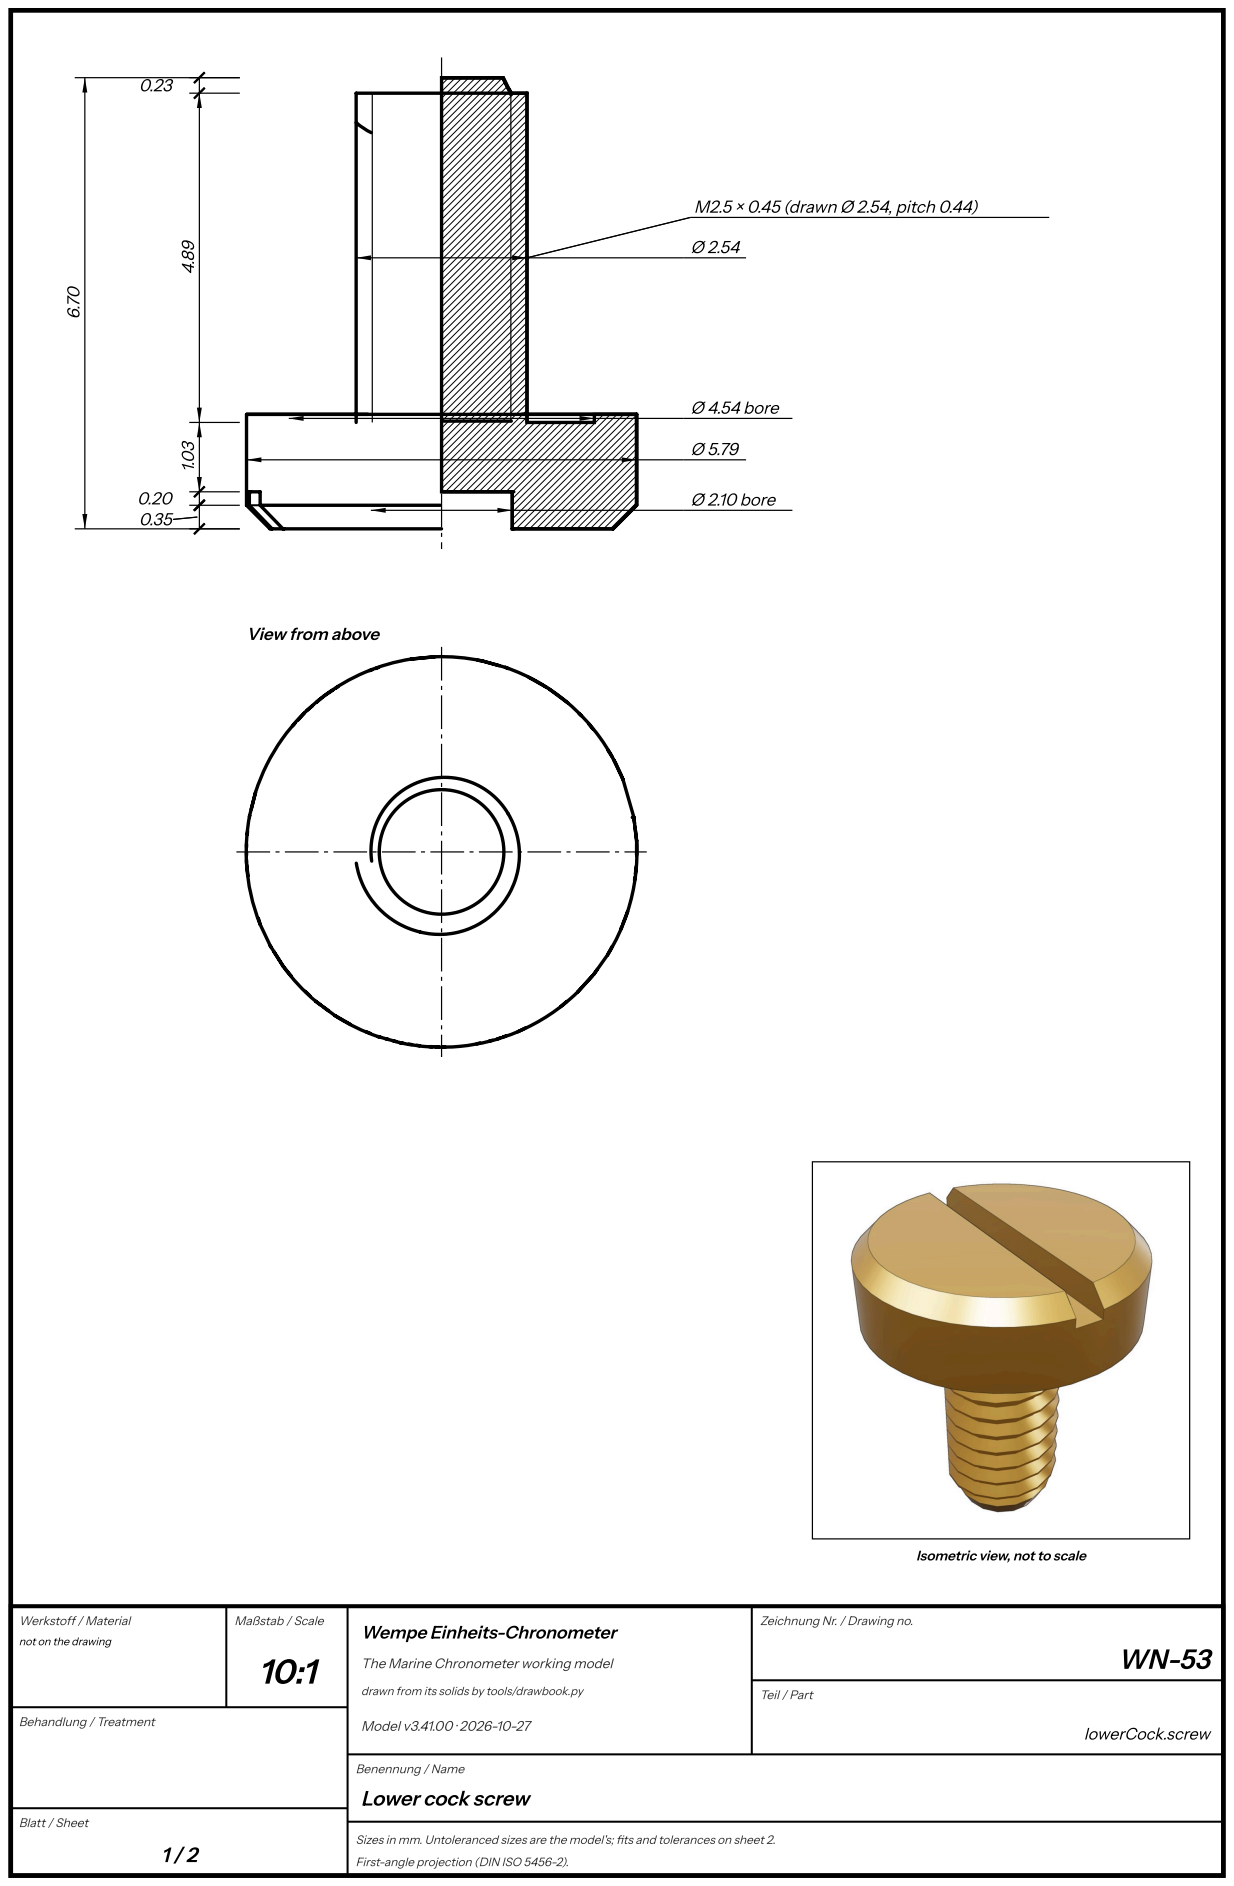
[picture p354: page 75]
Ø 4.54 bore; Ø 2.10 bore; M2.5 × 0.45 (drawn Ø 2.54, pitch 0.44); Werkstoff / Material; Maßstab / Scale; Behandlung / Treatment; Model v3.41.00 · 2026-10-27; Teil / Part; lowerCock.screw

View from above

Isometric view, not to scale

Zeichnung Nr. / Drawing no.

not on the drawing

Wempe Einheits-Chronometer

The Marine Chronometer working model

drawn from its solids by tools/drawbook.py

Lower cock screw

## Lower cock screw — sheet 2

The screw from the top plate’s outer face, its head sunk in the plate, into the cock.

Parts list

Drawing | Name | Units | Material | Finish, heat treatment | Fit, as measured on the model
WN-53 | Lower balance cock screw (WN-53, by the coloured section's label) | 1 | not on the drawing | | in 050901 (clear): 3.254 mm, least gap 0.1073; in 050800-2 (tap): 3.451 mm, least gap 0.0282

What it does (WN-53). From the top plate's outer face, its head sunk in the plate, into the cock.

Turned about its axis; length 6.70, largest Ø 5.79. Diameters: Ø 2.54, Ø 5.79; bores Ø 2.10, Ø 4.54. Shoulders from the lower

end: 0.00, 0.35, 0.55, 1.58, 6.47, 6.70.

Thread

Outside thread 1.58-6.47 from the lower end, 4.89 long: drawn Ø 2.54 over its crests, 2.06 at its roots, pitch 0.44. Cut the

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

aren't in the set).

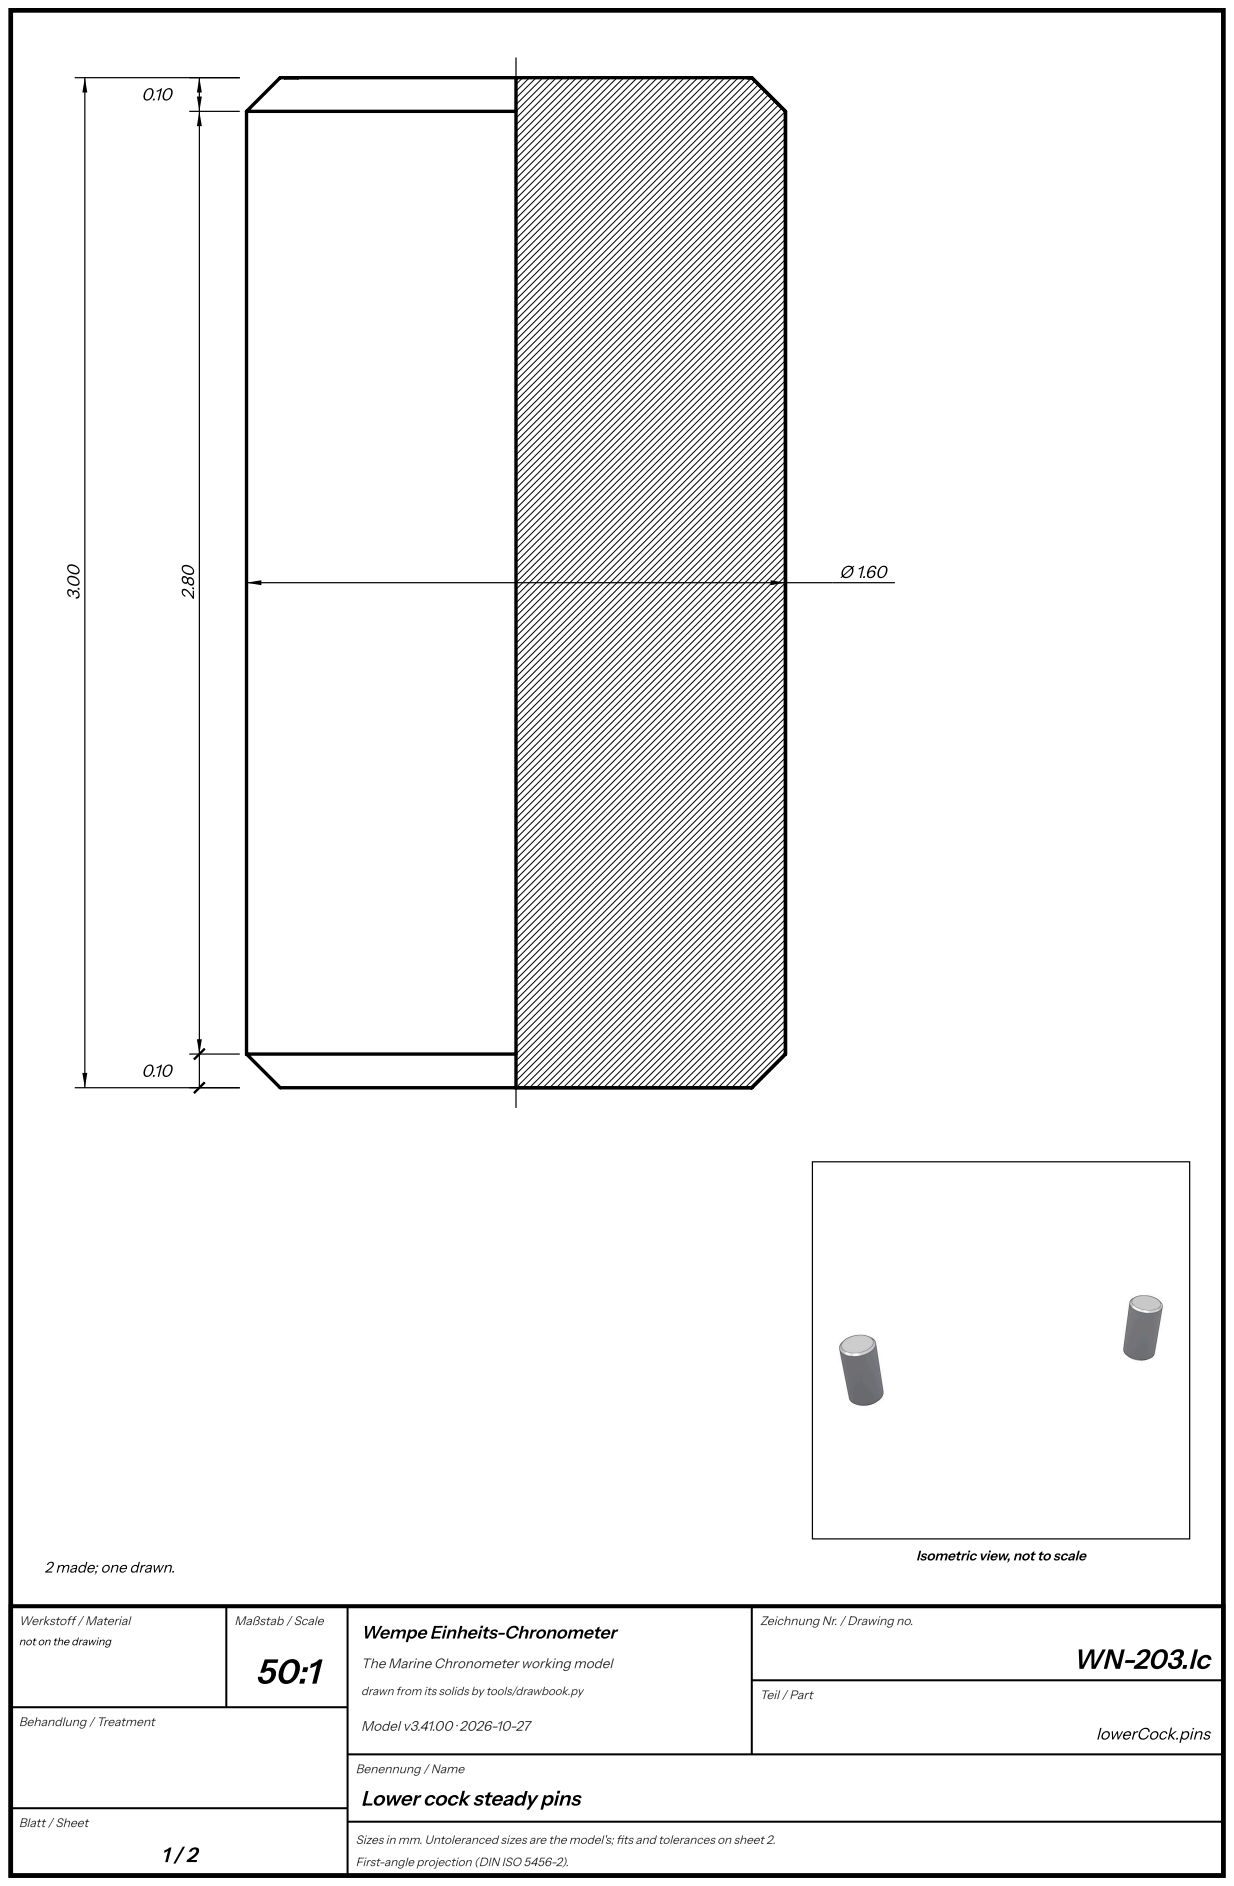
[picture p355: page 77]
Werkstoff / Material; Maßstab / Scale; Behandlung / Treatment; Model v3.41.00 · 2026-10-27; Teil / Part; lowerCock.pins

2 made; one drawn.

Isometric view, not to scale

Zeichnung Nr. / Drawing no.

not on the drawing

Wempe Einheits-Chronometer

The Marine Chronometer working model

drawn from its solids by tools/drawbook.py

Lower cock steady pins

## Lower cock steady pins — sheet 2

A steady pin (Stellstift), Ø 1.6, pressed into the part and standing 1.3 out of it into a reamed hole in the plate, which places

the part.

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

Parts list

Drawing | Name | Units | Material | Finish, heat treatment | Fit, as measured on the model
WN-203.lc | Stellstift, lower balance cock (holes 22, 37; WN not given, as WN-203) | 2 | not on the drawing | | in 050800-2 (press): 1.673 mm, least gap -0.0064; in 050901 (clear): 1.279 mm, least gap 0.0036

What it does (WN-203.lc). Place the lower cock under the top plate.

Turned about its axis; length 3.00, largest Ø 1.60. Diameters: Ø 1.60. Shoulders from the lower end: 0.00, 0.10, 2.90, 3.00.

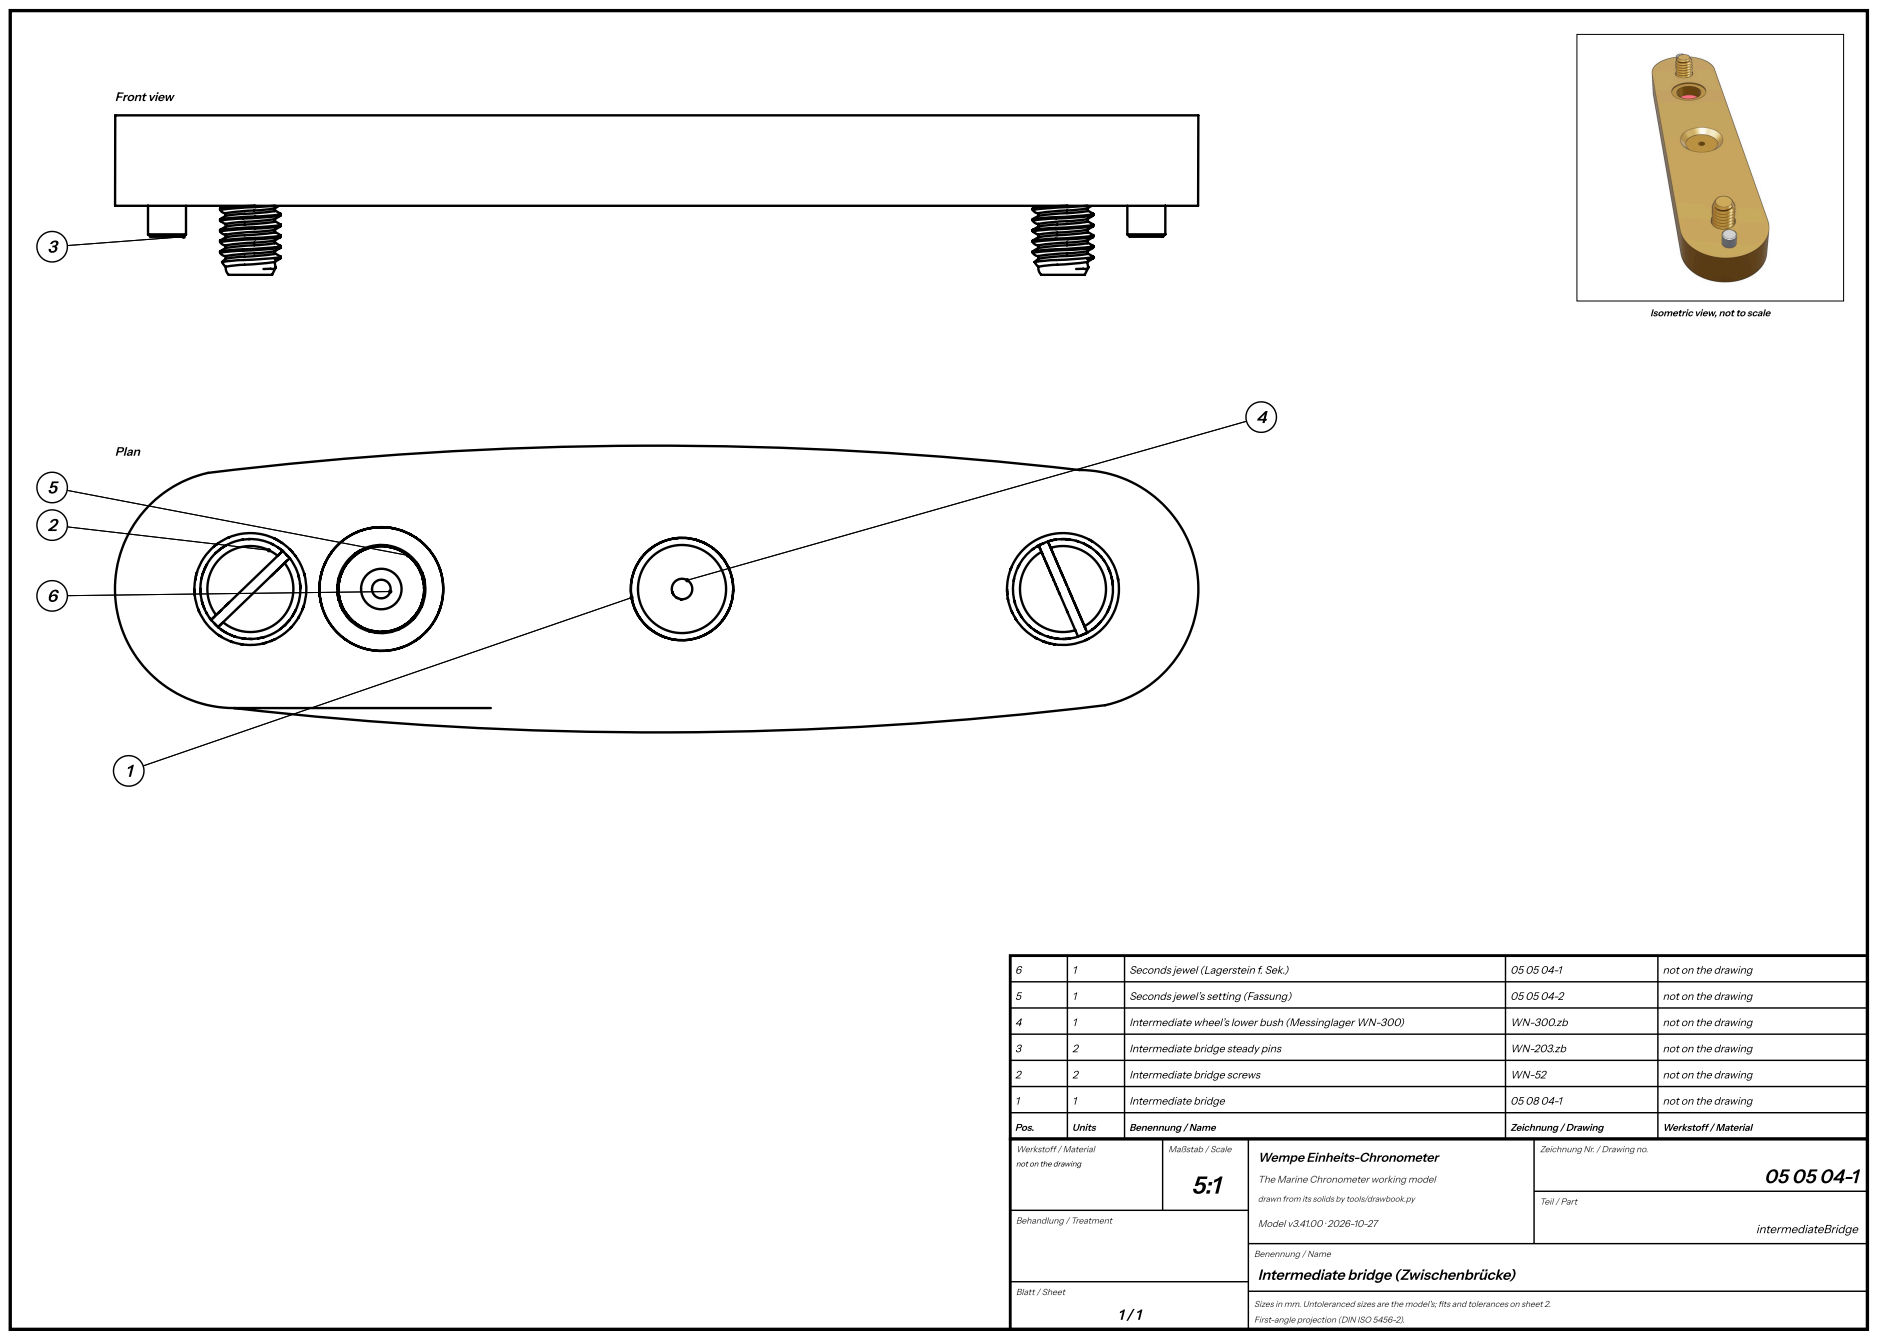
[picture p356: page 79]
Front view; Plan; Pos.; Units; Benennung / Name; Zeichnung / Drawing; Werkstoff / Material; Intermediate bridge; not on the drawing; Intermediate bridge screws; Intermediate bridge steady pins; Intermediate wheel’s lower bush (Messinglager WN-300); Seconds jewel’s setting (Fassung); Seconds jewel (Lagerstein f. Sek.); Maßstab / Scale; Behandlung / Treatment; Model v3.41.00 · 2026-10-27; Teil / Part; intermediateBridge

Isometric view, not to scale

Zeichnung Nr. / Drawing no.

not on the drawing

Wempe Einheits-Chronometer

The Marine Chronometer working model

drawn from its solids by tools/drawbook.py

Intermediate bridge (Zwischenbrücke)

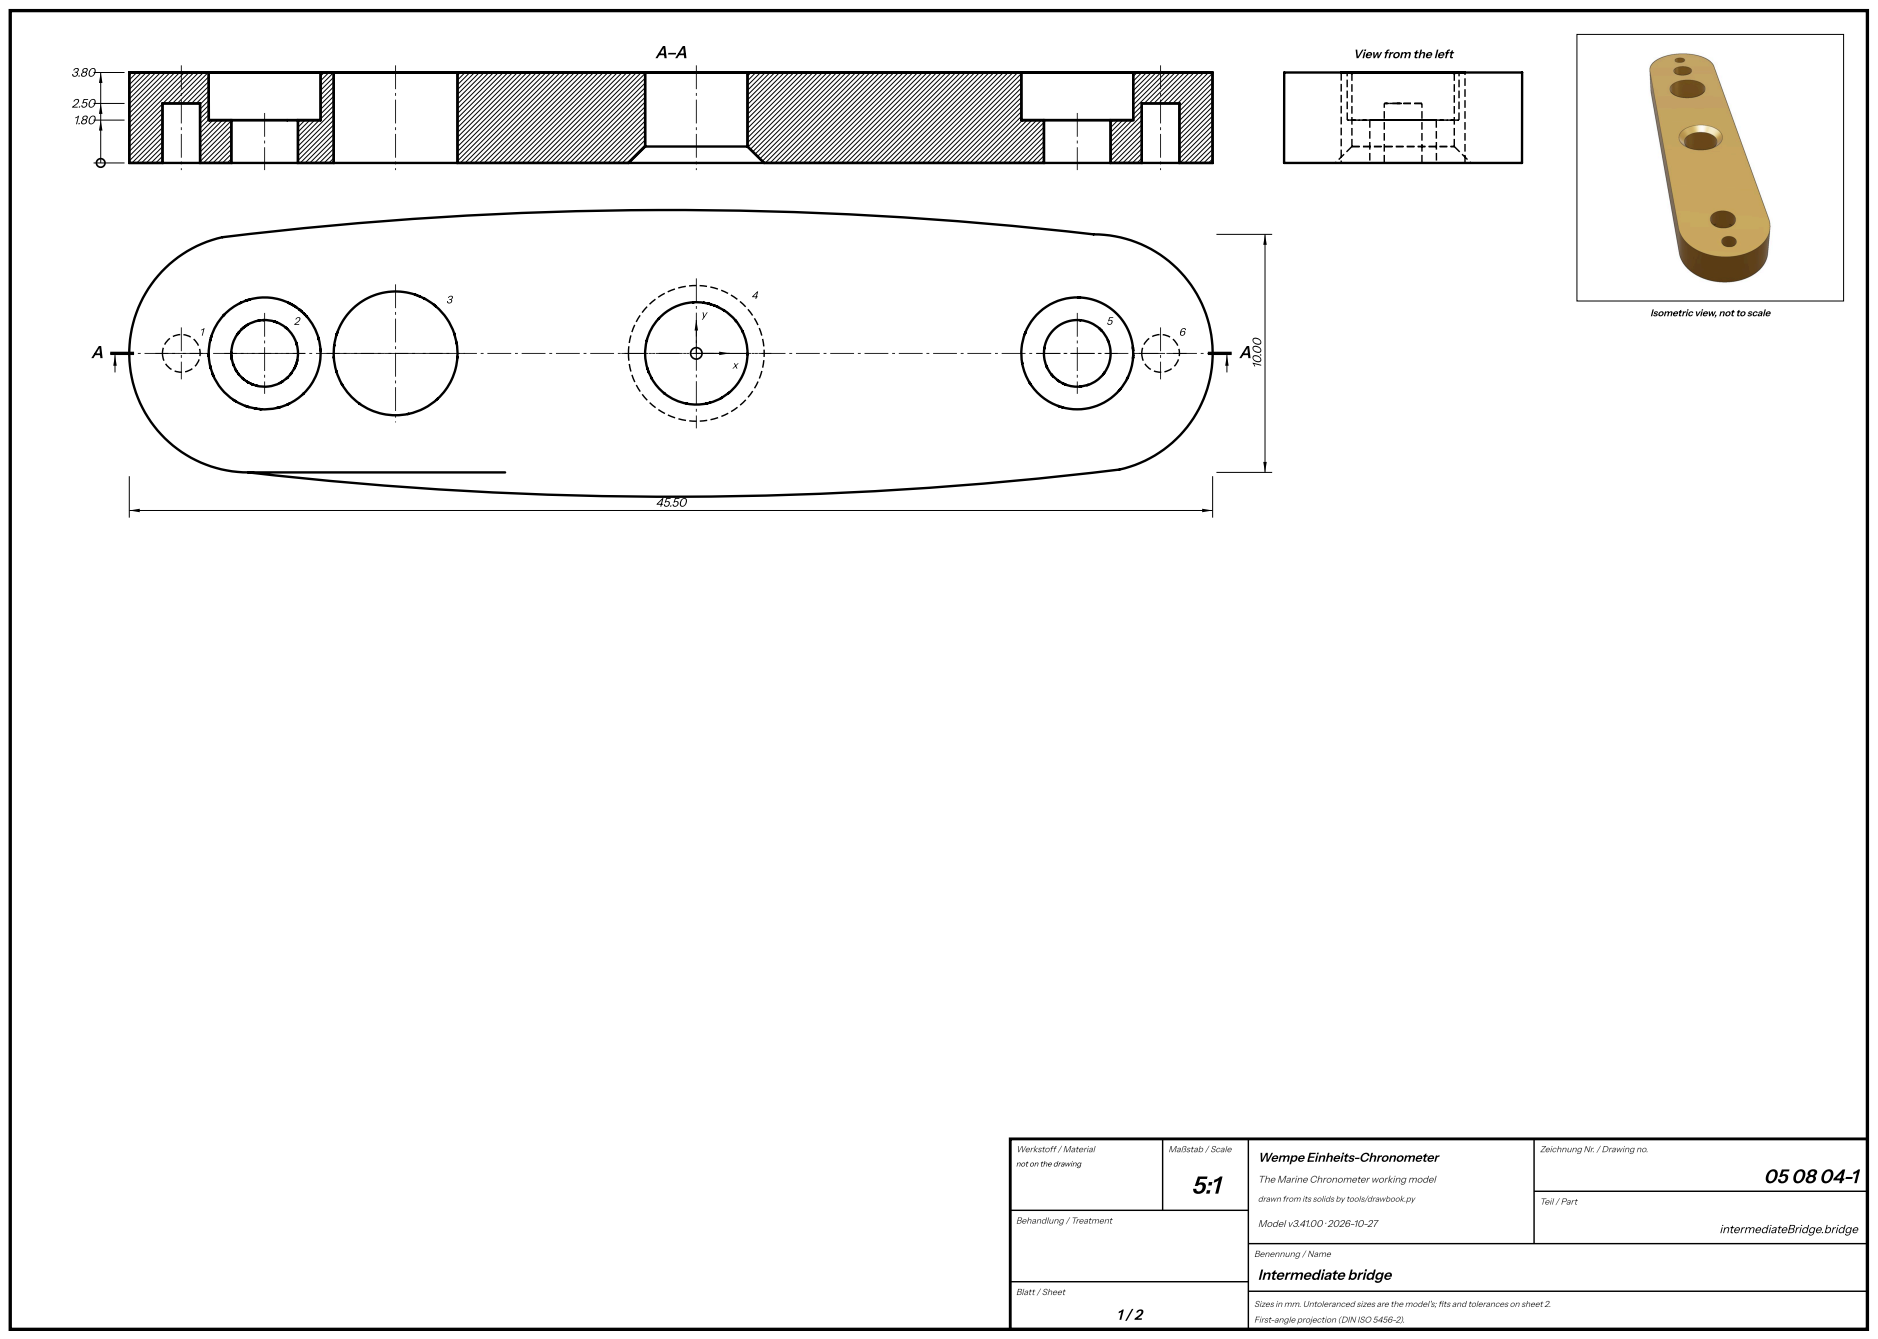
[picture p357: page 80]
Werkstoff / Material; Maßstab / Scale; Behandlung / Treatment; Model v3.41.00 · 2026-10-27; Teil / Part; intermediateBridge.bridge; Intermediate bridge

View from the left

Isometric view, not to scale

Zeichnung Nr. / Drawing no.

not on the drawing

Wempe Einheits-Chronometer

The Marine Chronometer working model

drawn from its solids by tools/drawbook.py

## Intermediate bridge — sheet 2

A straight bridge on the pillar plate’s dial side, across the opening for the intermediate wheel: it carries that wheel’s lower

bearing, a brass bush, and the seconds wheel’s lower jewel in its setting.

Parts list

Drawing | Name | Units | Material | Finish, heat treatment | Fit, as measured on the model
05 08 04-1 | Zwischenbrücke (intermediate bridge; its sheet not in the set, the assembly 05 08 04) | 1 | not on the drawing | | on 050802-1: 0 mm

What it does (05 08 04-1). On the pillar plate's dial side: the intermediate wheel's lower jewel and the seconds wheel's

lower setting.

Coordinates from the datum, hole 4's centre (marked on the plan), x to the right and y up the plan as drawn; depths from

the face seen in the plan (the top). Thickness 3.80.

Holes

Hole | x | y | Size
1 | -21.63 | 0.00 | Ø 1.58 × 2.50 deep from the bottom
2 | -18.13 | 0.00 | Ø 2.80 through (1.80 thick at 0.00-1.80)
3 | -12.63 | 0.00 | Ø 5.20 through
4 | 0.00 | 0.00 | Ø 4.30 through (3.13 thick at 0.67-3.80); countersunk to Ø 5.70
5 | 16.00 | 0.00 | Ø 2.80 through (1.80 thick at 0.00-1.80)
6 | 19.50 | 0.00 | Ø 1.58 × 2.50 deep from the bottom

Contourin the plan

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

radius.

Contour | # | Element | From x, y | To x, y | Centre x, y | R
Outline | 1 | arc clockwise | -23.45, -1.87 | -18.82, 5.00 | -18.82, 0.00 | 5.00
Outline | 2 | arc clockwise | -18.82, 5.00 | 17.43, 4.94 | -1.00, -219.41 | 225.11
Outline | 3 | arc clockwise | 17.43, 4.94 | 16.68, -5.00 | 16.68, 0.00 | 5.00
Outline | 4 | arc clockwise | 16.68, -5.00 | -19.56, -4.94 | -1.13, 219.41 | 225.11
Outline | 5 | arc clockwise | -19.56, -4.94 | -23.45, -1.87 | -18.82, 0.00 | 5.00

Levels

Faces in section A-A, from the bottom face: 1.80, 2.50, 3.80.

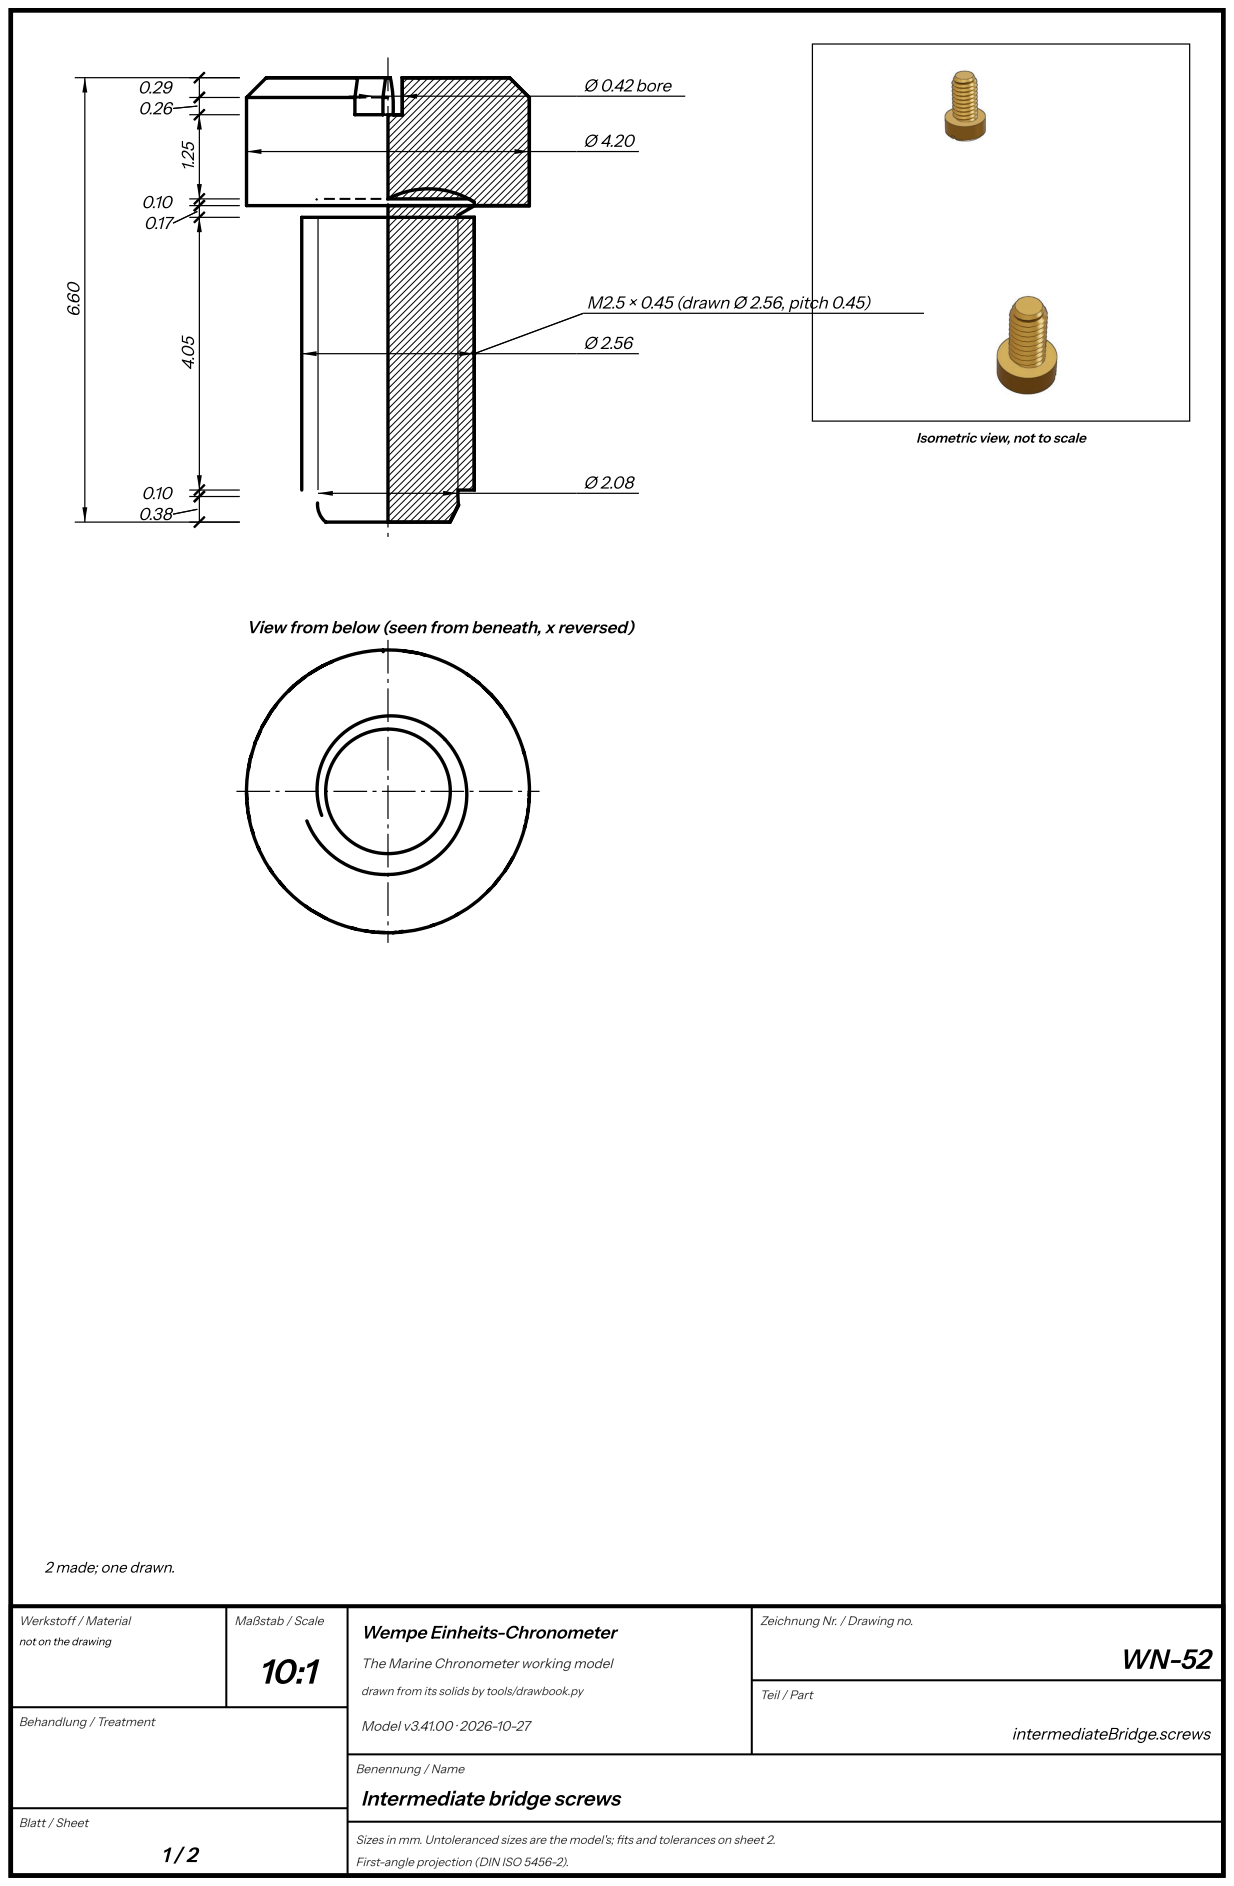
[picture p358: page 82]
Ø 0.42 bore; M2.5 × 0.45 (drawn Ø 2.56, pitch 0.45); Werkstoff / Material; Maßstab / Scale; Behandlung / Treatment; Model v3.41.00 · 2026-10-27; Teil / Part; intermediateBridge.screws

Isometric view, not to scale

View from below (seen from beneath, x reversed)

2 made; one drawn.

Zeichnung Nr. / Drawing no.

not on the drawing

Wempe Einheits-Chronometer

The Marine Chronometer working model

drawn from its solids by tools/drawbook.py

Intermediate bridge screws

## Intermediate bridge screws — sheet 2

Two screws from the dial side, their heads sunk in the bridge, into the pillar plate.

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

Parts list

Drawing | Name | Units | Material | Finish, heat treatment | Fit, as measured on the model
WN-52 | Intermediate bridge screw (WN-52) | 2 | not on the drawing | | in 050804-1 (clear): 3.72 mm, least gap 0.1224; in 050802-1 (tap): 2.877 mm, least gap 0.0189

What it does (WN-52). Hold the intermediate bridge to the pillar plate, from the dial side.

Turned about its axis; length 6.60, largest Ø 4.20. Diameters: Ø 2.08, Ø 2.56, Ø 4.20; bores Ø 0.42. Shoulders from the lower

end: 0.00, 0.38, 0.48, 4.53, 4.70, 4.80, 6.05, 6.31, 6.60.

Thread

Outside thread 0.48-4.53 from the lower end, 4.05 long: drawn Ø 2.56 over its crests, 2.08 at its roots, pitch 0.45. Cut the

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

aren't in the set).

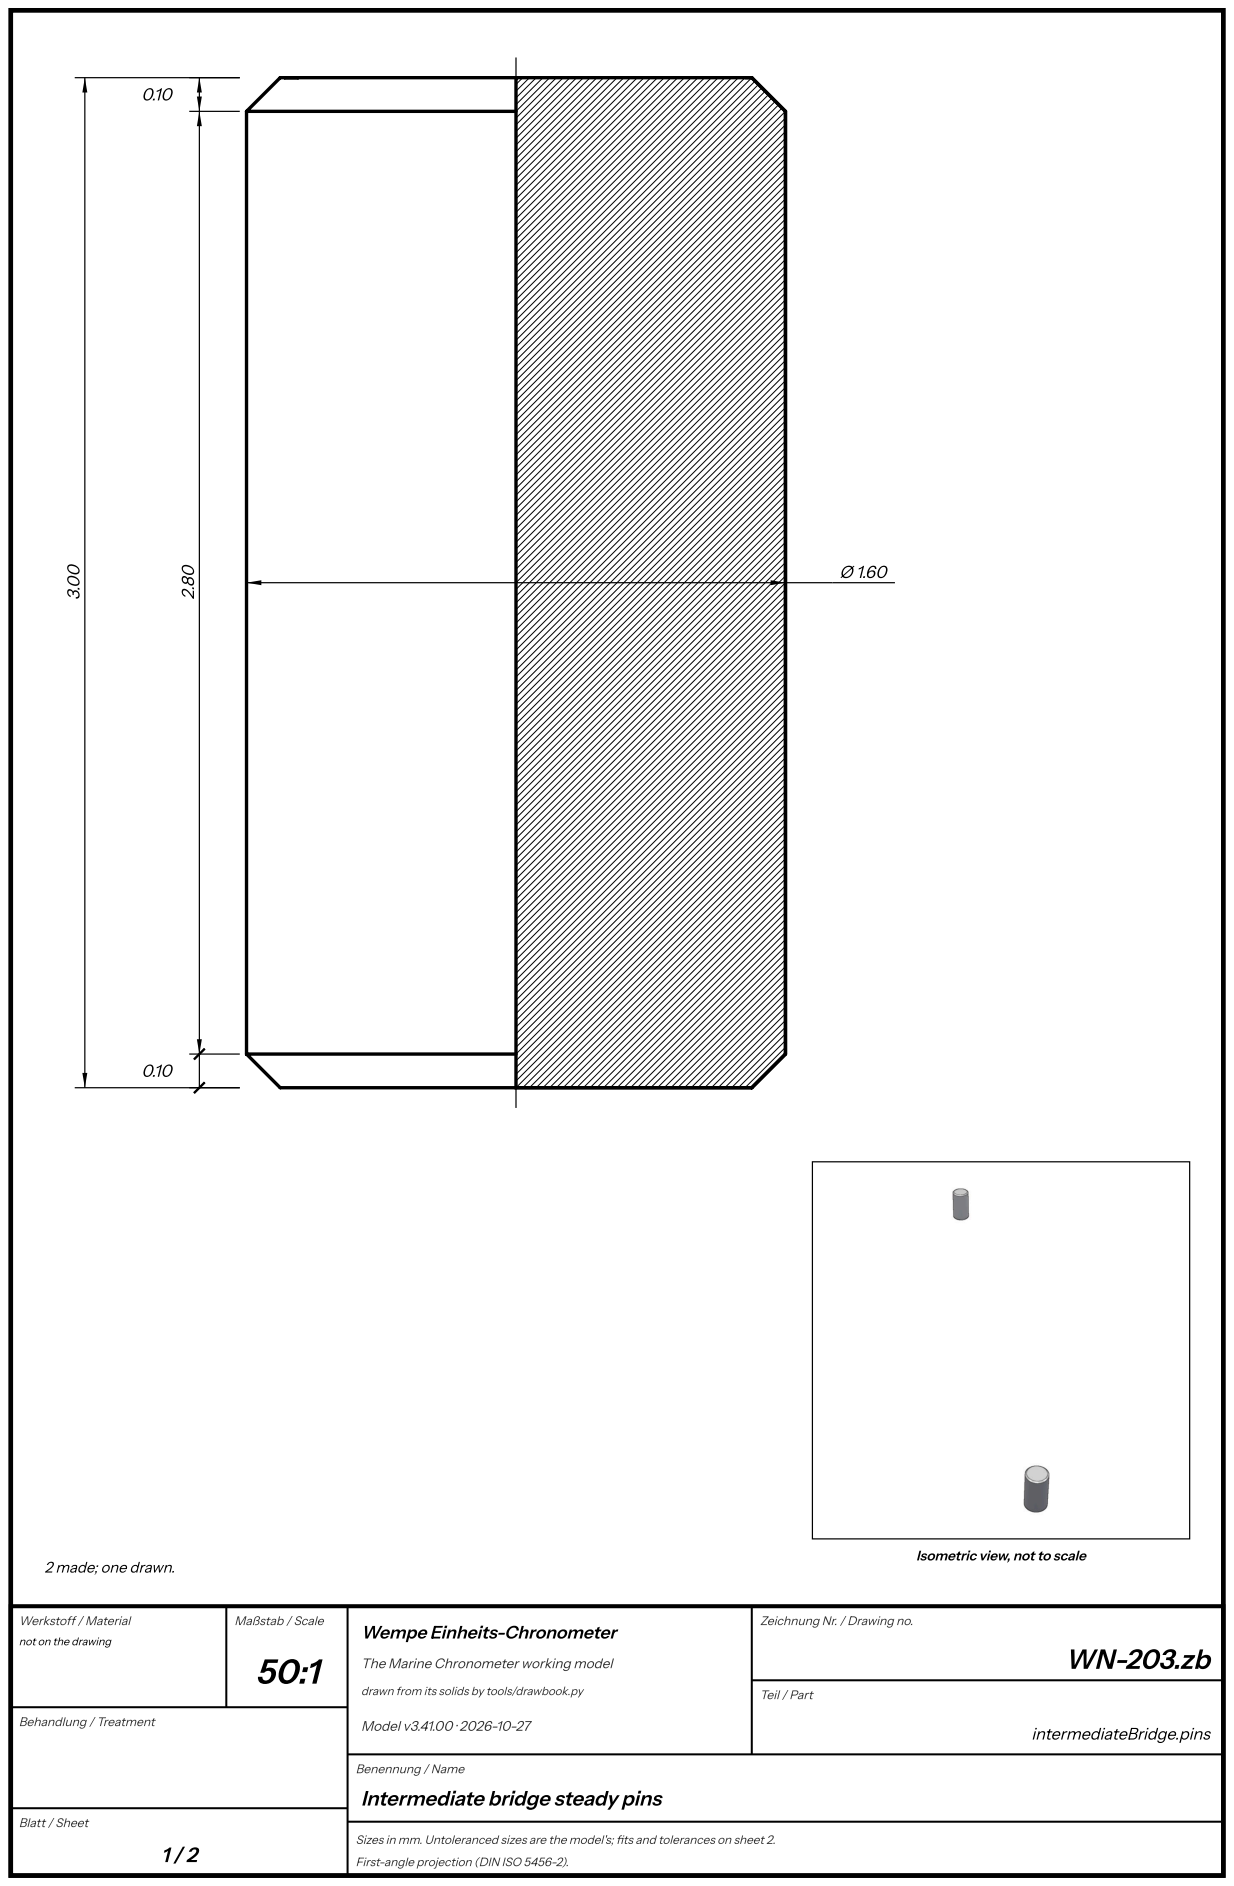
[picture p359: page 84]
Werkstoff / Material; Maßstab / Scale; Behandlung / Treatment; Model v3.41.00 · 2026-10-27; Teil / Part; intermediateBridge.pins

2 made; one drawn.

Isometric view, not to scale

Zeichnung Nr. / Drawing no.

not on the drawing

Wempe Einheits-Chronometer

The Marine Chronometer working model

drawn from its solids by tools/drawbook.py

Intermediate bridge steady pins

## Intermediate bridge steady pins — sheet 2

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

the part. WN-203.

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

Parts list

Drawing | Name | Units | Material | Finish, heat treatment | Fit, as measured on the model
WN-203.zb | Stellstift (WN-203), intermediate bridge | 2 | not on the drawing | | in 050804-1 (press): 1.646 mm, least gap -0.0064; in 050802-1 (clear): 1.307 mm, least gap 0.0036

What it does (WN-203.zb). Place the intermediate bridge on the pillar plate.

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

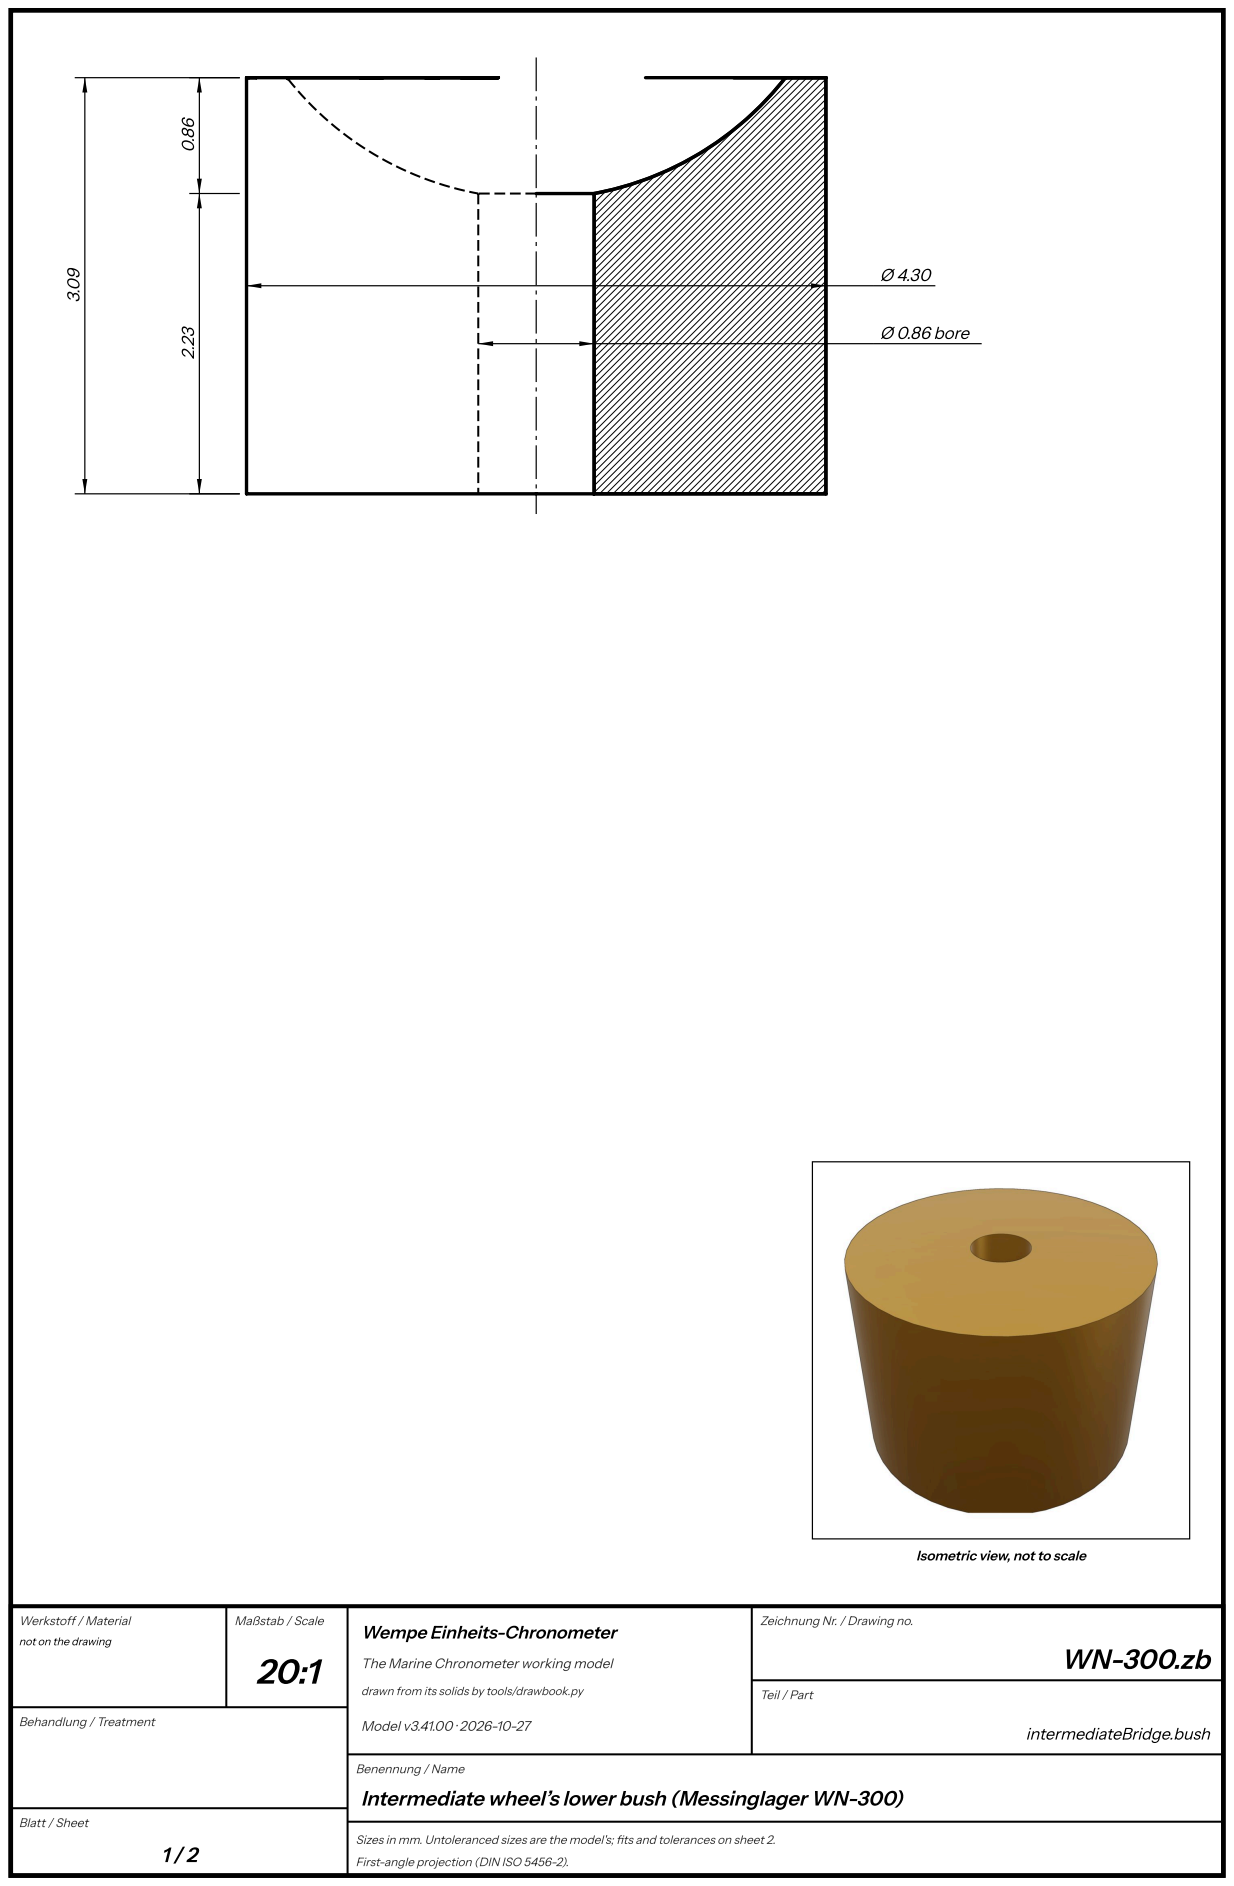
[picture p360: page 86]
Ø 0.86 bore; Werkstoff / Material; Maßstab / Scale; Behandlung / Treatment; Model v3.41.00 · 2026-10-27; Teil / Part; intermediateBridge.bush

Isometric view, not to scale

Zeichnung Nr. / Drawing no.

not on the drawing

Wempe Einheits-Chronometer

The Marine Chronometer working model

drawn from its solids by tools/drawbook.py

Intermediate wheel’s lower bush (Messinglager WN-300)

## Intermediate wheel’s lower bush (Messinglager WN-300) — sheet 2

A brass bush pressed into the bridge, its face 0.7 in from the plate’s side, in which the intermediate arbor’s lower pivot runs;

an oil sink in its dial-side face.

Parts list

Drawing | Name | Units | Material | Finish, heat treatment | Fit, as measured on the model
WN-300.zb | Messinglager WN-300 (brass bush, intermediate arbor's lower pivot) | 1 | not on the drawing | | in 050804-1 (press): 3.087 mm, least gap 0.0029

What it does (WN-300.zb). The intermediate arbor's lower bearing, pressed into the intermediate bridge, 0.7 in from its

plate side.

Turned about its axis; length 3.09, largest Ø 4.30. Diameters: Ø 4.30; bores Ø 0.86. Shoulders from the lower end: 0.00,

2.23, 3.09.

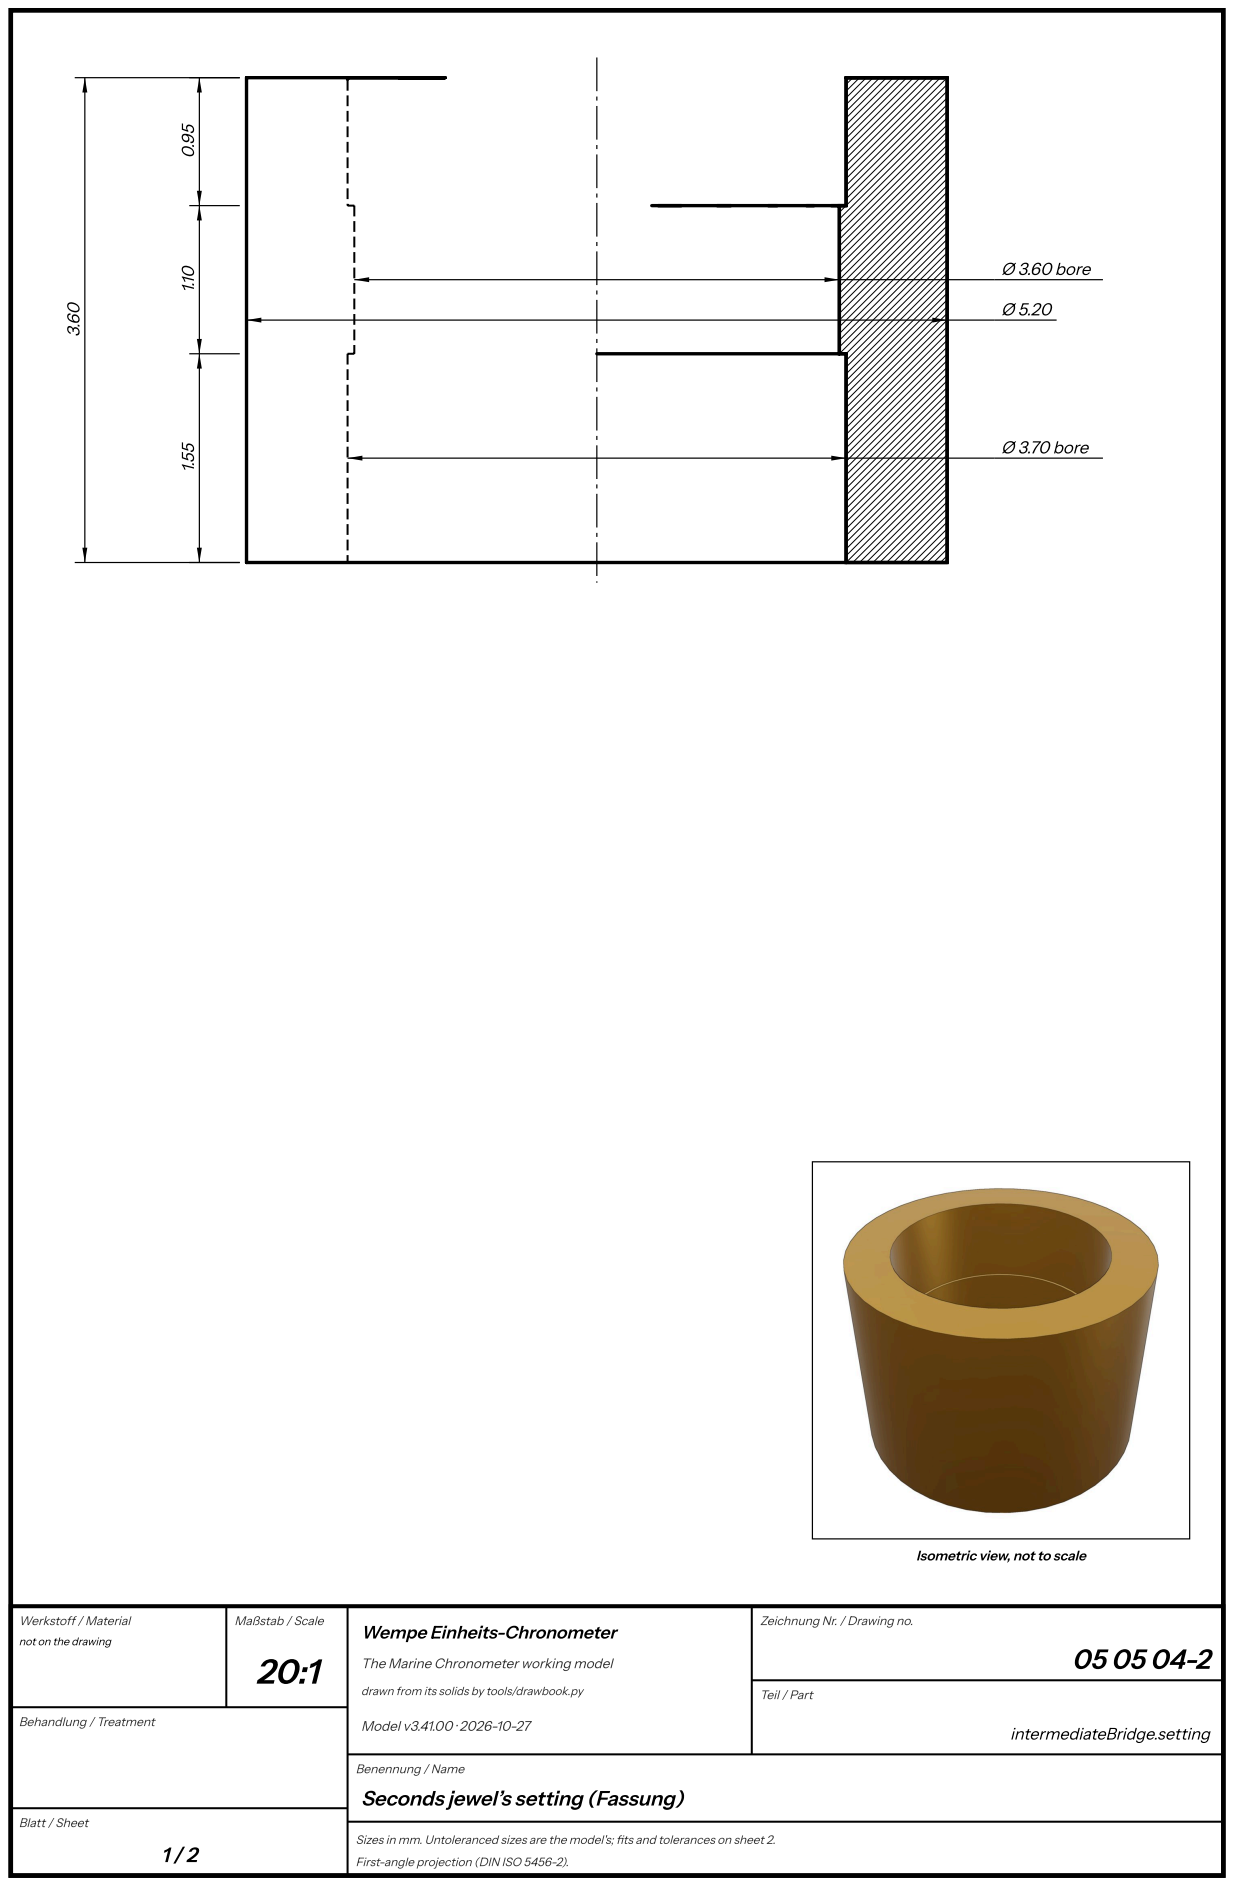
[picture p361: page 88]
Ø 3.60 bore; Ø 3.70 bore; Werkstoff / Material; Maßstab / Scale; Behandlung / Treatment; Model v3.41.00 · 2026-10-27; Teil / Part; intermediateBridge.setting

Isometric view, not to scale

Zeichnung Nr. / Drawing no.

not on the drawing

Wempe Einheits-Chronometer

The Marine Chronometer working model

drawn from its solids by tools/drawbook.py

Seconds jewel’s setting (Fassung)

## Seconds jewel’s setting (Fassung) — sheet 2

The brass setting of the seconds arbor’s lower jewel, pressed into the bridge; under the jewel a floor with a hole for the

seconds post.

Parts list

Drawing | Name | Units | Material | Finish, heat treatment | Fit, as measured on the model
05 05 04-2 | Fassung (the seconds jewel's setting) | 1 | not on the drawing | | in 050804-1 (press): 3.596 mm, least gap 0.0034

What it does (05 05 04-2). Holds the seconds arbor's lower jewel in the intermediate bridge (its sheet isn't in the set; the

coloured section names it).

Turned about its axis; length 3.60, largest Ø 5.20. Diameters: Ø 5.20; bores Ø 3.60, Ø 3.70. Shoulders from the lower end:

0.00, 1.55, 2.65, 3.60.

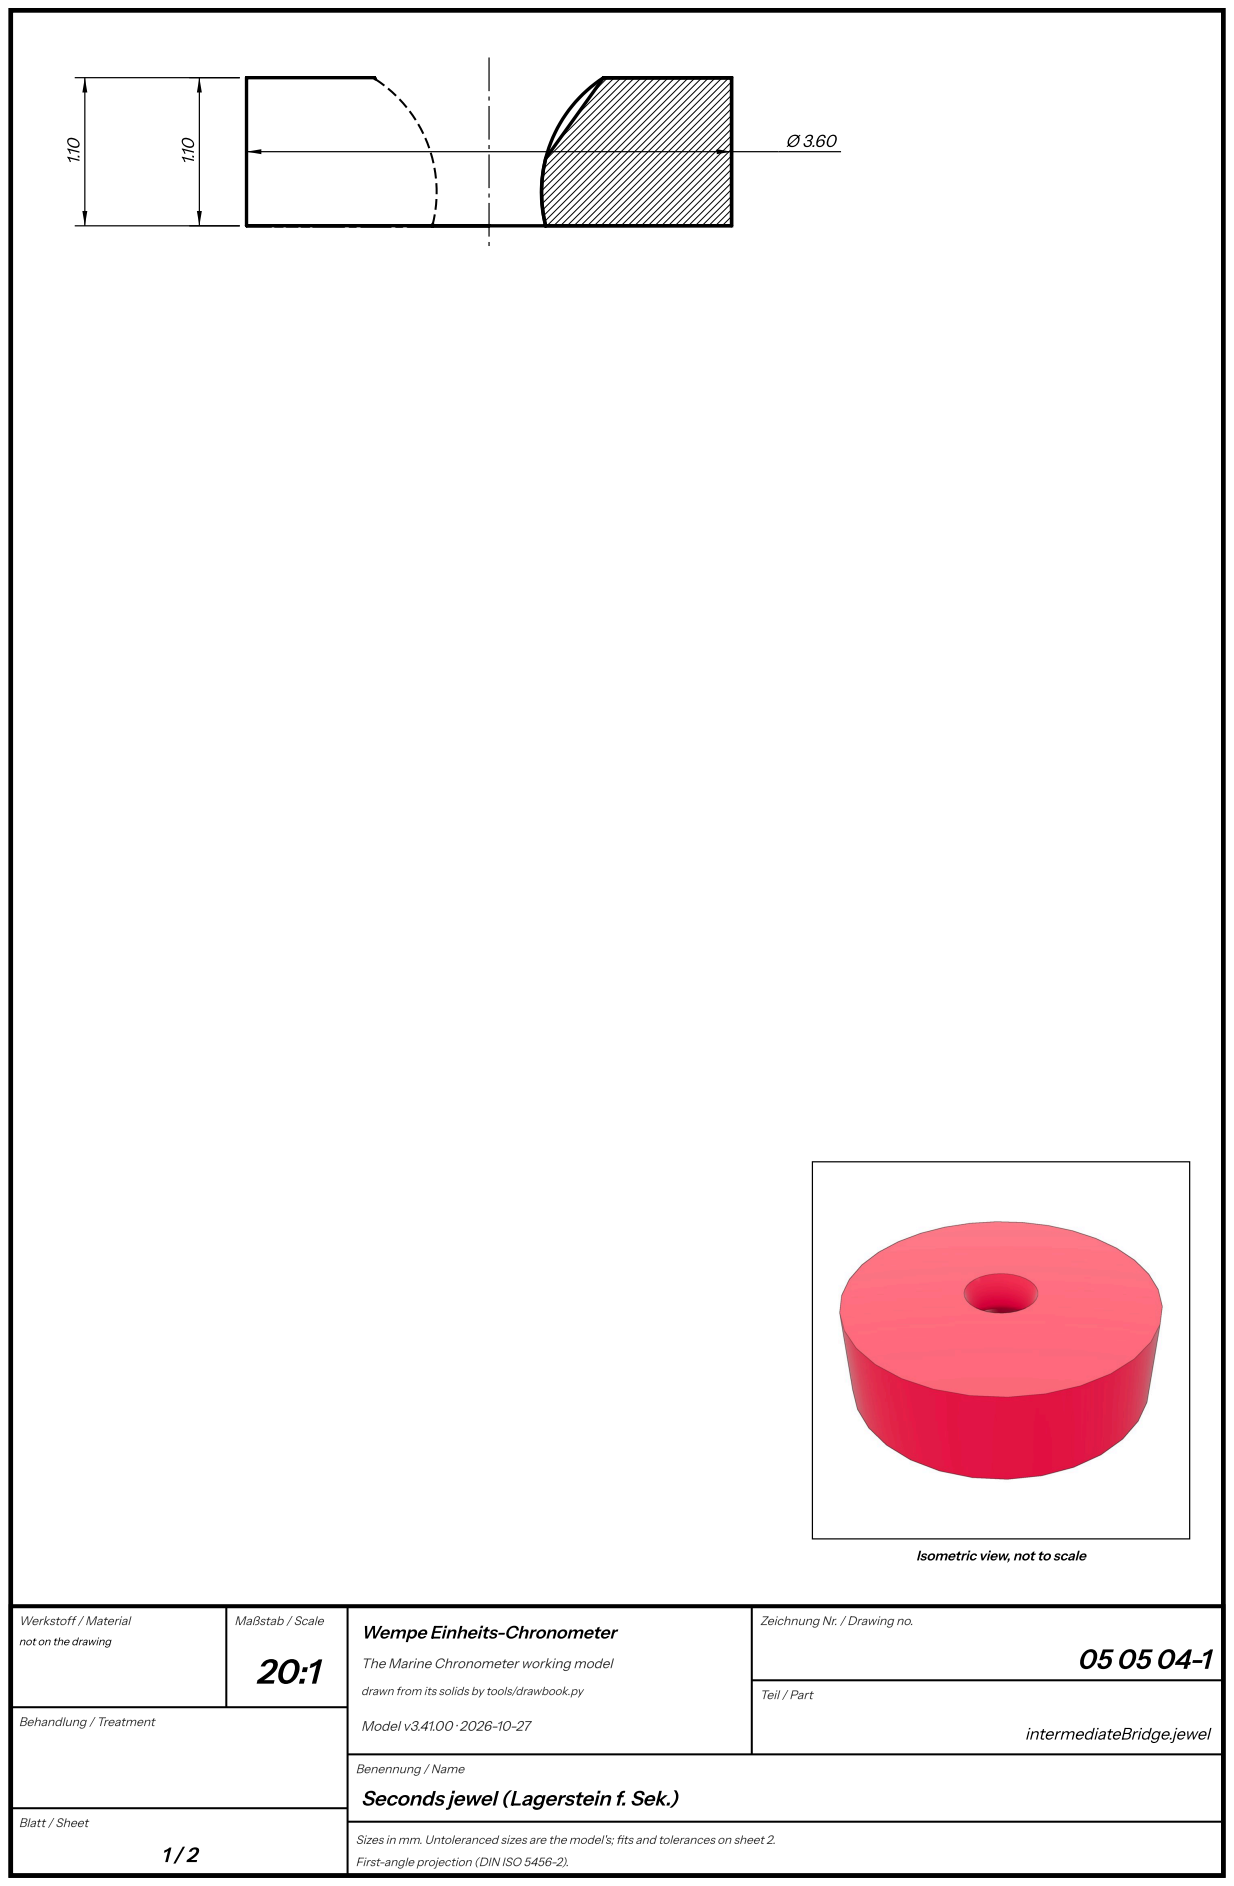
[picture p362: page 90]
Werkstoff / Material; Maßstab / Scale; Behandlung / Treatment; Model v3.41.00 · 2026-10-27; Teil / Part; intermediateBridge.jewel

Isometric view, not to scale

Zeichnung Nr. / Drawing no.

not on the drawing

Wempe Einheits-Chronometer

The Marine Chronometer working model

drawn from its solids by tools/drawbook.py

Seconds jewel (Lagerstein f. Sek.)

## Seconds jewel (Lagerstein f. Sek.) — sheet 2

The seconds arbor’s lower jewel, the train’s only one in the German original: its face 1.7 in from the bridge’s plate side, so

the arbor’s shoulder takes its endshake on its flat face; an oil sink opens in its dial side.

Parts list

Drawing | Name | Units | Material | Finish, heat treatment | Fit, as measured on the model
05 05 04-1 | Lagerstein f. Sek. (the seconds arbor's lower jewel) | 1 | not on the drawing | | takes Sekundentrieb (seconds pinion and arbor): in it (run): 0.676 mm, least gap 0.0163

What it does (05 05 04-1). The seconds arbor's lower pivot runs in it; its face takes the arbor's endshake (its sheet isn't in

the set; the coloured section names it).

Turned about its axis; length 1.10, largest Ø 3.60. Diameters: Ø 3.60. Shoulders from the lower end: 0.00, 1.10.

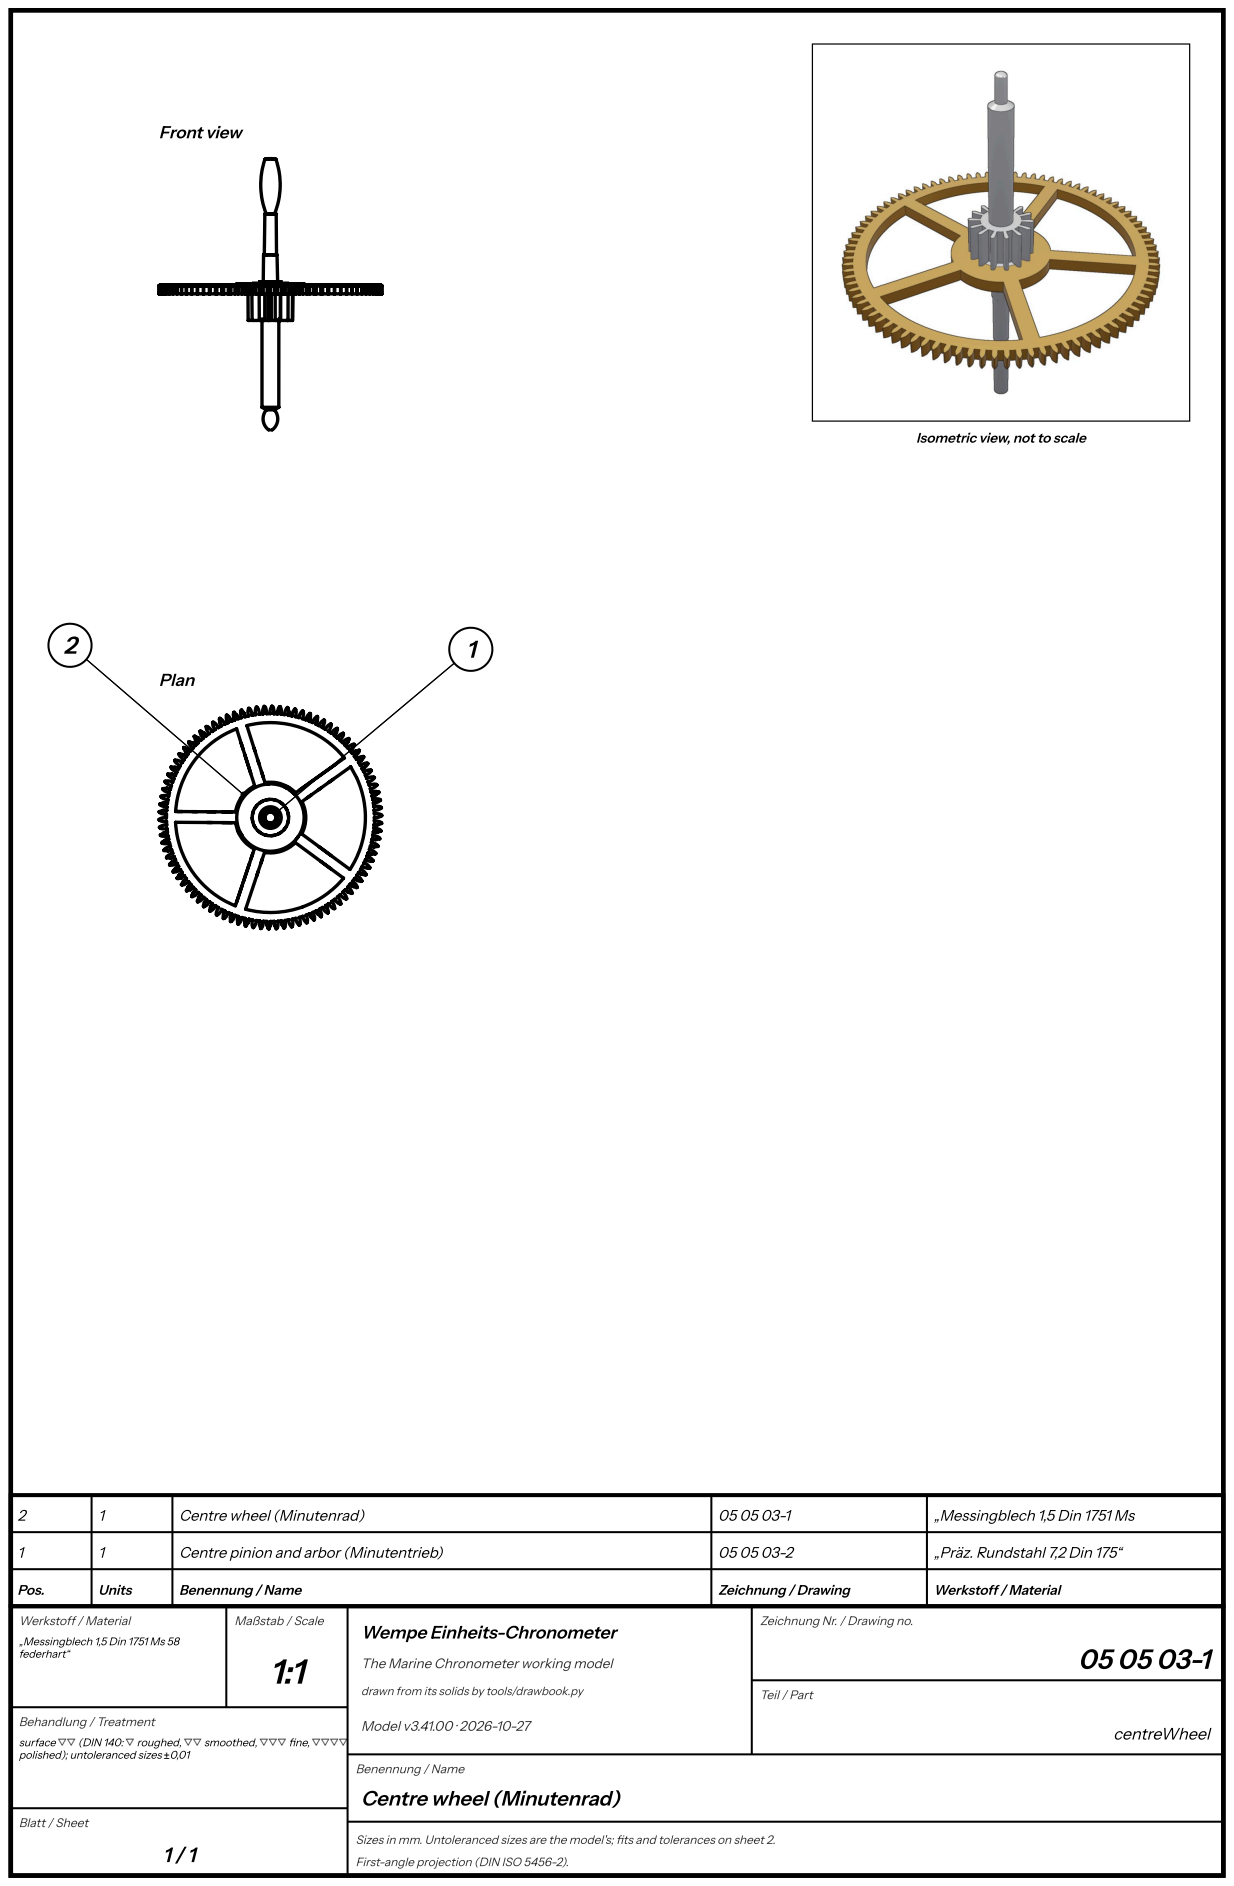
[picture p363: page 92]
Front view; Plan; Pos.; Units; Benennung / Name; Zeichnung / Drawing; Werkstoff / Material; Centre pinion and arbor (Minutentrieb); „Präz. Rundstahl 7,2 Din 175“; Centre wheel (Minutenrad); „Messingblech 1,5 Din 1751 Ms; Maßstab / Scale; Behandlung / Treatment; Model v3.41.00 · 2026-10-27; Teil / Part; centreWheel

Isometric view, not to scale

Zeichnung Nr. / Drawing no.

„Messingblech 1,5 Din 1751 Ms 58
federhart“

Wempe Einheits-Chronometer

The Marine Chronometer working model

drawn from its solids by tools/drawbook.py

surface ▽▽ (DIN 140: ▽ roughed, ▽▽ smoothed, ▽▽▽ fine, ▽▽▽▽
polished); untoleranced sizes ±0,01

Centre wheel (Minutenrad)

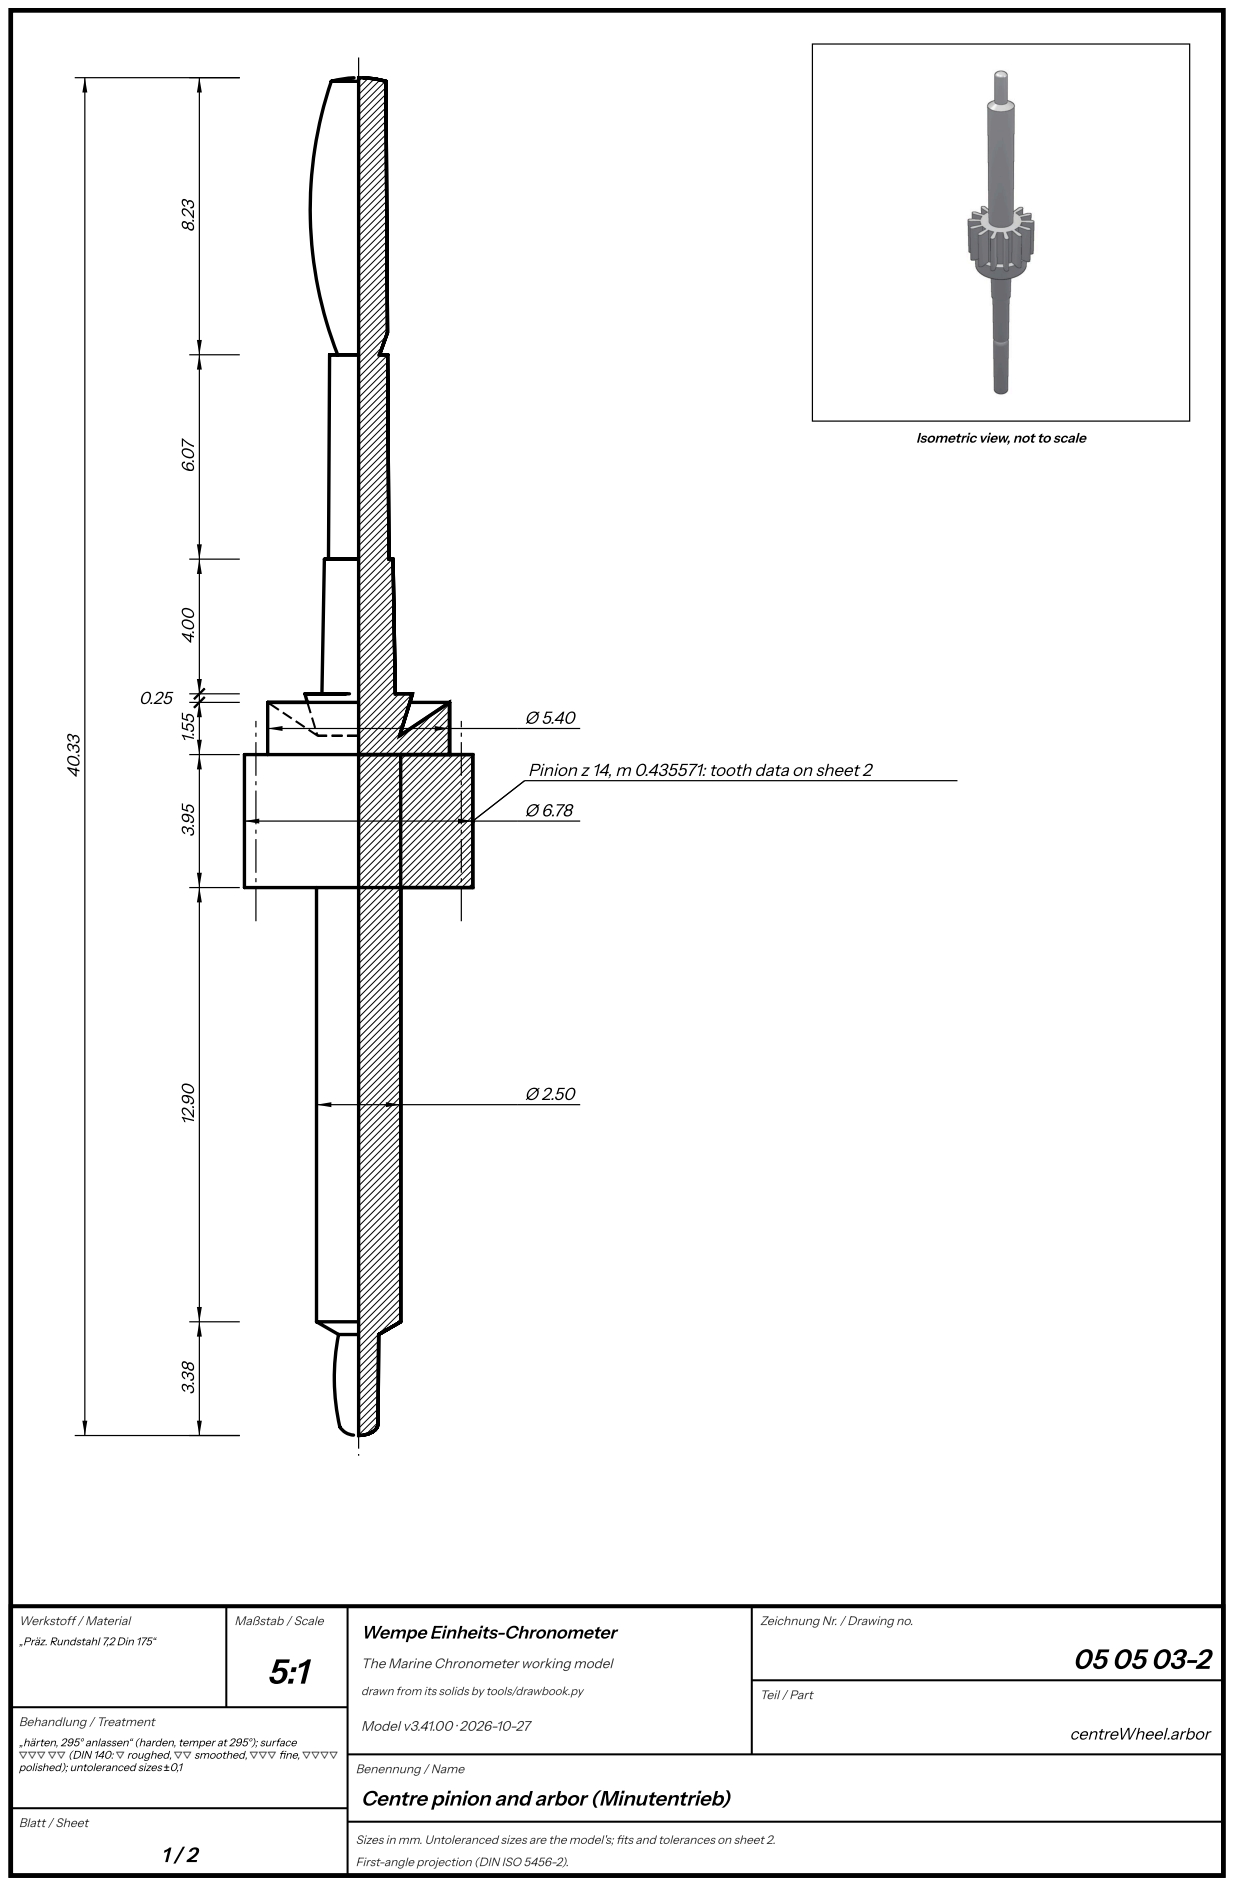
[picture p364: page 93]
Werkstoff / Material; Maßstab / Scale; Behandlung / Treatment; Model v3.41.00 · 2026-10-27; Teil / Part; centreWheel.arbor

Isometric view, not to scale

Pinion z 14, m 0.435571: tooth data on sheet 2

Zeichnung Nr. / Drawing no.

„Präz. Rundstahl 7,2 Din 175“

Wempe Einheits-Chronometer

The Marine Chronometer working model

drawn from its solids by tools/drawbook.py

„härten, 295° anlassen“ (harden, temper at 295°); surface
▽▽▽ ▽▽ (DIN 140: ▽ roughed, ▽▽ smoothed, ▽▽▽ fine, ▽▽▽▽
polished); untoleranced sizes ±0,1

Centre pinion and arbor (Minutentrieb)

## Centre pinion and arbor (Minutentrieb) — sheet 2

The centre arbor’s steel pinion and arbor, one piece: the upper pivot, the 14-leaf pinion the fusee wheel drives, the seat the

wheel is riveted on, the collar that bears on the pillar plate’s bush, the journal that runs in it, and the tapered shank for the

cannon tube.

Parts list

Drawing | Name | Units | Material | Finish, heat treatment | Fit, as measured on the model
05 05 03-2 | Minutentrieb (centre pinion and arbor) | 1 | „Präz. Rundstahl 7,2 Din 175“ | „härten, 295° anlassen“ (harden, temper at 295°); surface ▽▽▽ ▽▽ (DIN 140: ▽ roughed, ▽▽ smoothed, ▽▽▽ fine, ▽▽▽▽ polished); untoleranced sizes ±0,1 | in WN-301 (run): 2.255 mm, least gap 0.0102; in WN-302 (run): 3.006 mm, least gap 0.012; endshake 0.084 mm (WN-302 / WN-301)

What it does (05 05 03-2). Driven by the fusee wheel; turns once an hour; runs in the top plate's bush WN-301 and, by its

journal, in the pillar plate's WN-302, and carries the cannon tube (05 05 03-3) on its shank.

Turned about its axis; length 40.33, largest Ø 6.66. Diameters: Ø 2.50, Ø 5.40, Ø 6.78. Shoulders from the lower end: 0.00,

3.38, 16.28, 20.23, 21.78, 22.03, 26.03, 32.10, 40.33.

Leaves 16.28-20.23 from the lower end, pitch Ø 6.10; their form is the view from the end, drawn at the sheet's scale.

Teeth

Number | Module | Tip Ø | Root Ø
14 | 0.43557142857142855 | 6.78

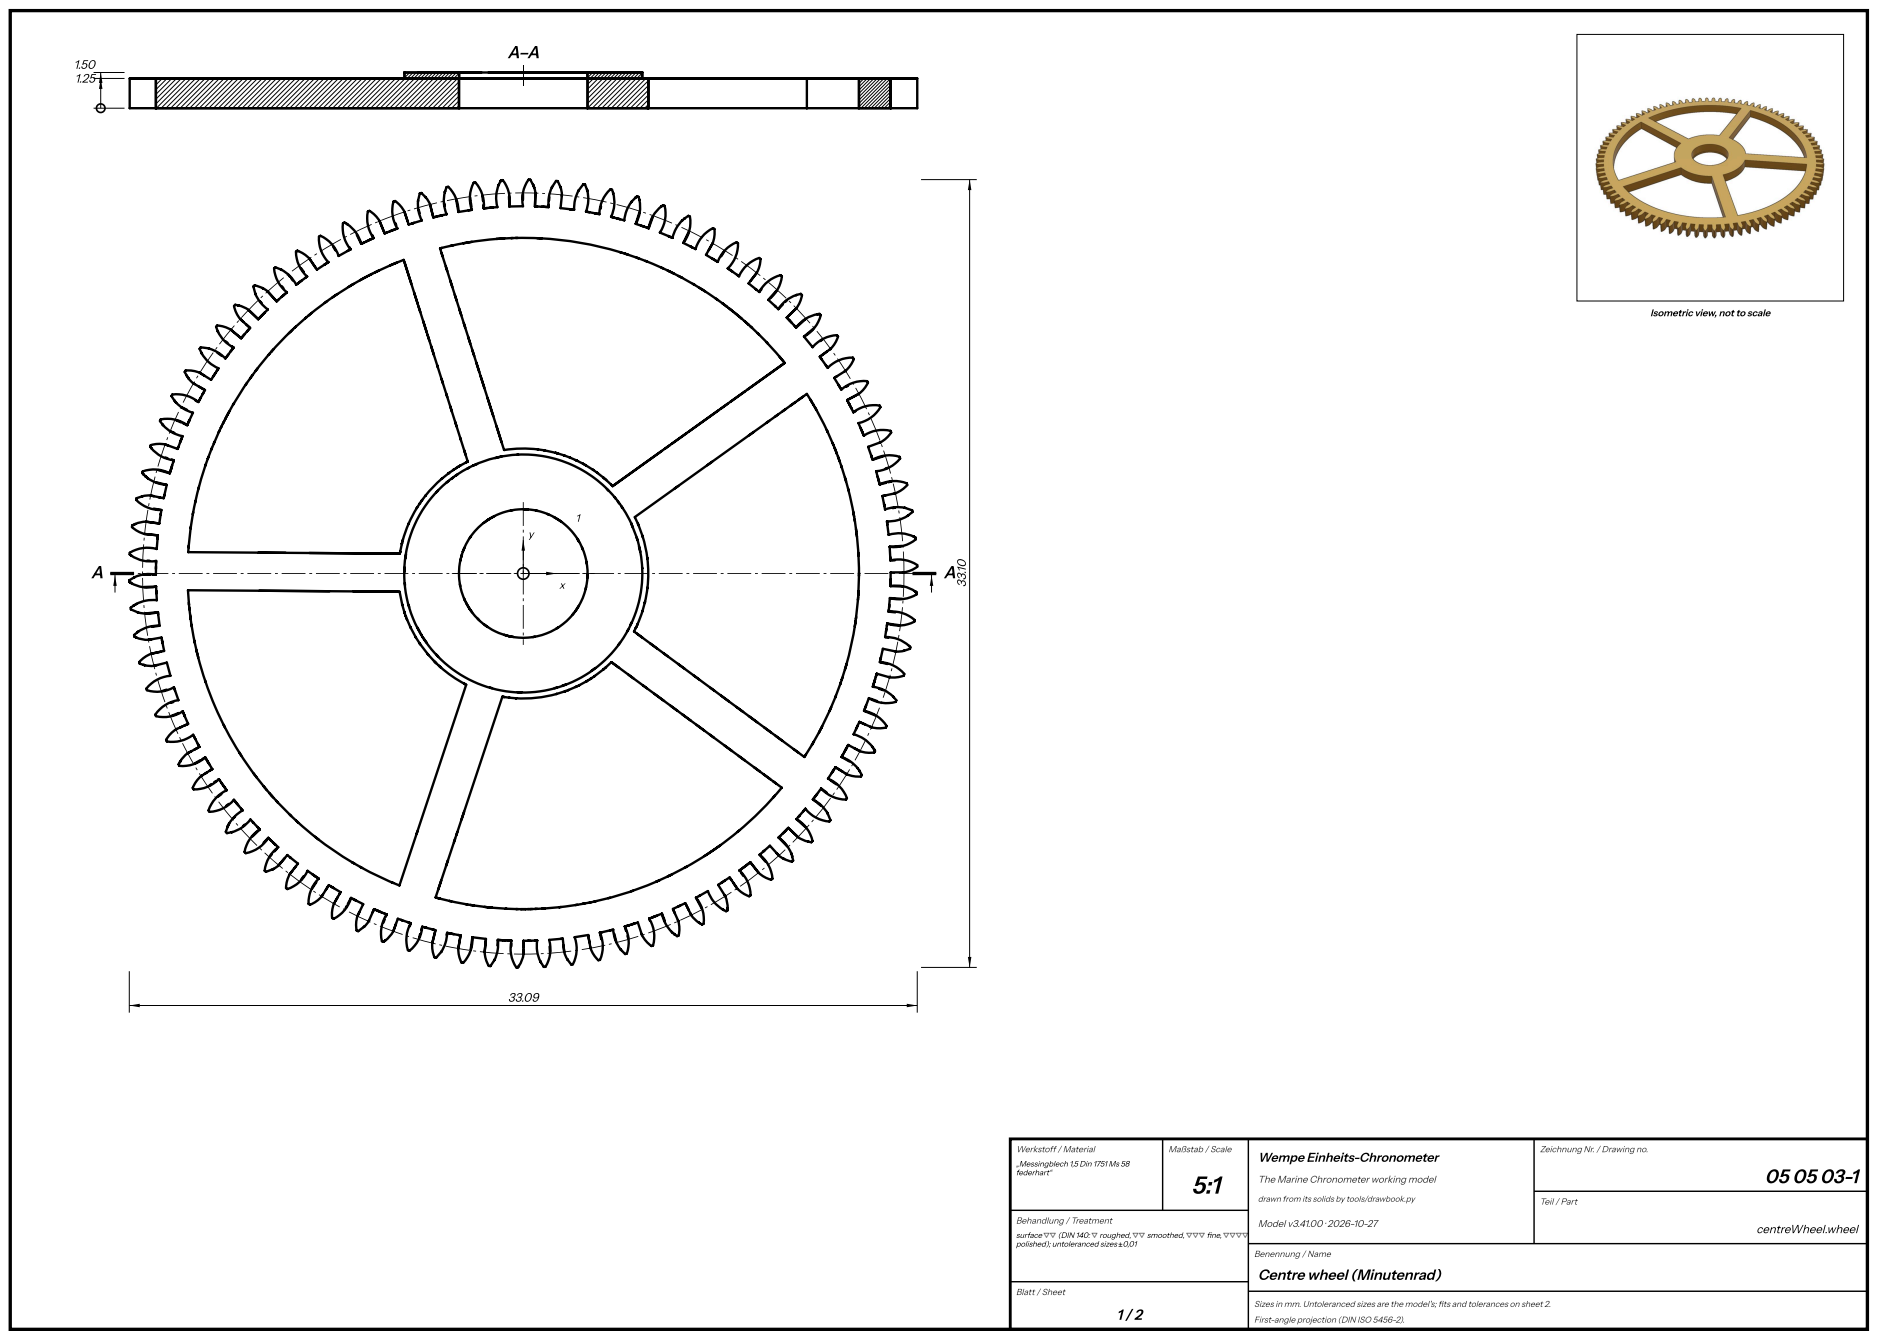
[picture p365: page 95]
Werkstoff / Material; Maßstab / Scale; Behandlung / Treatment; Model v3.41.00 · 2026-10-27; Teil / Part; centreWheel.wheel

Isometric view, not to scale

Zeichnung Nr. / Drawing no.

„Messingblech 1,5 Din 1751 Ms 58
federhart“

Wempe Einheits-Chronometer

The Marine Chronometer working model

drawn from its solids by tools/drawbook.py

surface ▽▽ (DIN 140: ▽ roughed, ▽▽ smoothed, ▽▽▽ fine, ▽▽▽▽
polished); untoleranced sizes ±0,01

Centre wheel (Minutenrad)

## Centre wheel (Minutenrad) — sheet 2

The centre wheel, five-spoked, riveted on the pinion’s seat; it drives the intermediate pinion. Its hub keeps the sheet’s

thickness and stands 0.2 proud of the rim on the dial side.

Parts list

Drawing | Name | Units | Material | Finish, heat treatment | Fit, as measured on the model
05 05 03-1 | Minutenrad (centre wheel) | 1 | „Messingblech 1,5 Din 1751 Ms 58 federhart“ | surface ▽▽ (DIN 140: ▽ roughed, ▽▽ smoothed, ▽▽▽ fine, ▽▽▽▽ polished); untoleranced sizes ±0,01 | -7.5

What it does (05 05 03-1). Riveted on the pinion's seat; drives the intermediate pinion.

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

depths from the face seen in the plan (the top). Thickness 1.50.

Holes

Hole | x | y | Size
1 | 0.00 | 0.00 | Ø 5.40 through (0.25 thick at 1.25-1.50)

The contour has 566 elements (its teeth): the drawing and the tooth data define it.

Levels

Faces in section A-A, from the bottom face: 1.25, 1.50.

Teeth

Number | Module | Tip Ø | Root Ø
90 | 0.3552888888888889 | 33.10 | 30.86

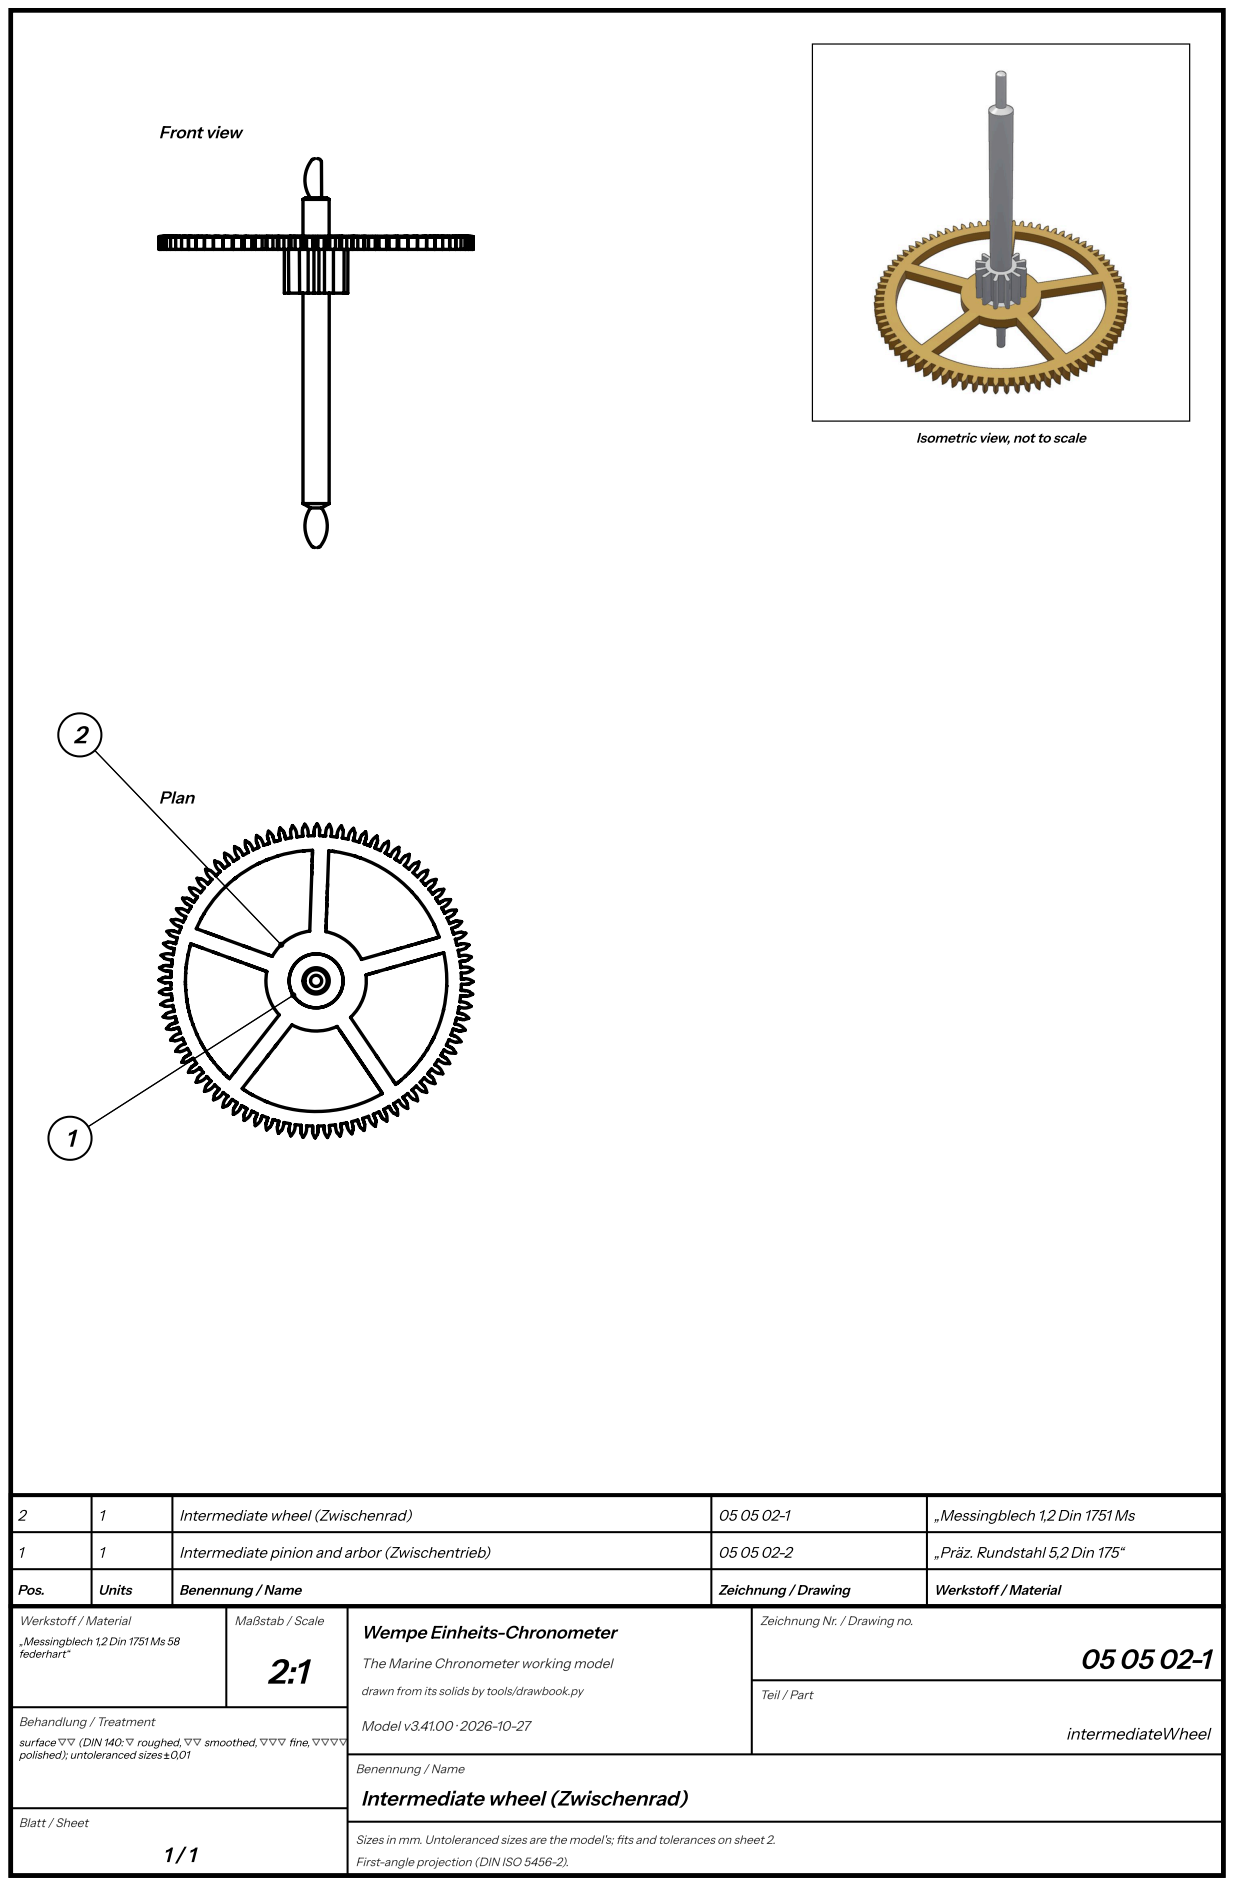
[picture p366: page 97]
Front view; Plan; Pos.; Units; Benennung / Name; Zeichnung / Drawing; Werkstoff / Material; Intermediate pinion and arbor (Zwischentrieb); „Präz. Rundstahl 5,2 Din 175“; Intermediate wheel (Zwischenrad); „Messingblech 1,2 Din 1751 Ms; Maßstab / Scale; Behandlung / Treatment; Model v3.41.00 · 2026-10-27; Teil / Part; intermediateWheel

Isometric view, not to scale

Zeichnung Nr. / Drawing no.

„Messingblech 1,2 Din 1751 Ms 58
federhart“

Wempe Einheits-Chronometer

The Marine Chronometer working model

drawn from its solids by tools/drawbook.py

surface ▽▽ (DIN 140: ▽ roughed, ▽▽ smoothed, ▽▽▽ fine, ▽▽▽▽
polished); untoleranced sizes ±0,01

Intermediate wheel (Zwischenrad)

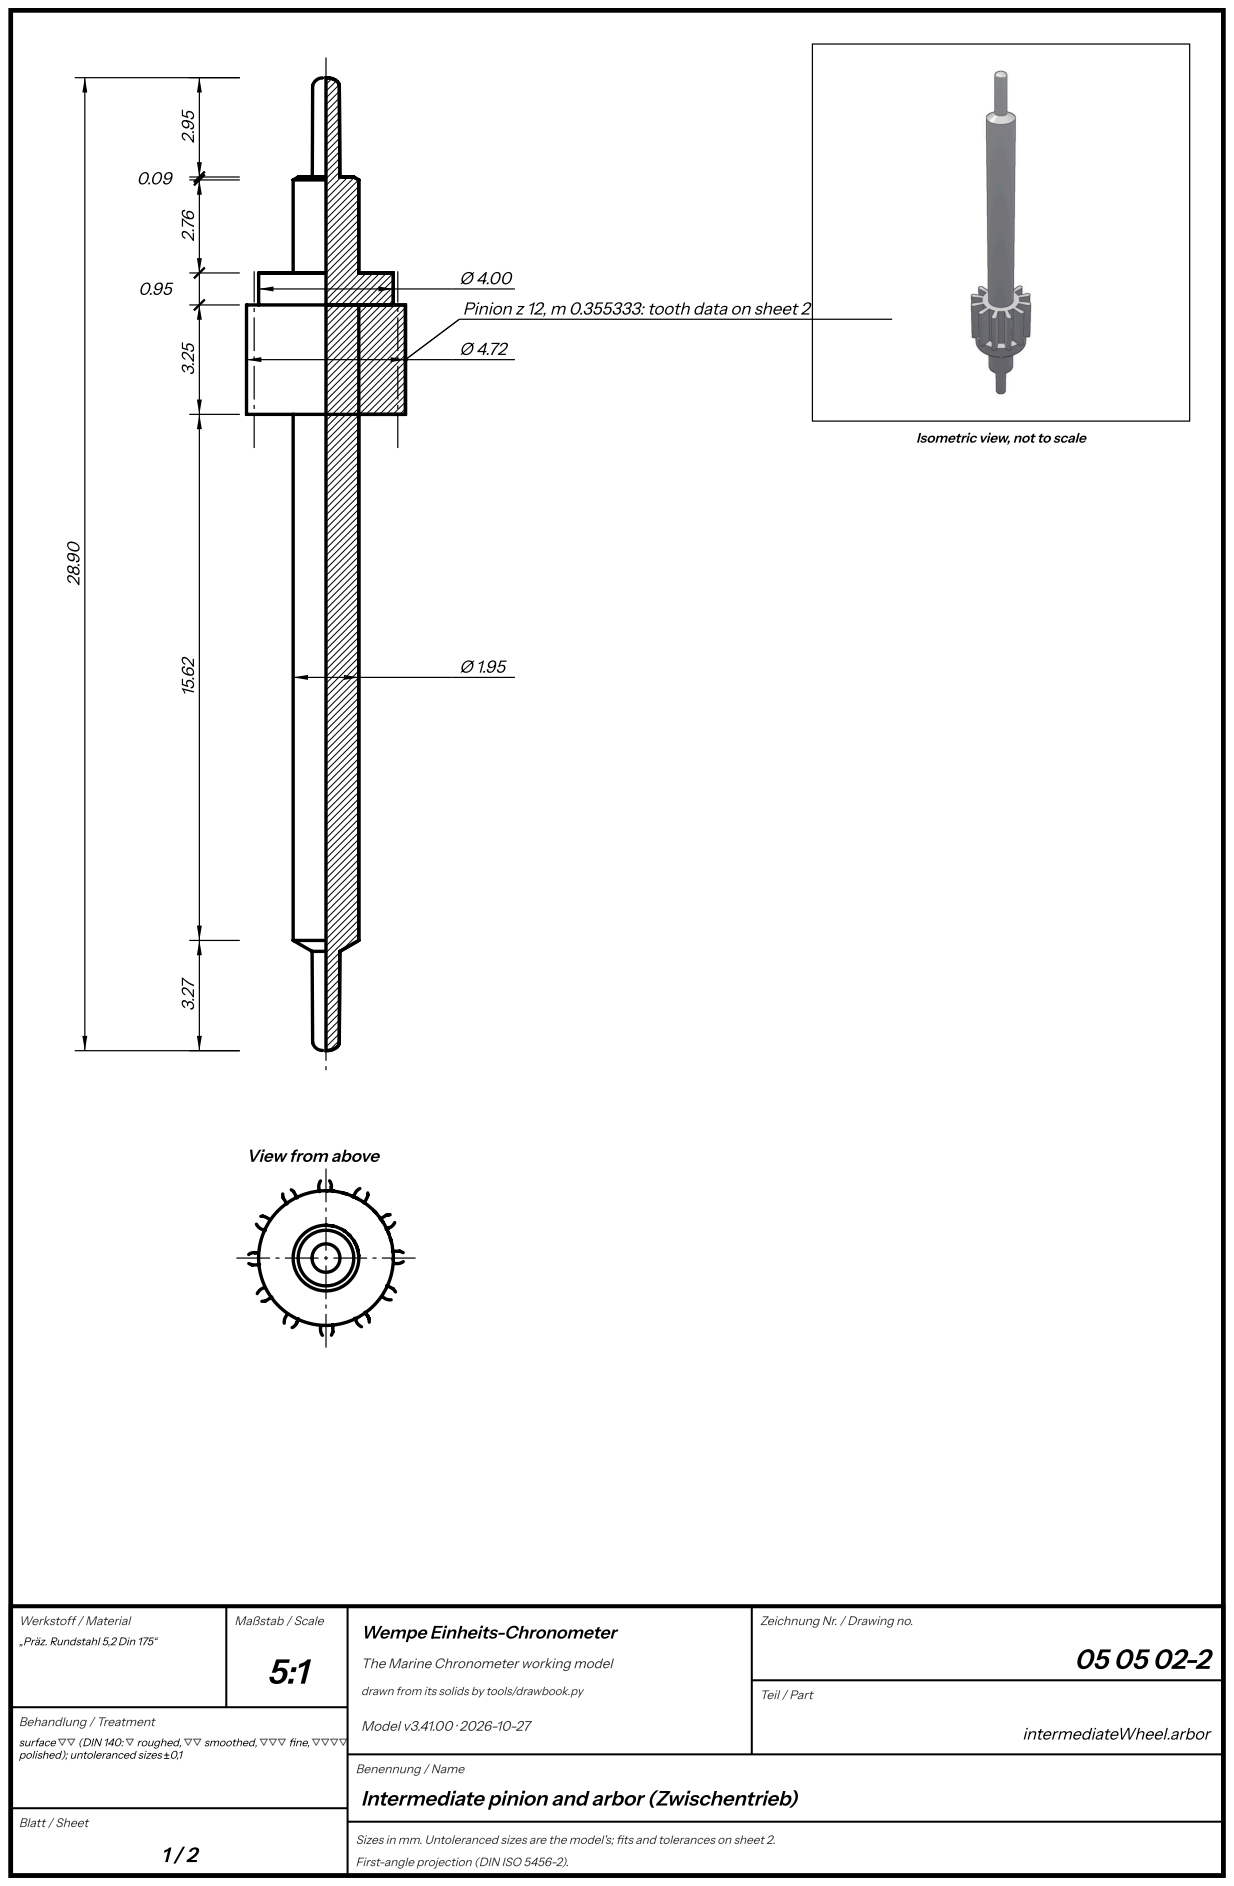
[picture p367: page 98]
Werkstoff / Material; Maßstab / Scale; Behandlung / Treatment; Model v3.41.00 · 2026-10-27; Teil / Part; intermediateWheel.arbor

Pinion z 12, m 0.355333: tooth data on sheet 2

Isometric view, not to scale

View from above

Zeichnung Nr. / Drawing no.

„Präz. Rundstahl 5,2 Din 175“

Wempe Einheits-Chronometer

The Marine Chronometer working model

drawn from its solids by tools/drawbook.py

surface ▽▽ (DIN 140: ▽ roughed, ▽▽ smoothed, ▽▽▽ fine, ▽▽▽▽
polished); untoleranced sizes ±0,1

Intermediate pinion and arbor (Zwischentrieb)

## Intermediate pinion and arbor (Zwischentrieb) — sheet 2

The intermediate arbor’s steel pinion and arbor, one piece: 12 leaves, driven by the centre wheel, and the seat its wheel is

riveted on, between its two pivots.

Parts list

Drawing | Name | Units | Material | Finish, heat treatment | Fit, as measured on the model
05 05 02-2 | Zwischentrieb (intermediate pinion and arbor) | 1 | „Präz. Rundstahl 5,2 Din 175“ | surface ▽▽ (DIN 140: ▽ roughed, ▽▽ smoothed, ▽▽▽ fine, ▽▽▽▽ polished); untoleranced sizes ±0,1 | in WN-300.t38/6MX.jw38u (run): 2.154 mm, least gap 0.0107; in WN-300.zb/6MX.jw38l (run): 2.154 mm, least gap 0.0182; endshake 0.074 mm (WN-300.zb / WN-300.t38)

What it does (05 05 02-2). Driven by the centre wheel; runs in the top plate's bush WN-300 and the intermediate bridge's.

In the Soviet 6MX (the page's Variants) it runs in jewels in chatons at both ends.

Turned about its axis; length 28.90, largest Ø 4.72. Diameters: Ø 1.95, Ø 4.00, Ø 4.72. Shoulders from the lower end: 0.00,

3.28, 18.90, 22.15, 23.10, 25.86, 25.95, 28.90.

Leaves 18.90-22.15 from the lower end, pitch Ø 4.26; their form is the view from the end, drawn at the sheet's scale.

Teeth

Number | Module | Tip Ø | Root Ø
12 | 0.35533333333333333 | 4.72

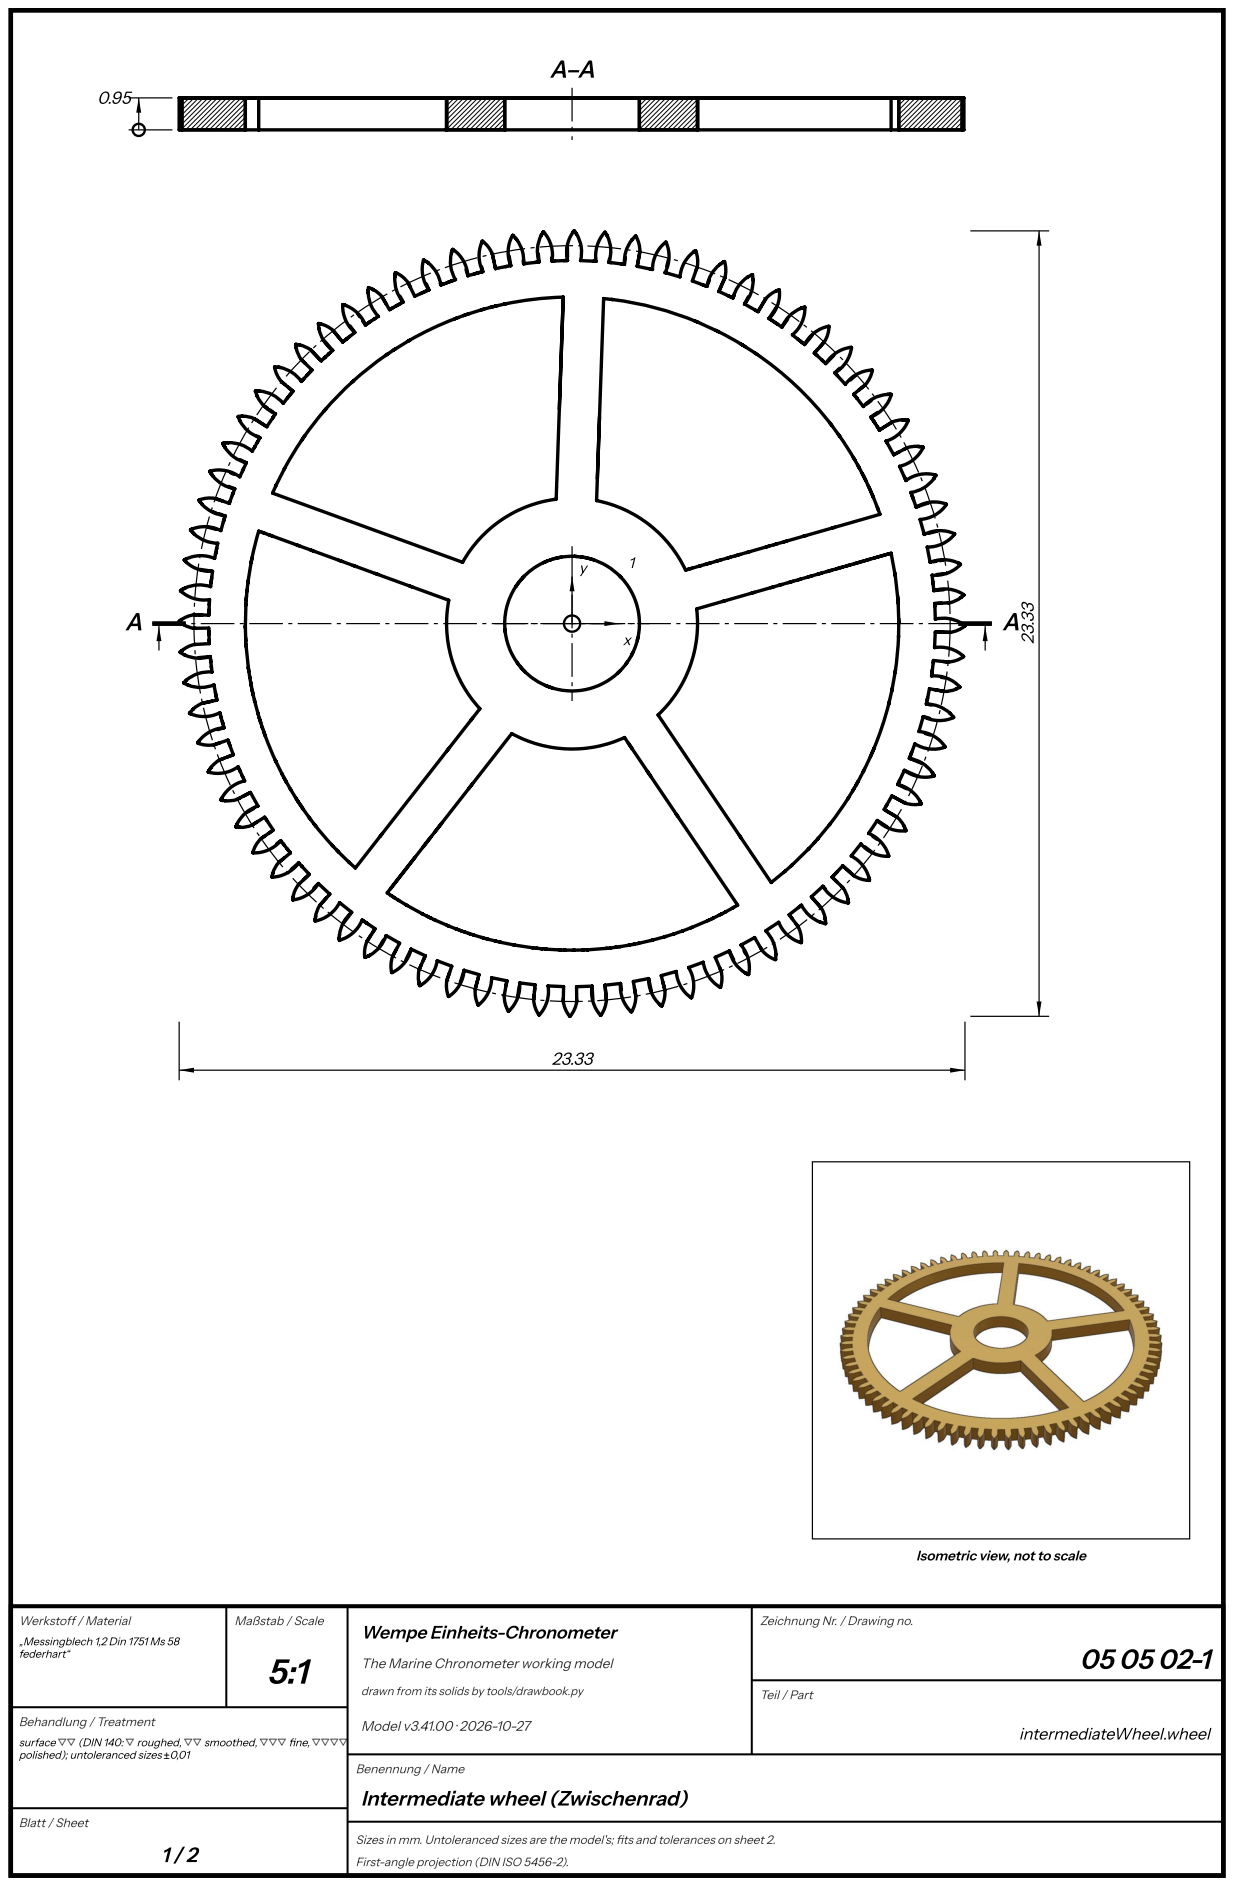
[picture p368: page 100]
Werkstoff / Material; Maßstab / Scale; Behandlung / Treatment; Model v3.41.00 · 2026-10-27; Teil / Part; intermediateWheel.wheel

Isometric view, not to scale

Zeichnung Nr. / Drawing no.

„Messingblech 1,2 Din 1751 Ms 58
federhart“

Wempe Einheits-Chronometer

The Marine Chronometer working model

drawn from its solids by tools/drawbook.py

surface ▽▽ (DIN 140: ▽ roughed, ▽▽ smoothed, ▽▽▽ fine, ▽▽▽▽
polished); untoleranced sizes ±0,01

Intermediate wheel (Zwischenrad)

## Intermediate wheel (Zwischenrad) — sheet 2

The intermediate wheel, five-spoked, riveted on the pinion’s seat; it drives the seconds pinion. Its hub stands 0.2 proud on

the dial side.

Parts list

Drawing | Name | Units | Material | Finish, heat treatment | Fit, as measured on the model
05 05 02-1 | Zwischenrad (intermediate wheel) | 1 | „Messingblech 1,2 Din 1751 Ms 58 federhart“ | surface ▽▽ (DIN 140: ▽ roughed, ▽▽ smoothed, ▽▽▽ fine, ▽▽▽▽ polished); untoleranced sizes ±0,01 | -8

What it does (05 05 02-1). Riveted on the pinion's seat; drives the seconds pinion.

Coordinates from the datum, hole 1's centre (marked on the plan), x to the right and y up the plan as drawn; depths from

the face seen in the plan (the top). Thickness 0.95.

Holes

Hole | x | y | Size
1 | 0.00 | 0.00 | Ø 4.00 through

Contourin the plan

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

radius.

Contour | # | Element | From x, y | To x, y | Centre x, y | R
Outline | 1 | arc clockwise | -11.36, -2.65 | -10.54, -2.27 | -10.56, -3.31 | 1.03
Outline | 2 | line | -10.54, -2.27 | -10.63, -1.82
Outline | 3 | arc clockwise | -10.63, -1.82 | -11.53, -1.77 | -11.03, -0.86 | 1.03
Outline | 4 | line | -11.53, -1.77 | -11.53, -1.76
Outline | 5 | arc clockwise | -11.53, -1.76 | -10.69, -1.44 | -10.78, -2.47 | 1.03
Outline | 6 | line | -10.69, -1.44 | -10.74, -0.98
Outline | 7 | arc clockwise | -10.74, -0.98 | -11.63, -0.86 | -11.06, 0.00 | 1.03
Outline | 8 | line | -11.63, -0.86 | -11.63, -0.85
Outline | 9 | arc clockwise | -11.63, -0.85 | -10.77, -0.60 | -10.94, -1.62 | 1.03
Outline | 10 | line | -10.77, -0.60 | -10.78, -0.13
Outline | 11 | arc clockwise | -10.78, -0.13 | -11.66, 0.06 | -11.03, 0.87 | 1.03
Outline | 12 | line | -11.66, 0.06 | -11.66, 0.07
Outline | 13 | arc clockwise | -11.66, 0.07 | -10.78, 0.25 | -11.04, -0.75 | 1.03
Outline | 14 | line | -10.78, 0.25 | -10.76, 0.71
Outline | 15 | arc clockwise | -10.76, 0.71 | -11.62, 0.97 | -10.93, 1.74 | 1.03
Outline | 16 | line | -11.62, 0.97 | -11.62, 0.98
Outline | 17 | arc clockwise | -11.62, 0.98 | -10.73, 1.10 | -11.06, 0.12 | 1.03
Outline | 18 | line | -10.73, 1.10 | -10.67, 1.56
Outline | 19 | arc clockwise | -10.67, 1.56 | -11.51, 1.88 | -10.76, 2.59 | 1.03
Outline | 20 | line | -11.51, 1.88 | -11.51, 1.89
Outline | 21 | arc clockwise | -11.51, 1.89 | -10.61, 1.93 | -11.02, 0.98 | 1.03
Outline | 22 | line | -10.61, 1.93 | -10.52, 2.39
Outline | 23 | arc clockwise | -10.52, 2.39 | -11.33, 2.78 | -10.52, 3.42 | 1.03
Outline | 24 | line | -11.33, 2.78 | -11.33, 2.79

O u tlin e | 2 5 | a r c clo c k wis e | -1 1.3 3, 2.7 9 | -1 0.4 3, 2.7 6 | -1 0.9 1, 1.8 4 | 1.0 3
O u tlin e | 2 6 | lin e | -1 0.4 3, 2.7 6 | -1 0.3 0, 3.2 1
O u tlin e | 2 7 | a r c clo c k wis e | -1 0.3 0, 3.2 1 | -1 1.0 8, 3.6 6 | -1 0.2 2, 4.2 4 | 1.0 3
O u tlin e | 2 8 | lin e | -1 1.0 8, 3.6 6 | -1 1.0 7, 3.6 7
O u tlin e | 2 9 | a r c clo c k wis e | -1 1.0 7, 3.6 7 | -1 0.1 8, 3.5 7 | -1 0.7 3, 2.6 9 | 1.0 3
O u tlin e | 3 0 | lin e | -1 0.1 8, 3.5 7 | -1 0.0 1, 4.0 0
O u tlin e | 3 1 | a r c clo c k wis e | -1 0.0 1, 4.0 0 | -1 0.7 5, 4.5 2 | -9.8 6, 5.0 3 | 1.0 3
O u tlin e | 3 2 | lin e | -1 0.7 5, 4.5 2 | -1 0.7 5, 4.5 3
O u tlin e | 3 3 | a r c clo c k wis e | -1 0.7 5, 4.5 3 | -9.8 7, 4.3 6 | -1 0.4 9, 3.5 3 | 1.0 3
O u tlin e | 3 4 | lin e | -9.8 7, 4.3 6 | -9.6 7, 4.7 8
O u tlin e | 3 5 | a r c clo c k wis e | -9.6 7, 4.7 8 | -1 0.3 7, 5.3 5 | -9.4 3, 5.7 8 | 1.0 3
O u tlin e | 3 6 | lin e | -1 0.3 7, 5.3 5 | -1 0.3 6, 5.3 6
O u tlin e | 3 7 | a r c clo c k wis e | -1 0.3 6, 5.3 6 | -9.4 9, 5.1 2 | -1 0.1 8, 4.3 4 | 1.0 3
O u tlin e | 3 8 | lin e | -9.4 9, 5.1 2 | -9.2 6, 5.5 2
O u tlin e | 3 9 | a r c clo c k wis e | -9.2 6, 5.5 2 | -9.9 2, 6.1 4 | -8.9 5, 6.5 1 | 1.0 3
O u tlin e | 4 0 | lin e | -9.9 2, 6.1 4 | -9.9 1, 6.1 5
O u tlin e | 4 1 | a r c clo c k wis e | -9.9 1, 6.1 5 | -9.0 6, 5.8 5 | -9.8 0, 5.1 3 | 1.0 3
O u tlin e | 4 2 | lin e | -9.0 6, 5.8 5 | -8.8 0, 6.2 3
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
Cut-out 6 | 343 | line | -3.66, 0.69 | -9.30, 2.75
Cut-out 6 | 344 | line | -9.30, 2.75 | -9.38, 2.48

Levels

Faces in section A-A, from the bottom face: 0.95.

Teeth

Number | Module | Tip Ø | Root Ø
80 | 0.2806625 | 23.33 | 21.57

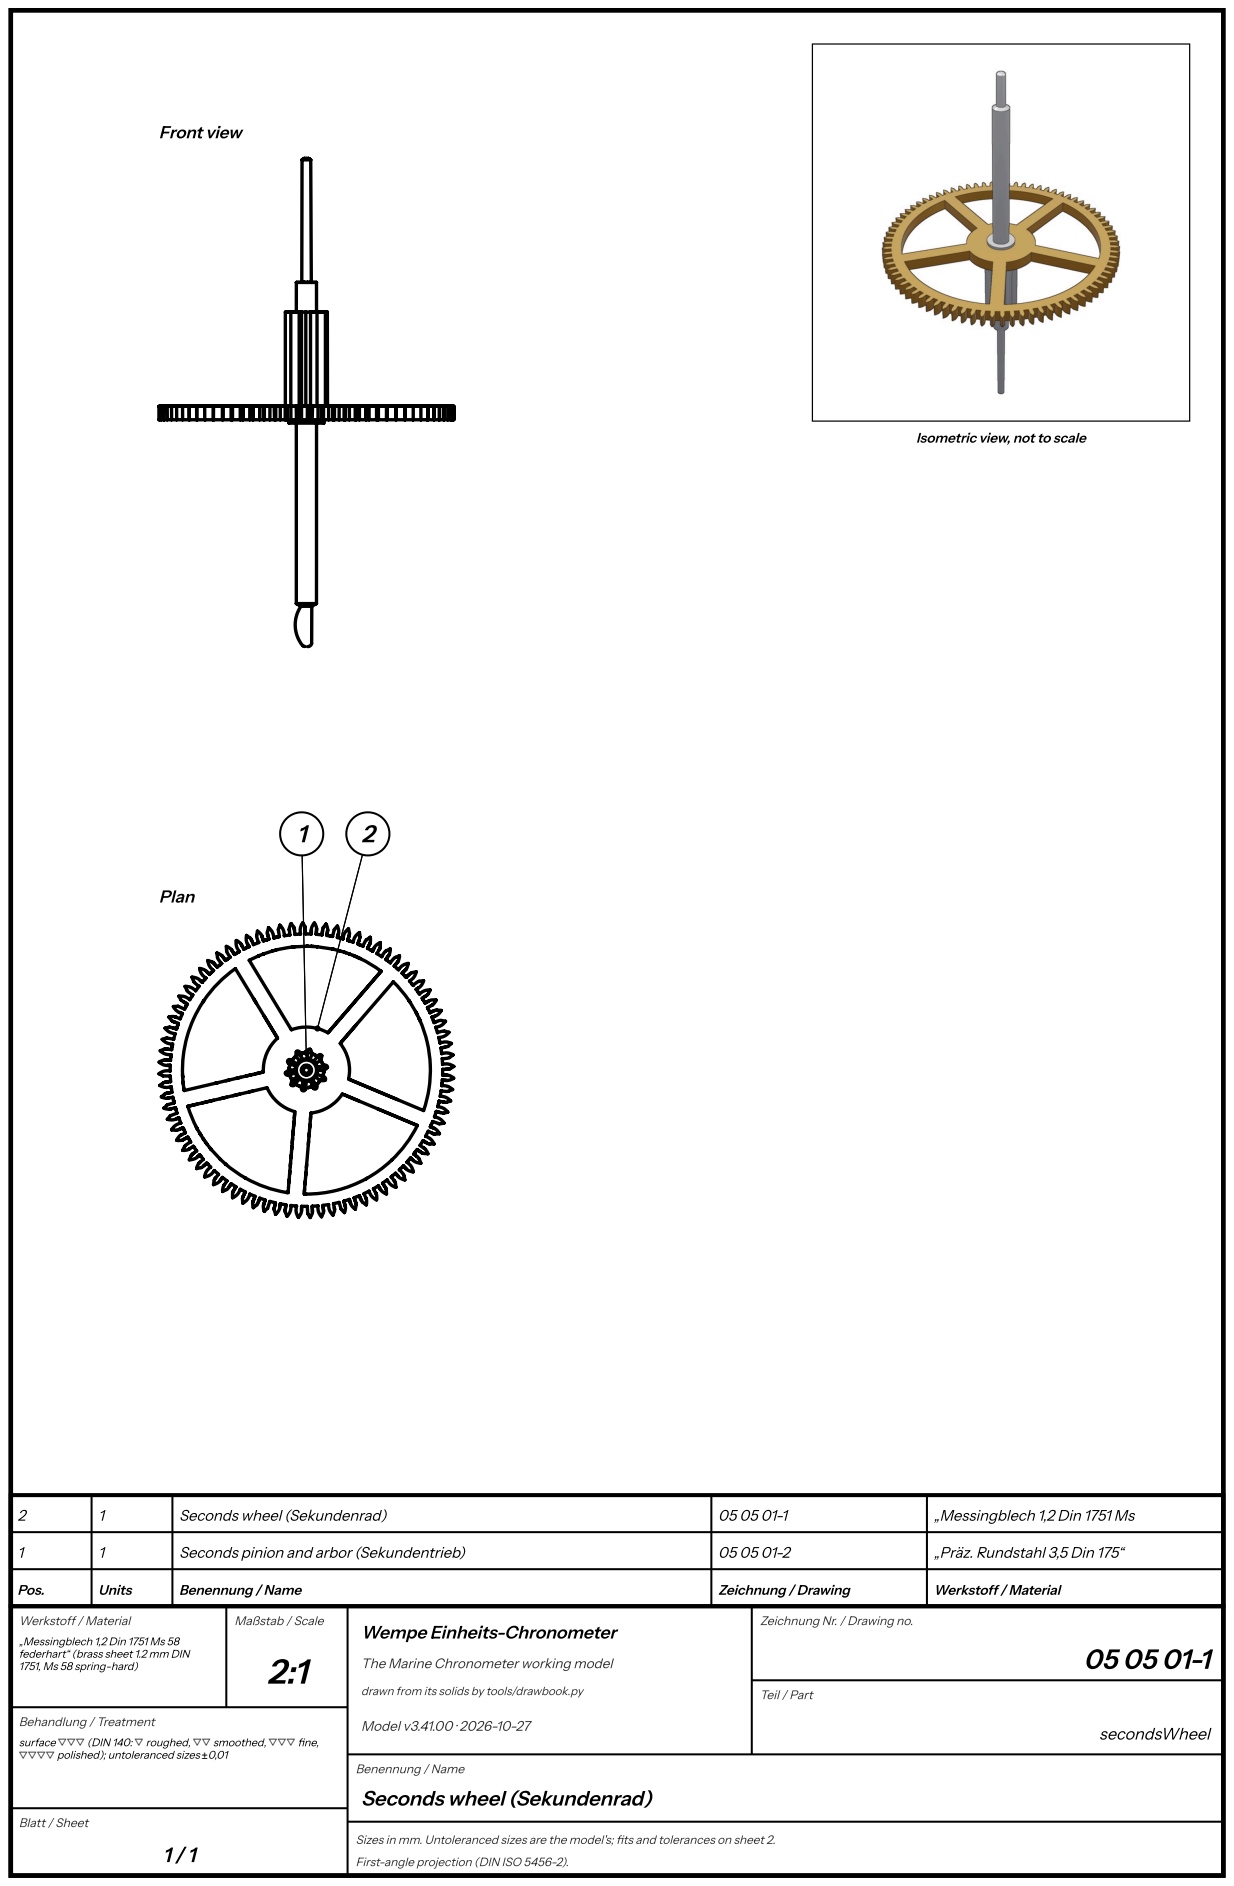
[picture p369: page 109]
Front view; Plan; Pos.; Units; Benennung / Name; Zeichnung / Drawing; Werkstoff / Material; Seconds pinion and arbor (Sekundentrieb); „Präz. Rundstahl 3,5 Din 175“; Seconds wheel (Sekundenrad); „Messingblech 1,2 Din 1751 Ms; Maßstab / Scale; Behandlung / Treatment; Model v3.41.00 · 2026-10-27; Teil / Part; secondsWheel

Isometric view, not to scale

Zeichnung Nr. / Drawing no.

„Messingblech 1,2 Din 1751 Ms 58
federhart“ (brass sheet1.2 mm DIN
1751, Ms 58 spring-hard)

Wempe Einheits-Chronometer

The Marine Chronometer working model

drawn from its solids by tools/drawbook.py

surface ▽▽▽ (DIN 140: ▽ roughed, ▽▽ smoothed, ▽▽▽ fine,
▽▽▽▽ polished); untoleranced sizes ±0,01

Seconds wheel (Sekundenrad)

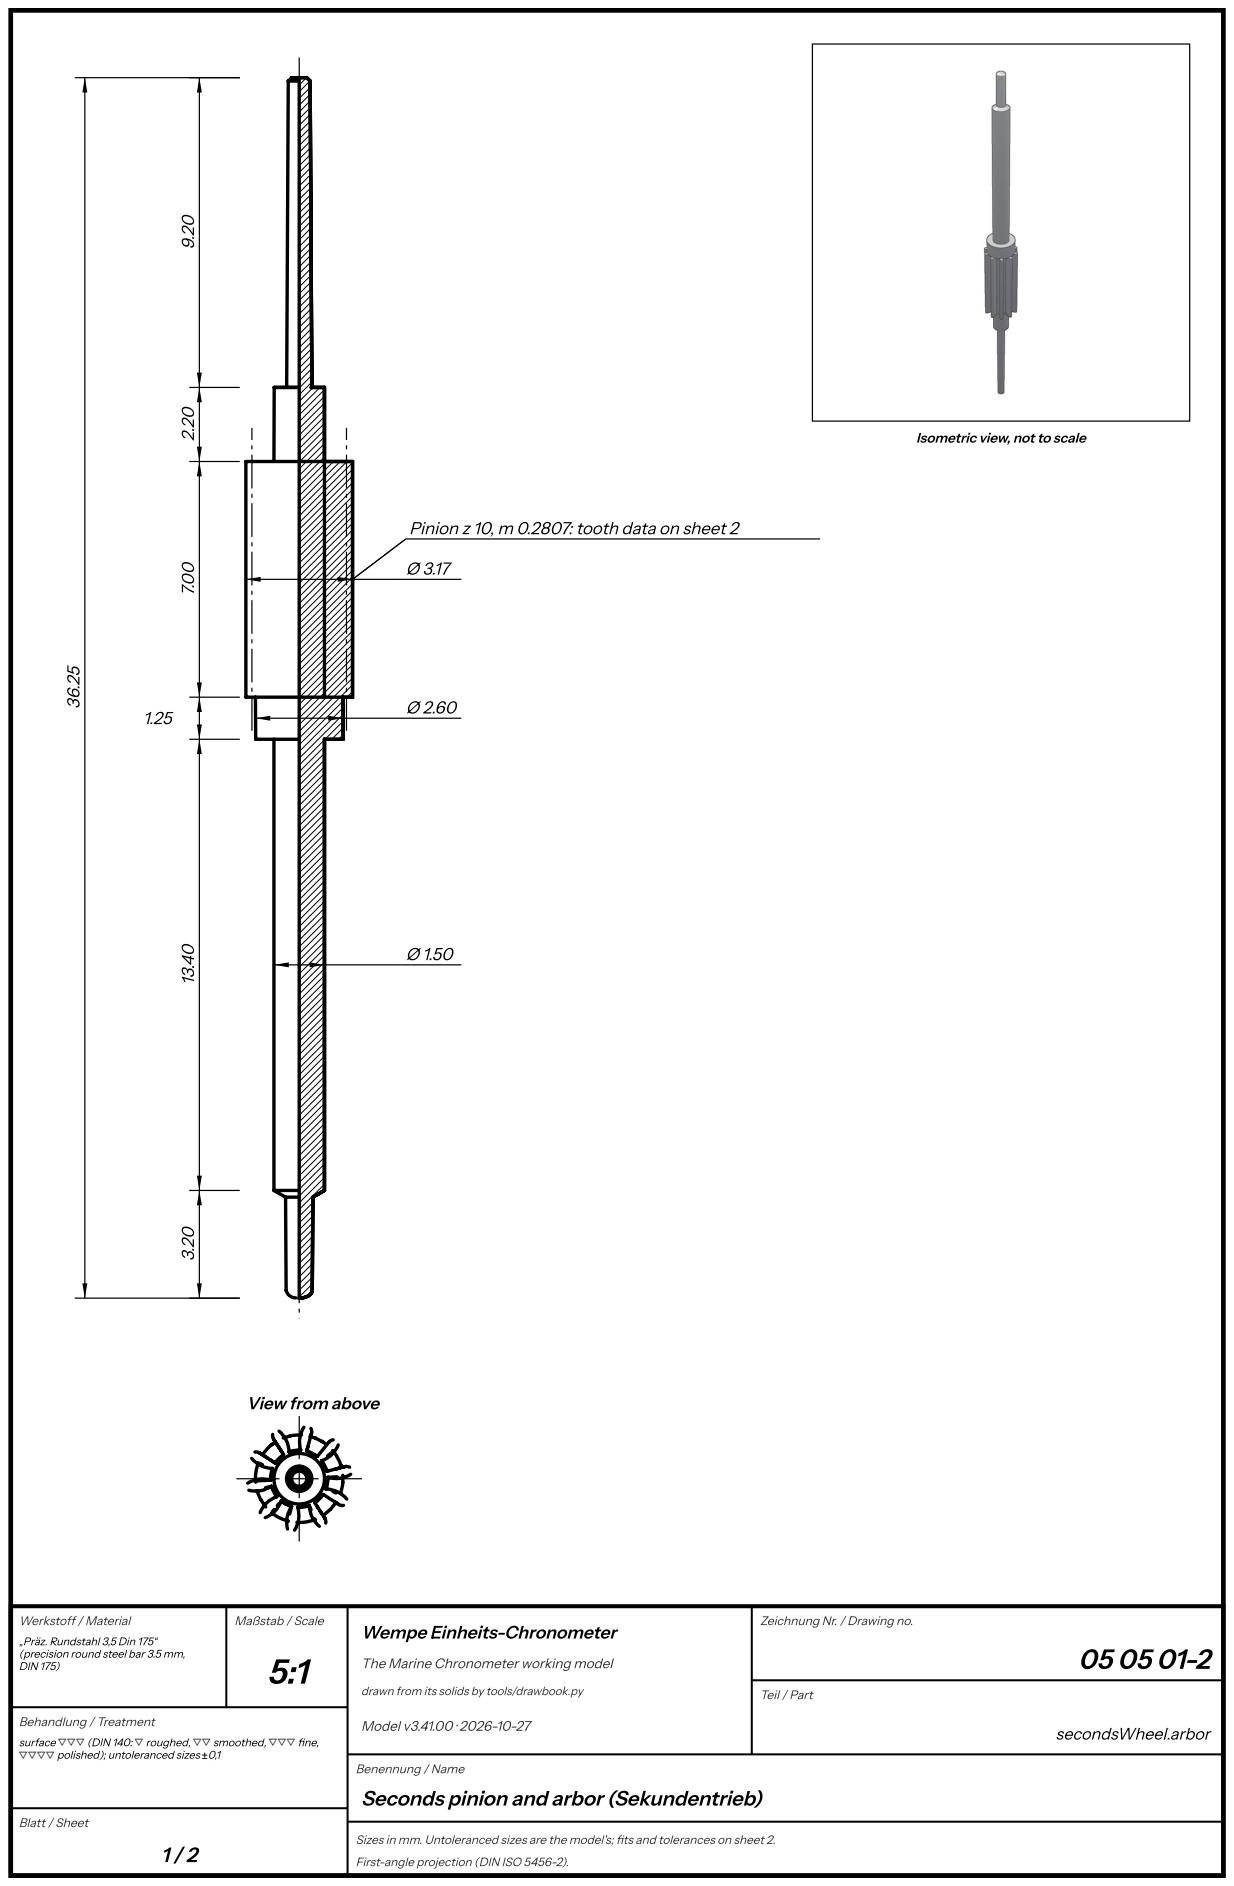
[picture p370: page 110]
Werkstoff / Material; Maßstab / Scale; Behandlung / Treatment; Model v3.41.00 · 2026-10-27; Teil / Part; secondsWheel.arbor

Isometric view, not to scale

Pinion z 10, m 0.2807: tooth data on sheet 2

View from above

Zeichnung Nr. / Drawing no.

„Präz. Rundstahl 3,5 Din 175“
(precision round steel bar 3.5 mm,
DIN 175)

Wempe Einheits-Chronometer

The Marine Chronometer working model

drawn from its solids by tools/drawbook.py

surface ▽▽▽ (DIN 140: ▽ roughed, ▽▽ smoothed, ▽▽▽ fine,
▽▽▽▽ polished); untoleranced sizes ±0,1

Seconds pinion and arbor (Sekundentrieb)

## Seconds pinion and arbor (Sekundentrieb) — sheet 2

The seconds arbor’s steel pinion and arbor, one piece: its 10 leaves driven by the intermediate wheel, the seat its wheel is

riveted on, and its lower pivot, which runs on as the post for the seconds hand.

Parts list

Drawing | Name | Units | Material | Finish, heat treatment | Fit, as measured on the model
05 05 01-2 | Sekundentrieb (seconds pinion and arbor) | 1 | „Präz. Rundstahl 3,5 Din 175“ (precision round steel bar 3.5 mm, DIN 175) | surface ▽▽▽ (DIN 140: ▽ roughed, ▽▽ smoothed, ▽▽▽ fine, ▽▽▽▽ polished); untoleranced sizes ±0,1 | in WN-300.t35/6MX.jw35u (run): 2.252 mm, least gap 0.0108; in 050504-1 (run): 0.676 mm, least gap 0.0163; endshake 0.065 mm (050504-1 / WN-300.t35)

What it does (05 05 01-2). Driven by the intermediate wheel; turns once a minute; runs in the top plate's bush WN-300

and the jewel 05 05 04-1 in the intermediate bridge; its lower pivot goes on as the seconds hand's post. In the Soviet 6MX

its upper pivot runs in a jewel in a chaton.

Turned about its axis; length 36.25, largest Ø 3.13. Diameters: Ø 1.50, Ø 2.60, Ø 3.17. Shoulders from the lower end: 0.00,

3.20, 16.60, 17.85, 24.85, 27.05, 36.25.

Leaves 17.85-24.85 from the lower end, pitch Ø 2.81; their form is the view from the end, drawn at the sheet's scale.

Teeth

Number | Module | Tip Ø | Root Ø
10 | 0.2807 | 3.17

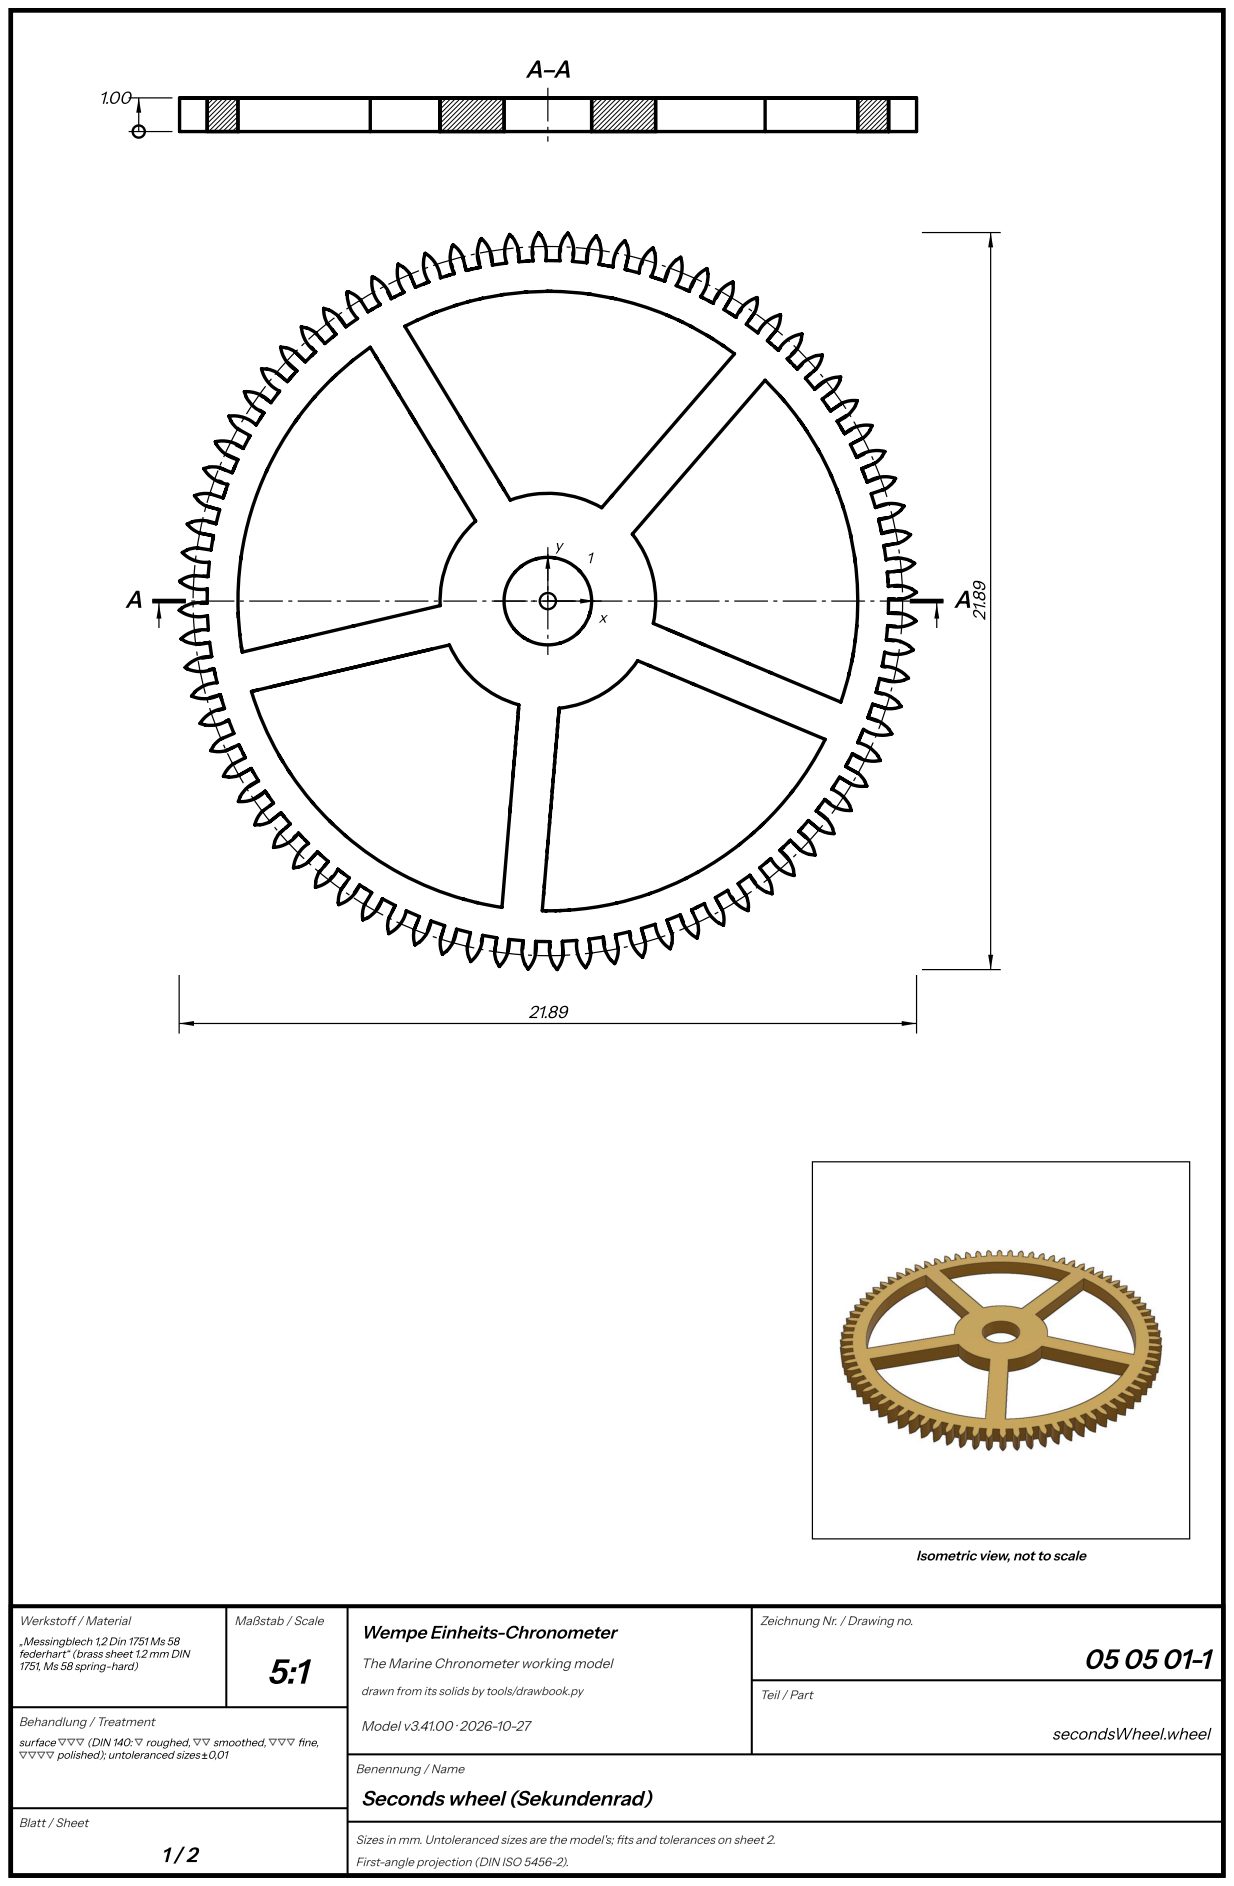
[picture p371: page 112]
Werkstoff / Material; Maßstab / Scale; Behandlung / Treatment; Model v3.41.00 · 2026-10-27; Teil / Part; secondsWheel.wheel

Isometric view, not to scale

Zeichnung Nr. / Drawing no.

„Messingblech 1,2 Din 1751 Ms 58
federhart“ (brass sheet1.2 mm DIN
1751, Ms 58 spring-hard)

Wempe Einheits-Chronometer

The Marine Chronometer working model

drawn from its solids by tools/drawbook.py

surface ▽▽▽ (DIN 140: ▽ roughed, ▽▽ smoothed, ▽▽▽ fine,
▽▽▽▽ polished); untoleranced sizes ±0,01

Seconds wheel (Sekundenrad)

## Seconds wheel (Sekundenrad) — sheet 2

The seconds wheel, five-spoked, riveted on the pinion’s seat; it drives the escape pinion. Its hub stands 0.2 proud toward

the pinion.

Parts list

Drawing | Name | Units | Material | Finish, heat treatment | Fit, as measured on the model
05 05 01-1 | Sekundenrad (seconds wheel) | 1 | „Messingblech 1,2 Din 1751 Ms 58 federhart“ (brass sheet 1.2 mm DIN 1751, Ms 58 spring-hard) | surface ▽▽▽ (DIN 140: ▽ roughed, ▽▽ smoothed, ▽▽▽ fine, ▽▽▽▽ polished); untoleranced sizes ±0,01 | -8

What it does (05 05 01-1). Riveted on the pinion's seat; drives the escape pinion (05 04 05-2).

Coordinates from the datum, hole 1's centre (marked on the plan), x to the right and y up the plan as drawn; depths from

the face seen in the plan (the top). Thickness 1.00.

Holes

Hole | x | y | Size
1 | 0.00 | 0.00 | Ø 2.60 through

Contourin the plan

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

radius.

Contour | # | Element | From x, y | To x, y | Centre x, y | R
Outline | 1 | arc clockwise | -10.14, -2.90 | -10.58, -2.82 | -10.21, -2.01 | 0.89
Outline | 2 | line | -10.58, -2.82 | -10.58, -2.81
Outline | 3 | arc clockwise | -10.58, -2.81 | -9.82, -2.43 | -9.80, -3.40 | 0.97
Outline | 4 | line | -9.82, -2.43 | -9.91, -2.01
Outline | 5 | arc clockwise | -9.91, -2.01 | -10.77, -1.98 | -10.32, -1.12 | 0.97
Outline | 6 | line | -10.77, -1.98 | -10.77, -1.97
Outline | 7 | arc clockwise | -10.77, -1.97 | -9.98, -1.65 | -10.04, -2.62 | 0.97
Outline | 8 | line | -9.98, -1.65 | -10.04, -1.22
Outline | 9 | arc clockwise | -10.04, -1.22 | -10.89, -1.13 | -10.37, -0.31 | 0.97
Outline | 10 | line | -10.89, -1.13 | -10.89, -1.12
Outline | 11 | arc clockwise | -10.89, -1.12 | -10.08, -0.86 | -10.22, -1.83 | 0.97
Outline | 12 | line | -10.08, -0.86 | -10.11, -0.43
Outline | 13 | arc clockwise | -10.11, -0.43 | -10.95, -0.27 | -10.37, 0.51 | 0.97
Outline | 14 | line | -10.95, -0.27 | -10.95, -0.26
Outline | 15 | arc clockwise | -10.95, -0.26 | -10.11, -0.07 | -10.33, -1.02 | 0.97
Outline | 16 | line | -10.11, -0.07 | -10.11, 0.36
Outline | 17 | arc clockwise | -10.11, 0.36 | -10.93, 0.59 | -10.29, 1.32 | 0.97
Outline | 18 | line | -10.93, 0.59 | -10.93, 0.59
Outline | 19 | arc clockwise | -10.93, 0.59 | -10.09, 0.73 | -10.38, -0.21 | 0.97
Outline | 20 | line | -10.09, 0.73 | -10.05, 1.15
Outline | 21 | arc clockwise | -10.05, 1.15 | -10.85, 1.44 | -10.16, 2.12 | 0.97
Outline | 22 | line | -10.85, 1.44 | -10.85, 1.45
Outline | 23 | arc clockwise | -10.85, 1.45 | -10.00, 1.52 | -10.36, 0.61 | 0.97

O u tlin e | 2 4 | lin e | -1 0.0 0, 1.5 2 | -9.9 3, 1.9 4
O u tlin e | 2 5 | a r c clo c k wis e | -9.9 3, 1.9 4 | -1 0.7 1, 2.2 9 | -9.9 6, 2.9 2 | 0.9 7
O u tlin e | 2 6 | lin e | -1 0.7 1, 2.2 9 | -1 0.7 1, 2.3 0
O u tlin e | 2 7 | a r c clo c k wis e | -1 0.7 1, 2.3 0 | -9.8 5, 2.3 0 | -1 0.2 8, 1.4 2 | 0.9 7
O u tlin e | 2 8 | lin e | -9.8 5, 2.3 0 | -9.7 4, 2.7 1
O u tlin e | 2 9 | a r c clo c k wis e | -9.7 4, 2.7 1 | -1 0.4 9, 3.1 2 | -9.7 0, 3.6 9 | 0.9 7
O u tlin e | 3 0 | lin e | -1 0.4 9, 3.1 2 | -1 0.4 9, 3.1 3
O u tlin e | 3 1 | a r c clo c k wis e | -1 0.4 9, 3.1 3 | -9.6 4, 3.0 6 | -1 0.1 4, 2.2 2 | 0.9 7
O u tlin e | 3 2 | lin e | -9.6 4, 3.0 6 | -9.5 0, 3.4 7
O u tlin e | 3 3 | a r c clo c k wis e | -9.5 0, 3.4 7 | -1 0.2 2, 3.9 4 | -9.3 8, 4.4 4 | 0.9 7
O u tlin e | 3 4 | lin e | -1 0.2 2, 3.9 4 | -1 0.2 1, 3.9 4
O u tlin e | 3 5 | a r c clo c k wis e | -1 0.2 1, 3.9 4 | -9.3 7, 3.8 1 | -9.9 3, 3.0 1 | 0.9 7
O u tlin e | 3 6 | lin e | -9.3 7, 3.8 1 | -9.2 0, 4.2 0
O u tlin e | 3 7 | a r c clo c k wis e | -9.2 0, 4.2 0 | -9.8 8, 4.7 2 | -9.0 0, 5.1 6 | 0.9 7
O u tlin e | 3 8 | lin e | -9.8 8, 4.7 2 | -9.8 7, 4.7 3
O u tlin e | 3 9 | a r c clo c k wis e | -9.8 7, 4.7 3 | -9.0 4, 4.5 3 | -9.6 7, 3.7 8 | 0.9 7
O u tlin e | 4 0 | lin e | -9.0 4, 4.5 3 | -8.8 4, 4.9 1
O u tlin e | 4 1 | a r c clo c k wis e | -8.8 4, 4.9 1 | -9.4 8, 5.4 9 | -8.5 7, 5.8 5 | 0.9 7
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
Cut-out 6 | 343 | line | -2.14, 2.38 | -5.27, 7.54
Cut-out 6 | 344 | arc anticlockwise | -5.27, 7.54 | -7.62, 5.15 | 0.00, 0.00 | 9.20

Levels

Faces in section A-A, from the bottom face: 1.00.

Teeth

Number | Module | Tip Ø | Root Ø
80 | 0.263325 | 21.90 | 20.23

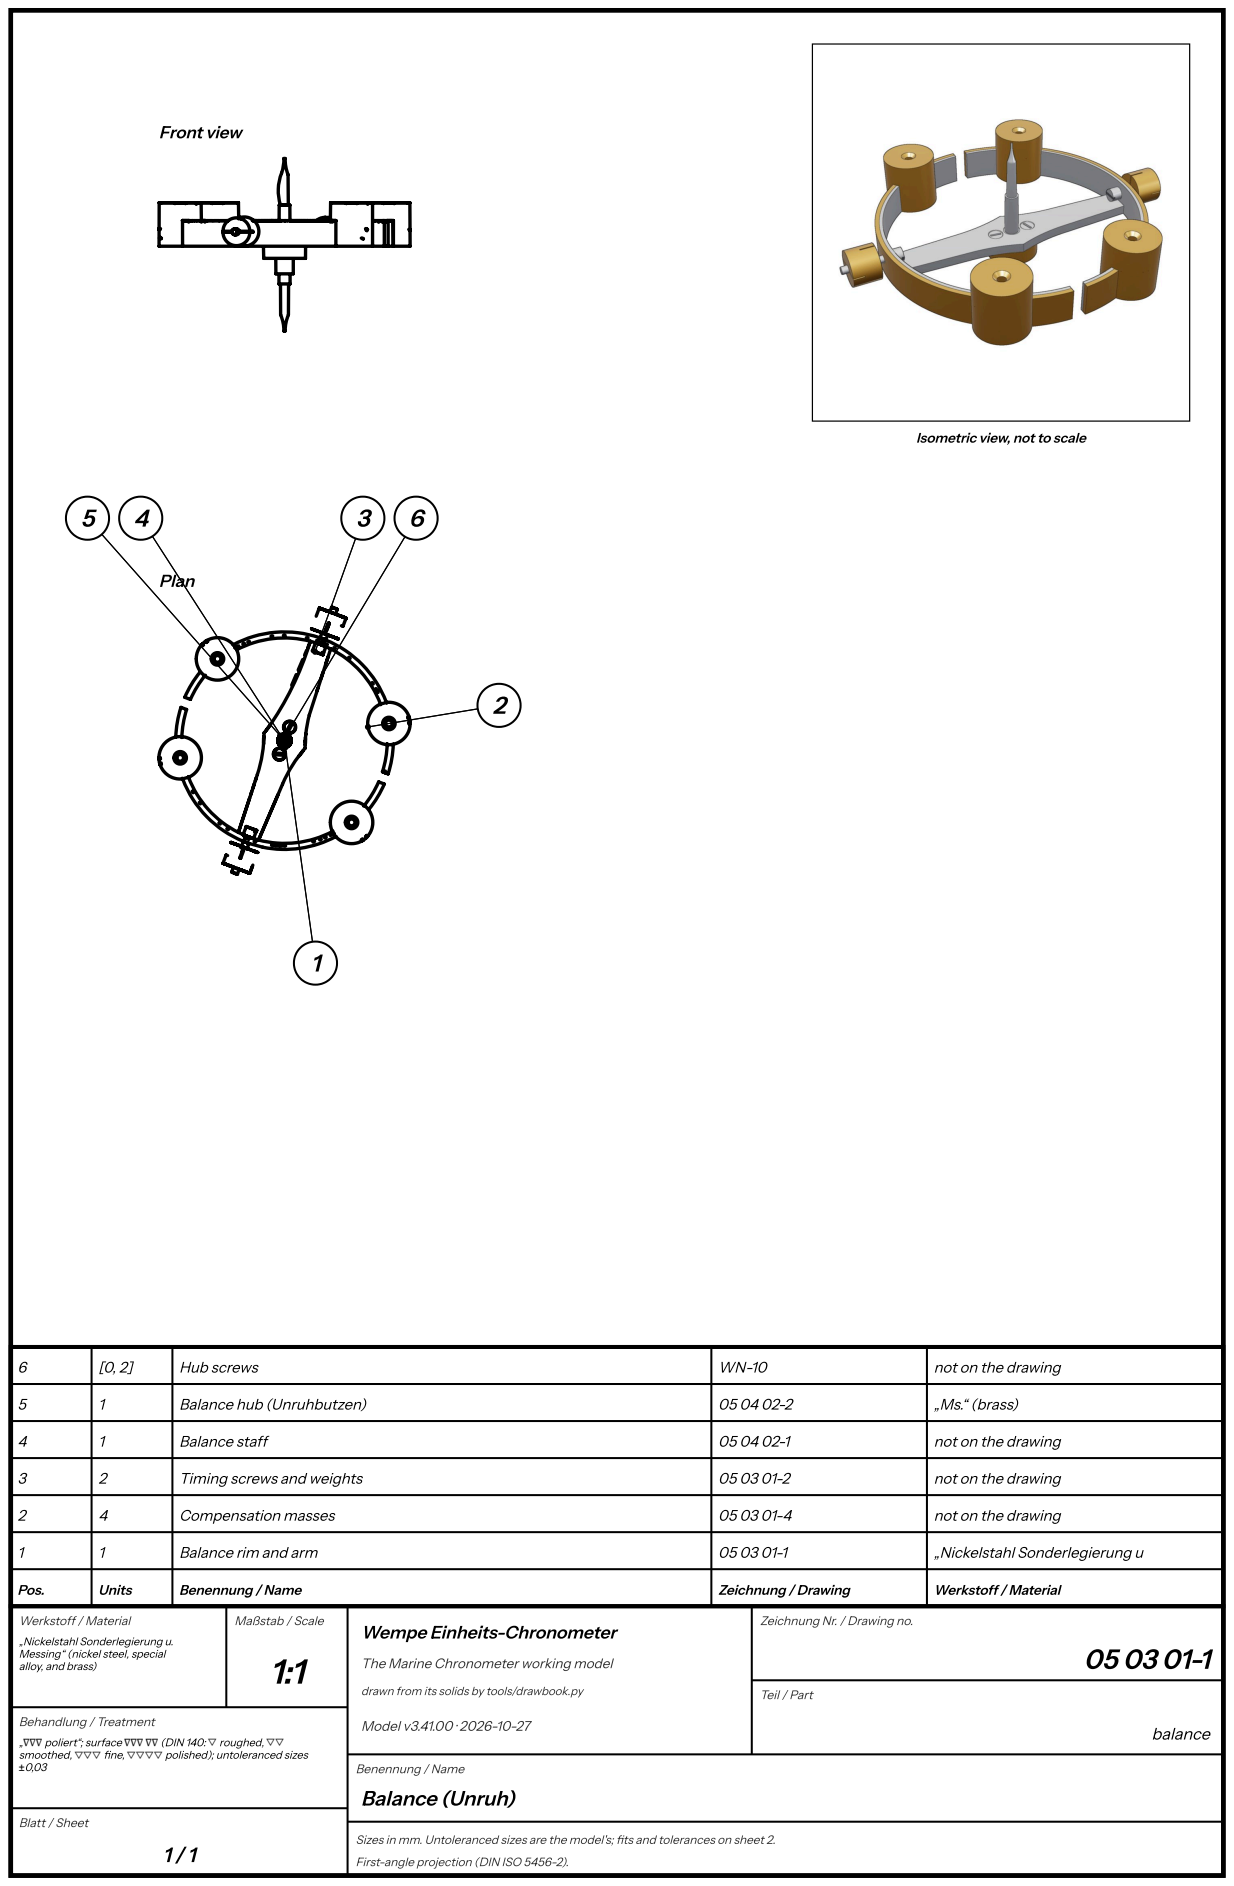
[picture p372: page 121]
Front view; Plan; Pos.; Units; Benennung / Name; Zeichnung / Drawing; Werkstoff / Material; Balance rim and arm; „Nickelstahl Sonderlegierung u; Compensation masses; not on the drawing; Timing screws and weights; Balance staff; Balance hub (Unruhbutzen); „Ms.“ (brass); Hub screws; Maßstab / Scale; Behandlung / Treatment; Model v3.41.00 · 2026-10-27; Teil / Part; balance; Balance (Unruh)

Isometric view, not to scale

Zeichnung Nr. / Drawing no.

„Nickelstahl Sonderlegierung u.
Messing“ (nickel steel, special
alloy, and brass)

Wempe Einheits-Chronometer

The Marine Chronometer working model

drawn from its solids by tools/drawbook.py

„∇∇∇ poliert“; surface ∇∇∇ ∇∇ (DIN 140: ▽ roughed, ▽▽
smoothed, ▽▽▽ fine, ▽▽▽▽ polished); untoleranced sizes

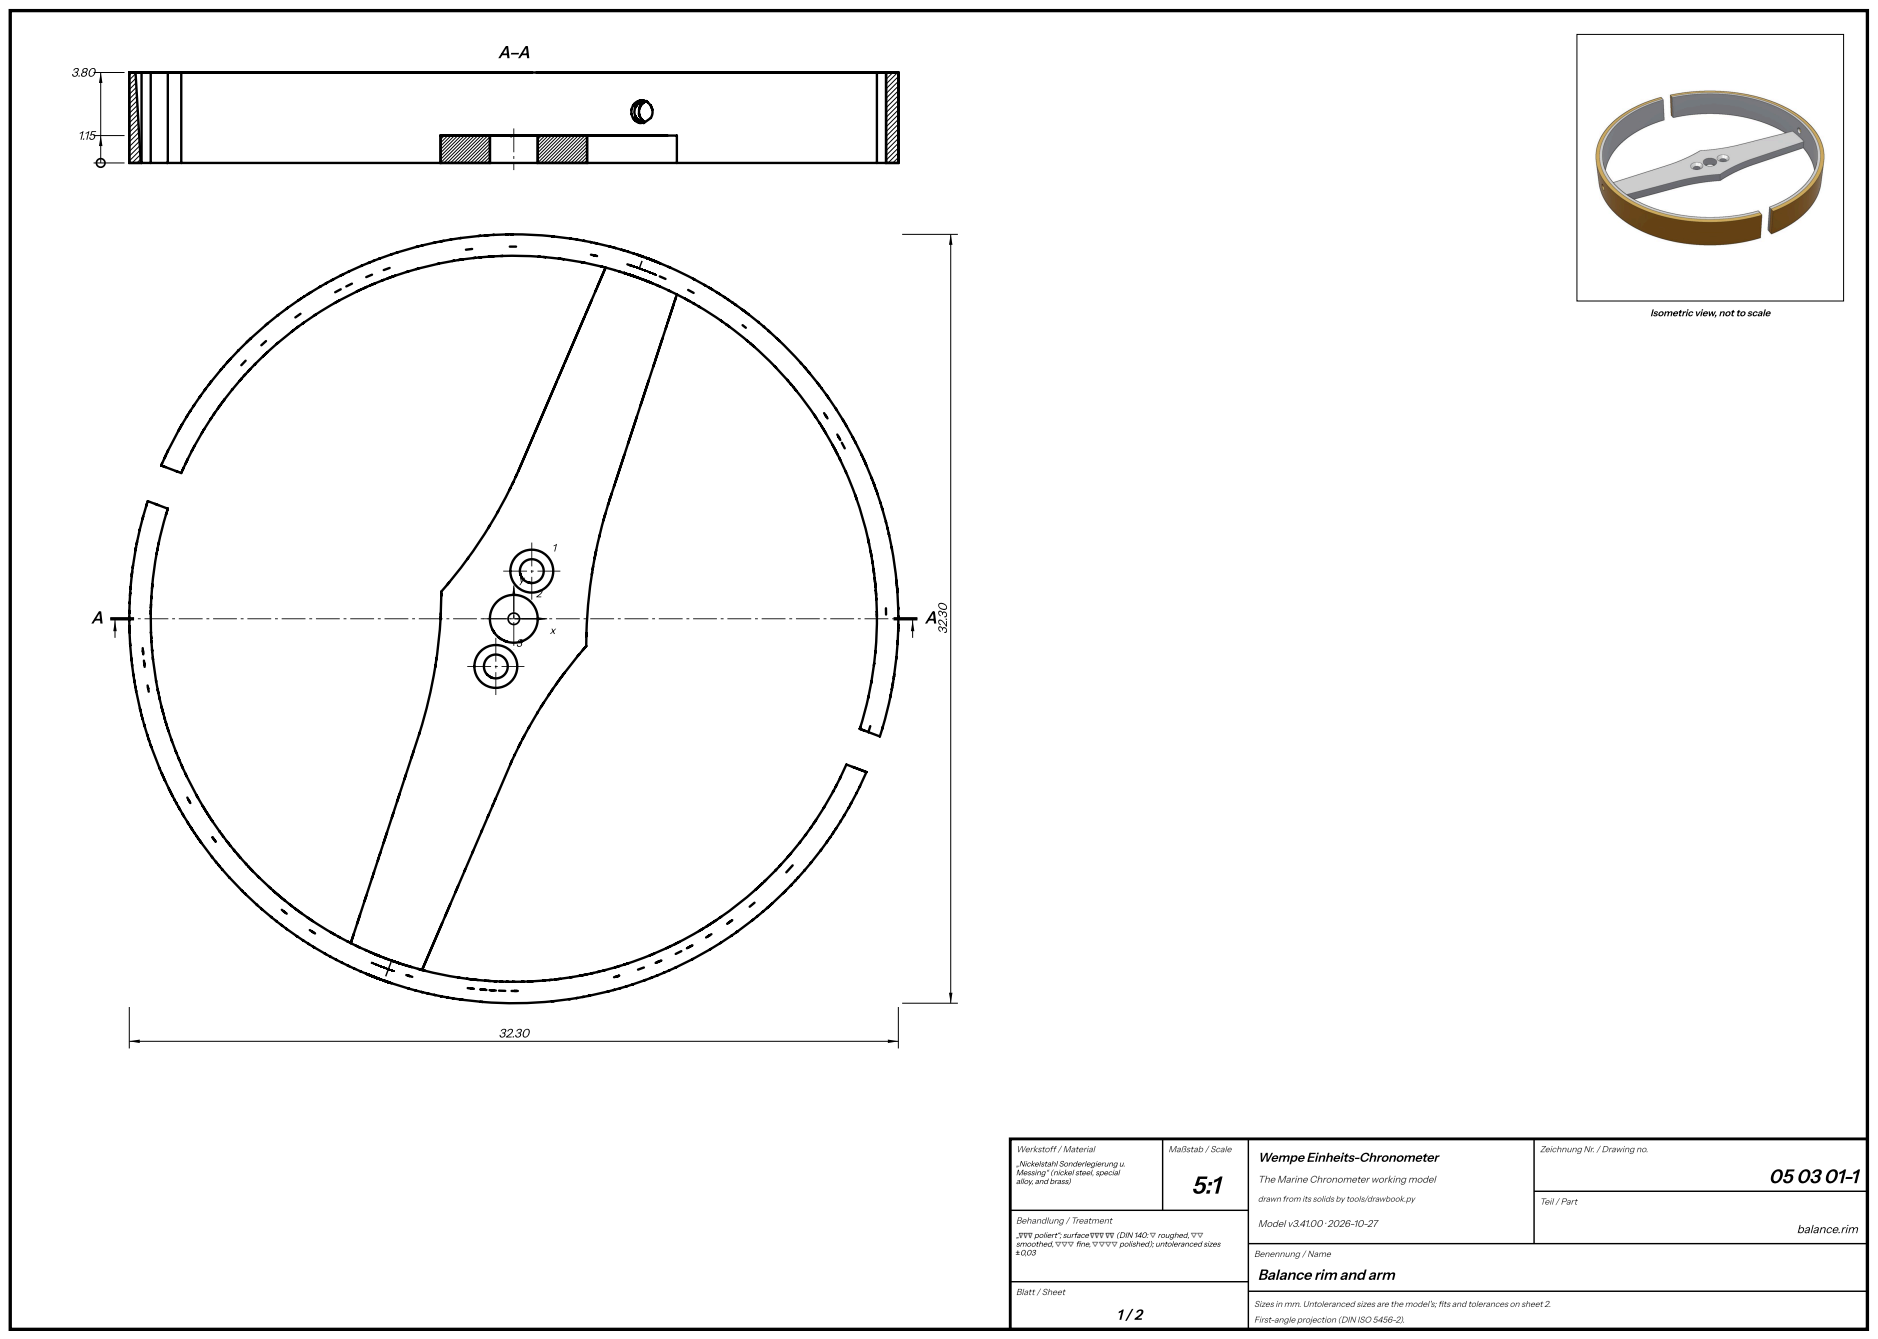
[picture p373: page 122]
Werkstoff / Material; Maßstab / Scale; Behandlung / Treatment; Model v3.41.00 · 2026-10-27; Teil / Part; balance.rim

Isometric view, not to scale

Zeichnung Nr. / Drawing no.

„Nickelstahl Sonderlegierung u.
Messing“ (nickel steel, special
alloy, and brass)

Wempe Einheits-Chronometer

The Marine Chronometer working model

drawn from its solids by tools/drawbook.py

„∇∇∇ poliert“; surface ∇∇∇ ∇∇ (DIN 140: ▽ roughed, ▽▽
smoothed, ▽▽▽ fine, ▽▽▽▽ polished); untoleranced sizes

Balance rim and arm

## Balance rim and arm — sheet 2

The balance: a cut bimetallic rim, nickel steel inside and brass outside, made in one with its straight steel arm (stamped

RGG in a triangle, as on Wempe No. 3955), so each quarter of the rim curls in as it warms and carries its mass nearer the

staff. Four round brass masses sit across the rim, two timing weights on screws at the arm’s ends. It sits on the brass hub of its staff just above the top plate, its rollers under the plate. It swings about 1¼ turns, twice a second.

Parts list

Drawing | Name | Units | Material | Finish, heat treatment | Fit, as measured on the model
05 03 01-1 | Unruhreifen (balance rim with arm, nickel steel and brass) | 1 | „Nickelstahl Sonderlegierung u. Messing“ (nickel steel, special alloy, and brass) | „∇∇∇ poliert“; surface ∇∇∇ ∇∇ (DIN 140: ▽ roughed, ▽▽ smoothed, ▽▽▽ fine, ▽▽▽▽ polished); untoleranced sizes ±0,03 | round 050402-1 (press): 1.114 mm, least gap 0.0093; on 050402-2: 0 mm

Test on the bench (05 03 01-1). The balance runs down free, the balance, hairspring and detent in, the train held still at a

lock; before the mainspring is chosen: The model's balance halves its swing in 60 s (its TF 111 s; a running 6MX on video,

moMvyx8eXfo, has TF 133-332 s at it: wempe_startup.js, which the model's TF is set from). Halving in 46, 56, 60, 66, 80, 93

s (TF 80, 100, 111, 125, 160, 200): 05 06_20's drive swings it 202, 221, 231, 242, 265, 288° at 12 h; the guard's 180° at the wind's

lowest wants ×0.832, 0.730, 0.680, 0.629, 0.536, 0.472 of it, the sources' 225° ×1.285, 1.087, 1.008, 0.928, 0.785, 0.685 (the

strip as the drive's cube root). Shorter than 46 s, look for a pivot, the endstone or the detent's springs dragging.

What it does (05 03 01-1). The cut bimetallic rim and its arm, on the hub of the staff.

Coordinates from the datum, hole 2's centre (marked on the plan), x to the right and y up the plan as drawn; depths from

the face seen in the plan (the top). Thickness 3.80.

Holes

Hole | x | y | Size
1 | 0.76 | 2.00 | Ø 1.00 through (0.77 thick at 0.00-0.77); countersunk to Ø 1.80
2 | 0.00 | 0.00 | Ø 2.01 through (1.15 thick at 0.00-1.15)
3 | -0.76 | -2.00 | Ø 1.00 through (0.77 thick at 0.00-0.77); countersunk to Ø 1.80

Contourin the plan

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

radius.

Contour | # | Element | From x, y | To x, y | Centre x, y | R
Outline | 1 | arc clockwise | -15.76, -3.55 | -15.37, 4.94 | 0.00, 0.00 | 16.15
Outline | 2 | line | -15.37, 4.94 | -14.53, 4.63
Outline | 3 | arc anticlockwise | -14.53, 4.63 | -6.85, -13.63 | 0.00, 0.00 | 15.25
Outline | 4 | arc anticlockwise | -6.85, -13.63 | -3.61, -3.55 | -124.07, 29.65 | 124.96
Outline | 5 | arc anticlockwise | -3.61, -3.55 | -3.04, 1.15 | -23.04, 1.19 | 20.00
Outline | 6 | arc anticlockwise | -3.04, 1.15 | 0.29, 6.44 | -18.09, 14.32 | 20.00
Outline | 7 | line | 0.29, 6.44 | 3.85, 14.75
Outline | 8 | arc anticlockwise | 3.85, 14.75 | -13.97, 6.12 | 0.00, 0.00 | 15.25
Outline | 9 | line | -13.97, 6.12 | -14.81, 6.44
Outline | 10 | arc clockwise | -14.81, 6.44 | 5.19, 15.29 | 0.00, 0.00 | 16.15
Outline | 11 | line | 5.19, 15.29 | 5.86, 15.05
Outline | 12 | line | 5.86, 15.05 | 6.46, 14.80
Outline | 13 | arc clockwise | 6.46, 14.80 | 15.37, -4.94 | 0.00, 0.00 | 16.15
Outline | 14 | line | 15.37, -4.94 | 14.53, -4.63
Outline | 15 | arc anticlockwise | 14.53, -4.63 | 6.85, 13.63 | 0.00, 0.00 | 15.25

Outline | 16 | arc anticlockwise | 6.85, 13.63 | 3.61, 3.55 | 124.07, -29.65 | 124.96
Outline | 17 | arc anticlockwise | 3.61, 3.55 | 3.04, -1.15 | 23.04, -1.19 | 20.00
Outline | 18 | arc anticlockwise | 3.04, -1.15 | -0.29, -6.44 | 18.09, -14.32 | 20.00
Outline | 19 | line | -0.29, -6.44 | -3.85, -14.75
Outline | 20 | arc anticlockwise | -3.85, -14.75 | 13.97, -6.12 | 0.00, 0.00 | 15.25
Outline | 21 | line | 13.97, -6.12 | 14.81, -6.44
Outline | 22 | arc clockwise | 14.81, -6.44 | -5.19, -15.29 | 0.00, 0.00 | 16.15
Outline | 23 | line | -5.19, -15.29 | -5.86, -15.05
Outline | 24 | line | -5.86, -15.05 | -6.46, -14.80
Outline | 25 | arc clockwise | -6.46, -14.80 | -15.76, -3.55 | 0.00, 0.00 | 16.15
Cut-out 1 | 26 | line | 14.89, -4.76 | 14.93, -4.64
Cut-out 1 | 27 | line | 14.93, -4.64 | 14.89, -4.76
Cut-out 2 | 28 | line | -5.19, -15.29 | -5.19, -15.29
Cut-out 2 | 29 | line | -5.19, -15.29 | -5.19, -15.29
Cut-out 3 | 30 | line | 15.63, 0.44 | 15.63, 0.31
Cut-out 3 | 31 | line | 15.63, 0.31 | 15.63, 0.44
Cut-out 4 | 32 | line | 13.78, 7.39 | 13.84, 7.28
Cut-out 4 | 33 | line | 13.84, 7.28 | 13.78, 7.39
Cut-out 5 | 34 | line | 13.65, 7.63 | 13.58, 7.74
Cut-out 5 | 35 | line | 13.58, 7.74 | 13.65, 7.63
Cut-out 6 | 36 | line | 13.10, 8.53 | 13.18, 8.42
Cut-out 6 | 37 | line | 13.18, 8.42 | 13.10, 8.53
Cut-out 7 | 38 | line | 9.54, 12.39 | 9.64, 12.31
Cut-out 7 | 39 | line | 9.64, 12.31 | 9.54, 12.39
Cut-out 8 | 40 | line | 9.07, -12.74 | 8.96, -12.81
Cut-out 8 | 41 | line | 8.96, -12.81 | 9.07, -12.74
Cut-out 9 | 42 | line | 8.19, -13.32 | 8.07, -13.39
Cut-out 9 | 43 | line | 8.07, -13.39 | 8.19, -13.32
Cut-out 10 | 44 | line | 7.44, 13.75 | 7.55, 13.69
Cut-out 10 | 45 | line | 7.55, 13.69 | 7.44, 13.75
Cut-out 11 | 46 | line | 7.27, -13.84 | 7.39, -13.78
Cut-out 11 | 47 | line | 7.39, -13.78 | 7.27, -13.84
Cut-out 12 | 48 | line | 7.04, -13.96 | 6.92, -14.02
Cut-out 12 | 49 | line | 6.92, -14.02 | 7.04, -13.96
Cut-out 13 | 50 | line | 6.25, 14.33 | 6.37, 14.28
Cut-out 13 | 51 | line | 6.37, 14.28 | 6.25, 14.33
Cut-out 14 | 52 | line | 6.20, -14.35 | 6.08, -14.41
Cut-out 14 | 53 | line | 6.08, -14.41 | 6.20, -14.35
Cut-out 15 | 54 | line | 5.02, 14.81 | 4.89, 14.85
Cut-out 15 | 55 | line | 4.89, 14.85 | 5.02, 14.81
Cut-out 16 | 56 | line | 4.46, -14.98 | 4.34, -15.02
Cut-out 16 | 57 | line | 4.34, -15.02 | 4.46, -14.98
Cut-out 17 | 58 | line | 3.24, 15.30 | 3.37, 15.27
Cut-out 17 | 59 | line | 3.37, 15.27 | 3.24, 15.30
Cut-out 20 | 60 | line | 0.17, -15.63 | 0.04, -15.63
Cut-out 20 | 61 | line | 0.04, -15.63 | 0.17, -15.63
Cut-out 21 | 62 | line | 0.09, 15.63 | -0.04, 15.63
Cut-out 21 | 63 | line | -0.04, 15.63 | 0.09, 15.63

Cut-out 23 | 64 | line | -0.62, -15.62 | -0.49, -15.63
Cut-out 23 | 65 | line | -0.49, -15.63 | -0.62, -15.62
Cut-out 24 | 66 | line | -0.89, -15.61 | -0.75, -15.62
Cut-out 24 | 67 | line | -0.75, -15.62 | -0.89, -15.61
Cut-out 25 | 68 | line | -1.28, -15.58 | -1.15, -15.59
Cut-out 25 | 69 | line | -1.15, -15.59 | -1.28, -15.58
Cut-out 26 | 70 | line | -1.68, -15.54 | -1.81, -15.53
Cut-out 26 | 71 | line | -1.81, -15.53 | -1.68, -15.54
Cut-out 27 | 72 | line | -1.88, 15.52 | -2.01, 15.51
Cut-out 27 | 73 | line | -2.01, 15.51 | -1.88, 15.52
Cut-out 28 | 74 | line | -4.26, -15.04 | -4.39, -15.01
Cut-out 28 | 75 | line | -4.39, -15.01 | -4.26, -15.04
Cut-out 29 | 76 | line | -5.46, 14.65 | -5.34, 14.69
Cut-out 29 | 77 | line | -5.34, 14.69 | -5.46, 14.65
Cut-out 30 | 78 | line | -5.95, 14.46 | -6.08, 14.41
Cut-out 30 | 79 | line | -6.08, 14.41 | -5.95, 14.46
Cut-out 31 | 80 | line | -6.92, 14.02 | -6.80, 14.08
Cut-out 31 | 81 | line | -6.80, 14.08 | -6.92, 14.02
Cut-out 32 | 82 | line | -7.39, 13.78 | -7.50, 13.72
Cut-out 32 | 83 | line | -7.50, 13.72 | -7.39, 13.78
Cut-out 33 | 84 | line | -8.35, -13.22 | -8.46, -13.15
Cut-out 33 | 85 | line | -8.46, -13.15 | -8.35, -13.22
Cut-out 34 | 86 | line | -9.07, 12.74 | -9.17, 12.66
Cut-out 34 | 87 | line | -9.17, 12.66 | -9.07, 12.74
Cut-out 35 | 88 | line | -9.54, -12.39 | -9.64, -12.31
Cut-out 35 | 89 | line | -9.64, -12.31 | -9.54, -12.39
Cut-out 36 | 90 | line | -11.26, 10.84 | -11.35, 10.75
Cut-out 36 | 91 | line | -11.35, 10.75 | -11.26, 10.84
Cut-out 37 | 92 | line | -12.66, -9.18 | -12.58, -9.29
Cut-out 37 | 93 | line | -12.58, -9.29 | -12.66, -9.18
Cut-out 38 | 94 | line | -13.65, -7.63 | -13.58, -7.74
Cut-out 38 | 95 | line | -13.58, -7.74 | -13.65, -7.63
Cut-out 39 | 96 | line | -15.36, -2.93 | -15.33, -3.06
Cut-out 39 | 97 | line | -15.33, -3.06 | -15.36, -2.93
Cut-out 40 | 98 | line | -15.52, -1.89 | -15.50, -2.02
Cut-out 40 | 99 | line | -15.50, -2.02 | -15.52, -1.89
Cut-out 41 | 100 | line | -15.59, -1.23 | -15.58, -1.36
Cut-out 41 | 101 | line | -15.58, -1.36 | -15.59, -1.23

Levels

Faces in section A-A, from the bottom face: 1.15, 3.80.

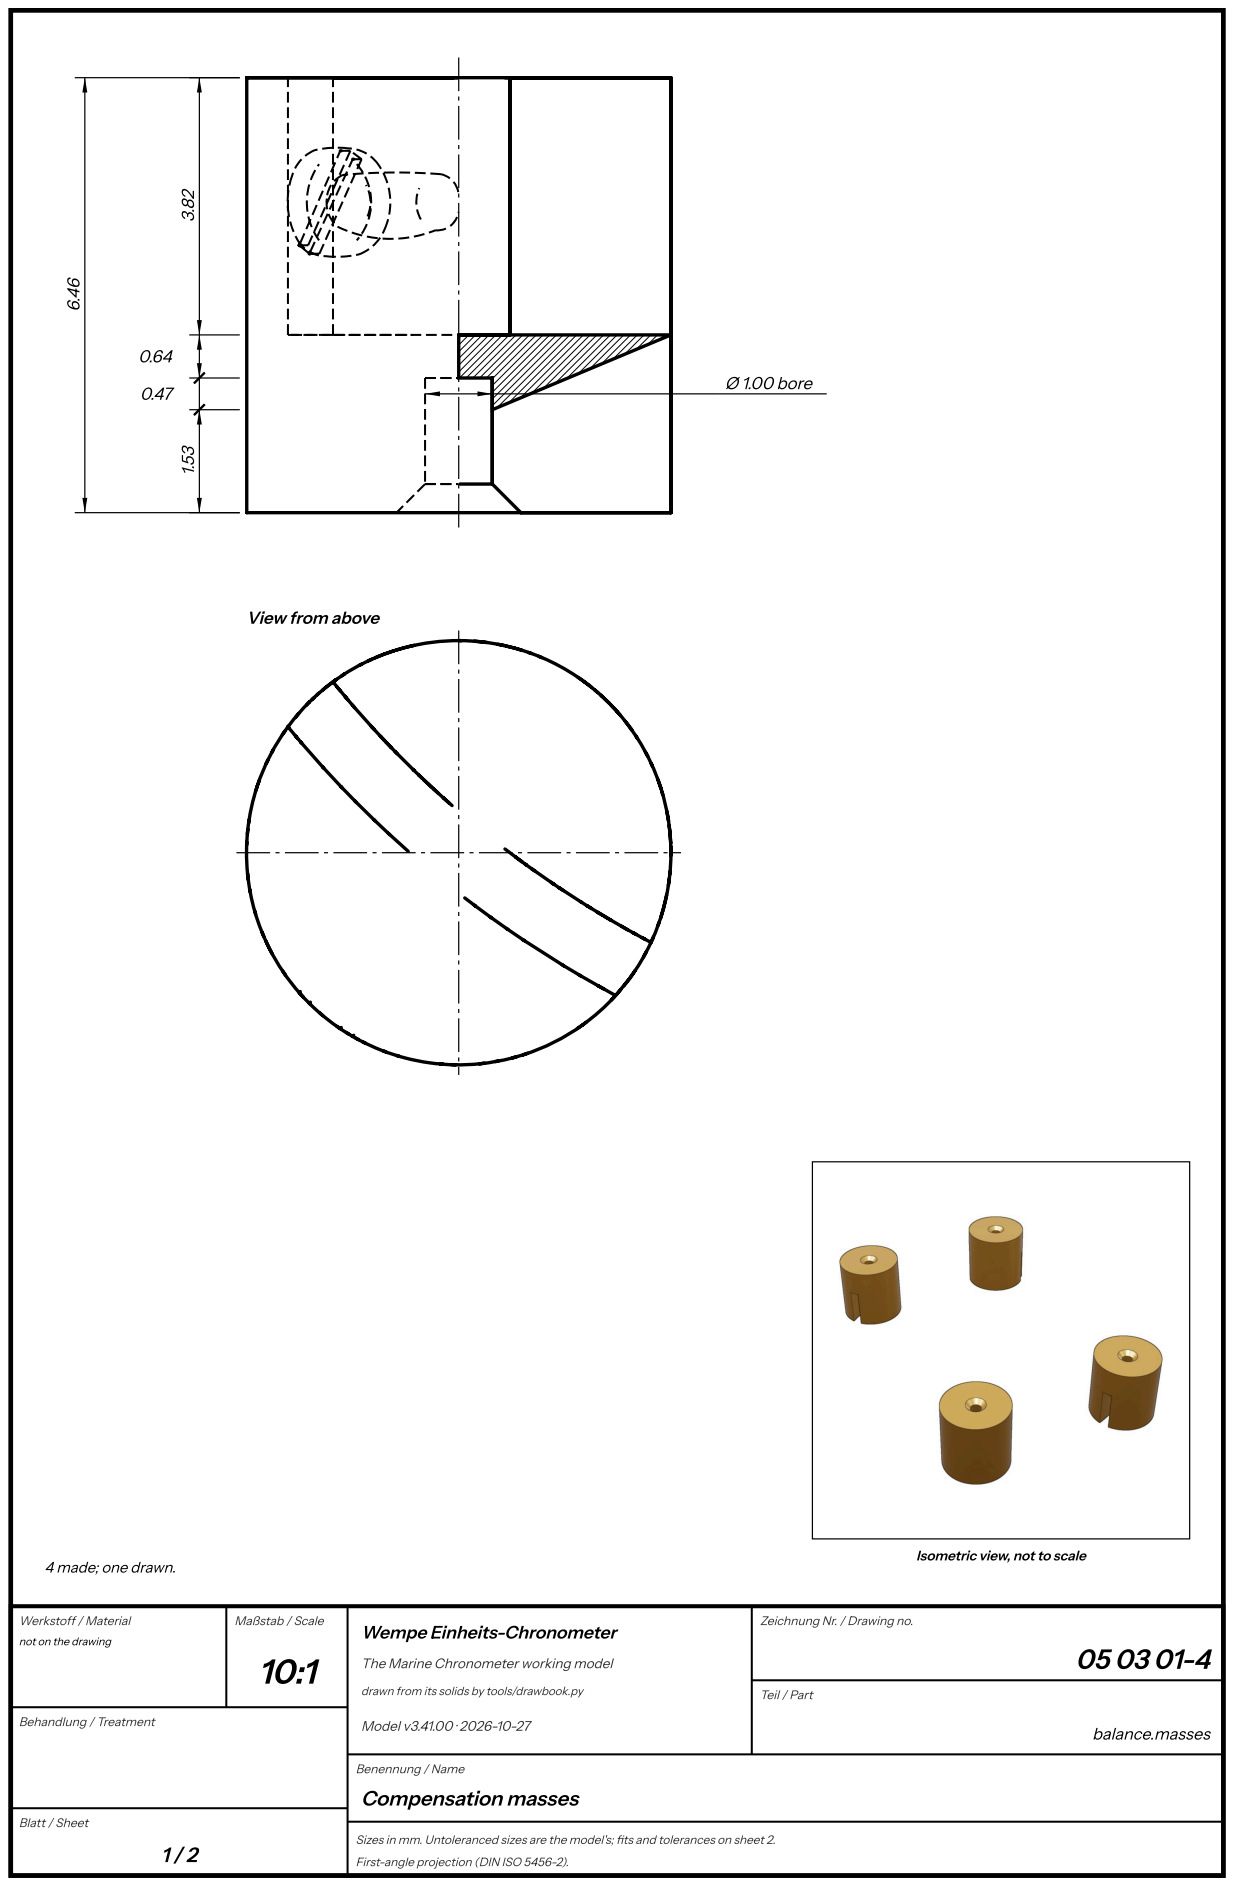
[picture p374: page 126]
Ø 1.00 bore; Werkstoff / Material; Maßstab / Scale; Behandlung / Treatment; Model v3.41.00 · 2026-10-27; Teil / Part; balance.masses; Compensation masses

View from above

4 made; one drawn.

Isometric view, not to scale

Zeichnung Nr. / Drawing no.

not on the drawing

Wempe Einheits-Chronometer

The Marine Chronometer working model

drawn from its solids by tools/drawbook.py

## Compensation masses — sheet 2

Four round brass masses across the rim, each held by a screw (WN-12) through its outer jaw onto the rim; in each top a

countersunk M1.2 hole for WN-12a, as the drawings have it, left empty (photographed Einheits chronometers show plain

tops).

4 made, all alike; the drawing shows one, in its own frame (the holes' and contour's coordinates are that one's).

Parts list

Drawing | Name | Units | Material | Finish, heat treatment | Fit, as measured on the model
05 03 01-4 | Masse (compensation mass) | 4 | not on the drawing | | on 050301-1: 0.0199 mm
WN-12 | Schraube (WN-12), the mass screw | 4 | not on the drawing | | in 050301-4 (embed): 2.695 mm, least gap -0.7973

What it does (05 03 01-4). Round brass masses across the rim, which the rim carries in as it warms.

What it does (WN-12). Holds a mass on the rim: radially through its outer jaw, its tip on the rim's outer face (the 6MX's

book, Fig. 5.62).

Turned about its axis; length 6.46, largest Ø 6.30. Diameters: ; bores Ø 1.00. Shoulders from the lower end: 0.00, 1.53, 2.00,

2.64, 6.46.

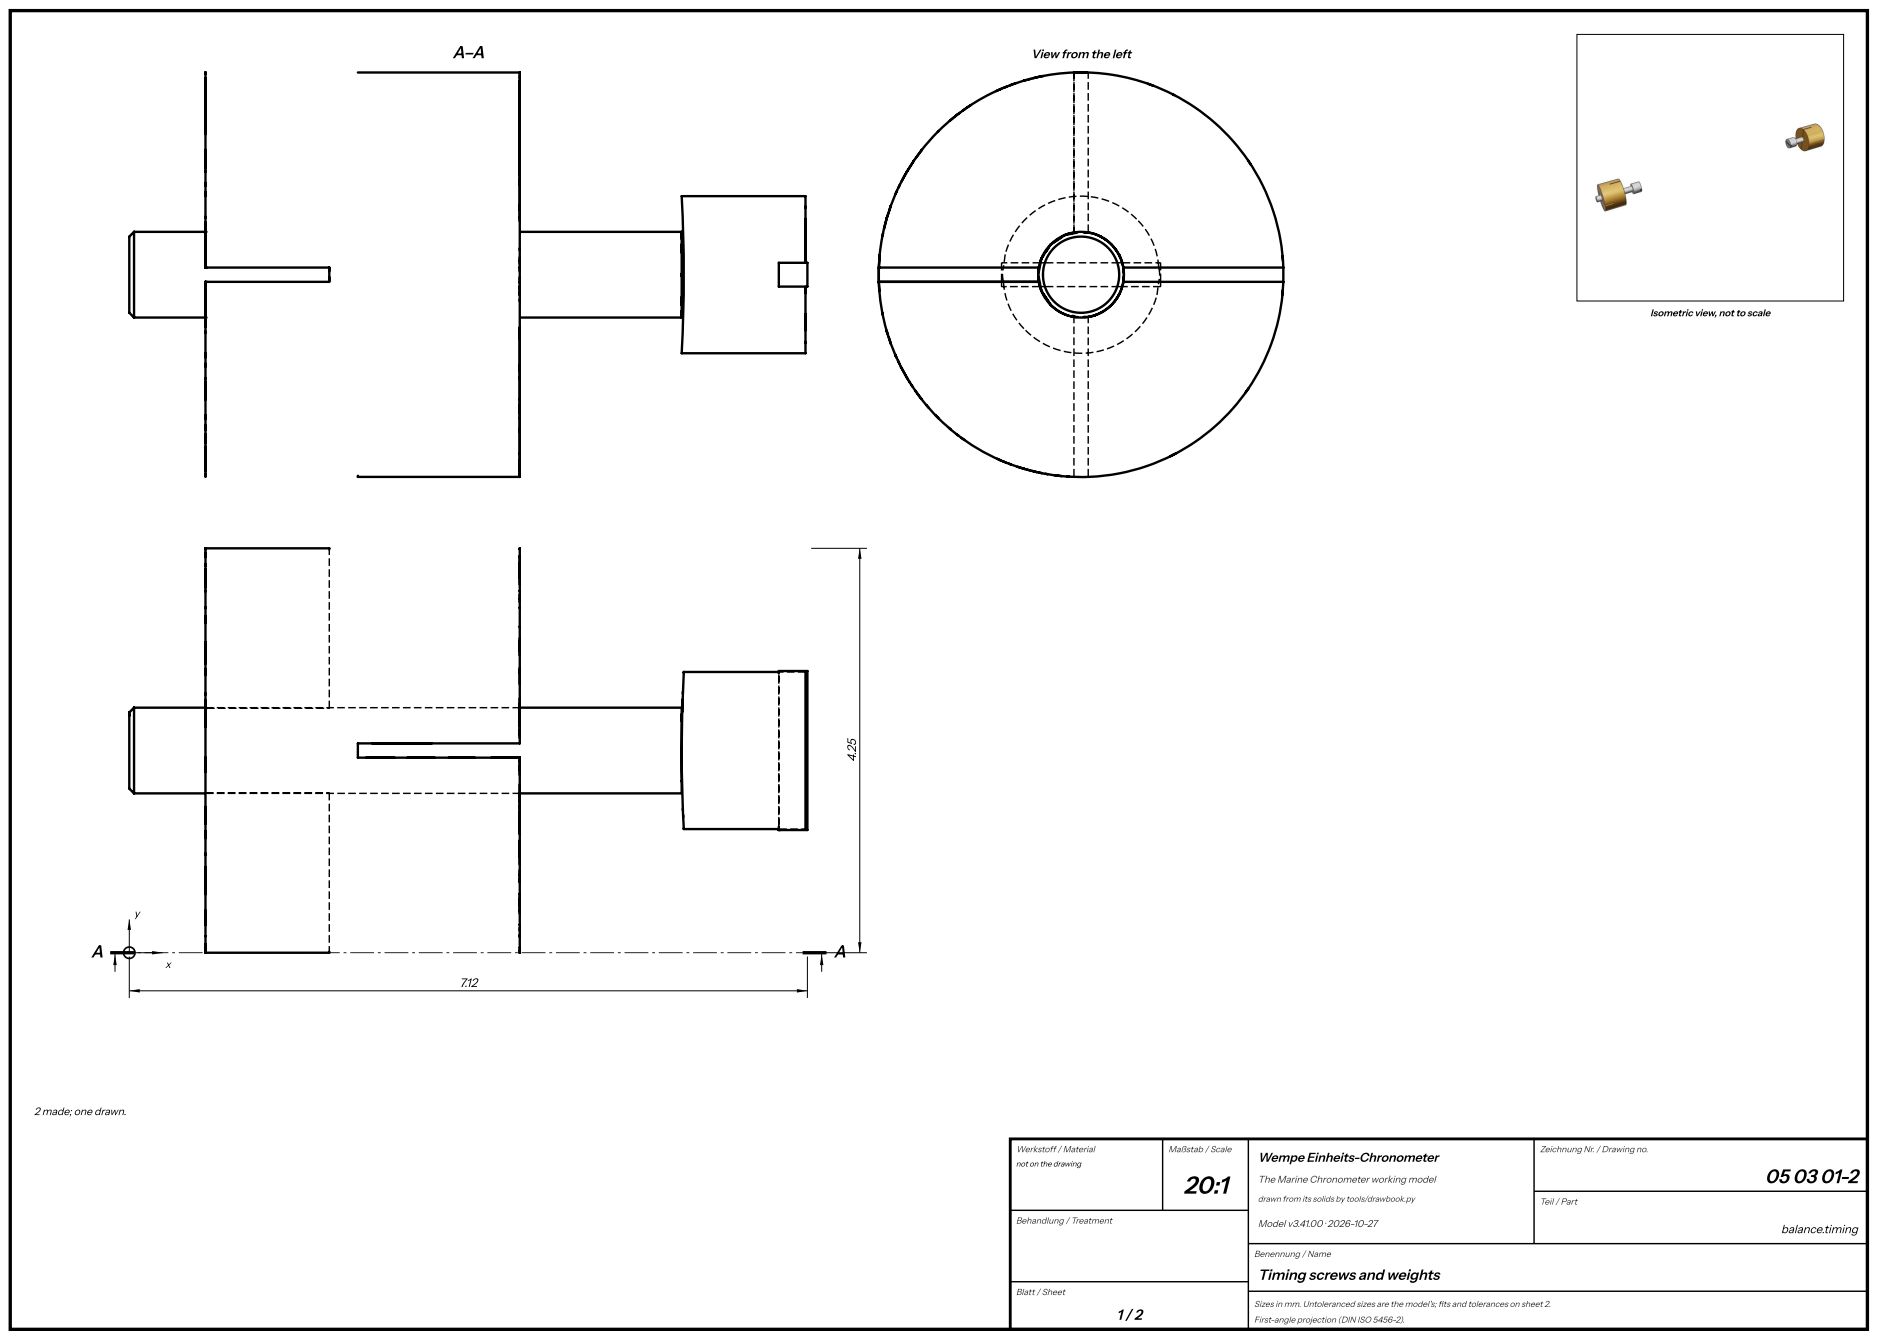
[picture p375: page 128]
Werkstoff / Material; Maßstab / Scale; Behandlung / Treatment; Model v3.41.00 · 2026-10-27; Teil / Part; balance.timing

View from the left

Isometric view, not to scale

2 made; one drawn.

Zeichnung Nr. / Drawing no.

not on the drawing

Wempe Einheits-Chronometer

The Marine Chronometer working model

drawn from its solids by tools/drawbook.py

Timing screws and weights

## Timing screws and weights — sheet 2

A timing screw across the rim at each end of the arm, in a tapped hole Ø 0.9 × 0.16, carrying a brass weight: turned in or

out, they set the rate.

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

Parts list

Drawing | Name | Units | Material | Finish, heat treatment | Fit, as measured on the model
05 03 01-2 | Zeitschraube (timing screw) | 2 | not on the drawing | | in 050301-1 (tap): 1.394 mm, least gap 0.02
05 03 01-3 | Zeitmasse (timing weight) | 2 | not on the drawing | | round 050301-2 (tap): 3.337 mm, least gap 0.0063

What it does (05 03 01-2). Across the rim at the arm's end in its tapped hole Ø 0.9 × 0.16, carrying the timing weight.

What it does (05 03 01-3). On the timing screw: turned in or out, sets the rate.

Coordinates from the datum, the corner of its bounding box (marked on the plan), x to the right and y up the plan as

drawn; depths from the face seen in the plan (the top). Thickness 4.25.

Contourin the plan

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

radius.

Contour | # | Element | From x, y | To x, y | Centre x, y | R
Outline | 1 | line | 0.80, 0.30 | 0.80, 1.67
Outline | 2 | line | 0.80, 1.67 | 0.05, 1.67
Outline | 3 | line | 0.05, 1.67 | 0.00, 1.72
Outline | 4 | line | 0.00, 1.72 | 0.00, 2.52
Outline | 5 | line | 0.00, 2.52 | 0.05, 2.57
Outline | 6 | line | 0.05, 2.57 | 0.80, 2.57
Outline | 7 | line | 0.80, 2.57 | 0.80, 4.25
Outline | 8 | line | 0.80, 4.25 | 4.10, 4.25
Outline | 9 | line | 4.10, 4.25 | 4.10, 2.57
Outline | 10 | line | 4.10, 2.57 | 5.80, 2.57
Outline | 11 | line | 5.80, 2.57 | 5.80, 1.67
Outline | 12 | line | 5.80, 1.67 | 4.10, 1.67
Outline | 13 | line | 4.10, 1.67 | 4.10, 0.00
Outline | 14 | line | 4.10, 0.00 | 0.80, 0.00
Outline | 15 | line | 0.80, 0.00 | 0.80, 0.30
Outline | 16 | arc clockwise | 5.80, 2.12 | 5.82, 2.95 | 21.05, 2.12 | 15.25
Outline | 17 | line | 5.82, 2.95 | 6.82, 2.95
Outline | 18 | line | 6.82, 2.95 | 6.82, 2.96
Outline | 19 | line | 6.82, 2.96 | 7.12, 2.96
Outline | 20 | line | 7.12, 2.96 | 7.12, 1.29
Outline | 21 | line | 7.12, 1.29 | 6.82, 1.29
Outline | 22 | line | 6.82, 1.29 | 6.82, 1.30
Outline | 23 | line | 6.82, 1.30 | 5.82, 1.30

Outline | 24 | arc clockwise | 5.82, 1.30 | 5.80, 2.12 | 21.05, 2.12 | 15.25

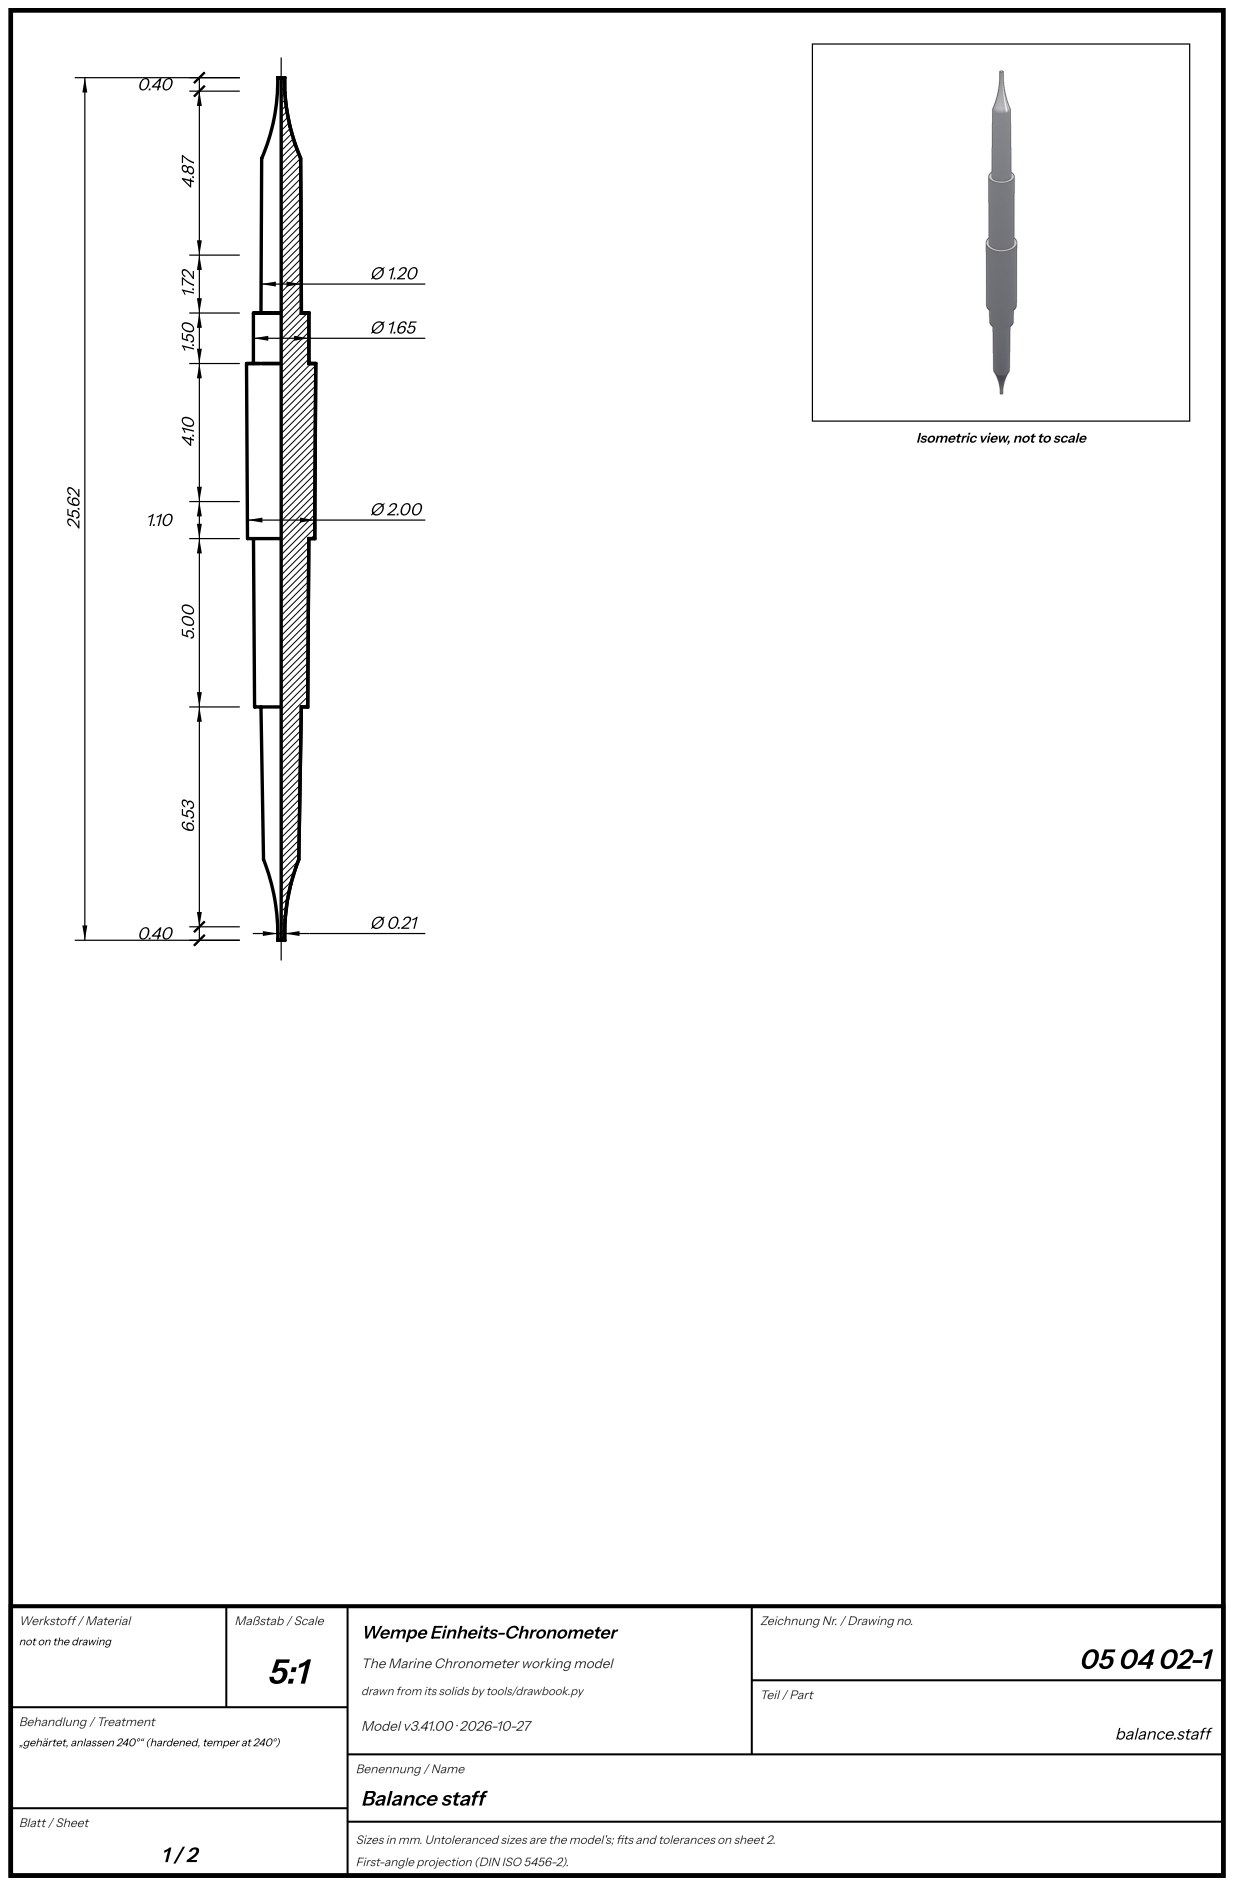
[picture p376: page 131]
Werkstoff / Material; Maßstab / Scale; Behandlung / Treatment; Model v3.41.00 · 2026-10-27; Teil / Part; balance.staff; Balance staff

Isometric view, not to scale

Zeichnung Nr. / Drawing no.

not on the drawing

Wempe Einheits-Chronometer

The Marine Chronometer working model

drawn from its solids by tools/drawbook.py

„gehärtet, anlassen 240°“ (hardened, temper at 240°)

## Balance staff — sheet 2

The hardened steel staff: its pivots run in the jewels in the two cocks; it carries the collet, the arm on the hub, and the

rollers.

Parts list

Drawing | Name | Units | Material | Finish, heat treatment | Fit, as measured on the model
05 04 02-1 | Unruhwelle (balance staff) | 1 | not on the drawing | „gehärtet, anlassen 240°“ (hardened, temper at 240°) | in 050407-1.bu (run): 0.318 mm, least gap 0.0166; in 050407-1.bl (run): 0.318 mm, least gap 0.0166; endshake 0.040 mm (050408-1.bl / 050408-1.bu)

What it does (05 04 02-1). The balance staff, its pivots in the jewels of the two cocks. As last revised 05 04 02 (29.5.46); as

first drawn (the page's Variants) 05 04_5's staff of 4.4.41, which carries this number in pencil.

Turned about its axis; length 25.62, largest Ø 2.06. Diameters: Ø 0.21, Ø 1.20, Ø 1.65, Ø 2.00. Shoulders from the lower end:

0.00, 0.40, 6.93, 11.93, 13.03, 17.13, 18.63, 20.35, 25.22, 25.62.

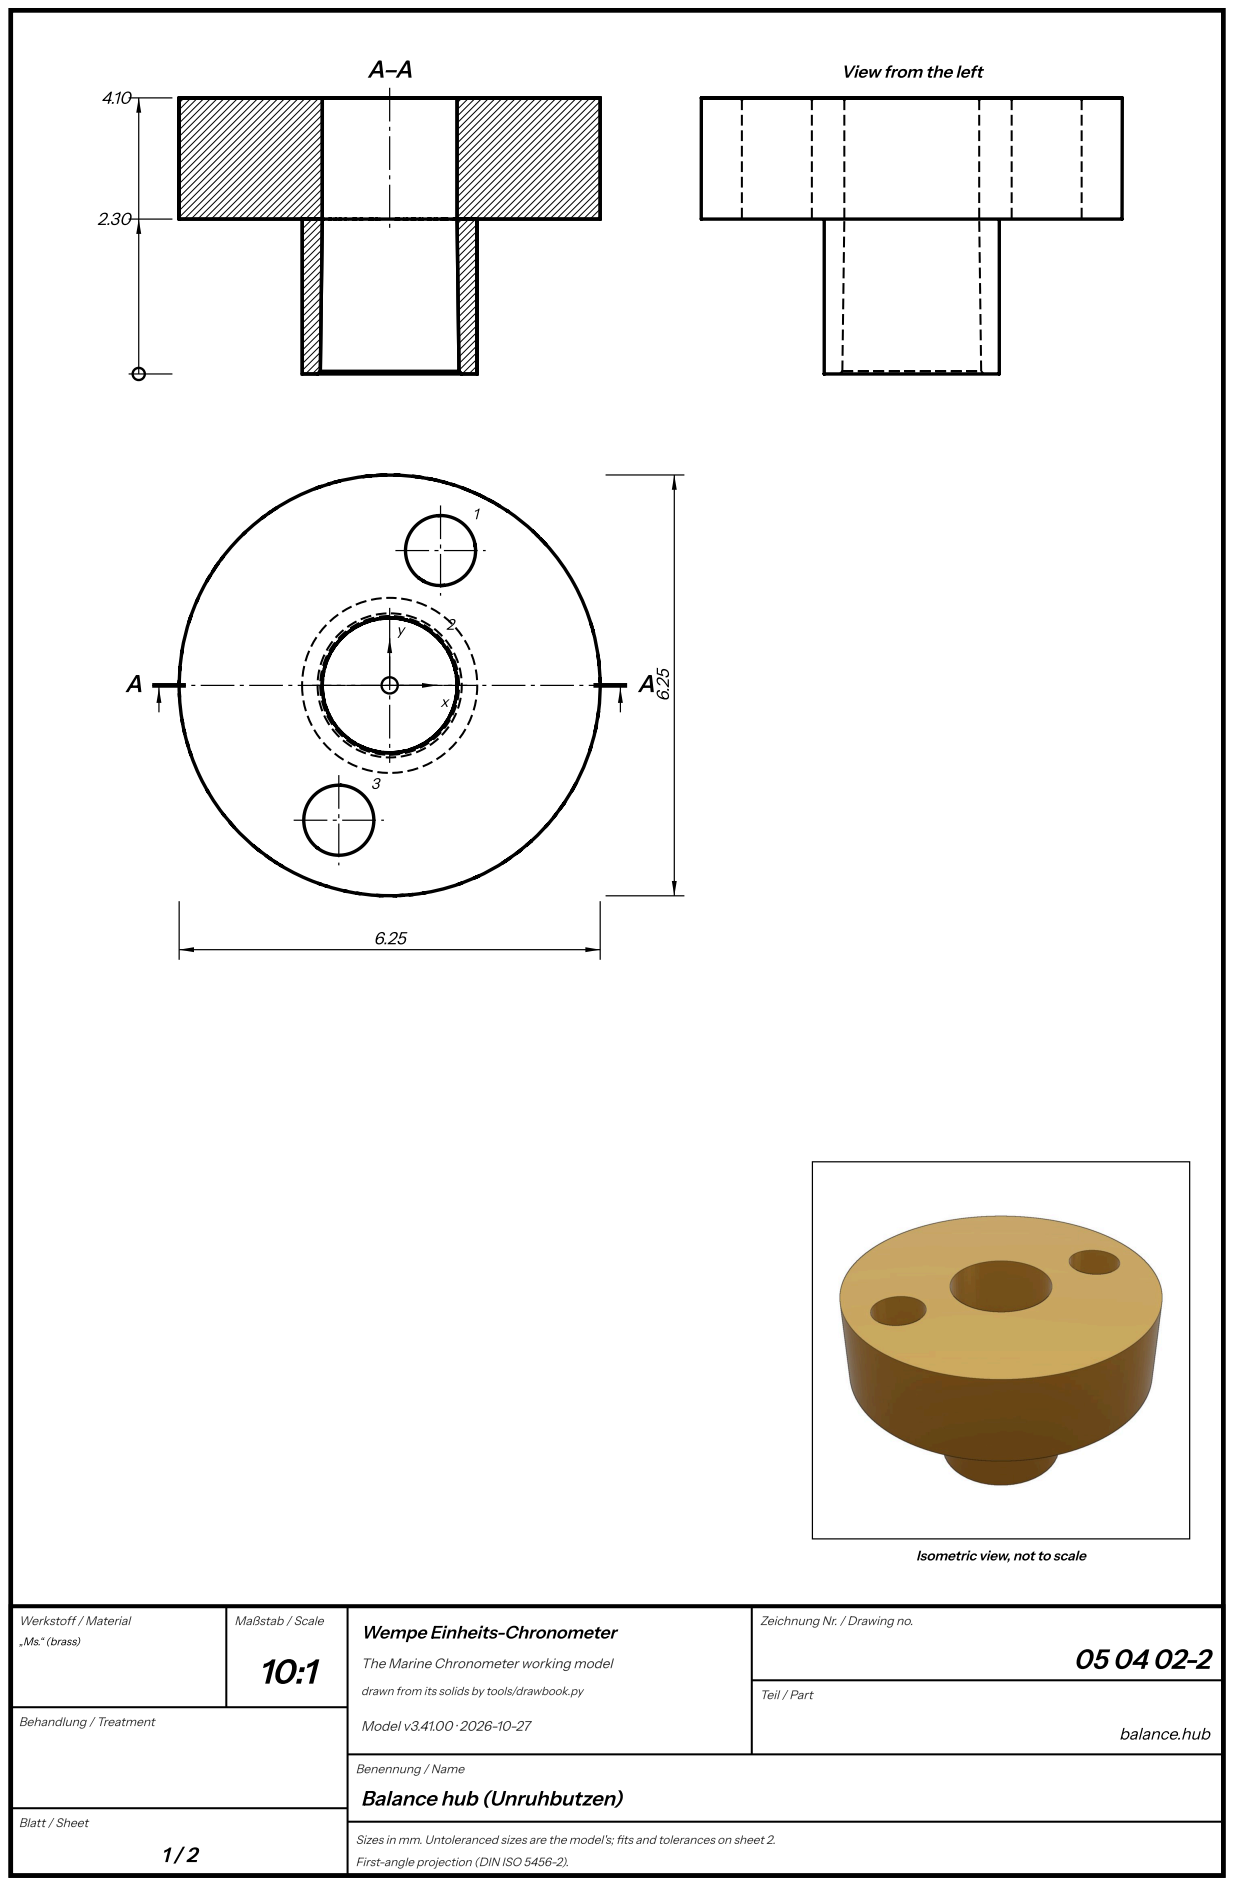
[picture p377: page 133]
Werkstoff / Material; „Ms.“ (brass); Maßstab / Scale; Behandlung / Treatment; Model v3.41.00 · 2026-10-27; Teil / Part; balance.hub

View from the left

Isometric view, not to scale

Zeichnung Nr. / Drawing no.

Wempe Einheits-Chronometer

The Marine Chronometer working model

drawn from its solids by tools/drawbook.py

Balance hub (Unruhbutzen)

## Balance hub (Unruhbutzen) — sheet 2

The brass hub pressed on the staff, its flange carrying the arm.

Parts list

Drawing | Name | Units | Material | Finish, heat treatment | Fit, as measured on the model
05 04 02-2 | Unruhbutzen (balance hub, brass) | 1 | „Ms.“ (brass) | | round 050402-1 (press): 4.137 mm, least gap -0.0077

What it does (05 04 02-2). Pressed on the staff, its flange carries the arm. As first drawn (the page's Variants) 05 04_5's

brass collar (040401-2), the arm riveted on its neck, with no screws.

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

the face seen in the plan (the top). Thickness 4.10.

Holes

Hole | x | y | Size
1 | 0.76 | 2.00 | Ø 1.04 through (1.80 thick at 2.30-4.10)
2 | 0.00 | 0.00 | Ø 2.00 through (1.80 thick at 2.30-4.10)
3 | -0.76 | -2.00 | Ø 1.04 through (1.80 thick at 2.30-4.10)

Contourin the plan

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

radius.

Contour | # | Element | From x, y | To x, y | Centre x, y | R
Outline | 1 | circle | | | 0.00, 0.00 | 3.13
Cut-out 1 | 2 | line | 0.19, 1.28 | 0.57, 1.52
Cut-out 1 | 3 | line | 0.57, 1.52 | 0.19, 1.28

Levels

Faces in section A-A, from the bottom face: 2.30, 4.10.

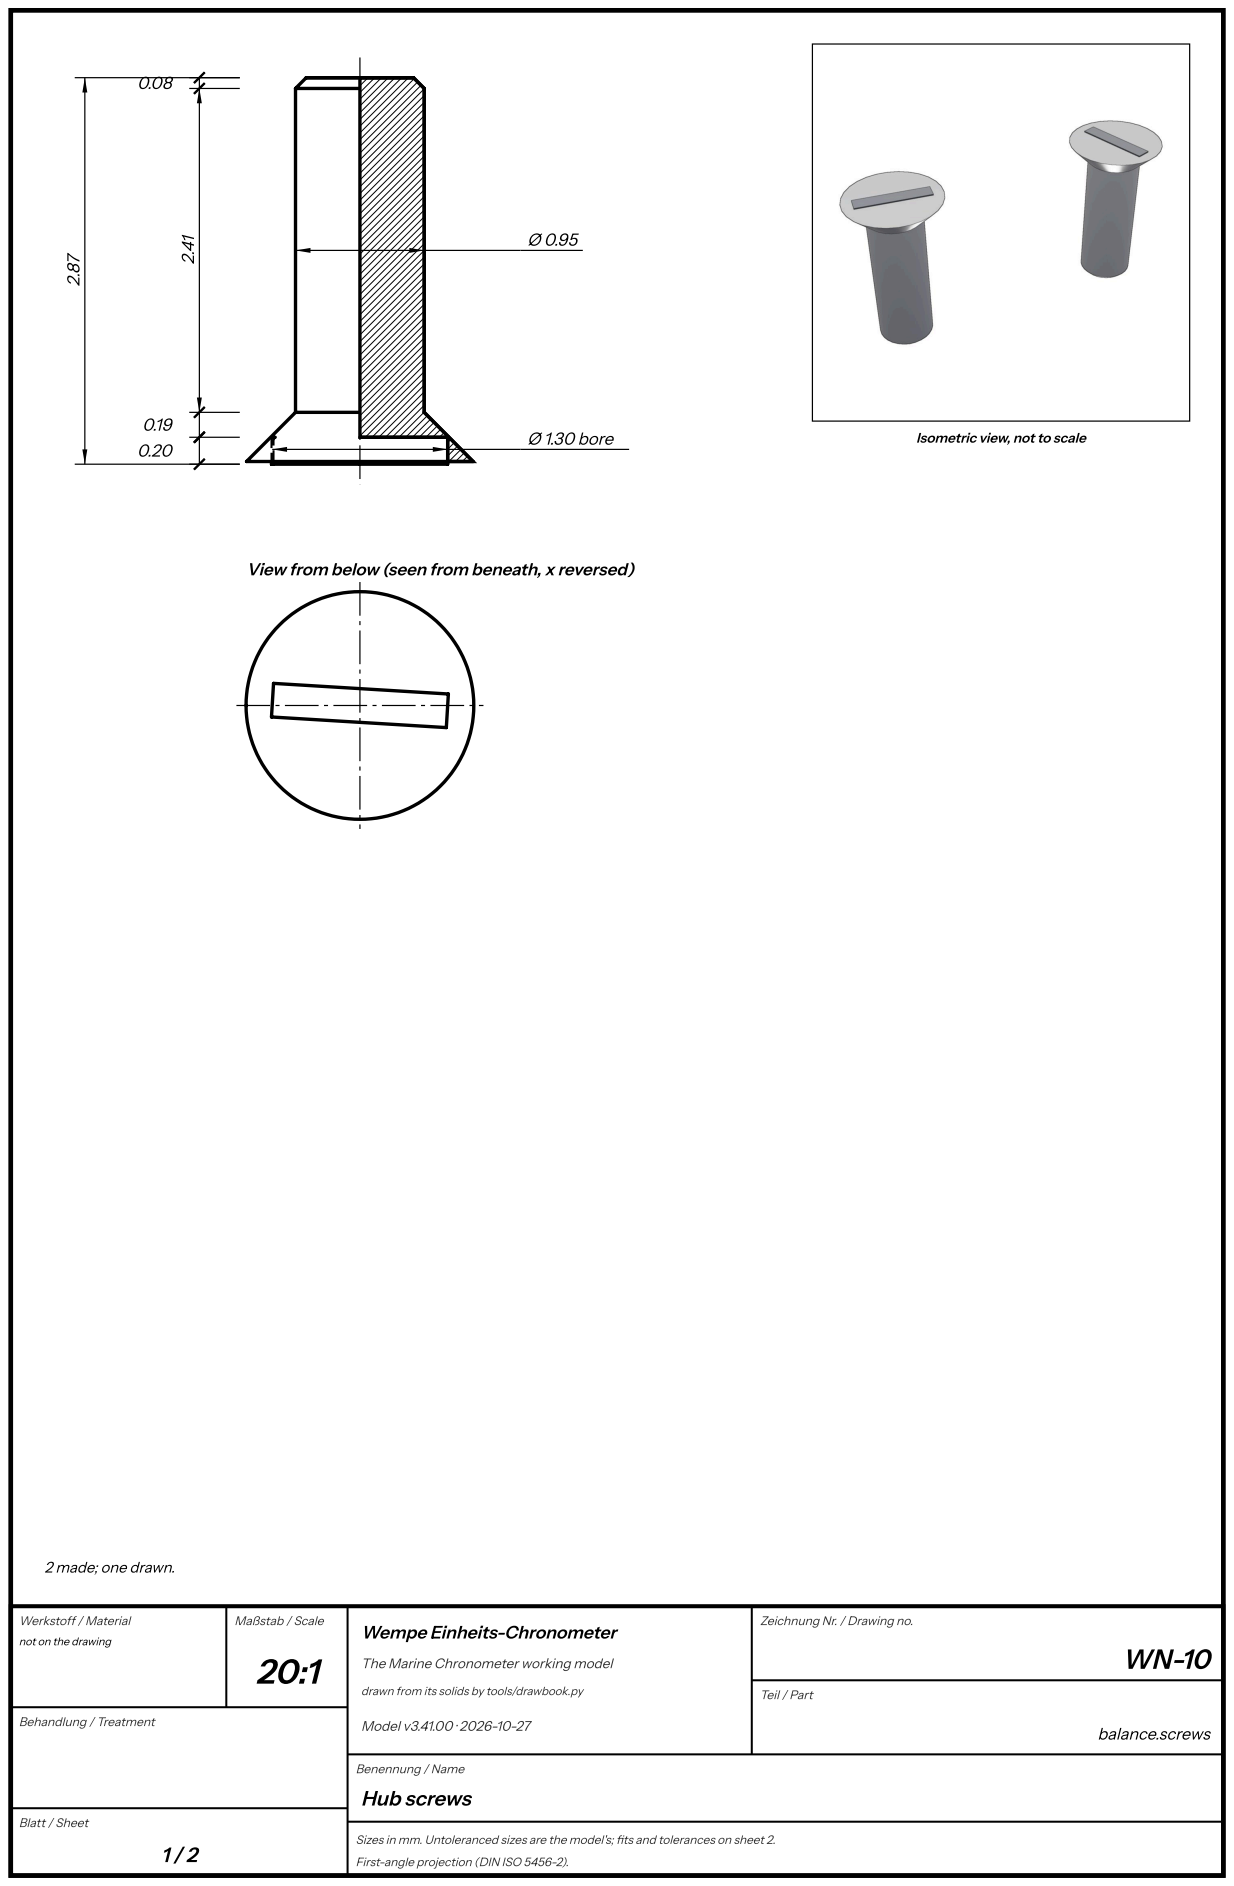
[picture p378: page 135]
Ø 1.30 bore; Werkstoff / Material; Maßstab / Scale; Behandlung / Treatment; Model v3.41.00 · 2026-10-27; Teil / Part; balance.screws; Hub screws

Isometric view, not to scale

View from below (seen from beneath, x reversed)

2 made; one drawn.

Zeichnung Nr. / Drawing no.

not on the drawing

Wempe Einheits-Chronometer

The Marine Chronometer working model

drawn from its solids by tools/drawbook.py

## Hub screws — sheet 2

Two countersunk screws from the arm’s top, through the arm into the hub’s flange.

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

Parts list

Drawing | Name | Units | Material | Finish, heat treatment | Fit, as measured on the model
WN-10 | Schraube (WN-10), the hub's screws | [0, 2] | not on the drawing | | in 050402-2 (tap): 1.75 mm, least gap 0.0392; in 050301-1 (clear): 1.118 mm, least gap 0.0041

What it does (WN-10). From under the hub's flange into the arm. Only on the 1946 hub: the 1941 collar has no holes for

them.

Turned about its axis; length 2.87, largest Ø 1.68. Diameters: Ø 0.95; bores Ø 1.30. Shoulders from the lower end: 0.00, 0.20,

0.39, 2.79, 2.87.

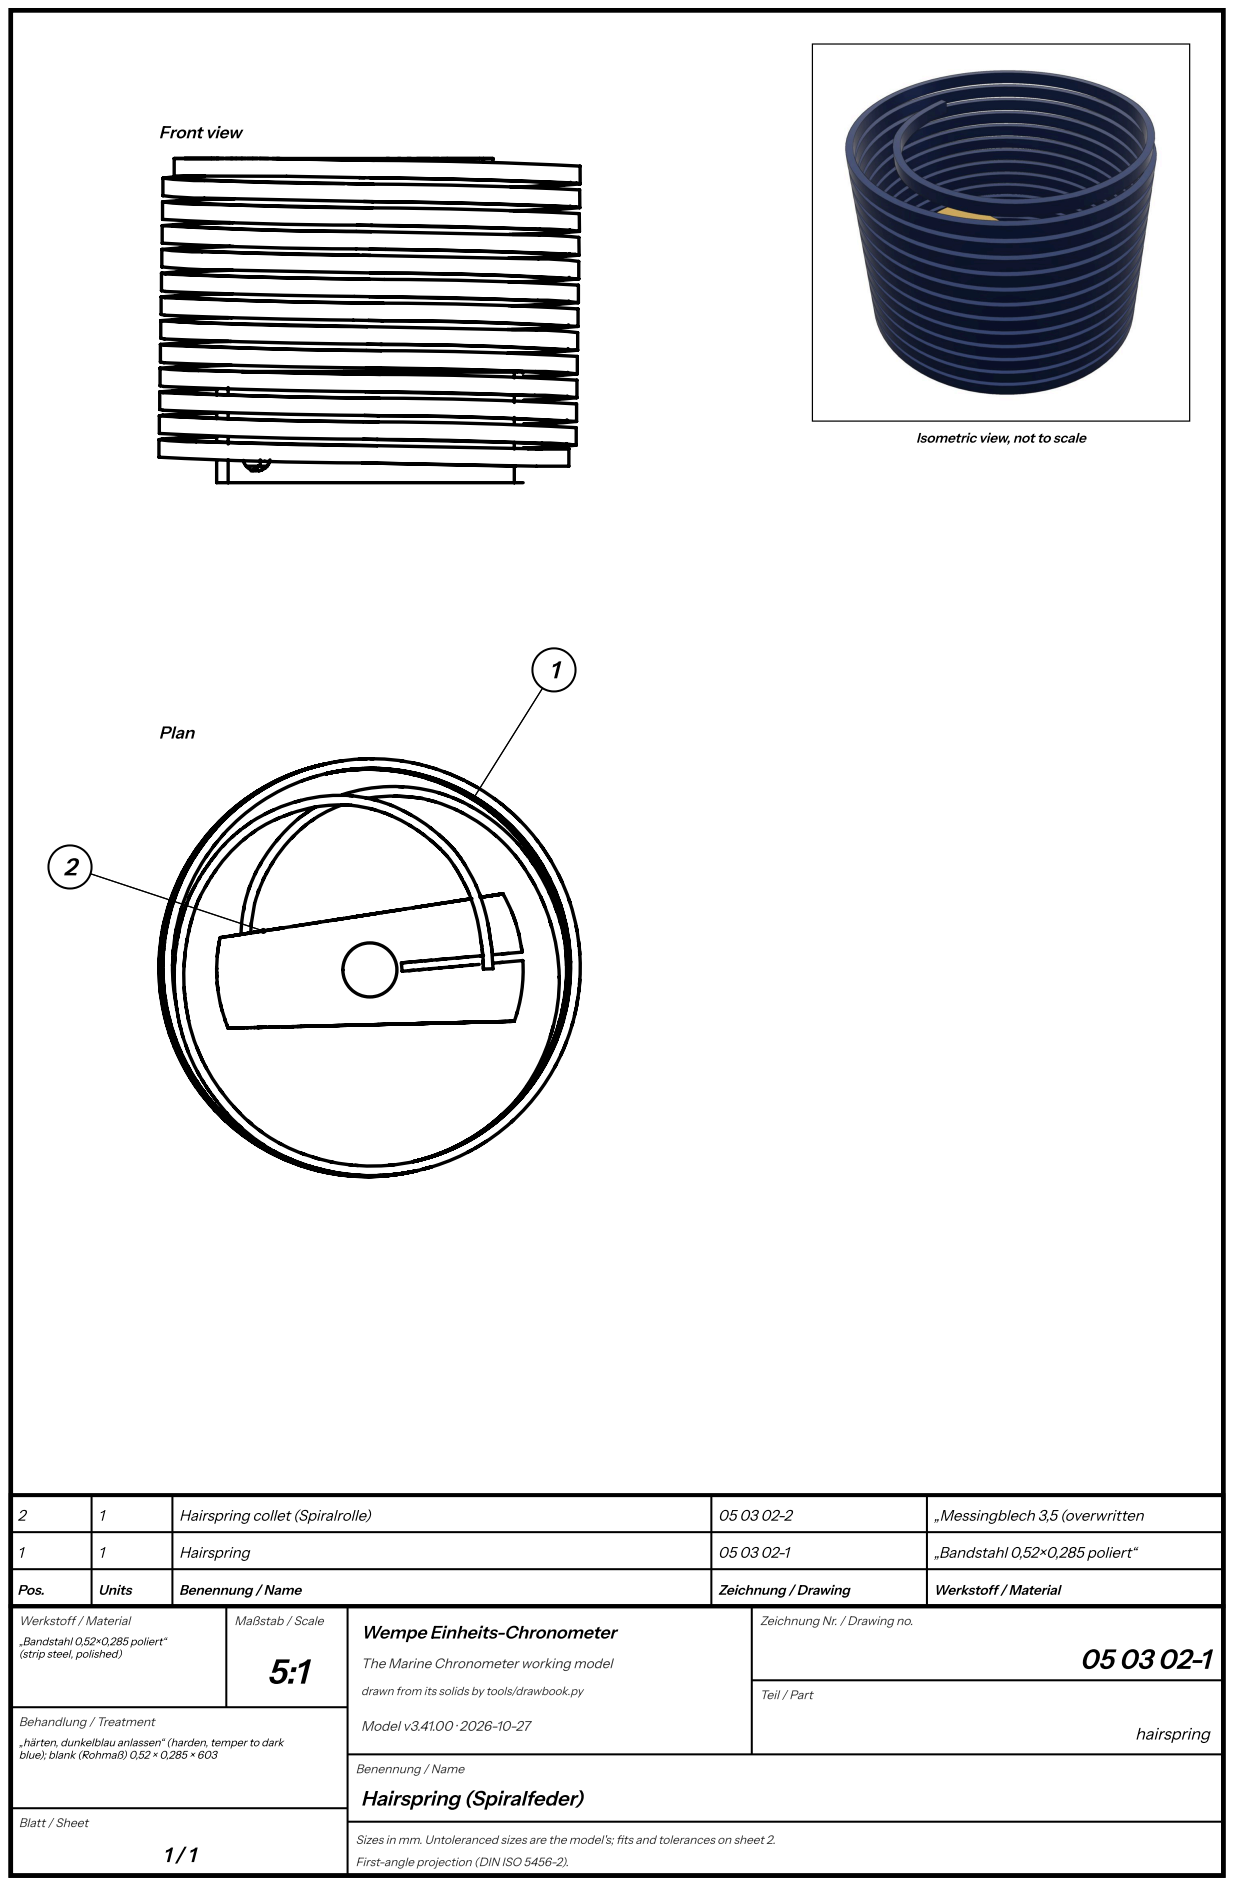
[picture p379: page 137]
Front view; Plan; Pos.; Units; Benennung / Name; Zeichnung / Drawing; Werkstoff / Material; Hairspring; „Bandstahl 0,52×0,285 poliert“; Hairspring collet (Spiralrolle); „Messingblech 3,5 (overwritten; Maßstab / Scale; Behandlung / Treatment; Model v3.41.00 · 2026-10-27; Teil / Part; hairspring; Hairspring (Spiralfeder)

Isometric view, not to scale

Zeichnung Nr. / Drawing no.

„Bandstahl 0,52×0,285 poliert“
(strip steel, polished)

Wempe Einheits-Chronometer

The Marine Chronometer working model

drawn from its solids by tools/drawbook.py

„härten, dunkelblau anlassen“ (harden, temper to dark
blue); blank (Rohmaß) 0,52 × 0,285 × 603

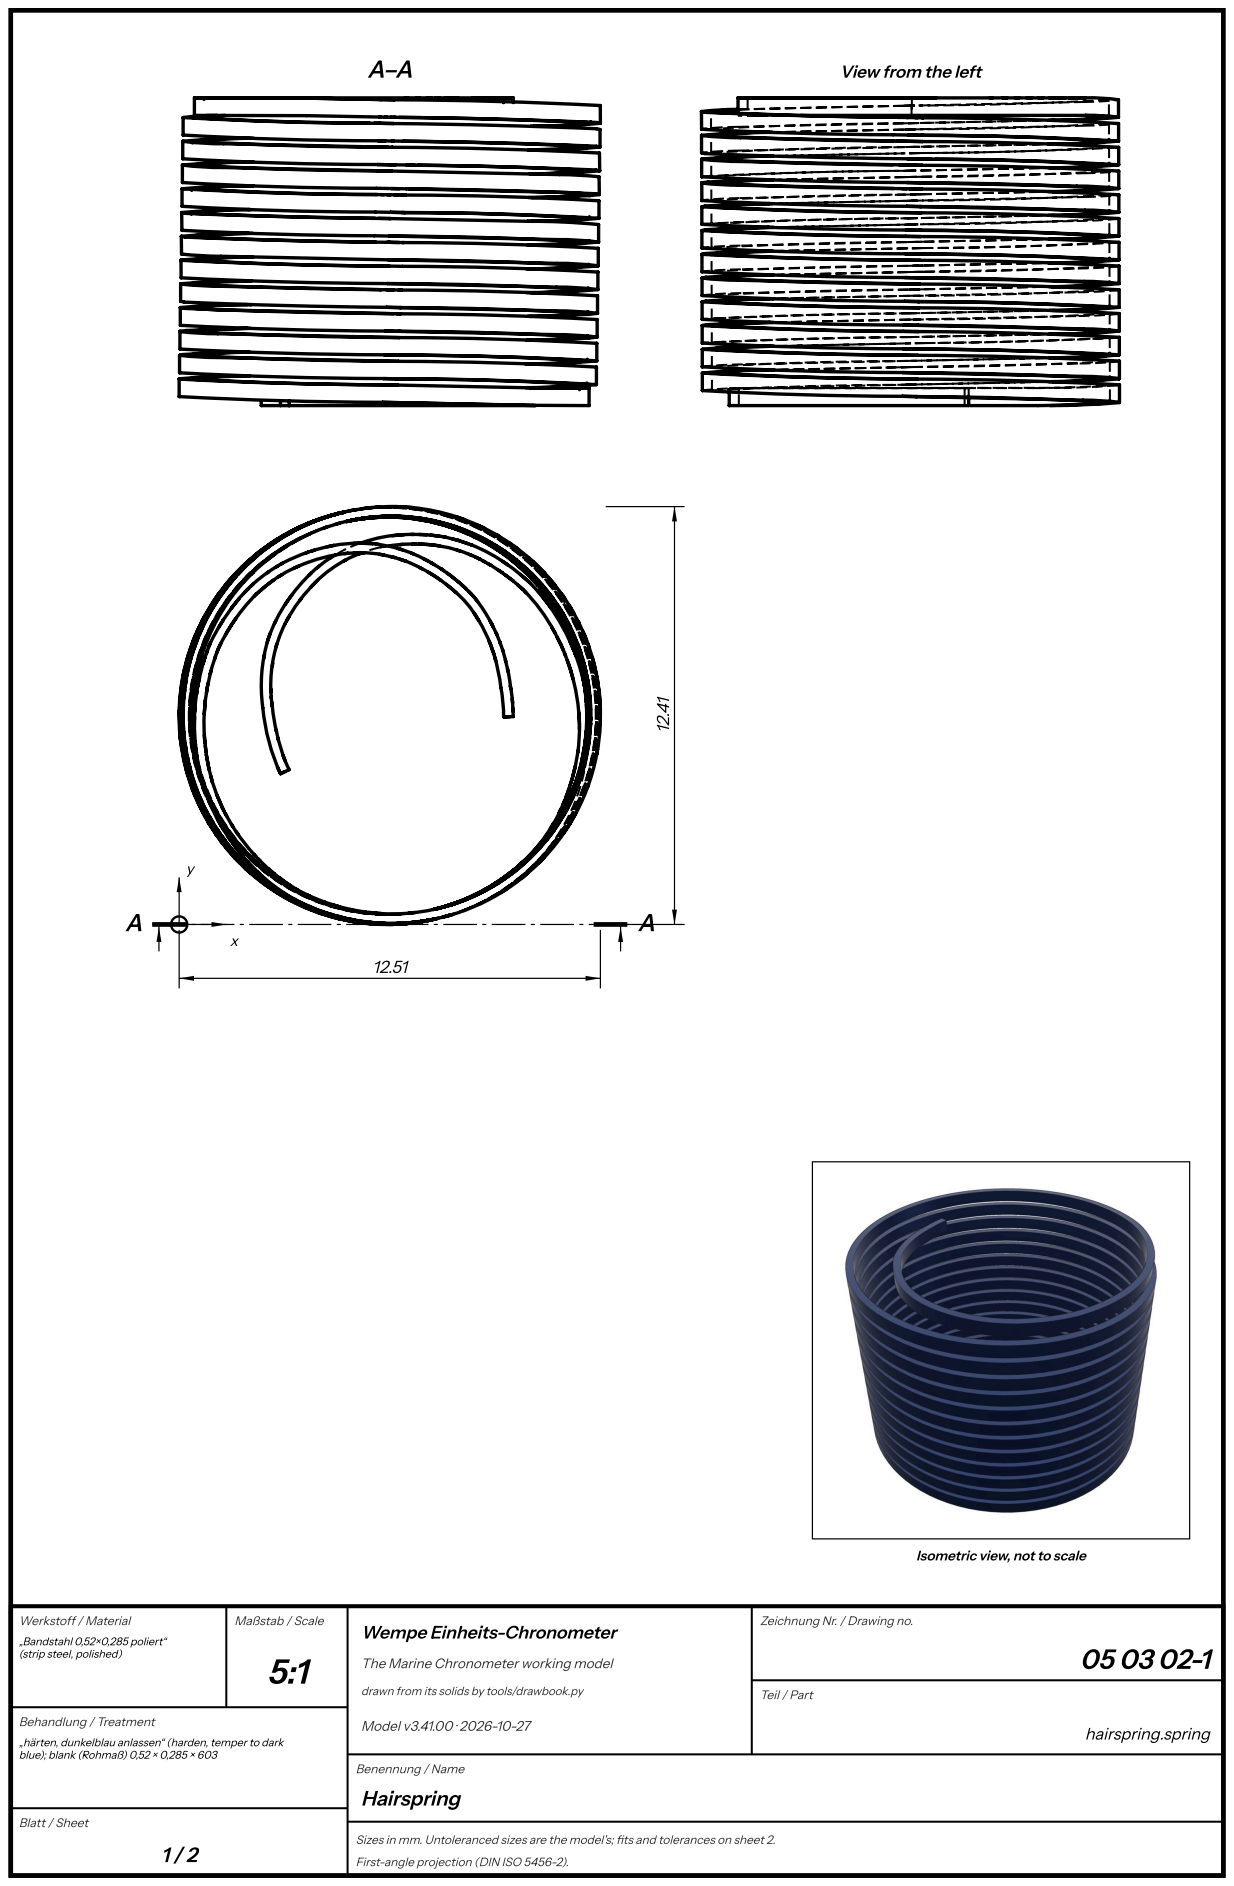
[picture p380: page 138]
Werkstoff / Material; Maßstab / Scale; Behandlung / Treatment; Model v3.41.00 · 2026-10-27; Teil / Part; hairspring.spring; Hairspring

View from the left

Isometric view, not to scale

Zeichnung Nr. / Drawing no.

„Bandstahl 0,52×0,285 poliert“
(strip steel, polished)

Wempe Einheits-Chronometer

The Marine Chronometer working model

drawn from its solids by tools/drawbook.py

„härten, dunkelblau anlassen“ (harden, temper to dark
blue); blank (Rohmaß) 0,52 × 0,285 × 603

## Hairspring — sheet 2

The helical balance spring: a polished steel strip 0.52 × 0.285 wound in 13 turns, its two ends curved in to the centre on the

drawn terminal curve, so the coils open and close concentrically about the staff. Its inner end is pinned in the brass collet

on the staff, its outer end in the stud on the cock.

Parts list

Drawing | Name | Units | Material | Finish, heat treatment | Fit, as measured on the model
05 03 02-1 | Spiralfeder (helical hairspring) | 1 | „Bandstahl 0,52×0,285 poliert“ (strip steel, polished) | „härten, dunkelblau anlassen“ (harden, temper to dark blue); blank (Rohmaß) 0,52 × 0,285 × 603 | not measured on the model: see its function, The balance spring: 13 turns between its two terminal curves.

Tolerance (05 03 02-1). The hairspring: as drawn its period is 0.4986 s (234 s a day fast), so it is matched to the balance, not made to size: 0.5 s wants the strip 0.2845 mm thick at 206 GPa (0.2827-0.2873 over 200-210 GPa); a µm of thickness is

455 s a day, the timing weights' reach 365 s a day. Vibrate it against the balance and choose or grind it (the bench's test).

Test on the bench (05 03 02-1). The balance and its hairspring vibrated, the spring pinned to its collet and stud, its curves

bent to 05 03_7, before it goes in: 2 oscillations a second (7,200 an hour), or slow by up to 365 s a day: the timing weights

stand against their screws' heads as drawn and can only be screwed in, 5.0 turns of 73.1 s a day each (wempe_tolerances.js; their size estimated). The drawn spring on the weighed balance (2,501 g·mm²) is 4 min a day fast (0.4986 s): the strip wants

0.2845 mm, not 0.285 (0.2827-0.2873 over the steel's 200-210 GPa). No section tolerance holds the period (a µm of the

strip is 455 s a day, the coil's ±0.05 ±173): fast, grind the strip thinner or choose a weaker spring; slow past the weights'

reach, a stronger one.

What it does (05 03 02-1). The balance spring: 13 turns between its two terminal curves.

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

drawn; depths from the face seen in the plan (the top). Thickness 9.14.

Contourin the plan

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

radius.

Contour | # | Element | From x, y | To x, y | Centre x, y | R
Outline | 1 | arc clockwise | 0.04, 6.90 | 4.69, 12.20 | 6.19, 6.19 | 6.19
Outline | 2 | line | 4.69, 12.20 | 5.14, 12.30
Outline | 3 | arc clockwise | 5.14, 12.30 | 8.13, 0.30 | 6.32, 6.22 | 6.19
Outline | 4 | line | 8.13, 0.30 | 7.60, 0.16
Outline | 5 | line | 7.60, 0.16 | 7.37, 0.11
Outline | 6 | arc clockwise | 7.37, 0.11 | 0.04, 6.90 | 6.19, 6.19 | 6.19
Cut-out 1 | 7 | arc anticlockwise | 5.69, 12.08 | 0.52, 5.07 | 6.30, 6.23 | 5.89
Cut-out 1 | 8 | arc clockwise | 0.52, 5.07 | 1.10, 8.69 | 6.53, 5.98 | 6.08
Cut-out 1 | 9 | arc clockwise | 1.10, 8.69 | 5.39, 11.32 | 5.39, 6.52 | 4.80
Cut-out 1 | 10 | arc clockwise | 5.39, 11.32 | 10.09, 10.43 | 6.96, 6.82 | 4.77
Cut-out 1 | 11 | arc clockwise | 10.09, 10.43 | 12.04, 7.03 | 6.17, 5.94 | 5.97
Cut-out 1 | 12 | arc anticlockwise | 12.04, 7.03 | 5.69, 12.08 | 6.19, 6.19 | 5.91
Cut-out 2 | 13 | arc clockwise | 6.19, 11.24 | 8.97, 9.44 | 5.12, 6.54 | 4.82
Cut-out 2 | 14 | arc clockwise | 8.97, 9.44 | 9.83, 7.08 | 4.72, 6.55 | 5.14
Cut-out 2 | 15 | arc clockwise | 9.83, 7.08 | 9.92, 6.17 | 4.88, 6.17 | 5.03
Cut-out 2 | 16 | line | 9.92, 6.17 | 9.63, 6.16
Cut-out 2 | 17 | arc anticlockwise | 9.63, 6.16 | 9.55, 7.04 | 4.85, 6.17 | 4.79
Cut-out 2 | 18 | arc anticlockwise | 9.55, 7.04 | 8.35, 9.73 | 4.94, 6.63 | 4.62
Cut-out 2 | 19 | arc anticlockwise | 8.35, 9.73 | 5.72, 11.03 | 5.17, 6.61 | 4.46

Cut-out 2 | 20 | arc anticlockwise | 5.72, 11.03 | 5.27, 10.98 | 5.56, 10.44 | 0.62
Cut-out 2 | 21 | arc anticlockwise | 5.27, 10.98 | 3.14, 8.93 | 7.03, 7.05 | 4.31
Cut-out 2 | 22 | arc anticlockwise | 3.14, 8.93 | 2.77, 6.47 | 6.96, 7.10 | 4.24
Cut-out 2 | 23 | arc anticlockwise | 2.77, 6.47 | 3.27, 4.60 | 8.63, 7.01 | 5.88
Cut-out 2 | 24 | line | 3.27, 4.60 | 3.01, 4.48
Cut-out 2 | 25 | arc clockwise | 3.01, 4.48 | 2.48, 6.44 | 8.63, 7.01 | 6.17
Cut-out 2 | 26 | arc clockwise | 2.48, 6.44 | 3.66, 10.17 | 6.86, 7.11 | 4.42
Cut-out 2 | 27 | arc clockwise | 3.66, 10.17 | 4.64, 10.98 | 6.55, 7.66 | 3.82
Cut-out 2 | 28 | arc anticlockwise | 4.64, 10.98 | 1.35, 8.56 | 5.39, 6.52 | 4.52
Cut-out 2 | 29 | arc anticlockwise | 1.35, 8.56 | 2.22, 2.08 | 6.55, 5.96 | 5.82
Cut-out 2 | 30 | arc anticlockwise | 2.22, 2.08 | 5.96, 0.32 | 6.16, 5.64 | 5.31
Cut-out 2 | 31 | arc anticlockwise | 5.96, 0.32 | 7.59, 0.46 | 6.33, 6.01 | 5.70
Cut-out 2 | 32 | line | 7.59, 0.46 | 7.76, 0.50
Cut-out 2 | 33 | arc anticlockwise | 7.76, 0.50 | 11.19, 3.13 | 6.36, 5.89 | 5.57
Cut-out 2 | 34 | arc anticlockwise | 11.19, 3.13 | 10.21, 9.95 | 6.07, 5.87 | 5.81
Cut-out 2 | 35 | arc anticlockwise | 10.21, 9.95 | 7.45, 11.28 | 6.86, 6.60 | 4.73
Cut-out 2 | 36 | arc anticlockwise | 7.45, 11.28 | 6.19, 11.24 | 6.98, 6.39 | 4.91

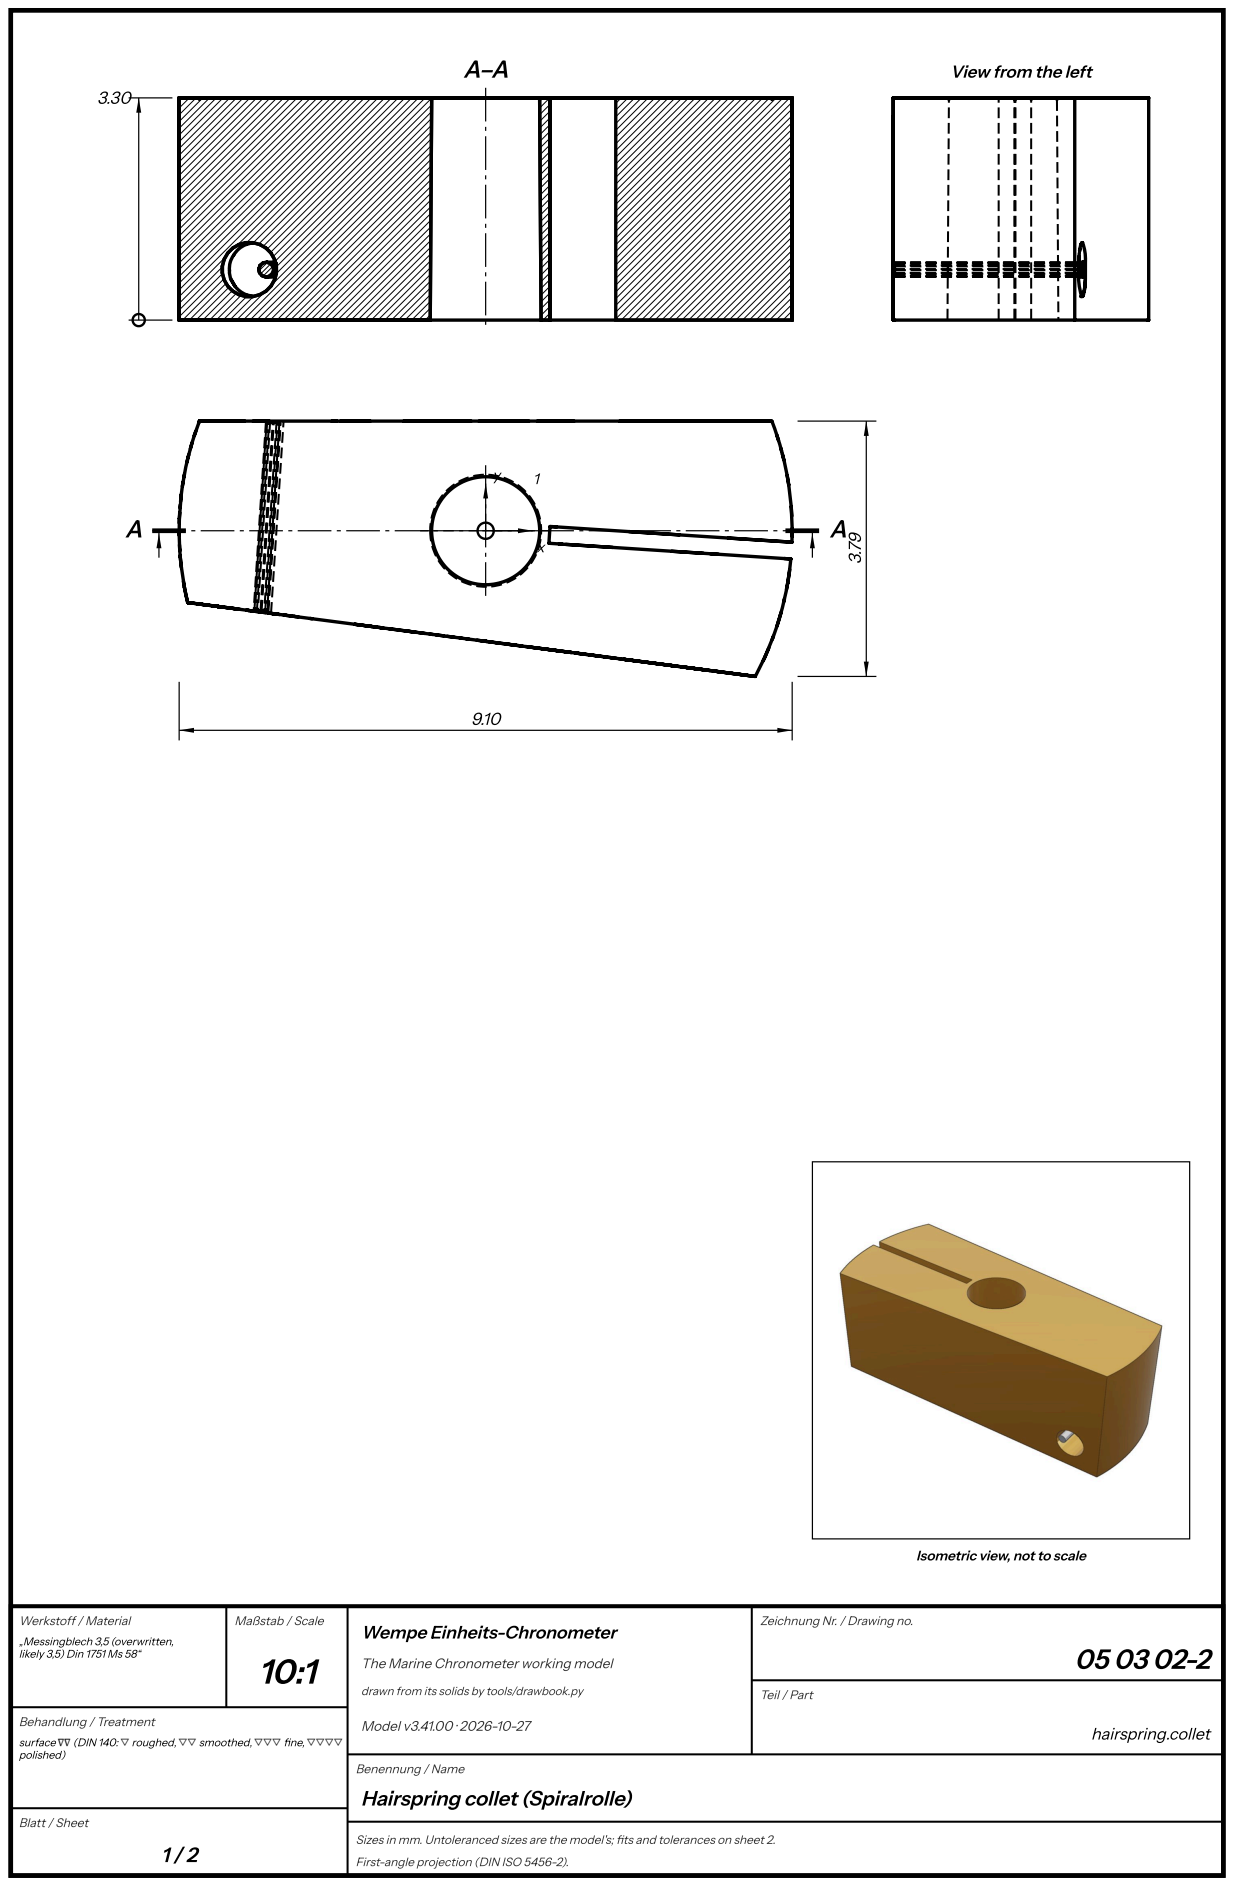
[picture p381: page 141]
Werkstoff / Material; Maßstab / Scale; Behandlung / Treatment; Model v3.41.00 · 2026-10-27; Teil / Part; hairspring.collet

View from the left

Isometric view, not to scale

Zeichnung Nr. / Drawing no.

„Messingblech 3,5 (overwritten,
likely 3,5) Din 1751 Ms 58“

Wempe Einheits-Chronometer

The Marine Chronometer working model

drawn from its solids by tools/drawbook.py

surface ∇∇ (DIN 140: ▽ roughed, ▽▽ smoothed, ▽▽▽ fine, ▽▽▽▽
polished)

Hairspring collet (Spiralrolle)

## Hairspring collet (Spiralrolle) — sheet 2

The split brass collet on the staff, with the hole across its end where the spring’s inner end is pinned (Spiralstift 05 03 02-

4).

Parts list

Drawing | Name | Units | Material | Finish, heat treatment | Fit, as measured on the model
05 03 02-2 | Spiralrolle (hairspring collet) | 1 | „Messingblech 3,5 (overwritten, likely 3,5) Din 1751 Ms 58“ | surface ∇∇ (DIN 140: ▽ roughed, ▽▽ smoothed, ▽▽▽ fine, ▽▽▽▽ polished) | round 050402-1 (press): 3.182 mm, least gap 0.0053
05 03 02-4 | Spiralstift (hairspring pin, at the collet) | 1 | not on the drawing | | in 050302-2 (press): 1.467 mm, least gap 0.0497

What it does (05 03 02-2). On the staff's 1:70 seat; the spring's inner end pinned in the hole across its end.

What it does (05 03 02-4). Wedges the spring's inner end in the collet's hole.

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

the face seen in the plan (the top). Thickness 3.30.

Holes

Hole | x | y | Size
1 | 0.00 | 0.00 | Ø 1.60 × 2.32 deep from the top; sink Ø 1.65 × 2.35 from the bottom

Contourin the plan

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

radius.

Contour | # | Element | From x, y | To x, y | Centre x, y | R
Outline | 1 | line | -4.28, -1.08 | -4.42, -1.07
Outline | 2 | arc clockwise | -4.42, -1.07 | -4.25, 1.63 | 0.00, 0.00 | 4.55
Outline | 3 | line | -4.25, 1.63 | 4.25, 1.63
Outline | 4 | arc clockwise | 4.25, 1.63 | 4.55, -0.17 | 0.01, 0.00 | 4.54
Outline | 5 | line | 4.55, -0.17 | 0.96, 0.06
Outline | 6 | line | 0.96, 0.06 | 0.94, -0.19
Outline | 7 | line | 0.94, -0.19 | 4.53, -0.42
Outline | 8 | arc clockwise | 4.53, -0.42 | 4.00, -2.16 | 0.01, 0.00 | 4.54
Outline | 9 | line | 4.00, -2.16 | -4.28, -1.08
Cut-out 1 | 10 | line | -3.12, 1.63 | -3.12, 1.63
Cut-out 1 | 11 | line | -3.12, 1.63 | -3.12, 1.63
Cut-out 3 | 12 | line | -3.80, 1.63 | -3.80, 1.63
Cut-out 3 | 13 | line | -3.80, 1.63 | -3.80, 1.63
Cut-out 4 | 14 | line | -3.80, 1.63 | -3.80, 1.63
Cut-out 4 | 15 | line | -3.80, 1.63 | -3.80, 1.63

Levels

Faces in section A-A, from the bottom face: 3.30.

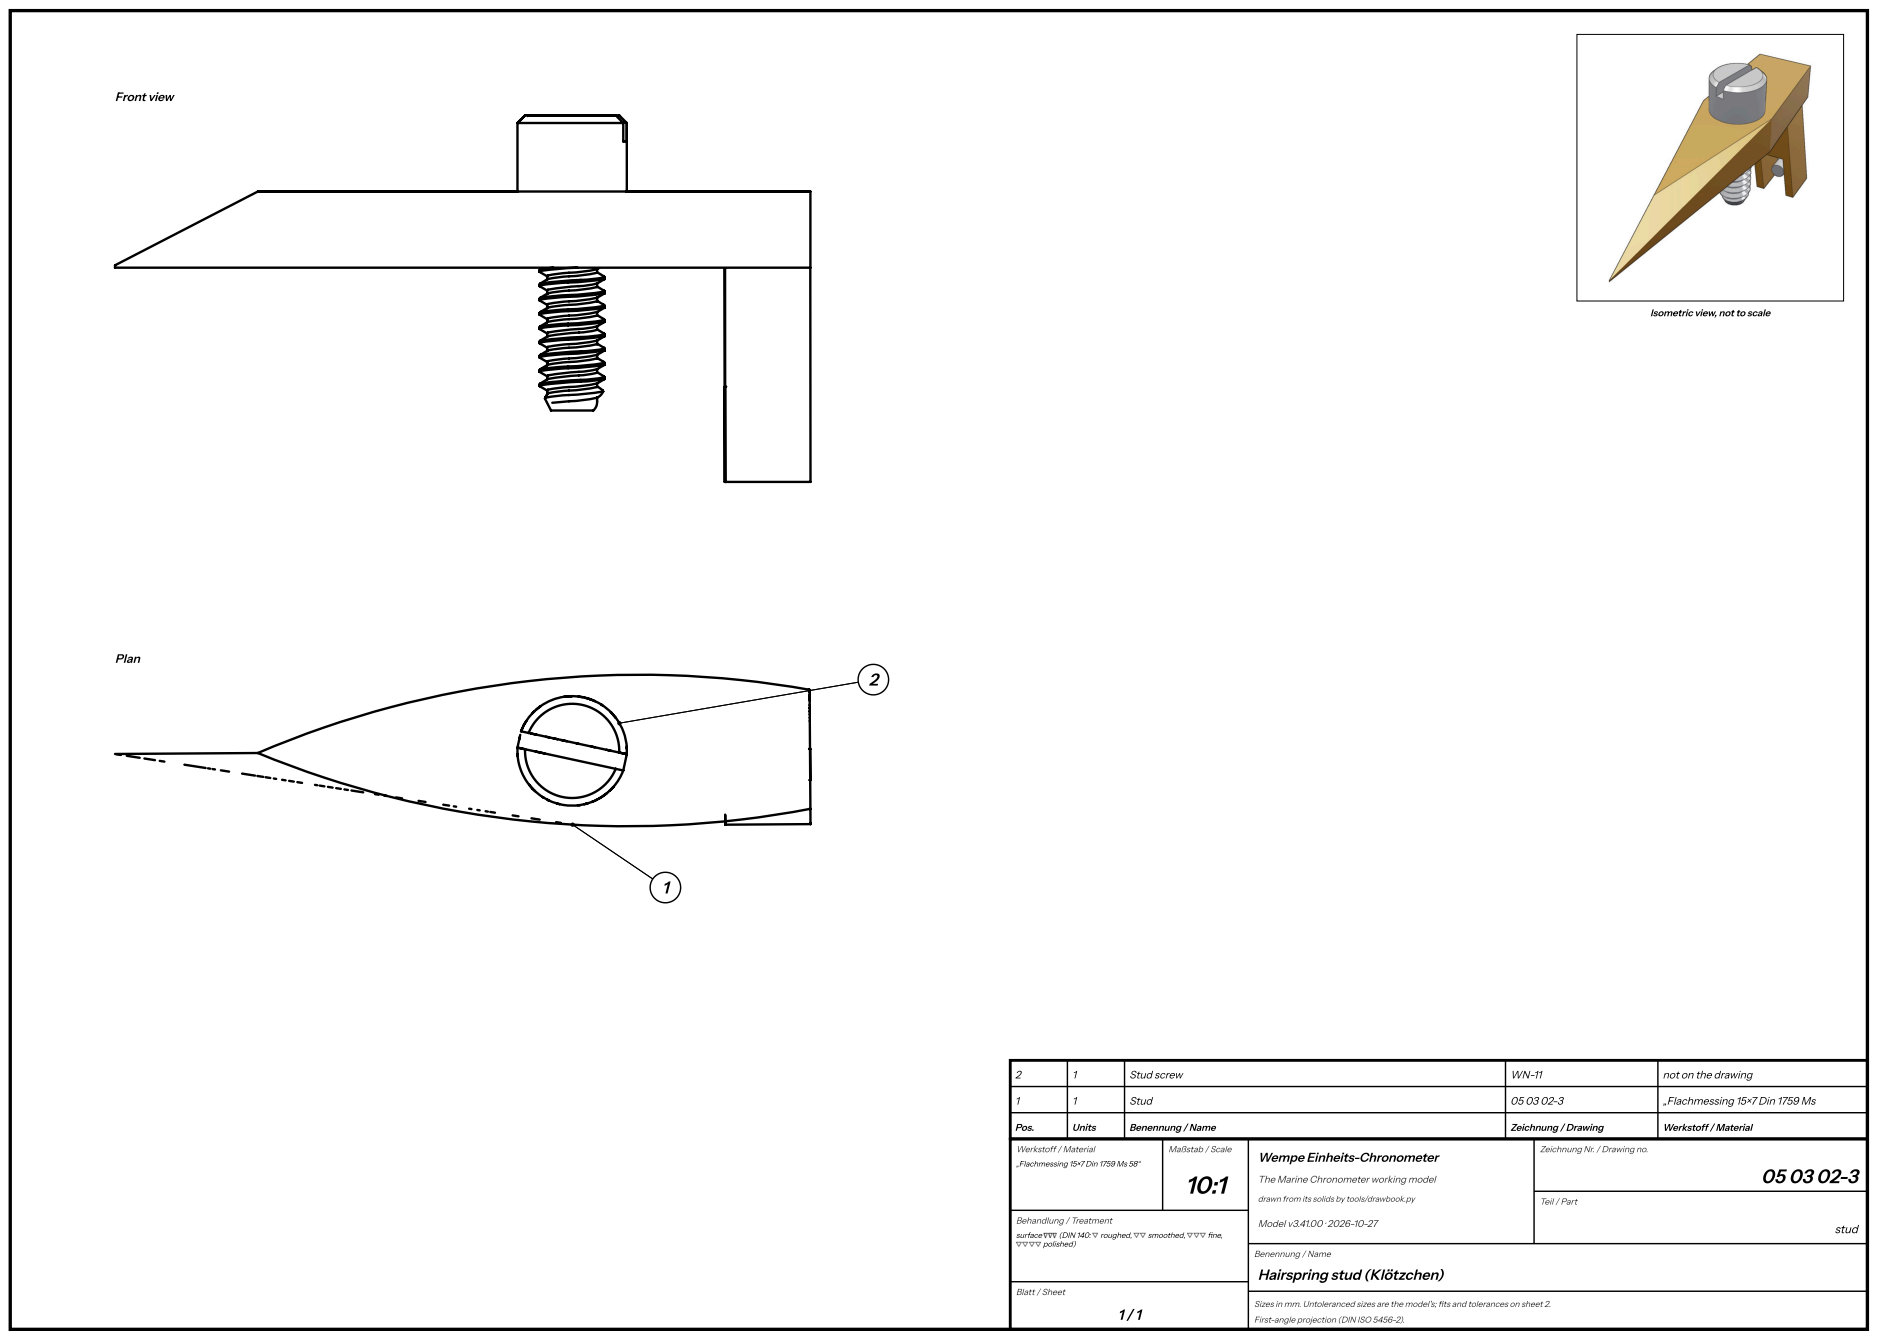
[picture p382: page 143]
Front view; Plan; Pos.; Units; Benennung / Name; Zeichnung / Drawing; Werkstoff / Material; Stud; „Flachmessing 15×7 Din 1759 Ms; Stud screw; not on the drawing; Maßstab / Scale; Behandlung / Treatment; Model v3.41.00 · 2026-10-27; Teil / Part; stud

Isometric view, not to scale

Zeichnung Nr. / Drawing no.

„Flachmessing 15×7 Din 1759 Ms 58“

Wempe Einheits-Chronometer

The Marine Chronometer working model

drawn from its solids by tools/drawbook.py

surface ∇∇∇ (DIN 140: ▽ roughed, ▽▽ smoothed, ▽▽▽ fine,
▽▽▽▽ polished)

Hairspring stud (Klötzchen)

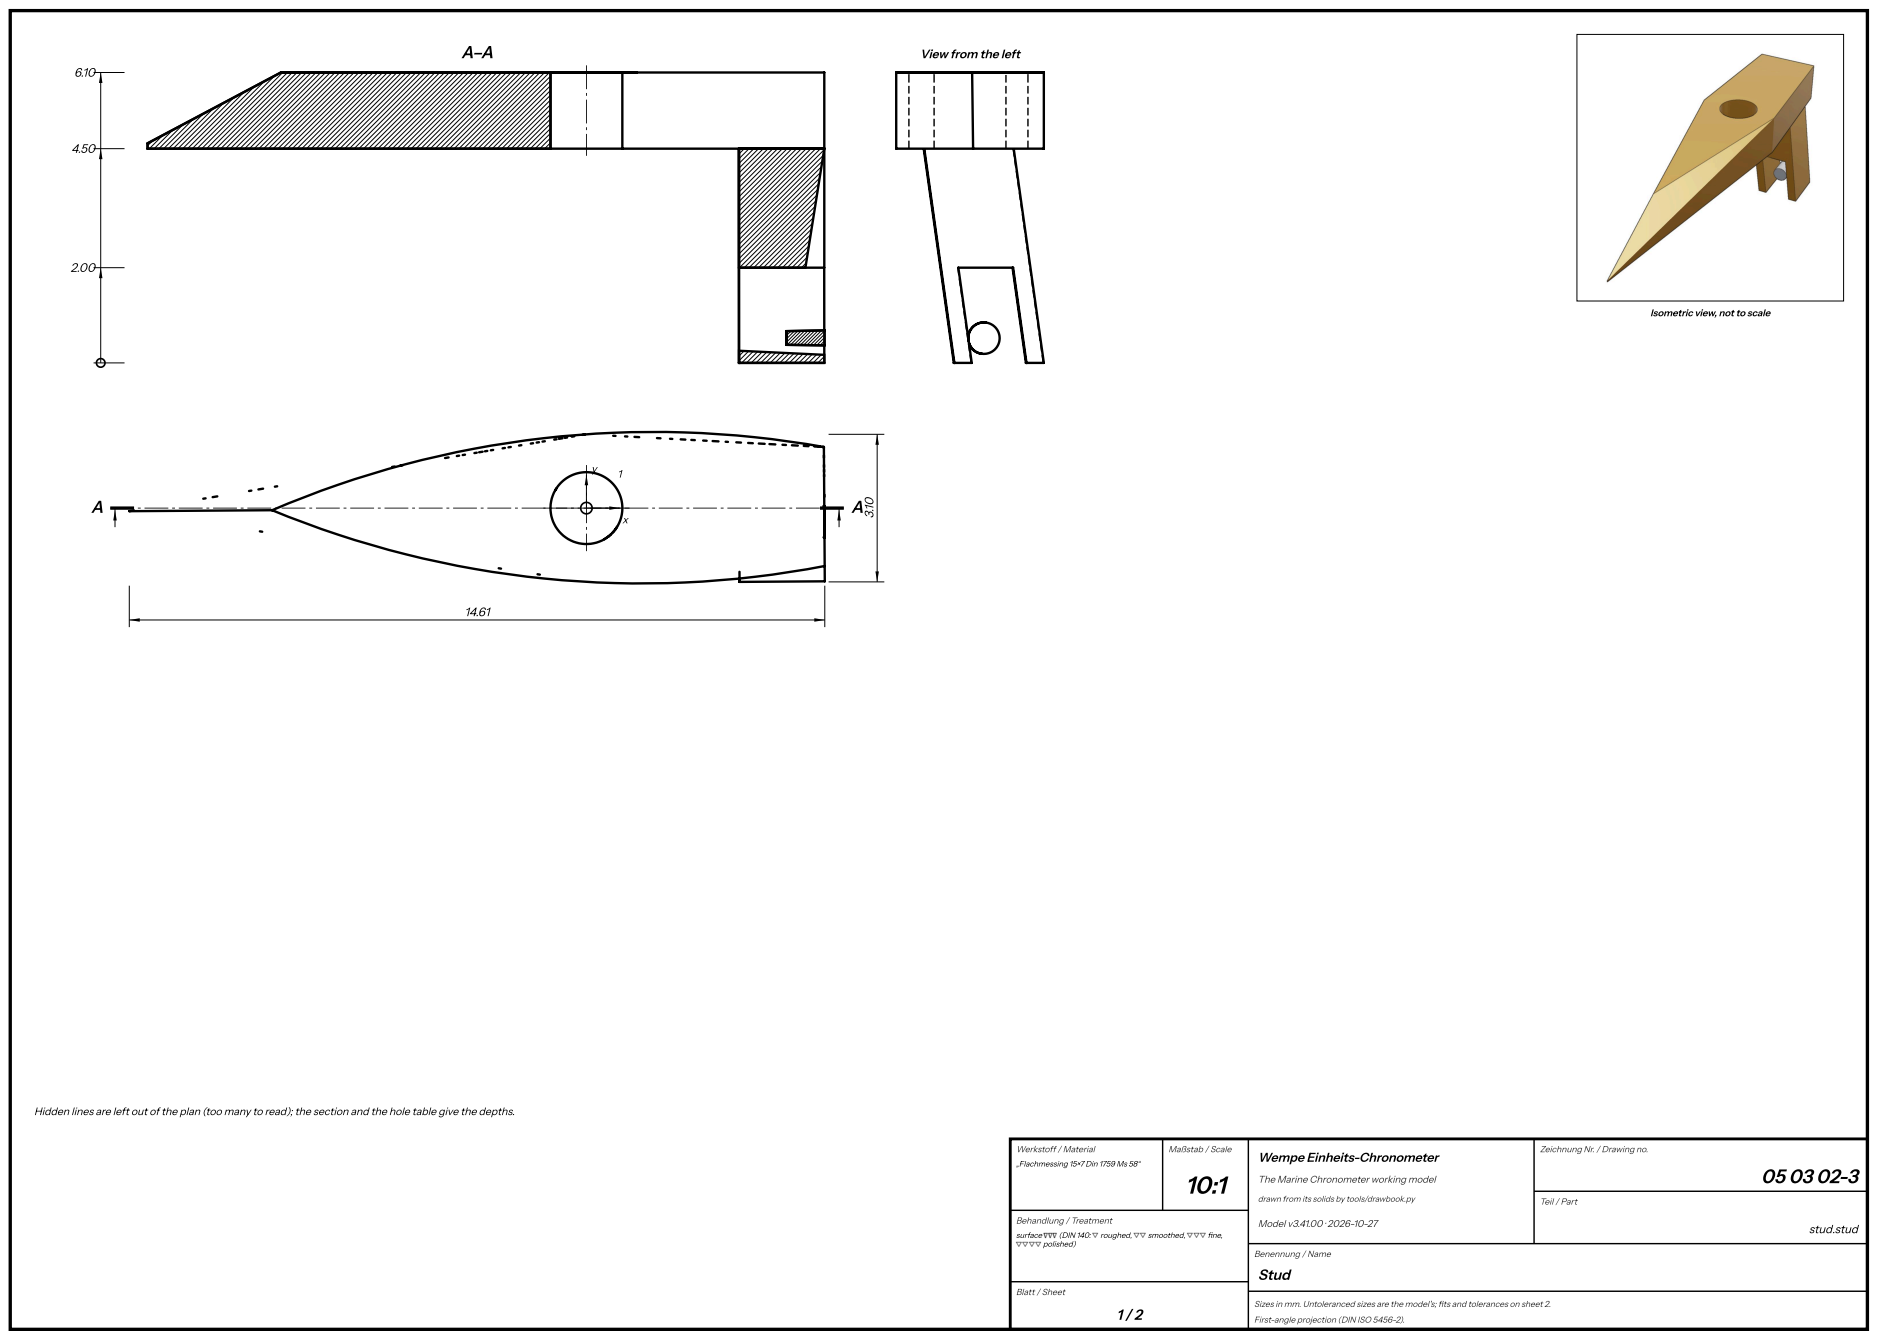
[picture p383: page 144]
Werkstoff / Material; Maßstab / Scale; Behandlung / Treatment; Model v3.41.00 · 2026-10-27; Teil / Part; stud.stud; Stud

View from the left

Isometric view, not to scale

Hidden lines are left out of the plan (too many to read); the section and the hole table give the depths.

Zeichnung Nr. / Drawing no.

„Flachmessing 15×7 Din 1759 Ms 58“

Wempe Einheits-Chronometer

The Marine Chronometer working model

drawn from its solids by tools/drawbook.py

surface ∇∇∇ (DIN 140: ▽ roughed, ▽▽ smoothed, ▽▽▽ fine,
▽▽▽▽ polished)

## Stud — sheet 2

A small brass L screwed on the balance cock: its upright drops through the slot in the cock’s arm and holds the hairspring’s

outer end, pinned in a slot at its foot. Slid along the cock’s slot it sets the spring’s pinning point.

Parts list

Drawing | Name | Units | Material | Finish, heat treatment | Fit, as measured on the model
05 03 02-3 | Klötzchen (hairspring stud) | 1 | „Flachmessing 15×7 Din 1759 Ms 58“ | surface ∇∇∇ (DIN 140: ▽ roughed, ▽▽ smoothed, ▽▽▽ fine, ▽▽▽▽ polished) | on 050803-1: 0 mm
05 03 02-4 | Stift (hairspring pin, at the stud) | 1 | not on the drawing | | on 050302-3: 0.0048 mm

What it does (05 03 02-3). On the cock, its upright through the cock's slot, holding the spring's outer end.

What it does (05 03 02-4). Wedges the spring's outer end in the stud's slot.

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

the face seen in the plan (the top). Thickness 6.10.

Holes

Hole | x | y | Size
1 | 0.00 | 0.00 | Ø 1.51 through (1.60 thick at 4.50-6.10)

Contourin the plan

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

radius.

Contour | # | Element | From x, y | To x, y | Centre x, y | R
Outline | 1 | line | 5.00, -1.22 | 5.01, -1.54
Outline | 2 | line | 5.01, -1.54 | 3.22, -1.55
Outline | 3 | line | 3.22, -1.55 | 3.21, -1.34
Outline | 4 | arc clockwise | 3.21, -1.34 | -9.60, -0.06 | -0.35, 27.94 | 29.49
Outline | 5 | arc clockwise | -9.60, -0.06 | 4.99, 1.28 | 0.71, -31.99 | 33.55
Outline | 6 | line | 4.99, 1.28 | 4.99, 0.04
Outline | 7 | line | 4.99, 0.04 | 5.00, 0.04
Outline | 8 | line | 5.00, 0.04 | 5.00, -0.61
Outline | 9 | line | 5.00, -0.61 | 5.00, -0.61
Outline | 10 | line | 5.00, -0.61 | 5.00, -1.22

Levels

Faces in section A-A, from the bottom face: 2.00, 4.50, 6.10.

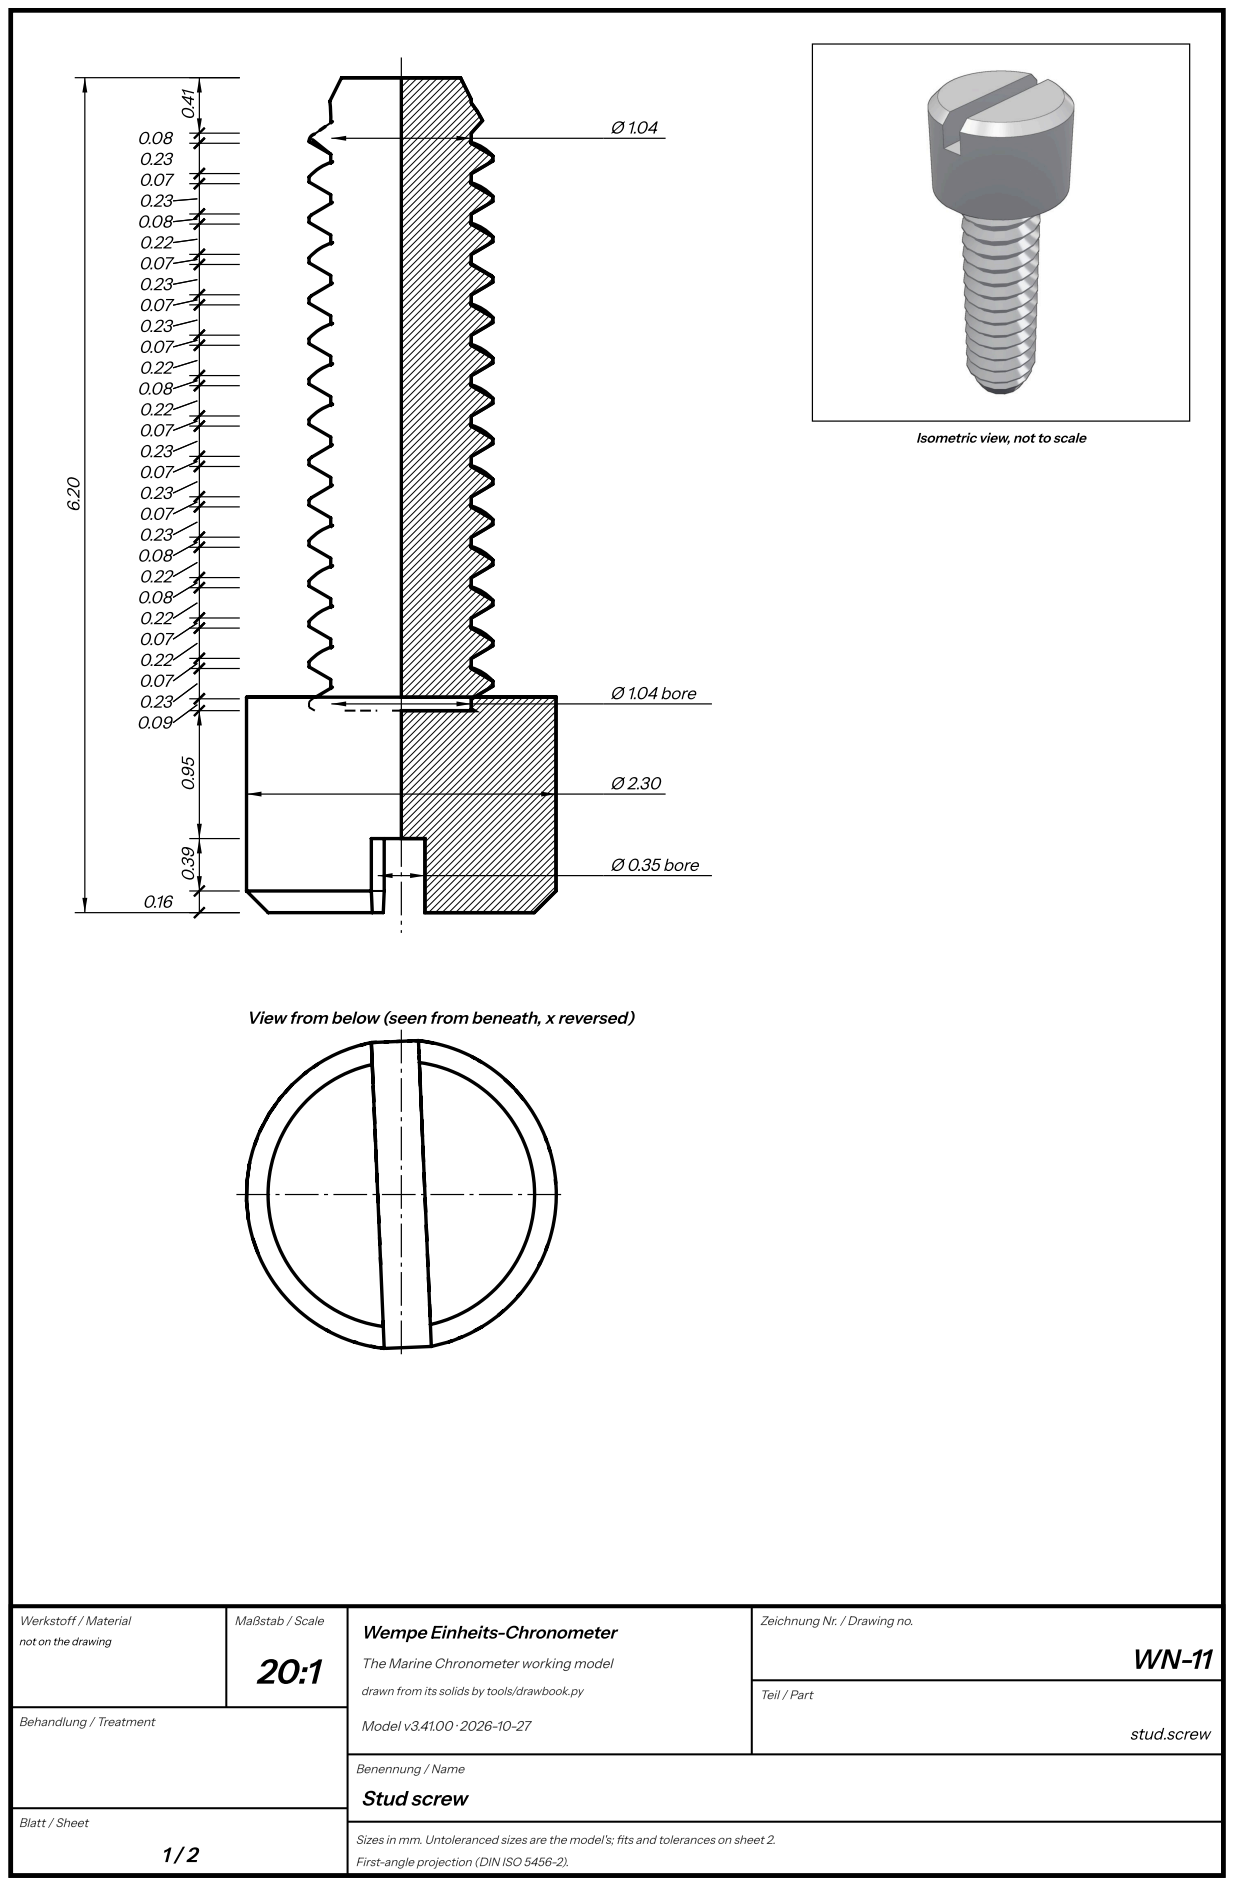
[picture p384: page 146]
Ø 1.04 bore; Ø 0.35 bore 0.39; Werkstoff / Material; Maßstab / Scale; Behandlung / Treatment; Model v3.41.00 · 2026-10-27; Teil / Part; stud.screw; Stud screw

Isometric view, not to scale

View from below (seen from beneath, x reversed)

Zeichnung Nr. / Drawing no.

not on the drawing

Wempe Einheits-Chronometer

The Marine Chronometer working model

drawn from its solids by tools/drawbook.py

## Stud screw — sheet 2

The screw holding the stud to the cock.

Parts list

Drawing | Name | Units | Material | Finish, heat treatment | Fit, as measured on the model
WN-11 | Schraube (WN-11), the stud's screw | 1 | not on the drawing | | in 050302-3 (clear): 1.637 mm, least gap 0.0662; in 050803-1 (tap): 2.381 mm, least gap 0.0104

What it does (WN-11). Holds the stud to the cock.

Turned about its axis; length 6.20, largest Ø 2.30. Diameters: Ø 1.04, Ø 2.30; bores Ø 0.35, Ø 1.04. Shoulders from the lower

end: 0.00, 0.16, 0.55, 1.50, 1.59, 1.81, 1.89, 2.11, 2.19, 2.41, 2.49, 2.71, 2.79, 3.01, 3.09, 3.31, 3.39, 3.61, 3.69, 3.91, 3.99, 4.21, 4.29, 4.51,

4.59, 4.81, 4.89, 5.11, 5.19, 5.41, 5.49, 5.71, 5.79, 6.20.

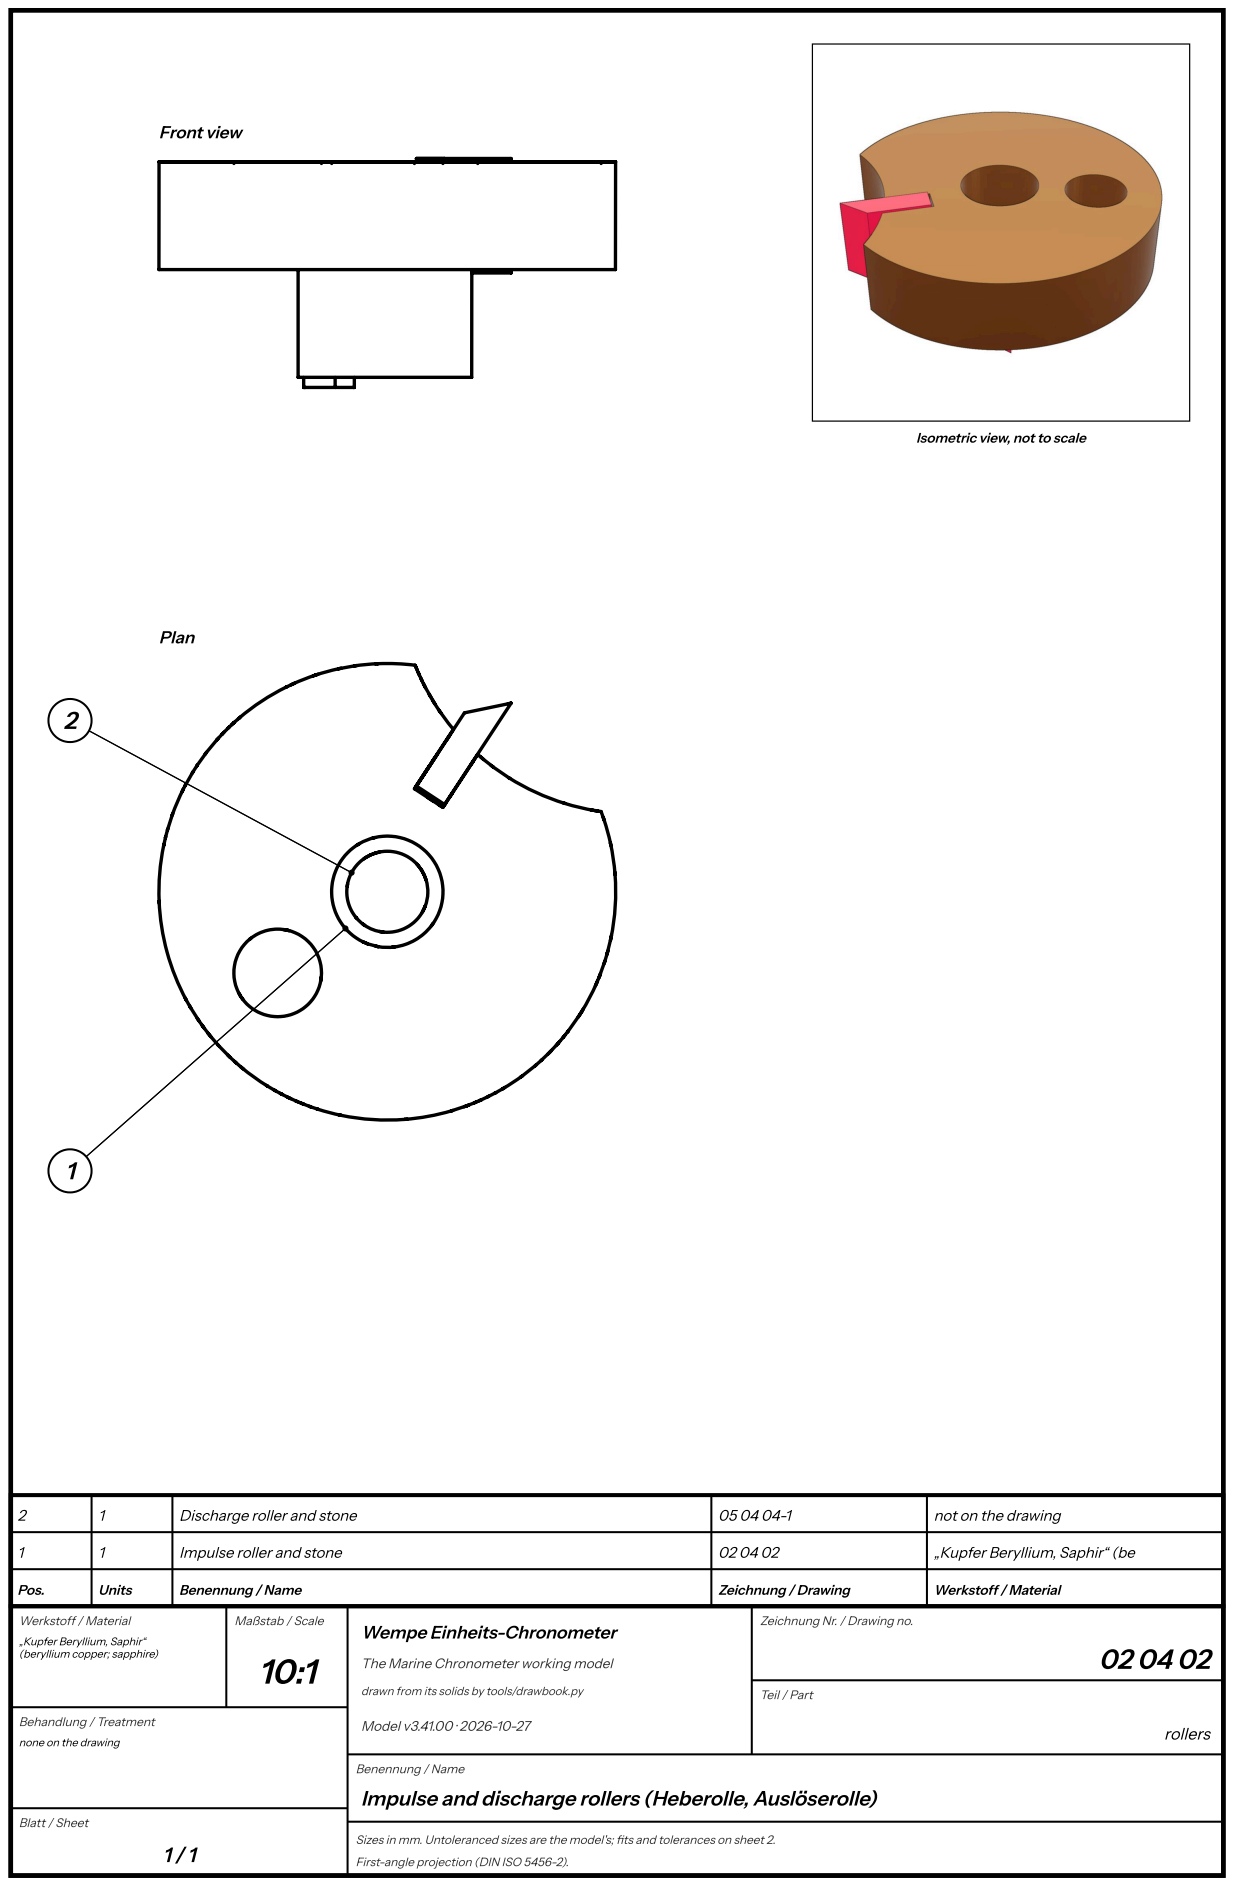
[picture p385: page 148]
Front view; Plan; Pos.; Units; Benennung / Name; Zeichnung / Drawing; Werkstoff / Material; Impulse roller and stone; „Kupfer Beryllium, Saphir“ (be; Discharge roller and stone; not on the drawing; Maßstab / Scale; Behandlung / Treatment; Model v3.41.00 · 2026-10-27; Teil / Part; rollers

Isometric view, not to scale

Zeichnung Nr. / Drawing no.

„Kupfer Beryllium, Saphir“
(beryllium copper; sapphire)

Wempe Einheits-Chronometer

The Marine Chronometer working model

drawn from its solids by tools/drawbook.py

none on the drawing

Impulse and discharge rollers (Heberolle, Auslöserolle)

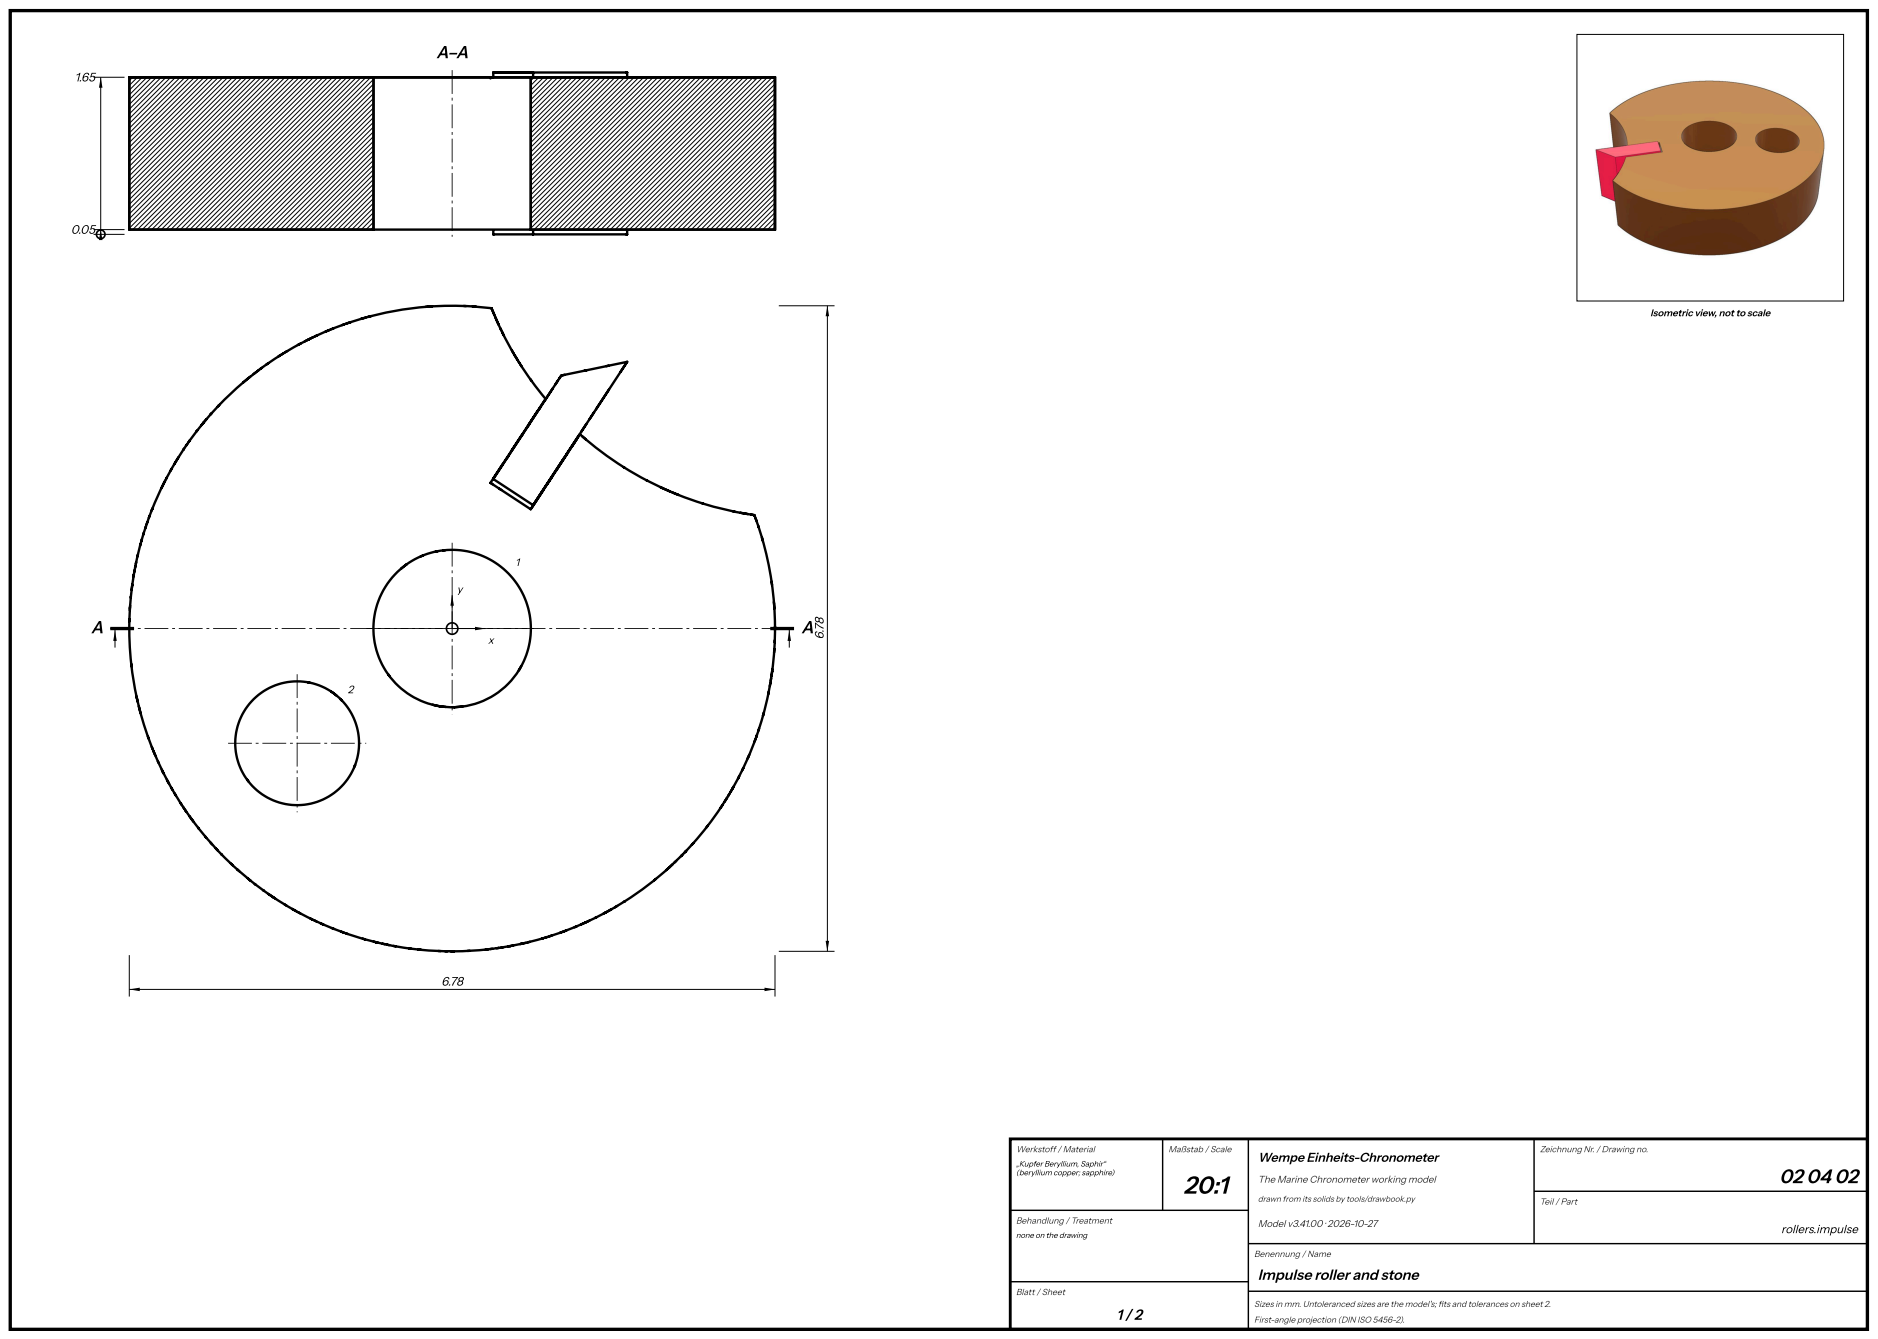
[picture p386: page 149]
Werkstoff / Material; Maßstab / Scale; Behandlung / Treatment; Model v3.41.00 · 2026-10-27; Teil / Part; rollers.impulse

Isometric view, not to scale

Zeichnung Nr. / Drawing no.

„Kupfer Beryllium, Saphir“
(beryllium copper; sapphire)

Wempe Einheits-Chronometer

The Marine Chronometer working model

drawn from its solids by tools/drawbook.py

none on the drawing

Impulse roller and stone

## Impulse roller and stone — sheet 2

The beryllium-copper impulse roller and its sapphire impulse stone, set in shellac.

Parts list

Drawing | Name | Units | Material | Finish, heat treatment | Fit, as measured on the model
02 04 02 | Heberolle (impulse roller, beryllium copper; 05 04 03-1 in the coloured section) | 1 | „Kupfer Beryllium, Saphir“ (beryllium copper; sapphire) | none on the drawing | round 050402-1 (press): 1.591 mm, least gap 0.0054
05 04 03-2 | Hebestein (impulse stone, sapphire) | 1 | not on the drawing | | not measured on the model: see its function, Receives the escape wheel's impulse.

What it does (02 04 02). Carries the impulse stone, which the escape wheel pushes.

What it does (05 04 03-2). Receives the escape wheel's impulse.

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

the face seen in the plan (the top). Thickness 1.70.

Holes

Hole | x | y | Size
1 | 0.00 | 0.00 | Ø 1.65 through (1.60 thick at 0.05-1.65)
2 | -1.63 | -1.20 | Ø 1.30 through (1.60 thick at 0.05-1.65)

Contourin the plan

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

radius.

Contour | # | Element | From x, y | To x, y | Centre x, y | R
Outline | 1 | arc clockwise | -3.09, -1.40 | 0.41, 3.36 | 0.00, 0.00 | 3.39
Outline | 2 | arc anticlockwise | 0.41, 3.36 | 0.98, 2.41 | 3.66, 4.66 | 3.50
Outline | 3 | line | 0.98, 2.41 | 0.40, 1.53
Outline | 4 | line | 0.40, 1.53 | 0.83, 1.25
Outline | 5 | line | 0.83, 1.25 | 1.34, 2.04
Outline | 6 | arc anticlockwise | 1.34, 2.04 | 3.17, 1.19 | 3.67, 4.66 | 3.50
Outline | 7 | arc clockwise | 3.17, 1.19 | -3.09, -1.40 | 0.00, 0.00 | 3.39
Outline | 8 | line | 1.15, 2.66 | 1.84, 2.80
Outline | 9 | line | 1.84, 2.80 | 0.85, 1.30
Outline | 10 | line | 0.85, 1.30 | 0.43, 1.57
Outline | 11 | line | 0.43, 1.57 | 1.15, 2.66

Levels

Faces in section A-A, from the bottom face: 0.05, 1.65.

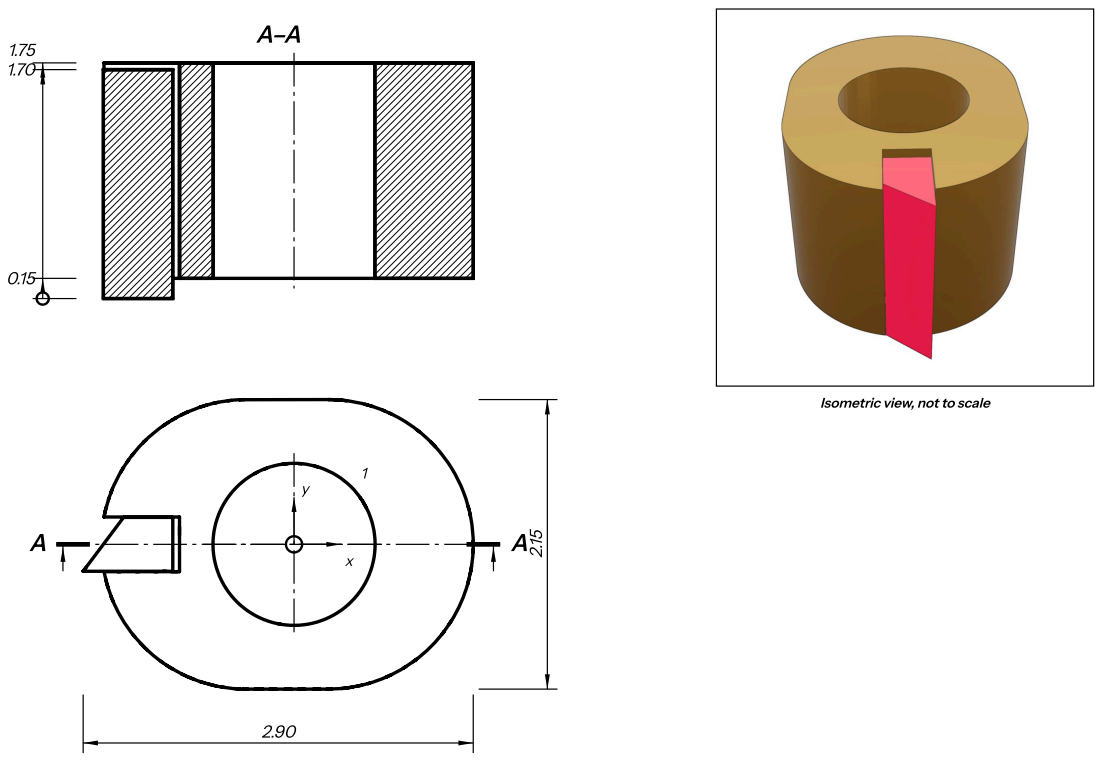
[picture p387: page 151]
Werkstoff / Material; Maßstab / Scale; Behandlung / Treatment; Model v3.41.00 · 2026-10-27; Teil / Part; rollers.discharge

Isometric view, not to scale

Zeichnung Nr. / Drawing no.

not on the drawing

Wempe Einheits-Chronometer

The Marine Chronometer working model

drawn from its solids by tools/drawbook.py

Discharge roller and stone

## Discharge roller and stone — sheet 2

The small collar and its discharge stone that work the gold spring.

Parts list

Drawing | Name | Units | Material | Finish, heat treatment | Fit, as measured on the model
05 04 04-1 | Auslöserolle (discharge roller) | 1 | not on the drawing | | round 050402-1 (press): 1.591 mm, least gap 0.0034
05 04 04-2 | Auslösestein (discharge stone) | 1 | not on the drawing | | not measured on the model: see its function, Lifts the detent through the gold spring on one swing; passes it on the other.

What it does (05 04 04-1). Carries the discharge stone.

What it does (05 04 04-2). Lifts the detent through the gold spring on one swing; passes it on the other.

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

the face seen in the plan (the top). Thickness 1.75.

Holes

Hole | x | y | Size
1 | 0.00 | 0.00 | Ø 1.20 through (1.60 thick at 0.15-1.75)

Contourin the plan

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

radius.

Contour | # | Element | From x, y | To x, y | Centre x, y | R
Outline | 1 | arc clockwise | -1.21, -0.65 | -1.41, -0.20 | -0.36, 0.00 | 1.07
Outline | 2 | line | -1.41, -0.20 | -0.85, -0.20
Outline | 3 | line | -0.85, -0.20 | -0.85, 0.20
Outline | 4 | line | -0.85, 0.20 | -1.41, 0.20
Outline | 5 | arc clockwise | -1.41, 0.20 | -0.36, 1.07 | -0.36, 0.00 | 1.07
Outline | 6 | arc clockwise | -0.36, 1.07 | 0.55, 1.03 | -0.02, -1.81 | 2.91
Outline | 7 | arc clockwise | 0.55, 1.03 | 0.26, -1.07 | 0.26, 0.00 | 1.08
Outline | 8 | arc clockwise | 0.26, -1.07 | -0.65, -1.03 | -0.08, 1.81 | 2.91
Outline | 9 | arc clockwise | -0.65, -1.03 | -1.21, -0.65 | -0.35, 0.00 | 1.08
Outline | 10 | line | -1.27, 0.20 | -0.90, 0.20
Outline | 11 | line | -0.90, 0.20 | -0.90, -0.20
Outline | 12 | line | -0.90, -0.20 | -1.57, -0.20
Outline | 13 | line | -1.57, -0.20 | -1.27, 0.20

Levels

Faces in section A-A, from the bottom face: 0.15, 1.70, 1.75.

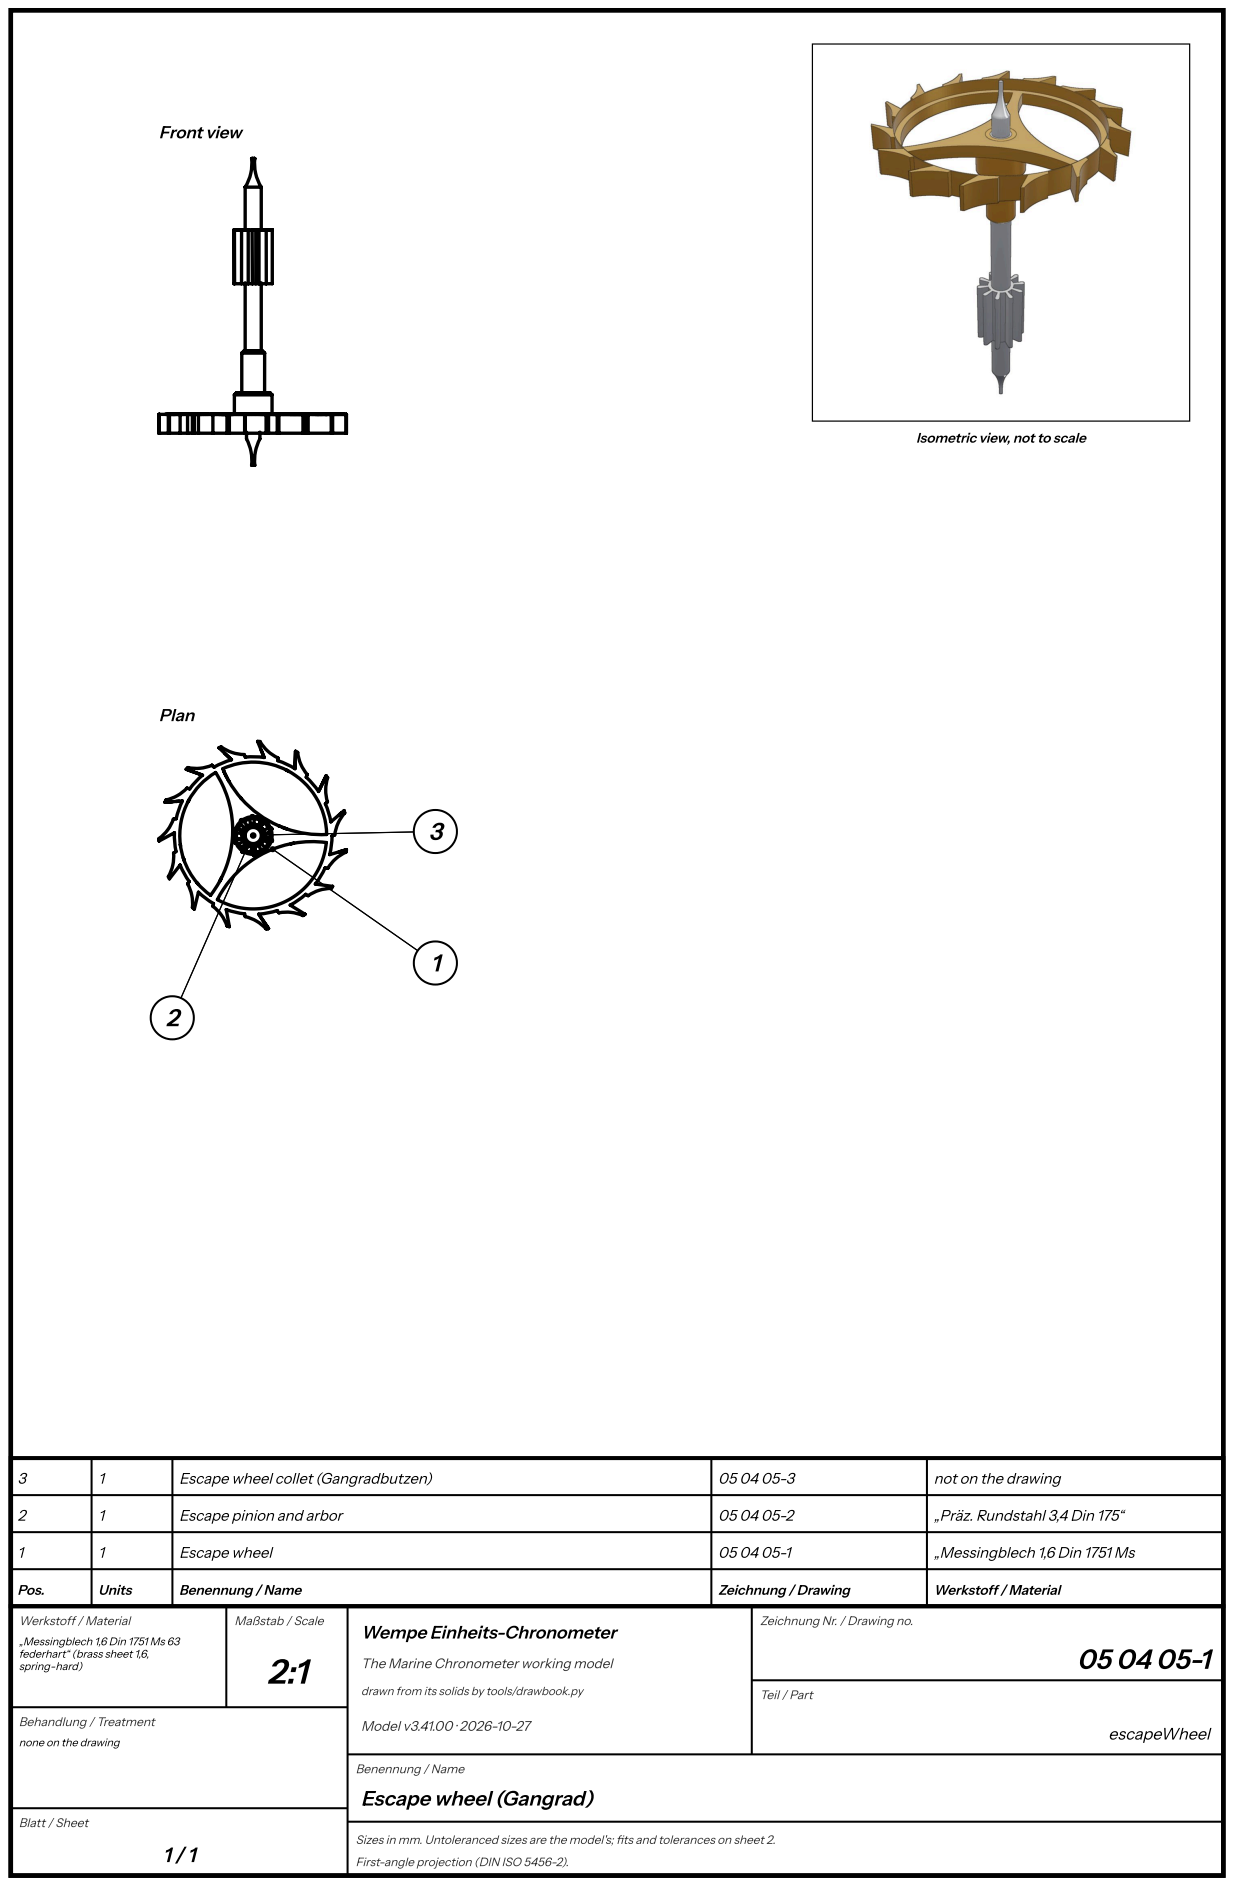
[picture p388: page 153]
Front view; Plan; Pos.; Units; Benennung / Name; Zeichnung / Drawing; Werkstoff / Material; Escape wheel; „Messingblech 1,6 Din 1751 Ms; Escape pinion and arbor; „Präz. Rundstahl 3,4 Din 175“; Escape wheel collet (Gangradbutzen); not on the drawing; Maßstab / Scale; Behandlung / Treatment; Model v3.41.00 · 2026-10-27; Teil / Part; escapeWheel

Isometric view, not to scale

Zeichnung Nr. / Drawing no.

„Messingblech 1,6 Din 1751 Ms 63
federhart“ (brass sheet1,6,
spring-hard)

Wempe Einheits-Chronometer

The Marine Chronometer working model

drawn from its solids by tools/drawbook.py

none on the drawing

Escape wheel (Gangrad)

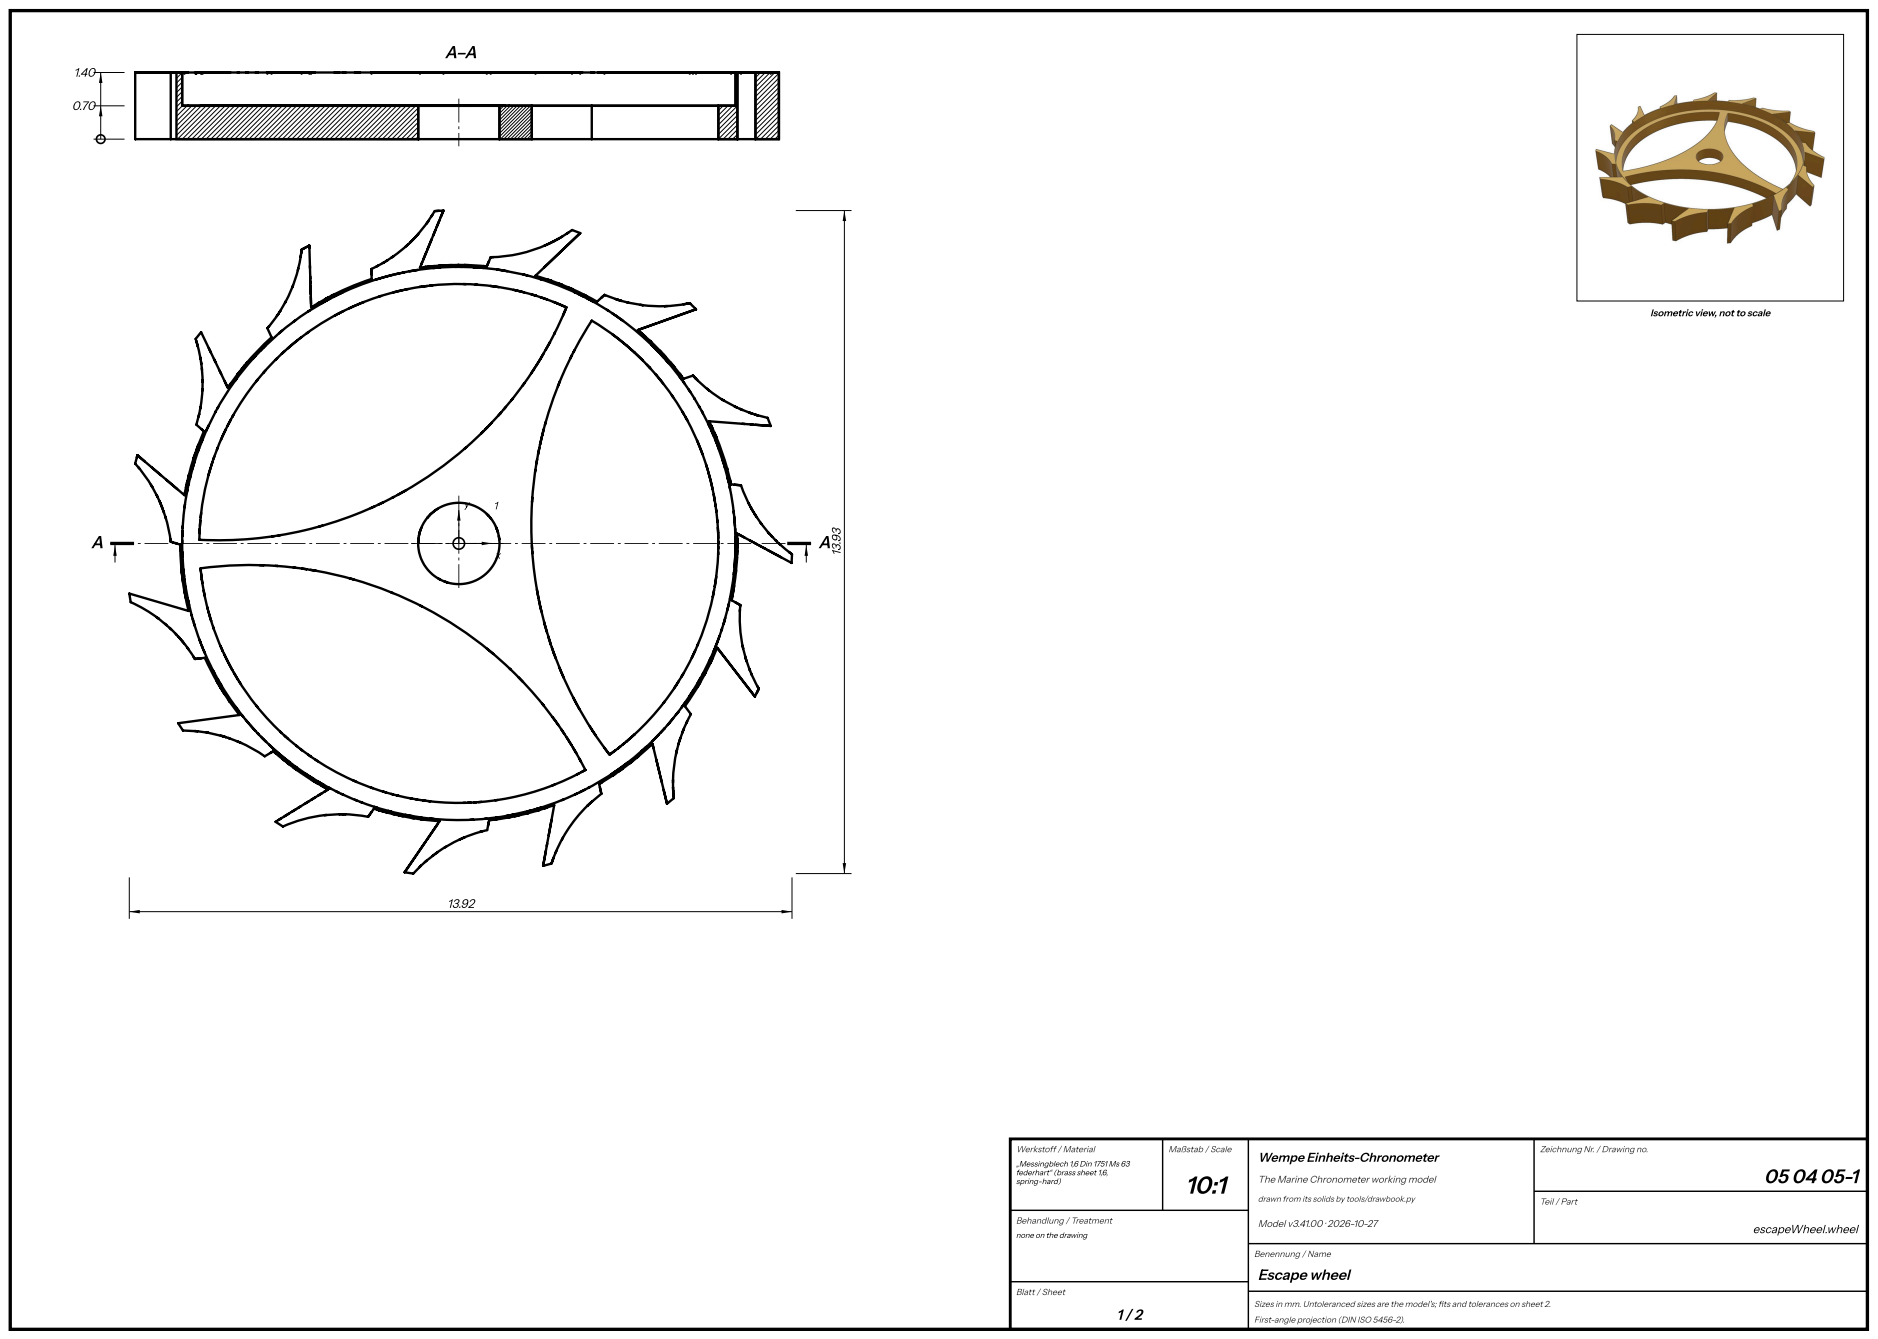
[picture p389: page 154]
Werkstoff / Material; Maßstab / Scale; Behandlung / Treatment; Model v3.41.00 · 2026-10-27; Teil / Part; escapeWheel.wheel; Escape wheel

Isometric view, not to scale

Zeichnung Nr. / Drawing no.

„Messingblech 1,6 Din 1751 Ms 63
federhart“ (brass sheet1,6,
spring-hard)

Wempe Einheits-Chronometer

The Marine Chronometer working model

drawn from its solids by tools/drawbook.py

none on the drawing

## Escape wheel — sheet 2

The 15-tooth escape wheel, just under the top plate, held by the locking stone between impulses. Released, it gives the

balance’s impulse stone a push through about 20 degrees and comes to rest on the next tooth: a tooth every half second,

so its pinion turns the seconds wheel once a minute.

Parts list

Drawing | Name | Units | Material | Finish, heat treatment | Fit, as measured on the model
05 04 05-1 | Gangrad (escape wheel, 15 teeth) | 1 | „Messingblech 1,6 Din 1751 Ms 63 federhart“ (brass sheet 1,6, spring-hard) | none on the drawing | round 050405-3 (press): 0.693 mm, least gap 0.0065

What it does (05 04 05-1). Locked on the detent's stone between impulses, it gives the balance its impulse.

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

the face seen in the plan (the top). Thickness 1.40.

Holes

Hole | x | y | Size
1 | 0.00 | 0.00 | Ø 1.71 through (0.70 thick at 0.00-0.70)

Contourin the plan

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

radius.

Contour | # | Element | From x, y | To x, y | Centre x, y | R
Outline | 1 | arc anticlockwise | -6.55, -1.41 | -6.89, -1.23 | -8.11, -3.97 | 3.00
Outline | 2 | line | -6.89, -1.23 | -6.92, -1.05
Outline | 3 | line | -6.92, -1.05 | -5.68, -1.42
Outline | 4 | arc clockwise | -5.68, -1.42 | -5.85, -0.03 | 0.00, 0.00 | 5.85
Outline | 5 | line | -5.85, -0.03 | -6.05, 0.04
Outline | 6 | arc anticlockwise | -6.05, 0.04 | -6.80, 1.68 | -9.03, -0.33 | 3.00
Outline | 7 | line | -6.80, 1.68 | -6.75, 1.85
Outline | 8 | line | -6.75, 1.85 | -5.76, 1.01
Outline | 9 | arc clockwise | -5.76, 1.01 | -5.35, 2.36 | 0.00, 0.00 | 5.85
Outline | 10 | line | -5.35, 2.36 | -5.51, 2.49
Outline | 11 | arc anticlockwise | -5.51, 2.49 | -5.53, 4.30 | -8.38, 3.37 | 3.00
Outline | 12 | line | -5.53, 4.30 | -5.41, 4.44
Outline | 13 | line | -5.41, 4.44 | -4.85, 3.27
Outline | 14 | arc clockwise | -4.85, 3.27 | -3.93, 4.33 | 0.00, 0.00 | 5.85
Outline | 15 | line | -3.93, 4.33 | -4.02, 4.52
Outline | 16 | arc anticlockwise | -4.02, 4.52 | -3.30, 6.17 | -6.29, 6.49 | 3.00
Outline | 17 | line | -3.30, 6.17 | -3.14, 6.26
Outline | 18 | line | -3.14, 6.26 | -3.10, 4.96
Outline | 19 | arc clockwise | -3.10, 4.96 | -1.83, 5.56 | 0.00, 0.00 | 5.85
Outline | 20 | line | -1.83, 5.56 | -1.83, 5.77
Outline | 21 | arc anticlockwise | -1.83, 5.77 | -0.51, 6.98 | -3.10, 8.48 | 3.00
Outline | 22 | line | -0.51, 6.98 | -0.32, 6.99
Outline | 23 | line | -0.32, 6.99 | -0.82, 5.79
Outline | 24 | arc clockwise | -0.82, 5.79 | 0.59, 5.82 | 0.00, 0.00 | 5.85

Outline | 25 | line | 0.59, 5.82 | 0.67, 6.01
Outline | 26 | arc anticlockwise | 0.67, 6.01 | 2.38, 6.58 | 0.62, 9.01 | 3.00
Outline | 27 | line | 2.38, 6.58 | 2.55, 6.52
Outline | 28 | line | 2.55, 6.52 | 1.61, 5.62
Outline | 29 | arc clockwise | 1.61, 5.62 | 2.90, 5.08 | 0.00, 0.00 | 5.85
Outline | 30 | line | 2.90, 5.08 | 3.06, 5.22
Outline | 31 | arc anticlockwise | 3.06, 5.22 | 4.85, 5.05 | 4.23, 7.98 | 3.00
Outline | 32 | line | 4.85, 5.05 | 4.98, 4.92
Outline | 33 | line | 4.98, 4.92 | 3.76, 4.48
Outline | 34 | arc clockwise | 3.76, 4.48 | 4.72, 3.46 | 0.00, 0.00 | 5.85
Outline | 35 | line | 4.72, 3.46 | 4.92, 3.53
Outline | 36 | arc anticlockwise | 4.92, 3.53 | 6.48, 2.64 | 7.11, 5.57 | 3.00
Outline | 37 | line | 6.48, 2.64 | 6.55, 2.47
Outline | 38 | line | 6.55, 2.47 | 5.26, 2.57
Outline | 39 | arc clockwise | 5.26, 2.57 | 5.72, 1.24 | 0.00, 0.00 | 5.85
Outline | 40 | line | 5.72, 1.24 | 5.93, 1.22
Outline | 41 | arc anticlockwise | 5.93, 1.22 | 7.00, -0.23 | 8.76, 2.20 | 3.00
Outline | 42 | line | 7.00, -0.23 | 6.99, -0.41
Outline | 43 | line | 6.99, -0.41 | 5.85, 0.21
Outline | 44 | arc clockwise | 5.85, 0.21 | 5.73, -1.19 | 0.00, 0.00 | 5.85
Outline | 45 | line | 5.73, -1.19 | 5.91, -1.29
Outline | 46 | arc anticlockwise | 5.91, -1.29 | 6.30, -3.05 | 8.90, -1.55 | 3.00
Outline | 47 | line | 6.30, -3.05 | 6.22, -3.22
Outline | 48 | line | 6.22, -3.22 | 5.42, -2.19
Outline | 49 | arc clockwise | 5.42, -2.19 | 4.75, -3.42 | 0.00, 0.00 | 5.85
Outline | 50 | line | 4.75, -3.42 | 4.87, -3.59
Outline | 51 | arc anticlockwise | 4.87, -3.59 | 4.51, -5.35 | 7.50, -5.04 | 3.00
Outline | 52 | line | 4.51, -5.35 | 4.37, -5.47
Outline | 53 | line | 4.37, -5.47 | 4.07, -4.21
Outline | 54 | arc clockwise | 4.07, -4.21 | 2.95, -5.05 | 0.00, 0.00 | 5.85
Outline | 55 | line | 2.95, -5.05 | 2.99, -5.26
Outline | 56 | arc anticlockwise | 2.99, -5.26 | 1.95, -6.72 | 4.80, -7.65 | 3.00
Outline | 57 | line | 1.95, -6.72 | 1.77, -6.77
Outline | 58 | line | 1.77, -6.77 | 2.00, -5.50
Outline | 59 | arc clockwise | 2.00, -5.50 | 0.64, -5.82 | 0.00, 0.00 | 5.85
Outline | 60 | line | 0.64, -5.82 | 0.60, -6.02
Outline | 61 | arc anticlockwise | 0.60, -6.02 | -0.96, -6.93 | 1.27, -8.94 | 3.00
Outline | 62 | line | -0.96, -6.93 | -1.14, -6.91
Outline | 63 | line | -1.14, -6.91 | -0.41, -5.84
Outline | 64 | arc clockwise | -0.41, -5.84 | -1.78, -5.57 | 0.00, 0.00 | 5.85
Outline | 65 | line | -1.78, -5.57 | -1.91, -5.74
Outline | 66 | arc anticlockwise | -1.91, -5.74 | -3.69, -5.95 | -2.48, -8.69 | 3.00
Outline | 67 | line | -3.69, -5.95 | -3.85, -5.85
Outline | 68 | line | -3.85, -5.85 | -2.74, -5.17
Outline | 69 | arc clockwise | -2.74, -5.17 | -3.90, -4.36 | 0.00, 0.00 | 5.85
Outline | 70 | line | -3.90, -4.36 | -4.08, -4.47
Outline | 71 | arc anticlockwise | -4.08, -4.47 | -5.79, -3.93 | -5.80, -6.93 | 3.00
Outline | 72 | line | -5.79, -3.93 | -5.89, -3.78

Outline | 73 | line | -5.89, -3.78 | -4.61, -3.60
Outline | 74 | arc clockwise | -4.61, -3.60 | -5.33, -2.40 | 0.00, 0.00 | 5.85
Outline | 75 | line | -5.33, -2.40 | -5.54, -2.43
Outline | 76 | arc anticlockwise | -5.54, -2.43 | -6.55, -1.41 | -8.11, -3.97 | 3.00
Cut-out 1 | 77 | arc anticlockwise | 3.52, 4.16 | 2.79, 4.68 | 0.00, 0.00 | 5.45
Cut-out 1 | 78 | arc anticlockwise | 2.79, 4.68 | 3.17, -4.44 | 9.42, 0.39 | 7.90
Cut-out 1 | 79 | arc anticlockwise | 3.17, -4.44 | 3.52, 4.16 | 0.00, 0.00 | 5.45
Cut-out 2 | 80 | arc anticlockwise | -0.01, -1.77 | -5.42, -0.52 | -4.38, -8.35 | 7.90
Cut-out 2 | 81 | arc anticlockwise | -5.42, -0.52 | 2.66, -4.76 | 0.00, 0.00 | 5.45
Cut-out 2 | 82 | arc anticlockwise | 2.66, -4.76 | -0.01, -1.77 | -4.38, -8.35 | 7.90
Cut-out 3 | 83 | arc anticlockwise | 0.08, 5.45 | -5.45, 0.08 | 0.00, 0.00 | 5.45
Cut-out 3 | 84 | arc anticlockwise | -5.45, 0.08 | 2.26, 4.96 | -5.05, 7.97 | 7.90
Cut-out 3 | 85 | arc anticlockwise | 2.26, 4.96 | 0.08, 5.45 | 0.00, 0.00 | 5.45

Levels

Faces in section A-A, from the bottom face: 0.70, 1.40.

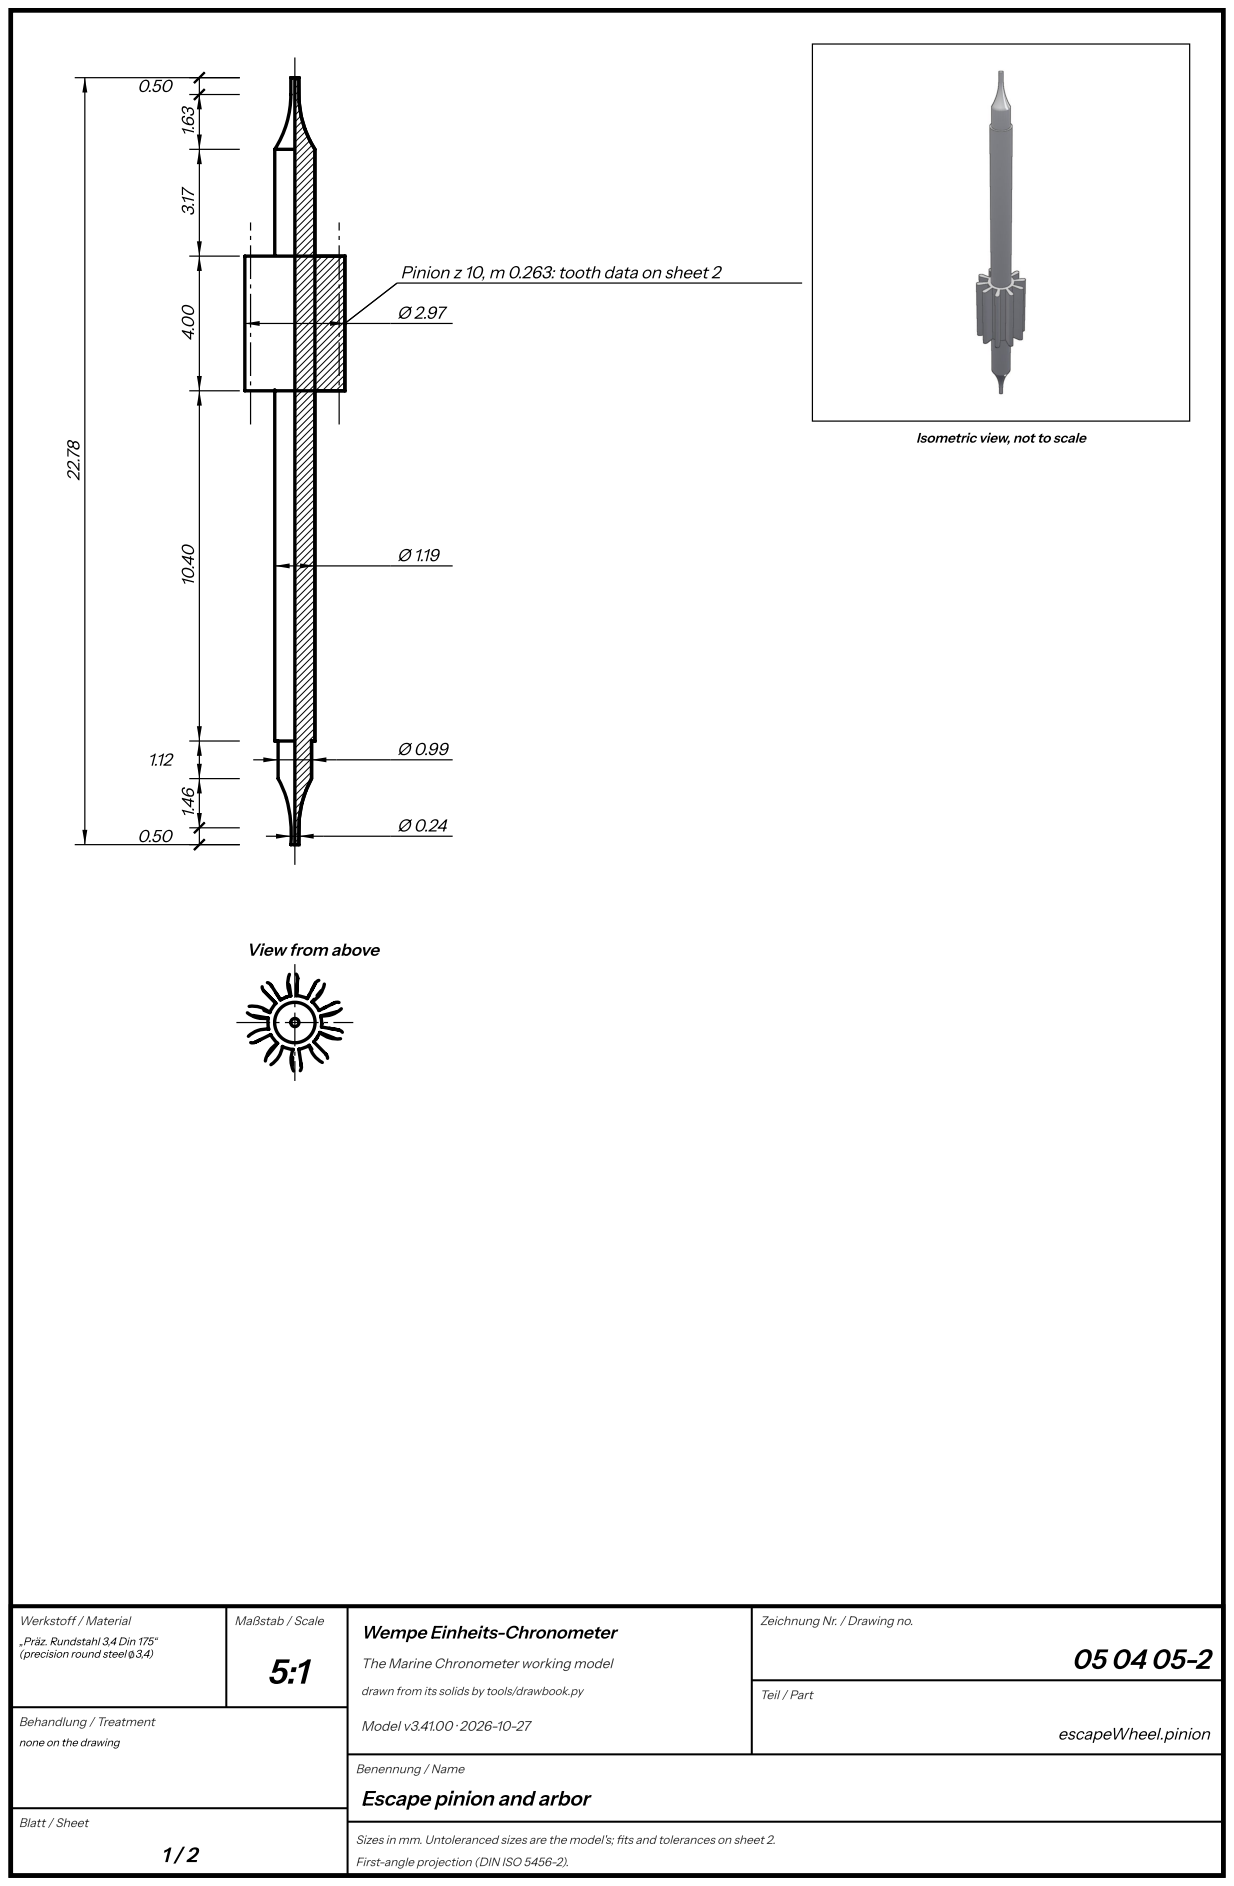
[picture p390: page 158]
Werkstoff / Material; Maßstab / Scale; Behandlung / Treatment; Model v3.41.00 · 2026-10-27; Teil / Part; escapeWheel.pinion

Pinion z 10, m 0.263: tooth data on sheet 2

Isometric view, not to scale

View from above

Zeichnung Nr. / Drawing no.

„Präz. Rundstahl 3,4 Din 175“
(precision round steel ∅3,4)

Wempe Einheits-Chronometer

The Marine Chronometer working model

drawn from its solids by tools/drawbook.py

none on the drawing

Escape pinion and arbor

## Escape pinion and arbor — sheet 2

The steel arbor with its pinion of 10 leaves, which the seconds wheel drives.

Parts list

Drawing | Name | Units | Material | Finish, heat treatment | Fit, as measured on the model
05 04 05-2 | Gangtrieb (escape pinion, z 10, m 0.263, and arbor) | 1 | „Präz. Rundstahl 3,4 Din 175“ (precision round steel ∅3,4) | none on the drawing | in 050406-1.eu (run): 0.141 mm, least gap 0.0189; in 050406-1.el (run): 0.141 mm, least gap 0.0121; endshake 0.060 mm (050408-1.el / 050408-1.eu)

What it does (05 04 05-2). The arbor and pinion; driven by the seconds wheel. As first drawn (the page's Variants) 05

04_7.1's arbor of 4.4.41 (050408 bis 10, renumbered 05 04 05 on 05 04_7.2), the wheel 1.4 nearer the top plate.

Turned about its axis; length 22.78, largest Ø 2.87. Diameters: Ø 0.24, Ø 0.99, Ø 1.19, Ø 2.97. Shoulders from the lower end:

0.00, 0.50, 1.96, 3.08, 13.48, 17.48, 20.65, 22.28, 22.78.

Leaves 13.48-17.48 from the lower end, pitch Ø 2.63; their form is the view from the end, drawn at the sheet's scale.

Teeth

Number | Module | Tip Ø | Root Ø
10 | 0.263 | 2.97

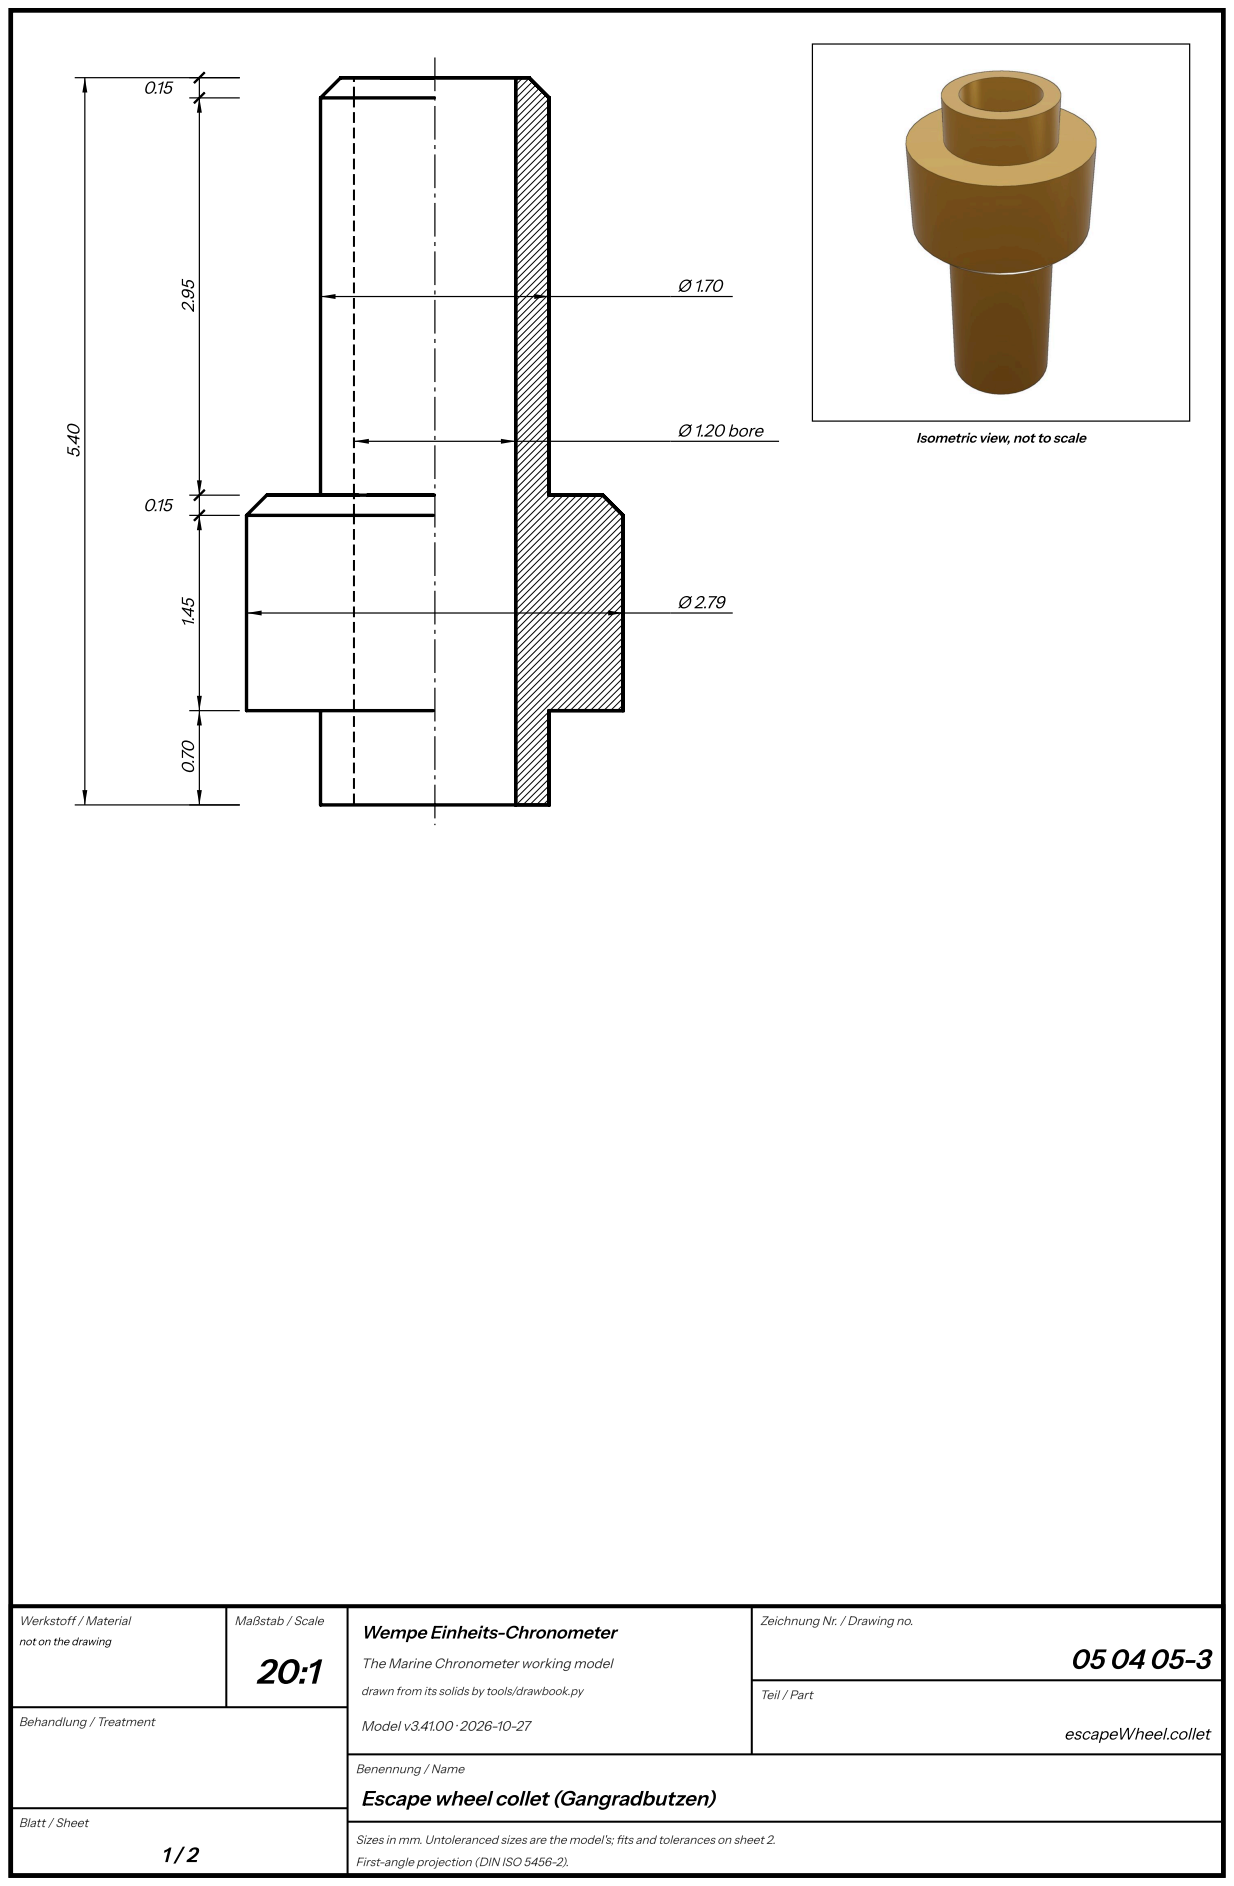
[picture p391: page 160]
Ø 1.20 bore; Werkstoff / Material; Maßstab / Scale; Behandlung / Treatment; Model v3.41.00 · 2026-10-27; Teil / Part; escapeWheel.collet

Isometric view, not to scale

Zeichnung Nr. / Drawing no.

not on the drawing

Wempe Einheits-Chronometer

The Marine Chronometer working model

drawn from its solids by tools/drawbook.py

Escape wheel collet (Gangradbutzen)

## Escape wheel collet (Gangradbutzen) — sheet 2

The brass collet the wheel is pressed on.

Parts list

Drawing | Name | Units | Material | Finish, heat treatment | Fit, as measured on the model
05 04 05-3 | Gangradbutzen (escape wheel collet; 05 04 10 on 05 04_7.2) | 1 | not on the drawing | | round 050405-2 (press): 5.377 mm, least gap 0.0048

What it does (05 04 05-3). The brass collet the wheel is pressed on. As first drawn 05 04_7.1's: a cone Ø 3.0, then a pipe Ø

1.8 to 5 over the wheel.

Turned about its axis; length 5.40, largest Ø 2.80. Diameters: Ø 1.70, Ø 2.79; bores Ø 1.20. Shoulders from the lower end:

0.00, 0.70, 2.15, 2.30, 5.25, 5.40.

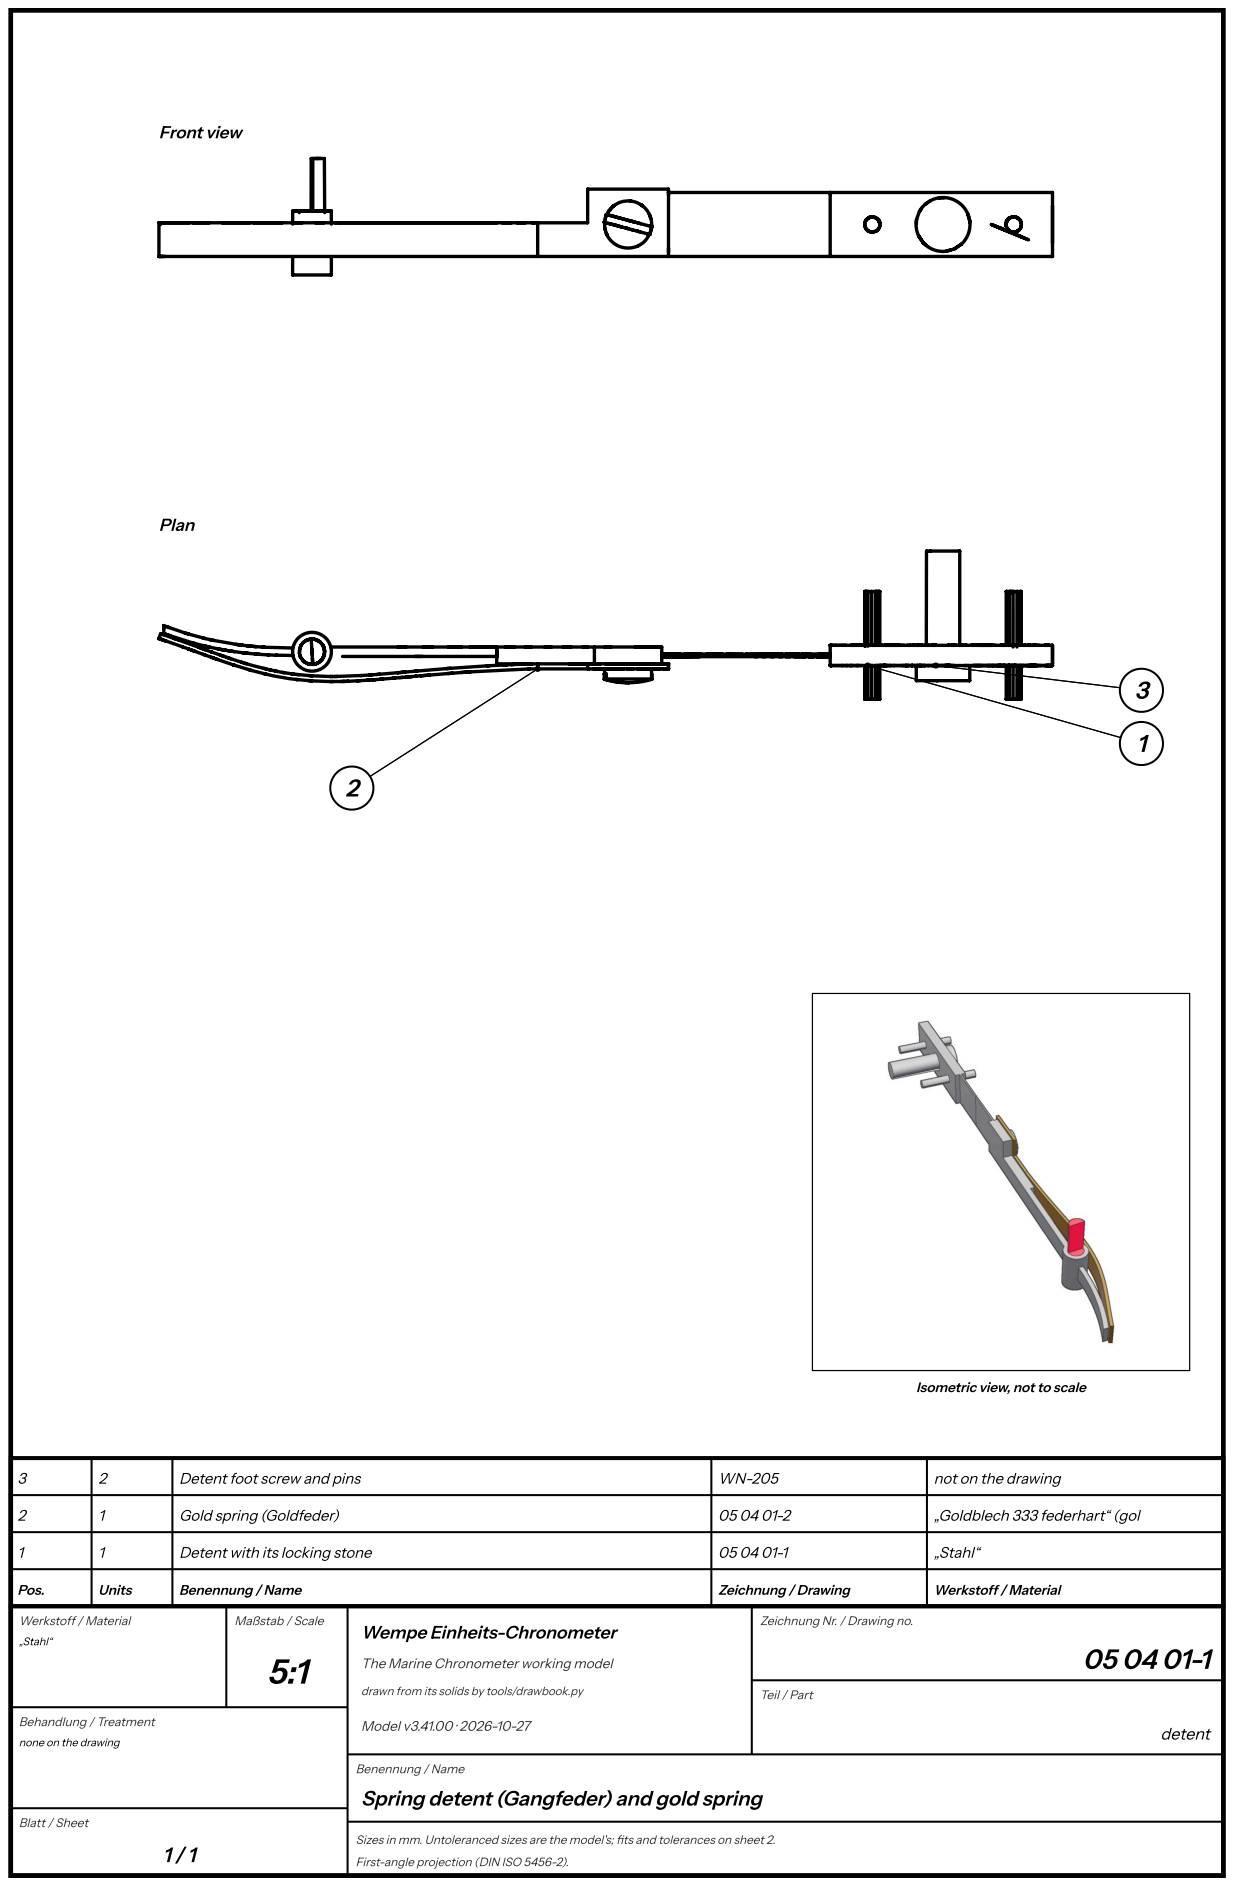
[picture p392: page 162]
Front view; Plan; Pos.; Units; Benennung / Name; Zeichnung / Drawing; Werkstoff / Material; Detent with its locking stone; „Stahl“; Gold spring (Goldfeder); „Goldblech 333 federhart“ (gol; Detent foot screw and pins; not on the drawing; Maßstab / Scale; Behandlung / Treatment; Model v3.41.00 · 2026-10-27; Teil / Part; detent

Isometric view, not to scale

Zeichnung Nr. / Drawing no.

Wempe Einheits-Chronometer

The Marine Chronometer working model

drawn from its solids by tools/drawbook.py

none on the drawing

Spring detent (Gangfeder) and gold spring

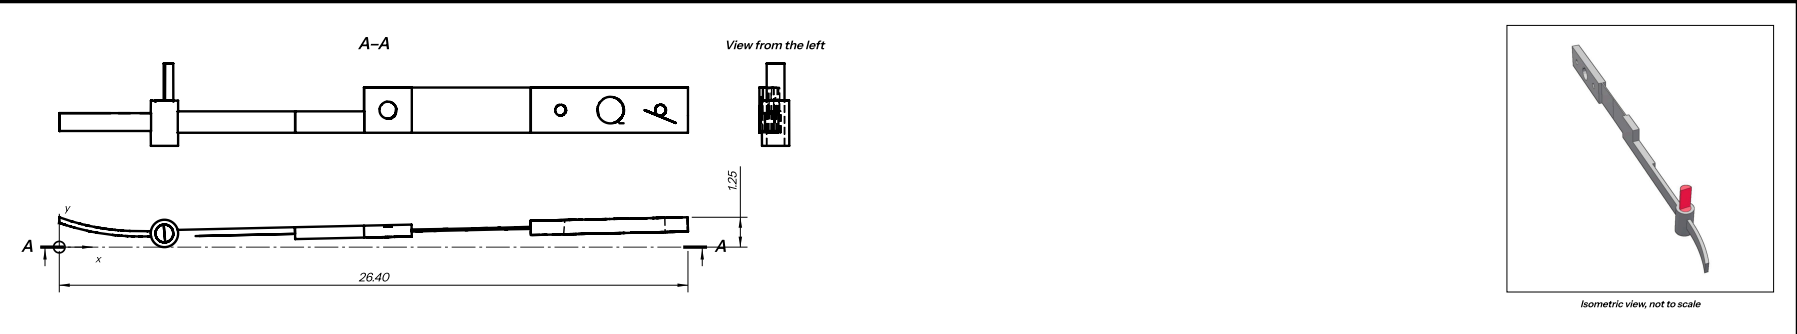
[picture p393: page 163]
Werkstoff / Material; „Stahl“; Maßstab / Scale; Behandlung / Treatment; Model v3.41.00 · 2026-10-27; Teil / Part; detent.detent

View from the left

Isometric view, not to scale

Zeichnung Nr. / Drawing no.

Wempe Einheits-Chronometer

The Marine Chronometer working model

drawn from its solids by tools/drawbook.py

none on the drawing

Detent with its locking stone

## Detent with its locking stone — sheet 2

The detent: a steel blade on a thin spring, clamped by its foot to the block. The locking stone in its pipe holds a tooth of the

escape wheel. On one swing the discharge stone pushes the gold spring against the detent’s horn and lifts the detent

through a quarter of a millimetre, freeing the wheel; on the other it only bends the gold spring aside.

Parts list

Drawing | Name | Units | Material | Finish, heat treatment | Fit, as measured on the model
05 04 01-1 | Gangfeder (spring detent, drawing 1436) | 1 | „Stahl“ | none on the drawing | on 050401-4: 0 mm
05 04 01-3 | Ruhestein (locking stone) | 1 | not on the drawing | | not measured on the model: see its function, Locks each tooth of the escape wheel.

Tolerance (05 04 01-1). The detent spring (1436's 0.07, 0.09 at its ends): any thickness to 0.204 mm keeps the swing in the

band; in time (its fall back before the next tooth) 0.063-0.100 mm as the uniform equivalent of the drawn 0.079. Its preload

against the banking 0.8 g, at least 0.64 g (a knock) and under 0.85 g (past it the stone catches the escaping tooth's back).

Test on the bench (05 04 01-1). The detent rings, the detent made with its gold spring on, before it goes in: 92 Hz with the

spring as drawn (1436's 0.09 at its ends and "0,07" at its middle, as stiff as 0.0792 mm throughout); 68-120 Hz for a spring

0.063-0.100 mm thick, half to twice the drawn stiffness, over which the detent is home before the next tooth (dynamics.js

--model wempe). The pitch goes nearly as the thickness to the 1.5 (0.050 mm 49 Hz, 0.060 mm 63 Hz, 0.063 mm 68 Hz,

0.070 mm 78 Hz, 0.079 mm 92 Hz, 0.090 mm 108 Hz, 0.100 mm 120 Hz, 0.110 mm 131 Hz: wempe_tripping.js's frame

clamped at the foot), so it measures the spring's section, which no figure on 1436 settles (its "0,09" would ring 108 Hz). The

gold spring rings near 213 Hz: the detent's own is the lower.

What it does (05 04 01-1). Holds the escape wheel on its locking stone; lifted on one swing by the discharge stone

through the gold spring.

Tolerance (05 04 01-3). The depth of lock: 0.235 mm as drawn (05 04_1); it unlocks to 0.281 and holds against the stone's

ringing down to 0.084 (wempe_tolerances.js, the build's ring 0.042).

What it does (05 04 01-3). Locks each tooth of the escape wheel.

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

drawn; depths from the face seen in the plan (the top). Thickness 3.46.

Contourin the plan

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

radius.

Contour | # | Element | From x, y | To x, y | Centre x, y | R
Outline | 1 | line | 19.81, 0.51 | 19.80, 0.76
Outline | 2 | arc anticlockwise | 19.80, 0.76 | 14.80, 0.65 | 24.26, -311.72 | 312.51
Outline | 3 | line | 14.80, 0.65 | 14.80, 0.74
Outline | 4 | arc anticlockwise | 14.80, 0.74 | 19.80, 0.85 | 10.34, 313.19 | 312.49
Outline | 5 | line | 19.80, 0.85 | 19.79, 1.11
Outline | 6 | line | 19.79, 1.11 | 26.39, 1.25
Outline | 7 | line | 26.39, 1.25 | 26.40, 0.65
Outline | 8 | line | 26.40, 0.65 | 19.81, 0.51
Cut-out 1 | 9 | line | 19.81, 0.51 | 20.83, 0.67
Cut-out 1 | 10 | line | 20.83, 0.67 | 19.81, 0.51
Cut-out 2 | 11 | line | 19.81, 0.51 | 20.82, 0.91
Cut-out 2 | 12 | line | 20.82, 0.91 | 19.81, 0.51
Cut-out 3 | 13 | line | 23.73, 1.20 | 23.73, 1.20
Cut-out 3 | 14 | line | 23.73, 1.20 | 23.73, 1.20

Cut-out 4 | 15 | line | 24.84, 1.22 | 24.84, 1.22
Cut-out 4 | 16 | line | 24.84, 1.22 | 24.84, 1.22
Cut-out 5 | 17 | line | 26.39, 1.25 | 25.47, 1.12
Cut-out 5 | 18 | line | 25.47, 1.12 | 26.39, 1.25
Cut-out 6 | 19 | line | 26.39, 1.25 | 25.47, 1.09
Cut-out 6 | 20 | line | 25.47, 1.09 | 26.39, 1.25
Cut-out 7 | 21 | line | 26.39, 1.25 | 25.47, 0.99
Cut-out 7 | 22 | line | 25.47, 0.99 | 26.39, 1.25
Cut-out 8 | 23 | line | 25.02, 1.06 | 23.70, 0.87
Cut-out 8 | 24 | line | 23.70, 0.87 | 25.02, 1.06
Cut-out 9 | 25 | line | 24.87, 1.22 | 23.69, 1.06
Cut-out 9 | 26 | line | 23.69, 1.06 | 24.87, 1.22
Cut-out 10 | 27 | line | 22.60, 0.71 | 21.43, 0.54
Cut-out 10 | 28 | line | 21.43, 0.54 | 22.60, 0.71
Cut-out 11 | 29 | line | 21.28, 0.74 | 22.60, 0.96
Cut-out 11 | 30 | line | 22.60, 0.96 | 21.28, 0.74
Cut-out 12 | 31 | line | 22.54, 1.17 | 22.54, 1.17
Cut-out 12 | 32 | arc anticlockwise | 22.54, 1.17 | 22.54, 1.17 | 17.89, 1.08 | 4.65
Cut-out 12 | 33 | line | 22.54, 1.17 | 22.54, 1.17
Cut-out 13 | 34 | line | 21.27, 0.90 | 22.29, 1.16
Cut-out 13 | 35 | line | 22.29, 1.16 | 21.27, 0.90
Cut-out 14 | 36 | line | 21.41, 1.14 | 21.27, 1.09
Cut-out 14 | 37 | line | 21.27, 1.09 | 21.41, 1.14
Cut-out 15 | 38 | arc anticlockwise | 21.27, 0.54 | 21.27, 0.54 | 20.54, 31.74 | 31.21
Cut-out 15 | 39 | arc anticlockwise | 21.27, 0.54 | 21.27, 0.54 | 20.53, 31.70 | 31.16
Outline | 40 | arc clockwise | 3.94, 0.26 | 3.85, 0.45 | 4.41, 0.57 | 0.57
Outline | 41 | arc clockwise | 3.85, 0.45 | 0.01, 1.02 | 3.40, 10.88 | 10.43
Outline | 42 | line | 0.01, 1.02 | 0.00, 1.25
Outline | 43 | arc anticlockwise | 0.00, 1.25 | 3.85, 0.67 | 3.40, 10.85 | 10.19
Outline | 44 | arc clockwise | 3.85, 0.67 | 4.97, 0.72 | 4.42, 0.58 | 0.57
Outline | 45 | line | 4.97, 0.72 | 9.90, 0.84
Outline | 46 | line | 9.90, 0.84 | 9.90, 0.56
Outline | 47 | line | 9.90, 0.56 | 4.98, 0.45
Outline | 48 | line | 4.98, 0.45 | 4.95, 0.36
Outline | 49 | arc clockwise | 4.95, 0.36 | 3.94, 0.26 | 4.42, 0.58 | 0.58
Outline | 50 | line | 9.90, 0.84 | 14.79, 0.95
Outline | 51 | line | 14.79, 0.95 | 14.81, 0.45
Outline | 52 | line | 14.81, 0.45 | 9.91, 0.34
Outline | 53 | line | 9.91, 0.34 | 9.90, 0.84
Cut-out 1 | 54 | line | 14.55, 0.44 | 14.58, 0.44
Cut-out 1 | 55 | line | 14.58, 0.44 | 14.55, 0.44
Outline | 56 | arc clockwise | 4.07, 0.73 | 4.38, 0.95 | 4.42, 0.58 | 0.37
Outline | 57 | line | 4.38, 0.95 | 4.48, 0.94
Outline | 58 | line | 4.48, 0.94 | 4.58, 0.91
Outline | 59 | line | 4.58, 0.91 | 4.66, 0.86
Outline | 60 | line | 4.66, 0.86 | 4.73, 0.77
Outline | 61 | line | 4.73, 0.77 | 4.78, 0.67
Outline | 62 | line | 4.78, 0.67 | 4.79, 0.56

O u tlin e | 6 3 | lin e | 4.7 9, 0.5 6 | 4.7 7, 0.4 6
O u tlin e | 6 4 | lin e | 4.7 7, 0.4 6 | 4.7 3, 0.3 7
O u tlin e | 6 5 | lin e | 4.7 3, 0.3 7 | 4.6 6, 0.2 9
O u tlin e | 6 6 | lin e | 4.6 6, 0.2 9 | 4.5 8, 0.2 4
O u tlin e | 6 7 | lin e | 4.5 8, 0.2 4 | 4.4 8, 0.2 1
O u tlin e | 6 8 | lin e | 4.4 8, 0.2 1 | 4.3 7, 0.2 0
O u tlin e | 6 9 | a r c clo c k wis e | 4.3 7, 0.2 0 | 4.0 7, 0.7 3 | 4.4 2, 0.5 8 | 0.3 8

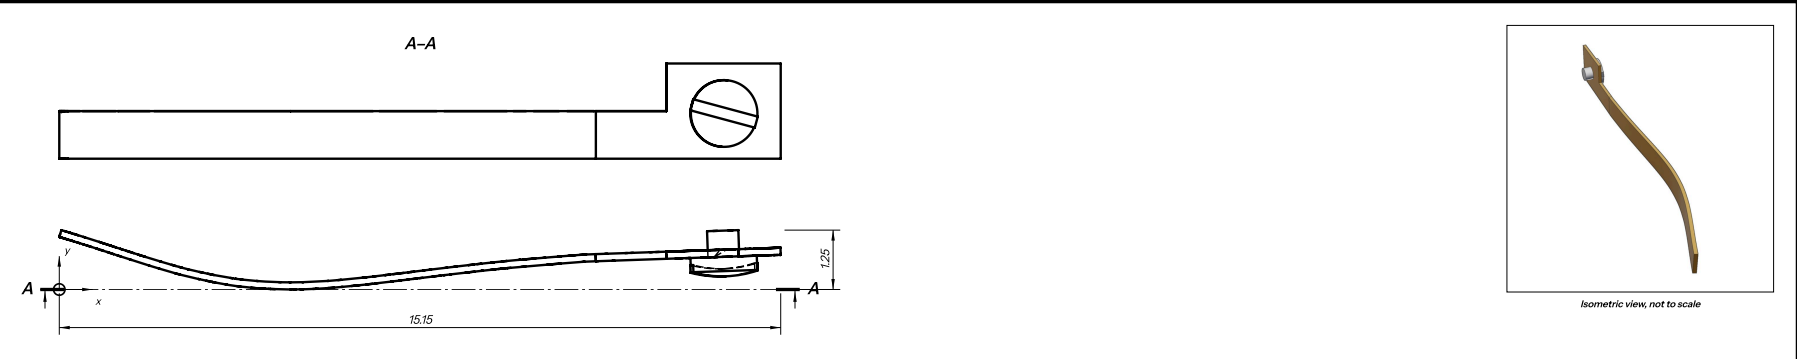
[picture p394: page 167]
Werkstoff / Material; Maßstab / Scale; Behandlung / Treatment; Model v3.41.00 · 2026-10-27; Teil / Part; detent.gold

Isometric view, not to scale

Zeichnung Nr. / Drawing no.

„Goldblech 333 federhart“ (gold
sheet, 333 fine (8 ct), spring-hard)

Wempe Einheits-Chronometer

The Marine Chronometer working model

drawn from its solids by tools/drawbook.py

surface ∇∇∇ (DIN 140: ▽ roughed, ▽▽ smoothed, ▽▽▽ fine,
▽▽▽▽ polished)

Gold spring (Goldfeder)

## Gold spring (Goldfeder) — sheet 2

The gold passing spring, screwed to the detent, resting on its horn.

Parts list

Drawing | Name | Units | Material | Finish, heat treatment | Fit, as measured on the model
05 04 01-2 | Goldfeder (gold passing spring) | 1 | „Goldblech 333 federhart“ (gold sheet, 333 fine (8 ct), spring-hard) | surface ∇∇∇ (DIN 140: ▽ roughed, ▽▽ smoothed, ▽▽▽ fine, ▽▽▽▽ polished) | on 050401-1: 0 mm
WN-14 | Schraube (WN-14), the gold spring's screw | 1 | not on the drawing | | in 050401-1 (tap): 0.391 mm, least gap 0.014

Tolerance (05 04 01-2). The gold spring: its stiffness hardly moves the swing (to 25.0 times the drawn, 0.439 mm); it

decides the lock's window instead, so make it to the build's thinned bend (its card).

What it does (05 04 01-2). Screwed to the detent, resting on its horn: the discharge stone lifts the detent through it on

one swing and bends it aside on the other.

What it does (WN-14). Holds the gold spring to the detent's square.

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

drawn; depths from the face seen in the plan (the top). Thickness 2.00.

Contourin the plan

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

radius.

Contour | # | Element | From x, y | To x, y | Centre x, y | R
Outline | 1 | arc clockwise | 3.07, 0.19 | 1.54, 0.61 | 6.03, 13.67 | 13.80
Outline | 2 | line | 1.54, 0.61 | 0.00, 1.10
Outline | 3 | line | 0.00, 1.10 | 0.04, 1.25
Outline | 4 | line | 0.04, 1.25 | 2.15, 0.58
Outline | 5 | arc anticlockwise | 2.15, 0.58 | 6.32, 0.24 | 4.93, 9.31 | 9.16
Outline | 6 | line | 6.32, 0.24 | 9.13, 0.57
Outline | 7 | line | 9.13, 0.57 | 10.20, 0.67
Outline | 8 | arc clockwise | 10.20, 0.67 | 11.24, 0.74 | 12.00, -16.49 | 17.25
Outline | 9 | line | 11.24, 0.74 | 13.62, 0.82
Outline | 10 | line | 13.62, 0.82 | 13.60, 1.22
Outline | 11 | line | 13.60, 1.22 | 14.26, 1.25
Outline | 12 | line | 14.26, 1.25 | 14.27, 0.85
Outline | 13 | line | 14.27, 0.85 | 15.14, 0.88
Outline | 14 | line | 15.14, 0.88 | 15.15, 0.73
Outline | 15 | line | 15.15, 0.73 | 14.65, 0.71
Outline | 16 | line | 14.65, 0.71 | 14.65, 0.56
Outline | 17 | line | 14.65, 0.56 | 14.66, 0.56
Outline | 18 | line | 14.66, 0.56 | 14.67, 0.40
Outline | 19 | arc clockwise | 14.67, 0.40 | 13.25, 0.35 | 13.88, 2.80 | 2.53
Outline | 20 | line | 13.25, 0.35 | 13.25, 0.51
Outline | 21 | line | 13.25, 0.51 | 13.26, 0.51
Outline | 22 | line | 13.26, 0.51 | 13.25, 0.66
Outline | 23 | line | 13.25, 0.66 | 11.27, 0.59

O u tlin e | 2 4 | lin e | 1 1.2 7, 0.5 9 | 1 1.2 7, 0.6 7
O u tlin e | 2 5 | lin e | 1 1.2 7, 0.6 7 | 1 1.2 7, 0.5 9
O u tlin e | 2 6 | lin e | 1 1.2 7, 0.5 9 | 1 0.9 2, 0.5 8
O u tlin e | 2 7 | lin e | 1 0.9 2, 0.5 8 | 9.4 1, 0.4 5
O u tlin e | 2 8 | lin e | 9.4 1, 0.4 5 | 6.2 0, 0.0 8
O u tlin e | 2 9 | a r c clo c k wis e | 6.2 0, 0.0 8 | 3.0 7, 0.1 9 | 4.9 2, 9.4 1 | 9.4 1
C u t -o u t 1 | 3 0 | lin e | 1 1.1 9, 0.5 9 | 1 1.2 6, 0.7 4
C u t -o u t 1 | 3 1 | lin e | 1 1.2 6, 0.7 4 | 1 1.1 9, 0.5 9
C u t -o u t 2 | 3 2 | lin e | 1 0.7 9, 0.5 7 | 1 1.2 6, 0.7 4
C u t -o u t 2 | 3 3 | lin e | 1 1.2 6, 0.7 4 | 1 0.7 9, 0.5 7

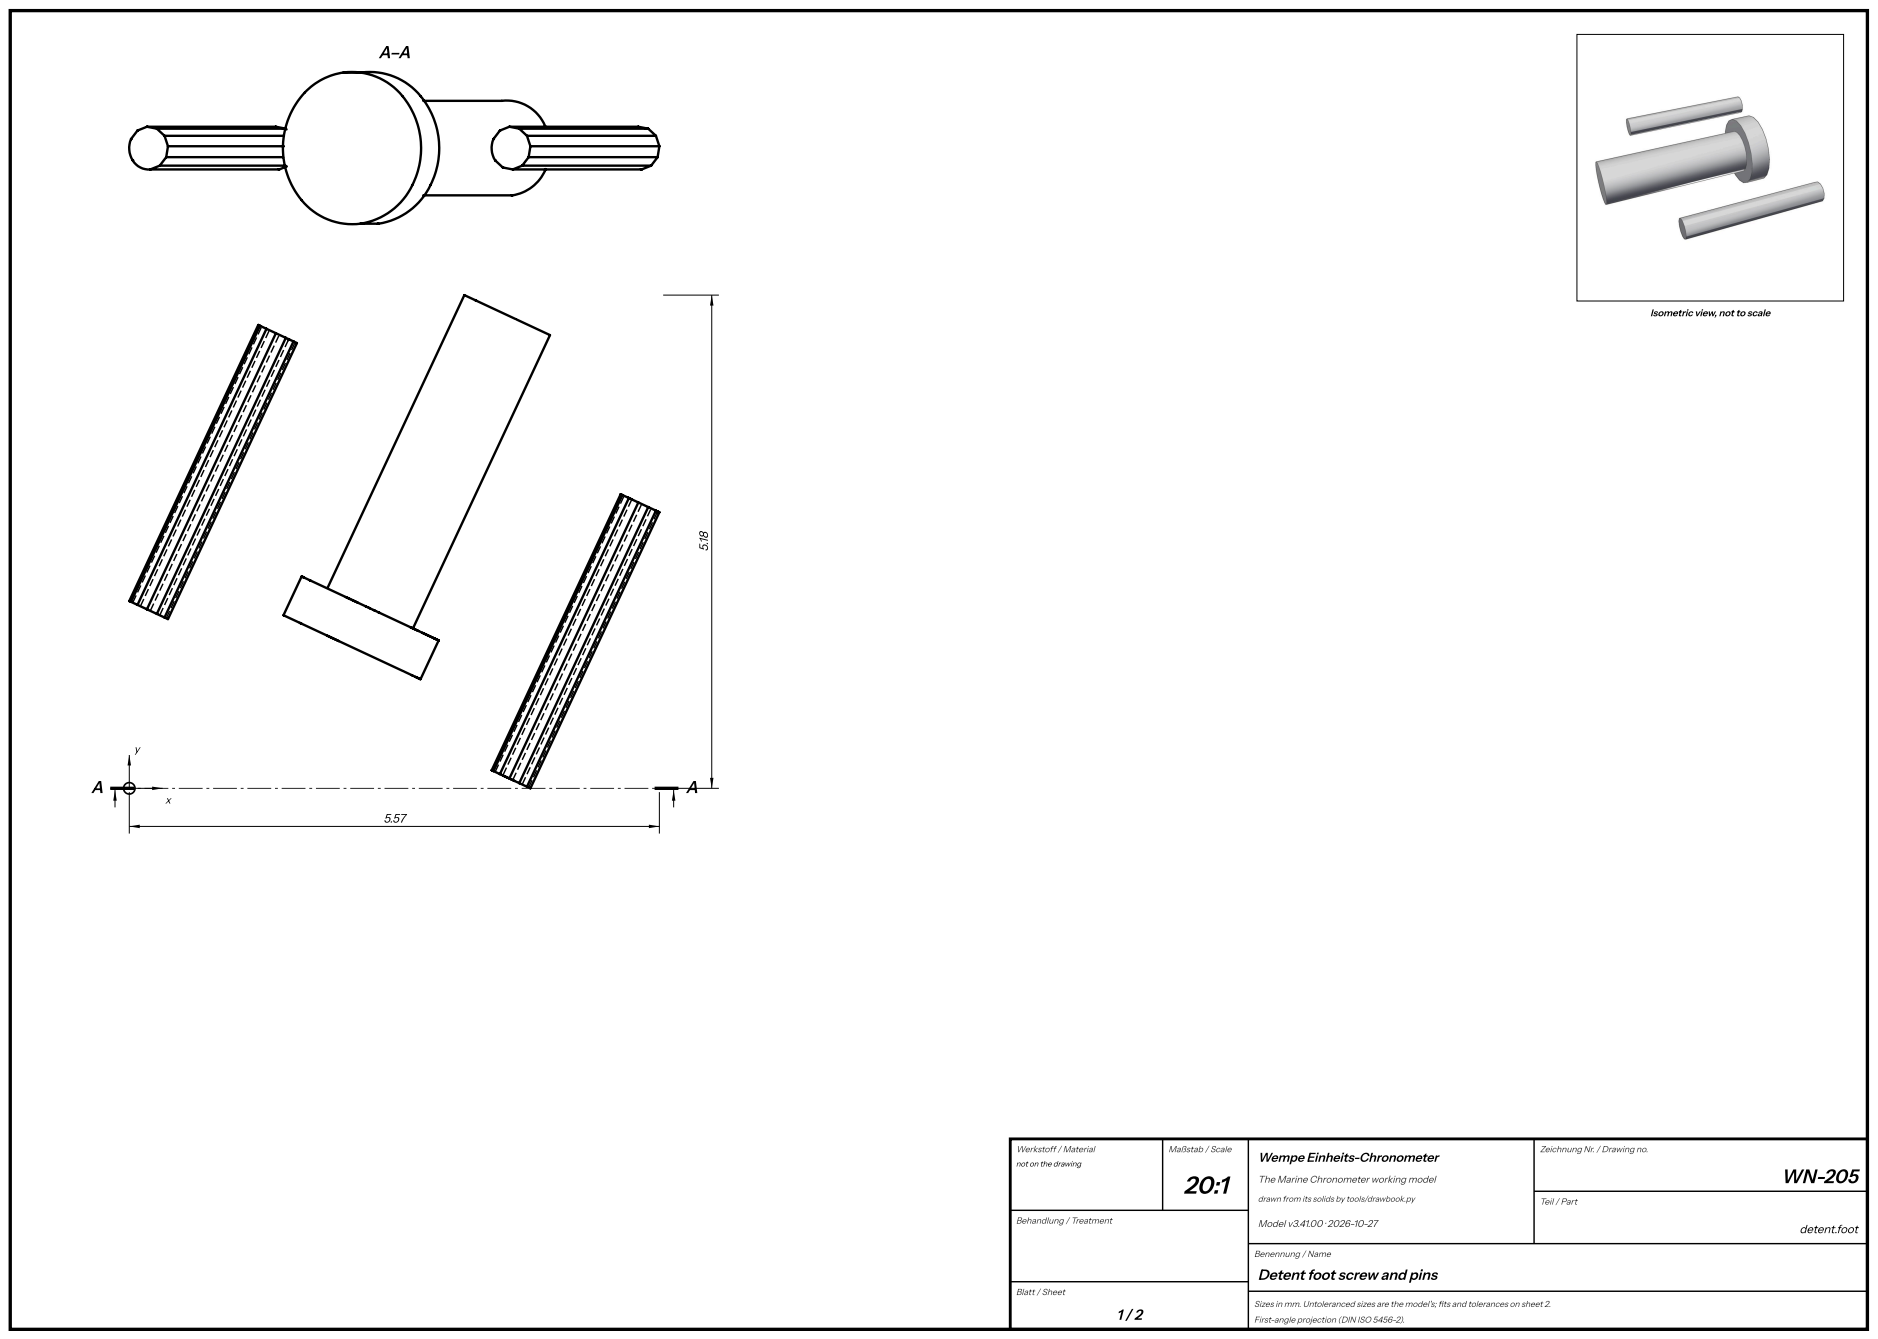
[picture p395: page 170]
Werkstoff / Material; Maßstab / Scale; Behandlung / Treatment; Model v3.41.00 · 2026-10-27; Teil / Part; detent.foot

Isometric view, not to scale

Zeichnung Nr. / Drawing no.

not on the drawing

Wempe Einheits-Chronometer

The Marine Chronometer working model

drawn from its solids by tools/drawbook.py

Detent foot screw and pins

## Detent foot screw and pins — sheet 2

The screw and two steady pins that hold the detent’s foot to the block.

Parts list

Drawing | Name | Units | Material | Finish, heat treatment | Fit, as measured on the model
WN-205 | Stellstift (WN-205 by the coloured section's label), the detent's foot pins | 2 | not on the drawing | | in 050401-1 (press): 0.636 mm, least gap 0.004; in 050401-4 (press): 1.565 mm, least gap -0.0047
WN-13 | Detent foot screw, M1 (WN-13 by the coloured section's label, likely) | 1 | not on the drawing | | in 050401-1 (clear): 0.589 mm, least gap 0.0455; in 050401-4 (embed): 1.62 mm, least gap -0.0503

What it does (WN-205). Place the detent's foot on the block.

What it does (WN-13). Clamps the detent's foot to the block's end.

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

drawn; depths from the face seen in the plan (the top). Thickness 1.59.

Contourin the plan

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

radius.

Contour | # | Element | From x, y | To x, y | Centre x, y | R
Outline | 1 | line | 5.16, 3.09 | 5.57, 2.90
Outline | 2 | line | 5.57, 2.90 | 4.21, 0.00
Outline | 3 | line | 4.21, 0.00 | 3.81, 0.19
Outline | 4 | line | 3.81, 0.19 | 5.16, 3.09
Outline | 5 | line | 1.82, 2.22 | 2.08, 2.10
Outline | 6 | line | 2.08, 2.10 | 3.52, 5.18
Outline | 7 | line | 3.52, 5.18 | 4.42, 4.76
Outline | 8 | line | 4.42, 4.76 | 2.98, 1.68
Outline | 9 | line | 2.98, 1.68 | 3.25, 1.55
Outline | 10 | line | 3.25, 1.55 | 3.06, 1.15
Outline | 11 | line | 3.06, 1.15 | 1.62, 1.82
Outline | 12 | line | 1.62, 1.82 | 1.81, 2.23
Outline | 13 | line | 1.81, 2.23 | 1.82, 2.22
Cut-out 1 | 14 | arc anticlockwise | 2.77, 2.62 | 2.77, 2.62 | 2.78, 2.59 | 0.04
Cut-out 1 | 15 | arc anticlockwise | 2.77, 2.62 | 2.77, 2.62 | 2.78, 2.59 | 0.04
Outline | 16 | line | 0.22, 1.86 | 0.00, 1.97
Outline | 17 | line | 0.00, 1.97 | 1.35, 4.87
Outline | 18 | line | 1.35, 4.87 | 1.76, 4.68
Outline | 19 | line | 1.76, 4.68 | 0.41, 1.78
Outline | 20 | line | 0.41, 1.78 | 0.22, 1.86

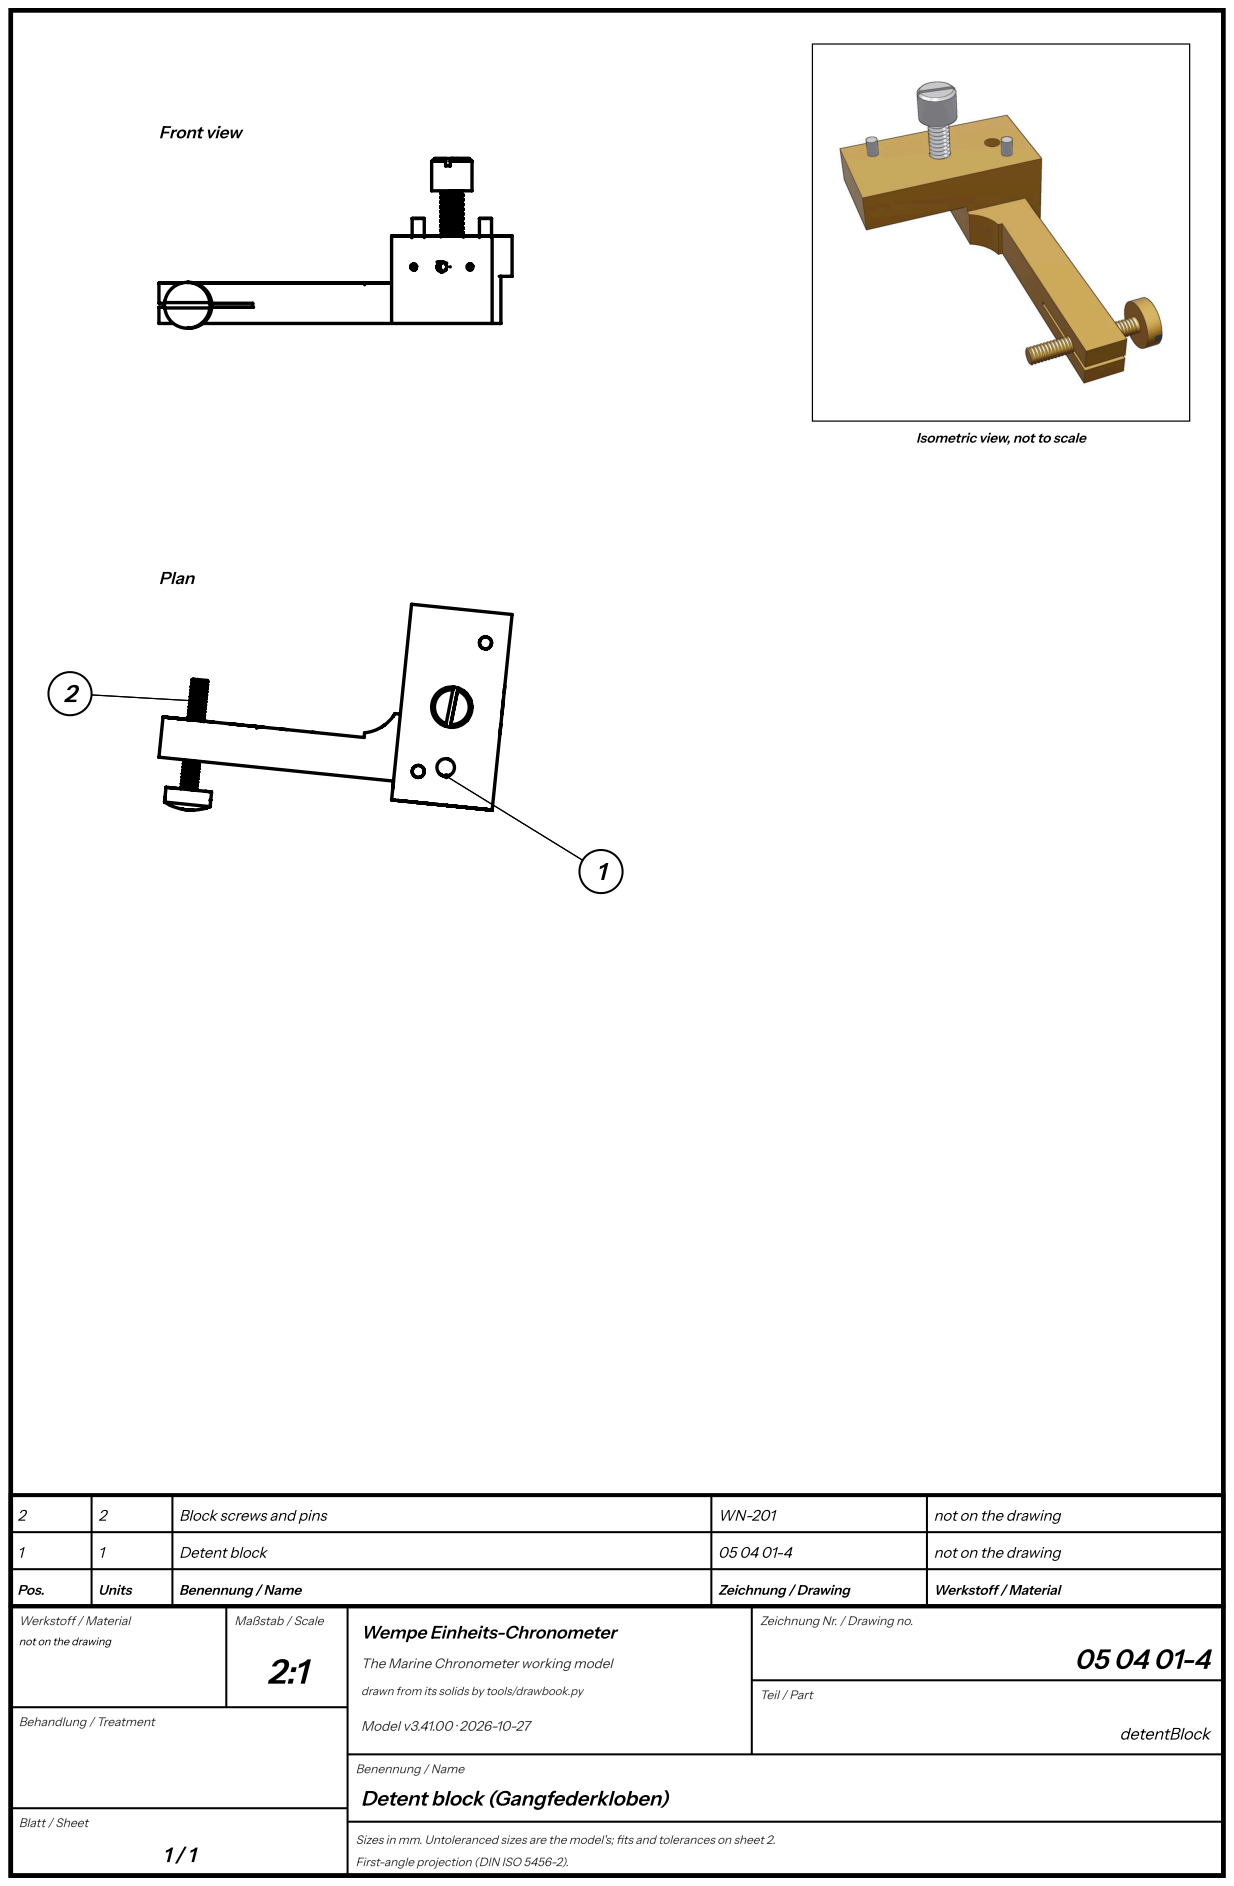
[picture p396: page 172]
Front view; Plan; Pos.; Units; Benennung / Name; Zeichnung / Drawing; Werkstoff / Material; Detent block; not on the drawing; Block screws and pins; Maßstab / Scale; Behandlung / Treatment; Model v3.41.00 · 2026-10-27; Teil / Part; detentBlock

Isometric view, not to scale

Zeichnung Nr. / Drawing no.

not on the drawing

Wempe Einheits-Chronometer

The Marine Chronometer working model

drawn from its solids by tools/drawbook.py

Detent block (Gangfederkloben)

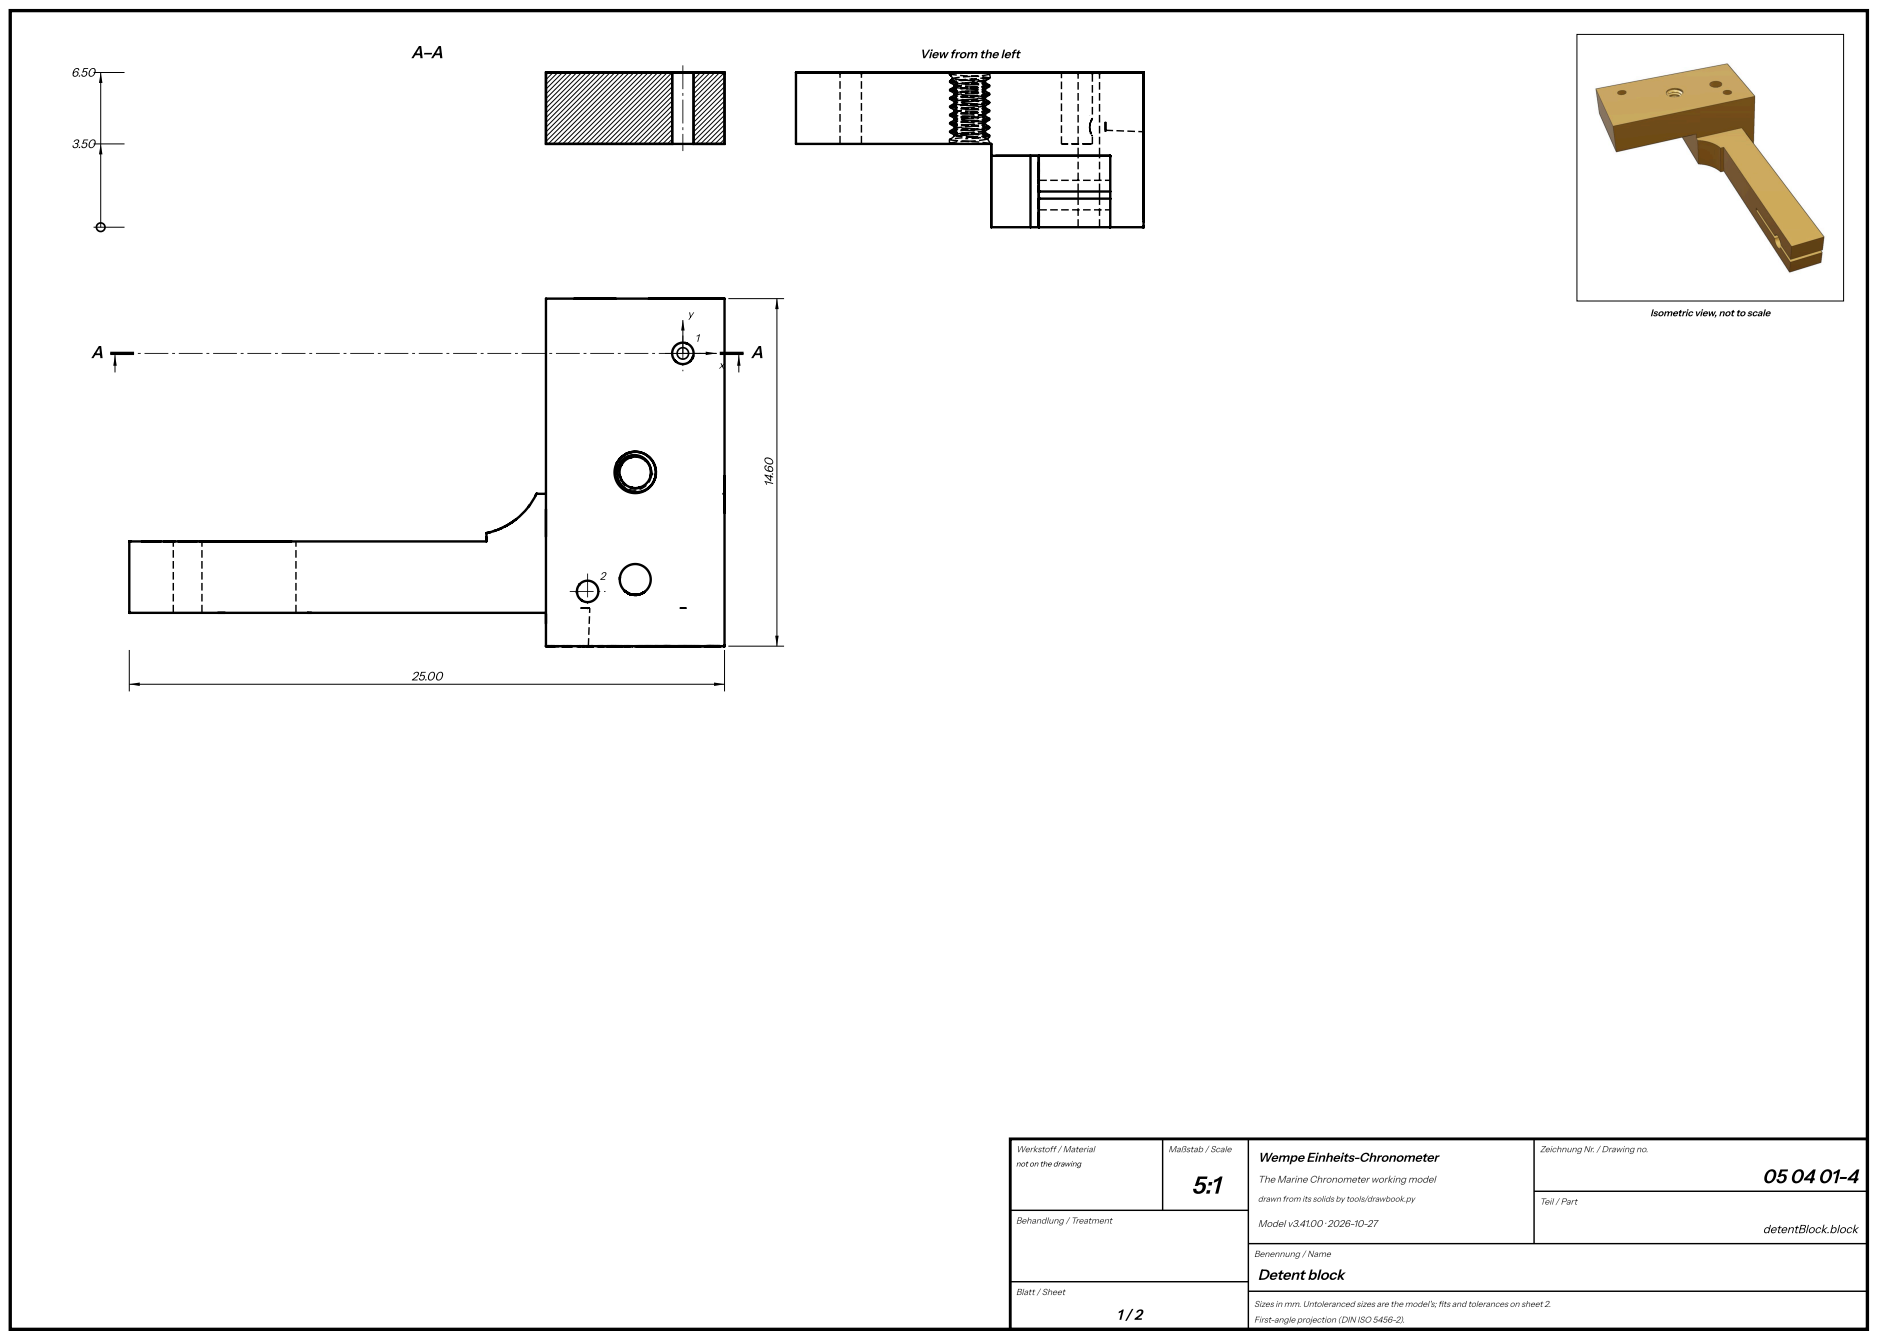
[picture p397: page 173]
Werkstoff / Material; Maßstab / Scale; Behandlung / Treatment; Model v3.41.00 · 2026-10-27; Teil / Part; detentBlock.block; Detent block

View from the left

Isometric view, not to scale

Zeichnung Nr. / Drawing no.

not on the drawing

Wempe Einheits-Chronometer

The Marine Chronometer working model

drawn from its solids by tools/drawbook.py

## Detent block — sheet 2

The brass L under the top plate that carries the detent: screwed up from the plate’s outer face through hole 13, placed by

two steady pins. The detent’s foot is clamped to the end of its base; a screw crosses the slit end of its upright.

Parts list

Drawing | Name | Units | Material | Finish, heat treatment | Fit, as measured on the model
05 04 01-4 | Gangfederkloben (detent block) | 1 | not on the drawing | | on 050901: 0 mm

Test on the bench (05 04 01-4). The escapement's figures and the banking, the detent, its gold spring and the balance in;

the train's power let down: 05 04_1's layout and the model: the impulse stone's face 28°10' before the line of centres at rest,

the locking stone 37.0° on in the wheel's turn and 7.14 from its centre; the gold spring met at -9.2° of the balance (05 04_1's

−12°), the wheel released at 3.6° (lock 12.8°), the gold spring off the stone at 6.3° (let-off 2.8°), the return swing past it at

-22.8° (overall 29.2°); roller shake 0.011 mm, the teeth 0.39 mm into the roller. Set the banking (the block's cross screw, the 1954 instruction's п. 11) for a lock 0.182 mm deep at the stone, the middle of its window (the drawing's 0.235 lies 151 µm over

its floor): never shallower than 0.084 (a held tooth's stone rings more than half the depth: wempe_tripping.js) nor deeper

than 0.281 (the discharge stone can't lift the stone further: it doesn't unlock). A wheel at the top of its 14 +0.03 locks 0.250

deep where the drawn wheel locks 0.235: set the banking to the wheel as made. The preload at the stone: a 0.64 g rider

must leave the detent on its banking and a 0.80 g one part it; aim near 0.68 g (the model's 0.8 g is an estimate:

wempe_tripping.js finds a held tooth's stone ringing 44 % of the depth of lock there, under half from 0.40 g, teeth getting

past at a fifth of it and under; and a 3 ms blow of 20 g across the plate lets a tooth go under 0.64 g, the floor taken here, the

higher; each gram more costs about 9.7° of swing; never over 0.80 g: above it the stone, falling back after the release, lands

again on the escaping tooth's back during the impulse, where the models part: dynamics.js with brass's restitution). The

return pass: turn the balance back slowly by hand through the discharge with the train's power on and watch the locking

stone under a loupe: the discharge stone must bend the gold spring aside without lifting the detent (wempe_tripping.js: as

the model takes the stone's contact on the gold spring no tooth gets past over 333 gold's whole range of modulus, 83-110

GPa, but at 4 times that contact's stiffness 6 in 12 do, whatever the alloy: only the made spring can show it); its tip at rest

0.10-0.15 short of the discharge stone and 0.35-0.40 past the detent's end (the 1958 Navy repair book's checks, p. 60).

What it does (05 04 01-4). Under the top plate, carries the detent. As first drawn (05 04_1, Wempe 3955), a base with a

long arm and its banking screw in place of the upright.

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

the face seen in the plan (the top). Thickness 6.50.

Holes

Hole | x | y | Size
1 | 0.00 | 0.00 | Ø 0.90 through (3.00 thick at 3.50-6.50)
2 | -4.00 | -10.00 | Ø 0.90 through

Contourin the plan

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

radius.

Contour | # | Element | From x, y | To x, y | Centre x, y | R
Outline | 1 | line | -5.75, -10.90 | -23.25, -10.90
Outline | 2 | line | -23.25, -10.90 | -23.25, -7.90
Outline | 3 | line | -23.25, -7.90 | -8.25, -7.90
Outline | 4 | line | -8.25, -7.90 | -8.25, -7.55
Outline | 5 | arc anticlockwise | -8.25, -7.55 | -6.15, -5.90 | -8.86, -4.61 | 3.00
Outline | 6 | line | -6.15, -5.90 | -5.75, -5.90
Outline | 7 | line | -5.75, -5.90 | -5.75, 2.30
Outline | 8 | line | -5.75, 2.30 | 1.75, 2.30
Outline | 9 | line | 1.75, 2.30 | 1.75, -12.30
Outline | 10 | line | 1.75, -12.30 | -5.75, -12.30

Outline | 11 | line | -5.75, -12.30 | -5.75, -10.90

Levels

Faces in section A-A, from the bottom face: 3.50, 6.50.

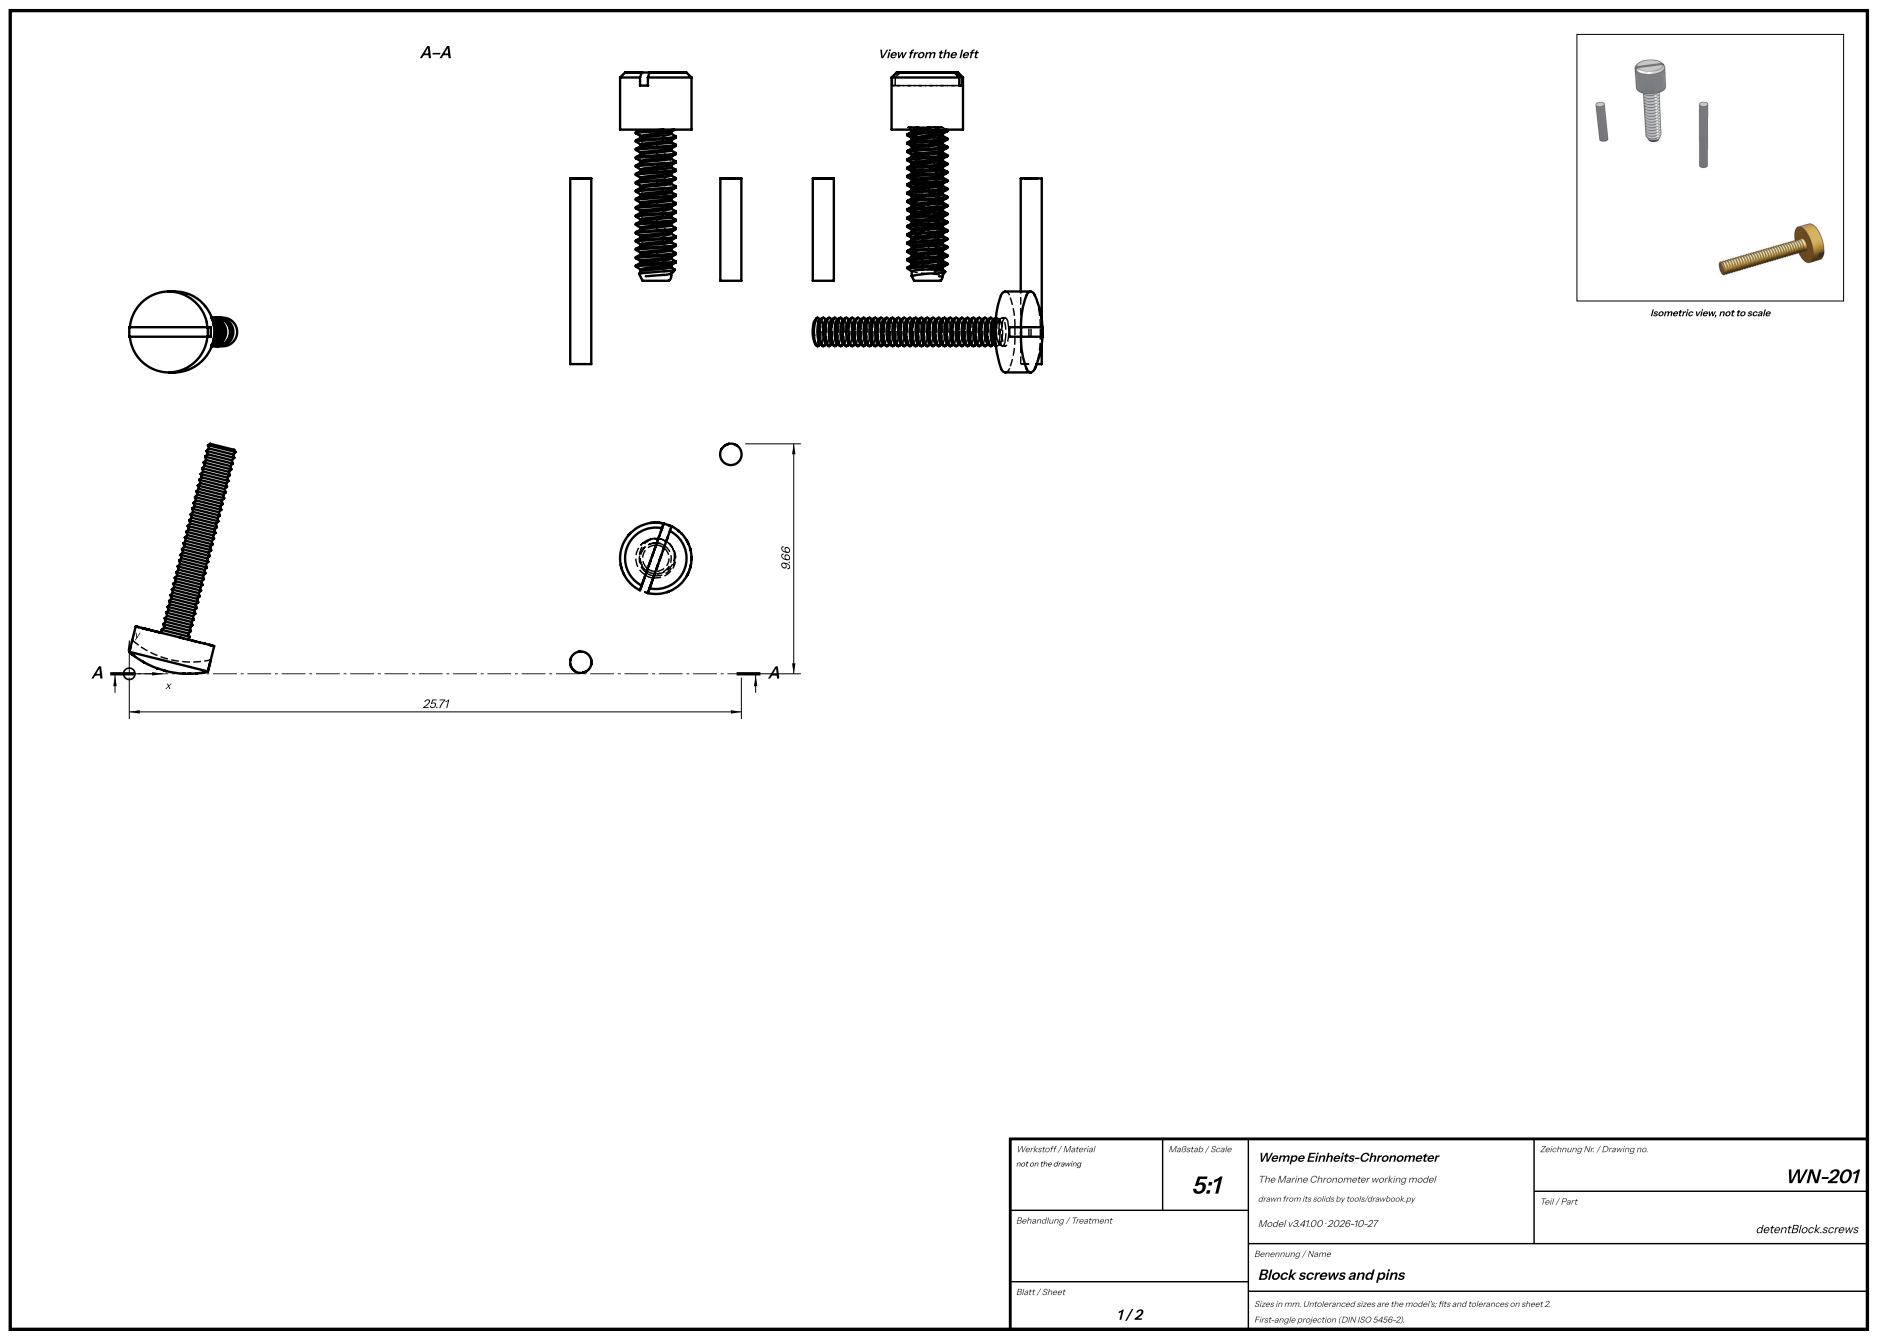
[picture p398: page 176]
Werkstoff / Material; Maßstab / Scale; Behandlung / Treatment; Model v3.41.00 · 2026-10-27; Teil / Part; detentBlock.screws

View from the left

Isometric view, not to scale

Zeichnung Nr. / Drawing no.

not on the drawing

Wempe Einheits-Chronometer

The Marine Chronometer working model

drawn from its solids by tools/drawbook.py

Block screws and pins

## Block screws and pins — sheet 2

The fixing screw from the top plate’s outer face, the screw across the upright’s slit end, and the two steady pins.

Parts list

Drawing | Name | Units | Material | Finish, heat treatment | Fit, as measured on the model
WN-201 | Stellstift (WN-201, "Stellstift 2" by the coloured section's label), the detent block's steady pins Ø 0.9 | 2 | not on the drawing | | in 050401-4 (press): 6.521 mm, least gap 0.0045; in 050901 (clear): 1.284 mm, least gap 0.0185
WN-15 | Detent block screw, M1.7 (WN-15 by the coloured section's label, likely) | 1 | not on the drawing | | in 050901 (clear): 3.367 mm, least gap 0.0741; in 050401-4 (tap): 2.986 mm, least gap 0.0202
WN-gkA43 | Banking screw M1.2 along the 1943 block's slit upright, its domed slotted head (the escapement of 1943; its WN number not read) | 1 | not on the drawing | | not measured on the model: see its function, Along the upright's slit end, the slit gripping its thread; its head's underside bears on the detent's pipe and sets the depth of lock. The thread from the block's sheet (M1.2), its head measured on Kirow DEC 422's, DEC 479's and Lange No. 5177's photographs, its length the 6MX's loose block's. As last revised too since 27 October 2026 (Wempe 9166; the 1946 staff read again).

What it does (WN-201). Place the block on the top plate.

What it does (WN-15). From the top plate's outer face through hole 13 into the block. The Soviet 6MX's: a slotted stud

flush in the plate's outer face, 2.2 from hole 13 (Kirov No. 247), through the adjusting slide into the block.

What it does (WN-gkA43). Along the upright's slit end, the slit gripping its thread; its head's underside bears on the

detent's pipe and sets the depth of lock. The thread from the block's sheet (M1.2), its head measured on Kirow DEC 422's,

DEC 479's and Lange No. 5177's photographs, its length the 6MX's loose block's. As last revised too since 27 October 2026

(Wempe 9166; the 1946 staff read again).

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

drawn; depths from the face seen in the plan (the top). Thickness 12.60.

Contourin the plan

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

radius.

Contour | # | Element | From x, y | To x, y | Centre x, y | R
Outline | 1 | circle | | | 25.27, 9.22 | 0.45
Outline | 2 | circle | | | 22.11, 4.85 | 1.50
Outline | 3 | circle | | | 18.96, 0.49 | 0.45
Outline | 4 | arc clockwise | 0.37, 0.63 | 0.00, 0.91 | 2.48, 3.81 | 3.81
Outline | 5 | line | 0.00, 0.91 | 0.27, 1.99
Outline | 6 | line | 0.27, 1.99 | 1.34, 1.72
Outline | 7 | arc clockwise | 1.34, 1.72 | 1.47, 1.95 | 1.59, 1.72 | 0.25
Outline | 8 | line | 1.47, 1.95 | 1.43, 2.09
Outline | 9 | line | 1.43, 2.09 | 1.53, 2.19
Outline | 10 | line | 1.53, 2.19 | 1.49, 2.33
Outline | 11 | line | 1.49, 2.33 | 1.59, 2.43
Outline | 12 | line | 1.59, 2.43 | 1.55, 2.57

O u tlin e | 1 3 | lin e | 1.5 5, 2.5 7 | 1.6 5, 2.6 8
O u tlin e | 1 4 | lin e | 1.6 5, 2.6 8 | 1.6 1, 2.8 1
O u tlin e | 1 5 | lin e | 1.6 1, 2.8 1 | 1.7 1, 2.9 2
O u tlin e | 1 6 | lin e | 1.7 1, 2.9 2 | 1.6 7, 3.0 6
O u tlin e | 1 7 | lin e | 1.6 7, 3.0 6 | 1.7 7, 3.1 6
O u tlin e | 1 8 | lin e | 1.7 7, 3.1 6 | 1.7 3, 3.3 0
O u tlin e | 1 9 | lin e | 1.7 3, 3.3 0 | 1.8 3, 3.4 0
O u tlin e | 2 0 | lin e | 1.8 3, 3.4 0 | 1.7 9, 3.5 4
O u tlin e | 2 1 | lin e | 1.7 9, 3.5 4 | 1.8 9, 3.6 5
O u tlin e | 2 2 | lin e | 1.8 9, 3.6 5 | 1.8 5, 3.7 8
O u tlin e | 2 3 | lin e | 1.8 5, 3.7 8 | 1.9 5, 3.8 9
O u tlin e | 2 4 | lin e | 1.9 5, 3.8 9 | 1.9 1, 4.0 3
O u tlin e | 2 5 | lin e | 1.9 1, 4.0 3 | 2.0 1, 4.1 3
O u tlin e | 2 6 | lin e | 2.0 1, 4.1 3 | 1.9 7, 4.2 7
O u tlin e | 2 7 | lin e | 1.9 7, 4.2 7 | 2.0 8, 4.3 7
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
Outline | 136 | line | 2.59, 1.80 | 2.49, 1.69
Outline | 137 | arc clockwise | 2.49, 1.69 | 2.50, 1.43 | 2.28, 1.55 | 0.25
Outline | 138 | line | 2.50, 1.43 | 3.57, 1.17
Outline | 139 | line | 3.57, 1.17 | 3.30, 0.09
Outline | 140 | arc clockwise | 3.30, 0.09 | 0.37, 0.63 | 2.48, 3.81 | 3.81

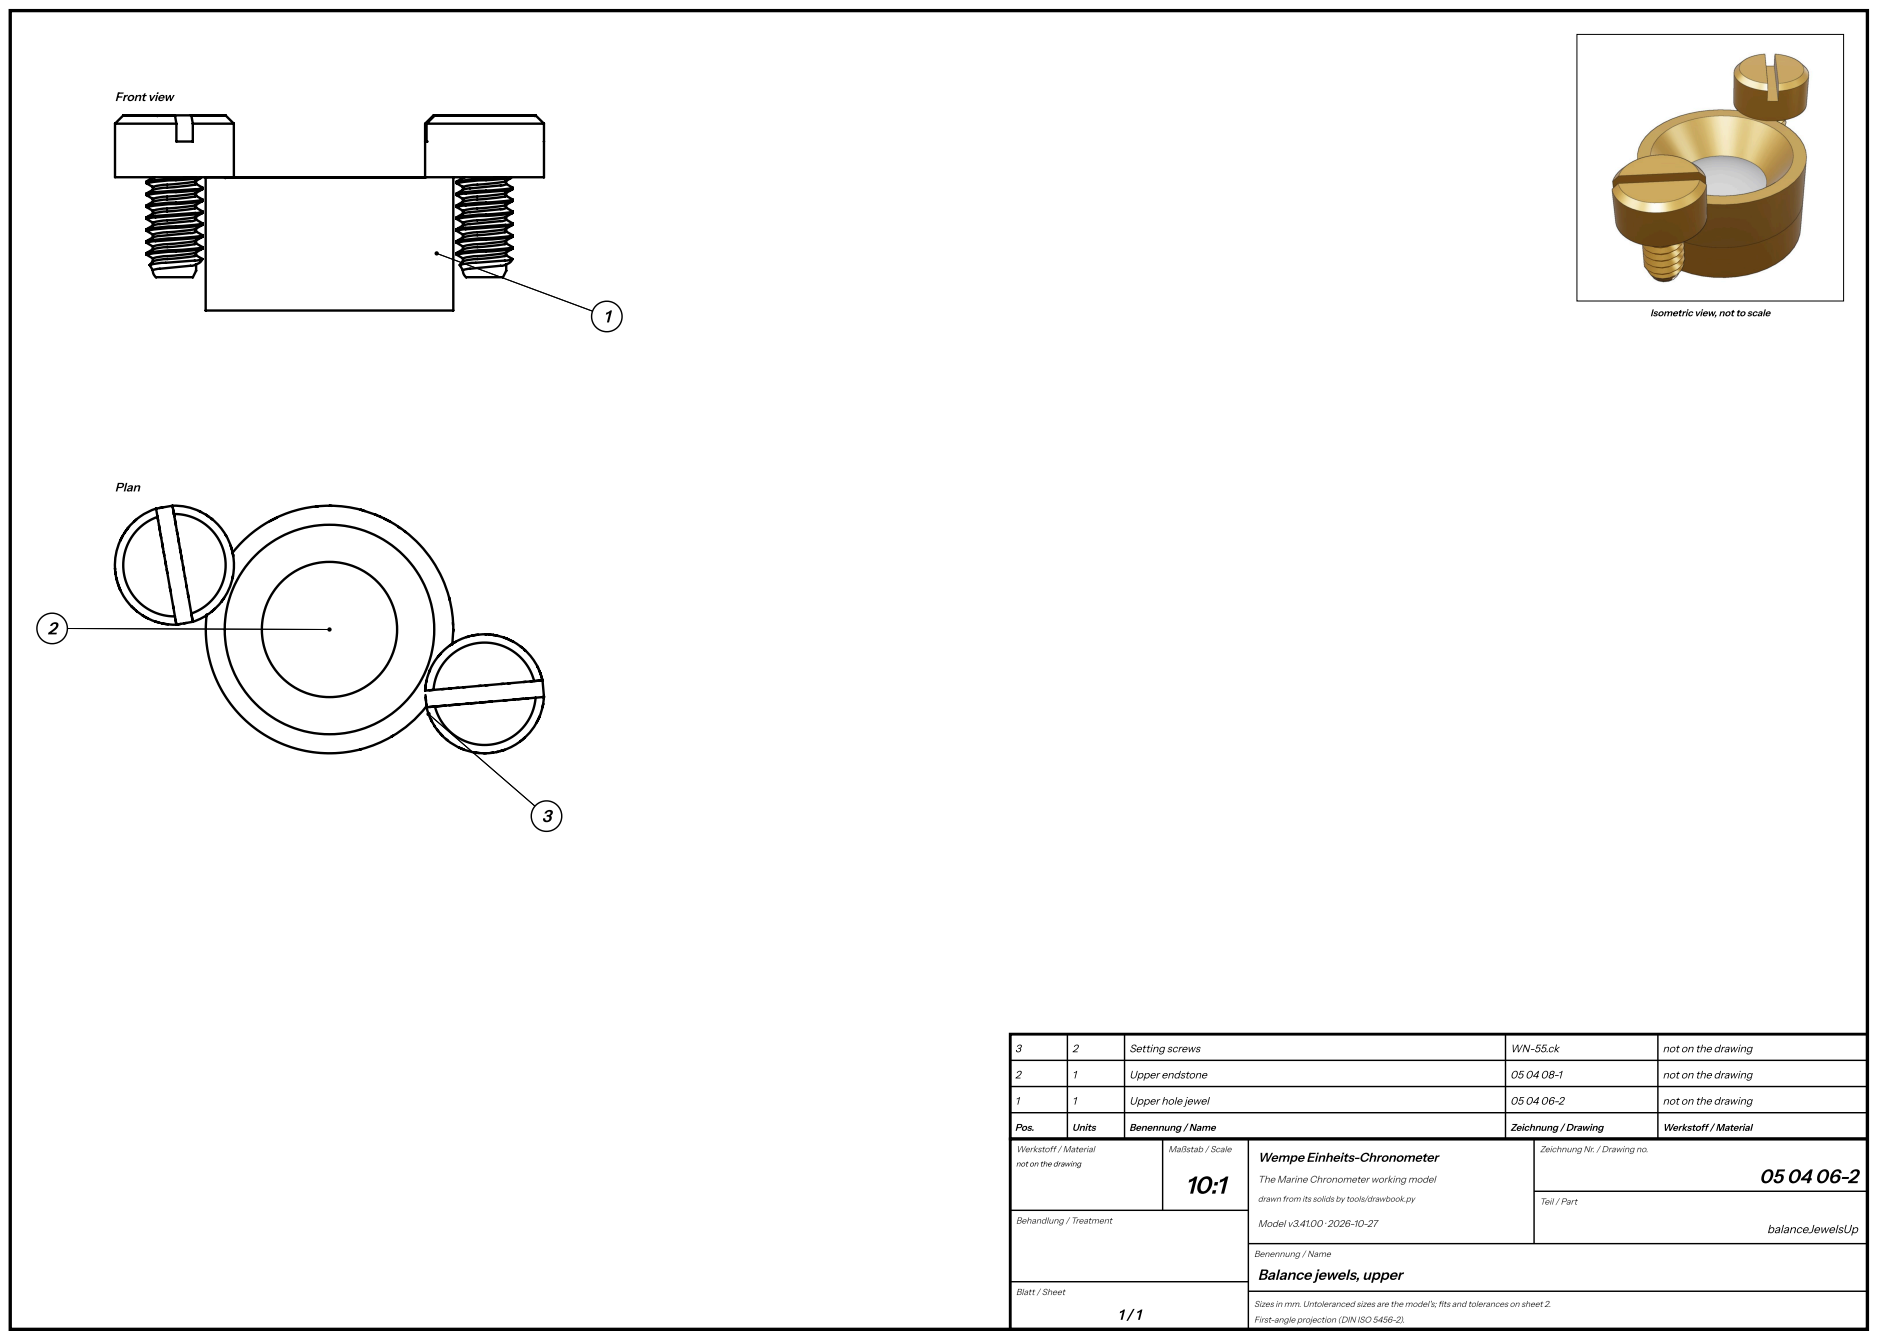
[picture p399: page 181]
Front view; Plan; Pos.; Units; Benennung / Name; Zeichnung / Drawing; Werkstoff / Material; Upper hole jewel; not on the drawing; Upper endstone; Setting screws; Maßstab / Scale; Behandlung / Treatment; Model v3.41.00 · 2026-10-27; Teil / Part; balanceJewelsUp

Isometric view, not to scale

Zeichnung Nr. / Drawing no.

not on the drawing

Wempe Einheits-Chronometer

The Marine Chronometer working model

drawn from its solids by tools/drawbook.py

Balance jewels, upper

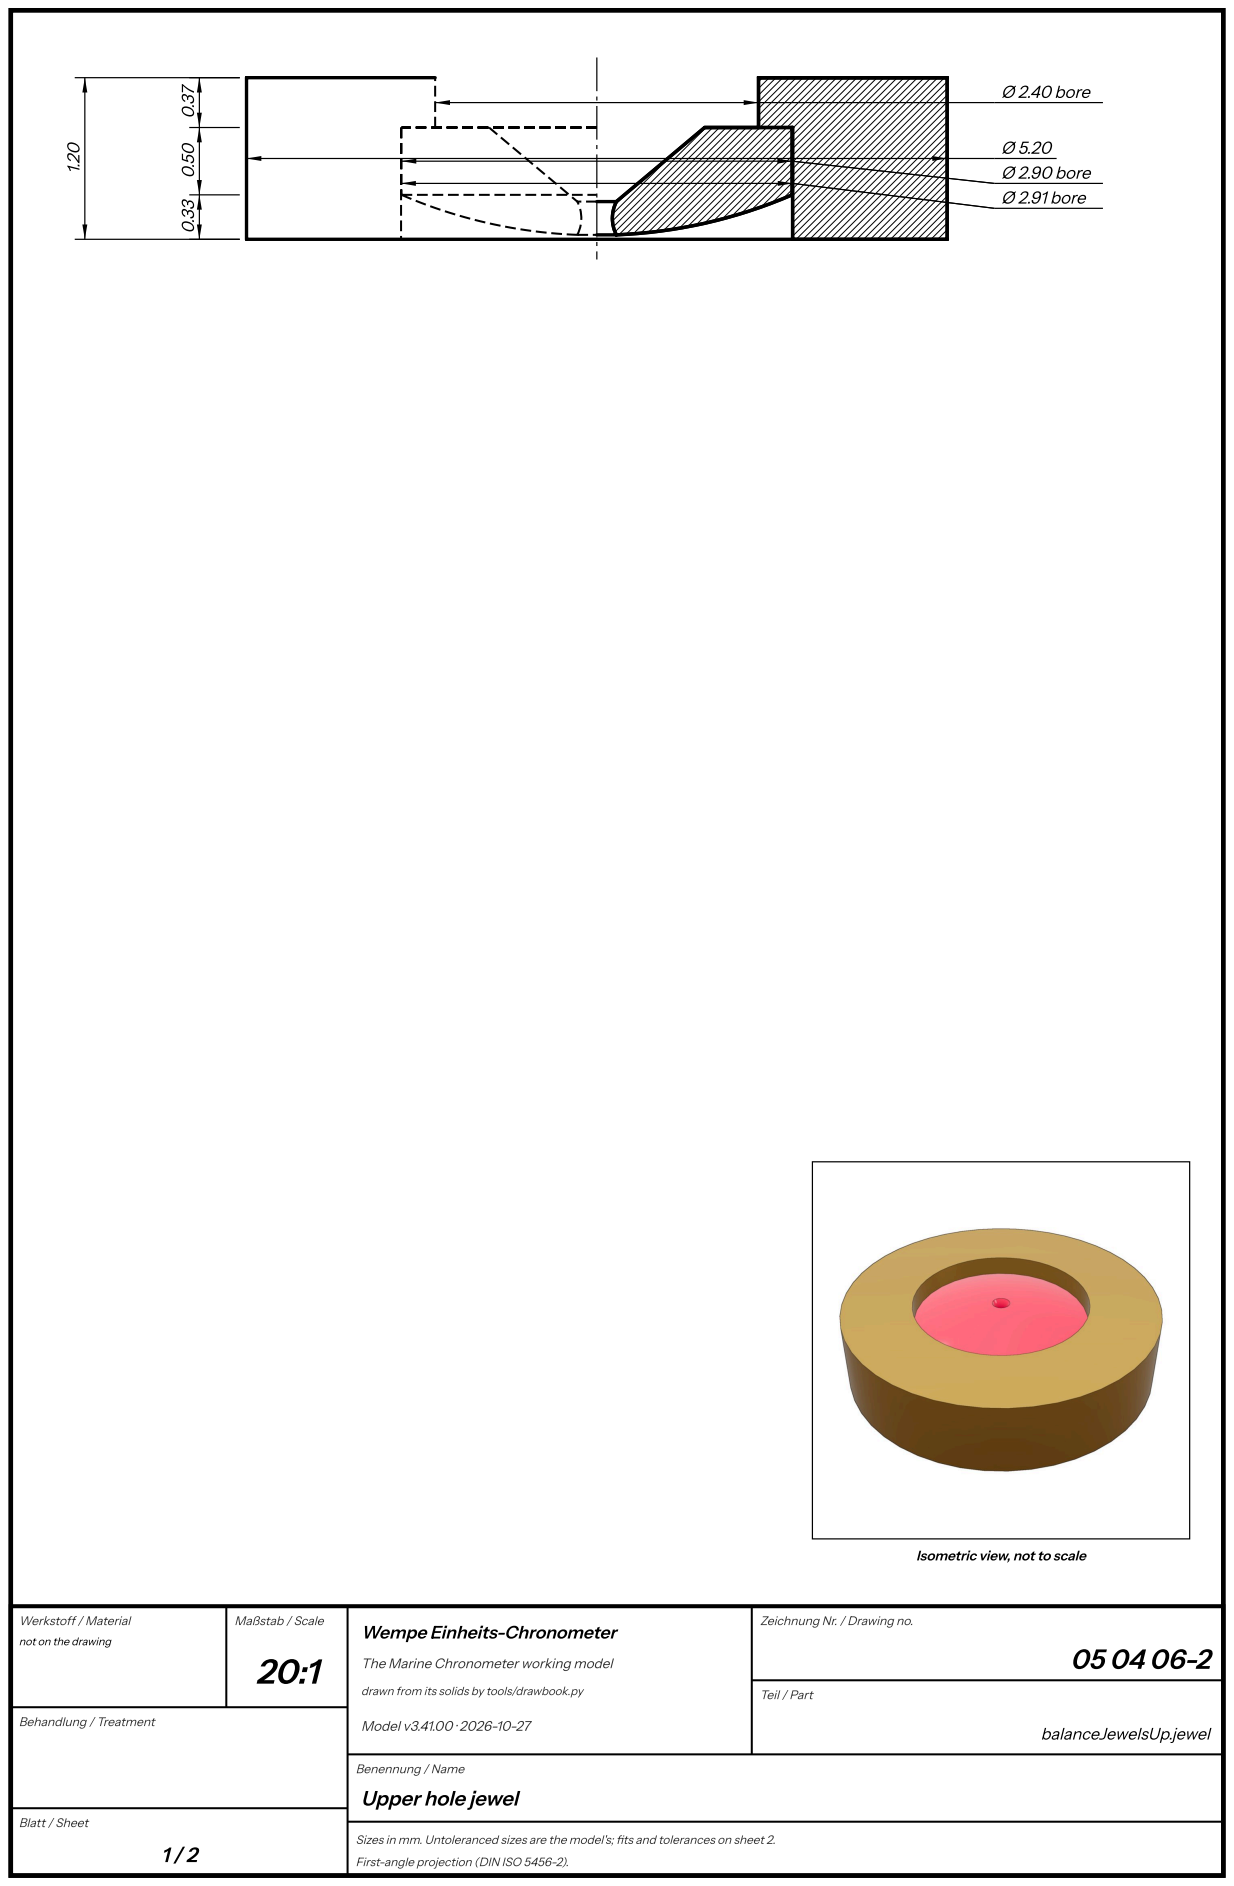
[picture p400: page 182]
Ø 2.40 bore; Ø 2.90 bore; Ø 2.91 bore; Werkstoff / Material; Maßstab / Scale; Behandlung / Treatment; Model v3.41.00 · 2026-10-27; Teil / Part; balanceJewelsUp.jewel

Isometric view, not to scale

Zeichnung Nr. / Drawing no.

not on the drawing

Wempe Einheits-Chronometer

The Marine Chronometer working model

drawn from its solids by tools/drawbook.py

Upper hole jewel

## Upper hole jewel — sheet 2

The hole jewel and its setting.

Parts list

Drawing | Name | Units | Material | Finish, heat treatment | Fit, as measured on the model
05 04 06-2 | Fassung (jewel setting), balance, upper | 1 | not on the drawing | | in 050803-1 (press): 1.2 mm, least gap 0.0064
05 04 07-1 | Lagerstein (hole jewel), balance, upper | 1 | not on the drawing | | takes Unruhwelle (balance staff): in it (run): 0.318 mm, least gap 0.0166

What it does (05 04 06-2). Holds the upper hole jewel in the cock, its flange in the sink below.

What it does (05 04 07-1). The staff's upper pivot runs in it.

Turned about its axis; length 1.20, largest Ø 5.20. Diameters: Ø 5.20; bores Ø 2.40, Ø 2.90, Ø 2.91. Shoulders from the lower

end: 0.00, 0.33, 0.83, 1.20.

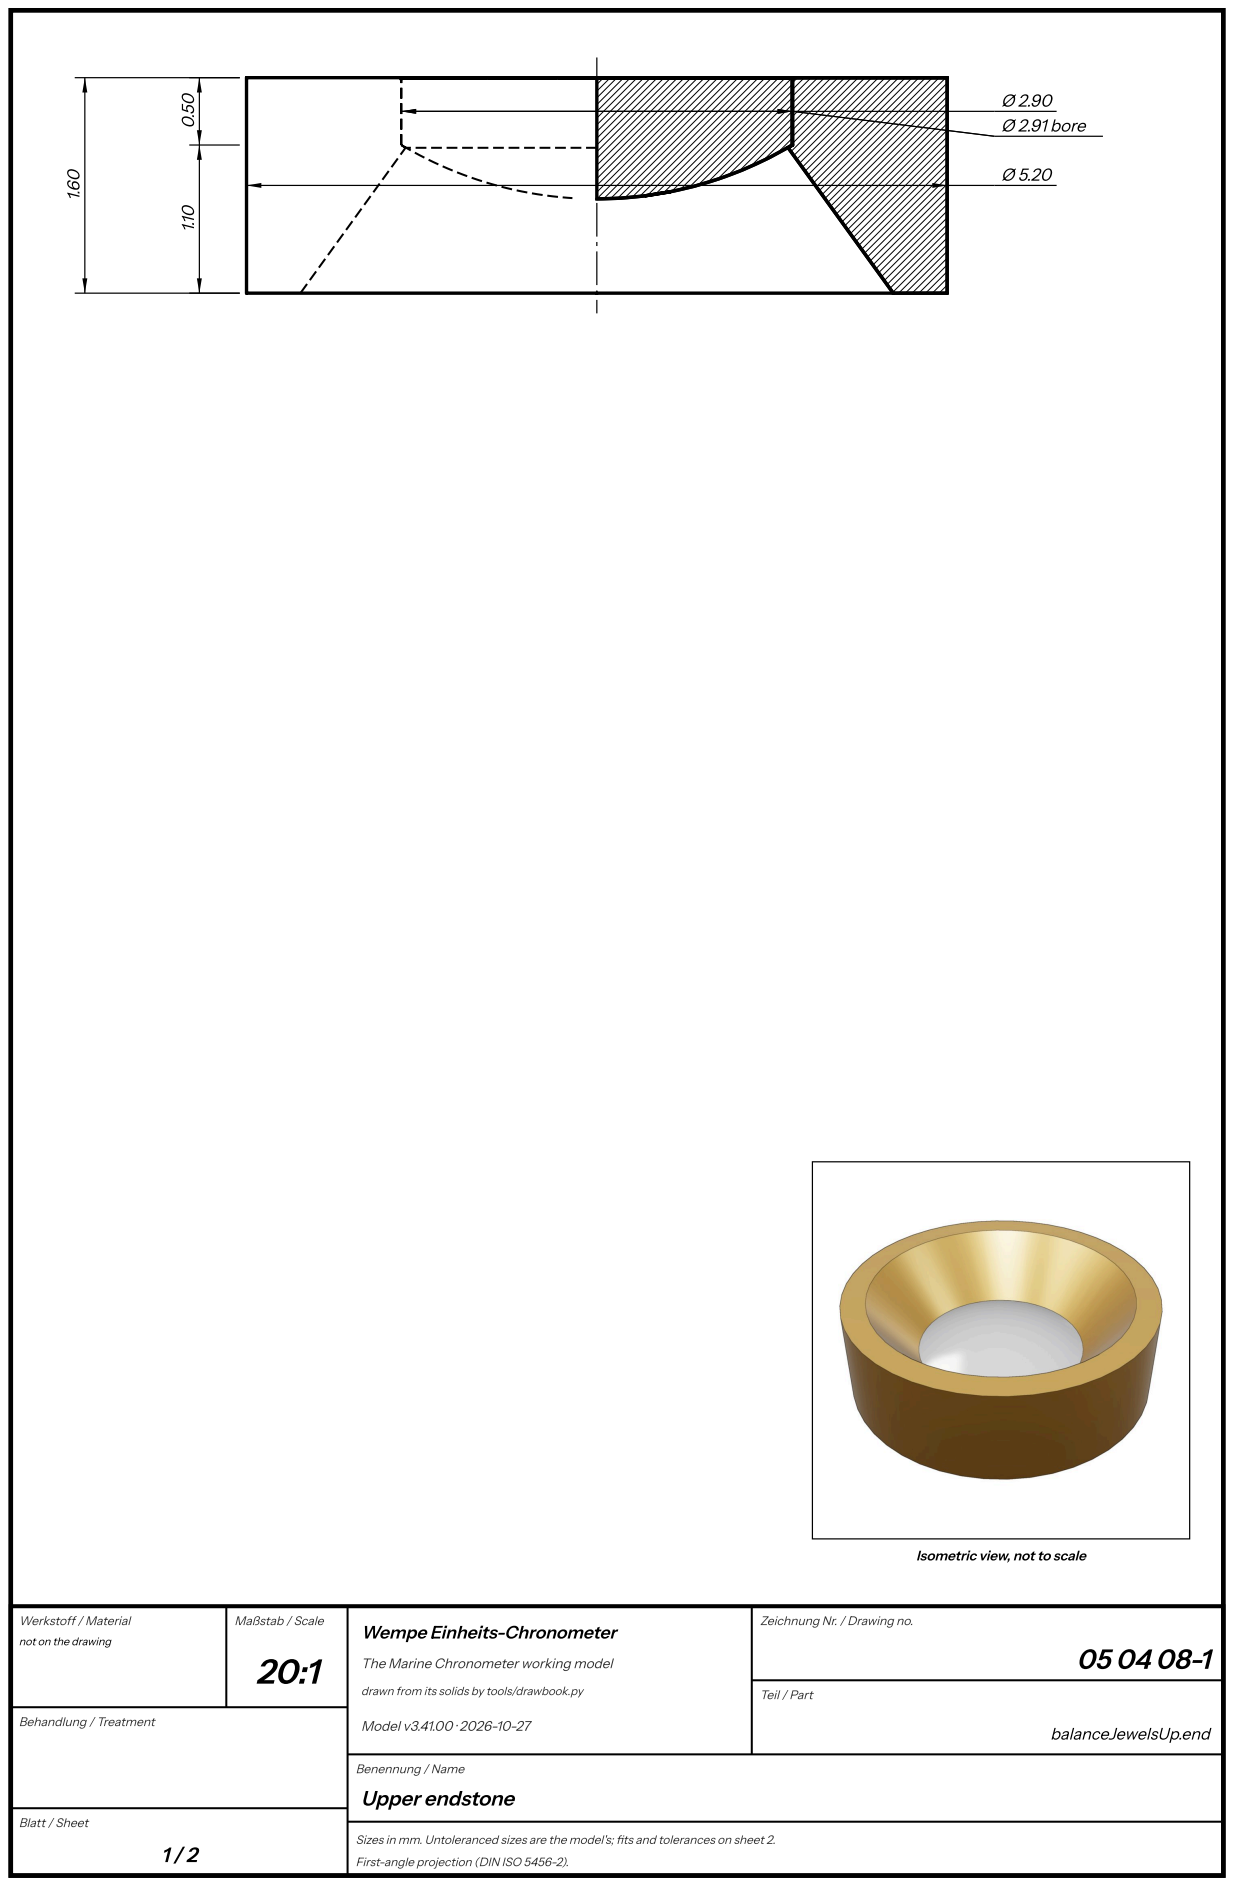
[picture p401: page 184]
Ø 2.91 bore; Werkstoff / Material; Maßstab / Scale; Behandlung / Treatment; Model v3.41.00 · 2026-10-27; Teil / Part; balanceJewelsUp.end; Upper endstone

Isometric view, not to scale

Zeichnung Nr. / Drawing no.

not on the drawing

Wempe Einheits-Chronometer

The Marine Chronometer working model

drawn from its solids by tools/drawbook.py

## Upper endstone — sheet 2

The endstone and its setting.

Parts list

Drawing | Name | Units | Material | Finish, heat treatment | Fit, as measured on the model
05 04 08-1 | Deckstein (endstone), balance, upper | 1 | not on the drawing | | not measured on the model: see its function, Stops the staff's upper pivot end.
05 04 08-2 | Fassung (endstone setting), balance, upper | 1 | not on the drawing | | in 050803-1 (press): 1.507 mm, least gap 0.0064

What it does (05 04 08-1). Stops the staff's upper pivot end.

What it does (05 04 08-2). Holds the upper endstone in the cock.

Turned about its axis; length 1.60, largest Ø 5.20. Diameters: Ø 2.90, Ø 5.20; bores Ø 2.91. Shoulders from the lower end:

0.00, 1.10, 1.60.

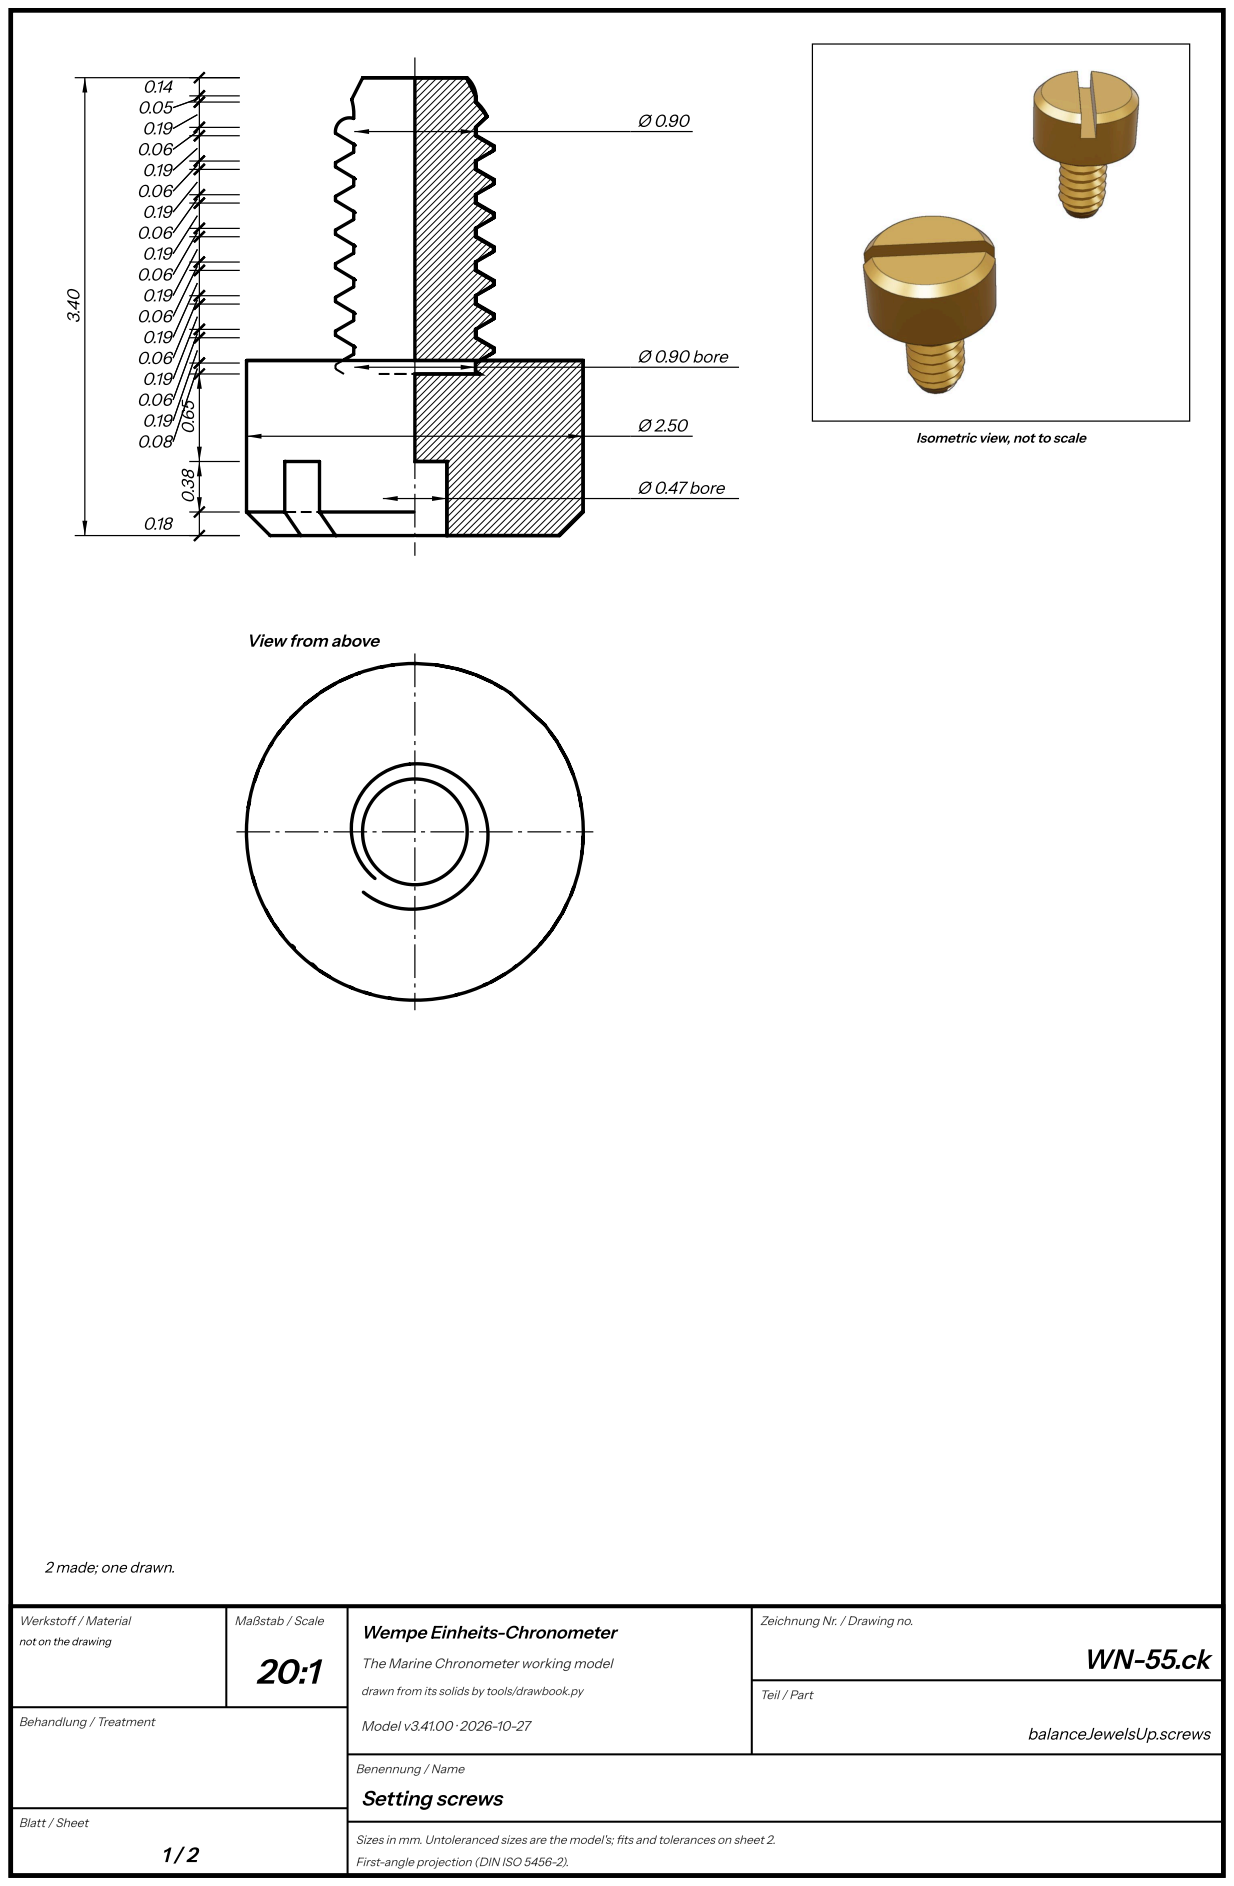
[picture p402: page 186]
Ø 0.90 bore; Ø 0.47 bore 0.38; Werkstoff / Material; Maßstab / Scale; Behandlung / Treatment; Model v3.41.00 · 2026-10-27; Teil / Part; balanceJewelsUp.screws; Setting screws

Isometric view, not to scale

View from above

2 made; one drawn.

Zeichnung Nr. / Drawing no.

not on the drawing

Wempe Einheits-Chronometer

The Marine Chronometer working model

drawn from its solids by tools/drawbook.py

## Setting screws — sheet 2

Two screws holding the endstone’s setting.

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

Parts list

Drawing | Name | Units | Material | Finish, heat treatment | Fit, as measured on the model
WN-55.ck | Schraube (WN-55 by the coloured section), the upper endstone's screws, M1.2 | 2 | not on the drawing | | in 050803-1 (tap): 2.021 mm, least gap 0.0158; on 050408-2.bu: 0 mm

What it does (WN-55.ck). Hold the endstone's setting, their heads over its edge.

Turned about its axis; length 3.40, largest Ø 2.50. Diameters: Ø 0.90, Ø 2.50; bores Ø 0.47, Ø 0.90. Shoulders from the lower

end: 0.00, 0.18, 0.55, 1.20, 1.28, 1.47, 1.53, 1.72, 1.78, 1.97, 2.03, 2.22, 2.28, 2.47, 2.53, 2.72, 2.78, 2.97, 3.03, 3.22, 3.27, 3.40.

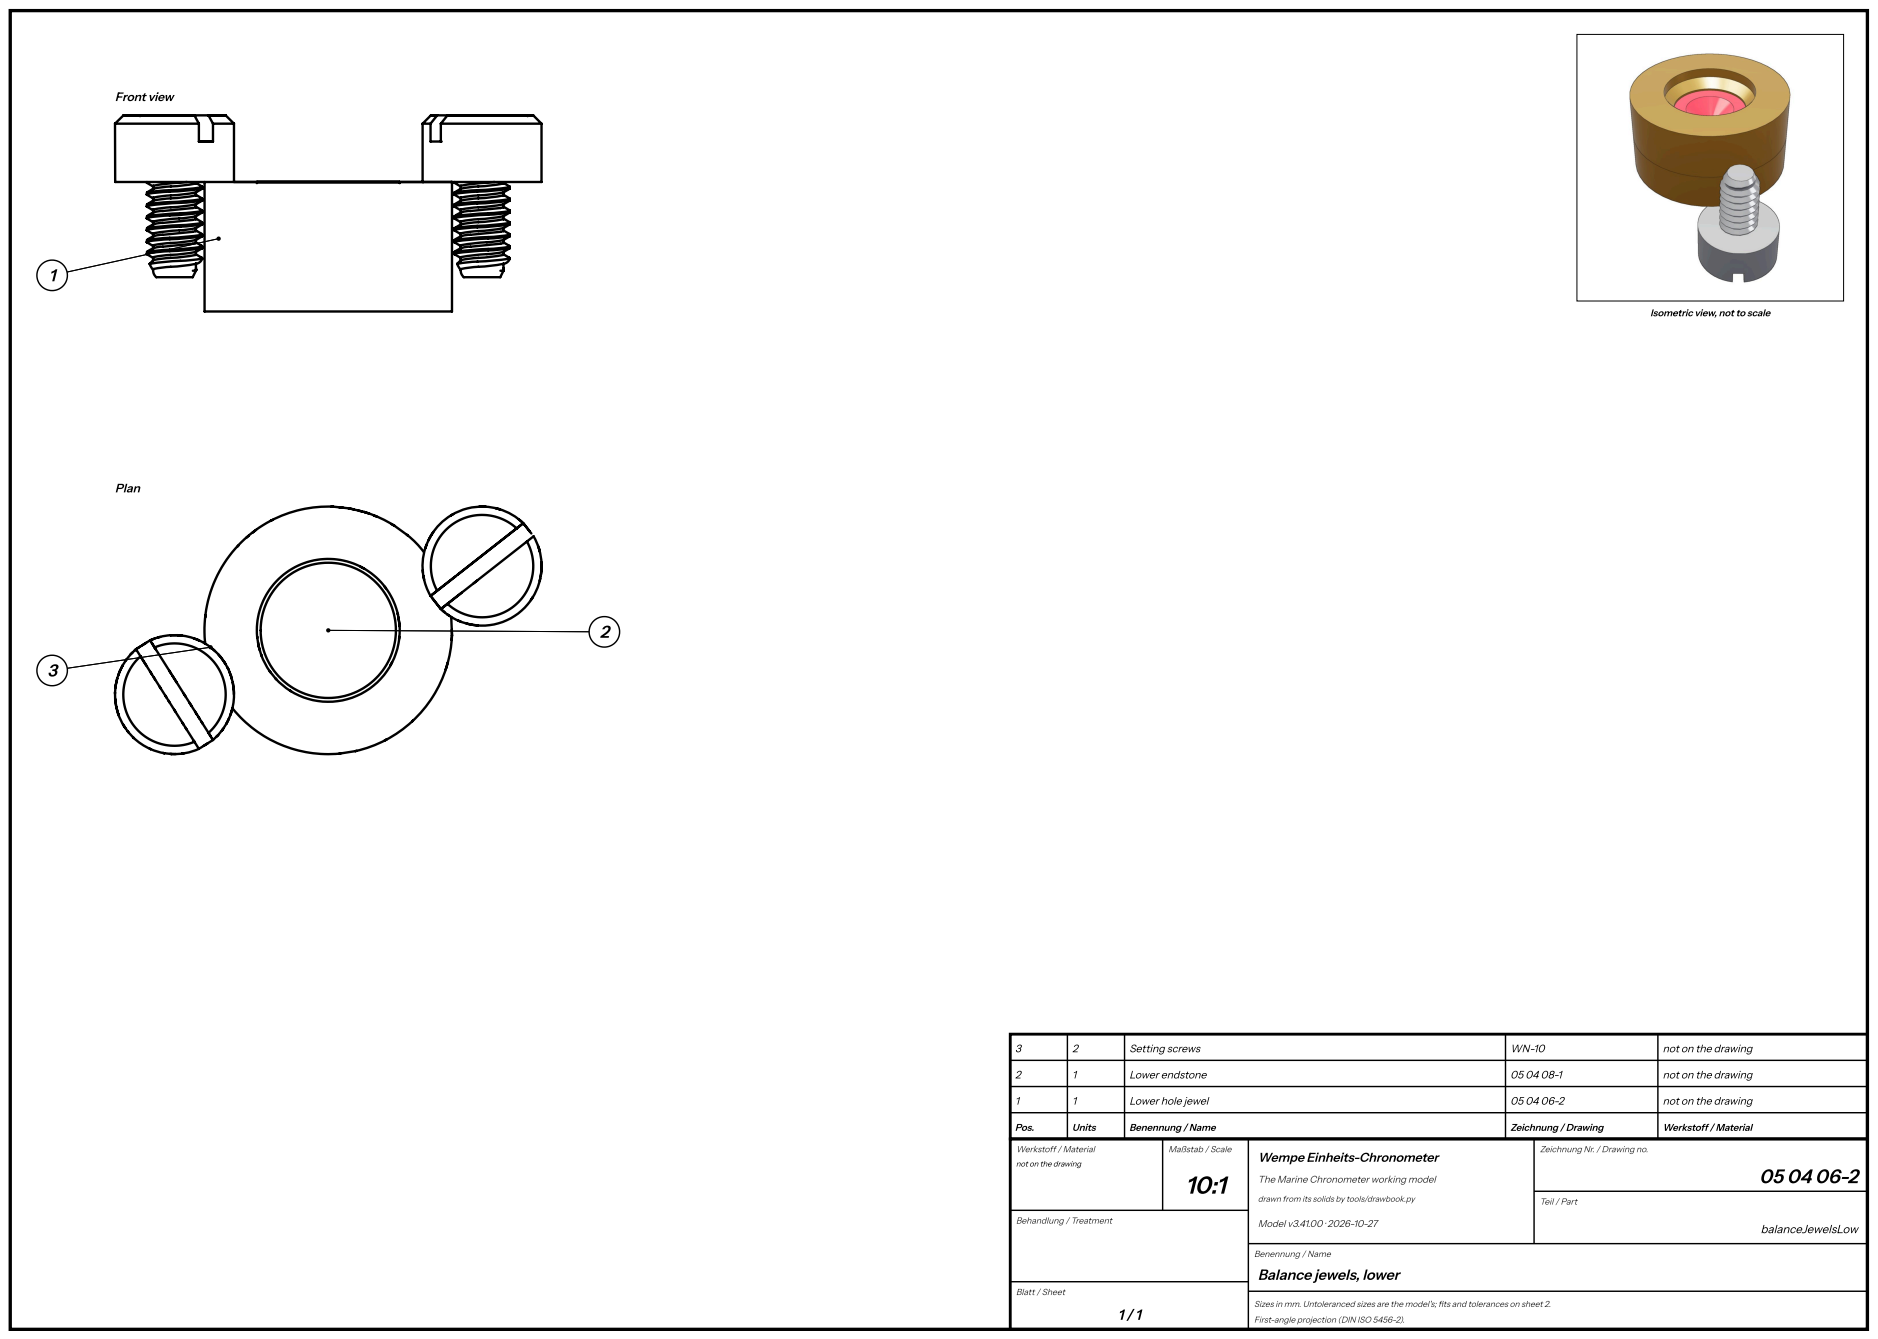
[picture p403: page 188]
Front view; Plan; Pos.; Units; Benennung / Name; Zeichnung / Drawing; Werkstoff / Material; Lower hole jewel; not on the drawing; Lower endstone; Setting screws; Maßstab / Scale; Behandlung / Treatment; Model v3.41.00 · 2026-10-27; Teil / Part; balanceJewelsLow

Isometric view, not to scale

Zeichnung Nr. / Drawing no.

not on the drawing

Wempe Einheits-Chronometer

The Marine Chronometer working model

drawn from its solids by tools/drawbook.py

Balance jewels, lower

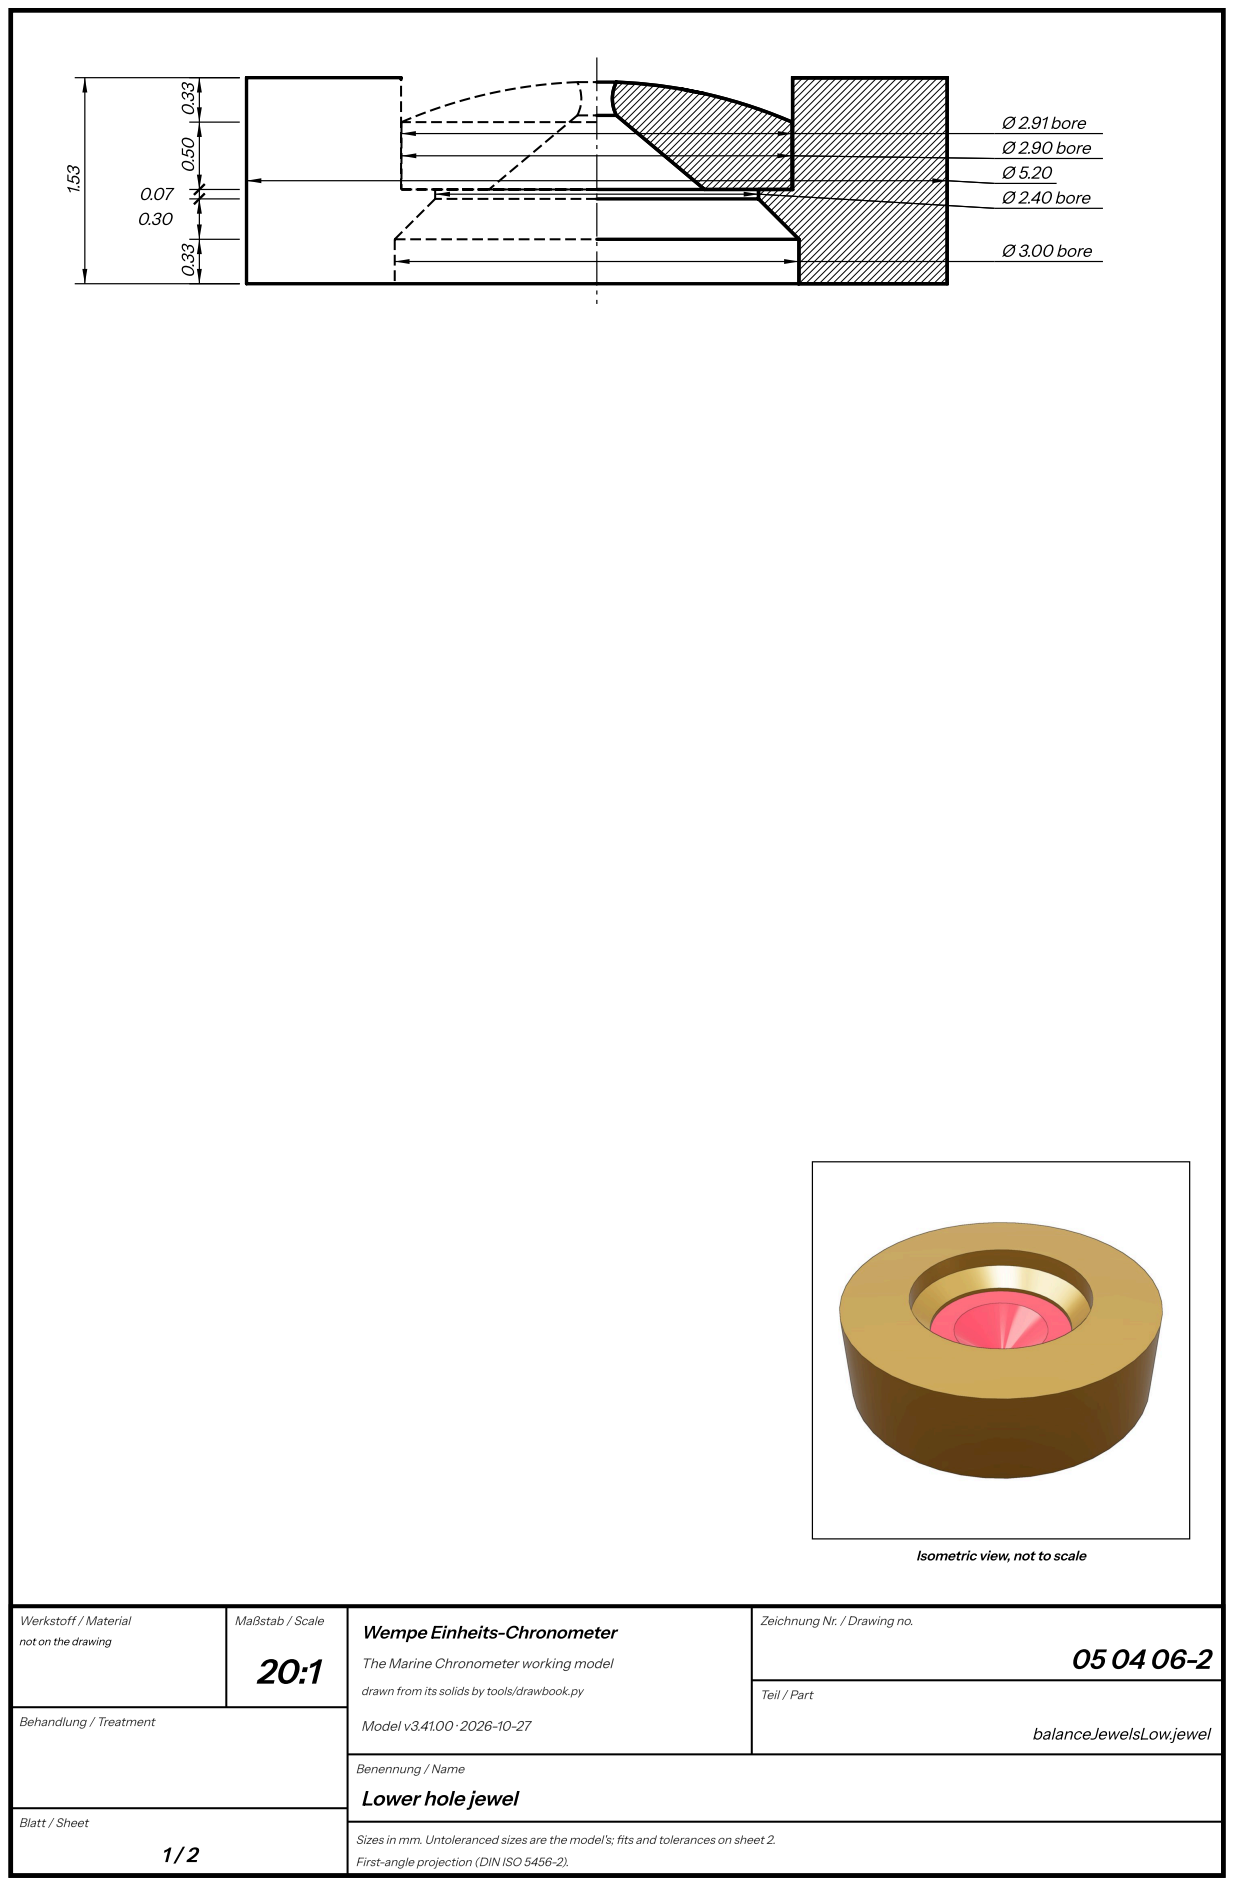
[picture p404: page 189]
Ø 2.91 bore; Ø 2.90 bore; Ø 2.40 bore; Ø 3.00 bore; Werkstoff / Material; Maßstab / Scale; Behandlung / Treatment; Model v3.41.00 · 2026-10-27; Teil / Part; balanceJewelsLow.jewel

Isometric view, not to scale

Zeichnung Nr. / Drawing no.

not on the drawing

Wempe Einheits-Chronometer

The Marine Chronometer working model

drawn from its solids by tools/drawbook.py

Lower hole jewel

## Lower hole jewel — sheet 2

The hole jewel and its setting.

Parts list

Drawing | Name | Units | Material | Finish, heat treatment | Fit, as measured on the model
05 04 06-2 | Fassung (jewel setting), balance, lower | 1 | not on the drawing | | in 050800-2 (press): 1.53 mm, least gap 0.0064
05 04 07-1 | Lagerstein (hole jewel), balance, lower | 1 | not on the drawing | | takes Unruhwelle (balance staff): in it (run): 0.318 mm, least gap 0.0166

What it does (05 04 06-2). Holds the lower hole jewel in the lug of the lower cock.

What it does (05 04 07-1). The staff's lower pivot runs in it.

Turned about its axis; length 1.53, largest Ø 5.20. Diameters: Ø 5.20; bores Ø 2.40, Ø 2.90, Ø 2.91, Ø 3.00. Shoulders from the

lower end: 0.00, 0.33, 0.63, 0.70, 1.20, 1.53.

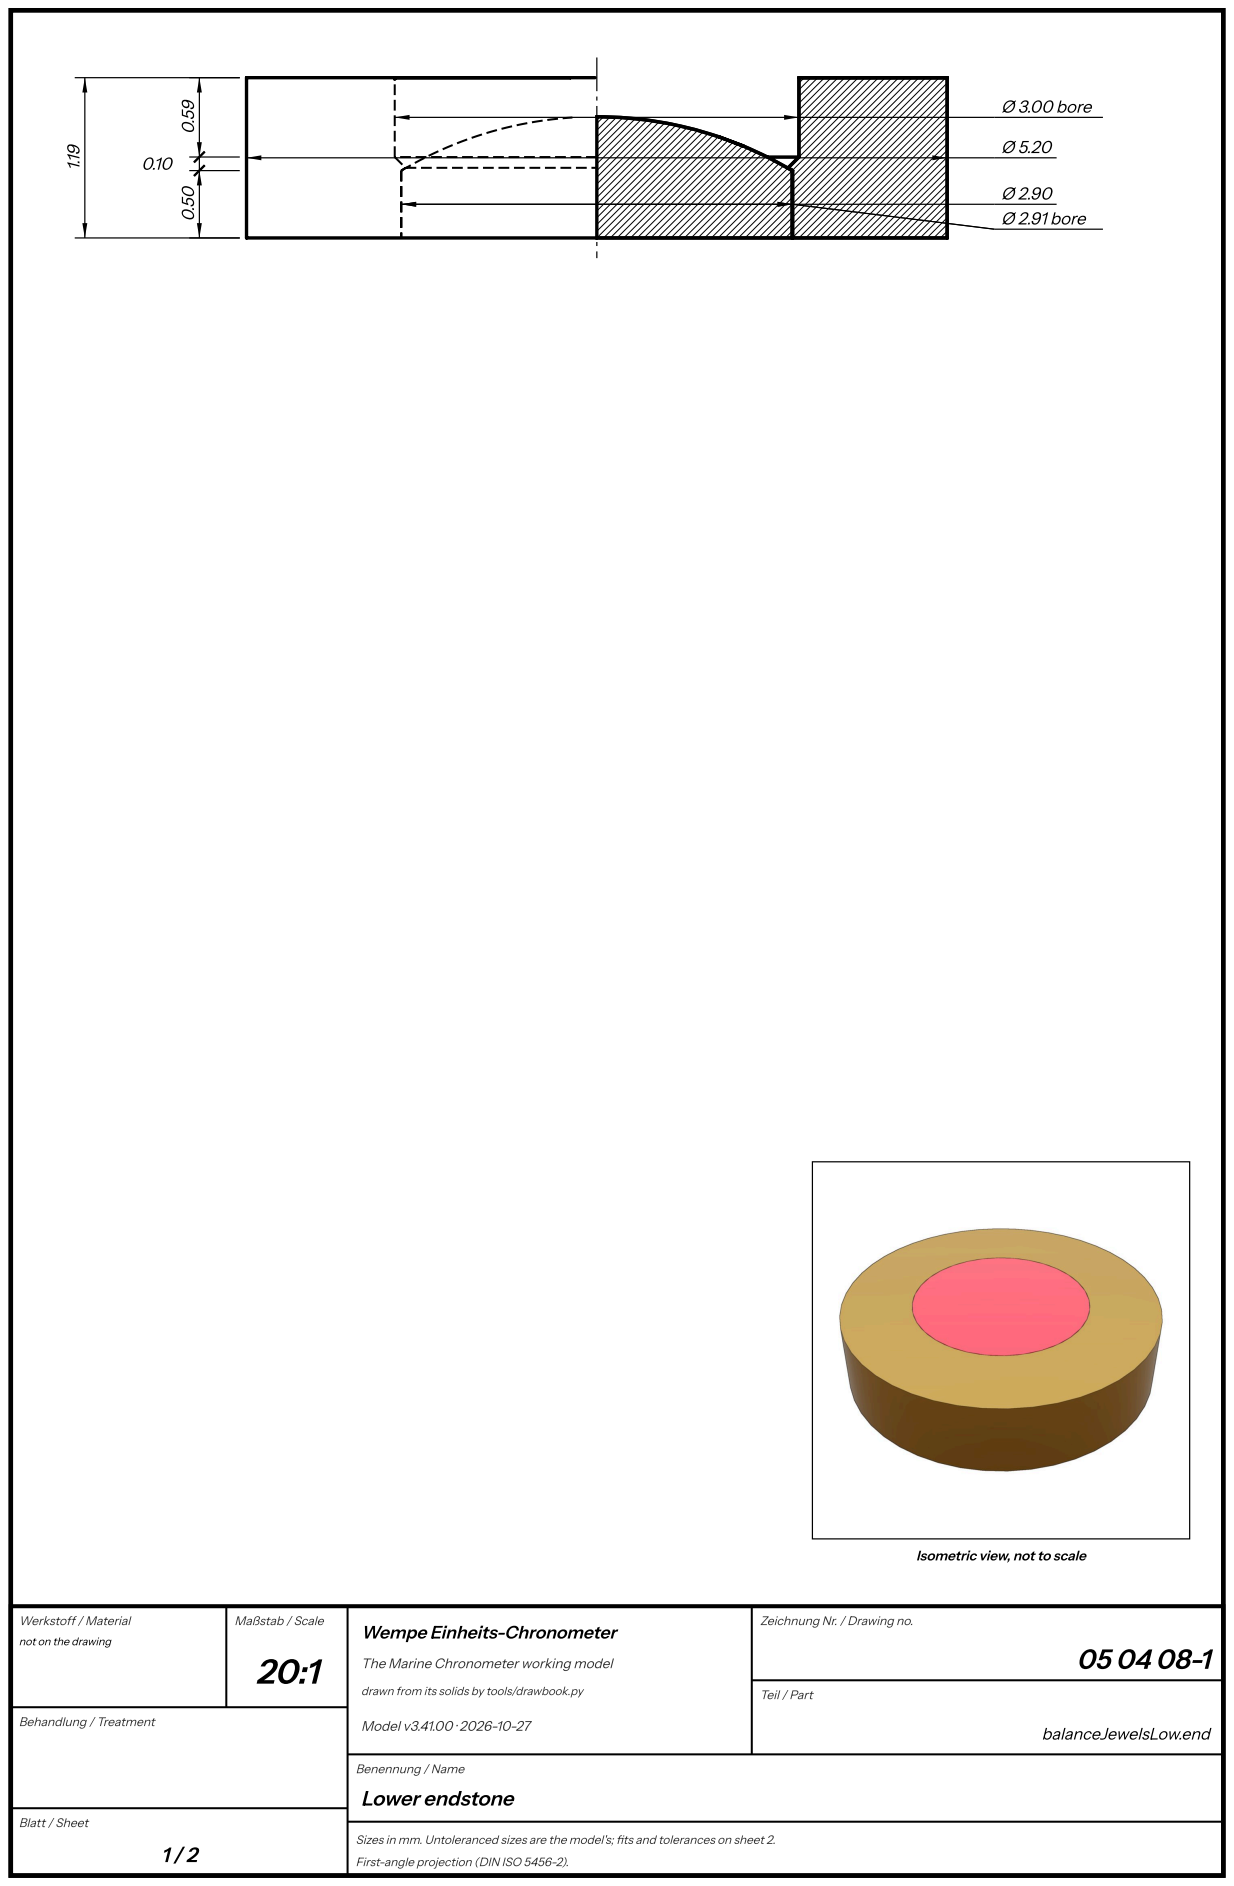
[picture p405: page 191]
Ø 3.00 bore; Ø 2.91 bore; Werkstoff / Material; Maßstab / Scale; Behandlung / Treatment; Model v3.41.00 · 2026-10-27; Teil / Part; balanceJewelsLow.end; Lower endstone

Isometric view, not to scale

Zeichnung Nr. / Drawing no.

not on the drawing

Wempe Einheits-Chronometer

The Marine Chronometer working model

drawn from its solids by tools/drawbook.py

## Lower endstone — sheet 2

The endstone and its setting.

Parts list

Drawing | Name | Units | Material | Finish, heat treatment | Fit, as measured on the model
05 04 08-1 | Deckstein (endstone), balance, lower | 1 | not on the drawing | | not measured on the model: see its function, Stops the staff's lower pivot end.
05 04 08-2 | Fassung (endstone setting), balance, lower | 1 | not on the drawing | | in 050800-2 (press): 1.19 mm, least gap 0.0064

What it does (05 04 08-1). Stops the staff's lower pivot end.

What it does (05 04 08-2). Holds the lower endstone.

Turned about its axis; length 1.19, largest Ø 5.20. Diameters: Ø 2.90, Ø 5.20; bores Ø 2.91, Ø 3.00. Shoulders from the lower

end: 0.00, 0.50, 0.60, 1.19.

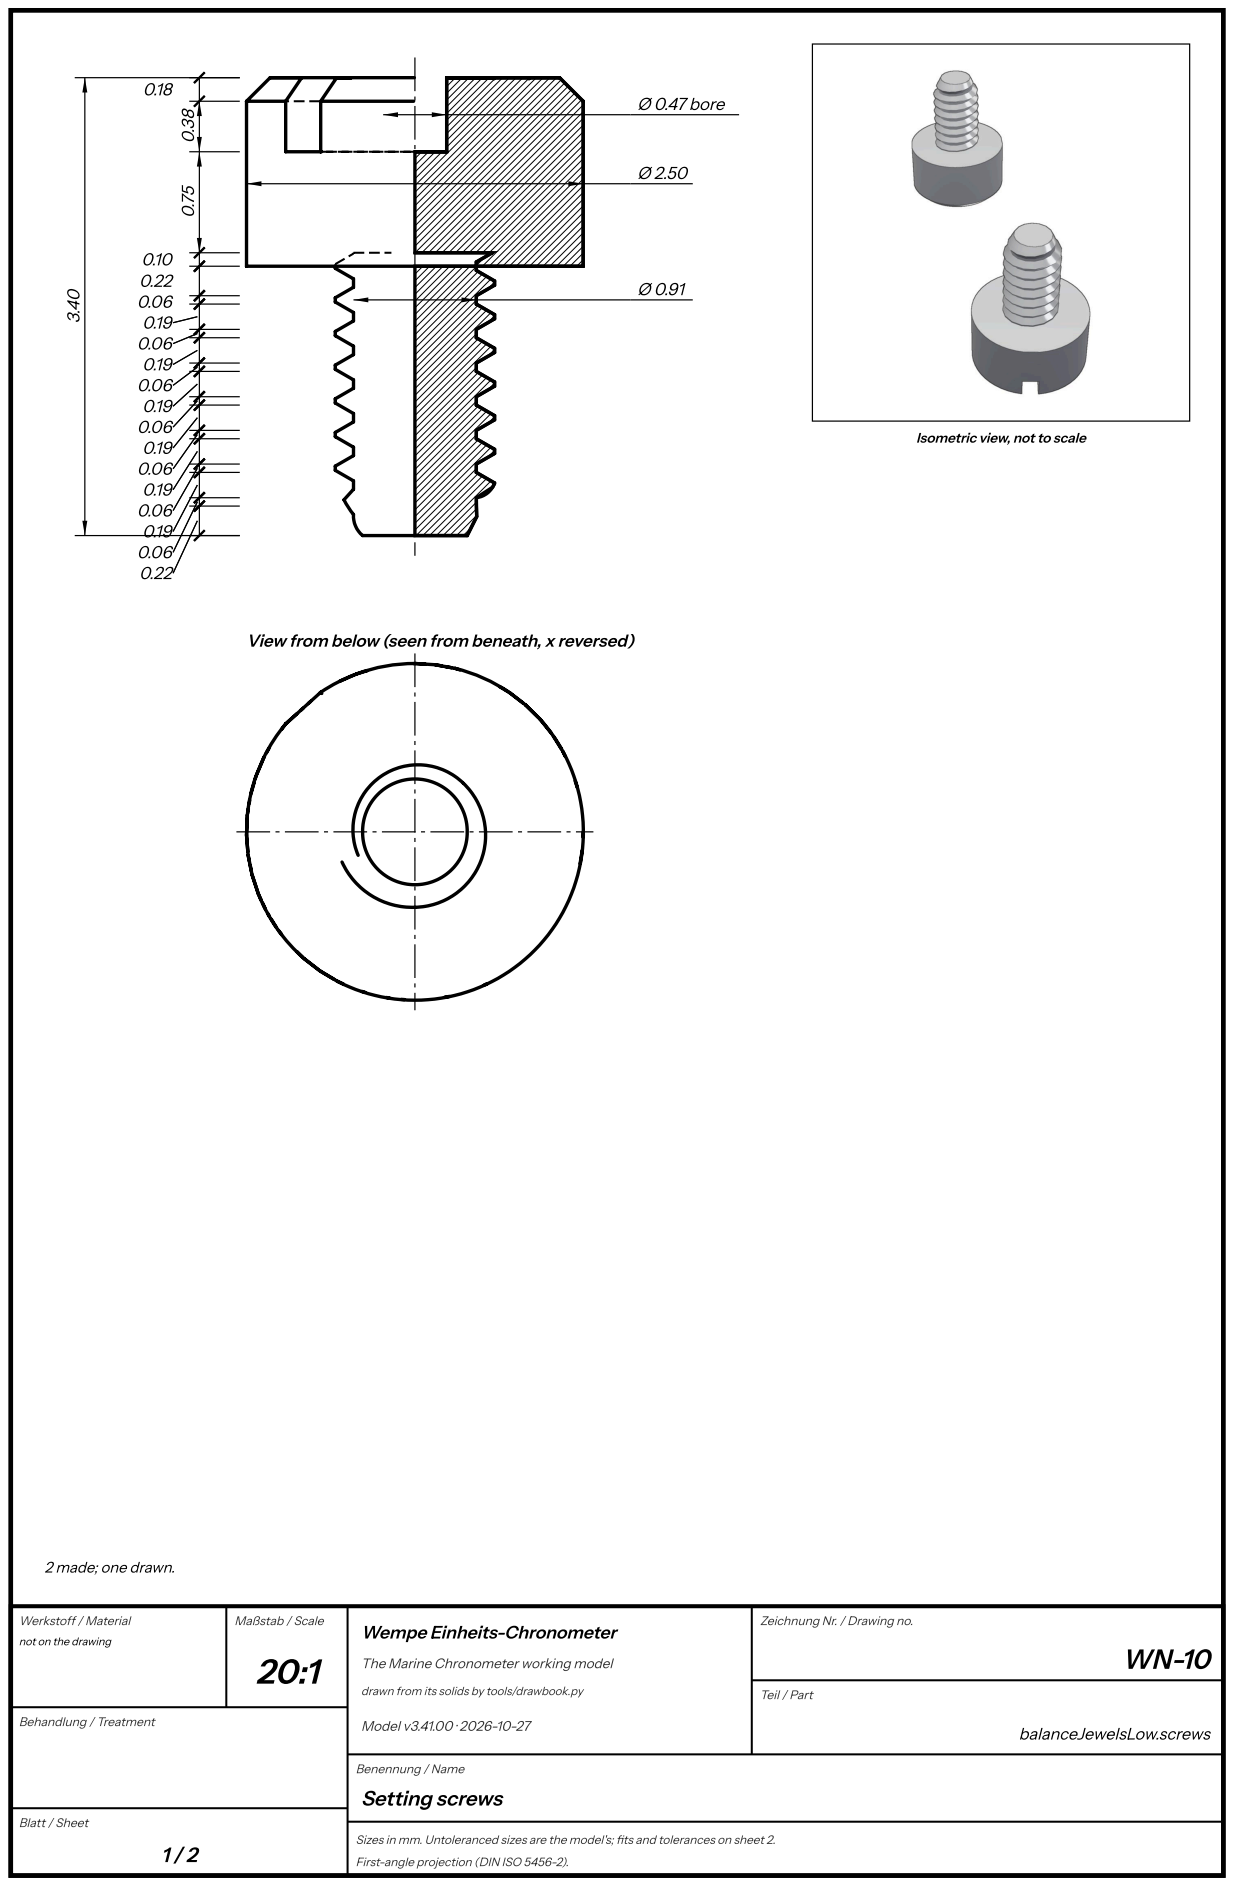
[picture p406: page 193]
Ø 0.47 bore; Werkstoff / Material; Maßstab / Scale; Behandlung / Treatment; Model v3.41.00 · 2026-10-27; Teil / Part; balanceJewelsLow.screws; Setting screws

Isometric view, not to scale

View from below (seen from beneath, x reversed)

2 made; one drawn.

Zeichnung Nr. / Drawing no.

not on the drawing

Wempe Einheits-Chronometer

The Marine Chronometer working model

drawn from its solids by tools/drawbook.py

## Setting screws — sheet 2

Two screws holding the settings in the lug.

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

Parts list

Drawing | Name | Units | Material | Finish, heat treatment | Fit, as measured on the model
WN-10 | Schraube (WN-10 by the coloured section's label, its last digit 0 or 8: likely 10), the lower settings' screws, M1.2 | 2 | not on the drawing | | in 050800-2 (tap): 2.021 mm, least gap 0.0137; on 050408-2.bl: 0 mm

What it does (WN-10). Hold the lower settings in the lug.

Turned about its axis; length 3.40, largest Ø 2.50. Diameters: Ø 0.91, Ø 2.50; bores Ø 0.47. Shoulders from the lower end:

0.00, 0.22, 0.28, 0.47, 0.53, 0.72, 0.78, 0.97, 1.03, 1.22, 1.28, 1.47, 1.53, 1.72, 1.78, 2.00, 2.10, 2.85, 3.23, 3.40.

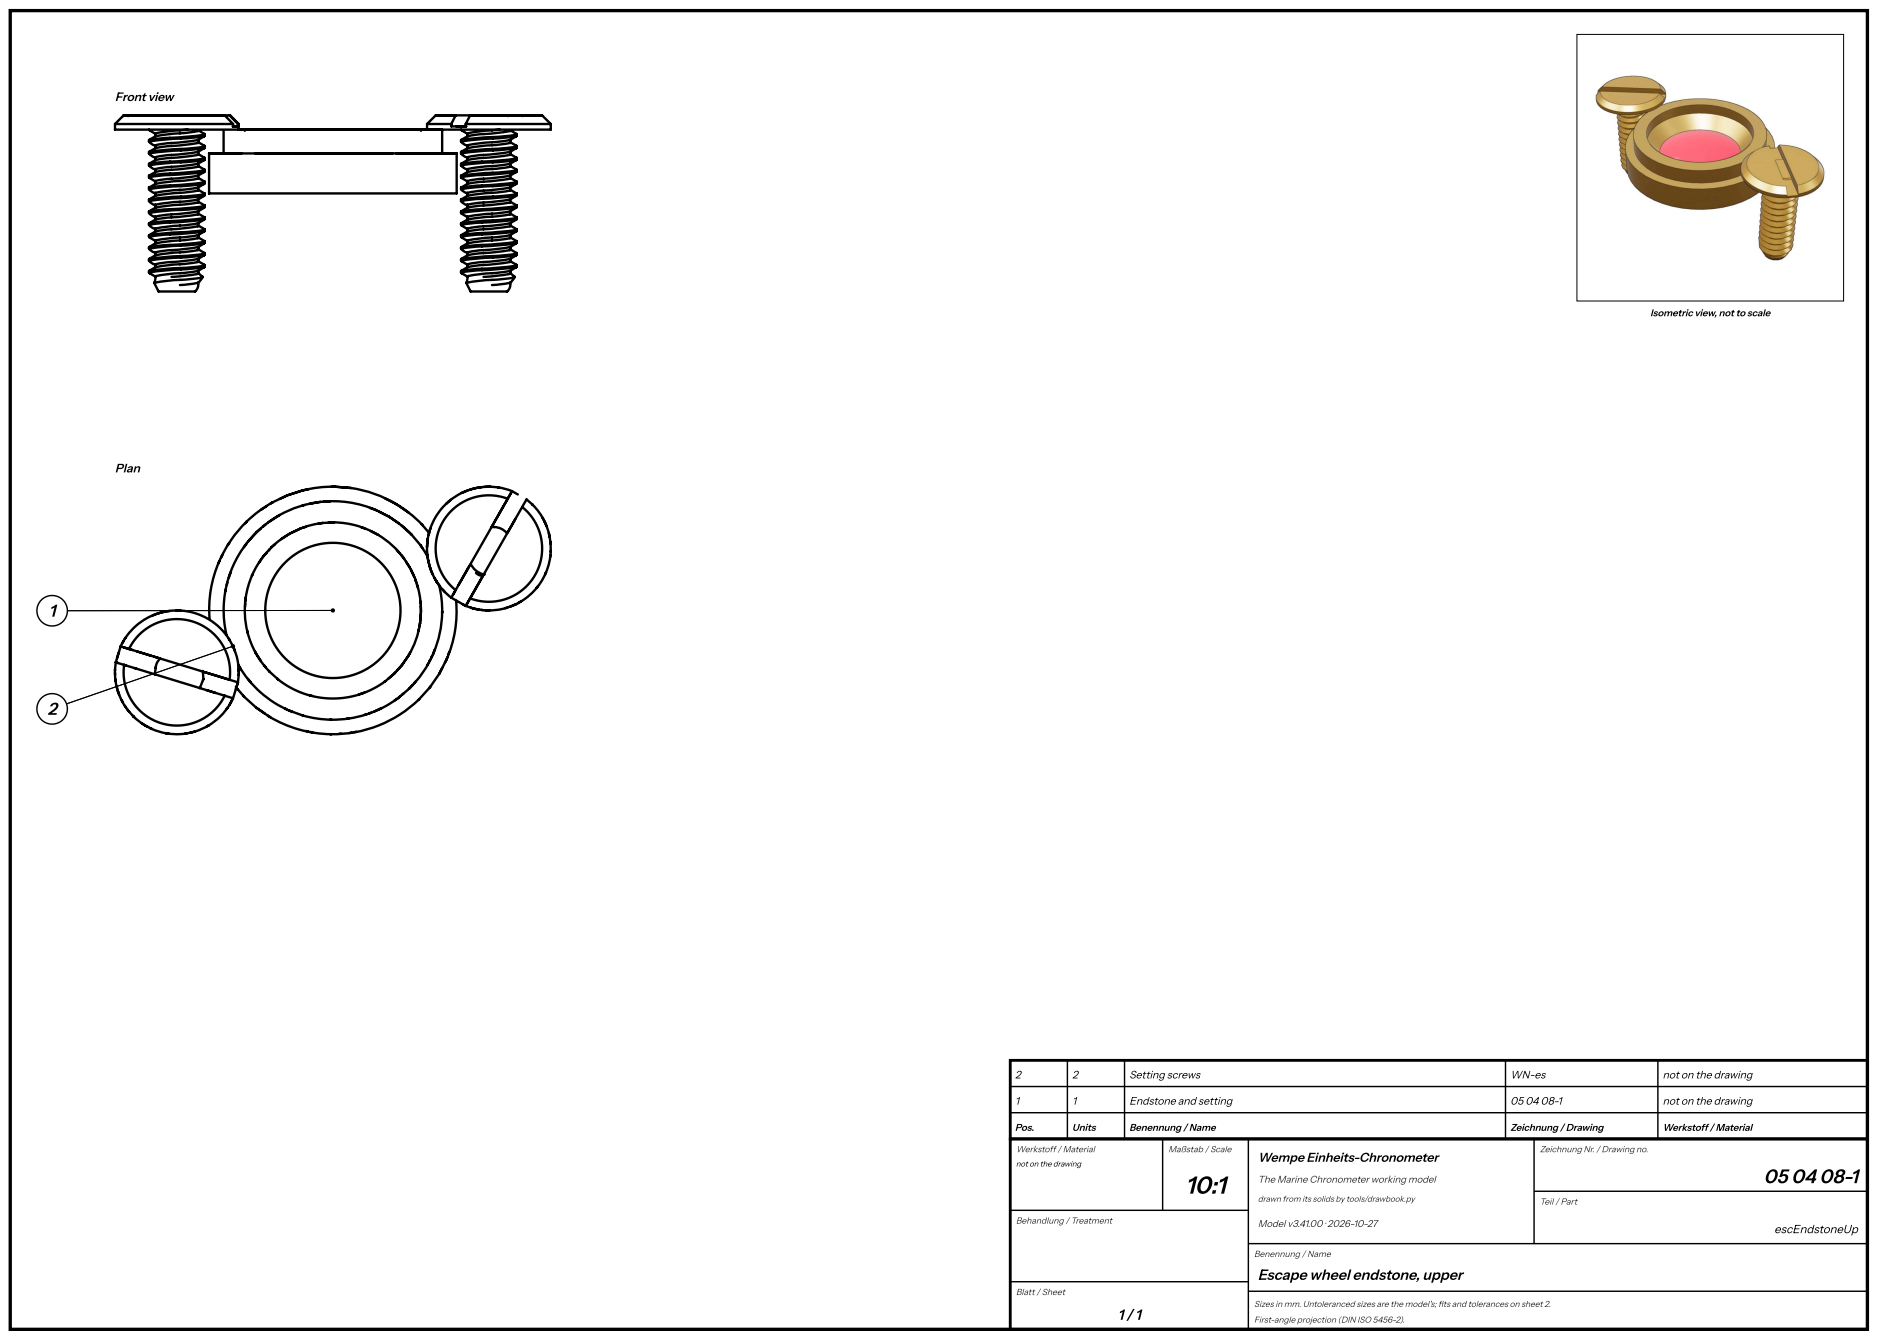
[picture p407: page 195]
Front view; Plan; Pos.; Units; Benennung / Name; Zeichnung / Drawing; Werkstoff / Material; Endstone and setting; not on the drawing; Setting screws; Maßstab / Scale; Behandlung / Treatment; Model v3.41.00 · 2026-10-27; Teil / Part; escEndstoneUp

Isometric view, not to scale

Zeichnung Nr. / Drawing no.

not on the drawing

Wempe Einheits-Chronometer

The Marine Chronometer working model

drawn from its solids by tools/drawbook.py

Escape wheel endstone, upper

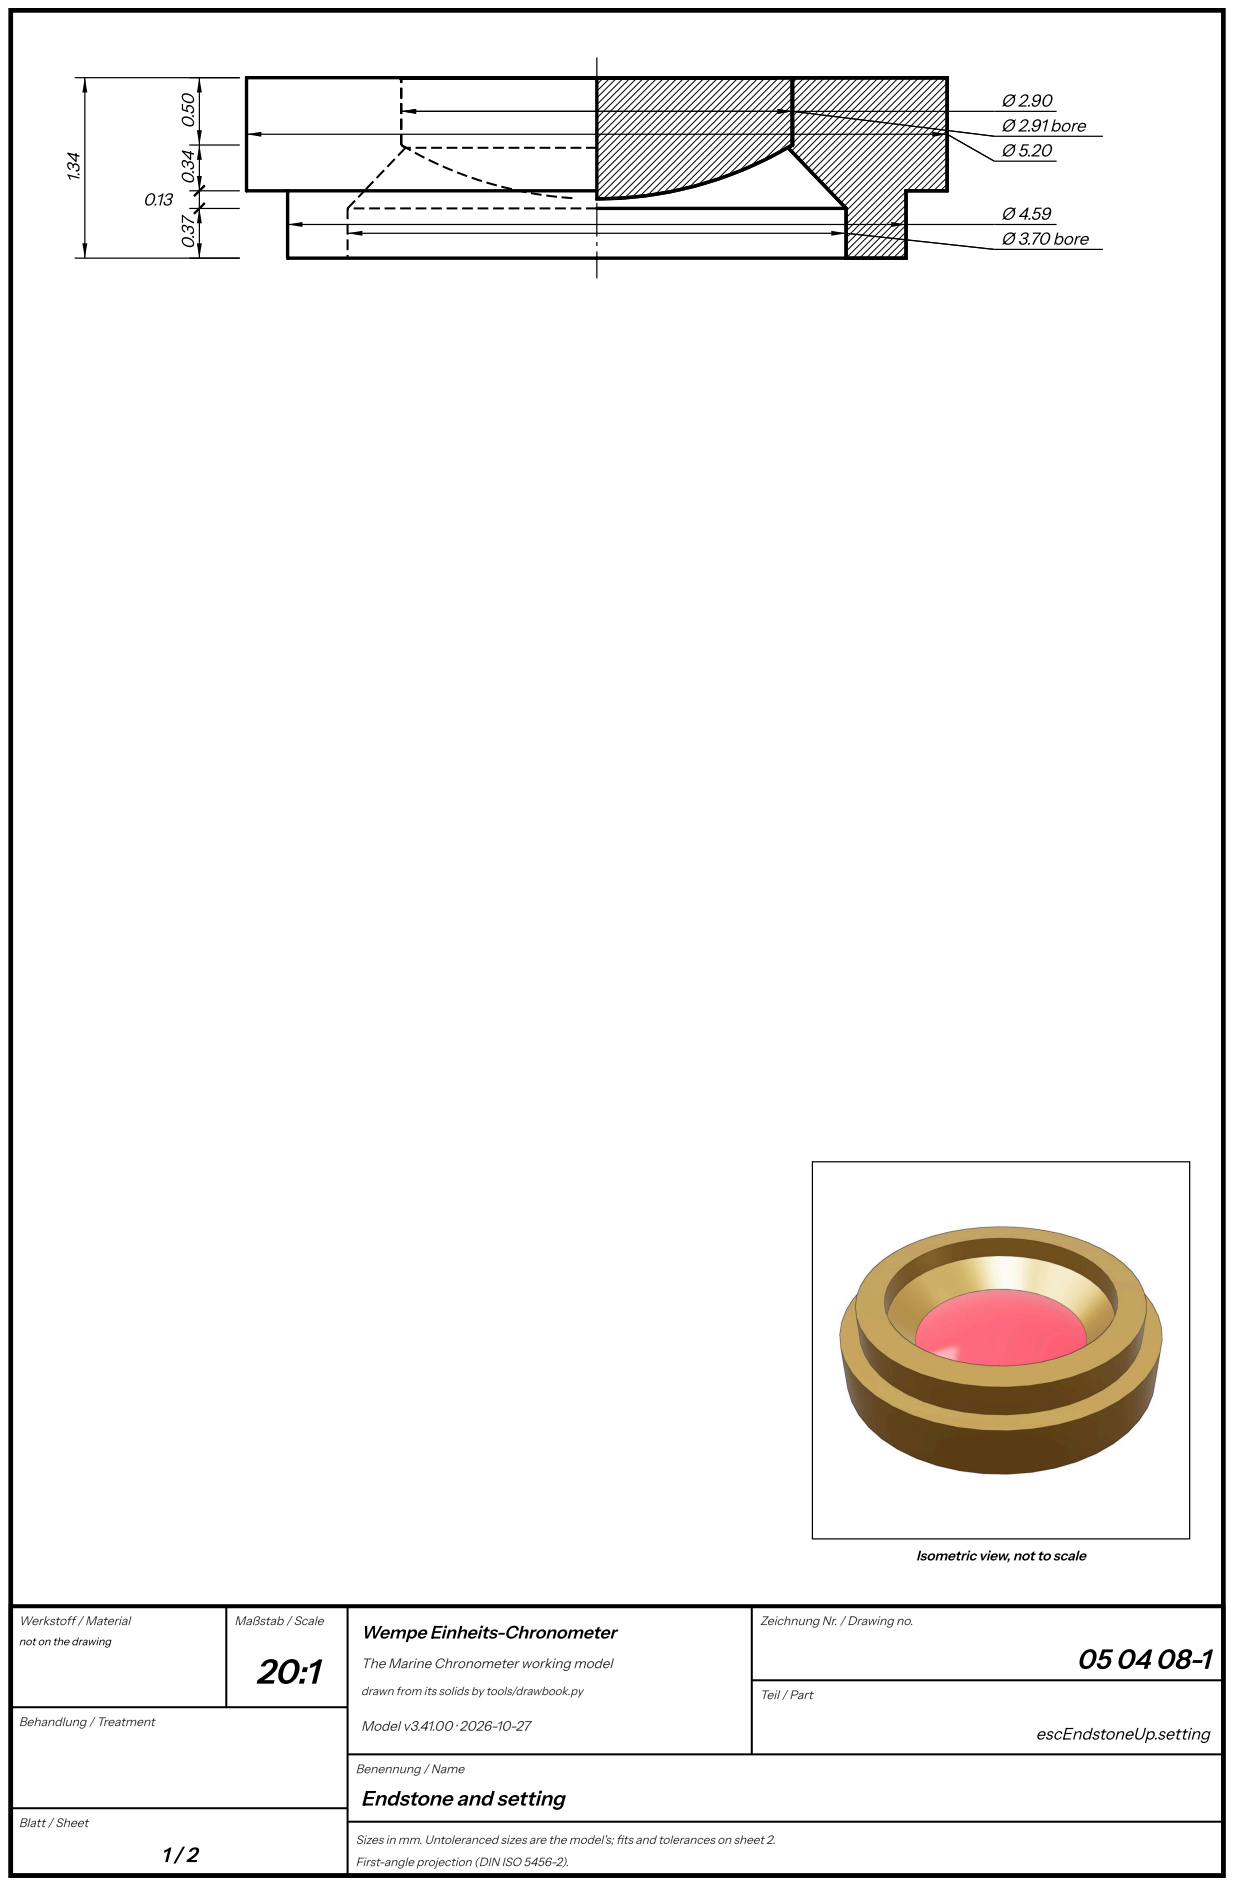
[picture p408: page 196]
Ø 2.91 bore; Ø 3.70 bore; Werkstoff / Material; Maßstab / Scale; Behandlung / Treatment; Model v3.41.00 · 2026-10-27; Teil / Part; escEndstoneUp.setting

Isometric view, not to scale

Zeichnung Nr. / Drawing no.

not on the drawing

Wempe Einheits-Chronometer

The Marine Chronometer working model

drawn from its solids by tools/drawbook.py

Endstone and setting

## Endstone and setting — sheet 2

The endstone over the escape wheel arbor’s upper pivot: its gilt setting goes up into the top plate’s seat from inside, its

spigot through the lip flush with the plate’s face, the whole domed ruby showing in its bevelled mouth, and two brass

screws put in from outside hold it, their heads at its edge.

Parts list

Drawing | Name | Units | Material | Finish, heat treatment | Fit, as measured on the model
05 04 08-1 | Deckstein (endstone), escape wheel, upper | 1 | not on the drawing | | not measured on the model: see its function, Stops the escape arbor's upper pivot end.
05 04 08-2 | Fassung (endstone setting), escape wheel, upper | 1 | not on the drawing | | in 050901 (press): 2.83 mm, least gap 0.0058

What it does (05 04 08-1). Stops the escape arbor's upper pivot end.

What it does (05 04 08-2). Holds the upper endstone in the top plate's seat.

Turned about its axis; length 1.34, largest Ø 5.20. Diameters: Ø 2.90, Ø 4.59, Ø 5.20; bores Ø 2.91, Ø 3.70. Shoulders from the

lower end: 0.00, 0.37, 0.50, 0.84, 1.34.

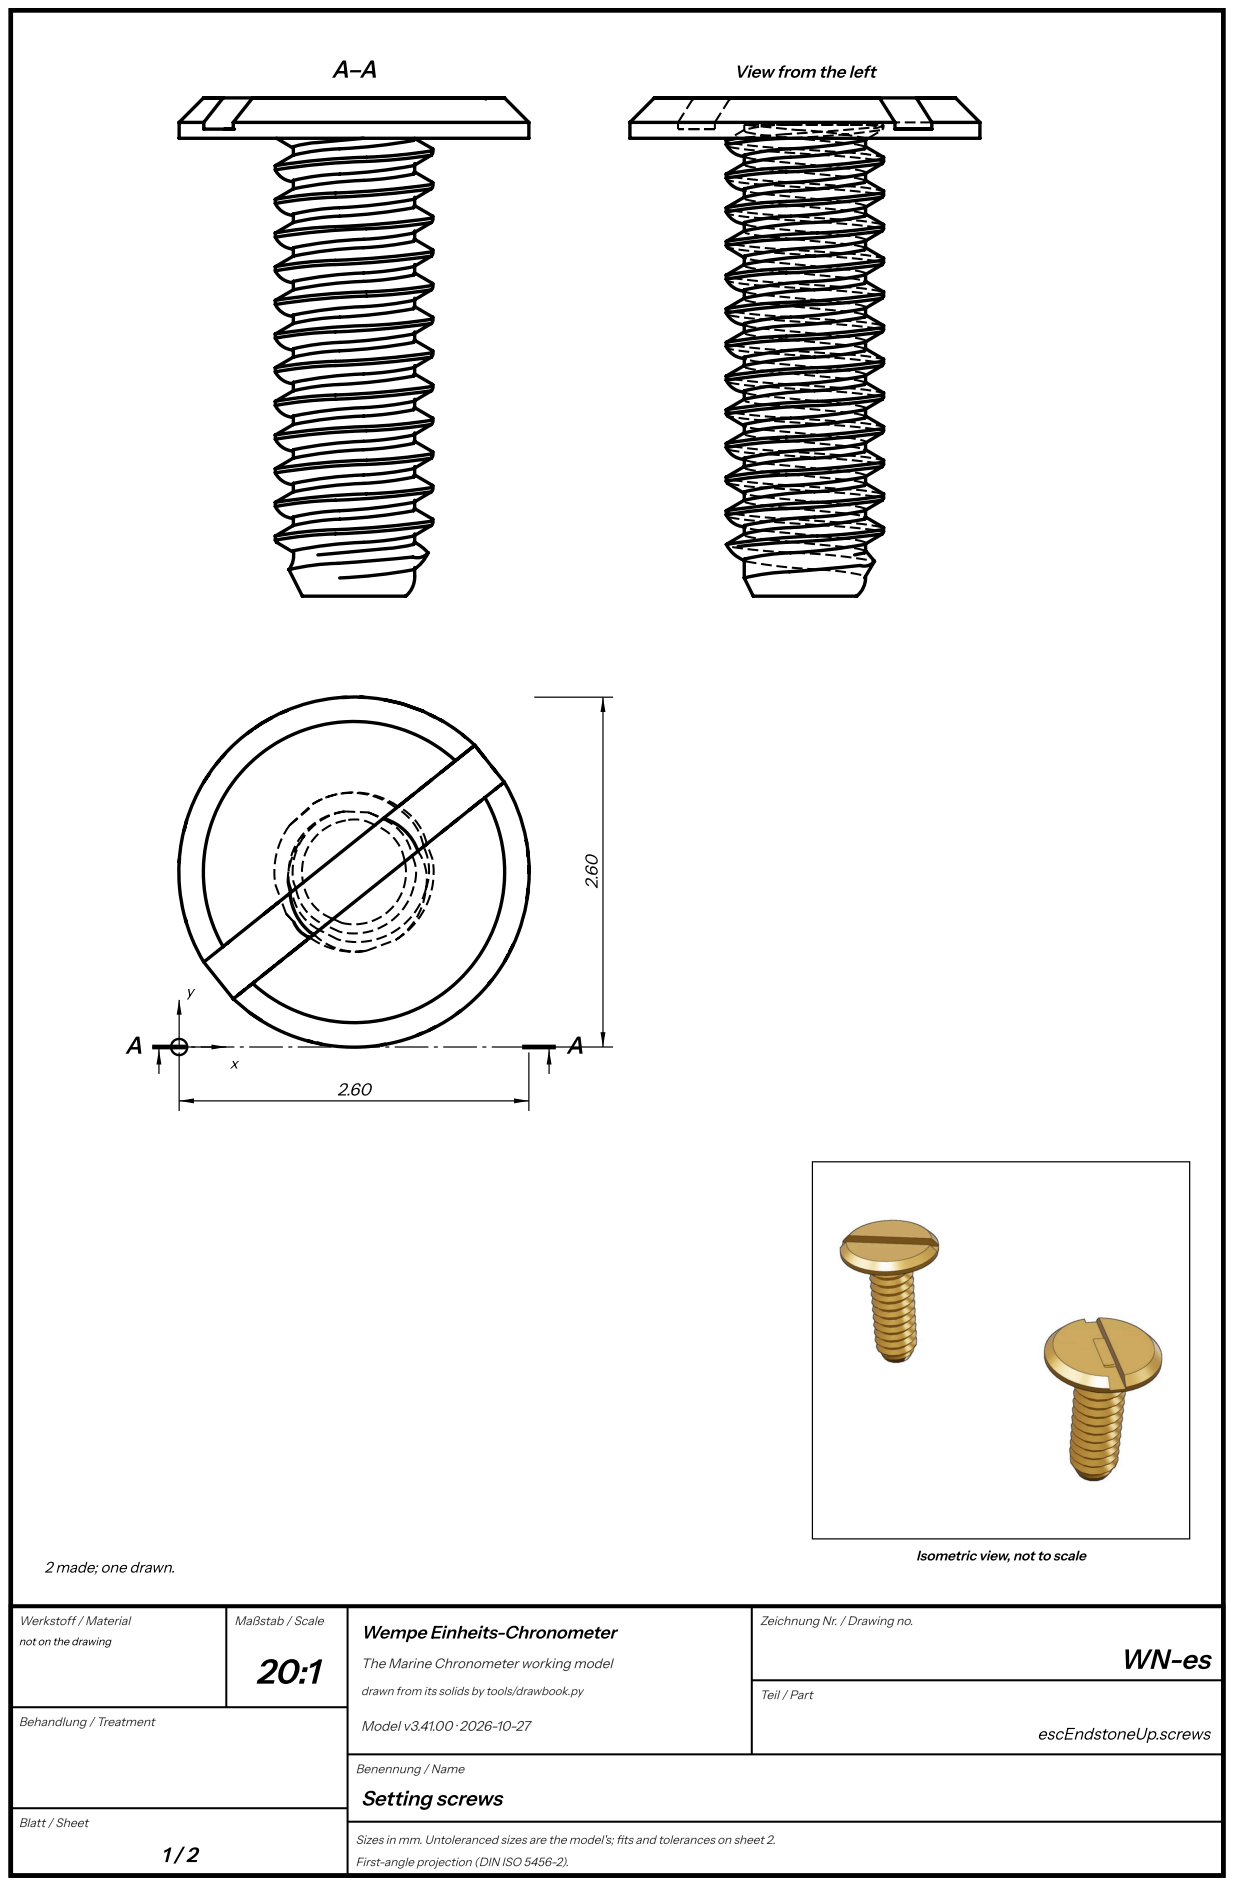
[picture p409: page 198]
Werkstoff / Material; Maßstab / Scale; Behandlung / Treatment; Model v3.41.00 · 2026-10-27; Teil / Part; escEndstoneUp.screws; Setting screws

View from the left

2 made; one drawn.

Isometric view, not to scale

Zeichnung Nr. / Drawing no.

not on the drawing

Wempe Einheits-Chronometer

The Marine Chronometer working model

drawn from its solids by tools/drawbook.py

## Setting screws — sheet 2

Two brass screws put in from outside, their heads at the setting’s edge.

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

Parts list

Drawing | Name | Units | Material | Finish, heat treatment | Fit, as measured on the model
WN-es | Escape endstone screws, upper, M1.2 (their WN number not read) | 2 | not on the drawing | | in 050901 (tap): 3.36 mm, least gap 0.0112; on 050901: 0 mm

What it does (WN-es). Put in from outside: hold the upper endstone's setting, their heads over its spigot's edge (Wempe

3955).

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

drawn; depths from the face seen in the plan (the top). Thickness 3.70.

Contourin the plan

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

radius.

Contour | # | Element | From x, y | To x, y | Centre x, y | R
Outline | 1 | circle | | | 1.30, 1.30 | 1.30

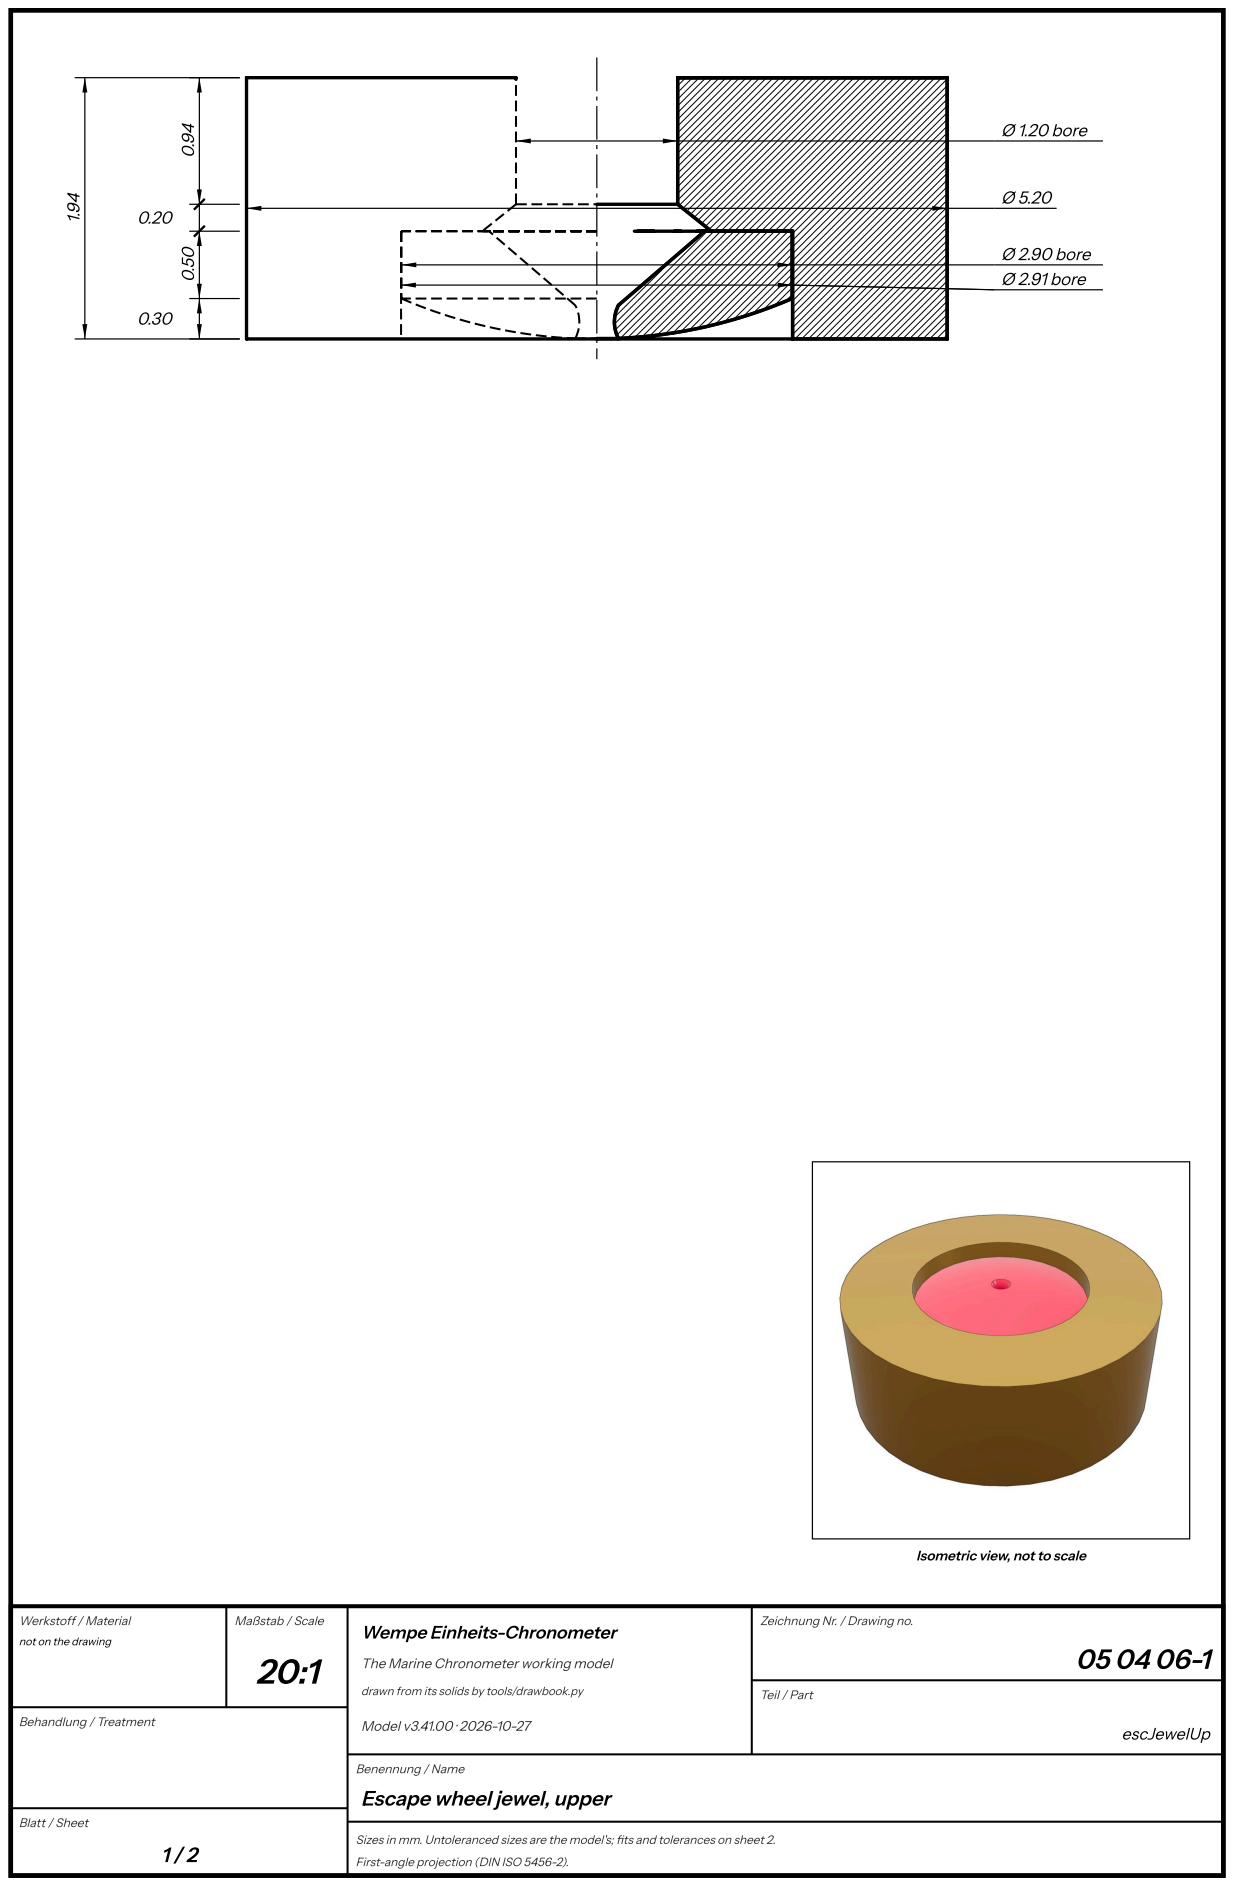
[picture p410: page 200]
Ø 1.20 bore; Ø 2.90 bore; Ø 2.91 bore; Werkstoff / Material; Maßstab / Scale; Behandlung / Treatment; Model v3.41.00 · 2026-10-27; Teil / Part; escJewelUp

Isometric view, not to scale

Zeichnung Nr. / Drawing no.

not on the drawing

Wempe Einheits-Chronometer

The Marine Chronometer working model

drawn from its solids by tools/drawbook.py

Escape wheel jewel, upper

## Escape wheel jewel, upper — sheet 2

The escape wheel arbor’s upper hole jewel, in its setting flush with the top plate’s inner face, held by two screws whose

heads lie over its edge. It is domed toward the endstone, with an oil sink opening toward the wheel.

Parts list

Drawing | Name | Units | Material | Finish, heat treatment | Fit, as measured on the model
05 04 06-1 | Lagerstein (hole jewel), escape wheel, upper | 1 | not on the drawing | | takes Gangtrieb (escape pinion, z 10, m 0.263, and arbor): in it (run): 0.141 mm, least gap 0.0189
05 04 06-2 | Fassung (jewel setting), escape wheel, upper | 1 | not on the drawing | | in 050901 (press): 0.45 mm, least gap 0.0064

What it does (05 04 06-1). The escape arbor's upper pivot (Ø 0.24) runs in it.

What it does (05 04 06-2). Holds the upper hole jewel, flush with the top plate's inner face.

Turned about its axis; length 1.94, largest Ø 5.20. Diameters: Ø 5.20; bores Ø 1.20, Ø 2.90, Ø 2.91. Shoulders from the lower

end: 0.00, 0.30, 0.80, 1.00, 1.94.

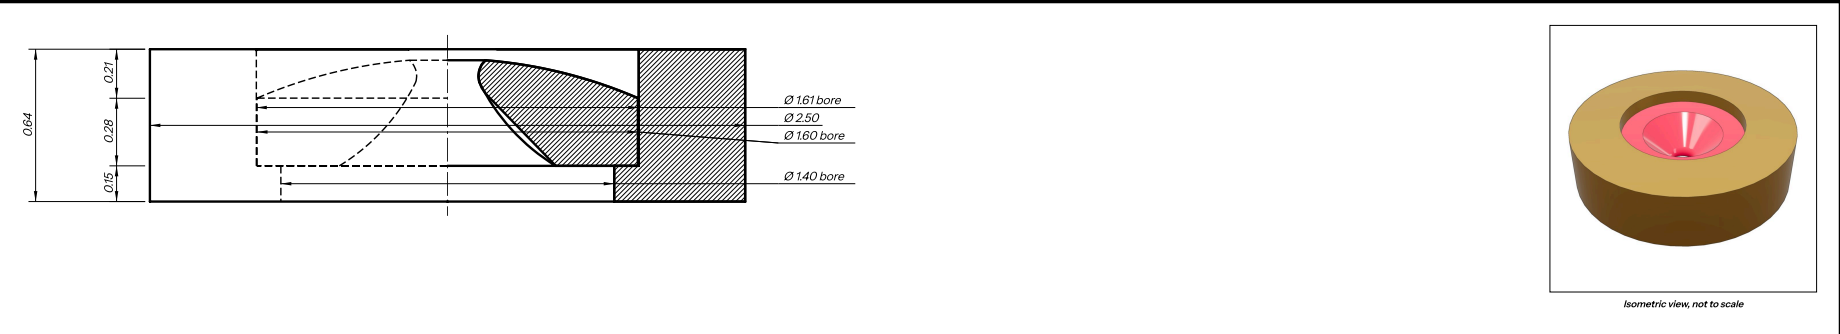
[picture p411: page 202]
Ø 1.61 bore; Ø 1.60 bore; Ø 1.40 bore; Werkstoff / Material; Maßstab / Scale; Behandlung / Treatment; Model v3.41.00 · 2026-10-27; Teil / Part; escJewelLow

Isometric view, not to scale

Zeichnung Nr. / Drawing no.

not on the drawing

Wempe Einheits-Chronometer

The Marine Chronometer working model

drawn from its solids by tools/drawbook.py

Escape wheel jewel, lower

## Escape wheel jewel, lower — sheet 2

The escape wheel arbor’s lower hole jewel, in a bush pressed into the pillar plate, domed toward the endstone under it,

with an oil sink opening toward the wheel.

Parts list

Drawing | Name | Units | Material | Finish, heat treatment | Fit, as measured on the model
05 04 06-1 | Lagerstein (hole jewel), escape wheel, lower | 1 | not on the drawing | | takes Gangtrieb (escape pinion, z 10, m 0.263, and arbor): in it (run): 0.141 mm, least gap 0.0121
05 04 06-2 | Fassung (jewel bush), escape wheel, lower | 1 | not on the drawing | | in 050802-1 (press): 0.42 mm, least gap 0.0009

What it does (05 04 06-1). The escape arbor's lower pivot runs in it.

What it does (05 04 06-2). Pressed into the pillar plate's hole 26, holding the lower hole jewel.

Turned about its axis; length 0.64, largest Ø 2.50. Diameters: Ø 2.50; bores Ø 1.40, Ø 1.60, Ø 1.61. Shoulders from the lower

end: 0.00, 0.15, 0.43, 0.64.

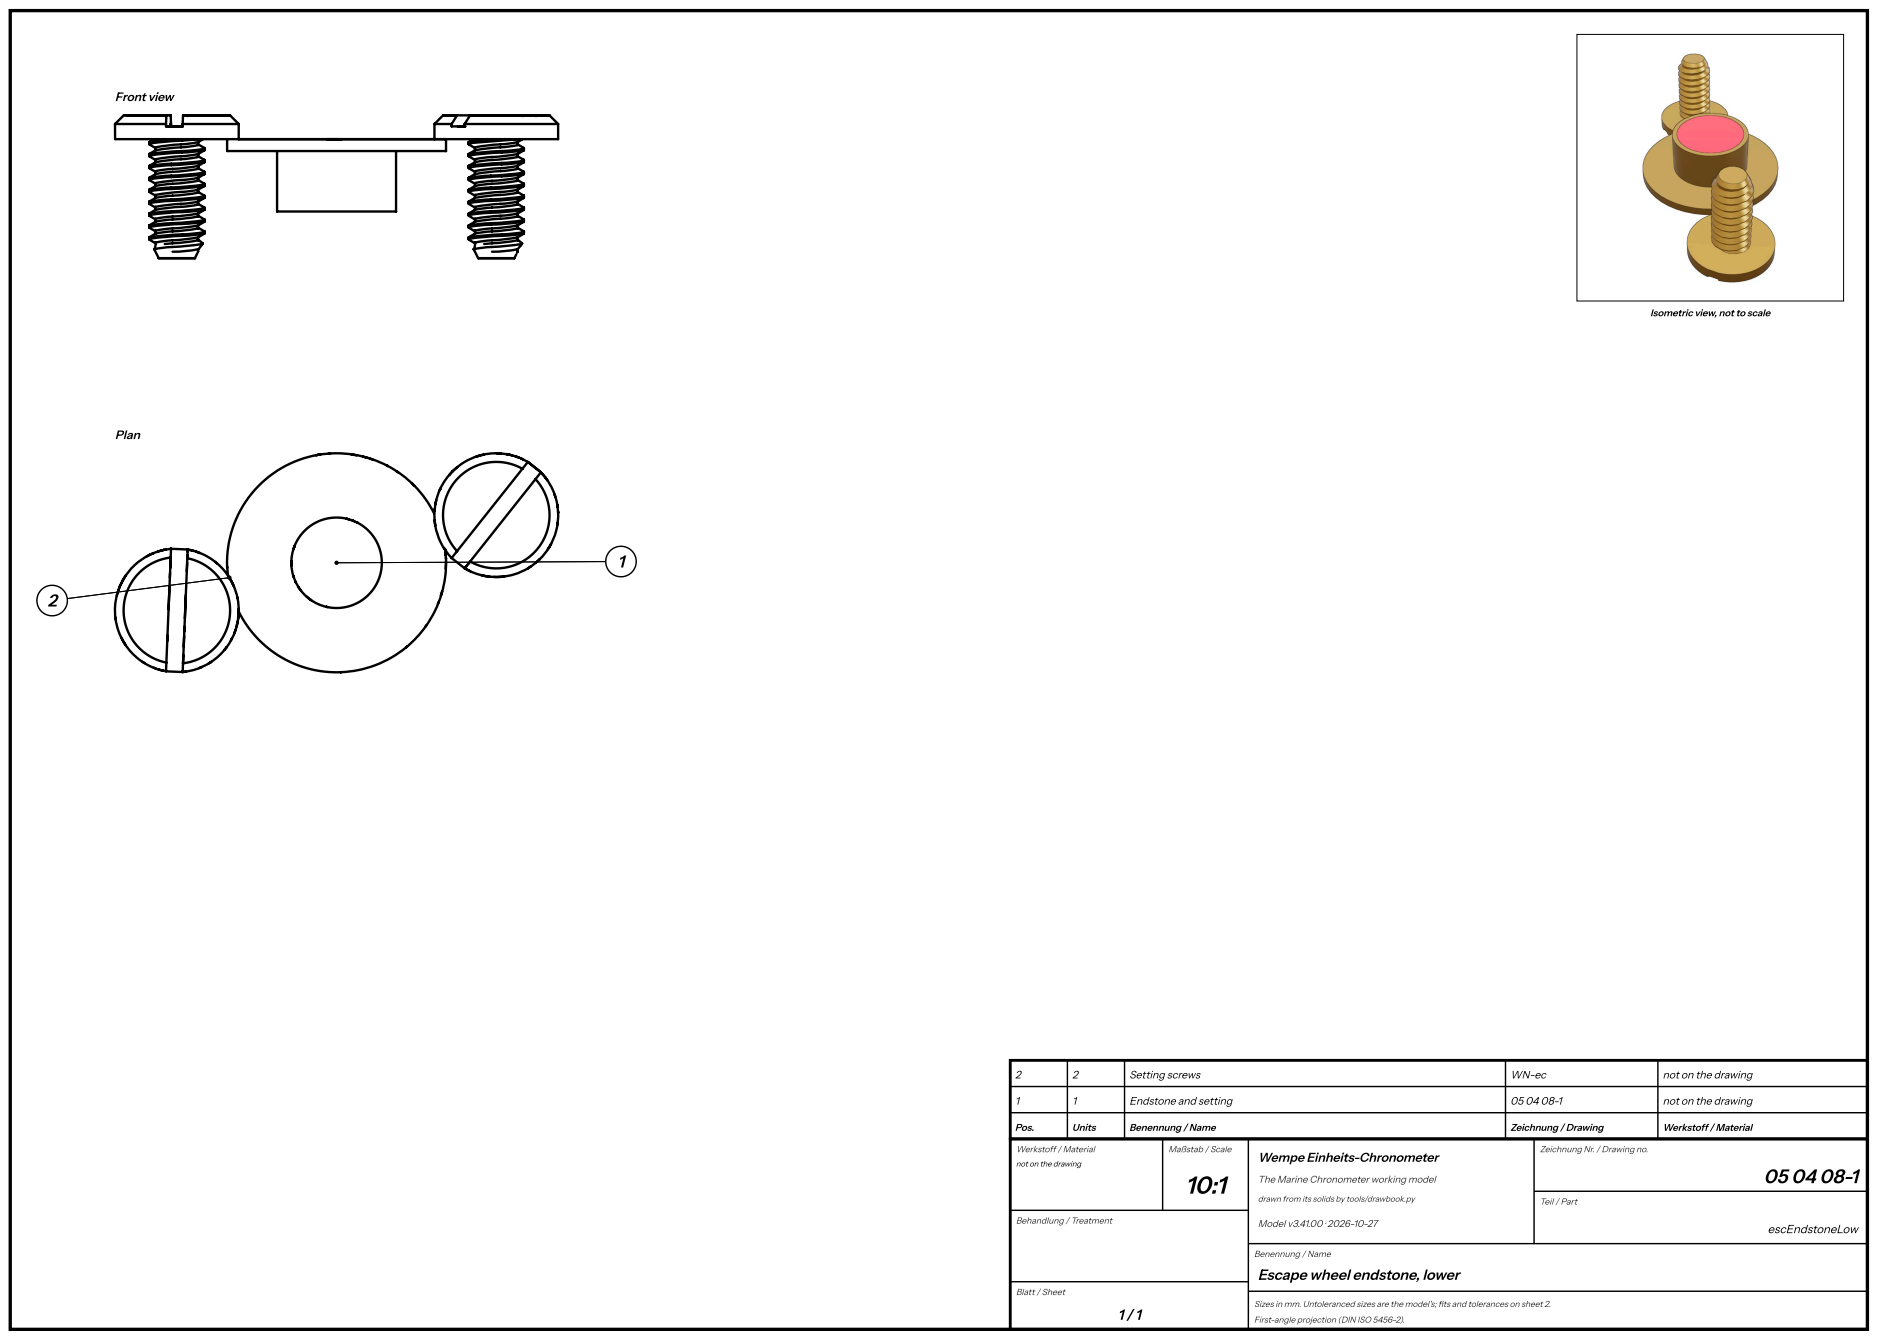
[picture p412: page 204]
Front view; Plan; Pos.; Units; Benennung / Name; Zeichnung / Drawing; Werkstoff / Material; Endstone and setting; not on the drawing; Setting screws; Maßstab / Scale; Behandlung / Treatment; Model v3.41.00 · 2026-10-27; Teil / Part; escEndstoneLow

Isometric view, not to scale

Zeichnung Nr. / Drawing no.

not on the drawing

Wempe Einheits-Chronometer

The Marine Chronometer working model

drawn from its solids by tools/drawbook.py

Escape wheel endstone, lower

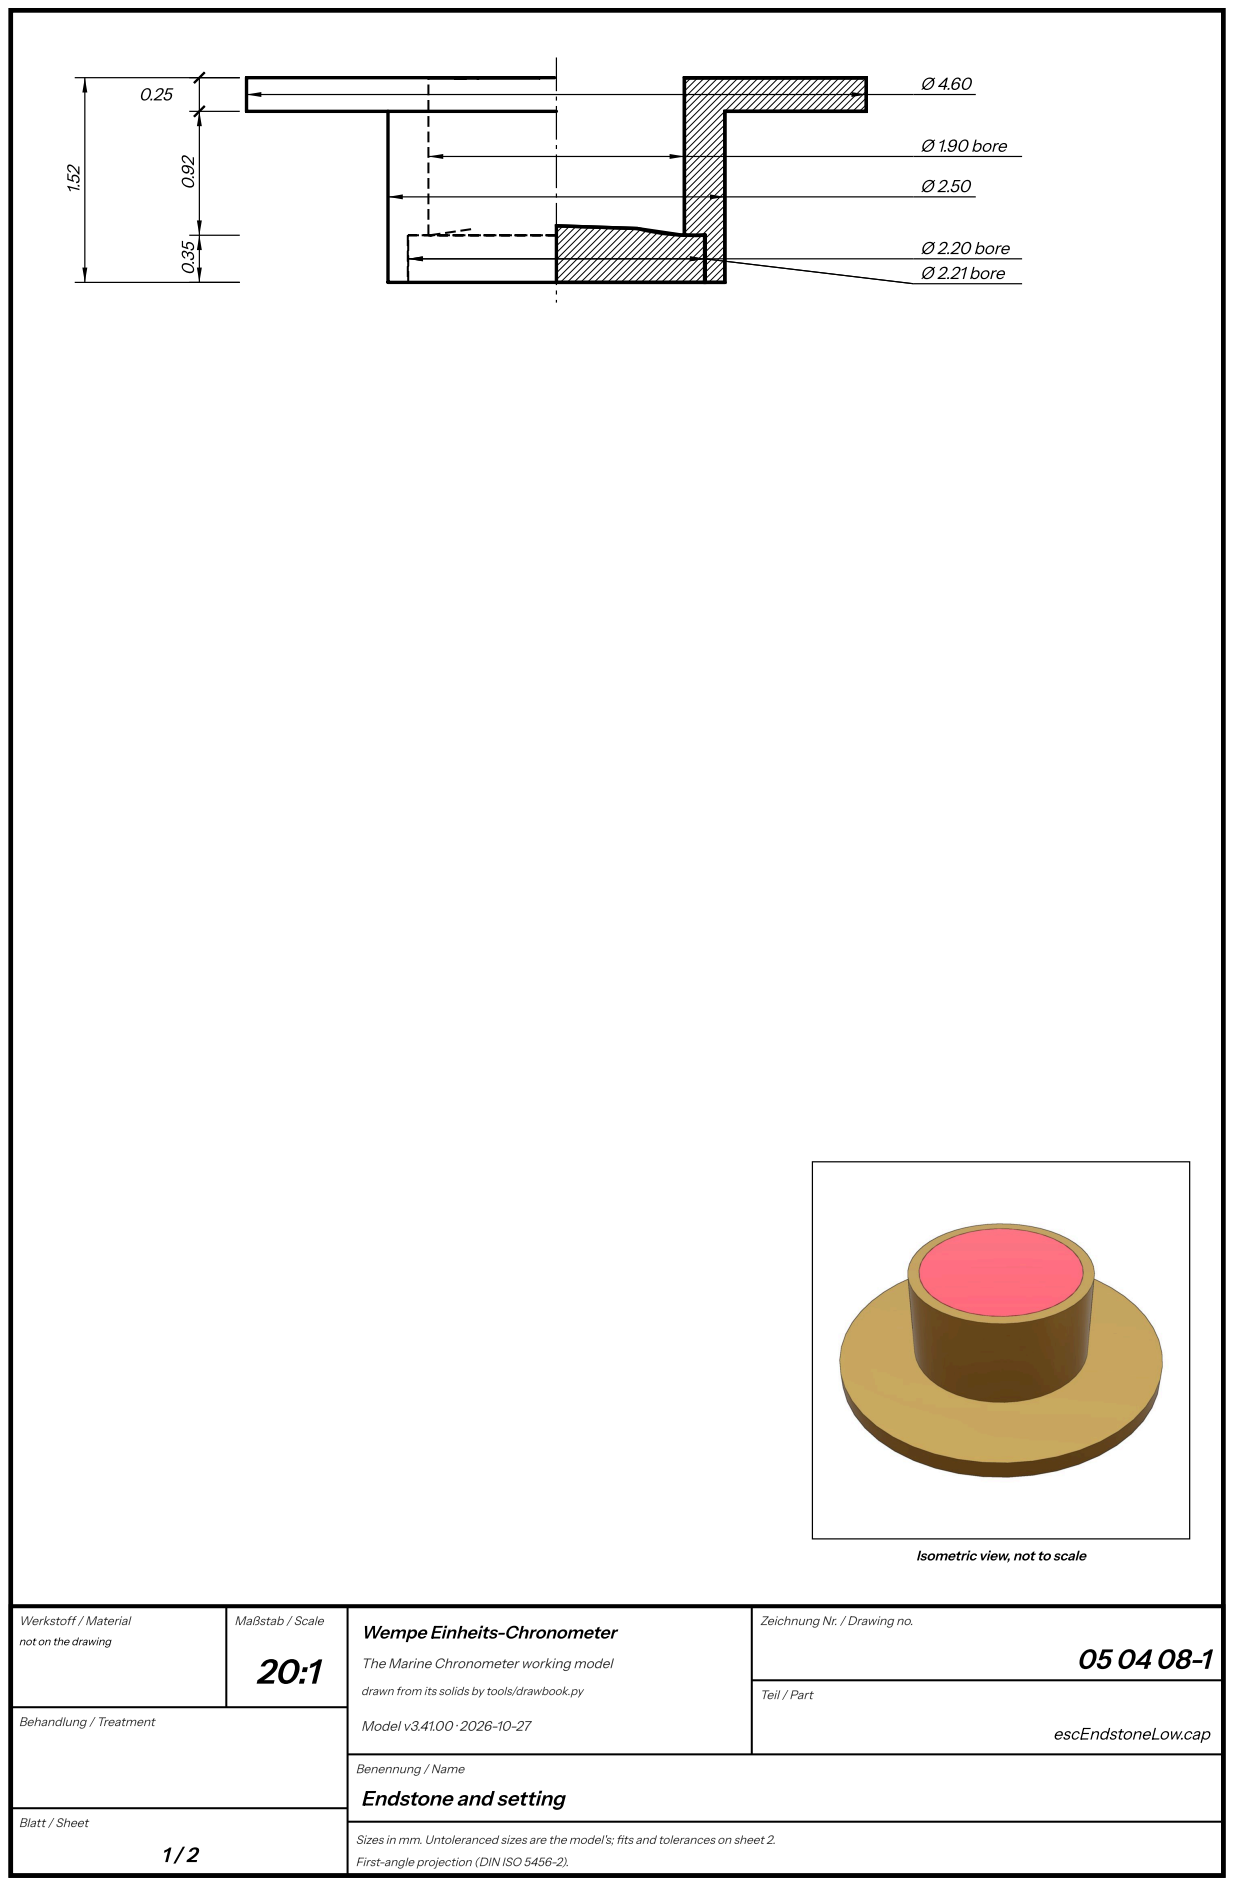
[picture p413: page 205]
Ø 1.90 bore; Ø 2.20 bore; Ø 2.21 bore; Werkstoff / Material; Maßstab / Scale; Behandlung / Treatment; Model v3.41.00 · 2026-10-27; Teil / Part; escEndstoneLow.cap

Isometric view, not to scale

Zeichnung Nr. / Drawing no.

not on the drawing

Wempe Einheits-Chronometer

The Marine Chronometer working model

drawn from its solids by tools/drawbook.py

Endstone and setting

## Endstone and setting — sheet 2

The endstone under the escape wheel arbor’s lower pivot: a round gilt setting flush in a seat in the pillar plate’s dial side,

the ruby showing, held by two screws whose heads lap its rim.

Parts list

Drawing | Name | Units | Material | Finish, heat treatment | Fit, as measured on the model
05 04 08-1 | Deckstein (endstone), escape wheel, lower | 1 | not on the drawing | | not measured on the model: see its function, Stops the escape arbor's lower pivot end.
05 04 08-2 | Fassung (endstone cap), escape wheel, lower | 1 | not on the drawing | | on 050802-1: 0 mm

What it does (05 04 08-1). Stops the escape arbor's lower pivot end.

What it does (05 04 08-2). On the pillar plate's dial side, holding the lower endstone.

Turned about its axis; length 1.52, largest Ø 4.60. Diameters: Ø 2.50, Ø 4.60; bores Ø 1.90, Ø 2.20, Ø 2.21. Shoulders from the

lower end: 0.00, 0.35, 1.27, 1.52.

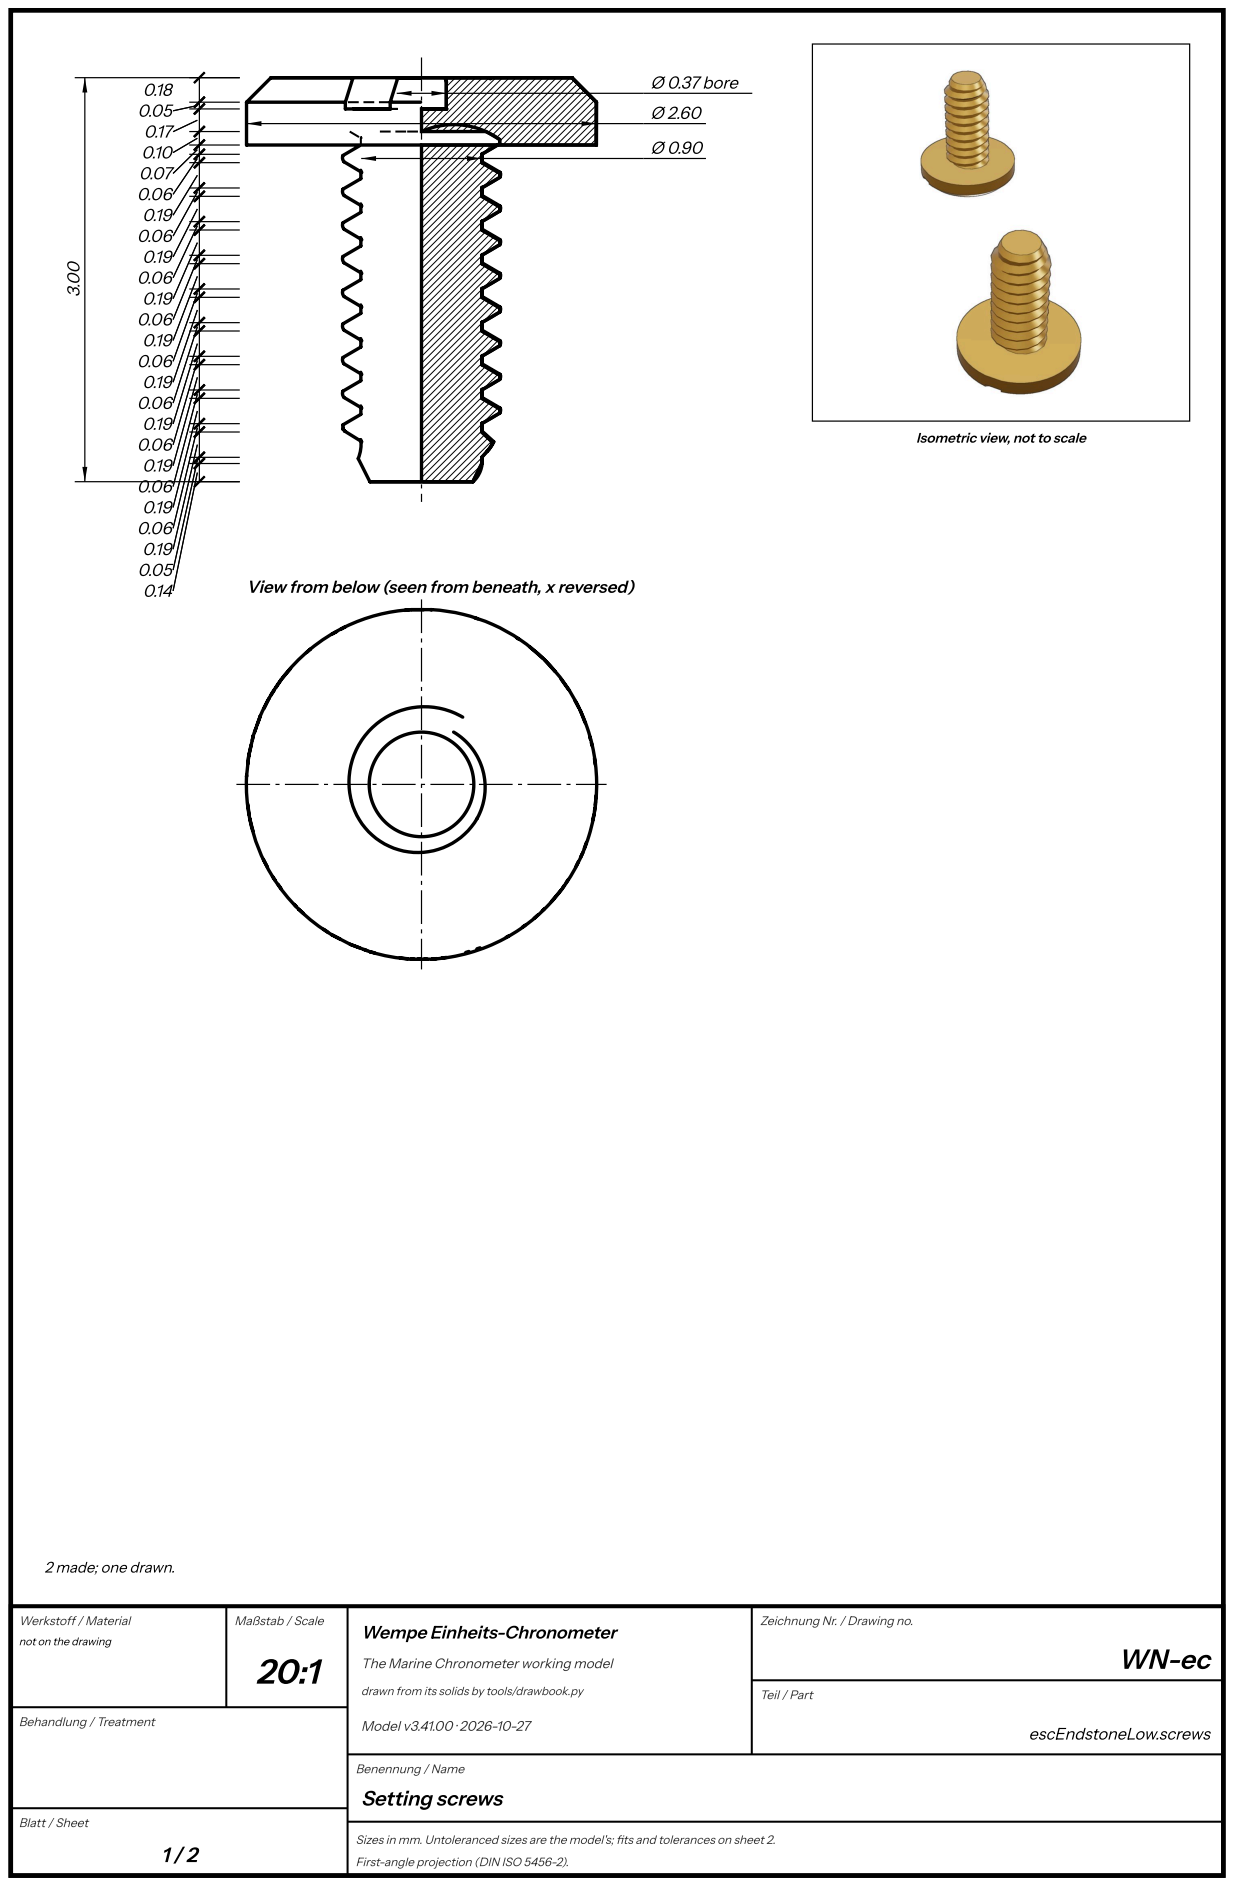
[picture p414: page 207]
Ø 0.37 bore; Werkstoff / Material; Maßstab / Scale; Behandlung / Treatment; Model v3.41.00 · 2026-10-27; Teil / Part; escEndstoneLow.screws; Setting screws

Isometric view, not to scale

View from below (seen from beneath, x reversed)

2 made; one drawn.

Zeichnung Nr. / Drawing no.

not on the drawing

Wempe Einheits-Chronometer

The Marine Chronometer working model

drawn from its solids by tools/drawbook.py

## Setting screws — sheet 2

Two brass screws into the pillar plate, their heads lapping the setting’s rim.

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

Parts list

Drawing | Name | Units | Material | Finish, heat treatment | Fit, as measured on the model
WN-ec | Escape endstone screws, lower, M1.2 (their WN number not read) | 2 | not on the drawing | | in 050802-1 (tap): 2.517 mm, least gap 0.0111; on 050802-1: 0 mm

What it does (WN-ec). Hold the lower endstone's setting in its seat, their heads over its rim (Wempe 3955).

Turned about its axis; length 3.00, largest Ø 2.60. Diameters: Ø 0.90, Ø 2.60; bores Ø 0.37. Shoulders from the lower end:

0.00, 0.13, 0.18, 0.37, 0.43, 0.62, 0.68, 0.87, 0.93, 1.12, 1.18, 1.37, 1.43, 1.62, 1.68, 1.87, 1.93, 2.12, 2.18, 2.37, 2.43, 2.50, 2.60, 2.77, 2.82,

3.00.

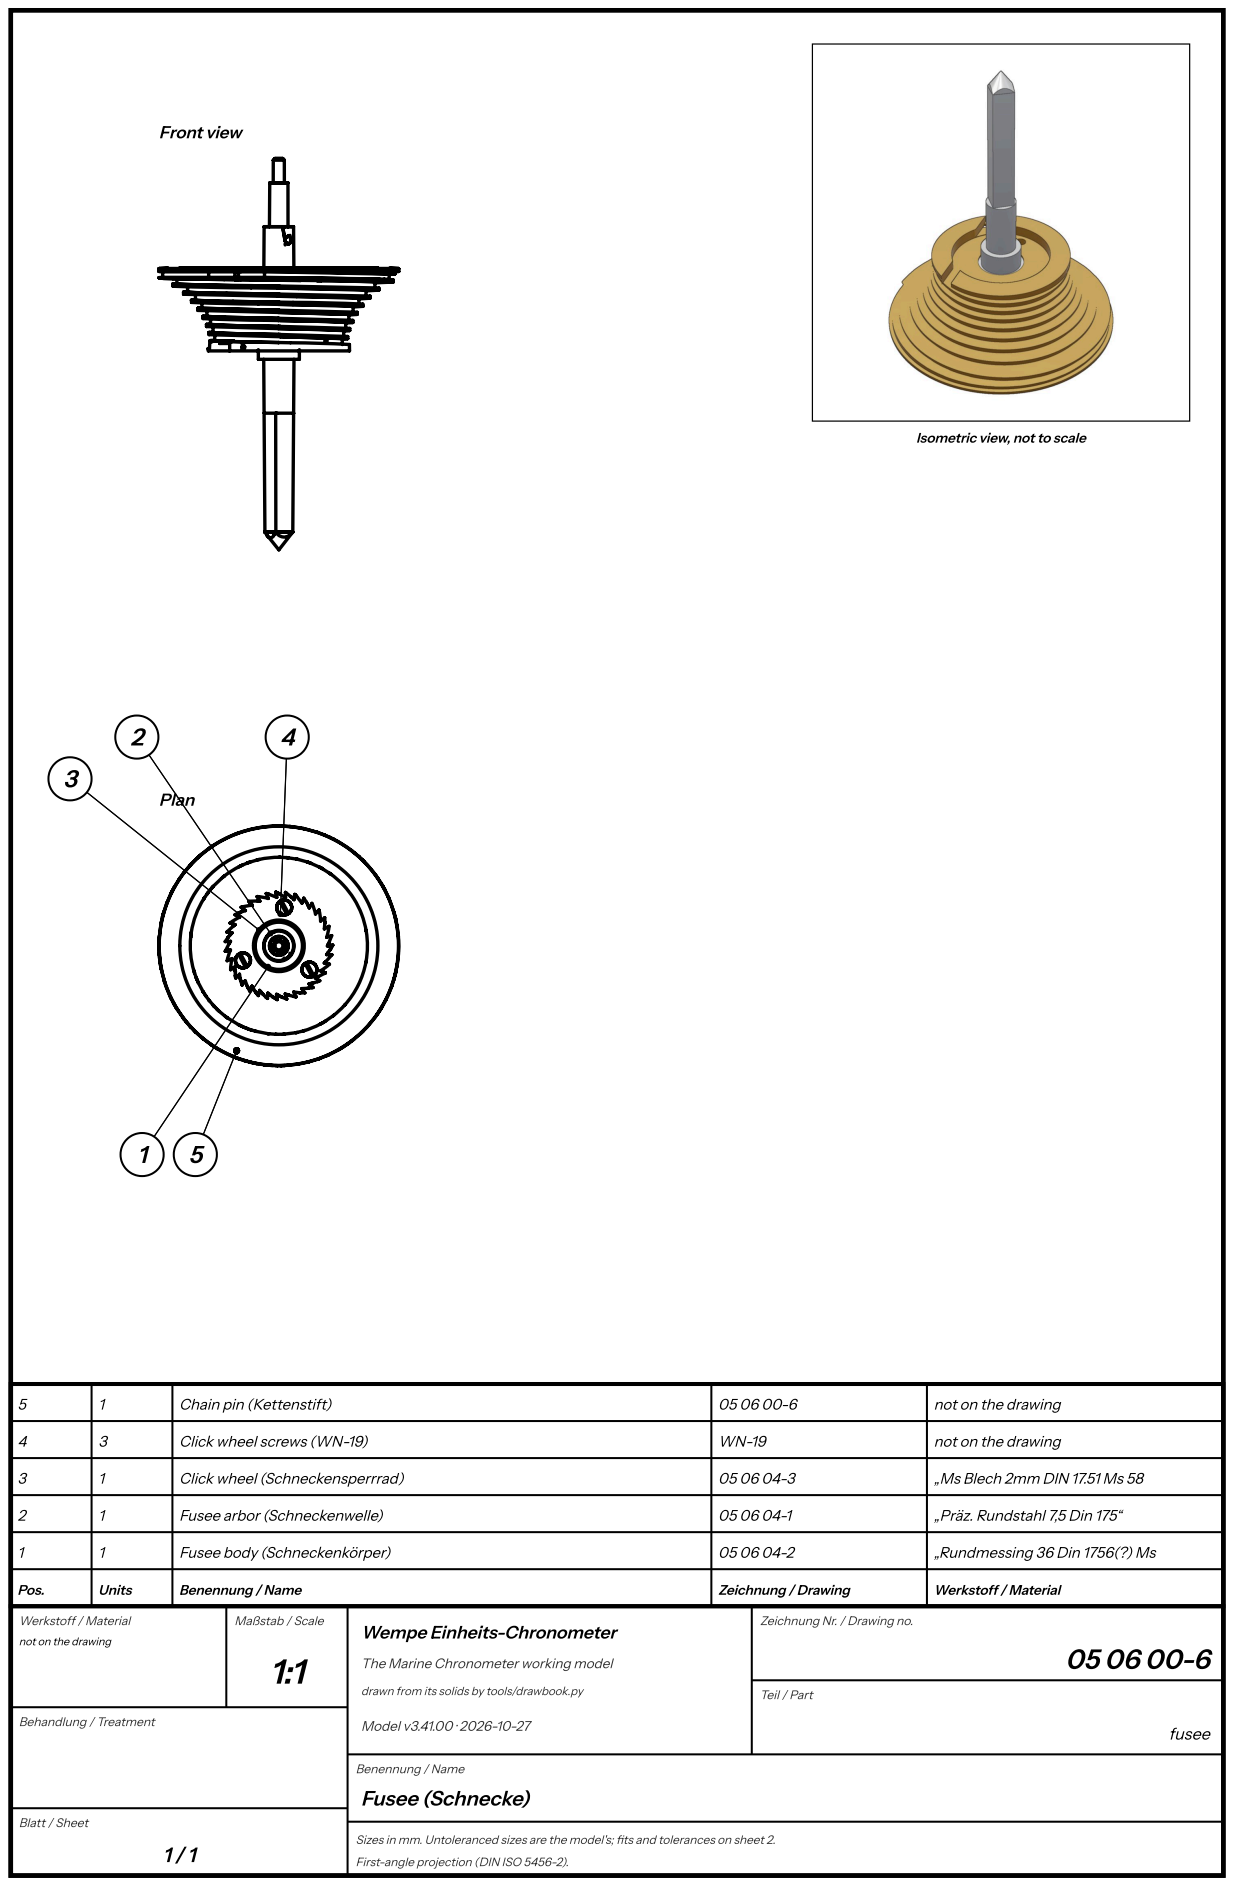
[picture p415: page 209]
Front view; Plan; Pos.; Units; Benennung / Name; Zeichnung / Drawing; Werkstoff / Material; Fusee body (Schneckenkörper); „Rundmessing 36 Din 1756(?) Ms; Fusee arbor (Schneckenwelle); „Präz. Rundstahl 7,5 Din 175“; Click wheel (Schneckensperrrad); „Ms Blech 2mm DIN 17.51 Ms 58; Click wheel screws (WN-19); not on the drawing; Chain pin (Kettenstift); Maßstab / Scale; Behandlung / Treatment; Model v3.41.00 · 2026-10-27; Teil / Part; fusee; Fusee (Schnecke)

Isometric view, not to scale

Zeichnung Nr. / Drawing no.

not on the drawing

Wempe Einheits-Chronometer

The Marine Chronometer working model

drawn from its solids by tools/drawbook.py

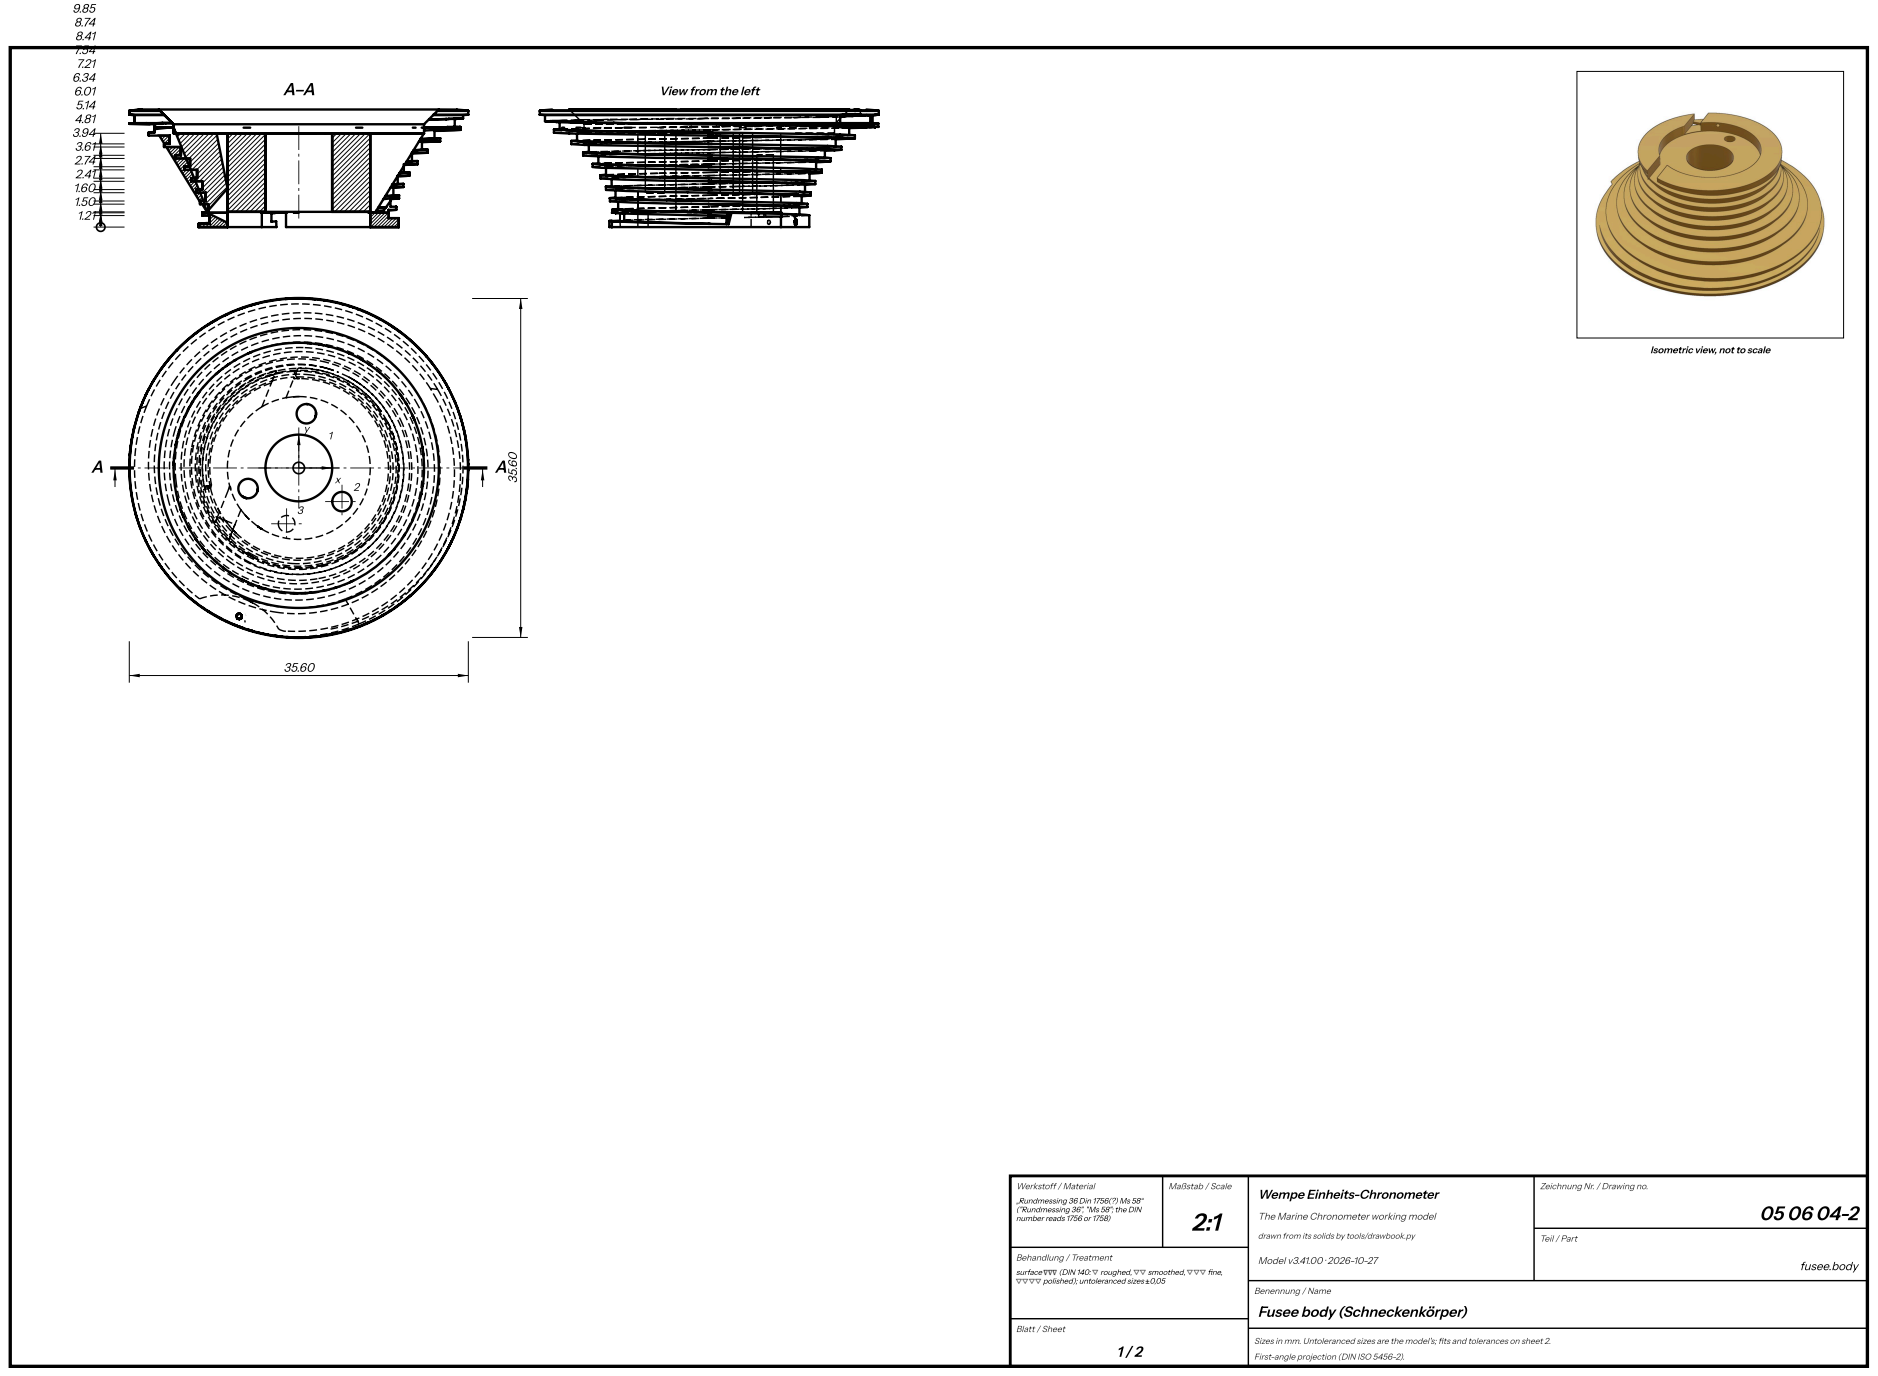
[picture p416: page 210]
Werkstoff / Material; Maßstab / Scale; Behandlung / Treatment; Model v3.41.00 · 2026-10-27; Teil / Part; fusee.body

View from the left

Isometric view, not to scale

Zeichnung Nr. / Drawing no.

„Rundmessing 36 Din 1756(?) Ms 58“
("Rundmessing 36", "Ms 58"; the DIN
number reads 1756 or1758)

Wempe Einheits-Chronometer

The Marine Chronometer working model

drawn from its solids by tools/drawbook.py

surface ∇∇∇ (DIN 140: ▽ roughed, ▽▽ smoothed, ▽▽▽ fine,
▽▽▽▽ polished); untoleranced sizes ±0,05

Fusee body (Schneckenkörper)

## Fusee body (Schneckenkörper) — sheet 2

The brass cone with its nine-turn groove, square-cut: each turn a flat land with a rib 0.33 thick on its small-end side, 0.6

high. The chain’s end is pinned in the slot between the flange’s two ribs and leaves it over a flat milled across the flange. A

recess in its large end holds the click wheel and the maintaining ratchet’s cup; across its small end runs the stop bar’s slot.

Parts list

Drawing | Name | Units | Material | Finish, heat treatment | Fit, as measured on the model
05 06 04-2 | Schneckenkörper (fusee body) | 1 | „Rundmessing 36 Din 1756(?) Ms 58“ ("Rundmessing 36", "Ms 58"; the DIN number reads 1756 or 1758) | surface ∇∇∇ (DIN 140: ▽ roughed, ▽▽ smoothed, ▽▽▽ fine, ▽▽▽▽ polished); untoleranced sizes ±0,05 | round 050604-1 (press): 7.942 mm, least gap -0.0103

Test on the bench (05 06 04-2). The pull on the fusee arbor, against 05 06_20, the chain on, the barrel set up ¾ turn,

before the train goes in: Each reading within ×0.680-1.253 of the sheet's at the same turn (its readings' mean 132.7 g: 90.2-

166.4 g; fully wound 138.4 g), and the run's shape the sheet's: its readings -4.7 to +4.3 % about their mean, the hump at turns

1-1.5, the dip at 4-5.75 and the rise to full wind (the solved spring through the drawn fusee fits it to 2.10 % rms). Low

everywhere: the strip is thin (set up a tooth more, or a stronger strip: wempe_tolerances.js); out of shape at one end: the

spring's length or set against the fusee. The sources' band, 225-270°, would want 133.8 g mean (×1.008): open (README,

Unresolved).

What it does (05 06 04-2). The cone with its nine-turn groove, pressed on the arbor's collar.

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

the face seen in the plan (the top). Thickness 12.35.

Holes

Hole | x | y | Size
1 | 0.00 | 0.00 | Ø 7.01 through (8.25 thick at 1.60-9.85)
2 | 4.54 | -3.53 | Ø 2.04 × 6.25 deep from the face at 9.85
3 | -1.28 | -5.86 | Ø 1.74 × 6.00 deep from the face at 1.60

Contourin the plan

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

radius.

Contour | # | Element | From x, y | To x, y | Centre x, y | R
Outline | 1 | circle | | | 0.00, 0.00 | 17.80
Cut-out 1 | 2 | line | 9.31, 14.80 | 9.31, 14.80
Cut-out 1 | 3 | line | 9.31, 14.80 | 9.31, 14.80
Cut-out 1 | 4 | line | 9.31, 14.80 | 9.31, 14.80
Cut-out 1 | 5 | line | 9.31, 14.80 | 9.31, 14.80
Cut-out 2 | 6 | line | 8.41, 15.28 | 8.41, 15.28
Cut-out 2 | 7 | line | 8.41, 15.28 | 8.41, 15.28
Cut-out 2 | 8 | line | 8.41, 15.28 | 8.41, 15.28
Cut-out 2 | 9 | line | 8.41, 15.28 | 8.41, 15.28
Cut-out 4 | 10 | line | -3.23, -6.70 | -3.23, -6.70
Cut-out 4 | 11 | line | -3.23, -6.70 | -3.23, -6.70
Cut-out 4 | 12 | line | -3.23, -6.70 | -3.23, -6.70
Cut-out 4 | 13 | line | -3.23, -6.70 | -3.23, -6.70
Cut-out 5 | 14 | arc anticlockwise | -6.54, -15.54 | -6.53, -15.69 | -6.32, -15.59 | 0.24
Cut-out 5 | 15 | line | -6.53, -15.69 | -6.48, -15.77

Cut-out 5 | 16 | arc anticlockwise | -6.48, -15.77 | -6.13, -15.82 | -6.27, -15.58 | 0.28
Cut-out 5 | 17 | line | -6.13, -15.82 | -6.08, -15.79
Cut-out 5 | 18 | line | -6.08, -15.79 | -6.04, -15.75
Cut-out 5 | 19 | line | -6.04, -15.75 | -6.01, -15.68
Cut-out 5 | 20 | line | -6.01, -15.68 | -5.99, -15.61
Cut-out 5 | 21 | line | -5.99, -15.61 | -6.00, -15.53
Cut-out 5 | 22 | line | -6.00, -15.53 | -6.02, -15.47
Cut-out 5 | 23 | line | -6.02, -15.47 | -6.07, -15.39
Cut-out 5 | 24 | line | -6.07, -15.39 | -6.11, -15.36
Cut-out 5 | 25 | line | -6.11, -15.36 | -6.19, -15.32
Cut-out 5 | 26 | line | -6.19, -15.32 | -6.25, -15.31
Cut-out 5 | 27 | line | -6.25, -15.31 | -6.32, -15.31
Cut-out 5 | 28 | line | -6.32, -15.31 | -6.40, -15.34
Cut-out 5 | 29 | line | -6.40, -15.34 | -6.46, -15.39
Cut-out 5 | 30 | line | -6.46, -15.39 | -6.50, -15.43
Cut-out 5 | 31 | arc anticlockwise | -6.50, -15.43 | -6.54, -15.52 | -6.35, -15.55 | 0.19
Cut-out 5 | 32 | line | -6.54, -15.52 | -6.54, -15.54
Cut-out 6 | 33 | arc anticlockwise | -6.20, -3.99 | -6.20, -3.99 | -3.09, -1.98 | 3.70
Cut-out 6 | 34 | arc anticlockwise | -6.20, -3.99 | -6.20, -3.99 | -3.09, -1.98 | 3.70
Cut-out 7 | 35 | arc anticlockwise | -6.82, 3.01 | -6.82, 3.01 | -3.39, 1.50 | 3.74
Cut-out 7 | 36 | arc anticlockwise | -6.82, 3.01 | -6.82, 3.01 | -3.39, 1.50 | 3.74

Levels

Faces in section A-A, from the bottom face: 1.21, 1.50, 1.60, 2.41, 2.74, 3.61, 3.94, 4.81, 5.14, 6.01, 6.34, 7.21, 7.54, 8.41, 8.74, 9.85.

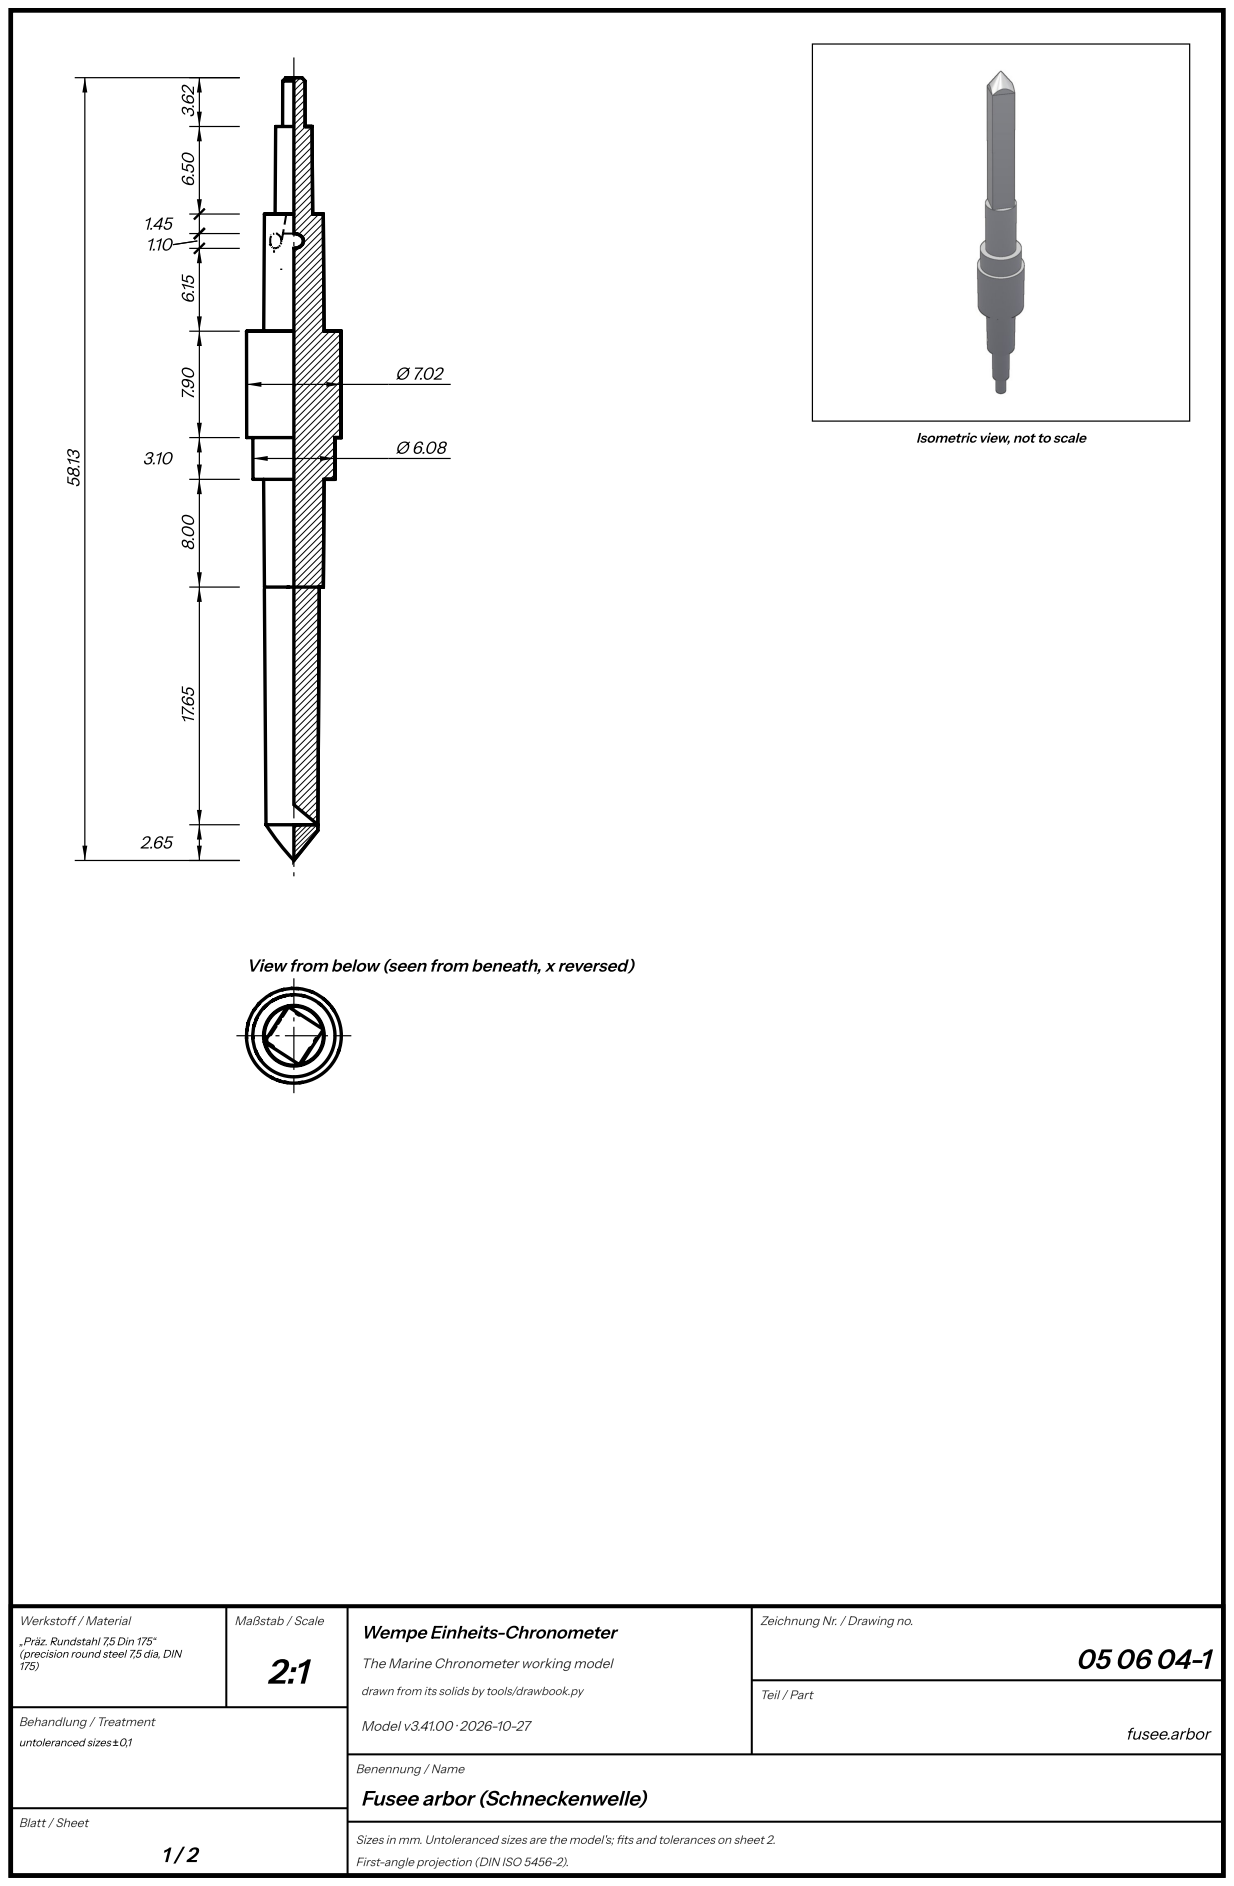
[picture p417: page 213]
Werkstoff / Material; Maßstab / Scale; Behandlung / Treatment; untoleranced sizes ±0,1; Model v3.41.00 · 2026-10-27; Teil / Part; fusee.arbor

Isometric view, not to scale

View from below (seen from beneath, x reversed)

Zeichnung Nr. / Drawing no.

„Präz. Rundstahl 7,5 Din 175“
(precision round steel 7,5 dia, DIN

Wempe Einheits-Chronometer

The Marine Chronometer working model

drawn from its solids by tools/drawbook.py

Fusee arbor (Schneckenwelle)

## Fusee arbor (Schneckenwelle) — sheet 2

The steel arbor: the dial-side pivot in the pillar plate, the Vorreiber’s seat, the collar the body is pressed on, the step for the

cover plate, the journal in the fusee bush and the winding square. Its stub on the dial side carries the up-and-down pinion

(the motion work’s).

Parts list

Drawing | Name | Units | Material | Finish, heat treatment | Fit, as measured on the model
05 06 04-1 | Schneckenwelle (fusee arbor) | 1 | „Präz. Rundstahl 7,5 Din 175“ (precision round steel 7,5 dia, DIN 175) | untoleranced sizes ±0,1 | in 050802-1 (run): 3.249 mm, least gap 0.0133; in 050801-2 (run): 5.776 mm, least gap 0.0163

What it does (05 06 04-1). Runs in the pillar plate (its dial-side pivot) and the fusee bush (its journal); its square takes the

key.

Turned about its axis; length 58.13, largest Ø 7.03. Diameters: Ø 6.08, Ø 7.02. Shoulders from the lower end: 0.00, 2.65,

20.30, 28.30, 31.40, 39.30, 45.45, 46.55, 48.00, 54.50, 58.13.

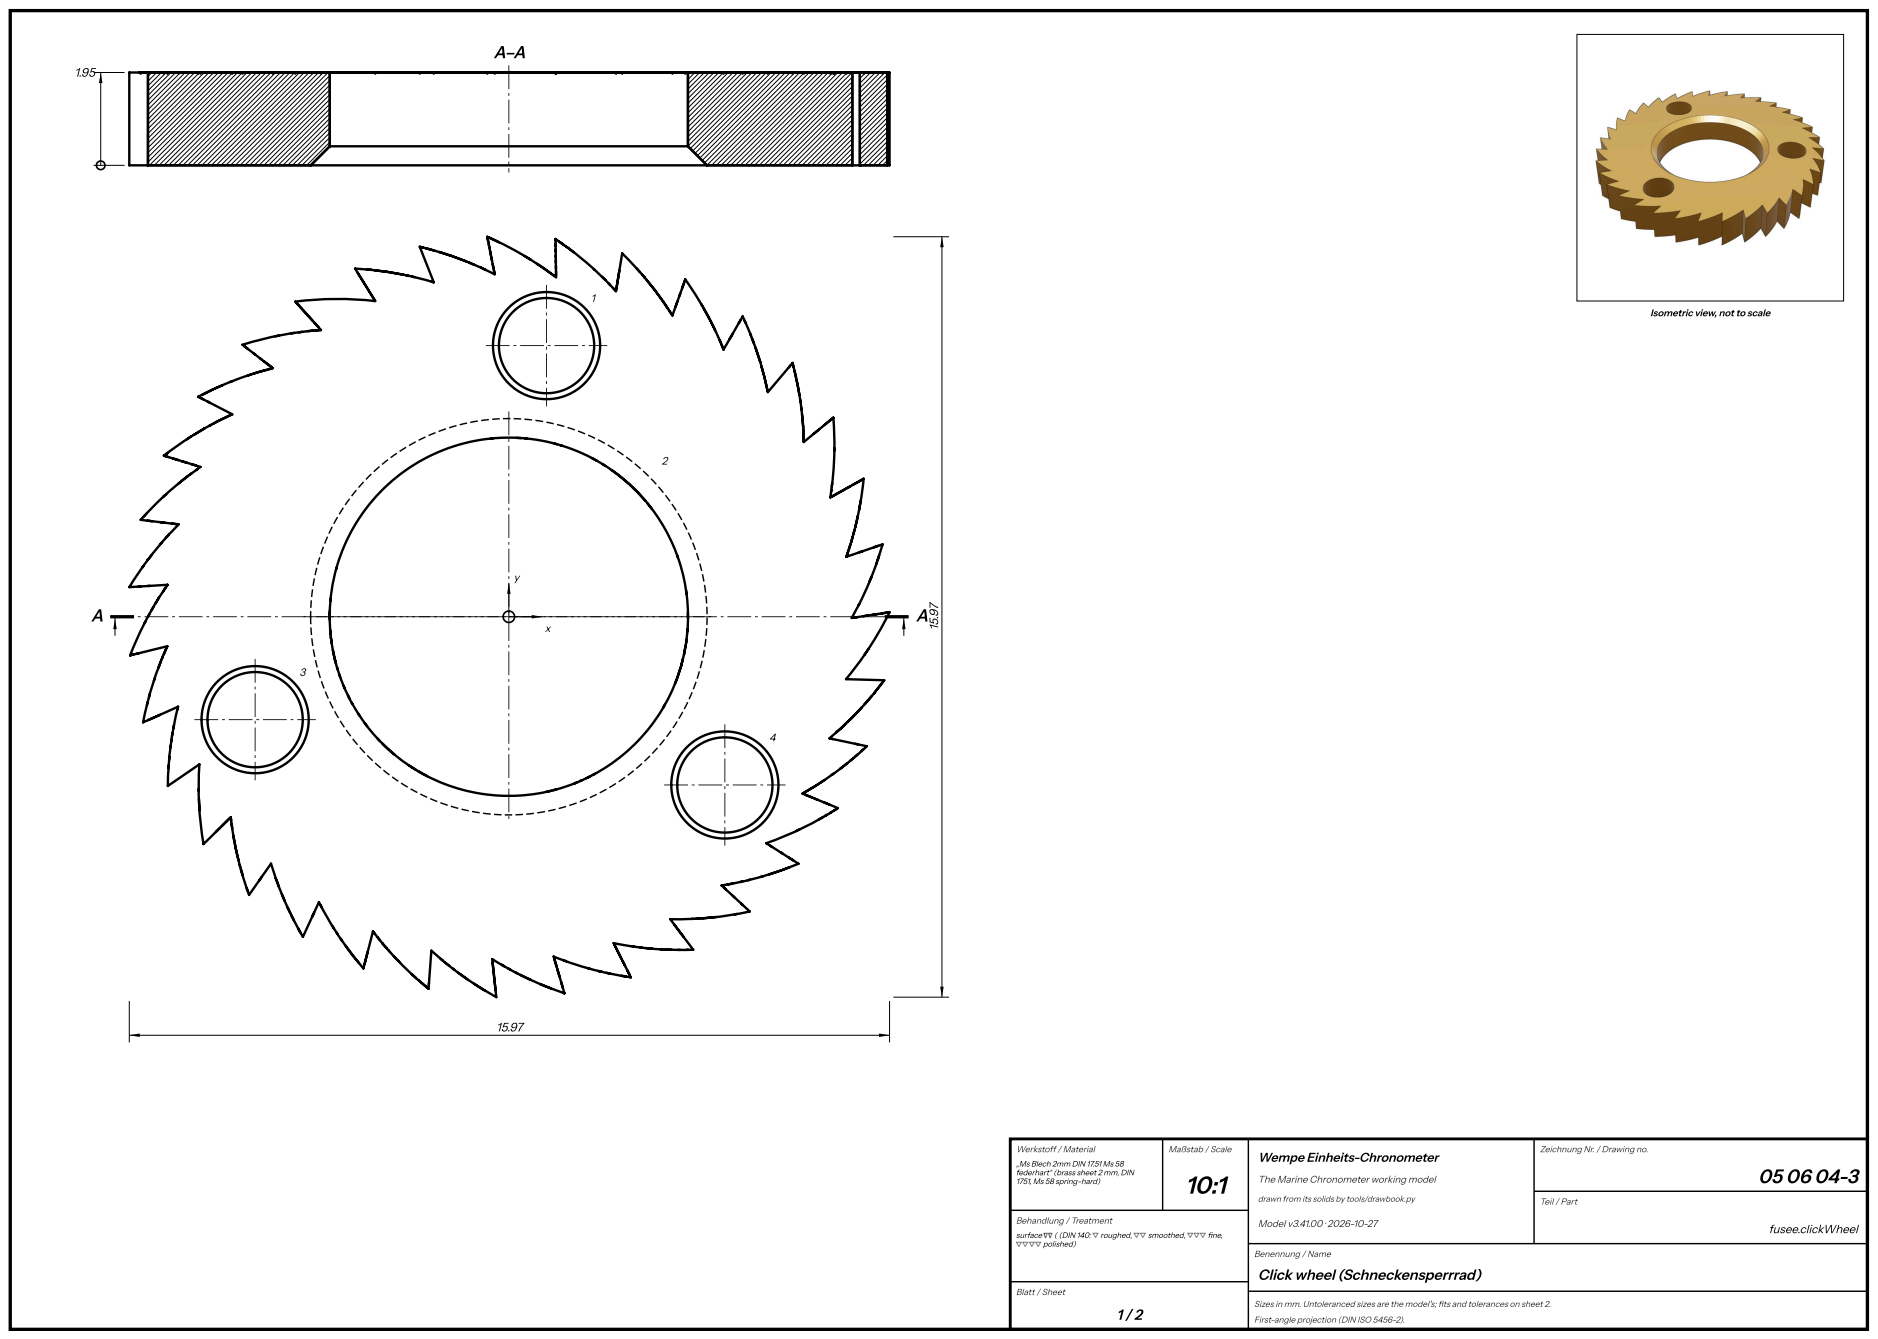
[picture p418: page 215]
Werkstoff / Material; Maßstab / Scale; Behandlung / Treatment; Model v3.41.00 · 2026-10-27; Teil / Part; fusee.clickWheel

Isometric view, not to scale

Zeichnung Nr. / Drawing no.

„Ms Blech 2mm DIN 17.51 Ms 58
federhart“ (brass sheet 2 mm, DIN
1751, Ms 58 spring-hard)

Wempe Einheits-Chronometer

The Marine Chronometer working model

drawn from its solids by tools/drawbook.py

surface ∇∇ ( (DIN 140: ▽ roughed, ▽▽ smoothed, ▽▽▽ fine,
▽▽▽▽ polished)

Click wheel (Schneckensperrrad)

## Click wheel (Schneckensperrrad) — sheet 2

A 35-tooth brass ratchet screwed to the body’s large end: running, its undercut faces push the maintaining clicks forward;

winding, they ride over its backs.

Parts list

Drawing | Name | Units | Material | Finish, heat treatment | Fit, as measured on the model
05 06 04-3 | Schneckensperrrad (click wheel) | 1 | „Ms Blech 2mm DIN 17.51 Ms 58 federhart“ (brass sheet 2 mm, DIN 1751, Ms 58 spring-hard) | surface ∇∇ ( (DIN 140: ▽ roughed, ▽▽ smoothed, ▽▽▽ fine, ▽▽▽▽ polished) | on 050604-2: 0 mm

What it does (05 06 04-3). On the body's large end, in its recess: drives the maintaining clicks.

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

the face seen in the plan (the top). Thickness 1.95.

Holes

Hole | x | y | Size
1 | 0.79 | 5.70 | Ø 2.00 through (0.28 thick at 0.00-0.28); sink Ø 2.25 × 0.19 from the top
2 | 0.00 | 0.00 | Ø 7.53 through (1.57 thick at 0.38-1.95); countersunk to Ø 8.32
3 | -5.33 | -2.16 | Ø 2.00 through (0.28 thick at 0.00-0.28); sink Ø 2.25 × 0.19 from the top
4 | 4.54 | -3.53 | Ø 2.00 through (0.28 thick at 0.00-0.28); sink Ø 2.25 × 0.19 from the top

Contourin the plan

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

radius.

Contour | # | Element | From x, y | To x, y | Centre x, y | R
Outline | 1 | line | -6.50, -3.10 | -7.16, -3.55
Outline | 2 | arc clockwise | -7.16, -3.55 | -6.95, -1.89 | -0.11, -3.61 | 7.05
Outline | 3 | line | -6.95, -1.89 | -7.68, -2.22
Outline | 4 | arc clockwise | -7.68, -2.22 | -7.17, -0.62 | -0.76, -3.54 | 7.05
Outline | 5 | line | -7.17, -0.62 | -7.95, -0.81
Outline | 6 | arc clockwise | -7.95, -0.81 | -7.17, 0.67 | -1.38, -3.34 | 7.05
Outline | 7 | line | -7.17, 0.67 | -7.97, 0.62
Outline | 8 | arc clockwise | -7.97, 0.62 | -6.93, 1.94 | -1.95, -3.04 | 7.05
Outline | 9 | line | -6.93, 1.94 | -7.73, 2.04
Outline | 10 | arc clockwise | -7.73, 2.04 | -6.48, 3.15 | -2.46, -2.65 | 7.05
Outline | 11 | line | -6.48, 3.15 | -7.24, 3.38
Outline | 12 | arc clockwise | -7.24, 3.38 | -5.81, 4.25 | -2.90, -2.17 | 7.05
Outline | 13 | line | -5.81, 4.25 | -6.52, 4.62
Outline | 14 | arc clockwise | -6.52, 4.62 | -4.96, 5.22 | -3.24, -1.61 | 7.05
Outline | 15 | line | -4.96, 5.22 | -5.59, 5.71
Outline | 16 | arc clockwise | -5.59, 5.71 | -3.94, 6.02 | -3.47, -1.01 | 7.05
Outline | 17 | line | -3.94, 6.02 | -4.48, 6.62
Outline | 18 | arc clockwise | -4.48, 6.62 | -2.81, 6.63 | -3.60, -0.37 | 7.05
Outline | 19 | line | -2.81, 6.63 | -3.23, 7.31
Outline | 20 | arc clockwise | -3.23, 7.31 | -1.58, 7.03 | -3.61, 0.27 | 7.05

O u tlin e | 2 1 | lin e | -1.5 8, 7.0 3 | -1.8 7, 7.7 7
O u tlin e | 2 2 | a r c clo c k wis e | -1.8 7, 7.7 7 | -0.3 0, 7.1 9 | -3.5 0, 0.9 1 | 7.0 5
O u tlin e | 2 3 | lin e | -0.3 0, 7.1 9 | -0.4 5, 7.9 8
O u tlin e | 2 4 | a r c clo c k wis e | -0.4 5, 7.9 8 | 0.9 9, 7.1 3 | -3.2 8, 1.5 2 | 7.0 5
O u tlin e | 2 5 | lin e | 0.9 9, 7.1 3 | 0.9 8, 7.9 3
O u tlin e | 2 6 | a r c clo c k wis e | 0.9 8, 7.9 3 | 2.2 5, 6.8 4 | -2.9 5, 2.0 8 | 7.0 5
O u tlin e | 2 7 | lin e | 2.2 5, 6.8 4 | 2.3 8, 7.6 3
O u tlin e | 2 8 | a r c clo c k wis e | 2.3 8, 7.6 3 | 3.4 3, 6.3 3 | -2.5 3, 2.5 8 | 7.0 5
O u tlin e | 2 9 | lin e | 3.4 3, 6.3 3 | 3.7 0, 7.0 8
O u tlin e | 3 0 | a r c clo c k wis e | 3.7 0, 7.0 8 | 4.5 1, 5.6 1 | -2.0 3, 2.9 9 | 7.0 5
O u tlin e | 3 1 | lin e | 4.5 1, 5.6 1 | 4.9 1, 6.3 1
O u tlin e | 3 2 | a r c clo c k wis e | 4.9 1, 6.3 1 | 5.4 4, 4.7 2 | -1.4 7, 3.3 0 | 7.0 5
O u tlin e | 3 3 | lin e | 5.4 4, 4.7 2 | 5.9 6, 5.3 3
O u tlin e | 3 4 | a r c clo c k wis e | 5.9 6, 5.3 3 | 6.1 9, 3.6 7 | -0.8 5, 3.5 1 | 7.0 5
O u tlin e | 3 5 | lin e | 6.1 9, 3.6 7 | 6.8 1, 4.1 8
O u tlin e | 3 6 | a r c clo c k wis e | 6.8 1, 4.1 8 | 6.7 5, 2.5 1 | -0.2 1, 3.6 1 | 7.0 5
O u tlin e | 3 7 | lin e | 6.7 5, 2.5 1 | 7.4 5, 2.9 0
O u tlin e | 3 8 | a r c clo c k wis e | 7.4 5, 2.9 0 | 7.0 9, 1.2 6 | 0.4 4, 3.5 9 | 7.0 5
O u tlin e | 3 9 | lin e | 7.0 9, 1.2 6 | 7.8 5, 1.5 2
O u tlin e | 4 0 | a r c clo c k wis e | 7.8 5, 1.5 2 | 7.2 0, -0.0 3 | 1.0 7, 3.4 5 | 7.0 5
O u tlin e | 4 1 | lin e | 7.2 0, -0.0 3 | 7.9 9, 0.1 0
O u tlin e | 4 2 | a r c clo c k wis e | 7.9 9, 0.1 0 | 7.0 8, -1.3 1 | 1.6 7, 3.2 1 | 7.0 5
O u tlin e | 4 3 | lin e | 7.0 8, -1.3 1 | 7.8 8, -1.3 3
O u tlin e | 4 4 | a r c clo c k wis e | 7.8 8, -1.3 3 | 6.7 3, -2.5 5 | 2.2 2, 2.8 6 | 7.0 5
O u tlin e | 4 5 | lin e | 6.7 3, -2.5 5 | 7.5 2, -2.7 2
O u tlin e | 4 6 | a r c clo c k wis e | 7.5 2, -2.7 2 | 6.1 7, -3.7 2 | 2.6 9, 2.4 2 | 7.0 5
O u tlin e | 4 7 | lin e | 6.1 7, -3.7 2 | 6.9 1, -4.0 2
O u tlin e | 4 8 | a r c clo c k wis e | 6.9 1, -4.0 2 | 5.4 0, -4.7 6 | 3.0 8, 1.9 0 | 7.0 5
O u tlin e | 4 9 | lin e | 5.4 0, -4.7 6 | 6.0 8, -5.1 9
O u tlin e | 5 0 | a r c clo c k wis e | 6.0 8, -5.1 9 | 4.4 7, -5.6 5 | 3.3 7, 1.3 2 | 7.0 5
O u tlin e | 5 1 | lin e | 4.4 7, -5.6 5 | 5.0 6, -6.1 9
O u tlin e | 5 2 | a r c clo c k wis e | 5.0 6, -6.1 9 | 3.3 9, -6.3 5 | 3.5 5, 0.6 9 | 7.0 5
O u tlin e | 5 3 | lin e | 3.3 9, -6.3 5 | 3.8 7, -6.9 9
O u tlin e | 5 4 | a r c clo c k wis e | 3.8 7, -6.9 9 | 2.2 0, -6.8 6 | 3.6 2, 0.0 5 | 7.0 5
O u tlin e | 5 5 | lin e | 2.2 0, -6.8 6 | 2.5 6, -7.5 7
O u tlin e | 5 6 | a r c clo c k wis e | 2.5 6, -7.5 7 | 0.9 4, -7.1 4 | 3.5 7, -0.6 0 | 7.0 5
O u tlin e | 5 7 | lin e | 0.9 4, -7.1 4 | 1.1 7, -7.9 1
O u tlin e | 5 8 | a r c clo c k wis e | 1.1 7, -7.9 1 | -0.3 5, -7.1 9 | 3.4 0, -1.2 2 | 7.0 5
O u tlin e | 5 9 | lin e | -0.3 5, -7.1 9 | -0.2 6, -7.9 9
O u tlin e | 6 0 | a r c clo c k wis e | -0.2 6, -7.9 9 | -1.6 3, -7.0 1 | 3.1 3, -1.8 1 | 7.0 5
O u tlin e | 6 1 | lin e | -1.6 3, -7.0 1 | -1.6 9, -7.8 2
O u tlin e | 6 2 | a r c clo c k wis e | -1.6 9, -7.8 2 | -2.8 5, -6.6 1 | 2.7 6, -2.3 4 | 7.0 5
O u tlin e | 6 3 | lin e | -2.8 5, -6.6 1 | -3.0 5, -7.3 9
O u tlin e | 6 4 | a r c clo c k wis e | -3.0 5, -7.3 9 | -3.9 9, -5.9 9 | 2.2 9, -2.8 0 | 7.0 5
O u tlin e | 6 5 | lin e | -3.9 9, -5.9 9 | -4.3 2, -6.7 2
O u tlin e | 6 6 | a r c clo c k wis e | -4.3 2, -6.7 2 | -4.9 9, -5.1 9 | 1.7 6, -3.1 6 | 7.0 5
O u tlin e | 6 7 | lin e | -4.9 9, -5.1 9 | -5.4 6, -5.8 4
O u tlin e | 6 8 | a r c clo c k wis e | -5.4 6, -5.8 4 | -5.8 4, -4.2 1 | 1.1 6, -3.4 2 | 7.0 5

Outline | 69 | line | -5.84, -4.21 | -6.41, -4.78
Outline | 70 | arc clockwise | -6.41, -4.78 | -6.50, -3.10 | 0.53, -3.58 | 7.05

Levels

Faces in section A-A, from the bottom face: 1.95.

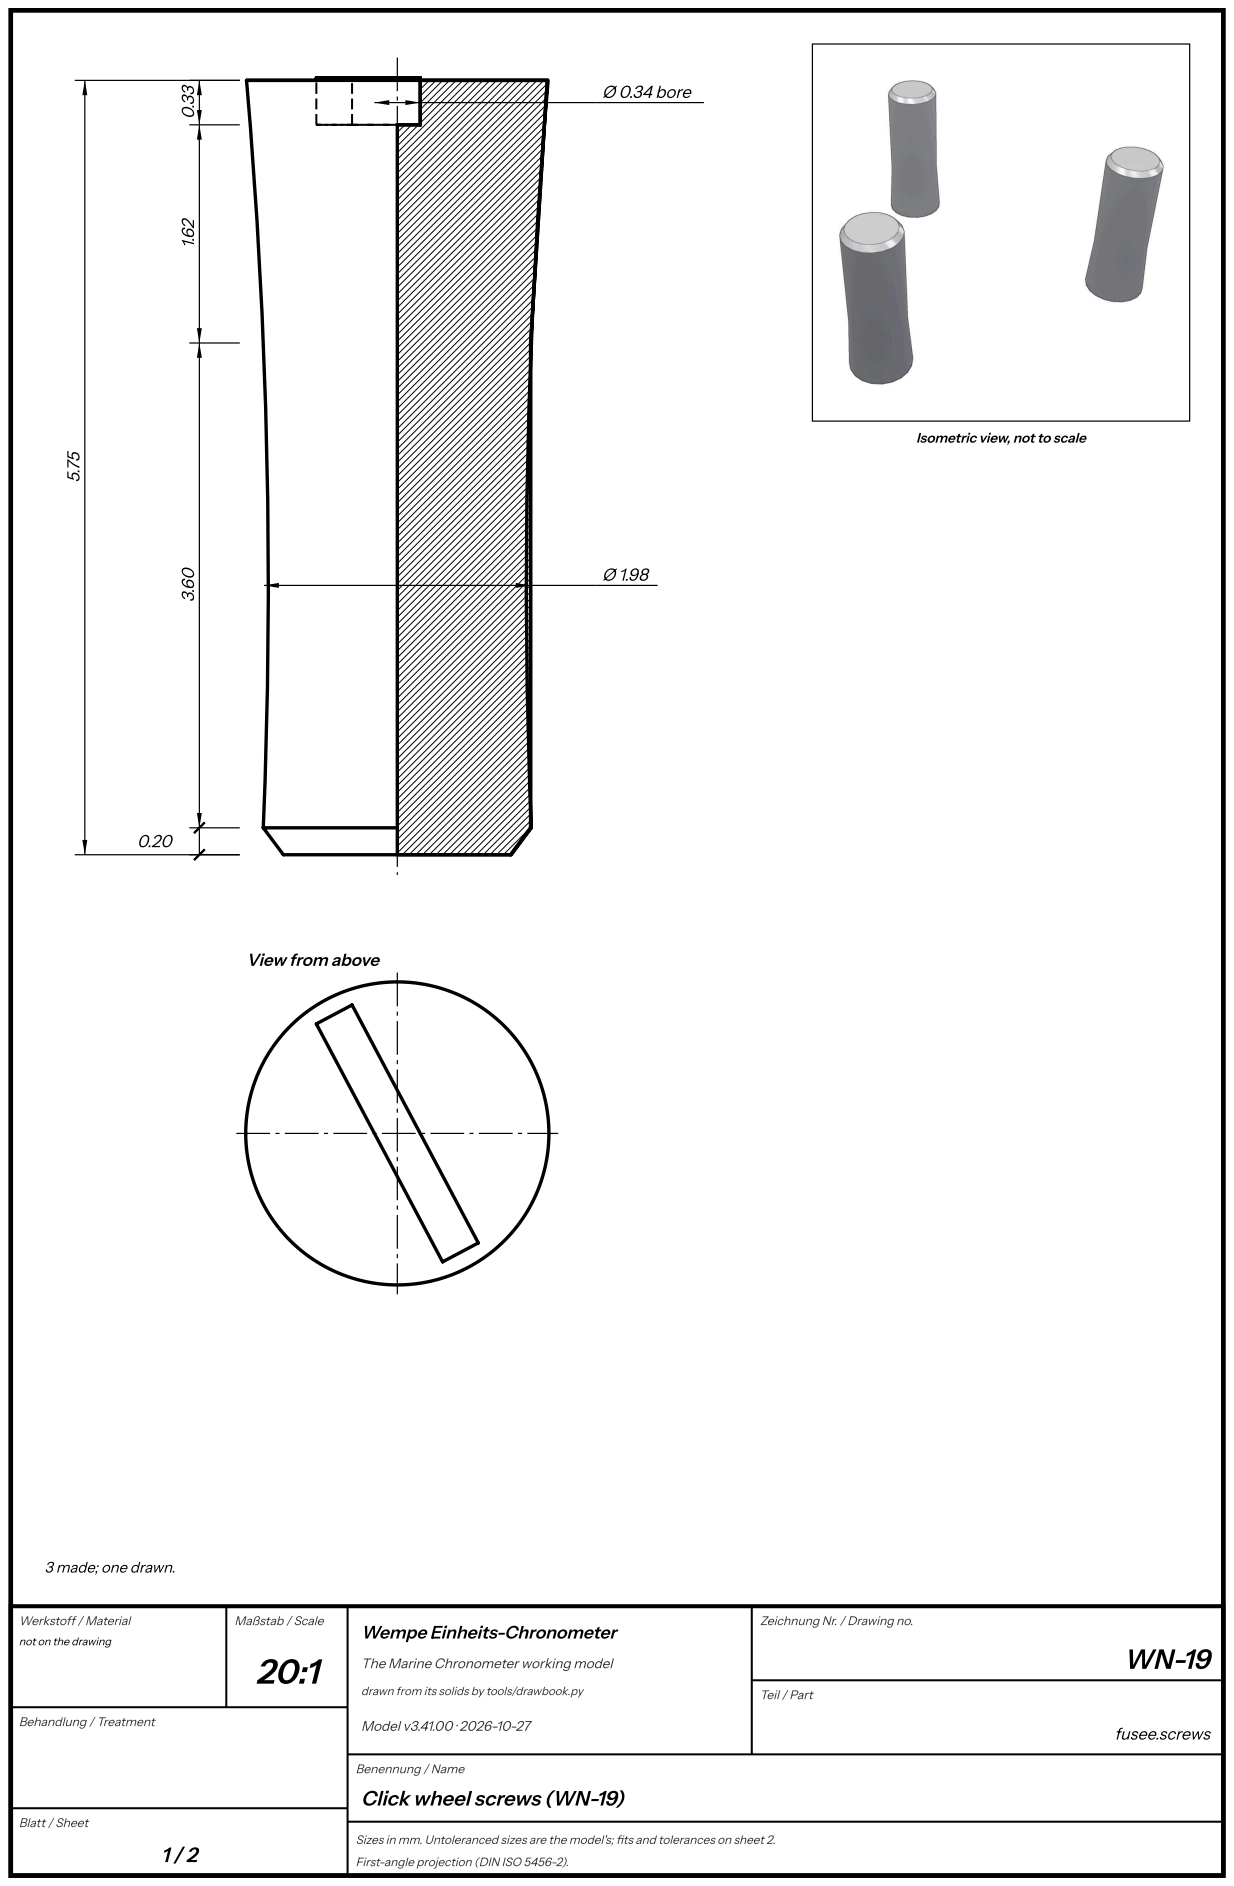
[picture p419: page 219]
Ø 0.34 bore; Werkstoff / Material; Maßstab / Scale; Behandlung / Treatment; Model v3.41.00 · 2026-10-27; Teil / Part; fusee.screws

Isometric view, not to scale

View from above

3 made; one drawn.

Zeichnung Nr. / Drawing no.

not on the drawing

Wempe Einheits-Chronometer

The Marine Chronometer working model

drawn from its solids by tools/drawbook.py

Click wheel screws (WN-19)

## Click wheel screws (WN-19) — sheet 2

Three screws holding the click wheel to the body, their heads sunk flush in its 1:8 holes.

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

Parts list

Drawing | Name | Units | Material | Finish, heat treatment | Fit, as measured on the model
WN-19 | Schraube WN-19 (click wheel screw) | 3 | not on the drawing | | in 050604-3 (press): 1.627 mm, least gap 0.0025; in 050604-2 (tap): 3.796 mm, least gap 0.0225

What it does (WN-19). Holds the click wheel to the body; its head flush in the wheel's 1:8 hole, its thread in the body's M2, 6

+0.5 deep from the large end's recess floor (05 06 04-2).

Turned about its axis; length 5.77, largest Ø 2.24. Diameters: Ø 1.98; bores Ø 0.34. Shoulders from the lower end: 0.00, 0.20,

3.80, 5.42, 5.75.

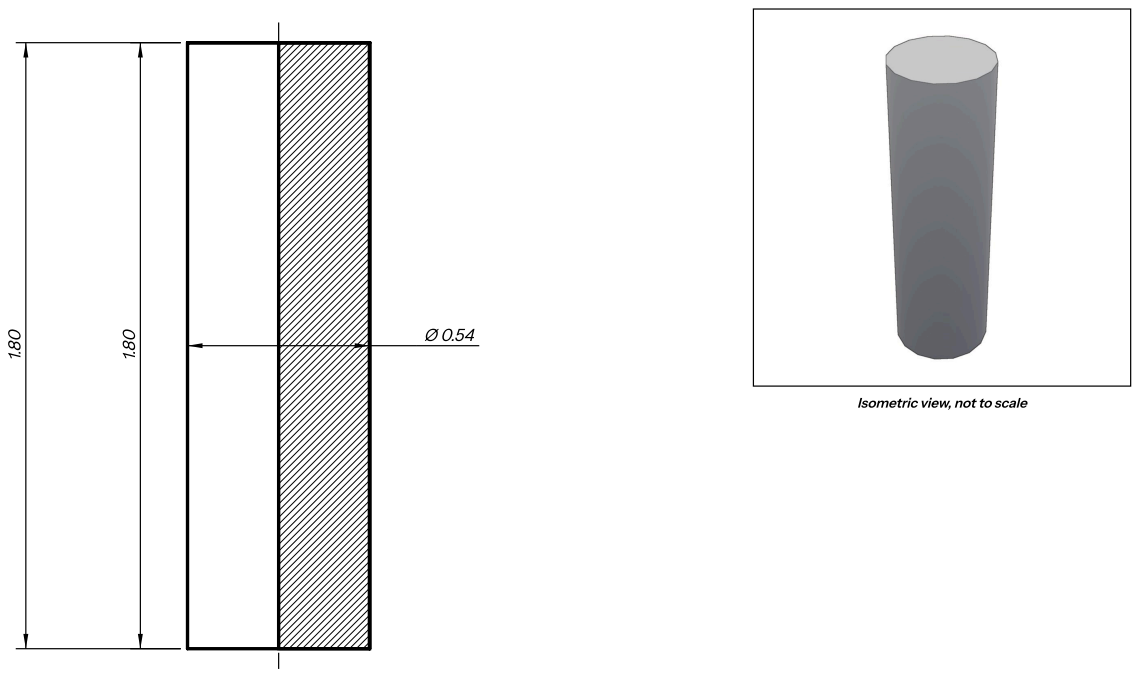
[picture p420: page 221]
Werkstoff / Material; Maßstab / Scale; Behandlung / Treatment; Model v3.41.00 · 2026-10-27; Teil / Part; fusee.pin

Isometric view, not to scale

Zeichnung Nr. / Drawing no.

not on the drawing

Wempe Einheits-Chronometer

The Marine Chronometer working model

drawn from its solids by tools/drawbook.py

Chain pin (Kettenstift)

## Chain pin (Kettenstift) — sheet 2

The pin across the flange’s slot that the chain’s (or band’s) top hook takes.

Parts list

Drawing | Name | Units | Material | Finish, heat treatment | Fit, as measured on the model
05 06 00-6 | Kettenstift (chain pin) | 1 | not on the drawing | | in 050604-2 (press): 0.826 mm, least gap 0.0059

What it does (05 06 00-6). Across the flange's slot in its hole through both ribs ("0,55∅ +0,01", 05 06 04-2): the chain's (or

band's) top hook takes it.

Turned about its axis; length 1.80, largest Ø 0.54. Diameters: Ø 0.54. Shoulders from the lower end: 0.00, 1.80.

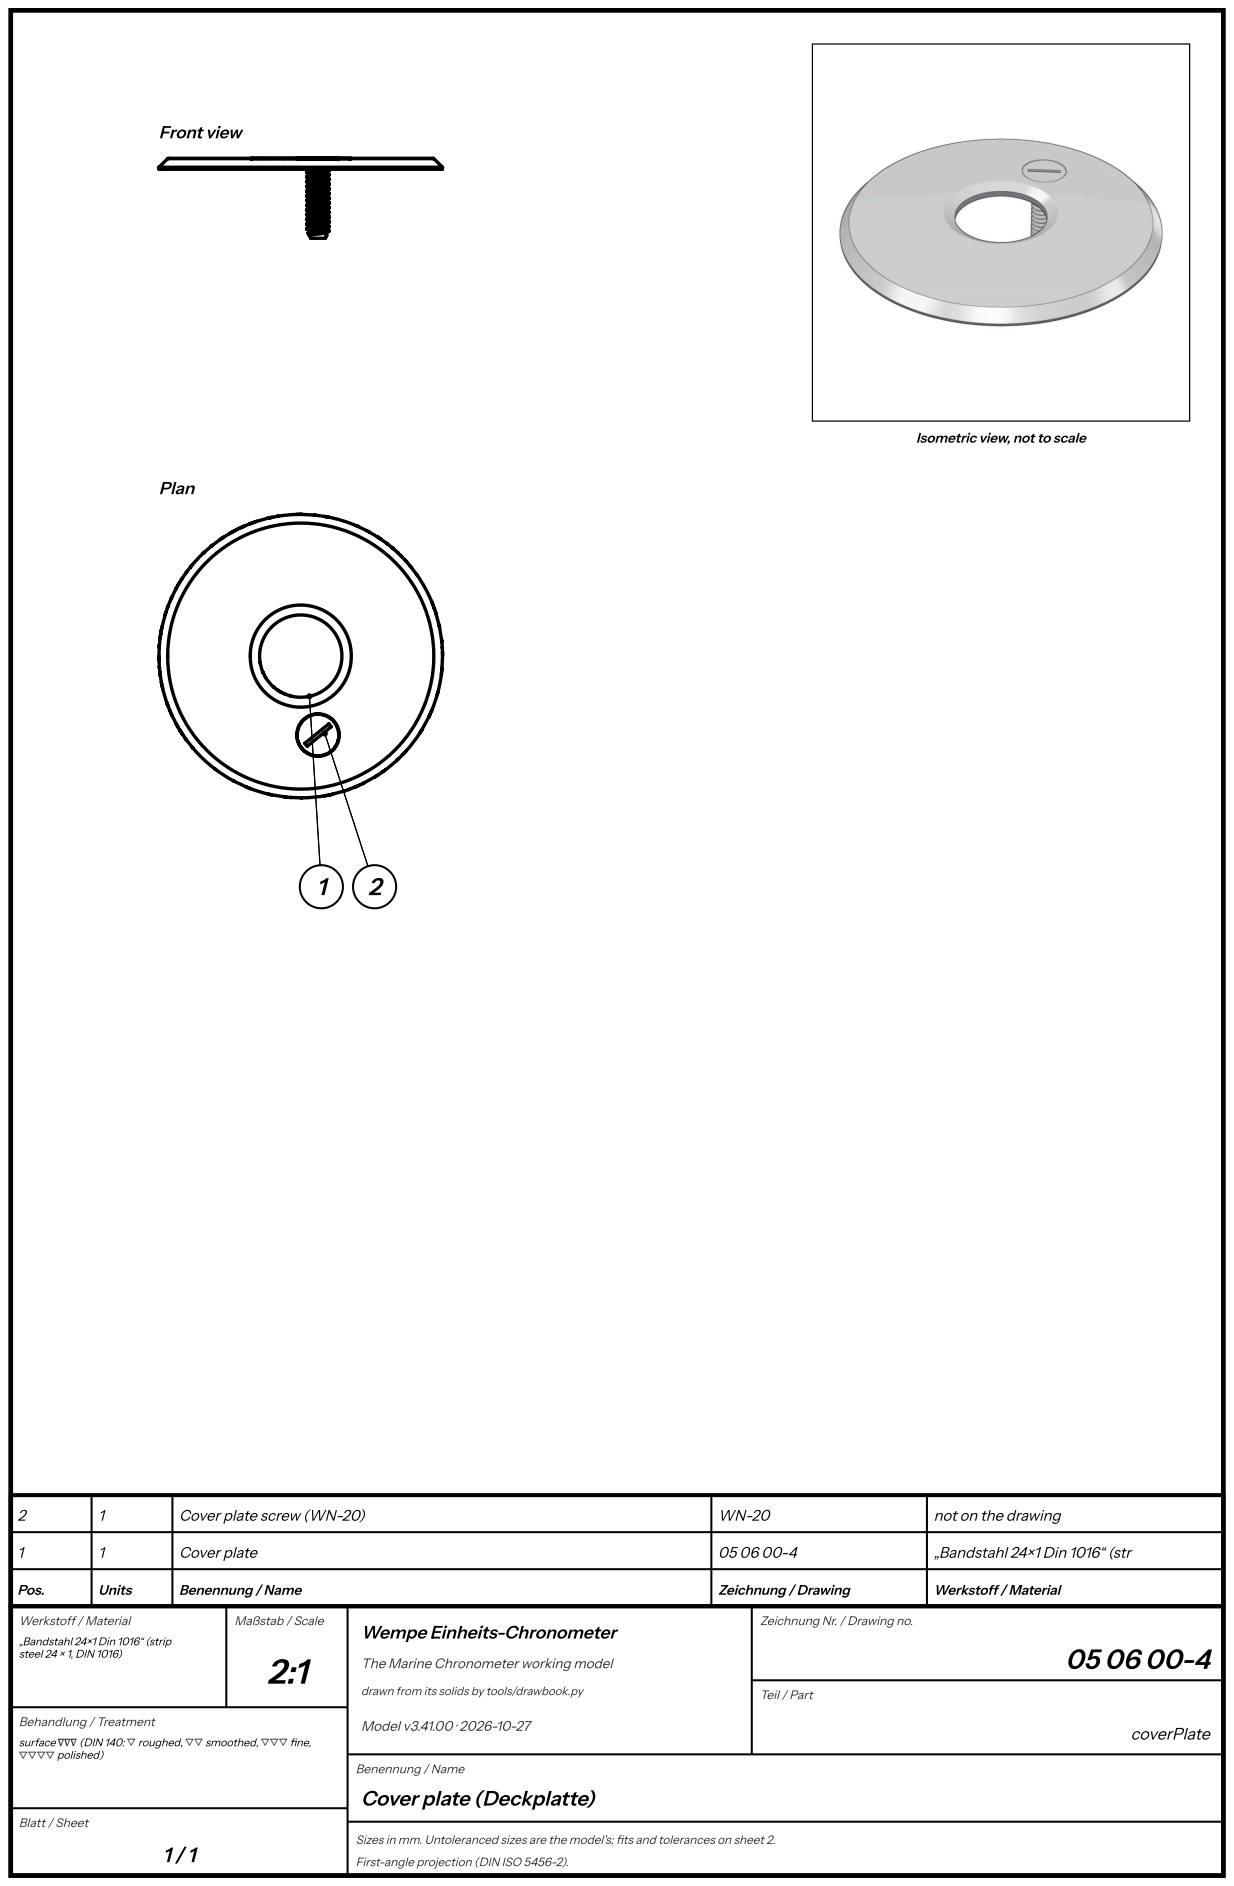
[picture p421: page 223]
Front view; Plan; Pos.; Units; Benennung / Name; Zeichnung / Drawing; Werkstoff / Material; Cover plate; „Bandstahl 24×1 Din 1016“ (str; Cover plate screw (WN-20); not on the drawing; Maßstab / Scale; Behandlung / Treatment; Model v3.41.00 · 2026-10-27; Teil / Part; coverPlate

Isometric view, not to scale

Zeichnung Nr. / Drawing no.

„Bandstahl 24×1 Din 1016“ (strip
steel 24 × 1, DIN 1016)

Wempe Einheits-Chronometer

The Marine Chronometer working model

drawn from its solids by tools/drawbook.py

surface ∇∇∇ (DIN 140: ▽ roughed, ▽▽ smoothed, ▽▽▽ fine,
▽▽▽▽ polished)

Cover plate (Deckplatte)

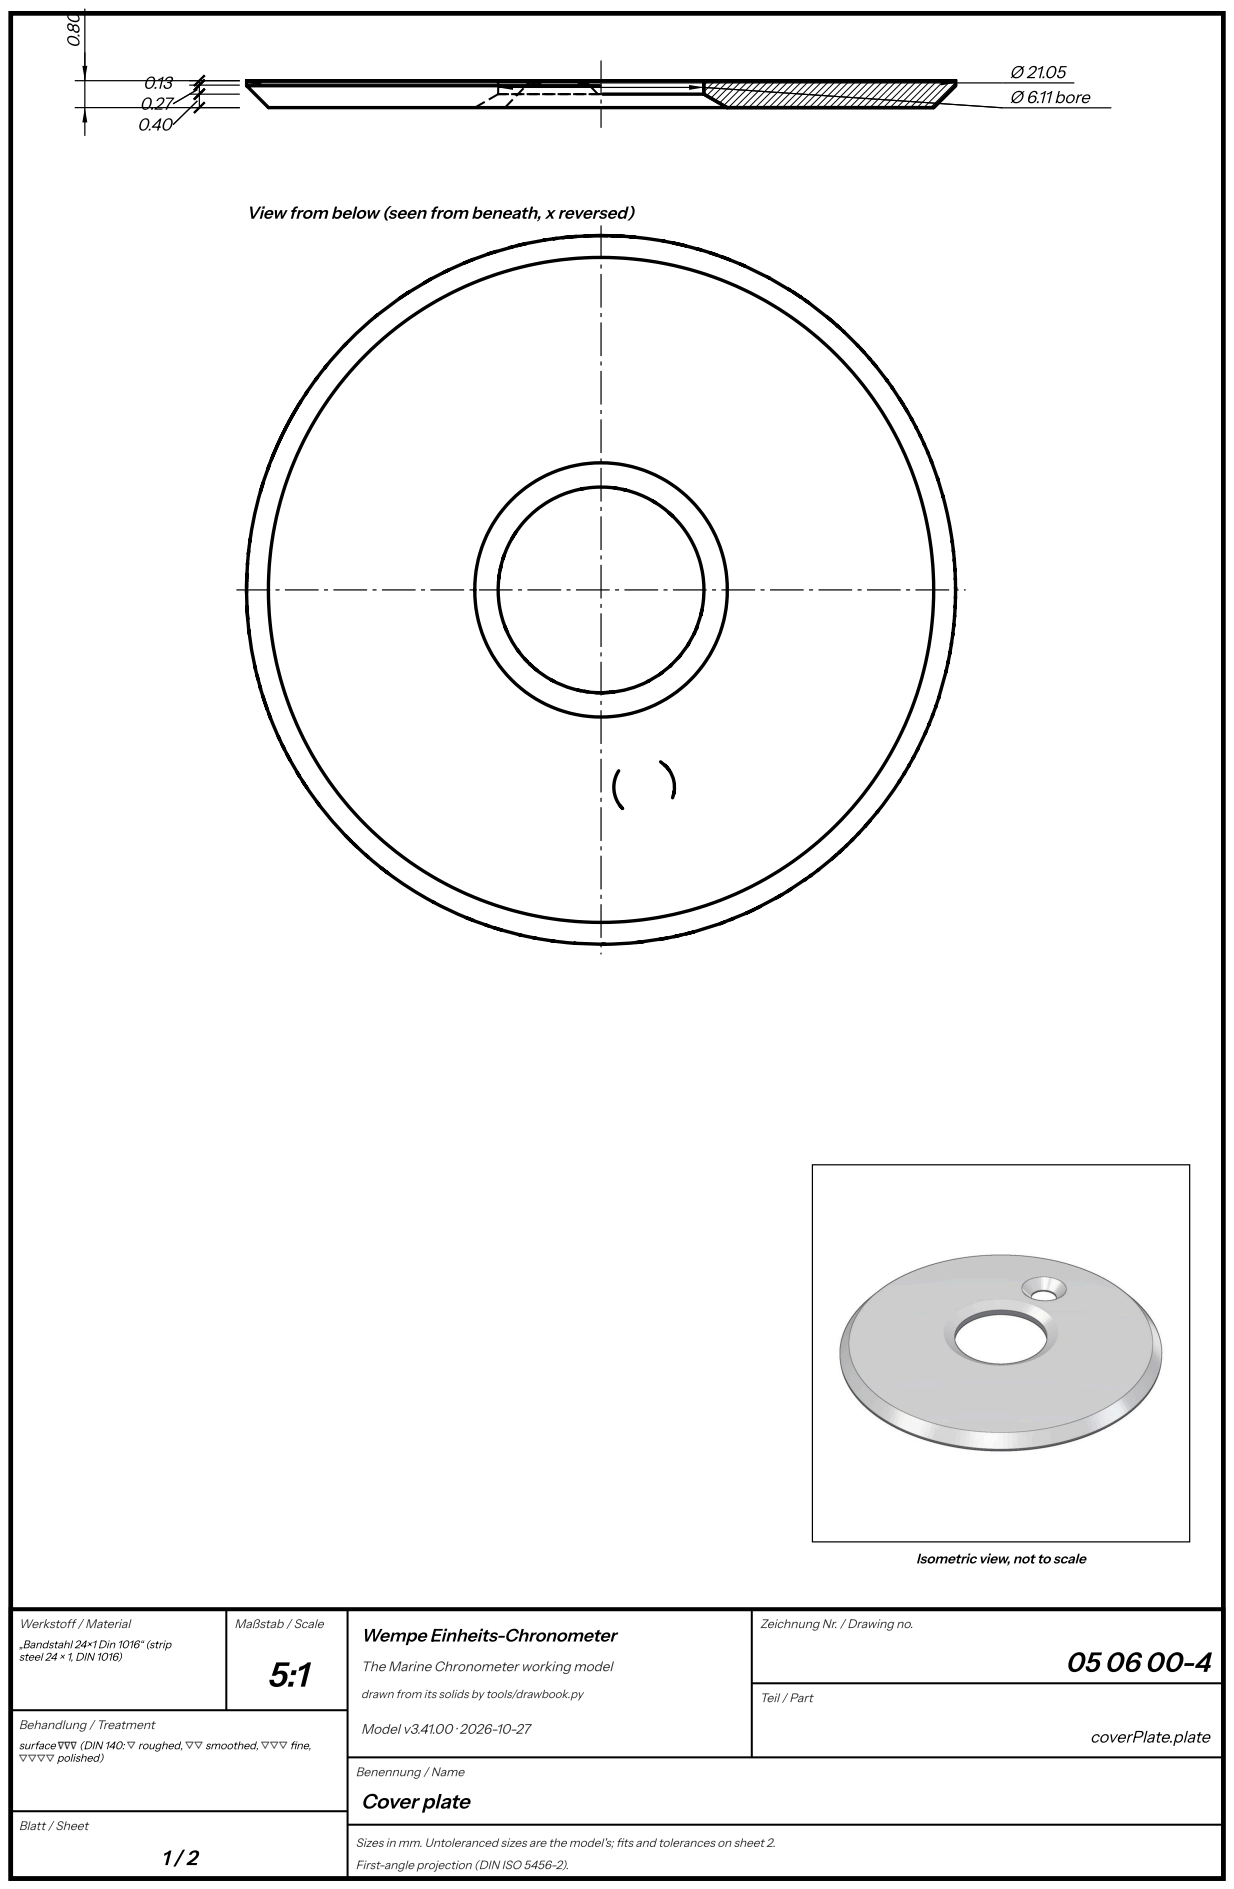
[picture p422: page 224]
Ø 6.11 bore; Werkstoff / Material; Maßstab / Scale; Behandlung / Treatment; Model v3.41.00 · 2026-10-27; Teil / Part; coverPlate.plate; Cover plate

View from below (seen from beneath, x reversed)

Isometric view, not to scale

Zeichnung Nr. / Drawing no.

„Bandstahl 24×1 Din 1016“ (strip
steel 24 × 1, DIN 1016)

Wempe Einheits-Chronometer

The Marine Chronometer working model

drawn from its solids by tools/drawbook.py

surface ∇∇∇ (DIN 140: ▽ roughed, ▽▽ smoothed, ▽▽▽ fine,
▽▽▽▽ polished)

## Cover plate — sheet 2

A steel disc on the fusee’s small end, screwed to it, over the stop bar’s slot: it keeps the bar in. Wempe 3955’s fusee shows

it bright, the bar’s end standing out from under it.

Parts list

Drawing | Name | Units | Material | Finish, heat treatment | Fit, as measured on the model
05 06 00-4 | Deckplatte (cover plate) | 1 | „Bandstahl 24×1 Din 1016“ (strip steel 24 × 1, DIN 1016) | surface ∇∇∇ (DIN 140: ▽ roughed, ▽▽ smoothed, ▽▽▽ fine, ▽▽▽▽ polished) | round 050604-1 (run): 0.361 mm, least gap 0.0092; on 050604-2: 0 mm

What it does (05 06 00-4). On the arbor's step against the body's small end, over the stop bar.

Turned about its axis; length 0.80, largest Ø 21.05. Diameters: Ø 21.05; bores Ø 6.11. Shoulders from the lower end: 0.00,

0.40, 0.67, 0.80.

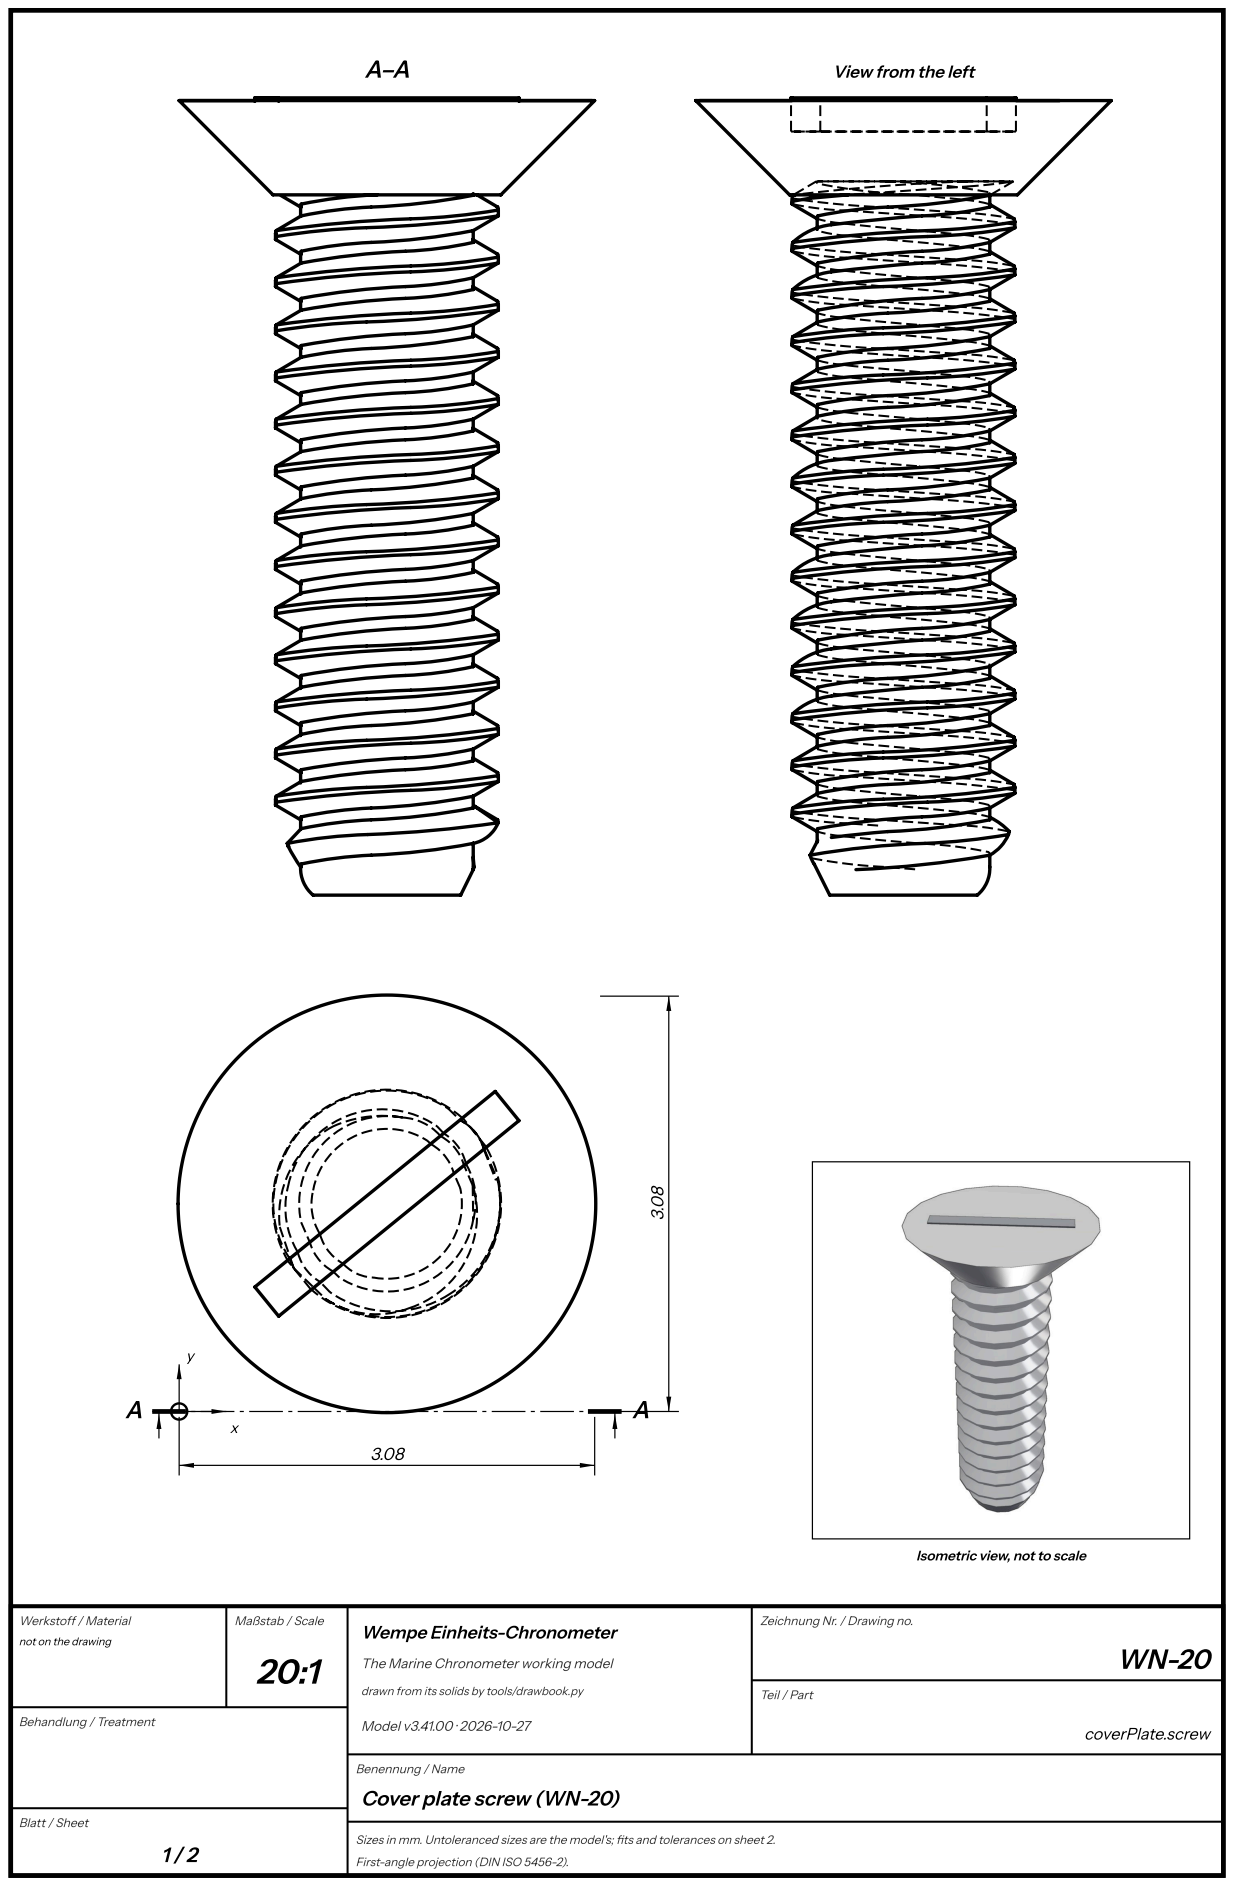
[picture p423: page 226]
Werkstoff / Material; Maßstab / Scale; Behandlung / Treatment; Model v3.41.00 · 2026-10-27; Teil / Part; coverPlate.screw

View from the left

Isometric view, not to scale

Zeichnung Nr. / Drawing no.

not on the drawing

Wempe Einheits-Chronometer

The Marine Chronometer working model

drawn from its solids by tools/drawbook.py

Cover plate screw (WN-20)

## Cover plate screw (WN-20) — sheet 2

The countersunk screw holding the cover plate to the fusee’s small end.

Parts list

Drawing | Name | Units | Material | Finish, heat treatment | Fit, as measured on the model
WN-20 | Schraube WN-20 (cover plate screw) | 1 | not on the drawing | | in 050600-4 (press): 0.394 mm, least gap 0.0143; in 050604-2 (tap): 3.5 mm, least gap 0.0394

What it does (WN-20). Countersunk in the cover plate, into the body's M1.7, 6 deep from the small end's recess floor (05

06 04-2).

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

drawn; depths from the face seen in the plan (the top). Thickness 5.92.

Contourin the plan

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

radius.

Contour | # | Element | From x, y | To x, y | Centre x, y | R
Outline | 1 | circle | | | 1.54, 1.54 | 1.55
Cut-out 1 | 2 | line | 0.91, 2.11 | 0.91, 2.11
Cut-out 1 | 3 | line | 0.91, 2.11 | 0.91, 2.11
Cut-out 1 | 4 | line | 0.91, 2.11 | 0.91, 2.11
Cut-out 1 | 5 | line | 0.91, 2.11 | 0.91, 2.11

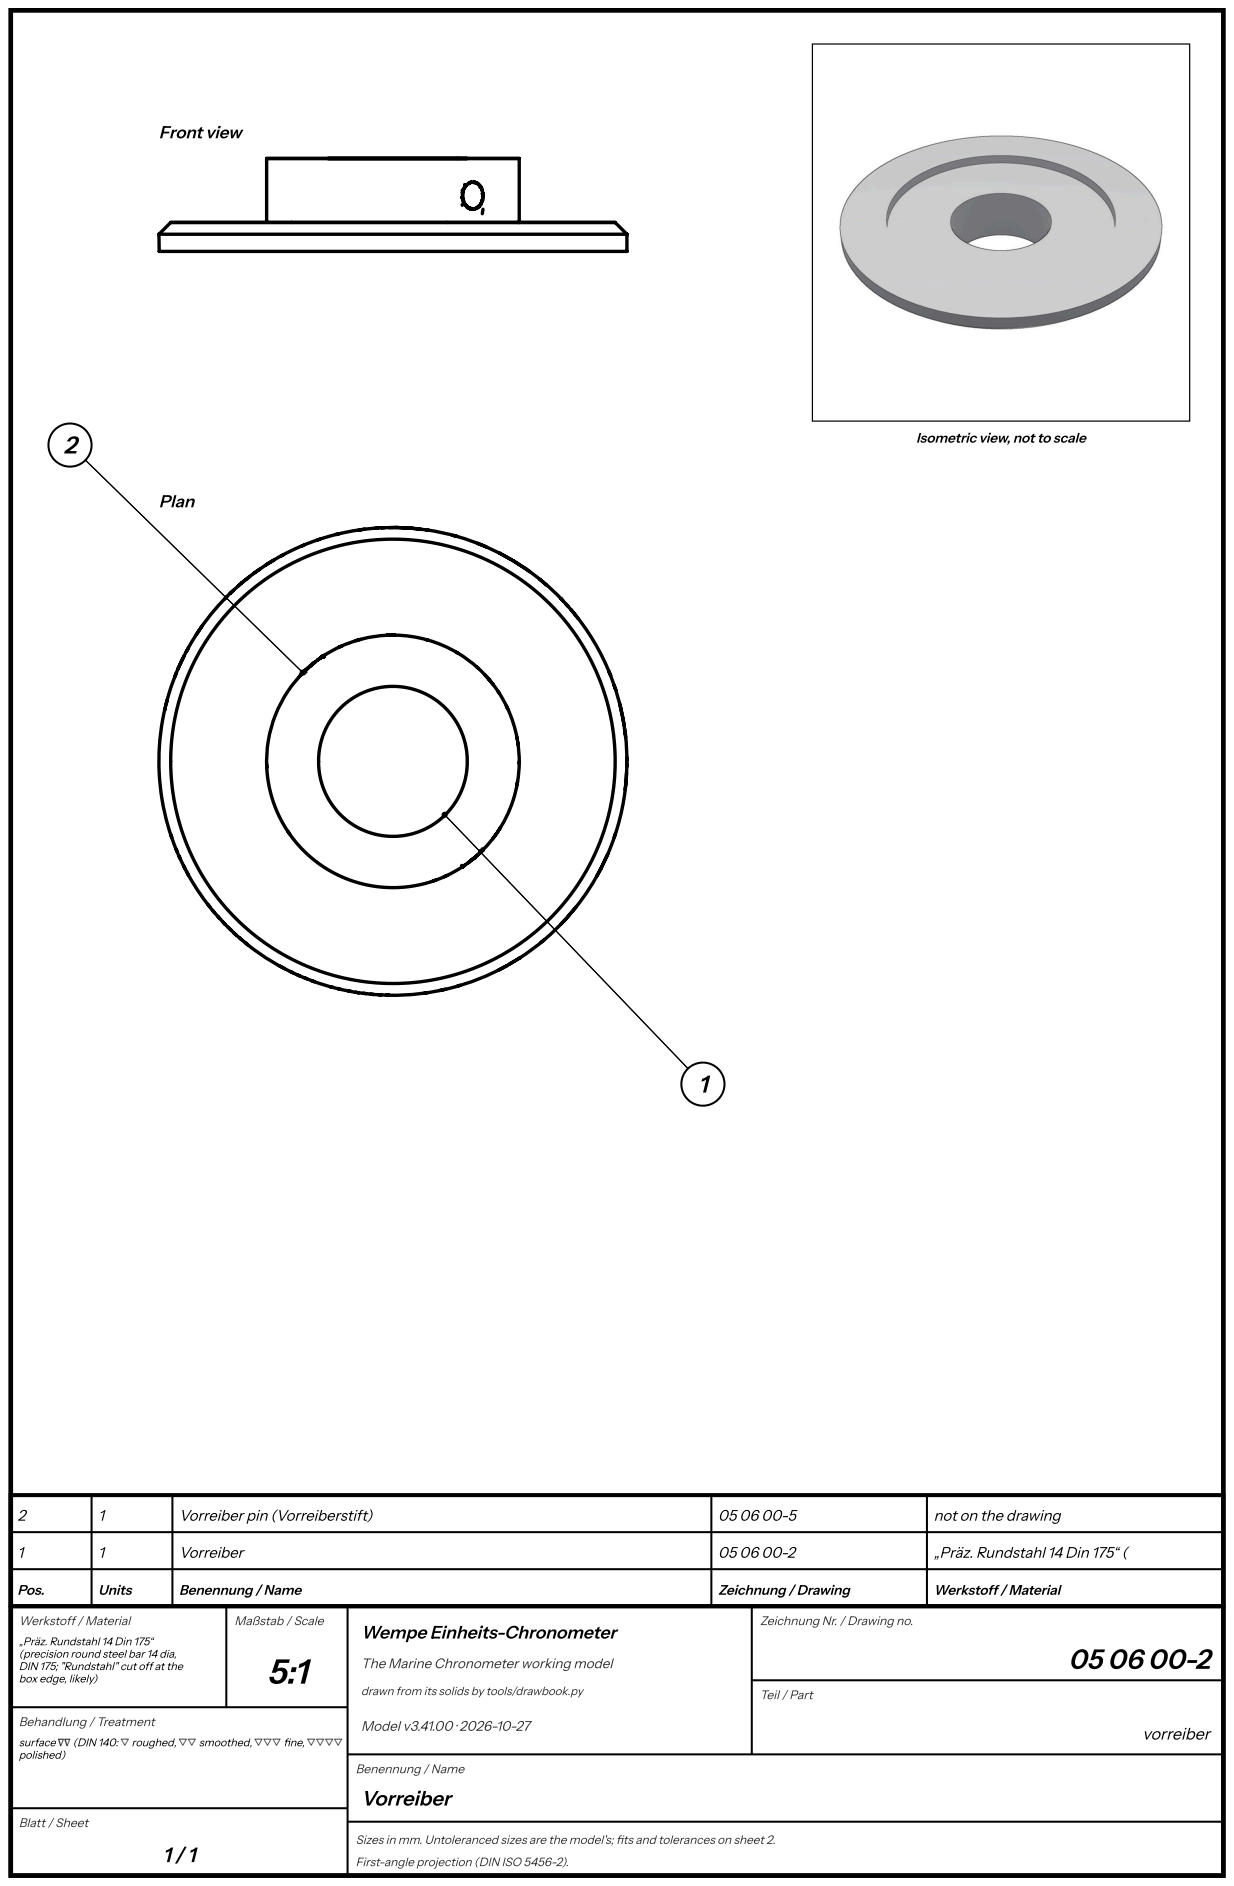
[picture p424: page 228]
Front view; Plan; Pos.; Units; Benennung / Name; Zeichnung / Drawing; Werkstoff / Material; Vorreiber; „Präz. Rundstahl14 Din 175“ (; Vorreiber pin (Vorreiberstift); not on the drawing; Maßstab / Scale; Behandlung / Treatment; Model v3.41.00 · 2026-10-27; Teil / Part; vorreiber

Isometric view, not to scale

Zeichnung Nr. / Drawing no.

„Präz. Rundstahl14 Din 175“
(precision round steel bar14 dia,
DIN 175; "Rundstahl" cut off at the
box edge, likely)

Wempe Einheits-Chronometer

The Marine Chronometer working model

drawn from its solids by tools/drawbook.py

surface ∇∇ (DIN 140: ▽ roughed, ▽▽ smoothed, ▽▽▽ fine, ▽▽▽▽
polished)

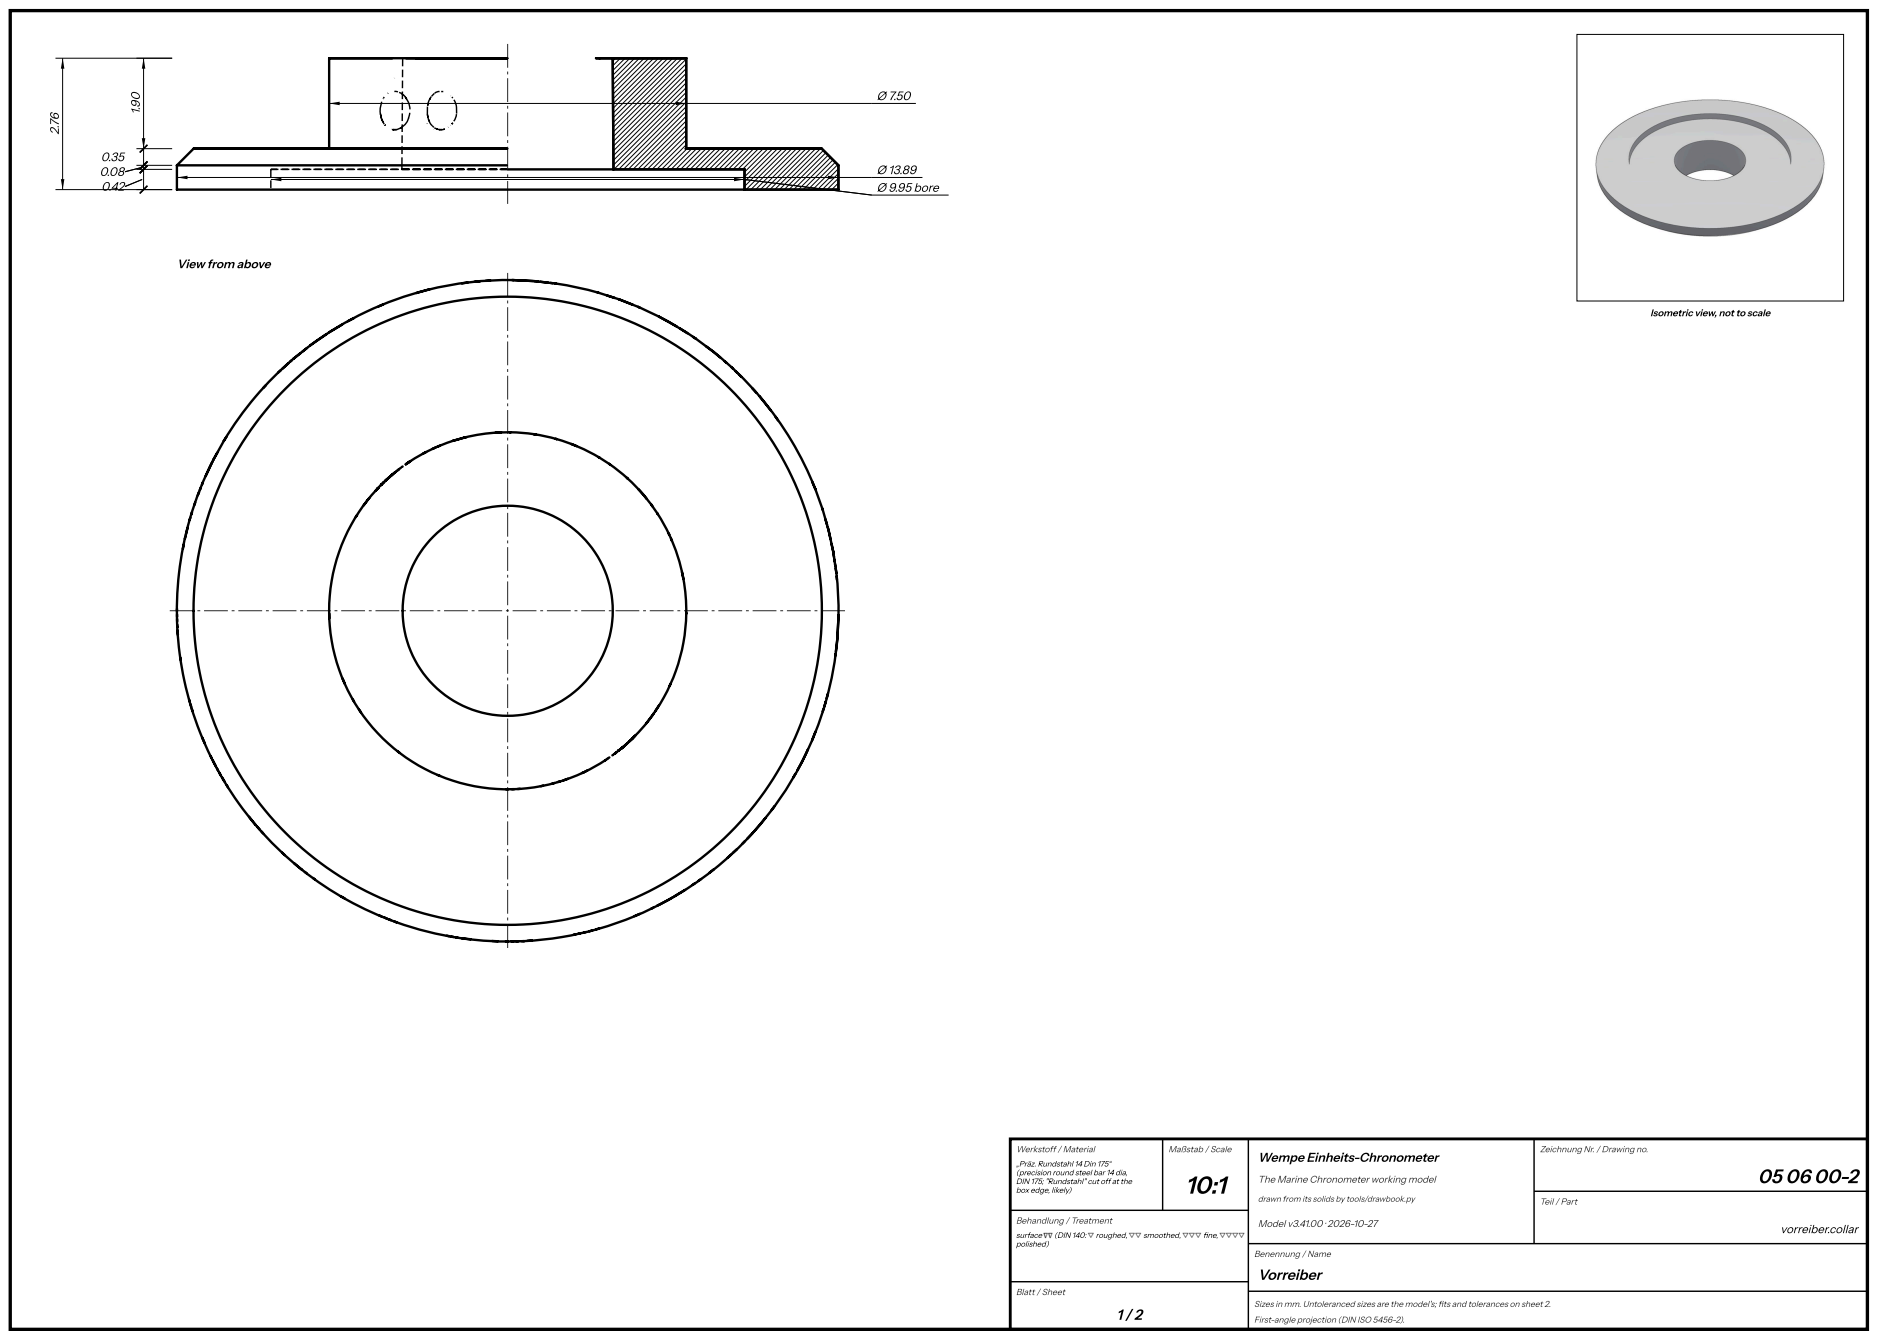
[picture p425: page 229]
Ø 9.95 bore; Werkstoff / Material; Maßstab / Scale; Behandlung / Treatment; Model v3.41.00 · 2026-10-27; Teil / Part; vorreiber.collar; Vorreiber

View from above

Isometric view, not to scale

Zeichnung Nr. / Drawing no.

„Präz. Rundstahl14 Din 175“
(precision round steel bar14 dia,
DIN 175; "Rundstahl" cut off at the
box edge, likely)

Wempe Einheits-Chronometer

The Marine Chronometer working model

drawn from its solids by tools/drawbook.py

surface ∇∇ (DIN 140: ▽ roughed, ▽▽ smoothed, ▽▽▽ fine, ▽▽▽▽
polished)

## Vorreiber — sheet 2

A steel collar pinned to the fusee arbor under the fusee wheel, its flange in the wheel’s underside recess: it keeps the

wheel and the maintaining work on the arbor. Its face under the wheel is re-turned at the fusee’s assembly (“bei

Schneckenmontage … Fläche a nachdrehen”), which sets the endshake of the stack.

Parts list

Drawing | Name | Units | Material | Finish, heat treatment | Fit, as measured on the model
05 06 00-2 | Vorreiber | 1 | „Präz. Rundstahl 14 Din 175“ (precision round steel bar 14 dia, DIN 175; "Rundstahl" cut off at the box edge, likely) | surface ∇∇ (DIN 140: ▽ roughed, ▽▽ smoothed, ▽▽▽ fine, ▽▽▽▽ polished) | round 050604-1 (press): 2.166 mm, least gap 0.0134

What it does (05 06 00-2). Pinned on the arbor's taper under the fusee wheel, its flange in the wheel's underside recess.

Turned about its axis; length 2.76, largest Ø 13.89. Diameters: Ø 7.50, Ø 13.89; bores Ø 9.95. Shoulders from the lower end:

0.00, 0.42, 0.51, 0.86, 2.76.

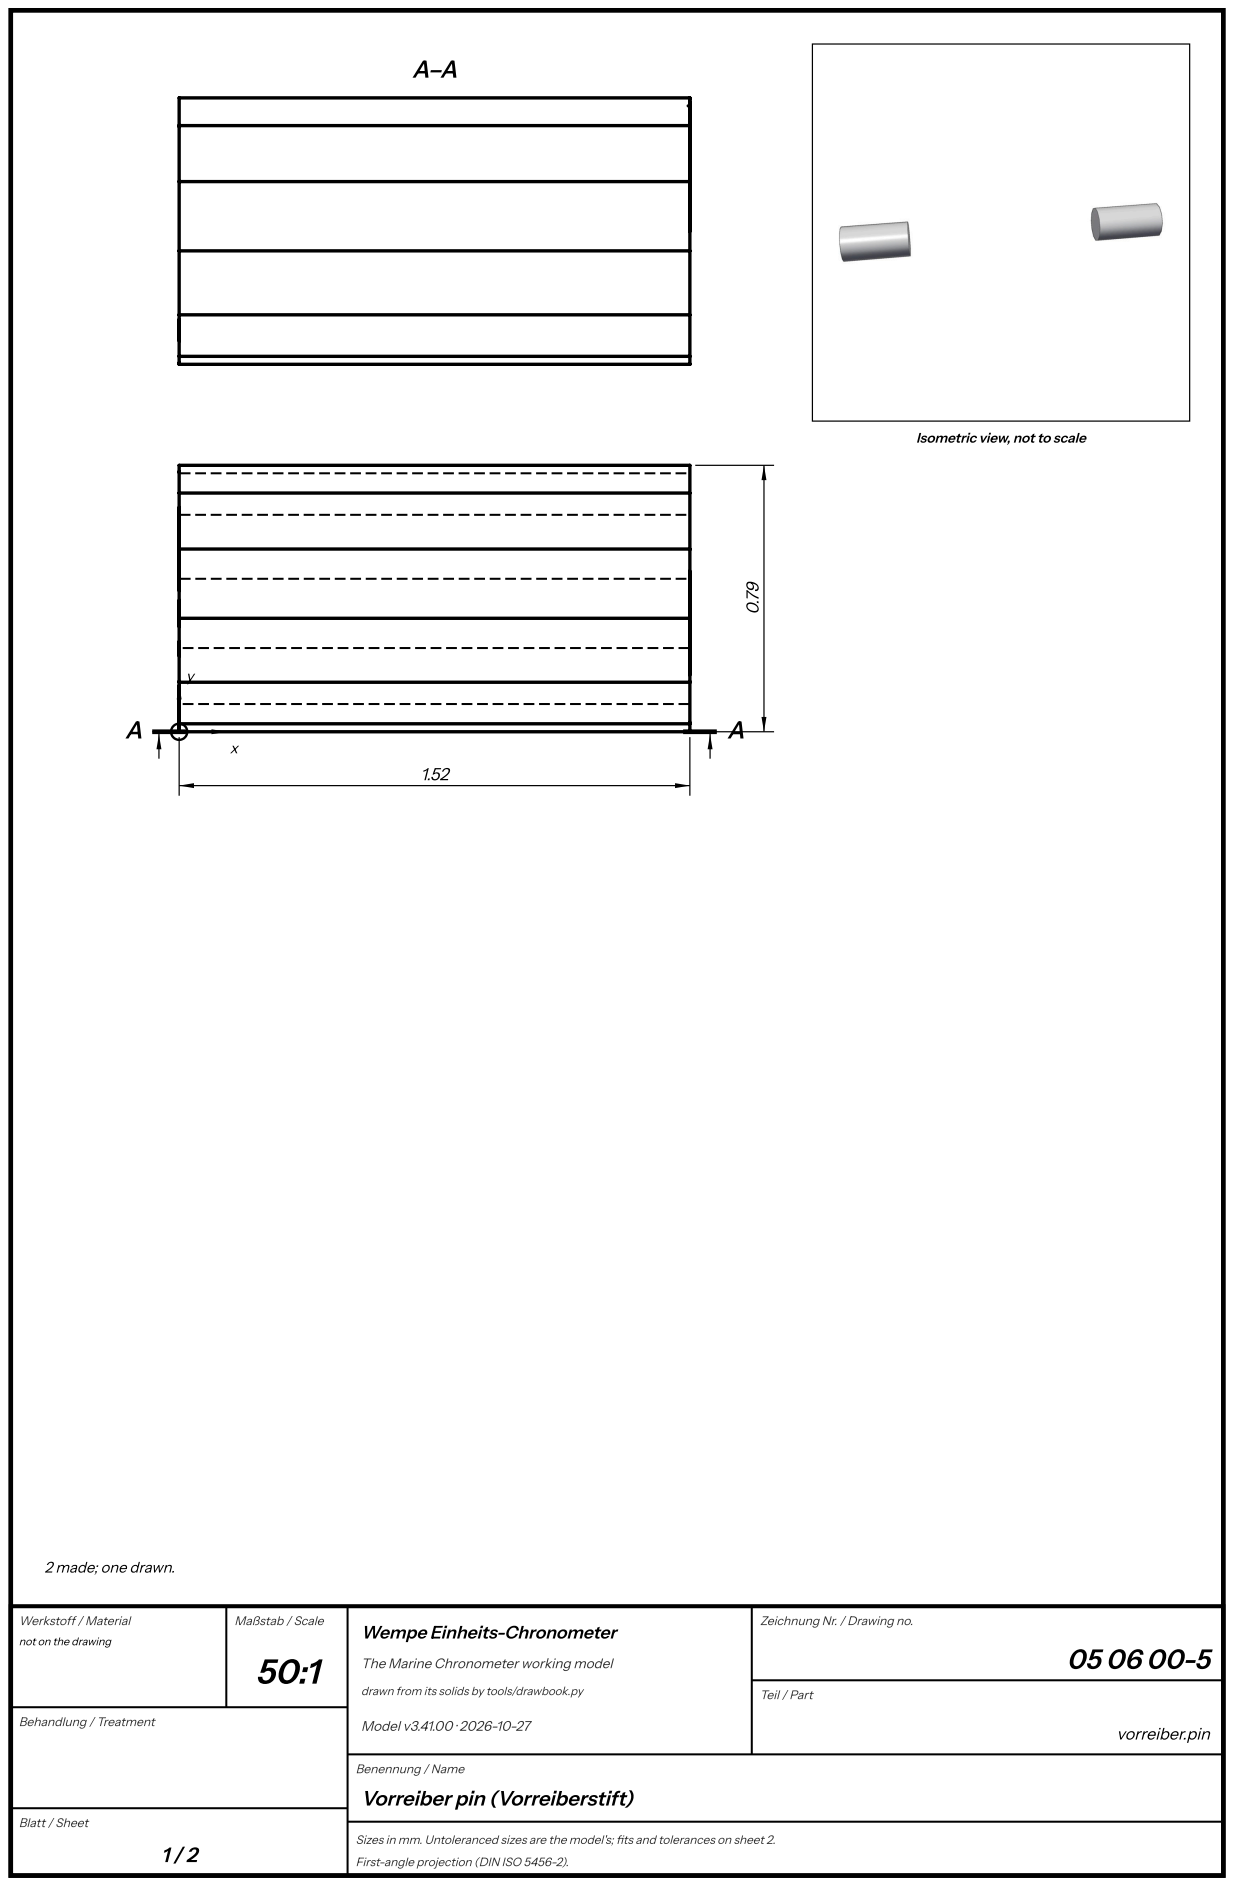
[picture p426: page 231]
Werkstoff / Material; Maßstab / Scale; Behandlung / Treatment; Model v3.41.00 · 2026-10-27; Teil / Part; vorreiber.pin

Isometric view, not to scale

2 made; one drawn.

Zeichnung Nr. / Drawing no.

not on the drawing

Wempe Einheits-Chronometer

The Marine Chronometer working model

drawn from its solids by tools/drawbook.py

Vorreiber pin (Vorreiberstift)

## Vorreiber pin (Vorreiberstift) — sheet 2

The taper pin through the Vorreiber’s hub and the arbor’s cross hole.

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

Parts list

Drawing | Name | Units | Material | Finish, heat treatment | Fit, as measured on the model
05 06 00-5 | Vorreiberstift (Vorreiber pin) | 1 | not on the drawing | | in 050600-2 (press): 3.091 mm, least gap -0.0004

What it does (05 06 00-5). Through the Vorreiber's hub (its Ø 0.8 hole, 05 06 00-2) and the arbor's cross hole (Ø 1.1, 05 06

04-1): drawn as its two ends in the hub, so the Exploded view can part the arbor from the Vorreiber.

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

drawn; depths from the face seen in the plan (the top). Thickness 0.79.

Contourin the plan

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

radius.

Contour | # | Element | From x, y | To x, y | Centre x, y | R
Outline | 1 | line | 0.00, 0.25 | 0.00, 0.79
Outline | 2 | line | 0.00, 0.79 | 1.52, 0.79
Outline | 3 | line | 1.52, 0.79 | 1.52, 0.00
Outline | 4 | line | 1.52, 0.00 | 0.00, 0.00
Outline | 5 | line | 0.00, 0.00 | 0.00, 0.25

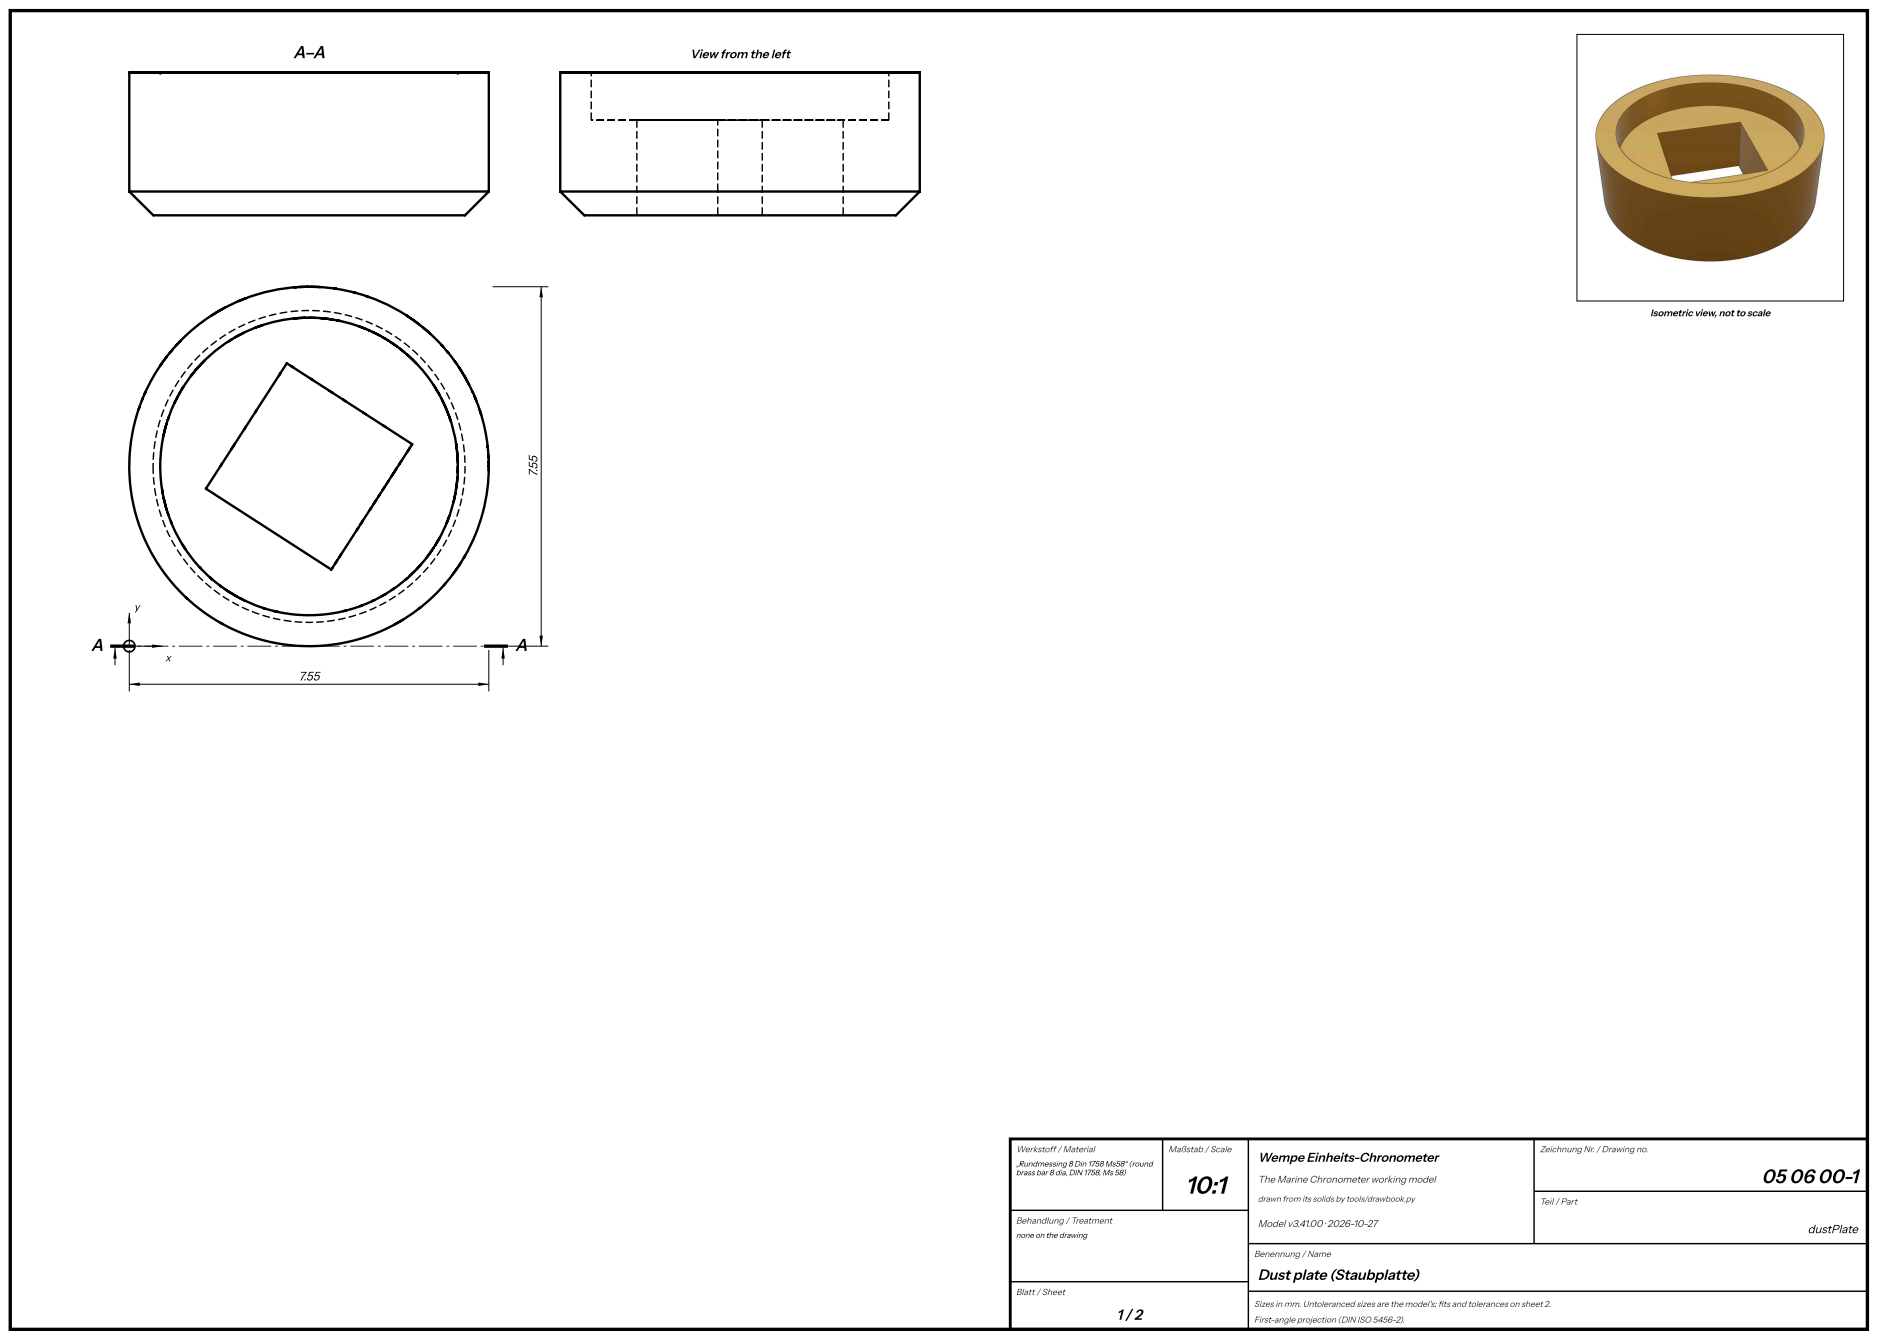
[picture p427: page 233]
Werkstoff / Material; Maßstab / Scale; Behandlung / Treatment; Model v3.41.00 · 2026-10-27; Teil / Part; dustPlate

View from the left

Isometric view, not to scale

Zeichnung Nr. / Drawing no.

„Rundmessing 8 Din 1758 Ms58“ (round
brass bar 8 dia, DIN 1758, Ms 58)

Wempe Einheits-Chronometer

The Marine Chronometer working model

drawn from its solids by tools/drawbook.py

none on the drawing

Dust plate (Staubplatte)

## Dust plate (Staubplatte) — sheet 2

A brass disc on the winding square, turning with it inside the dust bush, which keeps dust from the winding hole out of the

fusee bush.

Parts list

Drawing | Name | Units | Material | Finish, heat treatment | Fit, as measured on the model
05 06 00-1 | Staubplatte (dust plate) | 1 | „Rundmessing 8 Din 1758 Ms58“ (round brass bar 8 dia, DIN 1758, Ms 58) | none on the drawing | round 050604-1 (press): 1.805 mm, least gap 0.0034

What it does (05 06 00-1). On the winding square, inside the dust bush.

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

drawn; depths from the face seen in the plan (the top). Thickness 3.00.

Contourin the plan

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

radius.

Contour | # | Element | From x, y | To x, y | Centre x, y | R
Outline | 1 | circle | | | 3.77, 3.77 | 3.77
Cut-out 1 | 2 | line | 1.61, 3.31 | 4.24, 1.61
Cut-out 1 | 3 | line | 4.24, 1.61 | 5.94, 4.24
Cut-out 1 | 4 | line | 5.94, 4.24 | 3.31, 5.94
Cut-out 1 | 5 | line | 3.31, 5.94 | 1.61, 3.31

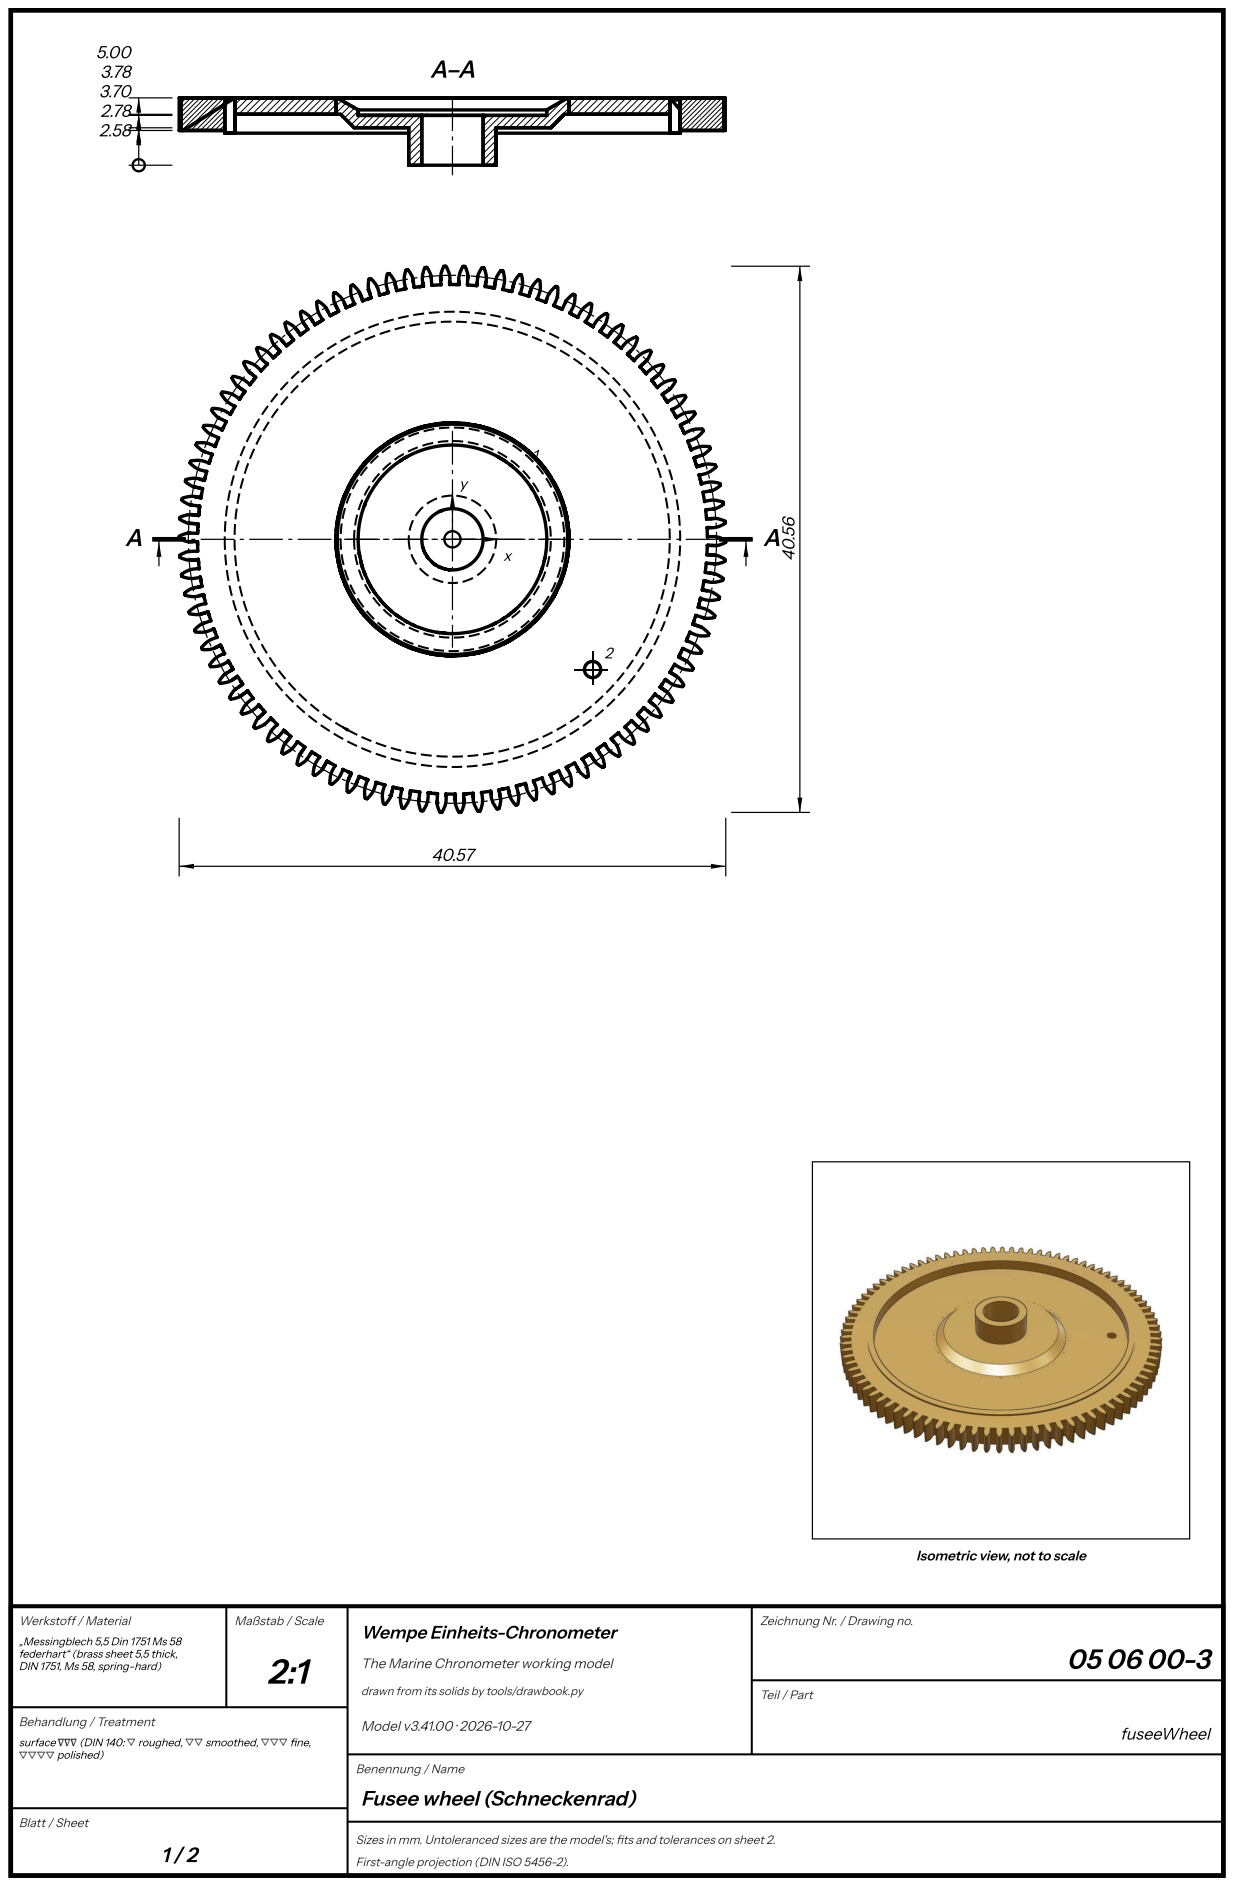
[picture p428: page 235]
Werkstoff / Material; Maßstab / Scale; Behandlung / Treatment; Model v3.41.00 · 2026-10-27; Teil / Part; fuseeWheel

Isometric view, not to scale

Zeichnung Nr. / Drawing no.

„Messingblech 5,5 Din 1751 Ms 58
federhart“ (brass sheet 5,5 thick,
DIN 1751, Ms 58, spring-hard)

Wempe Einheits-Chronometer

The Marine Chronometer working model

drawn from its solids by tools/drawbook.py

surface ∇∇∇ (DIN 140: ▽ roughed, ▽▽ smoothed, ▽▽▽ fine,
▽▽▽▽ polished)

Fusee wheel (Schneckenrad)

## Fusee wheel (Schneckenrad) — sheet 2

The great wheel: it drives the centre pinion, so the whole train. It turns loose on the fusee arbor, driven by the maintaining

spring, which lies in the recess in its face; the maintaining ratchet turns on the tube on its hub.

Parts list

Drawing | Name | Units | Material | Finish, heat treatment | Fit, as measured on the model
05 06 00-3 | Schneckenrad (fusee wheel) | 1 | „Messingblech 5,5 Din 1751 Ms 58 federhart“ (brass sheet 5,5 thick, DIN 1751, Ms 58, spring-hard) | surface ∇∇∇ (DIN 140: ▽ roughed, ▽▽ smoothed, ▽▽▽ fine, ▽▽▽▽ polished) | -6.428571

What it does (05 06 00-3). Loose on the arbor's seat, driven by the maintaining spring; drives the centre pinion.

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

the face seen in the plan (the top). Thickness 5.00.

Holes

Hole | x | y | Size
1 | 0.00 | 0.00 | Ø 4.55 through (3.70 thick at 0.00-3.70); countersunk to Ø 14.60
2 | 10.40 | -9.67 | Ø 1.21 through (1.22 thick at 3.78-5.00)

The contour has 766 elements (its teeth): the drawing and the tooth data define it.

Levels

Faces in section A-A, from the bottom face: 2.58, 2.78, 3.70, 3.78, 5.00.

Teeth

Number | Module | Tip Ø | Root Ø
90 | 0.4356 | 40.57 | 37.84

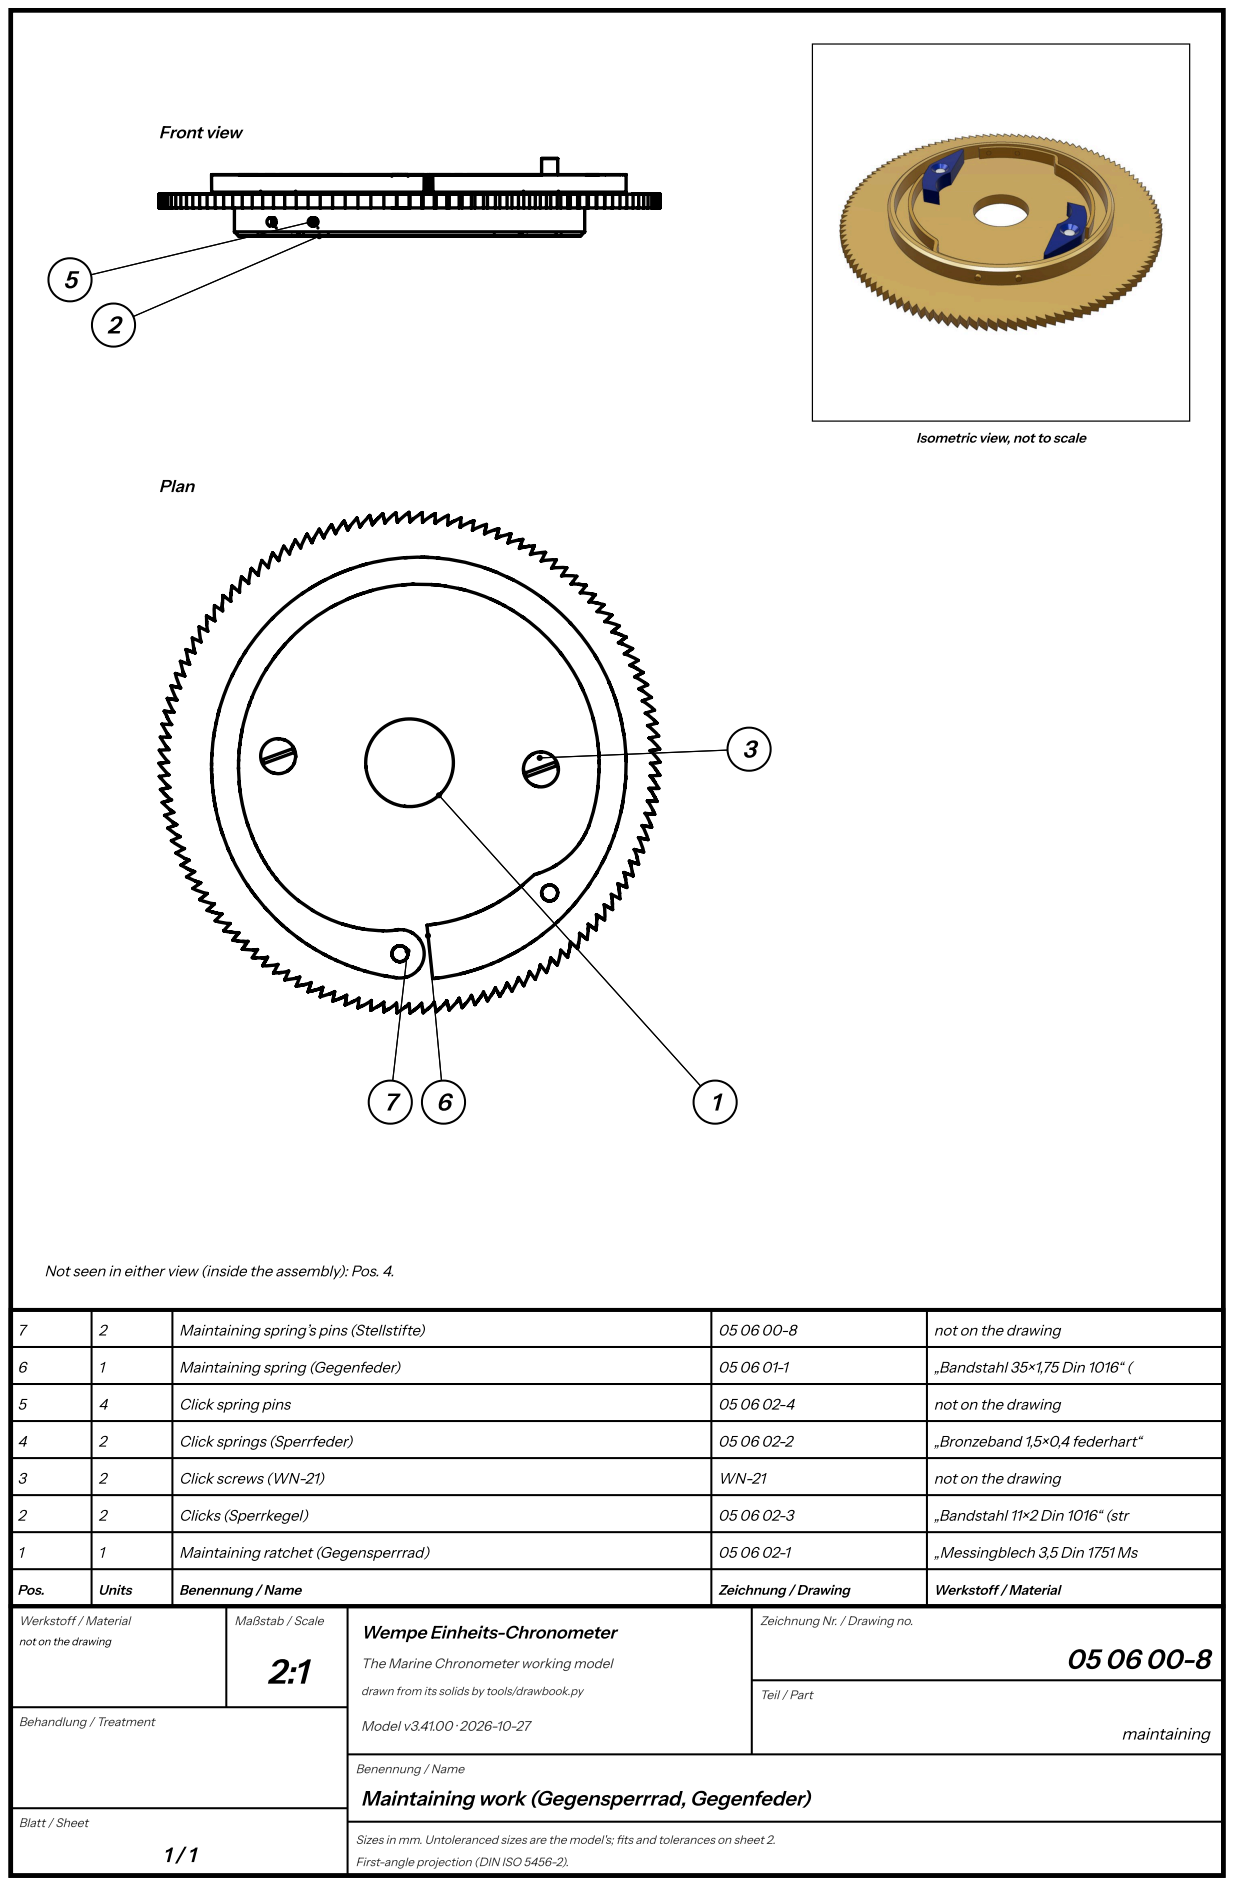
[picture p429: page 237]
Front view; Plan; Pos.; Units; Benennung / Name; Zeichnung / Drawing; Werkstoff / Material; Maintaining ratchet (Gegensperrrad); „Messingblech 3,5 Din 1751 Ms; Clicks (Sperrkegel); „Bandstahl11×2 Din 1016“ (str; Click screws (WN-21); not on the drawing; Click springs (Sperrfeder); „Bronzeband 1,5×0,4 federhart“; Click spring pins; Maintaining spring (Gegenfeder); „Bandstahl 35×1,75 Din 1016“ (; Maintaining spring’s pins (Stellstifte); Maßstab / Scale; Behandlung / Treatment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

Isometric view, not to scale

Not seen in either view (inside the assembly): Pos. 4.

Zeichnung Nr. / Drawing no.

not on the drawing

Wempe Einheits-Chronometer

The Marine Chronometer working model

drawn from its solids by tools/drawbook.py

Maintaining work (Gegensperrrad, Gegenfeder)

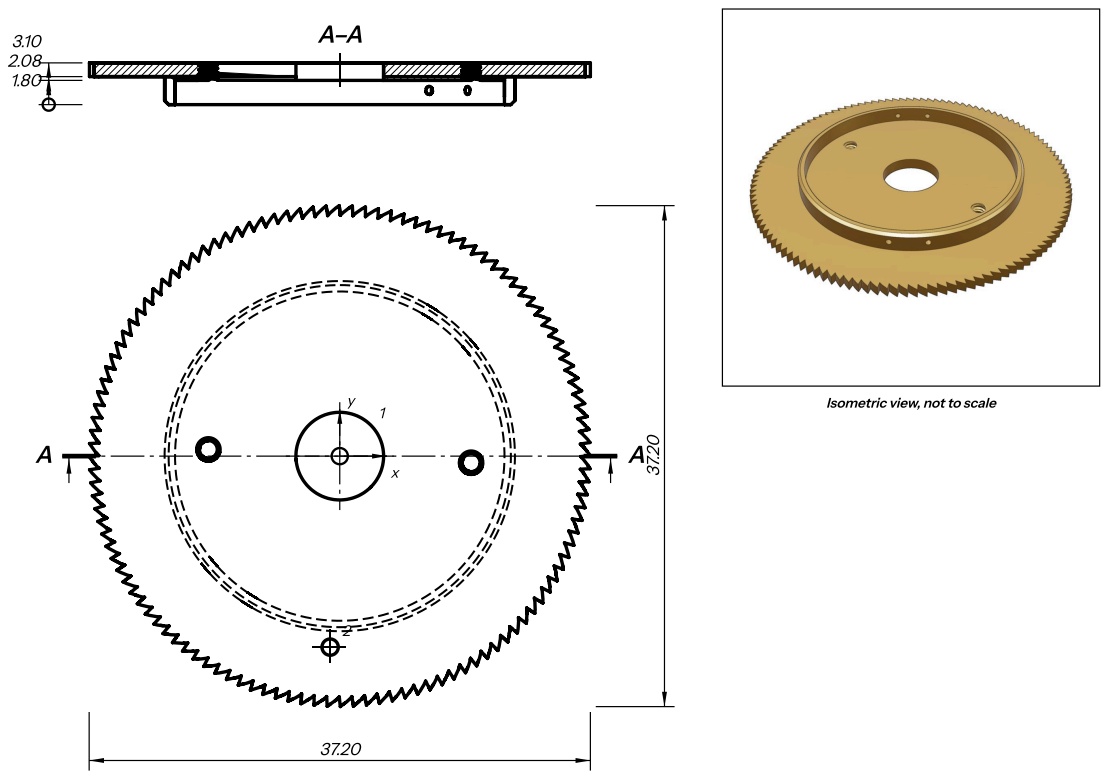
[picture p430: page 238]
Werkstoff / Material; Maßstab / Scale; Behandlung / Treatment; Model v3.41.00 · 2026-10-27; Teil / Part; maintaining.ratchet

Isometric view, not to scale

Zeichnung Nr. / Drawing no.

„Messingblech 3,5 Din 1751 Ms 58
federhart“ (brass sheet 3,5, DIN
1751, Ms 58 spring-hard)

Wempe Einheits-Chronometer

The Marine Chronometer working model

drawn from its solids by tools/drawbook.py

surface ∇∇∇ (DIN 140: ▽ roughed, ▽▽ smoothed, ▽▽▽ fine,
▽▽▽▽ polished)

Maintaining ratchet (Gegensperrrad)
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
