OrelMag/marine-chronometer-model/docs/motion-3d/img/wempe/3_letgo_build_maintaining.png

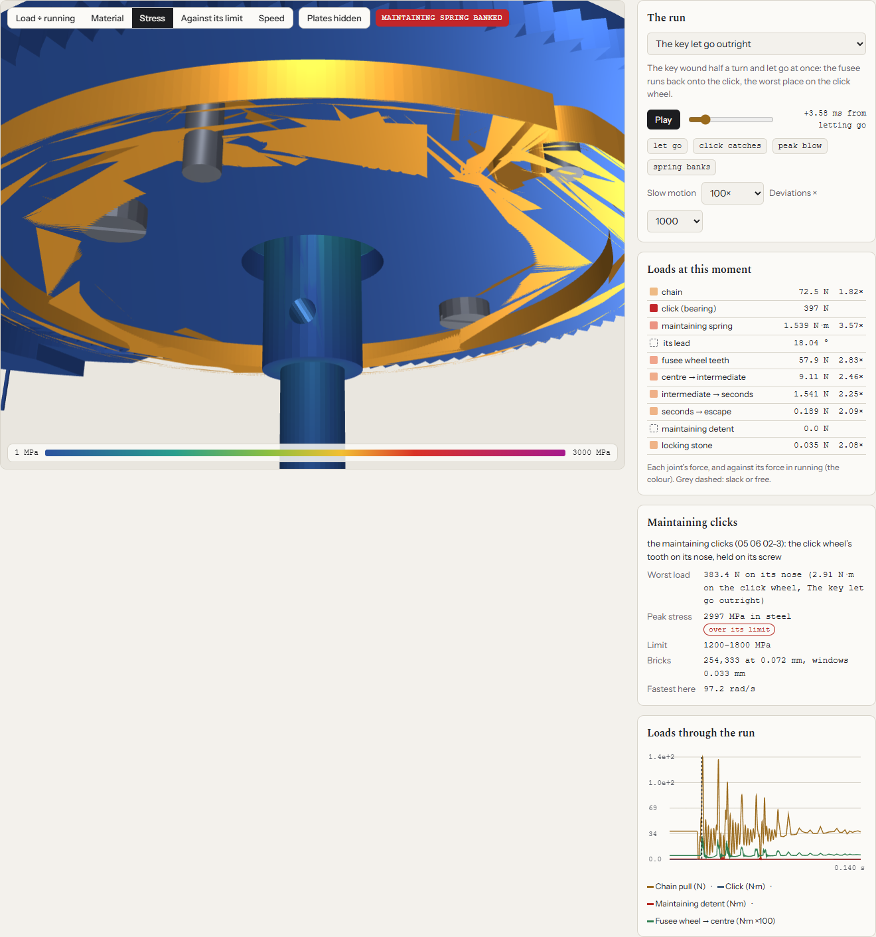
docs/motion-3d/img/wempe/3_letgo_build_maintaining.png
