OrelMag/marine-chronometer-model/docs/motion-3d/img/wempe/5_mainspring_build.png

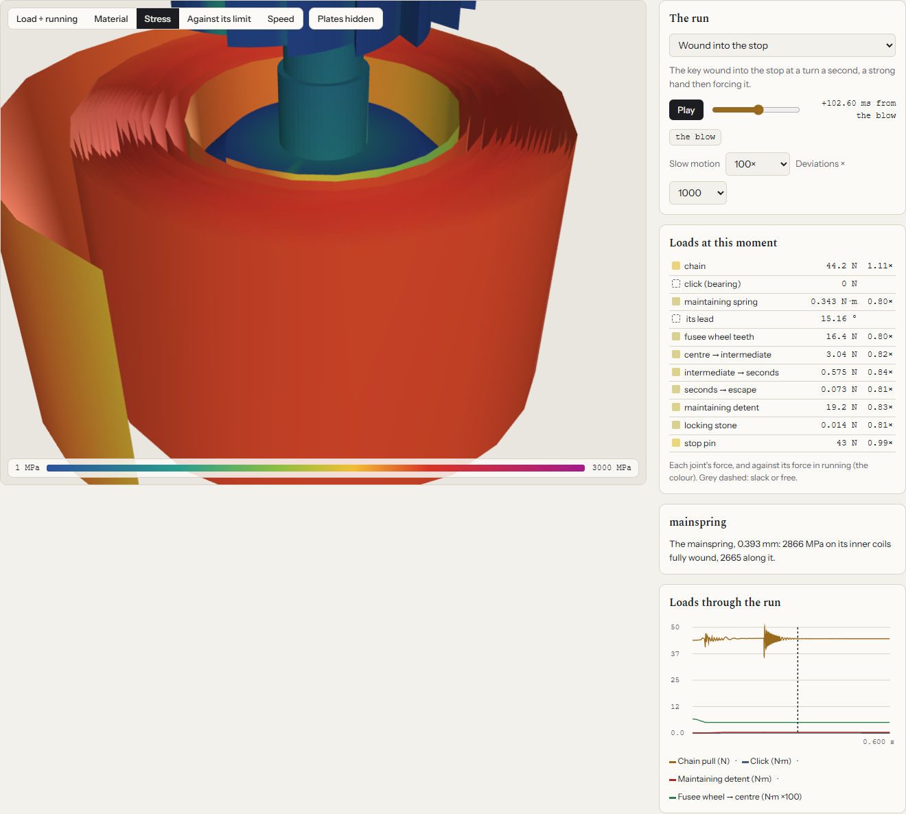
docs/motion-3d/img/wempe/5_mainspring_build.png
