OrelMag/marine-chronometer-model/docs/motion-3d/img/wempe/findings_build.png

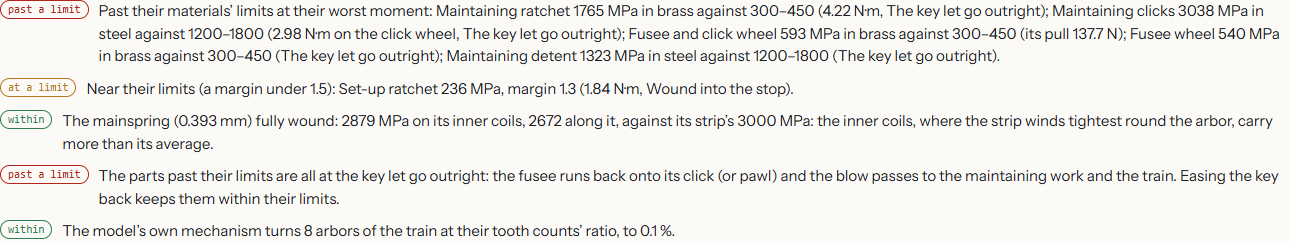
docs/motion-3d/img/wempe/findings_build.png
