OrelMag/marine-chronometer-model/marine-chronometer-source/hamilton-parts/renders/setupRatchet.webp

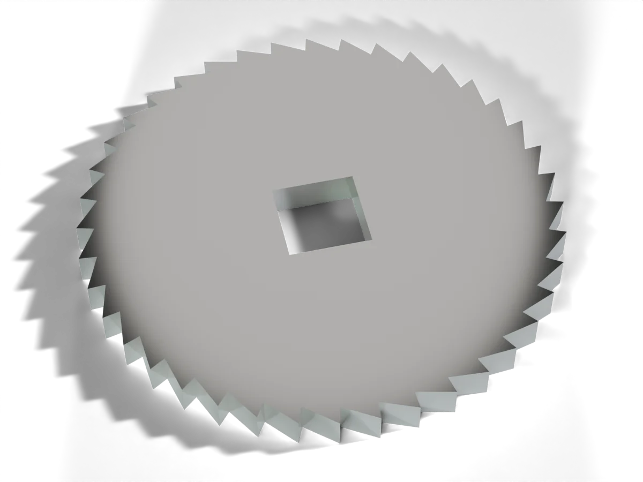
marine-chronometer-source/hamilton-parts/renders/setupRatchet.webp
