OrelMag/marine-chronometer-model/References/manual-fig13-train-exploded.jpg

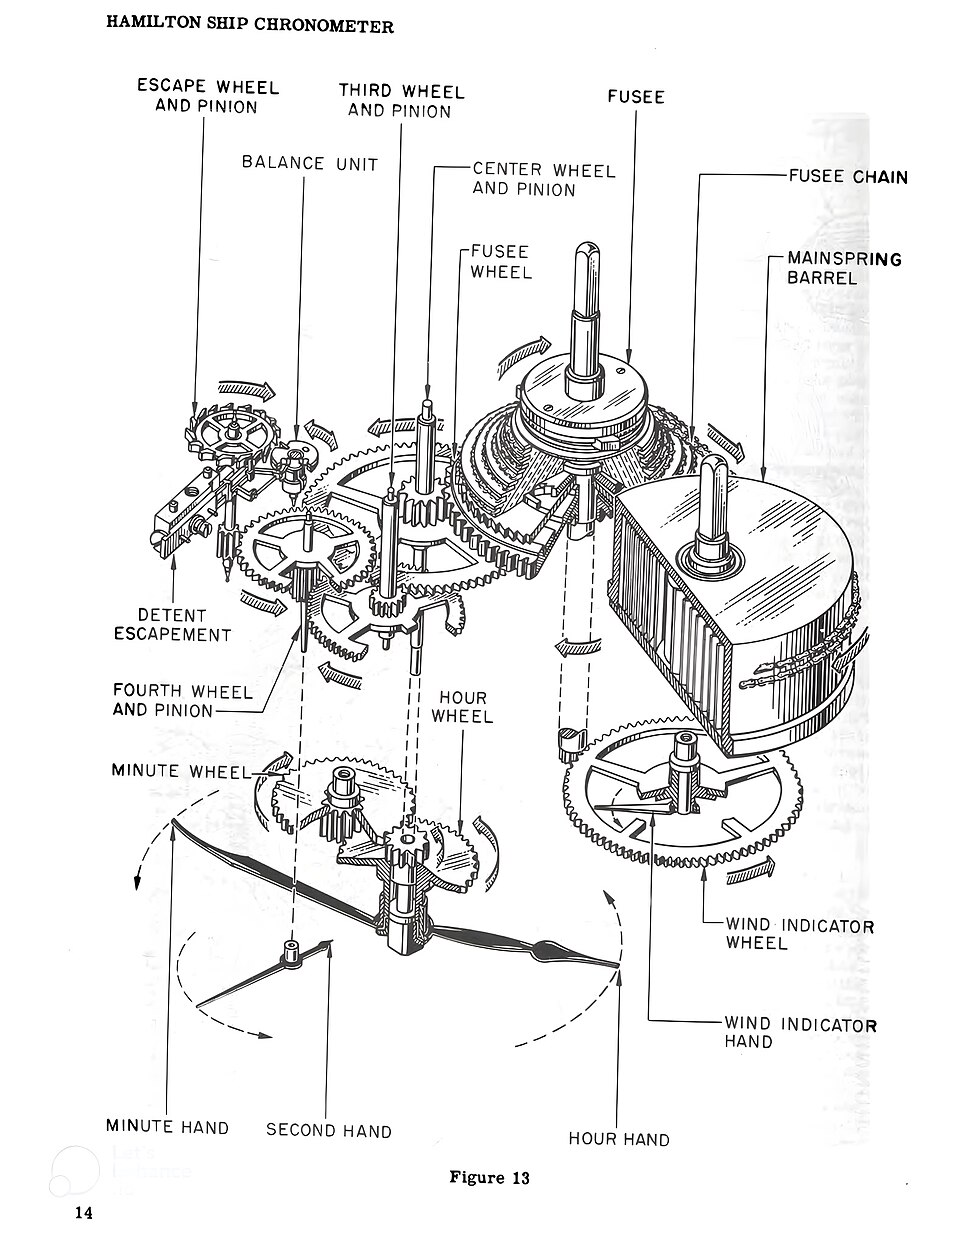
References/manual-fig13-train-exploded.jpg
