OrelMag/marine-chronometer-model/References/wempe/documents/6MX-user-instruction_2.jpg

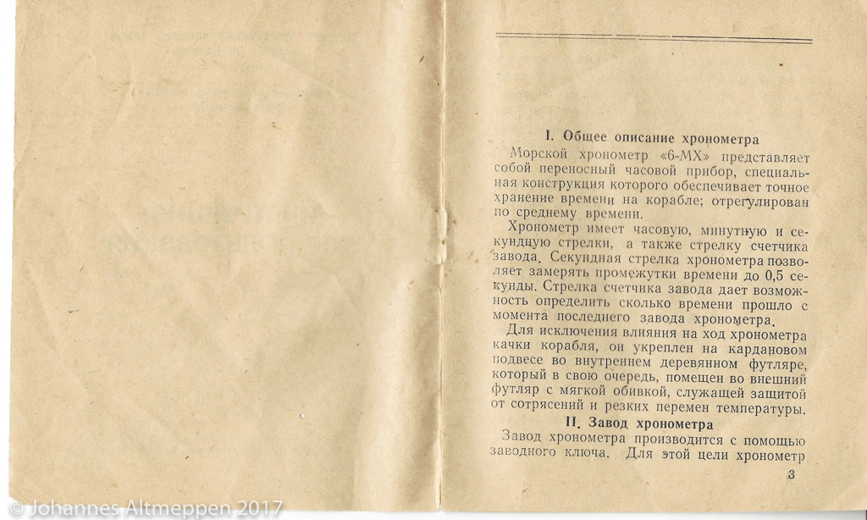
References/wempe/documents/6MX-user-instruction_2.jpg
