OrelMag/marine-chronometer-model/References/wempe/documents/6MX-user-instruction_4.jpg

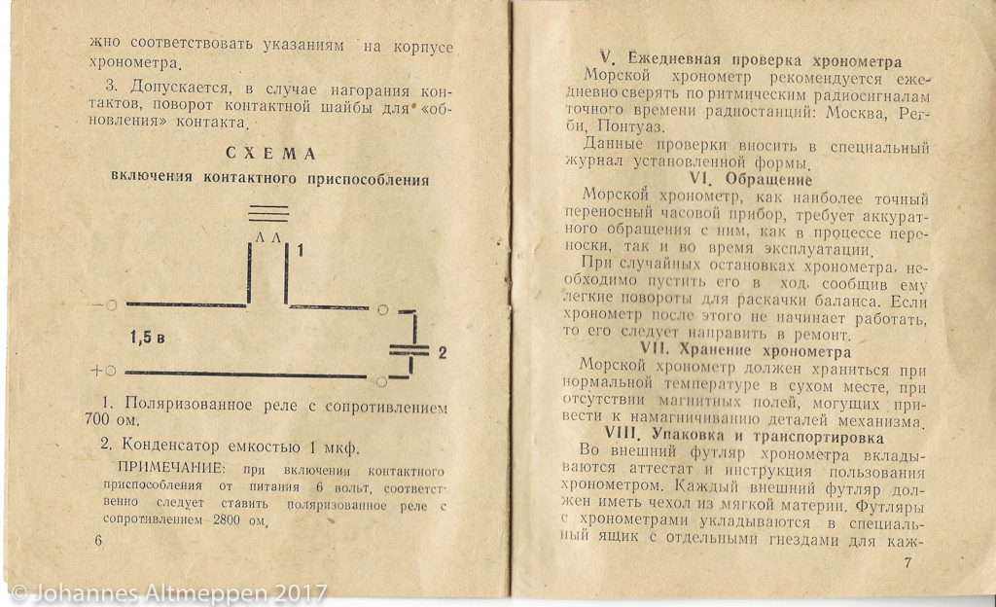
References/wempe/documents/6MX-user-instruction_4.jpg
