OrelMag/marine-chronometer-model/site/hamilton/parts/renders/setupPawlSpring.webp

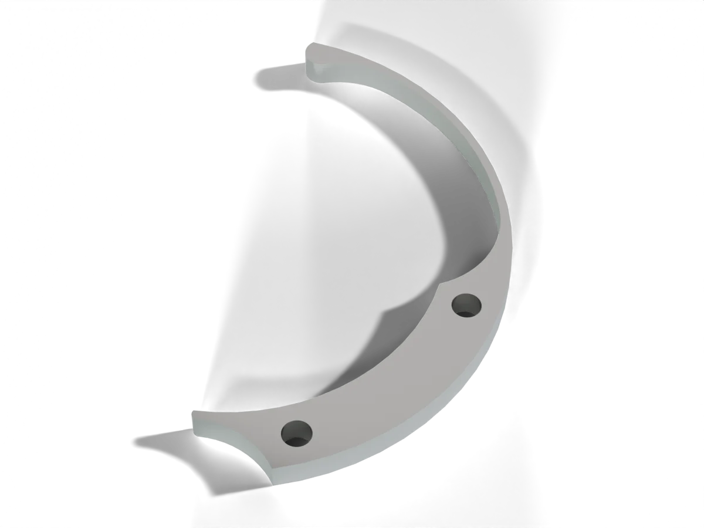
site/hamilton/parts/renders/setupPawlSpring.webp
