OrelMag/marine-chronometer-model/site/renders/assembled_sheet.webp

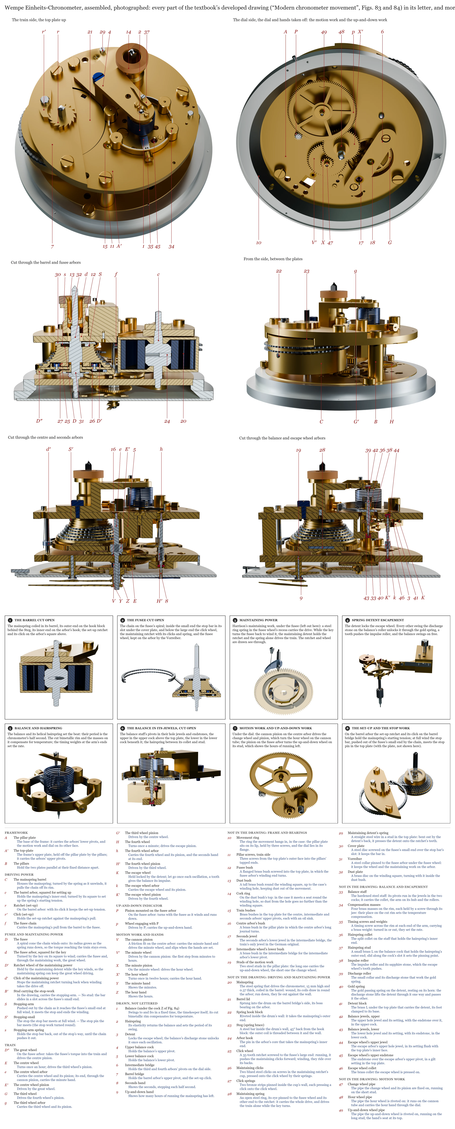
site/renders/assembled_sheet.webp
