OrelMag/marine-chronometer-model/Review-results.md

# Review results: the working model

A review of *The Marine Chronometer, working*
(`marine-chronometer-source/chronometer-working-model/`) at commit `f591611`,
29 September 2026. Line numbers in the findings refer to that commit.

Ideas already listed in `IDEAS.md` are left out: the model starting itself,
setting the hands at will, local time instead of GMT, performance, the three
copies of the escapement solver, and the escapement check's exit code.

Status: findings 1–5 were fixed after the review; see
[Fixes for findings 1–5](#fixes-for-findings-15). Checking the fixes turned up
finding 9 (the split-balance variant runs through the barrel bridge), fixed
on 2 October 2026, as were the Hamilton dial's short hands. Finding 6 is
fixed too (2 October 2026; its heading's note); finding 7 was resolved by the fine interference pass, finding 8 by the
case rebuilt round the movement.

A later pass with a finer collision check found and fixed six more overlaps,
and added a check for the barrel wall; see
[Fine interference pass](#fine-interference-pass).

A review of the barrel and fusee against the manual found the maintaining
work's state handling wrong, the train bridge covering the fusee, and 13 parts
missing; all are fixed. See
[Barrel and fusee against the manual](#barrel-and-fusee-against-the-manual).

A third review took every part in the manual's parts lists (Figs. 106–110)
and the manual's account of how it works: screws had no shanks and parts no
holes for them, pivots ended in bare holes, more than 30 listed parts were missing,
and the model started itself where the manual has it twisted into motion. All
are fixed; a few parts are drawn differently from the figures and a few small
ones are not drawn, as listed. See
[Every part against the manual](#every-part-against-the-manual).

A fifth review set the fusee assembly against the manual's exploded drawing
(Fig. 28) and the restoration video: every part is there and works, but six
differ in shape, and a wind at high speed outlasted the sustaining spring
(fixed). See [The fusee assembly against Fig. 28 and the video](#the-fusee-assembly-against-fig-28-and-the-video).

A fourth review checked the fusee and chain against the manual and the
photographs: the fusee was too thin at its small end, its groove turned in
rings, the chain's links lay flat, and the stop-bar moved with the wind count
instead of being pushed by the chain. All are fixed. See
[Fusee and chain against the manual and photographs](#fusee-and-chain-against-the-manual-and-photographs).

## Summary

No part of the model is broken. The mechanics hold up: ratios, directions of
rotation, the escapement figures and the maintaining work are consistent, and the
committed builds match their sources. The review found:

- three confirmed bugs: two in the controls (dial style, plate finish) and one
  small collision (escape-bridge screw heads in the balance's path);
- one inconsistency in how the model runs down and winds (56 h against 60 h);
- smaller accuracy and tooling issues;
- found while checking the fixes: the split-balance variant's weights run
  through the barrel bridge and the escape upper bridge (finding 9).

## What was checked

### Escapement

`node tools/escapement.js`: all nine figures are within the manual's limits.

```
  ok  centre distance                                  9.40 mm
  ok  roller shake (Op. 84)                           0.055 mm   about 0.002 in (0.051 mm)
  ok  teeth dip into the roller's crescent (Op. 76)    0.34 mm   > 0
  ok  lock (Op. 85)                                       6.0°   about 6°
  ok  let-off (Op. 86)                                   10.6°   at least 6°
  ok  overall (Op. 87)                                   28.4°   26-30°
  ok  drop (Op. 97)                                       2.1°   about 2°
  ok  horn clearance to the unlocking jewel (Op. 88)   0.25 mm   about 0.010 in (0.25 mm)
  ok  angle between the jewels                           88.3°   about 90° (Fig. 90)

  balance angle: jewel meets trip spring -27.3°, wheel released -21.3°, detent falls back -10.7°;
  impulse ends 20.8°; on the return swing the trip spring falls off at -39.1°. Lift at release 0.20 mm.
```

### Collision check

`python tools/dyn.py`, once as committed (weights at mid-travel) and once each
with `R.timing(3,3)` and `R.timing(-3,-3)` applied after loading, as the README
asks after any change to the balance. All three runs gave the same output:

```
ph 0.0:    1.7 mm3 hands:ExtrudeGeometry              x hands:CylinderGeometry             @ 0.0,6.2,0.0
ph 0.0:    1.5 mm3 bal:CylinderGeometry               x bal:CylinderGeometry               @ 8.0,-26.3,6.8
ph 0.0:    0.8 mm3 escBridge:ExtrudeGeometry          x escW:CylinderGeometry              @ 7.2,-24.0,16.1
ph 0.0:    0.8 mm3 bal:CylinderGeometry               x bal:BoxGeometry                    @ 8.0,-26.3,6.8
ph 0.0:    0.5 mm3 spawl:CylinderGeometry             x spawl:ExtrudeGeometry              @ 22.1,-9.4,-1.6
ph 0.0:    0.4 mm3 hands:ExtrudeGeometry              x hands:CylinderGeometry             @ 0.0,4.5,23.9
ph 0.0:    0.4 mm3 hands:ExtrudeGeometry              x hands:CylinderGeometry             @ 0.0,4.5,-23.9
```

Every pair is inside one part (hand collets, the balance hub, the sustaining
pawl's arbor in its pivot hole) or is the escape wheel's upper pivot in its
bridge. These are intended joints.

### Geometry audit

`python tools/audit.py` (movement):

- `dupScrews` 0, `floatScrews` 0, `isolated` 0.
- `looseEnds` 6: the winding-stop pin and five balance-screw and weight-screw
  ends. These are the expected leftovers.
- `zfight` 45: faces in contact, as documented.

`python tools/audit.py box`: `dupScrews`, `floatScrews`, `looseEnds` and
`isolated` 0; `zfight` 8 (the lids resting on the box, the ring on the bowl's
brackets, the latch's parts).

### Builds

- `dist/chronometer-working-model.html`, the root copy and `site/index.html`
  (built without `--site-url`) are identical to a fresh inline of the sources.
  The essay is too.
- The essay's copy of the escapement solver (F7 in `src/p4.js`) runs the same
  code as `ESC` in `movement.js`. The only differences are the intended ones:
  `EX` written out as 9.3997 mm, and a different set of returned fields.
  *Superseded: the essay is now the model's Essay tab and uses the model's own
  `ESC`.*

### Gear meshes

Centre distances from `L`, against the sum of the pitch radii
(module × teeth ÷ 2):

| Mesh | Centre distance | Pitch sum | Error |
|---|---|---|---|
| Fusee wheel 96 / centre pinion 14 | 22.943 | 22.941 | +0.002 mm |
| Centre 80 / third pinion 10 | 13.049 | 13.050 | −0.001 mm |
| Third 75 / fourth pinion 10 | 12.752 | 12.750 | +0.002 mm |
| **Fourth 60 / escape pinion 8** | **10.585** | **10.540** | **+0.045 mm (0.14 module)** |
| Cannon 12 / minute wheel 36 | 9.600 | 9.600 | 0.000 mm |
| Minute pinion 10 / hour wheel 40 | 9.600 | 9.600 | 0.000 mm |
| Fusee pinion 8 / wind-indicator wheel 98 | 12.294 | 12.291 | +0.003 mm |

The escape wheel is 9.3997 mm from the balance, as the README says.

### Mechanics, by hand

- **Train.** 80/10 × 75/10 × 60/8 = 450 escape-wheel turns an hour. With 16
  teeth that is 7,200 teeth an hour, one each half second. The fusee wheel's
  96/14 gives one fusee turn per 6.86 h, and its 8¾ turns hold 60 h of chain.
- **Hands.** The minute hand turns with the centre wheel. The hour hand turns at
  a twelfth of that, through 12/36 and 10/40. The seconds hand is on the fourth
  wheel, one turn a minute. All three turn clockwise seen from the dial.
- **Directions.** Every mesh alternates direction. The fusee and barrel turn the
  same way, as the uncrossed chain requires. When fully wound, the chain leaves
  the fusee at its small end; when run down, at its large end.
- **Wind indicator.** 14/96 × 8/98 gives 4.286° an hour, which is the dial's
  240° over 56 h. The hand starts at UP (60°) and turns clockwise to DOWN (300°).
- **Maintaining work.**
  - The fusee's winding ratchet drives the winding pawls in the running
    direction and slips under them when winding.
  - The sustaining ratchet's steep faces meet the sustaining pawl against the
    sustaining spring.
  - The setup click holds the barrel arbor against the mainspring's pull.
- **Winding stop.** The stop-bar approaches the stop pin from its free side and
  meets it at full wind.
- **Escapement.** At contact, the escape tooth and the impulse jewel move the
  same way. The walkthrough's 2-D diagram draws the impulse roller's crescent
  exactly as the 3-D part.
- **Balance.** 2 Hz (14,400 beats an hour). An amplitude of 255° gives 1.42 turns
  of motion; the manual says 1⅜–1½. The screws are in diametric pairs, and the
  moment-of-inertia formulae are correct.
- **Gimbals.** The box turns Rz(roll)·Rx(pitch), the ring turns Rx(−pitch)
  relative to the box, and the bowl turns Rz(−roll) relative to the ring. The
  product is the identity, so the bowl stays level.
- **Barrel.** Its wall is never collision-tested (see finding 7), so its
  clearances were checked by hand. The tightest is 0.15 mm, between its cap
  screws and the third wheel. It clears the train bridge's cutout by 1.7 mm,
  and the centre arbor and the third wheel's arbor by about 4 mm.

### Views

Screenshots of all six views (Box, Dial, Exploded, Movement, Train,
Escapement) render correctly, and the hands read the right time.

## Findings, most serious first

### 1. The dial style reverts when parts are see-through, singled out or faded

`mv.userData.dial(kind)` ([movement.js:240-241](marine-chronometer-source/chronometer-working-model/js/movement.js#L240-L241))
writes the new face texture onto `dface.material`. That is whatever material
`look()` in `app.js` has currently assigned to the dial face: often a
see-through (ghost) or faded copy, not the dial's own material
(`userData.mat0`). When `look()` next puts the dial's own material back, the
old face returns.

- Reproduced in headless Chromium: tick See-through plates, choose the Roman
  dial, untick. The Hamilton face comes back under Roman hands.
- The same happens when a part is singled out, which makes the dial
  see-through, or when the dial has been faded.
- Suggested fix: set the texture on the dial's own material, and have
  `fadeOf` and `ghostOf` copy `map` and `color` from their source each time
  they are used.

### 2. The plate finish doesn't reach faded parts

`M.setPlateFinish` ([core.js:76](marine-chronometer-source/chronometer-working-model/js/core.js#L76))
updates `M.plate`, `M.plateSolid` and their see-through copies, but not the
faded copies that `fadeOf` makes
([app.js:137](marine-chronometer-source/chronometer-working-model/js/app.js#L137)).

- Reproduced: fade the barrel bridge to 50% (right-click), then choose Gilt.
  The bridge stays nickel (#d5dad1, against #be812c for gilt).
- The fix for finding 1 covers this too.

### 3. The escape upper bridge's screw heads reach 0.06 mm into the balance's path

The bridge's two screws
([movement.js:212](marine-chronometer-source/chronometer-working-model/js/movement.js#L212))
sit on its top face at y −24.66 with 0.5 mm heads, so the heads reach −25.16.
The balance rim and the timing weights reach −25.10.

Measured in the page:

| Screw | Distance from the balance staff | Head covers | Passes under |
|---|---|---|---|
| First | 13.7 mm | 12.8–14.6 mm | the rim (13.1–14.5 mm), on every swing |
| Second | 16.0 mm | 15.1–16.9 mm | the timing weights' path (15.05–16.75 mm) |

- `dyn.py` can't see this: it works in 0.4 mm cubes and ignores overlaps under
  0.3 mm³.
- The README's "rim 0.4 mm clear of the escape upper bridge" is true of the
  bridge, not its screws.
- Suggested fix: make the heads 0.35 mm tall or less, or raise `BAL_Y` by
  0.1 mm (the rim's height is fitted, not measured).

### 4. The model stops at 56 h, but its chain holds 60 h

- The run test is `run=hrs<56`
  ([app.js:449](marine-chronometer-source/chronometer-working-model/js/app.js#L449)),
  and the Since winding slider stops at 56
  ([index.html:69](marine-chronometer-source/chronometer-working-model/index.html#L69)).
- Winding with the key "From run down" starts at 60 h
  ([app.js:306](marine-chronometer-source/chronometer-working-model/js/app.js#L306)).
  That is the fusee's 8¾ turns, and matches the manual's 17½ half turns to wind
  a run-down chronometer.

Consequences:

- After the model runs down by itself, 0.58 of a fusee turn of chain is still
  on the fusee.
- Pressing Wind with the key then jumps the fusee, chain, barrel and wind
  indicator back 4 h at once, before the first half turn.
- For the first ~1.2 half turns the clock is frozen (`hrs` ≥ 56). Meanwhile the
  readout says both "Run down. Wind it to restart." and "Winding, maintaining
  power driving the train", and the key panel says the sustaining spring drives
  the train.
- With From run down unticked, winding a model that ran down by itself takes
  16⅓ half turns, not the 17½ that the Wind button's tooltip gives.

Suggested fix: run down at `FUSEE_TURNS/FUSEE_PER_HOUR` (60 h), and keep 56 h
as the dial's rated run.

### 5. The fourth wheel and escape pinion are 0.045 mm too far apart

This is 0.14 of a tooth module, a shallow mesh. Every other mesh is within
0.003 mm (see [Gear meshes](#gear-meshes)). The escape wheel's position is
fixed by its 9.40 mm distance from the balance. The simplest fix is therefore
the fourth stage's module: `MOD.fourth=0.3113` gives (60 + 8) × 0.3113 ÷ 2 =
10.584 mm. Then rerun `dyn.py`.

### 6. `solve.py` no longer reproduces the layout

*Fixed (2 October 2026, `claude/fidelity-plan`): it reads `L` and `TRAIN` from
`movement.js`, takes the measured arbors as they stand, solves the escape arbor
(0.001 mm from `L.E`) and gives `MOD`'s modules; RESOLVED.md, Build, tools and
docs.*

- Its measured inputs predate the two-photo fit: fusee (12.0, −17.8), barrel
  (−20.1, 4.9), balance (7.9, 8.6), and an 18 mm balance radius.
- Its best answers (modules 0.32/0.32/0.33, third wheel at (−7.29, 12.42))
  match neither `MOD` (0.29/0.30/0.31) nor `L.T` (−4.86, 12.11).
- `L.T` is exactly the two-circle solution for modules 0.29/0.30 with the
  current centre and fourth wheels: (−4.858, 12.112).
- CLAUDE.md and the README say to rerun it after changing a tooth count.
  Today that would give wrong positions.

### 7. The collision claim is broader than the check

The About dialog
([index.html:149](marine-chronometer-source/chronometer-working-model/index.html#L149))
says "Every part was tested for collisions through a full escapement cycle".
But:

- `interference-check.js` skips double-sided, transparent, tube and instanced
  meshes, and meshes marked `noCap` or `noShadow`. The barrel wall, mainspring,
  chain, hairspring, trip spring and dial face are therefore never tested.
- It skips hidden meshes, so the split-balance variant is never tested (see
  [finding 9](#9-the-split-balance-variant-runs-through-the-barrel-bridge)).
- It can't resolve overlaps as thin as finding 3's.

The barrel was checked by hand and is clear (see
[Mechanics, by hand](#mechanics-by-hand)). Suggested fix: narrow the wording,
or add analytic clearance checks for thin gaps and for the hidden variant.

**Status (fine interference pass):** mostly addressed by `tools/fine.py`,
which resolves 0.05 mm and tests the chain, the hairspring, the trip spring,
the barrel wall (as a solid, with its margins) and the mainspring, and with
`--split` the hidden split-balance variant (it fails there: finding 9 is still
open). Still untested then: the dial face (*now checked*, 2 October 2026: `fine.py`
measures the least height of any part over it). The About dialog now says what the
checks cover, names the dial face as untested and the split-balance variant as
not yet clear, so the finding is resolved. See
[Fine interference pass](#fine-interference-pass).

### 8. The dial looks small in its case (worth checking, not confirmed wrong)

*Fixed (RESOLVED.md, Setup, case and gimbals): the case was 13 mm too wide all
round and held nothing. It is now built from the movement it holds: the mounting
ring's flange in a recess round its top on a shoulder, the dial (95 mm, the side
photograph) inside it, the bezel screwed on round the rim.*

- The dial is 50.8 mm in radius, the estimated 4 in.
- The bezel's inner edge is at about 60.9 mm (the torus at 63.5 mm less its
  2.6 mm tube), and the glass is 62 mm.
- That leaves a 10 mm ring through which the default Dial view shows the inside
  of the case, and the movement's striped plate below 4–5 o'clock.
- The top-view photograph shows the case fitting close around the movement. The
  dial's size is worth comparing with the manual's Fig. 1 or Fig. 107.

### 9. The split-balance variant runs through the barrel bridge

*Fixed (2 October 2026; RESOLVED.md, Escapement): the weights within the band's
height (r 1.1) and out to 16.8 mm, the arm and hub bored for the staff;
`fine.py --split` passes.*

Found while checking the fixes; the geometry is unchanged since `f591611`.
Variants → Balance → Split bimetallic rim shows `R.balS`
([movement.js:340-345](marine-chronometer-source/chronometer-working-model/js/movement.js#L340-L345)).
Its two compensation weights are `cylY(2.3, 4.2)` set radially at `BR + 1.9`:

| | Weights | Barrel bridge | Escape upper bridge |
|---|---|---|---|
| Distance from the balance staff | 14.3–18.5 mm | cut round the balance at 17.7 mm | 5.9–18.9 mm |
| Height (y) | −28.6 to −24.0 | −27.16 to −23.76 | −24.66 to −23.76 |

So the weights stand 1.1 mm proud of the rim on each side, and reach 0.8 mm
into the barrel bridge's cutout.

`dyn.py` with the split balance shown, and 40 extra balance phases (every
0.025 of an oscillation) added to its own:

- **Barrel bridge:** about 10 mm³ of overlap at almost every phase.
- **Escape upper bridge:** up to 7.8 mm³ (phases 0, 0.025 and 0.2).
- **Dust seal** (`post`): up to 0.8 mm³.
- **A balance-lower-bridge screw:** 0.4 mm³ (phase 0.05).

`dyn.py` as committed never sees this, because the variant is hidden when the
page loads and the check skips hidden meshes.

Suggested fix: smaller weights (a radius of about 1.1 mm keeps them within
the rim's 2.4 mm height), set no further out than the timing weights (17.35 mm).
Then run `dyn.py` with the variant shown.

### 10. The mechanisms' analyses: what they found open (13 October 2026)

Found by the analyses of the build-verification report's section 11 (`tools/ratchets.js`, `sustaining.js`, `traindyn.js`); none stops the model working, each is
a reading or an estimate to settle:

- **The sustaining pawl's end, as traced** (KLUwI2UUCMQ 36:15, to about 0.1 mm), leans off its tooth's face: a tooth's tip corner meets the pawl's side first, and
  so loaded it would be pushed out. *Done (14 October 2026, RESOLVED.md):* drawn fitted, cut along the face with 4° of relief; it bears on the face 0.38 mm in and
  is drawn in at 36°.
- **The setup click** bears on its face near the root, drawn in at 4.5°, under the friction angle: friction and its spring hold it. *Done (14 October 2026,
  RESOLVED.md):* the ratchet's faces drawn undercut 4.5° as measured, the click drawn in at 8.7°, past the friction angle; and the ratchet on the arbor's square.
- **The sustaining spring's section**: the drawn band would close solid under the drive. *Done (14 October 2026, RESOLVED.md; OPEN-QUESTIONS.md, "Closed by
  design"):* a split ring weaker than the drive, banked in running, as the period's chronometers had it; its gap measured, its band designed for its push.
- **The train's inertia at the escape wheel** off the solids is 6.05 g·mm², 2.9 % over dynamics.js's 5.88 (the fourth wheel's 1.08 was an estimate; the escape
  arbor's pinion and arbor 0.42 were left out). *Done (14 October 2026):* makeEsc's JW 6.05 and dynamics.js sum the arbors' solids (mechanisms.json); the
  calibrated torque 62.8 µN·m, the budget still closes at TF 67 s; tolerances, gearing, tripping and bench re-written.

### 11. The rate from one turn to one and a half, and the hairspring's two terminals (Bennett, 18 October 2026)

Found reading William O. Bennett's "The Hamilton Marine Chronometer" (*NAWCC Bulletin* 356, 2005; References/NAWCC-ARTICLES.md), the
designer's own account. Neither stops the model working; both are where the model's design values meet a source that outranks them.

- **Rate against swing.** Bennett: placing the impulse rightly made "the same rate from one turn motion to one-and-a-half turns motion,
  within a fraction of a second per day", swings of 180° to 270°. The model's escapement (`ESC.rateAt` with the drive that gives each swing,
  18 October 2026): −1.83 s a day at 180°, −1.15 at 200°, −0.64 at 220°, −0.25 at 240°, 0.00 at 255°, +0.21 at 270°: 2.0 s a day over his
  range (0.35 over the manual's 1⅜-1½ turns, which the model's checks hold it to). The impulse's place on the roller and the hairspring's
  isochronism term (`HS`) set that curve; neither is measured. To do: find what places the impulse so the rate is flat to a fraction of a
  second from 180° to 270°, whether the manual's figures (Ops. 84-88, 97) still hold there, and what it does to the swing, `escgolden.js`
  and the checks downstream (the model README's "Estimated").
- **The terminals.** Bennett: "two identical terminals", designed with Hamilton's own theory (the spring under a pure torque tangent to its
  ends), not Phillips'. The model's are solved to Phillips' conditions (`hairspring.js`) and differ: the outer 14.6 mm into the stud's clamp,
  the inner 21.8 mm to the collet's end. No source shows their paths (the model README: "the curve's path is a design"), so this source
  should decide what form they take. To do: whether identical curves can meet the stud's clamp and the collet's end as measured (4.34 and
  3.2 mm from the staff), and leave the force on the pivots as small as `HSPR.lateral` finds the present pair's.

## The hairspring's inner end (settled as an estimate, 4 October 2026)

`tools/hairspring.js` designs the spring's terminal curves to Phillips' conditions from the model's coil and ends. The outer one, into the stud's clamp
along the bar toward its end, is 15.3 mm and turns 343°, as the video's face-on view from the stud's end shows it (6:52.5, about half a turn turned in).
The inner one can't be like it at the collet's face as drawn (3.62 from the staff, the wire running along the face): the shortest that meets the
conditions and keeps off the collet winds 1.9 turns in (54 mm). Held at 3.0–3.3, a curve of 21–24 mm does it. Measure where the spring's lower end meets
the collet: a frame of the balance from the collet's side (sheet round 6:44–6:53.5 and round the hairspring's removal, Op. 4), the end's radius against
the coil's. Then design the inner curve there, and draw the spring as the strip it is (0.23 by 0.226 mm, PLAN-self-contained.md, A2). With the ends as
`springGeo` draws them the spring leaves 2.3 % of couple / R on the pivots; designed, 0.003 %.

*Measured (4 October 2026), not settled.* KLUwI2UUCMQ 6:53.25 and 6:53.5, the balance held with the arm toward the camera: the collet's
block and its brass wedge pin by the hub's cap, the coil's two ends as circles (Hough fits, 4K: the near end, the collet's, 229-235 px, the far 185).
The pin's centre against the near end's 5.26 mm outer edge: 2.8 and 3.5 mm from the staff's end, 3.1 and 3.9 from the circles' centres (the view a
little oblique, the frames blurred): 2.8-3.9, about 3.3. That spans both the model's 3.62 (Fig. 6's collet scaled to the coil) and the window where a
short curve meets Phillips' conditions, which is sharp: the shortest inner curve is 49 mm at r 2.8, 21-26 mm (300-370°, like the outer) from 2.9 to
3.3, and 53 mm from 3.4 to 3.62. A sharper frame of the collet's end, or the collet's own size (a Model 21 collet measured), would decide it.

*Drawn (4 October 2026): the end at 3.2, inside both the frames' 2.8-3.9 and the window, the collet scaled from it (`CKC`, 0.83 of Fig. 6 against the
coil's 0.93); both terminal curves meet the conditions (14.8 and 21.8 mm), the pivots carry 2.5e-5 of couple / R. A sharper frame or a measured collet
would still settle it.*

## The Wempe's discharge stone, and a swing solve that gave up (11 November 2026)

Found while reading sheet 05 04_1 again for its unexplained figures. **Decided and done, 11 November 2026** (the owner's choices; branch `claude/wempe-reread`): the swing solve is fixed (`723443e4`), and the discharge stone stands at the sheet's place (`DSB` 14.2). The drawn versions keep 05 06_20's drive and TF 111 s, so their swing, 155-166° over the wind, is the model's finding; the tools' guard floor is 147° (14° under the reference's swing, as before); the two checks that assumed the balance could reach 225° on the measured drive are reported open items. The two builds' floor is 150°, and their hairspring is set against the escapement at the bench. What follows is the finding as it was written before the change; its table's first row is the model until that day. The figures are `tools/wempe_discharge.js`'s (about 15 minutes; it changes no file).

**Two things seen since.** With the stone at the sheet's place the release and the return swing's pass of the gold spring stand 11.3° and 11.1° either side of rest (2.1° and 20.3° before): the escapement as drawn is in beat about the drawn position, which bears out both the reading and the model's taking the drawn position as rest. And the drawn stone's own evidence turns on one line: if the dashed line from the hub to the gold spring's tip is the stone's leading face, the stone's centreline lies about 7° behind it and `DSB` is about 12-14; if that line is its centreline, about 5.6, the old place. Everything stone-like on the sheet lies behind that line, so the first is likelier (moderately sure).

**1. The swing solve gave up where the escapement runs (a fault, sure; fixed).** `makeEsc`'s `solveA` (`shared/escapement.js`) starts its search at the least swing that passes the gold spring on the return. If the work there is finite and under the loss, it returns 0, "doesn't run". That is the case whenever the release comes after rest and after that swing: no tooth has been let go yet, so nothing is gained. A few degrees higher the work is over the loss, and the search never looks.
- With the search carried on, the Wempe as built changes at two drives only, 0.25 and 0.275 of the reference (0° to 58° and 67°); every other drive agrees to 1e-9°. The Hamilton releases before rest and is untouched.
- The discharge stone's place was chosen on this fault. The comment beside `DSB` in `wempe/js/escapement.js` and the README say that from 8° later "it doesn't run". It does: 171°, 168° and 162° at 12 h with the stone 11°, 12° and 13.9° later.
- `dynamics.js --model wempe`, which integrates in time, agrees: 161.4° against 161.6° with the stone 13.9° later, 300 beats, no tooth lost.

**2. The discharge stone stood about 9° too early against the sheet (likely; moved).** The model lets the tooth go 2.1° after rest, 4.2° *before* the impulse stone is in the teeth's path, so the tooth runs free to it. That place was an estimate ("the scan can't give it").
- *05 04_1's "5°"* is on the balance's arc beside the 6° and the 22°10' (r 7.0 mm from the balance; the arrows read 82.0°, 75.7° and 70.8° about it, the line of centres 53.5°). It runs from where the impulse stone's corner enters the teeth's path, 22°10' before the line of centres, on toward the line. That is the period rule: the impulse stone 5° inside the wheel when the tooth is let go (*Watch and Clock Escapements*, 1904, Fig. 141, which `keystone.js` already quotes and reports the Wempe as "the other way"). Likely.
- *The drawn discharge stone* (about 10 px, so only moderately sure): its flat face lies on the gold spring's tip, its body behind it, on the side it comes from. The sheet draws the start of the unlocking, not its end, which the model assumed until 16 October.
- *The Navy's 1958 repair book, p. 60*, for the MX (read on the scan): «конец золотой пружины при равновесии не доходил до спускового камня на 0,10-0,15 мм». With the balance at rest the gold spring's end is 0.10-0.15 mm from the discharge stone, 3.6-5.4° at the stone's end. The text is sure. It doesn't say on which side. The README set it against the spring's reach past the horn, which is another measure.
- *What it does to the swing* (12 h from full wind; over the wind in the tool's table):

| The discharge stone | Released | Impulse stone inside the path | Swing, drawn drive | Swing, 1950s build's drive |
|---|---|---|---|---|
| as built (estimated) | +2.1° | 4.2° short | 196° | 223° |
| the sheet's 5° | +11.4° | 5.0° | 161° | 189° |
| 1958 book, the stone coming, 0.10-0.15 mm | +16.5° to +18.3° | 10-12° | 138-144° | 165-171° |

With the damping at the 6MX video's own fit (TF 141 s, not the model's 111 s) the sheet's row reads 177° and 208°. A running 6MX on video swings 110-185° part wound (References/wempe/VIDEOS.md); the model's 196° was above it.
- The 1958 book's other side (the stone already past the spring at rest) would let the tooth go 11-13° before the impulse stone comes in. On a real escapement that tooth gets no impulse, so that reading doesn't fit this layout.

**What is not settled.** Whether the sheet's drawn position is the balance's rest (the model takes it so; the sheet doesn't say). With the stone at the sheet's place the escapement's own rate change is +2.1 s a day for each 10° of swing, which fails `dynamics.js`'s "small" check: the impulse then comes late after rest, a hint that rest lies nearer the line of centres than drawn. The lock's arc (12.9° of the balance) rests on the discharge stone's estimated reach.

**What moving it touched.** Every Wempe physics figure: the swing and rate tables, the banking table, tolerances, bench, Monte Carlo and navigation, the two builds, the essay's data and the report (the Wempe README's sections give each as it now stands).

**What the owner decided for what followed (11 November 2026), and each limit as it was and is.**

- The drawn versions keep 05 06_20's drive and TF 111 s; their swing, 155.1-165.8° over the wind (160.7° at 12 h), is the model's finding. The guard band's floor: 180° to **147°** (14° under the reference's swing, as before), in `wempe_escapement.js`, `wempe_6mx.js`, `wempe_1943.js`, `gearing.js --model wempe`, `wempe_tolerances.js`, the page's swing panel; the builds' 180° to **150°** (`wempe_build.js`, `wempe_tolerances.js` and `gearing.js` under `MC_WREV=build*`).
- Two checks that the balance can reach 225° on the measured drive were hard and are reported (`~~`): `wempe_escapement.js`'s "the band is inside the damping's range" (213° at the parts' longest run-down, 234 s; 225° wants 276 s) and `wempe_physics.js`'s "the budget closes" (the band wants Q 1,497 at least, the parts give 1,468 at most).
- The rate against the swing. The drawn versions keep the drawn hairspring's own isochronism, `WESC.SET.HS` −0.476 (at 196°) to **−0.154** (at 160.7°, `wempe_hairspring.js`), and report the escapement's +2.15 s a day for each 10°. `dynamics.js --model wempe`'s check "under 0.5 s a day for each 10° of swing (the escapement with its hairspring)" became "**the rate's change over the wind's range of swing under the 6MX TU's 2.3 s between days**": it reads +2.14 s (the 6MX's bodies +2.19). The Hamilton's check is as it was.
- The two builds get the hairspring set against their escapement (`BUILD40` HS −1.12, `BUILD` −0.78 s a day for each 10°), a bench adjustment in `wempe_bench.js` (the test "The hairspring set against the escapement") and on the hairspring's maker's sheet; the builds are judged on the lock's window, tripping, strength and the error at sea.
- Added: `wempe_escapement.js` checks the release 5° ±0.15° after the impulse stone's corner enters the path; `fine.py --model wempe`'s phases (`checks.py`'s `PH`) laid on the new events (61 phases).

**Found on the way: the drawn detent's ring (decided 12 November 2026, below).** `tripping.js --model wempe`, run again, has a held tooth's stone ringing 53.9 % of the depth of lock as drawn (126.9 µm; 49.3 %, 116 µm, with the stone as it was; the 6MX's detent 53.1 %). The gold spring's bend on the return is the same (0.41 mm at its tip, 5.8 µJ); it now comes clear 11.1° before rest, not 20.3°, and at a smaller swing. The ring is under half only from 1.16 times the estimated preload (0.93 g; 0.78 g before), over the 0.80 g cap `wempe_tolerances.js` holds (the stone landing on the escaping tooth's back), and at 1.2 times a 3 ms blow lets a tooth go at 18.1 g (28.7 g before; 26.8 g at the estimate, where the frame's own check asks 20). No tooth gets past in any preloaded run, and `tripping.js` reports the ring (`~~`), as it did. But `wempe_tolerances.js` carries the frame's figures typed in (the ring 116 µm, the floors 0.78 g and 0.64 g), and with the new ones the drawn version has no window: the lock's floor, twice the ring, 0.254 mm, lies past the 0.2436 that unlocks (the tool can't work a lock there at all: tried, it stops), and the preload's floor past its cap. The drawn version's bench and Monte Carlo, which set the lock in that window, would then pass none. None of the owner's choices covers how the drawn version is to be judged there, so the figures were **left as transcribed on 19 October 2026** and the tool prints the rerun's beside them (`~~`); the Wempe README's Unresolved has it. The choices as they look from here: report the drawn version as having no window by the half-depth rule and judge its made copies on no tooth getting past; or look again at the one estimate the result turns on (the discharge stone's contact stiffness on the gold spring on the return, `kR`: 3.4 % of the depth at a quarter of it, teeth past at four times). The two builds (the gold spring thinned at its bend) are judged on their own frame runs in `wempe_build.js`.

**Borne out a little: the 6MX on video.** Refitted with the new escapement's work, the filmed 6MX's start-up gives TF 118 s (114-121; 105-129 over the stretches' scale; 141 s, 133-158, before) on 0.87 of the model's drive, keeping 149.3° (0.55 of it before): the model's 111 s is inside the scale's range again, and the filmed movement's steady 149° is no longer a swing the model could only reach half wound.

**Open after 3.87.00 (12 November 2026), for the owner's discussion.** Released that day: 3.86.00 (the discharge stone at 05 04_1's 5°), 3.86.01 (the 3D stress solved again), 3.87.00 (the Wempe's page on three.js r187, the present look: PLAN-three-upgrade.md, "Landed"). The work stopped there at the owner's word. What is open:

- *The stone 0.018 mm inside the gold spring's tip for about 0.5 ms after the release, and 0.013 mm at the listed first touch* (below, "The stone against the gold spring on the page, measured"; `tools/wempe_pass_shots.py` fails on it). Two like figures at two events suggest the solver's contact outline and the drawn solids differ by about 0.015 mm at the tip (roughly half a degree of balance angle); not traced. If so, mending it moves the escapement's figures a little and needs its own checks and release.
- *The movement ring's mesh under a section* (05 08 00-3): grey specks at its inner step in the Side view cut on the 12–6 plane, on r128 and r187 alike, about 500 pixels more on r187 at 1200 × 800; with the ring hidden they go, with the dial hidden they stay (`tools/section_who.py`). The same mesh is the one whose volume the two triangulators give 0.05 mm³ apart: its outline has a fault a triangulator has to guess at. To mend with the ring's outline (the one-geometry work).
- *The mainspring's hook block* (05 07 01-3): its surface 0.003 mm² less on r187 in 65.9, its volume the same (`tools/geomdiff.py`). Not looked into.
- *three.js after stage 1:* the essay and the Hamilton's page on r187, then r128 removed, then the new look a piece a release (jewels, blued steel, contact shading as an option; the glass kept). None authorised yet.
- *One geometry* (`claude/wempe-one-geometry`, 1ea57afa): the pilot's lean encoding, not landed: `main` to merge in (three releases since), 13 checks not run and 2 to run again.
- *The sheet check's entries* the owner chose (the escapement's coverage; hand entries for the hands and the case): not started. Its browser half and the MOVED/tier question: not decided.
- *The drawn detent's ring* turns on one estimated contact stiffness (`kR`; the Wempe README's Unresolved).

**Resumed and settled, 12 November 2026.** Both things the checkpoint below left waiting are closed.

- *The 1940s build did not fail: the tripping tool did.* `wempe_tripping.js` pressed a held tooth on the stone through the one integration step in which the stone's lift passed the point where the tooth is free (`lFr`): the flag that the tooth is held is cleared after the step, while the recoil term `rec(l)` has already dropped to 0, and the Wempe's tooth, which stands 0.0017 rad *forward* of its locked place as the stone lifts (its flat draws −3.7°), then read as 0.0017 rad into the stone. For up to 1 µs the contact's spring threw the wheel back, at up to 11 rad/s depending on where in the step the lift crossed. The wheel then needed up to 2.4 ms to come back to where it was let go, and the stone comes home 2.3 ms after the release: in about 1 beat of 100 the tooth met the returning stone, hung on it, and was struck from behind by the impulse stone (a lock at 82° of the balance with the stone lifted 84 %, or a tooth past). Counted on the 1940s build over its swing and the wind's drives: 5 wrong beats of 560 before the fix, 0 of 560 after, the stone's largest lift 23-25 % in every run. The Hamilton's `tripping.js` has the same line, but its tooth is drawn back, not forward, so the term is negative there and gives no force. Fixed (`63083f45`; RESOLVED.md, Escapement). The fault was in every Wempe frame run since the recoil was laid on the stone's flat; it also made the 3 ms blow at 1.2 times the preload read 18.1 g on 11 November (29.6 g).
- *With it fixed* `wempe_build.js` passes both builds on every line: the 1940s build's lock window is 0.112-0.280 mm at 20 °C (167 µm; its ring 56 µm, 23.9 %), pushed to 300° no tooth past, a 3 ms blow 27.1 g; the 1950s build's 0.101-0.281 mm (ring 51 µm, 21.6 %). Their tolerances, bench and Monte Carlo are regenerated (100.0 % work after the bench in each), and navigation: the 1940s build 1.55 miles in the median and 4.37 in 19 voyages of 20 (on the line), the 1950s build 1.53 and 4.30 (passes within sampling).
- *The drawn detent's ring is real in the frame and unchanged by the fix* (53.9 %, 126.9 µm). The owner's choice: the drawn versions are judged on **no tooth getting past**, the ring reported; the builds keep the half-depth rule. `tripping.js --model wempe` now runs the frame at shallower locks (its section 5): every tooth held down to 0.130 mm, one past at 0.120, the ring 127-133 µm whatever the depth. The drawn version's lock window is 0.130-0.237 mm (the drawn 0.235 inside), its preload 0.64-0.80 g. The frame's figures reach `wempe_tolerances.js` through `tools/tripping_wempe.json` (`tripping.js --model wempe --write`; a full run fails if the file is stale) and are no longer typed into it, which is how they went stale unseen. The drawn bench, Monte Carlo (100.0 % after the bench, 4.9 % as made), banking table and navigation (4.13 and 8.96 miles: fails, as before) are regenerated on them.
- *Still open:* the ring turns on the estimated stiffness of the discharge stone on the gold spring's tip on the return (`kR`); working that contact from its geometry would replace the estimate (the Wempe README's Unresolved).
- *The stone against the gold spring on the page, measured* (the owner's question on a before/after picture, 12 November 2026; `tools/wempe_pass_shots.py`). In the comparison pose (balance at rest, detent home, gold spring free: not a state the page runs through) the stone's corner is 0.066 mm inside the gold spring's tip, since the stone now meets the spring 1.7° before rest. As the page runs, over 222 phases of both passes: on the way out the stone bears on the tip, 0.0005-0.003 mm inside (contact); 0.013 mm at the phase the meeting is listed at (0.2484); on the way back, the spring bent, none. **Open, small:** for about 1 ms after the release (phases 0.2620-0.2630, the detent drawn holding its lift 0.0214-0.0216 before it falls back) the stone's corner is up to 0.018 mm inside the tip. Its cause is not looked into (the solids are posed from `ESC.state`'s `lift`; whether the state's lift or the tip's drawn shape is off there is not known). Under `fine.py`'s 0.05 mm grid, so no check sees it.
- *Also found by the checks, not from this change:* four 6MX case recipes (`lockBr6`, `lockLever6`, `screw80_3m`, `screw80_9m`) had not followed the 6MX case fixes of 8-9 November on main (the lever at the pivots' height, the ring Ø 133 × 3.7), so `recipes.py --model wempe --check` failed on main since then; the recipes now read the page's places.

**Checkpoint, 11 November 2026 (paused at the owner's word; branch `claude/wempe-reread`, not released).** Where the carrying-through stands, so it can be picked up from the branch alone.

- *Regenerated and passing on their own checks*: the drawn versions' tables (`wempe_6mx.json`, `wempe_1943.json`, `keystone_wempe.json`, `wempe_startup.json`, `js/bankdata.js`, `tolerances_wempe.json`, `bench_wempe.json`, `montecarlo_wempe.json`), the 1950s build's (`tolerances_wempe_build.json`, `bench_wempe_build.json`, `montecarlo_wempe_build.json`), `wempe_build.json`, `navigation_wempe.json`, `js/essaydata.js`, `js/makers.js`, `js/contactdata.js`, the discharge roller's STEP and sheet (`wempe/parts/`), the transmission viewer's trace, the Wempe report (`wempe/verification/`: data, geometry, page) and the build with the live address. `gearing_wempe.json`, `wempe_inertia*.json`, `mechanisms_wempe.json` and `gimbals_wempe*.json` came out unchanged.
- *Stopped, waiting on the owner*: (1) the 1940s build: `wempe_build.js` exits 1 on its lock's window (above, and the Wempe README); `tolerances_wempe_build40.json`, `bench_wempe_build40.json` and `montecarlo_wempe_build40.json` are as they stood before the stone's move, `wempe_tolerances.js` under `MC_WREV=build40` stops (no lock to work), and `navigation_wempe.json`'s build40 figures rest on the old Monte Carlo. (2) The drawn detent's ring: `wempe_tolerances.js` keeps the figures of 19 October 2026 and prints the rerun's beside them.
- *Not rerun*: the 3D stress results (`motion3d*.py`, `wempe/verification/assets/motion3d/`): the escape wheel now strikes the impulse stone at 53 rad/s where it struck at about 35, so the escapement parts' worst loads in the beat are stale; the let-go, stop and winding loads don't depend on the stone. `acoustic.py --model wempe` (`acoustic_wempe.json`). `wempe_letgo_fix.js`. `ci.py --views` for the Wempe.
- *The full check* (`python ci.py --full`, stopped at 153 of 159 steps): 133 passed or were cached. Failing as expected: `build` (it ran before the built copies were committed; they are committed since), `wempe-build`, `wempe-tolerances-build40`, `wempe-bench-build40`. `wempe-recipes-site` failed on the stale discharge roller files, regenerated since. Fourteen browser steps failed only on the page not loading within Playwright's 30 s on a saturated machine (`Page.goto: Timeout`), not on a finding: `wempe-dfm`, `wempe-bom`, `wempe-bom-first`, `wempe-bom-1943`, `wempe-fea`, `wempe-fusee-body`, `wempe-fine-6mx`, `wempe-solids`, `wempe-maintaining` (its stop work part, `wempe_stopwork.py`), `wempe-mechanisms`, `wempe-exploded`, `wempe-audit-1943`, `wempe-audit-3955`, `wempe-stopwork`, and `sitecheck`; `wempe-solids`, `wempe-exploded`, `wempe-mechanisms`, `wempe-audit-3955` and `wempe-audit-1943` had passed earlier the same day on the same geometry. Not reached: `blender`, `wempe-assembly` (it passed alone that evening, `geometry.py assembly`), `wempe-bom-3955`, `wempe-fine-3955`, `wempe-fine-band` and `wempe-recipes`. The Wempe report's geometry shows `dfm` as failed for the same timeout.
- *What remains, in order*: 1. the owner's two decisions (the 1940s build; the drawn detent's ring), then `wempe_tolerances.js`'s transcribed figures and the build40 tables as decided (`MC_WREV=build40`: tolerances, bench, Monte Carlo with `--write`; `wempe_build.js --write`; `wempe_navigation.js --write`; `wempe_makers.py`; `wempe_essaydata.js --write` if the essay's figures move). 2. On a quiet machine, the browser steps above and the six not reached: `python ci.py --only wempe-dfm,wempe-bom,wempe-bom-first,wempe-bom-1943,wempe-bom-3955,wempe-fea,wempe-fusee-body,wempe-fine-6mx,wempe-fine-3955,wempe-fine-band,wempe-solids,wempe-maintaining,wempe-mechanisms,wempe-exploded,wempe-audit-1943,wempe-audit-3955,wempe-stopwork,wempe-recipes,wempe-recipes-site,wempe-assembly,blender,sitecheck`, then `python ci.py --full` for the rest (the cache holds what passed). 3. `python geometry.py dfm` in `wempe/verification/`, `node reportdata.js` if a table changed, `python build_report.py`. 4. The 3D stress results if wanted (`motion3d.py`, `motion3d_fe.py`, `motion3d_pack.py --site`, each `--model wempe`), `ci.py --views`. 5. `python build.py --site-url https://www.marinechronometermodel.com`, commit, then the release (a minor), the root README after it.

**Also read again, no better.** The pillar plate's pencilled replacement thickness on 05 08_03a: the scan has lost the pencil's digits ("3,? ±0,0?"); still illegible.

## The Wempe's page against its recipes (29 October 2026)

**Fixed on the page, 1 November 2026 (branch `claude/wempe-faults-a`, to be released):** the top plate's pocket far side (0.047 to 0.0098 off r 5: its hull's tangent runs to the circle's point at r 4.99 so it crosses the opening's edge; with the hull's arc at exactly r 5 the solid opens), the dust plate's square hole (1:100 from the face), the barrel drum's Steg slot (`capFix` at its floor plane), the set-up ratchet's height (the bridge 3.30), WN-19, WN-20 and WN-21 (slots cut across the heads, `slotted` in `fusee.js`; the recipes cut them as the page does, 0.02 shallower than the old box's nominal height), the maintaining detent's arbor (96 sides), the 6MX contact lever's arms (they start in the boss's wall, leaving the staff's seat empty); each one's recipe `expect` removed (WN-19 and WN-21 keep 0.13 at the slot floor's ends). Left, with reasons in `PLAN-recipes.md`'s table: the upper cock's slot wall, the fusee body's chorded arc and end N, the 6MX contact's nut, tapped holes and disc (the springs and the detent's and gold spring's bores are in the sibling's files). Their bullets below describe the faults as found.

Making the Wempe's parts into recipes (`PLAN-recipes.md`, `tools/recipes.py --check`) compared each one's exact solid with the page's mesh. Eleven places where the page departs from its drawing are open; each is in its recipe's `expect` (reported, not failed) and in the plan's table "Page faults found", which has the details:

- **Top plate 05 09 01:** the pocket N-O's far side drawn tangent to r 4.95 where the sheet says r 5 (0.047). At r 5 the solid opens; the opening and the pocket need cutting as separate features.
- **Upper balance cock 05 08 03-1:** the stud's slot wall drawn upright through the boss where it leans 8° through the arm (0.13 at the boss's top).
- **Dust plate 05 06 00-1:** the square hole tapers 1:150 from the recess's mouth, not 1:100 from its floor (0.005, within the check).
- **Barrel drum 05 07 01-1:** the Steg's pocket cut 1.6 deep through the 1.25 bottom, leaving a stray face in the drum's hollow (0.35).
- **Detent 05 04 01-1, gold spring 05 04 01-2:** bores across thin strips (`fusee.js`'s `bore` through `holeCut`, `capFix`) leave chords inside the circle (0.025, 0.048).
- **Set-up ratchet 05 07 00-3:** its height still counts the barrel bridge as 3.32 thick (3.30 since the owner's correction), so it stands 0.07 off the bridge, not 0.05.
- **Timing screw 05 03 01-2:** its slot drawn as a box standing 0.02 out of the head, not cut into it. The arm's screws WN-10 and the masses' screws WN-12 the same (0.126; 31 October 2026), WN-12's head top a fan of 24 triangles up to 0.022 off the mass's round side, and the 1943 block's hole across the leaves a plain bore as the last revised block's (0.155).
- **Escape wheel's upper endstone screws WN-es:** the shank's end stands 0.032 up into the slot.
- **The fusee body 05 06 04-2 (batch 9d, 31 October 2026):** the flange's lathe rows (walls 0.04 off the helix) were fixed on main in 3.66.01; left: the slot's cutter arc (a floor that climbs 0.4 between two of the 216 rays) is chorded up to 0.1 off its circle, and at the groove's end N the rays join the last land's floor to the hub across a chord up to 0.13 off the wall.
- **Screws WN-19, WN-20, WN-21 (batch 9d):** their slots are solid dark boxes lying in the heads (0.02 out on WN-20 and WN-21), not cut. **Maintaining detent arbor 05 05 05-2:** turned on 20 sides, 1.6 % under the circle's volume.
- **The hands (batch 10, 30 October 2026):** each blade's root meets its boss as a separate closed piece (an 8-segment arc against the 72-sided wall, a 0.003 gap; 0.07-0.10 at isolated samples), the hour hand's root wedge lies on a cell-wise triangulation of the bevel's cone (about 0.1), and the seconds hand's tail ramp is sampled 0.027 off the table's rows.
- **The detent block's other versions and their screws (batch 8d, 1 November 2026):** the dome-headed screws' slots are solid dark bars following the curve, standing 0.01 out of the dome (the 6MX's banking screw's hangs 0.45 under the head at the rim); the 6MX block's M1 and stop-screw holes are drawn at the thread's major diameter; its notch for the slide leaves a 0.35 wide strip (2.5 to 3 under the plate) beside the thick part, with nothing over it.
- **The case (batch 11b, 31 October 2026):** the locking bracket's screw hole (`bore`'s `capFix`) leaves chords up to 0.053 off its circle, the detent's and gold spring's fault again; the closing plate's round r 1.3 between rim and boss is four straight rings (0.025 inside the arc); the kit's 32-sided screw heads depart from their circles by 0.020-0.029 above Ø 8 (WN-79, WN-71.f, WN-80); the case bracket's two Ø 4.5 holes are 24-sided polygons whose flats lie at the radius (0.0195, inside the check). **WN-ro** (the carrying case's eye screws, "3 x 15 DIN 96") is drawn with a head Ø 8.5 × 2.2, the standard's being Ø 5.6 × 2.0: open, for a later pass on the page. No hole is cut in the bowl's wall for the case brackets' WN-78 (the brackets are moved to level the bowl, "Kloben verstellen"), so the recipe notes them as tapped at assembly.

- **The keys and the transit lock (batch 12, 1 November 2026):** the 1943 key body's top chamfer is a cone cut in four steps (0.03) and its Ø 0.9 spring hole is slanted below the drill point's foot and upright above it (0.04); the tube's 60° sink is strips along 1.5° sectors (0.022); the lock's bracket seat is 16 chords round its end (0.029), its arbor, hub, grip and knob prisms of 20, 32, 16 and 40 sides (0.025, 0.024, 0.038, 0.028). The page draws no holes for the lock bracket's two wood screws through its leg, or for the lever's arbor and grip, the hub's and the knob's fits.
- **The 6MX's electrical contact (batch 13, 1 November 2026):** its tapped holes (the base's five M1.4, the stud's M1.2, the lever holder's M1.0) are drawn plain at the thread's size + 0.02; the lock nut is a hex 0.95 across the flats with a Ø 1.0 bore through it, so it is six slivers (6 bodies, 0.0135 mm³); the lever's arms are solid through the staff's seat; the springs' feet have no screw holes and their tines overlap the foot by 0.016; the disc's axle screw is a head with no shank and its bracket a plain block. Every size of the contact is an estimate from Kirov No. 247's photographs and Romanov's figures; the recipes follow the page and say so.

**Fixed on branch `claude/wempe-faults-b` (1 November 2026):** the timing screw's, WN-10's, WN-12's, WN-14's, cone41's, WN-gkA's and WN-gkA43's slots are cut into their heads (`KIT.slotHeadGeo`; recipe checks 0.004-0.018 apart without exceptions), WN-12's head face is a surface on the mass's side, the escape wheel's endstone screws WN-es no longer stand a shank into the slot, the kit's heads over r 2 are on more segments and the slot's mouth follows the rim (WN-79, WN-71.f, WN-80, WN-zg), the hands' roots meet their bosses on the boss's own vertices (0.004-0.018), the closing plate's round is sixteen rings, the transit lock's rounds are 64-120 sides, and WN-ro is DIN 96's Ø 5.6 × 2.0. Left: the stud slot wall (`frame.js`), the capFix chords (`fusee.js`), the tapped holes of the blocks, the key's chamfer steps and sink strips, the lock's bored holes (not drawn on any sheet); PLAN-recipes.md says why.

## Smaller issues

- **The detent's clamp screw head and its washer drawn in the same place; the across-screws through unholed pieces** (open; found 2 November 2026 by the drawn parts' second pass, HAMILTON-PARTS-LEDGER.md S-2): movement.js 1245 starts the washer `42251.det` (0.28 thick) and the head of `37024` together on the foot's face, so the washer is a solid disc inside the head; the head should start on the washer's outer face and the washer have a bore. The clamp, detent-adjusting and lock-adjusting screws pass through the foot and block with no holes (fine.py's det:Cylinder/det:Extrude, "can't be holed across"). The drawn parts page cuts both on its placeholders; the model is unchanged.

- **`facePocket` (core.js) leaves open edges on a many-sided pocket** (found 20 October 2026, the barrel bridge's counterbore): 12, 24 and 48 sides about the same centre leave 5-37 open edges (T-junctions where the pocket's planes cut the same face triangles in turn), 16 closes. Matching its plane tolerance to its weld (1e-7 to 2e-6) changes nothing. The counterbore was drawn with 16 sides (0.027 mm off the circle) until blindHoles took an `inner` radius (20 October 2026): a hole stopped at a depth with a narrower one on through its floor, the floor and far face zipped round the cut rim (in its edges' order) and an inner circle, each triangle wound as the loops run, which cuts the sink round. facePocket itself still can't cut a round pocket: open, for a pocket that isn't a hole's counterbore.

- **The balance's moment of inertia (open, 3 October 2026).** The restoration
  video measures the rim 0.6 mm thick (0.5–0.85 on three frames, edge-on,
  scaled by the rim's 29 mm and the impulse roller's 0.249 in, which agree to
  1 %) and about 3.5 tall, and the screw heads 2.9–3.2 across (face-on; the
  parts list's masses need a denser metal than brass at that size). Drawn so,
  the balance makes about 730
  g·mm²; Table II's screw changes need 1,140 (Table III's washers about 960).
  The model draws the measured balance and adds the difference as `I_REST`
  (410 g·mm²), so the panel's changes are the manual's. Open: what carries it.
  Candidates: a heavier arm or hub than drawn, Table II computed for another
  balance, or a misreading of the parts list's masses.
  *Resolved, likely (4 October 2026): the masses read as a matched pair's. Table
  II then needs 578 and the drawing makes 534 (`I_REST` 44, 8 %, inside the rim's
  measured thickness); the steel timing nut as measured can weigh a pair's 93 mg
  (about 50 mg each) but not 93; the heads come out near brass, not gold. What
  would make it certain: a balance screw or timing weight weighed (README,
  "Estimated").* Still estimated: which
  of holes 3, 5 and 12 has the 0.080 in heads (side-on, near and far heads
  overlap in projection; from above they are too foreshortened).

- **The balance slows down above 1×.** Between 1× and about 10×, the balance
  switches to its slow display swing (0.9 Hz), and the escape wheel moves
  continuously instead of stepping. At 2× the balance therefore swings slower
  than at 1×
  ([app.js:456](marine-chronometer-source/chronometer-working-model/js/app.js#L456)).
  Raising the threshold to about 5× would keep the true motion there.
  *Fixed: the true motion is kept up to 5× (`REAL_X`), and above it the HUD
  says the swing is shown slowed.*
- **Short hands.**
  - Hamilton dial: the minute hand stops 2 mm short of the minute track (tip at
    44 mm radius, track from 46 mm).
  - Roman dial: the minute hand's tip is at 45 mm and the track starts at 47 mm.
  - The wind-indicator hand is 0.5 mm short of its marks.
  *Fixed for the Hamilton dial (2 October 2026; RESOLVED.md, Going train and
  heights): its minute, seconds and wind hands measured against the
  photographed dial's tracks. The Roman dial is a variant after the Lange
  deck chronometers, with no photograph in `References/`; its hands are left
  as drawn.*
- **Floating minute hand.** The minute hand and its hub float 0.8 mm above the
  top of the cannon pinion: the pipe ends at y 4.9 and the hub starts at 5.7.
  This is only visible in the 12–6 cross-section.
  *Fixed: the cannon pinion's pipe runs to a shoulder at 5.75 and ends in the
  square; the minute hand, broached square, sits on it, and the hour hand has
  a round collet on the hour wheel's pipe (Ops. 58, 59, 64).*
- **Committed tool outputs.** `tools/r_p3.png` (456 KB) and `tools/p3fit.json`
  are outputs of `p3fit.py`, committed by mistake in `1340cb6`. `.gitignore`
  doesn't cover the tools' outputs, so running them from `tools/` dirties the
  working tree.
  *Fixed: both are untracked, and `.gitignore` covers every file the tools
  write (`r_*.png`, `r_ill/`, `fit.json`, `p3fit.json`, `unproj.json`,
  `bundle.npy`).*

## Not covered

- The essay, beyond its copy of the escapement solver. *(It has since been
  rewritten as the model's Essay tab.)*
- The photo-fitting tools (`fit.py`, `bundle.py`, `unproj.py`), which were not
  rerun.
- Phone layout and the CSS.
- Anything `IDEAS.md` already lists.

## Fixes for findings 1–5

### Changes

| Finding | Change |
|---|---|
| 1, 2 | `core.js`: a new `syncMat(d, s)` copies a source material's texture and colour into a copy derived from it. `ghostOf` and `fadeOf` (`app.js`) now return synced copies. `mv.userData.dial(kind)` in `movement.js` sets the texture on the face's own material (`userData.mat0`). `setPlateFinish` sets only the two plate materials. `app.js` calls `look()` after a dial style or finish is chosen, so the parts on screen follow at once. |
| 3 | `movement.js`: the escape upper bridge's two screw heads are 0.3 mm tall (were 0.5). |
| 4 | `movement.js`: `RUN_H = FUSEE_TURNS/FUSEE_PER_HOUR`, 60 h. `app.js`: the model runs down at `RUN_H` (was 56 h). "Power left", "running stored" and the Power diagram count from it, and the Fusee diagram's axis runs 0–60 h. Key winding "From run down" starts at `RUN_H`, and the status line mentions maintaining power only while the model runs. `index.html`: the Since winding slider goes to 60. |
| 5 | `movement.js`: `MOD.fourth` is 0.3113 (was 0.31); the comments quoting the modules are updated. |
| Docs | The model's README records the 60 h run-down, the fourth stage's module and the escape-bridge screws' clearance. |

`python build.py` regenerated `dist/chronometer-working-model.html`, the root
`chronometer-working-model.html` and `site/index.html`. The essay's outputs did
not change.

### Checks after the fixes

- **Finding 1**, in headless Chromium:
  - See-through on, Roman, see-through off: Roman face and Roman hands, and the
    face's own material carries the Roman texture.
  - Hands singled out, Roman, hands released: Roman face.
  - Back to Hamilton: Hamilton face and hands.
- **Finding 2**: a barrel bridge faded to 50% turns gilt (#be812c) when Gilt is
  chosen, with see-through on too, and back to nickel (#d5dad1) with Nickel.
- **Finding 3**: the heads now end at y −24.96. The rim and timing weights reach
  −25.10, so the heads are 0.14 mm clear.
- **Finding 4**:
  - From 59.9 h at 3600×, the model runs down at 60.0 h with the fusee at 8.75
    turns.
  - Winding with the key (From run down unticked) starts at "Half turn 1 of
    17½" with the fusee still at 8.75 turns, so nothing jumps.
  - While winding, the status line reads "Winding, maintaining power driving
    the train" once the model runs.
  - It ends "Fully wound after 17½ half turns."
- **Finding 5**: fourth wheel and escape pinion, centre distance 10.5846 mm
  against a pitch sum of 10.5842 mm, an error of +0.0004 mm.
- **`escapement.js`**: unchanged; all nine figures ok.
- **`dyn.py`**, at mid-travel and with the weights at +3 and −3 turns: the same
  seven intended overlaps as before the fixes.
- **`audit.py`**:
  - `dupScrews`, `floatScrews` and `isolated` are 0; `zfight` is 45.
  - `looseEnds` is 5: the winding-stop pin and balance-screw and weight-screw
    ends. The count depends on the balance's angle when the page loads.
- **`audit.py box`**: unchanged.
- **Rebuilt pages**: the root copy and `site/index.html` load with no page
  errors and make no network requests.
- **Link-preview images**: not regenerated; the changes aren't visible at that
  size.

## Fine interference pass

29 September 2026, after `245442c`. It started from an escape pinion seen
touching the third wheel, then reviewed every stage of the power train and the
timekeeping parts.

### The check

`tools/fine.py` with `tools/fine-interference.js` (new). For every pair of
meshes whose boxes meet, it casts vertical rays through only the shared box, on
a 0.05 mm grid, and measures where both are solid. It runs:

- the 18 escapement phases `dyn.py` uses;
- 15 train positions, whole teeth apart, with wind states from run down to full
  wind, and winding;
- with `--dense`, 101 phases across a full balance swing.

Unlike `dyn.py` it tests each link of the chain and the tube springs
(hairspring, trip spring). Its `EXPECTED` table lists the intended contacts with
their reasons and size limits; anything else fails. Planting the old escape
pinion back makes it fail (0.31 mm, `escW × tw`), and `--split` reproduces
finding 9.

### Fixed

| Overlap | Size | Fix | Commit |
|---|---|---|---|
| Escape pinion into the third wheel's teeth | 0.31 mm high, 0.37 mm deep | Pinion runs from the fourth wheel toward the plate | `329e77e` |
| Fourth wheel's collet into the third wheel's teeth | 0.38 mm | Collet on the plate side only (`cside`) | `329e77e` |
| Sustaining pawl's arbor into the fusee wheel's teeth | 0.12 mm | Pivot 21.35 mm from the fusee axis (was 21) | `329e77e` |
| Stop-bar through the fusee arbor at full wind | 1 mm³ | One bar beside the arbor, re-aimed at the stop pin | `b39086a` |
| Stop-bar through the chain's top turn at full wind | 0.18 mm | Raised top cap, thinner bar above the chain | `0371c16` |
| Chain's straight run into the barrel (found by the barrel check) | 0.24 mm | Common tangent of the two drums; winding-stop pin 0.2 mm shorter | `ba9634f` |

All were thinner than `dyn.py`'s 0.4 mm cubes, and the barrel wall was never tested before.

Each fix was also checked with before/after renders of every view button,
with and without "Moving parts only", in a frozen state, and a pixel diff
(now `tools/views.py`): the only changed pixels were on the parts fixed. Each
also left `dyn.py`, `audit.py` and `escapement.js` as they were, apart from
the moved parts' own entries.

### Stage by stage

Every mesh's centre distance equals its pitch sum (see [Gear meshes](#gear-meshes)),
and each wheel's face lies wholly within its pinion. After the fixes, no wheel
or pinion touches anything but its partner at any position tested:
barrel → chain → fusee, the maintaining work, fusee wheel 96/14, centre 80/10,
third 75/10, fourth 60/8, the motion work and the wind indicator.

Timekeeping parts, over 101 balance phases: the escape wheel, rollers, detent,
trip spring and balance touch nothing but their pivots. The hairspring's upper
end sits 0.1 mm into the cock, pinned in its stud. `escapement.js`: all nine
figures ok, unchanged.

### Documented, not changed

These are intended contacts, in `fine.py`'s `EXPECTED` table with their limits:

- **Two pins graze the bevel of their train-bridge holes.** `polyGeo`'s bevel
  narrows the train bridge's holes near one face. The sustaining pawl's arbor
  (r 0.7 in a 0.72 hole) overlaps it by 0.058 mm³ over 0.18 mm of depth, and the
  winding-stop pin (r 0.9 in a 1.0 hole) by 0.034 mm³ over 0.16 mm. Both are
  inside the bridge and not visible. To remove them, widen the two holes by
  0.2 mm, or leave the bevel off holes.
- **Chain links on the fusee cone,** up to 0.5 mm. The groove is turned rings,
  not a helix, and each link is an upright box on a slope of up to 60°, so its
  lower edge dips into the cone. This stands for the chain lying in its groove.

### The barrel wall

The barrel's wall is an open, double-sided cylinder (`noCap`, r 13.5 mm), and
ray parity needs closed meshes, so neither check could test it. The plan was
carried out as follows.

- **Solid stand-in.** `fine-interference.js` tests any open cylinder marked
  `noCap` as the solid it encloses. The barrel arbor on its axis is expected.
- **Margins.** `barrel-clearance.js` measures how close every other part comes
  to the solid the whole barrel sweeps as it turns: wall, caps, cap screws,
  hook and boss. Signed distance to each piece is convex, so a branch and bound
  with tangent-plane bounds gives margins to about 0.002 mm in 0.5 s a state.
  `fine.py` runs it at its 15 wind states and fails on anything closer than
  0.05 mm that isn't in `BARREL`.
- **Mainspring.** Its drawn coils, over the wind, against the arbor, wall and
  caps.
- **Proved.** Three planted faults fail as they should, with no source edits
  (`--eval`):
  - the wall scaled 1.2×: it hits the train bridge, the detent and the chain;
  - the barrel moved 0.2 mm toward the plate: the third wheel is 0.050 mm
    inside, exactly the 0.2 less its 0.15 mm gap;
  - the mainspring scaled 1.1×: its outer coil is 0.69 mm through the wall.

Results, over the wind:

| Part | Closest to | Margin |
|---|---|---|
| Chain (wound on the drum) | wall | 0.013 mm, expected (0–0.1 mm) |
| Third wheel | cap screws, below them | 0.150 mm |
| Barrel bridge | boss on the upper cap | 0.550 mm |
| Detent foot | wall | 0.983 mm |
| Train bridge's cutout | rim of the upper cap | 0.998 mm |
| Centre wheel | rim of the lower cap | 2.08 mm |
| Balance | rim of the upper cap | 2.34 mm |
| Mainspring | arbor / wall / caps | 1.2 / 0.6 / 0.3 and 0.2 mm |

These agree with the review's hand check except the cutout: its 1.7 mm is
measured to the wall, and the caps' rim, 0.7 mm wider, is 1.0 mm from it.

The check found one fault. The chain's straight run joined the two drums'
lowest points, which is a true tangent only when their radii are equal; with
the fusee smaller, the run cut up to 0.24 mm into the barrel. It is now the
common tangent. The winding-stop pin, which the fusee's turned wrap then
brushed at full wind, ends 0.2 mm higher, still covering the stop-bar.

The dial face (a flat, open ring) was the one open surface untested; `fine.py` now checks the heights of the parts over it (2 October 2026).

## Barrel and fusee against the manual

A second review, of the power side only: is every part of the barrel and fusee
modelled, and is each one right? Sources: the manual's Sec. II and IV,
disassembly Ops. 7–9 and 27–45, reassembly Ops. 16–54, Figs. 12, 17–18, 24–29,
67–80 and 109, and the parts lists for Figs. 108–110. Checked against
`movement.js` and `app.js` in the working tree, 29 September 2026.

### The parts

Every part number in the model's descriptions matches the parts list. Parts
marked "added" were missing; the model's shapes for them are estimated from the
figures (listed in the README's "Estimated, not from the manual").

| Part (Hamilton no.) | Before | Now |
|---|---|---|
| Fusee with arbor and wind-indicator pinion (42021, 42022) | modelled | the fusee turns every frame (it lagged its square by up to 0.29°) |
| Fusee chain (42001) | links only | added: a pin at the fusee's large end, a hook at the barrel |
| Winding ratchet wheel (42013) | modelled | unchanged |
| Winding ratchet wheel screws (42014, 2) | missing | added, heads in the sustaining ratchet's open centre |
| Sustaining ratchet wheel with pawls (42009) | modelled, as part of the fusee wheel | its own part, with its own description, exploded apart as in Fig. 28 |
| Winding pawl springs (42007, 2) and screws (42012, 4) | missing | added: flat springs bearing on the pawls |
| Sustaining spring (42016) | modelled, inside the fusee wheel part, 0.05 mm into its web | its own part, clear of the web |
| Fusee wheel (42015) | modelled | unchanged |
| Fusee end plate (42019) and taper pin (42020) | missing | added |
| Winding stop-bar (42024) | a 0.22 mm bar on a turned cap, 0.6 mm under the train bridge | in a slot in the fusee's top, under the top plate |
| Winding stop-bar spring (42025) | missing | added: a wire in a groove, bearing on the bar's inner end and following it |
| Fusee top plate (42008) and screws (27760, 2) | missing | added |
| Winding stop (42099) | a pin down through a hole in the train bridge | a stud from the barrel bridge, through the train bridge's pocket |
| Sustaining pawl with arbor and springs (42096) | pawl and arbor | added: its spring, round a steady pin in the train bridge |
| Barrel (42168), cap (42169) and 5 screws (37023) | modelled | unchanged |
| Barrel arbor (42170) | shaft and squares; the mainspring's inner coil floated 1.2 mm off it | added: the core and the hook for the spring's inner end |
| Mainspring brace (42037) | a small block | a strip lining 40° of the wall |
| Mainspring (42038) | schematic | unchanged |
| Setup ratchet (42026), pawl (42027), cover plate (42029) and screws | modelled | unchanged |
| Setup pawl spring (42028) | missing | added |
| Dust seal (42051), its screws and packing rings (42054) | modelled | unchanged (seal ring and helical spring are inside it, not drawn) |

Right as they were: the directions (fusee and barrel clockwise from the train
side in running, the key counterclockwise), the stack order of Fig. 28, and
the stop-bar reaching the stop at full wind.

### Findings

1. **The sustaining ratchet turned back when winding stopped.** `update()` put
   the ratchet on the winding-pawl engagement nearest the fusee wheel
   (`Math.round`). A probe of 12 windings: 6 ended with the ratchet jumping
   0.8–5° backward past the sustaining pawl, which the pawl makes impossible.
   Physically the fusee turns forward (less than one winding tooth) until its
   ratchet catches the pawls, and then drives the sustaining ratchet forward.
2. **The sustaining spring had no steady load.** In running its deflection was
   whatever the fusee's phase left, from −4.5° to +4.3° (negative: stretched).
   It should hold one loaded deflection in running, relax while winding, and be
   reloaded when the key lets go.
3. **The fusee lagged its square by up to 0.29°.** It turned only when
   `setWind` ran (every 0.0008 turn), while the square turned every frame.
4. **The upper train bridge covered the fusee.** Figs. 24, 29, 67 and 77 show
   the fusee open to the barrel bridge, which holds its upper bushing (parts
   list 108-45, Op. 46). Covering it made the winding stop a pin through the
   train bridge and left no room for the top plate or the stop-bar spring.
5. **Thirteen parts were missing** and two were the wrong shape (the table
   above: the brace and the winding stop), and the sustaining
   ratchet, its pawls and the spring couldn't be picked, named or exploded
   apart.

### Fixes

- **Maintaining work** (`update()` in `movement.js`):
  - running: the sustaining ratchet turns with the fusee wheel (spring loaded);
  - the fusee sits `eps` past its `n` turns, where its ratchet bears on the
    pawls, and the arbor, square and wind-indicator pinion turn with it;
  - winding: the ratchet falls back to its pawl, then holds while the spring
    relaxes (drawn up to 10°, `SMAX`); `eps` runs down with `n`;
  - key let go: the fusee catches forward, the ratchet reloads the spring.
- **Train bridge:** a pocket round the fusee's top, the winding stop and the
  stop-bar's sweep over the last quarter turn. The plan was a cut open to the
  rim like the barrel's. That would uncover the fusee wheel just past the
  barrel bridge's straight edge (6.4 mm from the fusee axis), where the
  top-view photograph shows the train bridge. So the pocket stays 0.5 mm under
  that edge, and is smaller than the manual's opening.
- **Parts:** as in the table. The sustaining ratchet (`sratchet`) and spring
  (`sspring`) are their own parts, with descriptions, colours, a label, and
  places in the parts list, the key-winding focus and the "Winding without
  stopping" step. The sustaining pawl explodes level with its ratchet.
- **Checks:**
  - `tools/maintaining.py` (new) drives run and wind cycles and fails on any
    of the faults above. On the old code it failed (351 frames: spring load,
    arbor lag, ratchet turned back); now it passes.
  - `tools/fine.py`: the winding pawls' entry is renamed to `sratchet`, and the
    winding-stop pin's bevel entry is gone. New entries, each an intended
    contact: the spring's pin in the fusee wheel, the pawl spring on its pin,
    the chain's end pin and hook, and the arbor's core and hook in the barrel.
    The mainspring's inner coil is checked against the core (r 2.4).

### Checks after the fixes

- `maintaining.py`: ok, 311 frames. The stop-bar touches the stop at full wind
  (0.000 mm), is 2.34 mm clear half a turn before, and 0.66 mm clear after the
  key lets go.
- `fine.py`: 33 states, 23 pairs, 0 new or grown; 0 barrel problems. The
  mainspring's inner coil is 0.2 mm off the core.
- `audit.py`: no overlapping or floating screws. The loose ends are the
  expected ones: the winding stop's free end (listed or not, depending on the
  wind state at the time) and the balance's screw and weight tips. The new coplanar hits are faces in contact:
  the sustaining ratchet under the winding ratchet and pawls, and the pawl
  springs on the ratchet.
- `views.py --diff`: changed pixels only on the fusee stack, the barrel and
  setup area, the sustaining pawl, and the train bridge round the fusee. The
  dial view changes by 19 px: the wind-indicator hand, which now includes the
  fusee's `eps`.

### Not changed

- The stop-bar is still driven from the wind over the last quarter turn, not
  pushed by the chain. The chain's top turn passes under it.
- The model does not stop the train if a wind outlasts the sustaining
  spring's 5–10 minutes; that only happens at high speed.
- The rest of the upper train bridge's outline (Figs. 29, 67: a crescent) is
  still to trace (`IDEAS.md` 1.3). The chain's links are still boxes (1.9).

## Every part against the manual

*Status (3 October 2026): what this review lists as not drawn or not modelled has all been built since (the balance's upper setting and jewel, the collet and stud as Fig. 5, the timing washers in the rate panel, the seal ring and spring, the wedge pin, the latch's clamping parts): `tools/bom.py` finds every one of the parts list's 187 lines on the model with its relations. The table below is the review as it was.*

A third review, of the whole movement and its case against the manual's parts
lists (Figs. 106–110, pp. 78–88), its description and principles of operation
(Secs. II–IV) and its handling instructions (Sec. III, Figs. 7–11), with the
Figs. 4, 9, 107, 108 and 110 drawings. It started from one complaint: every
screw was a head with nothing under it, which the Exploded view made plain,
and no part had a hole where a screw goes. Checked against `movement.js`,
`box.js` and `app.js` in the working tree, 29 September 2026.

### Screws and holes

- **Every screw has its shank.** `screw()` draws a fillister head and a
  threaded shank (turned rings of thread, a chamfered tip) of half the head's
  diameter, as long as the parts it passes through and about 3 mm into the part
  it holds. Each length is set where the screw is placed. There are 51, plus
  the train-blocking screw, which is drawn on its own because it moves.
- **Every screw has its holes.** The parts a screw passes through have a
  clearance hole (`hC`) and the part it screws into a tapped hole (`hT`): the
  pillar plate, lower train bridge, pillars (tapped at both ends), upper train
  bridge, escape upper bridge, barrel bridge, balance lower bridge,
  cock and cock foot, the endstone caps, setup cover and its feet, dust-seal
  flange, sustaining ratchet wheel, winding ratchet and a tapped disc in the
  fusee's large end, the fusee's top layers, top plate and boss, the detent
  support block and trip-spring bracket, and the balance's arm, hub and cap.
- **The Exploded view lifts each screw out of its holes** along its own axis,
  as Figs. 108–110 draw them, so the threads and the holes both show.
- **Screws in the case and gimbals** (`sHead` in `box.js`) have shanks too.
  Those parts never come apart in the model, so they have no holes.
- **Not holed:** the detent's clamp, detent-adjusting and lock-adjusting screws
  go across pieces that are drawn as vertical extrusions, so their shanks lie
  inside the foot and support block (`fine.py` lists this with its reason).

### The parts

Every Hamilton number in the Figs. 108–110 lists, and the case and box parts
of Figs. 106–107. "Added" parts were missing; their shapes are estimated from
the figures and listed in the model README's "Estimated, not from the manual".

| Part (Hamilton no.) | Before | Now |
|---|---|---|
| **Fig. 108: balance, cock, setup cover** | | |
| Balance cock (42066) and screw (42192) | cock and screw head | the screw goes through cock and foot into the train bridge; it sits 0.3 mm off its traced place, inside the tracing's 0.4 mm, so its thread clears the foot's edge |
| Balance upper endstone cap (42160), its setting (42155) and screws (20762, 2) | plate, stone, screw heads | screws threaded into the cock; the setting is drawn as the stone in the cap. Later reshaped to the top-view photograph (a 7.6 × 4.6 mm plate, stone in a gilt setting, screws 2.75 mm either side), with the cock's nose widened under it: it had overhung the nose with one screw in the air (RESOLVED.md). Then rebuilt to C Spinner's video (5:51, 41:58, 42:03, 42:08): a 7.2 × 4.6 mm plate symmetric about the staff, its corners rounded more at the nose's end, a polished conical oil sink 3.1 mm across in the setting down to the endstone, the screws' heads sunk flush (RESOLVED.md). Still open: the real cap ends at the nose's end, where the model's nose runs on about 1.2 mm past it |
| Balance upper setting (42162) | not drawn | not drawn: the staff is 0.7 mm from the traced cock's edge (IDEAS 1.4) |
| Balance and hairspring assembly (42193), wheel (42178) | modelled | unchanged |
| Hairspring (42188) | modelled | unchanged |
| Hairspring stud (42189), stud screw (27760), clamps (42191) and wedge pins (42147); collet (42190) | a block and a hexagonal collet | unchanged: Fig. 5's shapes are not drawn (IDEAS 1.4) |
| Balance screws (42171, 42173, 42174), timing weights and screws (42176, 42177), vernier weights and screws (37115, 42197) | modelled | unchanged |
| Timing washers (42181) | not modelled | not modelled: "as required" |
| Impulse roller (42263) and jewel (286), unlocking roller (42252) and jewel (287) | modelled | unchanged |
| Hub with staff (42186), cap (42248), hold-down screws (42249, 2) | a solid Invar cylinder through the arm | added after Fig. 4: the hub's flange under the arm and its boss through the arm's clearance hole, the cap over the arm, two hold-down screws into the flange |
| Balance wheel locking arm (42299), screw (37204), washer (42251), stop pin (42300) | missing | added, and it works (see below) |
| Setup cover plate (42029) and screws (42056, 2) | its feet stopped 0.35 mm short of the barrel bridge | the feet stand on the bridge; screws threaded into it |
| **Fig. 109: barrel, fusee, setup** | | |
| Setup ratchet (42026), pawl (42027), pawl spring (42028) | modelled | unchanged |
| Setup pawl pivot screw (42036) | a pin on the cover | a screw through the cover and the pawl's pivot into the barrel bridge |
| Dust seal (42051), screws (42056, 2), packing rings (42054) | modelled | screws threaded into the barrel bridge; the flange has their holes |
| Seal ring (42052), helical seal spring (42053) | inside the seal, not drawn | unchanged |
| Barrel bridge (42061), pillar screw and screws (42055, 1 + 2) | modelled | threaded: into the barrel pillar, through the train bridge into its pillar, into the train bridge |
| Barrel and fusee upper bushings (42164) | missing | added, in the barrel bridge |
| Winding stop (42099) | modelled | unchanged |
| Barrel (42168), cap (42169), cap screws (37023, 5), arbor (42170), mainspring (42038), brace (42037) | modelled | unchanged (the cap screws are heads on the cap) |
| Fusee and its parts (42006, 42015, 42016, 42019–42022, 42024, 42025, 42008), chain (42001) | modelled | unchanged |
| Sustaining ratchet wheel with pawls (42009), winding pawl springs (42007, 2) and screws (42012, 4) | the springs were strips 0.3 mm wide under 0.8 mm screw heads; `audit.py` found the screws standing on nothing | each spring has a foot under its two screws; screws threaded into the wheel |
| Winding ratchet (42013) and screws (42014, 2); fusee top plate (42008) and screws (27760, 2) | screw heads | threaded into a tapped disc in the fusee's large end and into the fusee's boss |
| **Fig. 110: train, escapement, plates** | | |
| Escape upper bridge (42064A) and screws (20762, 2) | modelled | screws threaded into the train bridge |
| Escape upper setting (42162) and endstone cap (42159) with screws (20762, 2) | a ring on the bridge, a stone above it and two plain pins | the setting and its jewel pressed into the bridge, a cap over it with the stone, two screws |
| Detent (42087), jewel (285), bracket (42092), trip spring (42088), support block (42086), lock-adjusting and clamp screws (42091), detent-adjusting screw (20756), clamp screw (37024) and washer (42251) | modelled | the adjusting and clamp screws have shanks; the trip-spring screw (1770) a fine thread in the bracket |
| Detent support block screw (42056) | a head | threaded through the train bridge into the block |
| Locking jewel wedge pin (42089), trip-spring bracket screw (1770) | not drawn | unchanged |
| Escape wheel (42076), centre (42068), third (42071) and fourth (42073) wheels | modelled | unchanged |
| Upper train bridge (42062), pillar screws (42055, 3), bushings (42166, 42167) | modelled | screws threaded: two into their pillars; the third, where the top-view photograph shows it, has no pillar under it in the model (IDEAS 1.2), so it is drawn threaded into the bridge alone |
| Sustaining pawl with arbor and springs (42096) | modelled | unchanged |
| Balance lower bridge (42065) and screws (42055, 2) | a stadium, a boss, screw heads | a lobe for the train-blocking screw; later a stepped block: upper tier against the train bridge, the screws (pillar-screw size) from below into the train bridge (Figs. 29, 110; Ops. 12, 50), steady pins, the pillar plate's access hole (RMG No. 4E019); later a frame round the escape wheel in Fig. 30's order, the train-blocking screw, a pin and the second screw at holes on the top-view photograph |
| Balance lower setting (42162), lower endstone cap (42159) and screws (20762, 2) | a 0.5 mm hole the staff ended in | added: setting and jewel, and a cap under the bridge; the staff's pivot reaches the endstone |
| Fourth wheel upper setting (42161) | a hole | added: setting and jewel |
| Train-blocking screw (42247) | missing | added, and it works (see below) |
| Train bridge pillars (42059, 3), barrel bridge pillar (42058) | modelled | tapped at both ends |
| Pillar screws (42055, 3 + 1) from the dial side | missing | added, through the pillar plate into the pillars |
| Lower train bridge (42063), screws (42163, 2), third and fourth lower settings (42161) | modelled | screws threaded into the pillar plate |
| Pillar plate (42060), centre, barrel and fusee lower bushings (42165, 42164) | modelled | unchanged |
| Escape lower setting (42162) | a gilt ring | its jewel added |
| Escape lower endstone cap (42159) and screws (20762, 2) | missing | added, on the dial side |
| Minute wheel post (42085) and wind indicator wheel post (42084), with their screws (35779) | the two wheels turned on arbors of their own | fixed posts screwed to the plate from its train side; the wheels turn on them, the wind indicator wheel's hand on its pipe |
| Mounting ring (42057) and screws (42055, 3) | a ring beside the plate, no screws | a lip under the plate's dial side, held by three screws; since, the deep ring under the plate that Figs. 29, 67 and 110 draw, carrying the dial, with its alignment pin |
| **Fig. 107: case, dial, motion work** | | |
| Dial (42030) and dial screws (35756) | three feet on the plate, no screws | each foot held by a screw from the train side of the plate; since, four feet in the mounting ring's flange, screwed from its train side, where the top-view photographs show the screws |
| Hands (42032–42035), cannon pinion (42077), minute wheel (42078), hour wheel (42080), wind indicator wheel (42081) | modelled | unchanged |
| Case (42101), bezel (42102), crystal (42103), case support brackets (42105) and screws (42117) | modelled | the bracket screws have shanks |
| Latch keeper (42113) and its screw (42116); separating washer (42128) | the keeper only | unchanged |
| Shield plate (42104), shoulder screw (42124), stop screw (42125), return spring (42126) | modelled | Fig. 107 draws the plate as a disc and the spring as an open ring. Since 5 October 2026 the model draws them so, measured on KLUwI2UUCMQ 47:24.0 and 47:36.5: a disc r 30.1 with the key's, the shoulder's, the stop screw's and a fourth hole, the stop screw screwed into the plate, the spring an open ring from a hook round the screw's end to a pin in the case's bottom (box.js; a lobed plate and coiled spring, estimated, until then) |
| **Fig. 106: box and gimbals** | | |
| Mounting box (42201), key (42044), gimbal ring (42106), gimbal and case support straps (42107, 42108) and screws (42116), pivot screws (42118–42120), washers (42122), lock nuts (42121) | modelled | strap screws have shanks |
| Latch: support bracket (42109), lever (42111), handle (42112), bracket screws (42115) | modelled, shown released | unchanged |
| Latch clamping bracket (42110), take-up spring (42277) and screw (42276), clamping screw (42114), washer (42123) | not modelled | unchanged |

### Jewels

The manual counts 14 (Sec. II). The model draws 13: impulse, unlocking and
locking; both of the escape wheel's hole jewels and endstones (three added);
the balance's lower hole jewel and both endstones (two added); both of the
fourth wheel's bar-hole jewels (one added) and the third wheel's dial-end one.
The fourteenth, the balance's upper hole jewel, is not drawn (above).

### Function

Checked against Secs. II–IV and the handling instructions:

- **Already right:** the directions of turning (the fusee wound
  counterclockwise, the barrel clockwise in running), 7 half turns a day and
  17½ from run down, the maintaining work (Sec. IV, `maintaining.py`), the
  detent's five steps and the adjustment figures (Ops. 84–88, 97,
  `escapement.js`), the hands in half-second steps, the winding stop at full
  wind, the balance's 1⅜–1½ turns.
- **Wrong before: the model started by itself.** Wound after running down, it
  simply ran again. A detent chronometer isn't self-starting. It stops when its
  balance no longer swings far enough to unlock the wheel, and the manual has
  it started with "a single quick twist" of the box (Sec. III). The model now
  keeps the balance's amplitude:
  - It needs `ESC.AMIN`, 41.1°, to keep going: the swing has to carry the
    discharge jewel past the trip spring on the return (it falls off at
    −39.1°), unlock the wheel (−21.3°) and see the impulse through (+20.8°).
    `makeEsc` works it out from the escapement's own tables.
  - Below that the train stops at a locked beat and the balance swings down
    freely, the detent still lifting while the swing carries the jewel back past
    the trip spring's tip (above 39.1°). Below that the jewel stays on the near
    side of the tip: the trip spring stays bent against it and follows it back,
    and the detent stays on its stop.
  - Twist to start sets it swinging again (160° then; since the kinematics audit of 11 October 2026 the box's own twist, about 67° from rest), after which it builds up to
    its running 255°.
  - The same holds at run down: the train stops, the balance runs down, and a
    wound chronometer needs its twist.
- **Added: the balance locking arm** (Fig. 9). Locked, the finger at its end
  stands beside a timing weight (first drawn as a pad under the rim; RESOLVED.md,
  "Locking arm under the rim"), and the balance stops within a swing or two.
  Unlocked, the arm lies against its stop pin, and the balance needs a twist.
- **Added: the train-blocking screw** (Sec. II, Fig. 110).
  - Screwed down, its dog point stands between the fourth wheel's spokes. The
    train runs on until a spoke meets it, at most about 22 beats (11 s at 1×), and stops at
    the last whole beat before contact; the balance then swings down, unlocking
    a wheel that can't turn.
  - It waits above the wheel while a spoke is under it.
  - Raised within a minute or two, before the balance drops below 39°, the
    chronometer carries on by itself.
  - It sits in the balance lower bridge beside the fourth's setting, toward
    the lug at that end, 5.0 mm from the arbor, as the restoration video has
    it ("The balance lower bridge", 7).
- **Not modelled:** setting the hands with the key on the centre square
  (Fig. 8; the Time panel sets them), the gimbal latch (shown released), and
  the hairspring's stud and collet as Fig. 5 draws them.

### Found along the way

- **`polyGeo`'s bevel narrows every hole** by 0.8 × the bevel (0.18 mm on the
  train bridge) at both faces. A screw that fits its tapped hole grazed it
  there, 0.1–0.2 mm deep, in eight places. Screw holes are now cut that much
  larger, so they have their size at the faces (wider inside the plate, where
  it can't be seen); arbor holes are unchanged.
- **The minute wheel and the wind indicator wheel turned on arbors of their
  own**, the wind indicator's running through the pillar plate. The parts list
  has fixed posts screwed to the plate (above).
- **The balance's lower pivot and the escape arbor's pivots ended in nothing
  or in bare holes**: no jewels, no endstones. They now run in their settings
  up to the endstones.

## Fusee and chain against the manual and photographs

Checked against Secs. I, III and IV, Figs. 12, 26, 28, 38 and 70–75, and the
side and oblique photographs (`References/photo-side-view.jpg`,
`photo-oblique-balance-side.jpg`). The side photograph is scaled by the fusee
wheel's tips (96 teeth, module 0.4171: 40.87 mm, 694 px) about its axis.

### Right as they were

- Directions: fusee and barrel clockwise seen from the key while running, the
  key counterclockwise (Secs. III, IV); an open chain run on the drums' common
  tangent, leaving the fusee's small end at full wind and its large end run down.
- The chain pinned at the fusee's large end and hooked near the top of the
  barrel (Figs. 26, 28, 75).
- 17½ half turns for a full wind, 7 a day (96/14); the maintaining work.
- The chain's coils on the barrel: widely spaced near its top, closer toward
  the plate, as both photographs show. The run stays level, so on a plain drum
  each coil lies where the fusee's groove was when it came off.

### Findings, all fixed

1. **The fusee was too thin at its small end, its top too small.** Groove floor
   on the photograph 8.33 to 13.81 over the eight upper turns, flanges about
   1.25 over the floor of the turn below, top 9.3, base flange 18.3; the model
   had r 6.5 to 14 and a top plate of r 5.4. Fig. 28 draws the photograph's
   proportions (the top about 0.6 of the largest turn). The measured floors fit
   `r0/√(1−a·m)` (the fusee for a pull falling with the barrel's turns) to
   0.085 mm rms: 7.95 to 16.8.
2. **The groove was turned in rings,** a 0.4 mm ripple of the lathe profile, not
   the helix of thin flanges photographed.
3. **The links lay flat.** A fusee chain bends about rivets parallel to the
   arbor; its figure-eight plates (Fig. 38) stand on edge, three deep. The
   model's boxes were 1.0 along the arbor by 0.34 radially. The end pin was
   radial; Fig. 28 draws it parallel to the arbor.
4. **The chain didn't work the stop-work.** Sec. IV: the chain "bears against
   one end of the spring-activated winding stop-bar, the opposite end of which
   moves out to engage the winding stop". The bar slid out over the last
   quarter turn from the wind count, clear above the chain, both ends inside
   the fusee's top; the key walkthrough's text said the chain pushed it.
5. **The fusee chart and power readout used literals** (6.5, 14) for the
   profile.

Knock-on: the fatter fusee takes 656 links of chain (about 26 in with its run,
against 22; one sale listing gives 28.5 in for the Hamilton's), 7.07 barrel
turns. The model's mainspring took 6.53 on its r 2.4 core; on r 1.74 it takes
7.64, leaving a set-up of 0.37 turn.

### Noted, not changed

- The side photograph's barrel coils are about 1.4× further apart than a
  13.5 mm barrel predicts; the top-view comparison agrees with 13.5, so the
  barrel stays.
- On the side photograph the sustaining ratchet's teeth reach r 18.7; the
  model's (120 teeth, module 0.27) reach about 16.5.
- 17½ half turns at 96/14 hold 60 h of chain; the manual rates the chronometer
  at 56 h. A 96/15 first stage would give 56 h, but 7½ half turns a day, not
  the manual's 7. The model keeps 96/14 (finding 4 above).

### Checks after the fixes

`solids.py`, `fine.py` (0 new or grown; the chain's links no longer enter the
fusee, the groove replacing that expected entry), `fine.py --hold`,
`maintaining.py` (the stop-bar meets the stop at full wind, 2.6 mm clear half
a turn earlier), `exploded.py`, `invariants.py`, `audit.py`, `smoke.py` and
`node escapement.js`.

## BOM comparison (Sec. XI), 30 September 2026

Every line of the manual's parts list (Sec. XI, Figs. 106-110, pp. 78-88;
totals checked against the Sec. XII numerical list, p. 89) against the model,
by count, by how the part is held and runs, by what it meshes with, and, for the
jewels, by how each is seated. The comparison above ("Every part against the
manual", 29 September) is superseded by **`BOM.md`** at the repository root,
generated by `tools/bom.py --md` from `bom.json` and measurements of the built
model; several of its "not drawn" items were out of date (the balance upper
setting and jewel, the wedge pin 42089 and the trip spring screw 1770 were
drawn; the model has all 14 jewels, not 13).

### How it is checked

- `bom.json` holds 219 lines: 187 parts and jewels, and the assembly, reference
  (superseded), variant (p. 88's other sizes) and omitted (timing washers, "as
  required") lines, each with what the part does, its source, and its relations.
- Every piece of the model carries its line as `userData.hn`. `bom.py` counts
  them against the units per assembly, fails on any mesh without a line, and
  measures 319 relations on the built meshes in world space: rays out from each
  part's axis for threads, pivots, pins and settings (the gap and over what
  length), least surface distance for parts resting on others, centre distance,
  modules, face overlap and turning ratio for the gears, and axial freedom for
  endshake.
- Current result: 187 lines, 319 relations, 14 jewels, **no failures**, one
  known deviation (below).

### What it found (fixed; RESOLVED.md, Accuracy to the manual)

Missing parts, parts holding nothing, arbors without pivots or endshake, jewels
floating, buried or short of their pivots, loose or over-tight fits, and the
gimbal pivots and latch against Fig. 106: see the RESOLVED.md entry. The
gears were already right: every centre distance within 0.003 mm of
m(z1+z2)/2, modules matching, ratios and senses right (table in BOM.md).

### Still open

1. *Closed (2 October 2026, `claude/group-layout`): pillar 2 stands under the screw, as the
   video has it (23:30, 36:34) and Op. 14; `bom.json` has no deviation left.* **The upper train bridge's third screw** (known deviation, `bom.json`
   `dev` on 42055.tb). The manual has all three in pillars (reassembly Op. 14; disassembly Ops. 47, 48);
   the model's third is where the top-view photographs (and serial 623's) show
   a screw, at (-8.5, 27.7), where a pillar would stand in the fourth wheel.
   What it holds in the real movement is not settled (IDEAS.md 1.2; examined
   again against Figs. 29, 67 and 110 on 1 October 2026, still open).
2. *Under way (4 October 2026, `claude/shape-pass`): every line triaged for its provenance, the work order and ledgers in **`SHAPE-PASS.md`**.* **Shape against the drawings and photographs**, part by part, not yet
   done. 44 web photographs were gathered (mostly all rights reserved: to be
   cited by URL, not committed). Candidates: the shield plate (Fig. 107 draws
   a disc and an open-ring spring; *now drawn so*, 2 October 2026, RESOLVED.md,
   Setup, case and gimbals), the setup
   ratchet and click (asked in Orel_comments.md; *the dust seal compared with C Spinner 6:29 (3 October 2026): its packing, column and flange in proportion, the flange's concave bite between its screws now drawn; the trip-spring bracket as Fig. 14 and the video (11:08) draw it, Review-results 20*; *read on video, 2 October
   2026, 11:46–12:22: about 42 teeth, not 52; the click as the model's, holding
   the same way; its spring a flat band wrapping about 180° round the ratchet,
   as Fig. 108 draws it, where the model's is about 120°; *now so*: 42 teeth,
   the spring a band on edge round half a turn, the cover's feet outside it;
   RESOLVED.md, Winding and maintaining work*), the dust seal, the detent's
   trip-spring bracket.
3. *The click's pivot moved to 8.95 mm and the ratchet to tips at 7.05 (3 October 2026, later): both photographs and the video measured against the cover screws' holes; RESOLVED.md, Setup.* *The click's pivot settled (3 October 2026): at the video's 10.25 mm, its tip at the teeth's root, 0.52 mm inside their tips; bom.py's check wants it seated over 0.3.* *Done (2 October 2026, `tools/bom-fn.js`), the setup click included: it holds
   the arbor the right way, but its tip seats only about 0.1 mm inside the
   teeth's tips (of a 0.8 mm face): the click lies nearly tangent from a pivot
   9.25 mm out (traced on the top-view photograph), where C Spinner's video
   (11:58) reads it about 10-10.5 mm out, 5.3 mm long, its tip 32 deg round,
   which puts the tip at the root. Open: the pivot's place, photograph against
   video, and with it the click's length and its spring's end.* **Function
   checks** in `bom.py`, worked through the page's own controls on a fresh page:
   the locking arm stops the balance with its finger at a timing weight and it
   doesn't restart by itself, the twist starts it, the train-blocking screw
   holds the train and lets it go, the shield plate covers the key hole and
   opens onto it, the latch holds the case to the box. The setup click's
   direction waits on a reading of the setup ratchet. Before (the locking arm,
   train-blocking screw, twist to start, the setup click's direction, shield
   plate and latch):
   `maintaining.py`, `escapement.js` and `invariants.py` cover the maintaining
   work, the escapement and the train's arithmetic.
4. *Done:* **The other checks after these geometry changes.** `fine.py`
   (also `--hold`, `--dense` and the timing weights at ±3 turns),
   `maintaining.py`, `audit.py`, `solids.py` and `bom.py` pass. `fine.py` found
   three new contacts: the balance hub's boss was solid round the turned staff
   (now bored r 0.45, a press fit), the winding-pawl springs' screw heads
   touched the fusee's underside that turns over them (now 0.15 tall), and the
   barrel cap's screws stand in the lip inside the rim (an intended contact,
   added to `EXPECTED`). The 15 `EXPECTED` entries nothing matches any more
   (the hands on their arbors, the impulse jewel in its roller, pivots in their
   holes, the stud's steady pin, the sustaining spring's pin and others) are
   removed.
5. *Done (4 October 2026, `claude/shape-pass`): `bom.py` runs in `ci.py --full`.* `bom.py` in CI: about 5 minutes a run.
6. *Closed (4 October 2026): measured on the restoration video (13:49.5, 14:45, 34:30), the third arbor now 16.55 mm from the centre at 149° from the 12, the wheels' sizes from `MOD` (RESOLVED.md, Going train, `a237869`).* **The third arbor's place** (fidelity, was open). Mapped through the centre,
   the fusee arbor and the wind indicator wheel (which land within 0.8 mm of
   the model), a photograph of a Model 21's dial side puts the third lower
   setting at about (-8.0, 18.6), 7 mm from the model's T (-4.86, 12.11), and
   the lower train bridge at about 34 deg against the model's T-F line at 68.
   T is solved for clearance (README, step 5), and Fig. 67's fit lands a hole
   within 1-2 mm of it, so it is left; a clearer photograph of the dial side
   or of the train would settle it (moving T changes the centre and third
   stages' modules).
7. **The train-blocking screw's place** (fidelity, narrowed 1 October 2026).
   A side photograph (omegaforums, "Incoming Hamilton Model 21") shows its dog
   point entering the fourth wheel at about 0.7 of its radius (about 7 mm from
   the arbor), and the restoration video's bridge (36:01) has it 6.9 mm out,
   between the fourth's setting and the lug at that end. The model has it
   5.0 mm out, toward that lug, where its access hole clears the balance
   locking arm's screw and pin ("The balance lower bridge", 7 and 8); no
   longer at either countersunk hole of the top-view photograph. Still open:
   the 7 mm (4 October 2026: the model's is 6.0 mm from the fourth's arbor, at (3.9, 26.15); moving it waits on
   `claude/lock-arm-shape`, which reworks the locking arm whose screw it clears).
8. **A second capped post and a Y-shaped arm** (fidelity, noted). The top-view
   photograph's movement (2E11795) and others (omegaforums, Delaney No. 8854)
   have a second post with a cap near the fusee's, carrying a long Y-shaped
   arm over the balance whose tips reach the rim: probably the Navy's "balance
   stop" (Sec. I: "Certain instruments have been modified by the Navy to include
   a balance stop"). 2E12055 and the manual's figures have none; the model has
   the manual's locking arm (Fig. 9) instead, and leaves the stop out. *Built as a
   variant (2 October 2026; Variants, Balance stop): shape and place mapped from
   the top-view photograph; the manual's "balance stop" (Sec. I) turns out to be
   Fig. 9's arm, so how the Y-arm works is estimated (README, "Estimated").
   Rebuilt 3 October 2026 (`claude/navy-yarm`) from the photograph at full size:
   the post is a second dust seal like the fusee's (body, flange and screw, black
   packing rings, a plunger head with a hex socket screw), and the arm one broad
   satin plate, its outline traced and registered on the post and the balance.
   Rebuilt again the same day from photographs taken straight above (Delaney No.
   8854 and another): the arm is a lever, screwed on a shouldered stud in the
   barrel bridge's pillar screw's place, under the cap to a crossbar with an eye
   and a pin at each end, symmetric (an arch, level arms).* *The restoration video's
   movement (2E8489) has this stop: close from above at 5:10 (4K), unscrewed and lifted
   off with its white seal at 6:15-6:24 (References/VIDEOS.md; found 4 October 2026).*
9. **The balance locking arm against Fig. 9 and Fig. 108** (open, 4 October 2026,
   `claude/locking-arm`). No photograph or video of the arm fitted has been found
   (`KLUwI2UUCMQ`'s movement and the top-view photograph's carry the Navy's Y-arm,
   8 above; RMG's 4E019, a Model 221, has neither; a web search found no other), so
   Fig. 9, Fig. 108 (item 31) and Secs. III and X are the only sources. What
   matches: the four parts and their numbers (108-31 to 34, read on the page), the
   screw outside the rim, the end holding a timing weight, the counterclockwise
   lead of Sec. X. What differs, each read on the figures:
   - **The swing** (fairly sure): Fig. 9's hatched curved arrow and dashed unlocked
     arm turn the arm out, away from the balance, toward the barrel bridge's horn;
     the model turns it 120 deg in, its end passing 7.4 mm from the staff under the
     balance.
   - **The shape** (moderately sure): Fig. 9 draws a strip curved along the rim,
     Fig. 108 a short flat lever with a raised round boss at its screw; the model's
     is straight (bowed 0.25 mm) with a plain washer and a round finger 2.4 mm tall
     that neither figure draws (Fig. 9's end seems to rise to the weight).
   - **The length** (not sure): about 4-5 screw heads in both figures, about
     7-10 mm; the model's 13.

   What the model's layout allows (plan of the train bridge round the balance,
   from the built model): the balance's sweep at the arm's height reaches r 17.35.
   The weight on the cock's side (the model's) rests under the cock's foot's span
   (the foot covers 15-76 deg from the staff beyond r 17.4); the other weight has
   3.1-3.7 mm of train bridge outside the sweep before the barrel bridge's edge
   (r 20.4-21.1; the bridge sits on the train bridge, 3.42 mm thick). The rest
   angle the weights take is the real one: the restoration video at 6:29 and RMG's
   4E019 both show the crossbar along the cock's arm at rest, as the model has it.
   Read with this layout, Fig. 9's scene fits the model's place: the cock's foot
   behind, the weight on its side in front of it, the arm's screw in the open
   6 o'clock sector, the barrel bridge's raised horn and its large screw (-23.9, 23.0)
   beyond. So the screw's place stands; but the outward swing has no room there:
   the second train pillar's screw head (5.5, 34.0; r 2.9, 1.6 mm proud) stands
   4 mm out from the arm's screw, and the cock's foot beside it. Either the arm
   rides higher than the model's (on its shouldered screw, over that head; Fig. 9
   draws a collar under the screw's head) or Fig. 9 simplifies. *To settle:* a
   photograph of a Model 21 overhauled after 1947 with the arm fitted (Bureau of
   Ships sketch 023263). Until then the model keeps its place and inward swing;
   the shape (a strip curved along the cock's foot, a boss round the screw) can
   follow the figures without moving anything.
   *Worked again (5 October 2026), from the manual's Fig. 9 at 400 dpi:*
   - **The bug is real.** The model's arm turns 120° inward, and its finger, standing 2.4 mm up into the rim's height band, passes 6.97 mm
     from the staff at 50° into the turn: through a balance at rest. `fine.py` doesn't see it, since it tests only the locked and unlocked
     states, not the swing between them.
   - **The model's layout has no room for any swing.** Turned outward (Fig. 9's way), the arm meets the cock's foot by 30° and a train-bridge
     screw head by 90° (`fine.py --eval "__mv.userData.stop('arm')"`).
   - **Fig. 9 is not to scale.** Fitted on its rim (an ellipse about the hairspring's axis, about 48 px/mm, the view about 24° above the plane),
     it draws the hairspring 11.6 mm tall against the measured 6.4. It is an illustration, so it can't place the arm in millimetres.
   - **What it does support:** an arm about 4-4.5 of its screw's heads long, 6.4-7.1 mm at the rim's scale (the model's 13), a curved strip with a
     round end, swinging out round the front of its screw toward the barrel bridge's large screw.
   - **Shortened to 7 mm along its present line**, the arm's screw lands on the escape upper bridge, so the real arm stands elsewhere in plan,
     and nothing measured says where.
   *To settle:* a photograph of a movement with the arm fitted (none found on the web, 5 October 2026). Until then any new place is a fit for
   room, which `claude/lock-arm-shape` was faulted for; the model keeps its arm, with the swing's fault recorded.
   *Read again (18 October 2026, triaging `claude/lock-arm-shape`), Fig. 9 at 900 dpi and Fig. 108 at 1,000-1,400 dpi:*
   - **No boss round the screw** (fairly sure). Fig. 9 draws the screw's head, a turned collar under it and a washer with a milled edge
     (42251, Fig. 108's item 33) straight on the flat strip; Fig. 108's item 31 is a strip whose screw end is plain and rounded. The round
     raised piece read above as a boss at its screw (and drawn on `claude/lock-arm-shape`, `22b1290`) is the arm's other end.
   - **The end is an eye, not a finger** (fairly sure). Fig. 108's item 31 ends in a round eye with a hole, standing out of the strip's plane
     (its ellipse turned against those of the plate's holes); Fig. 9 draws the same thing locked: the strip, lying low, bends up at its end
     into an upright round eye, and the timing weight (a slotted cylinder, its screw's threaded end out beyond it) stands in its hole. That
     is Sec. X's "place the locking arm over the timing weight": the eye holds the balance both ways, and comes off the weight as the arm turns
     out. The model's 2.4 mm finger beside the weight is drawn by neither figure. Fig. 108 draws the eye about twice the strip's width across
     (not to scale; not sure).
   - **Not ported.** `claude/lock-arm-shape` built such an eye (`02afce8`), but bent down from an arm moved onto the barrel bridge's top at the
     other weight and turning 2°: Fig. 9 has the arm low, beside the barrel bridge's raised horn, bending up into the eye, and swinging well
     out (its hatched arrow), so that place is a fit for room. At the model's place the eye has no room to come off the weight: there the
     cock's foot stands 0.30 mm outside the balance's sweep (that branch's search over the built model, 4 October 2026). Drawing the eye means choosing the arm's place, which still waits on
     a photograph of an arm fitted.

## Open questions, to settle from video (1 October 2026)

What the manual and the photographs so far leave open, gathered in one place so
videos of a Model 21 (taken apart, or turning) can settle them. Each says what
the model does now, why, and what a video would have to show. Plan positions
are in the movement frame (mm; 12 o'clock −z, 3 o'clock +x). When one is
settled, change the model, record the fix in `RESOLVED.md` and strike it here.

### The balance lower bridge (42065)

Rebuilt on 1 October 2026 after the restoration video (`References/VIDEOS.md`,
`KLUwI2UUCMQ`): at 36:01 the bridge on the upturned train bridge, put in
millimetres through a camera fitted to the train bridge's rim and its round
settings, and turned onto the model by the centre, third and fourth settings
(`tools/lower_bridge.py`, `verification/lower-bridge-comparison.png`). The
lower tier is one slab shaped as an L round the escape arbor, with a lug and
screw at each end of the bridge's long axis. The earlier model (a frame of
lobes round the escape wheel, both screws at the fourth end, after three holes
on the top-view photograph) had the right parts in the wrong arrangement.

Rebuilt again on 2 October 2026 (branch `claude/lower-bridge-curved`): the L
was the model's arbors bending the video's outline, not the bridge's shape.
Measured face-on at 13:49.5 (`tools/framecam.py`, the camera recovered from the
frame's anchor on the train bridge's rim, barrel cut and centre bushing; the
picks back at their heights), the real slab is a lens in the train bridge's
frame, which is the model's, and it already holds the model's balance and
fourth arbors. The model now draws that lens where the real bridge is, with
two levels (the slab, and a lug at each end against the train bridge), and
changes it only round its own arbors (1 below).

1. **Its outline.** Settled: measured (2 October 2026). Seen from below, the
   slab is a lens: an outer edge on a circle of r 20.8 (0.2 mm rms over 13
   points) from the 3 o'clock lug round past the centre arbor, a flatter
   convex edge (r 25.7) to the fourth's end, a straight edge across it, a
   short one to the train bridge's escape lobe, and a concave edge on the
   lobe's circle (r 7.14, 0.04 mm rms; the lobe from above, 18, r 7.0), so
   the escape wheel lifts out past the slab; a chamfer about 1 mm wide round
   its convex edges. Fig. 110's C round a large opening is that concave side.
   The model draws it as measured, and changes it only round its own arbors,
   which stand off the real ones (14): a bulge of about 1 mm to keep 1 mm of
   metal round the cap's counterbore and the fourth's sink, a bite r 2.4
   round the escape arbor (0.5 mm inside the lobe's circle in the model), and
   1 mm off the third arbor. Sure: ±0.5 mm over focal lengths of 5000–7000
   px; the picks to about 0.3 mm. Earlier (1 October) the outline was read on
   36:01 through a camera turned onto the model by its centre, third and
   fourth arbors, which bent it into an L round the model's arbors.
2. **Whether the upper tier is one piece.** Settled: two. Side-on (42:56)
   the escape wheel shows between the slab and the train bridge, with stepped
   lugs rising to the train bridge at both ends and nothing against the train
   bridge between them.
3. **The arm's route.** Settled: there is no separate thin arm. The "arm" of
   Fig. 30 is the slab's end toward the 3 o'clock lug, past the escape lobe
   on its outer side. The model draws it so.
4. **The heights.** Settled to about 1 mm. By the pillars (16.8 mm) on three
   side views the slab stands at 8.8–11.9 mm above the plate (its underside
   8.4–9.4), the model's at 7.9–10.9; the escape wheel at 15.6, the model's at
   15.1. Kept.
5. **The screws.** Settled. The real bridge's two screws are at the ends of
   its long axis, 33.3 mm apart at 13:49.5 (33.9 on 36:01, 31–36 on the other
   frames). The model has both where 13:49.5 puts them, (20.70, 7.23) with the
   pillar plate's access hole (RMG No. 4E019) under it, and (−9.18, 21.87), in
   the train bridge's frame (since the 14° turn (18.34, 12.02) and (−14.20,
   19.00) in the model's).
   36:01 had the 3 o'clock one at (20.5, 12.4), 4.7 mm away: that frame is
   turned onto the model by its centre, third and fourth arbors, and the
   fourth stands 4.3 mm off the real setting (14). The far lug is the video's
   less where the model's detent, the pillar, a barrel-bridge screw and the
   balance locking arm's screw and pin stand. The tapped hole the top-view photograph shows at (11.24, 29.51)
   isn't this bridge's; what screws into it is still open.
6. *Left estimated (3 October 2026): no frame can show them (hidden in the joint), so the model keeps one in each
   lug, as the parts list's "complete with pins" allows; the README's "Estimated" list says so.* **The steady pins.** Open. None show on the bridge's faces; pins between
   the bridge and the train bridge would be hidden in the joint. The model
   puts one in each lug.
14. **The settings' spacing** (new). Measured with the camera (2 October
   2026, `tools/framecam.py`): in the train bridge's frame the cap's jewel is
   at (3.79, 9.75) and the fourth's setting at (2.89, 20.73), 11.0 mm apart,
   the escape lobe's centre at (13.81, 15.51); the model's balance is 5.2 mm
   from the cap and its fourth arbor 4.3 mm from the setting. Across focal
   lengths of 5000–7000 px these move 0.5 mm or less. So the layout question
   stands as below, now on one frame anchored on the bridge itself. The face-on underside gives the
   bridge's own proportions, without naming any train-bridge hole. Cap to
   escape passage, cap to fourth's setting and escape passage to fourth's
   setting are 8.6 : 10.8 : 11.6, with the angle at the cap about 73°. The
   model's balance, escape and fourth arbors are 9.4 : 18.9 : 10.6, nearly in
   a line. Two independent rulers give the same millimetres. The train
   bridge's rim and barrel cut give 35–39 px/mm, and the escapement's 9.4 mm
   from balance to escape gives 37.8. The balance-to-fourth distance is
   10.8–11.8 mm against the model's 18.9. Two other readings agree with a
   train laid out differently from the model's:
   - the third bushing lands 16.8 mm from the centre on this frame and
     16–19.7 on the bare plate (finding 12; model 13.05);
   - the counted wheels' size ratios (centre ÷ fourth 1.48–1.5, VIDEOS.md)
     with the third at 16.8 make the escape-to-fourth distance about 11.2 mm,
     as the bridge shows (model 10.6).

   **The balance: applied** (2 October 2026, IDEAS.md 1.12): it now stands on the cap (with the fusee and
   barrel, one similarity of the photographed group), and the train bridge's balance lobe at 23:30 is
   centred 0.6 mm from it. The fourth is still 3.9 mm off its setting, and the balance 13.7 mm from it (the
   video's 10.8-12): open with 1.11.
   The model's balance (triangulated from two photographs) and fourth arbor
   (under the seconds hand) are its best-founded positions, so a balance only
   11 mm from the fourth is hard to reconcile with them. Something in that
   chain is wrong, and it is bigger than this bridge: settling it would move
   arbors (`L`), the modules and the escapement's direction. A video should
   show: a face-on underside with a part of known size beside it, or the
   seconds hand and balance in one top view.

   A third reading (1 October 2026, `tools/rimfit.py rimfit_36-01.json`):
   36:01, the bridge on the upturned train bridge, through a perspective
   camera fitted to the rim with the gilt settings made circular, the slab's
   points put back at their height (8.9 mm). The centre arbor's setting
   lands 1.0 mm from the rim's centre; turned by the centre, third and
   fourth settings (1.0, 1.8, 1.5 mm off), the cap is at (3.8, 11.5), 12.0 mm
   from the fourth's setting, and the escape opening's centre at (11.5,
   16.3), steady over focal lengths of 5000-8000 px. It agrees with 18's
   train-side fits (balance lobe about (5.4, 10.4)), and shares their
   assumption, the rim a 40.5 mm circle about the centre arbor; 18 sets them
   against the top-view comparison and the dial side, which agree with the
   model. The bridge is drawn round the model's arbors meanwhile. With the
   photographed group turned 14° ("Elsewhere", 19, applied 2 October 2026)
   the model's balance is 16.6 mm from the fourth and 3.8 mm from the
   video's cap; the escape arbor 3.2 mm from the video's opening.

   A fourth reading, from the other side (1 October 2026,
   `tools/anchors/KLUwI2UUCMQ_6-29.json`, `video.py fit` then `unproj`):
   6:29, the same movement from above with the cock on, its camera fitted
   to the barrel bridge's screws that `topview.py` maps the top-view
   photograph by (the setup cover's two, the train-bridge screw sunk through
   the bridge and the one beside it, the barrel pillar screw's empty hole),
   the cock's screw hole and the bridge's near rim. Rms 38 px (about 1.5 mm).
   The balance's endstone, put back at the cap's height, lands at (7.0,
   6.8), 1.0 mm from the model's balance; leaving out any one point or the
   rim keeps it within (5.9-9.2, 6.1-7.5). The fusee's winding post lands
   about 2.6 mm from the model's arbor. So this movement's balance sits
   where the photographed movement's does, relative to the barrel bridge,
   the fusee and the cock. That doesn't contradict 36:01: the model's
   balance, fusee, barrel and barrel-bridge screws all come from the same
   two photographs, and this fit can't see an error in where that group
   stands relative to the train (the centre, third and fourth arbors), which
   is what 36:01 and 18's fits measure the balance against. What would
   settle it: one frame with a train arbor and the balance (or the barrel
   bridge's screws) in it, such as 12:40-12:46 (the barrel bridge on, the
   balance's lower jewel and the escape teeth through the keyhole, the
   fusee and barrel arbors standing), fitted on the barrel bridge's screws
   and read at the slab's height. A turn of the photographed group about
   the centre would also move the fusee relative to the up-and-down
   indicator under the 12, so the indicator's gearing is a further check.
15. **The keyhole** (new). From below (13:49.5) the escape lobe is the oval
   passage above, through both bridges. The balance lobe is closed underneath
   by the lower bridge, with the cap at its bottom. The lobes' plan sizes wait
   on 14. A top-view reading (13:44) of two 5 mm lobes is withdrawn: its
   four-point fit had the handedness of a dial-side view, which a train-side
   frame can't have (VIDEOS.md, "Which part is which").
26. **Against a photograph** (new, 12 October 2026). A close phone photograph
   of a Model 21's upper train bridge underside up with the lower bridge on it
   (`References/photo-lower-bridge-underside.jpg`), its camera fitted on the
   train bridge (rim 0.07 mm rms, barrel cut 0.23, f about 970 px, fixed by the
   3 o'clock lug's screw head; `tools/anchors/photo_lower_bridge*.json`) and the
   model drawn through it. Confirmed: the arrangement (1-5), the two lug
   screws (0.7 and 1.1 mm from the model's) and the train-blocking screw's
   threaded hole in the slab (5.8-6.7 mm from the fourth's setting, the
   model's bearing within 5°; 7). The slab's outline agrees with 13:49.5's to
   1.2-1.4 mm rms, but only at a slab height of 4-6 mm off the train bridge's
   underside, where the cap's counterbore comes out 8.6-9.2 mm across (model
   8.6) and the cap 10.6-11.0 mm from the fourth's setting (13:49.5: 11.0); at
   the model's 8.9 they come out 7.4-8.0 and 9.2. The photograph's parallax
   can't be trusted for heights over the side views' 7.4-8.4 (4), so the slab
   stays; its height is in `OPEN-QUESTIONS.md`. The rest of the outline's
   differences (1-2.5 mm: a straight edge past the far screw where 13:49.5 has
   a corner, the settings 2 mm toward the fourth's end) are within the
   photograph's reach, and the model's own departures (the bulges round its
   arbors, the third arbor's slot, the train-blocking screw's column) are 1
   and 14's. No change.

### The train-blocking screw (42247)

7. **Where it stands.** Settled in arrangement: on the restoration video
   (36:01) its dog point is on the bridge's body between the fourth's setting
   and the lug at that end, 6.9 mm from the setting, not at either countersunk
   hole beside the fourth arbor on the top-view photograph. The video's place
   is covered by the model's detent, so the model puts it 4.5 mm out on the
   detent's other side, (−3.70, 26.50), 7.1 mm from the video's, in a column of
   its own from the slab to the train bridge, 1.1 mm off the detent (finding 7
   under BOM comparison is overtaken).
8. **How far out it stands.** The video's 6.9 mm agrees with a forum side
   photograph (omegaforums, "Incoming Hamilton Model 21"), about 0.7 of the
   fourth wheel's radius, about 7 mm. The model has 4.5, inside the
   fourth wheel's spokes and clear of the detent. Open with 14.
9. *Likely settled (3 October 2026): taken through the group's transform (`PT`) the hole lands at (-7.50, 19.55),
   2.2 mm from the train-blocking screw (-5.57, 18.55), whose access hole through the bridges is 2.3 mm across: it
   is that hole, the 2.2 mm the same order as the photograph's other offsets from the video here (pillar 1, 4 deg).
   Nothing changed.* **A dark hole near the escape wheel.** About 2.5 mm across, at about
   (2.7, 18.1) on the top-view photograph, partly under the balance locking
   arm: 4.9 mm from the escape arbor, over the escape wheel's teeth, so not
   the train-blocking screw's (its wall would stand in the wheel). The model
   has no hole there. A video should show: what lies under it, or what goes
   through it.

### Elsewhere

10. *Settled (2 October 2026; 18 and 24): the escape arbor 9.40 from the balance toward the jewel seen from
    above, on the video's train.* **The escape wheel's place.** Through the train bridge's keyhole, under the
    balance rim, the top-view photograph shows a steel plate with a jewel and
    a screw hole a few millimetres from where the model has the escape wheel's
    upper jewel (its comparison, `verification/topview-comparison.png`, puts
    the model's jewel in the keyhole's dark part). It may be the escape upper
    bridge seen at an angle, or the model's escape arbor may be off. The
    escape wheel is 9.40 mm from the balance by the escapement's figures
    (README, step 5); only its direction is fitted. A video should show: the
    escape upper bridge and its jewel from straight above, with the balance
    off.
11. *Settled: pillar 2 under it (BOM comparison, Still open 1).* **The upper train bridge's third screw** (finding 1 under BOM
    comparison; IDEAS.md 1.2): at (−8.5, 27.7), with no pillar under it in the
    model. A video should show: the train bridge coming off, and what the
    screw holds.
12. **The third arbor's place and the wheels' sizes** (finding 6 under BOM
    comparison). *The block's notch round the third arbor is gone (3 October 2026): since the layout move the block
    stands 11.7 mm from it, at Fig. 90's length (20.2).* **Settled for the arbor, the wheels and the pillars** (the
    model now has the third arbor at (−6.18, 14.75) and the measured pillar
    profile; RESOLVED.md). Still open: the detent's support block, which the
    model notches round the arbor and shortens to clear the pillar, in the
    escapement plan's place. Measured on the video (`KLUwI2UUCMQ`, 1 October 2026):
    - On the train bridge's underside (13:49.5), anchored by a homography on
      five real holes that match model holes to 0.2–0.6 mm (the centre
      bushing, two pillar screws, the tapped hole at (11.24, 29.51) and the
      sustaining pawl's pivot), the third arbor's upper bushing is at
      (−6.18, 14.75): **16.0 mm from the centre**, in the model's direction
      (22.7° from the 6 o'clock line against 21.9°) but 3 mm farther out.
      On the bare plate (14:45, rectified by the rim and the centre bushing)
      15.7 mm; the rough affine fit gave 16–19.7, the dial-side photograph
      about 7 mm off.
    - The model's wheels don't match the counted wheels' size ratios
      (VIDEOS.md: centre ÷ third 1.36–1.39, centre ÷ fourth 1.48–1.50). The
      model's are 1.01 and 1.23, because `MOD` follows the arbor spacing and
      the third arbor is too near the centre.
    - With the third arbor at 16.0 mm and the fourth at the seconds
      (0, 23.9), those ratios put it at 24.8° from the 6 o'clock line
      (measured 22.7°): (−6.71, 14.52). The modules become 0.314 / 0.256 /
      0.249 and the tip radii 14.4 (centre) / 10.5 (third) / 9.6 (fourth),
      against 11.8 / 11.6 / 9.6. The fourth wheel and the escape spacing are
      unchanged (0.1 mm).

    Tried in the model: only `L.T` changes, and `MOD` gives the video's
    ratios. `solids.py` passes. `fine.py` finds two new overlaps, both with
    estimated parts: the third arbor 3.2 mm into the detent's support block
    under the train bridge (its screw matches a real hole, its outline is
    drawn), and the third wheel's teeth 0.65 mm into the foot (r 3.4,
    estimated) of the train pillar at (−16.63, 22.48). Not committed.

    Then measured:
    - **The pillar** (42:56, side-on, scaled by its 16.8 mm height; ±0.15
      mm): a straight shaft r 2.7 with a collar at each end, the foot r 2.9
      over its bottom 3.3 mm and the top r 3.3 over its top 3.4 mm. The model
      has the foot r 3.4 over 1.3 mm, a neck r 2.3 under the top, and the top
      r 2.9. With the real foot, the third wheel clears the pillar with the
      third arbor at the measured (−6.18, 14.75) (0.05 mm) but not at the
      ratio-implied (−6.71, 14.52) (−0.68 mm). The pillar's place is right:
      the anchored frame puts it on a real pillar-screw hole.
    - **The detent's support block.** **Set aside (1 October 2026): the
      reading below rests on the five-hole fit of 13:49.5, which three
      searches showed can't be trusted (18), so nothing reliable puts the
      block anywhere but Fig. 90's place; it stays there. Low priority: the
      block is hidden under the train bridge and changes nothing in the
      running.** On the anchored underside (13:49.5,
      the detent off) the model's block lies across the real lower bridge's
      second lug and its screw, and there is no hole at the model's block
      screw (−13.67, 18.21). So the real block is elsewhere. The block's
      place comes from the escapement plan (Fig. 90 as Rawlings redrew it,
      `shared/escapement.js`: the detent at 68° in the escapement's frame,
      the block 1.5–0.9 escape radii along it), turned to the balance–escape
      line, which puts it toward 9 o'clock. The only unexplained hole near
      the keyhole on the underside is on the other side of that line, at
      (9.24, 20.86), 5 mm from the escape arbor, with a curved slot beside
      it. (That fit was on five holes only, and the model's holes are about
      10 % too near the centre. Refitted on the rim and the barrel cut, the
      hole is at (11.79, 22.41), and it is an escape upper bridge screw's,
      17 and 18.) From above (10:45–10:48) the block's screw is taken out at the
      train bridge's edge below the keyhole. ~~If that is the block's screw,
      the plan is mirrored about the balance–escape line.~~ It isn't (16):
      the plan can't be mirrored, and the hole is not where any part of the
      block could be, in either handedness. Where the block's screw is could
      still be read on the top view (10:47), with a fit that can be trusted.
16. **The escapement plan's orientation** (started 1 October 2026, branch
    `claude/escapement-plan`). **Settled: not mirrored.** The model's plan is
    right as it is, and nothing in `shared/escapement.js`, the detent or the
    essay changes. Three things fix its handedness, none of them from a video:
    - **The train.** The fourth wheel carries the seconds hand (clockwise on
      the dial) and drives the escape pinion directly, so the escape wheel
      turns anticlockwise seen from the dial, clockwise seen from the train
      side. The model does (`update()`: centre −, third +, fourth −, escape +
      in `rotation.y`, about +y toward the dial).
    - **Fig. 90.** Its teeth lead clockwise all round, and the locking jewel
      holds a tooth two pitches downstream of the pair at the roller, so the
      locked tooth pushes the detent toward its foot and support block. A
      plan mirrored about the balance–escape line keeps the train's direction
      only with the wheel running backwards against its teeth. The solver has
      Fig. 90's arrangement: the wheel turns to −angle, the locking tooth at
      t0 − 2P, and the tooth's motion there is along −dirB, toward Ft (cosine
      −0.98). Its unit frame maps (x, y) to the movement's (x, z), which seen
      from the train side is a half turn, not a mirror.
    - **Ops. 85–86.** The balance is read against a sector on the upper
      train bridge, so seen from above, and turning it anticlockwise lifts the
      detent off its stop button. In the model the unlocking swing is
      anticlockwise seen from the train side, as in Fig. 90.

    The evidence for a mirror was the hole at (9.24, 20.86) (item 12). It is
    in the train bridge itself, just past the slab's corner (checked on the
    full 4K frame 13:49.5), so the homography on the bridge's holes places it
    well: 5.2 mm from the model's escape arbor and 14.1 mm from the balance.
    A mirror about the balance–escape line keeps every point's distance from
    both arbors. Those two distances put the hole almost on that line,
    beyond the escape arbor (31° off it), over the wheel's spokes. In Fig. 90
    nothing of the detent is there in either handedness: the block runs off
    to the side, below the wheel's centre. So the hole is not the block's
    screw, mirrored or not. More likely it is a screw of the escape upper
    bridge (17).

    Tried before this was settled:
    - the detent held up to the camera (11:04–11:30): too overexposed and
      oblique to read which side of the blade the locking jewel and horn lie;
    - the dial side face-on (40:08): a search matching the model's dial-side
      features (centre, fusee pinion, studs, pillar screws, the bar's settings
      and screws, the escape jewel) to the frame's finds no consistent fit
      (6 of 14 at best, pairings that make no sense). The ring's inner edge
      fits a circle centred near the bar's middle, not on the tall arbor the
      motion work goes on. The features need naming first, by following the
      motion work going on (40:14–40:44) and the bar going on (34:52–35:12).

    What stays open is where the plan sits, not which way round it is: the
    direction of the escape arbor from the balance (only fitted; 10) and the
    balance-to-fourth distance (14). The plan turns with them, and the block
    is about 20 mm from the balance, so a few degrees move it millimetres.
    The detent's block (12) is placed once those are settled.
17. **The escape upper bridge (42064)** (new, 1 October 2026). **Rebuilt again
    (2 October 2026, `claude/fp-layout`) as measured below: the bar 5.2 x 1.0, the boss and
    thickening under it, the flat-sided cap sunk flush, flush end screws, steady pins.
    Open: the seats in the train bridge, the cap's conical window.** *Both done (3 October 2026,
    `claude/fp-finish`): the ends lie in seats sunk 0.3 (estimated) in the train bridge's face
    (`TB_SEAT`, `tools/train_bridge.py`), the bar and the escape arbor's top pivot lowered with them;
    the cap's window a 90 deg cone r 1.55 down to the endstone, its screws' heads r 0.75 as the
    frame shows them. The balance lower cap's window a straight bore r 1.1, its heads r 0.5 (13:49.5).*
    First rebuilt
    (1 October 2026, branch `claude/escape-arbor`; RESOLVED.md): a bar
    across the keyhole, symmetric about the jewel, a screw near each end, a
    round cap. Still open: its thickness and the boss under the cap, its
    steady pins, the end screws' countersunk heads, the cap's edge on the
    keyhole side (cut straight, parallel to the bar, and stepped down on
    the frame; the model's cap is a plain disc), and the two other
    endstone caps of the same part (42159), which look round too. From above
    with the bridge on (`KLUwI2UUCMQ` 10:00), it is a long straight plate,
    rounded at both ends, with the jewel and its two-screw endstone cap in
    the middle and a screw near each end, symmetric about the jewel. It spans
    the keyhole's escape lobe. The model's bridge is a stadium from 1.5 mm
    behind the escape arbor to 7.5 mm beyond it, with both screws beyond it
    (4.3 and 6.6 mm along the balance–escape line). Certain for the form, by
    eye. The end screws are about 2.5 times as far from the jewel as the
    cap's screws (about 5 mm if those are the model's 2.1 mm, which is
    estimated). That would fit the hole at (9.24, 20.86), 5.2 mm from the
    escape arbor, as one of them. Its partner would then be about as far on
    the other side of the arbor, which is inside the model's keyhole if the
    model's escape arbor is right: one more sign that the arbor's direction
    (10) is off. Not changed: the bridge's direction and length wait on 10
    and 14. A video should show: the bridge's screw holes on the bare train
    bridge from above (13:44, once anchored on matched holes).

    Measured again (2 October 2026; `References/VIDEOS.md`, "The escape
    upper bridge, close"): the bar 5.2 mm wide (model 4.0), 0.9-1.1 thick, flat;
    under its middle a round boss r 3.8 hanging 1.5 mm into the escape
    passage; the end screws countersunk, flush; the ends in recessed seats in
    the train bridge, each with a steady-pin hole 1.6 mm further out and 1.3 mm
    toward the balance; the cap a disc R 4.1, about 1 mm thick, sunk flush in
    the bar and cut flat on both sides with the bar's edges. **Waits on the
    escape arbor's place** (24): the model's arbor stands 3.2 mm from the
    keyhole's edge, so a boss of r 3.8 would cut the train bridge; the
    bridge is rebuilt with the arbor's move. The balance lower cap (round,
    one flat) is built (`claude/fp-escape`); the detent block's far pin waits (20.2).

    Measured (18): the end screws are 8.3 and 8.6 mm from the jewel, not 5,
    on a line about 3° off the 6 o'clock line, and the cap's screws 3.3 mm.
    The hole at item 12's (9.24, 20.86), re-placed at (11.79, 22.41) by a
    better fit, is 1.1 mm from the end screw at (12.49, 21.54) found from
    above on another frame, so it is that screw's hole.
18. **The escape arbor's place.** **Settled: the model's stands; the
    40–45° reading below is withdrawn.** The escape arbor isn't free: it
    must be 9.40 mm from the balance (the escapement) and about 10.6 mm
    from the fourth (their mesh), and the fourth is under the seconds hand
    (manual, p. 15). Given the balance and the fourth, that leaves one place
    for it, which is where the model has it. The balance is the model's
    best-founded position: triangulated in two independent photographs, the
    axes within 0.16–1.43 mm over eight seeds (README, "How the layout was
    measured", 1, 6). It is also checked independently by
    `verification/topview-comparison.png`, which warps the model onto the
    top-view photograph through five barrel-bridge screws, not the balance.
    There the photograph's endstone lands 2.7 mm from the model's, the
    photograph's tilt for a part on top of the cock, and the hairspring
    below it lies the other way, so the staff passes through the model's.
    A balance 11–12 mm from the fourth (14) would put it about 7 mm off,
    plain on that comparison. So the train-side fits below share an error,
    most likely their assumptions (the train bridge's rim a 40.5 mm circle
    about the centre arbor, the rotation from the third bushing). And 14's
    reading of the lower bridge's underside misnames or misscales a setting.
    The dial side (40:08, below) agrees with the model unrectified. What
    stands from the fits: the escape upper bridge's form and its end screws'
    spacing about the jewel (17), and the hole being one of them.

    The measurement, as made (1 October 2026, branch `claude/escape-arbor`). Three frames of `KLUwI2UUCMQ` were fitted with
    `video.py anchor` on the train bridge's rim (r 40.5 about the centre),
    its cut round the barrel and the centre bushing. The other holes are
    independent checks (fit specs in `tools/anchors/`).
    - **10:00, from above, the escape upper bridge on.** Rim 0.28 mm rms,
      centre and third bushings 0.17 and 0.16 mm. The escape jewel is at
      **(12.90, 12.90)**, the bridge's end screws at (13.25, 4.64) and
      (12.49, 21.54), the cap's screws at (12.95, 9.63) and (12.65, 16.19).
    - **13:44, from above, bare.** Rim 0.44 mm, the barrel cut 0.50. The
      10:00 points mapped onto it land on the two raised lugs flanking the
      keyhole's left pocket (the end screws) and at that pocket's centre
      (the jewel). The left pocket is the escape lobe, centred about
      (12.6, 15.4) with r about 7.0, room for the 13.16 mm wheel to come out.
      The right pocket, the balance's jewel at its bottom, is the balance
      lobe, centred about (5.4, 10.4) with r 4.9. Fitted without the third
      bushing (the barrel cut giving the rotation), the jewel stays at
      (12.92, 13.32) and the third bushing lands 2.85 mm from the model's,
      6° round and 18.25 mm out.
    - **13:49.5, from below.** Rim 0.22, the cut 0.24, the third bushing
      1.09 mm from the model's as a check.

    (Withdrawn, above.) So the escape arbor is about 18 mm from the centre, as the model has it
    (17.7), but 40–45° round from the 6 o'clock line toward 3, not the
    model's 24°: about 6 mm from the model's (7.19, 16.14). The scale rests
    on the rim's 40.5 mm (the third bushing reads 16.9–18.3 mm on these
    fits against 15.7–16.0 by other methods, so up to 10 % large). The angle
    doesn't depend on the scale, and every fit gives it.

    **It contradicts the train.** The escape pinion meshes the fourth wheel,
    about 10.9 mm apart. With the fourth arbor under the seconds hand at
    (0, 23.9), the escape arbor can be at most 27° from the 6 o'clock line.
    At 44° it would be 16.6–17 mm from the fourth. The jewel to the balance
    lobe's centre is 7.9 mm, against the escapement's 9.4. If the escape
    jewel and the third bushing are right, the meshes put the fourth arbor
    near (4.1, 19.3), 6 mm from where the seconds hand puts it. Either the
    model's fourth arbor (and with it the seconds hand's place on the dial)
    is off, or these fits share an error that the frames can't show: they
    all assume the rim is a circle about the centre arbor, and the cut's
    centre where the model has it. **Not changed in the model.** Next: a
    frame with a ruler from the manual (the plate's 87.57 mm rim) and the
    fourth arbor in view, from above with the train in (13:51–13:54), or
    the bare plate (14:36–14:45), where the fourth's jewel and the escape
    arbor's lower jewel are both in the plate's own face.

    **What the manual fixes** (no positions, but the identities). The fourth
    wheel's "long arbor … projects through the dial to receive the second
    hand" (p. 15), so the fourth arbor is under the seconds hand, at 6 (p.
    14; the seconds dial's centre about half the dial's radius out, so 23.9
    mm stands). The balance lower bridge carries the balance's lower cap
    jewel and the fourth's upper setting, and the lower train bridge the
    third's and fourth's lower settings (p. 14; bar-hole jewels, p. 17).
    Figs. 29 and 67 put the escape lower setting and endstone cap in the
    plate, beside the bar's fourth end.

    **The dial side, 40:08** (`KLUwI2UUCMQ`). Named by those figures and by
    the fusee's 12-leaf indicator pinion: centre bushing (2129, 1329), the
    third's setting at the bar's left end (2314, 1800), the fourth's (red
    jewel) at its right (2793, 1786), and the escape's capped lower jewel in
    a round recess above the bar's right end (about 2843, 1486). Unrectified
    (the plate tilted about 40°), the escape jewel is 26° round from the
    centre-to-fourth line, and 0.44 of that distance from the fourth. That
    is the model's 24° and 0.44, and it agrees with the train's mesh, not
    with the 40–45° of the train-side fits above. Foreshortening can bend
    angles by this much, so it settles nothing yet. Rectifying it on the
    plate's rim failed: the picks mix the plate's edge with the mounting
    ring's inner step (a free fit ran to a 1000 px focal length). Next: trace
    the plate's edge alone, on 40:05–40:20, and fit two frames together.
19. **The dial's 12-6 axis against the photographed group** (new, 1 October
    2026, branch `claude/balance-train`). **Measured: the fusee (and the
    barrel) stand about 13° further round from the 12 than the model has
    them.** Two independent readings:
    - **The dial side, rectified** (`tools/rimfit.py rimfit_40-08.json`;
      40:08, the motion work off). A perspective camera fitted to the
      mounting ring's bore (r 40.2) about the centre arbor's bushing: rim rms
      0.15-0.21 mm over focal lengths of 4000-8000 px, the centre arbor
      within 0.1 mm. About the centre, from the indicator's stud (at 12): the
      fourth's jewel (the seconds) 176° (model 180), the minute wheel's stud
      86-91° (model 90), **the fusee's bushing 43-45° (model 30.3)**, the
      bushing taken for the barrel's -77 to -81° (model -89.4). The fusee
      at r 21.8-22.7 (model 22.9). This rectifies what 18's last paragraph
      read unrectified.
    - **The indicator wheel's size** (23:30, laid flat; the 120-tooth wheel
      counted there): its tips about 35-38 mm across against the train
      bridge's rim beside it (r 40.5), perhaps 5-10 % less for its being
      nearer the camera; the model's is 22.4 mm (module 0.186, from the
      fusee's 12.3 mm from the indicator). With the fusee's 12-leaf pinion,
      a wheel that size needs the fusee 18-20 mm from the indicator's
      centre, 45-52° round from the 12: the dial side's 43-45°.

    So the model's photographed group (balance, fusee, barrel, the bridges,
    the cock) is turned about 13° from the dial and the train, or the dial
    and the train about -13° from it. The group's own internal layout stands
    (6:29 and 14; applied as one similarity, IDEAS.md 1.12, which also put the balance on its cap and so
    takes up 36:01's remaining angle; see 22: the bare plate, fitted again after the turn,
    puts the fusee 2.7 mm nearer the centre and the barrel and pillars 2.5-7
    mm further out, which no move of the whole group fits). Turning it brings the balance 16.7 mm from the fourth
    (model 18.9), toward 36:01's 12.0; that reading's remaining 18° is open.
    **Applied (2 October 2026, branch `claude/dial-turn`).** The photographed
    group turned 14° about the centre against the dial (`PHOTO_TURN`, `PT`
    in `movement.js`: the balance, fusee, barrel, pillars, bridges, cock,
    their screws and pins, the engraving, the damascening, the setup cover);
    the escape arbor solved again (9.40 from the balance, 10.585 from the
    fourth), with the escapement's plan, detent and keyhole; the lower bridge
    laid out again round the new arbors; the lower train bridge's bar
    shortened at the fourth's end, off a pillar's screw head. The indicator
    wheel is 32.5 mm across (module 0.266): its centre is 23.6 mm out, so
    it keeps inside the mounting ring's bore (40.2), between the pillar
    screws' heads and the hour wheel. Still open:
    - the indicator's radius: the restoration video's dial side puts its stud
      about 25 mm out and the photographed dial its sub-dial 1.13 times as far
      out as the seconds, which the ring's bore as drawn can't take with a
      wheel this size; the ring's bore or the wheel's height may be what is
      off;
    - the fourth's radius: the dial side gives 21.2-23.2 mm (the model 23.9);
    - 36:01's remaining 18° (the cap 12.0 mm from the fourth's setting, the
      model's balance now 16.6).
    - **the third arbor** (found merging main's train bridge, 2 October
      2026). The train bridge's underside (13:49.5) put on its face through
      the rim, the barrel's cut and the centre bushing (`video.py anchor`,
      0.2 mm rms) is in the photographed group's frame. Turned with it, the
      fourth's gilt setting lands 0.8 mm from the fourth arbor (5.3 before
      the turn), for the turn; but the third bushing lands at (−9.66, 13.90),
      3.6 mm from the model's third arbor (1.1 before), and 23:30 with the
      third named leaves it 3.1 mm off (0.5 before). So the bridge puts the
      third with the group and the fourth with the dial. The third arbor is
      held to the fourth by its wheel and the fourth's pinion (11.04 mm,
      module 0.245); at the bridge's place it would be 13.9 mm from the
      fourth and 16.9 from the centre, modules about 0.31 and 0.33, nearer
      each other than the model's 0.245 and 0.314 (12: the counted wheels'
      size ratios also disagree with the model's). The third wheel would then
      reach the train pillar at (−21.57, 17.79), 12.5 mm from the arbor, which
      the bare plate puts farther out (`References/VIDEOS.md`). Sure: medium
      (two frames agree to 1 mm; the third bushing is one pick a frame). Open
      with 12; the train bridge's outline is the group's, which this doesn't
      change.
20. **The detent against the manual and the video** (new, 1 October 2026;
    branch `claude/detent-fixings`). The escapement works as the manual has
    it: lock 6.0°, let-off 10.6°, overall 28.4°, drop 2.1°, roller shake
    0.055 mm and horn clearance 0.25 mm (`tools/escapement.js`). The tooth
    leaves the impulse jewel at 96 % of a pitch and drops onto the locking
    jewel, and the detent is back on its stop by 0.31 of a pitch. The
    detent's parts are Fig. 14's and the video's (`KLUwI2UUCMQ` 11:08–11:13,
    the detent held up, sharp): the long block stepped down toward the
    jewel, the foot with its clamp screw, washer and cross pins, the
    two-strip spring, cross-piece and angle bracket, the jewel standing in
    its block, the arm whose end bends down as the horn. The fixings were
    not:
    1. **The block's screw goes in from above.** Sec. II: the block "is
       fastened to the underside of the upper train bridge by means of one
       screw and two positioning pins". Fig. 14 draws a tapped hole in the
       block's top face, between the pins, and Figs. 22 and 84 the screw
       above the train bridge. On the video the screw comes out from above
       beside the keyhole (10:45), and the block's top shows the tapped hole
       (11:08). Op. 81's "Turn movement over. Install detent support block
       screw" follows Op. 80, done with the movement upside down (Fig. 89),
       so it brings the train side up. The model put the screw in from
       below (`e1244db`), because in its place for the block the barrel
       bridge's horn covered it. **Fixed** (2 October 2026, merging into
       `claude/dial-turn`): after the photographed group's 14° turn nothing
       stands over the screw, which now goes in from above. Sure: high.
    2. **The two positioning pins were missing.** Sec. II, Figs. 14, 22 and
       90, Op. 26 ("pushing nickel wire against steady pins"), the video
       (11:08). **Fixed on the branch**: two pins in the block's top, into
       the train bridge, and the screw between them, laid out from Fig. 90
       (scaled by the 11.3 mm from the point of flexure to the locking
       jewel): the screw 3.7 mm toward the foot from the point of flexure
       (it was 7.9), a pin 2.0 mm the other way. Fig. 90's other pin, 9.5 mm
       toward the foot, would stand past the train bridge's cut round the
       barrel in the model's place for the block; it is drawn 2.9 mm nearer
       the screw. Since the barrel's cut was refitted (23) there is metal there,
       and the video's holes (10:00, 10:50) put the pin there too, in line
       with the screw 5.7 and 5.5 mm either side. But it can't move alone:
       Fig. 90's block runs 15 mm toward the foot from the point of flexure
       and the detent's foot 17 (the adjusting screw beyond the block's end);
       the model's are 9.2 and 10.6, shortened to clear the train pillar.
       The pin, block and foot wait for the layout (24). **Fixed** with it (2 October 2026):
       the block 15 mm and the foot about 16.4 from the point of flexure, the pins
       symmetric. One more sign that the block is not where the model puts
       it (12, 16, 18), as is the third arbor 1.2 mm from the point of
       flexure, through a notch in the block. Sure: high on the pins; their
       spacing to about 0.3 mm on Fig. 90.
    3. **The trip spring's screw was upright**, a fine thread in the
       bracket's 0.23 mm leg with the spring held under its head. Op. 8 of
       the detent's reassembly: "place trip spring screw in the hole of the
       trip spring"; Fig. 14 and Fig. 54 (driven like the clamp screw) put
       it across the spring into the bracket's upright leg, and the video
       shows its head face-on (11:08). **Fixed on the branch**, the
       bracket's upright leg thickened to 0.36 mm to take the thread (its
       size estimated; on the video the bracket looks taller than the
       model's 0.4 mm). Sure: high.
    4. **The detent-adjusting screw didn't touch the detent**: its head
       stood 0.64 mm beside the foot. Op. 93 has it "screwed in against the
       detent" and Op. 84 turns it to slide the detent along. Fig. 90 draws
       it threaded into the block's end, its head standing in a slot across
       the foot, which runs on past it. **Fixed on the branch**: the foot
       runs 1.06 mm further (away from the barrel), slotted for the head.
       Sure: high that it bears on the detent; medium on the slot (one
       drawing).
    5. **The lock-adjusting screw stops 0.24 mm short of the stop button**,
       inside the block. Fig. 90 shows the block's front split by a long
       slot that this screw and its clamp screw cross, so the screw moves
       the button by spreading the slot ("working through the locking jewel
       button", Sec. IV). **Fixed** (2 October 2026, `claude/fidelity-plan`):
       the slot open at the button's end, the screw's point on the strip that
       carries the button, the clamp screw across the slot into it. Sure:
       medium (the slot is read from one drawing).
    6. **The wedge pin stood 0.04 mm proud** of the block at both ends. The
       manual pushes it flush on top and stones it flush below (re-jewelling
       the detent, 8–9). **Fixed on the branch.**

    Not modelled, and not needed by a kinematic model: the detent spring's
    0.770 g test (Op. 78) and the trip spring resting lightly on the arm
    (Op. 79).
13. **The balance stop** (finding 8 under BOM comparison): the Navy's
    modification on some movements; the model has the manual's locking arm. A
    video of a modified movement would show its shape and how it works. *Built
    as an illustrative variant from the top-view photograph (2 October 2026);
    redrawn from it at full size, 3 October 2026; how it works is still to be
    seen.* *The video exists: `KLUwI2UUCMQ` (2E8489) has the stop, close from above
    at 5:10, handled 5:30-5:48, taken off with its seal 6:15-6:24 (References/VIDEOS.md).*
    *Four movements compared (4 October 2026): 2E11795 (the top-view photograph),
    Delaney No. 8854 (straight above), the omegaforums movement ("Incoming Hamilton
    Model 21", two red seals) and 2E8489 (the video, 5:10). All four have one design:
    the stem from the second seal joins, at its top, a crossbar arched round the
    cock's end, concave toward the staff, whose ends run out to an eye and a pin over
    the rim on each side of the staff (182 and 186 deg apart where measurable).
    Traced on Delaney's (straight above, scaled by the eyes 27.8 mm apart): the arch
    about 7.9 mm round the staff, its top 8.3 out on the bar's centre line, the arms
    nearly level with the staff, as the model drew them; the oblique photographs
    make it look like one smooth curve. The model's arch stood on straight legs
    4.5 mm long, its top 12.3 mm out (a sketch's): an error, not a variant; the legs
    cut to 0.5, its top now 8.3 (`claude/navy-stop`). What
    varies between movements: the packing rings' colour (black on 2E11795, red on
    8854 and the forum's, white on 2E8489; the fusee seal's too), and whether the stop
    is fitted at all (2E10230 in the same thread has none). How it works: two web
    sources (WatchUSeek; Renaissance Antiques) have it lowered onto the balance and
    raised with an Allen key through the bottom of the case, a Navy fitting (the
    "Norfolk balance brake", Norfolk Naval Shipyard, given as about 1948, though
    another source puts it in the war years). It is screwed down by the hex socket,
    not pressed as the model had it.*
    *With the stop free, its arch ran 0.3 mm into the hairspring at full swing: the
    hairspring was drawn too large (r 6.3). At r 4.8 (25 below) the arch clears it by about
    1.3 mm, as on 2E11795's photograph.*
21. **The upper train bridge's notch, horn and mouth** (new, 1 October 2026,
    branch `claude/train-bridge-outline`). **Rebuilt from the video**
    (`tools/train_bridge.py`; 23:30 flat and 13:49.5 turned over, each put on
    the face through the rim, the barrel's cut and the centre bushing, 0.2-0.3
    mm rms). The notch is one circle, r 16.57 about (11.46, -17.47), 0.12 mm
    rms; the horn its cusp with the barrel's cut, cut off straight 12.4 mm
    from the centre; the mouth a sharp corner at (28.0, -18.7) and a straight
    edge turning into the rim through a round corner (it was a spike to
    -40°). Still open:
    - **Applied (2 October 2026, `claude/group-layout`):** pillar 2 stands under the third screw, the fusee 20.4
      mm out; the keyhole is the measured opening (two lobes and the escape passage, `TB_KEY`) and the end past
      the barrel a straight cut (`TB_END`), both on 23:30 through its anchor.
    - **The third screw: moved, its pillar still open** (2 October 2026,
      branch `claude/train-bridge-screw`). At (29.24, -12.28) it kept 0.5 mm
      of metal to the notch and its head overhung the edge by about 1 mm, and
      the bridge laid flat (23:30) has no hole there. The hole is a 5.3 mm
      counterbore at the end of the tongue, (32.25, -10.81); at 36:26 the
      bridge goes on with it, and at 36:34 the screw is driven into it with a
      fluted pillar under it. The manual has the same: four pillars, three
      for the train bridge, and all three of its screws in them (Ops. 5, 14;
      parts list 42059 x3, 42055 "Pillar upper train bridge" x3); the barrel
      bridge has its pillar's screw and two plain screws. The model's
      (29.24, -12.28) came from the top-view photograph's five-screw map,
      which is fitted to the model's own screws. The screw is now at the
      video's hole, its head (r 2.5) sunk flush, threaded into the bridge
      alone. **Still open:** the pillar. On the manual and video's reading the
      model's pillar 2 (32.11, -4.1) belongs under this screw, 6.7 mm away,
      and the barrel-bridge screw now in it goes into the train bridge. But
      the fusee wheel's tips reach 20.4 mm from the fusee arbor, and a pillar
      (r 2.7) at the hole stands 22.5 mm away: 0.6 mm in the wheel. The real
      one clears, so the model's fusee is placed or sized wrong: the notch's
      centre (below) puts the fusee 20.9 mm from the centre, which with the
      train's 90 and 14 makes the wheel's tips about 18.5 mm and leaves the
      pillar 0.6 mm clear. Next, on its own branch.
    - **The notch's centre** is 2.3 mm from the model's fusee arbor, at 33°
      from the 12 and 20.9 mm out (the arbor at 30.3° and 22.9 mm). If the
      notch is concentric with the fusee, that is a reading of the fusee's
      place on the bridge itself, beside finding 19's 43-45° on the dial side.
    - **The keyhole**: the video's opening has three lobes and a round hole,
      and leaves 3 mm or more of metal below the notch. The model's is still the
      two circles about the balance and escape arbors, now kept 1 mm off the
      notch.
22. **The bare pillar plate: the fusee, barrel and pillars against the train**
    (new, 2 October 2026, branch `claude/fusee-layout`; `tools/rimfit.py
    rimfit_34-30.json`). KLUwI2UUCMQ 34:30 at 4K: the bare plate from the
    train side with its four pillars standing. A camera fitted to the plate
    face's rim (r 43.8; the rim traced with the pillars, the screwdriver and
    a ring screw masked off, `rim_pts`) and to its four gilt settings made
    round: rim 0.14 mm rms, settings 0.04, the same to 0.5 mm over focal
    lengths of 4000-8000 px. In the plate's own frame (no anchors):
    - **the fusee's lower bushing 20.0-21.0 mm from the centre** (model
      22.9), **the barrel's 21.8-23.8** (model 18.6), 38.5 mm apart (model
      36.2), 124° apart about the centre (model 121°). Told apart by the
      bushings' sizes (the barrel's the larger) and which side they lie.
      The train bridge's cut round the barrel is centred 22.56 mm out
      already, where this puts the barrel.
    - **the pillars 30-37 mm out** (model 28-32.5), as BunnSpecial's bare
      plate had them (VIDEOS.md, "Pillars on the bare plate").
    Turned onto the model by the train's own arbors (the centre bushing,
    the escape lower setting, the third and fourth settings on the lower
    train bridge, mirrored for the train side; 0.8-2.0 mm off), **the fusee
    stands 47° from the 12** (model 30°; the dial side's 43-45° in 19), and
    the pillars 15-20° further round than the model's (the fourth, its top
    out of frame, read at its foot to about 5 mm, near pillar 2). So the
    photographed group (fusee, barrel, pillars and the bridges' holes on
    them) is turned against the train, as 19 found, and the fusee is nearer
    the centre: with the train's 90 and 14 that is a module of about 0.385
    (model 0.441), the fusee wheel's tips about 17.7 mm from its arbor
    (model 20.4). How sure: the bushings' places ±1 mm (the anchors' 2 mm
    offsets are the train's own); the pillars' ±1.5 mm, the fourth's ±5.
    **The turn applied (19, release 1.14.00); fitted again against it** (2
    October 2026, branch `claude/ideas-1.12`). The spec's escape setting was
    anchored at the escape arbor's place before the turn; at (8.504, 17.598),
    where it now is, the anchors land 0.7-1.8 mm off (the escape setting 0.76,
    1.9 before), rim 0.13-0.15 mm rms over f 4000-8000. **The fusee 20.1-20.4
    mm out at 49-50°** (model 22.9, 44.3°), **the barrel 22.1-22.7 at
    281-282°** (model 18.6, 283°), 38.1-38.7 apart (model 36.2); **the
    pillars 2-8° round from the model's, no common sign, and 2.5-7 mm further
    out** (31-38 mm). The fourth pillar's foot lands 2.8-3.8 mm from the train
    bridge's third screw ((33.91, -2.69) in the model; 21), the model's pillar
    2 6.5 mm from it. No move of the group as a whole fits: the best turn and
    shift leaves 4.1 mm rms over the fusee, barrel and three pillars, with a
    scale (×1.11) 2.5 mm, the fusee 3.2 mm off. So the turn took the angles,
    and what is left is the group's own layout, against the top-view
    photograph's (19 took that to stand). How sure: as above.
    **Applied (2 October 2026, branch `claude/group-layout`; IDEAS.md 1.12).** The group is placed by one similarity
    fitted to the measured balance (its cap), fusee (20.4) and barrel (22.6), to 0.23-0.31 mm; 36:15 fitted too
    (`rimfit_36-15.json`, the fusee 20.3-20.8, the barrel 21.4-23.5). Open: the pillars' radii (their tops
    read 3-7 mm further out than the transform puts them; the train bridge's holes at 23:30 agree with the
    transform) and pillar 1, pushed 2.3 mm out of the fourth wheel. The rest of this paragraph is the plan as it
    stood. Moving the group means the fusee and barrel's
    places, the pillars, the barrel and train bridges' outlines and holes and
    the cock (traced on the top-view photograph in the model's frame), the
    fusee wheel and centre pinion's module (`solve.py`), the chain, the
    maintaining work and the essay's figures. Settle first which frame the
    top-view photograph and Fig. 2 fits put the group in, and measure the
    fusee wheel's size (27:26, laid flat). It also bears on 21: the pillar
    under the train bridge's third screw.

24. **The fourth arbor, the pillars and the indicator against the scale** (new, 2 October
    2026; `References/VIDEOS.md`). At the plate's assumed 87.57 mm the fourth's setting is
    21.5 mm from the centre (model 23.9), which leaves the model's balance 11.3 mm from it,
    as the video has it (14's conflict is the fourth's place, not the balance's); the
    pillars' feet r 34.1-34.7, the indicator's stud 22.9, the ring's bore 38.2 with a relief
    for the indicator wheel. But the dial side and the bare plate agree only with a 4-5 %
    scale factor between the plate's 87.57 and the bore's 40.2, and the photographed dial's
    seconds argue for the larger scale. Measured (`References/VIDEOS.md`, "The scale"): the
    error is most likely in the bore (0.81-0.83 of the ring's outside diameter on the
    video, about 38.4-39.8 mm), the plate's 87.57 stands, and the fourth's 21.4-21.75 is
    read against the plate in the same frame. **Applied** (2 October 2026, `claude/fp-layout`):
    the fourth at 21.6, the third at 16.55 (149 deg), the escape arbor 9.40 from the balance
    toward the escape jewel seen from above (11.1 from the fourth; the counted wheels' size
    ratios come out), the pillars on r 34.1-34.7 (pillar 1 at 170.8 deg, not the video's
    166.3, where its screw would stand under the cock: the cock or that reading is off by
    about 4 deg), the indicator's stud 22.9, the bore 39.0 with a relief round the 12 (its
    size rough), the train-blocking screw 6.35 from the fourth, the escape upper bridge
    rebuilt (17), the detent block at Fig. 90's length (20.2), the lower bridge regenerated
    (`tools/lower_bridge.py`) and the train bridge's escape opening a circle r 6.9 about the
    arbor (the escape wheel lifts out through it; the traced lobe, from 23:30 at the wrong
    focal length, was r 5). The dial's print now puts the seconds sub-dial on its arbor (it
    was at a fixed 0.472 of the dial's radius, 1.5 mm off it).
    *Since (3 October 2026, `claude/fp-finish`): the lower train bridge measured on 40:08 and rebuilt, 4.4 thick
    and 10 wide, its screws and settings in counterbores (its end 9.2 past the fourth, not the video's 10.3, to
    clear pillar 1's dial-side screw at the model's 170.8 deg); the minute wheel's stud 11.3 (the video's). Pillar 1
    tried at the video's 166.3 deg (its dial-side screw just clear of the bar's end on 40:08): its top screw's head
    then stands in the cock's foot, which C Spinner's video shows clear of any screw (6:29 on, 6:47 off), so it
    stays at 170.8 and the 4 deg between the dial side's angles and the cock's place stays open. Of the items left open this is the only one worth pursuing (PLAN-fidelity.md, "How much each open item matters"): one frame with the cock and pillar 1's screw together would settle which source is off.*
    *Settled (18 October 2026, `claude/cock-angle`): the train side measured against the cock's own holes. On KLUwI2UUCMQ 23:30 (the upper train bridge face up, its holes'
    rims fitted as ellipses, put on the face through `tools/anchors/KLUwI2UUCMQ_23-30.json`'s homography) a similarity on the cock's three holes in the train bridge (its screw's
    tapped hole and its two steady pins', residuals 0.13-0.27 mm) puts pillar 1's hole at **169.1-169.5 deg**; on 6:49.0 (the screw in place, its head's top picked and put
    back 2 mm up through a camera fitted on seven of the bridge's holes and the cock screw's axis, 6:29's top over 6:49.0's hole) at 168.9-169.3 deg at the fitted f 5,300
    (168.3-170.8 over f 1,500-11,000); on 23:45 (oblique, glare) 168.2-170.0; on another movement, No. 2182 (Jd2c3x8VKsE 26:00, 720p, ±1 mm), 168.2-170.0 against its
    cock's holes (`tools/anchors/Jd2c3x8VKsE_26-00_fit.json`, fitted with and without the screw itself). So the screw stands **169.2 +- 0.5 deg** against the cock, 1.1 deg (0.65 mm) nearer it than
    the model's 170.3 and 2.9 deg (1.7 mm) further than the dial side's 166.3 would put it: there its head would reach the cock's foot (2.2 mm clear of it in plan at
    170.3, and 4 deg is 2.4 mm there); at 169.2 it clears the foot by 1.55 mm, as 6:29 shows it beside the cock. **Moved there** (r 34.52 kept; `PILLARS.train[1]` (6.47, 33.91)). About the centre, 23:30's
    holes away from the cock (the centre bushing, the barrel bridge's screw and pin holes, the lower bridge's screw, pillar 2 at 3 o'clock, which comes out within
    0.1-0.6 deg of the dial side's 84.3) put the screw at 167.6-168.0 deg and 6:49.0's camera at 168.2-168.9: so the dial side's 166.3 is about 1.5-2 deg low (just
    past its stated 1.5), and the cock's three holes come out 1.3-2.3 deg (0.7-1.3 mm) short of the model's about the centre too. That is one good frame (23:30, some of
    whose anchoring holes were placed from it) and an oblique one, so the cock's place stays as measured on 6:47 and 23:30 (its holes, RESOLVED.md) and is left open
    below as a lead, not a finding. The lower train bridge keeps its 9.2 past the fourth: at 169.2 the video's 10.3 would meet the dial-side screw's head by 0.1 mm
    (clear by 0.26 at 168.2), within the readings' scatter.*
    *Open, low (18 October 2026): the cock's place about the centre. 23:30 (face up, homography on the rim, the cut round the barrel and the centre bushing) puts the
    cock's screw hole and its two steady pins 1.3-2.3 deg short of the model's about the centre, pillar 1 with them; a second face-on frame of the train bridge with
    the centre and the cock's holes (13:44, 36:16-36:35) would say whether the cock (and the balance under it, which it must stay over) is turned by that much.*
    *Settled (3 October 2026): the photographed dial, face-on and scaled by its seconds' centre (on the fourth, 21.6
    out), has its minute track at r 40.4-42.2, the seconds track r 17.9 meeting it at 6, and shows to r 45.9 inside the
    bezel, the model's bezel opening exactly: the 95 mm dial stands, and its print, at r 43.0-45.4, was 9 % too large.
    Now printed so, the hands to the photograph's lengths (`References/VIDEOS.md`, "The Hamilton dial's proportions").*
    *The bridges' rims (4 October 2026, `claude/shape-pass`): the side photograph against the measured 87.57 mm plate puts them at least
    38.5-39.4 mm out, the videos at 38.6-40.2, so the 40.5 stands. The top-view photograph's rims read 35.5 through its map, about 10 %
    small against its own inner layout: that photograph is not to be used for sizes near the rim (topview.py's overlay shows a false
    protrusion there). Its sunk screw 5 mm inside tb2 is read through the same map and does not outweigh the video's pillar: open.*
    Was open: the seconds hand and the dial's track. With the fourth at 21.6 the hand
    can be at most about 18 mm long (it must pass the hour wheel's pipe), so the seconds
    sub-dial can't meet this 95 mm dial's minute track at 6 as on the photographed dial
    (its seconds centre 0.549 of the track's radius would want a track r 39.3, against
    43.0); the video's Navy dial (0.478) suggests a dial about 103 mm across. The dial's
    size and track wait for a frame with the dial and the ring's flange together. Also
    open: the lower train bridge's bar stands 4.3-5.4 mm over the plate's dial face on the
    video (model 1.2); the minute wheel's stud 11.3 on the video against 10.5 from the
    dial-side photograph; the balance locking arm's place (Fig. 9: beside the cock's foot;
    the model's estimated).

23. **The barrel's size** (new, 2 October 2026; `References/VIDEOS.md`,
    Measurements). The model's barrel is r 13.5; four readings put it about
    r 18–19: laid flat at 23:30 its cap is about 37–40 mm across against the
    train bridge's rim (r 40.5) on the same frame; in place (13:12) it looks as
    wide as the fusee wheel; the train bridge's measured cut round it is
    r 19.2; and the side photograph's coils stand 1.4 times further apart than
    a 13.5 mm barrel gives (above, "Noted, not changed"). The mainspring's
    coils at 15:54 are spaced as the parts list's 0.419 mm thickness only in a
    barrel about 36–37 mm inside, where its length comes to about 1.1 m (model
    600 mm). Sure: likely. Changing it changes the barrel's turns for the
    chain's length (7.07 now, about 5 in an r 18.5 barrel), the mainspring,
    the maintaining work placed about the barrel, the barrel bridge's cut and
    the clearances round the barrel, so it waits on a camera fit of 23:30 or
    13:12 (the barrel's rim and the train bridge's at their heights) and on
    the user's decision. *Fitted and changed (2 October 2026): at 23:30, the
    barrel as an upright cylinder through a camera scaled by the train bridge,
    its top lip r 18.3 (17.4–19.6 over the focal lengths the frame allows,
    certain above 14.5); 13:06 agrees roughly. The barrel now r 17.6 under a
    0.7 mm lip, the mainspring 1,064 mm (half the room), the chain 4.85
    barrel turns; it fits the train bridge's cut and clears everything round
    it by 0.86 mm or more. RESOLVED.md, Winding and maintaining work. Its
    height too: 16.5 mm (side-on, 33:09.5–33:35), not 13.2; and the train
    bridge's cut round it r 21.0 (fitted 21.0–22.0 with its centre free, 24.6–25.1
    mm out), not 19.2.*
25. **The hairspring's radius** (4 October 2026, `claude/navy-pins`; **settled, r 5.1**,
    `claude/hairspring-radius`). The model's coils were r 6.3, read on the restoration video
    side-on (6:49.8) as 0.43-0.45 of the rim "between its ends" (the glove hides the left end)
    and by a disc taken for the impulse roller (it is about 4.9 mm against the rim). Five
    sources, each a ratio of the coils' outer edge to the balance rim in one picture:
    - the video side-on (6:49.5): the coils 257.5 px across about the staff (x 648.75), the rim's
      back edge turning at x 998-1003 behind the timing weight's root, 351 px out: 0.367, r 5.3;
    - the video face-on (6:52.5): the coils 310 px, the rim 835 (the camera on the spring's
      side, by which of the arm and the coils hides the other; the coils' two ends within a few %):
      0.355-0.371, r 5.2-5.4;
    - the top-view photograph (2E11795): about 0.35, r 5.0;
    - the manual's Fig. 2 (600 dpi): the rim's top edge fitted as an ellipse, 1012.7 px across
      (1 % rms; the pillar plate's 87.57 mm, about 3090 px, agrees on the scale), the coils
      323-340 px: 0.32-0.34, r 4.7-4.9;
    - the oblique photograph: roughly 0.40, r 5.8.
    Median 0.363, 5.26 to the outer edge: r 5.1 (HS_RC), the collet scaled with it (CKS). A
    second reading the same day, r 4.8, fitted the rim's radius to the near side's holes, which
    perspective spreads (that fit's centre fell 100 px off the staff), and the coils then
    looked small against the wheel. The turns too: 13 wires down each side on the video
    side-on (14.5 px apart; the first reading counted every second one, 26 px), so 12 turns
    with the end curves, not 9. With the Navy brake fitted its arch (6.6) clears the coils by
    about 1 mm at full swing (finding 13). The stack's height: side-on (6:49.5, 24.2 px/mm by the
    rim, the camera 5.7 deg above its plane) the top wire is 5.8 mm over the rim's top edge at
    the staff's depth (the model 5.9, set by the stud under the cock), and the coils run down
    past the rim's front edge, 1.4 below its top, behind it, so 7.15 or more; Fig. 2 puts their
    foot about 2.1 below the rim's top. The spring now starts 1.1 below it (HS_Y) and stands 6.7
    (HS_H), the collet as low as the hub lets it go (0.07 over the hub's boss and the cap's
    screws). *Still open:* 0.5 mm or more of it, which says the hub's estimated boss, cap and
    screws stand too high (Fig. 4 draws the hub; no frame shows it side-on yet); the wire's section (the video shows flat ribbons, the model
    draws it round); and Fig. 5 draws the top coil at 0.82 of the others, the spring's upper
    end then about 4.3 from the staff, near the stud clamp's 4.6.
27. **The upper train bridge's holes near its ends** (new, 12 October 2026). On the
    photograph of 26 the train bridge's underside is anchored on its rim and barrel
    cut (0.07 and 0.23 mm rms), so holes in that face read to about 0.5 mm. The
    centre bushing, h2 (the large hole at the fusee end), h3 and h4 pair within
    1 mm. Near the fusee end the photograph has countersunk holes at about (29.9,
    14.8), (34.5, 6.6) and (30.7, 1.7) with no model hole within 1.5 mm, and plain
    metal where the model has h5 (29.0, 8.0, r 1.4); toward the barrel end a
    tapped hole at (−23.6, 27.4) and a gilt countersunk hole at (−22.1, 20.8) have
    none, and the model's h22 is 1.9 mm from the large hole there (`holes.py
    trainBridge` numbering; `tools/anchors/photo_lower_bridge.json`). The model
    README already says its small holes are the model's, not all the video's
    ("Estimated, not from the manual", the upper train bridge's outline).
    Open: which screw or pin each takes (the `S` table, the manual's parts list),
    checked on `KLUwI2UUCMQ` 23:30 before moving any; a different production run
    could also differ.

## The fusee assembly against Fig. 28 and the video

1 October 2026. The seventeen parts of Fig. 28 (the manual's exploded fusee)
against `movement.js`, Figs. 12 and 69–73, Sec. II and IV, Ops. 16–45, and the
restoration video `KLUwI2UUCMQ` at 13:30, 17:23 and 27:20–29:20 (readings in
`References/VIDEOS.md`, Measurements).

Every part is modelled and moves: the top plate, its screws, the winding
ratchet, its screws, the taper pin and the end plate turn with the fusee; the
stop-bar slides as the chain winds over its nose, and its spring follows it;
the chain is laid along its path at every wind; the winding pawls ride the
winding ratchet's teeth, their springs following them; the sustaining ratchet
turns with the fusee wheel in running and stands while winding; the sustaining
spring is drawn loaded in running and relaxing while winding. The model is
kinematic: positions follow the time and the wind; no force is computed.

Fixed: a wind lasts seconds on screen whatever the speed, so at high speed the
sustaining spring drove the train for hours of model time (RESOLVED.md,
Winding and maintaining work).

### Open, most certain first

1. **Sustaining spring** (27:26; Figs. 69, 71). *Fixed (RESOLVED.md, Winding and maintaining work).* A flat blued band about
   2.1 mm wide, r 15.8–18.0, against the recess wall, round about 335° (its
   fixed end widened inward, with two holes; a lighter working end with an
   upright pin). The model: 0.7 mm wide, r 13.2–13.9, 250°, its free end
   pushed by a pin on the ratchet (the manual pins both ends).
2. **Fusee wheel** (27:26; Figs. 71, 72; Ops. 20, 26). *Fixed: the recess and its elevations with the spring, the bore with the collar (5).* Its recess reaches
   r ≈ 18.0 (model 15.2), its bore is r ≈ 2.6–2.9 (model 1.05), and the
   recess floor has a raised disc to r ≈ 9.3 and a hub round the bore. The
   model's web is flat.
3. **Fusee's top** (13:30, 17:23; Fig. 28). *Fixed: the screws at r 7.0 and the collar on the plate. Open: Fig. 28 draws the hub rising through a large hole in the plate, with the stop-bar's slot beside it (the bar would then run about 3.6 mm off the axis, not 2.0); and the arbor above the collar looks thicker on the video (r 1.4–2.3) than the model's r 1. Neither is measured.* *The hole fixed (4 October 2026): the plate comes off over the collar (19:58-20:00), so the collar, r 3.0, now rises from the hub through a hole of r 3.05 (Fig. 28's large hole). The collar's height fixed too (2.8 mm over the top layer, to the barrel bridge); the arbor above it still open: see "Figs. 21, 22, 28 and 29 against the model" below (the r 2.2 first read here was the collar with the hole round it).* *Seen (2 October 2026, 20:05–20:27; `References/VIDEOS.md`): under the top plate a round recess about the arbor (r about 4–5) with a hub; the slot across the top beside the hub, open at both ends, about 3.5–5 mm off the axis, as Fig. 28 draws it; the bar's spring a round wire in an open C of about 270° in a groove round the hub. Sure: form certain, sizes ±30 %. *Now so* (RESOLVED.md, Winding and maintaining work).* A steel collar r ≈ 2.9 round the
   arbor over the top plate, and the plate's two screws at r ≈ 7.0. The model
   has no collar, a plate hole of r 1.02 and its screws at r 3.2.
4. **Sustaining ratchet** (28:32–29:14; Fig. 28). *Fixed. Open: the video shows six slotted heads and about five holes on its underside; four are the springs' screws, the other two perhaps the pawls' pivots, not drawn.* *The other face seen (19:05): about ten holes and screw ends, four the springs' screws and two the pawls' pivots; the rest open. The pivots now drawn as studs riveted flush (2 October 2026). Not drawn: the raised plateau the pawl springs lie round (the pawls lie over it; its height isn't seen).* *Seen sharp at 4K (3 October 2026, 19:12): not a plateau but a groove about 0.7 wide at r 10.6-11.3, which the springs lie in; the model lays them at that radius over the face, the groove not cut (a hidden face; the toothed wheel would have to be built in layers).* *Cut (11 October 2026): the wheel in two layers, the face's with each spring's bed and its foot's pocket through it, traced every degree on 19:12 (r 8.9-8.7 then 7.04 for one, 9.3-9.1 for the other, 0.6 wide); the springs lie in them and the feet's screws are at their holes (29-32° apart at r 7.8-8.35, not 10° at r 8.9); the depth, the pockets' unseen walls and the feet's shape estimated (model README).* Gilt brass, not steel; the
   winding-pawl spring screws go in from the fusee wheel's side (slotted heads
   there). The model has the heads on the pawl side.
5. **Arbor collar and the fusee's large end** (28:08, 28:17; Fig. 69 arrow 5;
   Op. 23). *The collar fixed; the large end's rim open. The winding ratchet seen (18:20): about 36 teeth (model 40), likely; now 36.* *The rim now drawn (3 October 2026): 0.4 tall (estimated, as tall as the sustaining ratchet and its pawl allow) round a recess whose edge is 0.84 of the end's radius (18:20), over the pawls and springs. The ratchet's tips on that frame read 0.43-0.51 of the end's radius (6.4-7.6 mm), against the model's 8.75 and the earlier 8.5 and the pawls' tips at 8.4: left, the readings disagree.* A steel collar r ≈ 2.7 on the arbor below the fusee carries the
   sustaining ratchet and the fusee wheel (the model hangs both on the 2 mm
   arbor); the large end has a raised outer rim round the winding ratchet,
   whose tips read r ≈ 8.5 (model 9.85; rough, oblique).
6. **Fusee end plate** (Ops. 27–29; Figs. 28, 69). *Fixed: r 7.0 with the slot and a 9.6 mm pin. Open: Fig. 69 draws a raised boss round its hole.* *Seen (18:22, 18:25): gilt brass (model steel), r about 7, the raised boss round its hole with the slot across it for the taper pin, as Fig. 69 draws it. Likely. Now so.* Notches in its face that
   the taper pin lies in; the model's is a plain washer with the pin under it.
   Figs. 28 and 69 both draw it about 0.37 of the fusee wheel across (r ≈ 7.5;
   model 2.6), not yet seen on video.
7. **Winding pawl springs** (Figs. 28, 69). Drawn as long arcs round a raised
   ring about the ratchet's centre; the model's are short bent strips. *Seen
   (19:12, 18:40, 19:15): each a long thin arc of about 150–170° in the gutter
   round the sustaining ratchet's raised plateau, held at its far end, the two
   nearly round it, as Fig. 28 draws them; each pawl a short lever on a stud.
   Sure: the form certain. *Now so* (RESOLVED.md, Winding and maintaining
   work); the pawls themselves stand where the video has them (pivots about
   11 mm out, tips about 8.4). Not drawn: the raised plateau the springs lie
   round.*

Seen on video since (2 October 2026, 17:50–20:27): the end plate, the winding
pawls and their springs, the stop-bar and its spring (`References/VIDEOS.md`).

## Figs. 21, 22, 28 and 29 against the model (4 October 2026)

Every part these four figures name is in the model and has its line in `BOM.md`,
rendered one by one (isolated, by Hamilton number). Four places looked different:

1. **Dial take-off slot** (Fig. 21). Not modelled. *Fixed: the notch in the
   flange's rim, 167° from 12, 1.4 wide, 2.2 in (restoration video 9:03; the
   dial lifted there, 8:46).*
2. **Fusee top plate's hole** (Fig. 28; the fusee assembly 3 above). *Fixed:
   the collar now rises through it (19:58–20:00).*
3. **Fusee end plate** (Fig. 28 seems to draw a square hole). The video's plate
   (18:22) has a round hole with a raised boss and a slot across it, as the
   model has; the drawing's "square" is the boss and slot. No change.
4. **Sustaining spring** (Fig. 28 shows part of it). The model's (27:26) matches
   the video at 27:30: the band against the wall about 335°, the fixed end
   widened with two holes, the working end with its pin. No change; the
   video's steel looks nearly black, the model's blue brighter.

Open, found on the way:

- **The flange's holes** (9:03, 40:05; `References/VIDEOS.md`). *Angles settled
  (14 October 2026): read through fitted cameras on 9:03, 40:08 and 34:30 (both
  sides), the dial screws moved to the video's four plain holes (2.6°, 132.9°,
  226.0°, 318.9°; the 2.5° hole is the fourth dial foot's, one size with the
  others) and the ring screws to its three (91.5°, 214°, 336.5°: the heads on
  the plate's rim at 215° and 335° from the train side, the ends in threaded
  holes at 91°, 214° and 337° from the dial side, the top-view photograph's head
  at 215°). *Closed the same day: the radius read camera-free (radial strips
  through each hole, its place between the bore and the flange's rim) 41.8-42.2,
  the screws now at 42.0 and tapped through the flange, their ends 2.0 below its
  face; the fourth dial foot at 178.7°, a filled hole of the feet's size; the
  2.3° hole, which the strips put among the ring screws, drawn, what it holds
  unknown.*
  *Worked through (4 October 2026), not settled.* The dial screws go in from the train side
  outside the plate's rim (8:36-8:42), so the three small holes near the rim
  (130.4°, 224.4°, 319.4°) are theirs; the three large threaded ones (88.5°,
  212.3°, 337.8°, r ≈ 41.5) the mounting ring's screws, tapped through. The
  model's dial screws at 223.7° and 323.5° agree within 4°; its 152.6° (from the
  top-view photograph) is 22° from the video's 130.4°, and the video shows no
  fourth hole at r 46 (its 2.5° hole, r ≈ 43, lies under the plate's rim). The
  ring screws (model 70°, 190°, 300°, one from the photograph) are 18-37° off.
  The photograph is of another movement and its map doesn't fit the copy in
  `References/`, so the two can't be put side by side yet: refit its camera
  (`fit.py`) and read its flange screws through it before moving any.
- **The fusee arbor above the collar.** *The collar's height fixed (4 October
  2026): 2.8 mm over the top layer (20:00, against the groove's pitch), up to the
  barrel bridge.* The arbor isn't r 2.2: that read the collar. Still open: the
  shaft above the collar reads 0.66 of the collar's width (r ≈ 1.75 against the
  model's r 1; silhouettes against the blue mat read polished steel narrow, so
  only the ratio is kept), and the winding square starts at a step about 11 mm
  up (y ≈ −31.5), where the model has a plain r 1.2. The parts list gives the
  fusee's bushings the barrel's number (42164), whose bore the model has at
  r 1.42: a thicker arbor would fit them. Thickening it means the barrel
  bridge's bushing, the dust seal and its ring together.

### Still open after the collar's height (4 October 2026)

What this pass on Figs. 21, 22, 28 and 29 leaves, most worth doing first. The
measurements behind each are in `References/VIDEOS.md` (the rows for the fusee's
top, the fusee arbor, the take-off slot and the flange's holes).

1. *Fixed (15 October 2026): with the bushings, as "The overhaul's order against the model" 1 below: the shaft r 1.82 from the collar through the
   barrel bridge's bushing (42164, all four r 3.4 bored 1.85) to a step at y -31.5, then the 2.4 square to its end; the dust seal's chamber opened under it,
   its ring and spring measured (12:33.0-12:39.0). The shaft measured against something matt as asked: 12:39.0, against the bridge, r 1.84.*
   **The fusee arbor's shaft and winding square.** Above the collar the real
   arbor reads 0.66 of the collar's width (20:00, 19:59; r ≈ 1.75 against the
   model's r 1), and the parts list gives the fusee's bushings the barrel's
   number (42164, bored r 1.42 in the model). The square starts at a step about
   11 mm over the fusee's top (y ≈ −31.5) and runs to a rounded end; the model
   has a plain r 1.2 cylinder there and a 1.6 mm square at the end. Doing it
   means the arbor, the barrel bridge's bushing (42164.fu), the dust seal (42051)
   and its ring (42052) together, then `fine.py`, `bom.py` and `maintaining.py`.
   Needs first: the shaft's radius from a frame where it stands against
   something matt (a polished silhouette on the blue mat reads narrow), or a
   ratio to the barrel arbor's pivot in one frame.
2. *Closed (14 October 2026): see "The flange's holes" above.* **The dial screws and the mounting ring's screws.** The video's ring
   (2E8489, 9:03 unrolled): dial screws at 130.4°, 224.4° and 319.4° (r ≈ 46),
   none at r 46 elsewhere, a small hole at 2.5° (r ≈ 43, under the plate's rim:
   a dial steady pin?); the ring's screws tapped through at 88.5°, 212.3° and
   337.8°. The model: dial screws 38.0°, 152.6°, 223.7°, 323.5° (152.6° and
   223.7° from the top-view photograph, 2E11795); ring screws 70°, 190°, 300°.
   Needs first: the top-view photograph's camera refitted (`fit.py`, `unproj.py`)
   and its flange screws read through it, then the two movements compared;
   where they agree, move the model's.
3. *Confirmed (4 October 2026), not refitted: drawn back through its own transform, every named point misses its feature on this copy; a free similarity (searched over every pairing of two named screws with two of the 14 slotted heads seen on it, mirrored or not) puts at most 4 of its 8 screws within 30 px of a head, at 15.5 px/mm where the plate needs 20-23, so the points weren't traced on this image, turned or rescaled. Nothing reads the map's transform (the model takes its points, already in mm, through `PT`), so the model is unchanged; a new reading from this photograph needs its points traced on it afresh.* *Checked again (5 October 2026), with the screw heads found automatically (31 Hough circles on the 2322 px copy): the best similarity, mirrored or not, puts 5 of the 8 named screws within 25 px of a head and misses the other three by 128-225 px, which 31 circles allow by chance; no reading of the map's own transform (R or its transpose, the image's y flipped or not) puts more than one on a head. *Corrected the same day:* the photograph's source is found, Bonhams' sale 22389 lot 1128, whose largest image is this same 2322 px file, so there was no other copy. The likelier reason the points miss is the test, not the map: they lie on parts at different heights (plates, bridges, cock) seen through a perspective camera, which one 2D similarity can't fit; `p3fit.py`'s camera (`verification/topview-comparison.png`) is the right check, with the points at their heights. Most names (`fan_left`, `stripe_a`) still say too little to retrace them.* **`tools/p3map.json` doesn't fit `References/photo-top-view.jpg`.** Its
   three anchors (the balance at 640, 830 and so on) don't land on those parts
   in the copy in `References/` (2322 px square): it was fitted on another copy
   or crop. Find that copy, or refit the map on this one, before any new reading
   from the photograph.
4. *Drawn (5 October 2026): the top layer cut to the recess, r 5.5, the stop-bar and its spring lying in it, as 20:25 shows; its depth read 1.2-2.0 from the far wall's band (35 px at 44 px/mm, 29 deg from face-on) and drawn as the layer's 0.5 (estimated: cutting the fusee's body below would move the chain's top turn). The two small holes in its floor at r 4.5 not drawn.* *Measured (4 October 2026), not yet drawn: at 20:25 (4K, the plate off, the top seen at a slant) the recess's edge fits an ellipse (seven points, within 6 %) round the collar, and the top plate's two screw holes, opposite each other through its centre, lie 1.26 times its radius out along their line: **r 5.5 mm (±0.5)** with the screws at r 7.0; two more holes in its floor, at about r 4.5. Drawing it means laying the stop-bar spring (42025) and the bar's slot (3.6 mm off the axis, which crosses a recess that wide) again together; it needs the recess's and the slot's depths (20:00, side-on) first.* **The recess under the fusee's top plate.** The video (20:05-20:27) shows a
   round recess r 4-5 about the hub; the model has the spring's groove r 2.4-2.9
   only. Sizes ±30 %.
5. **Estimated, to measure if a frame allows:** the take-off slot's depth (1.0,
   its floor brass at 9:03), the collar's radius (r 3.0 face-on at 13:30, ±0.3:
   the dark ring round it may be the hole's gap).
8. *The staff itself (5 October 2026): traced whole on a bare Model 21 staff found on the web (watchdoc.com), so the body between the seats is now measured (1.37-2.62 mm across, the model's 0.9 before), and 7:08's lower-end shoulder is the unlocking roller's boss, not the staff.* *Closed (5 October 2026): the flange drawn brass, 7.0 mm across (34:12, against the impulse roller), the hold-down screws' holes inside it as the frame has one; 6:50.0's 5.2 was the part the arm hides.* **The balance hub's flange** (new, 5 October 2026). At 34:12 (the balance lying, rollers up) a brass disc about 7 mm across, a screw hole in its face, lies under the hub's sleeve (the sleeve now drawn, 3.24 across, from 34:12); the model's flange is a steel disc 4.4 across with the hold-down screws at 1.7. Side-on from below at 6:50.0 the hub's disc reads about 5.2 mm against the rim's 29 (rough), so the two readings disagree. Identify the disc (the hub's flange, its cap, or the arm's boss) on a frame of the balance from the plate side before resizing anything.
7. *Re-read (5 October 2026): the distance agrees, the pinion was too short (drawn 4.0 now).* The first reading's scale came from the model's own pinion tips; scaled instead by the escape wheel (Hamilton's 13.16 mm, 760-775 px across at the arbor's depth), with the pinion 4-5 mm nearer a camera a few centimetres away (6-9 % larger) and the view 20-30° from above, its end stands 8.7-10.1 mm from the wheel's web (the model's 10.45 inside that: the train's heights stand) and its leaves run 3.6-4.7 mm (the model's 2.0 was short; now 4.0 about the same mesh). **The escape arbor's pinion and its distance from the wheel** (new, 4 October 2026). In the staking tool at 43:21.1 (4K, the arbor upright against a
   plain ground, seen from about 20° above) the pinion's leaves run about 227 px, 3.5 mm at its own tips' 64 px/mm, where the model's pinion is 2.0 long, and
   its end stands about 387 px (6.0 mm) above the wheel's brass hub, itself about 1.6 mm tall: about 7.6 mm from the pinion to the wheel's web, where the
   model has 10.45 (the pinion at the fourth wheel's height, -7.46, the wheel at `EY`). The view foreshortens heights by about 6 % only. If it holds, the
   pinion is longer and the fourth wheel or the escape wheel sits otherwise than the heights measured at 42:50-42:56 put them; check those frames and a
   side-on view of the arbor alone before changing the train's heights. (The shank's width from the same frame is drawn: r 0.67, Every part, Jewels.)
6. *Fixed (4 October 2026): dark tempered steel (`M.steelK`), as the frame reads it, (27, 31, 35) in shade and (154, 166, 174) where it takes the light.* **Cosmetic:** the sustaining spring's blue is brighter than the video's
   nearly black steel (27:30).
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
