OrelMag/marine-chronometer-model/site/wempe/verification/index.html

Light / dark

The Wempe Einheits-Chronometer model · verification · 12 November 2026 · the Hamilton's: would a chronometer made to it run?, the model against real Model 21s

# The Wempe Einheits-Chronometer: does the model hold to its drawings, and would it keep time?

The model of the German standard marine chronometer of the 1940s is built from Wempe's works drawings, each sheet as last revised. Two questions follow from that. Does the model hold to its drawings: is every part a closed solid where its sheets put it, clear of its neighbours, counted against the drawing list, every figure read and every guess said to be one? And would a chronometer made to those drawings keep time: does the escapement run, does the fusee even the spring, does the energy budget close, do the teeth and springs hold, does it stay in rate from cold to hot and at sea, and does it pass the trial its Soviet copy, the 6MX, was made to pass? Every figure below comes from a script in the repository, run on the model's own numbers, and is shown as the script prints it: ok a check that holds, ~~ one the script reports but doesn't fail on (an open question, or the strong end of a range only), !! a failure.

## Approach

The Wempe's checks are the Hamilton's, pointed at the second model (--model wempe), with tools of their own where the two chronometers differ: the Wempe's detent carries a gold passing spring on its own horn, its fusee's force was measured by its makers on the drawing itself, its balance is a cut bimetallic one with movable masses, and its hairspring is a helix with drawn terminal curves. The tools run on the same files the page draws from (js/escapement.js, js/escphys.js, the shared makeEsc), so what they check is what the page shows.

# | Question | Method | Script

1 | Is every part a sound solid, clear of its neighbours, and on the drawing list? | Closed-mesh tests, a 0.05 mm voxel interference check through the escapement's phases and the wind, a screw and loose-end audit, the Spread view's clearance, every part against bom.json | solids.py, fine.py, audit.py, exploded.py, bom.py
2 | What do the drawings say, and what had to be guessed? | The sheets transcribed figure by figure with how sure each reading is; the readings corrected on the sheets; the estimates listed | References/wempe/, the model's README
3 | Does the escapement run, and does it run in time as the averaged model says? | makeEsc solved from the layout drawing; the escapement integrated beat by beat; the detent as a frame of beam elements | wempe_escapement.js, dynamics.js, tripping.js
4 | Does the drawn fusee even the mainspring as its makers measured? | The spring solved for its shape at every quarter turn, fitted in length and set to 05 06_20's force | wempe_mainspring.py
5 | Is there energy enough, from spring to balance? | Every loss from the parts, the balance's damping from its parts; the swing the drive can hold | wempe_physics.js
6 | Do the gears mesh, and how exactly must the holes be placed? | Tooth-by-tooth contact on the page's own outlines; the train in time; each mesh's depthing window | gearing.js
7 | Will the loaded parts hold, fully wound? | Each part's stress against its material's published range | wempe_strength.js
8 | Does the drawn hairspring keep the balance free of side forces, and isochronous? | Phillips' conditions on 05 03_7's curve; the spring at large swings as an elastica and as beam elements | wempe_hairspring.js
9 | Does the bimetallic balance compensate, and where must the masses sit? | The rim's quarters as bimetal cantilevers, every part weighed; the secondary error | wempe_thermal.js, wempe_thermal_frame.js
10 | Does the case hang level and stay so at sea? | The case and ring weighed on the model, levelled as 05 01 says, run in a seaway | massprops.py, gimbals.js
11 | Would it pass the 6MX's trial, and what would a navigator carry? | The TU's 35-day trial and a 60-day voyage, Monte Carlo over the rate's parts | wempe_errorbudget.js
12 | Would a Wempe made to its drawings work, and how is it tested? | The unsized parts' tolerances from the escapement's swing over the wind; the bench's tests with their pass figures; 2,000 movements made to tolerances, as made and after the bench | wempe_tolerances.js, wempe_bench.js, wempe_montecarlo.js
13 | How does the escapement compare with a period text's rules? | Each proportion against Watch and Clock Escapements (1904), Ch. III; reported, never judged | keystone.js
14 | Is the balance's damping right? | A running 6MX's swing read frame by frame off a video, fitted with the Wempe's balance equation | wempe_swing.py, wempe_startup.js

Units: millimetres and micrometres (µm), newtons, seconds a day (s/d, + gaining). The swing is the balance's amplitude, each way. The model runs its balance at the train's half second; the drawn hairspring with the weighed balance gives a little less (section 8), which a maker times out. A rate of 4 s of time is a mile of longitude at the equator. Each tool's whole output is under its checks ("its whole output"), as it printed it when this page was built.
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
