OrelMag/marine-chronometer-model/marine-chronometer-source/chronometer-working-model/verification/fig2-overlay.png

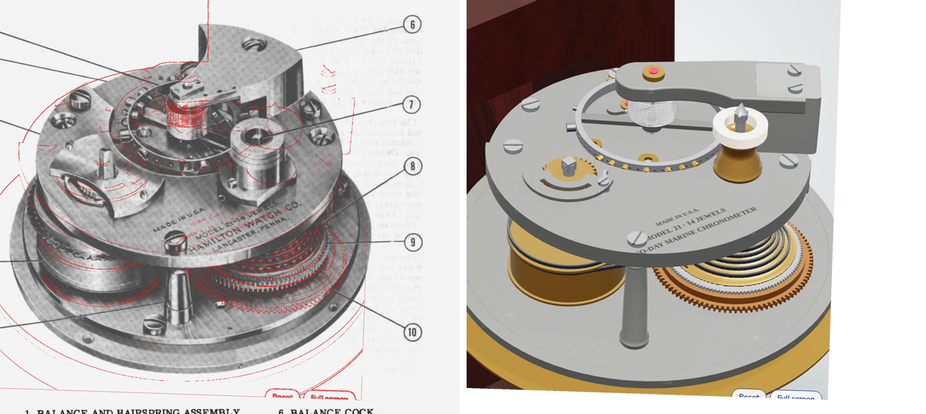
marine-chronometer-source/chronometer-working-model/verification/fig2-overlay.png
