OrelMag/marine-chronometer-model/marine-chronometer-source/chronometer-working-model/verification/lower-bridge-comparison.png

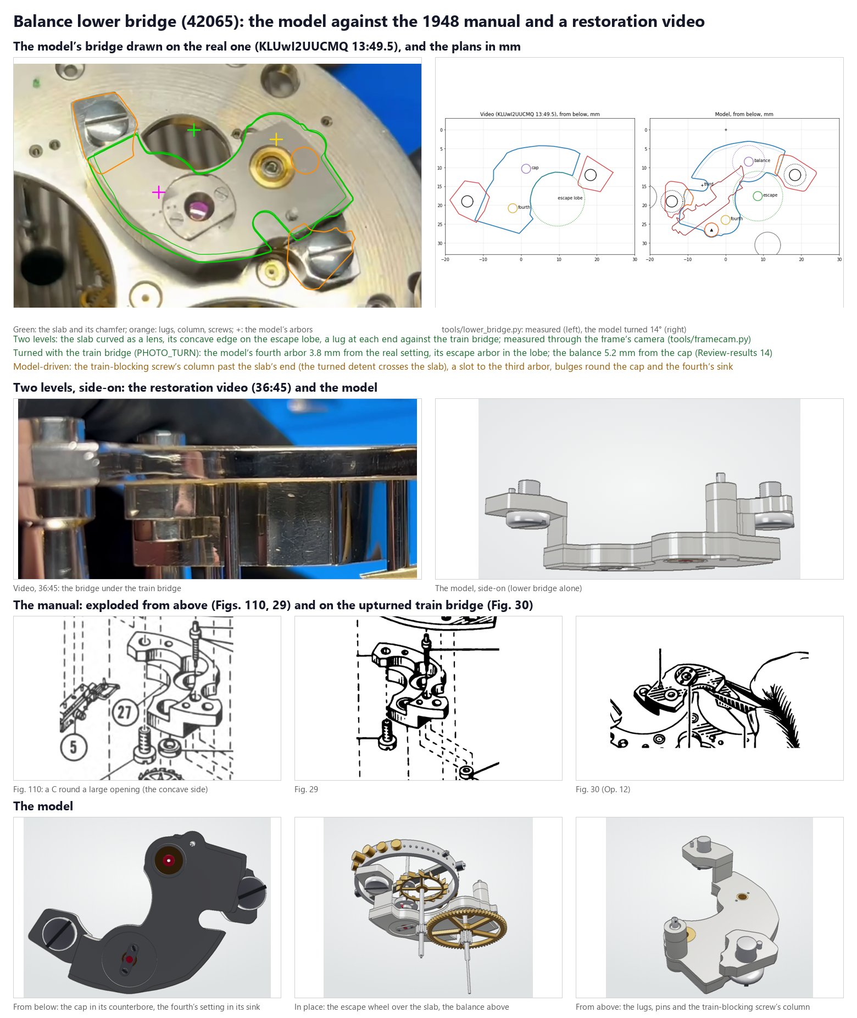
marine-chronometer-source/chronometer-working-model/verification/lower-bridge-comparison.png
