OrelMag/marine-chronometer-model/marine-chronometer-source/chronometer-working-model/verification/real-chronometers/assets/ac_FpolZSipVmQ.png

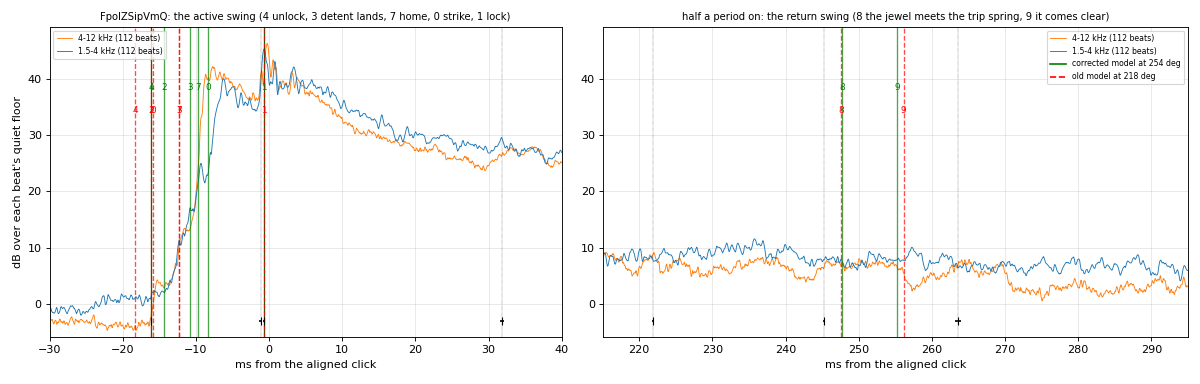
marine-chronometer-source/chronometer-working-model/verification/real-chronometers/assets/ac_FpolZSipVmQ.png
