OrelMag/marine-chronometer-model/marine-chronometer-source/chronometer-working-model/verification/topview-comparison.png

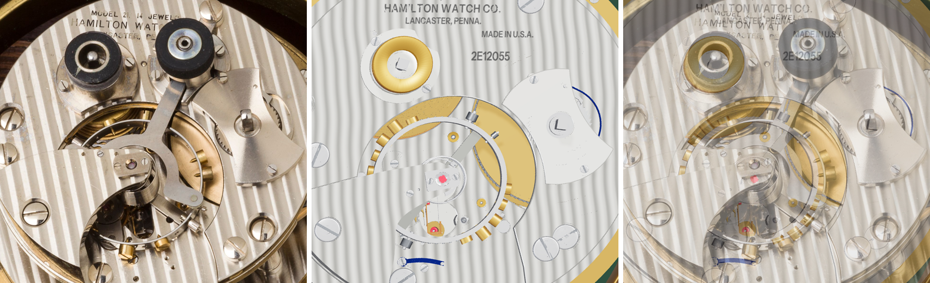
marine-chronometer-source/chronometer-working-model/verification/topview-comparison.png
