OrelMag/marine-chronometer-model/marine-chronometer-source/chronometer-working-model/verification/train-bridge-comparison.png

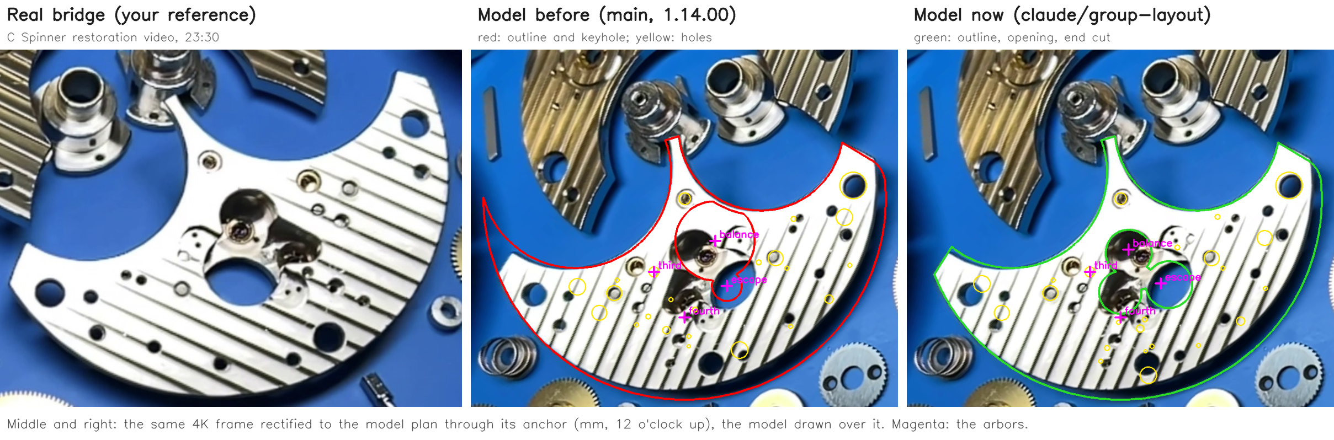
marine-chronometer-source/chronometer-working-model/verification/train-bridge-comparison.png
