OrelMag/marine-chronometer-model/References/photo-dial-hamilton-maritime-commission.jpg

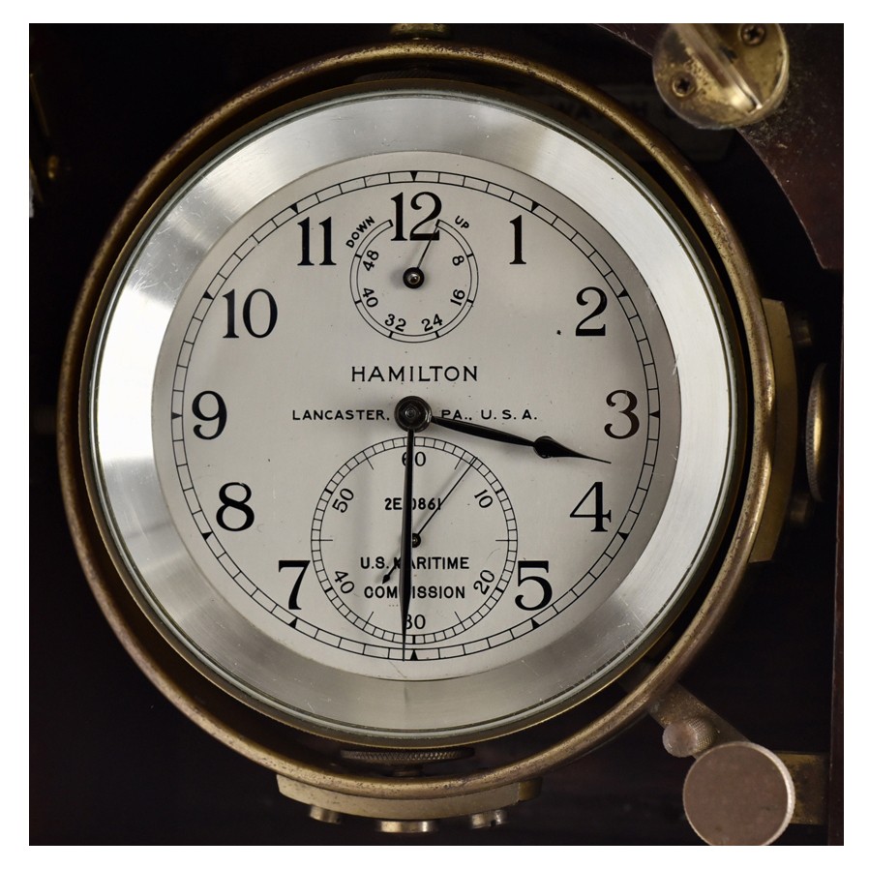
References/photo-dial-hamilton-maritime-commission.jpg
