OrelMag/marine-chronometer-model/site/verification/real-chronometers/assets/ac_We1dLNXiBj0.png

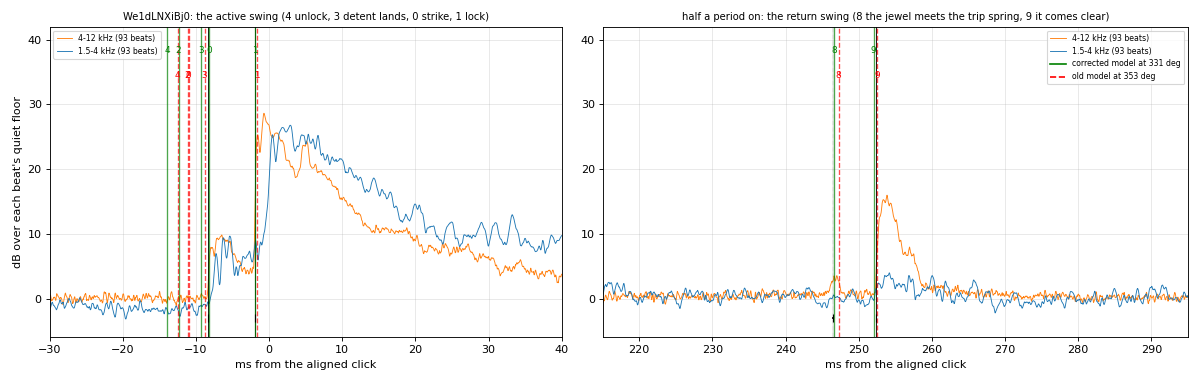
site/verification/real-chronometers/assets/ac_We1dLNXiBj0.png
