OrelMag/marine-chronometer-model/CHANGELOG.md

# Changelog

What changed on the site, newest first. `build.py` reads this file: the top version and the list go into the built page's last panel section, Version … · what's new (the About dialog's byline shows the version too).

Versions are `M.mm.pp`. The major `M` is 1 from 1.05.00, the first release to carry a number on the site, and goes up only for a milestone. The minor `mm` goes up with new features or parts (a merged branch), and the patch `pp` with fixes and small changes. Every deploy is a release: `python build.py --release patch -m "what changed" --site-url https://www.marinechronometermodel.com` (or `minor` or `major`) adds the next version here with today's date, then builds; commit it, and `python deploy.py` puts it live (it refuses a changed page under a version already live). Each `-m` is one line. Write for visitors: what they will see, not how it was done. Versions up to 0.04.01 were numbered afterwards from the git history, one per day.

## 3.85.05 · 2026-11-11
- Essay: the oil table lists every point the manual oils or greases (the winding pawls' posts, the stop-bar, the barrel arbor), and the order of work puts the winding stop where the manual does
- Essay: two of the Model 21's escapement figures brought up to date: how far the wheel drives the impulse jewel, and the hairspring setting that cancels the escapement's error
- Essay: the lunar distance is taken at 20:30 GMT, in twilight with the horizon still in sight
- Essay: chart labels are no longer struck through by their lines, the model names in the top bar are single buttons again, and the workbook waits for an altitude before working a sight
- Essay: small corrections to wording and punctuation

## 3.85.04 · 2026-11-11
- The row of views under the model shows an arrow where it runs past the edge (phones and tablets), scrolls sideways with a mouse wheel, and fits whole on a desktop: the Wempe's Transport box was cut off
- A long part card stops above the views and the play bar and scrolls, instead of running under them
- The play bar keeps 'h of power left' together on a phone
- The Essay link in the Wempe's Its drawings bar matches the tabs beside it

## 3.85.03 · 2026-11-11
- Essay: the Model 21's mainspring, train counts and sources brought up to date with Hamilton's factory drawings and the model's true size
- Essay: the lunar distance's equations and the maker's table of limits read properly on a phone
- Essay: the clock-error figure's distance scale no longer overprints a number, and its arrows point the right way
- Essay: small corrections to wording and stale references

## 3.85.02 · 2026-11-10
- 6MX: the bezel's white sight cone no longer shows black dashes

## 3.85.01 · 2026-11-10
- 6MX: a white sight cone inside the bezel, sloping from under the glass down to the dial just outside the minute track, as measured on two 6MXs

## 3.85.00 · 2026-11-09
- Wempe: the winding key in brass, as a key of 1943 is photographed taken apart; Variants, Key, shows it black, as its drawing gives it

## 3.84.00 · 2026-11-09
- Soviet 6MX case: bracket screws in slots, the locking bracket's hook with its slot, the + and − marks, a diamond-knurled bezel with its glass flush, a 1.0 mm thread and a brass key, as photographed
- Soviet 6MX: the transit lock's lever turns through the gimbal ring's slot into the hook, as on the drawings
- Soviet 6MX: a smaller gimbal ring, 133 mm inside, without lock nuts; Wind turns the ring and the case over together
- Fixed: the 6MX's key showed black after the page repainted it

## 3.83.02 · 2026-11-08
- The Wempe's parts list sorts each part under its own heading (the balance, escapement, fusee and motion work had been listed one heading out)
- The Wempe's lettered sheets show as a compact thumbnail inside the panel
- On a phone or tablet, the panel's buttons are their intended 44 px, not 60
- On a phone, the walkthrough and the panel's links no longer scroll their section under the tabs

## 3.83.01 · 2026-11-08
- A file the site doesn't have is no longer kept by the browser: an image asked for while a release was going up (the Wempe's assembled sheet) showed broken for ten minutes.

## 3.83.00 · 2026-11-08
- Wempe: a new lettered sheet of the movement assembled, photographed from the train side, the dial side and between the plates, and cut open through its arbors; every textbook letter kept and 40 more parts numbered, with eight close-ups (under Take it apart)

## 3.82.03 · 2026-11-07
- Soviet 6MX: re-checked part by part against photographs of Kirov 247 and three other Kirovs
- Soviet 6MX: the cannon pinion's square turned so a corner points along the minute hand, as on the real dials
- Soviet 6MX: the dial screws' countersinks, the box's badge, the outer box's catch and a contact access hole corrected

## 3.82.02 · 2026-11-05
- Fixed: false lines across some Wempe parts where pieces of one solid met: the fusee wheel, the maintaining detent, the minute hand and the 6MX contact disc.

## 3.82.01 · 2026-11-05
- Fixed: the Wempe fusee's flange had a line across the chain's slot, a sheet of no width left where its two sweeps met.
- Fixed: a slanted facet cut into the fusee's first rib at the far end of that slot; the pocket now ends square, as drawn.

## 3.82.00 · 2026-11-04
- The Wempe's 3D moving parts (beside its report, section 13) colour each part by its load against its load in running, with buttons to jump to each run's moments (let go, the clicks catching, the blow, the stop) and a table of every joint's load at the moment shown.
- The 3D viewer worked out again on today's Wempe: its stresses, the let-go study and the report's section 13; the maintaining ratchet's tooth now agrees with its formula.
- Fixed: the 3D viewer magnified the deviations of bodies the run holds rigid.

## 3.81.03 · 2026-11-04
- The Wempe's export to Blender takes two settings for the new film of the chronometer at work (the hands' time and the mainspring's shapes); the page and its downloads are unchanged

## 3.81.02 · 2026-11-04
- Fresh link-preview pictures for the Wempe, the Hamilton and the essay, showing the models as they are now

## 3.81.01 · 2026-11-04
- The Wempe's shading fixes of 3.80.01 (the hour hand's root, the cannon tube end, the fusee bush flange) together with 3.81.00's corrected parts

## 3.81.00 · 2026-11-03
- The Wempe's parts checked a third time against their drawings: the detent's horn keeps its thickness to the tip, the banking screw's hole is centred in the detent block, the pillars' lead is 5°, the set-up ratchet, its square and the mainspring's hook are set together as drawn (the set-up 0.7125 turn), and the box's strap screws are countersunk
- Each part's CAD file and operation sheet rebuilt for those changes

## 3.80.01 · 2026-11-03
- The Wempe's hour hand no longer shows stripes down the root of its blade
- The Wempe's cannon tube end and fusee bush flange shade smoothly, without facets or bands

## 3.80.00 · 2026-11-03
- Wempe: Overhaul, under How it works: take the movement down and put it back together, part by part, in the order the Soviet Navy's 1958 repair book gives for the MX, with its checks of the escapement and its oils
- Wempe: where the book says only "and all the parts", each step says it is estimated; the order is the one the model's clearance check takes it apart in

## 3.79.02 · 2026-11-03
- The Wempe's lettered Laid out sheet: no two leaders cross any more

## 3.79.01 · 2026-11-03
- Blender export: the Laid out control now shows the schematic plates that stand in for the frame (they stayed hidden), on both models

## 3.79.00 · 2026-11-02
- The Wempe's export to Blender now has the Laid out motion, the train laid out along the barrel-fusee line, and the rig a laid_out control to pose it

## 3.78.01 · 2026-11-02
- Beat Error Meter: while it listens, a strip shows what the microphone hears with each click marked, and says whether ticks are reaching it and where to hold the watch. A recording that gives no reading now says why: no ticking in it, or ticks too faint.
- Beat Error Meter: a Long listening time (up to 2 minutes, in Settings) for faint watches, and knocks and rustles are cut out before the beats are averaged. When the usual frequency range gives no reading, others are tried, and a reading found only there is shown as Uncertain.

## 3.78.00 · 2026-11-02
- New: the Beat Error Meter at /beat/. Hold a mechanical wristwatch against your phone's microphone and tap Listen: it finds the beat, then gives the beat error, the rate in seconds a day and both intervals, with the beats drawn as a timegrapher draws them.

## 3.77.00 · 2026-11-02
- A link now keeps the camera: turn, zoom or pan the model and the page's address carries that view, so a shared link opens exactly where you left it, on both chronometers.

## 3.76.01 · 2026-11-02
- The Wempe's lettered Laid out sheet is laid out anew: the elevation over the plan, the isometric view over its four numbered close-ups, and the key across the bottom saying what each part does.

## 3.76.00 · 2026-11-02
- The Wempe's Laid out view has a lettered sheet: the train in elevation, plan and isometric (its plates hidden), each part lettered as a textbook's developed drawing letters it, with close-ups of the mainspring and fusee, the maintaining power, the escapement and the balance. Open it from the thumbnail under Take it apart while Laid out is on.

## 3.75.01 · 2026-11-02
- The Hamilton's drawn parts: the finished detent now stands the right way up (its blade at the escape wheel's level), its cross-piece and jewel block cut to the sizes measured on video, with holes for its steady pins, wedge pin and bracket screw and a notch for the adjusting screw.

## 3.75.00 · 2026-11-02
- The Hamilton's drawn parts page has renders: every part with a factory drawing, and every subassembly made of drawn parts only, rendered in Blender, on each part's card and in a new Renders gallery.
- A new subassembly from the drawings: the barrel with the set-up ratchet on its arbor's square.

## 3.74.01 · 2026-11-02
- The Hamilton's drawn parts page: the detent's placeholder parts rebuilt as sound solids (they were inside out), holed for their screws, the clamp screw seated on its washer
- The drawn helical spring's closed turns no longer touch, the mainspring end's slot has its drawn broken corners, and the detent's locking stone sits where the model has it
- Every drawn part now checked as a solid, its STEP file read back, and its outline drawn without seam ticks or triangle diagonals

## 3.74.00 · 2026-11-02
- Hamilton parts as drawn: the whole detent assembly at scale, the drawn detent with placeholders for its block, screws, trip spring and bracket taken from the 3D model; where they disagree is listed

## 3.73.02 · 2026-11-02
- Hamilton parts as drawn: the detent finished, reconstructed from Hamilton's blank and operation sheets with the 3D model's measurements where the finished drawing is missing

## 3.73.01 · 2026-11-02
- Hamilton parts as drawn: checked by eye against Hamilton's drawings; the barrel arbor's hook, the fourth pinion's stem and the winding pawl spring's tapped holes corrected

## 3.73.00 · 2026-11-02
- Hamilton parts as drawn: every part audited against Hamilton's drawings and corrected (among them the barrel's outside, the fusee arbor and wheel, the detent's window and the ratchets' teeth)
- New subassemblies put together from the drawings alone: the fourth wheel and pinion, the barrel with its cap and arbor, the sustaining wheel with its pawls and springs, the whole fusee with its maintaining work, and a run of chain; each can be taken apart with a slider

## 3.72.00 · 2026-11-02
- New page: the Hamilton Model 21's parts as Hamilton Watch Co. drew them (hamilton/parts/): 23 parts in 3D from the factory drawings, each with its drawn sizes, the readings still unsure, an operation sheet and a STEP file

## 3.71.03 · 2026-11-01
- The Wempe's verification report: both builds keep their let-off from 4 to 36 °C; only the drawings' own version is short of it in heat

## 3.71.02 · 2026-11-01
- Wempe: the barrel's slot for the band's hook turned to fit it, which no longer runs into the drum

## 3.71.01 · 2026-11-01
- The Wempe: the carrying case's eye screws have DIN 96's round head and slot, where they were flat-headed

## 3.71.00 · 2026-11-01
- The Wempe: its screws' slots are cut into their heads, where dark bars lay over them before; the drum's slot for the Steg is a clean window through its bottom
- The Wempe: the 6MX contact lever leaves its staff's hole open; the closing plate's round, the transit lock and the hands' roots are smooth; the carrying case's eye screw is the parts list's DIN 96 3 x 15; small corrections to the top plate, dust plate, set-up ratchet and maintaining detent arbor
- The Wempe: the swing and rate worked out again for the balance as now weighed (191.1-200.6° over the wind); the bowl's CAD file and operation sheet drill both closing plates' spring holes

## 3.70.04 · 2026-11-01
- The jewels look like rubies: a deep red stone with a polished face's sharp reflection, where they were flat pink
- The glass over the dial reflects more at a slant and stays clear seen square on, as glass does; the Wempe's bezel glass too
- Clicking through the glass still picks the dial and hands behind it

## 3.70.03 · 2026-11-01
- The Hamilton now opens with no balance stop fitted; the manual's locking arm and the Navy's Y-arm brake are under Variants, Balance stop, and locking the balance under Stopping and starting fits the arm

## 3.70.02 · 2026-11-01
- The Hamilton now shows the manual's balance locking arm by default; the Navy's Y-arm brake, with its seal, plunger and lever, is under Variants, Balance stop

## 3.70.01 · 2026-11-01
- The Wempe: the blind holes for the steady pins in its cocks and bridges now end in the drill's 118° point, as their drawings show them, on the page and in the parts' CAD files and operation sheets

## 3.70.00 · 2026-11-01
- The Wempe: a second closing plate under Variants, as a Wempe's is photographed in The Mariner's Chronometer (Fig. 2.32): no knob, but a slot riding a stop peg in the bowl's foot, and its spring a flat steel strip coiled round the hole. The drawings' plate, with its knob and wire spring, stays the default.

## 3.69.03 · 2026-11-01
- Labels no longer slow the Wempe page to a crawl: what covers each label is now worked out about a hundred times faster, on both models

## 3.69.02 · 2026-11-01
- The Wempe's sources: what Klassik Uhren 3/2006 says of the chain and band, the dial, the features and the serial numbers, recorded beside the drawings.

## 3.69.01 · 2026-11-01
- Wempe: the fusee band's maker's sheet says how a band is fitted and what a post-war Glashütte band measured

## 3.69.00 · 2026-11-01
- The Wempe's Making it: CAD files (STEP) and operation sheets for the 6MX's contact (sizes estimated from photographs, as each sheet says), so that every line of the Wempe's parts list now has a recipe or says what to buy: 187 made parts and 106 bought lines.

## 3.68.01 · 2026-11-01
- The Hamilton's work-in-progress note: its parts are being recreated from Hamilton's drawings with the help of the NAWCC, with special thanks to Thomas Stocker

## 3.68.00 · 2026-11-01
- The Wempe's Making it: CAD files (STEP) and operation sheets for the winding keys, the transit lock (each of its pieces), the barrel arbor's hook, the wire spring's stud, the band's hooks, the 6MX's chatons and the detent block of every version with its screws; the chain, the band's strip, the boxes' fittings, jewels and standard parts as parts to buy. 171 made parts and 101 bought lines in all.

## 3.67.01 · 2026-11-01
- The Wempe's barrel arbor (1943) has its hook's hole drilled right through the core, as its drawing shows.

## 3.67.00 · 2026-11-01
- The Wempe's Making it: CAD files (STEP) and operation sheets for the fusee body with its chain groove as an exact solid, the maintaining spring, the maintaining detent's arbor and its screws; the hairspring's collet and stud, the balance's arm and mass screws and the stud's screw, and the detent block of 1943, each part's card giving the version the page shows. 135 made parts and 39 bought lines in all.

## 3.66.01 · 2026-11-01
- The Wempe fusee's flange: its two ribs and the chain's slot between them now square and to the drawing's figures (0,87 slot, 0,37 rib, 2 over both)
- The Wempe fusee's stop bar slot: 1,1 deep over the whole of the bar's upper end's side, as the drawing writes it; the bar thick only inside the small end's recess

## 3.66.00 · 2026-11-01
- The Wempe's Making it: CAD files (STEP) and operation sheets for the case: the bowl, the bezel, the closing plate, the brackets, the gimbal ring, the lock nuts and the case's screws, each size on a line of its own; the glass, the closing spring, the box and its wood screws as parts to buy. 123 made parts and 37 bought lines in all.

## 3.65.01 · 2026-11-01
- The Wempe's box latch rebuilt as on Lange No. 5591: a slotted latch plate with its knob on the box's front, and a hook plate on the lid.
- The Wempe's screw numbers corrected from its general arrangement: the movement ring's screws are WN-56, the lower balance settings' WN-18.
- New sources for the Wempe: two wartime Langes in their boxes (Nos. 5395 and 5591) and the article "Das Einheitschronometer" (Klassik Uhren 3/2006).

## 3.65.00 · 2026-11-01
- The Hamilton Model 21 is rescaled to Hamilton's own factory drawings: every plate, bridge, wheel, screw and the case are 1.117 times larger (the pillar plate now 97.8 mm across), the balance and escapement kept at the sizes measured on them
- The Hamilton's escape arbor stands where the drawings put it, 11.90 mm from the fourth wheel, and its detent, mainspring and train figures are worked out again at the new size

## 3.64.00 · 2026-10-31
- The Wempe's Making it: CAD files (STEP) and operation sheets for the motion work, the four hands, the dial and its fittings, and four of the case's screws: 101 made parts and 32 bought lines in all.

## 3.63.02 · 2026-10-31
- The Wempe's fusee: the stop bar's slot across its small end is now cut cleanly as its drawing gives it, straight walls out through the rim, the groove ending square at its end point N, and no stray faces, slivers or holes where the slot meets the groove.
- The Wempe's fusee body is drawn as one closed solid, so its faces shade and outline as one machined part.

## 3.63.01 · 2026-10-31
- The Hamilton Model 21 is marked work in progress: Hamilton's own factory drawings and the British Museum's measurements show the model is about 12 % too small throughout, and it is being rescaled and rebuilt from the drawings; the page's header and About say so.

## 3.63.00 · 2026-10-31
- Wempe: choose which subassemblies the Exploded view takes apart, each on its own or all; the detent and the motion work come apart too
- Wempe: a Pieces slider sets how far each subassembly's pieces spread, wider than before by default
- Wempe: with the fusee or barrel apart, the chain comes off too and lies coiled beside the barrel

## 3.62.00 · 2026-10-31
- Wempe: the Exploded view can take the fusee, the barrel and the balance apart too, each beside the movement with its pieces spread along its arbor (Take it apart, Subassemblies: Apart)
- Wempe: isolate a subassembly (the fusee, barrel, balance, detent or motion work) from a part's right-click menu or the Parts list; the view closes in on it

## 3.61.04 · 2026-10-30
- Escape closes a part's card
- Help takes the keyboard when it opens and gives it back when it closes
- Links on a part's card are readable in dark mode

## 3.61.03 · 2026-10-30
- The essay's Walk through it button shows its label again
- Clearer text where it was faint: the Wempe's sure tags, figures out of range and links in the panel, in light and dark
- The panel's width handle shows plainly when it has keyboard focus

## 3.61.02 · 2026-10-30
- Dragging the selection's opacity slider no longer makes it jump away from the pointer
- The hint gets out of the way of the selection bar instead of squeezing beside it
- Pressing a choice in the panel no longer nudges the buttons beside it

## 3.61.01 · 2026-10-30
- On a landscape phone the hint sits under the tools instead of squeezed beside them
- The Wempe's list of variant changes stays inside the panel
- The play bar's hours of power left no longer break over two lines

## 3.61.00 · 2026-10-29
- Selection: Through, beside Lasso (or Shift+Alt-drag), lassos the parts behind others too, every part shown inside the loop
- Reset opacity on the selection bar brings every faded part back to full opacity, whether it is selected or not

## 3.60.00 · 2026-10-29
- The Wempe's balance and detent block as parts to make: the balance's rim with its arm, masses, timing screws and weights, the hub, the rollers, the jewel settings and their screws, the detent block and its screw, each with a CAD file (STEP) and an operation sheet on its card; the jewels and pins as lines saying what to buy.

## 3.59.02 · 2026-10-29
- The Wempe's verification report brought up to date with the escapement of 1943's and the 6MX's corrections and their re-weighed figures.

## 3.59.01 · 2026-10-29
- The Soviet 6MX's swing and banking tables, and the essay's figures for it, worked out again with its escape wheel's arbor reweighed after 3.58.01's corrections.

## 3.59.00 · 2026-10-29
- The Wempe's detent and its gold spring as parts to make, each with a CAD file (STEP) and an operation sheet on its card; the locking stone as a line saying what to buy.

## 3.58.01 · 2026-10-29
- The Wempe's escapement of 1943 checked against its three photographed movements: its detent block is now fixed by a stud beside an open hole, with its own steady pins, and its escape wheel's collet is one straight cone.
- The Soviet 6MX's detent block now has the slit along its banking screw that locks the screw, the screw's head is a little larger, and its escape pinion is shorter and higher, as Kirov No. 247's photographs show.

## 3.58.00 · 2026-10-29
- More of the Wempe's parts to make: the fusee's wheels, ratchets, cover plate, dust plate and Vorreiber, the barrel's drum, lid, hook block and Steg, the clicks, the stop bar and the maintaining detent, each with a CAD file (STEP) and an operation sheet on its card; the springs' strip, wire and pins as lines saying what to buy.

## 3.57.00 · 2026-10-29
- More of the Wempe's parts to make: the fusee arbor and the barrel arbor, each with a CAD file (STEP) and an operation sheet on its card; the hairspring and mainspring as lines saying which strip to buy.

## 3.56.00 · 2026-10-29
- More of the Wempe's parts to make: the bushes, the seconds jewel's setting, the dial studs and the escape wheel's collet, each with a CAD file (STEP) and an operation sheet on its card; the seconds jewel as a line saying what to buy.

## 3.55.00 · 2026-10-29
- The Wempe's train wheels and escape wheel as parts to make: the centre, intermediate and seconds wheels and the escape wheel, each with a CAD file (STEP) and an operation sheet on its card.

## 3.54.00 · 2026-10-29
- The Wempe's arbors as parts to make: the centre, intermediate, seconds and escape arbors with their pinions, and the balance staff, each with a CAD file (STEP) and an operation sheet on its card.

## 3.53.00 · 2026-10-29
- The Wempe's frame as parts to make: each plate, pillar, bridge, cock, bush and their screws has on its card a CAD file (STEP) to download and an operation sheet: the setups in a suggested order, each with its sketch, sizes, fits and the drawing each size comes from. The rest of the parts follow.
- Five of the Wempe's frame sizes are now drawn at the middle of their tolerances (the barrel bridge's thickness, the fusee bush's flange, the dust bush's body, collar and neck).

## 3.52.00 · 2026-10-29
- A new layout on both models: the controls in four tabs, Explore, Run, Look and Advanced, in place of seventeen sections in one column
- Stop and go on, the speed, the time, the power left and Wind in a bar on the model, with the views as a row of buttons above it
- A light and dark switch at the top, the tools as icons, and the title on one line, so the model starts higher, on a phone too
- Look: Metal, Tinted or Ink as one choice and Colour by as another; the boxes are switches, and the longer explanations fold away

## 3.51.02 · 2026-10-29
- The Wempe's build book of drawings is withdrawn: it was drawn back from the model's surfaces and wasn't fit to make parts from. Its replacement, a CAD file and an operation sheet for each part, is on the way.

## 3.51.01 · 2026-10-29
- Time: a quarter speed (¼×) beside 1/20× and 1× on both models.

## 3.51.00 · 2026-10-29
- Select several parts at once and fade, hide or isolate them together: Ctrl-click (⌘-click on a Mac) adds a part, Alt-drag draws a lasso round the parts that show inside it, and the Select and Lasso buttons do the same by touch
- The selected parts are tinted blue; the bar over the tools isolates, hides or fades them, and the right-click menu on a selected part acts on all of them; Esc clears the selection

## 3.50.01 · 2026-10-29
- The Wempe's tolerances and navigation figures reworked on the corrected plates and pillars, and its verification report rebuilt with batches 8-11 of the second drawing check.

## 3.50.00 · 2026-10-28
- The Wempe's bridges, cocks, plates, pillars and movement ring checked against their drawings a second time and corrected: the hairspring stud off-centre with its screw at the drawing's 4.2, the pressed bushes and pins a press fit, the pillars 19.6 with their spigots' lead-in, the ring tapped M2.6 with its pin.
- The case and box to their sheets: the closing plate no longer mirrored, the 1940 key one-way with its spring and capped socket, the maker's plate's holes and pins, the outer pivots' lock nuts.
- The whole-movement drawings read again: the lower escape jewel and endstone at the coloured section's thickness, the 6MX contact's holder and lock nut tapped M1.0.

## 3.49.00 · 2026-10-28
- The Wempe's motion work, hands and dial checked against their drawings a second time and corrected.
- The Wempe's hands are pressed on their seats and sit at the heights the motion-work drawing gives, a little lower than before.
- The Wempe's up-and-down wheel is riveted to its pipe, its hand's blade an even 0.3 mm, and the dial is the drawing's 1.2 mm with its screws in tapped holes.

## 3.48.01 · 2026-10-28
- The Wempe report brought up to date with the corrected balance, escapement and train: every run and geometry check recomputed.

## 3.48.00 · 2026-10-28
- The Wempe checked against its works drawings a second time: the balance, hairspring, stud, escapement and going train corrected to their sheets.
- The Wempe's escape wheel as its drawings make it, the teeth standing on a recessed rim; Wempe 3955 keeps the full rim its photographs show.
- The Wempe's gold spring and detent spring bend where the escapement layout marks them, and the detent's pipe runs its drawn length.
- The Wempe's balance masses are 6.35 mm and held by their screws in tapped holes; the hub, timing and mass screws are threaded.
- The Wempe's hairspring is pinned in the stud at its drawn height, and the balance rim carries its four sets of punch marks.
- The Wempe's train wheels' hubs are flush, the seconds post is its finished 7.2 mm, and the cannon tube is held by its dents.
- The Wempe's swing, rate, trial and navigation figures recomputed for the corrected parts.

## 3.47.00 · 2026-10-28
- The Wempe checked a second time against its works drawings, each sheet read afresh: the maintaining work, stop work, barrel, chain and fusee corrected to their sheets.
- The Wempe's stop bar and stop spring pins now pass through holes cut in their parts (they sat in solid metal before).
- The Wempe's Vorreiber is pinned through the fusee arbor and seated on its taper, and the dust plate wedged on the square, as their drawings show.
- The Wempe's winding square is 3.1 mm (r6) as drawn, the set-up ratchet and dust plate tapered onto it, and every press fit built tight.
- The Wempe's maintaining detent's step at its drawn 30°, the clicks and click springs to their sheets, and the click springs' fixings shown as riveted.
- The Wempe's band hooks have their slots for the band, the 1941 barrel's lid and bottom the right way round with its oil sinks and prising notch, and the barrel hook block threaded or riveted as each drawing says.
- The Wempe's page gives the mainspring as 1.24 m and the chain as 375 links.

## 3.46.02 · 2026-10-28
- The Hamilton's detent bench test and maker's sheets brought up to date with the refitted hands' weights.
- The Wempe's Contacts view lists the gold spring resting on the detent's square as an expected contact.

## 3.46.01 · 2026-10-28
- The Wempe report's whole-transmission check now couples the escape wheel at its true speed, so the seconds wheel's load on the escape pinion no longer depends on the simulation's time step: it converges at about 56 times its running force and is judged on the worst of eight starts (112 MPa against brass's 120-170, it passes).
- The Hamilton's transmission tool takes the same correction; its figures are unchanged.

## 3.46.00 · 2026-10-28
- The Wempe's hairspring collet now holds the spring's inner end with a half-round brass pin in its 0.8 mm hole, as at the stud (a loose rod held nothing before)
- The Soviet 6MX's barrel cap screws now go into tapped holes
- Pins and fits checked more tightly on both models: the Wempe's click spring pins and the Hamilton's hour and minute hand collets refitted to sit properly on their posts
- The Wempe's strength and shock-resistance figures are now worked out from several starting points, so a tiny change elsewhere no longer flips their verdict

## 3.45.03 · 2026-10-28
- The Wempe's verification report worked out again on the corrected swing: all 31 checks pass

## 3.45.02 · 2026-10-28
- The Wempe's swing over the wind now matches the escapement run in time: its rate changes by under 0.2 s a day between full wind and run down, as its isochronism check asks (the last release had only half this fix)
- The Wempe's tolerances, bench tests, made-chronometer trials, navigation figures and maker's sheets worked out again on it

## 3.45.01 · 2026-10-27
- The Wempe's hairspring stud as its drawing has it: a solid upright, the spring's end pinned in its 0.7 mm hole beside a half-round brass pin (it had been drawn with a slot the drawing doesn't have).

## 3.45.00 · 2026-10-27
- The Wempe's bench now sets the depth of lock for the whole of its working range, 4-36 °C: the window is 231.7-237.9 µm (it was 231.7-244.4 at 20 °C alone), and a maker sets it just under the top, 237.8 µm, so the teeth's wear, which only makes the lock shallower, has three years' room before the next overhaul
- The banking screw on the Wempe's page shows the new window and the bench's aim

## 3.44.01 · 2026-10-27
- The Wempe's escapement model corrected: it now times each landing of the locking stone on the escaping tooth exactly, which had held the swing at full wind about 3° low; the swing over the wind is now 192.5–203.9° (197.4° half wound), matching the escapement simulated beat by beat
- The Wempe page reads the balance's swing from a precomputed table, so it stays quick

## 3.44.00 · 2026-10-27
- The Wempe's verification report now runs the escapement of 1943 (as photographed, with the 6MX's detent and the banking screw) through the same physics: it keeps time as the last revised escapement does, its swing 193-204° over the wind

## 3.43.00 · 2026-10-27
- The Wempe's verification report has a new section on the movement in heat and cold, over the 4-36 °C its Soviet successor's specification works it in: the gears, the arbors' end play, the escapement and the chain
- Found: the escapement's let-off is the narrow part. At 36 °C the steel detent, held by the brass frame, draws its gold spring 2 µm back from the balance, enough to cost a third of its let-off; how deep the lock may be set is about halved (open, in the Wempe's README)

## 3.42.01 · 2026-10-27
- The Wempe's Its drawings essay and verification report corrected on how quickly a running 6MX's balance loses its swing, measured off a video: 141 s (133–158 s), where an error in the fit had given 332 s; the model keeps its 111 s

## 3.42.00 · 2026-10-27
- The Wempe's banking screw can now be turned (Swing and isochronism, Banking screw): the screw turns on the model, and the depth of lock, the lock and let-off, the swing over the wind and whether the escapement still works are shown as it goes; As drawn and The bench's aim set it back
- The Wempe's escapement as last revised now stands at the heights its drawings give: the 1946 balance staff's rollers read again, the escape wheel just under the top plate, the detent and its block higher, the banking screw drawn whole under the detent's pipe
- The Wempe's build book redrawn with the detent's blade and these heights

## 3.41.00 · 2026-10-27
- The Wempe's detent now sits as its drawing draws it: its thin blade flush with the side of its thicker part that faces the block, which turns it a third of a degree about its locking stone; the escapement retuned to match (its swing 197° when half wound)
- Every one of the Wempe's drawing sheets now matches the model or records why not (the drawings ledger)
- The Wempe's verification report rebuilt; the build book follows in the next release

## 3.40.00 · 2026-10-27
- The Wempe's open drawing readings settled but one (the detent's blade, next): the parts that had been left short of their drawings are now drawn as their sheets give them, or kept for a stated reason (the drawings ledger lists each)
- Among them: the pillars' countersinks, the top plate's escape setting, the balance staff's lower pivot and its hollow cones, the hairspring collet's tapered bore, the detent block's foot, the fusee's groove now cut smooth, the maintaining spring's eye and swell, the click springs' holes, the barrel's lid and arbor hook, the mainspring's band hooks, the hour and change wheels' riveting sinks, the box's handles and finger recess, the 1940 key, the key tube and the case's floor
- The Wempe's build book redrawn and its verification report rebuilt; the check of the whole transmission now averages its beat over several starting positions of the gears

## 3.39.00 · 2026-10-27
- Wempe: under Variants, each subassembly can now be shown in its own version (the escapement, fusee and maintaining work, barrel and mainspring, train, dial and motion work, plates and bridges, case and key), for example the escapement as first drawn on a movement otherwise as last revised; the Version buttons still set them all at once
- The Soviet 6MX's escapement and dial come with its plates, which are drilled for them; a link keeps the mix

## 3.38.00 · 2026-10-27
- Every part of the Wempe now matches its works drawing: all 113 drawing sheets were checked against the model and 55 corrections made (among them the upper cock's boss, the set-up click, the balance's timing weights and screws, the escape wheel's web, the train's shoulders and hubs, the fusee's wheel and clicks, the barrel's lid, the bezel and glass, and the holes for screws and pins)
- Where the Wempe's drawings disagree with themselves or leave a part open, the model says so in its notes; a ledger lists every sheet and every change
- The Wempe's build book redrawn from the corrected parts
- The Wempe's escapement now counts a small blow the locking stone gives the escaping tooth as it falls back, and its lock tolerance is narrowed where the swing would collapse; its swing, rate and navigation figures updated, and its verification report rebuilt

## 3.37.00 · 2026-10-26
- The Wempe's verification report has a new section 22, an independent pass: whether a made Wempe can be built and would navigate, each analysis checked against the audited parts and its sources, with a verdict for each version
- Two fixes on the Wempe's bench: the detent spring's ring test now reads the tapered spring as drawn (its band 69-137 Hz), and the stricter readings of a celestial fix's error are reported beside the navigation verdicts

## 3.36.02 · 2026-10-26
- The 3D viewers of every moving part, beside both verification reports, brought up to date: the Wempe's parts as audited and threaded, the Hamilton's latest changes, each part's stress solved again, and the contact and let-go studies redone

## 3.36.01 · 2026-10-26
- The Wempe's upper balance cock as its drawing draws it: the step under its arm in the right place, and the boss round the balance's setting a true turned cone, no longer faceted.
- The Wempe's set-up click on the barrel bridge as drawn: its beak's tip clean and its back running smoothly into its nose.

## 3.36.00 · 2026-10-26
- The Wempe's build book is now a book of engineering drawings (a PDF beside the page), laid out as the Wempe's own works drawings are: every part in first-angle views with hidden lines removed, turned parts in half section, flat parts with a section through them, each with its sizes, a picture of the part and the title block
- Each part's second sheet lists its holes (where, how big, how deep), its outline as a machine would cut it and its teeth; each assembly has a sheet with its pieces numbered and listed; screw threads and pinion leaves are drawn as engineering drawings draw them
- A part card's Drawing button now opens the book at that part's sheet
- Fixed: a part card's size and weight, and its drawing, counted the Laid out view's stand-in plates as part of the real part

## 3.35.00 · 2026-10-26
- The Wempe's screws have real threads: each a right-hand metric thread at its size's pitch (an M2.6 0.45 mm), and the tapped holes in its plates, bridges, pillars and detent block threaded to match, every screw sitting on its hole's thread

## 3.34.00 · 2026-10-26
- The Hamilton: the fusee chain's hooked end, as a restoration video shows it, hooked into the fusee at the end of its groove
- The Hamilton: the third wheel sits lower and its lower jewel at the bar's face, measured on the video
- The Hamilton: a train pillar moved 2 mm to where four video frames put it

## 3.33.00 · 2026-10-26
- The Hamilton winds as the Wempe does: Wind turns the case over in its gimbals, opens the shield plate and puts the key on from its block
- The Wempe: Wind with the key, to watch the movement wind half a turn at a time
- The Wempe: the load path in colour and a close-up of the maintaining spring while it winds, with the time it has left

## 3.32.06 · 2026-10-26
- The Hamilton's bezel sits lower: the dial is level with where the bezel starts to taper, and the glass is at its top with a bright cone down to the dial, as on real Model 21s
- The winding key at its real size, 98 mm long, measured on a restoration video, standing pipe down in its block in the box
- The box narrower, 172 mm, with thinner walls, as photographs of real boxes show

## 3.32.05 · 2026-10-26
- The Wempe's mainspring fitted to its 1941 force measurement with the coils' friction counted: the drawn 0.37 mm strip now gives the measured pull, its stress within the steel's limit
- The Wempe's 1950s build swings 226-237° over the whole wind

## 3.32.04 · 2026-10-26
- The Wempe barrel's chain slot cut at its drawn 45°, the movement ring's screw holes open through its cone, and the dust plate's and fusee cover plate's outer chamfers
- The Wempe's escape arbor has 0.06 mm endshake, as the Soviet repair book of its copy gives
- The Wempe box has the small pins its drawing shows over the gimbal pivots

## 3.32.03 · 2026-10-26
- The Hamilton's bezel is the right way up: its knurled ring at the glass, a plain skirt flaring into it below, the glass set under a bright sight cone, and the bezel screwed onto a threaded rim on the case.

## 3.32.02 · 2026-10-25
- The Hamilton's case now hangs in its gimbals as a real one does: its pivots 4 mm nearer the bezel, as measured on the restoration video and an auction photograph, so the case swings a little lower and faster.
- The Hamilton's case loses the deep band under its bezel: its wall now runs plain up to a short lip under the thread, and the case brackets' screws and the latch keeper follow.

## 3.32.01 · 2026-10-25
- The Wempe's fusee, barrel and their arbors have the screw, pin and rivet holes their drawings give; the maintaining clicks their drawn sinks and springs; the box's handles a finger recess in the wood
- The Wempe's fusee sits where its 1948 drawing puts it, its large face re-turned at assembly and cut back outside 33 mm
- The Wempe barrel's hook block, Steg and mainspring turned to their drawn places opposite the chain's slot
- The Wempe case brackets' boss 9 mm wide as drawn, and the gimbal ring centred on its pivots

## 3.32.00 · 2026-10-25
- The Hamilton's hour wheel drawn with the short teeth a restoration video shows (its tips 8.6 mm out, not 8.8)
- The detent's trip spring drawn its full 6.45 mm length, its tip under the horn as on the real detent; the escapement's figures, bench tests and maker's sheets follow
- The third wheel's pinion shorter and the escape pinion's leaves longer, measured on video of the arbors
- The fusee's stop slot now has the step its stop-bar strikes
- The case's pivot bushings and the gimbal ring's drawn at the size a loose case bracket shows (7 mm across)

## 3.31.01 · 2026-10-25
- The escape wheel's teeth drawn 1.1 mm thick, as video of a real Model 21 shows them, and the escape pinion's leaves starting higher above the plate
- The escapement's figures, the bench tests and the maker's sheets follow the lighter escape wheel; the fourth wheel's sheet asks for hard brass

## 3.31.00 · 2026-10-25
- Navigating by the Wempe: a new report section follows 2,000 made chronometers each through a month at sea. Both builds leave the navigator about 1.5 miles out in longitude after 30 days (95 % within about 4), within a celestial fix's own error.
- Three of the Wempe's open physics questions are closed: the detent's preload now has a bench limit of 0.80 g, the gold spring gets a test of its return pass, and the hairspring's period is shown to agree with the 1958 repair book.
- The Wempe's assembly check now takes the detent's block out as the 1958 repair book does, sideways under the top plate.

## 3.30.02 · 2026-10-25
- The Hamilton's sustaining ratchet has the hole its sustaining spring's pin goes into, as a restoration video shows the bare wheel, and the pin is drawn at its measured size
- The two winding pawls' ends are a little narrower, as the same video measures them

## 3.30.01 · 2026-10-25
- Exploded view: the Hamilton's mounting ring now comes off the pillar plate, toward the dial

## 3.30.00 · 2026-10-25
- Exploded view: a Take apart switch on both models. Movement spreads the movement alone, as before; All takes the case and box apart too, the gimbal ring, the bowl, its bezel and glass, the latch, the key and the lids, under the movement

## 3.29.02 · 2026-10-25
- The build book prints again: its drawings are far lighter, so the Wempe's book no longer crashes the page, and the Hamilton's prints faster
- The Build book button says it is building while it works

## 3.29.01 · 2026-10-25
- The balance cock's top re-measured on its holes as they now stand, and the cock turned 5 degrees about the balance staff so its straight edge meets the barrel bridge's horn, as photographs of the movement show
- The barrel bridge's horn on the cock's side follows its measured curve to the rim

## 3.29.00 · 2026-10-25
- The Wempe can now be built from its own maker's sheets: every part's material, finish, fit, tolerance and bench test, with a drawing at scale, under Making it, and the whole as a printable build book.
- The Wempe's report has three new sections on whether one could be made: wear and service life, the key forced, the motion work and the estimates swept; the frame under the mainspring's load, the order it comes apart and goes together, and each part checked against what a lathe, mill and drill can cut; and the build book.

## 3.28.12 · 2026-10-25
- The Hamilton's crystal and its box's glass can be clicked: click what is behind the glass, then click it again
- The Hamilton's case has cards for its pieces: the case, bezel, crystal, support brackets, latch keeper and shield plate

## 3.28.11 · 2026-10-25
- The Wempe's bezel glass can be clicked: click the dial, then click it again to pick the glass in front of it

## 3.28.10 · 2026-10-25
- The Hamilton's part cards for the gimbal ring, winding key and dust seal now say which of their sizes are measured

## 3.28.09 · 2026-10-25
- In the essay's Winding figure, the half turns of the key now fill from run down as the spring is wound, toward 56 h, instead of emptying backwards

## 3.28.08 · 2026-10-25
- The Wempe's gimbal ring and case brackets drawn to their sheet's sections, so the case turns over in its ring to be wound; the gimbals' pivots with their drawn tips and lock nuts
- The Wempe's centre arbor, its wheel and the top plate's bushes at their drawings' fits
- The Wempe's case and ring swing at their new periods, 0.67 and 0.77 s

## 3.28.07 · 2026-10-25
- The Hamilton's Laid out view now shows the fusee's winding stop, so it holds every part a textbook's developed drawing of a chronometer letters.
- In the Hamilton's Laid out view, click a see-through plate (pillar plate, train bridge, barrel bridge, cock, pillars) to open that part's card.

## 3.28.06 · 2026-10-25
- The Wempe's Laid out view now shows the set-up click and the stop pin, so it holds every part a textbook's developed drawing of a chronometer letters.
- In the Laid out view, click a see-through plate (pillar plate, top plate, bridges, cocks, pillars) to open that part's card.

## 3.28.05 · 2026-10-25
- The Soviet 6MX's detent block no longer has a hole its photographs don't show.

## 3.28.04 · 2026-10-25
- The Wempe opens in plain brass (the hammered gilt is still under Variants, Finish)
- The maker's engraving on the Wempe's top plate is left off

## 3.28.03 · 2026-10-25
- The Wempe's escape pinion is 4 mm long, as its 1943 drawing gives it, so the seconds wheel meets it over its whole width
- The Wempe's detent spring tapers from 0.09 mm at its ends to 0.07 mm at its middle, as drawn; the balance swings about a degree less
- The Wempe detent's foot, blade and horn, the balance's rim cuts and the jewel holes at their drawings' sizes

## 3.28.02 · 2026-10-25
- The Wempe's hinges, bezel knurls, fusee wheel, hands and detent no longer overlap inside themselves, so the model weighs them correctly.

## 3.28.01 · 2026-10-25
- The Wempe's transit lock works as its drawings show: its lever, at the pivots' height, turns in through a slot in the gimbal ring into a slot across the locking bracket on the bowl (Display, Motion: Transit lock now turns it)
- The Wempe's locking bracket rebuilt from its drawing: its arm leans out from the foot to the upright, no longer drawn as steps

## 3.28.00 · 2026-10-25
- The Soviet 6MX's electrical seconds contact is hidden by default; Variants, Electrical contact, Shown brings it back (contact=1 in a link).
- The 6MX contact lever now sits right under its spiral, its arm sloping down to the contact screw, and its staff is thinner below it, as the photographs show.
- The 6MX detent block's stud has its wide, deep slot.
- Double-clicking a moving part no longer makes the whole clock drift sideways (both models).

## 3.27.03 · 2026-10-25
- The Hamilton's escape upper bridge turned to its measured angle, and the lower train bridge drawn at its measured width and length, from the restoration video.

## 3.27.02 · 2026-10-25
- The Hamilton's balance screws drawn with their slots and its timing nuts with their slits, measured on a restoration video.

## 3.27.01 · 2026-10-24
- The Wempe's key holder: its shelf now curves round the gimbal ring, as on real Wempe boxes, and the key stands in its fitting on the shelf instead of hanging off its edge

## 3.27.00 · 2026-10-24
- The Wempe's bezel now screws onto its bowl: both are threaded, and the movement is held by its pin in a notch cut through the bowl's rim, as on the real cases.

## 3.26.04 · 2026-10-24
- Cross-sections now show their cut faces plain by default; tick Outlines through the cut to see the hidden faces' outlines across them.

## 3.26.03 · 2026-10-24
- Cross-section has a new switch, Outlines through the cut: untick it and, with Edges on, the cut faces show plain, without the outlines of the hidden faces inside the cut parts.

## 3.26.02 · 2026-10-24
- The Wempe's bezel draws clean: no more broken lines round its bevel and across its knurled rim.

## 3.26.01 · 2026-10-24
- The Soviet 6MX's electrical contact: its lever's staff now runs fully in its jewels at both ends, its upper pivot no longer stopping short of its cap jewel

## 3.26.00 · 2026-10-24
- The Wempe's Variants have a Case choice: the drawings' brass, or black as Wempe No. 3044, a Kriegsmarine chronometer, with its lighter mahogany box
- The Wempe's transit lock: its bracket a milled brass angle screwed to the box's wall, its pin with a round head; the key holder's fitting brass, as on Wempe 6161 and 3044

## 3.25.03 · 2026-10-22
- The Wempe's case hangs lower in its gimbals, where its drawing puts it, and its bezel is drawn finished: a bevelled, knurled rim and a cone sloping in to the dial under a visible glass.

## 3.25.02 · 2026-10-21
- Parts that are one piece of metal now look like one piece in both models and their cases: no more lines across their faces or along their sides.

## 3.25.01 · 2026-10-21
- The Hamilton's set-up cover plate measured on a restoration video: plain rounded ends with the screws inside them, where round bosses were drawn.

## 3.25.00 · 2026-10-21
- The Wempe Einheits-Chronometer is now the home page; the Hamilton Model 21 moves to /hamilton/, and every old address still leads to the same place.
- The essay has a page of its own, /essay/, shared by both models; its figures are now drawn from the Wempe's model, with Edges.
- The Wempe's own essay on its drawings is its Its drawings tab.
- The hairspring figure loses its grey mesh, and its labels no longer overlap.

## 3.24.02 · 2026-10-21
- The Wempe's maintaining detent drawn as one piece, without a line across its face.

## 3.24.01 · 2026-10-21
- The Wempe page laid out as the Hamilton's: the same views, sections and short status line.
- The Hamilton's set-up cover plate drawn as one piece, and the set-up click without a flicker on its eye.
- The Hamilton's page no longer scrolls sideways on a phone.

## 3.24.00 · 2026-10-21
- The Hamilton's fusee chain at its measured size: plates 1.95 mm across on a 2.19 mm pitch, each a figure of eight with a broad waist.
- The Hamilton's fusee grooves 1.13 mm deep, ending at the chain's hook.
- The Hamilton's barrel: its bearings, end holes, boss, cap ring and the mainspring's hook and outer stud measured on the videos.
- The Hamilton's energy figures worked again for the measured chain.

## 3.23.00 · 2026-10-20
- The Hamilton's winding pawls' springs drawn as the flat crescents the videos show, and the winding ratchet's 40 teeth.
- The Hamilton's escape arbor, motion work posts and wheels, set-up ratchet, click and spring re-measured on the videos.
- The Hamilton's stop-bar: its step, side hole and recess measured.
- The Hamilton's detent, the train's levels, the escape bridge and the set-up click re-measured on the videos.

## 3.22.03 · 2026-10-19
- The Wempe's 1950s build: a stronger mainspring strip (Nivaflex 0.393 mm, set more), so its inner coils stay within the alloy's strength; its uneven pull through the wind now reaches the escapement.
- The Wempe's builds: wind with the key let back at each stroke, never let go outright.

## 3.22.02 · 2026-10-19
- The Hamilton's 3D analysis: its fusee wheel's teeth now loaded where they bear on their pinion (433 MPa at the let-go blow, was 369).
- Both reports and the methodology: the let-go peaks on the clicks, pawls and ratchets shown to be contact pressure (a dent where nose and tooth meet), with the bending from the beam formulas.

## 3.22.01 · 2026-10-19
- A write-up of how the 3D analysis of the moving parts was done, with its figures, on GitHub (docs/motion-3d).
- The Wempe report's let-go table now says its click wheel column uses the most cautious of three readings.

## 3.22.00 · 2026-10-19
- Every moving part in 3D, for both chronometers: a viewer beside each report shows the movement through a beat, a wind and the stop, each part coloured by its stress, its stress against its material, or its speed.
- The Hamilton's report has a new section 14 on it; the Wempe's report adds it to section 13, with what a maker could change to take the blow when the winding key is let go outright (none keeps every part within its material: let the key back).
- The Hamilton's whole transmission run in time, as the Wempe's already was.

## 3.21.01 · 2026-10-19
- The Hamilton's balance lower bridge: each end now one solid block, the slab's end coming straight down onto its lug, with sharp corners and no seams (checked on a second teardown video)

## 3.21.00 · 2026-10-19
- The Wempe's verification report works again: its tables and charts had stopped drawing
- New in the Wempe's report: two builds of the Wempe for a navigator, one in 1940s materials and one with a 1950s Nivaflex mainspring, each checked to keep time within about 1.5 miles of longitude a month
- For anyone making a Wempe: the bench now gives each arbor's end play from the Soviet Navy's 1958 repair book, and a finer temperature adjustment for navigation

## 3.20.00 · 2026-10-19
- The Hamilton's upper train bridge re-measured on a restoration video through the holes the bare plate places: its notch now round the fusee, its mouth a straight cut, and its holes where the video has them
- The Hamilton's balance lower bridge now sits on its real screws, and the train-blocking screw stands in its access hole
- The Hamilton's barrel bridge: the end of its horn beside the cock is its own measured edge
- The Hamilton's bezel now has its knurled band

## 3.19.00 · 2026-10-19
- The Wempe's escapement re-laid as its drawing scales: the teeth lock 0.235 mm deep, and the swing is now 188-200° over the wind
- The Wempe's train efficiency is now worked out tooth by tooth, its gold spring uses the Soviet 333 alloy, and its balance damping is refitted to the 6MX video (111 s)

## 3.18.00 · 2026-10-19
- The Hamilton's balance lower bridge rebuilt from hand traces of a real movement: one machined part of two levels, its lugs on straight posts under the slab's ends
- The Hamilton's bridges measured anew on a restoration video: their rim is 38.8 mm in radius, not 40.5, and the train bridge's end by the barrel is 2.4 mm shorter
- The Hamilton's balance cock redrawn from a hand trace: its rim now runs on to the tip of its horn

## 3.17.00 · 2026-10-19
- The Wempe's barrel as drawn: the Steg, a steel bar inside the drum that holds the mainspring's outer coil to the wall, and the spring's hook block at its drawn size; the mainspring solved again round both
- The Wempe's drum: the slot at 9 o'clock now runs through its bottom, for the Steg, not through its wall

## 3.16.01 · 2026-10-18
- The Wempe's detent: its horn now bends gradually toward the block, and its gold spring curves round the pipe to rest on the horn's tip, both traced on a photograph of Wempe No. 3955

## 3.16.00 · 2026-10-18
- The Wempe: many small parts now as its works drawings and photographs show them (the pinions, oil sinks, collars and flanges, the balance opening's tongue), and the dial's two holes hidden under its printed face
- The Wempe's key now stands in a round cup over the corner shelf of its box, as the box's plan draws it
- The Wempe's 35-day trial now uses the day-to-day scatter of eight Soviet test cards: as adjusted it passes about 95 trials in 100

## 3.15.04 · 2026-10-18
- The Hamilton's sustaining spring now follows an outline traced by hand on the restoration video: a slightly narrower band, so while the key winds it drives the chronometer about ten and a half minutes

## 3.15.03 · 2026-10-18
- The Hamilton's sustaining spring, inside the fusee wheel: its two ends are now round, as photographed
- Its gap is now as measured on a restoration video, so while the key winds it drives the chronometer about twelve minutes
- The Wempe's maintaining spring as its works drawing shows it, giving 10-14 minutes of power while it is wound

## 3.15.02 · 2026-10-18
- The balance cock's endstone drawn as a diamond, as Hamilton made it (the other thirteen jewels are rubies)

## 3.15.01 · 2026-10-18
- The fusee's lower end as real Model 21s show it side-on: the fusee wheel toothed over its whole thickness, the sustaining ratchet full size and seated straight on it, no gaps
- The chain's end hooks into a slot in the fusee's large end

## 3.15.00 · 2026-10-18
- Wempe No. 3955 as photographed: its escape collet, steel impulse roller, poising holes in two masses, the banking screw's domed head, the brass wire stud, the notch for the hand-setting in its plate and ring, and its closing plate and Bakelite bowl bottom
- The 1941 detent block's slit and banking screw, and the gold spring's single bow
- The Soviet 6MX: its escape pinion, banking screw, cap jewel setting and up-and-down wheel as on Kirov No. 247
- The 6MX's electrical seconds contact rebuilt from photographs: its cock and cap plate, spiral, lever and knurled disc
- For anyone making a Wempe: the detent's preload is now set high enough to survive a 20 g knock (0.63-1.55 g, aiming at 0.86 g)

## 3.14.01 · 2026-10-18
- The Wempe's upper balance endstone is now drawn as a clear stone, as photographs of real ones show

## 3.14.00 · 2026-10-18
- The Wempe: a second finish under Variants, plain brass, beside the hammered gilt of Wempe No. 3955
- The Hamilton: one of the pillars beside the balance cock moved about a degree, to where videos of real Model 21s show it

## 3.13.02 · 2026-10-18
- Ship motion: the chronometer now stays still in its gimbals while the box rolls and pitches round it, on both models and in the Blender exports' At sea clip
- The Wempe: the cover plate's screw seated on its countersink, the upper balance jewel's settings meeting, and as first drawn the hairspring's outer end following the slant of its stud's slot

## 3.13.01 · 2026-10-18
- The Hamilton's upper train bridge and barrel bridge: their screw, pin and bushing holes now run straight through at their drawn size (they were their size only at the faces, wider inside)
- The build book's detent bench figures brought up to date

## 3.13.00 · 2026-10-18
- A third plate finish under Variants: the colours of a Ulysse Nardin deck chronometer, No. 7400 (c. 1955), as photographed: frosted gilt plates and bridges, a gilt bowl and gimbal ring, a redder mahogany box; chosen by hand, it puts on the Swiss dial too

## 3.12.01 · 2026-10-18
- The dust seal's packing rings on the fusee's winding tube are now dark, as photographs of real Model 21s show them

## 3.12.00 · 2026-10-18
- A fifth version of the Wempe, Wempe 3955 as photographed: its dust bush, fusee square, set-up ratchet and black Bakelite bowl and gimbal ring as its photographs show them
- The Wempe and 6MX checked against photographs in the same view: screws with cut slots, the plates' hammered gilt, the maintaining work's light blue temper, the 1941 barrel arbor
- The 6MX as Kirov No. 247 is made: polished steel domed screws, a gilt movement ring, its dust bush, cork, barrel arbor square and dial screws

## 3.11.01 · 2026-10-18
- The Wempe's 35-day trial now says why it fails as drawn (the masses' place leaves the balance losing in heat), with a button that compensates the masses so that it passes

## 3.11.00 · 2026-10-18
- The Wempe's new Laid out view: its train set out in one line and seen from the side, as textbooks draw it, from barrel and fusee to balance, every wheel still in mesh
- The Hamilton's gimbal figures corrected: its case was being weighed with the Laid out view's see-through drawing aids inside it (now 1,250 g; it swings in 0.66 s on its pivots and 0.74 s on the ring's)

## 3.10.00 · 2026-10-18
- The Wempe's page: a new sheet, Soviet 6MX against the drawings, lists each difference and zooms in on it, flipping between the two

## 3.09.02 · 2026-10-18
- The Wempe's jewels drawn as its coloured section shows them: each hole jewel domed toward its endstone with an oil sink, each endstone domed, both Ø 2.9, the whole stone showing in its setting
- The Wempe's escape wheel's lower hole jewel set against its endstone, and the seconds jewel's oil sink

## 3.09.01 · 2026-10-18
- The Wempe's 1941 banking screw, upper balance cock, compensation masses and stop work corrected against its works drawings

## 3.09.00 · 2026-10-18
- The Hamilton: the Contacts view the Wempe has (its own section): where the parts touch, come close or overlap, drawn through the parts made faint; pick a part for its contacts alone, hide parts to leave theirs out, or see them over a beat and the wind.

## 3.08.00 · 2026-10-18
- The Wempe: a Contacts view (its own section) shows where the parts touch, come close or overlap, drawn through the parts made faint; pick a part for its contacts alone, hide parts to leave theirs out, or see them over a beat and the wind.

## 3.07.00 · 2026-10-18
- The Soviet 6MX completed: its electrical seconds contact (a contact wheel on the seconds arbor, the lever, disc and springs, opening every other half-second and closed at the minute), and its detent block's stud, slide and stop screw, its escape wheel's collet, lower balance cock, movement ring screws, bowl with its high brackets, closing plate and outer box, measured on photographs of Kirov No. 247 and other 6MXs of the 1950s.
- The 6MX runs its own escapement: its swing, rate and 35-day trial on the page, and in the export to Blender.

## 3.06.05 · 2026-10-18
- The Wempe's fusee: its groove now ends where the drawing marks its end, and the small end past it is solid brass, so the slot for the stop bar is a clean cut across it instead of slicing loose rings
- The Wempe's stop bar no longer flickers against its slot's walls: it is drawn a sliding fit, a little narrower than the slot

## 3.06.04 · 2026-10-18
- The sustaining spring inside the fusee wheel drawn as the restoration video shows it: a tapered band, a teardrop working end, a fixed end bulging round its two holes, round tips, its gap and height measured
- It is weaker than the model drew it before: while the key turns it keeps the chronometer running about six minutes, the balance's swing falling meanwhile, as the manual's five to ten minutes

## 3.06.03 · 2026-10-18
- The Wempe's barrel as drawn for a maker: the mainspring's eye on its arbor's hook, and the slot and notches for prising the barrel's lid out

## 3.06.02 · 2026-10-18
- The Wempe's hands and the detent block's cross screw drawn without flicker or jagged facets
- The Soviet 6MX's rate before timing corrected to 4.2 s a day, after its balance's corrected weight

## 3.06.01 · 2026-10-18
- The Wempe's chain links as its drawing shows them: plates with smoothly curved sides, a rivet hole in every lobe, and the rivets shown

## 3.06.00 · 2026-10-18
- The Wempe page's fourth version, the escapement of 1943 as photographed (Kirow DEC 422 and 479, Lange No. 5177).
- Its banking screw, which sets the depth of lock, drawn whole: its domed slotted head, its hole and the upright's slit, measured on those photographs.

## 3.05.02 · 2026-10-17
- The Wempe's winding key as its drawings show it: the handle sits lower in its slot, the one-way spring is wound on the tube with its end in the body, and the body's slot, pin hole and spring hole are cut (the 6MX's key too)

## 3.05.01 · 2026-10-17
- The Wempe's balance screws, dust plate, movement ring screws, stud screw and dial pin corrected against Wempe's coloured section drawing; several part numbers read from it

## 3.05.00 · 2026-10-17
- The Wempe page's third version, the Soviet 6MX (Kirov No. 247, 1952), in progress: its movement, dial, Geneva-striped finish, bowl, knurled bezel and boxes, built from Johannes Altmeppen's photographs.
- The essay and the verification report on what the 6MX changed.

## 3.04.02 · 2026-10-17
- The Wempe's case: the spring under its closing plate, which turns it back over the winding hole when the key comes out, is now drawn (no drawing or photograph shows it, so it is estimated from the plate's own drawing).

## 3.04.01 · 2026-10-17
- Watch the Wempe's transmission run: its verification report now links to a viewer that plays the movement in slow motion, every part coloured by the load it carries.

## 3.04.00 · 2026-10-17
- The Wempe's whole transmission run in time: every moving part, from the mainspring and chain through the clicks, maintaining work and train to the hands, as one system (its verification report's new section 13).
- Found: let go of the Wempe's key outright at the end of a stroke and the fusee strikes its click hard enough to dent its brass; eased back, it's harmless.

## 3.03.00 · 2026-10-16
- The Wempe's escapement as its layout sheet draws it: the impulse stone 28°10' before the line of centres (the sheet's 24° is the escape wheel's pitch), the release placed so each tooth lands on the stone's face
- The Wempe's mainspring held by its arbor's hook the right way round; its maintaining detent, set-up click and centre wheel to their sheets' figures
- The Wempe's winding key stands higher in its box, as on Greenwich's wartime Wempe, clear of the gimbals
- About twenty of the Wempe's open questions settled from its drawings and photographs of real Wempes and their Soviet copies, the fusee chain's crossed run among them
- For anyone making a Wempe: the least preload its detent needs, 0.49 g

## 3.02.00 · 2026-10-16
- The Wempe: download any part, or the whole movement, as STL (each part's card, and the new Download section)
- The Wempe in Blender: the whole instrument with its motions (running, run down, winding in its case, exploded, at sea), and the rig that runs it
- Blender rig: no longer slightly off its own animations when exported between round hours

## 3.01.00 · 2026-10-16
- The Wempe's fusee groove and chain hooks as their drawings give them: a 1.2 mm pitch with lands the chain runs in, and hooks the chain's full width
- The Wempe's movement as Wempe No. 3955 shows it: its escape wheel's endstones and the cock's with their stones showing, the maker's engraving on the top plate and RGG on the balance arm, the plates' countersinks and oil sinks
- The Wempe's box as the real ones: one long hinge, a slotted brass lid stay, and knurled brass gimbal nuts, bearing discs, bezel and transit-lock knob
- The Wempe gets Moving parts only, the Train, Fusee and Balance views, the tick, the Swing, Rate and 35-day trial panels, the escapement in plan and a walkthrough
- Winding the Wempe no longer stops it

## 3.00.04 · 2026-10-16
- The Wempe's pillar plate now has the window and holes for the optional hand-setting, as on Wempe 3955, with the bush in the setting pinion's hole
- The Hamilton's mainspring now pulls with the torque its solved shape gives (0.96 N·m), not a straight strip's
- Ship motion is drawn as seen on board on both pages: the box stays still and the case swings in its gimbals

## 3.00.03 · 2026-10-16
- The Wempe page opens as the Hamilton's does: the box shut, then the lid opening onto the dial, seen from the same angle
- The Wempe's dial turns see-through with the plates (in the Escapement view)
- The Wempe's balance keeps swinging at 60× and 3600× (shown slowed), no longer standing still
- The Wempe's transit lock rebuilt from photographs: the lever at the box's rim, the knob on its hub standing clear above it
- No more flicker on the Wempe box's handles and transit lock

## 3.00.02 · 2026-10-16
- The Wempe's report: the stop work's spring checked for strength, and a bench test for the stop work

## 3.00.01 · 2026-10-16
- The Wempe's fusee stop pin now has the length and domed end its overall section draws (1.6 mm under the plate), no longer an estimate

## 3.00.00 · 2026-10-16
- The Wempe Einheits-Chronometer is complete: every part from its works drawings, running, with its essay and its report
- Set the Wempe's hands, keep Greenwich or local time, and watch its case ride the gimbals on a rolling ship
- The Wempe's parts drawn closer still to their sheets, among them the spring that holds the fusee's maintaining detent
- The Wempe's winding key stands in its holder in the box's corner, as real boxes keep it
- Report a bug or inaccuracy from the Wempe's page, and a link preview of its own

## 2.42.05 · 2026-10-16
- The balance cock's screw now sits where the restoration videos show its hole, 2 mm nearer the bridge's middle, its steady pins with it

## 2.42.04 · 2026-10-16
- The Wempe: a choice of dial under Variants, Wempe of Hamburg (as No. 3955) or A. Lange & Söhne of Glashütte (as No. 5177), each traced from its photograph
- The Wempe: the cork ring on the dust bush, which keeps dust from the winding hole out of the movement, and the raised seat round the hole inside the bowl that it meets
- The Wempe: the winding square ends in the turned point its drawing gives
- The Wempe's essay: the gimbals figure shows the box, ring and case again; the transport box had hidden them

## 2.42.03 · 2026-10-15
- The fusee's dust cap no longer hangs over the opening round the balance: its flange now ends at the barrel bridge's edge
- The small hole at 3 o'clock in the barrel bridge is now the shallow slot in its underside that the real bridge has, for levering it off
- The timing weights now turn 3 turns either way in the rate panel, enough for the 2 minutes a day the manual has them take out

## 2.42.02 · 2026-10-15
- The Wempe's box in mahogany, as Wempe No. 6161's, around its brass bowl

## 2.42.01 · 2026-10-15
- The Wempe's stop bar lies along its drawn line, so the fusee is fully wound where the stop holds it: 55.9 hours to run down, the groove's last tenth of a turn left empty
- The stop bar's spring as thin as its bending allows

## 2.42.00 · 2026-10-15
- The Wempe's hairspring breathes as it swings: its coils open and close as the balance turns, as a real spring's do
- The Wempe's padded outer box for carrying it, with a Transport box view: the wooden box shut inside, the outer lid open, as Wempe's arrangement drawing shows them

## 2.41.03 · 2026-10-15
- The Wempe's hands no longer show a broken line down their middle

## 2.41.02 · 2026-10-15
- The Wempe's stop work as drawn: the slot across the fusee's small end, the stop bar's spring and its pin
- No more flicker on the fusee's end when its cover plate is hidden
- The stop bar slides as the chain presses it in, and at full wind meets the stop pin with the side its drawing shows

## 2.41.01 · 2026-10-15
- The barrel bridge's cut round the balance is now one smooth circle, as measured on the restoration video (the step in it is gone)
- The steady pins of the balance cock and barrel bridge, and the bridge screw beside them, placed as measured

## 2.41.00 · 2026-10-15
- The Wempe's escapement now moves as it really works: the escape wheel chases the impulse stone from rest and strikes it, the detent is flung off and rides the tooth home
- A report on every check of the Wempe: does the model hold to its drawings, and would it keep time? Linked from its About and its essay
- For a maker: how closely each part must be made, the bench tests, and 2,000 Wempes made to the drawings' tolerances

## 2.40.00 · 2026-10-15
- The Wempe as first drawn: under Variants, The drawings, the parts the later sheets replaced, as Wempe 3955 is made
- The 1941 escapement: the escape wheel just under the top plate, the balance staff with its brass collar, the detent block with its long arm and brass cone
- The 1941 barrel in three pieces with its lid on the dial side, the 1941 maintaining spring, and the 1940 winding key with its pear-shaped handle
- Each part's card gives the figures the later revisions changed

## 2.39.01 · 2026-10-15
- The fusee's and barrel's bushings and arbors drawn as measured, so the barrel bridge comes off over them in the overhaul
- The dust seal's ring and spring under it, standing on the barrel bridge, and the winding square's domed end
- The sustaining ratchet rides the fusee wheel's hub, so the winding ratchet comes off the fusee
- Holes the real plates have, surveyed from the restoration video, and every hole checked for what it holds

## 2.39.00 · 2026-10-15
- The Wempe's essay goes on: its helical hairspring and Phillips' curves, its bimetallic balance and how an adjuster set its masses, its gimbals
- Try the Soviet trial yourself: move the Wempe's balance masses and watch 35 days of rates pass or fail
- And what Wempe's drawings still leave open

## 2.38.02 · 2026-10-15
- The Wempe's winding in its case plays at its proper speed on slower devices

## 2.38.01 · 2026-10-15
- The Wempe is wound in its case as its instructions say: the bowl turned over in its gimbals, the key hole opened, the key put in

## 2.38.00 · 2026-10-15
- The Wempe's balance masses re-measured on their drawing and photographs: taller, so the balance is heavier and its period nearer the half second
- The Wempe's detent finished from its sheets and a wartime Wempe's photographs: its horn and banking

## 2.37.00 · 2026-10-15
- The Wempe now has an Essay tab: the German standard chronometer told through its own works drawings
- Read a 1940s drawing hole by hole, see the fusee's pull Wempe measured against the model's mainspring, and watch the escape wheel chase the impulse stone
- The Wempe's balance damping now measured off a running Soviet copy on video

## 2.36.01 · 2026-10-15
- The Wempe's winding key as its drawings show it, and on the fusee's square while winding
- The Wempe's Box view shows the dial through the lid's glass

## 2.36.00 · 2026-10-15
- The Wempe's escapement worked through in time, beat by beat: its balance now swings 208 to 219 degrees over the two days
- The Wempe's case and gimbals weighed from its drawings and checked in a rough sea

## 2.35.00 · 2026-10-15
- The Wempe's mainspring is now drawn at the length that reproduces Wempe's own measured fusee pull
- Its balance runs with the hairspring's drawn terminal curves, gaining or losing a little as its swing falls over the two days

## 2.34.02 · 2026-10-15
- The winding pawls and their springs as the restoration video shows them: steel springs, grey pawls, the holes beside the pawls, both springs' feet alike

## 2.34.01 · 2026-10-15
- The Hamilton's page links to the Wempe once, from the header's switch between the models (the second link beside the tabs is gone)

## 2.34.00 · 2026-10-15
- The Wempe's balance now swings as its fusee drives it: about 220 degrees, falling away when it runs down
- A stopped Wempe needs a twist to start, as a detent chronometer does; its rate and swing show beside the time

## 2.33.00 · 2026-10-15
- A second model: the Wempe Einheits-Chronometer, the German standard marine chronometer of the 1940s, built from Wempe's own works drawings down to every screw
- Open it from the Wempe model button beside Essay, or from either page's header
- Its dial traced from a wartime Wempe's, its fusee pulling a chain or, under Variants, a steel band

## 2.32.00 · 2026-10-15
- Overhaul: the manual's 58 operations to take the movement down and 105 to put it back, each part coming off or going on in its turn, with its tools, oil and checks
- Build book: Putting it together, the reassembly in the manual's order

## 2.31.08 · 2026-10-15
- The balance cock is drawn as a restored Model 21 shows it: the open space under its arm runs about 5 mm further before the solid body begins

## 2.31.07 · 2026-10-15
- The winding stop-bar on the fusee's top is now one piece of steel with only a small step on its underside, as on a real Model 21; the chain still pushes it out against the winding stop at full wind

## 2.31.06 · 2026-10-15
- The mounting ring's three screws now pass through its flange, where a restored Model 21 shows their ends from the dial side, and the dial's fourth foot sits where that movement's fourth foot hole is

## 2.31.05 · 2026-10-14
- A new check sweeps every design value no source settles over its whole range, with the bench's corrections applied, and finds the chronometer works across all of them (the build report's section 12)
- The detent spring's ring test is mapped finely: any spring ringing at 120-222 Hz (0.072-0.110 mm thick) is safe, and the maker aims where it rings least

## 2.31.04 · 2026-10-14
- The report on real chronometers re-reads the recordings on the model as it is now: the sound of a real start follows its video within a few degrees, and a running Model 21 is heard swinging about 300-320°
- Checked against another reading of the clicks (the detent landing on its stop instead of the escape tooth striking the impulse jewel), which the balance's return swing rules out

## 2.31.03 · 2026-10-14
- The mounting ring's three screws and the dial's four screws moved to where a restored Model 21 has them, measured on both sides of its plate

## 2.31.02 · 2026-10-14
- The report on real chronometers is updated: a real Model 21's start, heard through its clicks, shows its escape wheel reaching the impulse jewel sooner than the model's at a running swing, but the slow start is its balance losing less
- The tools' start figures follow the train's measured inertia

## 2.31.01 · 2026-10-14
- The sustaining pawl's end is drawn filed to bear on its tooth's face, as a maker fits it, so the spring's load pulls it into the teeth
- The escapement's timing uses the train's inertia weighed from the model's own parts (6.05 g·mm², was an estimate of 5.9)
- The maker's notes explain why the build's mainspring is Nivaflex: no carbon-steel spring on the arbor its life asks for fits the barrel's turns

## 2.31.00 · 2026-10-14
- The maintaining spring is now the split ring of the period's chronometers, held closed while it runs: while you wind it keeps the balance swinging over a turn for about 8 minutes, as the manual's five to ten
- The set-up ratchet sits on its arbor's square, its teeth undercut as measured on the restoration video
- The hairspring's stud is where the restoration video measures it, the spring's upper curve designed to match
- A new bench test for anyone making it: filming the balance's free run-down chooses the mainspring's thickness

## 2.30.02 · 2026-10-14
- The detent spring is set up as the manual's Op. 78 says in full: the 0.770 g test weight parts it about 0.005 in from its stop, so its preload is a little lighter (0.63 g at the locking jewel)
- The balance's free swing dies away in 67 s (was 68), which keeps the running swing at 255°; the maker's sheets and the bench tests give the detent spring's limits from the same test (no thicker than 0.137 mm)

## 2.30.01 · 2026-10-13
- The winding stop-bar on the fusee is now pushed in by the chain itself as it winds onto the top turn: its end reaches down into the links, and it moves only while they press on it.

## 2.30.00 · 2026-10-13
- The checks' two reports are on the site: would a chronometer made to the model run and keep time, and the model against real Model 21s
- About and the essay link to them

## 2.29.01 · 2026-10-13
- The build checks now apply every bench test to the 2,000 simulated movements: 98.7 % work as made and all of them once the bench has re-set the pawls' springs, re-bushed close holes and turned the set-up; the pawls' and depths tests on the maker's cards say how to fix what they find

## 2.29.00 · 2026-10-13
- The build's winding key turns the fusee one way only: turned the wrong way, a plain key could bend the fusee wheel's teeth (the key's card shows the change)
- The build book has four new tests on the bench: the winding stop, the pawls' springs, the maintaining work, and the cannon pinion's friction

## 2.28.01 · 2026-10-13
- The build keeps the Model 21's own balance (stainless rim, Invar arm); only its hairspring is Nivarox, and moving the balance screws by the manual's Table IV trims its temperature error. The hairspring's card shows the change, the build book's last test says which screws to move

## 2.28.00 · 2026-10-13
- The sustaining spring's close-up can be zoomed, moved, enlarged and slowed down (to 1/25), kept open in running, and explains how the spring takes the load while running, while winding and when the key lets go
- Winding from run down: the sustaining ratchet now goes back with the fusee and its pawl holds it at once, as it should

## 2.27.02 · 2026-10-12
- The mainspring corrected from a real Model 21: its coils now pack as closely as on the videos, so it has half a turn to spare and the balance swings in the manual's range from full wind to run down

## 2.27.01 · 2026-10-12
- The winding stop-bar's spring, its two holes and the top of the fusee corrected from a real Model 21: the spring's end in a hole in the bar's side, the bar's chain end level with the chain on the fusee's top turn

## 2.27.00 · 2026-10-12
- The winding stop-bar and the winding stop redrawn from a real Model 21: the bar's slanted ends and two thicknesses, its spring, and the grooved stop in its real place beside the fusee
- The stop-bar now moves as the manual describes: the chain, winding onto the fusee's last turn, pushes it out against the winding stop at full wind

## 2.26.00 · 2026-10-12
- Each part card shows how a chronometer would be built today where it differs from the Model 21 (a Nivaflex mainspring; a Glucydur balance with a Nivarox hairspring), with a button back to the original
- The build book ends with the tests on the bench: what the made mainspring, fusee, train, balance and escapement must measure, and how to rate the finished chronometer

## 2.25.00 · 2026-10-12
- The balance cock's top, its endstone cap and its outline, at the size the restoration video measures
- The barrel bridge's edge round the balance and its screws where real movements have them
- The escape wheel's arbor where real movements have it, and the fourth wheel smaller
- The mainspring and its barrel arbor as real Model 21s measure them, and the balance's damping from a real balance's free swings
- The discharge jewel's acting corner square, as the British Museum's catalogue describes it
- The fusee chain no longer gains and loses a link as it runs

## 2.24.00 · 2026-10-12
- Setting the time no longer turns the train back: the hands are set as a watchmaker sets them, the minutes with the key and the seconds by stopping and restarting the balance
- The twist that starts a stopped chronometer now carries the balance round with the box as it turns

## 2.23.00 · 2026-10-11
- The winding ratchet's teeth measured on the restoration video: shallower, and in dark steel as on the real one
- The winding pawls' springs lie in their own beds cut in the sustaining ratchet, traced on the video, their feet screwed where the real ones are
- Let the mainspring down and set it up again as the manual does (Winding, Mainspring): the set-up click held out, then dropping into each tooth

## 2.22.01 · 2026-10-11
- The setup ratchet redrawn from the restoration video: shallower teeth with square locking faces, its click seated on them

## 2.22.00 · 2026-10-11
- Every moving part checked against how a real chronometer works: the detent falls back to its stop, the escape wheel recoils and runs on to its lock, the chain keeps its length
- Winding as a real fusee winds: the pawls stay on their teeth, the maintaining spring carries the train, and the drive fades away at run down
- The hairspring breathes, the gears' teeth bear on each other, the seconds hand lands on its mark at the signal, and the gimbals hang to the ship's motion

## 2.21.00 · 2026-10-11
- The escapement now moves as a real one does: released from rest, the escape wheel chases the impulse jewel, strikes it about 16° of the balance later and drives it
- The discharge jewel's end is rounded, and lock, let-off, overall and drop all meet the manual's figures
- The detent and trip springs do their own work, the detent preloaded by the manual's 0.770 g test; the balance's free run-down is 52 s, as its parts give
- New checks behind the model: the escapement integrated beat by beat, every loaded part's strength, and how well it would keep time at sea

## 2.20.00 · 2026-10-06
- The balance cock's outline traced from real Model 21s: its edge bends toward the rim, and its arm steps down in two thicknesses
- The barrel bridge's horn ends and the cock's edge are curved, as on real Model 21s
- New dial choice: the U.S. Navy dial, as on serial 2E7832

## 2.19.01 · 2026-10-05
- Each maker's sheet for the mainspring, detent and trip spring now says how closely to make it

## 2.19.00 · 2026-10-05
- The barrel measured on another restoration video: slightly larger, its end and cap flush
- The mainspring re-solved to fit it

## 2.18.02 · 2026-10-05
- The barrel's wall at its real thickness, its mainspring brace running most of the way round, and the mainspring re-solved to fit, packing as many turns as a real one
- The fusee's ratchets, the gimbal strap's screws and the mainspring's width measured on more restoration videos and a museum's catalogue

## 2.18.01 · 2026-10-05
- The build book has a page for every piece to make, and now includes the box, gimbals and hairspring

## 2.18.00 · 2026-10-05
- The mainspring now coils and uncoils as a real one does: its shape is solved from the spring's own natural curve, measured on a restoration video
- Wound, its coils draw in round the arbor; as it runs down they spread out toward the barrel's wall
- The mainspring is set up so its pull falls over the wind as the fusee's profile is cut for

## 2.17.00 · 2026-10-05
- Parts that are several things in one now list their pieces: a tap picks the balance wheel, a roller, the collet or a screw, each with its own card from the parts list and the manual
- Each piece has its own maker's sheet, drawing and STL, and hides, fades and isolates on its own; the parts list folds them under their part
- The winding key shown on the fusee and on the hands' square is the real key, as on the box, not a T bar

## 2.16.00 · 2026-10-05
- Report a bug or inaccuracy: from the panel, any part's card or the essay, a report written into an email to the author, with the details that help fix it

## 2.15.00 · 2026-10-05
- The motion work under the dial, the balance's rollers and hub, and the escape and third wheels at their measured sizes
- The barrel's cap, the fusee's winding ratchet and its pawls, the cock's tall screw and the train bridge's bushings with their oil sinks as a real movement has them
- The balance cap and the train-blocking screw as the manual draws them; the dust seal's packing rings in fibre
- The case's profile and its shield plate as on a real case, the plate's stop screw turning with it
- The gimbals' large pivot screws and washers, the case pivots' lock nuts inside the ring, the latch farther forward and its keeper a windowed block

## 2.14.01 · 2026-10-05
- The hairspring stud's screw at its measured size, in a smaller counterbore on the balance cock

## 2.14.00 · 2026-10-05
- The mounting box's walls at their real thickness, so the case fills it as on a real one
- The gimbal latch stands against the box's side beside the ring, where a real one has it, its handle an upright cylinder

## 2.13.00 · 2026-10-05
- The balance hub's brass flange at its measured size
- The fusee's top cut with the recess round its hub that the stop-bar and its spring lie in
- The gimbal latch's knurled head raised on its post, as a photograph of a Model 21 in its box shows it

## 2.12.00 · 2026-10-05
- The balance staff traced whole on a photograph of a bare Model 21 staff: its seats for the rollers, the hub and the hairspring's collet at their real thickness

## 2.11.00 · 2026-10-05
- The gimbals' knurled lock nuts and the latch's clamping head at their measured size, and the box's brass corners as short caps
- The source material gains the Navy's trail to the Ships Chronometer Record Book: the cork plate in the lid and the Bureau of Ships Manual

## 2.10.00 · 2026-10-05
- The train's friction and the balance's damping worked out from the measured pivots, teeth and air: the balance's swing now follows from its parts
- The escape pinion at its measured length, and the balance hub's brass sleeve on the staff, as a real movement has them
- The hairspring stud's bar and clamp measured, and the hairspring's height with them

## 2.09.00 · 2026-10-05
- Export to Blender: the whole chronometer as a glTF file, every part a named object in its place, in its materials, with every motion as an animation (running, a beat in slow motion, run down, winding, setting the hands, stopping and starting, exploded, laid out, lifting out, the lids, the latch, at sea)
- A Blender rig: run it after importing and the chronometer keeps going on Blender's timeline at its own ratios, with controls for the wind, the hands, explode, laid out, lift, lids, latch, roll and pitch
- Sharper textures in the Blender export: the engravings, the damascening, the dial and the wood drawn finer

## 2.08.00 · 2026-10-05
- Jupiter and Saturn in the almanac and the workbook, within 10 and 5 seconds of arc
- The build book prints each part's drawing at a stated scale, legible on paper, every line with its fit, and each screw with a thread to cut
- The third and fourth wheels' lower jewels and the escape arbor measured on a real movement
- The hairspring's own isochronism worked out at the balance's real swing
- The balance arm sits flush in its rim, the hairspring stud's pins as a real one has them, the sustaining spring in dark steel

## 2.07.01 · 2026-10-04
- The maker's sheets list every part's holes, with their centres and diameters, and number them on the drawings
- The balance staff's pivots and cones measured on a real staff: 0.36 mm pivots in their jewels
- The escape wheel's pivots made Hamilton's own 0.007 in, in jewel holes measured against the light

## 2.07.00 · 2026-10-04
- The hairspring is now the one a maker would wind: a 0.23 × 0.22 mm strip on terminal curves designed to Phillips' conditions, so its pull on the balance leaves no force on the pivots; the collet's end set to fit, inside the restoration video's measurement
- Making it (in the panel): each part's card has a maker's sheet (its parts-list lines, the fits measured on the model, materials and heat treatment), a drawing to scale (SVG) and its solid (STL); Measure between two points; Oil colours each part by its lubricant; print the whole build book; take the model's numbers as data
- Essay: five new sections for a maker — what the model gives you (with the manual's tolerances), oil and where it goes, adjusting the escapement, the order of work, and materials, hardening and tools (with the chronometer you can make without Elinvar)
- The physics is derived, not fitted: the mainspring the fusee asks for, the escape wheel's chase onto the impulse jewel, the balance's damping and the detent spring's share from the manual's 0.770 g test
- The almanac adds Venus and Mars; the rate book can compare the chronometer by equal altitudes of the Sun or by a lunar distance

## 2.06.05 · 2026-10-04
- With the Navy's Y-arm fitted, its card now describes the Y-arm (the locking arm's card came up before)

## 2.06.04 · 2026-10-04
- The balance's lower jewel cap and setting drawn to their measured size (the cap about 9 mm across, as on a real Model 21)

## 2.06.03 · 2026-10-04
- The Navy's Y-arm balance brake is now fitted by default (Variants: the manual's locking arm is still there)

## 2.06.02 · 2026-10-04
- The balance's hairspring redrawn to real proportions: its coils narrower (about 10.5 mm across) and taller, with 12 turns
- With the Navy's Y-arm fitted, its arch now clears the hairspring

## 2.06.01 · 2026-10-04
- The balance's weights read as a matched pair's, as the manual's tables use them: the drawn balance now carries Table II's moment of inertia (578 g·mm²), and the essay's hairspring stiffness follows (about 91 µN·m a radian)

## 2.06.00 · 2026-10-04
- Latitude from the sky: the noon sight and the pole star, worked through in the essay
- The workbook reduces noon sights and pole-star sights to a latitude, and works out the chronometer's daily rate from two of its errors

## 2.05.00 · 2026-10-04
- Essay: four new sections on finding Greenwich time and longitude from the sky, with no radio — equal altitudes of the Sun to rate the chronometer ashore, the time sight for longitude at sea, and the lunar distance to check it, each worked through on a set day and place
- The essay carries its own almanac (the Sun, the Moon and the 57 navigational stars, checked against NASA JPL's ephemeris): print its pages for any days, with the lunar distances every three hours and the hand rules for the Sun
- A workbook for your own sextant sights: a longitude by the time sight, an intercept from your position by dead reckoning, or Greenwich time from a lunar distance
- The 1948 Navy manual the model is built from is now on the site, linked from the essay and About

## 2.04.01 · 2026-10-04
- Variants, Balance stop: the Navy's Y-arm now locks onto the balance — screwed down, both its pins come down onto the rim together (they stopped short of it before)

## 2.04.00 · 2026-10-04
- The hairspring's collet is drawn as the manual's figures show it: the hub on a stepped block, slit to a small relief hole, a ledge cut back over the tongue, and the clamp that pinches the spring's end against it, held by its wedge pin
- The hairspring's lower end runs straight along the collet into its clamp
- In the Exploded view the hairspring comes off with the balance
- Fixed a flicker on the collet's clamp

## 2.03.01 · 2026-10-04
- Display: Remember settings — tick it and the page keeps your settings (view, display options, theme, dial, panel) for your next visit; off by default, so nothing is stored

## 2.03.00 · 2026-10-04
- The hands are traced from a real Model 21's dial: the hour hand's bulb and needle, the minute hand's leaf, the seconds hand's arrowhead
- The balance as a restoration video measures it: its hairspring, the stud and its holes in the cock, the arm, the timing weights' nuts
- The balance cock's arm is flat underneath, stepping square to its body
- The train wheels' hubs, rims and spokes, the pillar screws, the barrel pillar and the fusee chain's links are measured on photographs and videos of real Model 21s
- The winding key, the box's side handles and the case's bottom are drawn as the real ones are
- The timing weights now turn 2 turns either way, all the room their measured nuts leave

## 2.02.00 · 2026-10-04
- Double-click a part to zoom in on it; double-click empty space for the whole view again
- Back and forward through the views: ↶ ↷ under the tabs, or Backspace and Shift-Backspace
- Drag the line beside the panel to make it wider or narrower
- The author's name and contact moved to the top, under the description

## 2.01.00 · 2026-10-04
- Hide the panel: the tab on the model's right edge, or the P key, gives the model the whole width (on wide screens and phones held sideways)

## 2.00.04 · 2026-10-04
- The fusee arbor's collar rises to the barrel bridge, as a restoration video shows it

## 2.00.03 · 2026-10-04
- The sustaining pawl's blade as on real Model 21s: a curved blade bowed away from its ratchet, drawn from a restoration video

## 2.00.02 · 2026-10-04
- The Navy's balance brake (Variants, Balance stop) drawn as real movements have it: its arch sits lower round the balance, and it is screwed down onto the rim with an Allen key, not pressed
- The balance locking arm's description corrected: the finger at its end stands beside a timing weight, and the vernier weight's screw stops the balance the other way

## 2.00.01 · 2026-10-04
- The mounting ring has its dial take-off slot, the notch at the rim where the dial is lifted off
- The fusee's top plate fits round the arbor's collar, which rises through it, as the manual draws it and a restoration video shows

## 2.00.00 · 2026-10-04
- The balance now swings by its physics: how far depends on the mainspring's pull, so it dips while you wind; a new Swing and isochronism section shows how the rate follows it
- A 30-day performance test: the Navy's test run on the model as you've set it, beside a real Model 21's test card
- The fusee against a going barrel; the balances' temperature curves, with the split rim curling; the hairspring's isochronism on the Adjuster's bench; the mainspring's set
- The gimbals swing with inertia, with a roll period to try; Jolt the box shows a detent tripping or stopping
- The essay explains the escapement's isochronism and draws the Model 21's measured temperature curve

## 1.22.04 · 2026-10-04
- The sustaining pawl as real Model 21s have it: its spring a straight wire standing upright beside its arbor, a hub at the arbor's foot, and its place as a restoration video shows it

## 1.22.03 · 2026-10-04
- The third wheel's lower jewel is colourless, as on real Model 21s; the fourth's stays red

## 1.22.02 · 2026-10-04
- The balance drawn as a restored 1941 Model 21 shows it: a thinner rim, each screw running through it to a point, and the vernier weights' screws standing outside it

## 1.22.01 · 2026-10-04
- The plate's opening under the lower train bridge as on real Model 21s: a keyhole round the third wheel, with the bridge's settings showing through it

## 1.22.00 · 2026-10-03
- The model draws about a third faster: parts that don't move against each other are drawn together, with the same picture
- Performance mode in Display (on by default) switches it; turn it off if anything ever looks wrong

## 1.21.01 · 2026-10-03
- The setup cover over the barrel is drawn as on real Model 21s: symmetric, its sides cut the same on either side
- The setup ratchet, its click and the click's spring are their measured sizes: a smaller ratchet, the click pivoting nearer the arbor

## 1.21.00 · 2026-10-03
- The balance's screws and weights sit in its 24 numbered holes, as a restored 1941 Model 21 shows them: the timing weights at the arm's ends, the small vernier weights inside the rim beside them
- Rate panel: move a pair of balance screws to another hole, add a pair or take one out, and see what heat does to the rate (the manual's Table IV, with a temperature slider); the panel's settings are kept in the link

## 1.20.02 · 2026-10-03
- The movement runs a little lighter while you turn it

## 1.20.01 · 2026-10-03
- The Navy's Y-arm balance stop (Variants) redrawn as the lever on real movements: screwed down near the bridge's edge, it runs under the seal's cap to an arch over the balance cock with an eye and a pin at each end

## 1.20.00 · 2026-10-03
- The adjuster's bench now changes how the chronometer runs: the balance swings further or less as the escapement is set, and the rate gains or loses with it
- The rate panel shows how much of the rate is the escapement's, and the rate book notes when the escapement was adjusted
- The bench refuses a setting that would leave the balance swinging too little to keep going

## 1.19.00 · 2026-10-03
- The going train laid out as a restoration video of a real Model 21 measures it: the third, fourth and escape wheels, the pillars and the wind indicator
- The escape wheel's upper bridge rebuilt with its boss, flat-sided endstone cap and flush screws, its ends sunk in seats in the train bridge
- The lower train bridge under the dial at its real size: a thick steel bar, its screws and jewel settings sunk in counterbores
- The dial printed in the proportions of a photographed Model 21 dial: the seconds dial meets the minute track at 6, and the hands match
- The detent's support block at the manual's length, and the train-blocking screw where the video shows it
- The fusee's large end with its rim, the dust seal's flange, the setup click and the endstone caps redrawn after a real Model 21

## 1.18.00 · 2026-10-03
- While winding, see the sustaining spring carry the load: the load path in colour, a close-up of the spring with how long it can still drive the train, and an option to exaggerate its motion
- New in the essay's Winding section: the maintaining power, with the spring relaxing as the key turns

## 1.17.01 · 2026-10-03
- New labels on the hands' gearing: the steel square that turns once an hour carries the minute hand, the hour wheel's round pipe (once in 12 hours) the hour hand

## 1.17.00 · 2026-10-02
- The mainspring barrel enlarged to the size measured on a real Model 21, with a longer mainspring to match
- The fusee's stop-bar, end plate, winding ratchet and winding-pawl springs redrawn as the manual and a real Model 21 have them
- The hairspring's collet and the barrel pillar redrawn after the manual and a real Model 21
- New under Variants: the Navy's Y-shaped balance stop, as photographed on one Model 21

## 1.16.00 · 2026-10-02
- The rate panel changes balance screws and puts washers under them, with the manual's own tables beside the model's figure
- The setup ratchet, the case's winding-hole shield plate, the dial's hands and the split balance redrawn as the manual and a real Model 21 have them
- The detent's lock-adjusting screw now bears on the strip that carries its stop button, as the manual draws it
- The fusee chain's hook is named as the barrel turns it into view
- The views and the walkthrough now aim at the parts where they stand

## 1.15.00 · 2026-10-02
- The fusee, barrel and balance now stand where real Model 21s put them, measured on restoration videos: the fusee nearer the centre with a smaller wheel and cone, the barrel further out, the balance on its lower cap
- The upper train bridge's middle opening redrawn as on a real Model 21: lobes over the balance and the fourth wheel's setting, and the round escape passage
- The upper train bridge now ends past the barrel in a straight cut, as the real one does
- The train bridge's third screw now goes down into its own pillar, as the manual has it

## 1.14.00 · 2026-10-02
- The balance, fusee, barrel, bridges and balance cock turned 14° to where they stand against the dial on a real Model 21; the escape wheel and the wind indicator wheel placed to match
- The detent support block's screw now goes in from above, through the train bridge, as the manual and the restoration video show
- With the train-blocking screw down, the train now stays held instead of slipping a beat at high speed

## 1.13.00 · 2026-10-02
- The balance lower bridge redrawn as on a real Model 21: two levels, its slab curved like a lens with chamfered edges, measured face-on on a restoration video

## 1.12.01 · 2026-10-02
- The train bridge's third screw now sits in its counterbore at the end of the tongue, as on a real Model 21, instead of hanging over the notch
- The tongue beside the fusee's notch now turns into the rim through a rounded corner

## 1.12.00 · 2026-10-02
- The fusee's maintaining work redrawn after a restoration video of a real Model 21: the sustaining spring as a nearly closed band in the fusee wheel's recess, the wheels on the arbor's collar, the gilt sustaining ratchet, and the end plate and taper pin as the manual draws them.

## 1.11.04 · 2026-10-02
- The upper train bridge's notch round the fusee, its horn and its mouth now match a real Model 21

## 1.11.03 · 2026-10-01
- The detent's support block has its two positioning pins into the train bridge, as on a real Model 21
- The trip spring's screw goes through the spring into its bracket, and the detent-adjusting screw bears on the detent

## 1.11.02 · 2026-10-01
- Winding at high speed no longer runs the chronometer for hours on its maintaining spring: while the key turns, time runs at most ten times real speed, as the sustaining spring drives the train for only 5 to 10 minutes.

## 1.11.01 · 2026-10-01
- The bridges' undersides and edges are now plain nickel, as on a real Model 21; the damascening stays on their top faces.

## 1.11.00 · 2026-10-01
- The balance lower bridge redrawn after a restoration video of a real Model 21: one L-shaped slab with a lug at each end, the balance's endstone cap in a round counterbore and the fourth wheel's large gilt setting beside it.

## 1.10.01 · 2026-10-01
- The escape upper bridge as on a real Model 21: a bar across the escape wheel's opening, a screw at each end, a round endstone cap.

## 1.10.00 · 2026-10-01
- The balance lower bridge's lower tier is now a broad slab, as on a real Model 21, with the escape arbor passing through it.
- The going train's third wheel sits where a restoration video of a real movement puts it, so the centre wheel is now clearly larger than the third, as on the real one.
- The pillars have the shape measured on that video: a straight shaft with a collar at each end.

## 1.09.01 · 2026-10-01
- The balance cock's endstone cap as on a real Model 21: a conical oil sink down to the jewel, its screws flush.

## 1.09.00 · 2026-10-01
- The balance cock is now the solid block it is on real Model 21s, standing on the train bridge, its arm sweeping over the balance.
- The barrel bridge has its far horn past the balance and its screws as on a real movement; its other end stops at the cock.

## 1.08.00 · 2026-10-01
- The going train's tooth counts, counted on a restoration video of a real 1941 Model 21: the fusee and centre wheels have 90 teeth, the third 80, the fourth 75.
- The up–down wind scale now sweeps about 314°, as on a real Model 21 dial, and its hand reaches DOWN when the chain runs out, after the manual's 56 hours.
- The essay, part cards and walkthrough give the new counts and say where each comes from.

## 1.07.00 · 2026-10-01
- The balance lower bridge rebuilt as the solid frame the manual and photographs show, round the escape wheel.
- The train-blocking screw and the bridge's screws moved to the holes a photograph of a real movement shows.

## 1.06.00 · 2026-10-01
- The mounting ring as the manual draws it: a deep brass ring under the pillar plate, carrying the dial.
- The dial 95 mm across, as photographed, on the ring, its four screws in the ring.
- The case fits the movement: the ring sits in a recess round its top, its alignment pin in a slot; the gimbal ring closer round it.

## 1.05.01 · 2026-10-01
- The list of changes moves to its own section in the panel, above the byline.

## 1.05.00 · 2026-10-01
- A version number under the byline, and this list of changes in About.

## 0.04.01 · 2026-10-01
- The camera turns to 87° below the model, as it does above, so the movement can be seen from underneath.

## 0.04.00 · 2026-10-01
- The essay is now the model's Essay tab, rewritten against the Model 21. The Illustration tab is gone.
- Every part checked against the manual's parts list (Sec. XI, 187 lines): the missing parts added, and every thread, pivot and setting measured.
- The going train stacked as the manual's Figs. 13, 29 and 110 have it, with cycloidal wheel teeth and round-tipped pinion leaves.
- The balance rim 4.3 mm tall, giving Table II's moment of inertia (1,140 g·mm²).
- The setup work as Fig. 80 has it; the locking arm stops the balance by a timing weight; the lower train bridge as photographed.

## 0.03.00 · 2026-09-30
- Every part a closed solid: cross-sections are filled, and in the Exploded view no two parts meet.
- The mainspring drawn in its barrel, 0.0165 in thick.
- Setting the hands with the key or when stopped, as the manual does, and the navigator's rate book.
- The adjuster's bench: the escapement's settings on sliders, checked live against the manual's figures.
- Every part card says where its shape and size come from; Colour by source, a parts search, sizes in millimetres or inches.
- The fusee and chain as photographed; the escape wheel, rollers, unlocking collar and trip spring nearer the real parts; the centre of the dial and the balance lower bridge as the manual has them.
- Tidier sidebar, with Fusee and Balance views and folding sections.
- Shadows as a Display switch (off by default) and fewer frames drawn when nothing moves.

## 0.02.00 · 2026-09-29
- The site goes live at marinechronometermodel.com.
- The rate panel: turn the timing weights and watch the hands gain or lose. Wind with the key to the winding stop.
- Roman (German and Swiss) and Soviet dial styles; the Hamilton dial after a photographed one.
- Shareable links, GMT by default with a Local time option, panning, keyboard orbit and reduced motion.
- On phones: a touch layout, a long-press part menu and a "?" card of every control.
- A Laid out view of the train, an Illustration tab, the Edges and drawing display options, and a tick sound.
- Screws with threads and holes; the balance locking arm, the train-blocking screw and Twist to start; the hand-setting square, the hairspring's collet and stud, the balance's upper jewel and a working gimbal latch.

## 0.01.00 · 2026-09-28
- The Hamilton Model 21 built part by part in 3D from the 1948 Navy overhaul manual, running in real time: fusee and chain, detent escapement and balance.
- Views from the box to the escapement, colour by part, and a part menu to fade or hide parts.
- The gimbal mounting, custom speed and the About dialog.
