OrelMag/marine-chronometer-model/docs/motion-3d/img/fe_wempe_maintaining_clicks.png

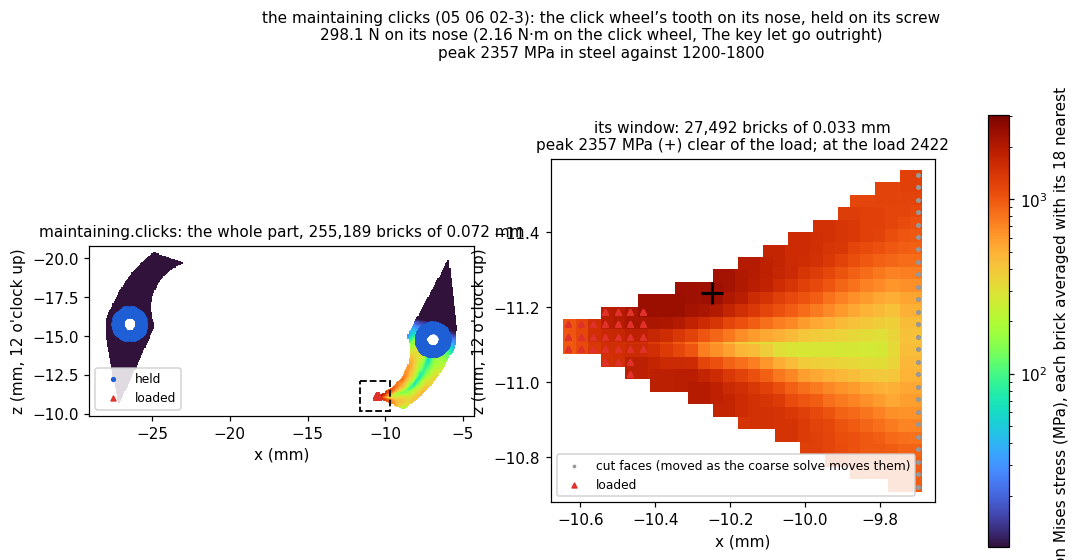
docs/motion-3d/img/fe_wempe_maintaining_clicks.png
