OrelMag/marine-chronometer-model/docs/motion-3d/img/fe_wempe_maintaining_ratchet.png

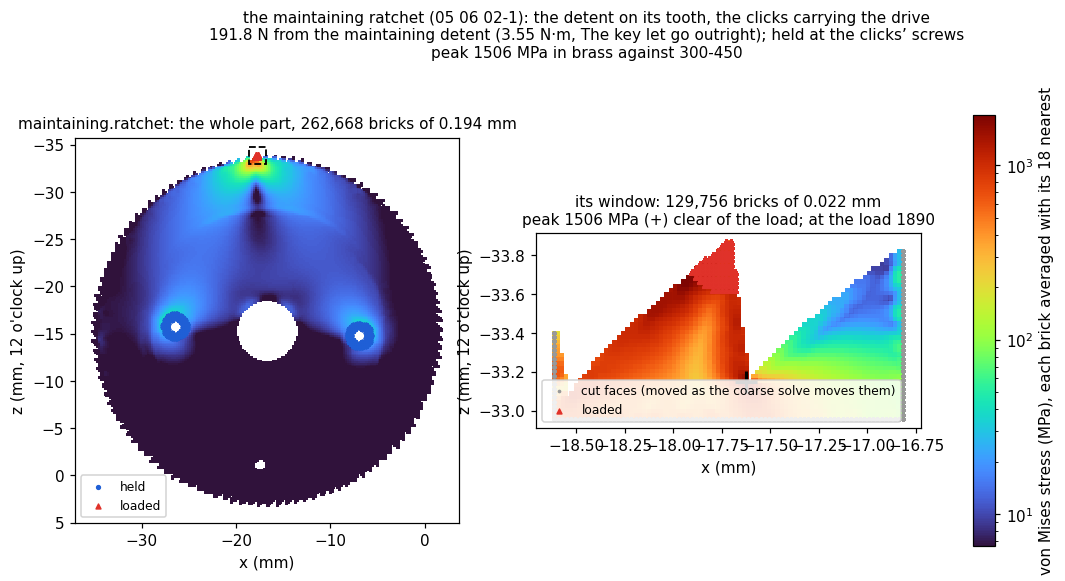
docs/motion-3d/img/fe_wempe_maintaining_ratchet.png
