OrelMag/marine-chronometer-model/docs/motion-3d/img/wempe/2_letgo_drawn_maintaining.png

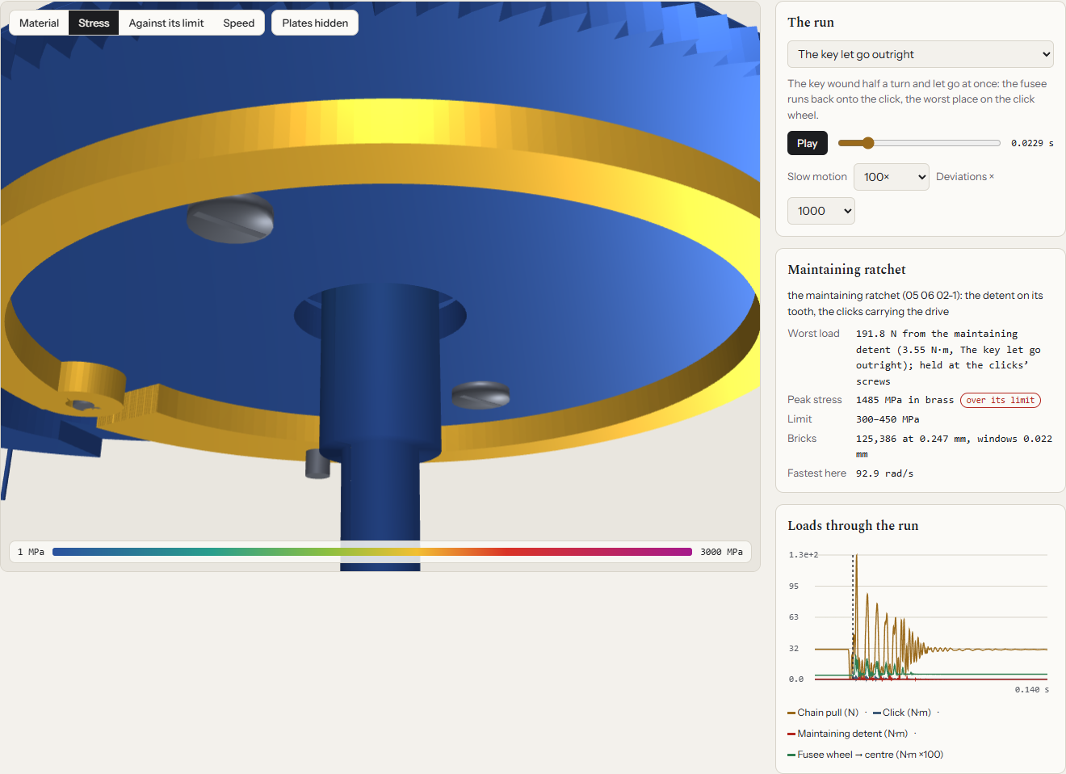
docs/motion-3d/img/wempe/2_letgo_drawn_maintaining.png
