OrelMag/marine-chronometer-model/(commit log)

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2026-09-28 Review working model against the Hamilton manual and reference photos
    - Lower train bridge moved to the dial side of the pillar plate (Figs. 29, 67, 110)
    - UP/DOWN scale laid out as Fig. 107: UP upper right, clockwise round the bottom
    - Balance screws per parts list: 10 in pairs, three head heights
    - Barrel cap with five screws on the pillar-plate end
    - Fusee post modelled as the dust seal with three packing rings (Fig. 24)
    - Part numbers and descriptions corrected (stop-bar 42024, winding stop 42099, etc.)
    - Blued hands and slimmer hour hand; escapement views look from the pillar-plate side
    - README documents sources and the remaining escapement simplifications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
2026-09-28 Reshape setup cover from photos; keep engraving clear of the dust seal
    - Setup cover is the bow-shaped plate seen in the reference photos, not a
    220-degree fan: it straddles the barrel arbor, ratchet teeth show at its
    concave waists, two screws on feet, pawl pivot pin
    - Setup ratchet resized to the photo (52 teeth, ~15.6 mm), click repositioned,
    arbor square protrudes through a collet
    - "MARINE CHRONOMETER" and "TWO-DAY, 56 HOURS" engraving shortened so the
    dust-seal flange no longer covers them
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2026-09-28 Fix setup cover, balance cock screws and loose arbors; add geometry audit
    - Setup cover re-measured on the photo: right end is an arc about the arbor,
    curved slot on the rim side shows the ratchet and click, screws inside
    the outline
    - Balance cock: one screw (parts list 42192) instead of two overlapping;
    cock foot no longer shares its top face with the cock (z-fighting)
    - Arbors end in bearings: centre/third upper bushings in the train bridge,
    centre/fusee/barrel lower bushings and escape lower jewel in the pillar
    plate, balance upper setting in the cock, pierced lower-train-bridge jewels
    - Fusee arbor now reaches the wind-indicator pinion; winding square joins
    the arbor through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
2026-09-28 Reorganise the controls, add custom speed and an About dialog; final audit fixes
    Controls
    - Side panel regrouped: View (3x2 grid, "Moving parts only" switch),
    Time (presets, custom 0.01x-10000x slider and number field, winding on
    one row), Display; Cross-section and Variants collapse
    - Sources and method moved into an About dialog, ordered and cleaned up
    - Space bar stops and restarts; the status line shows the speed when not 1x
    - WebGL failure message; page description, share metadata and icon
    Mechanical and geometric fixes from the final audit
    - Sustaining pawl pointed away from its ratchet: now engages it, pivot moved
    to solid train bridge; winding pawls now reach the fusee winding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
2026-09-28 Fix detent escapement geometry and derive its motion from contact
    - Escape wheel mesh had 15 teeth while the timing steps 1/16 turn; now 16
    (Hamilton's count), so a tooth rests on the locking stone every beat.
    - Discharge jewel reach cut from 2.63 to 2.01 mm: it now meets only the
    passing spring's tip, which projects past the horn, instead of cutting
    through the horn and arm on the return swing.
    - Detent lift, wheel release and passing-spring bending are solved from
    the jewel/spring-tip contact instead of scripted bumps; the release
    waits until the stone clears the tooth path (0.2 mm depth of lock).
    - Passing spring held on an angle bracket from the blade (it floated).
    - Impulse je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
2026-09-28 Fix maintaining work, ratchet pawls and winding stop geometry
    Mechanism audit of every gear and pawl contact, sampled through the train
    and through winding:
    - Gear meshes: centre distances equal the pitch sums and no teeth
    interpenetrate (0.04-0.1 mm running clearance); ratios, directions, hand
    rates and the wind-indicator scale check out. No change.
    - Sustaining spring ran forward from its pin, so the sustaining ratchet
    could not drive the fusee wheel through it, and nothing on the ratchet
    bore on it. It now curves back from its pin to a free end pressed by a
    new pin on the sustaining ratchet; redrawn as the two wheels shift.
    - Winding pawls cut 0.37 mm2 into the fusee's winding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
2026-09-28 Self-contained builds, licence, website build and full documentation
    - Vendor three.js r128 (verified against cdnjs's SRI hash) and Latin-subset
    woff2 fonts in vendor/, with their licences; pages load them locally
    - inline.py + root build.py: one command builds both projects fully
    self-contained (no network requests), refreshes the root copies and
    assembles site/ for upload; --site-url adds canonical and link-preview tags
    - Rebuild the environment map when a lost WebGL context is restored; before,
    a context loss (phones switching apps, GPU resets, or a fast local load)
    left every metal flat and dark
    - LICENSE: MIT for code, CC BY 4.0 for text, drawings and the model's design
    - site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
2026-09-28 Check the detent escapement against the manual and correct it
    - Escape wheel 9.40 mm from the balance (was 10.2): the 0.249 in impulse
    roller then leaves the manual's 0.002 in roller shake (Op. 84) and the
    teeth drop into its crescent (Ops. 76, 83). Impulse jewel flush with the
    roller; tooth-on-jewel contact solved exactly.
    - Detent laid out from the Fig. 90 plan view and built as Hamilton's:
    beryllium-copper detent with a two-strip spring, round locking jewel with
    a flat at 10 deg of draw, Elinvar trip spring on a Z bracket, support
    block with stop button, lock- and detent-adjusting screws.
    - Settings meet the manual's adjustment figures: lock 6.1 (about 6),
    let-off 11.9 (min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
2026-09-28 Re-stack the movement's heights from a side photograph; part-by-part check
    Checked every part against the manual, the reference photos and the web.
    A side photograph scaled by the pillar plate's 3.86 mm edge showed the
    heights were estimated wrongly:
    - Train bridge 16.8 mm above the plate (was 22.1), barrel bridge 3.4 mm
    on it, cock top 34.1; the escape wheel just under the train bridge.
    - Train wheels low: centre wheel lowest, fourth wheel and escape pinion
    3.6 mm up; third wheel placed between the centre pinion and the barrel.
    - Barrel 13.2 mm tall, rising past the train bridge, which is now cut
    round it (Figs. 2, 108-110); chain band level with the fusee cone.
    - Balance lower bridg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
2026-09-28 Docs: bring CLAUDE.md and the READMEs up to date with the repo
    CLAUDE.md: p3fit output, image inlining, essay's copy of ESC, --keep-html,
    the ?qa camera helpers and the missing tools. Root README: full layout,
    tool expectations stated inline. Model README: complete Files table,
    Testing covers ?qa and the tools, essay ESC note.
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2026-09-28 Rate panel: the manual's rate per turn, parts-list masses, weights on their screws
    - Masses from the parts list (p. 82) for the balance screws and the timing and
    vernier weights. The moment of inertia is now 931 g·mm² (was 576, from the
    drawn cylinders, which made the screws 19-39 mg instead of 125-255 mg).
    - Thread pitches fitted so a full turn of a pair gives the manual's figures
    (p. 70): about 40 s a day for the timing weights and 2.8 s for the verniers
    (was 59 s and 12.5 s). R.timing now takes turns; R.pitch holds the pitches.
    - Weights drawn as nuts on screws in the rim's holes, at mid-travel (Fig. 3),
    so turning them in no longer sinks them into the rim.
    - Panel: eighth-tur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
2026-09-28 Dial: stop the brass disc showing through the face when zoomed out
    The silvered face lies 0.02 mm above the top of the dial's brass disc. With
    the camera's near plane at 1 mm, that gap is smaller than a depth-buffer step
    beyond about 600 mm, so the brass won in wedge-shaped bands running out from
    the centre (gold streaks across the dial, worst at 1000-1500 mm and at low
    viewing angles). The face material now has polygon offset, which keeps it in
    front at any distance without moving the geometry. Both dial styles share
    the face, so both are fixed.
    Checked on a Radeon RX 7800 XT (D3D11) at 380-1500 mm and at low, medium and
    steep angles: no streaks, and the hands and sub-dial hands still draw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
2026-09-28 Fixes and checks (core.js, app.js, movement.js, index.html and the model README; all builds regenerated):
    Dial style stays put when you turn off see-through, release a singled-out part or unfade the dial. Tested each case in the page.
    Plate finish now reaches faded parts: a faded bridge turns gilt with Gilt and back with Nickel.
    Escape-bridge screw heads are 0.3 mm tall and now clear the balance rim and timing weights by 0.14 mm.
    Run-down now happens at 60 h, when the chain is all on the barrel. Winding from there starts at "Half turn 1 of 17½" with nothing jumping, and ends fully wound after 17½.
    Fourth wheel / escape pinion mesh is now within 0.0004 mm, using module 0.3113.
    Checks that d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
2026-09-29 Working model: pan with Shift-drag, middle-drag or two-finger drag (reset by view buttons); builds regenerated
2026-09-29 Train clearances: escape pinion, fourth-wheel collet and sustaining-pawl pivot cleared of the wheels they cut into; builds regenerated
    - movement.js: the escape pinion runs from the fourth wheel toward the plate
    (y -7.96..-5.96); centred on the wheel, its top end sat 0.31 mm into the
    third wheel's height, 0.37 mm inside its tips.
    - core.js / movement.js: arbor() takes cside (collet on one side of the wheel
    only); the fourth wheel's collet is on the plate side, clear of the third
    wheel's teeth (it was 0.38 mm into them).
    - movement.js: sustaining pawl pivot at 21.35 mm from the fusee axis (was 21),
    0.23 mm clear of the fusee wheel's tips instead of 0.12 mm into them.
    - README: third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
2026-09-29 Fusee stop-bar: one bar beside the arbor instead of two blocks across it; builds regenerated
    At full wind the stop-bar slides 3.2 mm out, which carried its inner block
    through the 2 mm fusee arbor (1 mm3). It is now one 8.4 mm bar 1.8 mm off the
    axis (0.1 mm clear of the arbor at full travel), with stopAng re-aimed so its
    side still meets the winding stop pin at full wind. Found by a fine
    (0.05 mm) interference sweep over train positions, wind states and
    escapement phases; only the stop-bar changes in the view renders.
2026-09-29 Stop-bar clear of the chain's top turn; tools/fine.py, a 0.05 mm collision check with a table of expected contacts; builds regenerated
    - movement.js: the fusee's top cap (inside the chain) is 0.55 mm above the
    cone and the stop-bar, 0.22 mm thick, sits on it, 0.03 mm above the chain's
    top turn and 0.03 mm under the train bridge. It slid out through that turn
    by 0.18 mm at full wind.
    - tools/fine.py + fine-interference.js: pairwise check on a 0.05 mm grid over
    the escapement phases, 15 train positions and wind states (--dense: 101
    balance phases; --split: the split-balance variant). Includes the chain's
    links and the tube springs. EXPECTED lists each intended contact with its
    re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
2026-09-29 Barrel check: the wall tested as a solid, margins to the barrel's swept solid, the mainspring; chain's straight run made the drums' common tangent; builds regenerated
    - tools/fine-interference.js: an open drum marked noCap (the barrel wall)
    is tested as the solid it encloses.
    - tools/barrel-clearance.js (new): signed distance from every other part to
    the solid the barrel sweeps (wall, caps, cap screws, hook, boss), by branch
    and bound with tangent-plane bounds (convex pieces), to about 0.002 mm in
    0.5 s a state; the mainspring's coils against the arbor, wall and caps.
    - tools/fine.py: runs it over the wind states (BARREL, BARREL_MIN 0.05 mm);
    --eval runs JS after loading. Planted f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
2026-09-29 tools/views.py: before/after renders, pixel diff and close-ups; docs for it and for finding 7's status
    - tools/views.py: renders every view button (with and without "Moving parts
    only") in a frozen state with the page's labels hidden, diffs two runs
    (an unchanged model gives 0 px) and writes the changes in red; --keep and
    --look render close-ups of chosen parts. This is how each fix of the fine
    interference pass was shown to touch only its own part.
    - CLAUDE.md, both READMEs: views.py in the tool lists and the checks.
    - Review-results.md: finding 7's status (fine.py now covers the chain,
    springs, barrel wall, mainspring and, with --split, the hidden variant;
    the dial face and the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
2026-09-29 About dialog: the "Checked" line says what the collision checks cover (finding 7); stop-bar listed as estimated; builds regenerated
    The line claimed "Every part was tested for collisions through a full
    escapement cycle". It now says: 0.05 mm, through the escapement cycle, round
    the train and over the wind, including the chain, the springs and the barrel
    (clearances measured as it turns); the dial face untested; the split-balance
    variant not yet clear of the barrel bridge (finding 9). The Estimated list
    names the stop-bar's size. Review-results.md marks finding 7 resolved.
    Built from this commit's sources alone: uncommitted phone-layout work in the
    working tree (app.js, style.css, index.html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
2026-09-29 Phones and help: touch layout, long-press menu, labels off by default, a "?" card of every control; dark link previews; live-site deploy config; builds regenerated
    - Labels start off; the walkthrough still names each step's parts. fit.py,
    unproj.py and p3fit.py no longer click the Labels box (it would now turn
    them on).
    - Phones: svh stage heights, the part card as a bottom sheet, 44 px touch
    targets, a landscape layout with the stage filling the height and the title
    and panel beside it, pixel ratio 1.5 and a 1024 px shadow map, and the HUD
    written only when its text changes.
    - Touch: a 500 ms long press opens the fade/hide menu (iOS fires no
    contextmenu); it never picks, and And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
2026-09-29 Barrel and fusee against the manual: maintaining work never turns back, train bridge open over the fusee, missing parts added; tools/maintaining.py; builds regenerated
    - Sustaining ratchet no longer jumps back past its pawl when winding stops;
    the sustaining spring is loaded in running, relaxes while winding and is
    reloaded when the key lets go (the fusee catches forward); the fusee turns
    with its square every frame.
    - Upper train bridge: a pocket round the fusee's top; the winding stop is a
    stud from the barrel bridge.
    - Added (parts list, Fig. 109): fusee top plate and screws, stop-bar in its
    slot with its spring, winding-ratchet screws, winding-pawl springs and
    screws, end pla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
2026-09-29 Escapement solver shared: makeEsc in marine-chronometer-source/shared/escapement.js replaces the three copies (IDEAS 7.3)
    - The model builds ESC with makeEsc({EX from L}); the essay's detent figure (F7) calls makeEsc(); both pages load the file before their own scripts and the build inlines it. It declares only makeEsc (the pages declare TAU/D2R) and exports it for Node.
    - tools/escapement.js requires it and reads only L from movement.js: no source slicing or eval. Command-line settings still work (angles in degrees; an unknown setting throws), and it now exits with 1 when a figure is out of tolerance (IDEAS 8.1, step 2).
    - Unchanged: escapement.js output (identical text), all 12 views.py re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
2026-09-29 views.py: deterministic freeze, so an unchanged model diffs to 0 px whatever the time of day
    Before freezing, the page runs live for a few seconds and the fusee's ratchet settles to the nearest tooth of wherever the train stood, so renders made minutes apart put the fusee and its square a ratchet pitch (9°) apart: hundreds of "changed" pixels from an unchanged model. The freeze now passes through a moment of winding (n=0) first, which resets that history. Checked: the previous commit and the working tree render 0 px apart in all 12 views.
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2026-09-29 Fewer draw calls: merged knurls and rim holes, no shadows from parts too small to show one (IDEAS 5.1)
    - mergeGeo (core.js) bakes several geometries into one. Each knurled nut (body and 30 ridges, five nuts) and the balance rim's 54 holes are now one mesh each: 592 meshes down to 389.
    - A mesh casts a shadow only when its radius spans 6 texels of the shadow map (shThr, recomputed as the shadow camera follows the view). Far views drop the screws and pins; the escapement close-up (0.06 mm texels) keeps its small parts' shadows. Meshes whose geometry starts empty and is rebuilt every frame (hairspring, passing spring) and instanced meshes always cast. Bounding spheres are measured without keepi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
2026-09-29 No rendering when nothing changes (IDEAS 5.4)
    Each frame builds a signature of what the stage shows (camera and target, fov, size, lids, lift and flip, explode, the escape wheel's position, balance angle, detent lift, trip-spring bend, wind, winding, ship roll and pitch, section plane). When it matches the last frame's to 1e-4, no input arrived in the last 0.6 s (any pointer, wheel, key, click or control; look() and resizes count too) and the stage was drawn less than a second ago, the frame skips the render, the label placement and the inset. The stage isn't drawn while scrolled off screen. Time still advances every frame.
    Measured in headless Chromium (420x320): stopped with a still camer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
2026-09-29 Reduced motion and keyboard orbit (IDEAS 6.1)
    - prefers-reduced-motion: camera and state moves are instant (as with ?snap), the walkthrough's first step leaves ship motion off and its card scrolls without animation, and CSS transitions are off.
    - Keyboard: the canvas takes focus (tabindex, a focus ring for keyboard focus). With it focused the arrow keys turn the view as a drag does, + and − zoom within the wheel's limits, and 0 resets the view. The help card, About and the canvas's label list the keys.
    - The walkthrough text is aria-live="polite".
    Checked in headless Chromium: under reduced motion the Movement view is settled two frames after the click (427 mm, as a reset gives; 539 mm an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
2026-09-29 Shareable links: the page's state in the URL hash (IDEAS 6.2)
    #view=escapement&speed=0.05&part=det opens the escapement at 1/20x with the detent's card; #tour=6 opens that walkthrough step; drive=1, sec=x:-3.5 (with :f for the other half), tz=local and t=10:09:30 (written only once the hands have been set, so a link doesn't pin the time) complete it. The hash is applied at load (the opening move from the box goes to the linked view) and whenever it is edited (hashchange), and rewritten with replaceState 0.3 s after any change, so the back button isn't filled with views. Setting the hands by the time field is now setTod(), shared with the hash.
    Checked in headless Chromium: the three example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
2026-09-29 Invariant tests, a smoke test and CI (IDEAS 8.1, 8.2)
    - tools/invariants.py: hands and escape wheel against the time (1 turn a minute, an hour, 12 hours; 16 teeth in 8 s) at four times, the wind indicator's 60 and 300 degree ends (UP, 56 h), the fusee's 60 h, 17 1/2 half turns and 7 half turns a day, the balance's 931 g mm2 and the manual's 40 s / 2.8 s a day for a full turn of the weights. Exit 1 on a failure; a planted 76-tooth third wheel fails eight checks.
    - tools/smoke.py: every view with and without Moving parts only, all walkthrough steps, balances, dial styles, finishes, sections and their other halves, GMT/Local, the Illustration tab, the display switches, winding with the key, the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
2026-09-29 IDEAS.md, RESOLVED.md: hashes for the Stage 1 commits and the views.py fix
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2026-09-29 Illustration tab: our own pen-and-wash drawing, rendered from the model
    Replaces the Smithsonian illustration (permission to use it was denied) with a
    drawing made from the model itself: tools/illustration.py renders albedo, lit
    shade, normals, depth and part-id passes in the page (illustration-passes.js),
    turns them into ink and wash, and lays out a labelled sheet: the box with the
    movement lifted out, and panels for the gimbals, fusee and chain, detent
    escapement, and balance and hairspring. Views are frozen at one escapement
    phase, so reruns are identical.
    Caption, alt text, About and licence text updated; the old image removed;
    READMEs, CLAUDE.md and IDEAS.md updated; built copies and s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
2026-09-29 Winding pawl springs follow their pawls; what turns while winding, in the part cards, walkthrough and README
    The winding pawls' flat springs (42007) were built once for the pawls' design angle and cut up to 0.16 mm into the pawls as they swung over the winding ratchet's teeth. wpsGeo in movement.js now rebuilds each spring from its pawl's angle in update(). RESOLVED.md entry under "Fixed, not yet committed".
    Text: the fusee wheel keeps turning forward with the train while the key turns the fusee back; the setup ratchet and barrel arbor never turn in use (Sec. II, p. 4).
    Built copies follow in the next commit.
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2026-09-29 views.py: warm up WebGL and wait for the page, as smoke.py does; RESOLVED.md: pawl-spring entry in place with its hash
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2026-09-29 Case bowl: two front-facing shells instead of one double-sided lathe (speckled floor)
    The bowl's inside faces were back faces, and the shadow normalBias pushes
    back faces' lookups the wrong way, so the floor inside the bowl speckled.
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2026-09-29 Case: shield plate that turns to admit the key and covers the hole at rest
    The winding-hole shield plate (manual's case description, winding
    instructions and parts list: plate, shoulder screw, stop screw, return
    spring) now turns clockwise, seen from below, to line its hole up with the
    case's while the key is in, and springs back when it comes out.
    - The plate covers the case's hole at rest and turns 0.75 rad to open it.
    - The stop screw runs in an arc slot, whose ends set both positions.
    - A torsion coil sits under a slotted shoulder-screw head wider than itself.
    - The case bottom is 1 mm thick, so the plate no longer shows through the
    floor, and its rim matches the wall's 120 vertices (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
2026-09-29 Screws with threads and holes; every part checked against the manual; locking arm, train-blocking screw, twist to start
    - Every screw has its threaded shank; each part it passes through has a
    clearance hole, the part it holds a tapped hole. The Exploded view lifts
    screws out of their holes. polyGeo's bevel narrowed holes at both faces;
    screw holes are cut to fit.
    - Parts from the parts lists (Figs. 106-110) that were missing: pillar,
    mounting-ring and dial screws, minute and wind-indicator wheel posts,
    barrel and fusee upper bushings, jewel settings and endstone caps (13 of
    14 jewels drawn), setup pawl pivot screw, balance hub, cap and hold-down
    screws (Fig. 4). Setup cover fee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
2026-09-29 Balance: the hairspring's collet and stud after Figs. 5 and 6
    The collet is slotted to grip the staff and carries a flat plate whose
    tongue holds a clamp and wedge pin for the spring's inner end (Sec. II,
    Figs. 5, 6). The stud is a bar under the cock, held by the stud screw
    from the cock's top and a steady pin (Figs. 19, 84, 85), with its own
    clamp and wedge pin for the upper end. Both replace stand-ins: a
    hexagonal prism and a gilt block the spring's end didn't reach.
    - springGeo takes the radii of its two ends; both now end in the clamps,
    3.6 mm from the staff, in the stud's direction (along the cock toward
    its screw). The spring is 5.9 mm tall (was 6.7) so its top coil clears
    the s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
2026-09-29 Gimbals: the latch works; a Gimbals latched control locks them
    The latch was drawn released only, with a lever that could not reach the
    case. It is now built as Fig. 106 shows it: a support bracket in the
    front right corner of the box (screwed from outside), a lever on a pin in
    it at the height of the ring's pivots with its knurled handle, a slot in
    the gimbal ring, and a keeper on the case with two cheeks. Latched, the
    lever swings 45° in through the slot to the keeper, locking ring and case
    at once.
    - Gimbals latched (Display): the ring and case are brought level with
    the box, then the lever swings in; latched, they tilt with the box
    under Ship motion. Unticked, the reverse. A walkth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
2026-09-29 Bridges: the barrel shows through the barrel bridge, as photographed
    In the top-view photograph a wide window in the barrel bridge shows the
    barrel's cap and the fusee's large end beside the balance. The model hid
    them: the barrel bridge's cut was the balance's clearance circle only
    (r 17.7, leaving a 3.8 mm crescent of barrel), and the upper train
    bridge, a full disc with a pocket round the fusee's top, covered the rest.
    - Barrel bridge: its cut is traced on the photograph through an affine map
    fitted to five barrel-bridge screws (within 0.6 mm). The edge fits a
    circle of r 17.6 about (5.24, 6.33) to 1.3 mm, 2.8 mm off the staff
    toward the barrel; the cut joins it with the clearance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
2026-09-29 Setup cover: waisted on both sides, as photographed; no slot
    The cover's rim-side edge ran 8.7 mm from the barrel arbor, with a curved
    slot cut in the plate to show the ratchet and click. The top-view and
    2E12055 photographs and Fig. 24 show no slot: the plate is waisted on
    both sides, and on the rim side its concave edge comes to 5.9 mm from
    the arbor, uncovering the teeth and the click's tip.
    Traced on the top-view photograph through a fit to the cover's two screws
    and the arbor (checked for mirroring against the five-screw bridge fit).
    The end arcs and the centre-side edge already matched to about 0.5 mm;
    the rim-side edge is now an arc within 0.5 mm of the tracing. README and
    RESOLVED.m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
2026-09-29 Train bridge: the cut round the fusee is a round hole (r 16.3)
    The merge of claude/pensive-hopper-sbq4ew shrank the cut round the fusee
    from 17.8 to 16.3 mm so it would clear two new tapped holes. At 16.3 the
    circle no longer reaches the plate's rim, and subtractCircle leaves an
    outline alone when the circle doesn't cross it, so the fusee's top and
    the winding stop ended up inside solid bridge (fine.py: six new
    overlaps). The cut is now a round hole of r 16.3 in the bridge, which
    leaves the two tapped holes 1.4 and 0.75 mm of bridge and a band 1.3 mm
    wide at the rim.
    Claude-Session: https://claude.ai/code/session_01Vjushdpy4RnheHjULPrm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
2026-09-29 Balance endstone cap: on the cock's nose, as photographed
    The cap overhung the traced nose (0.7 mm from the staff) and its outer
    screw's thread hung in the air over the hairspring. The cap is now the
    top-view photograph's: a 7.6 x 4.6 mm plate along the cock's straight
    edge, round at the nose's end, the endstone in a gilt setting at its
    centre, screws 2.75 mm either side. The nose is the hull round the cap,
    0.9 mm clear of it (hullSplice replaces unionCircle).
    Claude-Session: https://claude.ai/code/session_01DHGo2AQDnHHxGA19YyLfLw
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2026-09-29 Train bridge: the notch's edge keeps 1 mm of metal round the keyhole
    The balance opening (r 8) reached past the notch's edge, so the keyhole
    broke through into the notch and left a sliver of bridge. train_bridge.py
    now pushes the edge off the keyhole's two circles too; the band between
    them is 0.99 mm at its narrowest.
    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
2026-09-30 Moving parts only: no floating screws; polyGeo bevels every plate's holes inward
    - The setup cover's screws and the click's pivot screw: driveHide on
    their meshes (look() tests meshes; the flag was on the groups). The
    detent support block's screw likewise.
    - The balance locking arm and the train-blocking screw are mounted on
    plates: dh parts, hidden with them.
    - polyGeo gives ExtrudeGeometry a clockwise outline and clockwise holes.
    A counterclockwise outline (the cock) was reversed by it and its holes
    bevelled outward, 0.8*bev wider at the faces, so the hairspring stud
    screw's hole was wider than its head (audit.py: nothing under its
    seat). The cock's setting hole is sized at t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
2026-09-30 RESOLVED.md: hash for the floating screws and the cock's holes
    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
2026-09-30 Solid plates: hole walls face out, cut faces fill; balance arm spans the rim
    - extrude() in core.js builds every ExtrudeGeometry and turns over the
    walls of holes wound like a clockwise outline (r128 reverses holes only
    with a counterclockwise outline). polyGeo's plates, bridges and cock had
    every hole wall wound into the metal: culled, so a hole showed only its
    rims, and a section showed the wall instead of the cut.
    - The cock's balance setting lathe was inside out (.reverse()).
    - The balance arm spanned hub to one side only: subtractCircle keeps one
    run, and the hub circle cut the bar in two. Drawn outright; the moment
    of inertia already counted the whole arm.
    - Sections: cut f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
2026-09-30 Exploded view: no two parts meet at any spread
    Parts rose by hand-set offsets regardless of what lay over them, so the centre
    wheel ended inside the barrel and several wheels passed through each other.
    Offsets now follow the stacking order; the fusee's end plate and the barrel
    arbor come off on their own (loose), screws put in through another part leave
    with it (headOn), and the balance hub's screws stay in. New check
    tools/exploded.py (in CI) tests every pair of parts and screws over the whole
    Spread slider.
2026-09-30 Sidebar tidied: aligned Display grid, Winding section, Fusee and Balance views, Link and Reset display, folding sections
    Display is one grid (Show, Motion, Theme) so both groups' boxes share their
    columns; Time and Winding rows share one label column; Tick sound moves to
    Time. Two views (keys 8, 9): the barrel, chain and fusee across their line,
    and the balance under its cock (Show the balance goes there). Link copies the
    address with the state; Reset display puts the Display boxes back and shows
    faded and hidden parts. Every section folds, remembered per viewer.
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2026-09-30 Size budget: the build fails a page past its budget and prints where its bytes go
    BUDGET in build.py: 1.6 MB for the model, 1.1 MB for the essay (1.33 and
    0.94 MB today). Each build prints three.js, fonts, images and the rest.
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2026-09-30 Balance swings as it really does up to 5x; above, the HUD says the swing is shown slowed
    Above 1x it switched to its 0.9 Hz display swing, so at 2x it swung slower
    than at 1x (Review-results, smaller issues). The real motion, with the escape
    wheel stepping and the stop/start logic, now runs up to REAL_X = 5.
2026-09-30 Canvas description follows the view or walkthrough step
    The model's aria-label was fixed text. It now names what the stage shows
    (VIEW_DESC, or the walkthrough step's title) and Moving parts only.
2026-09-30 Master time and dial error: the HUD shows the time the hands show and how far it is from the master
    tM, a perfect clock standing for the time signal, runs at the model's speed
    also while the chronometer stands. The HUD shows the dial reading and, from a
    quarter second, the dial error to the half second. Now sets both; Set the
    hands moves the hands only. The first frame's dt could be negative, which put
    tM a quarter second behind at load: dt is now clamped at 0.
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2026-09-30 Rate book: the navigator's record of dial error and rate, and what the error does to a position
    A Rate book section after Sec. IX, Table I: the dial compared with the master
    at noon each day and on demand, to the half second; daily rate, mean daily
    rate and mean deviation since the last break; remarks recorded as the
    chronometer is started, stopped, set, not wound or its weights moved; and the
    current error as longitude and nautical miles at a chosen latitude,
    uncorrected and corrected with the mean rate.
2026-09-30 Escapement figures measured in makeEsc: ESC.measure() and ESC.checks()
    The measurements and tolerances tools/escapement.js printed move into the
    shared solver, so the page can show them too. measure() also reports when a
    setting would not run at all, and why. The tool's output is byte-identical at
    the defaults and with rT, aD and dL overrides.
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2026-09-30 Adjuster's bench: the escapement's settings on sliders, checked live against the manual
    Six settings (trip-spring tip, discharge-jewel reach, depth of lock, draw, and
    the two jewels' angles) rebuild ESC and the 3D escapement in place; lock,
    let-off, overall, drop, shake, dip, horn clearance and the jewels' angle are
    measured against Sec. VIII beside a live plan. A setting that would not run is
    refused with the reason. makeEsc returns its resolved settings. The hash
    carries changed settings; smoke.py drives every slider to both ends.
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2026-09-30 Drawings tinted or in ink, true to the lines: Illustration and live modes
    The pen-and-wash wash was laid up to 1.4 px off the lines by a noise field,
    mottled, pooled at edges and hatched in shade, which read as the parts being
    distorted. Both the Illustration and the live drawing now come in two styles,
    each keeping to the lines:
    - Tinted: the same colour and value bands, with no offset, grain, pooling or
    hatching.
    - Ink: the lines alone, plus the printing (the dial's figures, the
    engravings), inked where the albedo falls under 55% of its part's median.
    The Illustration tab has Tinted / Ink buttons (remembered), with
    img/illustration-ink.webp beside illustration.webp. Display's Pen and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
2026-09-30 Ink drawing: faded parts are paper at their opacity, not solid ink
    The ink branch of the wash inked every transparent material under its alpha,
    meant for the engravings, so a part faded to 50-99% (the barrel bridge at
    75%, the hands) became a dark shape. The engravings now carry
    userData.inkDecal (kept by fadeOf) and only they are inked so. Also from the
    audit: smoke.py resets Display from the ink drawing; the ink control titles
    and alt text mention the printing; the docs say where each median is taken.
2026-09-30 Centre of the dial fitted as the manual has it: minute hand on the cannon pinion's square, hour hand on the hour wheel's pipe
    The minute hand floated 0.8 mm over the cannon pinion in a hub that didn't
    turn, the hour hand was a solid blade across the pipe's path, and the square
    was on the minute hand (Hamilton dial only), cut into by the key's round
    socket. Now, after Sec. VIII Ops. 58, 59 and 64 and Fig. 8: the cannon
    pinion's pipe (r 1.7) runs up to a shoulder and ends in the bright square;
    the hour wheel (bore 1.75) goes on over it and turns free; the hour hand's
    round collet sits on the hour wheel's pipe; the minute hand, broached
    square, sits on the shoulder under its collet. Every dial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
2026-09-30 Fusee and chain: illustrations, link preview and builds rendered again; RESOLVED.md hashes
2026-09-30 Escapement review: release measured where the trip spring leaves the jewel, small swings leave the detent alone, inset shows the model's state
    Checked against the manual's Figs. 14 and 90 (both drawn from the cock side) and Sec. IV / Ops. 76-97:
    senses, layout, jewels, crescent, roller order and figures agree with the model. Fixed:
    - Let-off and overall were measured at the push's peak; the tip rides on the jewel's end about a
    degree more. Measured at the fall (Ops. 86-87) overall was 29.9 deg; trip spring 0.013 mm shorter
    (rT 0.288, Op. 91): lock 6.0, let-off 12.4, overall 28.3 deg.
    - Below 37.2 deg of amplitude the jewel can't get back past the trip spring's tip: the spring now
    stays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
2026-09-30 Part menu: Isolate shows the clicked part alone
    The right-click / long-press menu gets an Isolate button beside Hide, Reset
    part and Reset all. Only the isolated parts are drawn (the mainspring with its
    barrel; box, labels and floor shadow hidden); the menu, opened on the part or
    on empty space, offers Show all parts. While isolated, ticking or picking a
    part in the parts list adds it. Show all, Reset all and Reset display end it.
2026-09-30 Detent: trip-spring bracket's leg on the cross-piece, arm ending square over the horn
    The Z bracket's leg was set 0.26 mm along the detent from the cross-piece it
    stands on, leaving a step on either side (a kink in the model and in both 2D
    figures); it now spans the cross-piece's t. The arm ran diagonally into a horn
    wider than itself and stopped square to its own slant; it now turns along n
    and ends square over the horn, which is the arm's width. The horn's inner face
    is unchanged, so horn clearance stays 0.25 mm. escapement.js, solids.py,
    exploded.py and fine.py (0 new or grown) pass.
    To do: the built copies and site/ are not regenerated in this commit (another
    change was in progress in t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
2026-09-30 Performance: hairspring updated in place, Shadows a Display switch (off by default), Edges on phones too, fewer idle frames, tools/perf.py
    The hairspring went through closeGeo every frame in the lifted views (9 ms a frame on a desktop, 50 ms at 4x CPU throttling); reclose() now writes the
    new tube into the old closed geometry, and only when the balance has turned. Movement view 12.5 -> 2.6 ms a frame on the desktop, 70.7 -> 13.8 ms
    throttled. Shadows is a checkbox under Display (shadows=1 in the hash), off by default; the image tools turn it on. The balance's swing no longer
    redraws the Dial and Box views, and without input a frame comes at most every 10 ms. PERFORMANCE.md has the measuremen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
2026-09-30 IDEAS.md: photographs and the manual as the source of truth; out-of-date notes fixed
    The At a glance row for starting with a twist shows its partial status; 1.10
    counts the balance's upper hole jewel (2acc042); Stage 1 no longer lists the
    canvas description and remembered settings as open; the shipping wedges are
    told apart from the hairspring clamps' wedge pins.
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2026-09-30 Going train stacked as Figs. 13, 29 and 110 have it; pinions end at their bosses
    The fourth pinion's leaves ran into its collet and hub (the steel notches on the
    brass) and the centre pinion into its wheel's spoke windows; fine.py can't see a
    part inside itself. The figures stack the train third / centre / fourth from the
    plate, the third and centre pinions above their wheels and the fourth's below,
    five spokes on each; the model had centre / fourth / third with two pinions on
    the wrong side. Third wheel 0.35-1.0 mm above the plate, centre 1.15-1.85,
    fourth unchanged. arbor() takes cp (how far the collet stands proud) and reports
    a pinion inside its wheel or collet; FW_SP gives the train-blo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
2026-09-30 Every part against the manual's parts list: bom.json, tools/bom.py, BOM.md, and the model fixed to it
    The manual's Sec. XI parts list (Figs. 106-110) transcribed line by line into
    bom.json (totals checked against Sec. XII), every piece of the model tagged
    with its line (hn() in core.js), and tools/bom.py measuring on the built
    meshes how each part is held and runs, the gears, endshake and the 14 jewels;
    --md writes BOM.md. Result: 187 lines, 319 relations, 14 jewels, no failures,
    one known deviation (the upper train bridge's third screw).
    Fixed along the way (RESOLVED.md, Accuracy to the manual): missing parts
    (fourth dial screw, second 1770, seal ring and spring, latch clamping bracket,
    sc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
2026-09-30 Mounting ring screws from the train side, as reassembly Op. 1 and Fig. 29 have them
    The three mounting ring screws (42055) were drawn from the dial side, through
    the ring's lip into the plate. The manual lays the pillar plate on the mounting
    ring and then screws them in (reassembly Op. 1), and Fig. 29 draws them above
    the plate; the top-view photographs show one on the plate at the rim at 6
    o'clock, half under the train bridge. Now 42055-size screws on the plate's top
    at 40.6 mm (100 deg as photographed; 210 and 340 deg estimated, clear of the
    dial screws), through a clearance hole in the plate into a tab of the lip.
    bom.json's relations follow. IDEAS.md: the wind indicator wheel's size is h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
2026-09-30 Setup work as Fig. 80 has it: the pawl's pivot screw from under the barrel bridge, its spring a long arc
    The setup pawl's pivot screw was drawn from the top, its head on the cover. The
    manual screws it into the barrel bridge before the bridge goes on (Op. 41) and
    Fig. 80 draws it under the bridge; the top-view photograph shows only a small
    round end where the model had the head (0.25 mm off). Now it comes up from under
    the bridge, its head in the gap over the barrel, its shank the pawl's pivot, its
    end flush in the cover. The pawl spring was a short strip on two pins; Fig. 80
    draws a long arc round the ratchet: now 9.8 mm from the arbor from its pins at
    125 deg (clear of the barrel bridge's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
2026-10-01 Barrel wall one solid with the chain hook's hole, not three bands
    The hole for the chain's hook was cut by building the wall in three bands, which
    drew seam lines round the whole barrel (the review renders showed them). The wall
    is now one closed solid: outer and inner faces on a grid in angle and height,
    the hole's four faces and the two end faces. fine-interference.js takes the
    wall's height from its geometry's box (it read ExtrudeGeometry's options), and
    fine.py's EXPECTED keys follow the drum's new tag.
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2026-10-01 IDEAS.md: section 1's status, closed items marked, stale notes fixed
    1.1, 1.3, 1.4 and 1.5 marked closed, with what's left in them noted as left on
    purpose. 1.7's notes on the rim and the screw heads were already done (Table
    II's 1,140 g.mm2, heads 2.6 mm); 1.10's oil sinks are cut on the bar-hole
    jewels, so what's left is the unjewelled pivot holes.
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2026-10-01 Videos of real Model 21s documented as a source of truth; every open gap with how to resolve it
    References/VIDEOS.md records the videos: what each shows minute by minute,
    every measurement taken on them (with its frame, command and how sure),
    the methods that worked and those that didn't, and which open gaps each
    could close. tools/video.py gains `ticks` (a dial scale's sweep from its
    ticks) and `plate` (a rough affine plan of a bare plate), with the
    commands behind the recorded measurements. The videos are declared a source
    of truth beside the photographs and the manual (IDEAS.md, CLAUDE.md, the
    References and model READMEs). Each open item of IDEAS.md section 1 (1.2,
    1.7, 1.8's pinions and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
2026-10-01 Balance lower bridge against the video, face-on: its arrangement, size and the arbor spacing it implies
    The underside seen face-on (KLUwI2UUCMQ 13:49.5), placed by the centre
    bushing and the barrel cut and scaled by two independent rulers: one
    shield-shaped plate about 40 mm long, screws 31-36 mm apart at the ends of
    its long axis, the escape passage and the fourth's setting either side of
    the balance's cap. Review-results.md: the arm (none) and the ear's screw
    (not this bridge's) settled; the settings' spacing sharpened into a question
    about the train's layout. VIDEOS.md: settle handedness first; a 13:44
    reading with the wrong handedness withdrawn.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
2026-10-01 Barrel bridge's far horn and its screws, from the photographs and videos; a hook and isolate.py to compare changed parts with real ones
    The barrel bridge runs on past the balance to about 100 deg, where a cut from
    the balance's opening to the rim ends it (top-view photograph through the five
    bridge screws, about 0.6 mm; C Spinner 23:30, the bridge laid flat). The
    screw the model drew as a train-bridge screw "without a pillar" at (-8.5, 27.7)
    is proud of that horn: the barrel bridge's screw into the train bridge (gone
    with the bridge off, BunnSpecial 12:05), now at (-11.07, 26.46). Screw heads
    sunk in the photograph are the train bridge's, seen through clearance holes in
    the barrel bridge (pi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
2026-10-01 Bridges' radius checked against the bare plate: the rims stand, the pillars and screws inside them sit too close in
    The top-view photograph and the flat bridge put the barrel bridge's rim at
    34-35 mm against its own screws; the bare plate (BunnSpecial 22:00) rectified
    by its rim puts the pillars those screws stand on about 1.2 times further out
    than the model's, so against the plate the rim is 39-40.5 mm (the side
    photograph's 39-39.5). The model's 40.5 stands; the layout inside is the open
    question (IDEAS.md 1.11, 1.2; VIDEOS.md).
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2026-10-01 Third arbor where the video puts it (16.0 mm out), the wheels' sizes with it; the pillars' measured profile
    The third arbor moves to (-6.18, 14.75), measured on a restoration video's
    train-bridge underside anchored on five matched holes. The modules follow
    from the arbors' spacing, so the centre and third wheels take the sizes the
    counted wheels' ratios give (tips 14.4 / 10.1 / 9.6 mm; they were 11.8 /
    11.6 / 9.6). The pillars take the profile measured side-on (straight shaft
    r 2.7, foot collar r 2.9, top collar r 3.3). The detent's support block,
    whose real place is still open, is notched round the third arbor and 0.66 mm
    shorter at its foot end to clear the pillar (provisional).
    Co-Author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
2026-10-01 BOM.md: the endstone cap's screws and setting re-measured; RESOLVED.md: the cap's hash
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2026-10-01 The escape upper bridge as the real one: a bar across the keyhole, a screw near each end, a round cap
    From C Spinner's video (10:00, from above) and Figs. 84 and 110: a straight
    round-ended bar 22 mm long across the balance-escape line, its screws 8.0 mm
    either side of the jewel, with a round endstone cap (r 4.4, screws 3.1 mm)
    on a boss in the middle. It was a short stadium running away from the
    balance with both screws beyond the arbor and a small bar cap. Checks:
    solids, exploded, audit (nothing new), fine and fine --hold (0 new or
    grown), bom (ok), smoke (202 steps); views.py changes only where the bridge
    is seen.
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2026-10-01 Review-results 19: the fusee 43-45 deg from the indicator on the rectified dial side (model 30.3), the indicator wheel about 35-38 mm (model 22.4); rimfit.py for a silver face in brass, tied to the c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
    The model's photographed group (balance, fusee, barrel, bridges, cock) stands about 13 deg from the dial and the train. Measured, not fixed.
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2026-10-01 The detent's fixings as the manual and the video have them
    Reviewed against the manual (Sec. II, IV; Figs. 14, 22, 54-60, 84, 88-90;
    Ops. 77-97) and C Spinner's restoration video (KLUwI2UUCMQ 10:45, 11:08).
    The escapement works as the manual has it; the fixings did not:
    - the support block's two positioning pins, into the train bridge, and its
    screw between them, laid out from Fig. 90 (the screw 3.7 mm from the point
    of flexure, was 7.9);
    - the trip spring's screw across the spring, through the hole in its foot
    into the angle bracket's upright leg (now 0.36 mm thick), not upright in
    the leg;
    - the detent-adjusting screw's head in a slot across the detent's foot,
    which now runs on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
2026-10-01 Train bridge: notch, horn and mouth measured on the restoration video
    The edge was a trace of the manual's Fig. 67, pushed off every hole and
    smoothed, which gave the horn a round end 7.5 mm from the centre, a wavy
    notch and a mouth reaching the rim at -40 deg. KLUwI2UUCMQ 23:30 (flat) and
    13:49.5 (turned over), each put on the face by video.py anchor, show the
    notch one circle (r 16.57), the horn its cusp with the barrel's cut ending
    in a straight cut with sharp corners 12.4 mm out, and the mouth a sharp
    corner with a straight edge to the rim at -23 deg. train_bridge.py now
    builds TB_EDGE from those readings (specs in tools/anchors/); the keyhole
    stops 1 mm short of the notch. The third scr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
2026-10-01 The photographed group turned 14° against the dial; the escape arbor solved again, the indicator wheel and lower bridge refitted
    The arbors' layout was fitted to the top-view photograph with its 12 o'clock taken as the dial's. Measured on the restoration
    video's dial side (KLUwI2UUCMQ 40:08, rimfit.py on the mounting ring's bore) and the photographed dial, the fusee stands 43-45°
    round from the indicator's stud (the fits 30.3) and the barrel's bushing turned the same way: everything placed from the
    photograph stood 14° round from the dial and train.
    - movement.js: PHOTO_TURN, PT/PTi; the balance, fusee, barrel, pillars, bridges, cock, their screws and pins, the engraving
    (decal UVs), t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
2026-10-01 The fusee end plate as the manual draws it: under the wheel, notched for the taper pin
    Ops. 27-29 give the plate notches the taper pin lies in, and Figs. 28 and 69
    draw it about 0.37 of the fusee wheel across. It was a plain r 2.6 washer with
    the pin under it, too small, once the wheel's bore became r 2.75, to hold the
    wheel on. Now r 7.0 against the collar's end, slotted across its outer face,
    the pin (9.6 mm, as Fig. 28 draws it) lying in the slot.
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2026-10-01 Balance lower bridge: the far lug back beside the fourth, as on the video; the train-blocking screw's hold fixed
    After the 14° turn the far lug had been moved past the body's end (11.3 mm from the video's), because the model's detent stands
    where the video has it. It is back beside the fourth on the 9 o'clock side, (-13.9, 18.8), 3.8 mm from the video's, on the
    detent's 12 o'clock side, joined to the body by a tongue of the slab under the detent; the train-blocking screw stands in a
    column of its own on the detent's other side (4.5 mm from the fourth arbor).
    - lower_bridge.py: BLOCK is the detent's real footprint in the lugs' layer (from the page); three upper-tier pieces.
    - movement.js: L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
2026-10-01 RESOLVED.md: hashes for the lower bridge's far lug and the train-blocking screw's hold
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2026-10-02 Split balance clear of the bridges; the lock-adjusting screw on its sprung strip (Fig. 90); the Hamilton dial's hands to their tracks
    - Split-balance variant (Review-results finding 9): compensation weights within
    the band's height and out to 16.8 mm, inside the barrel bridge's cut round the
    balance and above the escape upper bridge's screws; arm and hub bored for the
    staff. fine.py --split passes; the About dialog no longer excepts it.
    - Detent support block (Review-results 20.5): its front split by a slot open at
    the stop button's end, as Fig. 90 draws it; the lock-adjusting screw bears on
    the strip that carries the button, the clamp screw crosses the slot into it.
    - Hamilton dia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
2026-10-02 RESOLVED.md: hash for the split balance, the lock-adjusting screw and the hands
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2026-10-02 RESOLVED.md: hashes for the group's placement, the fusee assembly's scale, the train bridge's middle and end, the third screw's pillar
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2026-10-02 fine.py checks the dial's printed face: the least height of any part over it (Review-results finding 7, IDEAS item 22)
    The face is an open ring 0.02 mm over the brass disc, too thin for the 0.05 mm
    voxels, so it is checked exactly: every part above the disc, outside the arbor
    holes, at least 0.02 mm over it (now 0.68, the wind hand). The About dialog,
    CLAUDE.md and the README no longer call it untested.
2026-10-02 The hairspring collet as Figs. 5 and 6 draw it against the spring: its sector out to r 4.0, the spring's ends at 4.6 mm, near the coils (IDEAS 1.4, item 22)
    Both ends' terminal curves shorter (the ends were brought in to 3.6 mm); the
    essay's hairspring follows. Checks: fine.py (0 new), solids.py, invariants.py;
    isolate.py against Figs. 5 and 6.
2026-10-02 The Navy's Y-arm balance stop as a variant, as on serial 2E11795 (Review-results BOM 8, Elsewhere 13; item 22)
    Variants, Balance stop: the manual's locking arm (Fig. 9) or a post on the
    barrel bridge capped with packing rings and a Y-shaped arm over the balance, a
    pin under each end over the rim, mapped from the top-view photograph through
    the barrel bridge's screws and corrected for its tilt. The manual's 'balance
    stop' (Sec. I) is Fig. 9's arm, so the Y-arm's working is a guess (the arm
    lowered until its pins bear on the rim); Locked and Unlocked work either.
    Checks: fine.py with it fitted, free and locked (0 new), bom.py, smoke.py.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
2026-10-02 The barrel r 17.6 under its 0.7 mm lip, as C Spinner's video measures it (it was 13.5); the mainspring 1,064 mm (Review-results Elsewhere 23)
    The top lip fitted at r 18.3 on 23:30 (17.4-19.6; certain above 14.5), the cap
    0.7 wider; the lip, brace and pin inside follow the radius; the mainspring by
    the half-room rule (the video: about 1.1 m); the chain 4.85 barrel turns, the
    set-up held at 0.37 turn. It fits the train bridge's measured cut and clears
    everything round it by 0.86 mm or more.
    Checks: fine.py (0 new, 0 barrel problems), bom.py, exploded.py, smoke.py,
    maintaining.py, invariants.py, solids.py; isolate.py against 13:06.
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2026-10-02 The barrel 16.5 mm tall and the train bridge's cut round it r 21.0, as C Spinner's video measures them (Review-results Elsewhere 23)
    Side-on the barrel's height to radius is 0.95 (camera-free): 16.5 mm, from
    2.4 mm over the plate (it was 13.2). The cut fitted with centre and radius free
    is r 21.0-22.0, centred about 2 mm further out than the barrel; taken at 21.0,
    where the bridge keeps 0.7 mm round pillar 0's screw. The video's focal length
    changes shot to shot (recorded in VIDEOS.md).
    Checks: fine.py (0 new, 0 barrel problems), solids.py, exploded.py, bom.py, maintaining.py.
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2026-10-03 The Adjuster's bench drives the running model: the balance's amplitude and the escapement's rate follow its settings
    makeEsc works out the running amplitude from the work done each oscillation (the impulse,
    w times the wheel's turn while it drives the jewel, less the draw and friction at the
    locking jewel, the detent spring and the trip spring, against losses fitted to the 25 s
    free run-down) and the escapement's rate by Airy's result over the impulse and unlocking,
    both against the model's settings, where A is 255 deg and the rate 0 exactly (so every tool
    calling ESC.state at the defaults is unchanged). The page eases the balance to ESC.A, puts
    the rate in rateK as escK (the Rate panel give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
2026-10-03 The Navy's Y-arm as the lever the photographs show: pivot screw at the bridge's rim, under the cap, a symmetric arch with an eye at each end
    The first rebuild (17fa7d4) read only 2E11795's photograph and made the arm a
    broad wishbone stopping inside the post; it still didn't look like the arm.
    Photographs taken straight above (Delaney No. 8854 and another) show a lever:
    - its root held on a shouldered stud by a large slotted screw near the barrel
    bridge's rim. Both photographs put it 2.5 mm from the bridge's pillar screw,
    so the fitting is taken to replace that screw (hidden while the Y-arm is
    fitted, R.navyBB); the stud threads into the pillar as the screw did.
    - the lever running st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
2026-10-03 Size budget: the build warns past it instead of failing, and prints what a visitor downloads compressed
    It stopped a release over 8 KB of a 1.4 MB page; it is a tripwire for growth nobody meant, not a limit the host sets. A planted budget below the page warns and the build goes on (exit 0). The built page is unchanged.
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2026-10-03 Performance mode (Display, on by default; merge=0 in the hash when off): the merged drawing switched, every piece drawing itself when off; Reset display turns it on; smoke.py works it
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2026-10-03 Balance as the video measures it: the rim 0.6 mm thick and 3.5 tall, the heads 3.1 across, each screw through the rim to a point, the verniers' screws standing outside it
    The rim was 1.578 thick, sized so that the drawn balance made Table II's 1,140
    g.mm2. The restoration video measures it 0.6 (three frames edge-on, scaled by the
    rim's 29 mm and the impulse roller's 0.249 in, which agree to 1 %), the heads
    2.9-3.2 across face-on, each screw running through the rim to a brass point and
    each vernier's screw standing outside it with a collar. Drawn so, the balance
    makes about 730; I_REST adds the 410 the drawing doesn't, so the rate panel's
    changes stay the manual's. What carries it on the real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
2026-10-03 RESOLVED.md: the plate's opening under the lower train bridge, with its hash
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2026-10-03 The balance locking arm checked against Fig. 9 and Fig. 108; the restoration video's movement has the Navy's Y-arm
    - Review-results.md, BOM comparison, still open 9: what matches the manual (parts,
    screw outside the rim, end at a timing weight, the counterclockwise lead) and
    what differs (Fig. 9 swings the arm out, the model in; curved and short in the
    figures, straight and 13 mm here), with what the layout allows: the screw's
    place fits Fig. 9's scene, the outward swing has no room past the pillar
    screw's head and the cock's foot. Open until a photograph of the arm fitted.
    - References/VIDEOS.md: KLUwI2UUCMQ's movement (2E8489) carries the Navy's
    Y-shaped stop, not Fig. 9's arm;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
2026-10-03 Sustaining pawl's blade drawn from its measured edges: a curved blade bowed away from the ratchet, ending in a short straight face; its arbor at 69 deg
    KLUwI2UUCMQ 36:15: the blade's two edges traced and put through rimfit_36-15.json's camera at
    the blade's height (6 mm, where the axis and the wire's offset agree). The outline is one smooth
    curve through them, round the hub behind the arbor (not seen; 1.6-1.9 mm), the tip's corner on
    the ratchet. A second reading of the arbor's foot (14:06, nearly overhead, a homography on the
    plate's bushings and pillar feet) gives 21.7 mm at 71 deg; the arbor goes to 21.8 at 69, between
    it and 36:15's 67. At 36:23 the arbor shows through the notch under it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
2026-10-03 Release 2.00.02: the Navy's balance brake as real movements have it (its arch lower, screwed down with an Allen key); the locking arm's description corrected
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2026-10-04 Zoom to a part by double-clicking it; Back and Forward through the views; the panel's width by dragging
    - Double-click (double-tap) a part: the camera fits it and turns about it,
    following it as the movement lifts or spreads; never backs away from a part
    larger than the view. Double-click empty space for the view again. Timed by
    the events' timestamps, and a second click on the card the first opened
    still counts.
    - Back and Forward (under the tabs, Backspace and Shift-Backspace): up to 30
    places left by view buttons and keys, Reset, a zoom, a panel's Show button
    or winding; not the walkthrough, links or the opening view.
    - The panel's width (wider than 960 px): drag the line besi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
2026-10-04 smoke.py: the key-winding and Model-tab checks polled (up to 5 s), not looked at once, and the state printed if they fail; each failed now and then on main
2026-10-04 The hairspring stud's holes re-measured on two sources, the balance upper setting gilt and its cap steel; smoke.py waits for leaving the essay instead of a fixed 2 s
    The stud's three holes: the mean of 41:58 and the top-view photograph (the stud in place: a pin, the slotted stud screw, a pin), which agree within 0.5-0.8 mm; 3.9, 7.0 and 10.5 mm from the staff (were 3.8, 6.9, 10.4 from 41:58 alone). The cap is steel on the photograph; the gilt ring at 41:58, the cap off, is the setting. smoke.py's check on the 3D model tab raced the address's 300 ms write on a loaded machine; it now waits for the condition up to 10 s.
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2026-10-04 Records: the bridges' rims checked against the measured plate (side photograph, three video frames): the model's 40.5 stands; the top-view photograph reads them 10 % small, noted in topview.py so its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
2026-10-04 RESOLVED.md, SHAPE-PASS.md: hash for the case's bottom, the key and the handles
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2026-10-04 BOM.md regenerated for the shape pass; SHAPE-PASS.md: the records corrected, the two clearance fits left open
2026-10-04 The hairspring collet's clamp no longer flickers: the tongue ends 0.1 mm inside the clamp (it ended in the clamp's outer face), the clamp's lower jaw runs 0.1 mm under the tongue and the hub stands 0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
2026-10-04 Box and gimbals: the lock nuts and the latch's clamping head at their measured size (r 8.5; 1:15 against the bezel, Figs. 1, 11, 106), the brass corners as short caps (Fig. 1); the box's size checked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
2026-10-04 The Navy's balance brake locks onto the rim: its pins' end from the rim's height (BAL_RH), both pins down together
    The pins were sized for the 4.3 mm rim; with the 3.5 mm one they stood 1.3 mm over it free and stopped 0.8 mm short of it locked. The rim's height is one constant now, the pins end 0.5 mm over its top edge, and locked the lever turns about the horizontal through its pivot along the crossbar, so both pins come down onto the rim. audit.py records the free pins' ends when the stop is fitted.
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2026-10-04 Release 2.04.00: the hairspring's collet drawn as the manual's figures show it, its clamp pinching the spring's end; the hairspring comes off with the balance in the Exploded view; the clamp's flicke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
2026-10-04 Revert "The Navy's balance brake's arch clear of the hairspring: its inner edge 1.24 times the coils' from the staff, as on 2E11795's photograph"
    This reverts commit 3c528916b6e365b2d916a8eb9453c1fabe76ba3f.
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2026-10-04 Greenwich time from the sky: an almanac in the page, sight reduction and the lunar distance, checked against JPL
    - shared/almanac.js (ALM): the Sun (abridged VSOP87), the Moon (ELP-2000/82's main terms, Meeus 47), the 57 navigational stars and Polaris (SIMBAD), sidereal time, nutation, aberration, ΔT (measured to October 2026, then a forecast); dip, refraction, parallax, semi-diameters; the time sight, intercept and fix; equal altitudes; the lunar distance cleared exactly, the Earth's figure taken off from the DR; sights made from the almanac for the worked examples; the Sun by hand.
    - tools/almanac.js (Node, about 1 s, in ci.py --quick): Meeus's examples; the Sun within 0.5″, the Moon wi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
2026-10-04 The escapement against a period text: tools/keystone.js and the sources found
    tools/keystone.js measures the model's escapement against the rules of
    Watch and Clock Escapements (The Keystone, 1904), Ch. III: roller to wheel,
    the balance planted where the rims cross over a pitch (9.34 mm by the rule,
    9.40 in the model), impulse and unlocking arcs, the locking stone, the
    tooth's face angle and back, the detent and its spring's stiffness. The
    text is generic, so the tool reports and never fails; the model README's
    "Against a period text" records the result, nothing in the model changed.
    References/README.md lists the book as consulted and the Model 21 leads
    not yet consulted: the NAWCC Bulleti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
2026-10-04 The balance's masses read as a matched pair's: Table II needs 578 g·mm², the drawing makes 534 (I_REST 44, from 410)
    The parts list's masses (balance screws, timing and vernier weights, washers) are read as a pair's, half each (PM in movement.js; inferred, likely). Read as each one's, the steel timing nut as measured can't weigh 93 mg, the screws' heads would need gold, and the drawn balance falls 37 % short of Table II; read as a pair's, it falls 8 % short (inside the rim's measured thickness). Table II's fit is computed in the code (I_T2). The rates the panel gives are unchanged; the hairspring's stiffness halves (about 91 µN·m a radian). No part's shape changed (placements.py: 0 of 39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
2026-10-04 The hairspring designed: the strip from the stiffness, terminal curves to Phillips' conditions, the force on the pivots checked
    - shared/hairspring.js (HSPR): terminal curves solved from their curvature for their end's place and heading and Phillips' two conditions; the whole spring's path; the force the pivots carry under a couple (Castigliano, the spring as a slender beam); the strip's section from the stiffness.
    - tools/hairspring.js (Node, about 12 s, in ci.py --quick), from the model's coil and ends: k 91.4 µN·m a radian (Table II's balance); the strip 0.23 mm wide (measured on the video, 6:49.5) by 0.226 thick for Elinvar at 180 GPa (0.216 steel), the spring 439 mm, 207 MPa at the sw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
2026-10-04 Review-results.md: the hairspring's inner end measured on 6:53.25 and 6:53.5 (the collet's wedge pin 2.8-3.9 mm from the staff), and the sharp window (2.9-3.3) where a short curve meets Phillips' con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
2026-10-04 Phases A-D and F: the hairspring drawn as designed, the physics derived, the maker's sheets, drawings, STL and build book, the workshop in the essay, the rate book from the sky, the self-containment 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
    - A2: the hairspring drawn as HSPR designs it: a strip 0.23 x 0.221 mm (ribbonGeo, core.js) on two terminal curves solved to Phillips' conditions (14.8 mm into the stud's clamp along the bar, 21.8 mm to the collet), 2.5e-5 of couple / R on the pivots; the collet's end at 3.2 (the video's 2.8-3.9), the collet scaled from it (CKC). fine.py's spring entries re-recorded, audit's new coplanar face (the strip on the collet) recorded.
    - A3-A5: tools/physics.js: the mainspring the fusee asks for (1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
2026-10-04 The physics settled, the planets, the tolerances, the docs: every phase of PLAN-self-contained.md
    - TF 34 s and fD 0.057 derived (tools/physics.js, reading the escapement's unlocking share and lift from the solver): the energy budget closes for a Q of 171-273; Op. 78's 0.770 g preload over the 0.20 mm lift puts the detent spring at 4.4-7.1 % of the balance's work; the escape wheel's inertia measured on its solid (invariants.py checks it); the isochronism term that cancels the escapement's -0.13.
    - Venus and Mars (ALM.planet, JPL's approximate elements): within 36″ and 102″ of Horizons 1950-2049 (almanac-ref.json's new planets, almanac_ref.py fixed to sort a request's epochs and assert ea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
2026-10-04 Maker's sheets: every part's holes (centres and diameters, top and bottom, as holes.py reads them) in a table and on its drawing, numbered; the drawing's plan correctly labelled from the dial side, i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
2026-10-04 The escape arbor's body measured, threads on the sheets, BOM.md again
    The escape arbor's body r 0.67 (0.55 estimated): beside its pinion in the
    staking tool, KLUwI2UUCMQ 43:21.1, 0.456-0.478 of the pinion's tip radius;
    the wheel's web bored to it. Its pinion's length and height above the
    wheel read otherwise than the model's: recorded open (Review-results).
    Each card's sheet lists its screws with the ISO 261 thread nearest the
    drawn one (Hamilton's are in no source). BOM.md and makers.js regenerated
    for the measured pivots; RESOLVED.md: the build book's drawings;
    PLAN-self-contained.md: the second round.
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2026-10-05 The escape pinion its measured length; the heights' question settled
    Re-read at KLUwI2UUCMQ 43:21.1 against the escape wheel (13.16 mm, 760-775
    px at the arbor's depth), the pinion nearer the camera and the view tilted:
    its end 8.7-10.1 mm from the wheel's web, the model's 10.45 inside that, so
    the train's heights stand; the first reading's scale was the model's own
    pinion tips. Its leaves 3.6-4.7 mm: drawn 4.0 about the same mesh (2.0).
    The escape wheel's J 4.80e-9 on the solid. ASSESSMENT-2026-10-05.md,
    Review-results.md and VIDEOS.md corrected (an addendum, not a rewrite).
2026-10-05 The balance hub's brass sleeve on the staff; the endshake check's sampling
    KLUwI2UUCMQ 34:12: between the hub's flange and the impulse roller the
    staff is sheathed in a brass sleeve 3.24 mm across (against the roller's
    0.249 in), the length the model's gap gives; drawn (the bare staff was).
    The disc under it reads 5.2-7 mm on two frames, the flange 4.4: open.
    bom-check.js's endshake now takes the vertices furthest along each way
    (the sample had missed the pivot's end once the sleeve came).
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2026-10-05 The box's walls and the gimbal latch's place measured on KLUwI2UUCMQ 0:28.7
    Nearly top-down at 4K, at the latch head's own 11.2 px/mm (the bezel 11.1):
    the box's right wall 77 mm from the case's axis, so the walls 21 thick and
    157 inside (10 thick, 177 before; 2E12055 reads about 155); the latch's
    pivot against that wall 30 mm toward the front, not in the corner (a
    clearance fit before), as Bonhams' photograph of another box has it. The
    ring's slot spans the lever's swing (Fig. 106's long slot), the keeper
    faces the pivot, the bracket is a plate against the wall, the handle a
    5.4 mm cylinder. The ring's radius checked against the bezel: as drawn.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
2026-10-05 The case's outside traced on a side-on photograph: band, wall, chamfer, depth
    Renaissance Antiques' photograph of a Model 21's case side-on (LPEC109-4)
    and KLUwI2UUCMQ 8:33, scaled on the band that holds the movement's ring:
    under the bezel a band 13.5 mm long, a step to a wall 0.962 of it, a
    chamfer over the bottom 11.4 mm to a base 0.82 of it, and 49 mm from the
    bezel's edge to the bottom, so the floor at 42.8 (it was a plain cylinder
    64 deep, set for clearance; the cock, the lowest part, clears by 4.8).
    References/README cites it and the Leland Little and Fontaines lots.
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2026-10-05 The unlocking roller, impulse roller, balance cap screws, verniers and detent block measured
    From the 4K frames, measured by ratio within each part:
    - the unlocking roller 3.1 long (1.0): a flatted body and a round end 2.57
    across (34:09.26, 158.5 px/mm on the impulse roller), its jewel kept at
    the trip spring's height; the impulse roller and its jewel 1.47 thick;
    - the balance cap's hold-down screws 2.15 from the staff (1.7), the cap
    r 3.0 to hold them (estimated); the vernier nuts 1.5 long, their screws
    a 0.5 stem and a 1.07 head (6:53.0);
    - the detent support block -10.5 to +3.85 along the detent, 3.1 wide
    (-15 to +5.92, 2.74), so its foot and adjusting screw shorter; its
    posi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
2026-10-05 The winding ratchet and its pawls rescaled (19:12 had been read against the wrong wheel; 23:30 gives the ratchet's tips r 6.9)
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2026-10-05 SHAPE-PASS, README, RESOLVED: the escape and third wheels, the detent block against the pillar, the unlocking roller and escape bridge's sizes brought up to date; the detent recorded
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2026-10-05 The mainspring coils and uncoils as its own spring does: its shape solved from its measured free curve
    The spring was two packs (arbor and wall) joined by one free turn of a stock shape: fully
    wound, most coils still lay on the wall. tools/mainspring.py now solves the strip's
    equilibrium in the barrel (least bending energy from its natural curve, measured on the
    free spring at KLUwI2UUCMQ 32:18 and 32:30; coils pressing on each other; inner end on
    the hook, outer along the brace) every quarter turn of the wind into js/mainspring.js
    (MSHAPE), and mainspringGeo blends the two states either side, each piece of steel
    between its places in them. Wound, the coils draw in round the arbor and spread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
2026-10-05 The mainspring set up where its solved pull falls as the fusee's measured profile evens out (1.62 turns, was 0.37 estimated); its states to 19.75 turns, the pull smoothed; the tour's and card's words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
2026-10-05 The build book by pieces: a part with pieces an assembly page, then each piece to make on its own sheet; the box and gimbals' parts in it (they were missing), the hairspring built for its sheet (it h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
2026-10-05 The barrel's wall measured 1.95 thick (0.11 of its radius, three frames of two movements, the inside plain to the floor), the brace three quarters round with the spring's pin in it and the barrel's h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
    Records: the new videos (TN24H, James Martin, Deafboy, pefkipefki) and the Royal Museums Greenwich catalogue in References; the coil pitch and the arbor's core, which point to a larger barrel, recorded for a decision (SHAPE-PASS 109-4, 109-6).
2026-10-05 The winding ratchet's screws at r 4.6, flush in counterbores (23:30; James Martin's unit at 7:11), the sustaining ratchet solid from its bore r 2.92 (19:12), the collar stepped under it
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2026-10-05 The barrel measured r 18.3 outside, its end and cap flush (TN24H's cap flat beside the fusee wheel, rectified; BunnSpecial's side-on turntable): the wall 2.0, the chain's 4.67 barrel turns, the mains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
2026-10-05 The arbor's core r 5.2 tried in the measured barrel: the parts list's strip is coil-bound 4.75 turns past its slack, short of the chain's 4.67 and a set-up; not drawn, recorded with what would decide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
2026-10-05 The Blender rig's changes keyed in four a span, so a part turning off its parent's origin (the barrel) keeps to its clip within 0.002 mm (blender_check.py failed at 0.03); rigpy.js regenerated; build
2026-10-05 Tolerances for what the sources don't size: tools/tolerances.js works out from the escapement (ESC.atK) how closely the mainspring, detent spring and trip spring must be made to keep the manual's swi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
2026-10-06 Barrel bridge: both ends of its opening curved, as traced, not straight cuts
    The far horn's end and the cut along the cock's straight edge were straight
    lines (the far horn's with a kink where PTr bent it near the rim). Traced on
    the flat bridge (C Spinner 23:45, a homography on its rim and the fusee and
    barrel bushings) and on the top-view photograph, both are curved:
    - the far horn's end bows 0.46 mm off its 12.8 mm chord (0.59 on 11.0 in the
    photograph): FH, drawn from the photograph's tip to the rim, where it lands
    0.7 mm from the straight cut's end
    - the cock's side bows into the bridge, 1.02 mm off its 15.2 mm chord at
    most, steepest near the rim (about 0.7 on 17 in place at 6:4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
2026-10-06 RESOLVED: the barrel bridge's curved horn ends, under Plates and bridges with its hash
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2026-10-11 tools/dynamics.js: the escapement integrated in time
    The balance, the escape wheel (with the fourth wheel behind it) and the
    detent as bodies, integrated through every contact, to check the
    swing-averaged model the page runs on and to answer what it can't: the
    detent's return, starting, knocks and the ship's motion.
    What it finds (reported with ~~, not failed): the wheel, released from
    rest, catches the impulse jewel about 13 deg after release, not 0.6;
    both springs' tips ride the discharge jewel's square end (let-off and
    overall then past Op. 86-87); the detent keeps lifting after release, so
    Op. 78's preload takes about 12 % of the impulse. The drawn escapement
    wants ~113 uN m (or Q ~330)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
2026-10-11 tools/strength.js: every loaded part against its material's range
    The going train's teeth (Lewis, fully wound, lossless), the escape
    wheel's tooth struck at the jewel's speed, the pivots and the fusee's
    bushing, the chain and its end fittings, the four springs (the detent's
    by Goodman over its preload and whole lift), and the knocks that bend a
    pivot or free the detent. Margins at both ends of each published range;
    nothing fails. Thinnest: the fusee wheel's teeth (1.5-2.2), its bushing's
    pressure (1.0-3.6), the trip spring's root (1.2-1.7) and the mainspring,
    which works near its limit by design.
2026-10-11 tools/errorbudget.js: would it keep time; ci.py runs the new checks
    As made: makeEsc with a maker's tolerances on every escapement setting
    (Monte Carlo): all run, 97 % swing inside the manual's band at the
    reference torque, a third meet every adjustment figure before adjusting
    (overall and drop the usual misses: the adjuster's work).
    At sea: 60 days from a winter port into the tropics, rated in port. The
    day's rate sums the test card's temperature curve, scatter and drift
    (calibrated so the simulated Navy test reads as No. 3390's card), the
    barometer through the air's share of the damping and the time-domain
    isochronism, the oil, and heavy weather from dynamics.js. Like No. 3390:
    about 1.4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
2026-10-11 Docs for the physics checks; the detent's return now computed
    Model README "Checked in time": the three tools and what they found.
    CLAUDE.md: the tools and their times. OPEN-QUESTIONS.md: the detent's
    return answered; the discharge jewel's end and what swings the balance
    255 deg as new open readings. Review-results.md: the open findings
    against the averaged physics (the wheel's chase, the jewel's square end,
    the detent's work).
    tolerances.js: the detent spring's sheet line says a thinner spring
    still returns the detent in time (dynamics.js), not "not computed";
    tolerances.json, makers.js and the builds regenerated.
2026-10-11 Escapement: the wheel's chase, the jewels' shapes, the springs' own work
    tools/dynamics.js found the swing-averaged escapement wrong in three ways;
    makeEsc now models each, and dynamics.js checks it agrees beat by beat
    (swing 255.6 vs 255, landing 16.4 vs 16.5 deg after release, detent fall
    -12.4 vs -12.4, own rate within 0.1 s a day, isochronism within 0.01).
    - The escape wheel, released from rest, chases the impulse jewel under
    its torque against its own and the train's inertia (JW) and strikes it;
    it was a kinematic gear (G) landing 0.6 deg after release.
    - The contacts are solved from the shapes; the discharge jewel's end is
    stoned to a half round (rnd; square, it held the springs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
2026-10-11 acoustic.py: the clicks of real Model 21s timed and fitted with the escapement in time
    Each recording's beats aligned by cross-correlation, bad beats rejected, a
    trimmed mean per band, onsets by the rise of the log envelope with their
    spread over bootstrap resamples; the corrected model (dynamics.js) and the
    old one (39d6919, kinematic) fitted with the swing as the only free
    parameter. dynamics.js traces the return swing's trip-spring events too.
2026-10-11 acoustic.py: pairings tried one to one, the beat error as a second fit, five recordings
    The fit now tries every order-keeping pairing of model events with onsets
    (one onset explains one event), reports the runner-up, and fits again with
    the beat error free (dynamics.js takes bE, the hairspring's rest off the
    escapement's zero), since being out of beat moves the return swing's clicks
    against the active swing's by milliseconds. Beats found click by click
    (edited videos jump in phase), the floor after the return swing, the wheel's
    release among the events. Results for the five recordings with sound in
    acoustic.json.
2026-10-11 swing.py: the balance's swing read frame by frame off a running Model 21
    We1dLNXiBj0's balance seen through the train bridge's cutouts, started by
    hand at 0:55: turning points by mirror symmetry, the growth registered
    turn to turn, the start and the growth fixed modulo one screw hole.
    256 +- 9 deg at 2:03.4 (aliases 244-267), still rising; the other running
    videos surveyed and rejected, with the reasons.
2026-10-11 Checked against real chronometers: the sound, the swing on video, a real start
    README's new section and the docs for acoustic.py, swing.py and startup.js:
    the corrected escapement's timing matches real Model 21s (the strike 7-9 ms
    after the unlocking, not 2; the intervals following the swing through a
    start), the old kinematic wheel is ruled out; sound and picture agree on the
    swing within their uncertainties; a real start builds up far more slowly
    than the model's 52 s run-down allows (OPEN-QUESTIONS.md, not changed in the
    model). The whole-recording fit of We1dLNXiBj0 replaced: it averaged a start.
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2026-10-11 Train and motion work meshed under load: each driven member on its driver's driving flank
    Every pair was phased with its backlash centred (0.04-0.06 mm a side at the
    closest). gearLash (core.js) now turns each driven member back onto the
    driver's driving flank, to 0.005 mm where the outlines as drawn come closest
    over a whole tooth; ph() in movement.js passes the way each driver turns as
    update() turns it. gearOutline is split out of gearGeo, and the outline kept
    in the geometry's userData (pl). The laid-out view keeps the phase. Checked:
    no overlap and the closest gap 0.005 mm, on the driving flank, at the audit's
    E values, wind states, a slip of the hands, laid out, and over a dense sweep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
2026-10-11 Open question: the third stage finer than the fourth (0.251 against 0.261)
    The modules follow from the measured centre distances and counted teeth. The
    video's size ratios agree for the fourth wheel (centre / fourth 1.48-1.50,
    model 1.48) but put the third wheel 4-7 % larger than drawn (1.36-1.39 against
    1.45), a module of 0.262-0.268 its measured place can't hold. No millimetre
    reading of either wheel exists; geometry unchanged. The README's Estimated
    section notes it, and that the backlash is estimated with the profiles.
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2026-10-11 The drive from the solved spring on the chain's pitch line
    torque was pull x the groove's floor radius with an illustrative pull; now the solved
    spring's msPull at the barrel's turns on the chain's lever where it leaves the fusee,
    the set-up matched to the levers' ratio (0.490). physics.js takes the pitch radii:
    0.93 N m fully wound, 64-100 uN m at the escape wheel; the essay's spans follow.
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2026-10-11 app.js: a jolt moves the balance's phase too, and the dial shows the knock's time error
    The jolt computed the new swing from (theta, theta') but kept the phase. knock() now puts the balance
    on the phase theta and theta'/omega give, the escape wheel staying on its stone (the count unbroken,
    a trip adding its tooth), so the next unlocking moves and the hands with it.
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2026-10-11 Gimbals: the case hangs along the apparent vertical as the box rolls about the ship's axes
    The pendulum's pivots were fixed in space, so the case stayed within 0.14 degrees of level. At sea
    the box rolls about axes metres below it; the pivots' acceleration now enters the pendulum (axes
    5 m below, estimated; faded out below a ship's 4 s), leaning the case 5.4 degrees at 7 s and 14.
    One gimStep in box.js for the page and the export; rocking eases in as it eases out.
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2026-10-11 Escapement: AMIN is the least swing that works, without 2 deg to spare
    Between 40.2 and 42.3 deg the train was held while ESC.state drew the detent unlocking it every
    swing. AMIN is now that least swing exactly (40.2 deg: the trip spring binds), refined by
    bisection when a setting moves it, so the train holds only when the escapement can't work.
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2026-10-11 The balance runs down faster with the train held: the trip spring and detent still take their work
    ampStep let a held balance fall as exp(-t/TF) at every swing. While the swing still carries the
    discharge jewel back past the trip spring (above 40.2 deg) the jewel bends the trip spring on
    each return and lifts the detent on each active swing: ESC.EH, 0.033 of k an oscillation (17 %
    of the air and pivots' loss at 255 deg, five times it at 45). ESC.freeStep takes both in closed
    form for any step (d(A^2)/dt = -2A^2/TF - 2EH/T above AH, -2A^2/TF below); from 255 deg the
    swing reaches 40.2 in 47 s, not 96. app.js's ampStep uses it for the undriven branch;
    tools/dynamics.js integrates a held train'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
2026-10-11 Tolerances and the maker's sheets from the pitch-line torque; docs follow
    tolerances.js --write (the mainspring 0.89-1.03 N m fully wound, was 0.85-1.00) and
    makers.py; the README's chain path, mainspring.py's docstring, OPEN-QUESTIONS.
2026-10-11 RESOLVED: the kinematics fixes' hashes; README: the winding ratchet's teeth look shallower at 18:20
2026-10-11 RESOLVED: the kinematics fixes' hashes, and their degree and unit signs (mis-encoded)
2026-10-11 The breathing hairspring clears its collet: the collet body's hidden side stops short of the plate's corner
    Wound past about 50 deg, the inner terminal curve, curling inward near the clamp, met the corner of
    the collet's body, whose hidden side (no source shows it; Fig. 6 draws the front) was taken back to
    the plate's corner. No inner curve meeting Phillips' conditions from the collet's end clears that
    corner (searched with two more curvature terms: the farthest out of 3,000 passes it at r 3.64, 4.0
    needed at 347 deg), and no source sizes the collet (manual, parts list, patents US 2,391,816 and
    2,457,631, KLUwI2UUCMQ 6:52.5-6:53.5). The hidden side now ends 0.9 of the way to the corner: the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
2026-10-11 Integration after kin-power: the run down's taper in the HUD, the spring's relaxing in the swing panel, the chain's lever in the charts, reset on setting the time, the export's drive and release as t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
    - app.js: spentNow() says Run down once the taper's drive can't keep the balance unlocking; the fusee chart and the essay's fusee figure use the chain's lever (fs.lever) not the groove's floor; the swing panel says the sustaining spring starts at the full drive and relaxes; setTod/Now/setTz pass reset to update(); hrs stands while the sustaining pawl holds.
    - blender.js: sim's drive and go as app.js (max of the fusee and the sus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
2026-10-11 RESOLVED.md: the integration's fixes; VIDEOS.md: the winding pawls' trace (19:12) and the set-up ratchet's faces (38:28); CLAUDE.md: escapement.js's stone check, fine.py's time
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2026-10-11 Setup ratchet measured on the video: teeth 0.48 deep, faces radial, the click seated on its outline
    The setup ratchet held loose at KLUwI2UUCMQ 38:25.8 and 38:26.0 (nearly face-on, 4K) gives
    teeth 0.48 mm deep (0.42-0.53; drawn 0.72, the gear convention) and locking faces undercut
    3-6 deg; a face leaning back, as drawn, is ruled out. tools/ratchetface.py traces the outline,
    maps the tips' ellipse to a circle and reads each gap and face, then calibrates the readings on
    synthetic frames blurred as the frame's edges.
    The faces are drawn radial (ratchetProf takes one radius to each angle), the depth through new
    rd options (gearGeo, ratchetProf), and the click seated by its outline (phaseAgainst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
2026-10-11 Setting the time without turning the train; the twist through the box's turn; the balance's damping in its parts tried
    - The time field, Now and Local/GMT set the hour and minute hands by the cannon pinion's
    slip and the seconds by a stop to set (the locking arm, a twist as the time comes round),
    so the train never turns back; smoke.py checks it after Now. social.py sets its time in
    the page's address, which still sets it directly as it loads.
    - The twist draws the balance along its integrated path while the box turns (TWIST.path)
    and leaves it with the end state as the turn ends, on the model's time; the export's
    Stop and start clip does the same.
    - dynamics.js takes o.split, the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
2026-10-11 Checks: fine.py winds through the page's own loop; blender_check.py compares the rig with the Winding clip
    - fine.py, after its frozen states, winds as a visitor does: the page's own loop, in the
    Movement view (where the hairspring is rebuilt each frame), from 20 minutes short of run
    down, Wind, checked as the key goes on, half wound, as it is let go and a second later.
    (Run in the case, the spring kept its last frozen shape and showed a false overlap.)
    - The export writes the Winding clip's hours every 0.25 s; blender_check.py sets the rig to
    them and holds the parts that follow the wind within stated bounds of the clip (fusee 7 deg,
    barrel 5.5 deg, chain 13 mm, up-down indicator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
2026-10-11 OPEN-QUESTIONS.md: resolve the conflict markers left by a5b2f6e (keep the set-up ratchet's measured reading and the winding-pawl springs' section)
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2026-10-12 OPEN-QUESTIONS.md: the conflict markers left by the ratchets merge resolved (main's set-up ratchet reading, the winding-pawl springs' section kept)
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2026-10-12 The balance cock's endstone cap, settings and screw counterbore at their measured sizes
    Through the camera fitted on KLUwI2UUCMQ 6:49.0 (the same camera as 6:29, the cap
    on): the cap's screws 6.66 mm apart (3.33 either side of the staff, was 2.75), the
    plate 8.9 x 5.5 (was 7.2 x 4.6), its setting 3.85 across (r 1.93, was 1.6), the
    screws' heads r 0.85; the cock screw's counterbore 7.4 across (r 3.7, was 3.05),
    its head r 3.33 at the photographs' 0.90 of it, 10.0 long, thread r 1.23; the
    cock's own setting r 2.2 (41:58, was 1.5). Docs: README, SHAPE-PASS,
    OPEN-QUESTIONS, RESOLVED.
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2026-10-12 The discharge jewel: rB and rT searched together, overall at the middle of Op. 87 (28.0°)
    rB 0.010 with rT 0.290 left overall at 29.7°, the band's edge, and 77 % of escapements made
    to errorbudget.js's tolerances running (92 % with the half round). The square acting corner
    holds the trip spring's tip on the return, so overall wants less overlap, which leaves less
    lift past the release; a larger back radius lets the detent off sooner at the same overlap.
    Searched rB (0 to wD/2) with rT, rd within the frames' 0.4-0.5 mm proud, aD for the drop:
    rB 0.024 (0.158 mm, half the width) and rT 0.2894 give lock 5.5°, let-off 8.7°, overall
    28.0°, drop 2.0°, 81 % running; nothing inside the frames'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
2026-10-12 The mainspring as the videos give it: 0.394 x 1,064 mm on the arbor's core r 4.9
    The owner's decision (12 October 2026): the strip's thickness from the coils' pitch read round
    the whole turn on KLUwI2UUCMQ's let-down spring (1/41.0-1/41.8 of the measured barrel's inside
    radius, 15:54, 33:06) and its length from their L/t of about 2,700; the core at the low end of
    three readings on two 1941 movements (r 4.8-5.7: 33:20.5, 33:06, TN24H 0:16); the eye as 15:54
    reads it (7.2 along, 5.2 across, 2.2 off the end), the hook against its end at its middle height.
    Re-solved (tools/mainspring.py, states 12.75-19.0, those past coil-bound left out): slack 13.25
    turns, set up 1.01 by the fusee's rule (Op. 5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
2026-10-12 The chain's links counted once (at full wind), not each frame: the hook's plate no longer jumps a pitch as the sampled line's length crosses a whole number of pitches (blender_check: the rig 0.88 mm 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
2026-10-12 gearing.js and thermal.js: the going train's meshes tooth by tooth, the swing they give over a day, each mesh's depthing window and the CNC's hole tolerance (±13 µm); the depths, endshake and escapem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
2026-10-12 mainspring_friction.py: the mainspring's coil friction from the solved spring; physics.js, bench.js and benchcheck.py take it
    On the solved states (mainspring.js), each polished, the coils' slip is followed on the steel from state to state and the
    packed coils' pressure found by the packed spiral's ring equations (the solver's multipliers and the rod's differentiated
    equations failed their checks in packs). Over the fusee's turns the coils take 3.4 % of the spring's work running (2.7-5.4 %
    at mu 0.08-0.16), winding 6.8 % more than running gives: under 1 % mid-wind, steep in the last half turn before coil-bound.
    physics.js takes the spring's own losses from it up to what mainsprings measure (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
2026-10-12 The build's Nivaflex mainspring re-solved: 0.59 turn of room (the model's 0.33, not 0.13)
    mainspring.py --nivaflex (or MC_MS_T/MC_MS_E) solves a variant strip beside the model's
    (tools/mainspring_t0.386.js, never js/mainspring.js); --bound finds coil-bound to 0.05 turn
    (mainspring_bound.json). mainspring_friction.py --nivaflex sets the variant up by the page's
    fusee rule (checked against the page's full wind) and works its friction
    (mainspring_friction_t0.386.json). reportdata.js gives both strips' swing over the wind; the
    report's section 10 has the comparison (table, Figure 16). bench.js reads the finer room, so
    the build book's mainspring test says 0.33 turn. ci.py --full checks the varia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
2026-10-12 The winding stop-bar, its spring and the winding stop drawn from the restoration video, and their motion from the measured parts
    The stud 2.3 across and 5.5 long with three grooves across its end, its base 11.6 mm from the fusee's axis (it was an estimate,
    r 0.9, 108 deg round from there). The bar 15.0 x 1.9, its ends slanted the same way, 0.7 thick at its stop end and 1.1 at its
    chain end, on the side where the stop end leads with the corner that stands out (it was 14.6 x 1.0 x 0.45, square-ended, with an
    estimated nose). The spring a wire C round the collar hooked into the bar. The chain pushes the chain end in 1.97 mm; the bar's turn
    is solved so its stop end meets the stud at full wind.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
2026-10-12 The mainspring's room against the sources' proportions (OPEN-QUESTIONS.md 1, option A)
    mainspring.py solves any strip, length, core and film as a variant (MC_MS_T/_L/_RA/_GAP/_TAG;
    the table's start MC_MS_TLO); mainspring_friction.py --variants runs on each one
    mainspring_bound.json records, and ci.py --full checks them all. Solved in the model's barrel
    with the sources' ratios: the model packs its coils at 1/40.3 of the inside radius, coarser than
    every source (the videos' pitch taken as the bare strip, a 0.01 film added); packed at the
    videos' pitch (0.391 + 0.003) it has 0.60 turn and swings in the band all through the wind;
    KLUwI2UUCMQ's pitch with the 0.01 film 0.46, TN24H's 0.78; on th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
2026-10-12 The fusee groove's phase fixed where it has been (dl at m 0.7201035), not recomputed from the stop-bar; gimbals.json for the redrawn parts' mass
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2026-10-12 The stop-bar's gaps settled on the restoration video: its spring into a hole in the bar's side, the step on its underside, the band as deep as the chain end and the top turn under it
    The spring's end goes sideways into a hole in the bar's inner side face (25:14-25:17) and its fixed end into a tapped hole in the
    recess floor (the "balls"); the step is on the underside, 0.52 of the length from the chain end; the chain end is level with the
    band under the top plate and with the top of the chain on the top turn (37:22-37:26), so the band is as deep as the chain end, the
    slot's floor flat and the top turn 0.34 lower. The released place (centred), the chain's push (1.9-2.5) and the stud's grooves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
2026-10-12 Release 2.27.01: the winding stop-bar's spring, its holes and the top of the fusee corrected from a real Model 21
2026-10-12 The mainspring packs at the pitch the videos measure (the strip 0.394, no film): 0.60 turn of room
    mainspring.py's film MC_MS_GAP is 0 (core.js MSPRING.gap too): the videos' pitch is the packed coils'
    spacing, the strip at most, and no source gives a film; the solver had kept the coils a further 0.01
    apart, packing at 1/40.3 of the inside radius, coarser than every source. Re-solved: set up 0.89
    turn, fully wound 18.75, coil-bound past 19.35 (0.60 turn), 95.3 % of the frictionless torque fully
    wound, the swing 248-263 deg all through the wind; let down 11.2 coils on the wall against the
    video's 12 +- 1 (10.4 before). The build's Nivaflex: 0.79 turn. write() drops trailing states at
    coil-boun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
2026-10-12 RESOLVED.md: the mainspring's pitch and maintaining.py's catch entries under their headings with their hashes
2026-10-12 PLAN-build-verification.md: the handoff after the mainspring's correction (2.27.02): state, findings, how to change the page's spring, variants, pitfalls, next steps
2026-10-12 Drive and damping, first findings: which spring the fusee asks for (drive.js), a second real movement's recovery, the literature on balances' Q
    - tools/drive.js: each solved strip set up by the page's fusee rule (taper +-3 %), its room, evenness, swing at the model's TF and the TF for 255 deg;
    the drive 255 deg wants at each TF; physics.js's spring torque (0.777 N m) against the solved one (1.018)
    - mainspring.py candidates fz<um>r<core> (0.374-0.44 mm at L/t 2,700 on r 4.9, 5.4, 6.5): only the thinner strips on r 4.9 can be set up;
    MC_MS_TILT for the free curve's sensitivity; mainspring_friction.py --variants leaves fz* to --fz and skips strips too short to wind
    - xM_mxtGfeqQ: not a ste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
2026-10-12 Maintaining work: a wind started in the frame of a set goes back with the fusee and is held within a tooth
    Wind with the key with From run down sets the wind to run down and starts winding in
    the same frame; update() took the winding pawls' lock from the fusee's old place, so
    the sustaining ratchet stood while the fusee turned back about 0.8 turn, then dropped
    2.7 deg (a tooth is 3). The fusee is now carried to its new turns first, its pawls on
    the nearest tooth. maintaining.py checks the case (78 frames failed before the fix) and
    counts the sustaining pawl's hold depth only where the spring pushes on it. Also
    exports SSG (the spring's relaxed gap) for the close-up's explanation; no shape ch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
2026-10-12 Sustaining spring close-up: zoom, enlarge, slow motion, keep open, and how the spring takes the load
    The close-up gets a row of tools: the wheel, a pinch or +/- zoom about the pointer, a
    drag moves, a double-click resets; enlarge; slow motion (1/4, 1/10, 1/25) that slows the
    key, model time, the 2 s after and the spring's easing together while the close-up
    shows (mClk); keep open (and Open the close-up under Winding) to watch the spring under
    load in running; and an explanation beside it of how the band carries the whole drive,
    in running, while winding and when the key lets go, the phase under way opened with
    its live figures and links that zoom onto the spring's gap, the sustaining pawl or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
2026-10-12 Drive and damping: the last candidates (every strip on r 6.5 too short to wind) and the free curve's sensitivity (+-15 %: the set-up moves about 0.2 turn)
    - mainspring.py variants fz419r65, fz440r54, fz440r65 and the tilted free curves fz394r49tp15/tm15, fz374r49tp15/tm15
    - OPEN-QUESTIONS.md 1 and the build-verification report's section 11: the set-up can't choose between 0.374 and 0.394 mm;
    the thicker strips' and larger cores' shortfall stands
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2026-10-13 gimbals.json rewritten: the bowl's centre of gravity had drifted 0.011 mm (x 7.827 to 7.816) past massprops.py's 0.01, on main too
2026-10-13 Release 2.28.01: the build keeps the Model 21's balance, its hairspring in Nivarox, Table IV trimming the temperature error
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2026-10-13 Mechanisms 2: the ratchets and pawls (ratchets.js)
    Each pawl as the model seats it (mechanisms.json: the ratchet turned the way
    its load turns it, the contact the first that grows on a face or a tooth's tip
    corner): the draw against the friction angle, the tooth, the face's bearing,
    the pawl and its pivot, and its spring. The winding pawls draw in at 12.5°,
    the setup click at 4.5° (its faces' measured 3-6° undercut would add as much);
    the sustaining pawl as traced meets a tooth's tip corner with its side, fitted
    to the face it draws in at 32.8°. Every stress at least 1.9 times short of its
    material's weak end. Let go, the winding pawls need 9 mN from their springs to
    follow the fusee's t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
2026-10-13 Mechanisms 3: the sustaining spring (sustaining.js)
    Its stiffness from its section by Castigliano (a band bent in its plane between
    its two pins), then the train run on it while the key is held, the swing
    following its equation and the rate the escapement's. The model's spring (the
    whole drive loaded, nothing ten minutes on) drives the train 9.4 minutes, the
    manual's five to ten; a wind costs microseconds. The drawn band's estimated
    height (1.13), gap and lobes make it too soft (0.70 N·m a radian against the
    1.78-4.20 the manual's figure asks): it would run closed solid, and a band stiff
    enough at the measured width wouldn't fit the recess, so the estimates differ:
    OPEN-QUESTIONS.md.
    Co-Au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
2026-10-13 Mechanisms 4: the motion work and the hands (motionwork.js)
    The motion work's two meshes and the wind indicator's, tooth by tooth on the
    model's outlines (gearing.js's stage): all run, backlash 11-25 µm. The hour hand
    can stand 0.4 minutes off in it, the wind indicator 0.01 hours. The cannon
    pinion's friction window: above 1.38 mN·m the hands hold through the 45 g that
    already frees the escape wheel; below 36.7 mN·m setting them forward for a
    minute doesn't swing the balance to the trip. Set near 7 mN·m: a weight of
    about 18 g hung 40 mm out on the minute hand turns it.
2026-10-13 motionwork.js: the meshes' torque ratios (stage's fac) and backlash as angles (bl, blmm); the hour hand's play judged against naming the hour
2026-10-13 Mechanisms 5: wear (wear.js)
    Every sliding contact by Archard's law, k from Rabinowicz's table (1e-7 well
    oiled, 1e-6 poorly, 1e-5 dry), each depth a year against the tolerance it eats:
    the meshes' close sides (gearing.json) for the pivots, the endshake for the
    balance staff's ends, the depth of lock to its 5° floor (tripping.json: 1.8 µm)
    for the escape teeth and the escape arbor. Well oiled everything lasts 26 years
    and more; the balance staff's pivot ends and the escape arbor's pivots go first
    (2.6 and 3.9 years poorly oiled, months dry): the oil's life sets the overhaul.
    The impulse strike runs a tooth's tip in to about r 0.15, nanometres deep.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
2026-10-13 Mechanisms 6: the going train in time (traindyn.js)
    The train's inertia at the escape wheel off the built model's solids: 6.05
    g·mm² against dynamics.js's 5.88 (the fourth wheel's 1.08 was estimated;
    measured 0.81, the escape arbor's pinion 0.42 more): the swing 0.9° less, the
    rate 0.08 s a day, which the timing takes. Then five bodies on four meshes
    (the teeth as cantilevers, their backlash), driven at the fusee's even torque,
    the escape wheel moved as dynamics.js's escapement moves it: the modes are
    2.3-9 kHz, so through a 7 ms impulse the train moves as one (the chase is a
    rigid train's); the strike on the jewel rebounds the escape mesh 60 µm inside
    its 167 µm backlash and loads it 4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
2026-10-13 Mechanisms 7: the whole movement to a maker's tolerances (montecarlo.js); sustaining.js faster
    2000 movements, every tolerance drawn at once: the holes ±13 µm, the meshes'
    friction 0.10-0.20, the mainspring's and the escapement springs' strips, the
    sustaining spring's band, the pawls' springs' set. Every train turns and every
    balance swings; 98.8 % swing in the manual's band as made, all of them once the
    set-up is turned (Op. 13); the maintaining work drives five minutes in all;
    with the pawls' springs set to the bench's twice-the-need, 99.9 % work after the
    bench's adjustments. No tolerance alone takes a movement out: together the
    drive's spread does, and the set-up brings it back.
    sustai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
2026-10-13 Monte Carlo: after the bench means after every bench test it models
    montecarlo.js judged "after the bench's adjustments" with only the set-up
    turned: the bench's pawls test, which tells the maker to re-bend a winding
    pawl's spring under 0.08 mm of set, wasn't applied, so the two movements with a
    short spring stayed failed (99.9 %). Now each movement is judged as made, then
    after the bench's tests as a maker applies them, by bench.json's own figures:
    the depths test re-bushes a mesh closer than its window less the pivots' shake
    (benchcheck.py's rule), the pawls' test bends a short spring or a loose wire
    back to the aim, the swing test has the set-up turned only where the swing is
    out of the b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
2026-10-13 massprops.py: the page loaded at one instant, so the hands' place no longer moves the bowl's centre of gravity past the check with the time of day
    app.js starts the model's clock at Date.now(); the hands turning with it moved the bowl's centre of
    gravity 0.016 mm between runs (z -4.574 against gimbals.json's -4.558), past the check's 0.01, so
    ci.py failed on main at some hours and not others. The page's Date.now now starts at 13 October 2026
    06:50 GMT, about when 48e82e1 wrote gimbals.json, which matches it (-4.557) unchanged.
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2026-10-13 Docs: the stop-bar's chain end drawn deeper so the chain pushes it (README, OPEN-QUESTIONS.md 3, RESOLVED.md)
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2026-10-13 smoke.py: the wait for the sustaining spring to relax given room for a slow frame rate
    The model's clock goes at most 0.05 s a frame; on a busy machine the headless page drew about 2
    frames a second, so the spring's relaxing, about 2.5 s of model time after the key goes on, came
    about 25 s later and the 5 s wait failed every run (ssD still -0.0012), on main too. 30 s now,
    returning as soon as it relaxes; the message gives the frames drawn and the model's time.
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2026-10-14 Op. 78's preload: the weight less the detent spring's bend over 0.005 in
    Op. 78 runs on over the page (pp. 60-61): the 0.770 g weight should part the
    detent spring from its stop button by approximately 0.005 in (Fig. 88,
    "(.005 in. clearance)"). The model took the whole weight as the preload. Now
    the preload is the weight's moment less the spring's stiffness over that bend
    (G78 0.127 mm at the button's middle): 0.63 g at the jewel with the drawn
    0.079 mm spring, and none at 0.137 mm, an upper bound on the spring from the
    manual alone.
    - makeEsc (W78, G78, th78, MW), dynamics.js (MW78; its kD variants set up by
    the test), tripping.js's frame, physics.js and tolerances.js follow it.
    - TF 67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
2026-10-14 The hairspring stud where 6:29 measures it; the outer curve re-solved; the cock's step moved with it
    The stud's holes were drawn through the old scale (0.83 of the video's): now at
    5.49, 9.00 and 12.75 mm from the staff. The clamp moves to 4.34 mm and the
    outer terminal curve is the smoothest that meets Phillips' conditions there.
    The arm's step, mapped along the same row on 44:02, moves to 14.6 mm. The
    essay's elastica figures follow (stiff 129,000, latBig 1.5e-3, iso 0.12).
    The barrel arbor's round body now ends where its square begins.
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2026-10-14 Regenerated data; the setup click's check and the rig's winding bounds for the new parts
    mechanisms.json (the sustaining spring's band and the arbor's square), the
    mainspring friction files (stale since main's TF 67 moved the fusee's band in
    bench.json), the report's mech.json and the builds. bom-fn.js tests the setup
    click by whether its tip lies in the tooth's metal turned each way, since an
    undercut face overhangs it at rest. blender_check.py's Winding bounds follow
    the sustaining spring's 19.5° travel, which the rig, without maintaining
    work, doesn't carry.
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2026-10-14 The measured train inertia adopted; the 28:1 carbon-steel mainspring ruled out in this barrel
    The rest of the inertia change (its first files went in with 1fca37f by
    mistake): makeEsc's JW 6.05 g·mm² and dynamics.js summing the arbors' drawn
    solids from mechanisms.json, the calibrated torque 62.8 µN·m, the budget still
    closing at TF 67 s; tolerances, gearing, tripping, bench and the maker's sheets
    re-written, the essay's Q range 281-546.
    Daniels's 28:1 arbor for a carbon-steel strip doesn't fit the measured barrel
    at this torque: 0.36 × 812 on r 5.04 has 3.4 turns, 0.385 × 1,064 × 14.3 on
    r 5.39 (variant d28w) leaves 0.10 turn. The build's Nivaflex covers it; a
    carbon spring is re-te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
2026-10-14 RESOLVED.md: the ring and dial screws' entry under its heading, with its hash
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2026-10-14 estimates.js: the design values resting on estimates swept, the bench's corrections applied
    Five values no source settles, each over its sources' range: the balance's
    free run-down (40-200 s: with the strip the run-down test chooses, 255° and
    isochronous to 0.35 s a day), the detent's springs (the ring band, now mapped
    every 0.005 mm: 0.072-0.110 mm, 120-222 Hz; outside it a held tooth's stone
    rings past half the lock, and at 0.15 mm a tooth gets past), the discharge
    jewel's back radius (0.066-0.158 mm, every one brought to the manual's
    figures), the sustaining spring's band, lobes and gap (6-11 minutes over a
    turn), and the hairspring's upper curve formed by hand. The report's section
    12;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
2026-10-14 RESOLVED.md: the ring screws' holes entry under its heading, with its hash
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2026-10-14 Wempe P1e: the dial, motion work, hands and up-and-down work from the 05 02 sheets
    dial.js (WDIAL): the cannon tube 05 05 03-3 with its 14-leaf pinion on the centre arbor's 1:80 shank; the change wheel 05 02 02 (56, its 18-leaf pinion) on the short stud at 19; the hour wheel 05 02 03 (54) over the cannon pinion; the up-and-down wheel 05 02 04 (120) on the long stud at 2 and its pinion 05 02 00-5 (12) at the fusee's hole 10; the four hands (05 02 00-1, -2, -3, 05 02 01-1 and its collet 05 02 01-2), their outlines from the sheets' widths and traced between them; the dial 05 02 00-4 with its printing as a canvas, its three screws and pin. The hands show local time; the up-and-down hand reads th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
2026-10-14 The models' switch: the Hamilton's page links to the Wempe's
    Both pages' headers carry the same nav (Hamilton Model 21 · Wempe Einheits-Chronometer, the page's own marked), its style moved into the shared stylesheet. The Hamilton's link is rewritten for each built copy as the Wempe's is: dist/ to the Wempe's built page, the root copy to its place in the repository, the site to /wempe/; the root build fails if the link is missing. ci.py passes, 42 of 42 (the Wempe's types, smoke, solids, audit and exploded among them).
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2026-10-15 makeEsc takes a second chronometer's escapement: its literals made settings, makeEsc(o, base), the Hamilton's bit for bit
    The settings (each the Hamilton's literal, on a new Object.assign line after DEF): NT, ES, LK, LO (the lock's place), DA, BL,
    PSL, PSO, fI (the impulse face: 0 radial), rJ, eJ, TBR (the tooth's back a cutter's arc) and TBP, SPL, SN0, SN1, OP78 (0: no
    Op. 78, W78 the preload), TQ (the escape wheel's torque the reference is driven at, its swing solved). checks(fig) takes
    another chronometer's figures. The reference fix: a non-reference instance rebuilt its reference from CAL on the Hamilton's
    defaults; now on base's (RESOLVED.md). tools/escgolden.js: all 360 fingerprints th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
2026-10-15 tolerances.js: the detent spring's and trip spring's sizes from makeEsc's settings, not read off its source (SPL, SPN became settings)
2026-10-15 makeEsc solves the Wempe's escapement: a bevelled discharge jewel (BEV), a square-ended passing spring (TSQ), tables past a late impulse (TH1)
    Three settings, each off by default, so the Hamilton's results are bit for bit as before (escgolden.js: all 360
    fingerprints; escapement.js, physics.js, keystone.js, tolerances.js, dynamics.js --quick and tripping.js --quick
    print the same): BEV bevels the discharge jewel's end back from its square acting corner; TSQ takes the passing
    spring's tip as its strip's square end rather than a disc (span: the jewel's polygon grown by the tip's outline,
    a Minkowski sum, clipped along the tip's path); TH1 carries the contact tables past an impulse that ends 45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
2026-10-15 PLAN-overhaul-findings.md: the handover for the three model problems the overhaul check found; finding 2's numbers corrected, finding 4 withdrawn
    Review-results.md: the winding ratchet's bore is r 2.43 against the arbor's r 2.87 step (not an r 4.0 collar: a turned part's bounding box); the
    barrel cap's screws move 3.15 mm out of the cap relative to the barrel in the Exploded view, as they should (compared with zero before).
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2026-10-15 The Wempe's balance re-weighed with its spring at rest (the shorter spring; SET.I 2268.6)
    wempe-inertia.js weighed the hairspring as the page last bent it, so its drawn helix (lengthened
    by the balance's angle, up to 4 %) and wempe_inertia.json changed from run to run; it is now
    weighed drawn at rest. The spring 0.590 g, 22.6 g.mm2 (505 mm pin to pin, phase 2c); SET.I 2268.6.
    The README's numbers after it, and Wempe 3955's coil count by its height as well as its count.
    Checked: wempe_escapement, wempe_hairspring, wempe_thermal; solids, audit, exploded, smoke, fine
    and bom with --model wempe; the hairspring and stud isolated beside 05 03_5 and Wempe 3955.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
2026-10-15 The Wempe's energy budget (phase 2b): its mainspring solved and fitted to 05 06_20, the budget from spring to balance, the meshes tooth by tooth, the strengths
    - wempe_mainspring.py: the strip 15 x 0.37 in the drum's 38.5 on the core's 13.3, solved by mainspring.py at twelve lengths and sets, its torque through the drawn fusee against 05 06_20's measured force: 1,240 mm (its free curve's turns x0.6) fits the shape to 1.07 % rms (2.0 % worst; an even pull 2.17 %), its hump, dip and rise; the length good to about +-50 mm. The drawn fusee and drum give the sheet's barrel marks to 0.08 turn. The level is open: the solved 0.37 strip gives 25 % more than measured (a strip about 0.355, the sheet's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
2026-10-15 The tables and the build-verification report after the bushings: mechanisms, gimbals and bench rewritten, fea.py's bearing search past r 3.4
    The heavier fusee and barrel arbors and larger bushings moved the arbors' inertias
    (mechanisms.json), the bowl's weight (gimbals.json, via massprops.py) and the bench's
    figures that read them (bench.json, makers.js). fea.py found each pivot's bearing within
    r 3.5 of its axis, short of the plate's new r 3.4 holes: now r 5. The report's fea, gimbals,
    mechanisms and data assets rebuilt; its holes move a fraction of a micron, as before.
    ci.py --full: every step passes after these (the four that failed were these tables and fea).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
2026-10-15 The Wempe through the TU's 35-day trial and at sea (phase 2d, part 2)
    tools/wempe_errorbudget.js, errorbudget.js's method: the chronometer as the model's numbers
    make it, the masses at their compensating place set by the adjuster, through the 6MX TU's
    trial at 36/20/4/20/36 deg C (E 0.031, R +0.01, D 0.13, C 0.000, S +0.58, N 4.6: it passes),
    and at the drawn place (C +2.98, N 182: it fails); a 60-day voyage carries 8.9 s at 30 days.
    ci.py runs it and gimbals.js --model wempe --quick (quick) and massprops.py --model wempe
    (browser); CLAUDE.md gives their times; the Wempe README's "Physics: case, gimbals and the
    trial" gives every figure and estimate.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
2026-10-15 The Wempe's locking bracket measured on 05 01: its pad at the pivots' height, so the case turns free in its ring
    P1f's estimate hung the pad 12.5 mm under the pivots' line and 1 mm from the ring, which stopped
    the case at 8.5 deg, within a moderate sea's roll. Measured on 05 01 (the elevation's outside
    half from the ring's top and the bowl's axis, Schnitt A-B at the pivots): the pad +5.5 to +1.3
    about the pivots' line, the upright to -8.2, the crank to -16.6, the foot to -26.4 with its screw
    at -20.3, 15.8 wide, its outer face 63.7 (A-B) and the pad to 67.5, 2.5 short of the ring;
    Kirow 422's bowl has its pad at the pivot's height too. gimbals.js --model wempe now passes in
    full (ci.py runs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
2026-10-15 RESOLVED.md: the dust seal's screw holes under their heading, with the hash (f06ed2f)
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2026-10-15 RESOLVED.md: the winding stop's blind hole under its heading, with the hash (09cf387)
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2026-10-15 The barrel bridge's holes as the real one has them, tools/holemap.py, and a sturdier holecheck
    KLUwI2UUCMQ 13:04.4 (the barrel bridge underside up, 4K) warped onto the bridge's plan by
    tools/holemap.py (a homography on the bushings, the seal's holes, the pillar screw's hole and
    the opening over the train bridge's third screw) shows holes the model lacked: the Navy seal's
    two screw holes (its screws now reach 2 mm into them, the seal centred between them, 7.8 out
    as the fusee seal's), the setup pawl spring's steady pins through the bridge (Op. 32), and six
    through holes no source explains (drawn, expected empty). The setup cover's tapped holes are
    blind (nothing under them there). blindHoles(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
2026-10-15 RESOLVED.md: the barrel bridge's holes under their heading, with the hash (e44d936)
2026-10-15 Review-results.md: the upper train bridge's hole survey (13:49.5, 23:30), open: two holes missing on its good side, the third's bushing 1.2 mm from L.T, the right side's readings too loose to move an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
2026-10-15 The Wempe as first drawn (phases E2, E3): the 1941 barrel and maintaining spring, the 1940 key, the earlier figures on the cards
    As first drawn (the page's Variants):
    - the barrel of 1941 (0207, 020701, 020701-3) in three pieces, Ø 41.5, its lid on the
    pillar plate's side, its bosses 1.9 inward round the 1941 arbor's 12 mm core;
    - the maintaining spring 020605, widening from 1.8 to 3.5 round its turn;
    - the key of 1940 (127-556.02 U 01), its flat pear-shaped handle traced on its sheet,
    the case's pieces of each state following the movement's;
    - on the cards, the figures the revisions changed by too little to show or only in
    tolerance (movement ring, lower cock, click, set-up ratchet,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
2026-10-15 The Wempe wound in its case: the bowl turned over, the closing plate opened, the key put in
    - Wind with the movement in its bowl (the Dial, Box and Case views) does as the 6MX's user
    instruction (pp. 3-4) and two 6MX videos show it (DIxob2Rl4dc 7:05-7:22, Uy8A88_j-cA 5:16-5:26):
    the lid opens, the bowl turns over in the ring about its 12-6 pivots, the closing plate opens,
    the key comes down onto the fusee's square; wound, all goes back (app.js cw).
    - The closing plate is shut at rest (25°, estimated) and opens to wind (WCASE.shutter).
    - The bowl's cone had cracks (narrow sloped plan cells), seen once it turns over: the bottom is
    now one cell with its holes and the rest turned from i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
2026-10-15 The upper train bridge's and the pillar plate's missing holes, surveyed with tools/holemap.py
    Train bridge: a countersunk hole between pillar 0's screw and the lower bridge's, at the same
    place on 13:49.5 (underside) and 23:30 (face up) through video.py anchor's rim-and-cut fits.
    Pillar plate (dial side, 9:03 through its bushings and pillar screws, corrected by the nearest
    model holes' offsets): through holes at 12 o'clock past the wind indicator's post and past the
    access hole at 4 o'clock (both on 40:05 too), and one over the barrel (9:03). None has a known
    use; each is in holecheck's expected empty with its source. The train bridge's right side reads
    too loosely to move anything (Review-r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
2026-10-15 RESOLVED.md: the train bridge's and pillar plate's holes under their heading, with the hash (d33651a)
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2026-10-15 The Wempe's detent spring's height exported for dynamics.js; the audit's revised record refreshed
    dynamics.js read the Wempe detent spring's height from escapement.js's source text,
    which the first-drawn detent's dv() changed; escapement.js now exports it
    (WESC.DSPH, 1.9), the text match kept as the fallback. wempe-dynamics and
    wempe-tripping pass again. The revised audit drops one face no longer found.
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2026-10-15 massprops weighs only the drawings' shown state; the first-drawn audit takes the masses' new faces
    massprops-check.js weighed every mesh, so the Wempe's hidden first-drawn pieces added
    to the case: it now skips a state's hidden groups (userData.rev), which leaves the
    revised figures as gimbals_wempe.json has them. audit-expected.json's movement.first
    records the masses' faces on the 1941 rim (main's masses from the rim's face).
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2026-10-15 The Wempe's tolerances: wempe_tolerances.js, how closely its unsized parts must be made
    The mainspring's strip against 05 06_20's pull (the guard band over the wind,
    the stress capping the top, the sources' band reported), the detent's spring and
    its preload, the gold spring, the depth of lock (the wheel's 14 +0.03 against
    the deepest that unlocks) and the hairspring against the timing weights' reach.
    Into tools/tolerances_wempe.json.
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2026-10-15 The Wempe's bench tests: wempe_bench.js, what a made Wempe must read
    Eleven tests, each with how and what it must read, from the Wempe's checks and
    its sheets: the mainspring, the pull on the fusee arbor against 05 06_20, the
    depths from the hole tables, endshake from the sheets' fits, the balance
    vibrated against the timing weights' reach, the free run-down choosing the
    strip, the detent's ring (wempe_tripping.js's frame), the escapement's figures
    with the lock's window and the banking's preload, the swing, the maintaining
    spring and the 6MX TU's trial as the acceptance test. Into
    tools/bench_wempe.json with the figures as numbers.
2026-10-15 Release 2.39.01: the overhaul's findings fixed, the winding square's dome, holes surveyed from the video
2026-10-15 The Wempe made to tolerances: wempe_montecarlo.js; the preload's floor the estimate
    wempe_montecarlo.js: 2,000 Wempes, each tolerance drawn at once (the sheets'
    where drawn, uniform within their limits; estimated where not), judged on the
    Wempe's analyses as made and after the bench's tests by bench_wempe.json's
    figures: 2.9 % work as made (endshake, which the sheets leave to assembly, the
    lock and the preload), 100 % after the bench, none failing unseen. Into
    tools/montecarlo_wempe.json.
    The preload's floor in wempe_tolerances.js and wempe_bench.js is now the
    estimate (0.63 g, where wempe_tripping.js finds 41 % of the depth of lock):
    the 0.72 g taken first was the frame's figure before the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
2026-10-15 The Wempe's build checks in ci.py, CLAUDE.md and its README
    ci.py --quick runs wempe_tolerances.js, keystone.js --model wempe,
    wempe_bench.js and wempe_montecarlo.js (about 2 minutes); CLAUDE.md lists them
    and their times; the Wempe README's new section, Building it: tolerances, the
    bench and the Monte Carlo, with their estimates and two open readings (the
    preload's floor, the endshake the sheets leave to assembly).
2026-10-15 The Wempe's escapement moves as makeEsc solves it, not as its layout draws it
    WESC.ESC.state is now makeEsc's state (WPHYS.ESC) at the live swing and drive, turned into the
    drawing's terms by WESC.adapt: the wheel let go from rest chasing the impulse stone and striking it
    13.7 deg into the swing (the stone's face 10.3 deg before the line of centres), the detent flung off
    the discharge stone and riding the tooth it let go, the gold spring bent on the return; the balance's
    beat drawn from makeEsc's pushes (the impulse raises the swing about 1 deg). Contacts drawn 0.01 apart
    as the layout kept them, the stone's ride taken where the tooth is drawn. The layout's motion stays as
    ESC.layout. makeEs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
2026-10-15 The Wempe's verification report: every check's method and results
    marine-chronometer-source/wempe/verification/: "The Wempe Einheits-Chronometer: does the
    model hold to its drawings, and would it keep time?", built as the Hamilton's reports are.
    reportdata.js runs every Wempe check (the full dynamics, tripping, gearing and gimbals runs
    with --model wempe), keeps each one's exit code and output as printed, and works the charted
    figures from the tools' modules and JSON; geometry.py runs solids, fine, audit, exploded and
    bom with --model wempe; build_report.py writes index.html from template.html, checks.py,
    bom.json and the README's Sources, Estimated, Readings corrected and Unresolved section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
2026-10-15 Barrel bridge: the cut round the balance one measured circle, no step
    The cut was three circles joined (the balance's clearance, one fitted on the
    top-view photograph, one traced on 6:49.0 from the cock's horn), which met in
    a step under the fusee's dust cap. KLUwI2UUCMQ 13:04.4 shows the whole cut
    face-on: one circle, r 20.06 about (2.03, 9.96), 0.11 mm rms over 196 deg.
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2026-10-15 RESOLVED.md: the barrel bridge's cut, the steady pins, the near screw and the train bridge's hole under their heading, with the hashes (1ec6538, 2ffb801)
2026-10-15 The Wempe's stop work as drawn: the slot cut, the bar's spring and pin, its slide from the chain
    From 05 06_4's Schnitt C-D (traced at 12.2 px/mm, mirrored as its view
    A-B is) and the body's 05 06 04-2, checked on Wempe 3955's photograph:
    - the slot cut across the small end, 2 H8, 1.5 deep and 1.1 toward the
    bar's upper end (02-2's two depths): the turned body stops at its floor
    and the last 1.5 is built ray by ray on its radius field; no face is
    shared with the bar, so nothing flickers with the cover plate hidden;
    - the bar on the cover plate (dial up the small end faces down: the floor
    move in 00a5ab6 was wrong), its ends traced, thinner toward its upper
    end, which passes under t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
2026-10-15 The Wempe's hairspring breathes: WESC.HSP.bend bends it as the Hamilton's R.spPath
    The page turned every coil rigidly by θ(1 − u) at its radius: the coils never
    opened or closed, the strip grew or shrank 4.5 % at 207° and lay 1.2 mm off the
    elastica. Now each part's curvature changes by θ/L (the pure couple), built from
    the stud's end back with the length kept: the coils open and close 4.9 % at the
    model's swing, within 0.010 mm of the elastica from −300° to 300°.
    HSPR.shape gives the elastica's nodes; wempe_hairspring.js checks the drawn
    spring against them (fails past 0.03 mm). fine.py --model wempe: 0 new or grown.
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2026-10-15 The Wempe's full wind at the stop, the slot along A; the stop bar's spring 0.10
    02-2 dimensions the stop bar's slot from the line through the chain's pin
    A ("4", "2 H8", no angle), so the bar lies along it; the model had it 40
    deg off, its turn set by the stop with full wind assumed at the groove's
    end N. With the slot along A, the stop pin (hole 7) decides full wind:
    0.112 turn short of N, 8.638 turns of chain, 8.70 turns and 55.9 h to run
    down (05 06_20's 8.75 working turns; the dial's 56); the groove's last
    tenth stays empty. escphys.js MF 8.638 (the page warns if it parts from
    fusee.js's MW); HS -0.657 (the swing over the shorter wind); the
    tolerances, bench, Monte Carlo and the essay's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
2026-10-15 The Wempe toward 3.00.00: time controls, ship motion, Report dialog, its own link preview, no longer "in progress"
    - Time: Set the hands, Now, Keep GMT/local (GMT the default). The hands go by the cannon
    pinion's slip (dial.js update's s.slip), never turning the train; the balance stopped and
    the train held until the time comes round, then a twist. Link keeps tz and t.
    - Display, Motion: Ship motion, Transit lock, Roll period. box.js's GIM.sea/gimStep copied
    into app.js with the Wempe's own gimbal periods (gimbals.js --model wempe: 0.958 s, 1.046 s).
    - Report a bug or inaccuracy: report.js takes name and inacc from bind() (the Hamilton's
    unchanged); dialog, panel button, card link an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
2026-10-15 The Wempe's box in mahogany, as Wempe No. 6161's
    The box and lid were oak, from the wartime boxes photographed round Bakelite
    bowls (Greenwich, Lange 1947). The model's bowl and gimbals are brass, as the
    drawings give them, and Wempe No. 6161 (Antiquorum 208-4) has its brass bowl in
    a mahogany box. Its colours are sampled on that photograph (the lid's lit
    front #904527, grain #773921 to #bb8166); the texture's ground and bands are
    taken at about 0.7 of those, since the page's light renders 1.4 times brighter.
    The Case view now reads the lid #8a4b38 and the front #6e3d22. A ribbon figure
    and pores replace oak's rays; the bleached birch outer box is unchanged.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
2026-10-15 Wempe frame and case to their sheets: the ring's radial pin at 12 (Ø 1.6), the top plate's pocket tapering, the fusee bush's fits, the barrel bridge's chord and short edge, the intermediate bridge's 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
    - 05 08 00-3: the radial hole at 12 o'clock, Ø 1.6 (the plan's '1,6'); the pin WN-202 moved there and the bezel's notch with it. The dial hole's Ø 1.1 noted, left 1.6 for the dial's pin (Unresolved).
    - 05 08_1b: pocket N-O's edges the common tangents of 23's r 5 and 51's r 4 (10 to 8 wide).
    - 05 08 01-2: T6 on the taper above the flange (the dust bush pressed on it), g6 on the spigot in the plate.
    - 05 08 05-1: chord 7 from 45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
2026-10-15 tools/wempe_stopwork.py: the Wempe's stop bar against its stop pin over the last 1.2 turns (chain and band), a ci.py step
    Fails unless the stop holds full wind (the pin 0.005-0.05 off the bar's far side and closing), the bar never comes within 0.5 of the pin earlier (the previous turn passes 0.69 off), the pin covers the bar's thickness where they meet, the bar slides short of its 3.6 without a jam, and fusee.js's MW is escphys.js's MF. A pin shortened by 1 mm fails.
2026-10-15 Wempe stop pin: its length and domed end scaled off the coloured section (1.6 straight, 0.25 dome), no longer estimated
    The section's Anschlagstift leader, followed across the barrel's wall, the band and the maintaining detent's arbor, ends on a stub under the top plate: on the plate's drawn 31 px for 3.35, straight sides 1.62 under the inner face and a domed end 0.27 (±0.1), Ø 1.5 for its 1.6. It was 1.5 flat, estimated. Turned now, so audit.py no longer counts its free end (wempe_stopwork.py checks it) and its flush outer face is a new expected coplanar face. README: the pin's reading, the bar's travel as the sweep measures it (3.37, band 3.38).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
2026-10-15 RESOLVED.md: the Wempe's fusee, maintaining work and barrel parts against their sheets, with its hash
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2026-10-15 The Wempe essay's gimbals figure: the transport box and the 1940 key hidden
    WCASE.build builds the outer transport box with the wooden box; the page hides it
    outside its own view, the essay's figure didn't, so the bleached-birch outer box
    hid the mahogany box, the gimbal ring and the case. It also drew both keys.
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2026-10-15 The Wempe's bowl: the winding hole's raised seat, which the cork ring meets
    As drawn the cork stood 3.84 short of the bowl's bottom, sealing nothing. The
    casting's sheet draws nothing machined; the 6MX's bowl has a raised seat round the
    hole inside (moMvyx8eXfo 3:35: Ø 15.3 by the hole, 3.4 ±0.6 high). Drawn so, 3.84
    high to the cork's top (estimated). The cork weighed at 0.24 g/cm³; the weighing,
    the essay's figures from it rewritten.
2026-10-15 The Wempe page: a Dial switch, Wempe 3955's or Lange 5177's printing (#dial=lange)
    dial.js's face(K, d) draws either, each from its own measured geometry (Lange's finer lines,
    its up-and-down circle open at the top, the band's end strokes running inward); R.setDial
    swaps the face's texture. The Variants' Dial buttons, the hash key dial=lange (the default
    Wempe), and the dial's card says which printing is shown and its source.
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2026-10-15 Wempe: the maintaining detent's wire spring (Feder 05 05 06-1) and its stud at the top plate's hole 5
    The detent had no spring: fusee.js said it had no sheet and no hole, but 05 08_1a's hole 5 is "Drahtfeder" (M1.7, 4.73 from hole 4). The stud (slotted cheese head Ø 3.0 x 1.9, slot 0.45 x 0.7, shank 0.4 out under the plate) and the wire (steel Ø 0.25, to 1.8 over the pillar plate) measured on 4_Wempe_3955_N, 4_Kirow_247_N, 4_Lange_5177_N and the 2_*_A photographs, scaled by the hole table's spacing, checked on the coloured section; the wire bent as a cantilever by the detent's back (0.31-0.51 mm at the arm's corner, 0.020-0.033 N), rebuilt as the detent rides. bom.json lines wireStud (in 0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
2026-10-15 Wempe physics at TF 108 s (the 6MX video's fit at the model's own swing, 199.4 deg at 12 h; the user's choice): HS -0.499, the guard band's floor 185 deg (14 under the reference), the tools' TF check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
2026-10-16 Wempe README: endshake, the hairspring's length and the masses' place closed by the bench; settled items out of Unresolved
    The cover plate's screw and the stop work's full wind were already in Readings
    corrected; the swing item's guard is 185-270 (since TF 108 s).
2026-10-16 Wempe: the key's holder 25 higher, its paddle 22 over the box's top as on Greenwich's wartime Wempe
    rmg_L5393_wempe_wartime_001 re-read with its parallax: the paddle's top 18 px over
    the back rim's line, the key 21 in front of the back wall, the camera ~35 deg down:
    24 +/-6 over the box's top (a second reading 20 +/-8), not level with it; the 6MX's
    shelf 15-30 under the rim (moMvyx8eXfo 3:06). The shelf's top 65 over the floor (40).
    audit.py box --rev first: the 1940 key's handle standing on its collar recorded as
    expected (it failed on main too, its face then 25 lower).
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2026-10-16 Wempe: stale text corrected (the hairspring's period 0.497 s and its rate, the seconds numerals, hole 30, the hand-setting's holes, the seconds setting, the escape wheel's header, keystone's face 25°)
2026-10-16 Stale text: the sustaining spring banked, the solved mainspring, the fusee's figures
    The sustaining spring has been a banked split ring weaker than the drive since 14 October 2026; movement.js's
    maintaining comment, the README's maintaining work and Estimated entry, and the panel's note (index.html) still
    said nothing banks it (the note also gave the old free run-down, 52 s: now the checked TFm span, 67 s). The
    README's run time: 8.4 minutes over a turn, the train stopping after about 18 1/2 (sustaining.js), not 21.
    OPEN-QUESTIONS.md's record of the old conflict marked closed. The fusee: rho0 0.510 (0.490), the end pin 0.21
    turn short of the groove's end (0.18); app.js's fusee tour and comme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
2026-10-16 Wempe fusee: the groove's pitch 1.2 and lands 0.87, the flange 0.76 / 0.87 / 0.37 (05 06 04-2's section: the sums agree only so), the chain leaving the slot level; the chain's hooks the chain's full 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
    The chain no longer touches the fusee in any state fine.py checks; its three
    allowances against the fusee are dropped. The stop work's travel is unchanged.
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2026-10-16 WIP Wempe: 05 04_1's impulse face at 28 deg 10' (PHI0), PHI_C 22 deg 10', TF re-fitted 96 s
    The sheet's 24 deg is the escape wheel's pitch; its 6 deg + 22 deg 10' put the face
    28 deg 10' before the line of centres at rest. TF re-fitted to the 6MX video at the
    model's own swing: 96 s (201.3 deg). Essay paragraph and its live angles corrected.
    wempe_tripping.js: the impulse stone's entry with a tooth already at its corner
    made dynamics.js's inelastic strike, not a loaded penalty spring.
    Not finished: with the face where the sheet draws it the tooth reaches the stone's
    outer end as it comes into the teeth's path (1.4 deg of wheel early); dynamics.js
    and the frame both snap it onto the face, an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
2026-10-16 REQUESTS.md: the post for the Wempe's missing sheets and photographs (the stop work's 05 06 03, a fusee's small end opened, the groove's end N, the other parts with no sheet), in German and English; 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
2026-10-16 Wempe: the discharge stone 5 deg later on the staff (estimated) with 05 04_1's face at 28 deg 10'; the cascade regenerated
    With the face where the sheet draws it the stone comes into the teeth's path at
    +6.1 deg; a stone leaving the gold spring at rest let the wheel go at -2.4 deg and the
    tooth got to the path first (both solvers snapped it onto the corner). The discharge
    stone's place, which the scan can't give, now 5 deg later (DSB): the release +2.6 deg,
    the tooth on the face 7.6 deg after the stone comes in (4 deg the least that lands
    cleanly; 8 deg doesn't run). TF re-fitted to the 6MX video: 108 s again; swing 197.2
    deg at 12 h (191.9-202.0 over the wind). HS -0.484 (the drawn spring a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
2026-10-16 Wempe: the verification report and the builds regenerated; RESOLVED.md entries for the hook, the step, the click, the seat and the impulse face
    reportdata.js: 17 runs, 0 failing; geometry.py: solids, fine, audit (movement and
    box), exploded and bom ok; 18 unresolved.
2026-10-16 Wempe frame and balance against Wempe 3955: the hand setting's holes 14-18 and square window drilled (the plate has them, the work not fitted); the detent block's pin holes through and countersunk; h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
    Hole 40, absent on 3955's plate, and the ring's screw holes through its cone are
    recorded under Unresolved.
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2026-10-16 The mainspring's torque from its solve: 0.96 N·m, not the linear strip's 0.78
    physics.js took the fully wound moment from a linear strip (E b t³/12 L over the whole length): 0.78 N·m,
    2.22 GPa. The spring the page draws, solved coil by coil, pulls 0.96 (its packed coils don't bend).
    mainspring.py now writes the table's absolute torque (M1) for the Hamilton too (re-solved: the states bit for
    bit the same); physics.js, tolerances.js, strength.js, bench.js and deviations.js take it, and the essay's
    figures follow. The steel's limit is a set strip's, 1.5 times its elastic limit (2.55-2.85 GPa, reasoned in
    physics.js), not an unsourced 2.5-2.6.
    The thickness rethought: thinner strips at the v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
2026-10-16 RESOLVED.md: the mainspring's solved torque into Winding and maintaining work, with its hash
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2026-10-16 holecheck.py --model wempe: every round hole in the Wempe's parts populated or explained, as last revised and as first drawn
    checks.py's HOLE_STATES (setRev) and HOLE_EXPECTED (23 empty holes, each with the reason it is
    empty on the real clock too); HOLE_WALL takes a hole as deep as the metal round its edge (the upper
    cock's hole 20 read the balance passing 12 mm under its arm as its pin). The Hamilton's run is
    unchanged (594 holes, 0 failing). ci.py's wempe-holecheck; CLAUDE.md; the Wempe README.
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2026-10-16 Ship motion drawn as from on board: the box stands still, the case swings in its gimbals
    With Ship motion on, both pages rolled the box in a fixed world and the case leaned with it toward the apparent
    vertical, so with no horizon on screen both seemed to move. Now the camera rides with the ship: the box stands still
    and the ring and case swing against it as the gimbals take the roll and pitch (up to about 20 degrees at the 7 s
    roll), the same equations. The Hamilton's jolt and twist, moves of the box by hand, still turn it. bom-fn.js's
    gimbal latch test checks it in the ship's frame; the tooltips, cards and both READMEs say so. The Blender export
    keeps its world frame.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
2026-10-16 maintaining.py --model wempe: the Wempe's Harrison maintaining work on its solids and through the page's own loop
    maintaining-wempe.js drives the movement's update through running, winds and lettings go: the
    maintaining ratchet never back, the fusee with it running and back winding, the catch under a click
    wheel's tooth, the clicks and the detent seated on their teeth, the wire spring bearing on the detent.
    The page's loop recorded through a wind from 20 h and one from run down (the maintaining spring's
    drive, WPHYS.drv running), then wempe_stopwork.py --step 0.05. It fails on the page as it is: app.js's
    wind0() sets winding before reading drvNow(), so the maintaining spring carries nothing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
2026-10-16 Wempe page: Rate and timing weights, and the 35-day trial, as the Hamilton's rate panel and 30-day test
    The timing weights (44.2 s a day a turn of both, only in, 1.9 turns; drawn
    moving along their screws), the masses' place (as drawn or compensated, not
    drawn moving) and the temperature, its curve the cut bimetallic balance's,
    the secondary error and the air's, as wempe_errorbudget.js has a day's rate;
    the model's clock runs at them (bal= in the link). The 6MX TU's trial on the
    tool's seeded days for the model as it stands, beside the medians of 2,000
    trials compensated and 500 as drawn (WEDATA.trial.sum: the tool's summary()).
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2026-10-16 ci.py runs its steps side by side; tripping.js in sections; estimates with the slow checks
    ci.py ran its 70-odd steps one after another on a 28-core machine (about 88 min
    with --full on 16 October 2026). It now runs the steps without a browser up to
    --jobs at once (half the cores, at most 12) and those with one up to --browsers
    (3), the longest first by their last times (ci-logs/times.json). smoke and the
    Wempe's smoke, which run the train on frame time, have no other page beside
    them; bom/wempe-bom (r_bom.json), the mainspring tools (their solved states)
    and the two type checks (npx's cache) never run together; blender waits for
    gltf. --jobs 1 runs them one after another as before.
    trippin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
2026-10-16 Wempe maintaining spring from its drawn ring: pins as 05 06_4 A-B, ends nearly meeting, minutes not 70 s
    - The spring's eye pin goes up into the ratchet, the other down into the fusee wheel (A-B: "Stift nach oben", the ratchet's own pin hole at 6 o'clock between the clicks); its eye's hole on its 0° line as the sheet draws it to scale
    - tools/wempe_sustaining.js: the ring by Castigliano and as an elastica, its wheel end held by the recess's wall; the running drive closes it 14.4-15.6°, its ends 0.27-0.58 mm apart (Gould's "ends nearly meeting"); the key held, the balance keeps going 10-13 min; stress 825 MPa
    - escphys.js: the spring's push (MSK, MSK2), runPhi/susPhi/susDrv replace the 70 s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
2026-10-16 The solved torque's knock-ons: tripping.json (the lock's floor 4.44 deg), bench.json, mechanisms.json (the sustaining spring weighed again), benchcheck's demo spring at the model's stiffness
2026-10-16 ci.py: the pooled steps on 6 processes counted as 6; smoke first, alone
    The first --full run side by side stalled the browser lane: bom (8 min) started
    first and smoke, which runs alone, held every other page back behind it. And
    tripping.js's bench figures (26 processes), the Wempe's tripping.js (24) and the
    mainspring sweeps (14 each) each ran on most of the machine beside 11 other
    steps. Now smoke and the Wempe's smoke start first, alone, then the browser
    steps three at a time; and those pooled steps run on POOL (6) processes
    (MC_PROCS for tripping.js and wempe_tripping.js, MC_MS_PROC for mainspring.py
    and mainspring_friction.py, which honour it now) and count as 6 of the --jobs.
    Run by ha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
2026-10-16 Wempe: opens as the Hamilton (the box shut, then the Dial view), see-through dial, balance swing slowed at speed, the transit lock's heights from photographs, the box's flicker fixed
    - shared/viewer.js: openCam, where the camera stands as the page opens; st.opening until the start view
    - wempe/js/app.js: start on Dial (the Hamilton's yaw and pitch) from the shut box, the lid opening; the dial a plate (See-through); above 5x the balance drawn swinging at 0.9 Hz, the HUD saying so; ?start=VIEW opens on a view at once
    - wempe/js/case.js: the transit lock's lever at the rim, hub, knob and pin from Wempe 5377 and Greenwich's wartime Wempe; the handles' grip and the lock's pin no longer share face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
2026-10-16 Release 3.01.00: the Wempe audited against its drawings and real Wempes (the fusee groove, chain hooks, endstones, engraving, box fittings), the Hamilton's page features for it, winding fixed
2026-10-16 6MX X4a: the 6MX's physics against the drawings' (wempe_6mx.js; wempe_inertia.py --rev): the jewels change the holes' tolerance, not the train's efficiency; the first-drawn bodies change the swing by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
2026-10-16 References: Tarasov's 6MX is a later, redesigned one (16-tooth wheel, 75/10 seconds stage); its drawings listed
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2026-10-16 Release 3.02.00: the Wempe's downloads (STL of each part and the movement, the export to Blender with the rig); the Blender rig's start hours fixed
2026-10-16 Wempe: the whole transmission in time, every part that moves, nonlinear (wempe_transmission.js)
    The barrel on its solved mainspring with its coils' stick-slip friction, the chain in
    tension only, the fusee, the two clicks and the maintaining detent as pawls riding their
    teeth, the maintaining spring with its bank, every mesh tooth by tooth (the train's, the
    motion work's, the up-and-down work's), the cannon pinion's slipping fit, the key's
    one-way coil spring and the stop, each a body, stepped at a microsecond; the escapement
    dynamics.js's own, driven by the train through a new o.tq hook (inert by default: both
    models' output unchanged). Found: running, the train's give costs each impulse 1.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
2026-10-17 holecheck.py: steady from run to run (the model frozen; the fusee's hole by its radius)
    The fusee's hole 42021 turned with the fusee, which stood where the page's
    clock put it as it loaded: 0.6 mm round between runs, past its entry's 0.4, so
    runs failed or passed by when they loaded. holecheck.py now freezes the model as
    audit.py does, and since the fusee still stands where its catch last left it
    (two places 0.74 mm apart, frozen), the entry gives the hole's distance from the
    fusee's axis (L.Fu, 4.264) and its height; such an entry must be found empty.
    Four runs 0 failing, the planted fault still fails, the Wempe 0 failing.
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2026-10-17 RESOLVED.md: the Wempe key's fix under Setup, case and gimbals, with its hash
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2026-10-17 RESOLVED.md: the Wempe's coloured-section fixes under Plates, bridges, screws and arbors, with their hash
2026-10-17 Handover: the manual's Figs. 69-70 read for the sustaining spring, the model's recess 1.3 deep, the stiffness the measured lines allow
    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
2026-10-17 Release 3.05.01: the Wempe's balance screws, dust plate, ring screws, stud screw and dial pin corrected against Wempe's coloured section drawing
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2026-10-17 The sustaining spring as measured on the videos: traced inner edge (tapered band, dog-bone fixed lobe, teardrop working lobe, round tips), 0.96 high, gap 12.5 deg, pins and holes; the recess 1.0 deep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
    KLUwI2UUCMQ 27:26 (face-on, the edges on CIELAB b*, about the recess wall's centre), 28:42.5 and 28:43.0 (the height), 18:58.0 (loose), checked against
    NAVSHIPS 250-624 Fig. 70 rectified. sustaining.js integrates the width along the band and reads Sec. IV's five to ten minutes as the time the spring keeps the
    chronometer running (the owner's choice, 17 October 2026): 6.2 minutes.
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2026-10-17 The Wempe's barrel cut indexed before closeGeo (no console warning); mechanisms_wempe.json reweighed
    ci.py --full: smoke and gltf_check failed on three.js's "toNonIndexed(): already non-indexed" warning,
    closeGeo copying capFix's unindexed geometry; it is now given an index (the same triangles). The barrel
    weighs 0.23 g less with its slot, notches and the mainspring's eye (107.96 g, I 27474 g mm2):
    mechanisms.py --model wempe --write; wempe_ratchets.js passes on it.
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2026-10-17 Docs: the sustaining spring traced (VIDEOS.md), its open question measured and the criterion the owner's, RESOLVED and REQUESTS entries; the handover done
2026-10-17 The Wempe's fusee: the groove ends at N and the small end past it is uncut, so the stop bar's slot is a plain channel through solid metal
    rBody cut the top turn's land and rib all the way round under a hub 0.3 thick, past "Gangende Punkt N";
    the slot then sliced a loose flange and ribs (the user's screenshot). 05 06 04-2's Schnitt A-B draws the
    end uncut past N, the last land against a block at Ø 21 (0.3 at D, about 1.3 at C), no rib between.
    Now the groove ends at N (turn 8.817) and the end beyond it is the hub's Ø 21: the slot opens into the
    top turn's groove at the bar's lower end and, 1.1 deep past N, leaves 0.3 of metal over the turn below.
    The spring's pin ends 0.02 inside the Ø 21.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
2026-10-17 RESOLVED.md: the coloured section's open readings under Plates, bridges, screws and arbors, with their hash
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2026-10-17 The 6MX's escapement and frame from Kirov No. 247's photographs: the single-cone collet, the detent block's stud, pins, slide and stop screw, its plain upright, the stepped lower cock, the ring screw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
    The block fixed by a slotted stud flush in the top plate 2.2 S of hole 13 between two pins 10 apart (holemap on 2_Kirow_247_A and 2_Kirow_009_A, ±0.4); the gilt slide in a notch under it and the large slotted screw in the base's side beside the detent's foot (the loose 6MX block); no slit in its upright; a taper, not a cove, at its root. The escape wheel's collet one cone, Ø 2.77 to 1.70 over 5.08. The lower cock full depth only over its lug, cut back to 3.3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
2026-10-18 Wempe: the balance re-weighed without the masses' nuts (2,526.2 g·mm², was 2,560.7) into WESC.SET, the drawn spring's isochronism (HS −0.491); the results built on them rewritten (tolerances, bench, 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
2026-10-18 photocompare.py: a photograph against the model in the same view (camera fitted to picks and snapped rims, the model rendered through it, part outlines on the photograph); specs for Wempe 3955's top 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
2026-10-18 photocompare.py: principal point and k1 as optional unknowns, snapping anchored on the pick, --zoom and --regions; Wempe 3955's A and N fitted (0.1-0.6 mm)
2026-10-18 Release 3.09.01: the Wempe's 1941 banking screw, upper balance cock, compensation masses and stop work corrected against its works drawings
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2026-10-18 RESOLVED.md: the Wempe's screw slots and the 1941 barrel arbor's square, with their hashes
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2026-10-18 Wempe: the maintaining detent and maintaining spring tempered light blue at 310° as their sheets say (both specimens photograph pale grey), not deep blue; Wempe 3955 (as photographed): the fusee's sq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
2026-10-18 Wempe: the detent block's fixing screw a tall cheese head (2.4, on Wempe 3955's S, O and W photographs); the 6MX's stud screw standing 2.5 proud (Kirov 247's S and W)
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2026-10-18 Wempe: the sheet, Soviet 6MX against the drawings: every difference with what each has and how sure, zoomed in on, the version flipped in place
    The panel's new section after Variants (app.js's X6, 22 changes from the README's "The Soviet 6MX"): a change chosen turns the model to the 6MX and closes in on it, the rest see-through; Drawings and Soviet 6MX flip the version where the camera stands. The viewer's focusOn (shared/viewer.js) frames named parts or a place in the movement's frame, kept in the frame of what it is on as a view lifts the movement out of its case; a view, Reset, Back or Whole model ends it. smoke.py --model wempe passes.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
2026-10-18 RESOLVED.md: the photographs' corrections (the 6MX's screws, ring and square, the detent block screw, the 310° temper, the walls' stripes and the hands, the gilt and cork); CLAUDE.md: photocompare.py
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2026-10-18 RESOLVED.md: the gimbals weighed with the Laid out view's plates, under Setup, case and gimbals, with its hash
2026-10-18 Wempe essay: the Hamilton's gimbal periods and centre of gravity as corrected (0.66 and 0.74 s, 10.3 mm), wempe_essaydata.js --write
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2026-10-18 Wempe 35-day trial: say why it fails at the masses' drawn place, and a button to compensate
    The page opens with the masses 30 deg from the cuts' line, where the model's
    estimated materials leave C +2.54 (so the period means and N fail too). Under
    the result the panel now says so and why (they compensate at 19.5 deg, where an
    adjuster moves them on this trial), with a button that moves them there and the
    timing weights back as drawn, so that the trial passes (C +0.04, N 5.6), and one
    back to the drawn place. Both versions and the 6MX checked; smoke.py --model wempe ok.
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2026-10-18 Release 3.11.01: the Wempe's 35-day trial explains its failure as drawn, with a button to compensate the masses
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2026-10-18 Checks: the box's float screws by their new head type, the gimbal hook skipping hidden versions' pieces (it had the case reaching the ring's pad), the 6MX's inertia table and the essay's figures rewr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
2026-10-18 RESOLVED.md: the Wempe's gold spring screw, and the photo fit of the near-symmetric balance
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2026-10-18 Bevelled plates: every hole straight through at its drawn size
    polyGeo's bevel narrowed each hole by 0.8 bev at both faces, and screw holes
    were cut that much larger so the faces kept their size: through the upper
    train bridge and barrel bridge the holes were 0.176-0.2 mm oversize, threads,
    bushings and pins bearing only on 0.22-0.25 mm lips (found with the Contacts
    view). Now every hole is cut at its size and the bevel's face rings are put
    back on its outline. audit.py: five pins no longer hang loose in the wide
    bores (LOOSE entries removed), four coplanar seat contacts recorded.
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2026-10-18 ci.py: a results cache shared by every worktree, one pool of the machine's slots for every run, --plan, --changed, --fail-fast
    Each step's reads are traced (citrace/: Python's opens and globs through an audit hook in sitecustomize.py, Node's fs and modules through trace.js on
    NODE_OPTIONS, the pages' file:// loads through tools/browser.py) and a pass is stored in .git/ci-cache/ with the sha256 of every file it read; a later
    run, in any worktree, skips the step while every one of those files is byte for byte the same (same command, Python, Node and packages). A Wempe-only
    change reruns only the steps that read the Wempe's files. Every run takes its steps' CPU and browser slots from .git/ci-sl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
2026-10-18 RESOLVED.md: the Wempe 1941 block's slit, the banking screw's slot and the gold spring's bow
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2026-10-18 RESOLVED.md: the Wempe's cover plate screw and upper jewel settings' entries get their hash
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2026-10-18 The sustaining spring's retrace documented (README, VIDEOS.md, RESOLVED.md; the gap it measures, 17.8 deg, noted, SSG kept); mechanisms.json rewritten (the spring 0.4 % heavier)
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2026-10-18 The sustaining spring's gap as measured, 17.8 deg (was 12.5): the lobes re-anchored on the same frame (SSI re-indexed 1 deg, the holes 8.9 and 49.0 deg from the fixed tip, the pin 7.4 from the workin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
2026-10-18 The sustaining spring's 17.8 deg gap through the docs and the essay: push 0.33, 12.1 minutes held (7.6-15.2 over the readings), the lobes' anchoring; RESOLVED.md
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2026-10-18 The balance locking arm against Fig. 9 and Fig. 108 read again: no boss round its screw; its end an eye over the timing weight
    Triaging claude/lock-arm-shape (4 October 2026, not merged). Fig. 108's item 31
    and Fig. 9 at high resolution: the strip's screw end is plain (the screw's
    collar and milled washer on it), and its other end is a round eye bent up out
    of the strip with the timing weight in its hole, where the model has a finger.
    The boss that branch drew (22b1290) was a misreading of the eye; its eye
    (02afce8) came with an arm moved onto the barrel bridge for room, which Fig. 9
    contradicts, so nothing of the geometry is ported. Review-results.md (BOM
    comparison 9) and the model README'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
2026-10-18 Pillar 1 measured against the cock: 169.2 deg, not 170.3 (the cock's 4 deg settled)
    The train side puts pillar 1's top screw at 169.2 +- 0.5 deg against the cock's
    three holes in the train bridge: KLUwI2UUCMQ 23:30 (face up) 169.1-169.5,
    6:49.0 (in place) 168.9-169.3, 23:45 168.2-170.0, and No. 2182
    (Jd2c3x8VKsE 26:00) 168.2-170.0. The model's 170.3 was set by clearance; the
    dial side's 166.3 (40:08) is 1.5-2 deg low. PILLARS.train[1] now (6.47, 33.91),
    its head 1.55 mm clear of the cock's foot. 23:30 alone hints the cock's holes
    are 1.3-2.3 deg short of the model's about the centre: left open as a lead.
    holes_trainBridge.json regenerated from the current model.
    Checks: solids, audit, holec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
2026-10-18 Wempe: the detent's preload gets a knock floor on the bench (the user's choice): the least preload a 3 ms blow of 20 g lets no tooth go at, beside the margin's 0.49 g
    wempe_tripping.js runs the 3 ms blow on the frame at 0.8 and 1.2 times the estimate too (17.6, 20.0, 22.5 g): 20 g from the estimate itself, 0.63 g; 1.5 times left out (its run's first drop from rest takes 268 ms, the stone riding the tooth it let go, and the search's first blows stall the wheel there: 2.4 g, a fault of the search). wempe_tolerances.js takes the higher floor: the window 0.63-1.54 g, the bench's aim 0.86 g (0.75 before); the Monte Carlo 2.9 % as made, 100 % after the bench. The model keeps 0.63 g. The README, th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
2026-10-18 Step 1 of the Hamilton's provenance: the measuring specs brought to the current model, the plate's face read against it
    rimfit.py takes "check": model places printed against where the frame puts them (off, radius, angle), not fitted. The four rimfit specs anchor on the current L (34:30 on C and E alone, with the pillars' feet picked where they stand on the face; 40:08 with the ring's bore r 39.0 where it had 40.2); the 13:44 anchor spec runs again (its holes renamed after holes_trainBridge.json's regeneration, the barrel cut r 21.0 about TB_CUT, B, E and F current); the 6:29 fit spec has each point at the model's place for its feature (13.8 px rms where it gave 38); video.py's table and plat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
2026-10-18 Wempe: the detent's inertia in makeEsc 8.43 g·mm², as weighed since the gold spring's bow (d6539a2f moved only the 6MX's); dynamics.js --model wempe passes its bodies check again
    WESC.SET.ID 8.46 -> 8.43 (wempe_inertia.json's detent). Rewritten from it: the essay data, wempe_6mx.json, keystone_wempe.json, tolerances_wempe.json (the preload's top 1.55 g), bench_wempe.json and montecarlo_wempe.json, all by hundredths; the Wempe report rebuilt (19 runs, none failing), the built page and site/. RESOLVED.md entry under Fixed, not yet committed.
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2026-10-18 Step 3 of the Hamilton's provenance: the escape passage holds; the cock's re-fit finds a 2.4 mm conflict
    The train bridge's escape passage (TB_KEY, r 6.89 about L.E) lies where 23:30 shows the bridge's opening (r 6.5-7.2 through the anchor); the r 4.71 lobe train_bridge.py traced is the balance lower bridge's opening seen through it, 9 mm lower. Nothing moved; train_bridge.py's note corrected.
    The cock's top and stud holes, re-fitted as the 12 October trace was made with the counterbore at CK_Q, put the cock's rim arc at r 37.69 against its outer wall's 40.1; the cock's own frames give the screw 24.3-26.1 mm from the staff against the model's 25.08 (CK_Q) and 26.79 (CK_Q0). Not applied: one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
2026-10-18 Wempe estimates, group B: the trial calibrated on the 6MX's test cards
    - B.1: the scatter and drift calibrated on eight 6MX passports and attestats
    (transcribed in References/wempe/documents/6MX-figures.md, section 8): the
    trial's median E 0.225 and |R| 0.26 give 0.313 s a day and +-12 ms a day each
    day (the Hamilton's No. 3390 card's 0.042 and 2.66 before); its median D,
    N and largest period mean then fall within the cards' (a check). As adjusted
    it passes 95.3 % of its trials; 17.2 s after a month at sea.
    - B.2: the secondary error from Guillaume's 42-44.4 % nickel steel (NBS
    Circular 58, 1923) with Dent's 2 s: S +0.74 to +0.89, within the five
    passports' +0.80 +-0.17 (a chec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
2026-10-18 6MX lower cock (item 12) looked at, not built: the chasy-ru loose piece taken for it is the upper cock (55-65 long, the endstone's setting on its arm), and Kirov 247's side view fixes only a line acr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
2026-10-18 The train bridge's cut round the barrel concentric with the barrel, r 20.0 (it was r 21.0 centred 2 mm out)
    Read on 23:30 and 13:49.5 through homographies anchored on the holes the bare plate places (the centre and third bushings, the pillars' screw holes) instead of on the bridge's rim held at r 40.5: r 20.26 and 19.69, their centres' mean 0.04 mm from the barrel's arbor. The rim-held anchors had stretched the barrel's side by 2-3.6 mm. TB_CUT is L.Ba, TB_CR 20.0, 1.70 mm clear of the barrel's wall all round.
    video.py anchor takes a circle's c or r as null (fitted, so it measures); the two plate-anchored specs and a framecam spec for 23:30 added; video.py's table, the README, RESOLVED.md a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
2026-10-18 RESOLVED.md: the barrel cut's entry under its heading with its hash; the 2 October entry points to it
2026-10-18 6MX electrical contact (item 15) rebuilt to Kirov 247's photographs (the user's choice): the cock's arm at -12.9 to -14.2 (1.3 thick) with its leg run up, a three-lobed cap plate with its two screws 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
    Measured through photocompare.py's m6_contact camera (0.6 mm) and a new m6_contact_front spec on 14_E-Kontakt1.jpg (a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
2026-10-18 tools/tracer.html: a GUI for tracing edges, holes and points by hand, in mm
    Curves through every point placed (centripetal Catmull-Rom, corners), holes
    as fitted ellipses, named points and scale bars; zoom, loupe, edge snap and
    an edge view; planes calibrated to mm (homography from holes.py holes or
    typed controls, refined on hole edges; affine, similarity, scale, or a fixed
    map for flattened plans) and levels on them through the plane's camera.
    Saves .trace.json with px and mm; exports the traced frame, mm, a video.py
    anchor spec and framecam.py picks; imports anchor, framecam, rimfit specs.
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2026-10-18 wempe_inertia.py: the maintaining part's two groups weighed together (the bent spring and its pin had dropped out of every body); both inertia tables rewritten
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2026-10-18 Two NAWCC Bulletin articles read: the balance cock's endstone a diamond; a second test card; rate against swing and the hairspring's terminals left open
    Bennett, "The Hamilton Marine Chronometer" (No. 356, 2005) and Sinclair,
    "From the Workshop" (No. 365, 2006), from the owner's copies (not
    committed: (c) NAWCC). References/NAWCC-ARTICLES.md records what each
    says, and No. 5580's test card transcribed. Neither gives a size, so
    OPEN-QUESTIONS.md items 1 and 2 stand; REQUESTS.md no longer asks for them.
    - The cock's endstone (J.bue) drawn clear, a diamond (Sinclair): its card's
    material Diamond (makers.py), the cock's description, bom.json's line.
    - Review-results.md finding 11: Bennett's r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
2026-10-18 RESOLVED.md: the Wempe detent's horn and gold spring entry under Escapement with its hash
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2026-10-18 The Wempe's records: the Steg and hook block built, the hand setting and holding device left unbuilt with what was found
    README: the barrel's Steg and hook block as built; the hand setting (05 33) and the balance
    holding device (05 36) are the Luftwaffe lever chronometer BC 1010's options (127-556), the
    device's lever running 0.9 deep through the 1941 escape wheel and its tongs closing on a
    Preßstoff brake ring (05 36's Schnitt A-B, DE 742 143): both left unbuilt, the user's
    decision. Wempe 3955's knurled disc is the gimbal pivot's lock nut. The drawn spring's outer
    coil held on the wall behind the Steg (the 1941 Steg's 18.85 face). RESOLVED.md, Review-results.md
    and PLAN-wempe-estimates.md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
2026-10-18 The train bridge's end by the barrel from the owner's 23:30 trace: 2.4 mm shorter, the same slope
    TB_END is the owner's traced end of the bridge lying flat on KLUwI2UUCMQ 23:30, mapped
    through its five holes the plate places (0.31 mm rms): a straight cut (0.014 mm rms), at
    the earlier reading's slope, 2.4 mm further in. The barrel bridge's edge near 3 o'clock
    is its rim (the trace sits 0.3-0.5 mm outside it, the mapping's offset): unchanged.
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2026-10-19 RESOLVED.md: the Wempe drum's slot and Steg entry under its heading, with its commit
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2026-10-19 tools/tracer.html by touch and on a phone; published as a private claude.ai artifact
    A tap adds a point, a point drags by the finger's movement (Fine: a quarter of it), hold then
    slide aims with the loupe, one finger pans, two pinch; a bar of the keys' actions (Done, undo,
    redo, Insert, Delete point, Corner, Close curve, previous/next point, Fine, Fit). Under 820 px
    wide the side panels are bottom sheets (Traces, Panel). confirm() replaced by an in-page
    question (claude.ai's frame refuses it); Share on phones.
    tracer_artifact.py writes the page without its document skeleton for the Artifact tool. In the
    claude.ai copy (Edge Tracer), the frames Claude puts in its store (frames/ID) list under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
2026-10-19 The Wempe's physics pass, in progress: the lock re-laid, the train's efficiency tooth by tooth, the gold spring's 333-333
    - The locking stone at 7.14 and 37.0° (05 04_1 re-scaled on the tips' Ø 14.00), the tips 0.235 deep; PSI0 follows the stone.
    - The train's efficiency from gearing.js's meshes (MESH in escphys.js): 0.780 (0.730-0.833); wempe_physics.js fails if MESH is stale.
    - The gold spring 98 GPa and 11.6 g/cm³ (Au/Ag/Cu 333-333, the 6MX passport's alloy); the detent reweighed (ID 8.49, the 6MX's 8.28).
    - The preload estimate 0.9 g (the margin's floor rose to 0.79 g with the deeper lock: the user's choice); the guard band 177-270°, 14° under the 191.1° reference.
    - The detent-as-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
2026-10-19 The Hamilton's train-bridge holes where 23:30 and 13:44 put them: the detent block's screw and pins (1.0-2.3 mm nearer the balance, 5.1 apart), the barrel bridge's cock-side pin, tbx, the sustaining 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
    Every train-bridge hole surveyed on KLUwI2UUCMQ 23:30 and 13:44, each through a homography on the five holes the bare plate places (the owner: all the holes exact to the video). Moved where the frames agree past their 0.4 mm noise: DBLK (the measured places in the detent's frame; block and working geometry unchanged), S.bbp[0], S.tbx, SPh. The lower bridge's screws (no holes at S.lb or S.lbp; rings 2.2-2.6 mm off), the train-blocking screw with them and the locking arm's screw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
2026-10-19 The Hamilton's train bridge without the manual's locking arm's two holes when the Navy's Y-arm is fitted (the video's 2E8489 has none there)
    R.tbGeo: the bridge's geometry with and without the arm's screw and stop-pin holes, swapped by mv.userData.stop. holecheck.py's two navy-state entries for them removed. solids, fine, holecheck (both stops), audit, exploded, overhaul and bom pass; the arm-variant audit's two coplanar findings are on main too. The lugs' re-fit to the rings, tried and withdrawn, is recorded in PROVENANCE.md.
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2026-10-19 tools/edgetrace.py: model-guided measurement on a frame (a camera on model holes at their heights, holes snapped by a RANSAC over ring candidates, outlines traced by dynamic programming back to mm); 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
    Proved on KLUwI2UUCMQ 23:30 (the notch round the fusee to 0.03-0.07 mm median of r 16.72 about L.Fu; holes within 0.05-0.35 mm of their two-frame places). On 36:01, with the principal point solved (the shot cropped or zoomed), the lug screws land 0.6-0.9 mm from the rings on the train bridge's face and 2.6-2.7 mm from S.lb; the cap 2.07 mm from L.B, a lead only. PROVENANCE.md and CLAUDE.md record it. No model change.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
2026-10-19 The Wempe build's temperature adjustment: the masses to ±0.1°, about 1.5 miles a month
    wempe_errorbudget.js carries the build (the masses set on further 4 and
    36 °C rounds to ±0.1°, 27 µm along the rim) beside the 6MX passports'
    ±0.45°: 6.2 s after 30 days against 17.2 s, and fails past 8 s (about
    2 miles, the user's aim). The bench's trial test gives the procedure.
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2026-10-19 The Wempe build's mainspring: Nivaflex 45/5 0.377 x 15 x 1240 mm, solved
    596-1043 mN.m, the build's drive within 1 %, as even through the drawn
    fusee as the drawn strip, 2.94 GPa on Nivaflex's 3.0. The carbon strips
    solved beside it (0.385: 2.89 GPa) are past steel's 2.5-2.6. Under
    MC_WREV=build wempe_physics.js checks it and wempe_strength.js takes it.
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2026-10-19 PROVENANCE.md: the train wheels' thicknesses on 36:45: the front wheel's rim 0.045 of its diameter, but which wheel it is the frame doesn't tell; nothing changed
2026-10-19 The Wempe's two builds checked: wempe_build.js, and the bench for each
    BUILD40 (the 1940s build: carbon steel at the drawings' drive) beside
    BUILD (the 1950s: Nivaflex at 1.26x), both with the gold spring thinned
    at its bend. wempe_build.js judges each (swing, lock window, in time,
    pushed, knocked, energy, strength, maintaining work, voyage) and writes
    tools/wempe_build.json; under MC_WREV the tolerances, bench and Monte
    Carlo write their own files. Both pass; 100 % work after the bench.
2026-10-19 Release 3.21.00: the Wempe built to navigate by, in two builds, in its report; the report's script fixed; the bench's endshake and temperature adjustment
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2026-10-19 The Hamilton's whole transmission in time: hamilton_transmission.js and its trace
    wempe_transmission.js's bodies, elements and runs on the Model 21's parts: the
    mainspring through the fusee from mainspring_friction.json's fusee table with
    its coils' stick-slip friction, the chain in tension only, the two winding
    pawls (both bearing) and the sustaining pawl riding their ratchets, the
    sustaining spring banked in running, every mesh tooth by tooth (train, motion
    work, wind indicator), the cannon pinion's slipping fit, the plain key, the
    stop; dynamics.js's escapement driven through sim's o.tq. The escapement runs
    take the mainspring at the page's level (the solved spring gives 1.62 times
    makeEs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
2026-10-19 Moving parts in 3D: the fusees loaded by their pawls' blow, the Hamilton's labels and limits; the build's spring at more set
    - the fusee (both models): the click's or winding pawl's blow on its ratchet tooth, the chain holding
    - the Hamilton's impulse roller alone, its stud held by its nearer half, the stop-bar at its pivot end, the barrel's chain load without a height band
    - stray islands of bricks dropped; the coarse peak read 0.3 mm clear of holds
    - the viewer: the mainspring's limit per model, the Hamilton's sustaining and trip springs named
    - mainspring_wempe_t0.377 solved at set 0.8 and 1.0 (the build's strip with more set)
2026-10-19 Moving parts in 3D beside the reports; the Wempe's let-go fixes tried
    - motion3d_pack.py --site: the viewers beside the Wempe report (section 13) and the Hamilton's build report (new section 14), their data gzipped, three.js and OrbitControls (vendored, r128) and the site's fonts beside them; build.py copies a report's viewer folder whole
    - wempe_letgo_fix.js: the key let go outright with more clicks, a brake between the click wheel and the maintaining ratchet, a cushioned click face; no fix keeps every part within its material (the maintaining ratchet's brass the last), eased back they are; wempe_transmission.js takes the clicks' number and the brake as estimates (the drawn 2 and 0 by defau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
2026-10-19 The 3D stress: a mesh's load over its bearing band; the contact study's tool; a build strip tried as a variant
    - motion3d_fe.py: each train mesh's load and the driven pinion's hold over the band where wheel and pinion overlap (the Hamilton's fusee wheel 369 to 433 MPa; the Wempe's unchanged); --win, --patch, --study and each part's stress against its distance from the load, for the contact study
    - motion3d_contact.py: each near-contact part solved with its load's patch at 0.5, 1 and 2 times and its windows at a 9th and 14th of the module, resumable, the tall parts alone
    - wempe_build_spring.py --drive, MC_WSTRIP (wempe_load.js) and WESC.KBN (escphys.js, never set by the page): a solved strip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
2026-10-19 RESOLVED.md: the 3D stress's bearing band under its heading, with its commit
2026-10-19 The Wempe's 1950s build takes the 0.393 mm Nivaflex strip at set 0.8, its drive turn by turn; the key let back at each stroke
    - js/escapement.js: BUILD.strip 0.393 x 15 x 1,240, set x0.8 (mainspring_wempe_t0.393_L1240_s0.8.js), drive tools/wempe_build_drive.json; its inner coils 2.88-2.96 GPa fully wound on Nivaflex's 3.0 (the 0.377 at set x0.6 until now: 3.25, found by the 3D analysis)
    - wempe_load.js applies the strip's drive (WESC.KBN): the swing 216-241 deg over the wind (227-236 with the even strip), the 30-day error unchanged (5.8 s)
    - wempe_physics.js: the full-wind level within 4 % (the strip's 3.5 %, inside its own thickness tolerance's 3.8 %)
    - motion3d_springs.py: the build's stri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
2026-10-20 mfgfit.py match: clicked points named after the model's holes, snapped to their edges, a rim tying the map; the owner's four base-plate traces
    match seeds similarities from every pair of points against every pair of holes, grows the best 25 by optimal assignment (affine until
    the matches cover half the part, then a homography), snaps each point to its hole's edge and fits the final map with a Cauchy
    M-estimator, points off the face losing their weight. --arc holds a traced stretch to a known circle (the bridges' rim). The owner's
    traces of 20 October 2026 (KLUwI2UUCMQ 13:03.5 barrel bridge, 23:30 train bridge, 9:03 and 14:43.38 pillar plate) in tools/traces.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
2026-10-20 blindHoles' counterbore mode closes: the barrel bridge's sink cut round
    Each triangle of the rings zipped between the cut rim and the inner circle is wound as the loops run (decided once on a large
    triangle): a sliver where the rim steps back by 0.1 deg (a rim vertex at r 1.449 against 1.435) flipped on its own and its
    edges stopped pairing, the 6 open edges solids.py counted. solids, holecheck, audit and exploded pass.
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2026-10-20 The hairspring stud's holes nearer the staff: 5.0, 8.4, 12.3 (42:08 face-on and 41:58 through its own camera), the clamp 3.83 from the staff, the outer terminal curve re-solved; the essay's large-swi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
2026-10-20 The trip spring's bracket 2.4 tall (BM 117A; 11:08-11:13), the detent's inertia from the drawn parts (ID 3.683), and the lock deepened to Op. 85's 6.0 deg (dL 0.019, the owner's choice) so the heavie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
2026-10-20 The case support brackets (42105) as bent straps, not blocks: two wings bent to the case's wall, each slotted round its screw (8.1 heads at +-17.2), and a joggled hat whose 10.5 flat runs on as the t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
2026-10-20 The detent rebuilt to its measured lengths (KLUwI2UUCMQ 11:10-11:33, bundle adjustment on the block's pins)
    BL 11.32 -> 10.21 mm (the locking jewel 10.1 from the flexure), the detent spring
    3.82 -> 3.30, the cross-piece 0.42 wide, the jewel block 0.9 long and 1.26 tall, the
    stone's top 1.75 above it, the arm bent 1.15 past the lock; the trip spring 5.8 free
    (7.9), 0.37 deep (measured band), 0.041 thick (its tip's stiffness kept), its foot
    behind its root; the bracket a Z on the blade placed from the trip spring; the block
    -9.46..+2.99 from the new flexure, 2.75 wide, its pins Ø 0.85 standing 1.1, the
    steady pins and clamp screw where measured; DBLK re-expressed (the holes unmoved).
    rT 0.288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
2026-10-20 The detent's chain rerun: escgolden, the essay's physics spans, tripping.json (lock floor 5.58 deg, ring 148 Hz), tolerances, gearing, bench, makers; the bracket screw's thread a known deviation; aud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
2026-10-20 The going train's pinions and the escape arbor against KLUwI2UUCMQ 36:45-36:46.5 and 42:51-43:19 (mfgfit's edges): the centre pinion 3.77 long straight from its wheel, no collet, its arbor r 1.08; th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
2026-10-20 The stop work against KLUwI2UUCMQ 20:01.23-25:04: the step 0.475 of the length from the chain end, the side hole from the inner corner, the recess r 5.27, the hard stop where the step meets the reces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
2026-10-20 The barrel's measured parts that the core's solve doesn't decide (KLUwI2UUCMQ 15:47.45, 16:16.5, 32:47, 33:21.5, 15:54): the arbor's bearings r 2.53, the end holes r 2.65, the end's boss r 4.32, the 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
2026-10-20 The chain's figures through the tools: INT 4.62, RHO0 0.526 and rB 19.32 read off the page (tools/fusee_table.py), the coils' friction, physics, tolerances, deviations, bench and the maker's sheets; 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
2026-10-21 The Wempe page laid out as the Hamilton's: its views and panel sections in the Hamilton's order, Time open, the status line's short form
    The views Box, Dial, Exploded / Movement, Train, Escapement / Laid out, Fusee, Balance, then the Wempe's Plan, Side, Case, Transport box (keys 1 to 9 as the Hamilton's).
    The panel's sections in the Hamilton's order: View, Time (now open), Winding, Display, Contacts, Parts, Download (where the Hamilton has Making it), Rate and timing
    weights, 35-day trial (the 30-day test's place), Swing and isochronism, Escapement in plan (the adjuster's bench's), Cross-section, Variants, the 6MX beside them.
    The status line the Hamilton's short form, the dial's time bold a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
2026-10-21 Swap the site's addresses: the Wempe at /, the Hamilton at /hamilton/, the essay at /essay/
    The Wempe's page is the home page (social-wempe.png), the Hamilton's moves to /hamilton/ and the essay
    gets a page of its own, /essay/#section (for now the Hamilton's page built with <html data-page="essay">,
    the essay always showing). worker.js sends /wempe/ to /?from=wempe and /marine-chronometer to /essay/;
    the reports and the manual keep their addresses. On the Wempe's page a script sends the Hamilton's old
    links (#essay=…, #ovh, #arm, #block, #esc, #orig) on, and the viewer (cfg.away) a part, view, panel or
    step it hasn't; its own essay is its Its drawings tab (#drawings=section, essaykit's key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
2026-10-21 The set-up cover measured on KLUwI2UUCMQ 11:52: four circles, no bosses
    The cover (42029) face down on 11:52, its edges snapped and put in mm through a
    homography on its own holes (arbor hole, screw holes at S.cover), the pads'
    edges through their height's image shift (tools/cover_ends.py, cover_fit.py,
    cover_overlay.py; traces/cover_11-5*): two concave sides r 23.04 and 23.59
    running on to the ends (the frame's "straight cuts" at the corners are the
    pads' step's parallax), both ends one circle r 14.69, the pads' inner edge one
    circle r 11.49, holes r 3.12 / 0.77 / 0.49 (the third small hole is the click
    pivot's). The r 1.35 bosses round the screws are gone. The Navy seal's flange
    is bitten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
2026-10-21 Seam sweep: pieces of one solid drawn as one mesh (fuse, core.js) in both models, so Edges draws no line where their faces ran flush
    Hamilton: balance cap, train bridge (seats, counterbore floors, pivot hole), escape bridge, endstone caps, pillar plate's recess floor, mounting ring,
    lower train bridge, escape wheel and its collet, fusee body, arbor and winding ratchet, great wheel, hour and indicator wheels' hubs, cannon pinion,
    fusee seal and the Navy brake's seal, detent block and moving detent, winding stop, barrel wall; box: corner caps, key block, gimbal ring, case
    brackets, keeper, latch bracket, bezel, bowl, hinges. Wempe: balance masses, detent (fixed and turning), stud, cannon tube,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
2026-10-21 Seam sweep: merge after the gears' phase and the fusee lathe's cuts, the barrel's end after its wall's rebuild; the checks taught one solid of several pieces; builds
    The great wheel's floor and the cannon pinions' squares were turned with their teeth's phase, the fusee body lost its groove's end and chain slot, the
    barrel wall's rebuild dropped its tapped end: each merged after now. bom-check.js joins runs where merged pieces meet; fine.py and the Wempe's
    EXPECTED keys for the merged types; the barrel wall's own height kept (wallY) for fine-interference.js and contacts.js; maintaining.py reads the stop
    stud's size from userData; holecheck.py's three holes now read through; the movement ring'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
2026-10-21 tripping.json, bench.json, makers.js and the build report for the fusee 0.064 g lighter (its arbor no longer counting its collar twice)
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2026-10-24 Wempe: the bezel screws onto the bowl, both threaded, the movement ring's pin in a notch
    05 01 01 marks a thread up the bezel's skirt; the bowl's rim is now turned from its
    flange round the movement ring's flange (a rebate to the seat), threaded outside,
    and notched through at 12 o'clock for WN-202, as Kirov-Poljot 24020's bowl shows.
    ISO 60° form, pitch 0.75 read on 24020, 0.03 clearance on one helix. The casting
    stands 4.7 higher on the movement, so its bottom is 49 from the seat (05 06_01).
    The 6MX's rim and bezel threaded the same. Masses, essay figures, the Wempe report,
    README, cards and parts list updated; bom.py's bezel relation (failing since
    3.25.03) passes.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
2026-10-24 Wempe: the bezel's bevel and knurl drawn without broken Edges lines (3.25.04)
    Sloped ring cells in case.js were 60 sectors of 4 steps, triangulated with
    flat slivers on one circle that Edges drew as dashed creases at every seam
    of the bevel and sight cone; now one step wide (quads). Each knurl's flank
    normals lean 15 degrees off the radius so neighbouring flanks stay under
    Edges' crease angle; the shape is unchanged.
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2026-10-24 6MX contact: lever raised under the spiral, staff thinned, stud slotted, contact hidden by default; double-click focus no longer swings the model
    - The contact lever's boss sits on the staff just under the spiral's collet (-10.2 to -11.5),
    its arms sloping down to the stone and the screw holder (Kirov 2973's and 24020's
    photographs); the staff Ø 0.6 under the boss.
    - The detent block's stud has a real slot, 0.5 wide and 0.9 deep, square across the base
    (the loose 6MX block's photograph); the kit's screw takes an optional slot.
    - Variants: Electrical contact Hidden (default) / Shown, contact=1 in the link; shown under
    ?qa so the tools keep checking it; the 6MX list's contact items sh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
2026-10-24 Wempe: the three dials as SVGs (wempe/dials/), from dial.js's own face() run on a recording canvas
    tools/dialsvg.js records face(1, d)'s canvas calls in mm; tools/dialsvg.py resolves the white-over-black paint
    order into ink alone (shapely) and writes wempe-3955.svg, kirov-247-6mx.svg (the 6MX's, its serial in red) and
    lange-5177.svg at 1:1 in layers paper, ink, red and drill. --verify rasterises each against the page's canvas
    (no shape differs at 12.6 um a pixel, the ink's area within 0.13 %); dialtrace.py --compare --canvas lays one on
    its photograph as the canvas is laid. ci.py checks they are current (wempe-dialsvg).
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2026-10-24 Wempe: pieces of one part no longer overlap (weighed twice): hinges one outline, bezel knurls on the ring's own corners, fusee wheel's teeth bore, hands' roots on their bosses, detent blade and horn 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
2026-10-25 Wempe per-part audit, batch 1: the escapement against 05 03, 05 04 and 1436
    - the escape pinion 4.0 long (05 04_7.2; was 05 04_7.1's 3, leaving 0.3 of the seconds wheel's rim past the leaves), with its mesh relation in bom.json
    - the detent spring tapered 0.09 at its ends to 0.07 at its middle (1436's left view); makeEsc takes it as 0.0792 uniform
    - the detent's foot, blade and horn at 1436's bracketed heights, 1.9, 0.9, 0.75
    - jewel holes 0.02 over their pivots, as stated; the rim cut 1.6; the layout's SIMP 3.35
    - bodies re-weighed (wempe_inertia, the 6MX's SET6); tolerances, bench, Monte Carlo, builds, keystone, essay data regenerated
    - WEMPE-PROVENANCE.md: the ledger of every part audited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
2026-10-25 Wempe per-part audit, batch 2 (in progress): the train's fits, the case and gimbals to 05 01
    - the centre arbor's train-side pivot 1:90 (05 05 03-2), its wheel's rim 1.25, the top plate's bushes 0.02 over their pivots (05 05_1's close running fit)
    - the gimbal ring 4.0 × 24.0, its bracket bevelled; the case brackets as 05 01's C-D (the bowl now turns over in its ring, where the old blocks met the band at 55.5°); the inner pivots M5 with their Ø 3 tips and Ø 22 lock nuts, the outer pivots' Ø 3.1 tips; the transit lock's pin clear of the thicker ring
    - the page's gimbal periods 0.673 and 0.765 s; the fusee cover plate's screw hole at its fit's middle
    - two transcriptions corrected; the fu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
2026-10-25 PROVENANCE.md brought up to date: every figure's rows re-read against the 72 commits since eda059c8, the summary recounted (264 rows; outline M 84, sizes M 168, place M 161, inferred 65 from 81); sta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
2026-10-25 The Wempe's frame under load, assembly order and design for manufacture: fea.py --model wempe, assembly.py, dfm.py, the report's section 19 (work in progress)
    fea.py takes another model's parts, arbors, fixings and loads from its checks.py (FEA); the Hamilton's results unchanged (its run compared line by line on one geometry: only the solver's residuals differ). assembly.py + assembly-check.js take the Wempe apart in the 1958 Soviet repair book's order for the MX (pp. 59-60). dfm.py reads each machined piece against the machine.
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2026-10-25 Wempe audit batch 3: fusee.js snapNear (corners within 2 µm joined, so a 1 µm weld can't open a cut part: the export's STL closed); the four versions' audits updated (the clicks on the cup floor, the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
2026-10-25 The Wempe's detent block comes off in the 1958 book's place: out sideways under the top plate (assembly.py's path steps and split screws); the documented planted fault fixed
2026-10-25 Build book: drawings as polylines, not a <line> an edge (the Wempe's book 65 MB of SVG crashed the print preview); creases kept while it builds; the button says it is building
2026-10-25 Release 3.29.02: the build book prints again (its drawings as polylines; the Wempe's crashed the page)
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2026-10-25 Wempe physics: the train's gap traced to its backlash (both rigid bounds run), the stone's landing with brass's restitution, the gold spring over 333 gold's modulus, the hairspring's period against t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
2026-10-25 Wempe physics closed: README (three to Closed, the train's backlash left for the owner's choice), CLAUDE.md, maker's sheets, the report and site regenerated
2026-10-25 Exploded view: the Hamilton's mounting ring comes off the pillar plate (a loose piece of its part, 12 mm toward the dial side)
    exploded.py 0 failing, overhaul.py 0 failing, solids.py 0, tsc, smoke.py --model ok, gltf_check.py and blender_check.py passed.
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2026-10-25 The escape arbor's lower inertia carried through: JW 5.65 (6.05), physics.js's J 4.46e-9 (4.80e-9), mechanisms.json, escgolden, tripping, tolerances, bench, the maker's sheets, the essay's figures an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
    The teeth 1.1 thick and the pinion 3.0 long take the escape arbor from 5.22 to 4.82 g.mm2 on its
    solids (mechanisms.py --write; traindyn.js sums 5.653 at the escape wheel). The escapement still
    calibrates to 255 deg and 0 s a day at the model's settings; its fingerprint rewritten on purpose
    (escgolden.js --write). The Wempe sets its own JW and is unchanged.
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2026-10-25 The trip spring 6.45 mm free (5.8, its length to the horn's tab), 0.0456 thick for the same tip stiffness: KLUwI2UUCMQ 11:10-11:33 bundle-adjusted at f 4000-100000, its root 3.30-3.45 before the ston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
2026-10-25 The ripple of the trip spring's length and the parts' new solids: escgolden, tripping (ring 151.4 Hz, lock floor 5.12), tolerances (the trip spring to 0.061), bench, the maker's sheets, mechanisms (t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
2026-10-25 ID 2.510 (the detent weighed with the trip spring 6.45 and its bracket nearer the flexure; dynamics.js), the ripple again (escgolden, tripping, tolerances, bench, maker's sheets, gearing, the coil-fr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
2026-10-25 The case pivots: records (OPEN-QUESTIONS, PROVENANCE 106-6, 106-20, 107-1a, 107-4, 107-7, PLAN, README, RESOLVED), the periods in CLAUDE.md and the Wempe README, the build-verification report's gimba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
2026-10-26 Wempe independent pass (Task 3), part 1: stale copies fixed, the strict readings and the drawn version at the builds' setting reported
    wempe_bench.js and wempe_montecarlo.js took the detent spring as 0.07 against the tripping frame's tapered 0.0792 (bench band 69-137 Hz, not 83-164; 0 springs replaced, not 4); wempe_train.js's escape pinion face 4.0; the video's TF refitted (114.4 s, 111-118: the model keeps 111 s, the owner's choice; wempe_escapement.js checks within the fit's range); wempe_navigation.js reports Bowditch's stricter readings and the drawn version with the builds' +-0.1 deg masses (owner's choices: reported, verdicts unchanged); wempe_errorbudget.js exports terms30, its trial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
2026-10-26 Build book as engineering drawings (pilot): tools/drawbook.py draws each part from its solids in the Wempe's sheets' style
    Hidden lines by ray casting, tessellation fitted back to lines, arcs and circles, first-angle views, turned parts in half section, flat parts' section A-A, holes probed along their axes, rising and chained dimensions, title block, the part's render, and a second sheet of tables (parts list, holes, contour, teeth); printed to PDF through Chromium. Nine pilot parts. maker.js: the Laid out view's stand-in plates no longer counted as their parts.
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2026-10-26 Wempe upper cock and set-up click drawn as their sheets draw them; the drawings-check plan and ledger
    The upper cock's relief step a 45° cone from r 12 in to r 11.2 (05 08 03-1, U30; it ran out to 12.8), hole 20 a bay in it; its boss turned, face Ø 6 and a 45° flank to Ø 7.6 (Ø 5.8/7.5). Both built as strips (solidGeo's new strip cells: two rails paired at the same angles, exact without refining), so neither is faceted. The set-up click's outline walked from its lines and arcs (a distance field's contour bevelled the beak: a sliver), its back r 12.5 tangent to the nose r 1 as 05 08 05-2 draws it (0.18 short before: a nick). PLAN-wempe-drawing-check.md: every part with a drawing against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
2026-10-26 Moving parts in 3D brought up to date: both viewers repacked (the Wempe after the per-part audit and its threads, the Hamilton after 26 October's batch), the contact study and the docs' figures solve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
2026-10-26 Wempe drawings check, batches 1 and 2 corrected (in progress)
    From the sheets: the ring's radial hole for its case pin (05 08 00-3), the pillar plate's hand-setting bore Ø 2 (05 08 02-1 C-D), the plates' steady-pin openings ending in a drill point, the top plate's horns at the exact crossings (KIT.subtractCircle), the window's hollow ends in 24 chords, Wempe 3955's groove bored, the ring's M2.6 holes bored from below without a step, the pillars' countersinks to the thread's crests, the upper cock's M1.2 tapped (its boss rebuilt round them) and its screws M1.2, the dust bush's bottom (chamfer, bearing ring, 5° dish), the click 2.56 thick, chamfered steady pins, the intermediate bridge's mou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
2026-10-26 Wempe independent pass, part 2: the report rebuilt (reportdata, geometry with fea/assembly/dfm on today's solids), section 22's wording on the chain radius (not stale), RESOLVED.md
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2026-10-26 Wempe drawings check, batches 3 and 4 corrected (in progress)
    The timing weights Ø 4.25 and the mass screws 1.85 over the rim's face as 05 03_2 draws them (re-measured: Ø 4.21/4.33 and 1.83-1.88 at 12.0 px/mm), their heads following the mass's round side; the rim's tapped holes for the timing screws; the collet's spring hole; the staff's arms one taper each; the rim's cuts with parallel walls; the hub's coplanar faces apart. The escape wheel's web 0.7 (05 04_7.1's 0,8 struck for 0,7), the crossings 17.7° behind a tip (05 04_23), the arbors' shoulders concave r 3, the first-drawn collet's cone to Ø 2.7. The detent's foot, square, gold spring (its head 2 high) and the blocks' end faces hol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
2026-10-26 Wempe drawings check, batches 5 and 6 corrected (in progress)
    The fusee wheel's lip alone at 2.62, the rim and teeth 0.2 lower, the hub 0.4 under the lip with its 45° flank to Ø 16.6 (05 06 00-3's section); the click wheel's chamfer on its face against the body (05 06 04-3); the fusee's turned parts and body shaded square at corners (KIT.crease). The maintaining clicks' top edge one line tangent to the boss (05 06 02-3), the cup's holes for the springs' pins, the click screws' heads 0.9 high and ends domed (05 06 02), the stop spring unfolded at the bar's pin, the maintaining spring's contour finer. The IK hash on typed arrays.
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2026-10-26 Wempe drawings check, batch 7 corrected (in progress)
    The barrel's lid flush with its rim as 05 07 01 and the coloured section draw it (its 0,6 the arbor's shoulder over it), its edge one 5° face from Ø 39.2 to 39.39 (05 07 01-2) sprung into a seat cut to match; the arbor's core faces Ø 10 with 1.65 × 45° chamfers; the mainspring drawn 15 high (05 06_20); the arbors' squares shaded flat (KIT.crease).
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2026-10-26 Wempe drawings check, batch 8 corrected (in progress)
    The intermediate pinion's leaves 3.25 (05 05 02-2: its 4,6 spans the leaves and the seat, the 1,3 the seat), its seat flush with the wheel; the intermediate and seconds wheels' hubs flush with their rims (the 0,2 the riveting), the seconds wheel's face 9.2 from its shoulder (05 05 01); the train-side shoulders one 30° cone each; arbors in 64 segments; the top-plate bushes' cups to their rims.
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2026-10-26 Wempe drawings check: checks after the corrections
    audit's expected coplanar faces renamed (the turned parts creased: Buffer), the hub screws' entries; holecheck's hand-setting bore expected empty, the ring's flange holes no longer read at the removed step; fine's renamed pairs, the timing screws with their weights in each version's group, their heads following the rim's curve; the stop spring's traced end and the pillars' shallow countersinks restored (README, Unresolved); latheF a creased plain lathe.
2026-10-26 Drawings ledger: the changes made, sheet by sheet (drawing-check/changes.md: corrected, open, kept, each with its commit)
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2026-10-26 Drawings ledger: the bowl's floor ring left open (the fix didn't clear it)
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2026-10-26 Wempe: physics regenerated after the drawings check; SET.HS -0.451 for the heavier balance; the error budget's scatter and drift calibrated on common random numbers (4000 trials: the drift 11.6-11.95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
2026-10-26 Wempe: the lock's deep limit where the swing stays in the guard band (past 0.243 the escapement collapses in time, main's as the branch's); the Monte Carlo's preload and lock surface joint, on a dens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
2026-10-26 Wempe report rebuilt on the corrected parts and physics (29 runs, 0 failing; geometry, FEA, assembly, DFM; the transmission viewer's traces)
2026-10-26 Drawings ledger: the follow-on changes with their commits; RESOLVED.md: the lost threads and makeEsc's missing blow
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2026-10-27 Wempe case, batch 10's open items: the handles, the finger recess, the 1940 key's stem, the ring bracket's screws, the tube's sink, the tongue
    - Handles (51 00 10): the section's "6" and "12,5" put the ends 6 off the side and the middle's outside 12.5 (built 3 and 10), the strip 3; the bends S-curves traced on the bottom view (were straight kinks); screws' heads Ø 6 at ±45, 10.5 into the wood. The outer box (28.2.42, before this change) fits the old 10: the handles press 2.5 into its end cushions.
    - Finger recess: the figure "10" deep (built at the scaled 10.5), 2.5 of wood; its cove in 40 rings of quads (solidGeo strip), no longer terraced.
    - 1940 key: the body from the figured 32 over th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
2026-10-27 Drawings ledger: the 26 open items settled (21 corrected, 6 kept with their reasons, the detent blade's side left for the owner), each with its group's commit
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2026-10-27 RESOLVED.md: the Wempe maintaining detent's seat and maintaining-wempe.js's cache; the ledger's ratchet line with the fix
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2026-10-27 Wempe detent blade adopted (the owner's option B): two cross-checks widened, Wempe only (dynamics.js isochronism 0.3 s a day, wempe_tripping.js frame swing 1.25°: the impulse's hop roughness, wempe_c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
2026-10-27 Wempe detent level: the 1943 block carries its fixing screw's thread for matchThreads; the block tilted off its pins (assembly), the lower endstone's window (holecheck), bom lines for the last revise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
2026-10-27 wempe_transmission.js: the coupled beat from 8 starting phases of the train's meshes (MESH's and a fixed golden-ratio spread), each with its rigid twins, the mean judged against the same 8° and 0.5 s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
2026-10-27 After merging claude/wempe-ledger-open (the maintaining detent's contact as it works): build, tolerances/bench/Monte Carlo (last, build40, build), navigation, makers regenerated; wempe_transmission.j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
2026-10-27 Wempe: the banking screw turnable on the page (Swing and isochronism, bank= in the link)
    A slider sets the depth of lock the banking screw gives (0.150-0.250 mm, 0.25 mm a turn), the
    screw turning on the model in every version. tools/wempe_banking.js rebuilds makeEsc at 33 depths
    for the drawings' escapement and the 6MX's (js/bankdata.js, WBANK; ci.py's wempe-banking); the page
    reads between them as an offset on the drawn escapement's swing, least swing and rate, so the
    balance's swing follows the screw live, and judges the depth against the bench's window
    (tolerances_wempe.json) and the swing it settles at. To regenerate after the detent-blade merge.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
2026-10-27 Wempe: makeEsc's ride landings timed inside their step, the ride stepped 8 times a table step and the swing solved on the work averaged over the beat (RSR 8, SMW 0.5); the page reads the swing off WB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
2026-10-27 Wempe report and builds after the lock aim: report data (tolerances, bench, Monte Carlo, navigation, wear, estimates, thermal frame), the report, builds; ci.py --only 21 steps ok
2026-10-27 Wempe hairspring stud to its sheet: solid upright, the spring's end in the Ø 0.7 hole, a half-round brass pin
    05 03 02-3's "1,2 -0,1" (the bar's middle to its edge) had been read as a slot: the
    upright is solid, its plan's dashed lines its own sides. The spring's end goes into the
    sheet's Ø 0.7 hole, 0.72 from the end and 0.36 toward the axis (3.46 from the staff, as
    05 03_7 and the collet pin it), the drawn spring's last stretch straightened and set
    0.2 up into it; its pin half round, brass, flat to the strip, domed 0.45 proud
    (Ldzmn4kuKMA 4:32-4:34, a GUB's old stud). Transcription, README, BOM, makers,
    ledger and RESOLVED updated.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
2026-10-27 seatcheck.py: every pin seated (holecheck's other half); the Wempe's collet pin and the 6MX cap screws fixed
    The stud's error (a slot from a lone figure, its pin lying in it in no hole) passed holecheck,
    audit's loose ends and bom.py. seatcheck.py follows each pin, screw, pipe, bush and hook along
    its axis and fails where no one part is round it; it fails the page before the stud's fix
    (af4fba43) on 050302-4.s and passes all five versions now (503 pieces, four expected).
    It found two more:
    - the collet's pin 050302-4.c, a steel rod Ø 0.22 in the collet's Ø 0.8 (05 03 02-2), 0.02 off
    the strip and 0.04 off the wall: holding nothing. Now the same Spiralstift as the stud's, half
    round and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
2026-10-27 Wempe: the Einheits-Chronometer videos reviewed against the model (GUB 1956, GUB 12255, the 6MX): VIDEOS.md's review section and three catalogue corrections, provenance rows, README estimates and Unr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
2026-10-27 Wempe stop work: the bar's pin hole and the spring's pin hole cut (05 06_4 C-D); EXPECTED excuse and bom embed removed, stale text fixed (drawing check 2, 3-M3, 3-M4, 3-M11)
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
