OrelMag/marine-chronometer-model/(notices)

Notices in the files:
References/wempe/README.md:
- `photos/dg-chrono-dec/`: Johannes Altmeppen's photographs on dg-chrono.de (© 2017): three Einheits-Chronometers of the drawings' design, each shot the same way.
- `photos/dg-chrono-6mx-gallery/`: the rest of Altmeppen's 6MX photographs on dg-chrono.de (© Johannes Altmeppen), every full-size image on its two 6MX pages that the folders above didn't already hold, under the site's own filenames (downloaded 15 October 2026; 211 files, 129 MB; `sources.json` give
A 1948 Lange dial (Wikimedia Commons, CC0, square-on).
ofiles); and in `photos/auctions-museums/` Wempe 8711's box (Antiquorum), two Kirova chronometers on Wikimedia Commons (`commons_6MX_kirov_dial.jpg`, CC BY-SA 3.0; `commons_kotka_nautical.jpg`, CC BY 2.5) and Stahl lots 113507 and 113510's other views (`_0`-`_2`).
marine-chronometer-source/chronometer-working-model/README.md:
- Two *NAWCC Bulletin* articles (read 18 October 2026, the owner's copies; © NAWCC, not committed; `References/NAWCC-ARTICLES.md` records what each says):
